pratham-cloud-ctrl/Project-SCCI-RH/docs/stage6/README.md

# Stage 6: integrated manuscript, verification and release

This dossier completes the specified digital research and engineering package.
The proposed consumer capabilities remain conditional; no original human/animal
experiment, physical execution or implanted qualification is reported.

The [whole-project engineering review](../review-v2.0.1/README.md) records the current
corrections and their tests. Historical Stage 1-5 source paths remain unchanged;
the corrected UART application is an explicitly named additive revision.

| Entry | Purpose |
|---|---|
| [Integrated manuscript](../../output/pdf/Project_SCCI_RH_Integrated_Manuscript.pdf) | 28 illustrated pages, both mechanisms, math, model results, native engineering and 18 references |
| [Manuscript source](../../manuscript/stage6/manuscript.md) | Editable text; figure and PDF builders in the same directory |
| [Original hypothesis paper](original-hypothesis/README.md) | Unchanged 28-page research input, preserved with its source digest |
| [Evidence review](evidence-review.md) / [reference register](references.json) | Primary populations, access, supported claims and inference boundaries |
| [Evidence claim register](evidence-claims.csv) | 30 classified scientific/design claims |
| [Integration verification](integration-verification.md) | Actual production C core plus explicit companion/response adapters |
| [Requirements trace](requirements-claims-trace.csv) | All 36 original requirements and scoped dispositions |
| [Integration summary](../../results/stage6/integration-summary.json) | Finite software results and explicit false physical/biological claims |
| [Contributions](contributions.md) / [defence guide](defence-guide.md) | Attribution, learning and explanation |
| [Release contract](release-contract.json) / [plan](release-plan.md) | Version, scope, artifact list and reproduction policy |
| [Release notes](release-notes.md) / [exit review](exit-review.md) | Current release and finite closure |

The integration passes **114,426 repeated software assertions across 28 scenario
groups**. It includes 5,184 modeled motor events and 1,200 pressure events, 13
compiled-core boundary/fault cases, four separate ideal-supervisor cases and six
companion feature-validity cases. Model/current/recruitment mappings remain
declared premises. Current target neural acquisition is restricted to OBSERVE.

The manuscript and release retain the earlier all-withheld conservative result,
conditional learning alternatives, pressure overshoot, analog uncertainty,
unmeasured execution timing and unresolved implanted thermal/miniaturization work.
These are explicit boundaries of a completed digital concept, rather than hidden
conditions presented as successful experiments.

See [START_HERE](../../START_HERE.md) for the full native-file reading order.
