pratham-cloud-ctrl/Project-SCCI-RH/electronics/stage4/integrated-pcb/exports/controller-carrier/fabrication-reference/drill-report.txt

Drill report for controller_carrier.kicad_pcb
Created on 2026-10-28T20:25:21

Copper Layer Stackup:
    =============================================================
    L1 :  F.Cu                      front
    L2 :  In1.Cu                    in1
    L3 :  In2.Cu                    in2
    L4 :  B.Cu                      back

Drill file 'controller_carrier-PTH.drl' contains
    plated through holes:
    =============================================================
    T1  0.200mm  0.0079"  (9 holes))
    T2  0.300mm  0.0118"  (215 holes))
    T3  1.000mm  0.0394"  (100 holes))

    Total plated holes count 324

Drill file 'controller_carrier-NPTH.drl' contains
    unplated through holes:
    =============================================================
    T1  3.200mm  0.1260"  (4 holes))

    Total unplated holes count 4
