pratham-cloud-ctrl/Project-SCCI-RH/electronics/stage4/integrated-pcb/exports/supervision/fabrication-reference/drill-report.txt

Drill report for supervision.kicad_pcb
Created on 2026-10-28T20:28:59

Copper Layer Stackup:
    =============================================================
    L1 :  F.Cu                      front
    L2 :  In1.Cu                    in1
    L3 :  In2.Cu                    in2
    L4 :  B.Cu                      back

Drill file 'supervision-PTH.drl' contains
    plated through holes:
    =============================================================
    T1  0.300mm  0.0118"  (898 holes))
    T2  1.000mm  0.0394"  (126 holes))

    Total plated holes count 1024

Drill file 'supervision-NPTH.drl' contains
    unplated through holes:
    =============================================================
    T1  3.200mm  0.1260"  (4 holes))

    Total unplated holes count 4
