pratham-cloud-ctrl/Project-SCCI-RH/CURRENT_STATUS.md

# Project SCCI RH: integrated digital completion status

Updated: **28 October 2026**. Current engineering release: **v2.1.1**.

**Reader navigation refreshed: 20 October 2026.** The new
[Explore hub](docs/explore/README.md) provides visual guides to theory, CAD,
KiCad electronics and current firmware. This is a documentation/navigation
update on the default branch; the paper, native designs, firmware and published
v2.1.1 engineering artifacts are retained in immutable Git history; the current files carry the new project name.

**Browser inspection added: 21 October 2026.** The
[public build inspector](https://pratham-cloud-ctrl.github.io/Project-SCCI-RH/)
adds selectable source-derived 3D assemblies/boards, interactive PCB component
lookup, all four copper layers, 80 searchable current schematic sheets and
complete native/STEP downloads. This is an inspection layer; the original
engineering sources and integrated paper now carry the new name, with original identities retained by the migration record.

The [whole-project review](docs/review-v2.0.1/README.md) preserves the original
goals and fixes a confirmed UART frame-interleaving defect, one bibliography
duplication and current handoff/documentation issues. Use the
[corrected carrier image](firmware/nrf5340/uart-revision/README.md) and
[portable CAD entry](cad/CURRENT_CAD.md). The old v2.0.0 source and native evidence
remain available at their immutable tag; source-preservation checks remain in force.

The specified six-stage digital research and engineering project is complete
within its stated scope. The authoritative entry is [START_HERE](START_HERE.md)
and the [integrated manuscript](output/pdf/Project_SCCI_RH_Integrated_Manuscript.pdf).
This completion concerns the delivered research/design/software artifacts and
finite verification, with no physical device or biological efficacy claim.

## Main idea retained

SCCI_RH proposes implanted spinal recording, computational interpretation,
learner-specific or function-specific stimulation, independently observed
delivery and response, and feedback. Expert-informed **retained motor learning**
and **selected physiological automation** remain central. Expert information is
aligned to the learner rather than replayed as voltage; OFF retention is distinct
from assisted performance. The pressure reference uses external pressure feedback
and positive pressor authority. AstroSam's Mind-Link inspires the progression
from future vision to inspectable engineering, with explicit credit.

## Completed work

| Stage | Achieved digital scope |
|---|---|
| 1: mechanism/specification | Both causal mechanisms, requirements/assumptions, source audit and architecture/verification responsibilities |
| 2: quantitative architecture | 16-stream/two-source design, 36 ports, resource/timing/noise/delivery budgets and explicit rejected cases |
| 3: computational mechanisms | Conservative qualification investigation closed with interventions withheld; separate conditional concept, 128 scenarios and favorable/neutral/adverse OFF learning |
| 4: electronics/firmware | Eight routed native boards; 80-sheet master; 1,298 positions / 1,296 fitted; 4,781 pin identities; 21,039 segments / 2,335 vias; source-bound zero native ERC/DRC/unconnected/parity/ignored findings; actual carrier-specific linked image |
| 5: mechanical assembly | 260-part combined native reference; actual board scale and 32 mounting axes; 83 mating housings; separate 230-part future interface with 36 ports; independent native/STEP/interference/clearance evidence |
| 6: integrated manuscript/release | 29-page illustrated paper, 18 references, 30 scientific/design claims, all 36 requirement dispositions, production-core digital replay, defence/contribution material and reproducible versioned release |

## Final integration results

[Methods and source boundaries](docs/stage6/integration-verification.md) accompany
[the machine summary](results/stage6/integration-summary.json).

- 114,426 repeated software assertions across 28 finite scenario groups.
- 5,184 modeled motor events and 1,200 pressure events.
- 13 compiled-core boundary/fault cases, four separate ideal-supervisor cases and six companion feature-validity cases.
- Motor first ON error: 31.414 mm unassisted versus 16.668 mm assisted.
- Final OFF: 5.605 mm baseline/neutral, 2.897 mm favorable and 34.845 mm adverse under the selected learning laws.
- Pressure disturbed RMSE: 11.871 versus 20 mmHg unassisted; recovery peak 129.999 mmHg against a 120 mmHg model target, approximately 10 mmHg overshoot.

These are conditional host/model results. Motor features are causal Python
arrays; encoded pressure packets exercise the production C parser. The unchanged
production core executes admission and phase-state behavior. Peripheral timing,
current delivery, neural quality and biological efficacy remain unmeasured.

## Actual target and physical-identity boundaries

The preserved v2.0.0 BT40F/nRF5340 image has a 53,648-byte flash LOAD extent and 98,000-byte
RAM extent, with the manufacturer's 11 pF HFXO setting. It is compiled and linked,
not flashed or executed. Neural acquisition occurs in OBSERVE and is inhibited
while stimulation is armed. No radio image or simultaneous live spinal decoding
during target MOTOR is implemented.

The current additive UART correction has a 53,776-byte flash LOAD extent and the
same 98,000-byte RAM extent. Its 70 independent image/source checks and 1,172
host framing scenarios pass. It is compiled and linked, unflashed; the framing
fix does not establish target timing or physical peripheral performance.

The reference keeps its eight boards at 1:1 scale in a 600 x 310 x 240 mm chassis.
The separate future can/header is 60 x 58 x 14 mm before leads and depends on
miniaturized electronics and qualified implanted interfaces. The latest power
allocation remains conditional 3.154150 W / 4.879920 h. Earlier compact thermal,
monitoring-precision and timing failures remain preserved.

The final Stage 5 native evidence includes 14 reference clearance gates,
14,365 reference material pairs / 248 exact candidates with no unexplained
intersection, all future interfaces and a 260-object source-preservation check.
Its portable checkpoint has 12,996 checks. Native evidence is distinguished from
portable verification of exact saved sources and receipts.

## Release integrity and next work

The frozen engineering baseline is `736015848cf581df66488bf53aa6360152eb767b`.
The final release protects 2,733 baseline tracked files, with seven approved
current entry/attributes/citation/manifest exceptions. New Stage 6 artifacts add
the integrated account without changing old studies, circuits, firmware or CAD.
[The release contract](docs/stage6/release-contract.json) and
[exit review](docs/stage6/exit-review.md) define the finite checks; Git blob hashes,
clean-checkout verification, CI and external release checksums provide identity
and reproducibility evidence.

New biological datasets, physical target execution, measured analog delivery,
chronic thermal/interface qualification, compact hardware redesign and empirical
retention studies are subsequent work packages. The available digital evidence
does not establish a unique spinal-information advantage, healthy expert-skill
transfer, a human learning multiplier or universal physiological control.

[Contributions](docs/stage6/contributions.md) and
[the defence guide](docs/stage6/defence-guide.md) support attribution and student
understanding. Video and website revision remain parked. The historical
[v1.0.0 release](https://github.com/pratham-cloud-ctrl/Project-SCCI-RH/releases/tag/v1.0.0)
remains a separate subsystem reference.
