pratham-cloud-ctrl/Project-SCCI-RH/docs/engineering-roadmap.md

# Project SCCI RH: engineering roadmap and digital completion

16 October 2026. Stages 1-6 are complete within their stated digital scopes:
mechanisms, quantitative architecture, preserved computational investigations,
native electronics, bounded actual firmware, mechanical CAD and the integrated
manuscript/release. The [current entry](../START_HERE.md) and
[Stage 6 exit review](stage6/exit-review.md) organize the completed package.
Biological efficacy, target physical execution, compact implant electronics and
chronic thermal/interface qualification remain subsequent work. The roadmap
below preserves the scientific questions and explicit negative findings.

## Intended result

Project SCCI RH develops a proposed invasive spinal cord–computer interface through
supported theory, mathematical mechanisms, editable electronics, target software,
populated parametric CAD and an illustrated research paper in a private GitHub
repository. AstroSam's Mind-Link is credited as the inspiration for translating a
future interface into an inspectable engineering project.

The causal chain remains **implanted spinal contacts → acquisition →
interpretation → learner-specific stimulation → observed response → feedback**.
The two applications are expert-informed practice with assistance-OFF retention
assessment, and feedback for a selected physiological function. The current
physiological model concerns pressure support. Neither a general body-control
capability nor transfer of an expert's memories or voltages is assumed.

The complete deliverable is digital. Biological observability, selective
recruitment, plasticity, chronic packaging and healthy-consumer usefulness remain
explicit future evidence requirements. Those questions cannot be completed by
adding more software tests. Video and website work remain parked.

## What Stage 3 has delivered

| Package | Completed digital work | Boundary that remains |
|---|---|---|
| Foundation mechanisms | Motor/pressure models, measured-command separation, causal observations, learning families and OFF assessment | Chosen biological equations are assumptions, not human experiments |
| Numerical checks | Motor/pressure refinements and independent electrical equation checks | Selected grids and finite scenarios do not qualify every possible trajectory |
| Contact acquisition | Moving sources at actual contact apertures, recovery masks, lost-block and clock cases | Real spinal information and analog front-end recovery remain unestablished |
| Information controls | Capacity-matched external/neural comparisons, absent/redundant sources and ambiguity witnesses | A useful neural increment is not established by the connected pilot |
| Teacher references | Independent competence/decoder checks and a nominal aperture-resolved reference library | Legacy and faster references that fail remain unavailable |
| Response and prediction | Finite observed response domains, intervention-aware forecasts and past-response removal | Changed learner response and unsupported histories still reject |
| Connected pilots | Historical 128-practice/64-OFF pilot plus new 32-practice/64-OFF frozen-observer replay; exact causal guards and scoped software probes | Both withhold all interventions; no retained advantage or new active-path qualification |
| Reproducibility | 224 local tests, saved receipts and independent Linux reproduction on GitHub | Passing tests verify implementations and reported results, not efficacy |

The [current status](../CURRENT_STATUS.md), [Stage 3 dossier](stage3/README.md)
and [verification map](stage3/verification-progress.csv) remain the detailed
record. These packages have different scopes; counting files or tests would not
give a defensible percentage of the remaining engineering effort.

## Why the stage remained open

Connecting the complete loop exposed dependencies that isolated demonstrations
did not resolve. The earlier expert generator failed a task check, baseline
delivery uncertainty was too large, and independent changing-learner recordings
exceeded the forecast allocation. New monitors and revised references address
specific causes; they do not silently rescue earlier failed experiments.

The diagnostic found severe noise amplification in unconstrained local harmonic
inversion; it did not prove that every 75 ms predictor must fail. A structured
observer with a measured calibration prior has now completed a
[standalone confirmation](../experiments/stage3/observed-state-observer/README.md):
all 16 fresh sensor-noise pairs on both body grids remain within 15 mm, with a
maximum allocation of 11.354 mm. Persistent memory, a known synthetic movement
prior and calibration are additional resources. This verifies a finite no-dose
desktop domain only; the original negative pilot remains unchanged.

Verification also exposed a platform-dependent near-zero argmax witness. Its
reproduction fix independently binds both witnesses to physical apertures while
preserving the numerical tolerances, all outcomes and all admission decisions.

## Finite Stage 3 closeout

Complete one bounded predictor revision and its connected interpretation:

**Closeout, 12 October:** all four finite steps are complete, as reviewed in the
[exit ledger](stage3/exit-review.md) and [integrated verdict](stage3/stage3-verdict.md).
The new actual-only replay retains 32 practice and 64 OFF sessions, 32 sealed
vectors, 32 pre-launch diagnostics and 1,600 passing guard comparisons. Every
tested nonzero candidate rejects; this is a negative active-assistance verdict.
Fifteen contract probes, independent raw interval/data recomputation and full
same-cohort reproduction pass. No active delivery path or post-dose monitoring
was newly validated by the zero-launch replay. The list below records the
completed closeout contract rather than assigning more Stage 3 work.

1. **Freeze one observed-state method.** Use measured calibration only, known
   instructions and an explicit structural movement prior. Declare state,
   covariance, coefficients, calibration exposure, history, initialization,
   reset and missing-data rules. Private learner parameters and future achieved
   motion cannot select or update the runtime predictor.
2. **Separate development from confirmation.** Existing inspected recordings
   remain development data. Freeze the procedure and settings before generating
   an independent confirmation cohort. Retain fixed comparators, all eligible
   physical supports, cue reversals, all 26 execution horizons and rejection
   cases. Keep the 15 mm forecast, 3 mm label and 25 mm complete-correction
   allocations unchanged. Typical covariance is not an empirical maximum bound.
3. **Resolve the connected pilot.** Consume the observer in the
   [reviewed bounded reset-trial integration](stage3/observer-integration-plan.md), with matched resources,
   live delivery uncertainty, timed cancellation and OFF assessment. Compare
   actual characterized delivery separately from prospective monitor precision.
   Preserve unavailable references and zero/harmful/dependent plasticity cases.
   The first replay has one practice trial; repeated intervention-modified
   sessions need further state-domain evidence. Learning-enabled response
   interaction is not supplied by the inherited learning-OFF calibration.
   Retain any forecast, delivery, interaction or correction failure and withdraw
   unsupported active-demonstration claims; do not tune thresholds to force pulses.
4. **Issue the Stage 3 verdict and report.** Consolidate both application
   mechanisms, the verified operating domain, negative controls, numerical
   sensitivity and the electronics handoff. State which digital claims are
   supported, which conditional capabilities remain hypotheses and what future
   evidence could overturn the conclusions.

Completion means this selected digital investigation has an audited conclusion
and a concrete hardware/software contract. It does not require a favorable
learning result or resolution of every biological uncertainty. A failed
confirmation remains a valid engineering result, while the proposed consumer
application stays explicitly conditional. Further model revisions become
separately justified extensions rather than an unbounded Stage 3 checklist.

## Stages 4 and 5

The [conditional concept revision](stage3/conditional-concept.md) reconnects this
handoff to the user's intended future-interface approach. Fourteen primary
research anchors support a fifteen-entry premise ledger. A separate 128-scenario
illustrative model demonstrates causal assistance and positive/equal/adverse
assumed learning, with no unique neural-information advantage. Its finite scope
does not require qualification of the earlier actual-delivery branch. Further
general observer/audit families are not prerequisites to native circuit/CAD work.

Stage 4 has already begun with the [native dual-source monitor](../electronics/stage4/monitoring-cell/README.md)
and [33-run behavioral circuit study](../electronics/stage4/monitoring-study/README.md).
Their 4% phase-charge target remains unearned. A
[reviewed first driver boundary](stage4/current-driver-design.md) now has a
[156-component native implementation](../electronics/stage4/current-driver/README.md)
with five reviewed sheets and a [bounded circuit/permission study](../electronics/stage4/driver-study/README.md).
This is a restricted 24 V/3 mA/200 µs slice, with external supervision, actual
delivery-path limits and two retained out-of-compliance partial traces. Now
the [native recording slice](../electronics/stage4/recording-front-end/README.md)
adds sixteen shared-reference differential streams and isolated input switching
across seven sheets. Its [finite input/protocol studies](../electronics/stage4/recording-study/README.md)
retain weak-signal/fault failures and revise SPI timing/power explicitly.
The [native contact router](../electronics/stage4/contact-router/README.md) now
adds six sheets with held addresses, two sixteen-way selectors, fixed returns,
collision inhibit and a fresh acknowledgement/rearm path. The
[native shutdown/supervision package](../electronics/stage4/supervision/README.md)
adds 18 terminal guards, separate phase timers/watchdog, measured windows and
explicit rearm across 22 sheets. Its finite fault/analog audits and checked
inter-package wiring close that bounded digital slice. The
[native power package](../electronics/stage4/power/README.md) now generates all
nine rails and supplies startup/reference-qualified shutdown across 15 sheets.
Its [budget](stage4/power-budget.md) retains conditional 2.615 W/5.886 h, failed
compact thermal closure and inherited ADC/link limitations. The
[monitoring/companion package](stage4/monitoring-transport-design.md) now resolves
the 450k aggregate conversion mismatch with a dedicated raw ADC, adds shared
charge endpoints and an isolated UART, and binds freshness/queues/resources to
actual native connectivity. Its additive budget is conditional 2.800 W/5.497 h;
precision, continuous raw export and compact thermal limits remain explicit.
The [actual nRF5340 firmware](stage4/nrf5340-firmware-design.md) now links the
production core and peripheral backend, with compiled fault tests, active-route
readback, timestamped observations and allocated timer/DPPI cutoff. Its nominal
lower-rate polling opportunities and known gaps do not implement the earlier
450k/4k proposal. The [integrated populated PCB package](stage4/exit-review.md)
now completes Stage 4 within its bounded digital reference scope: eight native
routed boards, 1,298 positions / 1,296 fitted, an actual controller and four-chip
sideband carrier, zero ERC/DRC/unconnected/parity/ignored findings, populated
STEP and fabrication references. The revised conditional allocation is
3.154 W / 4.880 h. Carrier-specific firmware uses the manufacturer's 11 pF
oscillator setting. Historical source circuits, studies and firmware remain
preserved. The [board index](../electronics/stage4/integrated-pcb/BOARD_INDEX.md)
is the native-file entry point.

Stage 5 now packages those board and component identities in the native
mechanical assembly: full-scale populated boards, nominal mating interfaces,
ports/feedthroughs, conditional future leads, clearances, drawings and STEP
exports. The [mechanical exit review](stage5/exit-review.md) records completed
source-bound native checks. Its compact future package explicitly requires
redesigned miniaturized electronics; the eight reference boards retain 1:1 scale.

Stage 6 now joins the mechanisms, circuit/firmware evidence and CAD in the
[integrated illustrated manuscript](../output/pdf/Project_SCCI_RH_Integrated_Manuscript.pdf)
and reproducible private v2.0.0 release. Each digital result retains its limits
and contribution record.

## Proposed additional tools

These are recommendations checked against primary product documentation on
12 October 2026, not installation or compatibility claims.

| Tool | Recommendation and intended purpose |
|---|---|
| Ansys Student | Useful optional thermal/structural corroboration for a defined package/lead problem. Existing installation is partly verified; solver/license checks and the two missing original-media archives must be resolved before reliance. Keep exportable CAD in FreeCAD/build123d or Fusion. [Official capabilities and limits](https://ansys.synopsys.com/academic/students/ansys-student) |
| Ansys Electronics Desktop Student | Useful selected low-frequency field, parasitic, thermal or telemetry studies using Maxwell/Q3D/Icepak/HFSS as appropriate. Student restrictions include mesh caps, no geometry export, Circuit's 50-component limit and restricted netlist/command-line workflows. It does not replace KiCad or the ngspice current-loop study. [Official limits](https://ansys.synopsys.com/academic/students/ansys-electronics-desktop-student) |
| Autodesk Fusion Education | A reasonable optional native CAD authoring/review interface if preferred. Eligible students have renewable educational access. Existing FreeCAD/build123d can already produce editable engineering geometry; changing CAD tools is not a prerequisite. [Education access](https://www.autodesk.com/education/edu-software/fusion) |
| MecAgent | Postpone a Fusion-dependent decision. The current official page identifies SolidWorks as available and shows Fusion among forthcoming integrations; the education page offers a limited Free plan, not an established unlimited Fusion workflow. [Current integrations](https://mecagent.com/), [education](https://mecagent.com/education) |
| Installed KiCad/FreeCAD MCP bridges | Verified on 13 October: Konnect 0.13.0 with KiCad 10.0.6 saved-schematic component/pin/ERC checks; FreeCAD 1.1.4 live bridge inspected the unchanged 80-solid allocation. Use these for native inspection and upcoming PCB/CAD work. Live PCB operations require the intended board open and source-evidence checks. The [verification record](../provenance/stage4-mcp-readiness.json) records the local skill and tested access. |

An additional interface is useful when it demonstrably improves a concrete
design or review operation. It does not establish the biological assumptions or
remove the need to check the generated electronics and geometry.
