pratham-cloud-ctrl/Project-SCCI-RH/provenance/CONTRIBUTIONS.md

# Contributions and provenance

## Native current-driver checkpoint, 13 October 2026

AI-assisted detailed design added a separate 156-component, 572-pin, five-sheet
KiCad driver package, local libraries, BOM/netlists/exports and connectivity/gate
verification. A separate AI manufacturer review corrected DAC reference/gain
headroom, exact DRX and BSP89 package contracts, logic defaults and timer-health
limits. A separate control review specified sticky BLOCK/TIMEOUT state and
direction capture at safe rearm. All five schematic pages were visually reviewed.

The root AI agent implemented a separate closed-servo ngspice surrogate, retained
18 complete and two partial out-of-compliance transients, and independently
checked charge conservation, a settled DC equation and selected-grid agreement.
An additional ideal-event model retains 15 scenario groups, including unprotected
timer failure without external supervision. These studies use declared component
surrogates and artificial loads, not vendor macro models or physical measurements.
The scientific figures and raw evidence preserve adverse outcomes. Pratham owns
the project direction and clarified the conditional concept scope. Historical
Stage 2/3 and monitoring packages were preserved. Full electronics/firmware,
populated CAD and the final integrated manuscript remain unfinished.

## Stage 3 mechanism revision, 9 October 2026

AI-assisted work added competence-gated teacher libraries, fresh actual-aperture
teacher recordings, a 75-capture moving-source/ambiguity study, intervention-aware
causal forecasts and observed-map precision requirements. Independent code review
identified and corrected a live dose-uncertainty gate and unfair coupling of the
external teacher comparator to neural availability. The source paper and selected
primary experiments were reread to connect their evidence to specific tests.
New scientific figures derive from the saved results. A delayed-residual latch
is a tested software component; dynamic feedback and revised retained-learning
benefit are not thereby established. Older result identities remain preserved.

The measured transient-response experiment and zero-future-command baseline add
separate two-grid records with actual electrical pulses, complete heldout
trajectories and explicit unsupported-tail rejection. Review also corrected
partial observation-noise reuse and a total-sensor-loss expiry gap. Root authored
an eight-page illustrated revision report and inspected every rendered page.
The bounded body-coupled pilot completed on 12 October in separate files. Review
replaced a training-fit teacher error with independent complete-recording
allocations and restricted runtime baseline permission to tested support/past
action domains. Sixteen independent learner-drift checks reject every aggregate
horizon. The saved 128 practice trials launch no stimulation, and 64 OFF
assessments show no assisted advantage. The full local suite passed 224 tests,
including seven checks of the cross-platform reference-witness comparison and
its binding to recomputed physical sampling apertures.
Sources, negative results and independent reproduction receipts are retained.

A separate AI-assisted Stage 4 investigation starts an editable two-source
phase-charge monitoring circuit, component comparison and requirements trace.
Independent review corrected a preview-package choice to the production DCK
pinout and a missing buffer-loading term in the separate mathematical oracle.
Thirty-three ngspice runs retain both source traces and 462 interval results;
portable verification recomputes the numerical checks and binds the artifacts.
Its power/bias/precision limitations remain explicit. Full native implant
electronics, embedded integration and populated engineering CAD remain later work.

Project owner and research direction: **Pratham Varma**.

Pratham defined the SCCI focus, the motor-learning and sustained physiological
control questions, the AstroSam-inspired engineering format, the entirely digital
scope and private-repository destination. The supplied hypothesis paper is a
starting research map; it is not new experimental evidence.

This release was developed with extensive AI assistance. Codex agents performed
targeted literature review, mathematical modelling, implementation, CAD/circuit
generation, automated checks, documentation and presentation rendering. Execution
logs and machine-readable results support the stated checks. Pratham has not been
represented as having personally fabricated hardware, performed experiments on
people or animals, or independently authored every code/design element.

The appropriate portfolio claim is an **AI-assisted digital engineering project**
that Pratham directs, studies, critiques and improves. Understanding and defence
of the work must be developed through the learning guide and rerunning the
experiments; a generated document does not establish that understanding.

## What is original to this release

- The explicit separation of a future spinal interface from a desktop reference.
- Paired synthetic studies, their controls, parameter sweeps and failure cases.
- Application-to-pulse digital integration and portable timing/fault reference.
- A one-channel artificial-signal/test-load circuit and matching PCB.
- Parametric enclosure geometry, assembly checks, presentation assets and the
  combined reproducible engineering argument.

These are original project artifacts, not a claim to have invented spinal
interfaces or discovered a clinically effective intervention. Model laws and
synthetic plasticity parameters are choices to investigate, not measured biology.

## Inspiration and third-party materials

[AstroSam's video](https://www.youtube.com/watch?v=5YxrpcqkTYA) and
[Mind-Link](https://github.com/sam-astro/Mind-link) inspired the progression from
future concept to inspectable engineering. Reference review pinned commit
`a391eb851ee624be675057380f4e3b701ebf6ee8`. No Mind-Link source or geometry is
incorporated into SCCI_RH. The reference's root MIT license and its LUFA notices would
need preservation if that changed.

Primary literature is cited by DOI and checked against source scope; its full
texts are not included in the release. KiCad library symbols, footprints and
component models retain their applicable licenses in the electronics attribution
file. Software used to generate assets retains its own license and is not
redistributed with this project.

## Data integrity

All new study/electrical data are generated by code. Each dataset records the
chosen seeds, equations, units and assumptions. Confidence intervals quantify
Monte Carlo variability under those assumptions; they do not quantify uncertainty
about the biological mechanism. No participant IDs, clinical recordings or
privileged personal data are present. No GitHub credentials are stored here.

See `environment.json`, `verification.json`, `manifest.sha256` and
`docs/claim-register.csv` for the execution environment, verification receipts,
artifact hashes and claim boundaries.

The SHA256 manifest hashes staged Git blob bytes (including Git's LF text
normalization), so it represents the committed release rather than a particular
Windows working copy's line endings. It excludes itself to avoid a self-hash.

## Full-system overhaul: Stage 1, 8 October 2026

The project owner authorized a staged overhaul preserving the complete proposed
SCCI platform and both application ambitions. AI-assisted work produced the
mechanism specification, selected primary-source audit, architecture/interface
trade study, model/verification plan, requirement/assumption/capability registers,
vector diagrams and illustrated design brief. Parallel AI workstreams covered
research, electronics responsibilities and model verification; a separate bounded
cross-document review led to tighter future configuration-security, versioning
and independent-supervision checks. The owner has not yet selected the detailed
reference motor task or endorsed a final access arrangement.

Stage 1 reports specification consistency and document visual review only. No
new circuit, firmware implementation, CAD package, biological dataset or efficacy
experiment was produced in this stage. The source hypothesis remains read-only;
the historical release and its receipts remain distinct. See the Stage 1 dossier,
`stage1-verification.json` and `stage1-review.json` for this revision's scope.

## Full-system overhaul: Stage 2, 8 October 2026

The owner requested continuation. AI research, electronics and control workstreams
audited primary/manufacturer sources and specified numerical inputs; root
integration aligned rates, memory, cycle reservations and timing, reproduced
budgets, authored figures/brief and generated the preliminary build123d/FreeCAD
allocation models. These calculations and solids are newly generated Project SCCI RH
work. Manufacturer geometry/capacity examples and published electrical settings
remain attributed; no proprietary CAD or biological recording is redistributed.

Root integration review found and documented shared-reference noise failure,
free-running-frame latency failure, dense-stimulation recording loss, archive
mask propagation, maximum-knob/monitor-uncertainty rejection, thermal/cell limits
and target-specific anatomical inventory requirements. Catalog devices are
feasibility witnesses with unqualified implant suitability. No human has yet
endorsed the final components, anatomy or operating profiles. Review receipts
describe AI-assisted technical/visual checks, not an independent licensed design
audit or biological trial. Native electronics implementation and populated
engineering CAD remain later stages. See `stage2-verification.json`,
`stage2-review.json` and the Stage 2 progress table for the exact scope.

The owner requested a Stage 2 alignment/completion audit before Stage 3.
The audit corrected the 32-stream RAM prose, made cyclic physical-source
scheduling distinct from per-profile rates, and added finite flash/network
memory, output-configuration SPI and a complete functional port allocation.
Six focused failure tests and a read-only full nominal CAD inspection extend
the verification. A further portability regression covers Windows/Linux JSON
receipt identity while detecting changed values and array order. The illustrated
brief was updated and visually reviewed.
These additions remain AI-assisted digital engineering; they do not establish
biological efficacy, exact circuit implementation or populated implant readiness.

## Full-system overhaul: Stage 3 foundation and continuation, 8–9 October 2026

The owner requested the computational stage and sustained continuation after a
usage-limit interruption. AI workstreams implemented reduced contact acquisition,
causal decoding, observed response calibration, independent electrical delivery
and external-pressure feedback, with separate practice and output-OFF assessment.
Subsequent work added numerical refinements, digital filter-residual qualification,
a capacity-matched external-history comparator, independently recorded response
domains, observed teacher competence and a cancellable known-cue component.

Parallel read-only reviews found source timing/leakage, qualification, numerical
integration, missing uncertainty cross terms and teacher-competence defects.
Corrections preserve historical outputs and disclose changes through separate
datasets, source hashes and limitations. These are multiple AI-assisted reviews,
not independent clinical evidence or a licensed hardware audit. No human/animal
data or original experiments on participants were produced.

Root integration generated scientific figures, inspected the rendered images,
ran model/test/receipt checks and documented the next electronics requirements.
Unfavorable results remain visible: actual motor authority rejects intervention,
assisted cue forecasts fail and original synthetic teacher timing is unqualified.
The new competent synthetic benchmark is an explicitly privileged generator,
not evidence of real expert spinal skill transfer. Detailed electronics,
populated CAD and the final full-system paper remain later work.

## Continued mechanism/electronics investigation, 12 October 2026

AI workstreams corrected the monitoring schematic's production amplifier
package/pin mapping and generated the 33-run, three-grid behavioral monitoring
study. Separate equation/KCL and source-portability reviews preserve negative
precision, power, clipping and bias-bypass results. The original paper and all
synced reference files remain read-only. No hardware was fabricated or measured.

One persistent observed-state observer was frozen using measured synthetic
calibration and an explicit movement prior. Root reviewed its equations, timing,
causal inputs and resources before target scoring, then independently reviewed
the fresh sensor-noise confirmation protocol before generation. The confirmation
retains all 32 paired-grid captures. Separate AI saved-data audits recomputed
915,200 residuals; root reproduced every frozen pair in a disposable portable
workspace. Scientific plots use the saved summaries. These are AI-assisted
computational checks, not human/animal measurements or an independent licensed
review. The result supplies no neural increment or retained-learning evidence.

Root installed the official Nordic SDK, diagnosed its Windows physical-path
restriction, preserved the asset installation and compiled/linked an unmodified
processor example from a separate short physical copy. This verifies the tools,
not SCCI_RH target firmware. A reviewed driver design note defines a restricted next
native circuit boundary. The connected learning-enabled response interaction,
complete electronics, populated CAD and final manuscript remain unfinished.

## Finite Stage 3 closeout, 12 October 2026

A separate AI implementation workstream froze the actual-only pre-dose observer
replay before generation. Root and a read-only AI reviewer inspected its protocol,
causal clocks, candidate gates and evidence preservation; root saved hash-bound
approval before the cohort ran. It retains 32 one-practice trials and 64 hard-OFF
assessments with zero launches. Fifteen software contract probes, measured-input
controller replay and full deterministic same-cohort reproduction passed.

A separately written and published raw auditor recomputed all recorded intervals,
noise injection, forecast/guard residuals and matched-arm outcomes without
executing the producer or controller. The integrated verdict and eight-page
report distinguish no-dose component success from unavailable actual assistance,
unqualified learning interaction and unexercised active delivery/monitoring.
Root closes only the selected digital Stage 3 investigation. Complete native
electronics, SCCI_RH target firmware, populated CAD and the final project manuscript
remain later stages. No human reviewer, physical experiment or biological result
is implied by these AI-assisted checks.
# Conditional future-concept revision - 13 October 2026

Pratham clarified that plausible undemonstrated assumptions are permitted and
that experimental proof of the complete biological conjunction must not prevent
completion of the digital concept. The root AI agent traced the completion-scope
drift, preserved the original frozen studies, specified a separate 128-scenario
illustrative model, implemented it, reproduced its saved outputs and inspected
the figures. Separate AI research passes supplied the motor and physiological
primary-source reviews, 15-entry premise ledger and engineering handoff. A separate
AI read-only implementation review checked causal inputs, calibration/true-state
separation, learning identity, washout and resource accounting. It found a metric
label ambiguity; the protocol now explicitly says pooled two-coordinate RMS,
preserving the original numerical criterion and outcomes.

Favorable, equal and adverse learning outcomes remain consequences of declared
equations, not fitted human results. All papers receive source credit, no new
participant/animal/hardware experiment occurred, and the expert reference and
live phase features remain assumed representations. Native electronics/firmware,
populated CAD and final integrated publication are unfinished. Contributions are
AI-assisted rather than independent institutional or clinical review.

## Native recording-front-end checkpoint - 13 October 2026

AI implementation work produced a seven-sheet native RHD2216 recording slice,
production fault-switch land patterns, seventeen protected paths, shared reference,
separate bias, digital isolation, mode defaults, local footprints/BOM, exported
connectivity and unexcluded ERC. A separate AI primary-source review corrected the
preview TSSOP selection, pin maps, supply conditions and the difference between
large fault thresholds and the RHD's small input envelope. The native author
inspected all rendered sheets; root also inspected selected pages.

Root implemented a finite passive network and a separate scalar/DC/KCL auditor.
Another AI reviewer identified coherent common-mode terms that invalidated a
barely passing RSS interpretation. Saved results preserve that failed weak-signal
gate and two transient fault failures. A separate AI workstream derived isolated
SPI timing, next-CS timestamps, commissioning and external sequencing, retaining
undetectable untagged-data replay. These are computational, AI-assisted checks;
no human/institutional, hardware, animal or participant validation is implied.
Historical packages and synced sources remain unchanged. Integrated circuits/
firmware, populated PCB/CAD and final publication remain unfinished.

## Contact routing and native MCP continuation - 13 October 2026

The user supplied KiCad and FreeCAD MCP bridges. Root applied the local
cad-electronics-mcp skill, verified serving versions, rechecked saved KiCad state
and ERC, and opened the unchanged Stage 2 allocation in live FreeCAD. Eighty
solids remained valid; this did not create populated CAD. No unsaved user design
was overwritten or saved. The prior checkpoint's full GitHub CI was confirmed green.

AI native implementation produced the restricted 24 V contact router with two
sixteen-way selectors, distinct monitored returns, candidate/active address
separation, raw commit clocks, collision inhibit and a fresh acknowledgement
latch. A separate primary-source review selected the production TMUX6208PWR,
verified pin/timing/power conditions and kept heartbeat supervision distinct
from microsecond pulse limiting. A separate control workstream implemented
finite ownership, hold, admission and fault histories with independent exported
gate/pin checks. Root added passive off-contact coupling, an independent scalar/
charge/RC auditor and scientific figures; the reviewer independently checked
all saved trajectory points. That superposition check is included in the public
auditor. Digital contact ownership is not reported as zero unselected current.

All checks are AI-assisted computational work, not physical, participant, animal
or institutional validation. False fresh acknowledgement, hardware-switch faults,
power-off isolation and independent supervision remain explicit. Historical
packages and synced sources are preserved. The five remaining Stage 4 packages
fix the next engineering scope; biological efficacy is not an extra exit gate
for the digital concept.

## Independent shutdown and supervision - 14 October 2026

AI native implementation produced 478 components across 22 editable sheets,
18 body-facing guarded terminals, independent source timers, watchdog/first-edge
interlock, rail/current/differential-voltage windows and 17 RHD-side pin observers.
Primary-source review corrected the TPS3431 exposed-pad geometry, ISO6742 pin
map, full-temperature offsets and threshold-buffer supply/common-mode condition.
The native author inspected every final sheet and checked saved state through
KiCad MCP/ERC; root inspected selected pages and all scientific figures.

A separate AI control workstream caught and corrected a circular monitor/ARM
startup dependency, independently checked actual exported gate/pin connections
and retained plausible reference, welded-switch, timing-coincidence and power
fault witnesses. Root implemented finite threshold/loading/RC/interruption
models, separate KCL/energy/trajectory audits and a checked 102-wire integration
plan. The old 100 microsecond phase gap is unearned; the provisional 200 microsecond
allocation still requires actual quiet qualification. Artificial-load residual
energy and the energized welded-guard observation are preserved.

These are AI-assisted computational and native-file checks, without physical,
human/animal, institutional or clinical validation. Historical circuit/study
packages and synced project sources remain unchanged. This completes the bounded
independent shutdown/supervision package; power/budgets, transport, target
firmware, consolidated PCB, populated CAD and final publication remain.

## Power and quantitative budget - 14 October 2026

AI native implementation produced a 156-component, 449-pin, 15-sheet power
reference: selected protected pack/input protection, nine generated rails,
floating AFE converter/regulators, measured battery/supervisor/reference windows
and open-drain fault integration. A separate AI manufacturer review checked
actual pins, feedback networks, diode packages, module isolation/remote behavior,
LDO tolerances and boost diode feedthrough. All final pages were visually
reviewed; saved native revision, pins, overlaps and ERC were checked through MCP.

A separate AI budget workstream audited actual IC supply pins and 423 populated
capacitors, implemented rail/loss/energy/peak/source/thermal/resource calculations
and an independent 3,300-assertion auditor. Root supplied the sequencing model,
native gate and threshold KCL audits, explicit 32-wire power integration, two
scientific figures and repository/checkpoint review. The conditional 2.615 W /
5.886 h allocation retains assumptions and failed compact thermal closure,
untrimmed startup, ADC-rate and raw-link constraints. The old one-cell/100 mA
contract is explicitly superseded; no lower-power miniature ASIC was invented.

All work remains digital and AI-assisted, without physical, human/animal,
institutional or clinical validation. Original sources and prior circuit/study
artifacts are preserved. Power is complete within the finite reference scope;
transport/companion interfaces, target firmware, consolidated PCB, populated CAD
and final paper/release remain subsequent work.

## Monitoring and companion interfaces - 14 October 2026

AI native implementation produced 60 components, 217 pins and eight editable
sheets: dedicated ADS8688 raw ADC, reference/input networks, shared endpoint
MISO through two series resistors, passive health/control handoffs and ISO6721
isolated UART. The native author inspected all final pages and actual saved
design pins, geometry and ERC through KiCad MCP. A separate primary-source
review checked channel/reference/pin behavior, internal filtering, input loading,
isolation direction/idle leakage and shared ADS8866 DOUT timing.

A separate AI control workstream produced 1,552 independent checks of real
apertures, endpoints, configuration identity, packet histories, leases, buffering
and queues. It also checked 34 new wires against native manifests/XML, retaining
the previous 134 connections and separate recording/companion domains. Root
implemented 192 divider corners, 16 nominal-series direct corners, six
illustrative filter/quantization traces, an independent analytic/KCL auditor,
three scientific figures and an additive power overlay. Independent review found
no material equation correction. Root reviewed selected native pages and all
figures, and integrated status, CI, provenance and private repository evidence.

The added ADC resolves the raw-conversion rate mismatch. Nonuniform apertures,
filtered short spikes, plausible undetected channel commands, unearned 4% dose
precision and continuous UART raw-export limits remain explicit. Conditional
2.800 W/5.497 h depends on the existing loss/battery assumptions and enlarged
host rail caps; it does not close compact implant thermal design. Security
envelope space is reserved without claiming implemented authentication.

All results are digital and AI-assisted; no physical, human/animal,
institutional or clinical validation occurred. Synced sources and six previous
native/study packages remain unchanged. This completes the bounded monitoring/
companion package. Target firmware, consolidated PCB, populated CAD and final
paper/release remain.

## Actual nRF5340 firmware - 14 October 2026

An AI runtime workstream implemented the production C policy core and compiled
host fault tests: 75 finite scenarios, 713 assertions and 432 bytes of bounded
state. The same source is linked into the ARM application. Explicit pre-monitor
recovery, subsequent supervisor rearm, route readback/action ordering, leases,
SBP support-time validation, OFF trials, phase interruption, sample identity,
queues and fault records are exercised without inventing biological success.

An AI target workstream implemented the C/Zephyr/nrfx backend and performed the
actual pristine nRF5340 application-core build: 53,616 bytes flash and 98,000
bytes RAM in the selected 448 KiB linker RAM region. Retained sample archives,
SPI/UART drivers, readback, feature telemetry and hardware timer/DPPI cutoff are
present in the image. The build exports ELF/HEX/BIN/MAP, configuration, device
tree, selected real compiler commands and source-bound receipts. Nothing was
flashed or executed on physical hardware.

A separate primary review checked SDK APIs, chip pin/protocol details, 46 GPIO
allocations and 50 native connector endpoints. It identified ADC sampling delay,
DAC edge mode and actual NFC pin ownership. Cross-workstream review resolved
startup ordering, idle guard semantics, UART sequence wrap, archive retention
and shared DPPI allocation with the Zephyr UART driver. These were concrete
implementation corrections; the earlier native circuits and studies remain
preserved. Root independently parsed the ARM ELF, checked source/export hashes,
actual memory region/headroom, linked production functions, compiler/UICR policy,
native pin bindings and peripheral ownership, then integrated documentation,
licenses, CI, repository and checkpoint evidence.

The implemented acquisition opportunities are a narrower profile than the old
450k raw/4k neural proposal. Blocking bursts can create known gaps; no missed
measurement is synthesized. Transport-valid features and endpoints do not earn
analog recovery, phase-charge accuracy, a learned decoder or retained benefit.
The trusted companion supplies prequalified plans; the wired target builds no
network-core radio image. Four explicit SN74LVC165A sideband devices are a next-PCB
dependency, not an undocumented modification of the seven native packages.

This completes the bounded actual target-firmware package. Consolidated PCB,
populated CAD and final integrated paper/release remain. All work is digital
and AI-assisted, without physical, human/animal or institutional validation.

## Integrated populated PCB package — 16 October 2026

The user authorized completion of the digital board package, preserving both
the expert-informed retained-learning and function-specific physiological
concepts. AI workstreams authored the BT40F carrier, consolidated native
hierarchy and harness, actual board placement/routing, package solids and
independent audits. The final package has 1,298 component positions, 1,296 fitted
parts and 32 board-only mounting holes across eight genuine KiCad layouts.

Independent integration reconstructed every source pin group and explicit
harness join. Native board checks and a separate saved-file parser compare
actual pads, values, DNP flags, hierarchy paths and current DRC hashes. Review
caught two conflicting old rearm wires, an incorrect ground/shift-tail alias,
and a TPS3431 land-row dimension error. New integrated artifacts resolve these
without overwriting their historical source records. Component-pad routing
repairs supply real copper; route-journal incompleteness after an interruption
is disclosed rather than claimed to reproduce every authoring operation.

Root integrated the manufacturer-specific firmware build, additive power
allocation, nominal package geometry, populated exports, native/independent
verification, documentation and repository evidence. Review strengthened
export/DRC hash binding and separated post-export geometry receipts. Exact
earlier exporter source bytes remain archived with their generated artifacts;
new verification checks their current sources and every output independently.

All results are digital and AI-assisted. No student mastery, physical device
execution, fabricated hardware, human/animal experiment, university involvement,
biological efficacy or implant qualification is implied. Mechanical packaging
and the integrated research/engineering paper remain subsequent work.
