pratham-cloud-ctrl/Project-SCCI-RH/manuscript/stage6/manuscript.md

# Project SCCI RH: a conditional spinal cord-computer interface for expert-informed practice and physiological feedback

## Abstract

Project SCCI RH investigates an invasive spinal cord-computer interface (SCCI) that combines recording, computational interpretation, selective stimulation and independently observed feedback. Its two application families are expert-informed motor practice with retained stimulation-OFF learning, and sustained regulation of a selected physiological function. The central research question is conditional: if useful spinal information and selective learner-specific or function-specific recruitment are available, what architecture could use them, and which parts can a digital engineering project substantiate?

This work integrates a focused primary-source review, explicit biological premises, computational studies, native electronics, compiled firmware, mechanical CAD and reproducible verification. Published animal and human studies support individual links, while the proposed healthy-consumer combination remains unestablished. A preserved conservative investigation withholds every intervention. A separate 128-scenario model demonstrates how the assumed learning mechanism determines retained outcomes. The final integration replay executes the unchanged production C admission and phase-state code through declared companion and body adapters: 114,426 repeated assertions cover 28 finite scenario groups. These assertions measure software behavior, rather than biological certainty.

The engineered reference comprises eight routed KiCad boards with 1,296 fitted component positions, an application-core ARM image, independent supervision and a full-scale FreeCAD assembly. A separate 36-port future implanted-interface concept expresses the proposed contact and lead architecture. Native geometry, electrical connectivity, artifact identity and finite software behavior have source-bound evidence. Analog performance, physical timing, chronic implanted heat, miniaturization, useful human decoding and accelerated healthy learning remain explicit assumptions or qualification tasks. The contribution is an inspectable, integrated digital design and a precise account of what would have to be true for its future applications to work.

## 1. Purpose, scope and contribution

### 1.1 Research question and project identity

The spinal cord participates in movement, sensation, reflexes and selected autonomic pathways. It therefore offers several possible interfaces between computation and bodily function. The useful question is more specific than whether a computer could control the body: which state is observable at a particular access site, which intervention is reachable through a particular pathway, and whether closing that loop serves a defined functional outcome.

SCCI_RH asks two linked questions. First, could an expert's task-related spinal observations inform a learner-specific practice policy that improves later unassisted performance? Second, could a measured physiological state drive repeated, bounded spinal interventions that maintain a selected response? A shared electronic architecture can support both investigations, while recording sites, stimulation placements, calibration and outcome measures remain application-specific. Exclusive software modes do not by themselves make one anatomical lead arrangement suitable for both tasks.

The project is entirely digital. It contains original engineering artifacts and computational experiments, with no original human or animal experiment. A useful digital result may be positive, negative or conditional. An abstaining controller can reveal a missing permission; a favorable simulation can reveal an assumption on which benefit depends. Neither outcome alone settles future biological feasibility.
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
