pratham-cloud-ctrl/Project-SCCI-RH/docs/explore/cad.md

# Explore the mechanical design

[Explore](README.md) · [Theory](theory.md) · **CAD** · [Electronics](electronics.md) · [Firmware](firmware.md)

SCCI_RH has two connected physical identities: a full-size electronics reference and a separate proposed implanted interface. The images below come from the saved CAD solids. You can inspect the design here before installing any software.

**View now:** [future interface in interactive 3D](https://pratham-cloud-ctrl.github.io/Project-SCCI-RH/?design=future&view=model) · [complete reference in interactive 3D](https://pratham-cloud-ctrl.github.io/Project-SCCI-RH/?design=reference&view=model).
Rotate, select/isolate named parts, hide covers and use the explode slider. Six
nonphysical allocation volumes in the future package default off. Browser
meshes are source-derived display copies; use STEP for solid CAD interchange.

**Open in your CAD software:** [complete native FreeCAD ZIP](https://pratham-cloud-ctrl.github.io/Project-SCCI-RH/downloads/SCCI_RH_CAD_Native.zip) · [complete 260-object reference STEP ZIP](https://pratham-cloud-ctrl.github.io/Project-SCCI-RH/downloads/SCCI_RH_Reference_Complete_STEP.zip) · [future fitted STEP](https://pratham-cloud-ctrl.github.io/Project-SCCI-RH/downloads/SCCI_RH_Future_Interface.step).
The native ZIP includes the feature module and opening launchers. STEP is the
standard interchange route for compatible CAD applications; editable feature
history remains in FreeCAD.
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
