pratham-cloud-ctrl/Project-SCCI-RH/cad/stage5/future-interface/future-exploded-native.png

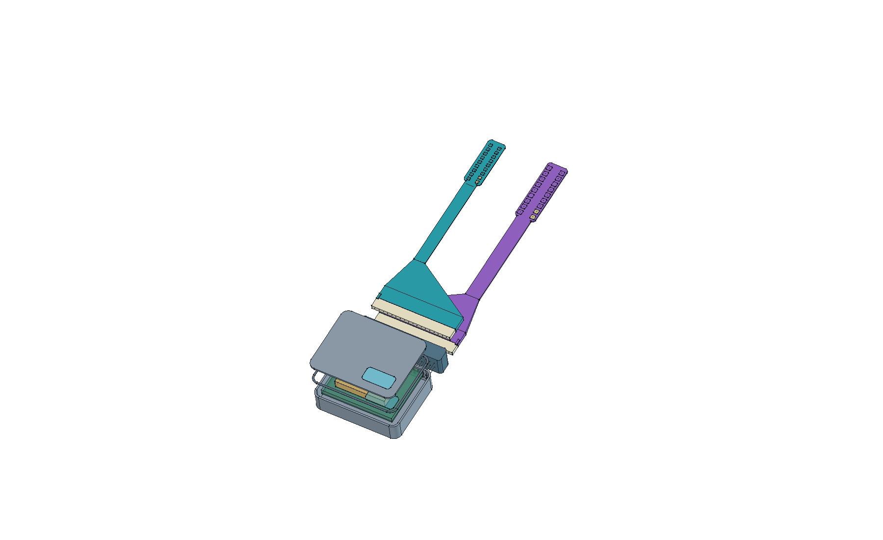
cad/stage5/future-interface/future-exploded-native.png
