pratham-cloud-ctrl/Project-SCCI-RH/cad/stage5/reference-full-native.png

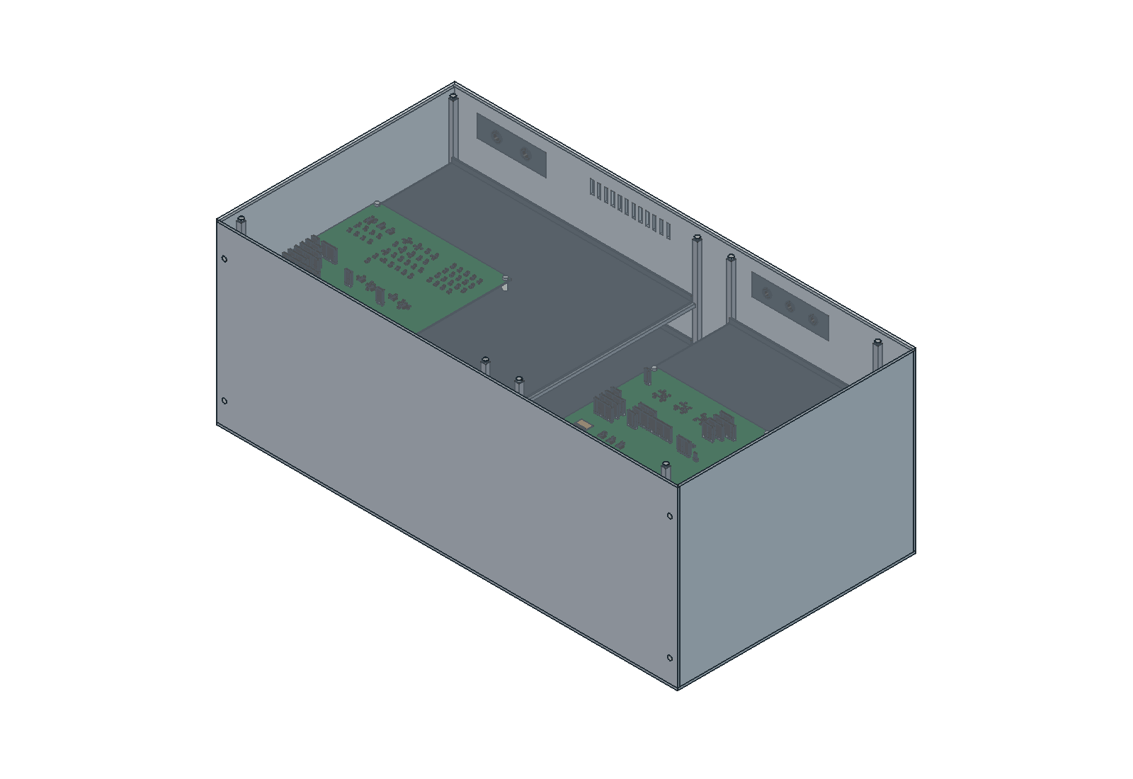
cad/stage5/reference-full-native.png
