pratham-cloud-ctrl/Project-SCCI-RH/cad/stage5/reference/drawings/contact-router-tray.png

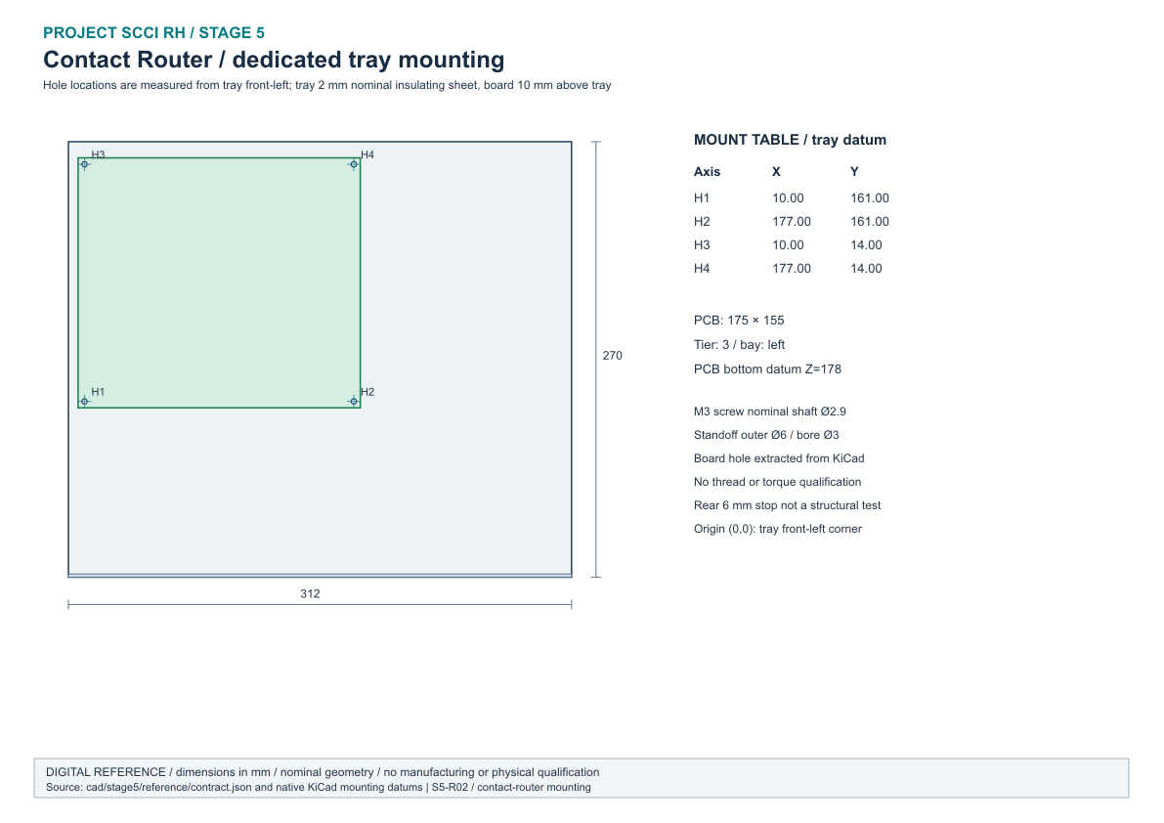
cad/stage5/reference/drawings/contact-router-tray.png
