pratham-cloud-ctrl/Project-SCCI-RH/cad/stage5/reference/drawings/controller-carrier-tray.png

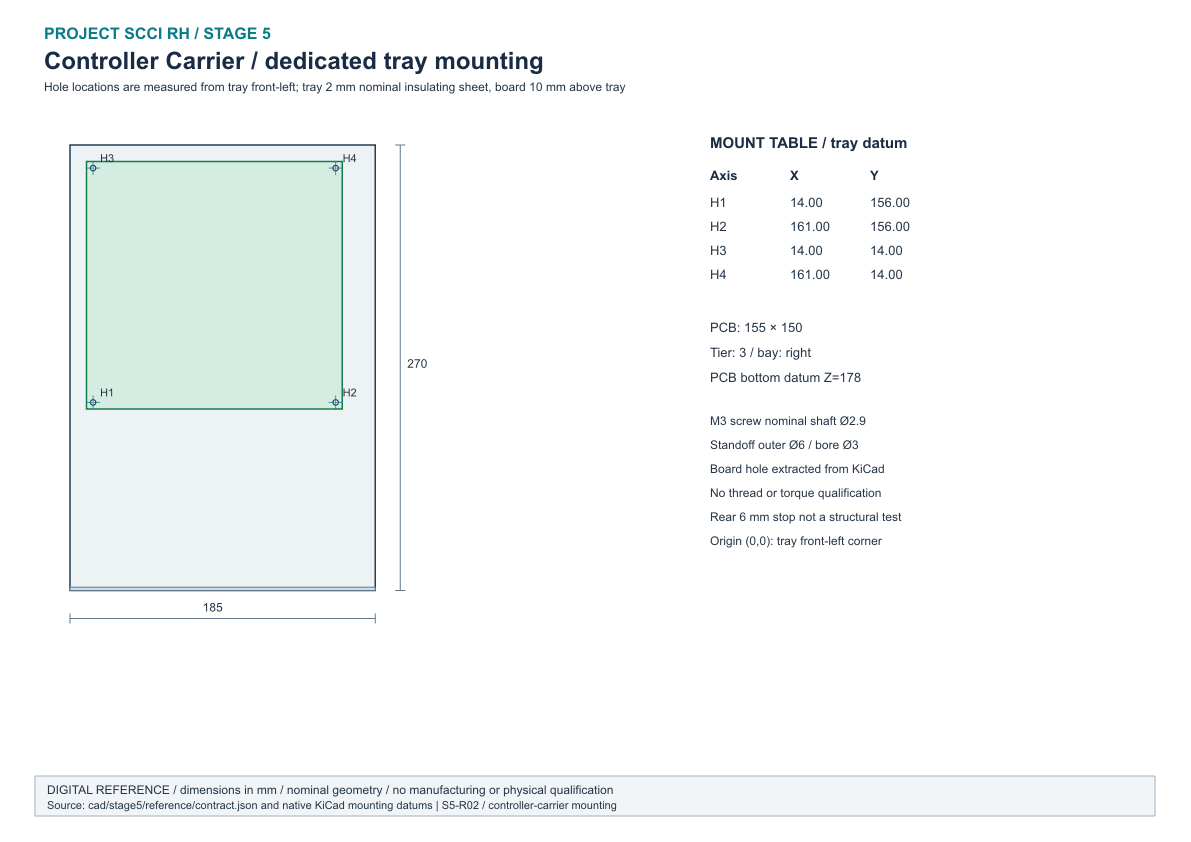
cad/stage5/reference/drawings/controller-carrier-tray.png
