pratham-cloud-ctrl/Project-SCCI-RH/cad/stage5/reference/drawings/reference-layout.png

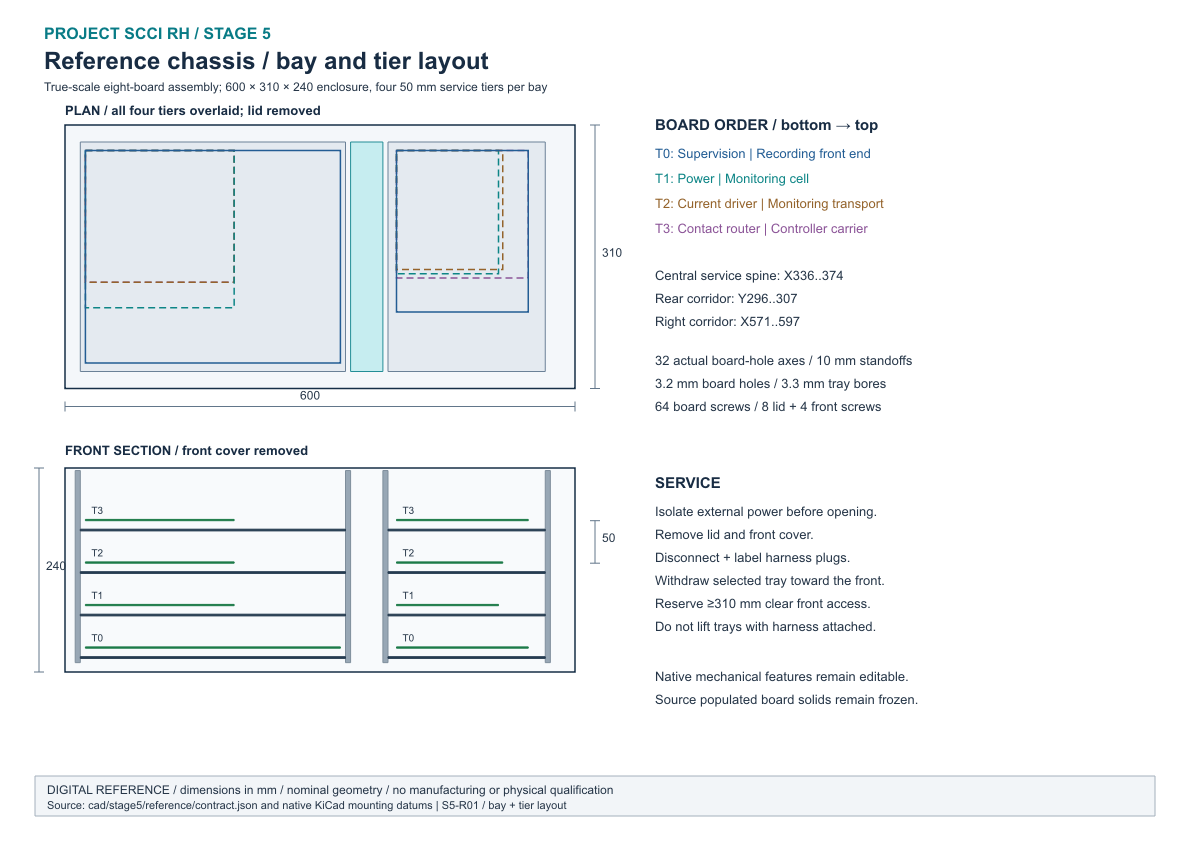
cad/stage5/reference/drawings/reference-layout.png
