pratham-cloud-ctrl/Project-SCCI-RH/cad/stage5/reference/drawings/supervision-tray.png

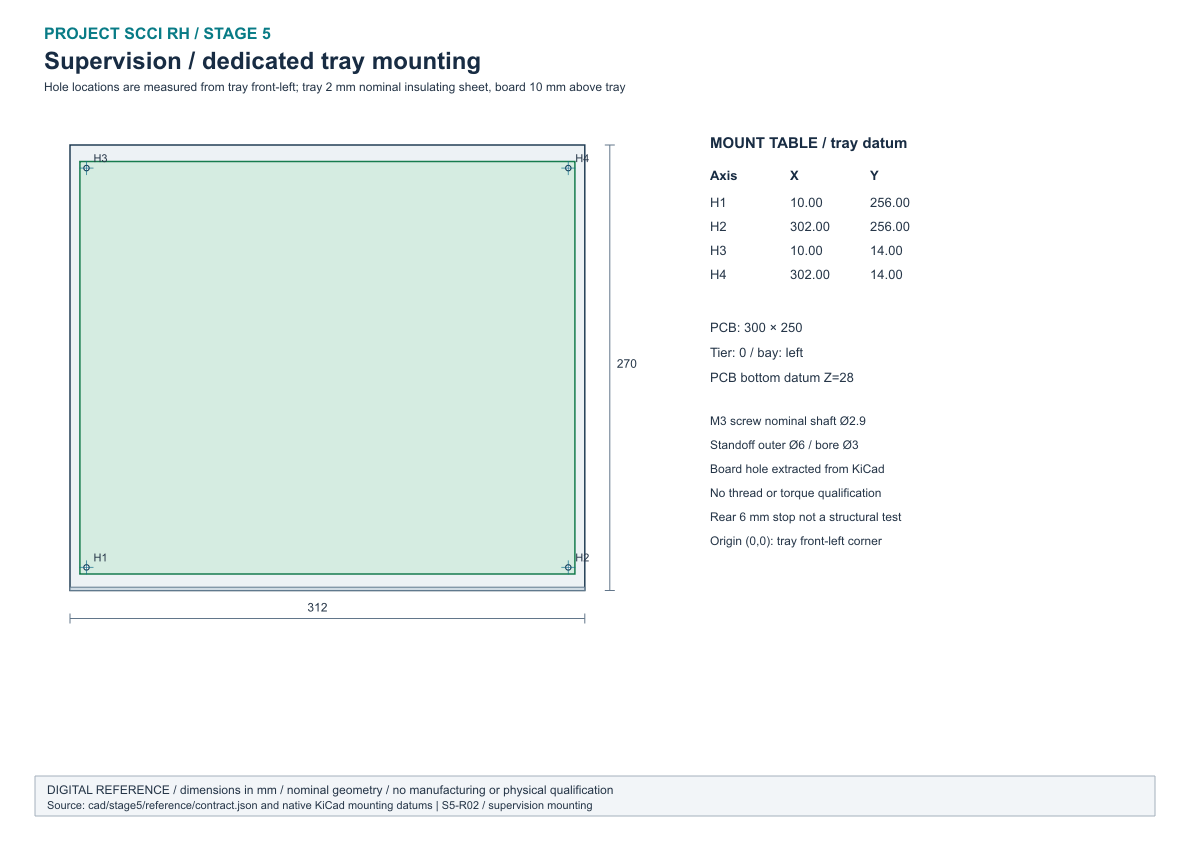
cad/stage5/reference/drawings/supervision-tray.png
