pratham-cloud-ctrl/Project-SCCI-RH/cad/stage5/renders/future_exploded.png

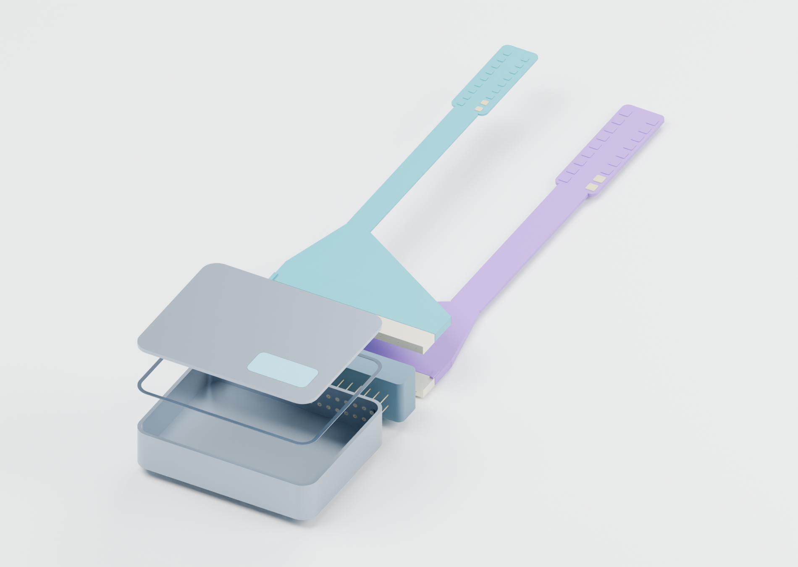
cad/stage5/renders/future_exploded.png
