pratham-cloud-ctrl/Project-SCCI-RH/cad/stage5/renders/reference_exploded.png

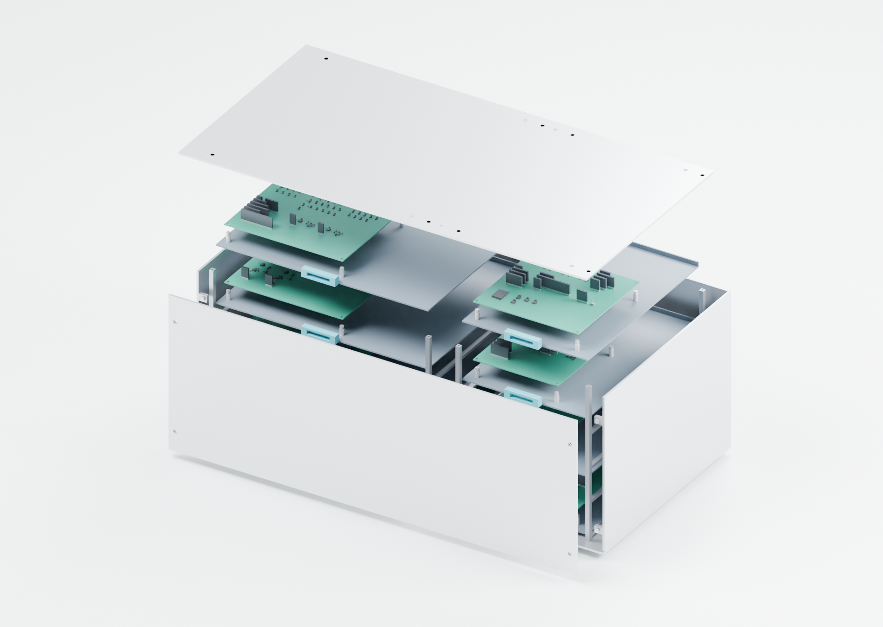
cad/stage5/renders/reference_exploded.png
