pratham-cloud-ctrl/Project-SCCI-RH/docs/stage1/figures/full-system.png

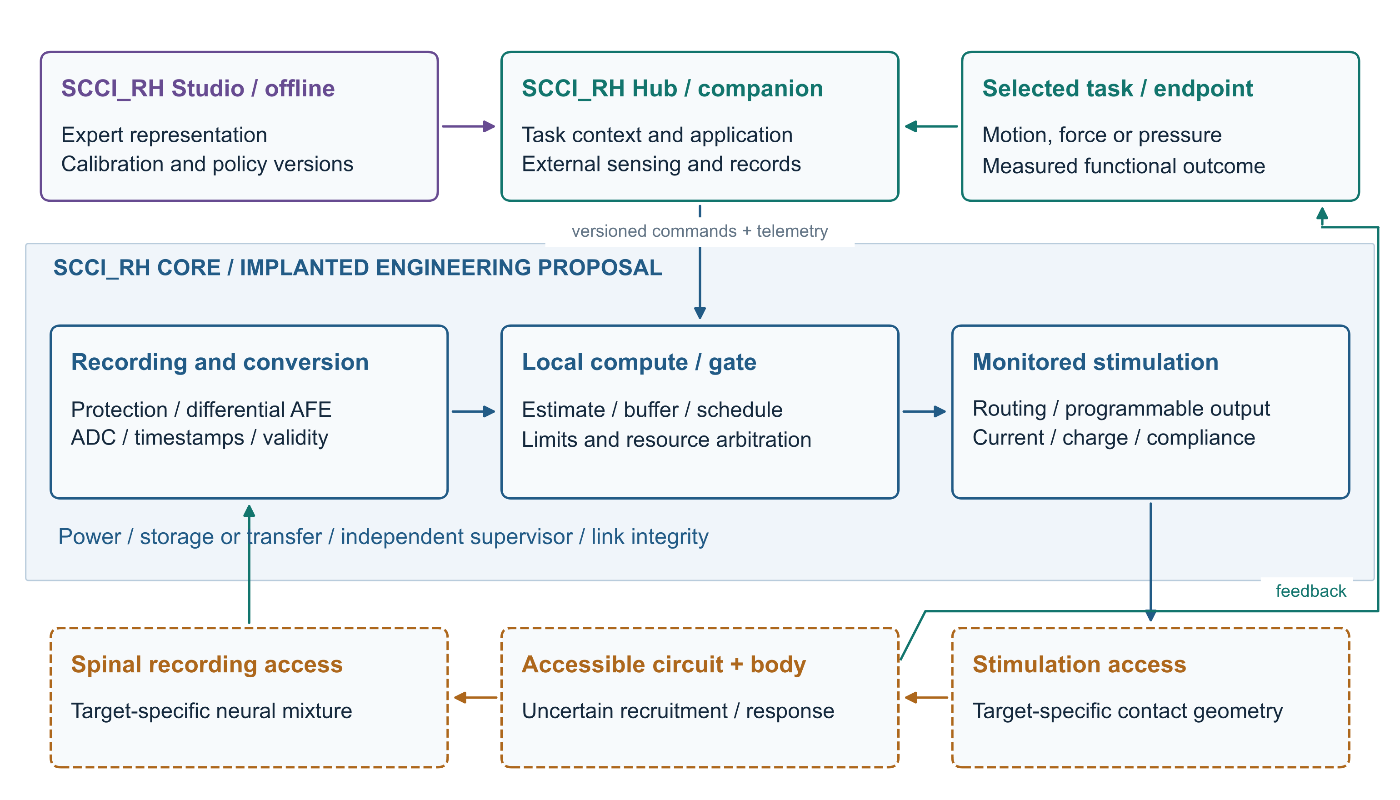
docs/stage1/figures/full-system.png
