pratham-cloud-ctrl/Project-SCCI-RH/docs/stage3/figures/mechanism-revision.png

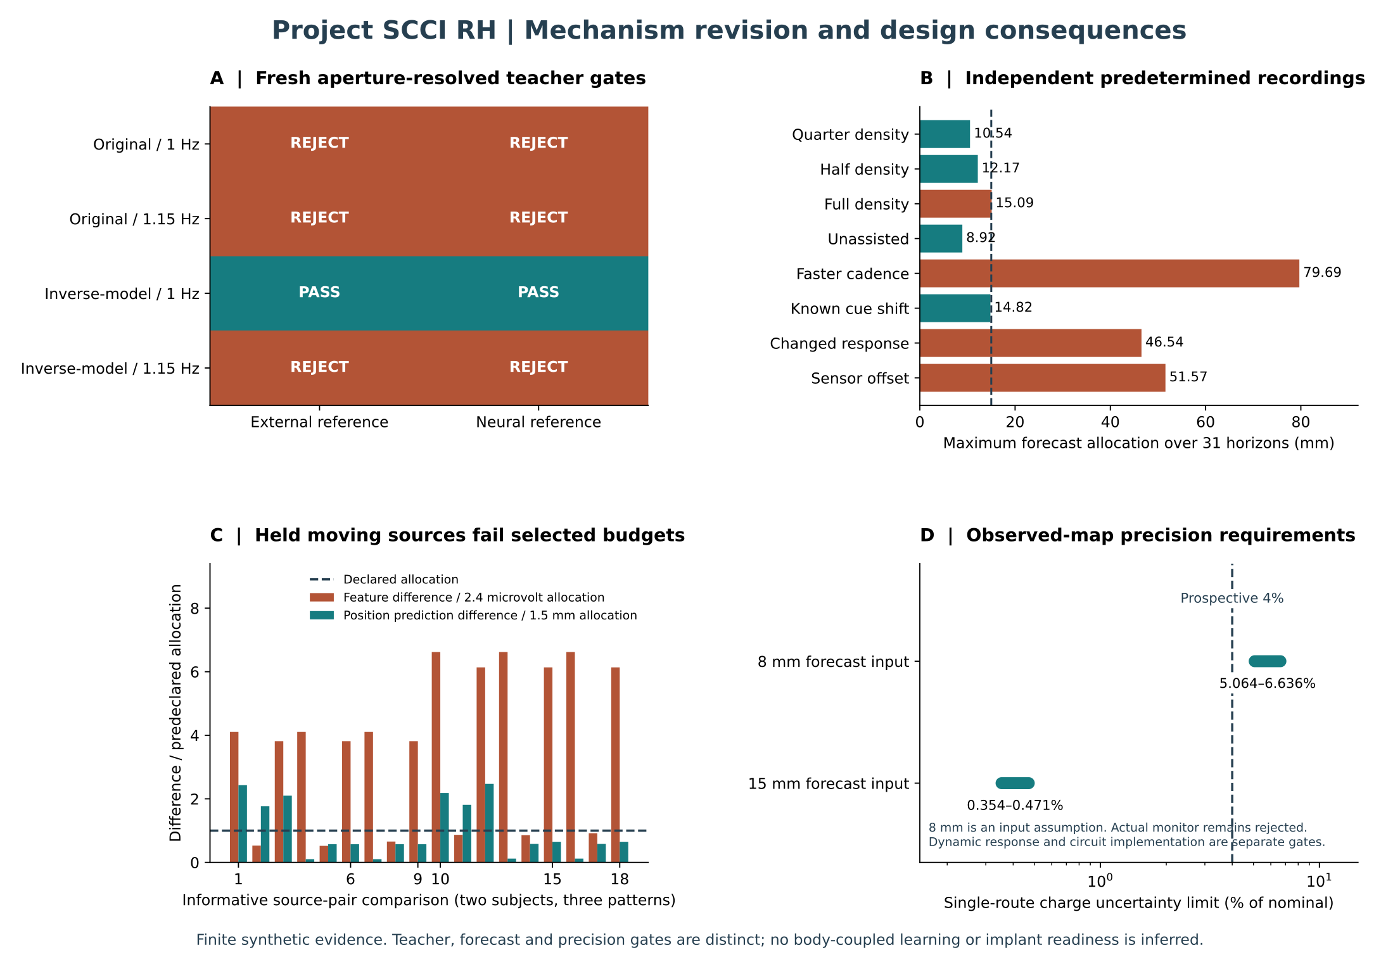
docs/stage3/figures/mechanism-revision.png
