pratham-cloud-ctrl/Project-SCCI-RH/electronics/reports/schematic_preview.png

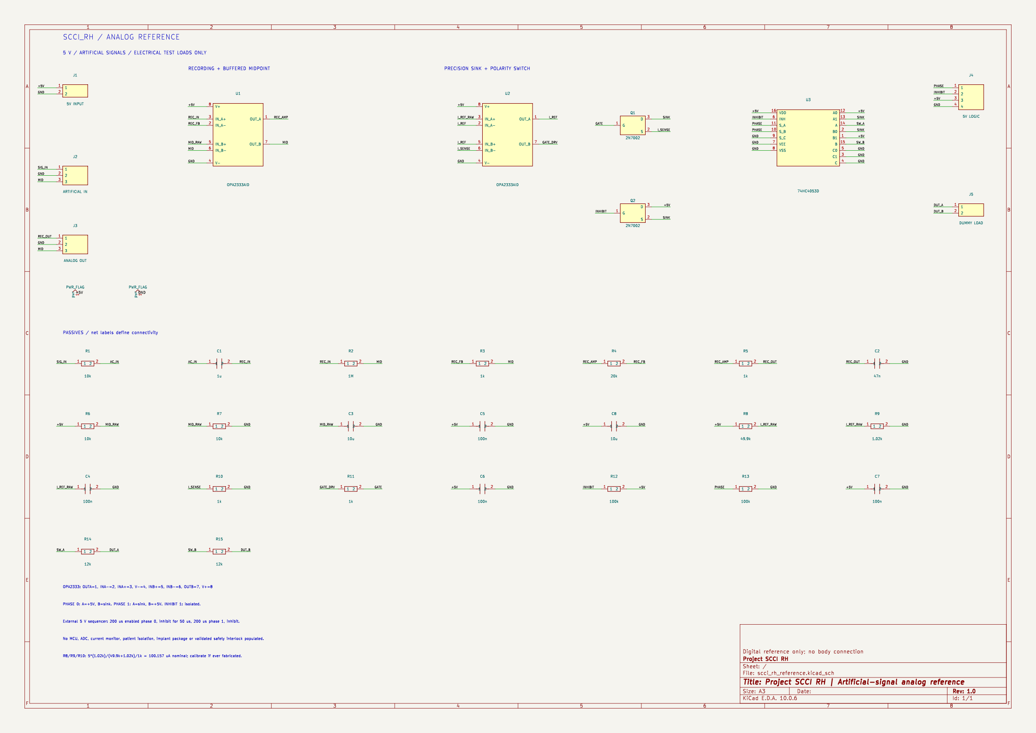
electronics/reports/schematic_preview.png
