pratham-cloud-ctrl/Project-SCCI-RH/electronics/stage4/contact-router/review/page-4.png

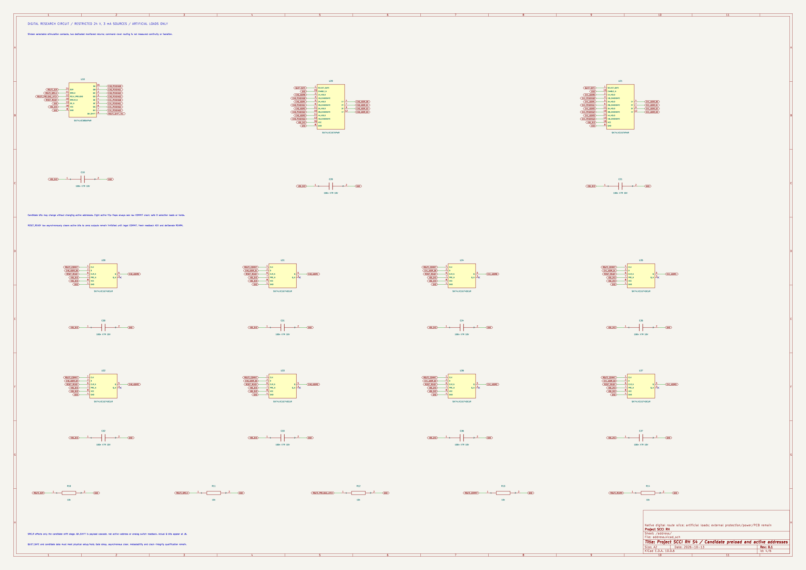
electronics/stage4/contact-router/review/page-4.png
