pratham-cloud-ctrl/Project-SCCI-RH/electronics/stage4/contact-router/review/page-5.png

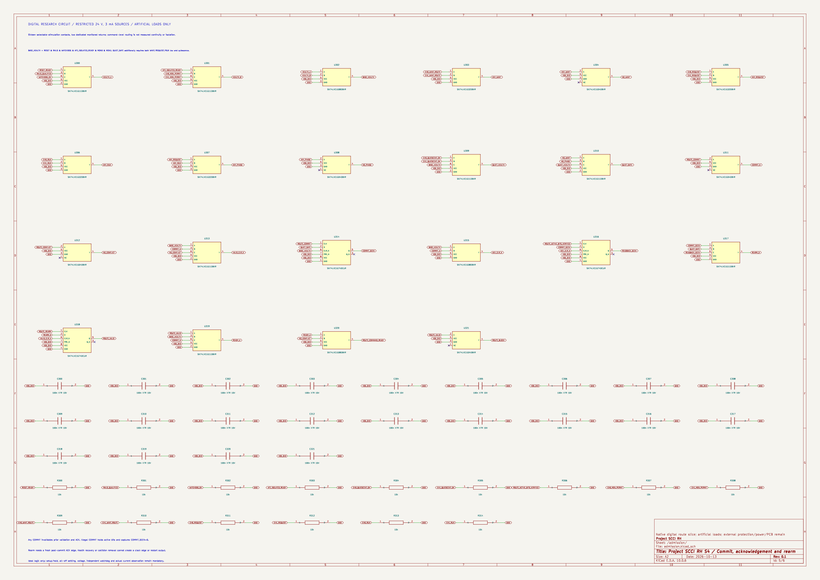
electronics/stage4/contact-router/review/page-5.png
