pratham-cloud-ctrl/Project-SCCI-RH/electronics/stage4/controller-carrier/review/page-5.png

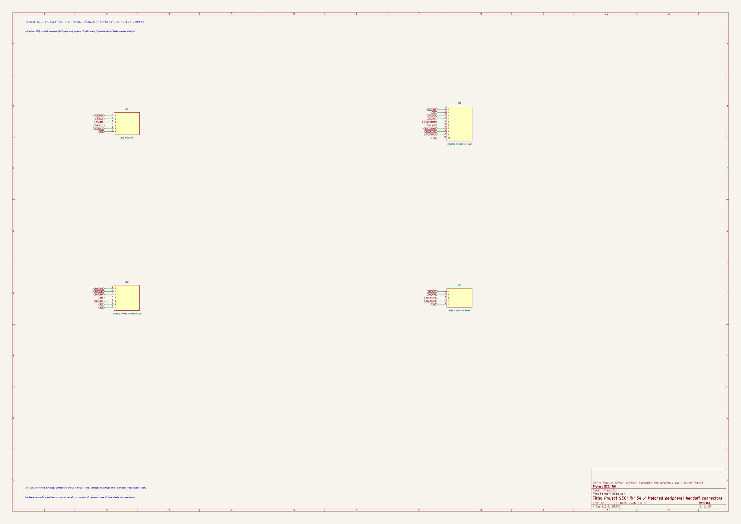
electronics/stage4/controller-carrier/review/page-5.png
