pratham-cloud-ctrl/Project-SCCI-RH/electronics/stage4/current-driver/review/page-2.png

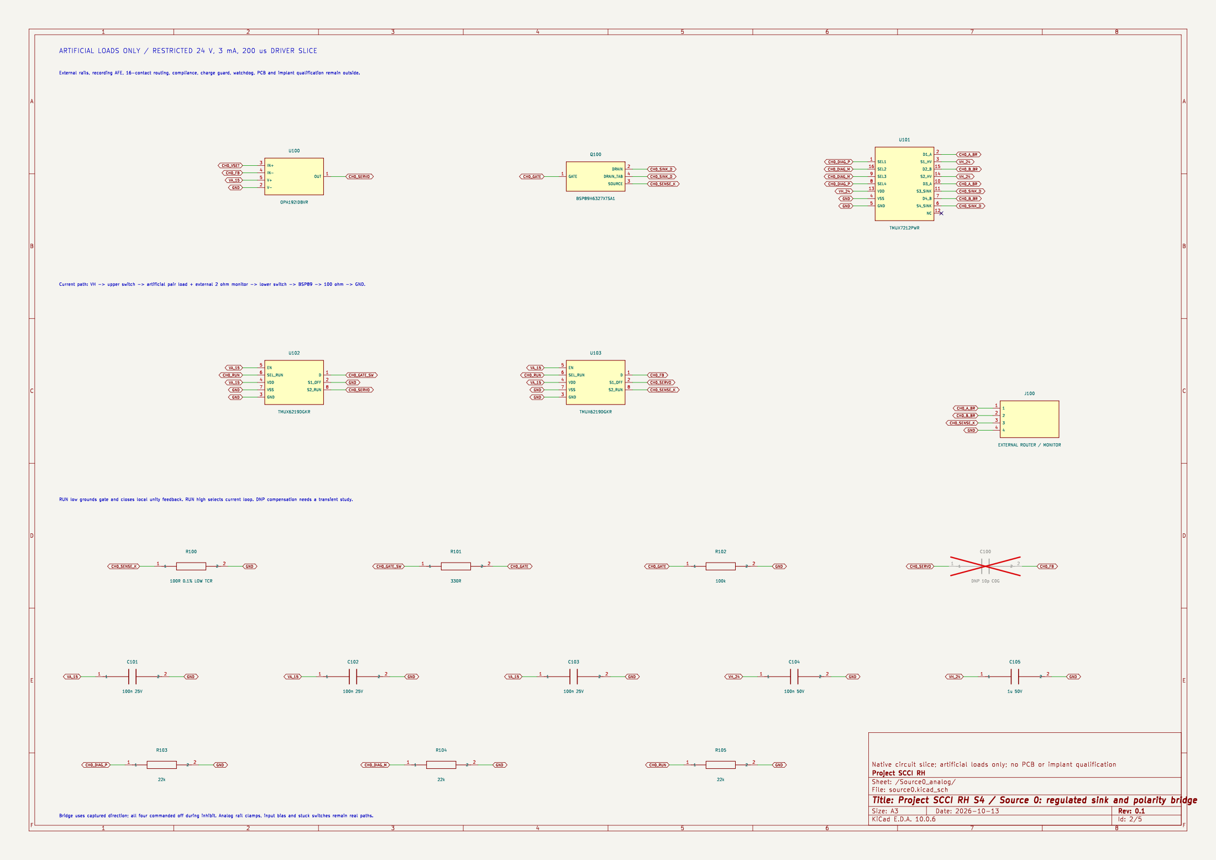
electronics/stage4/current-driver/review/page-2.png
