pratham-cloud-ctrl/Project-SCCI-RH/electronics/stage4/driver-study/driver-waveforms.png

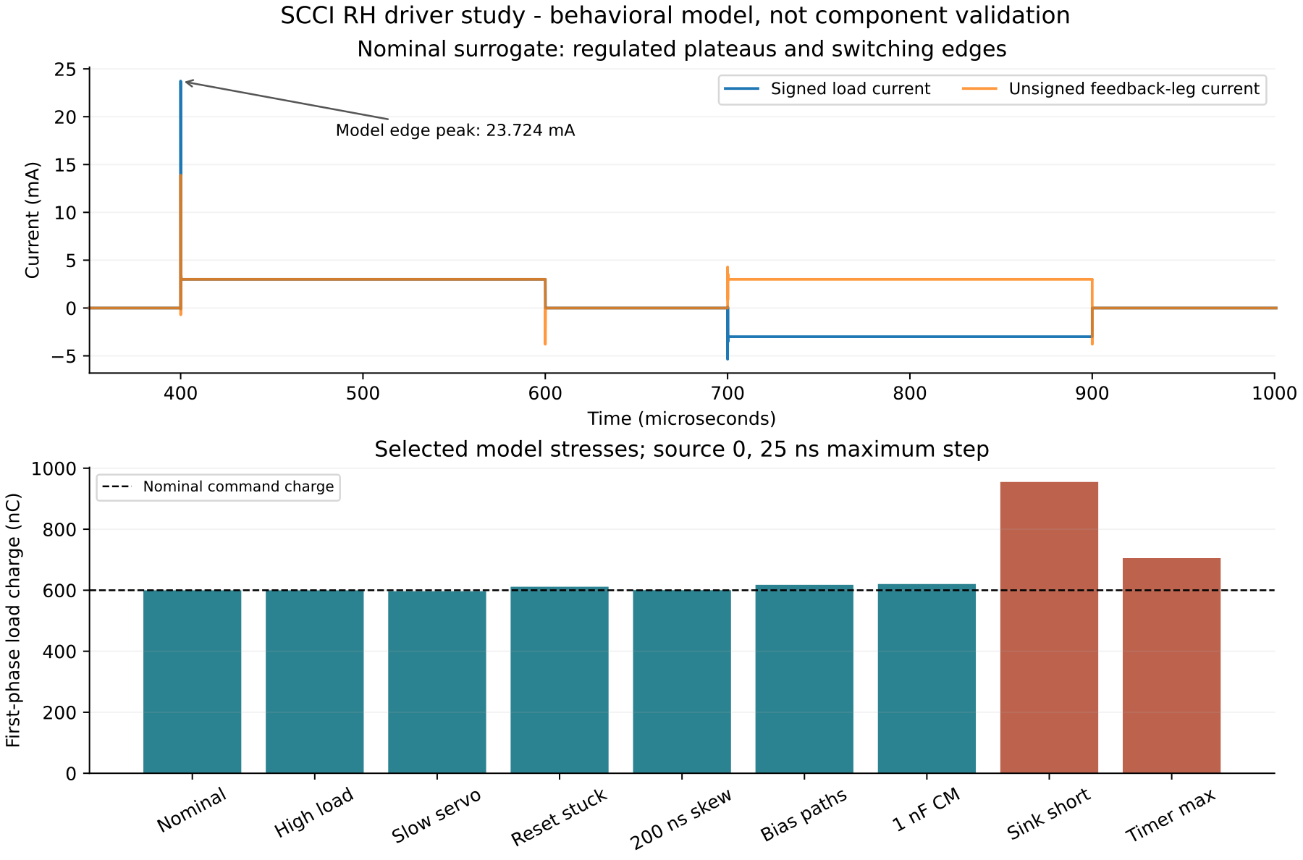
electronics/stage4/driver-study/driver-waveforms.png
