pratham-cloud-ctrl/Project-SCCI-RH/electronics/stage4/integrated-pcb/exports/contact-router/bottom.png

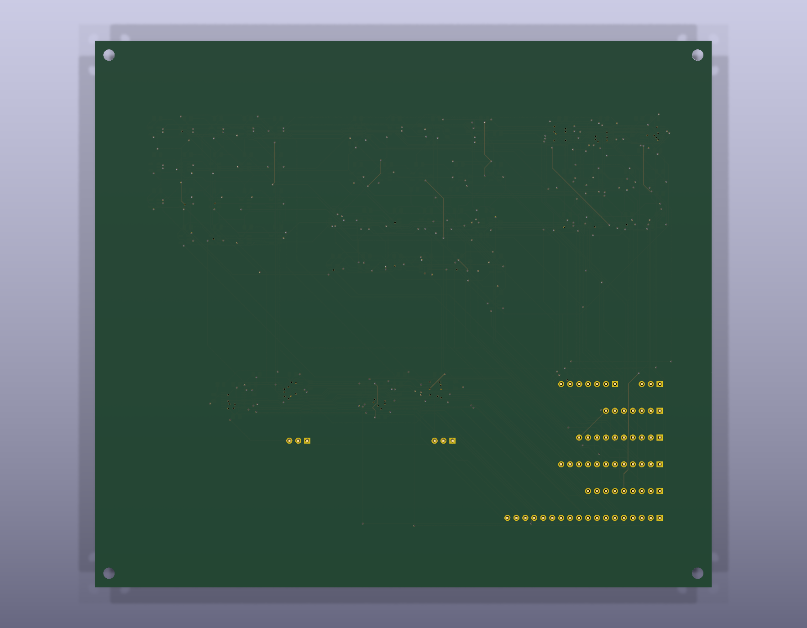
electronics/stage4/integrated-pcb/exports/contact-router/bottom.png
