pratham-cloud-ctrl/Project-SCCI-RH/electronics/stage4/integrated-pcb/exports/contact-router/top.png

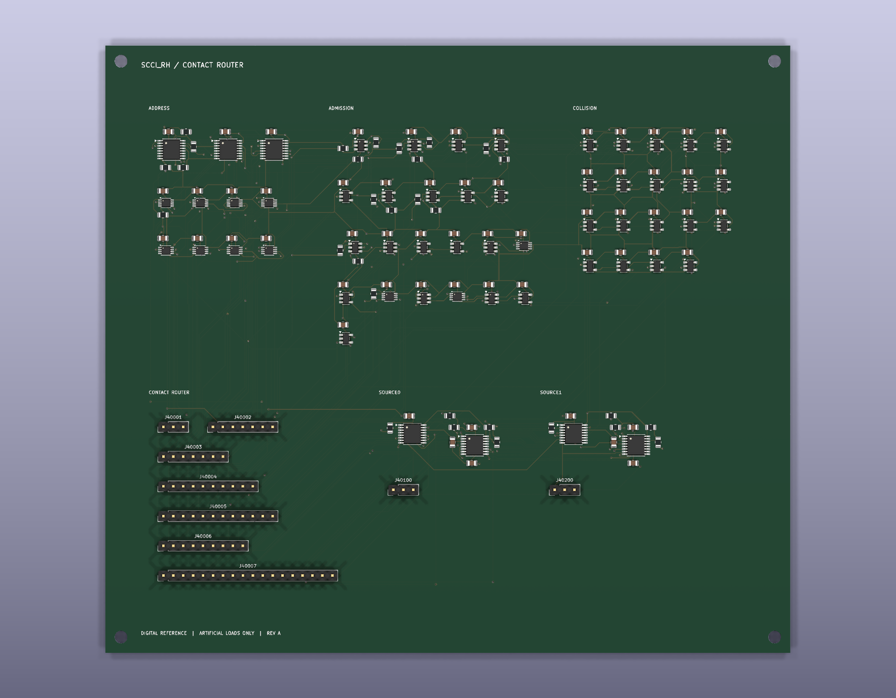
electronics/stage4/integrated-pcb/exports/contact-router/top.png
