pratham-cloud-ctrl/Project-SCCI-RH/electronics/stage4/integrated-pcb/exports/controller-carrier/top.png

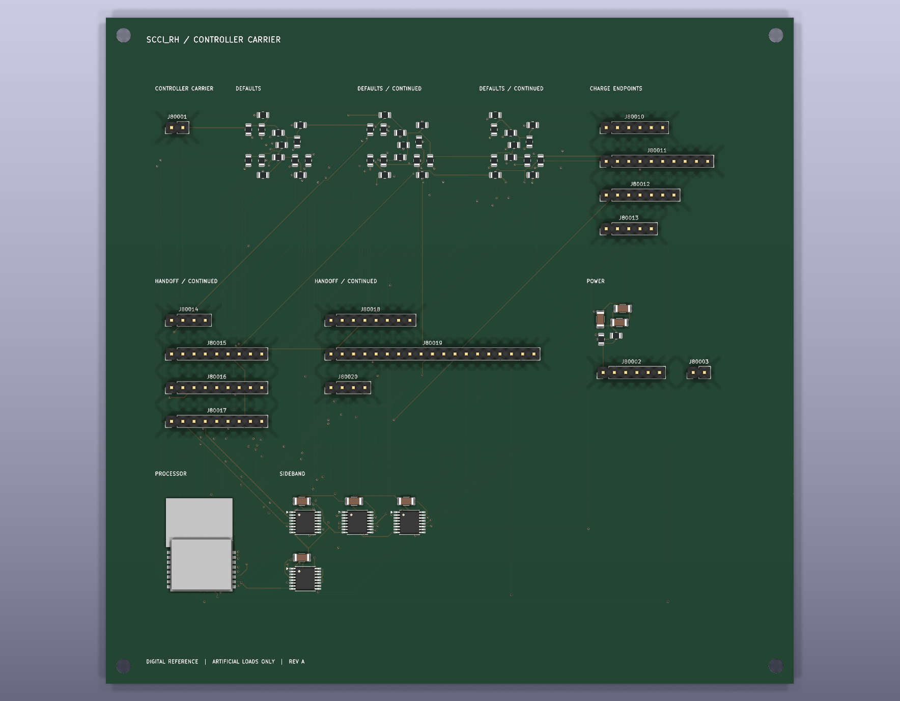
electronics/stage4/integrated-pcb/exports/controller-carrier/top.png
