pratham-cloud-ctrl/Project-SCCI-RH/electronics/stage4/integrated-pcb/exports/current-driver/bottom.png

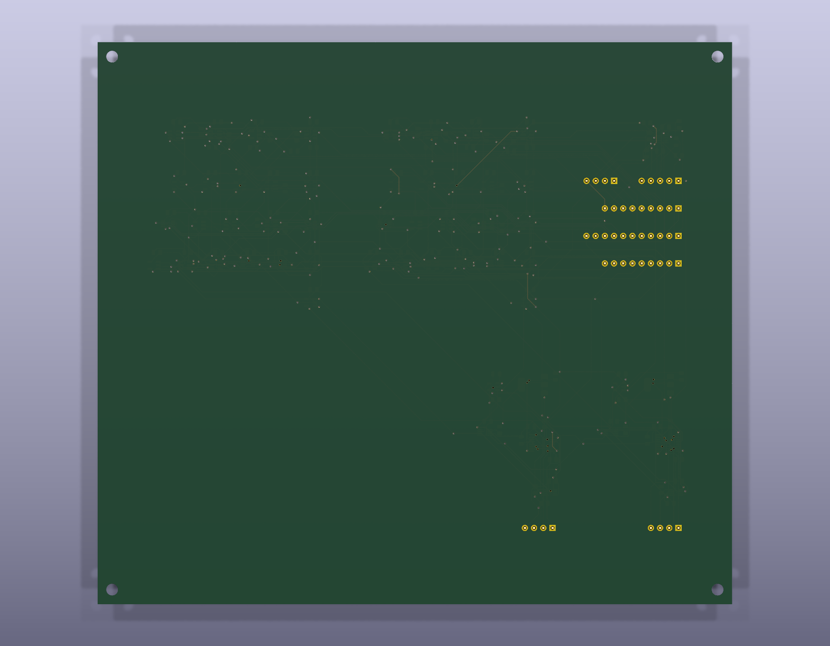
electronics/stage4/integrated-pcb/exports/current-driver/bottom.png
