pratham-cloud-ctrl/Project-SCCI-RH/electronics/stage4/integrated-pcb/exports/current-driver/top.png

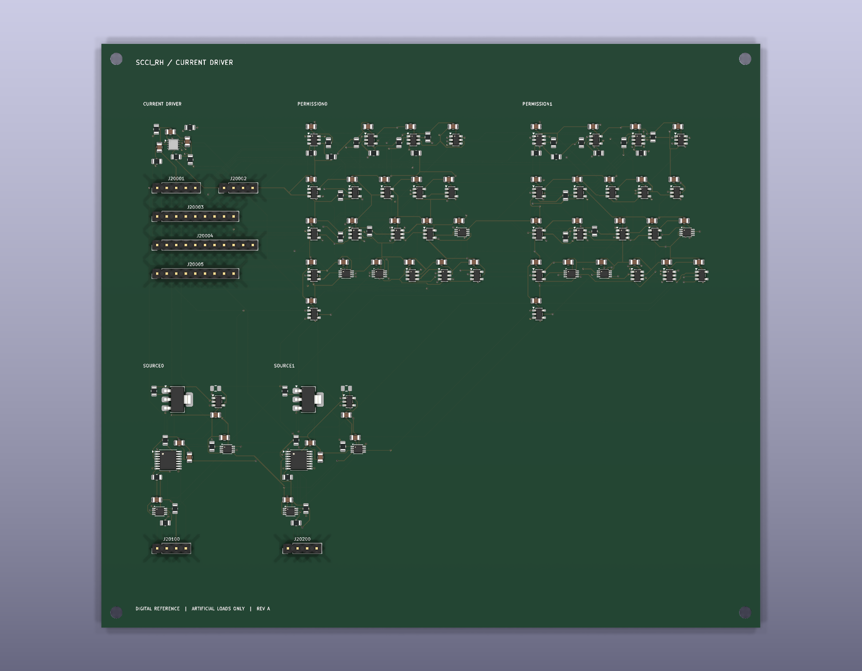
electronics/stage4/integrated-pcb/exports/current-driver/top.png
