pratham-cloud-ctrl/Project-SCCI-RH/electronics/stage4/integrated-pcb/exports/monitoring-cell/bottom.png

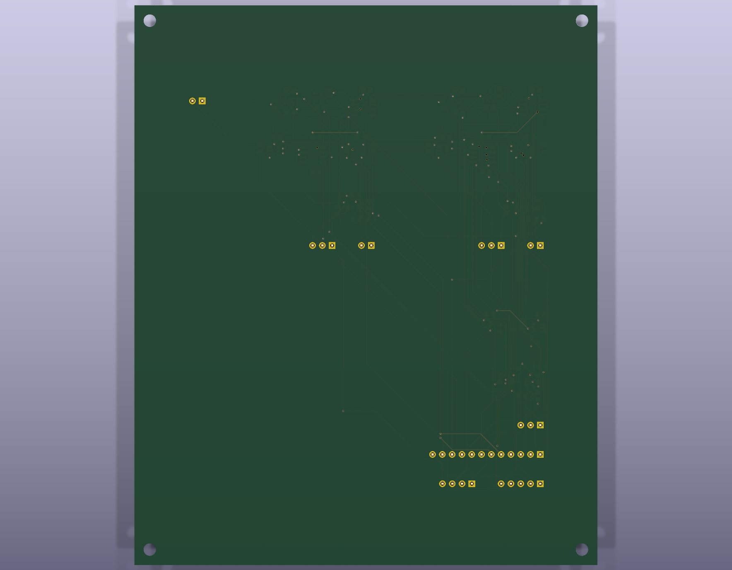
electronics/stage4/integrated-pcb/exports/monitoring-cell/bottom.png
