pratham-cloud-ctrl/Project-SCCI-RH/electronics/stage4/integrated-pcb/exports/monitoring-transport/bottom.png

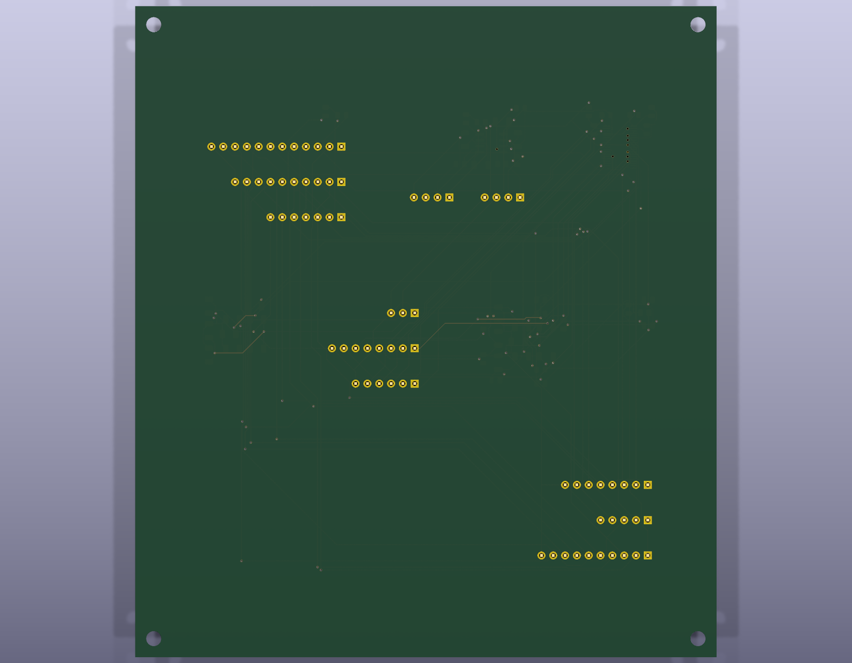
electronics/stage4/integrated-pcb/exports/monitoring-transport/bottom.png
