pratham-cloud-ctrl/Project-SCCI-RH/electronics/stage4/integrated-pcb/exports/power/bottom.png

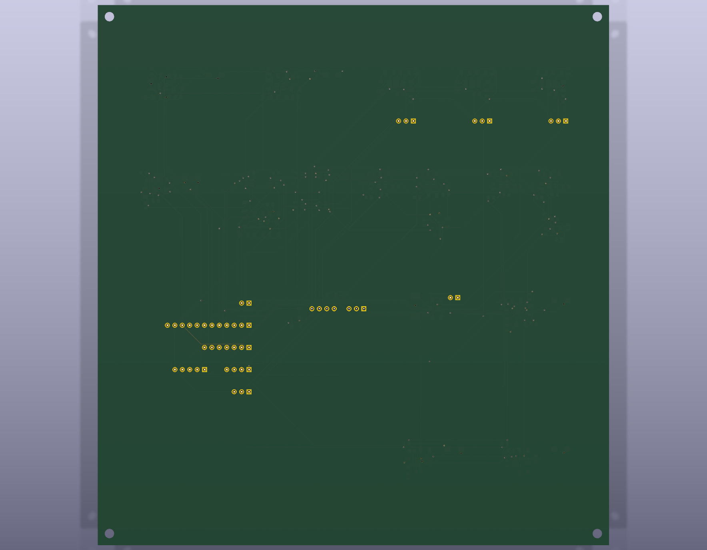
electronics/stage4/integrated-pcb/exports/power/bottom.png
