pratham-cloud-ctrl/Project-SCCI-RH/electronics/stage4/integrated-pcb/exports/power/top.png

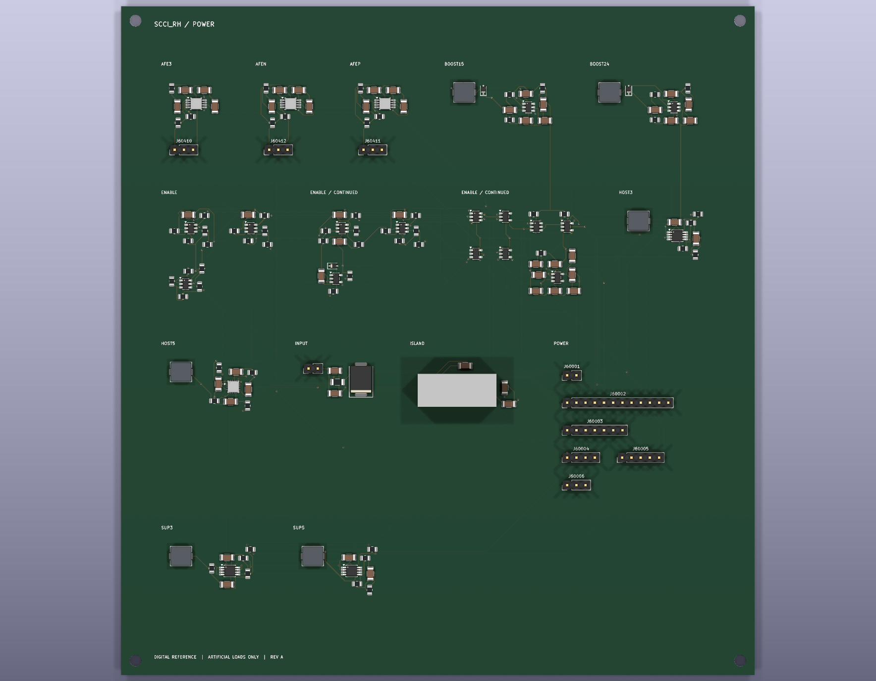
electronics/stage4/integrated-pcb/exports/power/top.png
