pratham-cloud-ctrl/Project-SCCI-RH/electronics/stage4/integrated-pcb/exports/recording-front-end/bottom.png

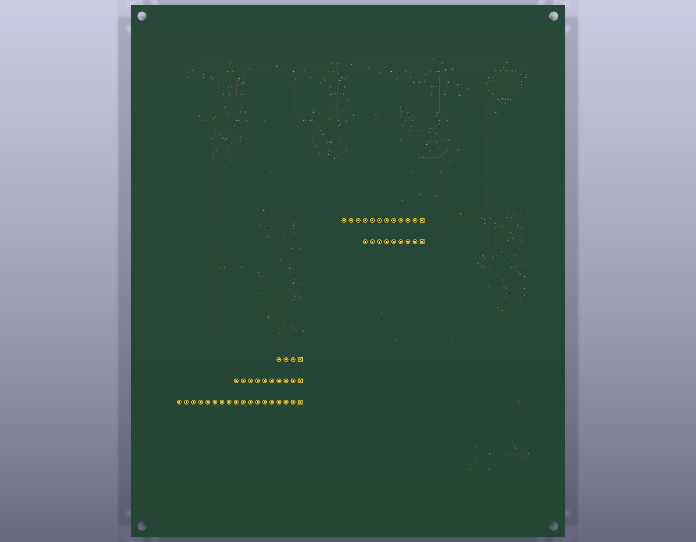
electronics/stage4/integrated-pcb/exports/recording-front-end/bottom.png
