pratham-cloud-ctrl/Project-SCCI-RH/electronics/stage4/integrated-pcb/exports/supervision/top.png

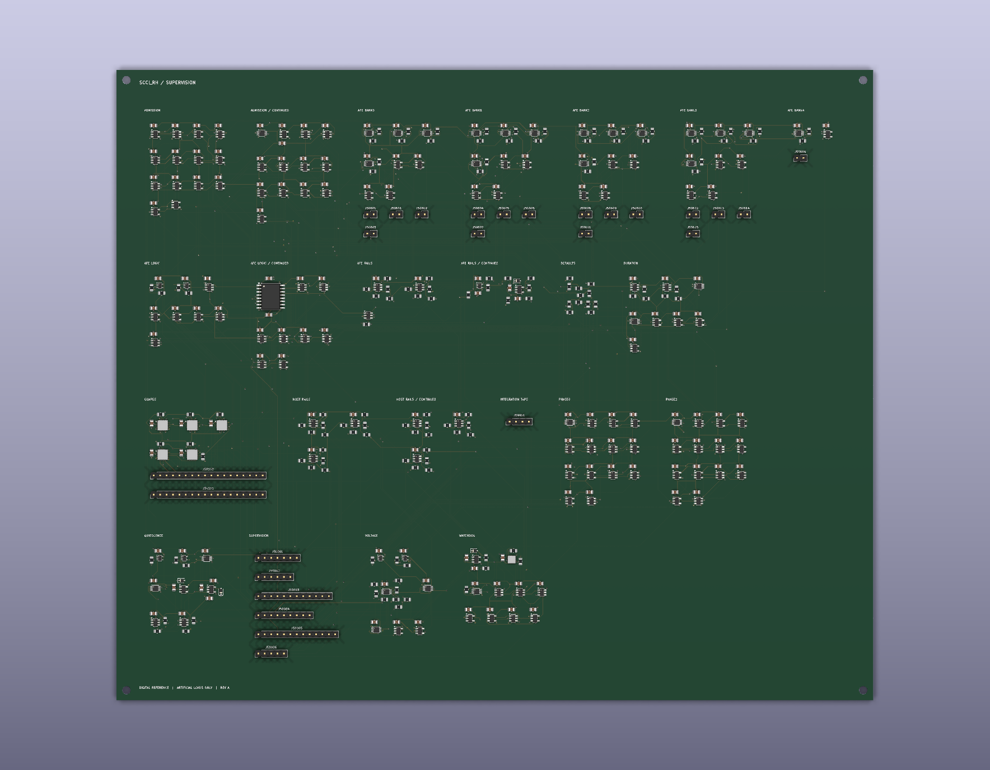
electronics/stage4/integrated-pcb/exports/supervision/top.png
