pratham-cloud-ctrl/Project-SCCI-RH/electronics/stage4/monitoring-cell/review/page-1.png

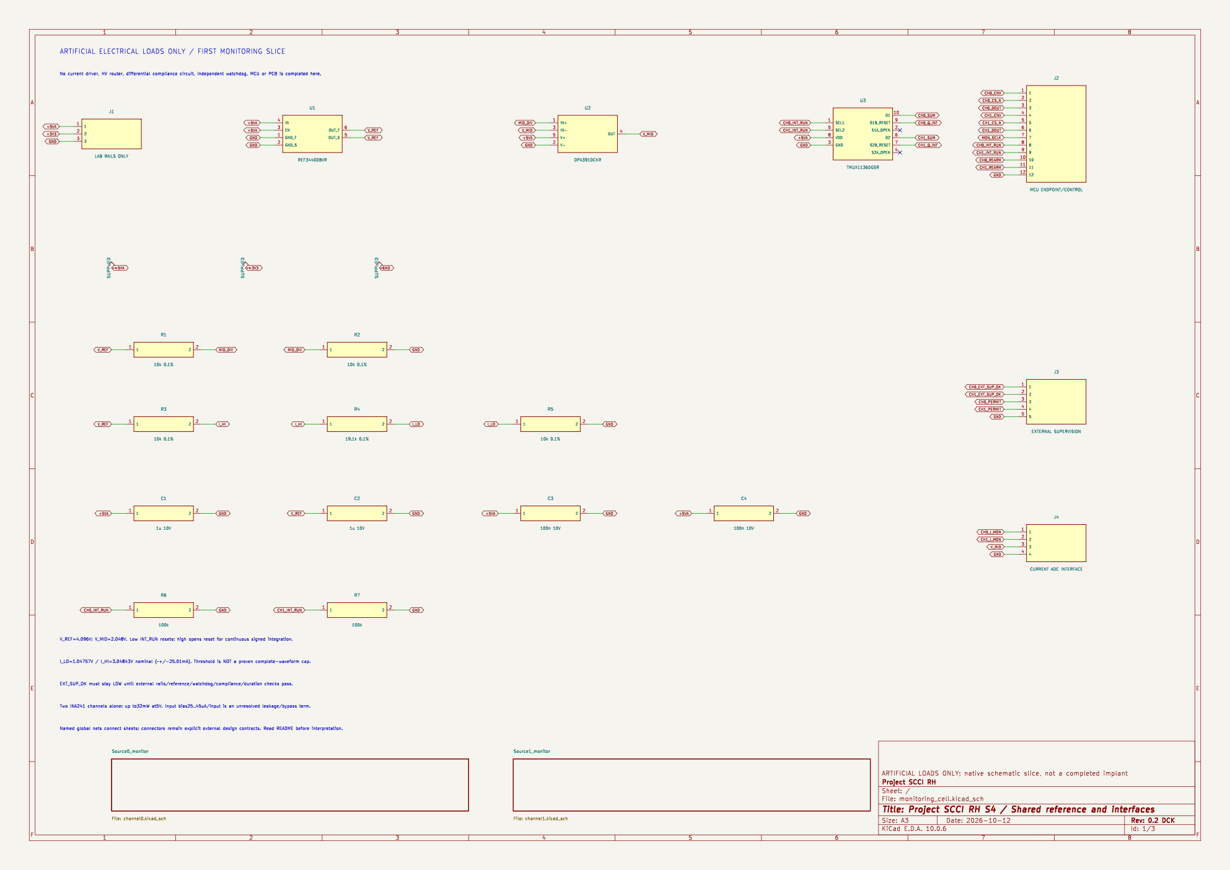
electronics/stage4/monitoring-cell/review/page-1.png
