pratham-cloud-ctrl/Project-SCCI-RH/electronics/stage4/monitoring-study/charge-witnesses.png

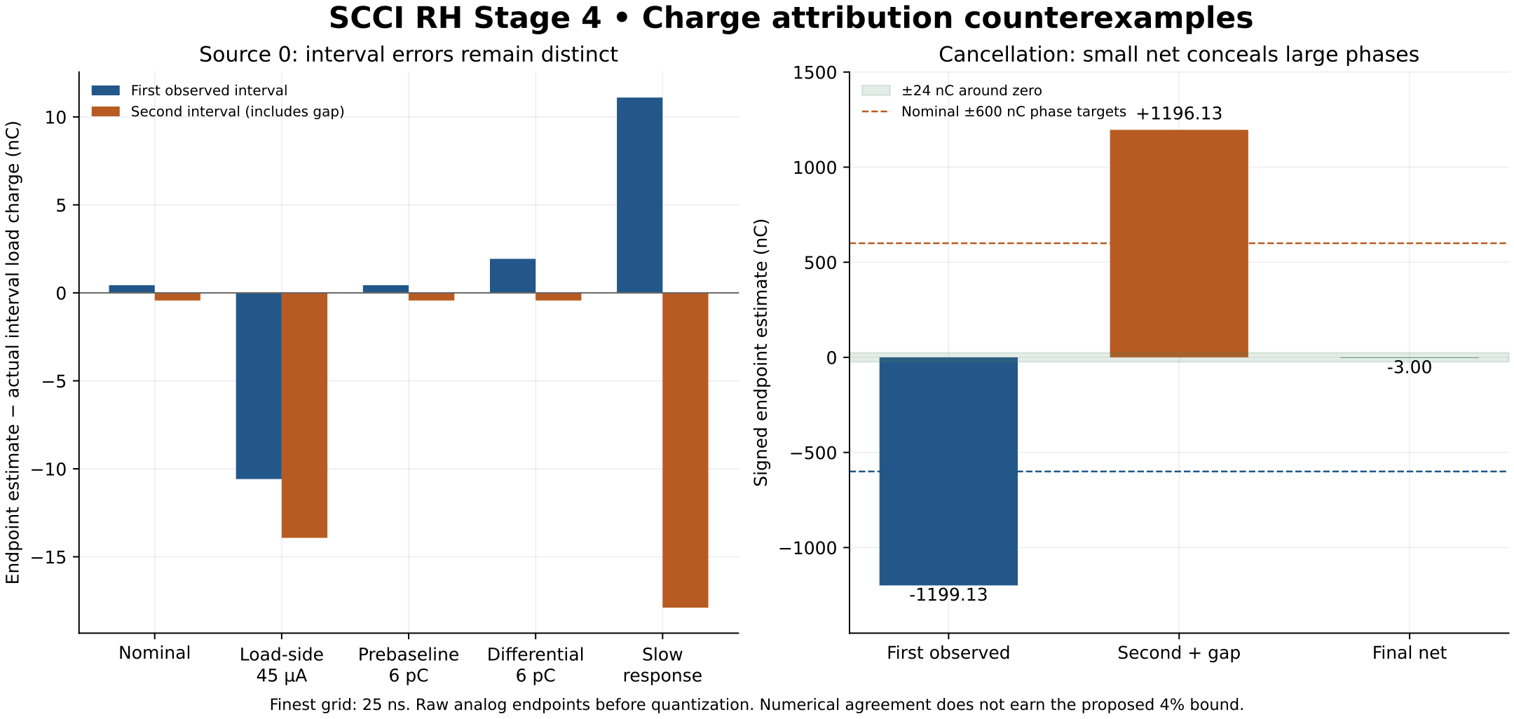
electronics/stage4/monitoring-study/charge-witnesses.png
