pratham-cloud-ctrl/Project-SCCI-RH/electronics/stage4/monitoring-study/waveforms.png

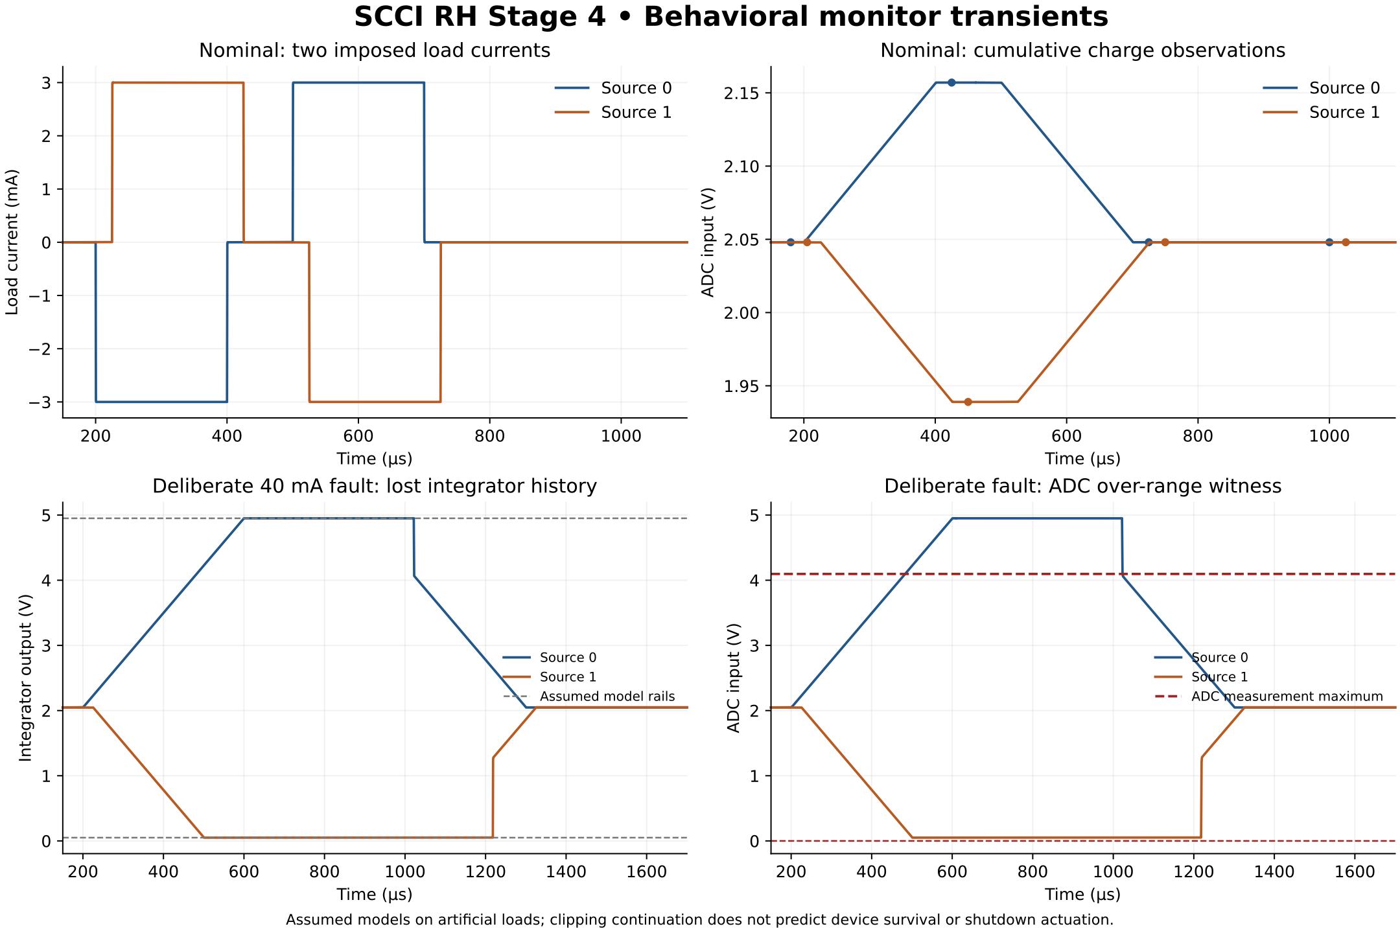
electronics/stage4/monitoring-study/waveforms.png
