pratham-cloud-ctrl/Project-SCCI-RH/electronics/stage4/monitoring-transport/review/final-review-contact.png

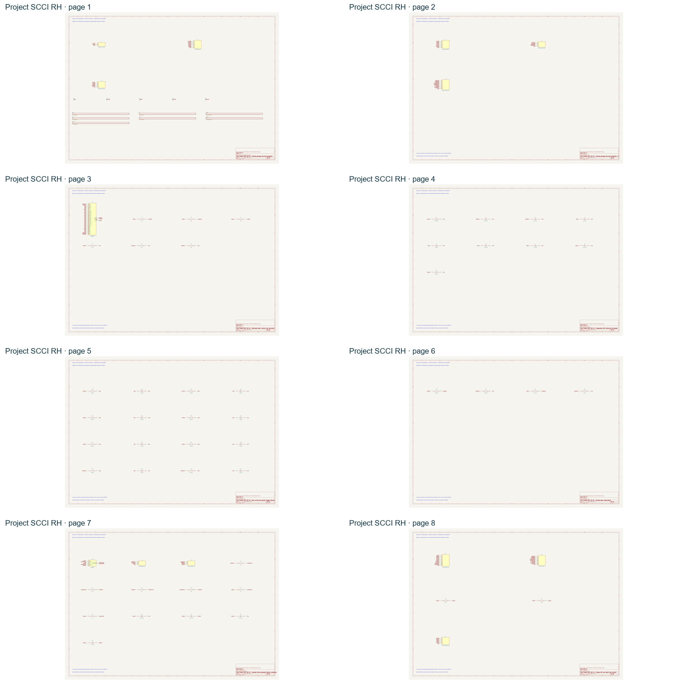
electronics/stage4/monitoring-transport/review/final-review-contact.png
