pratham-cloud-ctrl/Project-SCCI-RH/electronics/stage4/monitoring-transport/review/page-2.png

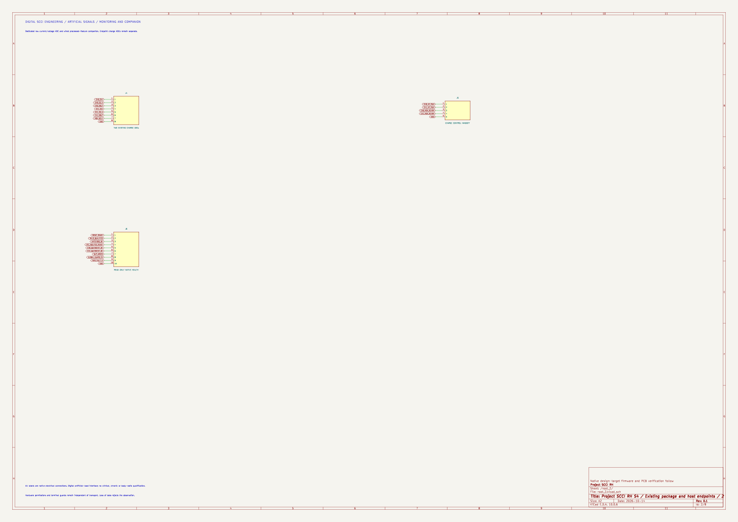
electronics/stage4/monitoring-transport/review/page-2.png
