pratham-cloud-ctrl/Project-SCCI-RH/electronics/stage4/monitoring-transport/review/page-7.png

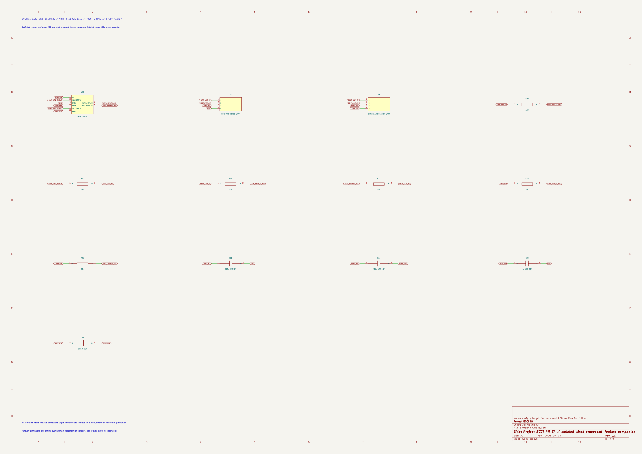
electronics/stage4/monitoring-transport/review/page-7.png
