pratham-cloud-ctrl/Project-SCCI-RH/electronics/stage4/power/review/page-01.png

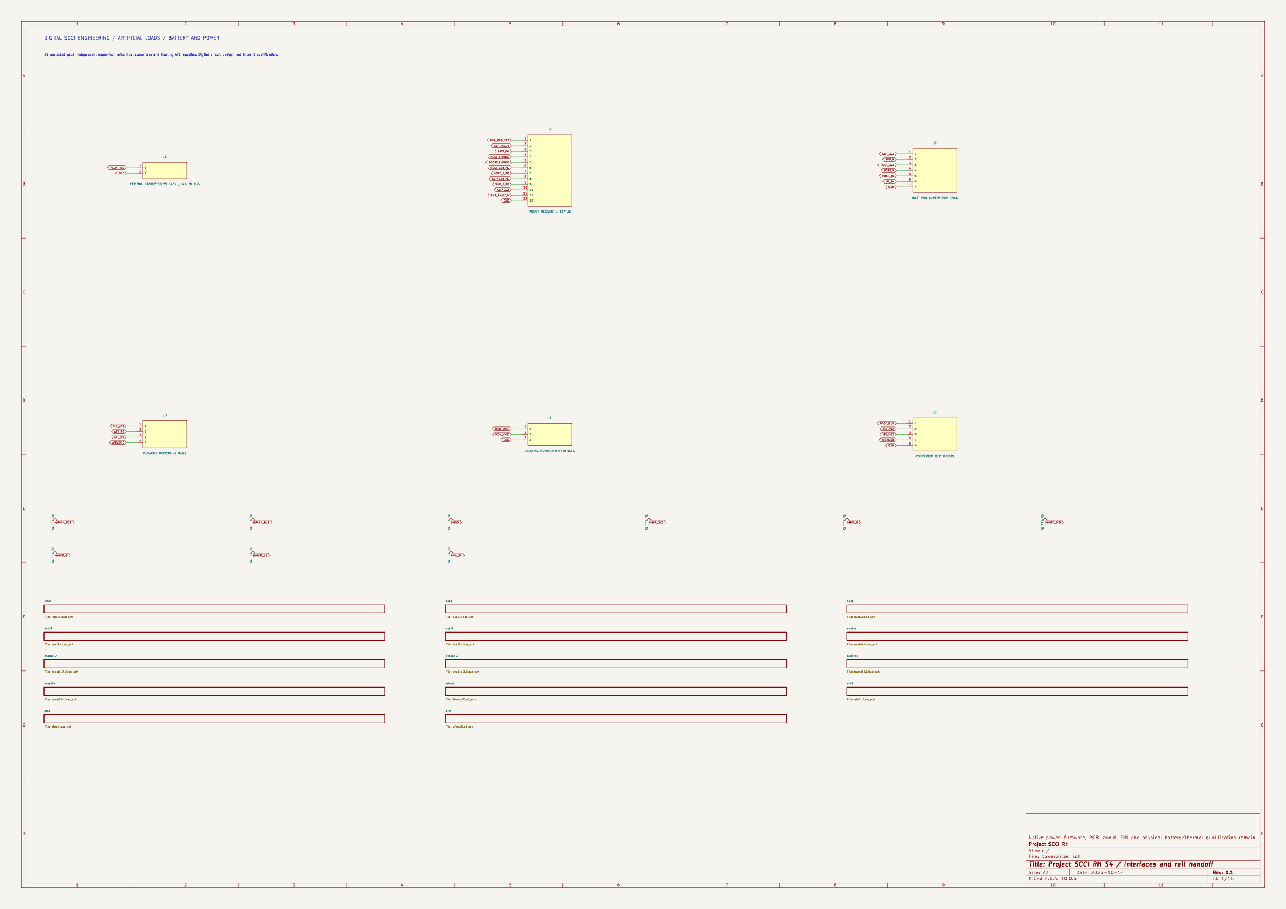
electronics/stage4/power/review/page-01.png
