pratham-cloud-ctrl/Project-SCCI-RH/electronics/stage4/power/review/page-06.png

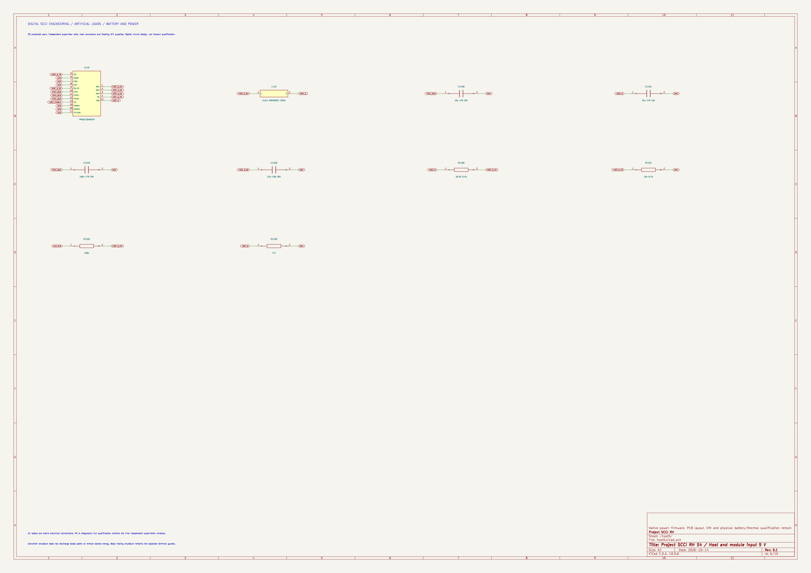
electronics/stage4/power/review/page-06.png
