pratham-cloud-ctrl/Project-SCCI-RH/electronics/stage4/power/review/page-07.png

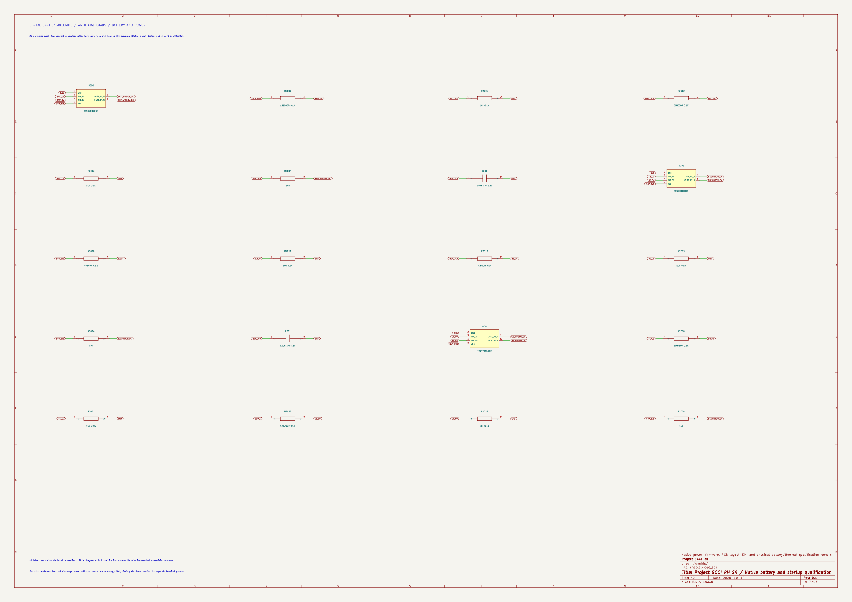
electronics/stage4/power/review/page-07.png
