pratham-cloud-ctrl/Project-SCCI-RH/electronics/stage4/power/review/page-09.png

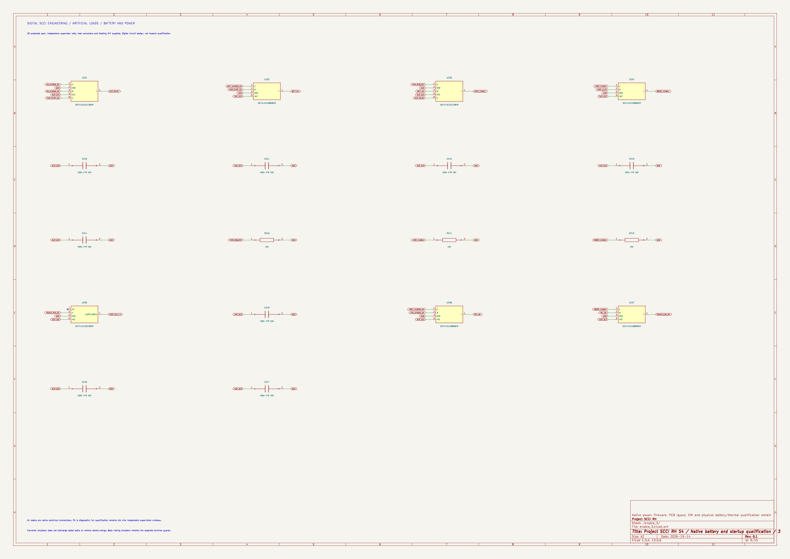
electronics/stage4/power/review/page-09.png
