pratham-cloud-ctrl/Project-SCCI-RH/electronics/stage4/recording-front-end/review/page-1.png

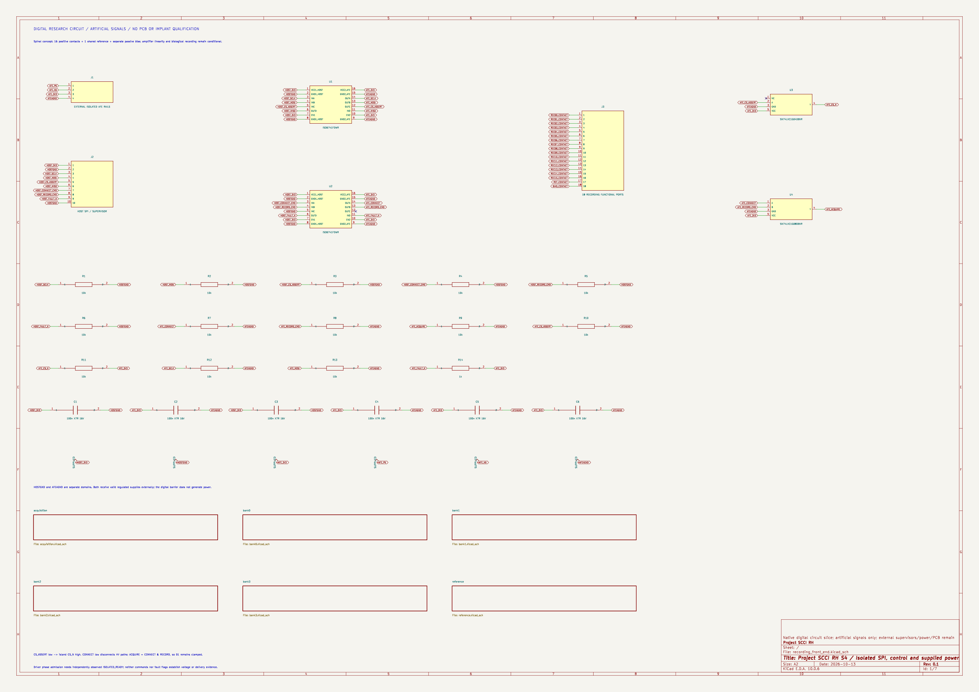
electronics/stage4/recording-front-end/review/page-1.png
