pratham-cloud-ctrl/Project-SCCI-RH/electronics/stage4/recording-front-end/review/page-3.png

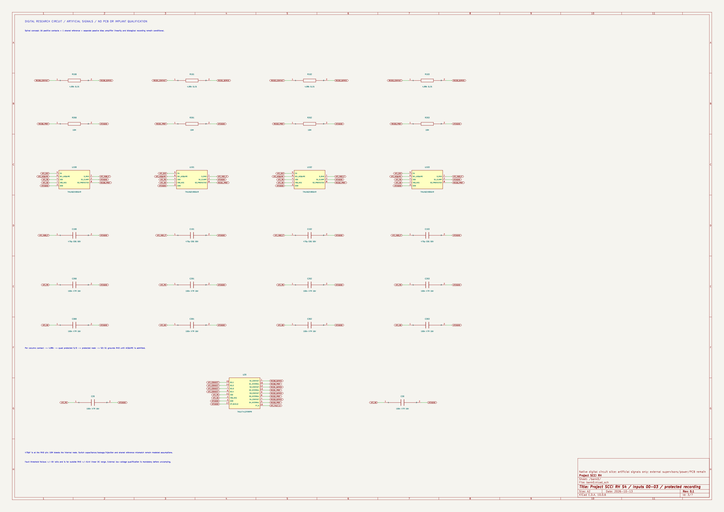
electronics/stage4/recording-front-end/review/page-3.png
