pratham-cloud-ctrl/Project-SCCI-RH/electronics/stage4/recording-study/input-network.png

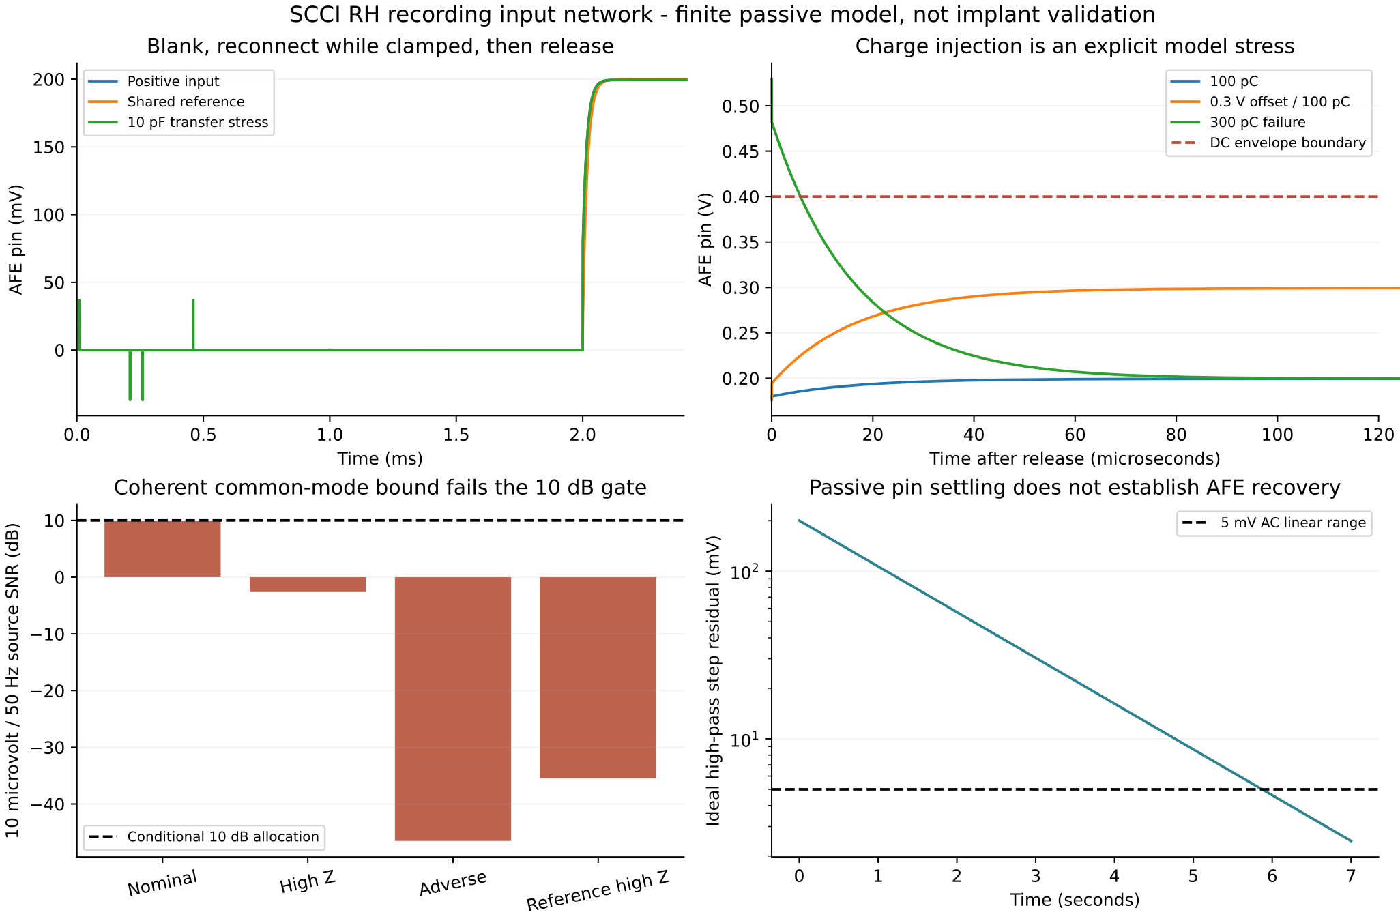
electronics/stage4/recording-study/input-network.png
