pratham-cloud-ctrl/Project-SCCI-RH/electronics/stage4/routing-study/router-parasitics.png

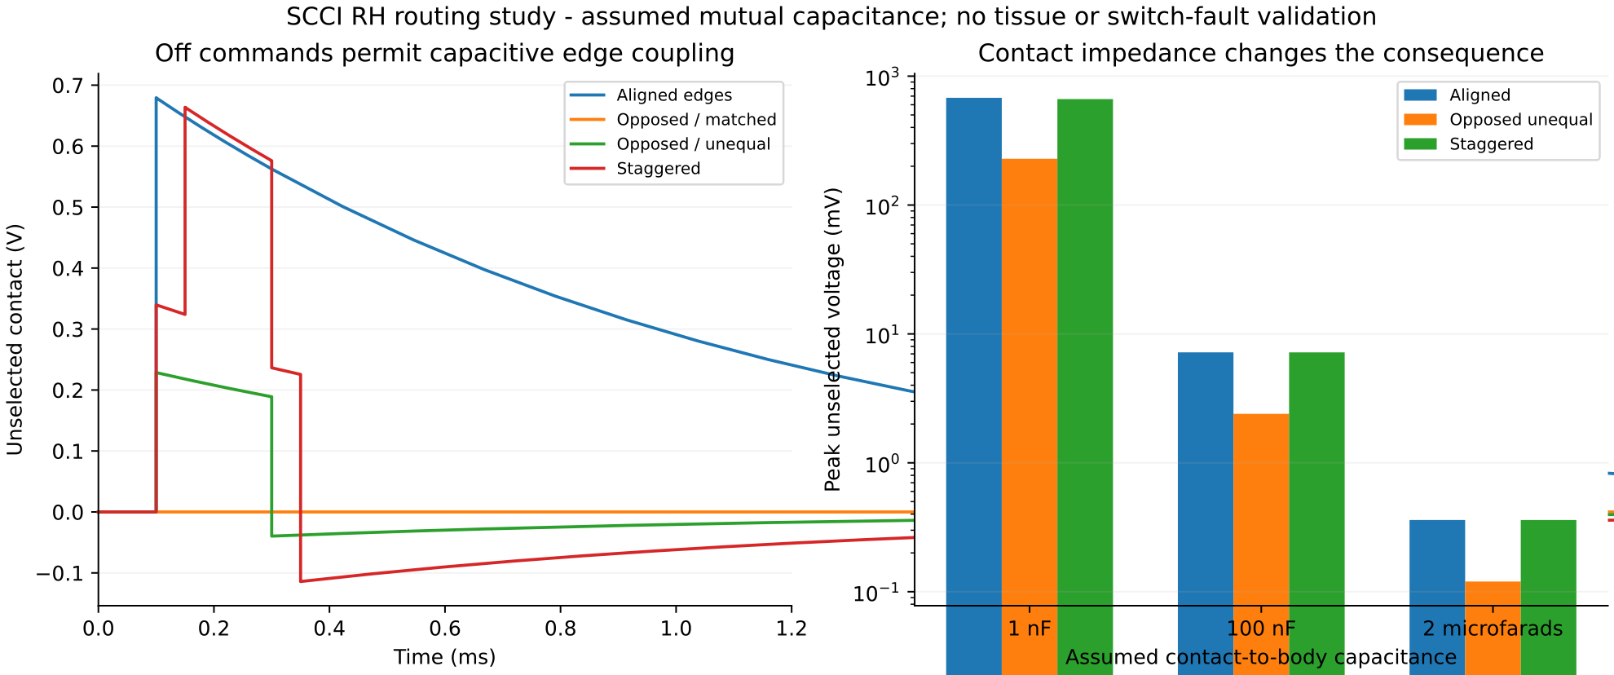
electronics/stage4/routing-study/router-parasitics.png
