pratham-cloud-ctrl/Project-SCCI-RH/electronics/stage4/supervision/review/page-1.png

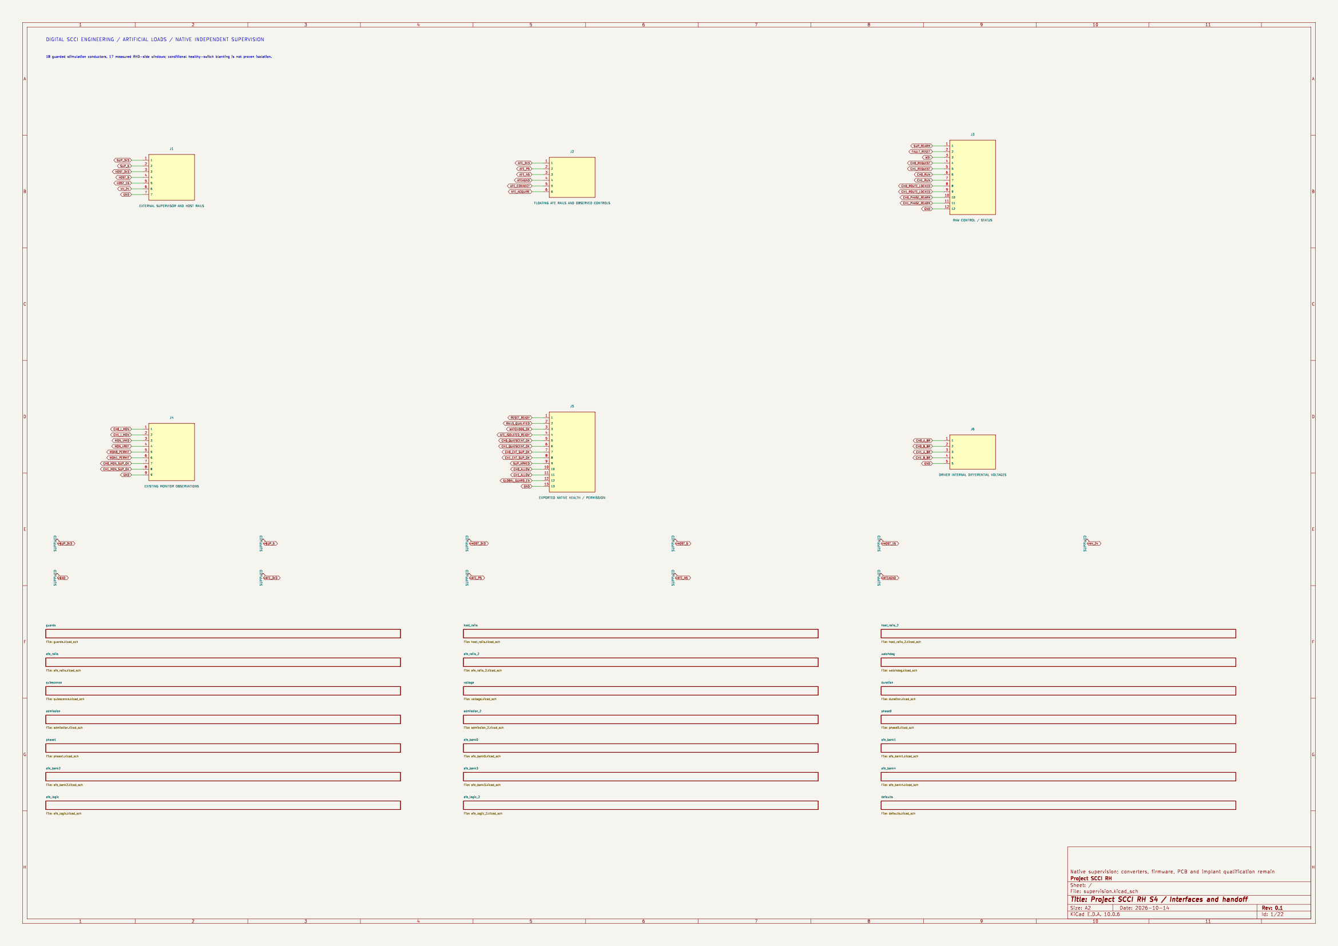
electronics/stage4/supervision/review/page-1.png
