pratham-cloud-ctrl/Project-SCCI-RH/electronics/stage4/supervision/review/page-19.png

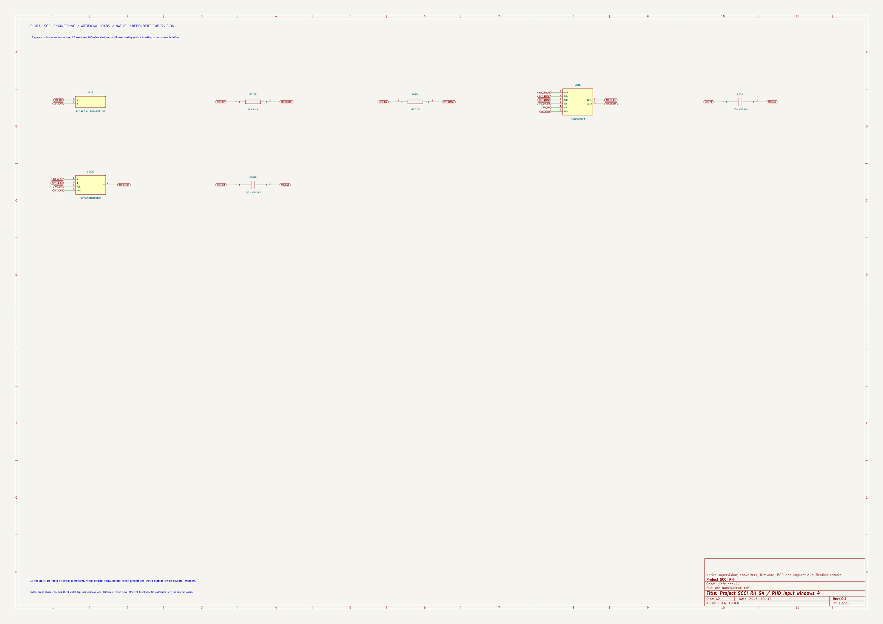
electronics/stage4/supervision/review/page-19.png
