pratham-cloud-ctrl/Project-SCCI-RH/figures/architecture.png

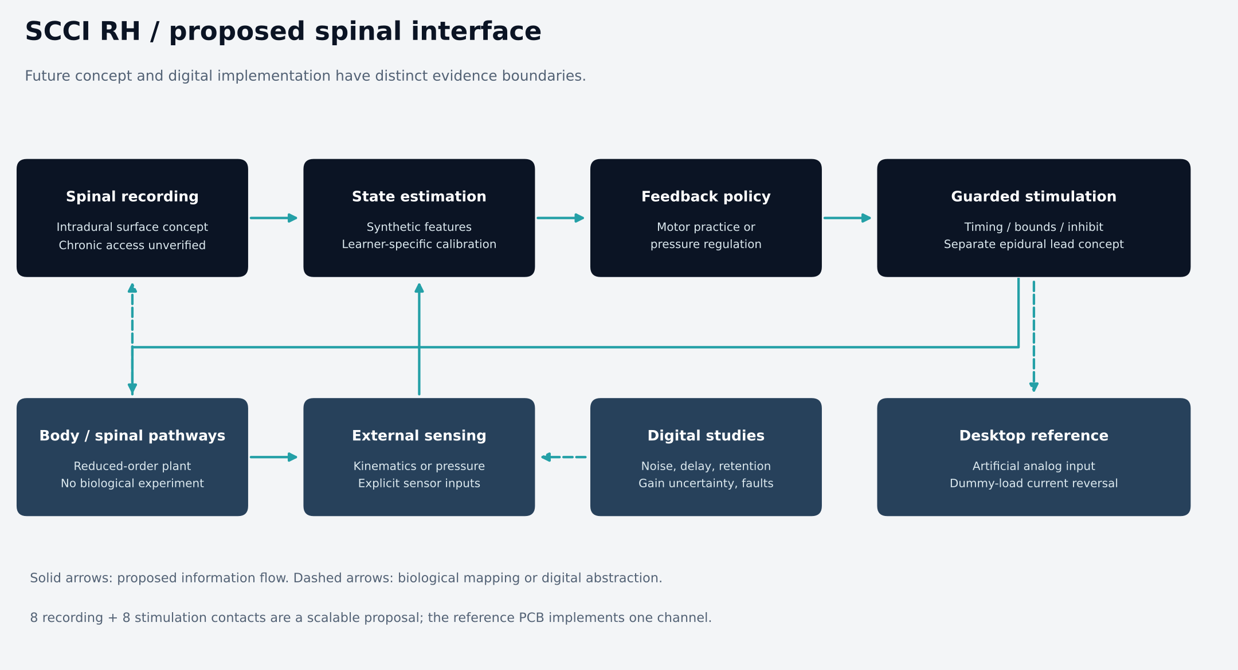
figures/architecture.png
