pratham-cloud-ctrl/Project-SCCI-RH/figures/pulse_protocol.png

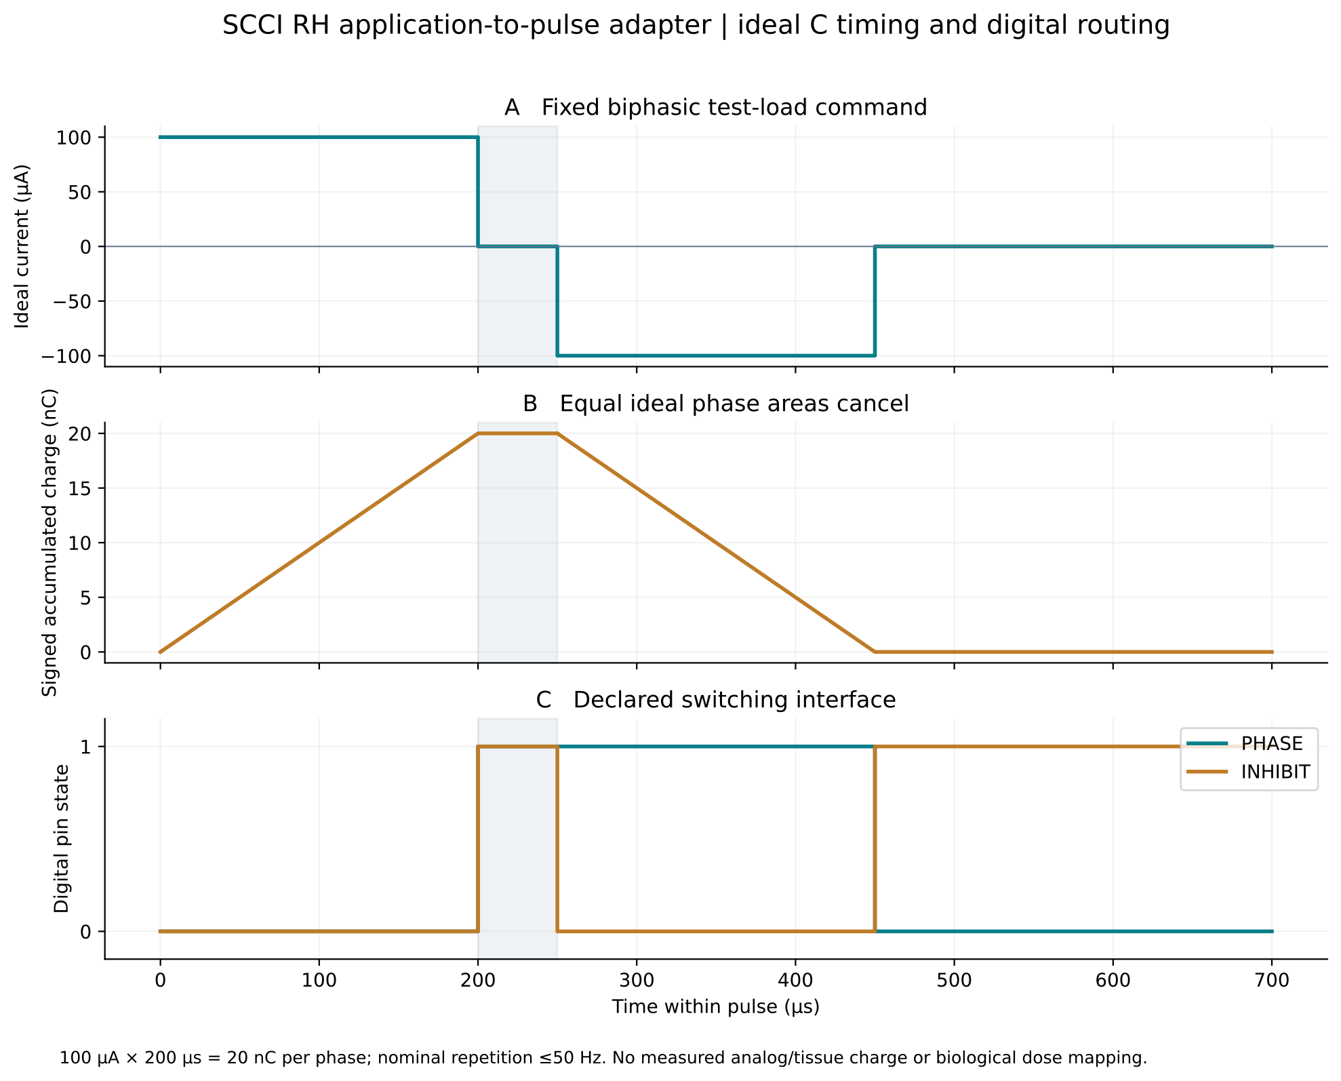
figures/pulse_protocol.png
