pratham-cloud-ctrl/Project-SCCI-RH/manuscript/stage6/figures/08_evidence.png

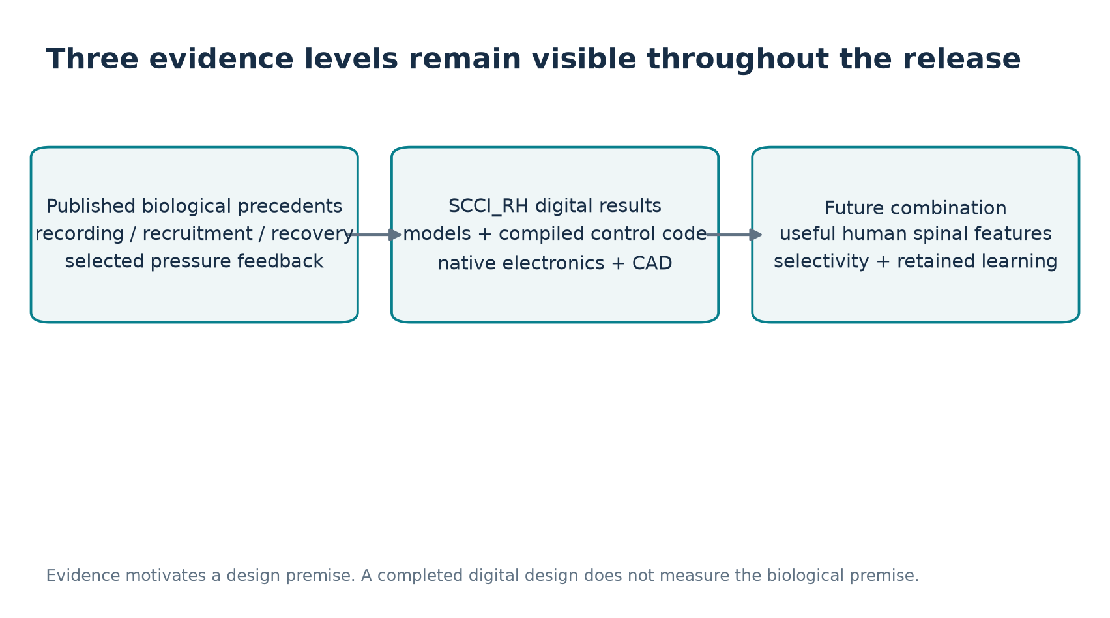
manuscript/stage6/figures/08_evidence.png
