pratham-cloud-ctrl/Project-SCCI-RH/media/scci_rh-exploded.png

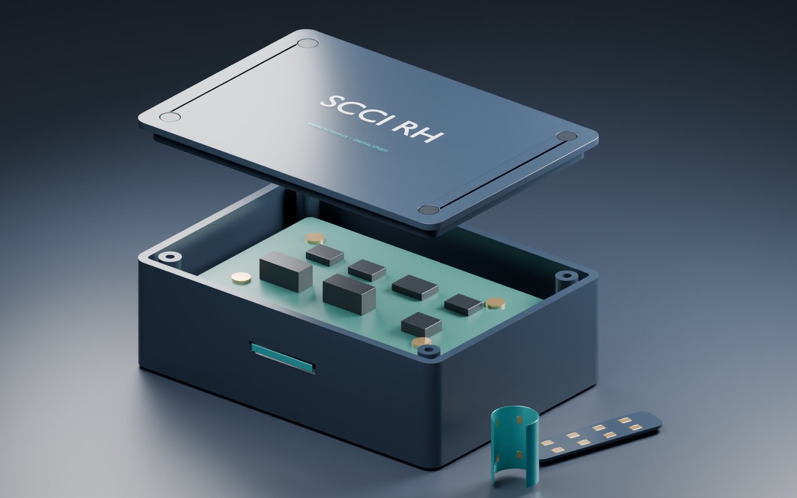
media/scci_rh-exploded.png
