pratham-cloud-ctrl/Project-SCCI-RH/media/scci_rh-hero.png

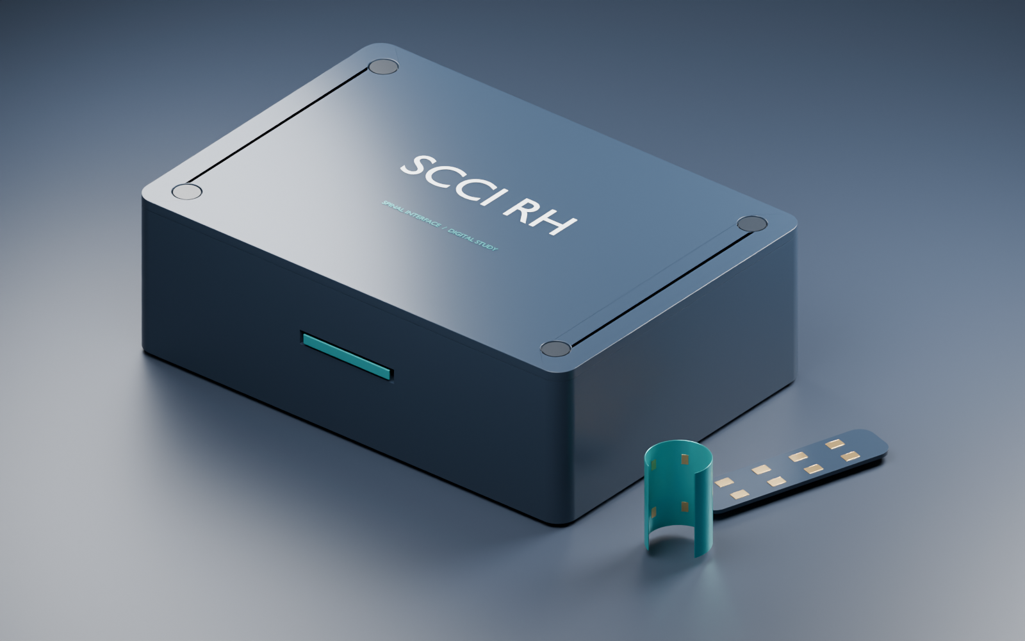
media/scci_rh-hero.png
