pratham-cloud-ctrl/Project-SCCI-RH/cad/stage5/MECHANICAL_BOM.csv

label | category | quantity | material_or_family | source_document | electrical_reference | qualification
Base | enclosure_panel | 1 | Nominal aluminium3mm | cad/stage5/reference/SCCI_RH_reference_assembly.FCStd |  | Nominal digital geometry; no physical qualification
SideLeft | enclosure_panel | 1 | Nominal aluminium3mm | cad/stage5/reference/SCCI_RH_reference_assembly.FCStd |  | Nominal digital geometry; no physical qualification
SideRight | enclosure_panel | 1 | Nominal aluminium3mm | cad/stage5/reference/SCCI_RH_reference_assembly.FCStd |  | Nominal digital geometry; no physical qualification
FrontBracket_0_0 | panel_bracket | 1 | Nominal aluminium bracket; threads omitted | cad/stage5/reference/SCCI_RH_reference_assembly.FCStd |  | Nominal digital geometry; no physical qualification
FrontScrew_0_0 | panel_screw | 1 | Nominal M3; threads omitted | cad/stage5/reference/SCCI_RH_reference_assembly.FCStd |  | Nominal digital geometry; no physical qualification
FrontBracket_0_1 | panel_bracket | 1 | Nominal aluminium bracket; threads omitted | cad/stage5/reference/SCCI_RH_reference_assembly.FCStd |  | Nominal digital geometry; no physical qualification
FrontScrew_0_1 | panel_screw | 1 | Nominal M3; threads omitted | cad/stage5/reference/SCCI_RH_reference_assembly.FCStd |  | Nominal digital geometry; no physical qualification
FrontBracket_1_0 | panel_bracket | 1 | Nominal aluminium bracket; threads omitted | cad/stage5/reference/SCCI_RH_reference_assembly.FCStd |  | Nominal digital geometry; no physical qualification
FrontScrew_1_0 | panel_screw | 1 | Nominal M3; threads omitted | cad/stage5/reference/SCCI_RH_reference_assembly.FCStd |  | Nominal digital geometry; no physical qualification
FrontBracket_1_1 | panel_bracket | 1 | Nominal aluminium bracket; threads omitted | cad/stage5/reference/SCCI_RH_reference_assembly.FCStd |  | Nominal digital geometry; no physical qualification
FrontScrew_1_1 | panel_screw | 1 | Nominal M3; threads omitted | cad/stage5/reference/SCCI_RH_reference_assembly.FCStd |  | Nominal digital geometry; no physical qualification
FrontPanel | enclosure_panel | 1 | Nominal removable aluminium3mm | cad/stage5/reference/SCCI_RH_reference_assembly.FCStd |  | Nominal digital geometry; no physical qualification
RearPanel | enclosure_panel | 1 | Nominal aluminium3mm; ventilation allocation | cad/stage5/reference/SCCI_RH_reference_assembly.FCStd |  | Nominal digital geometry; no physical qualification
Post_0_0 | frame_post | 1 | Nominal aluminium6mm square bar; threads omitted | cad/stage5/reference/SCCI_RH_reference_assembly.FCStd |  | Nominal digital geometry; no physical qualification
LidScrew_0_0 | lid_screw | 1 | Nominal M3; threads omitted | cad/stage5/reference/SCCI_RH_reference_assembly.FCStd |  | Nominal digital geometry; no physical qualification
Post_0_1 | frame_post | 1 | Nominal aluminium6mm square bar; threads omitted | cad/stage5/reference/SCCI_RH_reference_assembly.FCStd |  | Nominal digital geometry; no physical qualification
LidScrew_0_1 | lid_screw | 1 | Nominal M3; threads omitted | cad/stage5/reference/SCCI_RH_reference_assembly.FCStd |  | Nominal digital geometry; no physical qualification
Post_1_0 | frame_post | 1 | Nominal aluminium6mm square bar; threads omitted | cad/stage5/reference/SCCI_RH_reference_assembly.FCStd |  | Nominal digital geometry; no physical qualification
LidScrew_1_0 | lid_screw | 1 | Nominal M3; threads omitted | cad/stage5/reference/SCCI_RH_reference_assembly.FCStd |  | Nominal digital geometry; no physical qualification
Post_1_1 | frame_post | 1 | Nominal aluminium6mm square bar; threads omitted | cad/stage5/reference/SCCI_RH_reference_assembly.FCStd |  | Nominal digital geometry; no physical qualification
LidScrew_1_1 | lid_screw | 1 | Nominal M3; threads omitted | cad/stage5/reference/SCCI_RH_reference_assembly.FCStd |  | Nominal digital geometry; no physical qualification
Post_2_0 | frame_post | 1 | Nominal aluminium6mm square bar; threads omitted | cad/stage5/reference/SCCI_RH_reference_assembly.FCStd |  | Nominal digital geometry; no physical qualification
LidScrew_2_0 | lid_screw | 1 | Nominal M3; threads omitted | cad/stage5/reference/SCCI_RH_reference_assembly.FCStd |  | Nominal digital geometry; no physical qualification
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
LowerScrew_controller_carrier_H4 | board_screw | 1 | Nominal M3×6; thread detail omitted | cad/stage5/reference/SCCI_RH_reference_assembly.FCStd |  | Nominal digital geometry; no physical qualification
Tray_controller_carrier | tray | 1 | Nominal insulating sheet2mm with6mm rear stop | cad/stage5/reference/SCCI_RH_reference_assembly.FCStd |  | Nominal digital geometry; no physical qualification
Pull_controller_carrier | tray_pull | 1 | Nominal polymer grip | cad/stage5/reference/SCCI_RH_reference_assembly.FCStd |  | Nominal digital geometry; no physical qualification
Standoff_current_driver_H1 | board_standoff | 1 | Nominal insulating M3 female/female10mm; thread detail omitted | cad/stage5/reference/SCCI_RH_reference_assembly.FCStd |  | Nominal digital geometry; no physical qualification
UpperScrew_current_driver_H1 | board_screw | 1 | Nominal M3×6; thread detail omitted | cad/stage5/reference/SCCI_RH_reference_assembly.FCStd |  | Nominal digital geometry; no physical qualification
LowerScrew_current_driver_H1 | board_screw | 1 | Nominal M3×6; thread detail omitted | cad/stage5/reference/SCCI_RH_reference_assembly.FCStd |  | Nominal digital geometry; no physical qualification
Standoff_current_driver_H2 | board_standoff | 1 | Nominal insulating M3 female/female10mm; thread detail omitted | cad/stage5/reference/SCCI_RH_reference_assembly.FCStd |  | Nominal digital geometry; no physical qualification
UpperScrew_current_driver_H2 | board_screw | 1 | Nominal M3×6; thread detail omitted | cad/stage5/reference/SCCI_RH_reference_assembly.FCStd |  | Nominal digital geometry; no physical qualification
LowerScrew_current_driver_H2 | board_screw | 1 | Nominal M3×6; thread detail omitted | cad/stage5/reference/SCCI_RH_reference_assembly.FCStd |  | Nominal digital geometry; no physical qualification
Standoff_current_driver_H3 | board_standoff | 1 | Nominal insulating M3 female/female10mm; thread detail omitted | cad/stage5/reference/SCCI_RH_reference_assembly.FCStd |  | Nominal digital geometry; no physical qualification
UpperScrew_current_driver_H3 | board_screw | 1 | Nominal M3×6; thread detail omitted | cad/stage5/reference/SCCI_RH_reference_assembly.FCStd |  | Nominal digital geometry; no physical qualification
LowerScrew_current_driver_H3 | board_screw | 1 | Nominal M3×6; thread detail omitted | cad/stage5/reference/SCCI_RH_reference_assembly.FCStd |  | Nominal digital geometry; no physical qualification
Standoff_current_driver_H4 | board_standoff | 1 | Nominal insulating M3 female/female10mm; thread detail omitted | cad/stage5/reference/SCCI_RH_reference_assembly.FCStd |  | Nominal digital geometry; no physical qualification
UpperScrew_current_driver_H4 | board_screw | 1 | Nominal M3×6; thread detail omitted | cad/stage5/reference/SCCI_RH_reference_assembly.FCStd |  | Nominal digital geometry; no physical qualification
LowerScrew_current_driver_H4 | board_screw | 1 | Nominal M3×6; thread detail omitted | cad/stage5/reference/SCCI_RH_reference_assembly.FCStd |  | Nominal digital geometry; no physical qualification
Tray_current_driver | tray | 1 | Nominal insulating sheet2mm with6mm rear stop | cad/stage5/reference/SCCI_RH_reference_assembly.FCStd |  | Nominal digital geometry; no physical qualification
Pull_current_driver | tray_pull | 1 | Nominal polymer grip | cad/stage5/reference/SCCI_RH_reference_assembly.FCStd |  | Nominal digital geometry; no physical qualification
Standoff_monitoring_cell_H1 | board_standoff | 1 | Nominal insulating M3 female/female10mm; thread detail omitted | cad/stage5/reference/SCCI_RH_reference_assembly.FCStd |  | Nominal digital geometry; no physical qualification
UpperScrew_monitoring_cell_H1 | board_screw | 1 | Nominal M3×6; thread detail omitted | cad/stage5/reference/SCCI_RH_reference_assembly.FCStd |  | Nominal digital geometry; no physical qualification
LowerScrew_monitoring_cell_H1 | board_screw | 1 | Nominal M3×6; thread detail omitted | cad/stage5/reference/SCCI_RH_reference_assembly.FCStd |  | Nominal digital geometry; no physical qualification
Standoff_monitoring_cell_H2 | board_standoff | 1 | Nominal insulating M3 female/female10mm; thread detail omitted | cad/stage5/reference/SCCI_RH_reference_assembly.FCStd |  | Nominal digital geometry; no physical qualification
UpperScrew_monitoring_cell_H2 | board_screw | 1 | Nominal M3×6; thread detail omitted | cad/stage5/reference/SCCI_RH_reference_assembly.FCStd |  | Nominal digital geometry; no physical qualification
LowerScrew_monitoring_cell_H2 | board_screw | 1 | Nominal M3×6; thread detail omitted | cad/stage5/reference/SCCI_RH_reference_assembly.FCStd |  | Nominal digital geometry; no physical qualification
Standoff_monitoring_cell_H3 | board_standoff | 1 | Nominal insulating M3 female/female10mm; thread detail omitted | cad/stage5/reference/SCCI_RH_reference_assembly.FCStd |  | Nominal digital geometry; no physical qualification
UpperScrew_monitoring_cell_H3 | board_screw | 1 | Nominal M3×6; thread detail omitted | cad/stage5/reference/SCCI_RH_reference_assembly.FCStd |  | Nominal digital geometry; no physical qualification
LowerScrew_monitoring_cell_H3 | board_screw | 1 | Nominal M3×6; thread detail omitted | cad/stage5/reference/SCCI_RH_reference_assembly.FCStd |  | Nominal digital geometry; no physical qualification
Standoff_monitoring_cell_H4 | board_standoff | 1 | Nominal insulating M3 female/female10mm; thread detail omitted | cad/stage5/reference/SCCI_RH_reference_assembly.FCStd |  | Nominal digital geometry; no physical qualification
UpperScrew_monitoring_cell_H4 | board_screw | 1 | Nominal M3×6; thread detail omitted | cad/stage5/reference/SCCI_RH_reference_assembly.FCStd |  | Nominal digital geometry; no physical qualification
LowerScrew_monitoring_cell_H4 | board_screw | 1 | Nominal M3×6; thread detail omitted | cad/stage5/reference/SCCI_RH_reference_assembly.FCStd |  | Nominal digital geometry; no physical qualification
Tray_monitoring_cell | tray | 1 | Nominal insulating sheet2mm with6mm rear stop | cad/stage5/reference/SCCI_RH_reference_assembly.FCStd |  | Nominal digital geometry; no physical qualification
Pull_monitoring_cell | tray_pull | 1 | Nominal polymer grip | cad/stage5/reference/SCCI_RH_reference_assembly.FCStd |  | Nominal digital geometry; no physical qualification
Standoff_monitoring_transport_H1 | board_standoff | 1 | Nominal insulating M3 female/female10mm; thread detail omitted | cad/stage5/reference/SCCI_RH_reference_assembly.FCStd |  | Nominal digital geometry; no physical qualification
UpperScrew_monitoring_transport_H1 | board_screw | 1 | Nominal M3×6; thread detail omitted | cad/stage5/reference/SCCI_RH_reference_assembly.FCStd |  | Nominal digital geometry; no physical qualification
LowerScrew_monitoring_transport_H1 | board_screw | 1 | Nominal M3×6; thread detail omitted | cad/stage5/reference/SCCI_RH_reference_assembly.FCStd |  | Nominal digital geometry; no physical qualification
Standoff_monitoring_transport_H2 | board_standoff | 1 | Nominal insulating M3 female/female10mm; thread detail omitted | cad/stage5/reference/SCCI_RH_reference_assembly.FCStd |  | Nominal digital geometry; no physical qualification
UpperScrew_monitoring_transport_H2 | board_screw | 1 | Nominal M3×6; thread detail omitted | cad/stage5/reference/SCCI_RH_reference_assembly.FCStd |  | Nominal digital geometry; no physical qualification
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
Tray_recording_front_end | tray | 1 | Nominal insulating sheet2mm with6mm rear stop | cad/stage5/reference/SCCI_RH_reference_assembly.FCStd |  | Nominal digital geometry; no physical qualification
Pull_recording_front_end | tray_pull | 1 | Nominal polymer grip | cad/stage5/reference/SCCI_RH_reference_assembly.FCStd |  | Nominal digital geometry; no physical qualification
Standoff_supervision_H1 | board_standoff | 1 | Nominal insulating M3 female/female10mm; thread detail omitted | cad/stage5/reference/SCCI_RH_reference_assembly.FCStd |  | Nominal digital geometry; no physical qualification
UpperScrew_supervision_H1 | board_screw | 1 | Nominal M3×6; thread detail omitted | cad/stage5/reference/SCCI_RH_reference_assembly.FCStd |  | Nominal digital geometry; no physical qualification
LowerScrew_supervision_H1 | board_screw | 1 | Nominal M3×6; thread detail omitted | cad/stage5/reference/SCCI_RH_reference_assembly.FCStd |  | Nominal digital geometry; no physical qualification
Standoff_supervision_H2 | board_standoff | 1 | Nominal insulating M3 female/female10mm; thread detail omitted | cad/stage5/reference/SCCI_RH_reference_assembly.FCStd |  | Nominal digital geometry; no physical qualification
UpperScrew_supervision_H2 | board_screw | 1 | Nominal M3×6; thread detail omitted | cad/stage5/reference/SCCI_RH_reference_assembly.FCStd |  | Nominal digital geometry; no physical qualification
LowerScrew_supervision_H2 | board_screw | 1 | Nominal M3×6; thread detail omitted | cad/stage5/reference/SCCI_RH_reference_assembly.FCStd |  | Nominal digital geometry; no physical qualification
Standoff_supervision_H3 | board_standoff | 1 | Nominal insulating M3 female/female10mm; thread detail omitted | cad/stage5/reference/SCCI_RH_reference_assembly.FCStd |  | Nominal digital geometry; no physical qualification
UpperScrew_supervision_H3 | board_screw | 1 | Nominal M3×6; thread detail omitted | cad/stage5/reference/SCCI_RH_reference_assembly.FCStd |  | Nominal digital geometry; no physical qualification
LowerScrew_supervision_H3 | board_screw | 1 | Nominal M3×6; thread detail omitted | cad/stage5/reference/SCCI_RH_reference_assembly.FCStd |  | Nominal digital geometry; no physical qualification
Standoff_supervision_H4 | board_standoff | 1 | Nominal insulating M3 female/female10mm; thread detail omitted | cad/stage5/reference/SCCI_RH_reference_assembly.FCStd |  | Nominal digital geometry; no physical qualification
UpperScrew_supervision_H4 | board_screw | 1 | Nominal M3×6; thread detail omitted | cad/stage5/reference/SCCI_RH_reference_assembly.FCStd |  | Nominal digital geometry; no physical qualification
LowerScrew_supervision_H4 | board_screw | 1 | Nominal M3×6; thread detail omitted | cad/stage5/reference/SCCI_RH_reference_assembly.FCStd |  | Nominal digital geometry; no physical qualification
Tray_supervision | tray | 1 | Nominal insulating sheet2mm with6mm rear stop | cad/stage5/reference/SCCI_RH_reference_assembly.FCStd |  | Nominal digital geometry; no physical qualification
Pull_supervision | tray_pull | 1 | Nominal polymer grip | cad/stage5/reference/SCCI_RH_reference_assembly.FCStd |  | Nominal digital geometry; no physical qualification
PCB_contact_router | populated_board | 1 | Source board compound with actual fitted packages | cad/stage5/reference/SCCI_RH_reference_assembly.FCStd |  | Nominal digital geometry; no physical qualification
PCB_controller_carrier | populated_board | 1 | Source board compound with actual fitted packages | cad/stage5/reference/SCCI_RH_reference_assembly.FCStd |  | Nominal digital geometry; no physical qualification
PCB_current_driver | populated_board | 1 | Source board compound with actual fitted packages | cad/stage5/reference/SCCI_RH_reference_assembly.FCStd |  | Nominal digital geometry; no physical qualification
PCB_monitoring_cell | populated_board | 1 | Source board compound with actual fitted packages | cad/stage5/reference/SCCI_RH_reference_assembly.FCStd |  | Nominal digital geometry; no physical qualification
PCB_monitoring_transport | populated_board | 1 | Source board compound with actual fitted packages | cad/stage5/reference/SCCI_RH_reference_assembly.FCStd |  | Nominal digital geometry; no physical qualification
PCB_power | populated_board | 1 | Source board compound with actual fitted packages | cad/stage5/reference/SCCI_RH_reference_assembly.FCStd |  | Nominal digital geometry; no physical qualification
PCB_recording_front_end | populated_board | 1 | Source board compound with actual fitted packages | cad/stage5/reference/SCCI_RH_reference_assembly.FCStd |  | Nominal digital geometry; no physical qualification
PCB_supervision | populated_board | 1 | Source board compound with actual fitted packages | cad/stage5/reference/SCCI_RH_reference_assembly.FCStd |  | Nominal digital geometry; no physical qualification
Mate_contact_router_J40001 | internal_mate | 1 | Harwin M20-106; final plating/contact/gauge and retention unqualified | cad/stage5/harness/SCCI_RH_mating_interfaces.FCStd | contact-router:J40001 | Nominal envelope; material, ratings, retention and process unqualified
Mate_contact_router_J40002 | internal_mate | 1 | Harwin M20-106; final plating/contact/gauge and retention unqualified | cad/stage5/harness/SCCI_RH_mating_interfaces.FCStd | contact-router:J40002 | Nominal envelope; material, ratings, retention and process unqualified
Mate_contact_router_J40003 | internal_mate | 1 | Harwin M20-106; final plating/contact/gauge and retention unqualified | cad/stage5/harness/SCCI_RH_mating_interfaces.FCStd | contact-router:J40003 | Nominal envelope; material, ratings, retention and process unqualified
Mate_contact_router_J40004 | internal_mate | 1 | Harwin M20-106; final plating/contact/gauge and retention unqualified | cad/stage5/harness/SCCI_RH_mating_interfaces.FCStd | contact-router:J40004 | Nominal envelope; material, ratings, retention and process unqualified
Mate_contact_router_J40005 | internal_mate | 1 | Harwin M20-106; final plating/contact/gauge and retention unqualified | cad/stage5/harness/SCCI_RH_mating_interfaces.FCStd | contact-router:J40005 | Nominal envelope; material, ratings, retention and process unqualified
Mate_contact_router_J40006 | internal_mate | 1 | Harwin M20-106; final plating/contact/gauge and retention unqualified | cad/stage5/harness/SCCI_RH_mating_interfaces.FCStd | contact-router:J40006 | Nominal envelope; material, ratings, retention and process unqualified
Mate_contact_router_J40007 | internal_mate | 1 | Harwin M20-106; final plating/contact/gauge and retention unqualified | cad/stage5/harness/SCCI_RH_mating_interfaces.FCStd | contact-router:J40007 | Nominal envelope; material, ratings, retention and process unqualified
Mate_contact_router_J40100 | internal_mate | 1 | Harwin M20-106; final plating/contact/gauge and retention unqualified | cad/stage5/harness/SCCI_RH_mating_interfaces.FCStd | contact-router:J40100 | Nominal envelope; material, ratings, retention and process unqualified
Mate_contact_router_J40200 | internal_mate | 1 | Harwin M20-106; final plating/contact/gauge and retention unqualified | cad/stage5/harness/SCCI_RH_mating_interfaces.FCStd | contact-router:J40200 | Nominal envelope; material, ratings, retention and process unqualified
Mate_controller_carrier_J80001 | internal_mate | 1 | Harwin M20-106; final plating/contact/gauge and retention unqualified | cad/stage5/harness/SCCI_RH_mating_interfaces.FCStd | controller-carrier:J80001 | Nominal envelope; material, ratings, retention and process unqualified
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
Mate_supervision_J50613 | internal_mate | 1 | Harwin M20-106; final plating/contact/gauge and retention unqualified | cad/stage5/harness/SCCI_RH_mating_interfaces.FCStd | supervision:J50613 | Nominal envelope; material, ratings, retention and process unqualified
Mate_supervision_J50614 | internal_mate | 1 | Harwin M20-106; final plating/contact/gauge and retention unqualified | cad/stage5/harness/SCCI_RH_mating_interfaces.FCStd | supervision:J50614 | Nominal envelope; material, ratings, retention and process unqualified
Mate_supervision_J50615 | internal_mate | 1 | Harwin M20-106; final plating/contact/gauge and retention unqualified | cad/stage5/harness/SCCI_RH_mating_interfaces.FCStd | supervision:J50615 | Nominal envelope; material, ratings, retention and process unqualified
Mate_supervision_J50616 | internal_mate | 1 | Harwin M20-106; final plating/contact/gauge and retention unqualified | cad/stage5/harness/SCCI_RH_mating_interfaces.FCStd | supervision:J50616 | Nominal envelope; material, ratings, retention and process unqualified
Mate_supervision_J59901 | internal_mate | 1 | Harwin M20-106; final plating/contact/gauge and retention unqualified | cad/stage5/harness/SCCI_RH_mating_interfaces.FCStd | supervision:J59901 | Nominal envelope; material, ratings, retention and process unqualified
Grommet_ArtificialLoad_58 | passive_cable_interface | 1 | Nominal elastomer grommet allocation | cad/stage5/harness/SCCI_RH_mating_interfaces.FCStd |  | Nominal envelope; material, ratings, retention and process unqualified
Grommet_ArtificialLoad_96 | passive_cable_interface | 1 | Nominal elastomer grommet allocation | cad/stage5/harness/SCCI_RH_mating_interfaces.FCStd |  | Nominal envelope; material, ratings, retention and process unqualified
RearInsert_ArtificialLoad | passive_cable_interface | 1 | Nominal insulating rear insert allocation | cad/stage5/harness/SCCI_RH_mating_interfaces.FCStd |  | Nominal envelope; material, ratings, retention and process unqualified
Grommet_CompanionPowerDebug_410 | passive_cable_interface | 1 | Nominal elastomer grommet allocation | cad/stage5/harness/SCCI_RH_mating_interfaces.FCStd |  | Nominal envelope; material, ratings, retention and process unqualified
Grommet_CompanionPowerDebug_440 | passive_cable_interface | 1 | Nominal elastomer grommet allocation | cad/stage5/harness/SCCI_RH_mating_interfaces.FCStd |  | Nominal envelope; material, ratings, retention and process unqualified
Grommet_CompanionPowerDebug_470 | passive_cable_interface | 1 | Nominal elastomer grommet allocation | cad/stage5/harness/SCCI_RH_mating_interfaces.FCStd |  | Nominal envelope; material, ratings, retention and process unqualified
RearInsert_CompanionPowerDebug | passive_cable_interface | 1 | Nominal insulating rear insert allocation | cad/stage5/harness/SCCI_RH_mating_interfaces.FCStd |  | Nominal envelope; material, ratings, retention and process unqualified
