pratham-cloud-ctrl/Project-SCCI-RH/electronics/stage4/monitoring-transport/bom.csv

reference | value | footprint | sheet | description | primary_source
J1 | HOST RAILS / RAW ADC | scci_rh_transport:PinHeader_1x03_P2.54mm_Vertical | root | GeneratedpowerpackageHOST5/HOST3V3andhostreturn; noneconnectAFEAGND
J2 | EXISTING ANALOG TAPS | scci_rh_transport:PinHeader_1x08_P2.54mm_Vertical | root | Currentfrommonitor,scaledpairfromsupervision,4.096/2.048Vreferenceandpackbus; nomodificationofsourcecircuits
J3 | DEDICATED RAW ADC BUS | scci_rh_transport:PinHeader_1x06_P2.54mm_Vertical | root | DedicatedhostSPIbusallocation,independentfromRHDandADS8866endpointbuses; SoCpinmap/firmwareisnextpackage
J4 | TWO EXISTING CHARGE ADCs | scci_rh_transport:PinHeader_1x08_P2.54mm_Vertical | root_2 | PassivehandofftoexistingADS8866monitorJ2; nocopies/newchargeADC; eachCNVaperture/resultidentityretained
J5 | CHARGE CONTROL HANDOFF | scci_rh_transport:PinHeader_1x05_P2.54mm_Vertical | root_2 | Separateintegrator/resetandmonitorrearmhandoff,neverderivedfromtransportvalidity
J6 | READ-ONLY NATIVE HEALTH | scci_rh_transport:PinHeader_1x10_P2.54mm_Vertical | root_2 | HostGPIOobservationofexistingnativehealth; ADCandcompaniondonotgrantstimulationauthority
U1 | ADS8688IDBTR | scci_rh_transport:TSSOP-38_4.4x9.7mm_P0.5mm | adc | 8channel16bit500kspsaggregateADC,internal4.096reference,programmableunipolar0..5.12V; internalPGA/filterisnotantialiasedproof | https://www.ti.com/lit/ds/symlink/ads8688.pdf
R1 | 33R | scci_rh_transport:R_0805_2012Metric | adc | SeriesdampingatMCUout; finalplacementinPCB
R2 | 33R | scci_rh_transport:R_0805_2012Metric | adc | Clockseriesdamping; physicalsignalqualityrequiresPCB
R3 | 100k | scci_rh_transport:R_0805_2012Metric | adc | InactiveCSdefault; logicvaliditystilldependsrails
R4 | 100k | scci_rh_transport:R_0805_2012Metric | adc | Reset/powerdowndefaultLOWuntilhostexplicitconfiguration
R5 | 100k | scci_rh_transport:R_0805_2012Metric | adc | Definedidleclockwhilehostunpowered
R6 | 100k | scci_rh_transport:R_0805_2012Metric | adc | Definedserialinputwhilehostunpowered
C1 | 22u X7R 10V | scci_rh_transport:C_1206_3216Metric | reference | Manufacturerreferenceandlocalrailbypass; placement/effectivecapacitancequalificationremainsPCB
C2 | 22u X7R 10V | scci_rh_transport:C_1206_3216Metric | reference | Manufacturerreferenceandlocalrailbypass; placement/effectivecapacitancequalificationremainsPCB
C3 | 1u X7R 10V | scci_rh_transport:C_1206_3216Metric | reference | Manufacturerreferenceandlocalrailbypass; placement/effectivecapacitancequalificationremainsPCB
C4 | 10u X7R 10V | scci_rh_transport:C_1206_3216Metric | reference | Manufacturerreferenceandlocalrailbypass; placement/effectivecapacitancequalificationremainsPCB
C5 | 1u X7R 10V | scci_rh_transport:C_1206_3216Metric | reference | Manufacturerreferenceandlocalrailbypass; placement/effectivecapacitancequalificationremainsPCB
C6 | 10u X7R 10V | scci_rh_transport:C_1206_3216Metric | reference | Manufacturerreferenceandlocalrailbypass; placement/effectivecapacitancequalificationremainsPCB
C7 | 1u X7R 10V | scci_rh_transport:C_1206_3216Metric | reference | Manufacturerreferenceandlocalrailbypass; placement/effectivecapacitancequalificationremainsPCB
C8 | 10u X7R 10V | scci_rh_transport:C_1206_3216Metric | reference | Manufacturerreferenceandlocalrailbypass; placement/effectivecapacitancequalificationremainsPCB
C9 | 100n X7R 10V | scci_rh_transport:C_1206_3216Metric | reference | Manufacturerreferenceandlocalrailbypass; placement/effectivecapacitancequalificationremainsPCB
R100 | 100R 0.1% | scci_rh_transport:R_0805_2012Metric | inputs | raw current 0; finite1MohmADCinputtointernal2.5Vbiasloads100ohmsourcefilter
C100 | 1n C0G 5% | scci_rh_transport:C_1206_3216Metric | inputs | 100ohm/1nFexternalpole1.59MHz; notNyquistantialiasfilterorfullmeasurementsettlingproof
R101 | 100R 0.1% | scci_rh_transport:R_0805_2012Metric | inputs | raw current 1; finite1MohmADCinputtointernal2.5Vbiasloads100ohmsourcefilter
C101 | 1n C0G 5% | scci_rh_transport:C_1206_3216Metric | inputs | 100ohm/1nFexternalpole1.59MHz; notNyquistantialiasfilterorfullmeasurementsettlingproof
R102 | 100R 0.1% | scci_rh_transport:R_0805_2012Metric | inputs | existing scaled differential voltage 0; finite1MohmADCinputtointernal2.5Vbiasloads100ohmsourcefilter
C102 | 1n C0G 5% | scci_rh_transport:C_1206_3216Metric | inputs | 100ohm/1nFexternalpole1.59MHz; notNyquistantialiasfilterorfullmeasurementsettlingproof
R103 | 100R 0.1% | scci_rh_transport:R_0805_2012Metric | inputs | existing scaled differential voltage 1; finite1MohmADCinputtointernal2.5Vbiasloads100ohmsourcefilter
C103 | 1n C0G 5% | scci_rh_transport:C_1206_3216Metric | inputs | 100ohm/1nFexternalpole1.59MHz; notNyquistantialiasfilterorfullmeasurementsettlingproof
R104 | 100R 0.1% | scci_rh_transport:R_0805_2012Metric | inputs | monitor reference health; finite1MohmADCinputtointernal2.5Vbiasloads100ohmsourcefilter
C104 | 1n C0G 5% | scci_rh_transport:C_1206_3216Metric | inputs | 100ohm/1nFexternalpole1.59MHz; notNyquistantialiasfilterorfullmeasurementsettlingproof
R105 | 100R 0.1% | scci_rh_transport:R_0805_2012Metric | inputs | monitor midpoint health; finite1MohmADCinputtointernal2.5Vbiasloads100ohmsourcefilter
C105 | 1n C0G 5% | scci_rh_transport:C_1206_3216Metric | inputs | 100ohm/1nFexternalpole1.59MHz; notNyquistantialiasfilterorfullmeasurementsettlingproof
R106 | 100R 0.1% | scci_rh_transport:R_0805_2012Metric | inputs | divided pack-bus voltage; finite1MohmADCinputtointernal2.5Vbiasloads100ohmsourcefilter
C106 | 1n C0G 5% | scci_rh_transport:C_1206_3216Metric | inputs | 100ohm/1nFexternalpole1.59MHz; notNyquistantialiasfilterorfullmeasurementsettlingproof
R107 | 100R 0.1% | scci_rh_transport:R_0805_2012Metric | inputs | divided host5 voltage; finite1MohmADCinputtointernal2.5Vbiasloads100ohmsourcefilter
C107 | 1n C0G 5% | scci_rh_transport:C_1206_3216Metric | inputs | 100ohm/1nFexternalpole1.59MHz; notNyquistantialiasfilterorfullmeasurementsettlingproof
R120 | 4.99k 0.1% | scci_rh_transport:R_0805_2012Metric | health | Nominalpackdivideby3; ADC1Mohmtointernal2.5Vbiasandfilterareincludedinfinitegaincalculation
R121 | 2.49k 0.1% | scci_rh_transport:R_0805_2012Metric | health | Packdividertoreturn; noextrapolatedbatterySOCclaim
R122 | 2.4k 0.1% | scci_rh_transport:R_0805_2012Metric | health | Nominalhost5divideby2.2; ADC1Mohmtointernal2.5Vbiasandfilterareincluded
R123 | 2k 0.1% | scci_rh_transport:R_0805_2012Metric | health | Host5dividertoreturn; independenthardwarewindowsremainseparate
U20 | ISO6721BDR | scci_rh_transport:SOIC-8_3.9x4.9mm_P1.27mm | companion | 50Mbpsstandardmappingbidirectionisolator; nonFdefaultHIGHmatchesUARTidle. Functionalgalvanicisolationisnotbody/RF/medicalqualification | https://www.ti.com/lit/ds/symlink/iso6721.pdf
J7 | HOST PROCESSED UART | scci_rh_transport:PinHeader_1x04_P2.54mm_Vertical | companion | 1Mbaud8N1hostcompanionbus; packetage/CRC/identityvalidityhandledbyseparatestudy,targetfirmwarenext
J8 | EXTERNAL COMPANION UART | scci_rh_transport:PinHeader_1x04_P2.54mm_Vertical | companion | Externallypowered3.3VUARThost/companionfixture; pressureestimator/featureprocessoroutsidepackage,notspinalorbodyradiosignal
R20 | 33R | scci_rh_transport:R_0805_2012Metric | companion | FiniteUARTlinedamping; specifiedshortdigitalfixture,novalidatedcableEMI/ESDtest
R21 | 33R | scci_rh_transport:R_0805_2012Metric | companion | FiniteUARTlinedamping; specifiedshortdigitalfixture,novalidatedcableEMI/ESDtest
R22 | 33R | scci_rh_transport:R_0805_2012Metric | companion | FiniteUARTlinedamping; specifiedshortdigitalfixture,novalidatedcableEMI/ESDtest
R23 | 33R | scci_rh_transport:R_0805_2012Metric | companion | FiniteUARTlinedamping; specifiedshortdigitalfixture,novalidatedcableEMI/ESDtest
R24 | 10k | scci_rh_transport:R_0805_2012Metric | companion | UARTidleHIGHinputdefaultinhostdomain
R25 | 10k | scci_rh_transport:R_0805_2012Metric | companion | UARTidleHIGHinputdefaultincompaniondomain
C20 | 100n X7R 10V | scci_rh_transport:C_1206_3216Metric | companion | Isolatorhostlocalbypass
C21 | 100n X7R 10V | scci_rh_transport:C_1206_3216Metric | companion | Isolatorcompanionlocalbypass; neverbridgesgrounddomains
C22 | 1u X7R 10V | scci_rh_transport:C_1206_3216Metric | companion | HostUARTrailbulk
C23 | 1u X7R 10V | scci_rh_transport:C_1206_3216Metric | companion | CompanionUARTrailbulk
J20 | HOST CHARGE ADC BUS | scci_rh_transport:PinHeader_1x12_P2.54mm_Vertical | handoff | ActualpassivehandofftoJ4/J5; SoCportpinallocationwillbeimplementednext
J21 | HOST HEALTH INPUTS | scci_rh_transport:PinHeader_1x10_P2.54mm_Vertical | handoff | SamehealthobservationsasJ6, passivewiresonly; noADC/firmwareauthoritybypass
R30 | 330R | scci_rh_transport:R_0805_2012Metric | handoff | Source0tri-stateDOUTjoin; selectonlyoneADC; 8MHzsharedbusloadingrequiresPCBqualification
R31 | 330R | scci_rh_transport:R_0805_2012Metric | handoff | Source1tri-stateDOUTjoin; resistorsdonotmakeconcurrentCSorunpoweredADCvalid
J22 | HOST SHARED ENDPOINT SPI | scci_rh_transport:PinHeader_1x07_P2.54mm_Vertical | handoff | Explicitshared8MHzendpointMISO; J20retainsseparateDOUTdiagnostictaps; chipselectsneveroverlapinhealthycontract
