pratham-cloud-ctrl/Project-SCCI-RH/electronics/stage4/power/bom.csv

reference | value | footprint | sheet | description | primary_source
J1 | AT31004 PROTECTED 2S PACK / 6.4 TO 8.4V | scci_rh_power:PinHeader_1x02_P2.54mm_Vertical | root | External Tenergy protected7.4V2.6Ahpack; offboardTLP2000charger; use keyed power wiring in finalPCB
F1 | 2A FUSE 1206 | scci_rh_power:Fuse_1206_3216Metric | input | 2A seriesinputfuse; exactfuseI2t/inrushcoordination remainsPCB/fixturequalification
D1 | SS34-E3/57T | scci_rh_power:D_SMC | input | Series reverse polarity diode; forwarddropandheatinbudget, notidealreverseprotection | https://www.vishay.com/docs/88751/ss32.pdf
SW1 | MASTER SPST / OFFBOARD | scci_rh_power:PinHeader_1x02_P2.54mm_Vertical | input | External master switch at2pinheader disconnects input; residualrailcapacitors remainenergized
C1 | 100u 16V LOW ESR | scci_rh_power:C_1206_3216Metric | input | Inputbulk capacitor; effective80uFandESR0.1ohm are modelingassumptions, inrushnotunconditional
C2 | 100n X7R 25V | scci_rh_power:C_1206_3216Metric | input | Localhighfrequencyinputbypass
J2 | POWER REQUEST / STATUS | scci_rh_power:PinHeader_1x12_P2.54mm_Vertical | root | PWR_REQUESTbenchjumpertoSUP3.3; activeenablehasnoARMfeedbackloop. PGdiagnosticsarenotninerailextsupervision
J3 | HOST AND SUPERVISOR RAILS | scci_rh_power:PinHeader_1x07_P2.54mm_Vertical | root | SameorderedrailinterfaceassupervisionJ1; noinputpinpretendsgeneratedpower
J4 | FLOATING RECORDING RAILS | scci_rh_power:PinHeader_1x04_P2.54mm_Vertical | root | Separatefloatingdomain; noDCgroundtie, noUSBchargingconnectionorhumanconnection
J6 | EXISTING MONITOR REFERENCES | scci_rh_power:PinHeader_1x03_P2.54mm_Vertical | root | ActualexistingREF3440/OPA391voltagetaps; windowsaffectinterlock,neverconverterenable
J5 | CONVERTER TEST POINTS | scci_rh_power:PinHeader_1x05_P2.54mm_Vertical | root | Testportsdonotbridgegrounds; useappropriateisolatedtestequipmentinanyfuturebenchwork
U100 | TPS62160DGKR | scci_rh_power:VSSOP-8_3x3mm_P0.65mm | sup3 | 1A DCS-Control buck; PG is diagnostic and hi-Z while off, not independent rail qualification | https://www.ti.com/lit/ds/symlink/tps62160.pdf
L100 | 2.2uH SRP5030T-2R2M | scci_rh_power:L_Bourns_SRP5030T | sup3 | Buck energy-storage inductor; current and effective capacitance bounds require PCB characterization
C1000 | 10u X7R 25V | scci_rh_power:C_1206_3216Metric | sup3 | Input ceramic; effective >=2.2uF under bias assumption
C1001 | 22u X7R 16V | scci_rh_power:C_1206_3216Metric | sup3 | Output ceramic; effective >=10uF under bias assumption
R1000 | 31250R 0.1% | scci_rh_power:R_0805_2012Metric | sup3 | 0.8V feedback upper; assembly tolerance included in study
R1001 | 10000R 0.1% | scci_rh_power:R_0805_2012Metric | sup3 | Feedback bottom resistor
R1002 | 100k | scci_rh_power:R_0805_2012Metric | sup3 | PG output pullup to independent supervisor rail
R1003 | 47k | scci_rh_power:R_0805_2012Metric | sup3 | Finite discharge bleed; not a guaranteed shutdown time
U101 | TPS62160DGKR | scci_rh_power:VSSOP-8_3x3mm_P0.65mm | sup5 | 1A DCS-Control buck; PG is diagnostic and hi-Z while off, not independent rail qualification | https://www.ti.com/lit/ds/symlink/tps62160.pdf
L101 | 2.2uH SRP5030T-2R2M | scci_rh_power:L_Bourns_SRP5030T | sup5 | Buck energy-storage inductor; current and effective capacitance bounds require PCB characterization
C1010 | 10u X7R 25V | scci_rh_power:C_1206_3216Metric | sup5 | Input ceramic; effective >=2.2uF under bias assumption
C1011 | 22u X7R 16V | scci_rh_power:C_1206_3216Metric | sup5 | Output ceramic; effective >=10uF under bias assumption
R1010 | 52500R 0.1% | scci_rh_power:R_0805_2012Metric | sup5 | 0.8V feedback upper; assembly tolerance included in study
R1011 | 10000R 0.1% | scci_rh_power:R_0805_2012Metric | sup5 | Feedback bottom resistor
R1012 | 100k | scci_rh_power:R_0805_2012Metric | sup5 | PG output pullup to independent supervisor rail
R1013 | 47k | scci_rh_power:R_0805_2012Metric | sup5 | Finite discharge bleed; not a guaranteed shutdown time
U102 | TPS62160DGKR | scci_rh_power:VSSOP-8_3x3mm_P0.65mm | host3 | 1A DCS-Control buck; PG is diagnostic and hi-Z while off, not independent rail qualification | https://www.ti.com/lit/ds/symlink/tps62160.pdf
L102 | 2.2uH SRP5030T-2R2M | scci_rh_power:L_Bourns_SRP5030T | host3 | Buck energy-storage inductor; current and effective capacitance bounds require PCB characterization
C1020 | 10u X7R 25V | scci_rh_power:C_1206_3216Metric | host3 | Input ceramic; effective >=2.2uF under bias assumption
C1021 | 22u X7R 16V | scci_rh_power:C_1206_3216Metric | host3 | Output ceramic; effective >=10uF under bias assumption
R1020 | 31250R 0.1% | scci_rh_power:R_0805_2012Metric | host3 | 0.8V feedback upper; assembly tolerance included in study
R1021 | 10000R 0.1% | scci_rh_power:R_0805_2012Metric | host3 | Feedback bottom resistor
R1022 | 100k | scci_rh_power:R_0805_2012Metric | host3 | PG output pullup to independent supervisor rail
R1023 | 47k | scci_rh_power:R_0805_2012Metric | host3 | Finite discharge bleed; not a guaranteed shutdown time
U110 | TPS62130ARGTR | scci_rh_power:VQFN-16-1EP_3x3mm_P0.5mm_EP1.68x1.68mm | host5 | 3A DCS-Controlbuck; SS3.3nFnominal; physicalphase/enablesauditedagainstTI | https://www.ti.com/lit/ds/symlink/tps62130a.pdf
L110 | 2.2uH SRP5030T-2R2M | scci_rh_power:L_Bourns_SRP5030T | host5 | Buckinductor saturation/DCRandtransientlimitsinprimaryreview
C1100 | 10u X7R 25V | scci_rh_power:C_1206_3216Metric | host5 | HOST5input/outputorsoftstartcapacitor
C1101 | 22u X7R 16V | scci_rh_power:C_1206_3216Metric | host5 | HOST5input/outputorsoftstartcapacitor
C1102 | 100n X7R 25V | scci_rh_power:C_1206_3216Metric | host5 | HOST5input/outputorsoftstartcapacitor
C1103 | 3.3n C0G 50V | scci_rh_power:C_1206_3216Metric | host5 | HOST5input/outputorsoftstartcapacitor
R1100 | 52.5k 0.1% | scci_rh_power:R_0805_2012Metric | host5 | 0.8Vupperfeedbackresistor
R1101 | 10k 0.1% | scci_rh_power:R_0805_2012Metric | host5 | Feedbackbottom
R1102 | 100k | scci_rh_power:R_0805_2012Metric | host5 | PGpullup; mustANDwithHOST_ENABLEbecauseoff-statePGishiZ
R1103 | 47k | scci_rh_power:R_0805_2012Metric | host5 | Finiteoutputbleed, moduleinputloadchangesactualdecay
U200 | TPS3700DDCR | scci_rh_power:SOT-23-6 | enable | Native400mVUV/OVwindow; startuphysteresis/bias/referencecornersarefinite | https://www.ti.com/lit/ds/symlink/tps3700.pdf
R2000 | 155000R 0.1% | scci_rh_power:R_0805_2012Metric | enable | Windowupperdivider
R2001 | 10k 0.1% | scci_rh_power:R_0805_2012Metric | enable | Windowbottomdivider
R2002 | 205000R 0.1% | scci_rh_power:R_0805_2012Metric | enable | Windowupperdivider
R2003 | 10k 0.1% | scci_rh_power:R_0805_2012Metric | enable | Windowbottomdivider
R2004 | 10k | scci_rh_power:R_0805_2012Metric | enable | Wired-ANDUV/OVoutputpullup
C200 | 100n X7R 16V | scci_rh_power:C_1206_3216Metric | enable | Railmonitorbypass
U201 | TPS3700DDCR | scci_rh_power:SOT-23-6 | enable | Native400mVUV/OVwindow; startuphysteresis/bias/referencecornersarefinite | https://www.ti.com/lit/ds/symlink/tps3700.pdf
R2010 | 67500R 0.1% | scci_rh_power:R_0805_2012Metric | enable | Windowupperdivider
R2011 | 10k 0.1% | scci_rh_power:R_0805_2012Metric | enable | Windowbottomdivider
R2012 | 77500R 0.1% | scci_rh_power:R_0805_2012Metric | enable | Windowupperdivider
R2013 | 10k 0.1% | scci_rh_power:R_0805_2012Metric | enable | Windowbottomdivider
R2014 | 10k | scci_rh_power:R_0805_2012Metric | enable | Wired-ANDUV/OVoutputpullup
C201 | 100n X7R 16V | scci_rh_power:C_1206_3216Metric | enable | Railmonitorbypass
U202 | TPS3700DDCR | scci_rh_power:SOT-23-6 | enable | Native400mVUV/OVwindow; startuphysteresis/bias/referencecornersarefinite | https://www.ti.com/lit/ds/symlink/tps3700.pdf
R2020 | 108750R 0.1% | scci_rh_power:R_0805_2012Metric | enable | Windowupperdivider
R2021 | 10k 0.1% | scci_rh_power:R_0805_2012Metric | enable | Windowbottomdivider
R2022 | 121250R 0.1% | scci_rh_power:R_0805_2012Metric | enable | Windowupperdivider
R2023 | 10k 0.1% | scci_rh_power:R_0805_2012Metric | enable | Windowbottomdivider
R2024 | 10k | scci_rh_power:R_0805_2012Metric | enable | Wired-ANDUV/OVoutputpullup
C202 | 100n X7R 16V | scci_rh_power:C_1206_3216Metric | enable_2 | Railmonitorbypass
U203 | TPS3700DDCR | scci_rh_power:SOT-23-6 | enable_2 | Native400mVUV/OVwindow; startuphysteresis/bias/referencecornersarefinite | https://www.ti.com/lit/ds/symlink/tps3700.pdf
R2030 | 89500R 0.1% | scci_rh_power:R_0805_2012Metric | enable_2 | Windowupperdivider
R2031 | 10k 0.1% | scci_rh_power:R_0805_2012Metric | enable_2 | Windowbottomdivider
R2032 | 95500R 0.1% | scci_rh_power:R_0805_2012Metric | enable_2 | Windowupperdivider
R2033 | 10k 0.1% | scci_rh_power:R_0805_2012Metric | enable_2 | Windowbottomdivider
R2034 | 10k | scci_rh_power:R_0805_2012Metric | enable_2 | Wired-ANDUV/OVoutputpullup
C203 | 100n X7R 16V | scci_rh_power:C_1206_3216Metric | enable_2 | Railmonitorbypass
U204 | TPS3700DDCR | scci_rh_power:SOT-23-6 | enable_2 | Native400mVUV/OVwindow; startuphysteresis/bias/referencecornersarefinite | https://www.ti.com/lit/ds/symlink/tps3700.pdf
R2040 | 39500R 0.1% | scci_rh_power:R_0805_2012Metric | enable_2 | Windowupperdivider
R2041 | 10k 0.1% | scci_rh_power:R_0805_2012Metric | enable_2 | Windowbottomdivider
R2042 | 43000R 0.1% | scci_rh_power:R_0805_2012Metric | enable_2 | Windowupperdivider
R2043 | 10k 0.1% | scci_rh_power:R_0805_2012Metric | enable_2 | Windowbottomdivider
R2044 | 10k | scci_rh_power:R_0805_2012Metric | enable_2 | Wired-ANDUV/OVoutputpullup
C204 | 100n X7R 16V | scci_rh_power:C_1206_3216Metric | enable_2 | Railmonitorbypass
R230 | 100k 1% | scci_rh_power:R_0805_2012Metric | enable_2 | Hardwarestartuphold
C230 | 47n X7R 10% | scci_rh_power:C_1206_3216Metric | enable_2 | Startupqualificationcapacitor
D230 | BAT54WS-7-F | scci_rh_power:D_SOD-323 | enable_2 | Faststartupnode discharge afterrailfall; diodeleakageretainedaslimitation | https://www.diodes.com/assets/Datasheets/BAT54WS.pdf
R231 | 100R | scci_rh_power:R_0805_2012Metric | enable_2 | Dischargecurrentlimit
U230 | SN74LVC1G17DBVR | scci_rh_power:SOT-23-5 | enable_2 | Hardwarepoweronhold; noMCUcreditedforqualification | https://www.ti.com/lit/ds/symlink/sn74lvc1g17.pdf
U231 | SN74LVC1G11DBVR | scci_rh_power:SOT-23-6 | enable_3 | NativeSUPrailwindowsANDstartuphold | https://www.ti.com/lit/ds/symlink/sn74lvc1g11.pdf
U232 | SN74LVC1G08DBVR | scci_rh_power:SOT-23-5 | enable_3 | Batteryhealthgatedbyhardwarestartup | https://www.ti.com/lit/ds/symlink/sn74lvc1g08.pdf
U233 | SN74LVC1G11DBVR | scci_rh_power:SOT-23-6 | enable_3 | ExplicitrequestANDbatteryANDsupervisorreadiness; nocircularsystemARMcondition | https://www.ti.com/lit/ds/symlink/sn74lvc1g11.pdf
U234 | SN74LVC1G08DBVR | scci_rh_power:SOT-23-5 | enable_3 | BothHOST_ENABLEandactualHOST5PGrequired; PGhi-Zoffcannotenableboost | https://www.ti.com/lit/ds/symlink/sn74lvc1g08.pdf
C240 | 100n X7R 16V | scci_rh_power:C_1206_3216Metric | enable_3 | Logiclocalbypass
C241 | 100n X7R 16V | scci_rh_power:C_1206_3216Metric | enable_3 | Logiclocalbypass
C242 | 100n X7R 16V | scci_rh_power:C_1206_3216Metric | enable_3 | Logiclocalbypass
C243 | 100n X7R 16V | scci_rh_power:C_1206_3216Metric | enable_3 | Logiclocalbypass
C244 | 100n X7R 16V | scci_rh_power:C_1206_3216Metric | enable_3 | Logiclocalbypass
R240 | 10k | scci_rh_power:R_0805_2012Metric | enable_3 | Passiveabsent-controldefaultlow; power-offbackfeedstillrequiresPCBtest
R241 | 10k | scci_rh_power:R_0805_2012Metric | enable_3 | Passiveabsent-controldefaultlow; power-offbackfeedstillrequiresPCBtest
R242 | 10k | scci_rh_power:R_0805_2012Metric | enable_3 | Passiveabsent-controldefaultlow; power-offbackfeedstillrequiresPCBtest
U235 | SN74LVC1G07DBVR | scci_rh_power:SOT-23-5 | enable_3 | Open-drain LOW on power-request/qualificationloss immediatelyconsumesexistingglobalARM; releaseisnotrearm | https://www.ti.com/lit/ds/symlink/sn74lvc1g07.pdf
C245 | 100n X7R 16V | scci_rh_power:C_1206_3216Metric | enable_3 | Powerinterlocklocalbypass
U236 | SN74LVC1G08DBVR | scci_rh_power:SOT-23-5 | enable_3 | Existing4.096Vreferenceand2.048Vmidpointbothqualified; noweakindependentaccuracyclaim | https://www.ti.com/lit/ds/symlink/sn74lvc1g08.pdf
U237 | SN74LVC1G08DBVR | scci_rh_power:SOT-23-5 | enable_3 | Referencequalificationonlyinhibitsguardinterlock; neverblocksconverterstartup | https://www.ti.com/lit/ds/symlink/sn74lvc1g08.pdf
C246 | 100n X7R 16V | scci_rh_power:C_1206_3216Metric | enable_3 | Referencestatuslogicbypass
C247 | 100n X7R 16V | scci_rh_power:C_1206_3216Metric | enable_3 | Power-runlogicbypass
U300 | LT8330ES6#TRPBF | scci_rh_power:TSOT-23-6 | boost15 | 40Vinternal switch2MHzboost. ENlowstopsconversionbutdoesnotdisconnectdiodepathorresidualcharge | https://www.analog.com/media/en/technical-documentation/data-sheets/8330f.pdf
L300 | 4.7uH SRP5030T-4R7M | scci_rh_power:L_Bourns_SRP5030T | boost15 | Boostinductortopology; finiteCCM/DCMcurrentbudgetdoesnotreplacephysicalloopstability
D300 | PMEG6010CEJ | scci_rh_power:D_SOD-323F | boost15 | 60V1ArectifyingSchottky; surgeandlayoutqualificationremain | https://assets.nexperia.com/documents/data-sheet/PMEG6010CEJ.pdf
C3000 | 10u X7R 25V | scci_rh_power:C_1206_3216Metric | boost15 | Boostinputceramic
C3001 | 22u X7R 50V | scci_rh_power:C_1206_3216Metric | boost15 | Reservoir1; combinedeffective30uFminimumassumed
C3002 | 22u X7R 50V | scci_rh_power:C_1206_3216Metric | boost15 | Reservoir2; combinedESR0.1ohmassumed
C3003 | 1u X7R 10V | scci_rh_power:C_1206_3216Metric | boost15 | Internal5Vregulatorbypassperdatasheet
R3000 | 418750R 0.1% | scci_rh_power:R_0805_2012Metric | boost15 | 1.6Vboostreferenceupperdivider; provisionalexactresistance
C3004 | 4.7p C0G 50V | scci_rh_power:C_1206_3216Metric | boost15 | FeedforwardupperresistorcapperLT8330boostexample; layoutdependent
R3001 | 50k 0.1% | scci_rh_power:R_0805_2012Metric | boost15 | Lowerfeedback; 25k..1Mohmdatasheetrange
R3002 | 100k | scci_rh_power:R_0805_2012Metric | boost15 | Outputbleeddoesnotguaranteezerooutputwithbatteryconnected
U301 | LT8330ES6#TRPBF | scci_rh_power:TSOT-23-6 | boost24 | 40Vinternal switch2MHzboost. ENlowstopsconversionbutdoesnotdisconnectdiodepathorresidualcharge | https://www.analog.com/media/en/technical-documentation/data-sheets/8330f.pdf
L301 | 4.7uH SRP5030T-4R7M | scci_rh_power:L_Bourns_SRP5030T | boost24 | Boostinductortopology; finiteCCM/DCMcurrentbudgetdoesnotreplacephysicalloopstability
D301 | PMEG6010CEJ | scci_rh_power:D_SOD-323F | boost24 | 60V1ArectifyingSchottky; surgeandlayoutqualificationremain | https://assets.nexperia.com/documents/data-sheet/PMEG6010CEJ.pdf
C3010 | 10u X7R 25V | scci_rh_power:C_1206_3216Metric | boost24 | Boostinputceramic
C3011 | 22u X7R 50V | scci_rh_power:C_1206_3216Metric | boost24 | Reservoir1; combinedeffective30uFminimumassumed
C3012 | 22u X7R 50V | scci_rh_power:C_1206_3216Metric | boost24 | Reservoir2; combinedESR0.1ohmassumed
C3013 | 1u X7R 10V | scci_rh_power:C_1206_3216Metric | boost24 | Internal5Vregulatorbypassperdatasheet
R3010 | 700000R 0.1% | scci_rh_power:R_0805_2012Metric | boost24 | 1.6Vboostreferenceupperdivider; provisionalexactresistance
C3014 | 4.7p C0G 50V | scci_rh_power:C_1206_3216Metric | boost24 | FeedforwardupperresistorcapperLT8330boostexample; layoutdependent
R3011 | 50k 0.1% | scci_rh_power:R_0805_2012Metric | boost24 | Lowerfeedback; 25k..1Mohmdatasheetrange
R3012 | 100k | scci_rh_power:R_0805_2012Metric | boost24 | Outputbleeddoesnotguaranteezerooutputwithbatteryconnected
U400 | TMR3-0522 | scci_rh_power:TRACO_TMR3_SIP8_21.8x9.1_P2.54 | island | Regulated5Vto+/-12V125mAeachfunctional-isolationmodule. RemoteNCmeansON; removeHOST5toendinputpower | https://www.tracopower.com/products/tmr3.pdf
C400 | 22u X7R 16V | scci_rh_power:C_1206_3216Metric | island | Moduleinputbypassandlocalenergy
C401 | 10u X7R 50V | scci_rh_power:C_1206_3216Metric | island | Positiveisolatedoutputceramic
C402 | 10u X7R 50V | scci_rh_power:C_1206_3216Metric | island | Negativeisolatedoutputceramic; noelectrolyticpolarityerror
U410 | TPS7A4901DGNR | scci_rh_power:Texas_DGN0008D_VSSOP-8-1EP_3x3mm_P0.65mm_EP2x2.94mm_Mask1.57x1.89mm | afe3 | AdjustablelownoiseLDO; ENtiedowninput(negativepolarityforTPS7A30); full+/-2.5%cornercansafelyinhibituntilquiescenttrim | https://www.ti.com/lit/ds/symlink/tps7a49.pdf
C4100 | 10u X7R 50V | scci_rh_power:C_1206_3216Metric | afe3 | LDOlocalinputcap
C4101 | 10u X7R 16V | scci_rh_power:C_1206_3216Metric | afe3 | LDOpulseloadoutputcap; effective>=2.2uFminimumassumed
C4102 | 10n C0G 50V | scci_rh_power:C_1206_3216Metric | afe3 | Noise-reduction/softstart
C4103 | 10n C0G 50V | scci_rh_power:C_1206_3216Metric | afe3 | Feedforwardcapperlow-noiseapplication
R4100 | 19113.924R 0.1% | scci_rh_power:R_0805_2012Metric | afe3 | Replaceabletrimselectionupperresistor; nominalisnotfull-toleranceguarantee
R4101 | 10k 0.1% | scci_rh_power:R_0805_2012Metric | afe3 | Feedbackbottom>5uAminimumfornegativeLDO
R4102 | 47k | scci_rh_power:R_0805_2012Metric | afe3 | Finiteislandrailbleed
J410 | QUIESCENT TRIM / TEST ONLY | scci_rh_power:PinHeader_1x03_P2.54mm_Vertical | afe3 | MeasureandselectRtopwithbodydisconnectedtoachievetarget+/-0.5%qualificationcondition; nocalibrationwhilearmed
U411 | TPS7A4901DGNR | scci_rh_power:Texas_DGN0008D_VSSOP-8-1EP_3x3mm_P0.65mm_EP2x2.94mm_Mask1.57x1.89mm | afep | AdjustablelownoiseLDO; ENtiedowninput(negativepolarityforTPS7A30); full+/-2.5%cornercansafelyinhibituntilquiescenttrim | https://www.ti.com/lit/ds/symlink/tps7a49.pdf
C4110 | 10u X7R 50V | scci_rh_power:C_1206_3216Metric | afep | LDOlocalinputcap
C4111 | 10u X7R 16V | scci_rh_power:C_1206_3216Metric | afep | LDOpulseloadoutputcap; effective>=2.2uFminimumassumed
C4112 | 10n C0G 50V | scci_rh_power:C_1206_3216Metric | afep | Noise-reduction/softstart
C4113 | 10n C0G 50V | scci_rh_power:C_1206_3216Metric | afep | Feedforwardcapperlow-noiseapplication
R4110 | 34725.738R 0.1% | scci_rh_power:R_0805_2012Metric | afep | Replaceabletrimselectionupperresistor; nominalisnotfull-toleranceguarantee
R4111 | 10k 0.1% | scci_rh_power:R_0805_2012Metric | afep | Feedbackbottom>5uAminimumfornegativeLDO
R4112 | 47k | scci_rh_power:R_0805_2012Metric | afep | Finiteislandrailbleed
J411 | QUIESCENT TRIM / TEST ONLY | scci_rh_power:PinHeader_1x03_P2.54mm_Vertical | afep | MeasureandselectRtopwithbodydisconnectedtoachievetarget+/-0.5%qualificationcondition; nocalibrationwhilearmed
U412 | TPS7A3001DGNR | scci_rh_power:Texas_DGN0008D_VSSOP-8-1EP_3x3mm_P0.65mm_EP2x2.94mm_Mask1.57x1.89mm | afen | AdjustablelownoiseLDO; ENtiedowninput(negativepolarityforTPS7A30); full+/-2.5%cornercansafelyinhibituntilquiescenttrim | https://www.ti.com/lit/ds/symlink/tps7a30.pdf
C4120 | 10u X7R 50V | scci_rh_power:C_1206_3216Metric | afen | LDOlocalinputcap
C4121 | 10u X7R 16V | scci_rh_power:C_1206_3216Metric | afen | LDOpulseloadoutputcap; effective>=2.2uFminimumassumed
C4122 | 10n C0G 50V | scci_rh_power:C_1206_3216Metric | afen | Noise-reduction/softstart
C4123 | 10n C0G 50V | scci_rh_power:C_1206_3216Metric | afen | Feedforwardcapperlow-noiseapplication
R4120 | 33367.347R 0.1% | scci_rh_power:R_0805_2012Metric | afen | Replaceabletrimselectionupperresistor; nominalisnotfull-toleranceguarantee
R4121 | 10k 0.1% | scci_rh_power:R_0805_2012Metric | afen | Feedbackbottom>5uAminimumfornegativeLDO
R4122 | 47k | scci_rh_power:R_0805_2012Metric | afen | Finiteislandrailbleed
J412 | QUIESCENT TRIM / TEST ONLY | scci_rh_power:PinHeader_1x03_P2.54mm_Vertical | afen | MeasureandselectRtopwithbodydisconnectedtoachievetarget+/-0.5%qualificationcondition; nocalibrationwhilearmed
