pratham-cloud-ctrl/Project-SCCI-RH/electronics/stage4/integrated-pcb/exports/monitoring-transport/fabrication-reference/bom.csv

Reference | Value | Footprint | Quantity | DNP
C70001 | 22u X7R 10V | scci_rh_transport:C_1206_3216Metric | 1 | 0
C70002 | 22u X7R 10V | scci_rh_transport:C_1206_3216Metric | 1 | 0
C70003 | 1u X7R 10V | scci_rh_transport:C_1206_3216Metric | 1 | 0
C70004 | 10u X7R 10V | scci_rh_transport:C_1206_3216Metric | 1 | 0
C70005 | 1u X7R 10V | scci_rh_transport:C_1206_3216Metric | 1 | 0
C70006 | 10u X7R 10V | scci_rh_transport:C_1206_3216Metric | 1 | 0
C70007 | 1u X7R 10V | scci_rh_transport:C_1206_3216Metric | 1 | 0
C70008 | 10u X7R 10V | scci_rh_transport:C_1206_3216Metric | 1 | 0
C70009 | 100n X7R 10V | scci_rh_transport:C_1206_3216Metric | 1 | 0
C70020 | 100n X7R 10V | scci_rh_transport:C_1206_3216Metric | 1 | 0
C70021 | 100n X7R 10V | scci_rh_transport:C_1206_3216Metric | 1 | 0
C70022 | 1u X7R 10V | scci_rh_transport:C_1206_3216Metric | 1 | 0
C70023 | 1u X7R 10V | scci_rh_transport:C_1206_3216Metric | 1 | 0
C70100 | 1n C0G 5% | scci_rh_transport:C_1206_3216Metric | 1 | 0
C70101 | 1n C0G 5% | scci_rh_transport:C_1206_3216Metric | 1 | 0
C70102 | 1n C0G 5% | scci_rh_transport:C_1206_3216Metric | 1 | 0
C70103 | 1n C0G 5% | scci_rh_transport:C_1206_3216Metric | 1 | 0
C70104 | 1n C0G 5% | scci_rh_transport:C_1206_3216Metric | 1 | 0
C70105 | 1n C0G 5% | scci_rh_transport:C_1206_3216Metric | 1 | 0
C70106 | 1n C0G 5% | scci_rh_transport:C_1206_3216Metric | 1 | 0
C70107 | 1n C0G 5% | scci_rh_transport:C_1206_3216Metric | 1 | 0
J70001 | HOST RAILS / RAW ADC | scci_rh_transport:PinHeader_1x03_P2.54mm_Vertical | 1 | 0
J70002 | EXISTING ANALOG TAPS | scci_rh_transport:PinHeader_1x08_P2.54mm_Vertical | 1 | 0
J70003 | DEDICATED RAW ADC BUS | scci_rh_transport:PinHeader_1x06_P2.54mm_Vertical | 1 | 0
J70004 | TWO EXISTING CHARGE ADCs | scci_rh_transport:PinHeader_1x08_P2.54mm_Vertical | 1 | 0
J70005 | CHARGE CONTROL HANDOFF | scci_rh_transport:PinHeader_1x05_P2.54mm_Vertical | 1 | 0
J70006 | READ-ONLY NATIVE HEALTH | scci_rh_transport:PinHeader_1x10_P2.54mm_Vertical | 1 | 0
J70007 | HOST PROCESSED UART | scci_rh_transport:PinHeader_1x04_P2.54mm_Vertical | 1 | 0
J70008 | EXTERNAL COMPANION UART | scci_rh_transport:PinHeader_1x04_P2.54mm_Vertical | 1 | 0
J70020 | HOST CHARGE ADC BUS | scci_rh_transport:PinHeader_1x12_P2.54mm_Vertical | 1 | 0
J70021 | HOST HEALTH INPUTS | scci_rh_transport:PinHeader_1x10_P2.54mm_Vertical | 1 | 0
J70022 | HOST SHARED ENDPOINT SPI | scci_rh_transport:PinHeader_1x07_P2.54mm_Vertical | 1 | 0
R70001 | 33R | scci_rh_transport:R_0805_2012Metric | 1 | 0
R70002 | 33R | scci_rh_transport:R_0805_2012Metric | 1 | 0
R70003 | 100k | scci_rh_transport:R_0805_2012Metric | 1 | 0
R70004 | 100k | scci_rh_transport:R_0805_2012Metric | 1 | 0
R70005 | 100k | scci_rh_transport:R_0805_2012Metric | 1 | 0
R70006 | 100k | scci_rh_transport:R_0805_2012Metric | 1 | 0
R70020 | 33R | scci_rh_transport:R_0805_2012Metric | 1 | 0
R70021 | 33R | scci_rh_transport:R_0805_2012Metric | 1 | 0
R70022 | 33R | scci_rh_transport:R_0805_2012Metric | 1 | 0
R70023 | 33R | scci_rh_transport:R_0805_2012Metric | 1 | 0
R70024 | 10k | scci_rh_transport:R_0805_2012Metric | 1 | 0
R70025 | 10k | scci_rh_transport:R_0805_2012Metric | 1 | 0
R70030 | 330R | scci_rh_transport:R_0805_2012Metric | 1 | 0
R70031 | 330R | scci_rh_transport:R_0805_2012Metric | 1 | 0
R70100 | 100R 0.1% | scci_rh_transport:R_0805_2012Metric | 1 | 0
R70101 | 100R 0.1% | scci_rh_transport:R_0805_2012Metric | 1 | 0
R70102 | 100R 0.1% | scci_rh_transport:R_0805_2012Metric | 1 | 0
R70103 | 100R 0.1% | scci_rh_transport:R_0805_2012Metric | 1 | 0
R70104 | 100R 0.1% | scci_rh_transport:R_0805_2012Metric | 1 | 0
R70105 | 100R 0.1% | scci_rh_transport:R_0805_2012Metric | 1 | 0
R70106 | 100R 0.1% | scci_rh_transport:R_0805_2012Metric | 1 | 0
R70107 | 100R 0.1% | scci_rh_transport:R_0805_2012Metric | 1 | 0
R70120 | 4.99k 0.1% | scci_rh_transport:R_0805_2012Metric | 1 | 0
R70121 | 2.49k 0.1% | scci_rh_transport:R_0805_2012Metric | 1 | 0
R70122 | 2.4k 0.1% | scci_rh_transport:R_0805_2012Metric | 1 | 0
R70123 | 2k 0.1% | scci_rh_transport:R_0805_2012Metric | 1 | 0
U70001 | ADS8688IDBTR | scci_rh_transport:TSSOP-38_4.4x9.7mm_P0.5mm | 1 | 0
U70020 | ISO6721BDR | scci_rh_transport:SOIC-8_3.9x4.9mm_P1.27mm | 1 | 0
