pratham-cloud-ctrl/Project-SCCI-RH/docs/stage4/requirements-trace.csv

requirement_id | subsystem | parent_input | requirement_or_target | verification_artifact_or_test | acceptance | status | limitation
S4-REC-001 | acquisition | S2-C-001;system-design.recording | 16 differential streams at 4000Hz; reference and bias distinct | recording-front-end native package151components594pins; recording-study timing17groups56assertions | All16 sample identities and two-command pipeline mapped; no interpolated measurement | native_and_finite_protocol_checked | FourMHz isolated bus revision; actual pin timing and useful spinal information unqualified
S4-REC-002 | acquisition | S2-C-009;source-sensitivity.md | Physical apertures and artifact/recovery masks | recording-study finite passive and protocol results; preserved Stage3 invalid masks | Invalid or missing observations retain invalid masks until measured recovery | partial_finite_models | Pin DC containment and amplifier/filter recovery remain separate; no generic20ms neural recovery earned
S4-REC-003 | acquisition | electrical-source-audit.csv | Input common mode; reference fanout; protection; body bias | recording-front-end17protectedpaths;8quietrows9transients and175independentchecks | Specified pin operating envelope and declared leakage/noise bounds | native_and_partial_model | Coherent nominal10uV noise allocation fails; voltage/leakage/recovery and biological information unqualified
S4-OUT-001 | output | S2-C-007;system-design.stimulation | Two independent sources maximum2 concurrent;16 selectable contacts and2 dedicated returns | contact-router native155components650pins6sheets; independent exported ownership and address checks | Separate ownership and measured dose for each source; reject shared contacts | native_fixed_return_slice_checked | Restricted24V3mA source-to-contact selection plus2fixedreturns; arbitrary bipolar contact-pair and48V20mA matrix remain pending
S4-OUT-002 | output | S2-C-006;stimulation-and-access.md | 0.1..20mA and50..500us within jointly admitted charge/compliance/thermal domain | Driver current-loop stability and load sweeps | No admitted command above9uC or delivered interval above10uC; keep impossible combinations rejected | planned | No tissue-safe dose or biological effect established
S4-OUT-003 | routing | S2-C-007;output_configuration_bus | Zero-current preload;250us rearm; no live switching | contact-router D-input hold and fresh ACK latches; routing-study15groups36histories86assertions | Pair locked through both phases/recovery; observed-zero/discharge gates before change | native_and_finite_protocol_checked | 25us off/on and250us controller budgets provisional; true quiescence/switch position/setuphold remain unqualified
S4-MON-001 | current | motor-precision-requirements.md | Separate2ohm Kelvin shunt and INA241A2 per source | monitoring-cell native exports; independent245pin comparison | Pin-level wiring checked against A2 manufacturer table | native_verified | Shared sense failure and input bias remain unresolved
S4-MON-002 | charge | S2-C-008;delivery-requirements.md | Continuous analog integral with separate baseline/cathodic/anodic/net/tail endpoints | monitoring-study33runs;462intervals; independentKCL and linear oracle | Both phase charges bounded independently; cancellation cannot certify either phase | partial_behavioral | Selected fixture only; complete phase/tail error bounds and actual driver remain unqualified
S4-MON-003 | charge | delivery-requirements.md | Proposed24nC uncertainty at600nC phase charge in selected motor domain | Full deterministic charge allowance and independent load-current integral comparison | Uq<=24nC only when all stated allocations earned | unqualified_target | 4percent with8mm forecast is scalar conditional requirement;15mm requires below0.5percent
S4-MON-004 | charge | motor-precision-requirements.md | Bound window/tail/interior-waveform error instead of nominal command edge | monitoring-study gap/tail/timing and cancellation witnesses | Unknown area or phase separation invalidates delivery; no hidden5us edge deletion | partial_behavioral | Independent endpoint strips and wider spike/reversal/load coverage remain pending
S4-MON-005 | charge | S2-C-008 | Gain/offset/reference/reset/capacitor/ADC/bypass errors retain correlation | monitoring-study reset/injection/leakage/scale/ADC witnesses | No square-root averaging of systematic errors; signed net uncertainty sums phase allowances | partial_behavioral | First-order illustrative corner; full temperature correlated error budget remains pending
S4-MON-006 | charge | INA241A2 primary datasheet | 25..45uA input bias per input included in actual load path | monitoring-study explicit load-side/driver-side bias KCL | Bound current bypass and body-reference leakage or reject domain | open_blocker | One45uA load-side bias gives9nC per200us;3nC target remains unearned
S4-MON-007 | endpoint_adc | ADS8866 primary datasheet | 3.3V AVDD/DVDD;4.096V reference;>=10uF local reference capacitance | Native pin audit and behavioral endpoint/filter model | No5V AVDD; phase endpoint identities and conversion timing retained | design_entry | Two-endpoint INL plus rounding1.71875nC already exceeds1.5nC allocation; SAR settling not qualified
S4-MON-008 | monitor_transport | system-design.monitoring;S2-C-008 | Retain200kHz current per source plus20kHz voltage per source and10kHz health | Power resource audit; next shared ADC/bus and endpoint arbitration design | 450ksample/s baseline and additional endpoint bursts fit16Mbit/s with margin | rejected_with_current_ADC_inventory | Two ADS8866 provide200kaggregate not450k; next transport mustadd/revise acquisition hardware orrates; average duty not simultaneouscapture
S4-MON-009 | monitor_transport | system-design.compute.monitor_dma_bytes | Proposed2x2.5ms raw sub-buffers plus metadata | Target linker map and DMA overrun tests | Total buffers including headers/endpoints/alignment fit8192bytes | proposed_revision | 2x5ms baseline raw blocks require9000bytes and do not fit
S4-SUP-001 | current_guard | S2-C-007;motor-precision-requirements.md | Independent-from-command analog window and sticky permission latch | Monitor and supervision native circuits; finite control/analog studies | Fault removes permit; explicit rearm cannot override active fault | native_and_finite_checked | Shared INA/reference faults and assembled propagation/leakage remain;25mA maximum not proved
S4-SUP-002 | supervision | S2-C-008;control-contracts.json | Separate compliance/duration/watchdog/rail supervision | Supervision478components1699pins22sheets; control18histories; analog7interruptioncases;102wireplan | Independent phase cap and heartbeat; inhibited phases do not resume on health recovery | native_and_finite_checked | Valid-supply ideal logic plus declared analog envelopes; shared-reference and common-power faults retained; no biological qualification
S4-SUP-003 | compliance | system-design.stimulation | 40V usable differential terminal authority after headroom | Restricted24V OPA2192 internal A-B monitor; fullresistor/commonmode corners | Voltage clipping reduces authority and inhibits unsupported delivery | restricted_native_slice_checked | 40V broader target unearned; nominal22V internal window excludes later router/shunt/guard drops; load leakage remains
S4-SUP-004 | supervision | residual_guard.py;dynamic-coupling-specification.md | Check policy clock before every continuation even with no new packet | Target state-machine timeout/replay/no-arrival tests | Total sensor loss expires pending prediction; no automatic restart | planned | Delayed residual cancellation cannot undo an earlier pulse
S4-SUP-005 | terminal_shutdown | S2-C-007;contact-router.J7 | Guard all16stimcontacts plus2dedicatedreturns after existing router/monitor | Five TMUX7412FRRPR native paths; independent S-D-SEL audit; interrupted RparallelC load | Any source/global fault consumes arm and closes all18healthyguardpaths | native_and_finite_checked | Guard5us/detector20us assumed; welded/openleakage/storedenergy and arbitraryfault timing unqualified
S4-SUP-006 | duration_watchdog | current-driver primarytimer;hostcontrol | Separate raw-request secondary one-shot and heartbeat watchdog | LTC6993-1 RSET195.4k;TPS3431 plus heartbeatseen latch; native andeventaudits | Primarytimerstuck limited by healthysecondary; freshheartbeat required before arm | native_and_finite_checked | Secondary250.112usnominal and261.378us arithmeticmax;264usmodel;watchdog230ms cannot replace phasecap; dualfaults retained
S4-SUP-007 | recording_observation | recording-front-end RHD2216pins | Observe17actual RHD-side pin windows and local blank controls across isolated status | TLV3202 windows;ISO6742F;102wireplan;1024AFEcorners andloading | Qualified observed DCband plusCONNECT/ACQUIRElow under healthy-switch premise | native_and_finite_checked | Acceptedunion about264mV not AClinearity or welded-switch isolation proof;probeadds313nA/pin andnominal7.8mVpositiveDCshift
S4-SUP-008 | quiescence_rearm | monitoring-cell actualINA241A2 transfer | Measured nominal250uAquietwindow with actualRCdwell and explicit rearm | Native203.8k/2k/203.8k ladder;RC and6mV/600uVcorners;controlhistories | WaitactualquietandtimerLOW;nohealth-restorationclock;norequest-gatedtimer | native_and_finite_checked | Union494uA notzero;16.3to87.7usdwellassumedthresholds;old100usgapunearned;200usprovisionalallocation
S4-FW-001 | timing | system-design.output_configuration_bus | Three reserved serial services and local timer/DPPI pulse edges | Target peripheral/pin assignment and schedule trace | Output preload fits250us; neural and monitor services preserve deadline/identity | planned | Desktop C state machine is not nRF5340 backend
S4-FW-002 | resources | system-design.compute | Application/network RAM and flash kept separate | Linked target maps and bounded fault-journal test | Each domain fits its own reservation with20percent headroom | planned | Carrier now implemented in S4-PCB-003;serialized snapshots not continuous fault coverage
S4-APP-001 | motor | delivery-requirements.md;dynamic-response.md | Actual-negative and future-assumed monitor domains remain distinct | Versioned profile/calibration IDs and authority regression | No circuit target inserted as measured past calibration; no candidate effect counted twice | planned | Stage3 conservative investigation closed and conditional concept complete; electronics cannot establish biological efficacy
S4-APP-002 | motor | sparse-baseline.md | Fresh unassisted baseline pass does not authorize repeated assisted forecast | Admission/release/context tests | Unqualified assisted/past-tail intervals inhibit; OFF learning remains separate | planned | No universal skill transfer or acquisition multiplier
S4-APP-003 | physiology | S2-C-004;S2-C-010;pressure-model.md | External measured SBP with pressor-only authority and exclusive mode | Sensor transport/freshness/stop-hold-ramp firmware tests | Unreachable pressure direction reported; lost support follows finite tested fallback | planned | No invented neural pressure information or universal body control
S4-PWR-001 | power | system-design.power.monitor_reference_gate_allocation_W | Revise20mW monitor budget for selected sense candidate | ActualICsupplypinand9railinventory; independent3300assertion power audit | Actualmonitor/reference/supervision load andloss allocations recorded | native_and_finite_budget_checked | Declaredloadceilings/efficiencies are conditions; measuredmaximum and4percentdose unearned
S4-PWR-002 | power | system-design.power.driver_quiescent_allocation_W | Compare HV router andallnativecircuitpower | FullsixpackagebudgetincludingactualHVrouteranddriver supplypins | Old8mW unchangednotinherited; power andheat revised | native_and_finite_budget_checked | Restricted24Vslice;full48V20mAdomainandphysicalripple/thermalunqualified
S4-PWR-003 | power | system-design.power;system-source-audit.csv | Revised protected2S6.4to8.4V reference; nine rails; actual converter/reservoir topology | Native156components449pins15sheets; peak/reservoir/source/startupenergy sweeps | Conditionalelectricalmargins explicit; rejectedcorners preserved | native_and_finite_reference_checked | Historical1S100mAcontract superseded;2.615W/5.886hconditional;compactthermalfails;boostdisabledoesnotdisconnect
S4-PWR-004 | reference_supervision | monitoring-cell REF3440 andV_MID;supervision GUARD_FAULT_N | Observe actual4.096Vreference and2.048Vmidpoint beforepowerpermission | TwoTPS3700nativewindows;POWER_RUN_OKopen-drainwiredfault;320KCLcorners;32newwires | GrossreferencefaultconsumesARMwithoutHOSTstartupfeedbackloop | native_and_finite_checked | Windowsdo notearnnarrowgain/offsetcalibration orsensorcommoncausecoverage
S4-PWR-005 | startup_shutdown | supervision-control-contract;actualpowerENpins | ExternalPWR_REQUESTqualifiesHOSTrails independently; powerfaultassertsdespitechargedrails | 12histories182assertions1536nativegateoutputs;134combinedwires | Restoredrailsdo notgenerate monitor/global/phase rearm | native_and_finite_checked | Valid-supplyideallogic;physicalfaultlatency/inrush/brownoutandAFEfullcornerstartupunearned
S4-PWR-006 | heat_runtime | system-design.power;system-design.mechanical | Explicitbattery/efficiency/heat/runtimeandpackage revision | AT31004protected2S19.24Wh99g; lossKCL;efficiency/thermal/sourceRmodels | Admitonlydeclaredreferenceconditions;retain2Kcompactfailure | finite_budget_complete_target_unearned | Futurecompactconsumerimplantrequireslowerpowerimplementation andactualCADrevision; no inventedminiaturizedASIC
S4-TEL-001 | telemetry | system-design.telemetry | 160kbit/s normal payload and separate1Mbit/s raw service | transport-results.json;verify_transport.py;monitoring-transport native and input/integration studies | 114355.2bit/s reserved normal below160k; 100ms diagnostic burst; 21 packet histories and leases | native_and_finite_contract_checked | 1Mbaud8N1 gives800kbit/s beforeoverhead; continuous4k and2k framedexport do notfit; targetUART unimplemented
S4-CAD-001 | mechanical | system-design.mechanical;functional-port-map.csv | 36port functional map and current60x48x14mm package are provisional | PopulatedPCB STEP/nativeCAD and tolerance/interference review | All components/returns/header/battery isolation fit or allocations revised | planned | Envelope solids are not populated engineering CAD or hermetic qualification
S4-EDA-001 | eda | SCCI_RH-S4-ENTRY-01 | Native editable monitoring-cell KiCad source with local library | monitoring-cell verification.json plus readonly verify_monitoring_cell.py | 70components and245pins audited;3PDFpages;zeroERCviolations/noignoredchecks;externalfunctions documented | native_connectivity_checked | NoPCB fabrication or analog-function certification fromERC
S4-MON-011 | monitor | SCCI_RH-S4-MON-01;ADS8866 primary datasheet | Endpoint sampling aperture differs from result/readout availability;four-wireCS mode | transport-results.json endpoint captures;1552 independent transport assertions | DINhigh atCNV edge;CNVhigh through read;gap/recoverycharge explicitly attributed or bounded | finite_aperture_read_contract_checked | Native sharedMISO join and14usCNV spacing; targetexecution/skew and4percentchargeprecisionunearned
S4-MON-012 | monitor | SCCI_RH-S4-MON-01;INA241A2 primary datasheet | Load-side sensor bias must fit charge allocation | Topology and temperature/commonmode/powerstate leakage sweep | One45uA input over200us equals9nC;cannot claim proposed3nC allocation without evidence | open_blocker | Two-input18nC is stress scenario;actual paths need model
S4-MON-013 | monitor | SCCI_RH-S4-MON-01;TMUX1136 primary datasheet | Differential reset injection amplified in electrode-equivalent charge | Worstcase switch injection/settling and reset-history fault sweep | Rint/(gain*Rshunt)=250;unobserved6pC betweenendpoints becomes1.5nC;typical notbound | open_blocker | Settled post-openbaseline can cancel fixed initial jump;never erase unknowncharge
S4-MON-014 | monitor | SCCI_RH-S4-MON-01;ADS8866 primary datasheet | 5V buffer fault can exceed4.096V measurement range | Input protection and clipping/recovery fault model | Unknown integrator history or clipping rejects certification;input absolute limits respected | planned | Native slice does not yet populate qualified ADC protection
S4-TOOLS-001 | toolchain | tool-inventory.json;tool readiness/READINESS.md | ExistingfreeKiCad/FreeCADstack andinstalledNordicSDK3.4.1 ARMtoolchain | stage4-nrf5340-build.json;verify_nrf5340.py;compiledproductioncoretests | ActualATOARMimage sourcebound; no paidtool or physicalboardneededforbuild | actual_target_build_available | Builddoesnotmeasurehardwareexecution orWCET; preserveoldertoolreadinessreceipts
S4-EDA-REC-001 | eda | SCCI_RH-S4-REC-01 | Native16stream recording/protection and isolated control | recording-front-end verification.json plus native MCP checks | 151components594pins7sheets zeroERC/noignored; explicit external qualification interfaces | native_connectivity_checked | No noise/recovery/implant certification fromERC
S4-EDA-RTR-001 | eda | SCCI_RH-S4-RTR-01 | Native2source16contact router and fixed monitored returns | contact-router verification.json; MCP component/pin/bounds/ERC evidence | 155components650pins6sheets zeroERC/noignored; canonical18stimports | native_connectivity_checked | No terminal guard or actual mux-position/analogue isolation evidence from digital ownership
S4-EDA-TPT-001 | eda | SCCI_RH-S4-TRANSPORT-01 | RawADC endpoint and isolatedcompanion nativecircuit | monitoring-transport verification.json;MCPpin/bounds/ERC | 60components217pins8sheets zeroERC noignored | native_connectivity_checked | No targetMCU PCB radio or sensorimplementation fromERC
S4-MON-TPT-001 | monitor | S2monitor450k;ADS8688primary | Resolve rawconvertercapacity withactualaddedhardware | transport_contract.py;verify_transport.py;nativeU1map | 450kaggregate;I0I1each200kaverage;actual4.25to6.375usgaps retained | native_and_finite_protocol_checked | Typical15kHzbandwidth;undetectedplausiblechannelcommandpossible;targetDMA/CSunimplemented
S4-MON-TPT-002 | monitor | ADCinputnetwork;4percentprecisiontarget | Observe loading and filteredwaveforms at actualapertures | input-results.json;input-traces.npz;verify_input.py | 192divider16directcorners6illustrativefiltercases independentlyaudited | finite_input_model_complete_precision_unearned | ExactDCcal andillustrativepoles;noactualpeak/doseaccuracyorbufferstabilityclaim
S4-COMP-001 | companion | targetspecificphysiology;motorpolicy | Supporttime quality calibration identity and explicitrearm | transport-results.json21packet24lease15fallbackpoints | Age2s;clockuncertainty500us;stale/replay/CRC casesreject | finite_protocol_checked | Trustedpeer sensoraccuracy clocktruth and fallback clinicalbehaviorremainpremises;CRCnotauth
S4-PWR-TPT-001 | power | frozenpowerreference;newtransportcomponents | Updatehostcaps andincrementalloss/runtime | input-results.json power_overlay;verify_input.py | HOST3.3cap80mA HOST5direct40mA;conditional2.800W5.497h | finite_incremental_budget_checked | Unmeasured converterefficiency;compactthermalfailurepreserved;peerexternallypowered
S4-FW-001 | firmware | nRF5340;Stage4remainingpackage4 | ActualATOapplicationcorebuild andsharedproductionC | stage4-nrf5340-build.json;ARMELFHEXBINMAP;verify_nrf5340.py | PristineSDK3.4.1buildlinksactualCcore+backend withsourcehashes | target_compiled_linked_checked | Unflashed; radio/networkimage notbuilt; fullStage3modelsnotported
S4-FW-002 | firmware | nativeGPIO;activerouteQ;health | ExplicitperipheralGPIOownership andserializedrealactiveQ | nrf5340-pin-map.csv;componentreview;128independentimageinterfacechecks | 46GPIO;50actualnativeendpoints;SN74LVC165Acarrierexplicit | target_and_native_interface_checked | Carrier now implemented in S4-PCB-003;serialized snapshots not continuous fault coverage
S4-FW-003 | firmware | supervision;currentdriver;transportcontracts | Bootinhibited explicitmonitorfirstrecovery routephaseleasefaultlogic | runtime-tests.json;compiledsamescci_rh_runtime.c;targetbackend | 75scenarios713assertions;noautorestartorautomaticcompensation | compiled_core_and_target_link_checked | Hosttestsdo notexecutetargetperipherals; hardtimerterminalcutoffunmeasured
S4-FW-004 | acquisition | ADS8688;RHD2216;old450k4kproposal | Actualtaggedraw andRHDtransportfeatureprofile withretainedgaps | backendsource;40clockADC;RHD19wordrecords;epochaperturemaskcounters | 100usrawand1msRHDopportunities;EMAADCcounts+supporthistory+analogqualifiedfalse | bounded_lower_rate_target_implemented | 152usRHDburst>100usrawslot; knownpollinggaps; continuous450k4knotimplemented;10msdiscardnotqualification
S4-FW-005 | resources | actualARMlinkerregion;priorRAMproposal | Auditrealretainedbuffers andfirmwareimageheadroom | independentELFparser;GNUmap;symbols;selectedcompile-records | 53616Bflash98000BRAM;actual448KiBregion;20percentheadroompasses | linked_resource_audit_checked | Actualnarrowerprofileallocation; prior404992Bfullestimatewouldnotmeet20percentof448KiB; physicaltimingpowerunmeasured
S4-PCB-001 | integration | seven native circuit packages;target GPIO map | Actual native master and physical harness | integration verification.json;verify_integration.py | 1298 positions1296 fitted4781 pins80 sheets258 rows9540 checks | native_graph_integrated | Biological observations and useful recruitment remain assumptions
S4-PCB-002 | pcb | actual component lands and source net graph | Eight genuinely populated routed boards | integration/populated-verification.json;native drc-binding.json | 14273 assertions;21039 segments2335 vias;zero DRC unconnected parity ignored | native_populated_layout_checked | Large modular reference; fabrication and signal integrity unmeasured
S4-PCB-003 | controller | 46 GPIO and26 observations | Physical BT40F and four165 carrier; actual11pF firmware | controller-carrier/verification.json;firmware-profile/verification.json | 68 parts328 pins66 module pads;83 image checks;53648 flash98000 RAM | carrier_and_target_build_checked | No target execution; five LGA lands require filled/capped vias
S4-PCB-004 | power | prior power/transport budget;actual added controller | Preserve prior reserves and add declared controller load | integrated-pcb/power-overlay.json;verify_power.py | 160mA host3.3 cap;conditional3.154W4.880h;23 independent checks | additive_budget_checked | Declared allocations and efficiency; compact implanted thermal failure retained
S4-PCB-005 | geometry | all fitted PCB references and nominal package models | Actual populated STEP and traceable native exports | verify_exports.py;geometry-verification.json;verify_integrated_pcb.py | Eight valid populated STEP assemblies;DNP bodies excluded;current source/DRC hashes | populated_geometry_checked | Nominal geometry only; no mechanical tolerance or implantation qualification
