pratham-cloud-ctrl/Project-SCCI-RH/docs/claim-register.csv

id | claim | status | evidence | qualification | falsification_or_next_test
C01 | This release is entirely digital | implemented | Repository sources and validation artifacts | No physical fabrication or human/animal testing | Any physical result must be added as a separately dated measured artifact
C02 | Future SCCI_RH proposes spinal recording plus spinal stimulation | concept | docs/architecture.md | Distinct intradural recording and epidural stimulation; chronic human feasibility unknown | Anatomical access; recording stability; recruitment selectivity
C03 | Spinal signals can contain information correlated with movement | literature-supported | E01 | Animal evidence; predictive correlation is not a causal motor command | Independent causal and cross-session recordings
C04 | Expert voltage replay is not assumed to reproduce skill | design-constraint | E02; D06; docs/scci_rh-paper.md | A calibrated learner response and task template are used | Compare policy learning with replay and unmatched controls
C05 | Assistance can improve surrogate online performance | digital-conditional | results/summary.json; scripts/run_studies.py | Artificial task; performance while assisted differs from retained learning | Repeat with delayed and noisy state estimates
C06 | Assisted practice may improve retained learning only under assumed beneficial coupling | hypothesis-and-digital-conditional | Learning beta sweep in generated results | Plasticity parameter is prescribed rather than inferred from tissue | Set beta to zero or negative; assess stimulation-off retention experimentally
C07 | SCCI_RH establishes a 1.5x or 2x human learning speedup | not-established | No human or animal SCCI_RH data | Do not advertise this as a measured or predicted effect | Matched biological trial with retention; transfer; confidence intervals
C08 | Pressure feedback rejects a synthetic postural disturbance | digital-conditional | results/summary.json; pressure trajectories | Reduced-order external-pressure plant; MAE scored after initial transient | Plant mismatch; saturation; delay; sensor dropout
C09 | SCCI_RH controls every involuntary function | not-established | No relevant evidence or model | Only mean arterial pressure is modelled | Each new function requires accessible pathways; sensing; authority
C10 | Brain-spine literature validates spinal-only neural intent decoding | not-established | E11 | Hybrid systems use cortical inputs | Spinal-only ablation and independent task data
C11 | Nominal biphasic pulses have auditable test-load charge and compliance | digital-electrical | electronics/simulation/metrics.json; circuit verification reports | Low-voltage artificial load; idealized and generic-device models; not medical safety | Component tolerances; electrode dynamics; missed phases; compliance faults
C12 | CAD gives the concept an editable physical identity | implemented-digital | cad source and exports; renders | Desktop enclosure; illustrative lead; no anatomical fit or hermetic implant claim | Geometry checks; prototype tolerances if fabricated in future
C13 | Published evidence supports interest in lower thoracic pressure stimulation | literature-supported | E09; E10 | SCI-specific evidence; separate clinical cohorts and endpoints | Independent trials and identified patient dynamics
C14 | The project was independently completed and understood by the student | not-established | User motivation and AI provenance | AI supplied research; code; design and writing assistance; comprehension requires demonstration | Student explains; reruns; changes and defends each major mechanism
C15 | This project demonstrates a clinically effective implant | not-established | No SCCI_RH clinical evidence | Digital engineering proof of concept only | Clinical development outside this release's scope
C16 | Application examples exercise the compiled pulse state machine | implemented-digital | results/adapter_validation.json; scripts/run_adapter.py | Declared frequency/phase mapping; no fitted biological command-to-dose relationship | Host validation; analog output measurement if fabricated in a future project
C17 | Output-leg resistors provide a universal analog current cap | not-established | electronics/simulation/metrics.json | Stored polarization changes the passive bound; 2 V fault estimate 305.13 microamperes | Polarization and supply conditions; vendor models; current monitoring
C18 | A switching-transient model finding prompted an inspectable circuit revision | implemented-digital | electronics/revisions/revA/; final circuit and simulation records | Generic-model peak reduced from 1361.36 to 102.58 microamperes in nominal case | Reproduce archived and revised models; investigate omitted parasitics
