pratham-cloud-ctrl/Project-SCCI-RH/docs/evidence-matrix.csv

id | year | authors | title | doi | url | study_type | population_or_scope | supported_claim | not_established | scci_rh_implication | checked_date | access_basis
E01 | 2026 | El Hadwe et al. | Surface circumferential spinal cord recording in freely moving rodents | 10.1038/s41467-026-75128-z | https://doi.org/10.1038/s41467-026-75128-z | Primary experimental | 15 rats total; motor decoder 5; sensory subset 4; 3 pigs; rodent implantation up to 3 days | Surface spinal signals predict selected kinematics and discriminate evoked inputs | Chronic human decoding; causally identified motor command; expert skill transfer | Separate intradural read concept from stimulation placement | 2026-10-07 | Publisher full article and methods
E02 | 2013 | Capogrosso et al. | A computational model for epidural electrical stimulation of spinal sensorimotor circuits | 10.1523/JNEUROSCI.1688-13.2013 | https://doi.org/10.1523/JNEUROSCI.1688-13.2013 | Primary computational and experimental | Model and experimental analysis of spinal recruitment | Epidural stimulation engages spinal circuits through recruited afferents | Arbitrary reproduction of recorded neural activity | Use a response model instead of expert voltage replay | 2026-10-07 | PubMed primary article record
E03 | 2018 | Wagner et al. | Targeted neurotechnology restores walking in humans with spinal cord injury | 10.1038/s41586-018-0649-2 | https://doi.org/10.1038/s41586-018-0649-2 | Primary clinical feasibility | Three participants with chronic SCI | Timed targeted stimulation with rehabilitation can support movement and recovery | Healthy novice learning acceleration or general expert transfer | Separate assistance from stimulation-off outcomes | 2026-10-07 | Publisher abstract and study figure descriptions; PubMed
E04 | 2018 | Formento et al. | Electrical spinal cord stimulation must preserve proprioception to enable locomotion in humans with spinal cord injury | 10.1038/s41593-018-0262-6 | https://doi.org/10.1038/s41593-018-0262-6 | Primary computational preclinical and clinical | Cross-species mechanisms and human proprioceptive disruption | Stimulation can interfere with sensory information; patterned protocols can mitigate interference | All stimulation improves sensory feedback or learning | Include feedback preservation and timing constraints in future design | 2026-10-07 | Publisher abstract
E05 | 2022 | Rowald et al. | Activity-dependent spinal cord neuromodulation rapidly restores trunk and leg motor functions after complete paralysis | 10.1038/s41591-021-01663-5 | https://doi.org/10.1038/s41591-021-01663-5 | Primary clinical feasibility | Three participants; task-specific stimulation | Spatial and temporal targeting supports multiple movement tasks | Universal movement control; transfer of an expert skill | Represent target-specific policies and anatomy | 2026-10-07 | Primary accepted-manuscript repository metadata and abstract
E06 | 2013 | Thompson; Pomerantz; Wolpaw | Operant conditioning of a spinal reflex can improve locomotion after spinal cord injury in humans | 10.1523/JNEUROSCI.3968-12.2013 | https://doi.org/10.1523/JNEUROSCI.3968-12.2013 | Primary human experiment | Chronic incomplete SCI; 30 conditioning or measurement sessions | Reflex modification can persist and accompany functional gains in responders | Implanted expert-informed training; universal response; fixed acquisition multiplier | Learning benefit must be independently measured | 2026-10-07 | PubMed abstract and figure details
E07 | 2013 | Nishimura; Perlmutter; Eaton; Fetz | Spike-timing-dependent plasticity in primate corticospinal connections induced during free behavior | 10.1016/j.neuron.2013.08.028 | https://doi.org/10.1016/j.neuron.2013.08.028 | Primary primate experiment | Cortical spike-triggered spinal stimulation | Connection strength can depend on conditioning timing | Spinal-only skill-copying or human expert transfer | Supports a timing hypothesis; hybrid input cannot be silently imported | 2026-10-07 | Author-hosted full manuscript
E08 | 1994 | Shadmehr; Mussa-Ivaldi | Adaptive representation of dynamics during learning of a motor task | 10.1523/JNEUROSCI.14-05-03208.1994 | https://doi.org/10.1523/JNEUROSCI.14-05-03208.1994 | Primary human motor adaptation | Robot-induced force field during reaching | Practice changes movement under novel dynamics | An implanted spinal mechanism or permanent general skill transfer | Distinguish acquisition; aftereffects; retention; transfer | 2026-10-07 | PubMed primary abstract
E09 | 2021 | Squair et al. | Neuroprosthetic baroreflex controls haemodynamics after spinal cord injury | 10.1038/s41586-020-03180-w | https://doi.org/10.1038/s41586-020-03180-w | Primary preclinical and clinical translation | Animal models and preliminary human translation | Feedback-guided spinal stimulation can regulate pressure after SCI | Universal autonomic regulation; SCCI_RH patient model validity | A bounded pressure-feedback application is biologically motivated | 2026-10-07 | PubMed primary article record and abstract
E10 | 2025 | Phillips et al. | An implantable system to restore hemodynamic stability after spinal cord injury | 10.1038/s41591-025-03614-w | https://doi.org/10.1038/s41591-025-03614-w | Primary clinical feasibility | 14 participants across four trials; survey cohorts are separate | Lower thoracic targeting and an implantable system address hypotensive complications | A validated SCCI_RH device; equivalent success for every participant or endpoint | Separate spinal segment targeting from vertebral geometry; external pressure feedback explicit | 2026-10-07 | Publisher abstract and primary Europe PMC fullTextXML
E11 | 2023 | Lorach et al. | Walking naturally after spinal cord injury using a brain-spine interface | 10.1038/s41586-023-06094-5 | https://doi.org/10.1038/s41586-023-06094-5 | Primary clinical proof of concept | One participant; implanted cortical recording and spinal stimulation | Brain-derived intent can drive spinal stimulation in a hybrid interface | Spinal-only intent decoding or a purely spinal system | Label hybrid comparisons and preserve SCCI_RH spinal identity | 2026-10-07 | Publisher article
E12 | 2025 | sam-astro | Mind-Link repository |  | https://github.com/sam-astro/Mind-link | Engineering inspiration | Commit a391eb851ee624be675057380f4e3b701ebf6ee8 | Inspectable boards; firmware; display; printable geometry | Functioning implanted human BCI or biological neural decoder | Credit design progression; develop original SCCI_RH engineering | 2026-10-07 | Direct repository source inspection
