pratham-cloud-ctrl/Project-SCCI-RH/docs/stage2/biological-envelope-audit.csv

audit_id | source_id | primary_url | title | publication_year | access_date | evidence_grade | parameter | reported_or_chosen_value | units | support_scope | not_established | access_status | coordinate_system
S2-ENV-001 | S2-BIO-001 | https://doi.org/10.1038/s41591-025-03614-w | An implantable system to restore hemodynamic stability after spinal cord injury | 2025 | 2026-10-08 | H | cohort | 14 across four trials | participants | SCI; cohort-specific outcomes | healthy consumer performance | publisher and primary full-text XML verified | not applicable
S2-ENV-002 | S2-BIO-001 | https://doi.org/10.1038/s41591-025-03614-w |  | 2025 | 2026-10-08 | H | pressor programming | 120;300;up to20 | Hz;us;mA | purpose-built programs | SCCI_RH recovery waveform; universal dose | primary full-text XML verified | not applicable
S2-ENV-003 | S2-BIO-001 | https://doi.org/10.1038/s41591-025-03614-w |  | 2025 | 2026-10-08 | H | traveling configurations | 3; successive2 | profiles;ms | delayed electrode configurations | three simultaneous drivers required | primary full-text XML verified | not applicable
S2-ENV-004 | S2-BIO-001 | https://doi.org/10.1038/s41591-025-03614-w |  | 2025 | 2026-10-08 | H | earlier width mapping | 100-500;5/6=300;1/6=500 | us | earlier trials | new system always500us | primary full-text XML verified | not applicable
S2-ENV-005 | S2-BIO-001 | https://doi.org/10.1038/s41591-025-03614-w |  | 2025 | 2026-10-08 | H | anatomical region | last three thoracic | spinal segments | pressor hotspot target | identically numbered vertebrae | primary full-text XML verified | spinal segment; subject-specific vertebral mapping
S2-ENV-006 | S2-BIO-001 | https://doi.org/10.1038/s41591-025-03614-w |  | 2025 | 2026-10-08 | H | pressure measurement | 200 raw;1 extracted | Hz | Finometer calibrated pressure/SBP extraction | 250ms link latency; biological response timing | primary full-text XML verified | not applicable
S2-ENV-007 | S2-BIO-001 | https://doi.org/10.1038/s41591-025-03614-w |  | 2025 | 2026-10-08 | H | command link | as low as25 | ms | IPG command execution | complete feedback-loop delay | primary full-text XML verified | not applicable
S2-ENV-008 | S2-BIO-001 | https://doi.org/10.1038/s41591-025-03614-w |  | 2025 | 2026-10-08 | H | load impedance | not numerically established in this audit |  | logs noted | 0.5/1/2kohm sweep as measured cohort load | no transferable numerical chronic-load range verified | not applicable
S2-ENV-009 | S2-BIO-002 | https://doi.org/10.1038/s41591-021-01663-5 | Activity-dependent spinal cord neuromodulation rapidly restores trunk and leg motor functions after complete paralysis | 2022 | 2026-10-08 | H | illustrated burst frequencies | 20 extensor;100 flexor | Hz | three SCI participants; example program | healthy retained skill acceleration | publisher figure7 and author supplement verified | lumbosacral spinal segments/root targets; distinct vertebrae
S2-ENV-010 | S2-BIO-002 | https://doi.org/10.1038/s41591-021-01663-5 |  | 2022 | 2026-10-08 | H | command waveform capacity | up to4;approximately120 | waveforms;ms | supplementary figure1 control chain | four independent biological directions | 15-page primary supplement verified | not applicable
S2-ENV-011 | S2-BIO-002 | https://doi.org/10.1038/s41591-021-01663-5 |  | 2022 | 2026-10-08 | H | current width and load | not verified |  | not inferred from frequency figures | invented numerical motor prescription | publisher figures/supplement accessed; author-hosted full-paper PDF DNS failure | not applicable
S2-ENV-012 | S2-BIO-003 | https://doi.org/10.1038/s41467-026-75128-z | Surface circumferential spinal cord recording in freely moving rodents | 2026 | 2026-10-08 | A | recording cohort | 15 overall;5 motor;3 acute pigs;up to3days | animals;days | short-term intradural surface recordings | human chronic or causal decode | primary full-text XML PMC13487197 verified | thoracolumbar target; no cross-species vertebral conversion
S2-ENV-013 | S2-BIO-003 | https://doi.org/10.1038/s41467-026-75128-z |  | 2026 | 2026-10-08 | A | acquisition | 32;30000 | channels;sample/s | Intan RHS2000 | ATO16stream acquisition equivalence | primary methods verified | not applicable
S2-ENV-014 | S2-BIO-003 | https://doi.org/10.1038/s41467-026-75128-z |  | 2026 | 2026-10-08 | A | motor analysis bands/window | 1-4|4-8|8-12|12-30|30-90|90-200|200-3000;500 | Hz;ms | bidirectional filtered overlapping features | causal1-300Hz pathway sufficiency | primary methods verified | not applicable
S2-ENV-015 | S2-BIO-003 | https://doi.org/10.1038/s41467-026-75128-z |  | 2026 | 2026-10-08 | A | representative RMS | rest20.9-22.1;walking44.2-52.1 | uV RMS | 300-2000Hz single-channel example | human low-band amplitude guarantee | primary figure2f verified | not applicable
S2-ENV-016 | S2-BIO-004 | https://www.bostonscientific.com/content/dam/elabeling/nm/92469342-02_WaveWriter_Alpha_and_WaveWriter_Alpha_Prime_Implantable_Pulse_Generator_multi-OUS_s.pdf | WaveWriter Alpha and WaveWriter Alpha Prime Implantable Pulse Generators Directions for Use | not stated | 2026-10-08 | M | programmable specifications | 0-25.5;20-1000;2-1200;4 | mA;us;Hz;areas | manual92469342-02 printedp4 | all extrema simultaneously;SCCI_RH clinical approval | official PDF read directly | not applicable
S2-ENV-017 | S2-BIO-005 | https://www.bostonscientific.com/content/dam/elabeling/nm/92395591-04_Rev_A_BionicNav_Program_Manual_multi-OUS_s.pdf | Bionic Navigator 3D 4.0 Programming Manual | not stated | 2026-10-08 | M | amplitude times width limits | 12.7 most leads;9.1 4x8 | uC | printedp25 footnoteb | SCCI_RH tissue-safety threshold | official PDF text verified | not applicable
S2-ENV-018 | S2-BIO-005 | https://www.bostonscientific.com/content/dam/elabeling/nm/92395591-04_Rev_A_BionicNav_Program_Manual_multi-OUS_s.pdf |  | not stated | 2026-10-08 | M | area scheduling and recharge | shared-area rate may decrease;symmetric active/asymmetric passive |  | printedpp25-29 | Cartesian max range or guaranteed original study waveform | official PDF text verified | not applicable
S2-ENV-019 | S2-BIO-006 | https://www.medtronic.com/content/dam/medtronic-wide/public/united-states/products/neurological/2023-product-performance-report-neuromodulation.pdf | 2023 Product Performance Report Neuromodulation | 2023 report year | 2026-10-08 | M | contact geometry | 16;1.5x4.0;6.0 | contacts;mm;mm2 | Specify SureScan2x8/5-6-5 tables printedpp161/164 | SCCI_RH anatomical fit;chemical capacity | official manufacturer PDF verified | hardware dimensions only
S2-ENV-020 | S2-BIO-007 | https://doi.org/10.1109/TBME.2014.2366514 | In vivo and in vitro comparison of the charge injection capacity of platinum macroelectrodes | 2015 | 2026-10-08 | A/B | injection capacity transfer | lower in vivo than PBS;site/pulse-width dependent |  | cat macroelectrodes;100-3200us source range | universal safe density for epidural PtIr | primary abstract PubMed25376031 verified; author manuscript link available | not applicable
S2-ENV-021 | S2-BIO-008 | https://doi.org/10.1371/journal.pone.0315779 | Quantification of safe operation conditions for large-area platinum-iridium electrodes in neurostimulation application | 2024 | 2026-10-08 | B | residual and material response | imbalance/residual correlated with dissolution |  | PBS;large Laplace electrodes;20/100ms asymmetry | ATO500us waveform qualification | primary full-text XML PMC11658615 verified | not applicable
S2-ENV-022 | SCCI_RH-DESIGN | SCCI_RH design assumption; see stimulation-budget-inputs.json | Selected numerical SCCI_RH reference | 2026 | 2026-10-08 | D | driver/contact topology | 2 sources;max2 concurrent;16+2 contacts |  | architecture choice | full-rank motor control | declared choice | not applicable
S2-ENV-023 | SCCI_RH-DESIGN | SCCI_RH design assumption; see stimulation-budget-inputs.json |  | 2026 | 2026-10-08 | D | actuator range | 0.1-20;50-500;1-150;10 | mA;us;Hz;uC/phase | joint admission required | independent simultaneous maxima | declared envelope | not applicable
S2-ENV-024 | SCCI_RH-DESIGN | SCCI_RH design assumption; see stimulation-budget-inputs.json |  | 2026 | 2026-10-08 | D | supply/compliance | 48 rail;40 usable terminal;4 combined polarization | V | 8V driver/routing allocation;unfitted reserve | chemical window;real circuit performance | declared budget | not applicable
S2-ENV-025 | SCCI_RH-DESIGN | SCCI_RH design assumption; see stimulation-budget-inputs.json |  | 2026 | 2026-10-08 | D | bulk/interface sweep | 0.5/1/2;1/5/10/50;10/100/1000 | kohm bulk;uF/contact;kohm Rct/contact | unfitted sensitivity model | measured chronic study impedance | declared stress range | not applicable
S2-ENV-026 | SCCI_RH-DESIGN | SCCI_RH design assumption; see stimulation-budget-inputs.json |  | 2026 | 2026-10-08 | D | electrode examples | 6/12 active;24 return | mm2 | geometry-sized hypothesis | anatomical/chemical fit | declared geometry alternative | not applicable
S2-ENV-027 | SCCI_RH-DESIGN | SCCI_RH design assumption; see stimulation-budget-inputs.json |  | 2026 | 2026-10-08 | D | pressure waveform interpretation | 300+100+300;1000 recovery | us | SCCI_RH symmetric interpretation;1msAFEallocation | published recharge equivalence;electrode reset guarantee | declared waveform | not applicable
S2-ENV-028 | SCCI_RH-DESIGN | SCCI_RH design assumption; see stimulation-budget-inputs.json |  | 2026 | 2026-10-08 | D | converter efficiency | 0.8 | fraction | unvalidated no-regeneration allocation | constant physical efficiency | declared power model | not applicable
S2-ENV-029 | SCCI_RH-CALCULATION | SCCI_RH design assumption; see stimulation-budget-inputs.json | Joint envelope calculations | 2026 | 2026-10-08 | D | nominal pressure rail/battery stimulation | 207.36;259.2 | mW | 3 profiles20mA300us120Hz48Vrail80percent | whole-device thermal closure | calculated in JSON | not applicable
S2-ENV-030 | SCCI_RH-CALCULATION | SCCI_RH design assumption; see stimulation-budget-inputs.json |  | 2026 | 2026-10-08 | D | 2kohm current ceiling | 18 without extra blocking drop;17 with2V blocking | mA | 40Vusable minus4Vpolarization assumption | guaranteed safe current | calculated inequality | not applicable
S2-ENV-031 | SCCI_RH-CALCULATION | SCCI_RH design assumption; see stimulation-budget-inputs.json |  | 2026 | 2026-10-08 | D | recovery failure | 13.2458 | ms | two5uFinterfaces series;1kohm;4Vto20mV | 1ms reset;chemical safety | calculated ideal exponential | not applicable
S2-ENV-032 | SCCI_RH-DESIGN | SCCI_RH design assumption; see stimulation-budget-inputs.json |  | 2026 | 2026-10-08 | D | material and signed template | candidatePtIr90/10;negative first/positive second equal active phases |  | SCCI_RH material/waveform hypothesis | chronic chemistry;published pressure waveform equivalence | declared choice | not applicable
