pratham-cloud-ctrl/Project-SCCI-RH/cad/exports/scci_rh-desktop-assembly.step

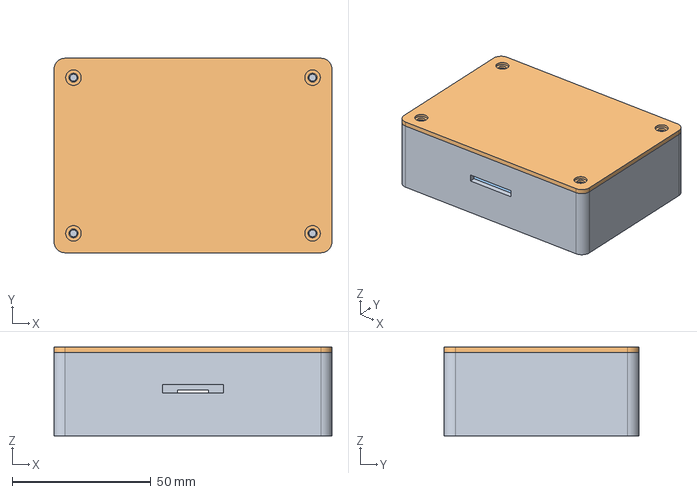
[picture p96: CAD file, 2026-10-29]
cad/exports/scci_rh-desktop-assembly.step
100.0 x 70.0 x 32.0 mm
