pratham-cloud-ctrl/Project-SCCI-RH/cad/stage5/SCCI_RH_stage5_reference_full.FCStd

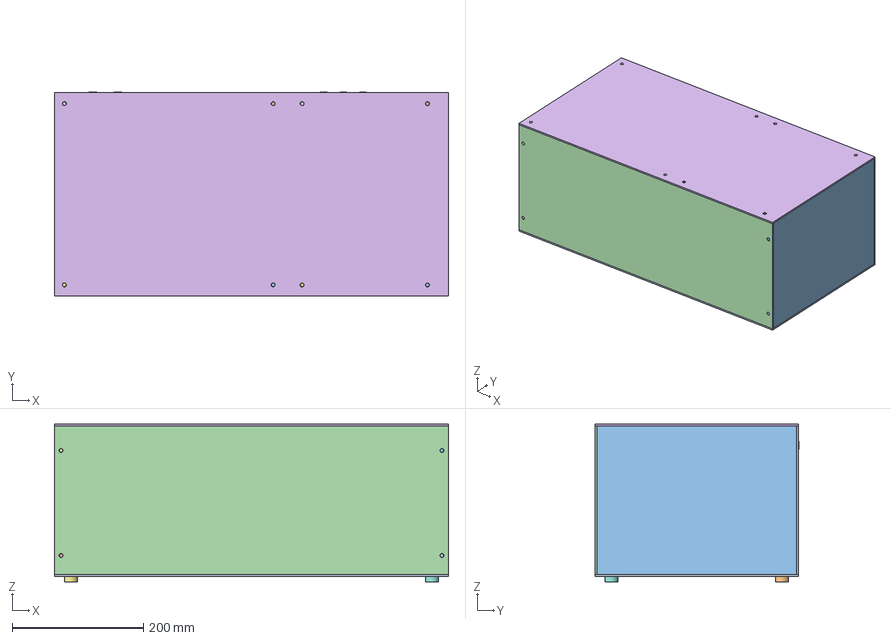
[picture p97: CAD file, 2026-10-29]
cad/stage5/SCCI_RH_stage5_reference_full.FCStd
600.0 x 311.0 x 240.0 mm
Base
SideLeft
SideRight
FrontBracket_0_0
FrontScrew_0_0
FrontBracket_0_1
FrontScrew_0_1
FrontBracket_1_0
FrontScrew_1_0
FrontBracket_1_1
FrontScrew_1_1
FrontPanel
RearPanel
Post_0_0
LidScrew_0_0
Post_0_1
LidScrew_0_1
Post_1_0
LidScrew_1_0
Post_1_1
LidScrew_1_1
Post_2_0
LidScrew_2_0
Post_2_1
LidScrew_2_1
Post_3_0
LidScrew_3_0
Post_3_1
LidScrew_3_1
Lid
Foot_0
Foot_1
Foot_2
Foot_3
Rail_left_0_left
Rail_left_0_right
Rail_left_1_left
Rail_left_1_right
Rail_left_2_left
Rail_left_2_right
Rail_left_3_left
Rail_left_3_right
Rail_right_0_left
Rail_right_0_right
Rail_right_1_left
Rail_right_1_right
Rail_right_2_left
Rail_right_2_right
Rail_right_3_left
Rail_right_3_right
Standoff_contact_router_H1
UpperScrew_contact_router_H1
LowerScrew_contact_router_H1
Standoff_contact_router_H2
UpperScrew_contact_router_H2
LowerScrew_contact_router_H2
Standoff_contact_router_H3
UpperScrew_contact_router_H3
LowerScrew_contact_router_H3
Standoff_contact_router_H4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
