pratham-cloud-ctrl/Project-SCCI-RH/cad/stage5/reference/SCCI_RH_reference_assembly.FCStd

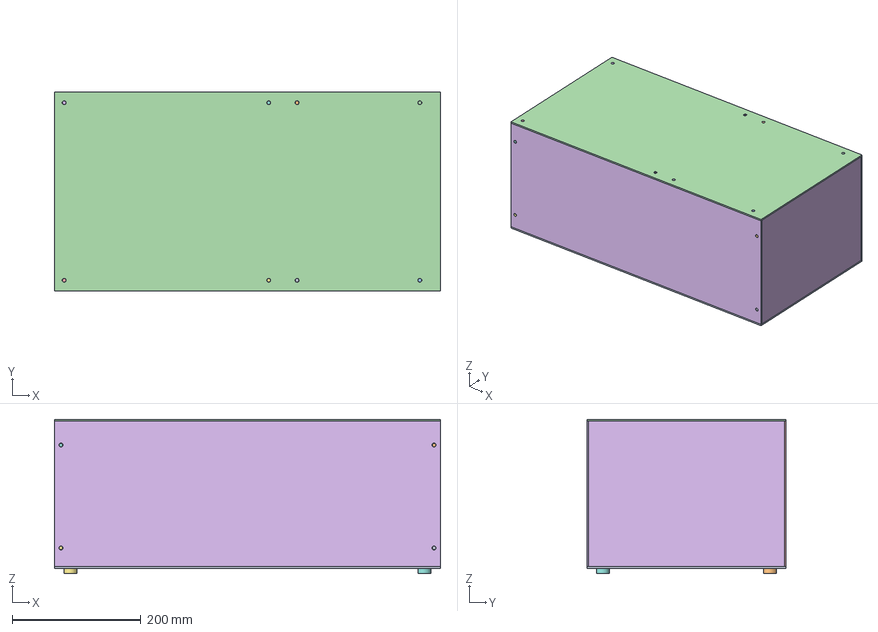
[picture p99: CAD file, 2026-10-29]
cad/stage5/reference/SCCI_RH_reference_assembly.FCStd
600.0 x 310.0 x 240.0 mm
Base
Post_0_0
Post_0_1
Post_1_0
Post_1_1
Post_2_0
Post_2_1
Post_3_0
Post_3_1
FrontBracket_0_0
FrontBracket_0_1
FrontBracket_1_0
FrontBracket_1_1
FrontPanel
FrontScrew_0_0
FrontScrew_0_1
FrontScrew_1_0
FrontScrew_1_1
SideLeft
Lid
LidScrew_0_0
LidScrew_0_1
LidScrew_1_0
LidScrew_1_1
LidScrew_2_0
LidScrew_2_1
LidScrew_3_0
LidScrew_3_1
LowerScrew_contact_router_H1
LowerScrew_contact_router_H2
LowerScrew_contact_router_H3
LowerScrew_contact_router_H4
LowerScrew_controller_carrier_H1
LowerScrew_controller_carrier_H2
LowerScrew_controller_carrier_H3
LowerScrew_controller_carrier_H4
LowerScrew_current_driver_H1
LowerScrew_current_driver_H2
LowerScrew_current_driver_H3
LowerScrew_current_driver_H4
LowerScrew_monitoring_cell_H1
LowerScrew_monitoring_cell_H2
LowerScrew_monitoring_cell_H3
LowerScrew_monitoring_cell_H4
LowerScrew_monitoring_transport_H1
LowerScrew_monitoring_transport_H2
LowerScrew_monitoring_transport_H3
LowerScrew_monitoring_transport_H4
LowerScrew_power_H1
LowerScrew_power_H2
LowerScrew_power_H3
LowerScrew_power_H4
LowerScrew_recording_front_end_H1
LowerScrew_recording_front_end_H2
LowerScrew_recording_front_end_H3
LowerScrew_recording_front_end_H4
LowerScrew_supervision_H1
LowerScrew_supervision_H2
LowerScrew_supervision_H3
LowerScrew_supervision_H4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
