pratham-cloud-ctrl/Project-SCCI-RH/cad/stage5/future-interface/SCCI_RH_future_interface_exploded.step

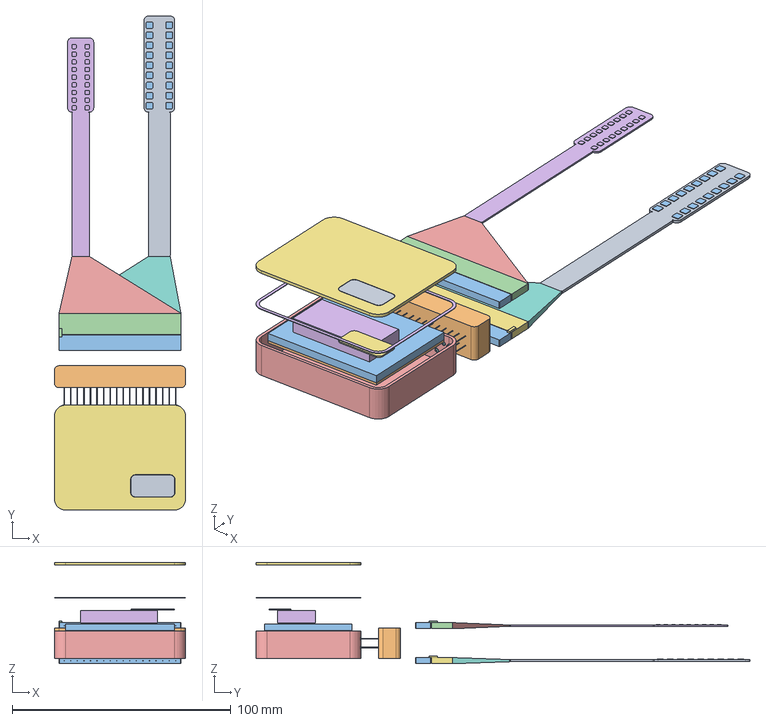
[picture p101: CAD file, 2026-10-29]
cad/stage5/future-interface/SCCI_RH_future_interface_exploded.step
60.0 x 226.0 x 46.4 mm
