pratham-cloud-ctrl/Project-SCCI-RH/cad/stage5/reference/SCCI_RH_reference_mechanical.step

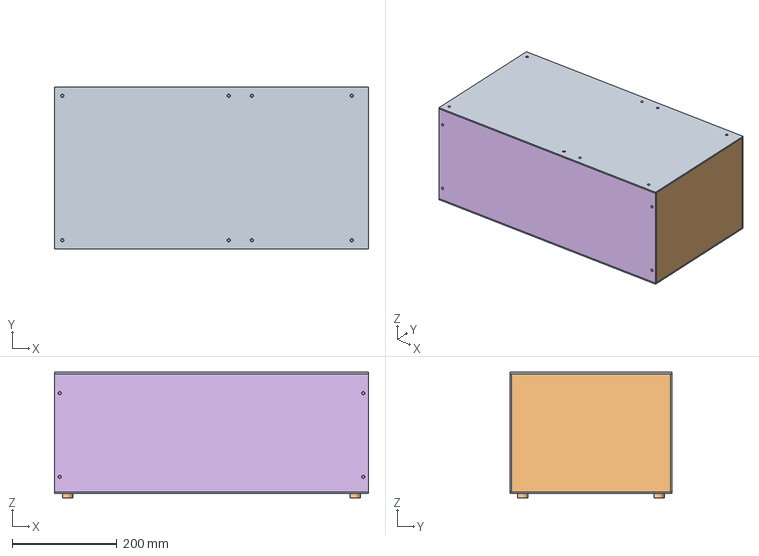
[picture p102: CAD file, 2026-10-29]
cad/stage5/reference/SCCI_RH_reference_mechanical.step
600.0 x 310.0 x 240.0 mm
