pratham-cloud-ctrl/Project-SCCI-RH/electronics/exports/scci_rh_reference.step

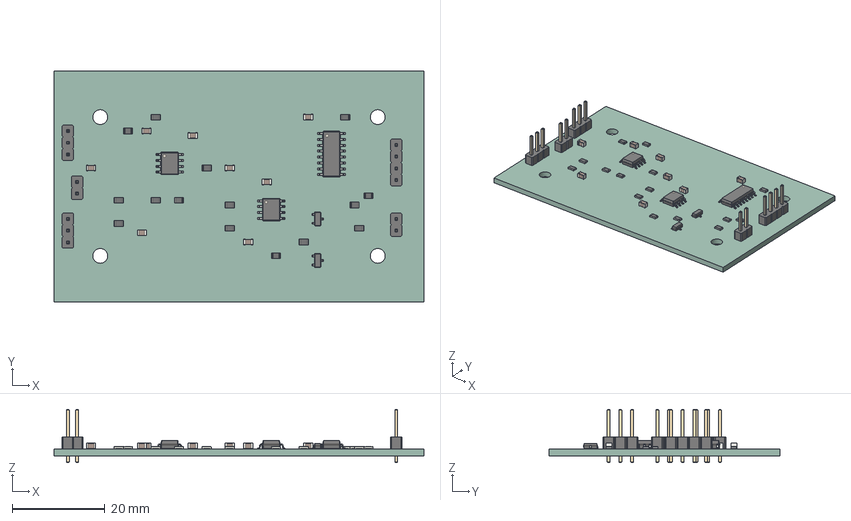
[picture p103: CAD file, 2026-10-29]
electronics/exports/scci_rh_reference.step
80.0 x 50.0 x 11.5 mm
R_0805_2012Metric x 15
C_0805_2012Metric x 8
SOIC-8_3.9x4.9mm_P1.27mm x 2
SOT-23 x 2
PinHeader_1x02_P254mm_Vertical x 2
PinHeader_1x03_P254mm_Vertical x 2
PinHeader_1x04_P254mm_Vertical
SOIC-16_3.9x9.9mm_P1.27mm
scci_rh_reference_PCB
