pratham-cloud-ctrl/Project-SCCI-RH/inspector/downloads/SCCI_RH_Future_Interface.step

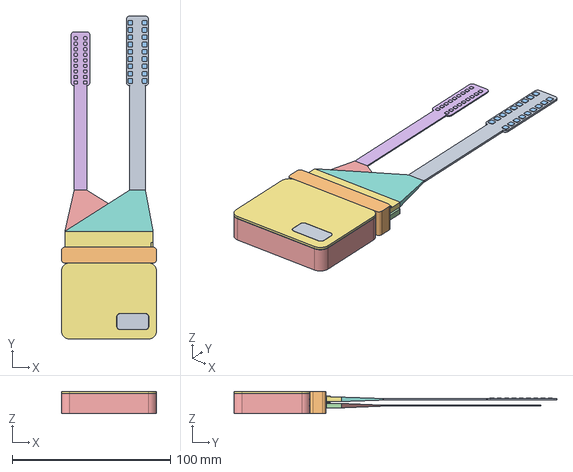
[picture p104: CAD file, 2026-10-29]
inspector/downloads/SCCI_RH_Future_Interface.step
60.0 x 204.0 x 14.0 mm
