pratham-cloud-ctrl/Project-SCCI-RH/cad/stage5/harness/SCCI_RH_mating_interfaces.step

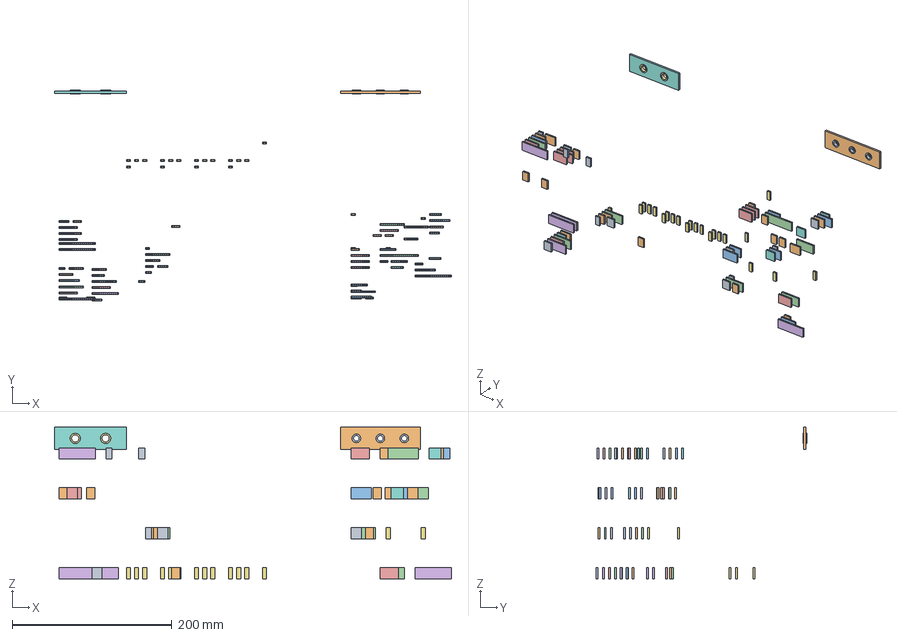
[picture p105: CAD file, 2026-10-29]
cad/stage5/harness/SCCI_RH_mating_interfaces.step
497.1 x 263.7 x 189.8 mm
Mate_contact_router_J40001
Mate_contact_router_J40002
Mate_contact_router_J40003
Mate_contact_router_J40004
Mate_contact_router_J40005
Mate_contact_router_J40006
Mate_contact_router_J40007
Mate_contact_router_J40100
Mate_contact_router_J40200
Mate_controller_carrier_J80001
Mate_controller_carrier_J80002
Mate_controller_carrier_J80010
Mate_controller_carrier_J80011
Mate_controller_carrier_J80012
Mate_controller_carrier_J80013
Mate_controller_carrier_J80014
Mate_controller_carrier_J80015
Mate_controller_carrier_J80016
Mate_controller_carrier_J80017
Mate_controller_carrier_J80018
Mate_controller_carrier_J80019
Mate_controller_carrier_J80020
Mate_current_driver_J20001
Mate_current_driver_J20002
Mate_current_driver_J20003
Mate_current_driver_J20004
Mate_current_driver_J20005
Mate_current_driver_J20100
Mate_current_driver_J20200
Mate_monitoring_cell_J10001
Mate_monitoring_cell_J10002
Mate_monitoring_cell_J10003
Mate_monitoring_cell_J10004
Mate_monitoring_cell_J10100
Mate_monitoring_cell_J10200
Mate_monitoring_cell_J19901
Mate_monitoring_transport_J70001
Mate_monitoring_transport_J70002
Mate_monitoring_transport_J70003
Mate_monitoring_transport_J70004
Mate_monitoring_transport_J70005
Mate_monitoring_transport_J70006
Mate_monitoring_transport_J70007
Mate_monitoring_transport_J70008
Mate_monitoring_transport_J70020
Mate_monitoring_transport_J70022
Mate_power_J60001
Mate_power_J60002
Mate_power_J60003
Mate_power_J60004
Mate_power_J60005
Mate_power_J60006
Mate_recording_front_end_J30001
Mate_recording_front_end_J30002
Mate_recording_front_end_J30003
Mate_recording_front_end_J39901
Mate_recording_front_end_J39902
Mate_supervision_J50001
Mate_supervision_J50002
Mate_supervision_J50003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
