pratham-cloud-ctrl/Project-SCCI-RH/inspector/downloads/SCCI_RH_controller-carrier.step

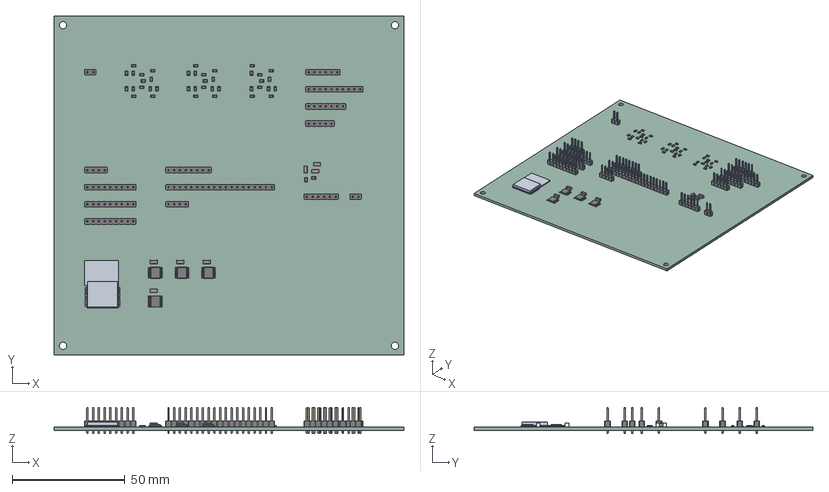
[picture p109: CAD file, 2026-10-29]
inspector/downloads/SCCI_RH_controller-carrier.step
155.0 x 150.0 x 11.5 mm
C_1206_3216Metric x 7
PinHeader_1x09_P254mm_Vertical x 3
PinHeader_1x07_P254mm_Vertical
R_0805_2012Metric x 42
TSSOP-16_4.4x5mm_P0.65mm x 4
PinHeader_1x08_P254mm_Vertical
PinHeader_1x04_P254mm_Vertical x 2
PinHeader_1x06_P254mm_Vertical x 2
PinHeader_1x02_P254mm_Vertical x 2
PinHeader_1x05_P254mm_Vertical
PinHeader_1x19_P254mm_Vertical
PinHeader_1x10_P254mm_Vertical
controller_carrier_PCB
