pratham-cloud-ctrl/Project-SCCI-RH/inspector/downloads/SCCI_RH_supervision.step

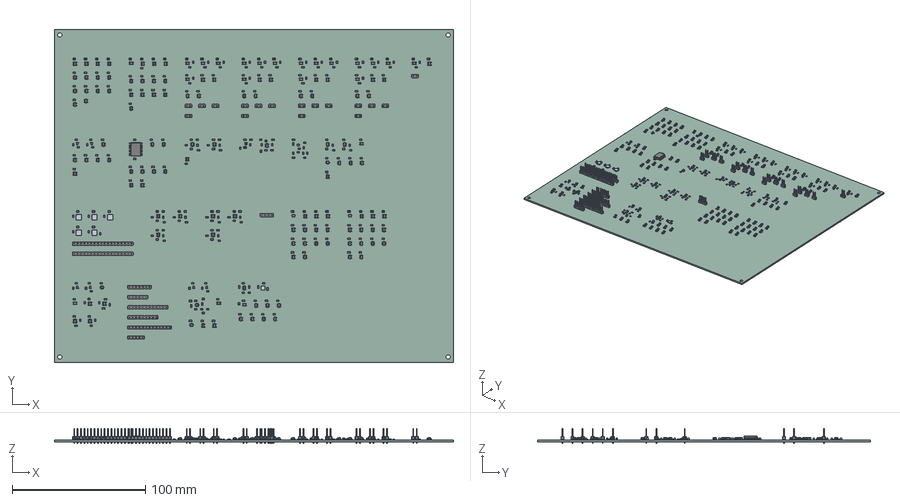
[picture p112: CAD file, 2026-10-29]
inspector/downloads/SCCI_RH_supervision.step
300.0 x 250.0 x 11.5 mm
VSSOP-8_2.3x2mm_P0.5mm x 28
R_0805_2012Metric x 134
C_0805_2012Metric x 160
PinHeader_1x02_P254mm_Vertical x 17
SOT-23-5 x 66
PinHeader_1x07_P254mm_Vertical
SOT-23-6 x 45
PinHeader_1x13_P254mm_Vertical
SOT-353_SC-70-5 x 7
PinHeader_1x12_P254mm_Vertical
PinHeader_1x06_P254mm_Vertical
PinHeader_1x04_P254mm_Vertical
D_SOD-323 x 4
TSOT-23-6 x 2
PinHeader_1x18_P254mm_Vertical x 2
SOIC-16W_7.5x10.3mm_P1.27mm
PinHeader_1x09_P254mm_Vertical
PinHeader_1x05_P254mm_Vertical
supervision_PCB
