pratham-cloud-ctrl/Project-SCCI-RH/(list of files, cad)

Other CAD files:
cad/scci_rh-reference.FCStd
cad/stage5/harness/SCCI_RH_harness_routes.FCStd
cad/stage5/SCCI_RH_reference_inspection.stl
cad/exports/scci_rh-desktop-assembly.stl
cad/scci_rh-exploded.blend
cad/scci_rh-presentation.blend
cad/stage2/SCCI_RH_stage2_allocation.FCStd
cad/stage5/future-interface/SCCI_RH_future_interface.FCStd
cad/stage5/future-interface/SCCI_RH_future_interface.stl
cad/stage5/future-interface/SCCI_RH_future_interface_exploded.FCStd
cad/stage5/harness/SCCI_RH_mating_interfaces.FCStd
cad/stage5/renders/SCCI_RH_engineering_assemblies.blend
