pratham-cloud-ctrl/Project-SCCI-RH/cad/stage5/renders/future_assembled.png

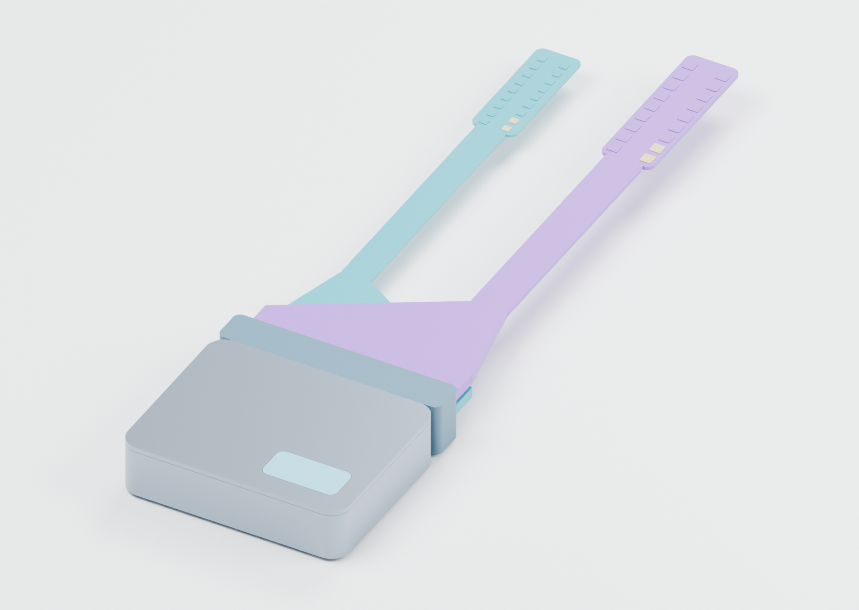
cad/stage5/renders/future_assembled.png
