pratham-cloud-ctrl/Project-SCCI-RH/experiments/stage3/observed-state-observer/frozen/observer-confirmation-handoff-12oct.md

# Frozen observer confirmation handoff

12 October 2026. This standalone TMP-ONLY study is complete. No authoritative
predictor, qualification context, isolated pilot, stimulation, paper claim or
runtime was changed. The earlier pilot's zero-launch outcome remains intact.

## Result and limits

The one pre-reviewed ten-state observed-data observer passed the finite
confirmation arithmetic on all 16 predeclared fresh sensor-noise pairs, both
2.5 ms and 1.25 ms body grids: 32 captures, 17,600 current supports, all 26
horizons and 915,200 coordinate residuals. There were no unavailable declared
supports, excluded cases, failed captures or changed paired-grid budget
decisions. The conservative maximum across every condition and both grids was
8.353736 mm observed component residual + the unchanged 3 mm label allocation
= 11.353736 mm, within the unchanged 15 mm forecast budget.

The peak was at support 0.105 s, target 0.240 s, 135 ms horizon, left coordinate,
noise pair09 on the 2.5 ms grid. Pair09's private producer condition was the
harmful family / scale1; this provenance was never an observer input or selector.
The corresponding fine-grid allocation was 11.351123 mm.

| Paired grid diagnostic | Largest difference |
| --- | ---: |
| Observed position | 3.231031 micrometers |
| Observer forecast | 3.941148 micrometers |
| Observed residual | 5.284652 micrometers |
| Changed horizon budget decisions | 0 |

These are two grids of the same synthetic model, not continuum or biological
truth. Independence is sensor noise only: subject seed2, finite scales, known
cue and underlying learning-law alternatives were the same declared domain
inspected in development. Four named families reduce to two distinct no-dose
learning equations. No human, new-subject, neural-information, assistance,
expert-transfer, physiology-automation or retained-learning result is implied.
The conditional exact60 ms structural prior remains explicit. The 25 mm
combined correction gate was not evaluated, altered or removed.

The development result remains separately labeled: 16/16 already inspected
drift records, largest allocation12.418841 mm; 8/8 temporal calibration
holdouts, largest9.409502 mm. Those data motivated the model and are not fresh
confirmation. Only the frozen fresh-noise cohort above is confirmation here.

## Review and verification chain

The root agent independently reviewed the method before development scoring,
then separately reviewed the complete confirmation protocol/producer, immutable
preflight receipt, full source manifest and seed/cohort plan before the first
fresh sensor-noise draw. `observer-confirmation-root-review-12oct.md` was saved
before the single generation command. There was one confirmation run, no refit,
no additional variant and no post-outcome source/settings/gate revision.

The independent saved-data auditor regenerated no body or noise. It verified all
21 `src/scci_rh/**/*.py` source byte hashes, original observer/method/calibration
bindings, all raw segment hashes, exact future measured labels, all915,200
residuals, maxima/allocations/witnesses, complete coverage and the conservative
cohort aggregate. It checked the saved shared noise's float64 hash and its
actual injection into both private positions; maximum addition/subtraction
roundoff was6.939e-18 m. Sixteen IDs and actual noise-array hashes are distinct
across pairs and excluded from all25 prior recorded calibration/development
IDs. Reuse within each grid pair is intentional and explicit.

Earlier independent dynamics/causality/noise checks remain in
`observer-independent-check-12oct.json`: differential-equation F/Q, quadrature,
semigroup, zero-noise, reversal continuity, causal derivative/noise propagation,
future poisoning, identifier invariance, clock/gap/startup and invalid-state
rejection. Conditional covariance never replaced the empirical maximum-error
arithmetic. This handoff does not claim a fresh deterministic full-study rerun;
the optional producer `--check-after-root-review` exists but was not run here.

## Exact dependencies and portable layout

All paths below are relative to `E:/Project SCCI RH/`; files actually remain in tmp.
The frozen observer expects its original filenames under study-root/tmp. The
producer expects the full verified `src/scci_rh` tree under study-root/src. A later
portable driver can construct this scratch layout without changing the frozen
algorithm. Since its full source manifest is immutable, a later changed source
tree must not silently be used; preserve/recover the pinned source bytes.

Required input observations:

- `tmp/phase_balanced_longcal_observations_12oct.json.gz` (498,723 bytes): eight
  measured12 s calibration records;64 s fit and32 s temporal holdout,96 s total.
- `tmp/drift_forecast_exploratory_observations_12oct.json.gz` (313,984 bytes): the
  already inspected16 drift records plus the unused nominal record. It binds
  development targets/provenance and all prior noise exclusions, not fresh
  confirmation fitting.

Frozen method and checks:

- `tmp/observer-protocol-12oct.md`
- `tmp/observed_state_observer_12oct.py`
- `tmp/observer-method-freeze-12oct.json`
- `tmp/observer-review-approval-12oct.md`
- `tmp/observer-independent-check-12oct.py` and `.json`
- `tmp/observer-development-summary-12oct.json`
- `tmp/observer-development-raw-12oct.json.gz` (29,340,888 bytes)
- `tmp/observer-saved-data-audit-12oct.py` and `.json`
- `tmp/observer-findings-next-integration-12oct.md`

Confirmation inputs/source/review and outputs:

- `tmp/observer-confirmation-protocol-12oct.md`
- `tmp/observer-confirmation-12oct.py`
- `tmp/observer-confirmation-freeze-12oct.json`
- `tmp/observer-confirmation-root-review-12oct.md`
- `tmp/observer-confirmation-pair-00-12oct.json.gz` through
  `tmp/observer-confirmation-pair-15-12oct.json.gz` (36,040,020 bytes total;
  largest segment2,255,198 bytes, each below50 MB)
- `tmp/observer-confirmation-summary-12oct.json`
- `tmp/observer-confirmation-saved-audit-12oct.py` and `.json`
- `tmp/observer-confirmation-handoff-12oct.md`

Exclude `observer-confirmation-unapproved-freeze-initial-12oct.json` from the
published package; it is a preserved pre-review draft with only two direct
source hashes, superseded before any fresh capture was generated.

Runtime: Python3.12.14, NumPy2.3.5 and SciPy1.18.1, one BLAS thread. Observer math
uses only NumPy/stdlib; producer imports SciPy.signal transitively from the
existing motor module. The independent propagation oracle uses SciPy.integrate.
Confirmation computation/segment-writing took184.901 s; saved-data audit5.841 s.
The desktop cache's maximum1,638,400-byte float64 payload exceeds the proposed
512 KB target RAM before Python overhead. No MCU timing/memory claim is earned.

## Frozen identities

| Artifact | SHA256 |
| --- | --- |
| Observer source | `203a5bdd90ae20a67f1b6475b47c31a73880d96a5c4434957b51f28a2f767c44` |
| Method receipt | `1157a4490d4455faba6773fe447560b22c218db852efe65fc95c180f373dce7f` |
| Confirmation producer/evaluator | `7c7729caa49cac204c2edc8be81bc9ba11e3ae6b4ec2bd26ac129c18b087978d` |
| Confirmation protocol | `32cbc703e850983dc0032a1b1000fac6d68e323b503917f03c2bddd6cac3f608` |
| Immutable confirmation preflight | `6e4725e801f3e7e9eb88d0c9e40520c6ea0b462f9776cf4adb5831d6d6dcbac0` |
| Confirmation summary | `89d79c3d3eb3dafb62964ed4d15ae922c4a1b7e775ea612d8b9d7d1c0cb65a59` |
| Saved-data auditor source | `6653be722ec0a68f6abd9336f55eee3e02bb449c7f1961cc466e320f6310fb10` |
| Saved-data audit result | `476a36b3e2731f30ac6269ffc5cccdf1e852a7fb98bd2c8a5f0a3e4af566d378` |

Per-pair raw hashes are in the confirmation summary and saved-data audit.

## Next integration decision

The bounded no-dose observer study can be packaged now as a separate research
contribution. It does not by itself close Stage3's integrated active intervention
questions. To use this observer in the existing single-admission pilot, the
smallest defensible next contract is a genuine pre-dose forecast freeze, followed
by independently observed pending-response monitoring, full uncertainty/dose
arithmetic and residual cancellation. Continuous active use instead requires
causal whole-prefix response correction/uncertainty or an augmented state model.
Do not feed stimulation-contaminated positions into an unassisted observer.
Any integration must be separately reviewed and preserve conservative finite
support/empty-action scope and identical model/history/prior access across arms.
