pratham-cloud-ctrl/Project-SCCI-RH/experiments/stage3/observed-state-observer/frozen/observer-confirmation-root-review-12oct.md

# Independent root review before fresh capture generation

12 October 2026. This record was saved before the producer was run or any
confirmation sensor-noise draw was generated.

Root review message:

> ROOT PRE-GENERATION REVIEW APPROVED. Independently read complete protocol/
> producer, checked finite cohort/order, exact shared paired noise, sanitized
> runtime observations, fixed coverage/horizons, fullsrc byte manifest, immutable
> preflight, original observer/method bindings, unchanged gates and no-dose-only
> interpretation. Approved producer
> 7c7729caa49cac204c2edc8be81bc9ba11e3ae6b4ec2bd26ac129c18b087978d;
> protocol32cbc703e850983dc0032a1b1000fac6d68e323b503917f03c2bddd6cac3f608;
> receipt6e4725e801f3e7e9eb88d0c9e40520c6ea0b462f9776cf4adb5831d6d6dcbac0.
> Save exact review record in tmp/observer-confirmation-root-review-12oct.md
> BEFORE running, then execute one --run-after-root-review referencing that file.
> No refit or revisions after outcomes. Report full coverage/failures and preserve
> original results. After run, independently audit saved raw targets/residuals/
> aggregates/sharednoise/hash bindings without regenerating/tuning.

This approves the bounded digital calculation. It is not approval for physical
stimulation, clinical/biological claims, an authoritative predictor replacement,
or any pilot/runtime change.
