pratham-cloud-ctrl/Project-SCCI-RH/experiments/stage3/observed-state-observer/frozen/observer-review-approval-12oct.md

# Pre-score independent review

The root agent independently reviewed the protocol, implementation, calibration
receipt and independent propagation/causality/noise check outputs before this
agent loaded or scored the sixteen development drift targets.

Frozen implementation SHA256:
`203a5bdd90ae20a67f1b6475b47c31a73880d96a5c4434957b51f28a2f767c44`

Frozen method receipt SHA256:
`1157a4490d4455faba6773fe447560b22c218db852efe65fc95c180f373dce7f`

Root review message, 12 October 2026:

> Root independently reviewed revised protocol/source/receipt and check outputs;
> the timing issues are addressed and no remaining blocking issue found for this
> bounded development exercise. Approved to score the existing 16 development
> recordings and 8 temporal holdouts with EXACT frozen source and receipt,
> unchanged settings/gates. Record this review message/reference and both hashes
> in score outputs. No additional tuning after seeing outcomes. Full integration/
> fresh confirmation remains separate; desktop cache is not MCU evidence.

This is engineering review of a bounded development calculation. It is not
independent scientific confirmation or authorization to stimulate.
