pratham-cloud-ctrl/Project-SCCI-RH/electronics/exports/scci_rh_reference_schematic.pdf

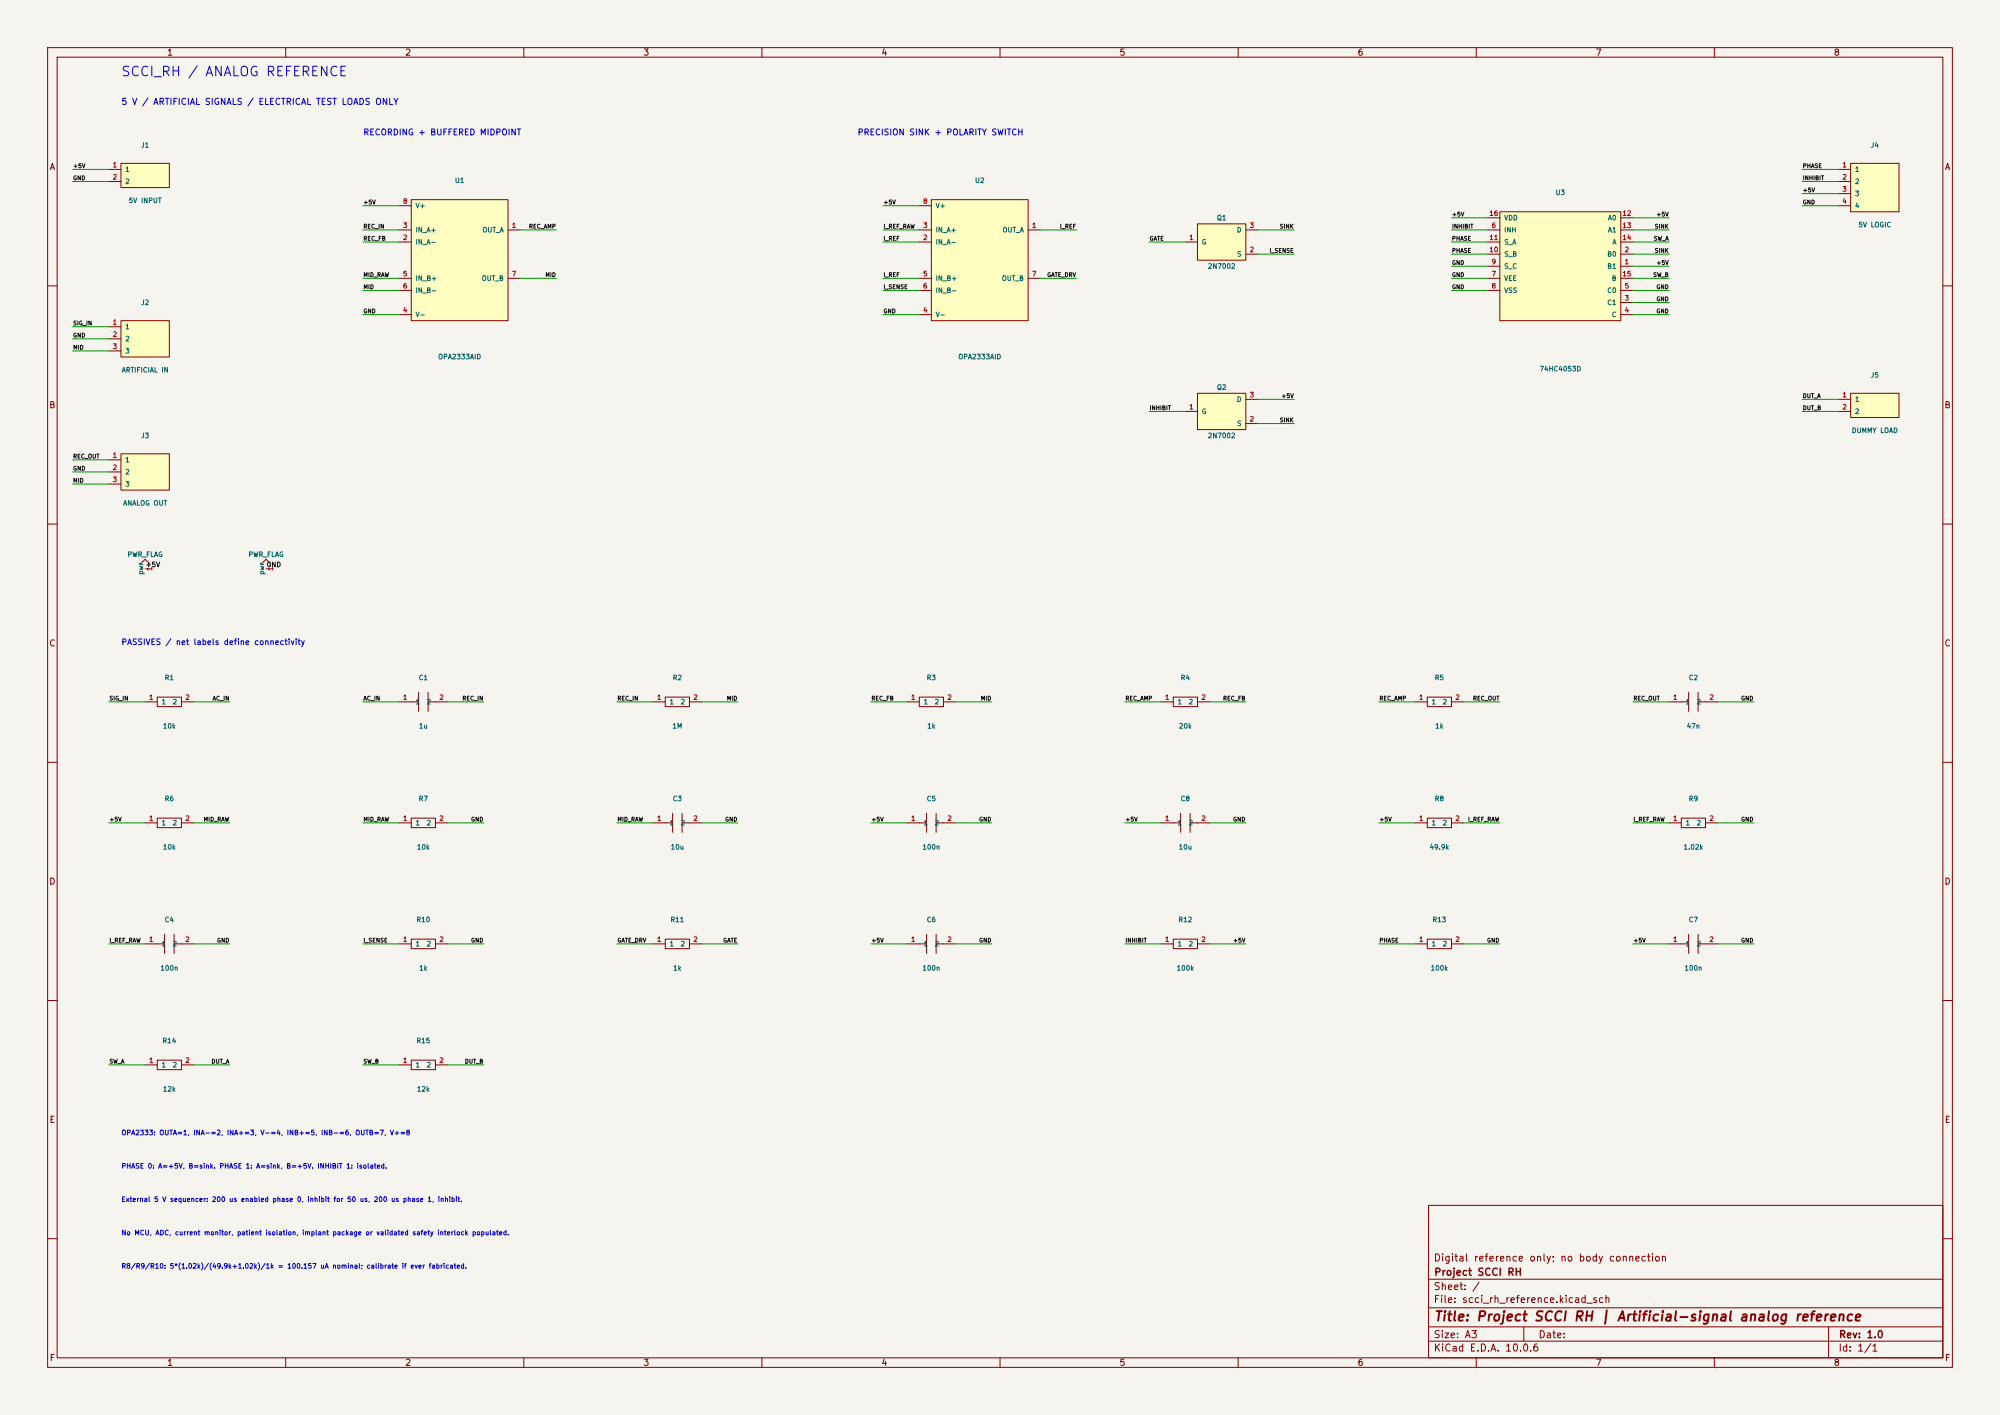
[picture p116: page 1]

5 V / ARTIFICIAL SIGNALS / ELECTRICAL TEST LOADS ONLY SCCI_RH / ANALOG REFERENCE

+5V PASSIVES / net labels define connectivity

OPA2333: OUTA=1, INA-=2, INA+=3, V-=4, INB+=5, INB-=6, OUTB=7, V+=8 PHASE 0: A=+5V, B=sink. PHASE 1: A=sink, B=+5V. INHIBIT 1: isolated. External 5 V sequencer: 200 us enabled phase 0, inhibit for 50 us, 200 us phase 1, inhibit. No MCU, ADC, current monitor, patient isolation, implant package or validated safety interlock populated. R8/R9/R10: 5*(1.02k)/(49.9k+1.02k)/1k = 100.157 uA nominal; calibrate if ever fabricated.

Digital reference only; no body connection
Project SCCI RH
Sheet: /
File: scci_rh_reference.kicad_sch
Title: Project SCCI RH | Artificial-signal analog reference

Size: A3 | Rev: 1.0 | F Date:
KiCad E.D.A. 10.0.6 | Id: 1/1
