pratham-cloud-ctrl/Project-SCCI-RH/electronics/stage4/controller-carrier/controller_carrier.pdf

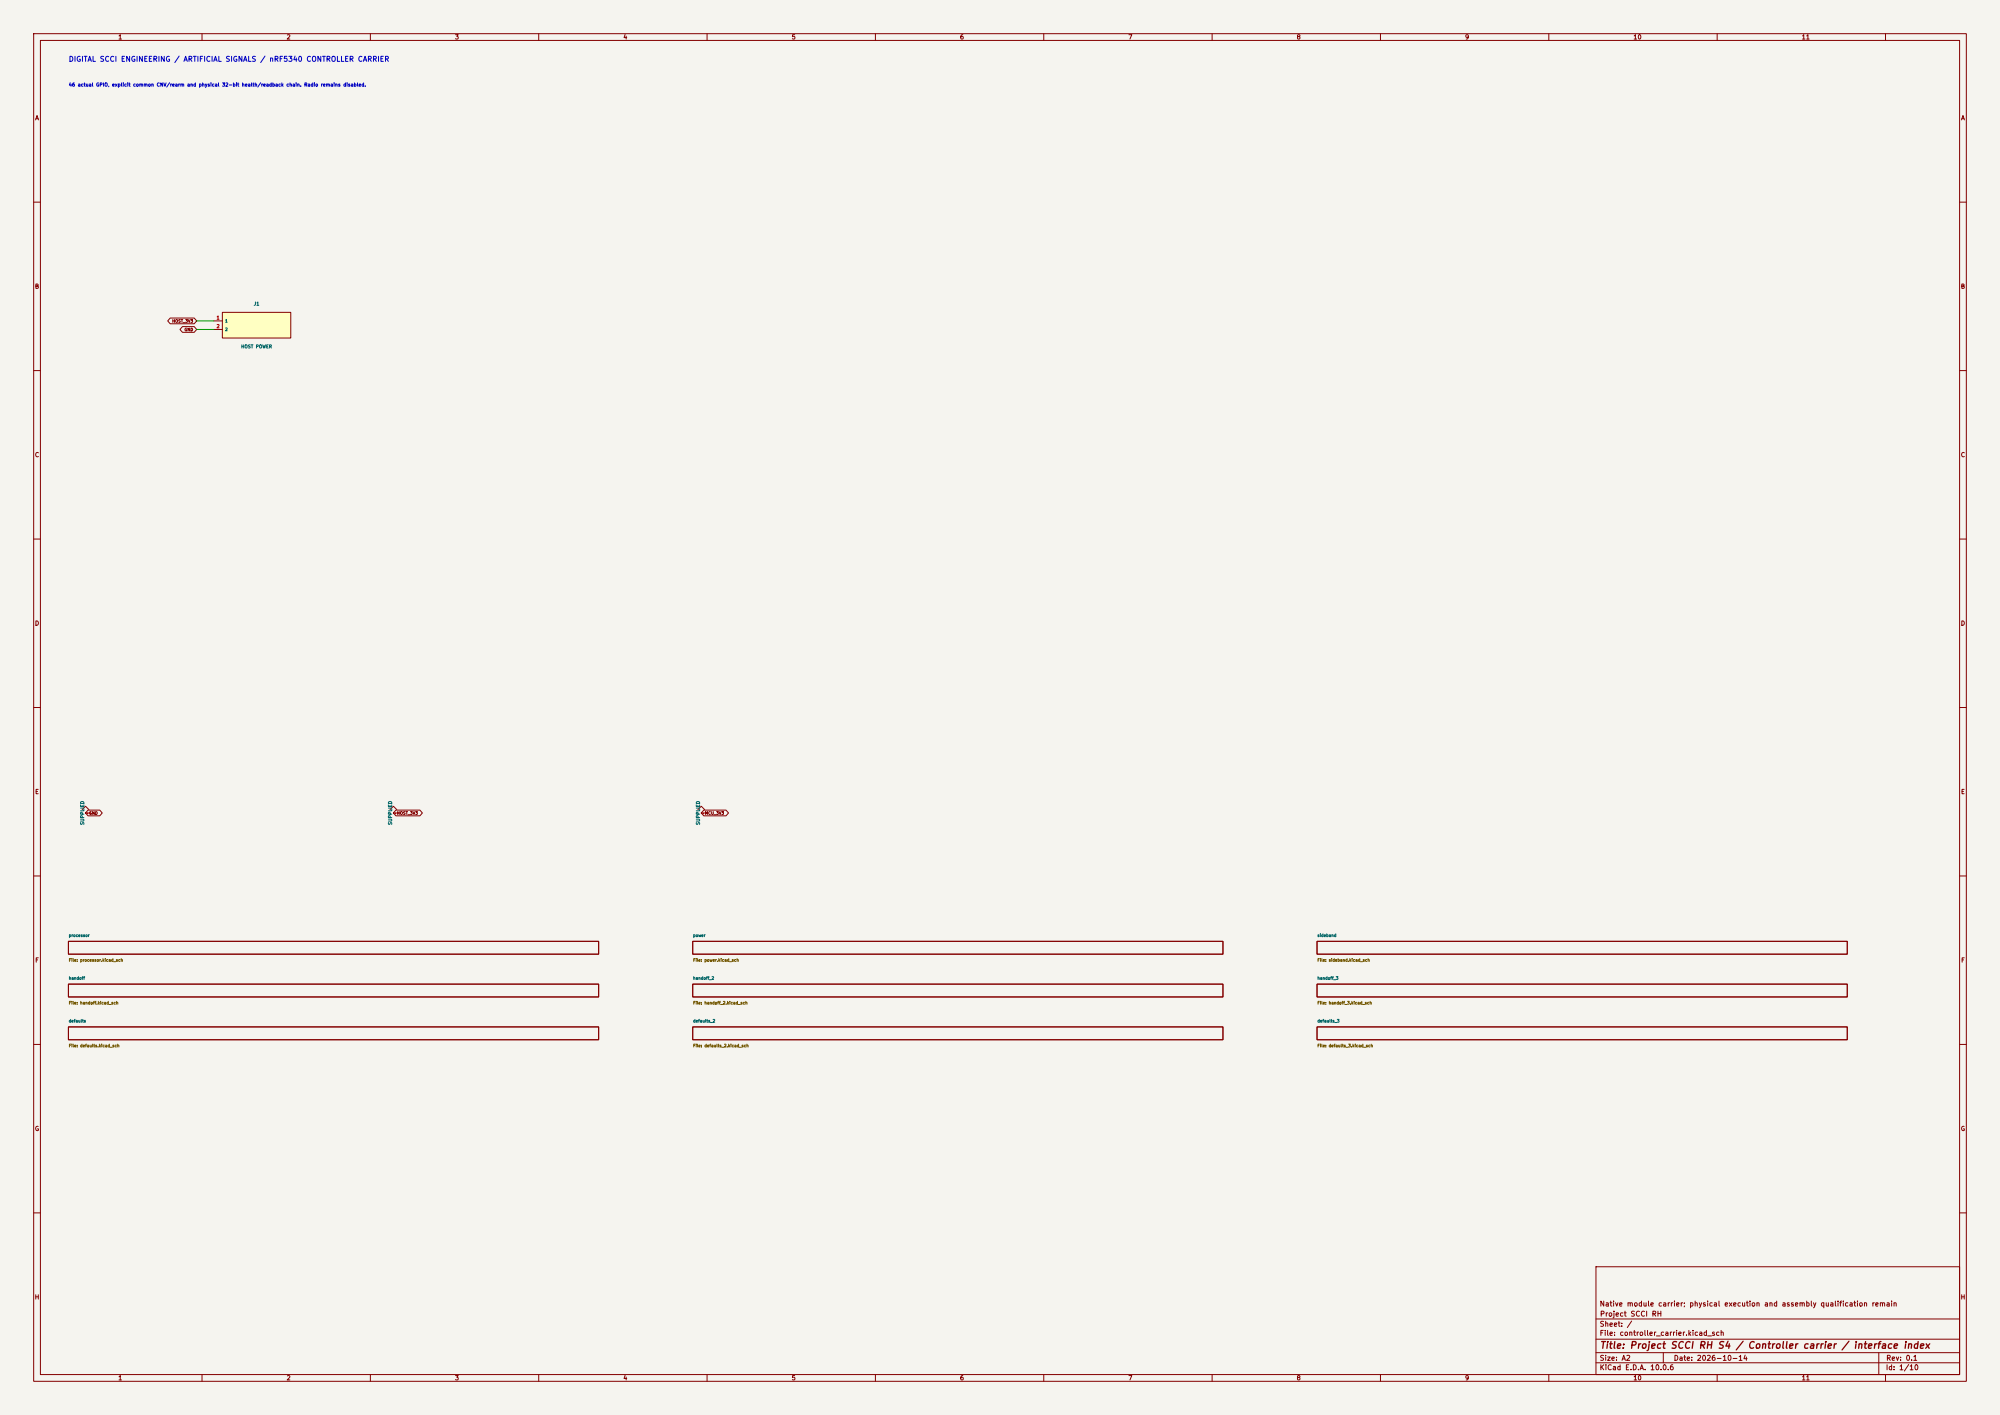
[picture p159: page 1]

46 actual GPIO, explicit common CNV/rearm and physical 32-bit health/readback chain. Radio remains disabled. DIGITAL SCCI ENGINEERING / ARTIFICIAL SIGNALS / nRF5340 CONTROLLER CARRIER

Native module carrier; physical execution and assembly qualification remain
Project SCCI RH
Sheet: /
File: controller_carrier.kicad_sch
Title: Project SCCI RH S4 / Controller carrier / interface index

Size: A2 | Rev: 0.1
KiCad E.D.A. 10.0.6 | Id: 1/10

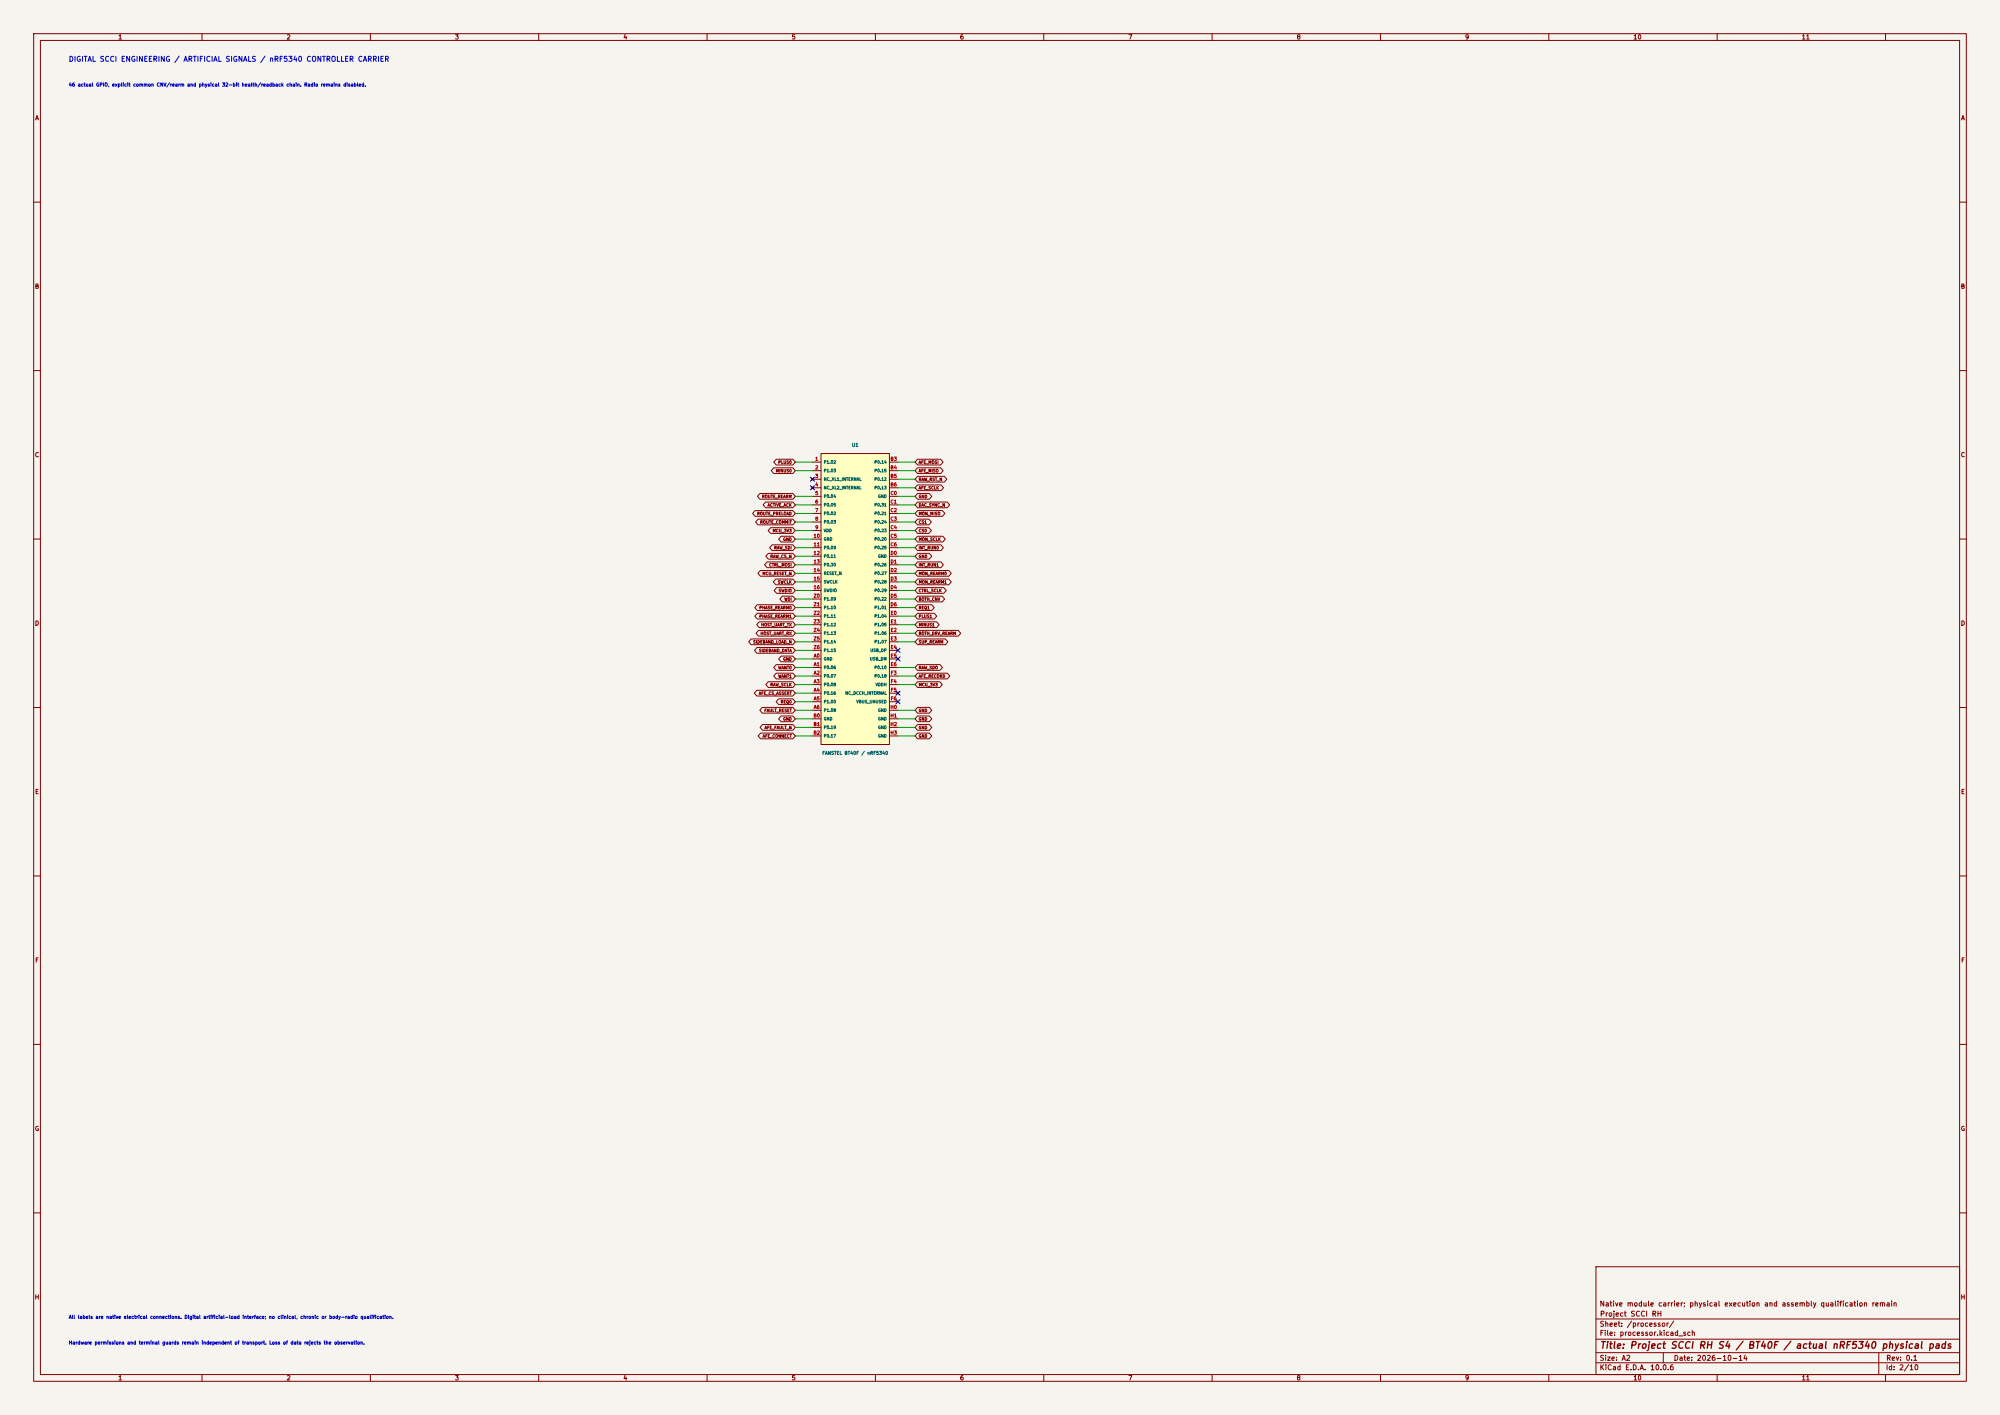
[picture p160: page 2]

All labels are native electrical connections. Digital artificial-load interface; no clinical, chronic or body-radio qualification. Hardware permissions and terminal guards remain independent of transport. Loss of data rejects the observation.

Sheet: /processor/
File: processor.kicad_sch
Title: Project SCCI RH S4 / BT40F / actual nRF5340 physical pads

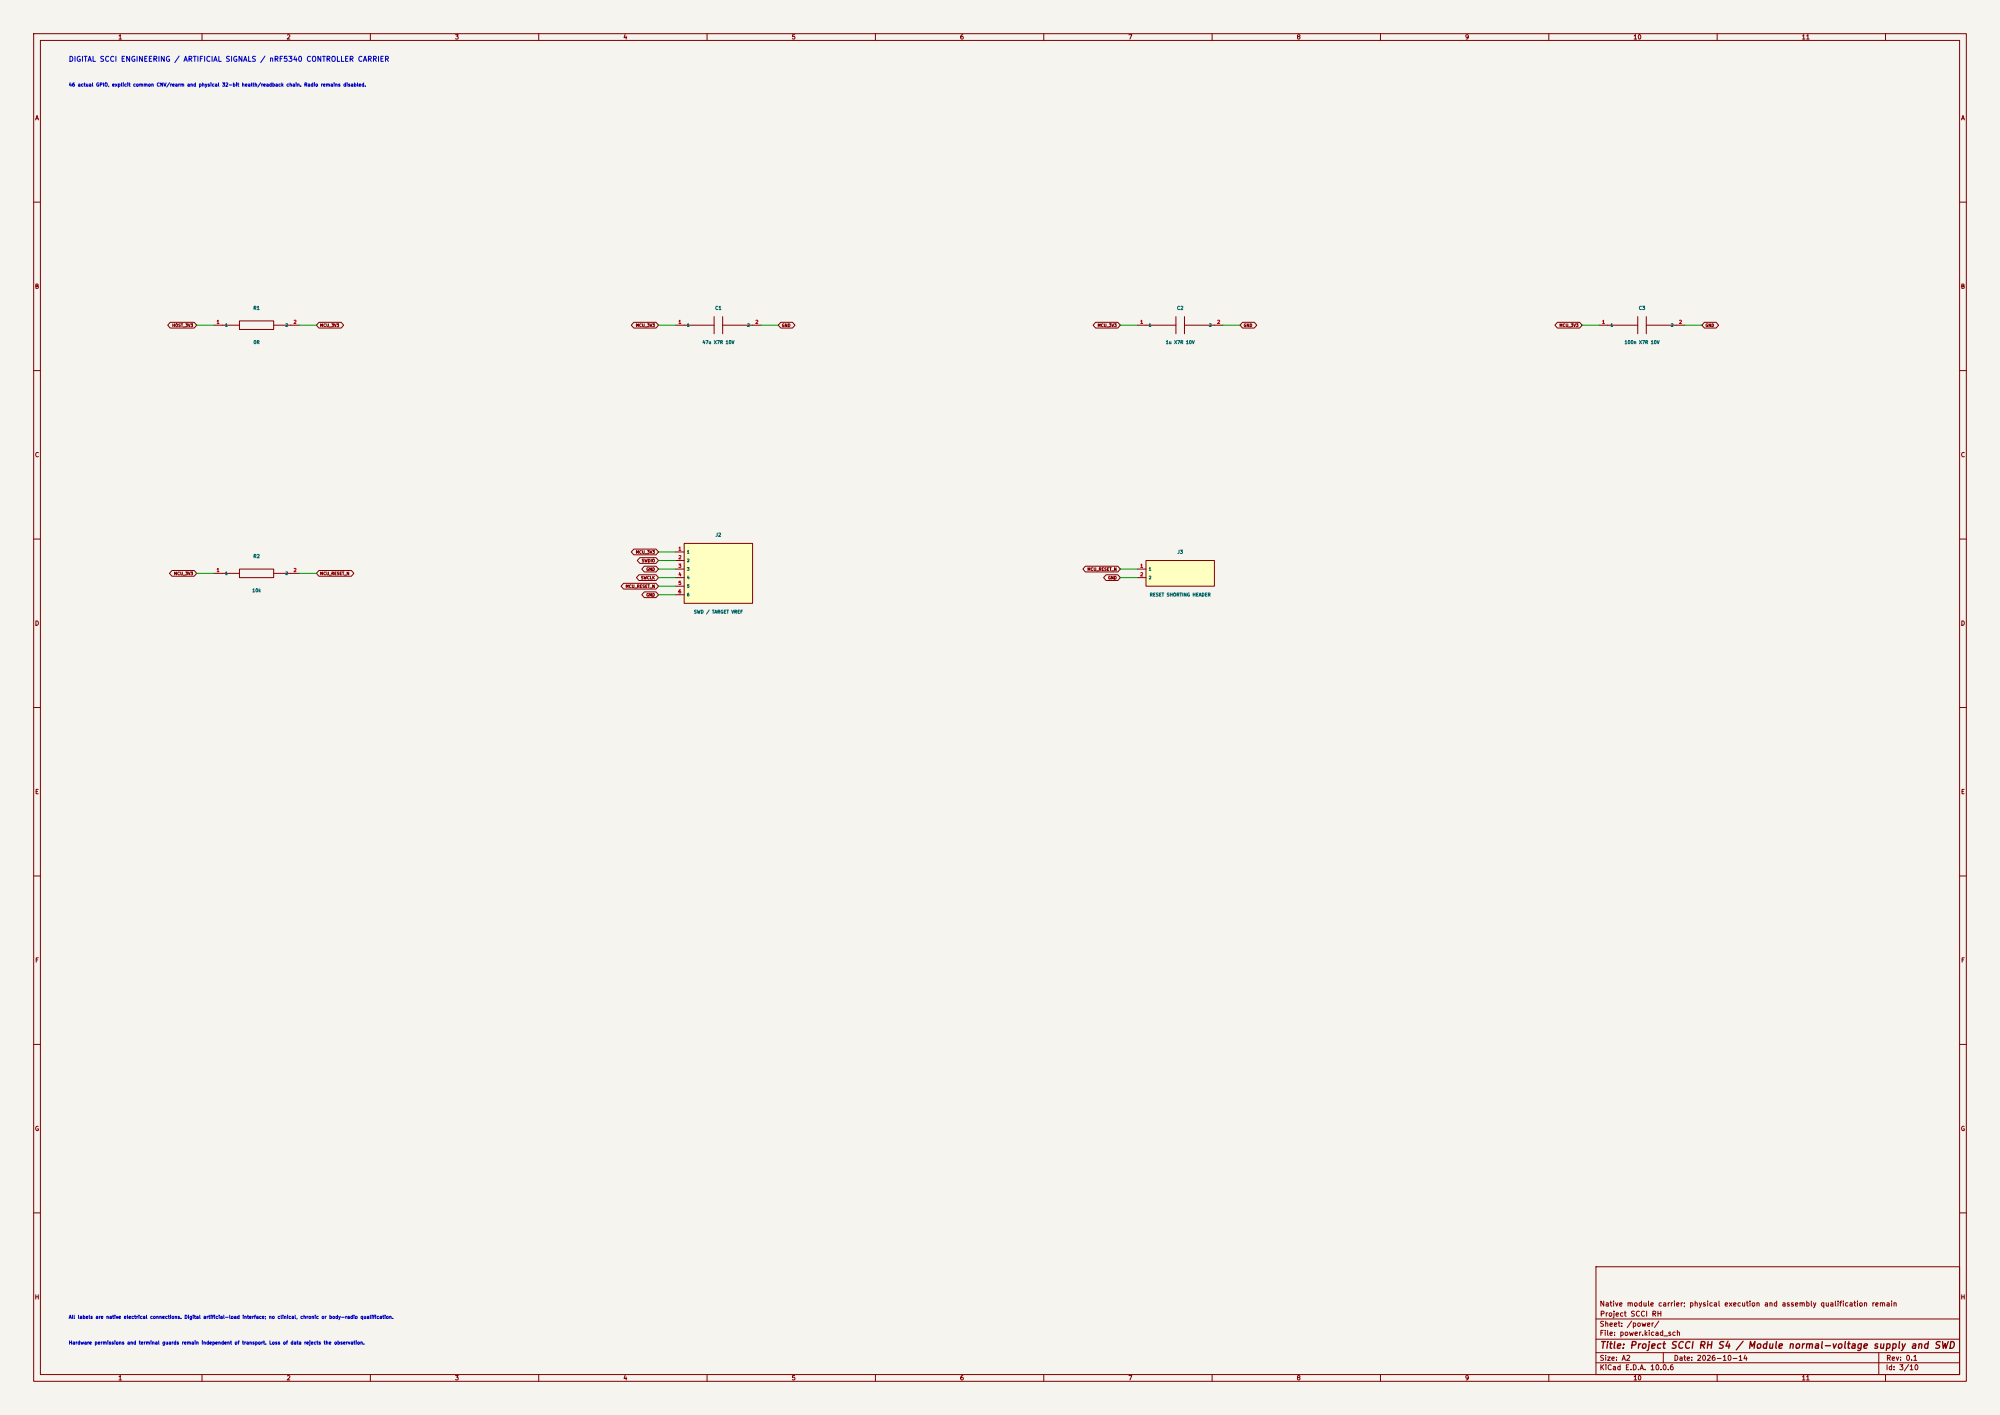
[picture p161: page 3]

Hardware permissions and terminal guards remain independent of transport. Loss of data rejects the observation. All labels are native electrical connections. Digital artificial-load interface; no clinical, chronic or body-radio qualification.

Sheet: /power/
File: power.kicad_sch
Title: Project SCCI RH S4 / Module normal-voltage supply and SWD

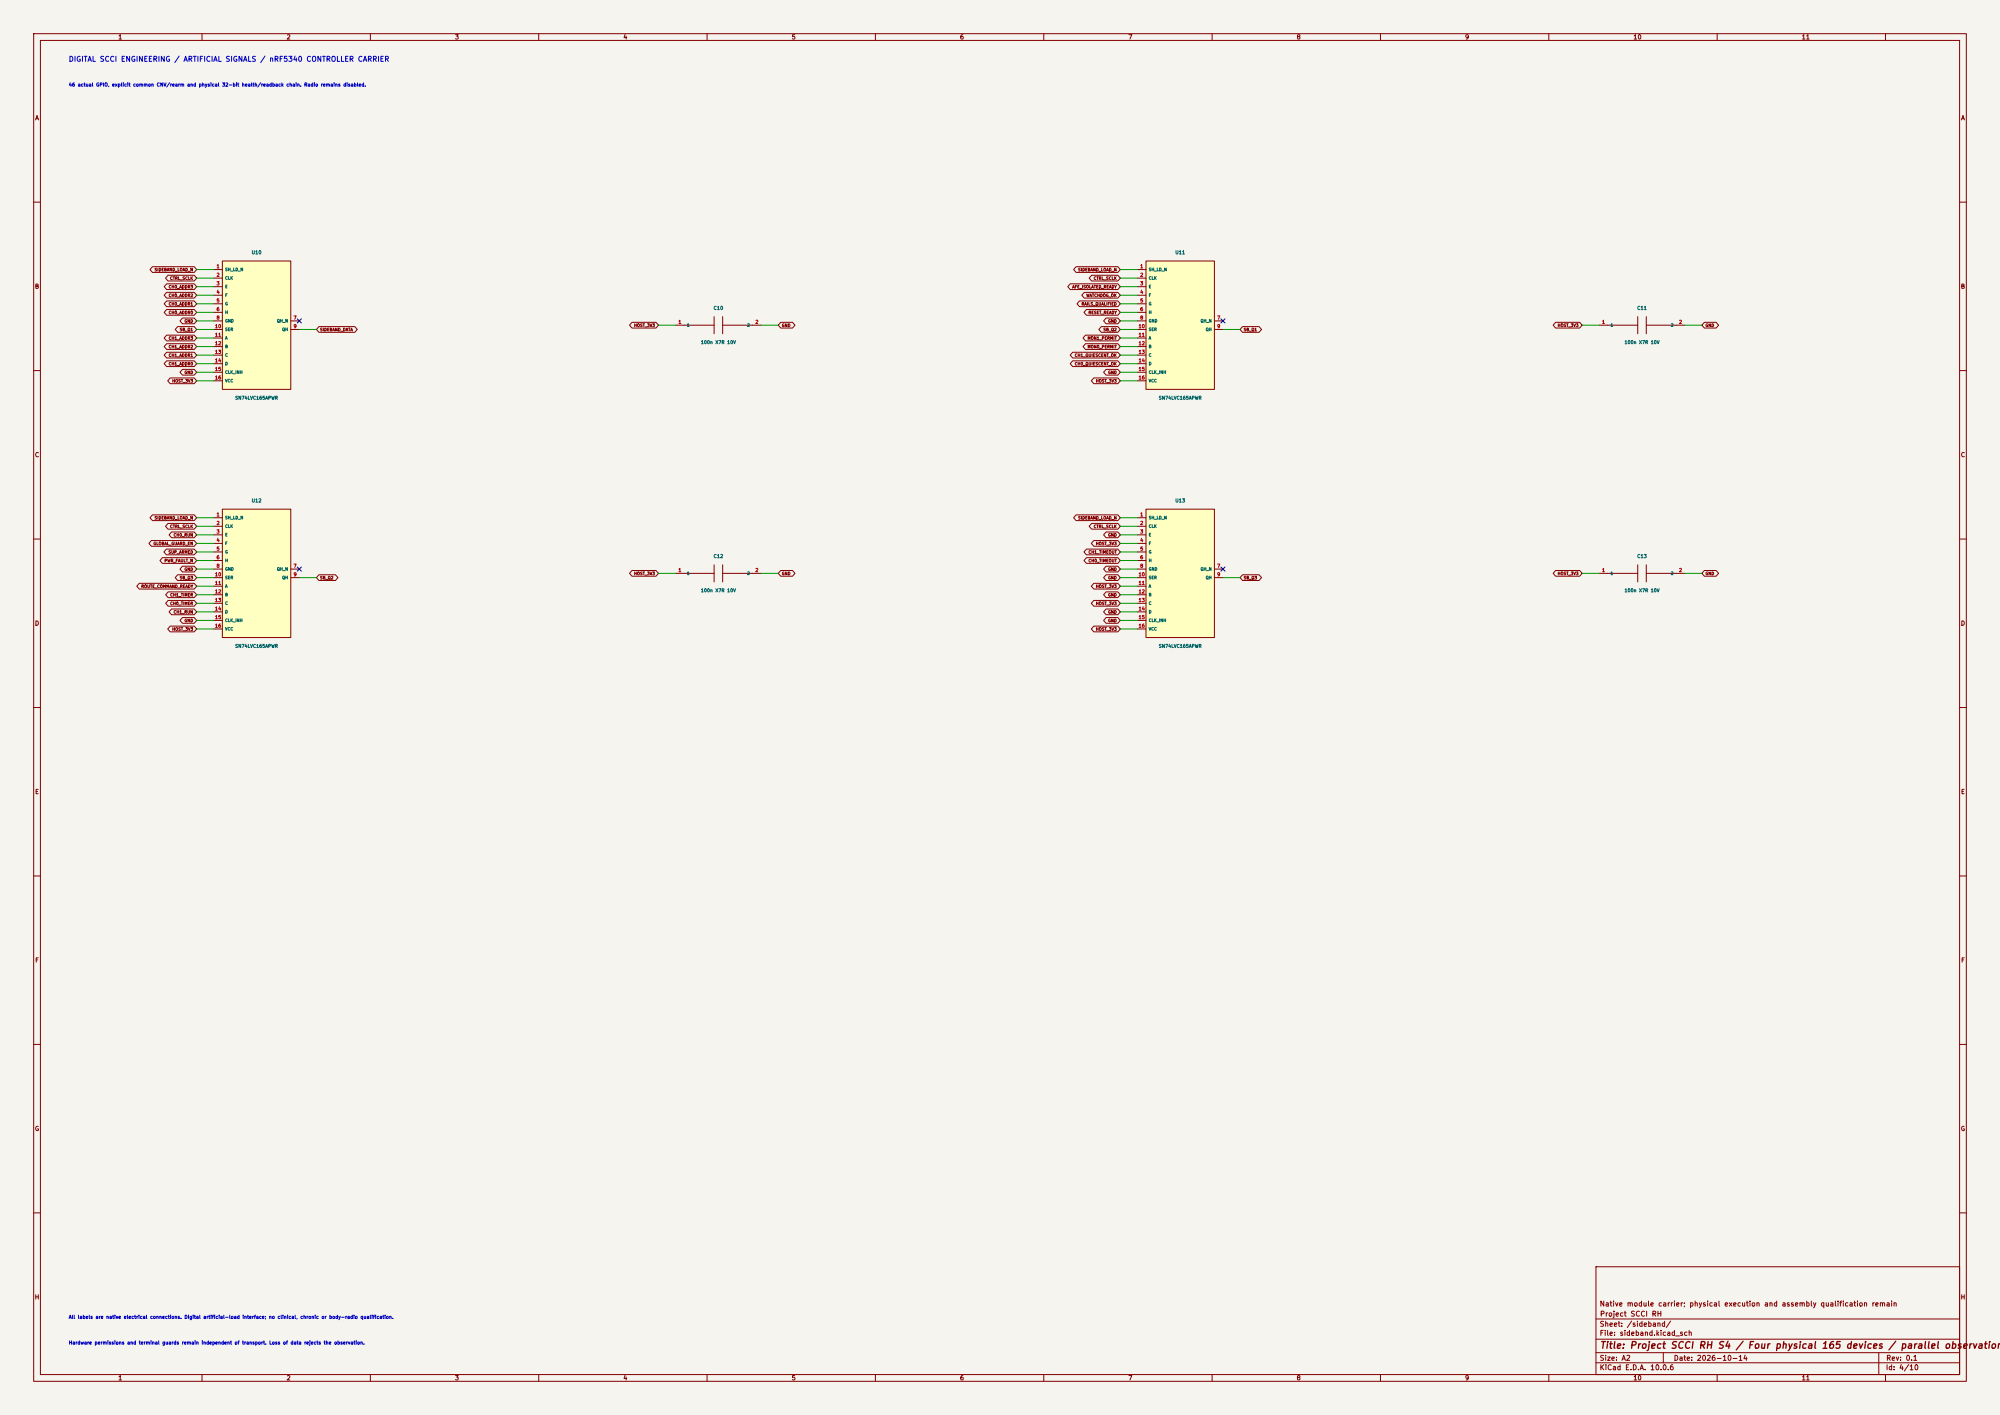
[picture p162: page 4]
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

Sheet: /sideband/
File: sideband.kicad_sch
Title: Project SCCI RH S4 / Four physical 165 devices / parallel observations

Hardware permissions and terminal guards remain independent of transport. Loss of data rejects the observation.

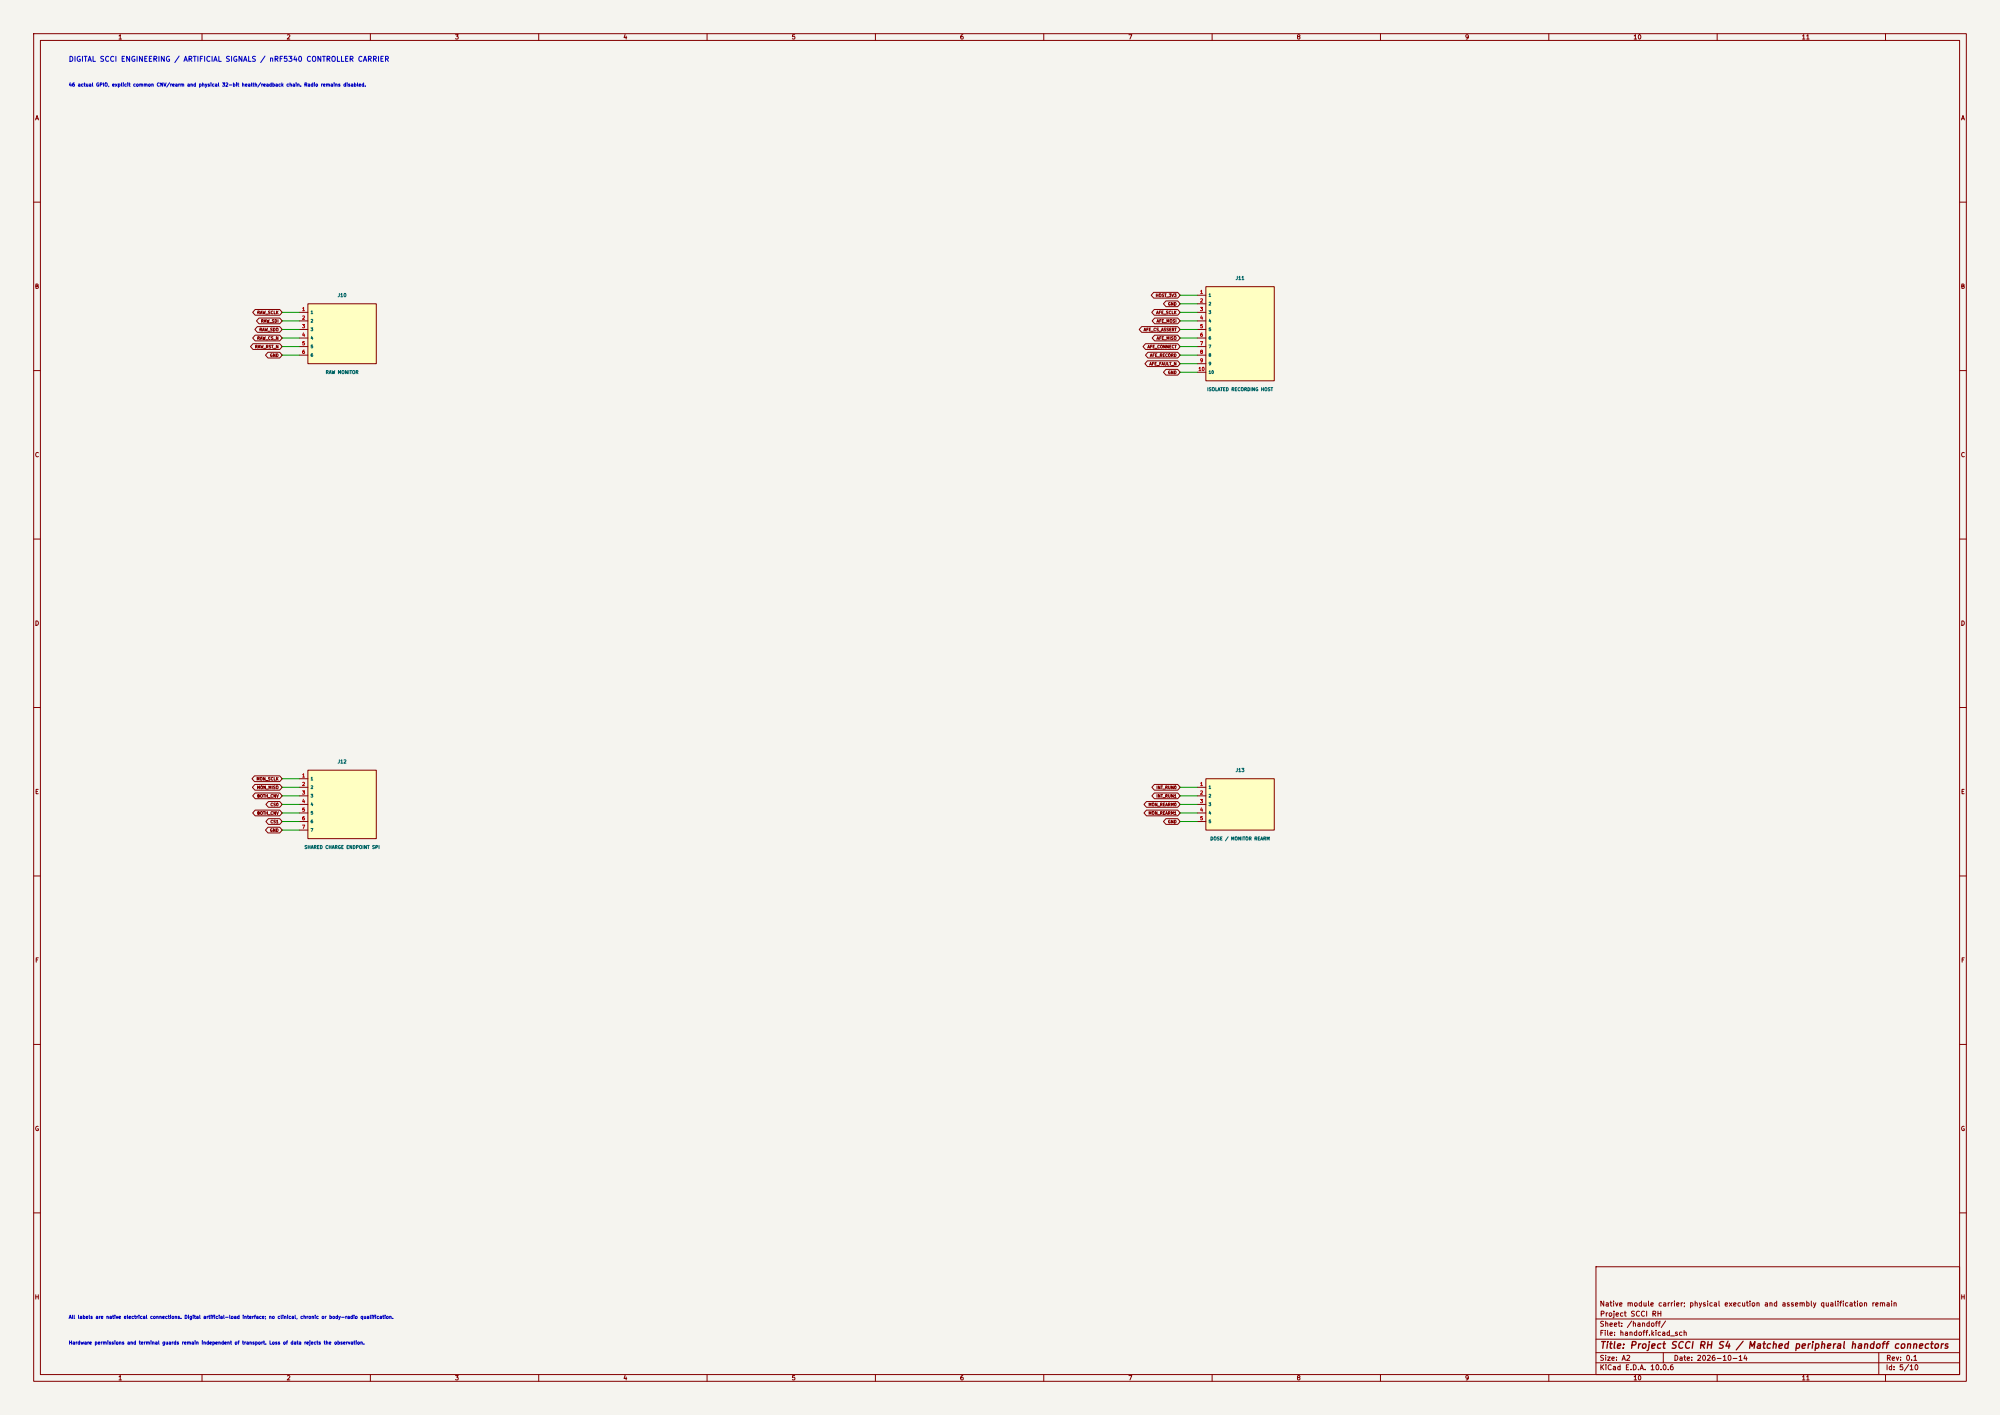
[picture p163: page 5]

SHARED CHARGE ENDPOINT SPI

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

Sheet: /handoff/
File: handoff.kicad_sch
Title: Project SCCI RH S4 / Matched peripheral handoff connectors

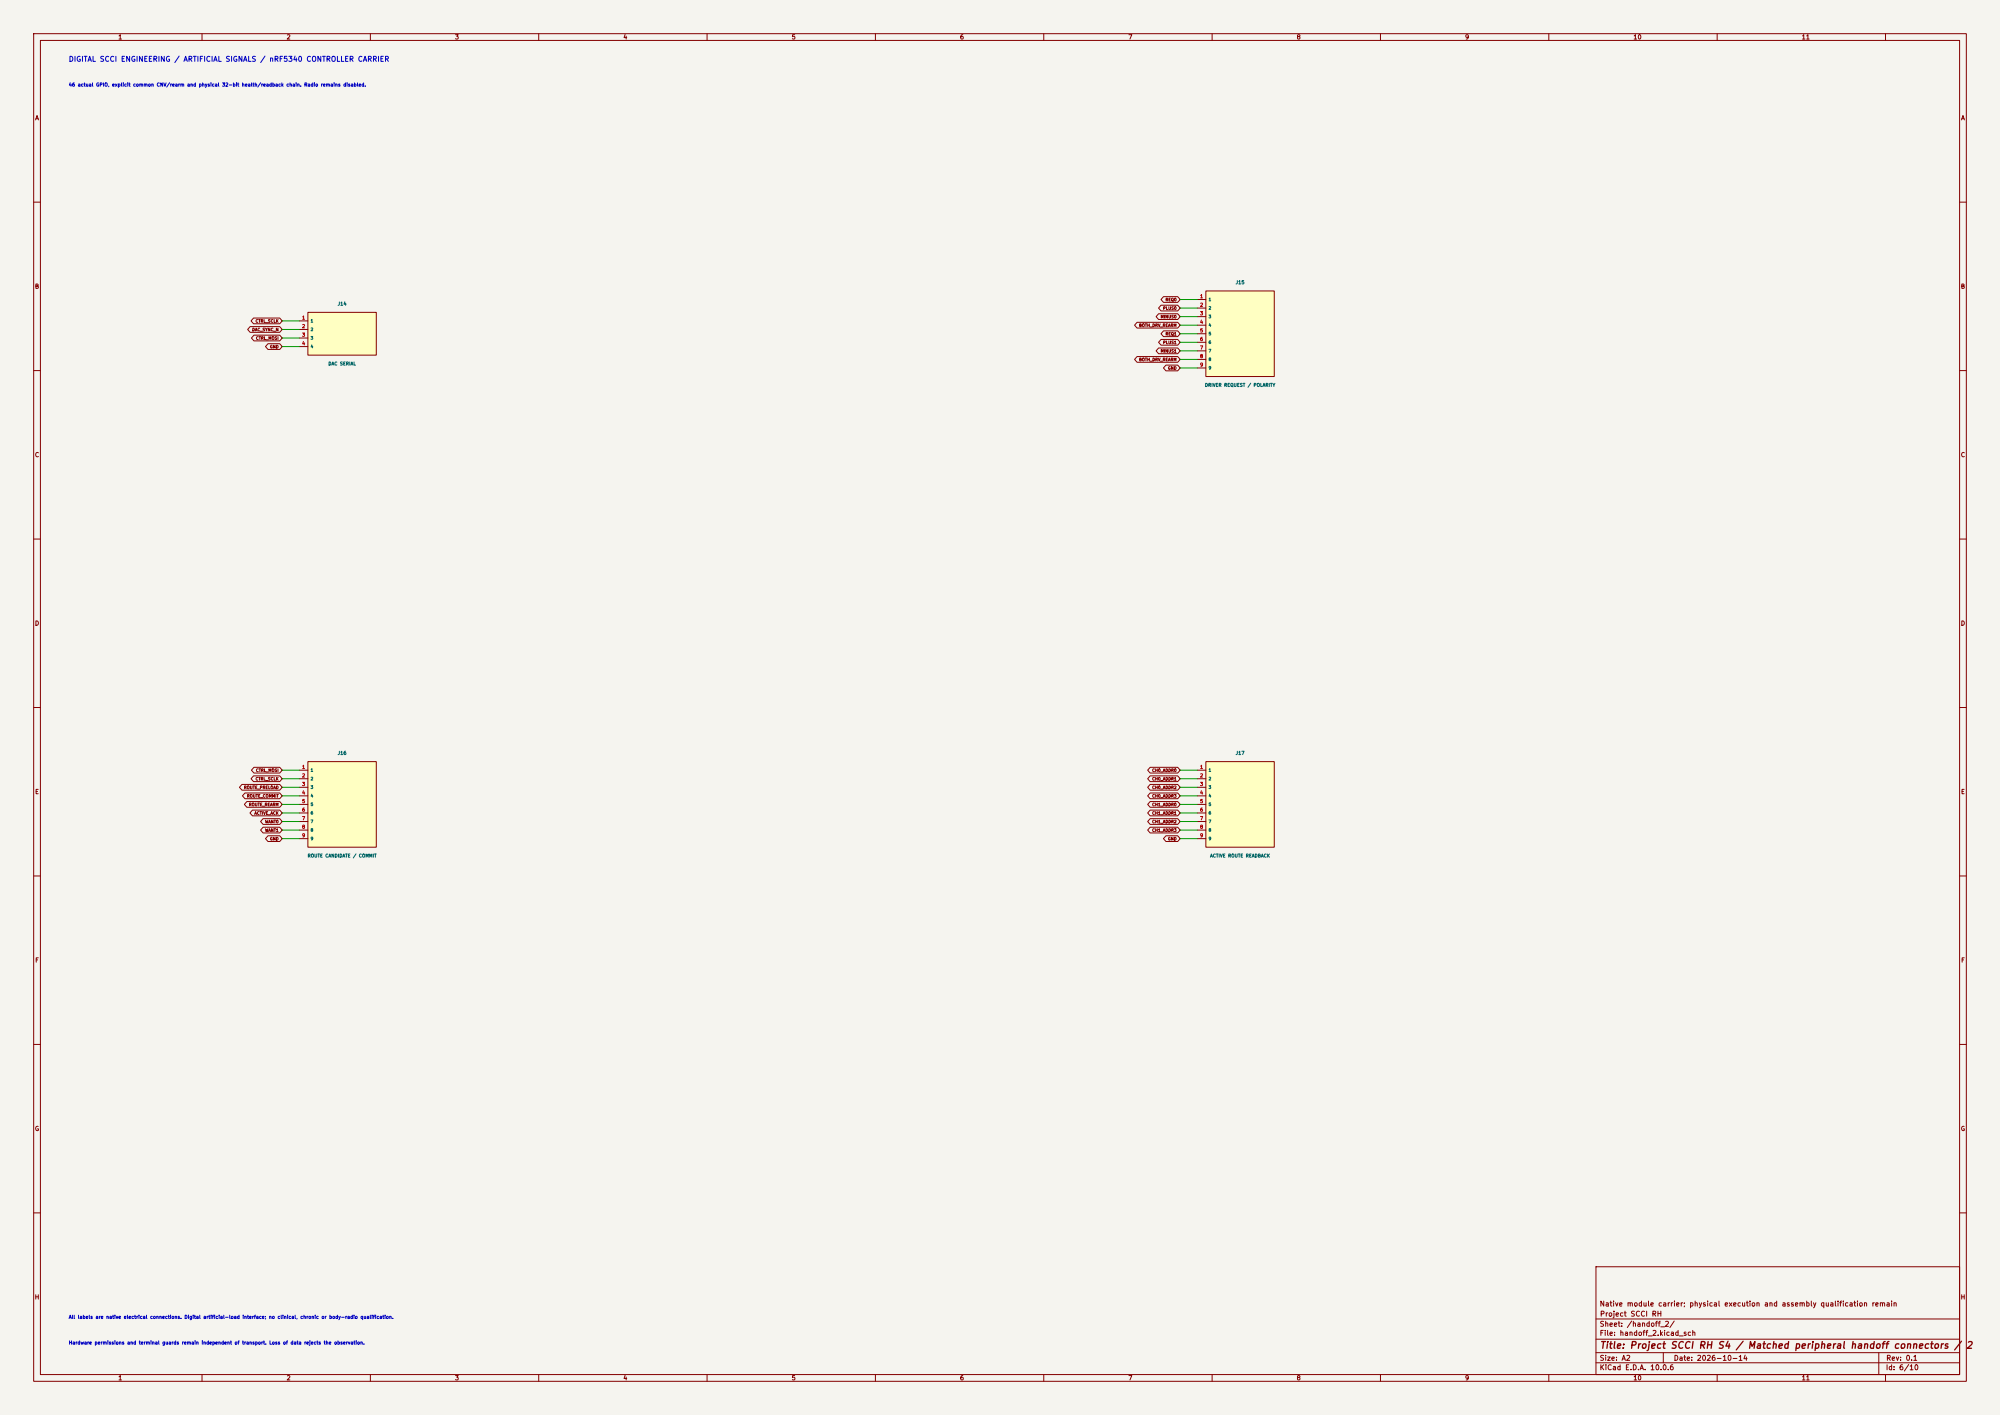
[picture p164: page 6]

DIGITAL SCCI ENGINEERING / ARTIFICIAL SIGNALS / nRF5340 CONTROLLER CARRIER

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

Sheet: /handoff_2/
File: handoff_2.kicad_sch
Title: Project SCCI RH S4 / Matched peripheral handoff connectors / 2

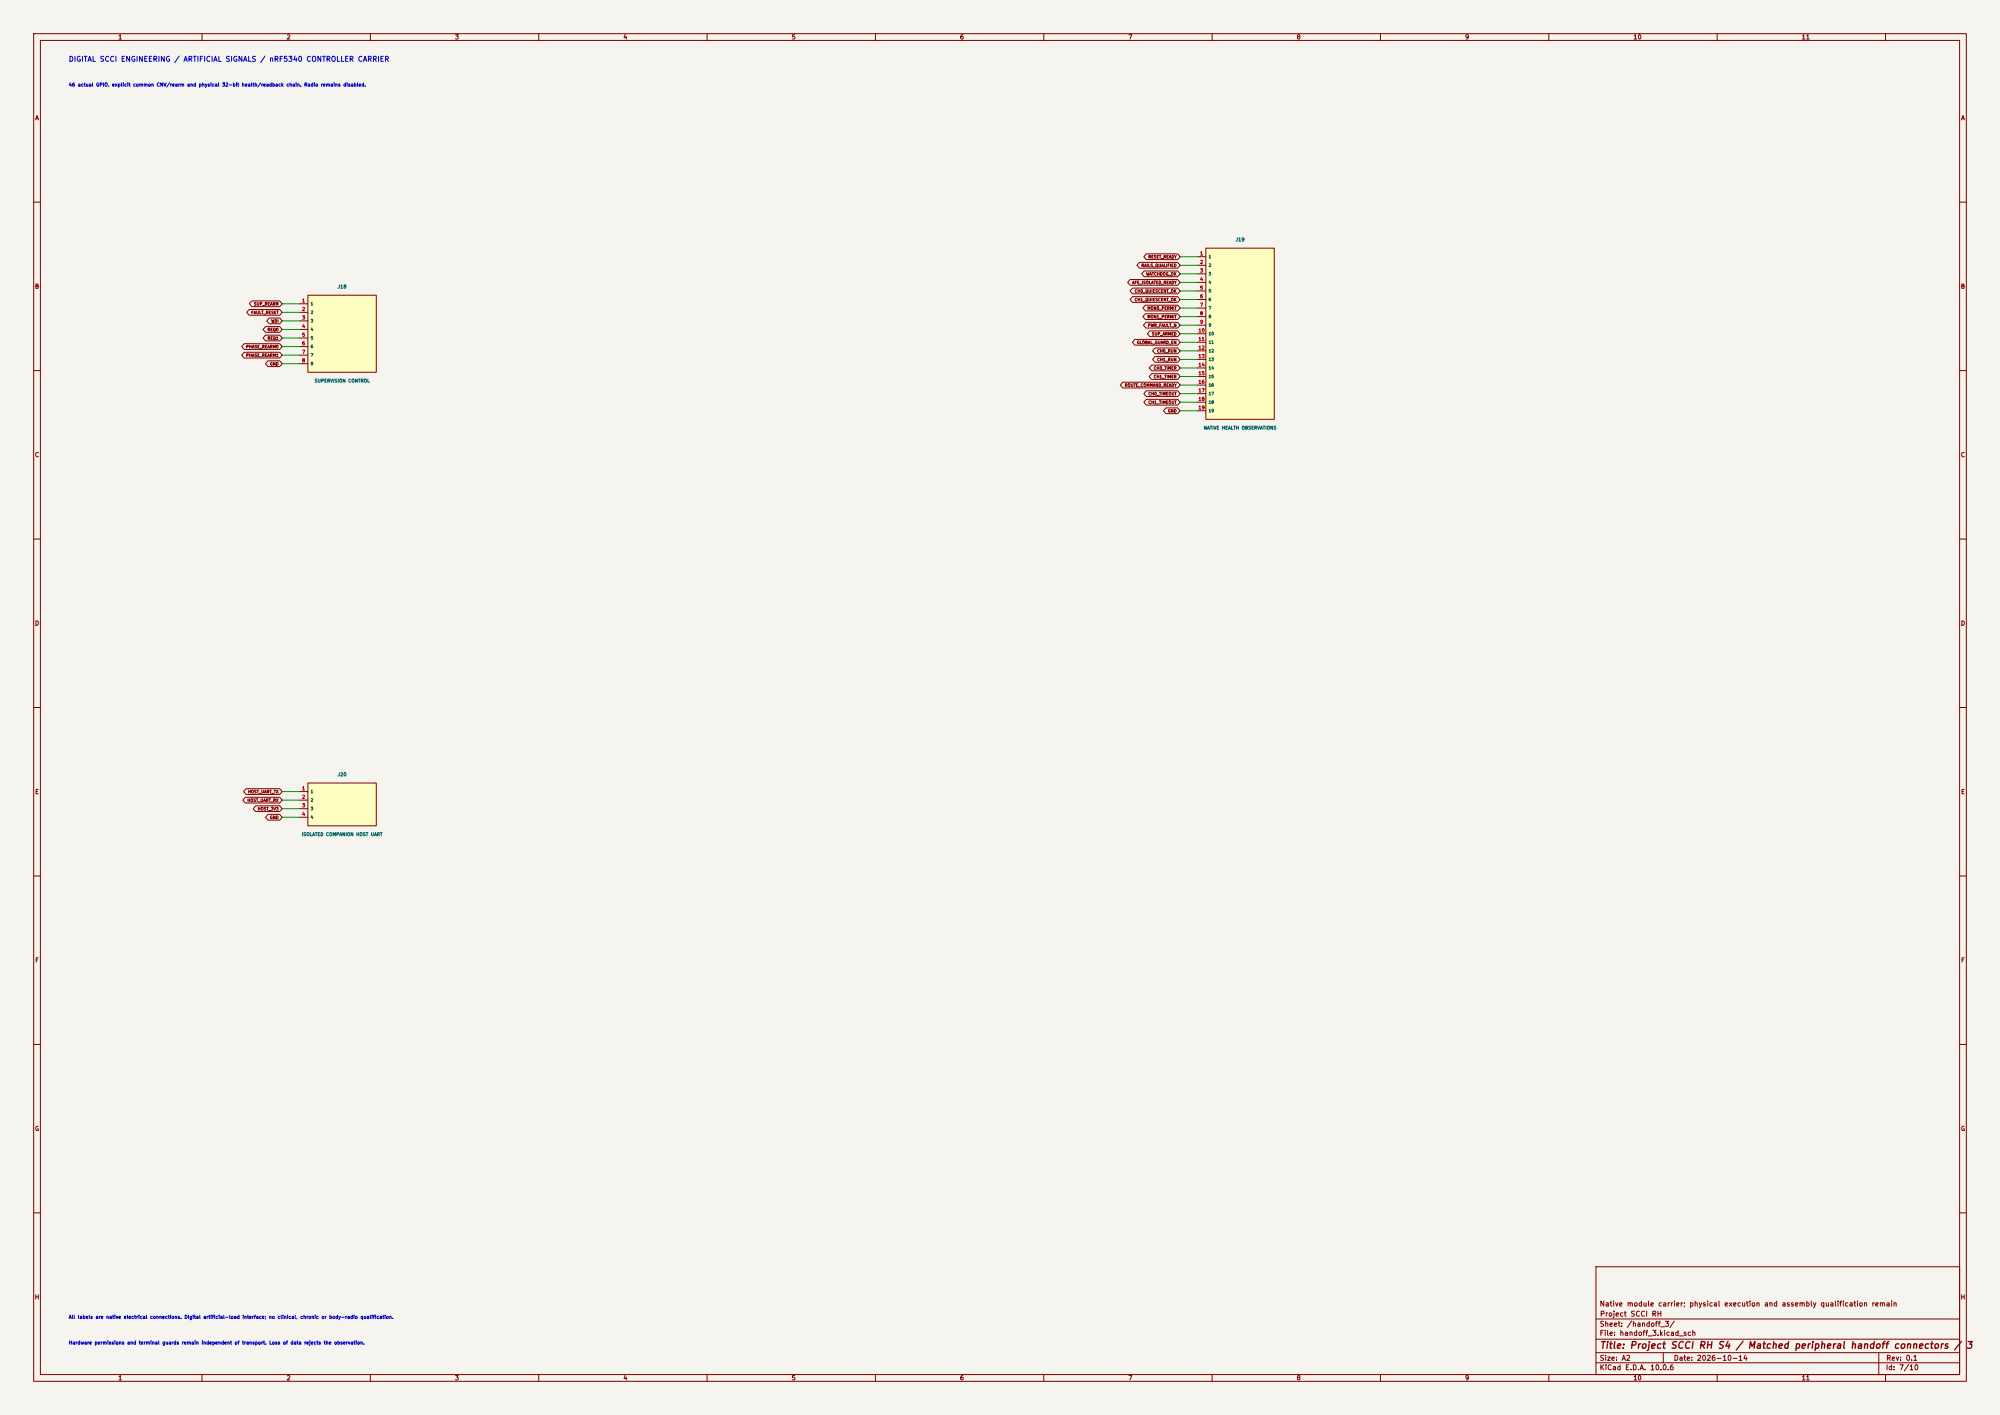
[picture p165: page 7]

ISOLATED COMPANION HOST UART

Sheet: /handoff_3/
File: handoff_3.kicad_sch
Title: Project SCCI RH S4 / Matched peripheral handoff connectors / 3

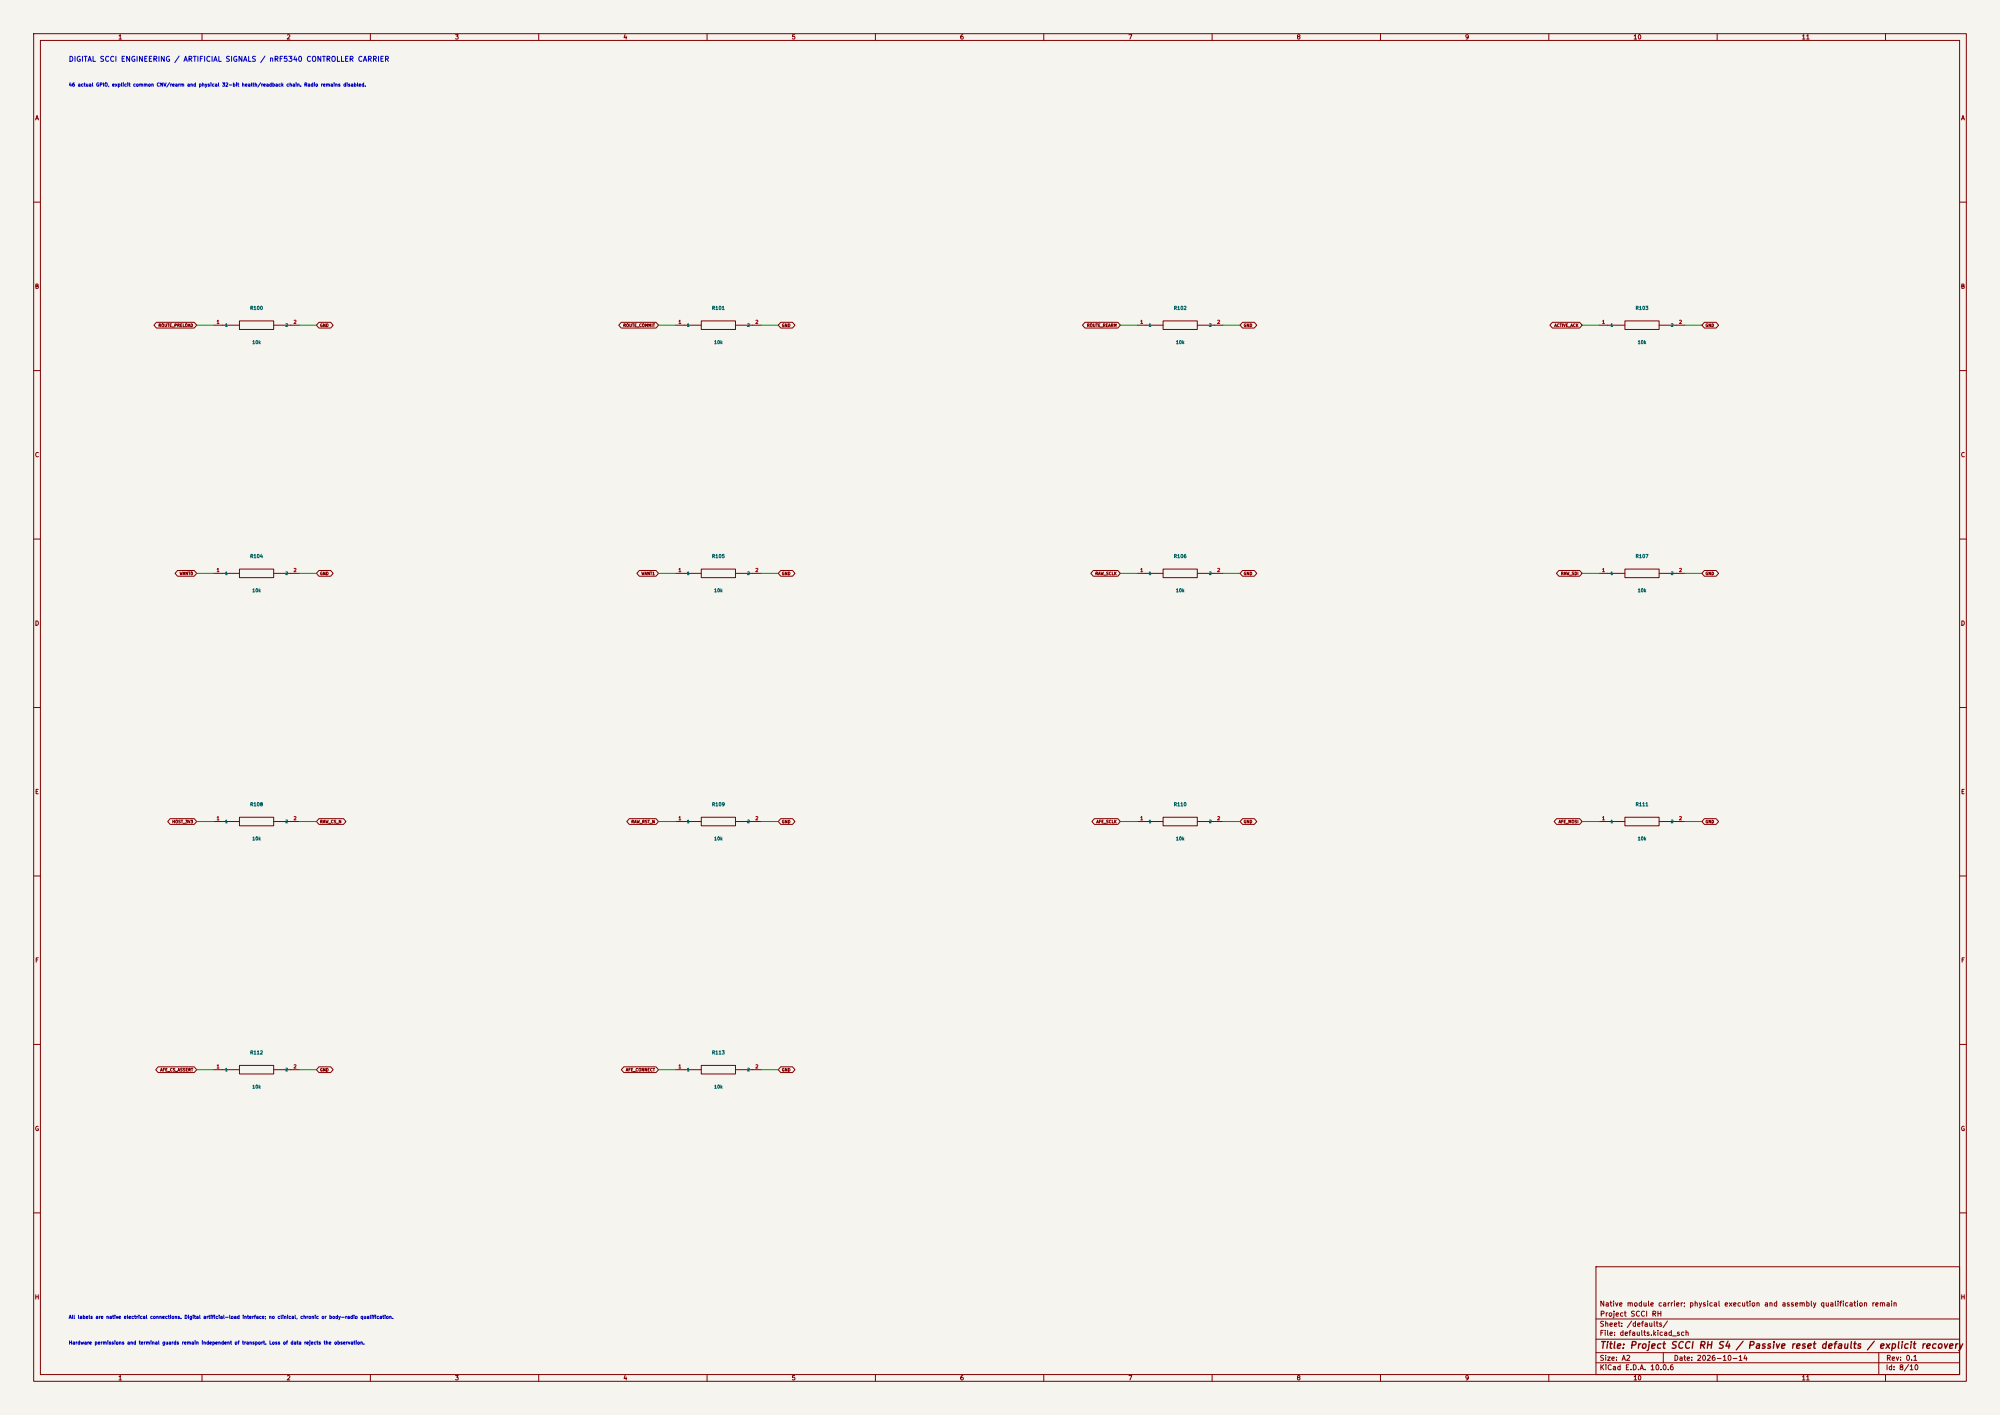
[picture p166: page 8]

Sheet: /defaults/
File: defaults.kicad_sch
Title: Project SCCI RH S4 / Passive reset defaults / explicit recovery

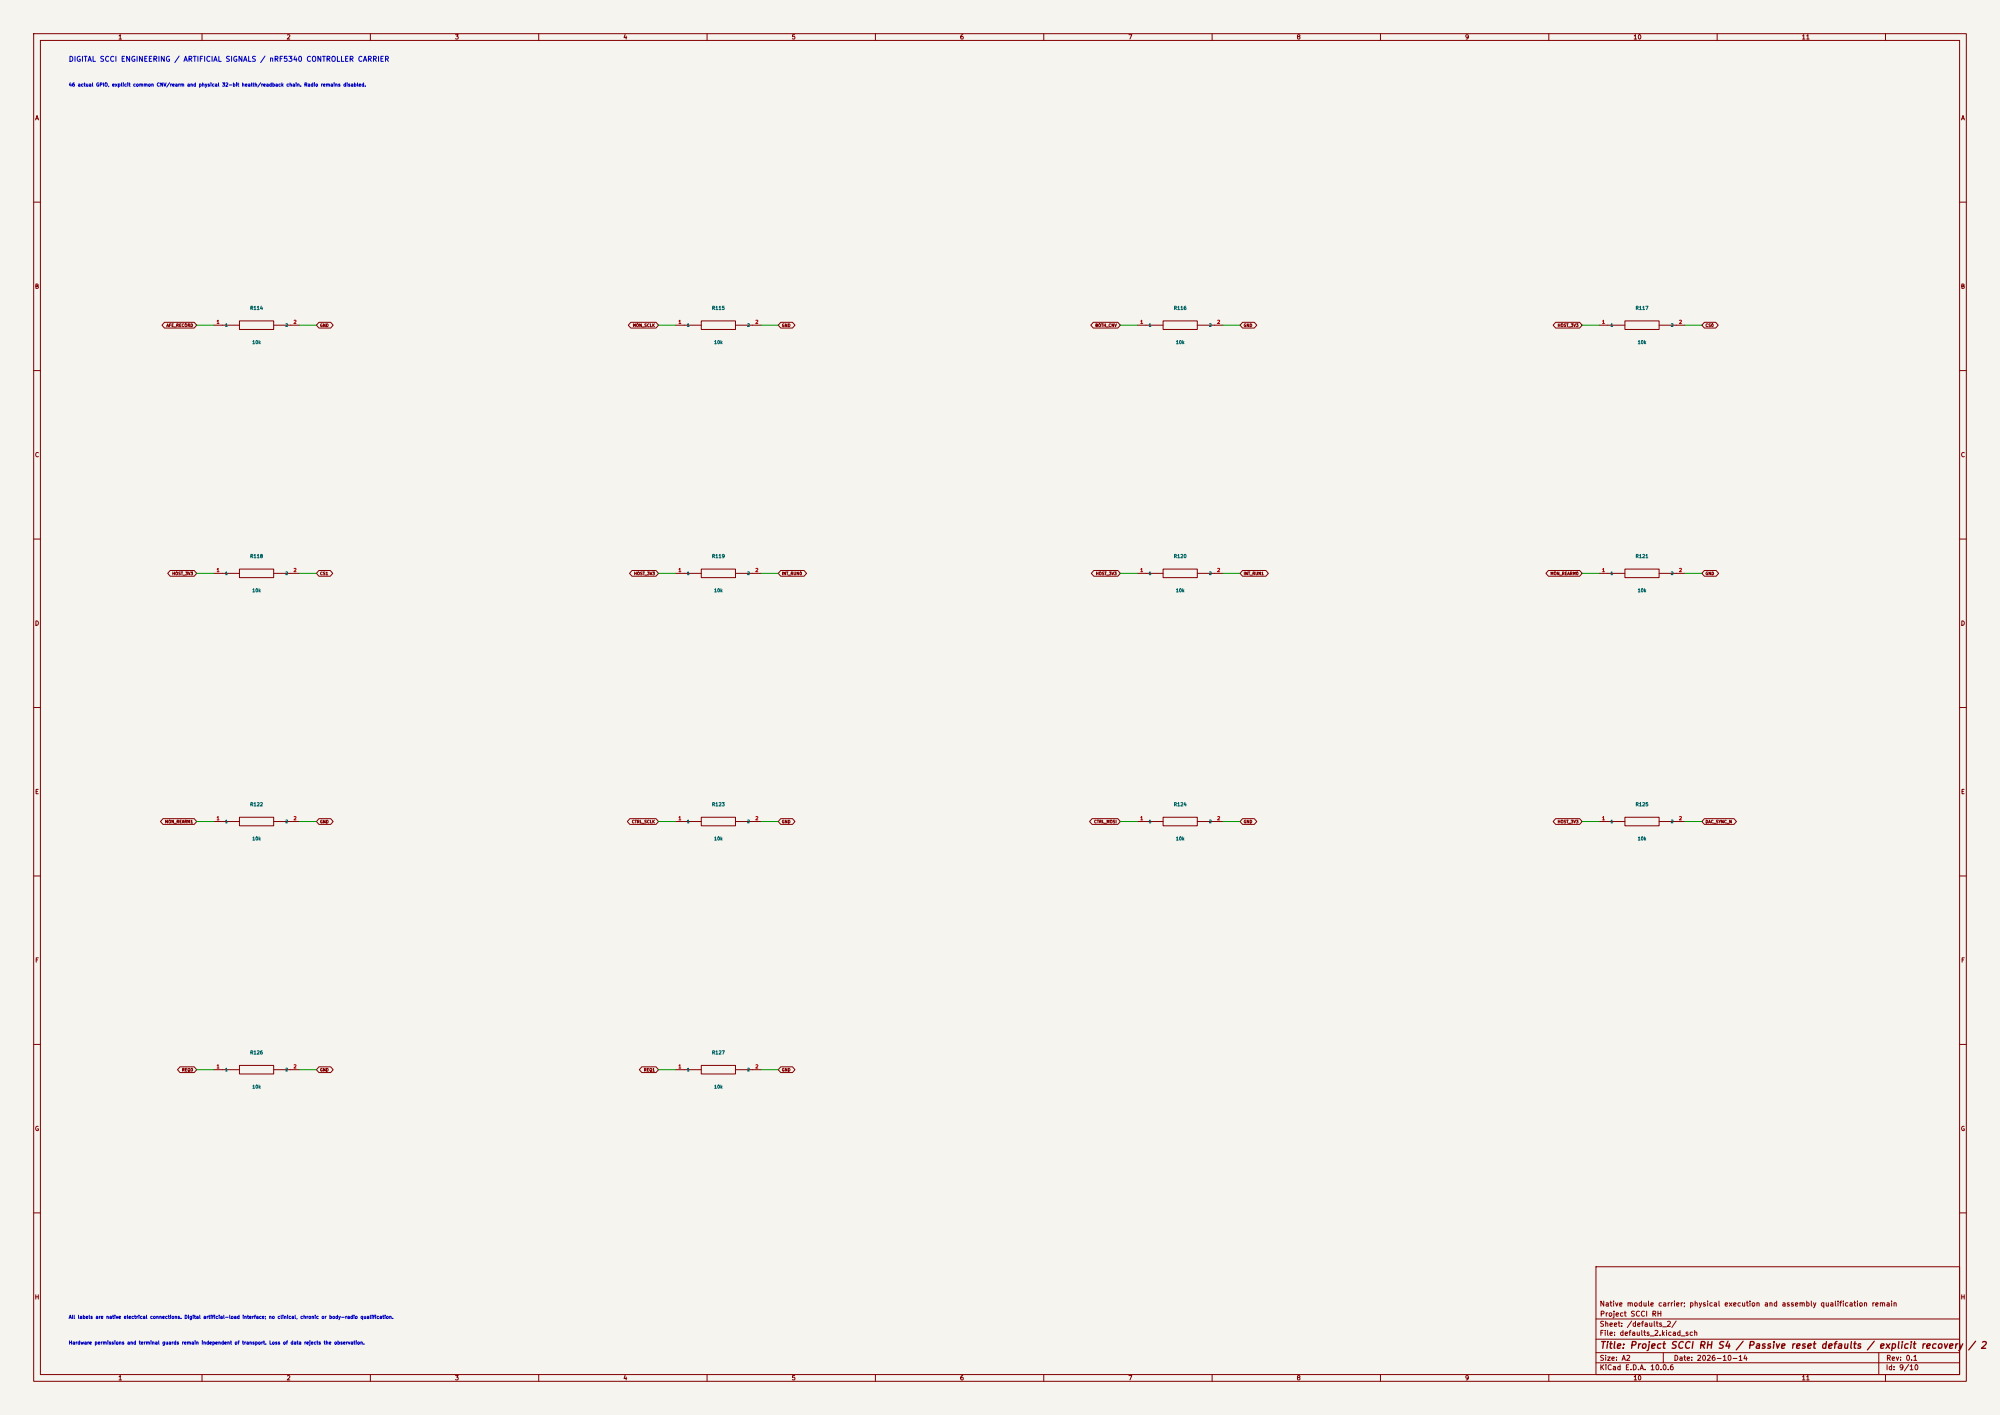
[picture p167: page 9]

Sheet: /defaults_2/
File: defaults_2.kicad_sch
Title: Project SCCI RH S4 / Passive reset defaults / explicit recovery / 2

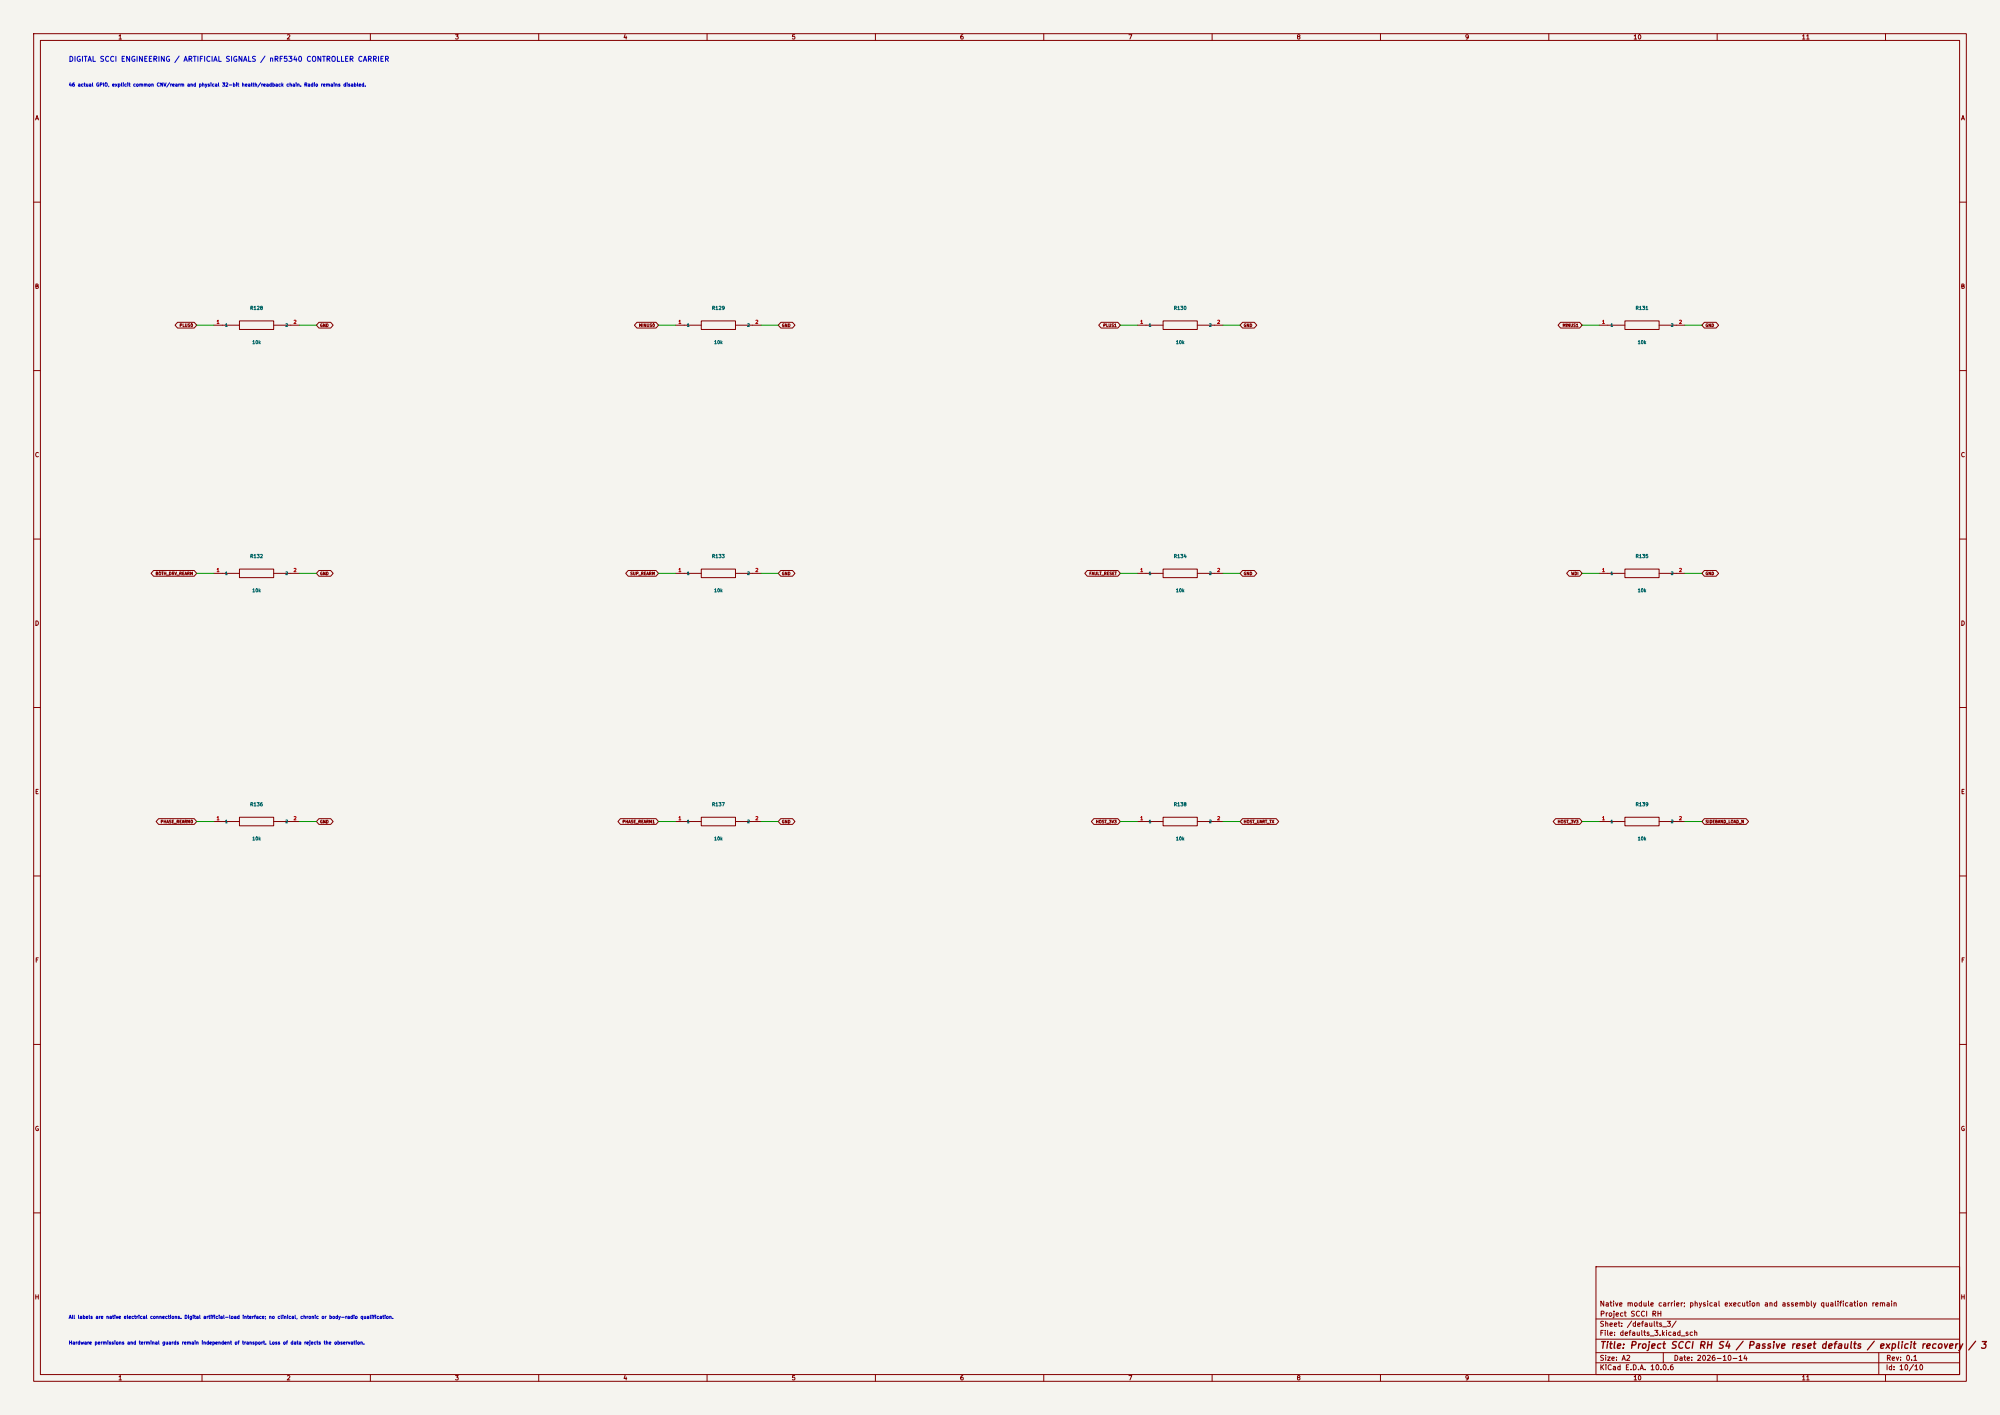
[picture p168: page 10]

Sheet: /defaults_3/
File: defaults_3.kicad_sch
Title: Project SCCI RH S4 / Passive reset defaults / explicit recovery / 3
