pratham-cloud-ctrl/Project-SCCI-RH/electronics/stage4/current-driver/current_driver.pdf

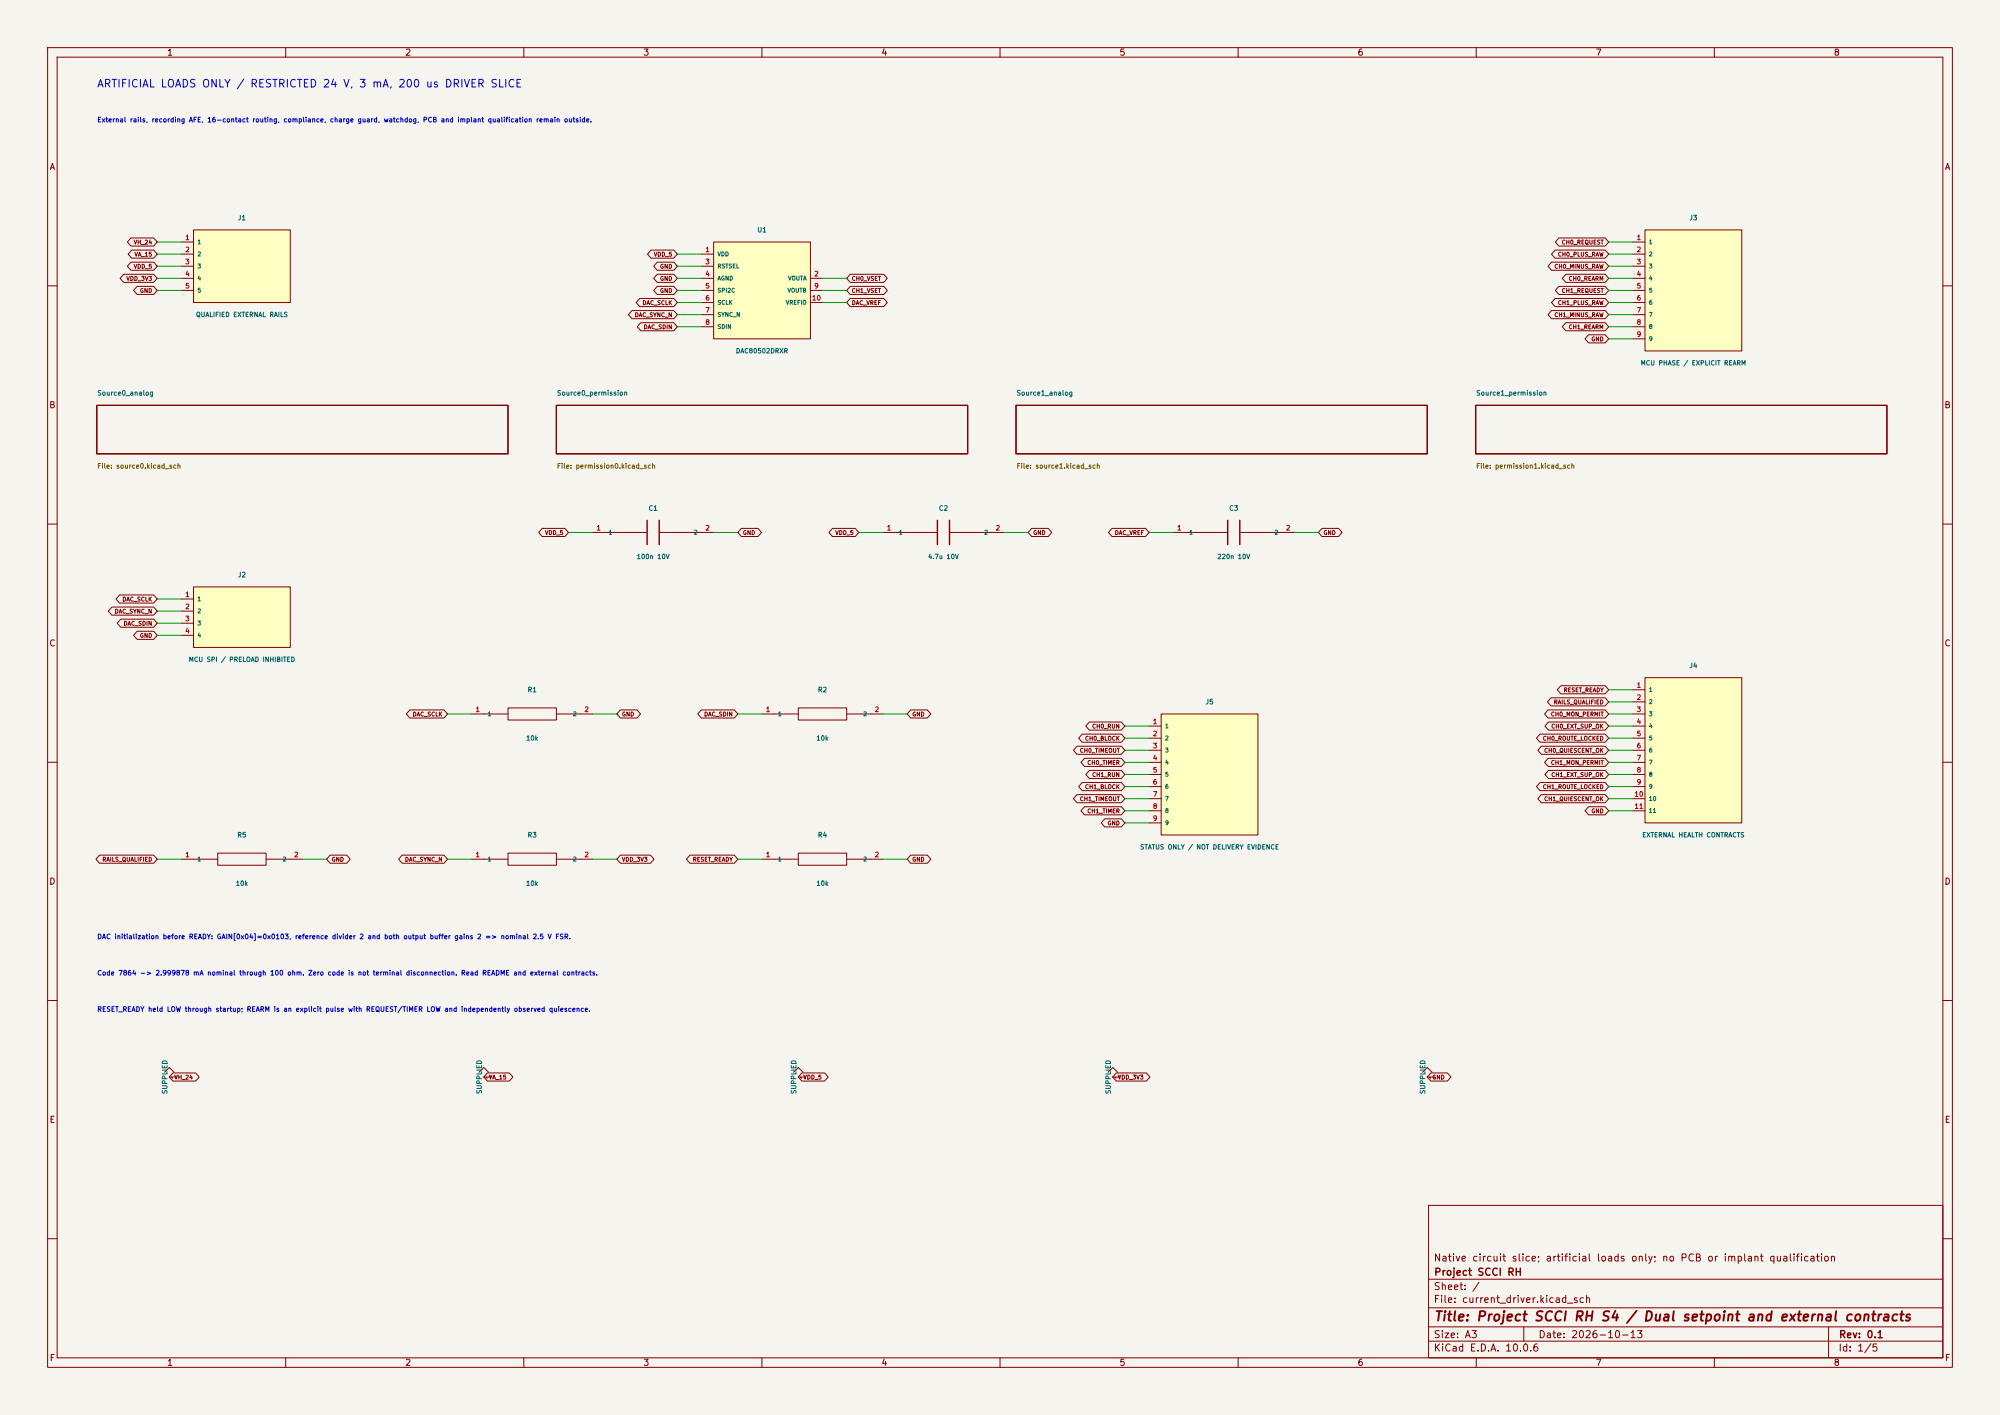
[picture p169: page 1]

VDD_5 ARTIFICIAL LOADS ONLY / RESTRICTED 24 V, 3 mA, 200 us DRIVER SLICE

External rails, recording AFE, 16-contact routing, compliance, charge guard, watchdog, PCB and implant qualification remain outside.

J3 MCU PHASE / EXPLICIT REARM

J2 MCU SPI / PRELOAD INHIBITED

STATUS ONLY / NOT DELIVERY EVIDENCE

DAC initialization before READY: GAIN[0x04]=0x0103, reference divider 2 and both output buffer gains 2 => nominal 2.5 V FSR. Code 7864 -> 2.999878 mA nominal through 100 ohm. Zero code is not terminal disconnection. Read README and external contracts. RESET_READY held LOW through startup; REARM is an explicit pulse with REQUEST/TIMER LOW and independently observed quiescence.

Native circuit slice; artificial loads only; no PCB or implant qualification
Project SCCI RH
Sheet: /
File: current_driver.kicad_sch
Title: Project SCCI RH S4 / Dual setpoint and external contracts

Size: A3 | Rev: 0.1 | F Date: 2026-10-13
KiCad E.D.A. 10.0.6 | Id: 1/5

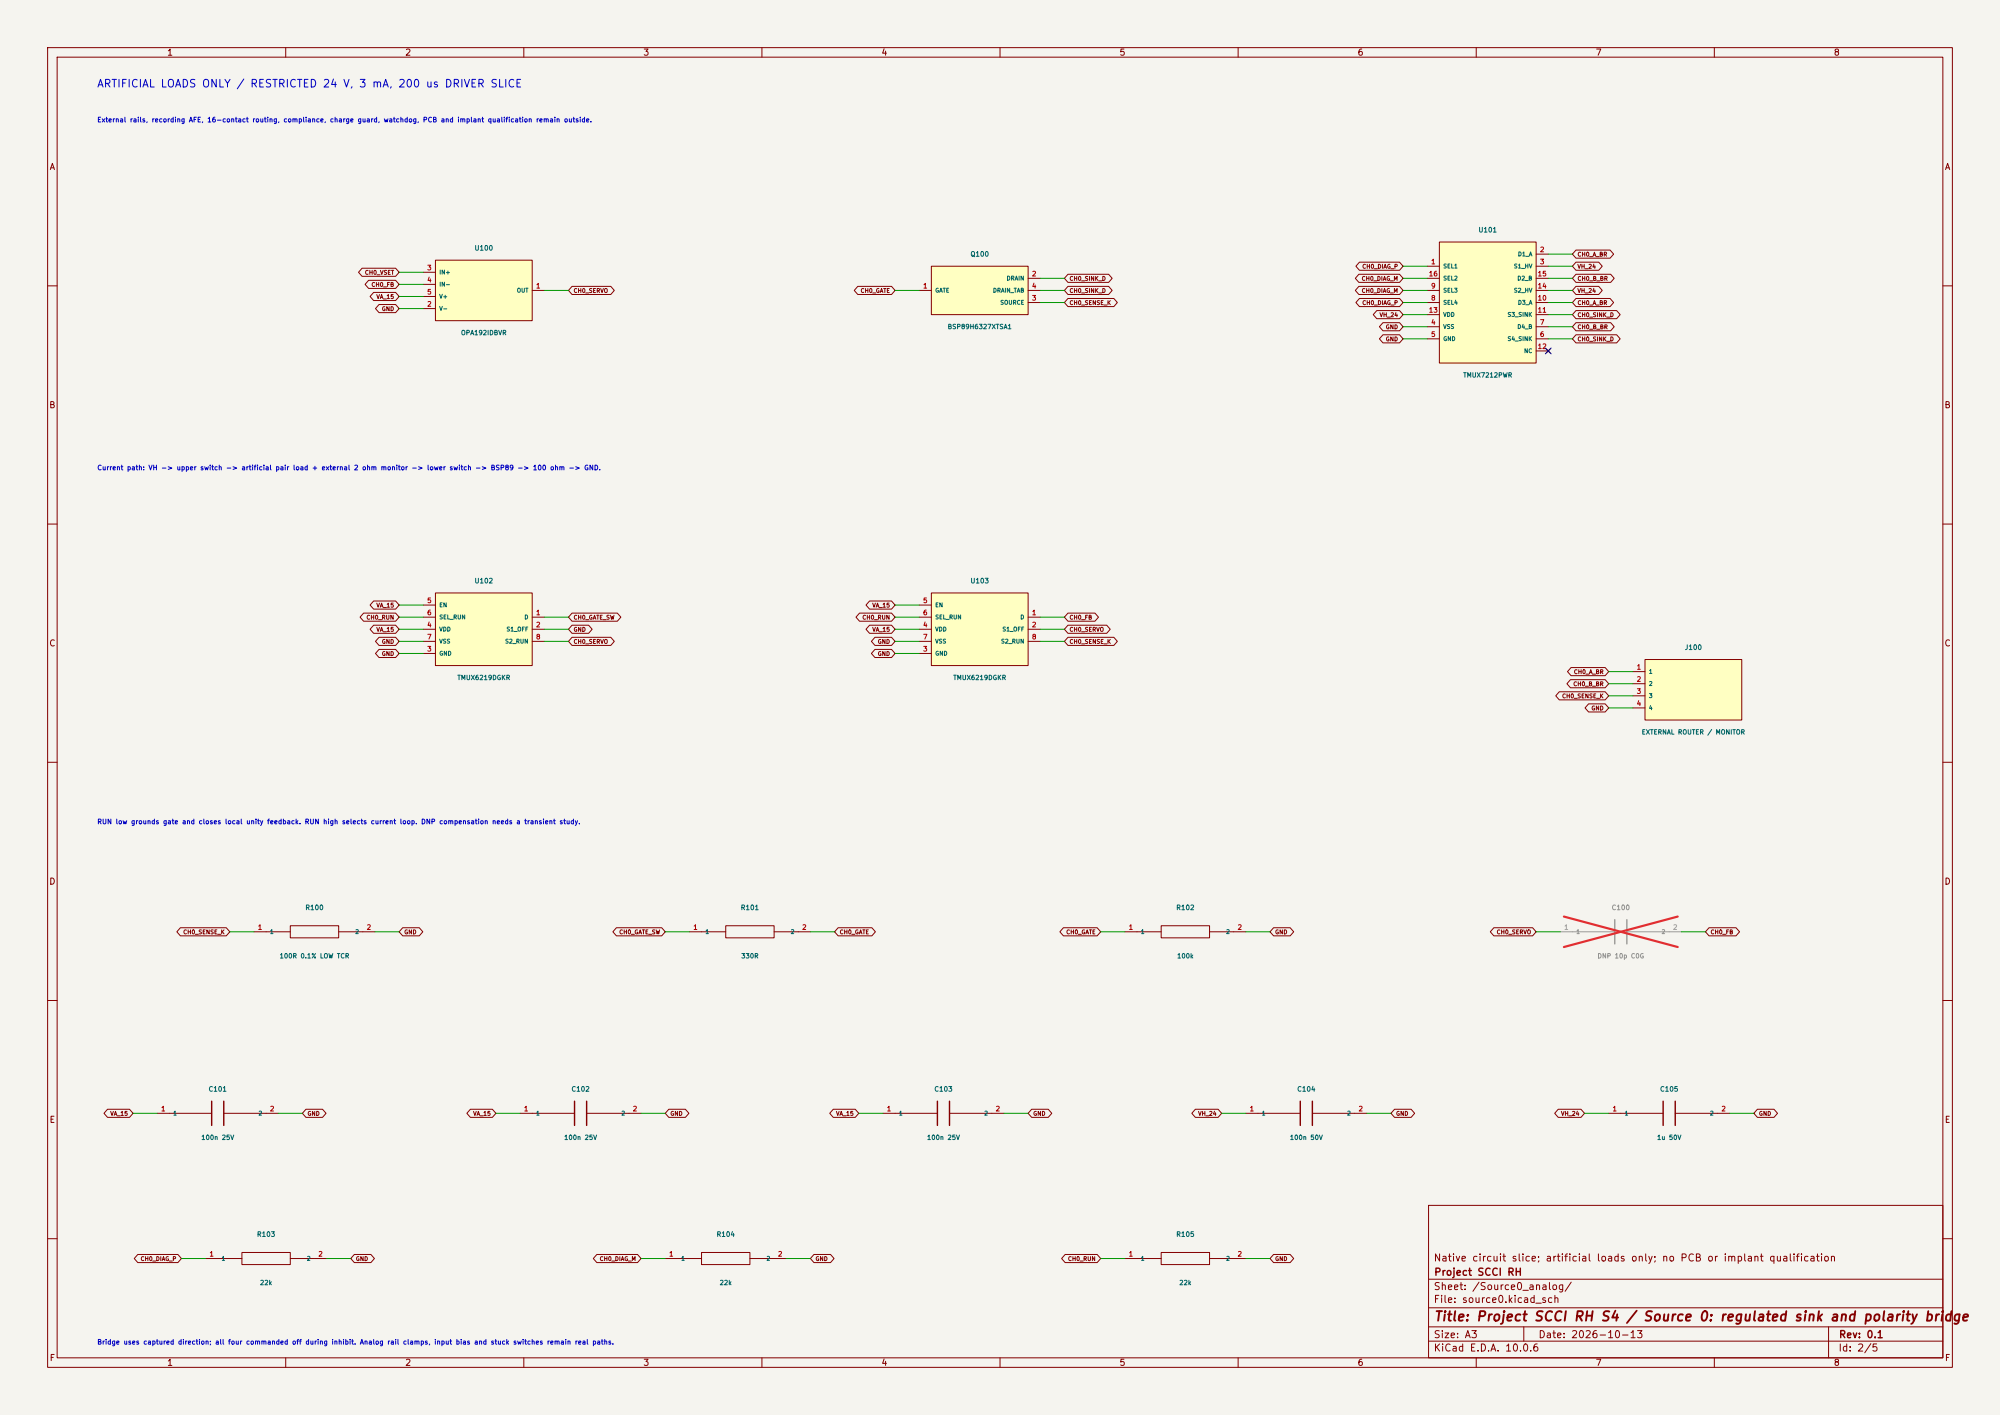
[picture p170: page 2]

External rails, recording AFE, 16-contact routing, compliance, charge guard, watchdog, PCB and implant qualification remain outside. ARTIFICIAL LOADS ONLY / RESTRICTED 24 V, 3 mA, 200 us DRIVER SLICE

CH0_SERVO Current path: VH -> upper switch -> artificial pair load + external 2 ohm monitor -> lower switch -> BSP89 -> 100 ohm -> GND.

RUN low grounds gate and closes local unity feedback. RUN high selects current loop. DNP compensation needs a transient study.

Native circuit slice; artificial loads only; no PCB or implant qualification
Project SCCI RH
Sheet: /Source0_analog/
File: source0.kicad_sch
Title: Project SCCI RH S4 / Source 0: regulated sink and polarity bridge

Bridge uses captured direction; all four commanded off during inhibit. Analog rail clamps, input bias and stuck switches remain real paths.

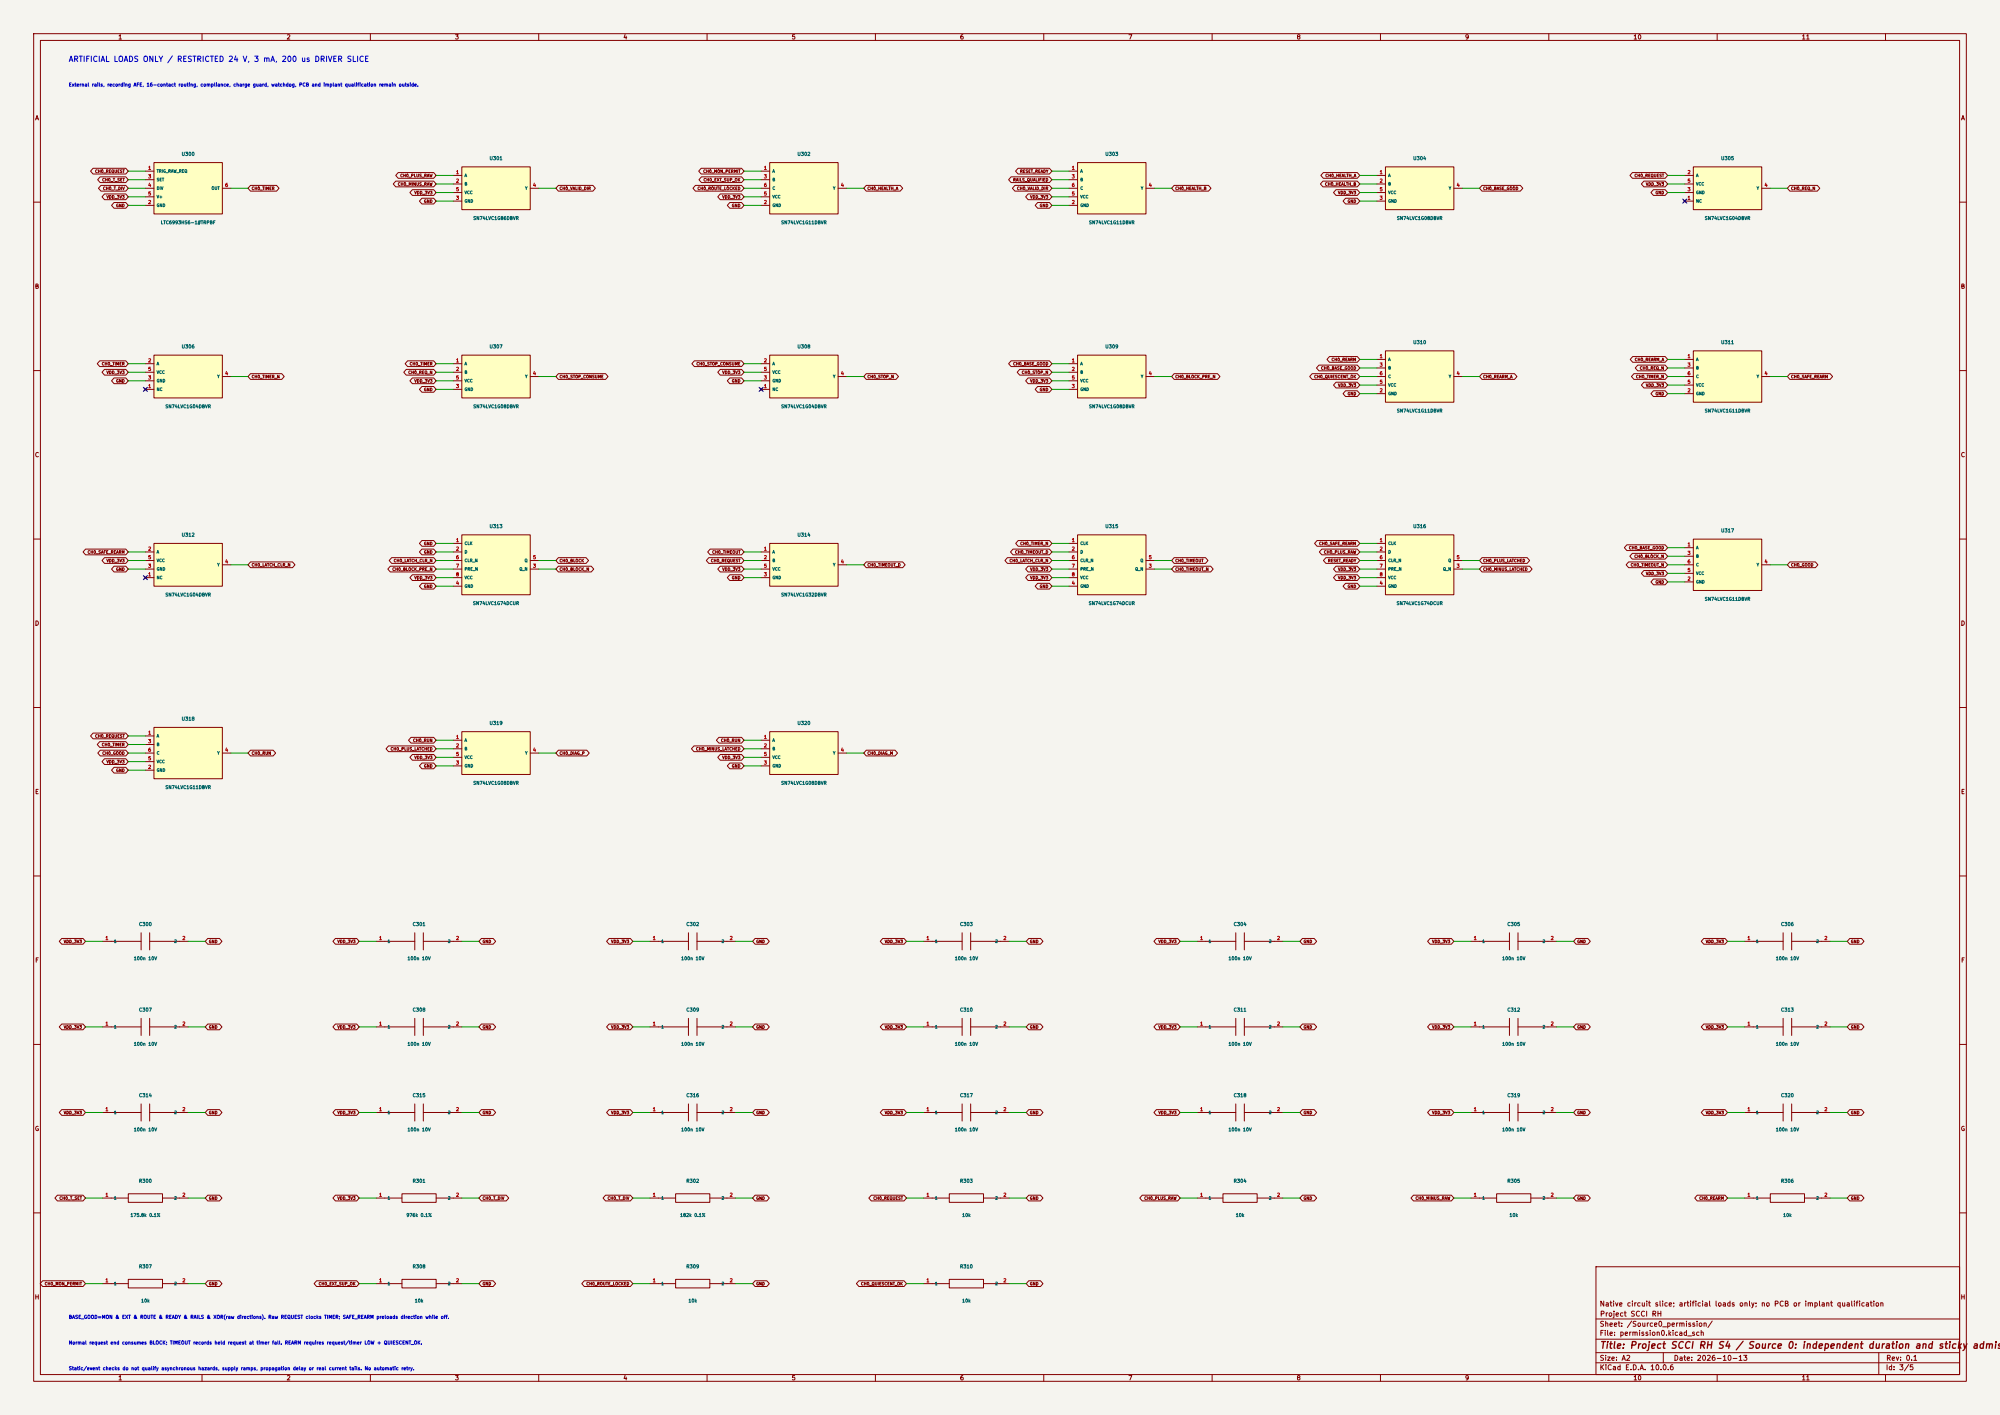
[picture p171: page 3]

VDD_3V3 ARTIFICIAL LOADS ONLY / RESTRICTED 24 V, 3 mA, 200 us DRIVER SLICE

Native circuit slice; artificial loads only; no PCB or implant qualification
Project SCCI RH
Sheet: /Source0_permission/
File: permission0.kicad_sch
Title: Project SCCI RH S4 / Source 0: independent duration and sticky admission

BASE_GOOD=MON & EXT & ROUTE & READY & RAILS & XOR(raw directions). Raw REQUEST clocks TIMER; SAFE_REARM preloads direction while off. Static/event checks do not qualify asynchronous hazards, supply ramps, propagation delay or real current tails. No automatic retry. Normal request end consumes BLOCK; TIMEOUT records held request at timer fall. REARM requires request/timer LOW + QUIESCENT_OK.

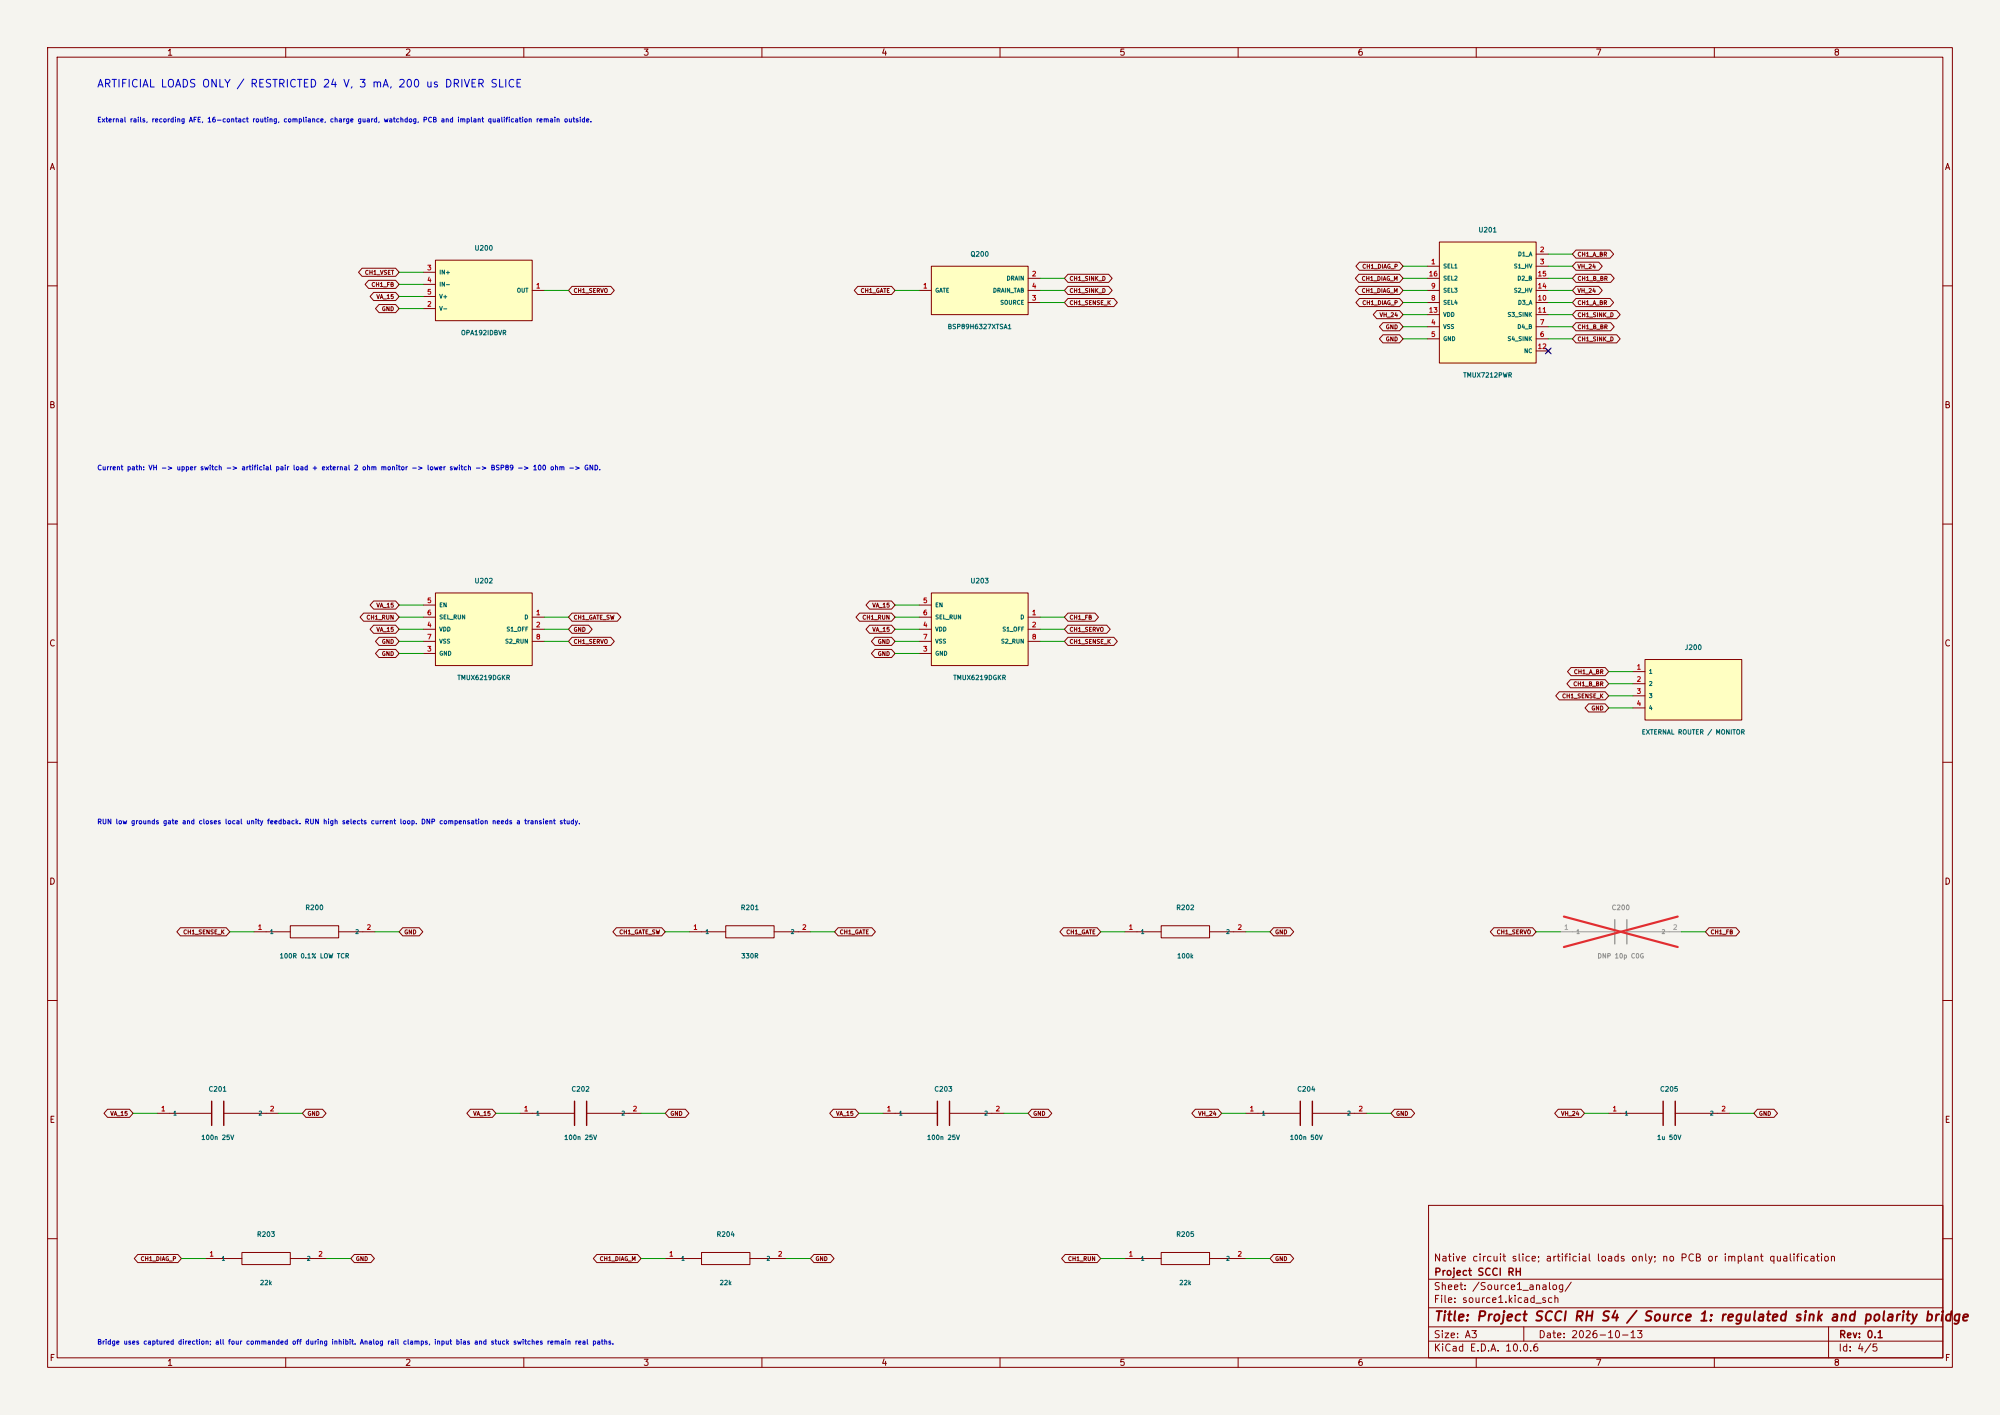
[picture p172: page 4]
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

CH1_SERVO Current path: VH -> upper switch -> artificial pair load + external 2 ohm monitor -> lower switch -> BSP89 -> 100 ohm -> GND.

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

Native circuit slice; artificial loads only; no PCB or implant qualification
Project SCCI RH
Sheet: /Source1_analog/
File: source1.kicad_sch
Title: Project SCCI RH S4 / Source 1: regulated sink and polarity bridge

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

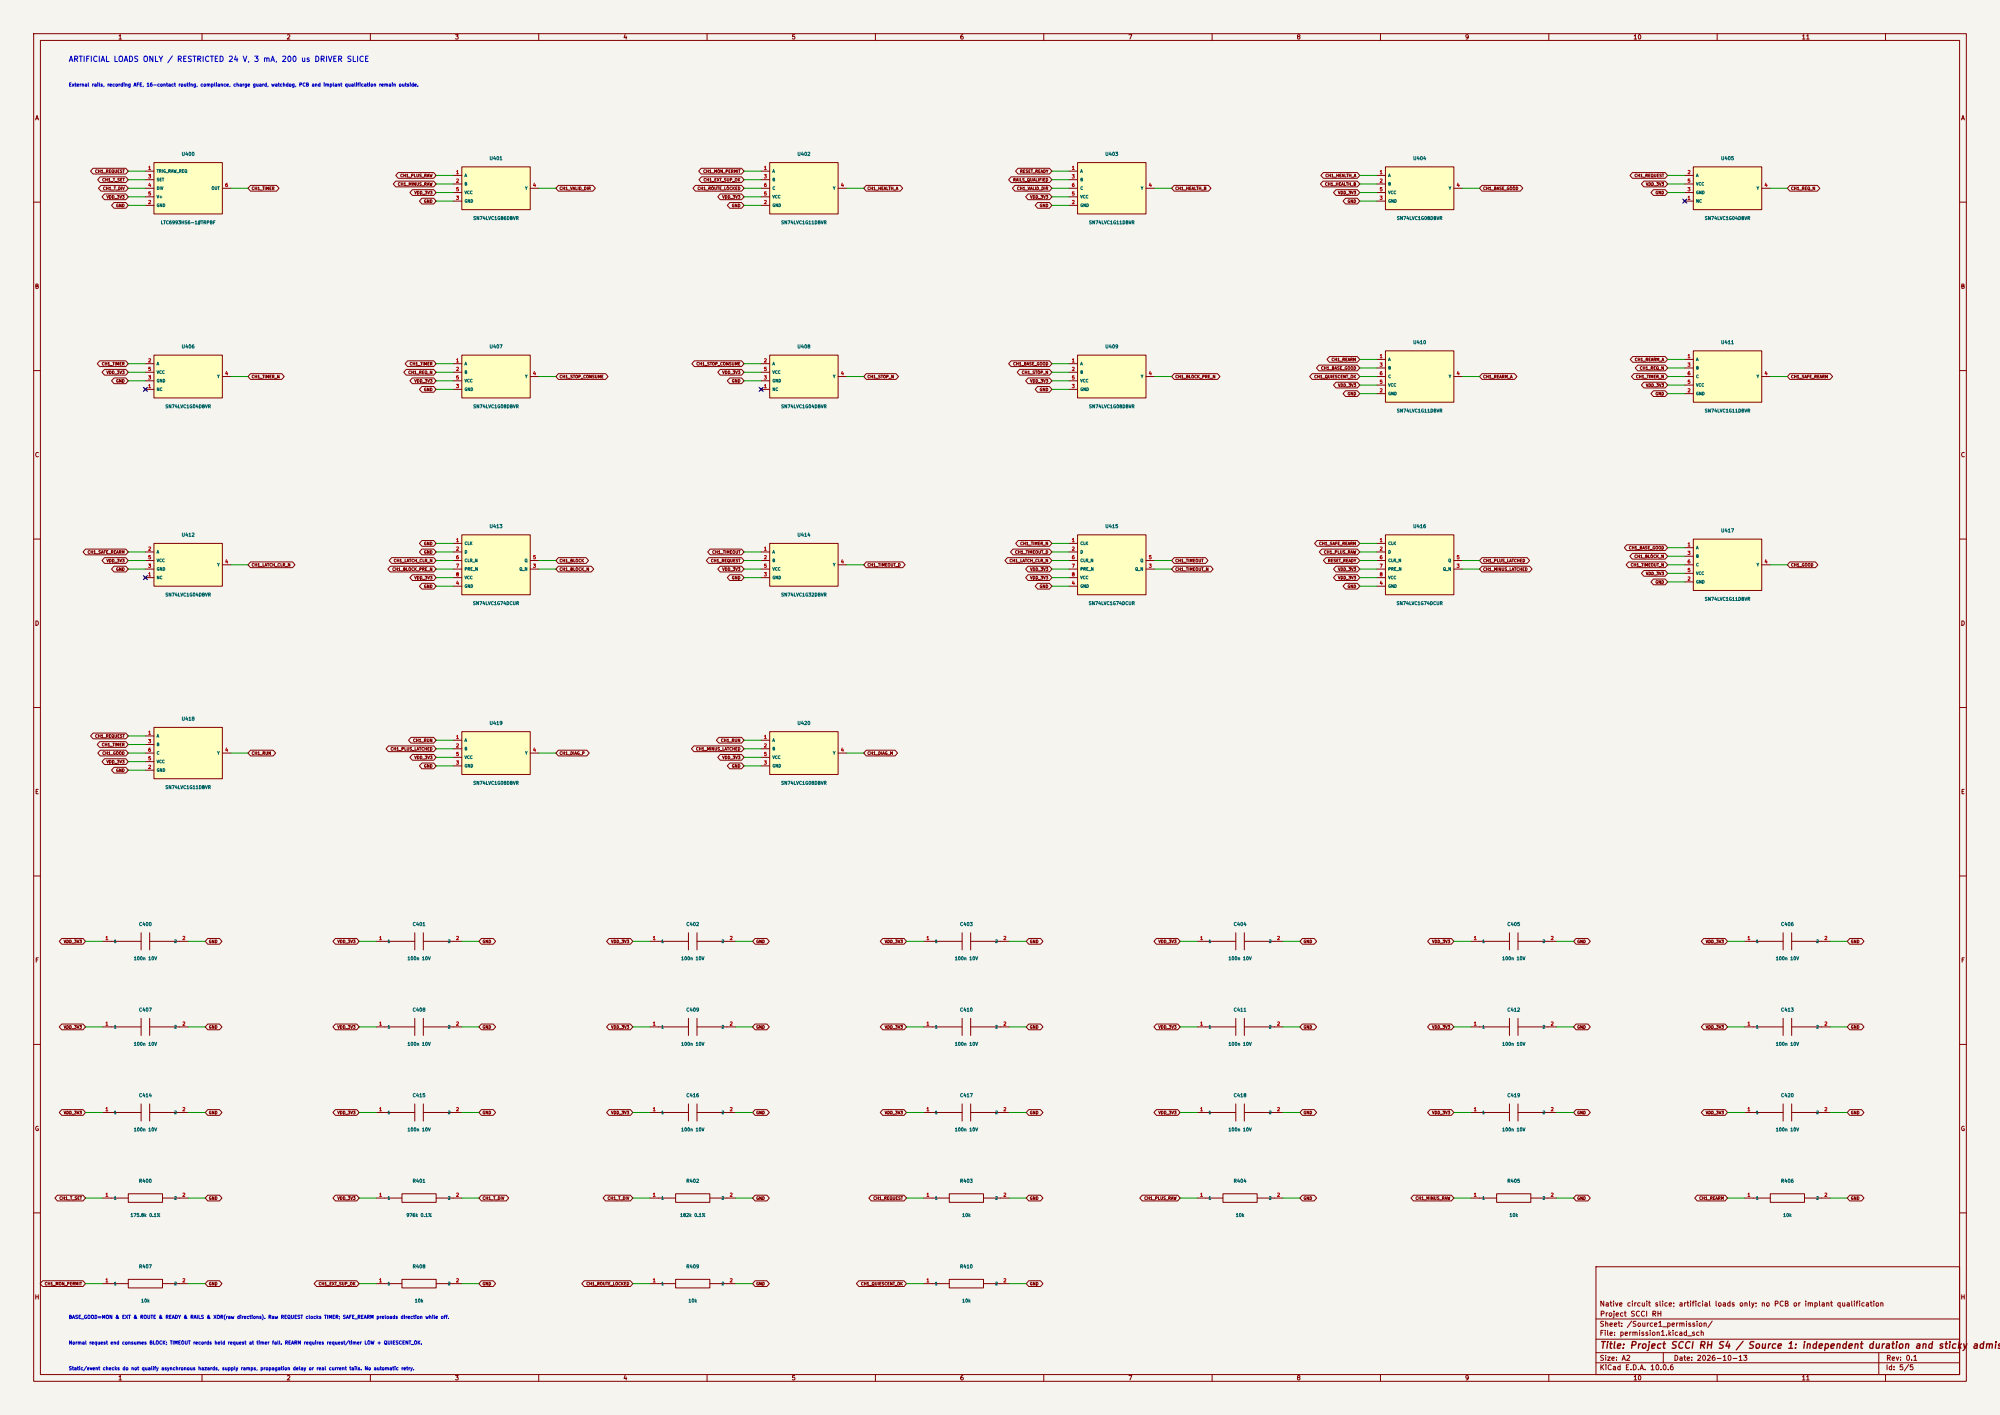
[picture p173: page 5]

VDD_3V3 ARTIFICIAL LOADS ONLY / RESTRICTED 24 V, 3 mA, 200 us DRIVER SLICE

Native circuit slice; artificial loads only; no PCB or implant qualification
Project SCCI RH
Sheet: /Source1_permission/
File: permission1.kicad_sch
Title: Project SCCI RH S4 / Source 1: independent duration and sticky admission

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
