pratham-cloud-ctrl/Project-SCCI-RH/electronics/stage4/monitoring-transport/monitoring_transport.pdf

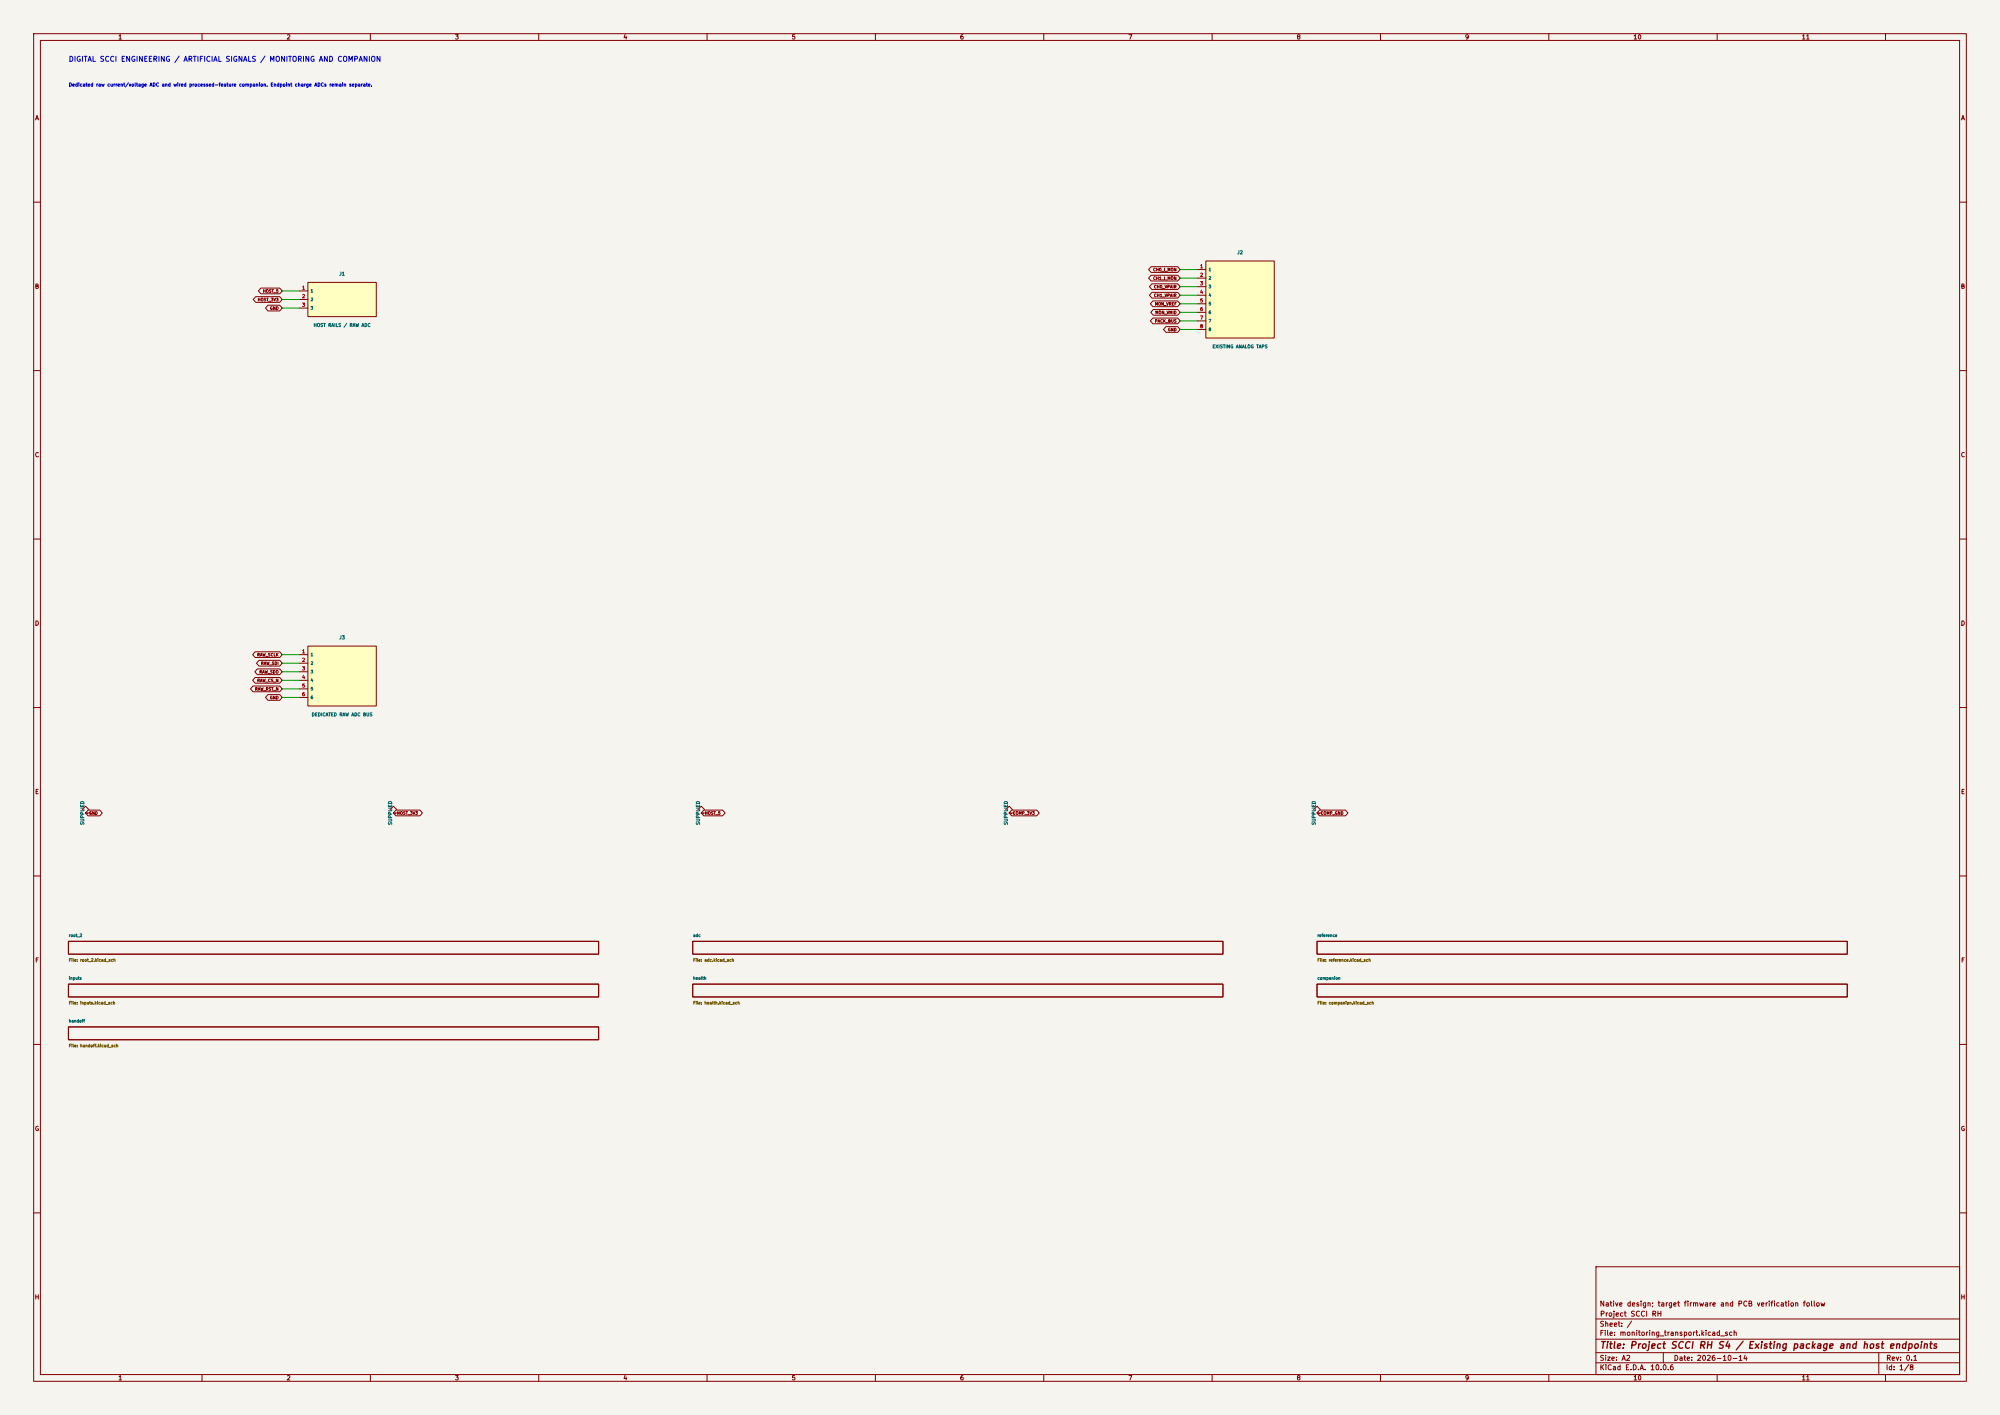
[picture p177: page 1]

DIGITAL SCCI ENGINEERING / ARTIFICIAL SIGNALS / MONITORING AND COMPANION

Dedicated raw current/voltage ADC and wired processed-feature companion. Endpoint charge ADCs remain separate.

J1 HOST RAILS / RAW ADC

Native design; target firmware and PCB verification follow
Project SCCI RH
Sheet: /
File: monitoring_transport.kicad_sch
Title: Project SCCI RH S4 / Existing package and host endpoints

Size: A2 | Rev: 0.1
KiCad E.D.A. 10.0.6 | Id: 1/8

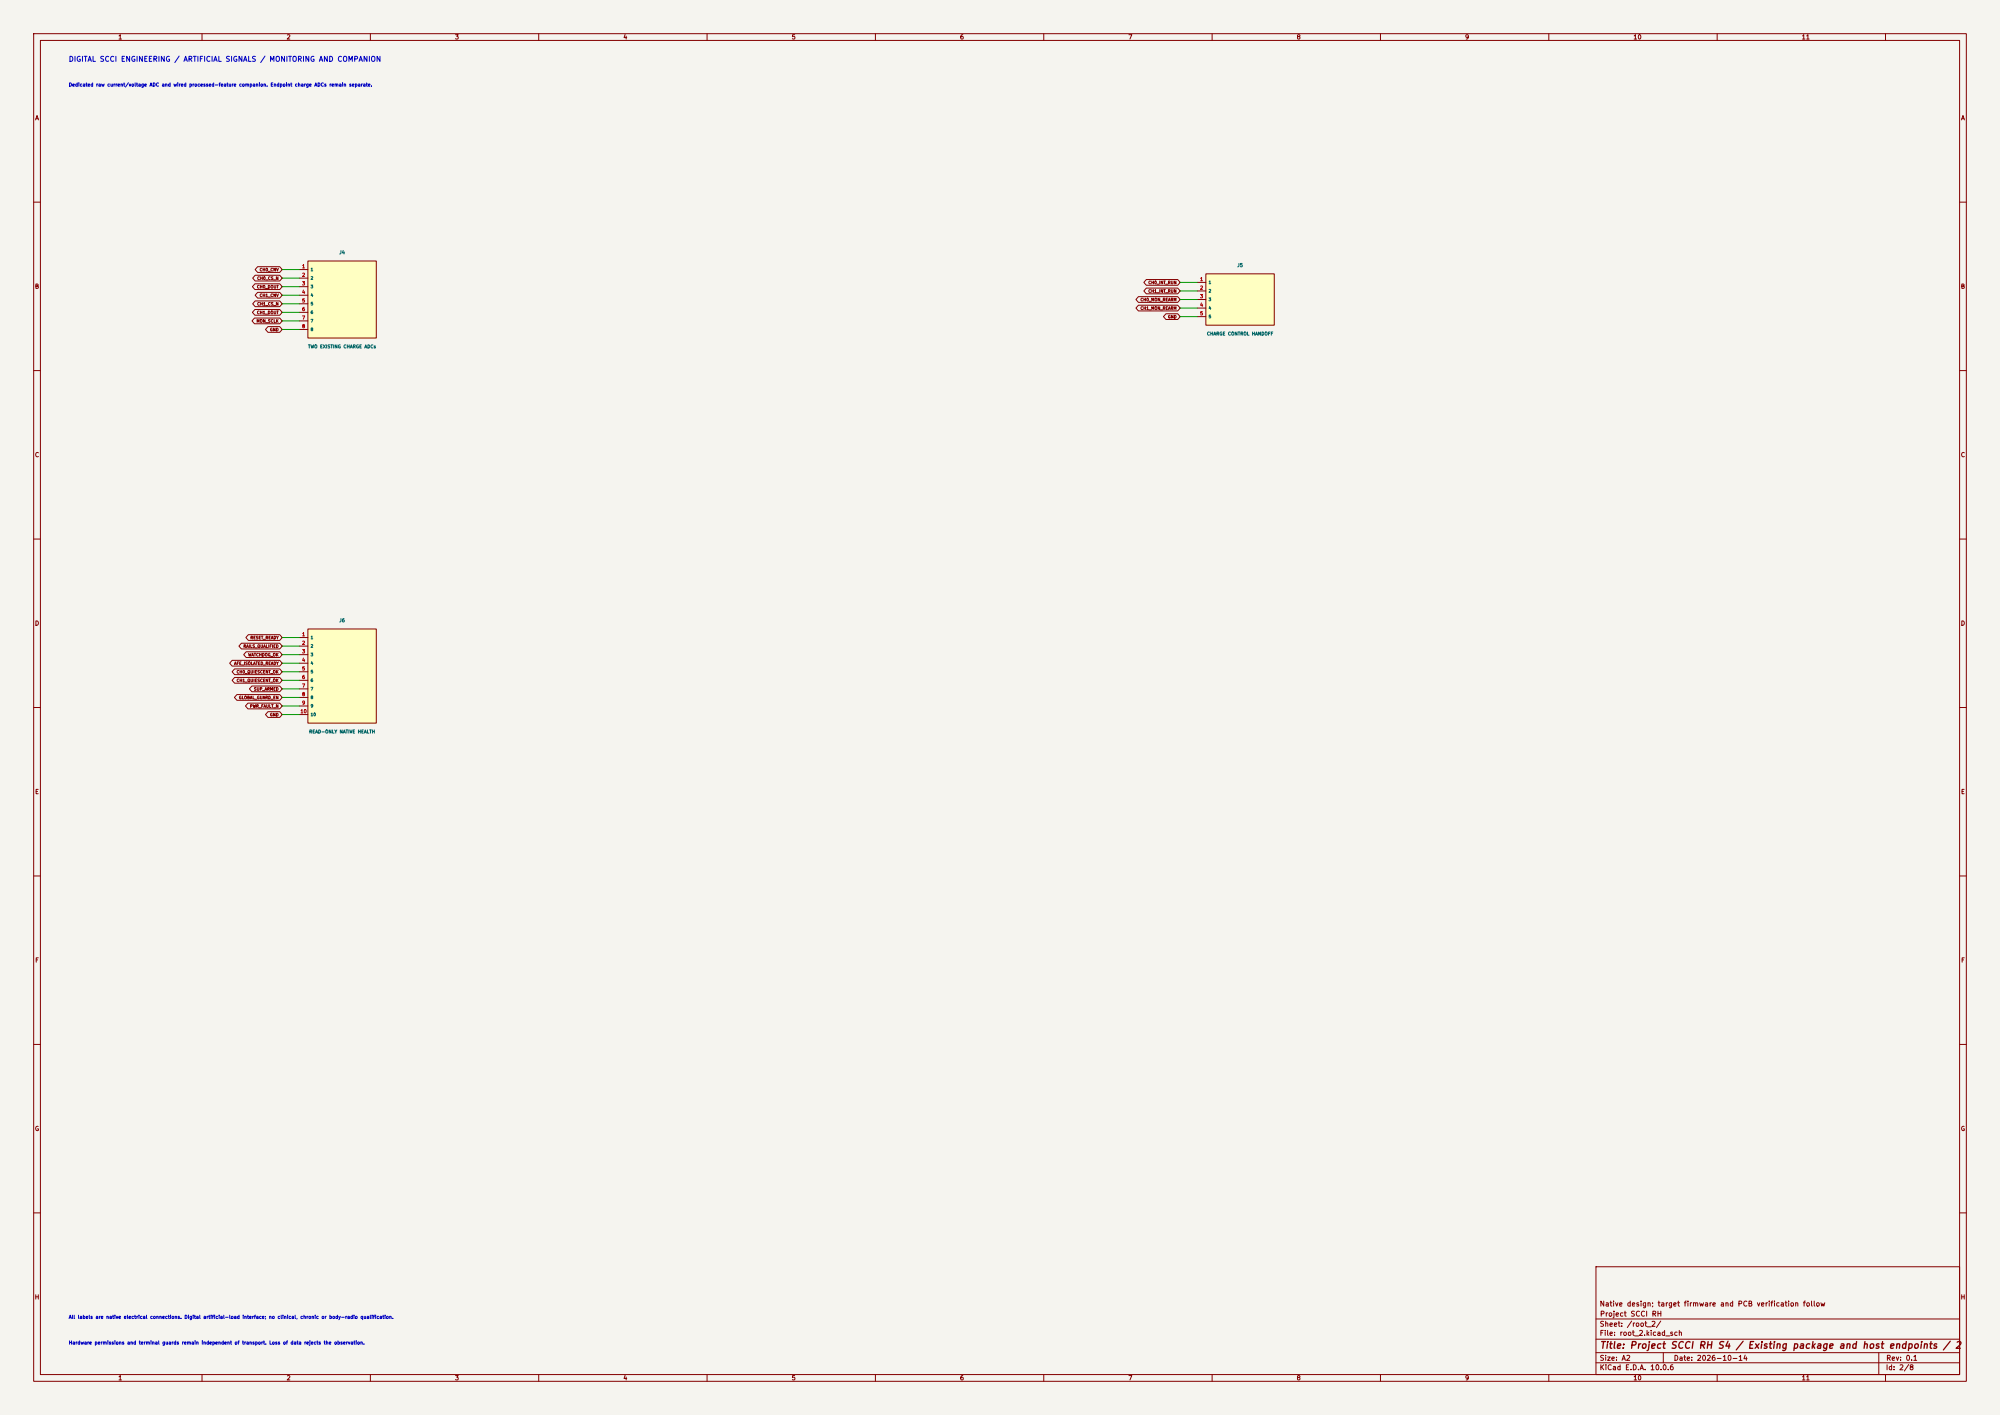
[picture p178: page 2]

TWO EXISTING CHARGE ADCs

READ-ONLY NATIVE HEALTH

Hardware permissions and terminal guards remain independent of transport. Loss of data rejects the observation. All labels are native electrical connections. Digital artificial-load interface; no clinical, chronic or body-radio qualification.

Sheet: /root_2/
File: root_2.kicad_sch
Title: Project SCCI RH S4 / Existing package and host endpoints / 2

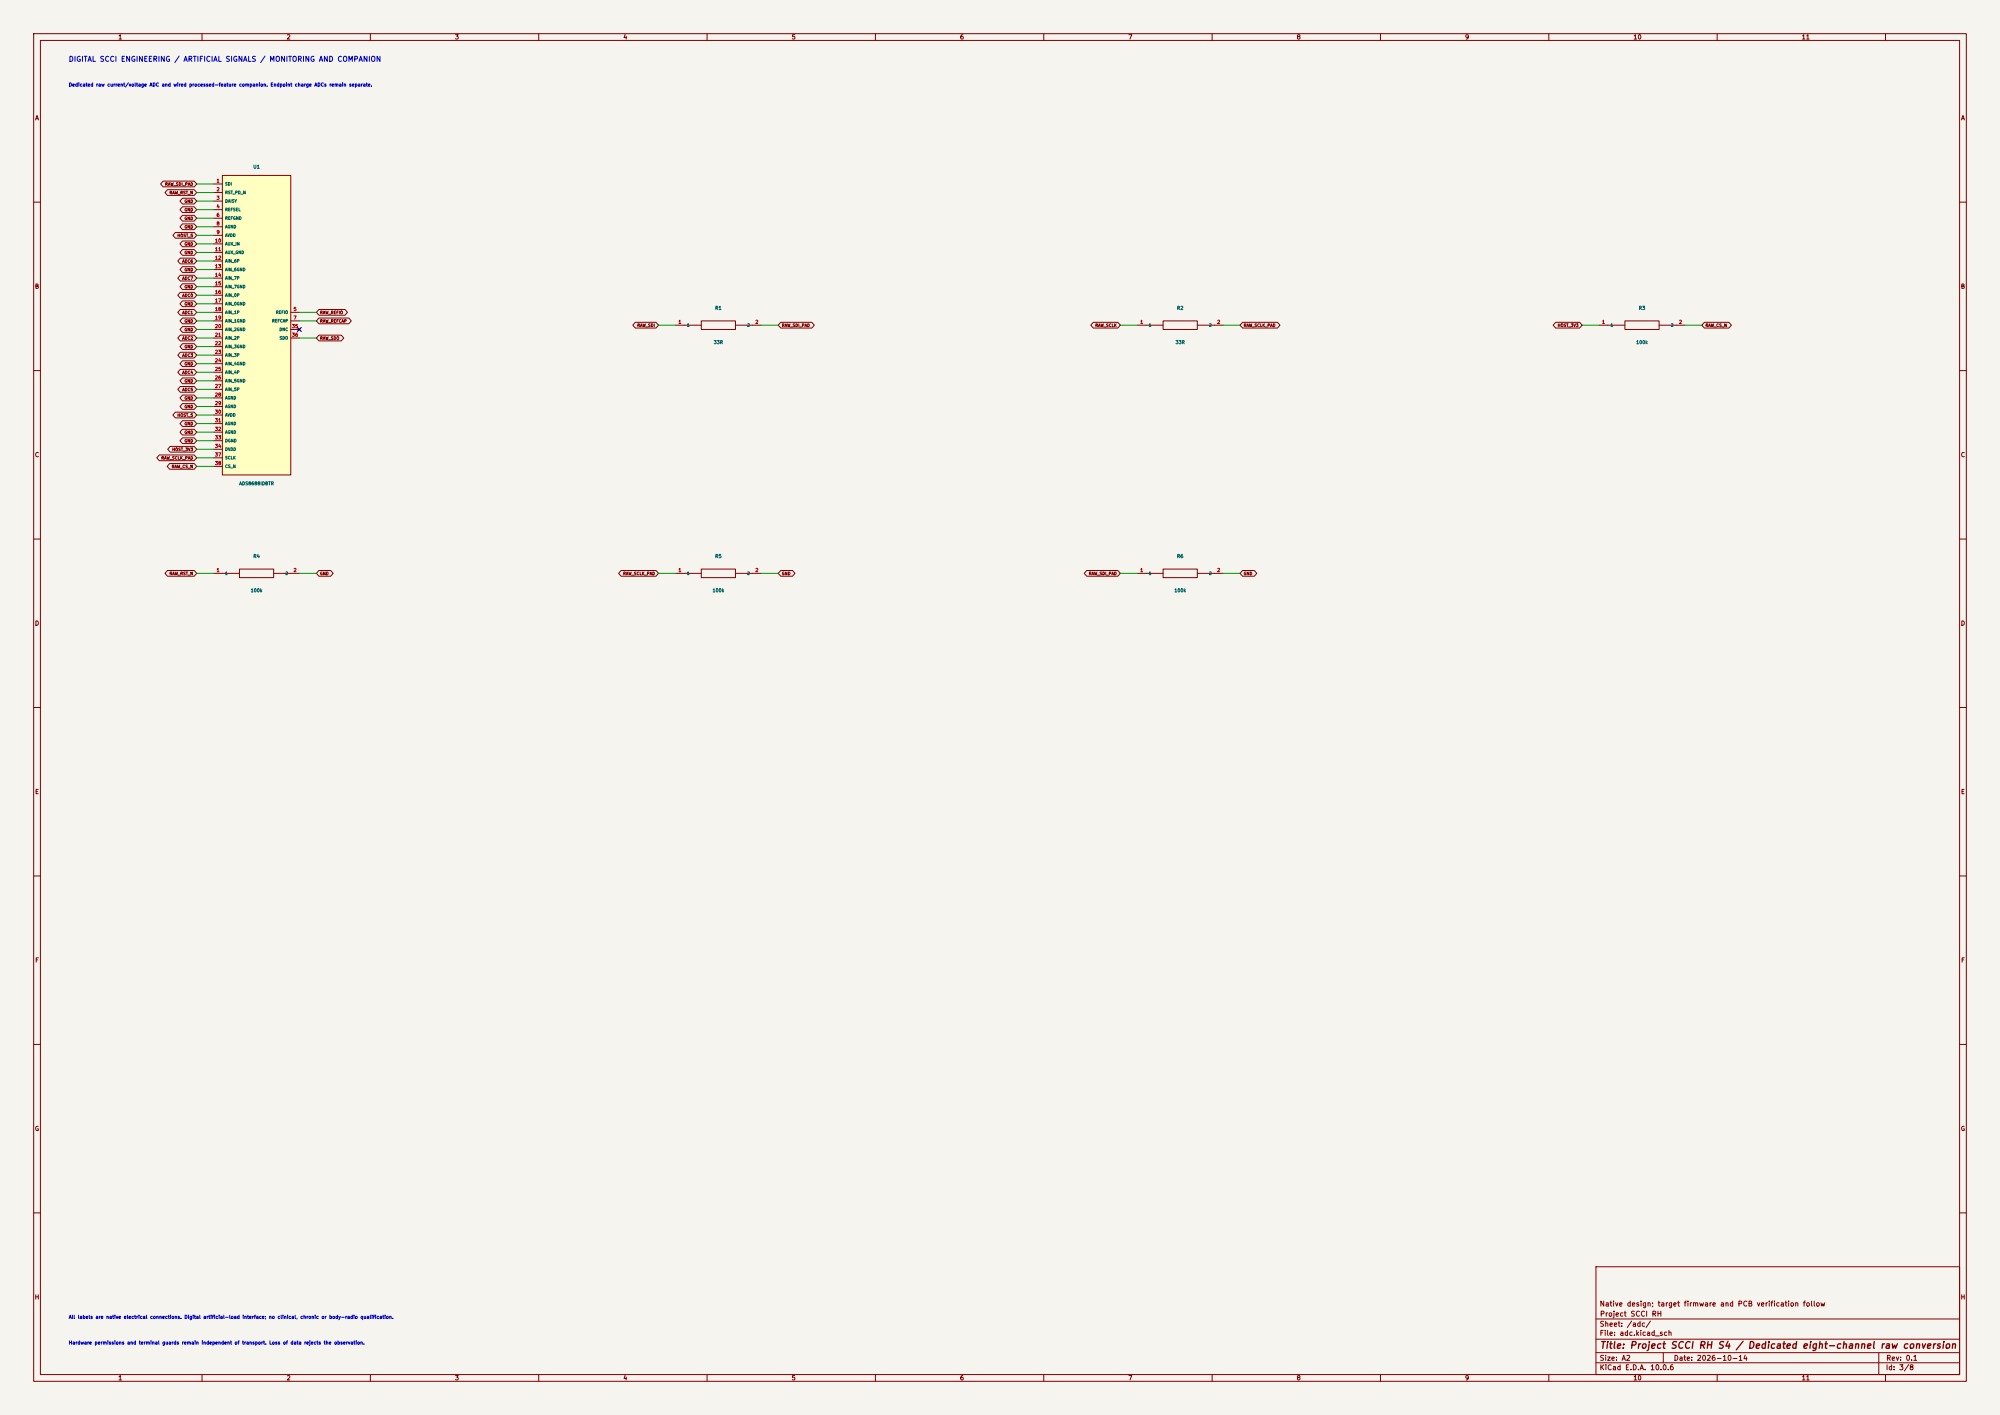
[picture p179: page 3]

Sheet: /adc/
File: adc.kicad_sch
Title: Project SCCI RH S4 / Dedicated eight-channel raw conversion

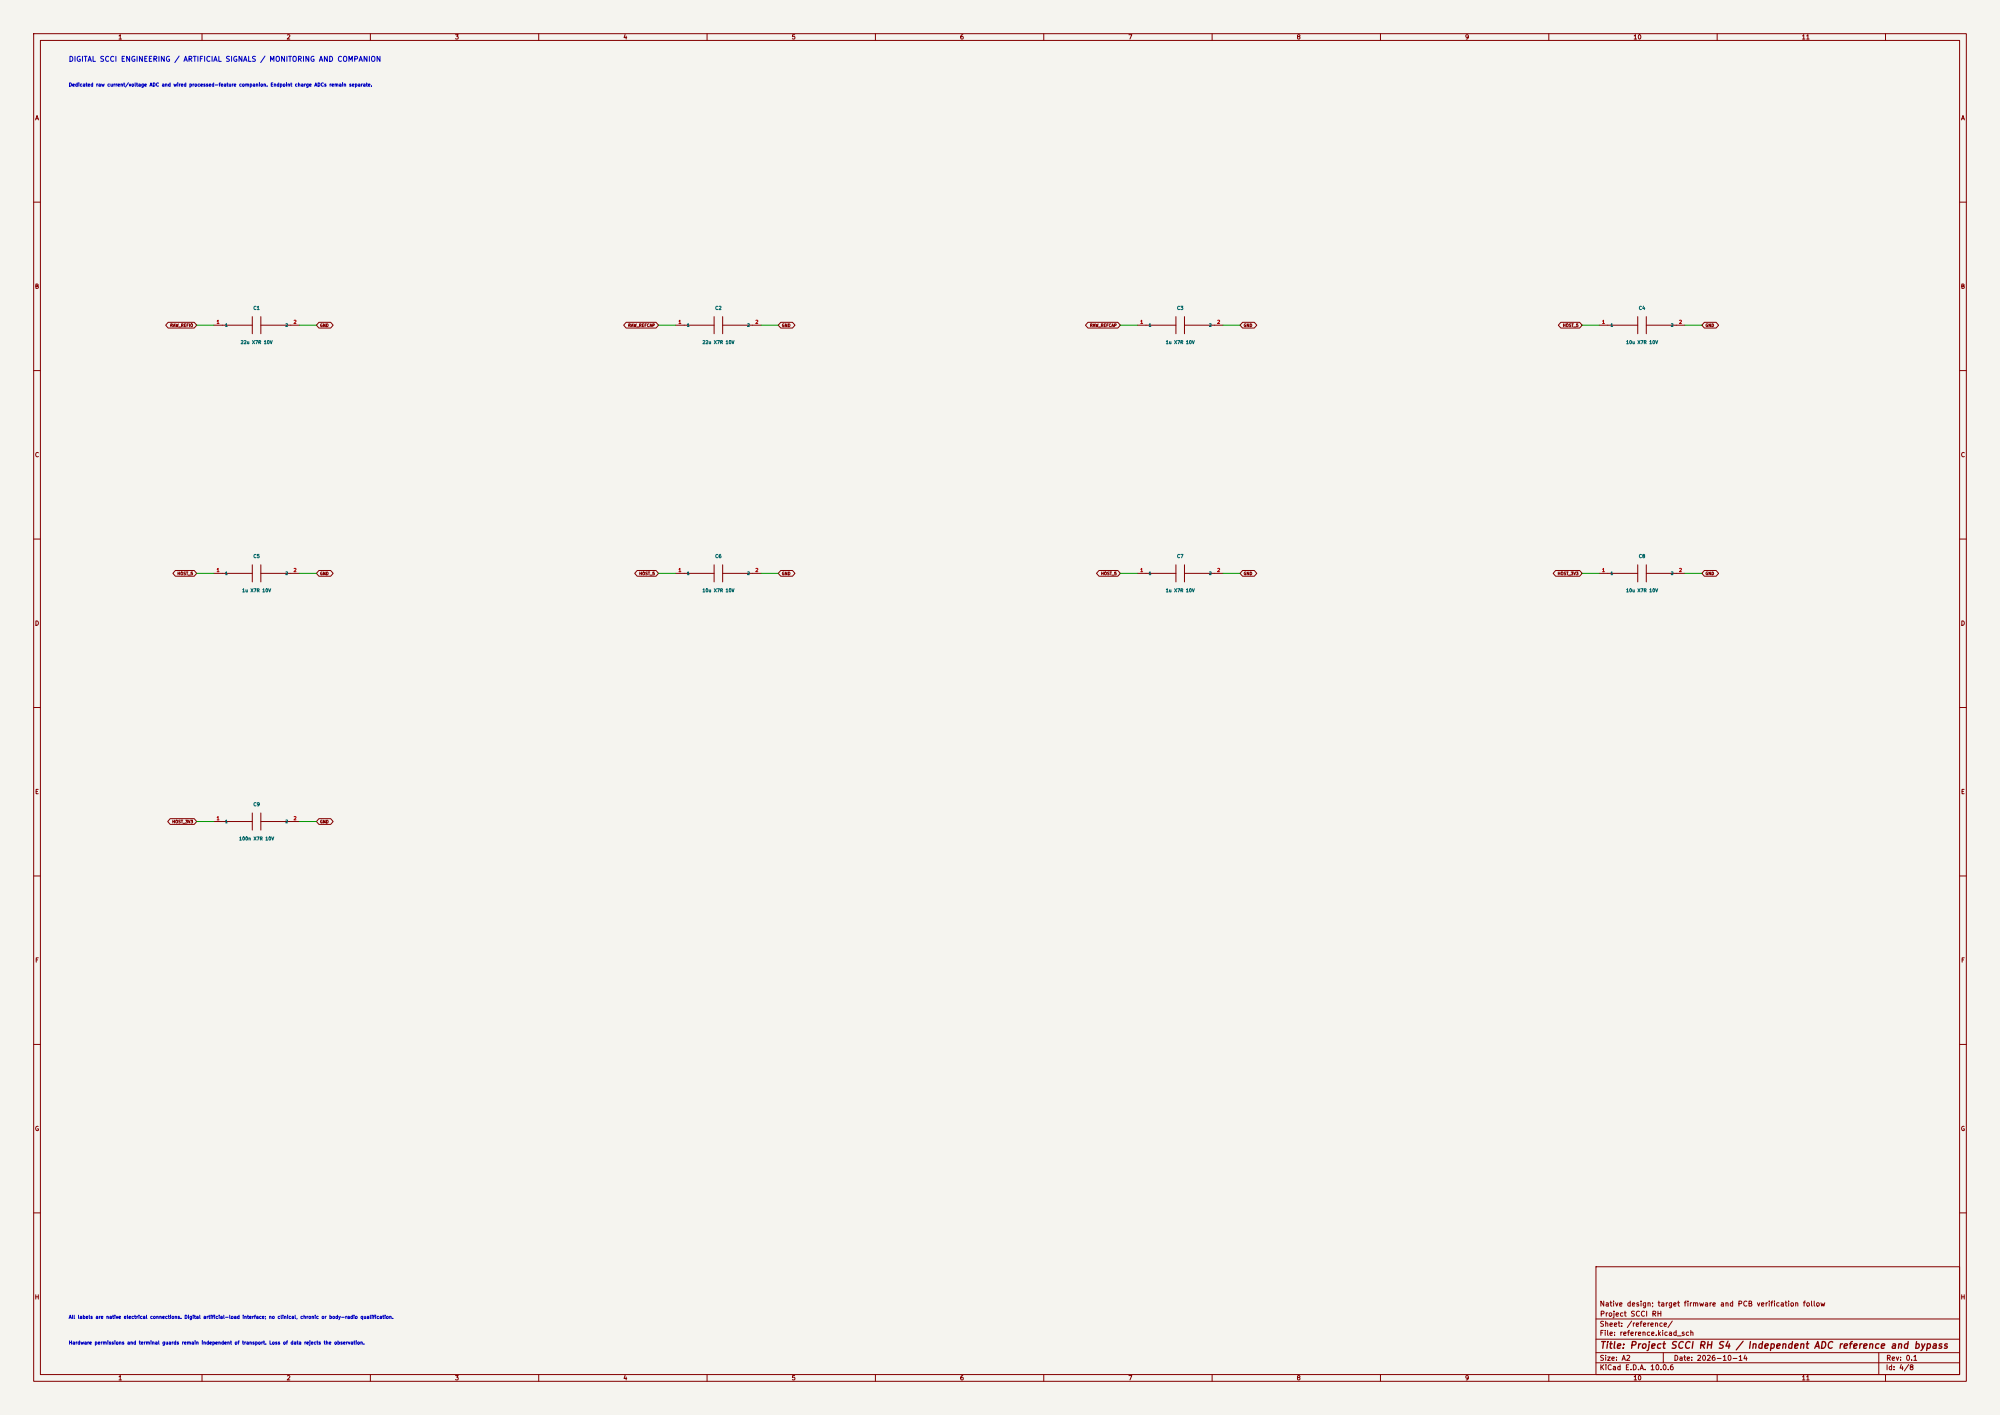
[picture p180: page 4]

Sheet: /reference/
File: reference.kicad_sch
Title: Project SCCI RH S4 / Independent ADC reference and bypass

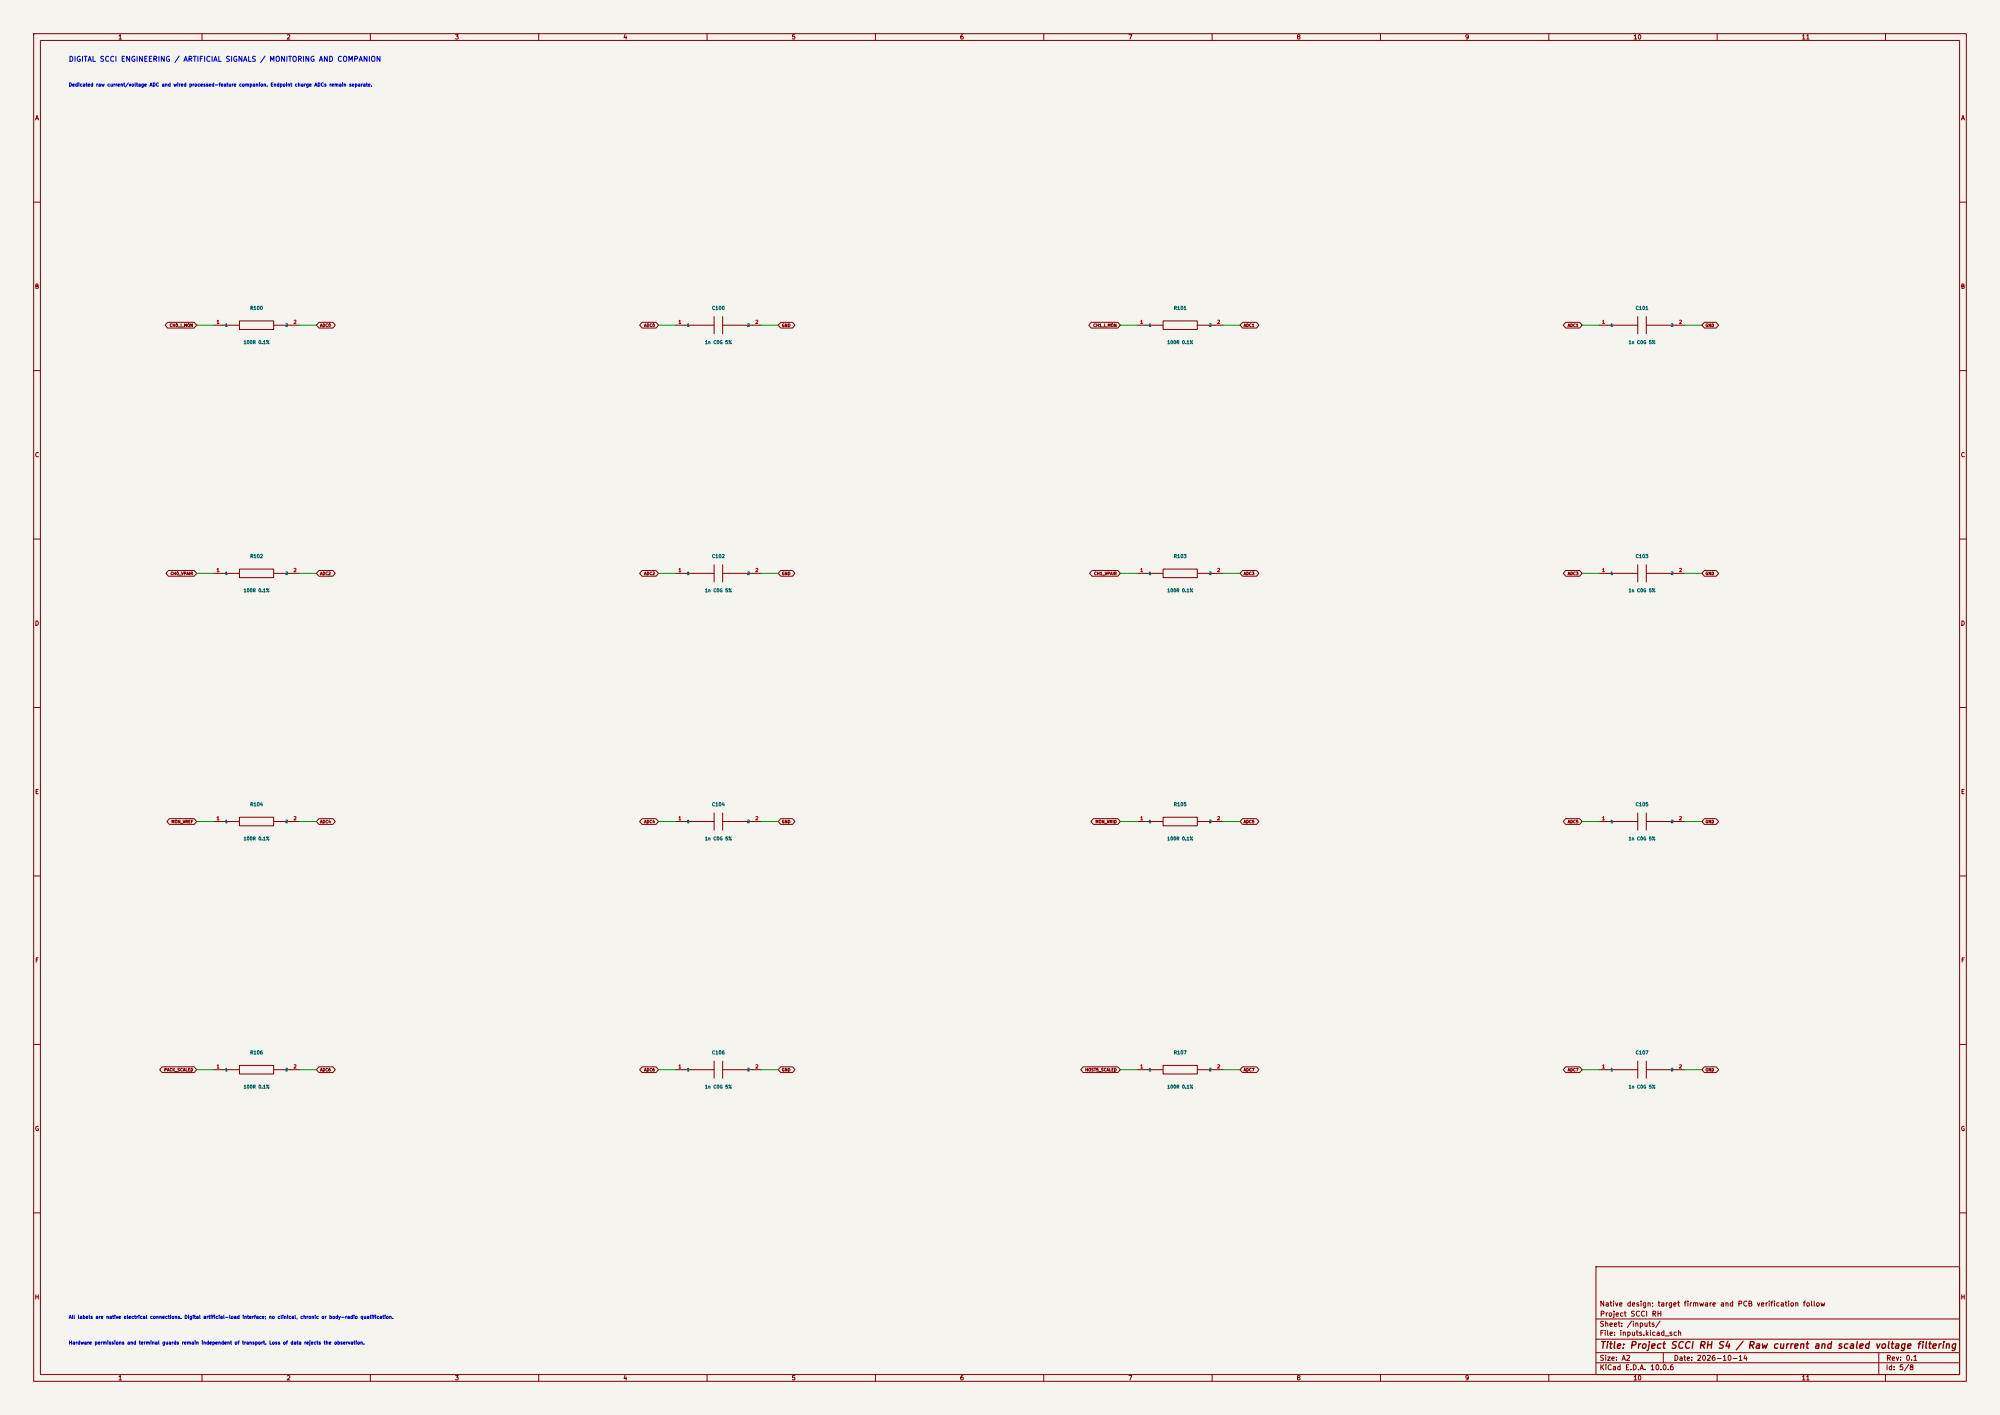
[picture p181: page 5]

Dedicated raw current/voltage ADC and wired processed-feature companion. Endpoint charge ADCs remain separate. DIGITAL SCCI ENGINEERING / ARTIFICIAL SIGNALS / MONITORING AND COMPANION

Sheet: /inputs/
File: inputs.kicad_sch
Title: Project SCCI RH S4 / Raw current and scaled voltage filtering

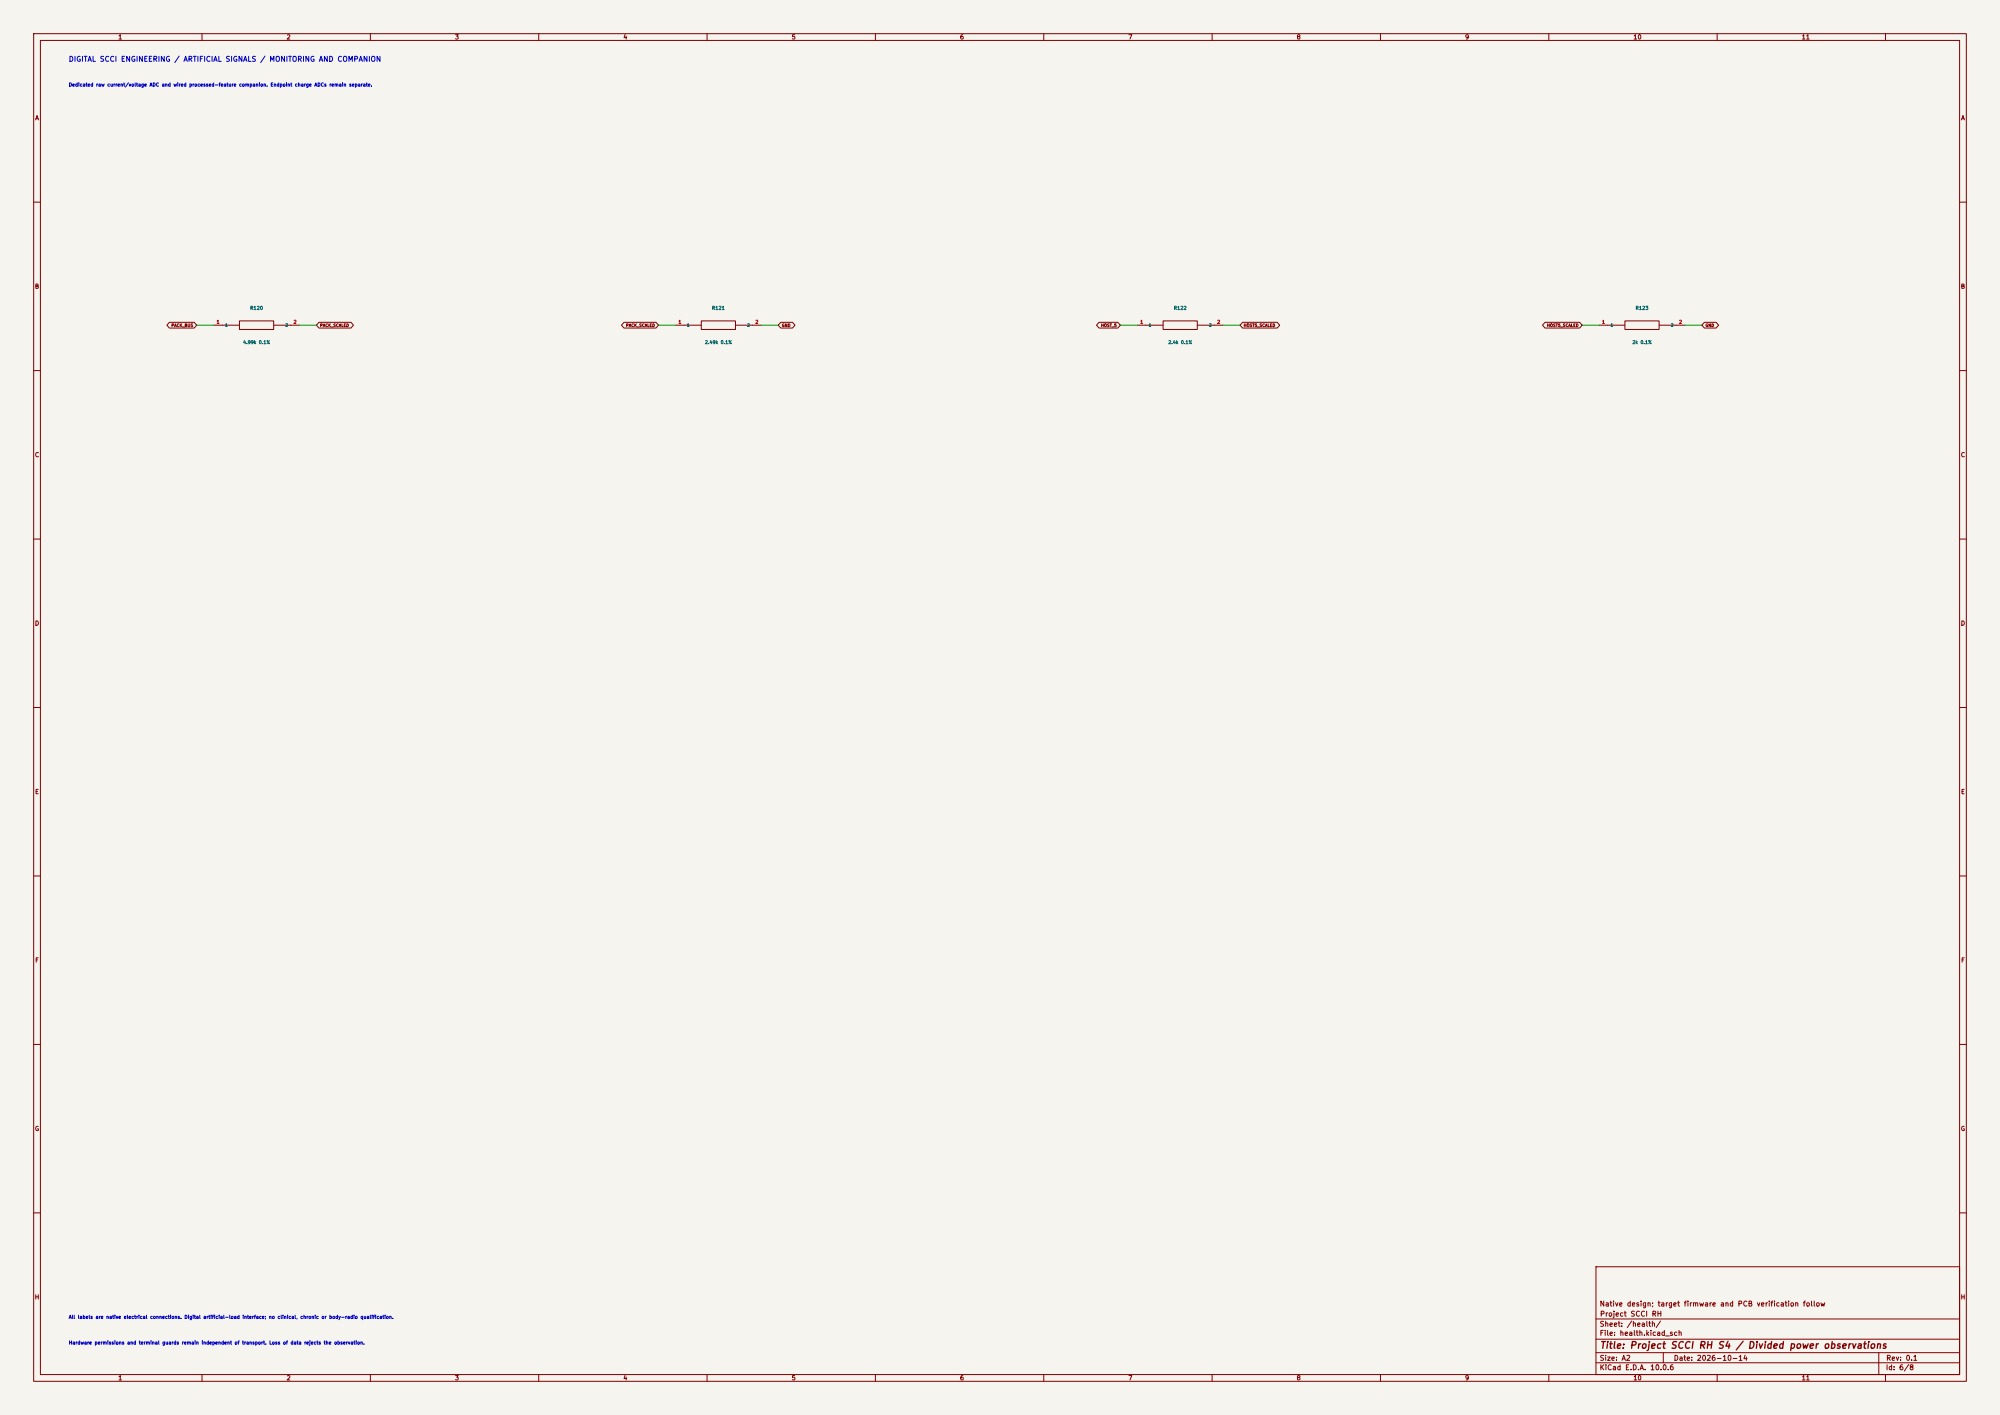
[picture p182: page 6]
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

All labels are native electrical connections. Digital artificial-load interface; no clinical, chronic or body-radio qualification. Hardware permissions and terminal guards remain independent of transport. Loss of data rejects the observation.

Sheet: /health/
File: health.kicad_sch
Title: Project SCCI RH S4 / Divided power observations

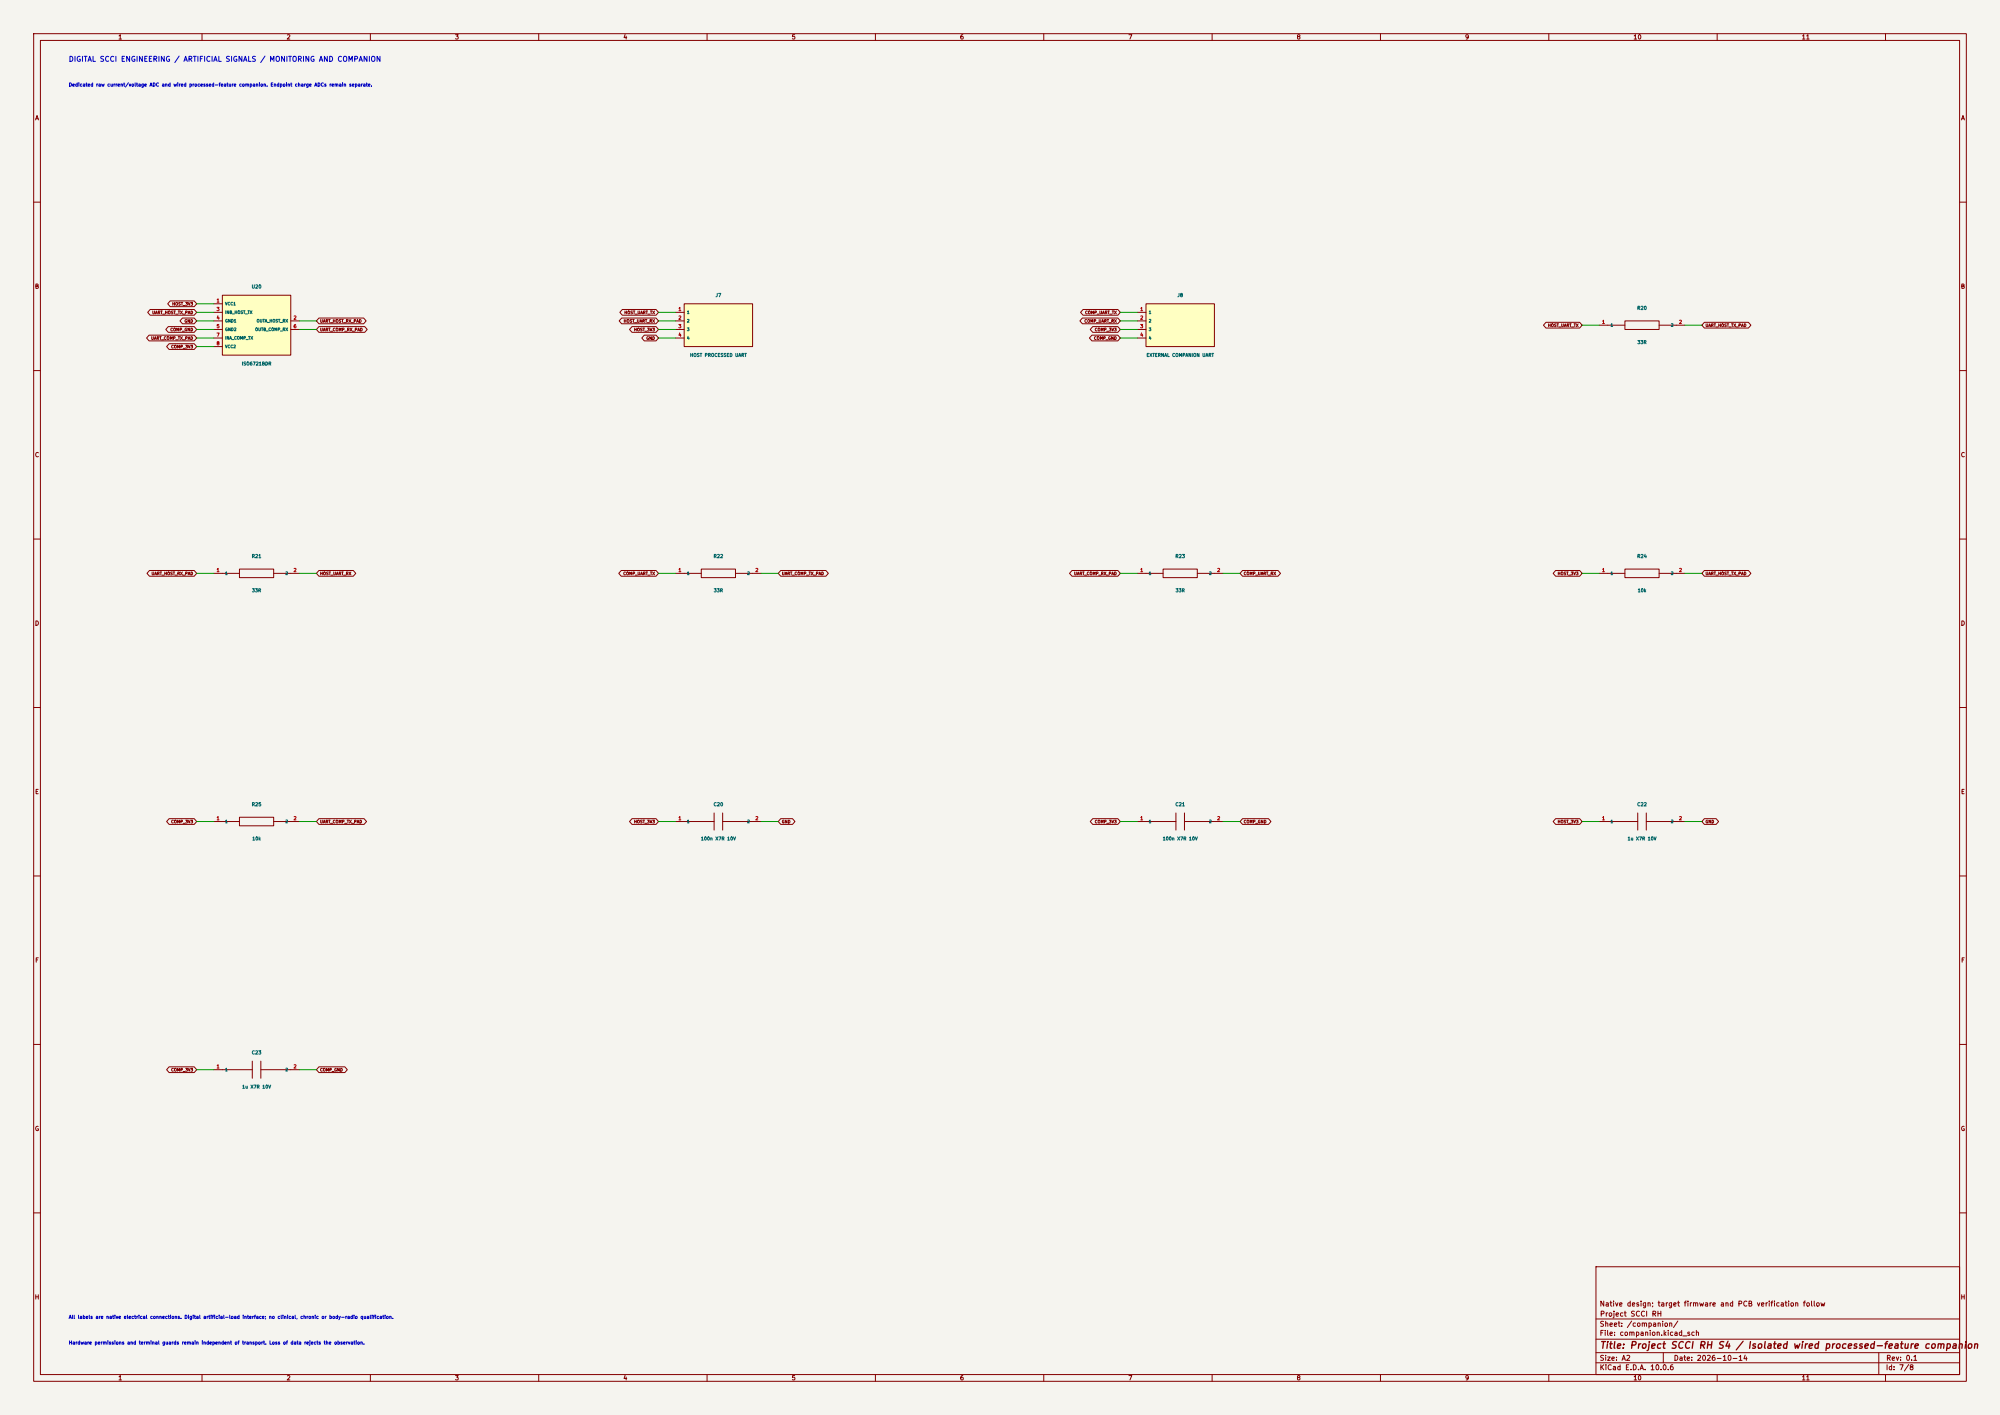
[picture p183: page 7]

Sheet: /companion/
File: companion.kicad_sch
Title: Project SCCI RH S4 / Isolated wired processed-feature companion

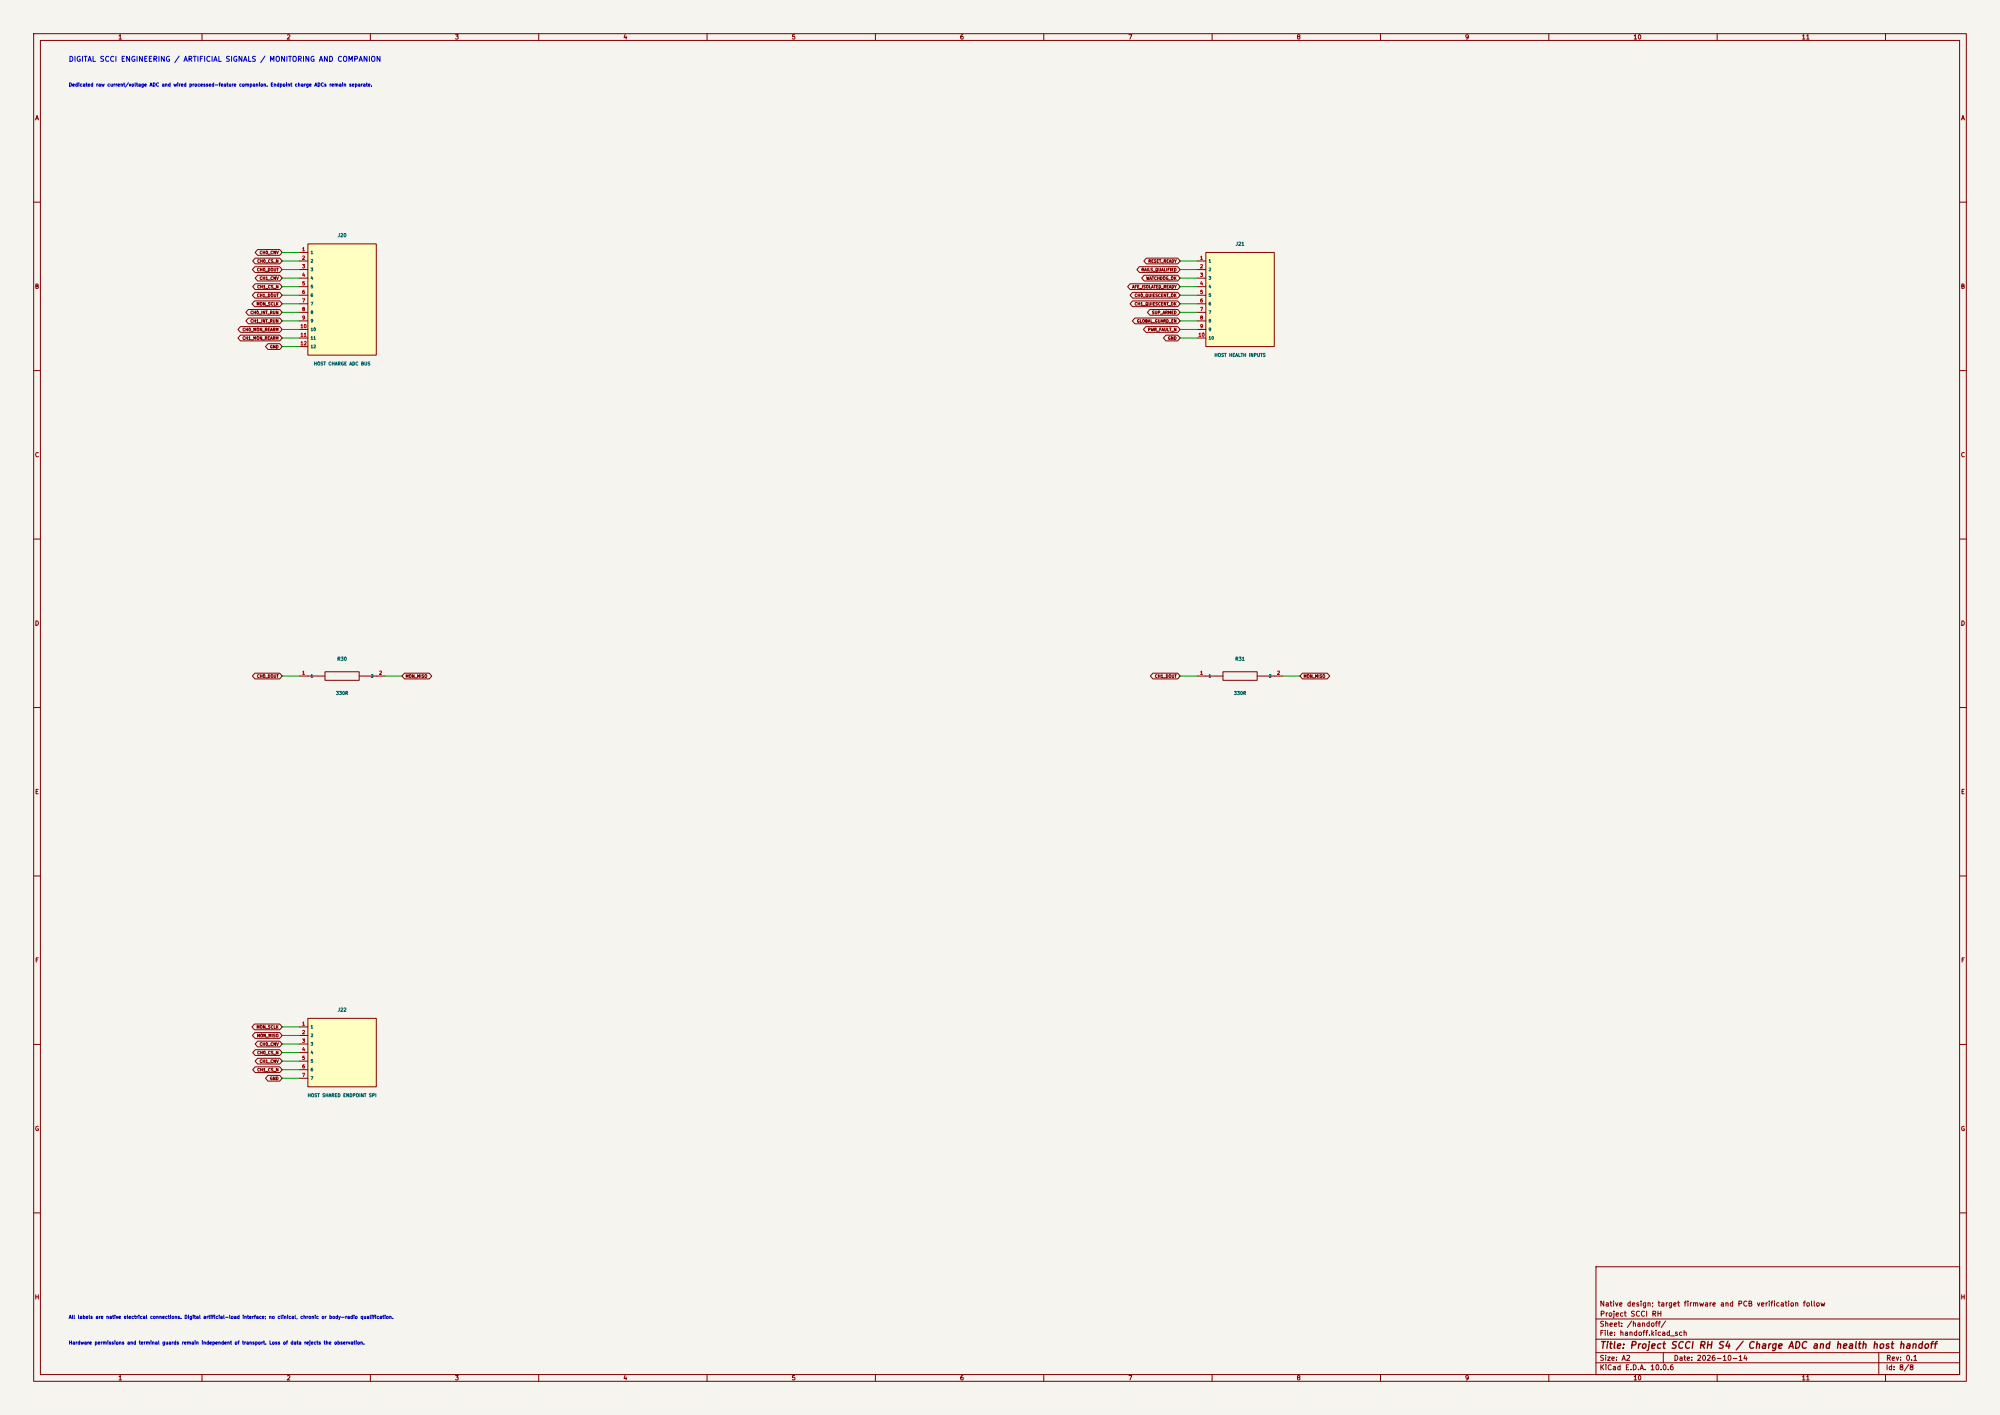
[picture p184: page 8]

CH1_DOUT DIGITAL SCCI ENGINEERING / ARTIFICIAL SIGNALS / MONITORING AND COMPANION

J20 HOST CHARGE ADC BUS

J22 HOST SHARED ENDPOINT SPI

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

Sheet: /handoff/
File: handoff.kicad_sch
Title: Project SCCI RH S4 / Charge ADC and health host handoff
