pratham-cloud-ctrl/Project-SCCI-RH/electronics/stage4/supervision/supervision.pdf

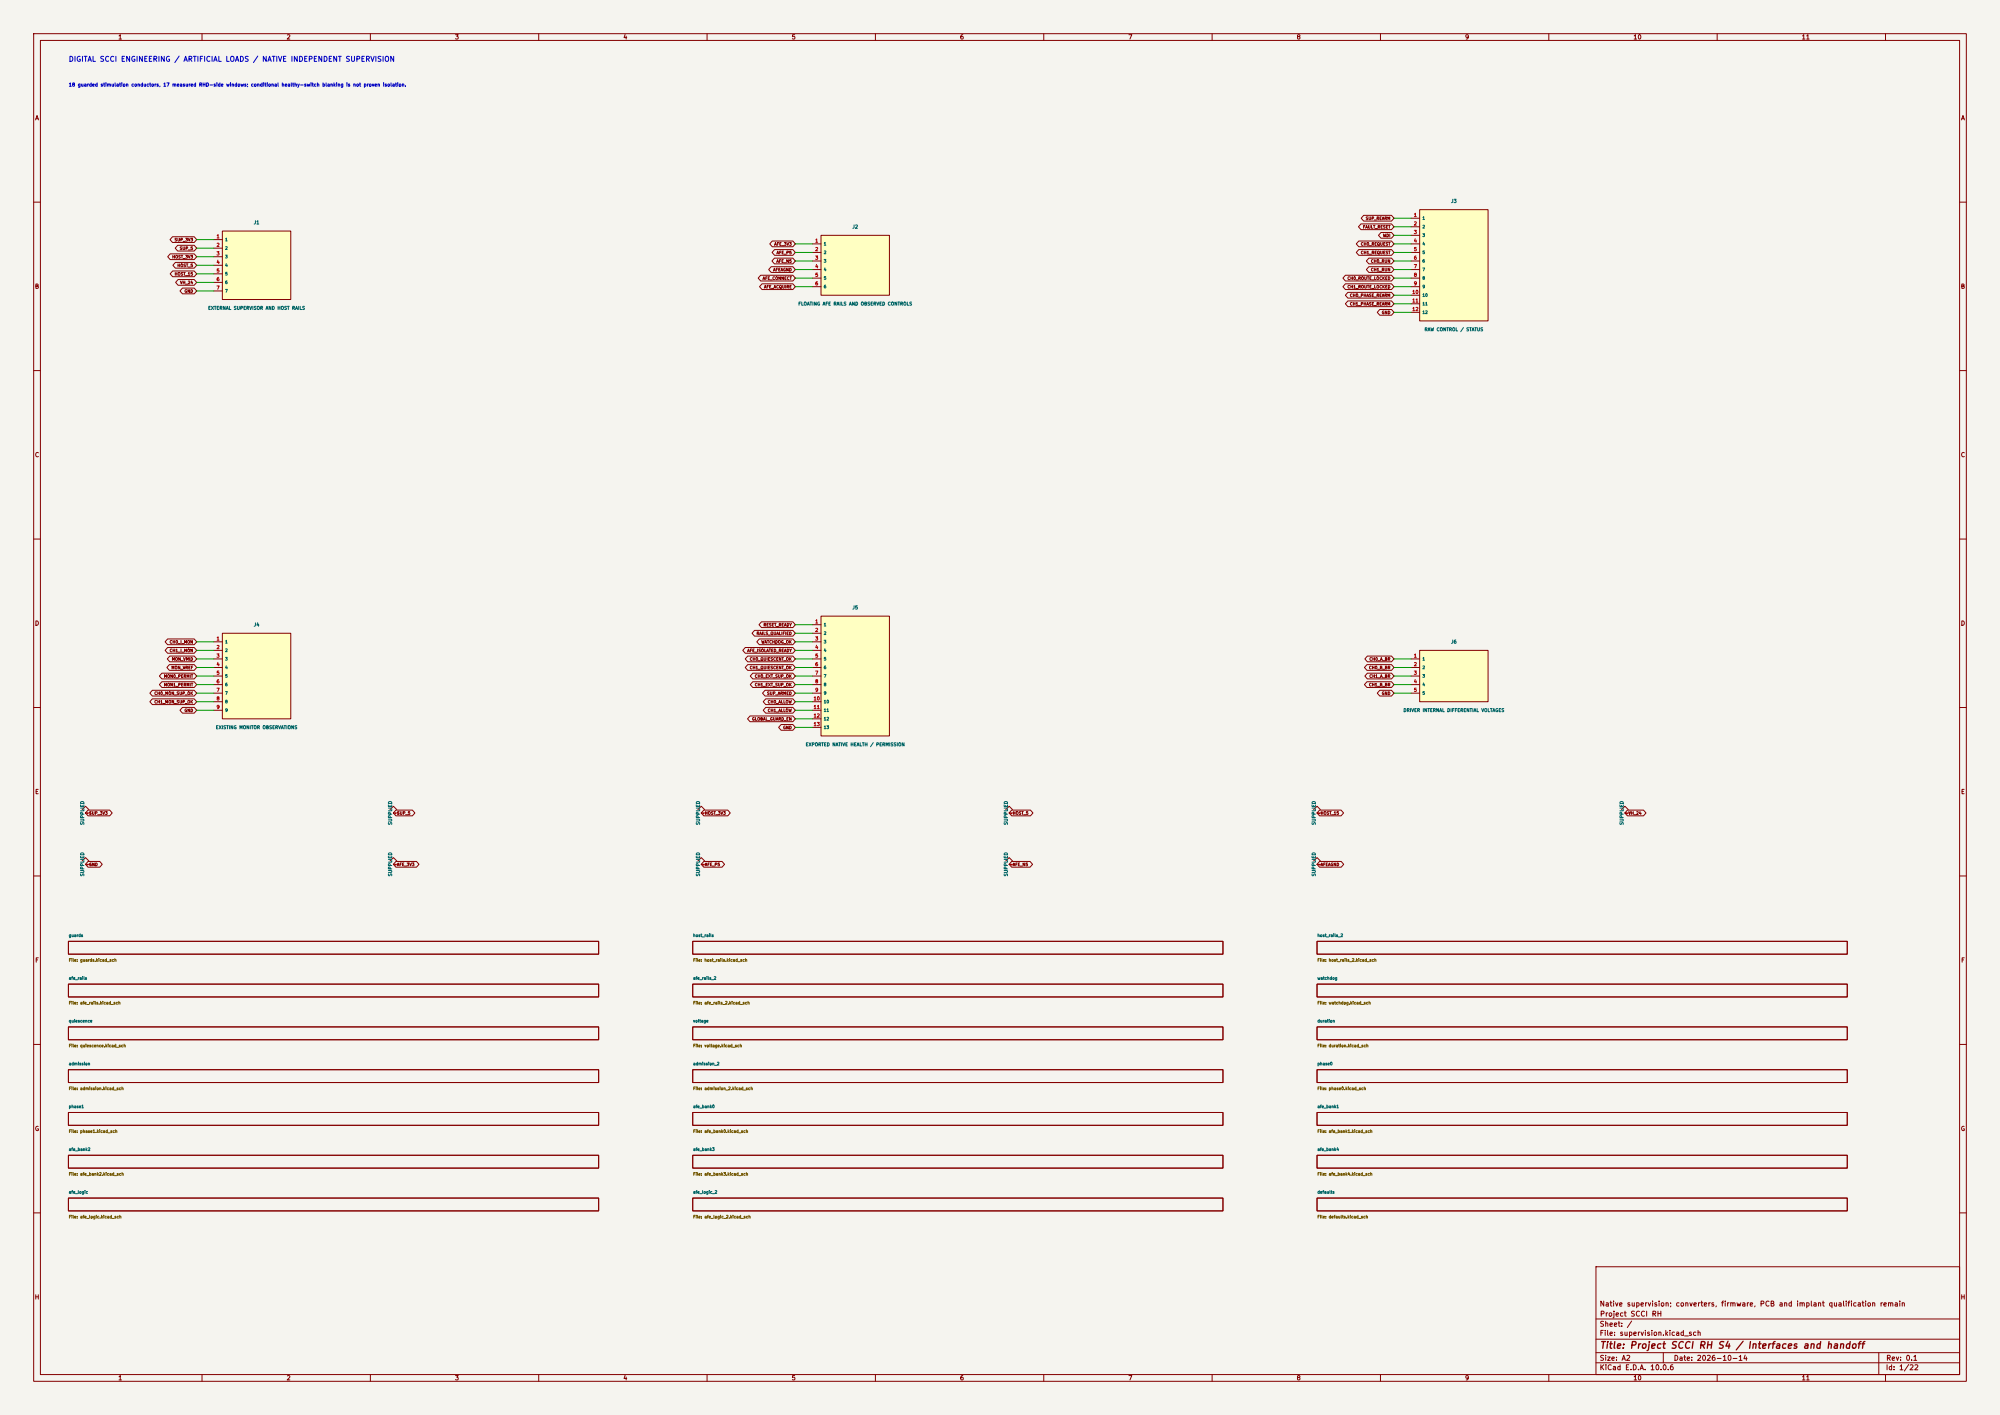
[picture p207: page 1]

18 guarded stimulation conductors, 17 measured RHD-side windows; conditional healthy-switch blanking is not proven isolation. DIGITAL SCCI ENGINEERING / ARTIFICIAL LOADS / NATIVE INDEPENDENT SUPERVISION

EXTERNAL SUPERVISOR AND HOST RAILS

DRIVER INTERNAL DIFFERENTIAL VOLTAGES SUPPLIED

EXPORTED NATIVE HEALTH / PERMISSION

Native supervision; converters, firmware, PCB and implant qualification remain
Project SCCI RH
Sheet: /
File: supervision.kicad_sch
Title: Project SCCI RH S4 / Interfaces and handoff

Size: A2 | Rev: 0.1
KiCad E.D.A. 10.0.6 | Id: 1/22

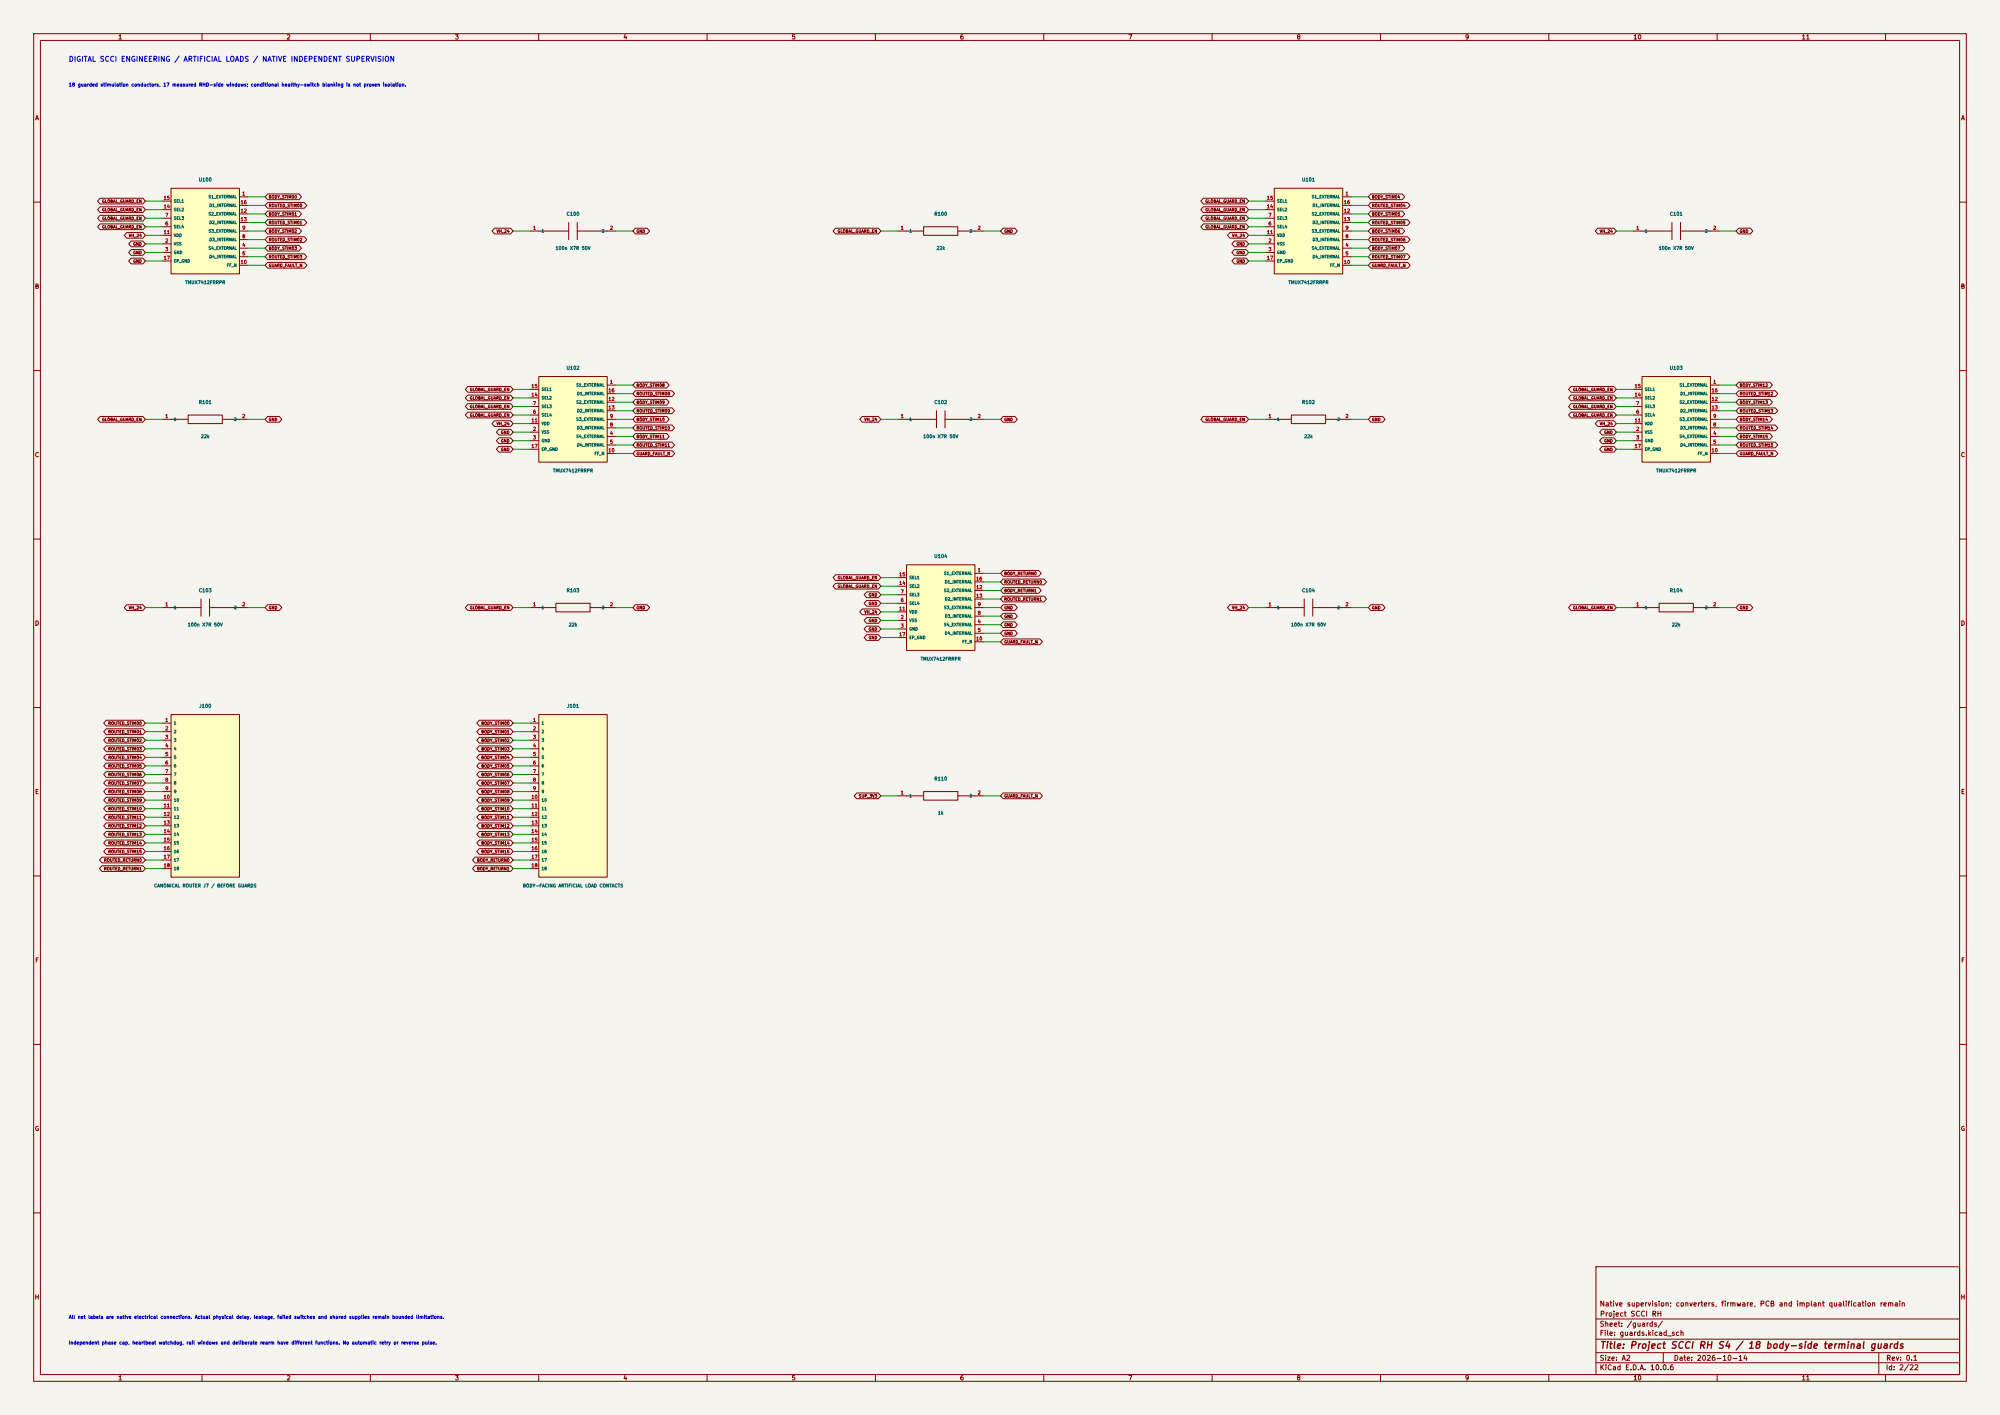
[picture p208: page 2]

DIGITAL SCCI ENGINEERING / ARTIFICIAL LOADS / NATIVE INDEPENDENT SUPERVISION

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

CANONICAL ROUTER J7 / BEFORE GUARDS

BODY-FACING ARTIFICIAL LOAD CONTACTS

All net labels are native electrical connections. Actual physical delay, leakage, failed switches and shared supplies remain bounded limitations.

Sheet: /guards/
File: guards.kicad_sch
Title: Project SCCI RH S4 / 18 body-side terminal guards

Independent phase cap, heartbeat watchdog, rail windows and deliberate rearm have different functions. No automatic retry or reverse pulse.

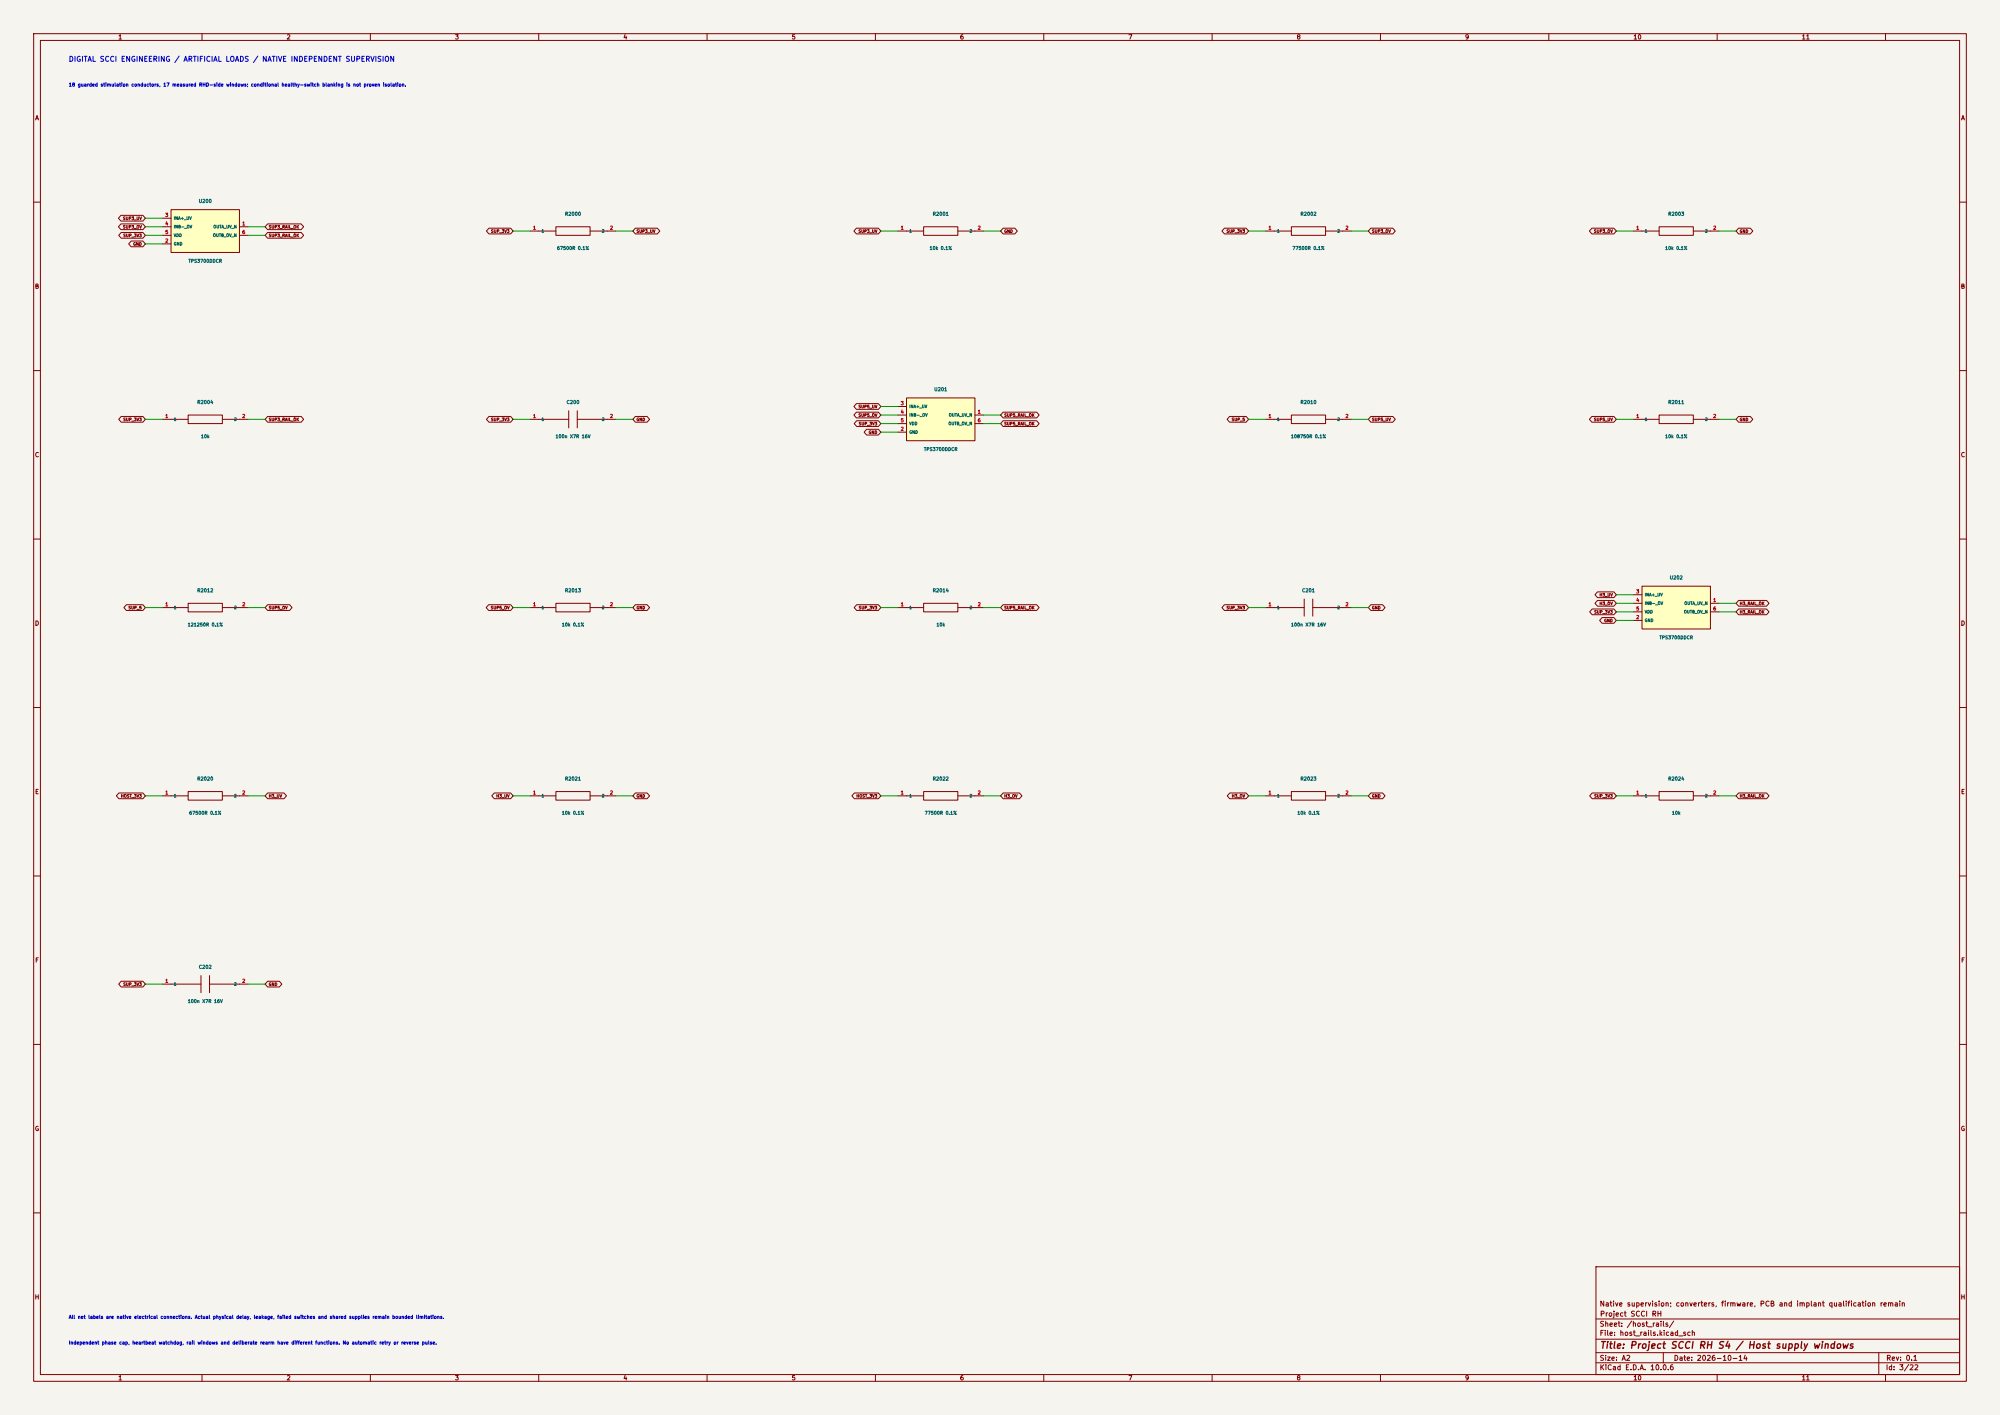
[picture p209: page 3]

Independent phase cap, heartbeat watchdog, rail windows and deliberate rearm have different functions. No automatic retry or reverse pulse. All net labels are native electrical connections. Actual physical delay, leakage, failed switches and shared supplies remain bounded limitations.

Sheet: /host_rails/
File: host_rails.kicad_sch
Title: Project SCCI RH S4 / Host supply windows

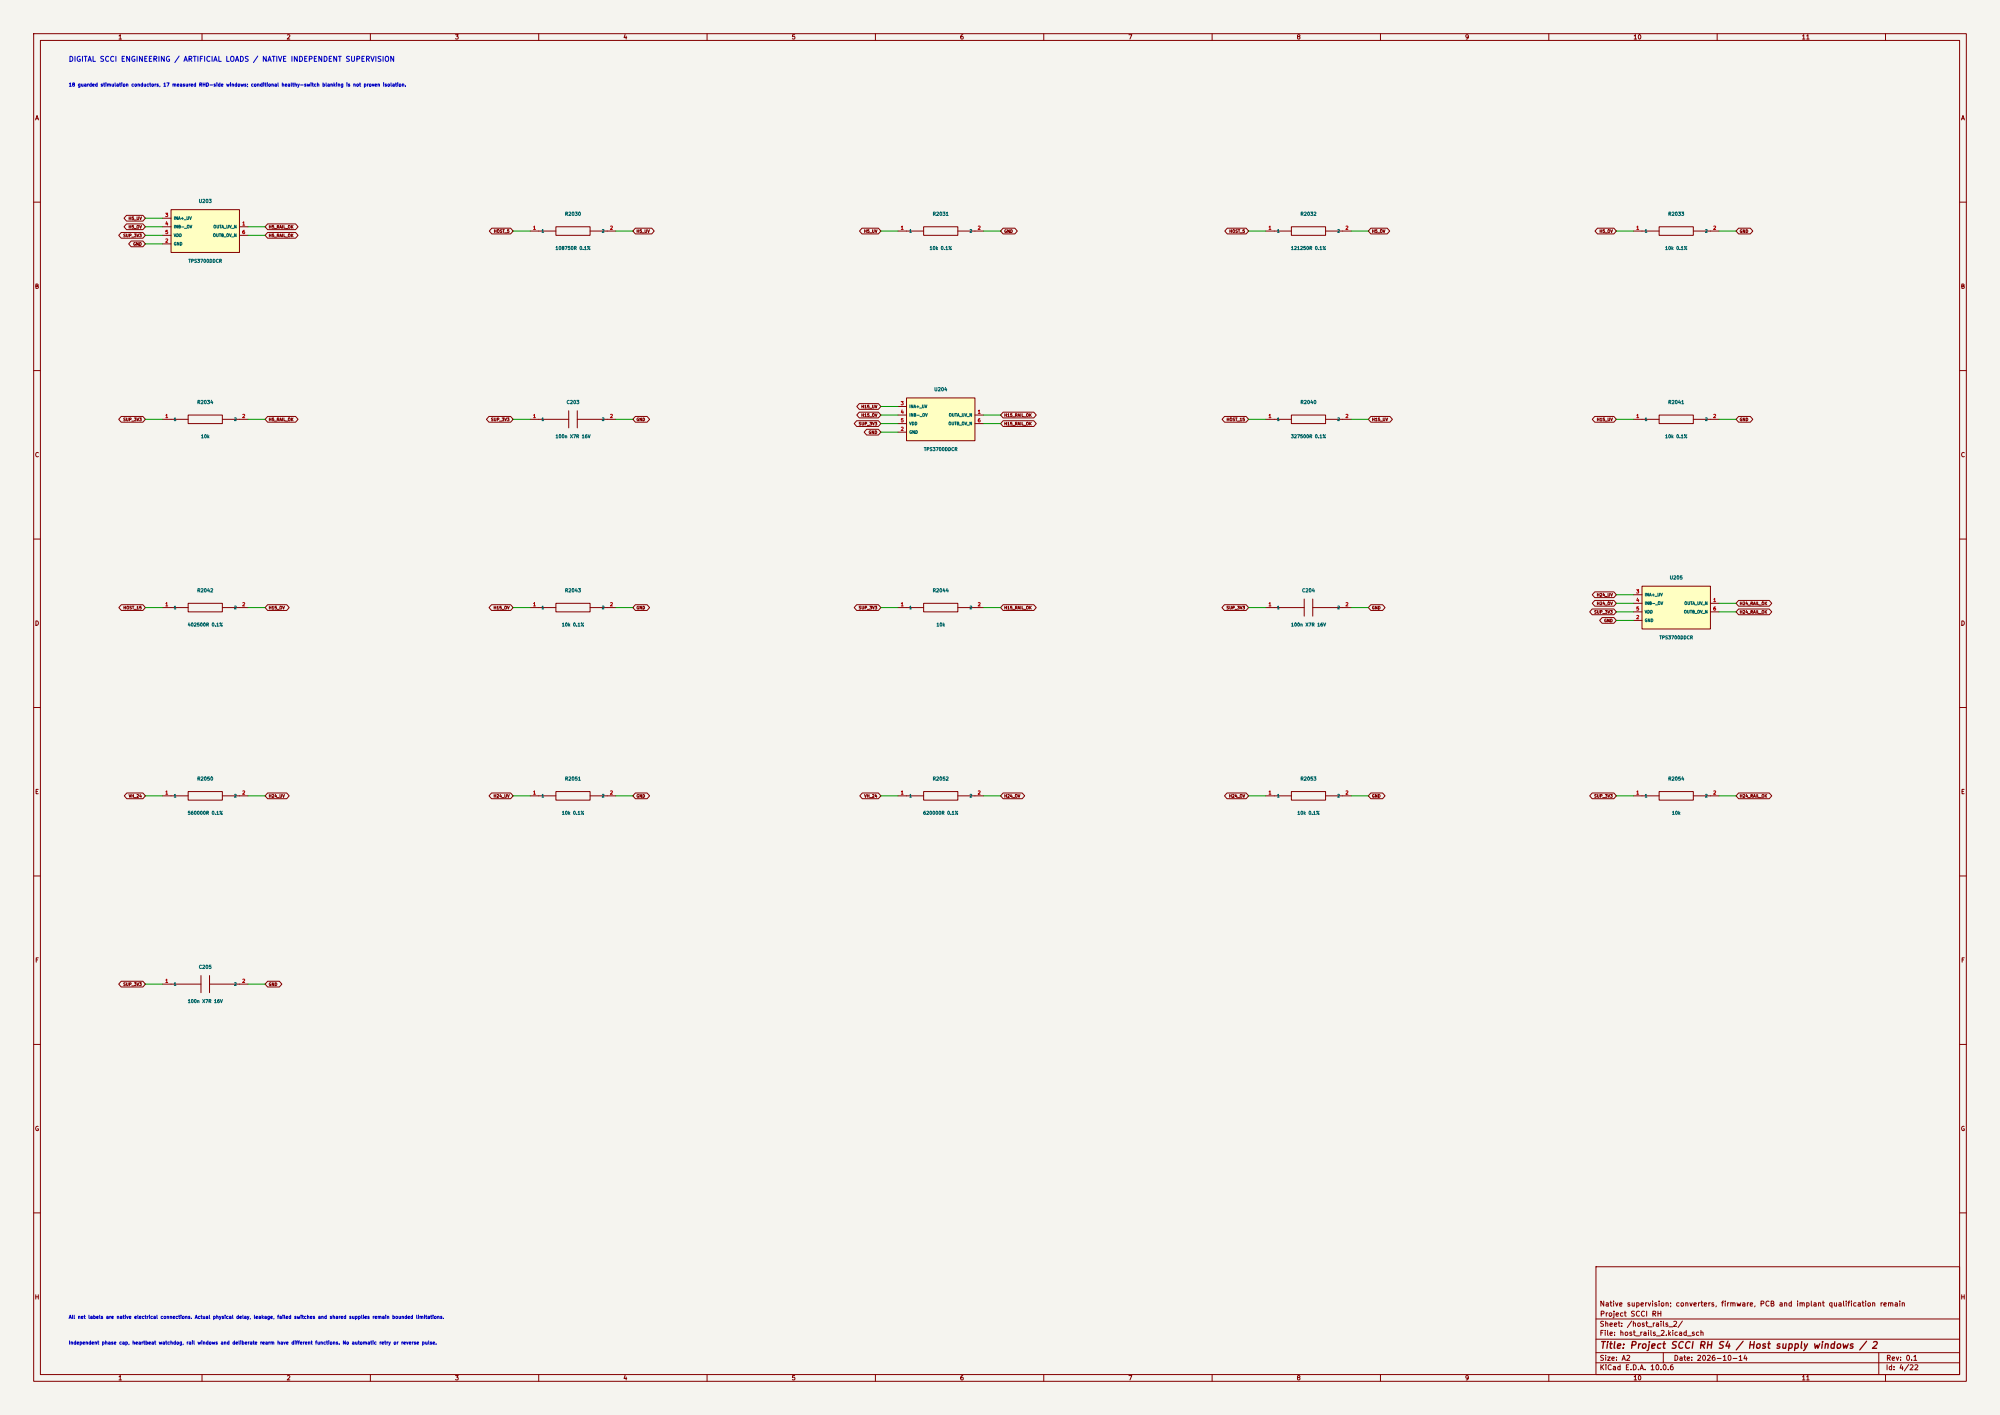
[picture p210: page 4]

H5_OV 18 guarded stimulation conductors, 17 measured RHD-side windows; conditional healthy-switch blanking is not proven isolation.

Sheet: /host_rails_2/
File: host_rails_2.kicad_sch
Title: Project SCCI RH S4 / Host supply windows / 2

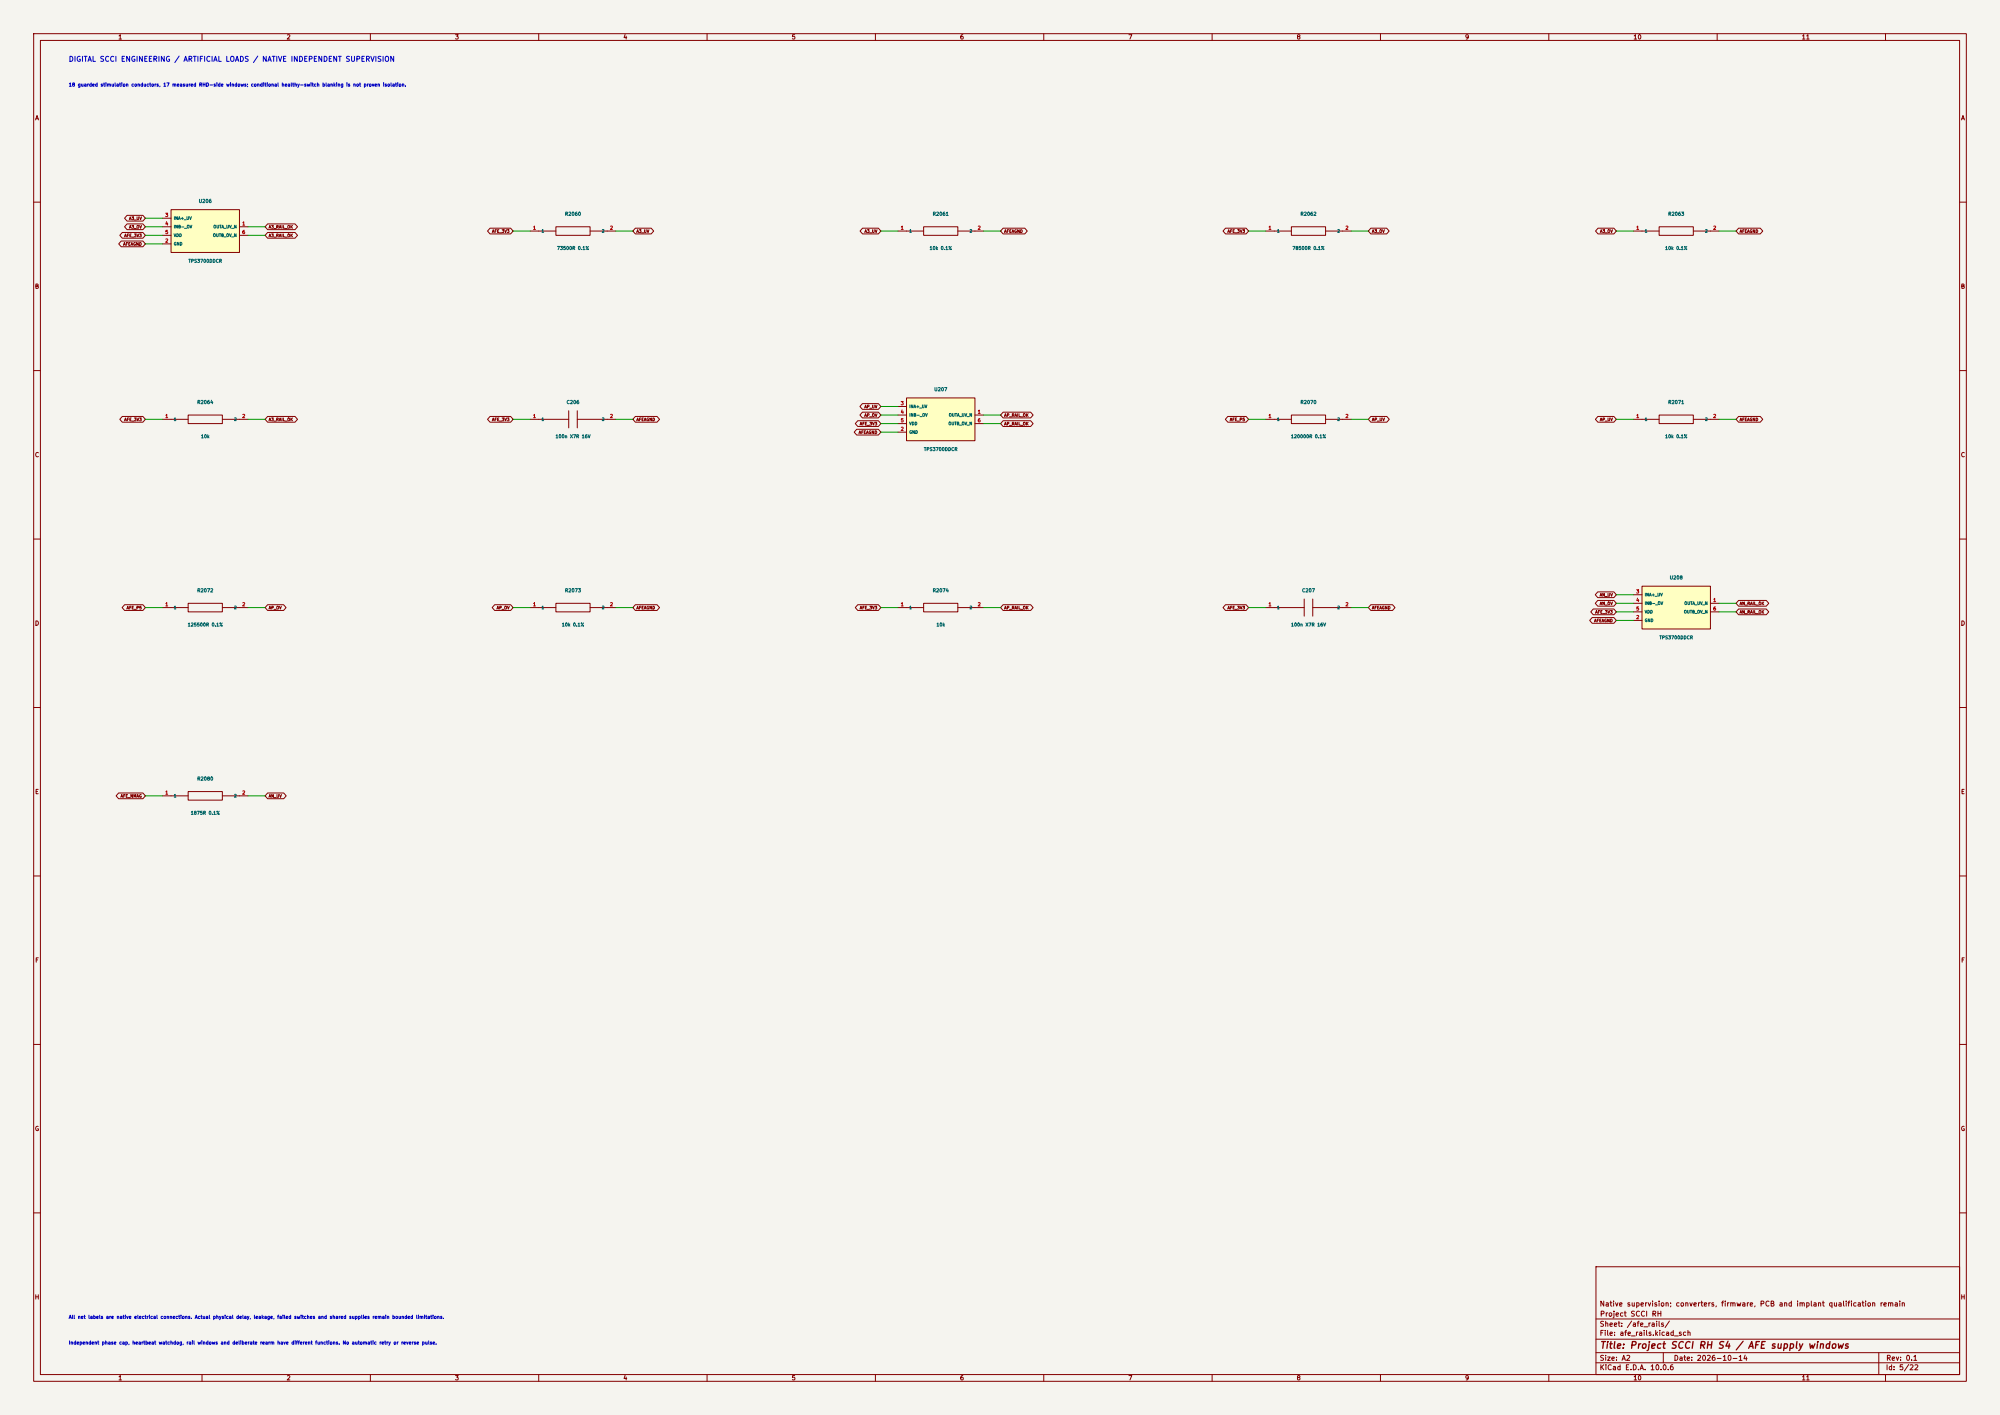
[picture p211: page 5]

Sheet: /afe_rails/
File: afe_rails.kicad_sch
Title: Project SCCI RH S4 / AFE supply windows

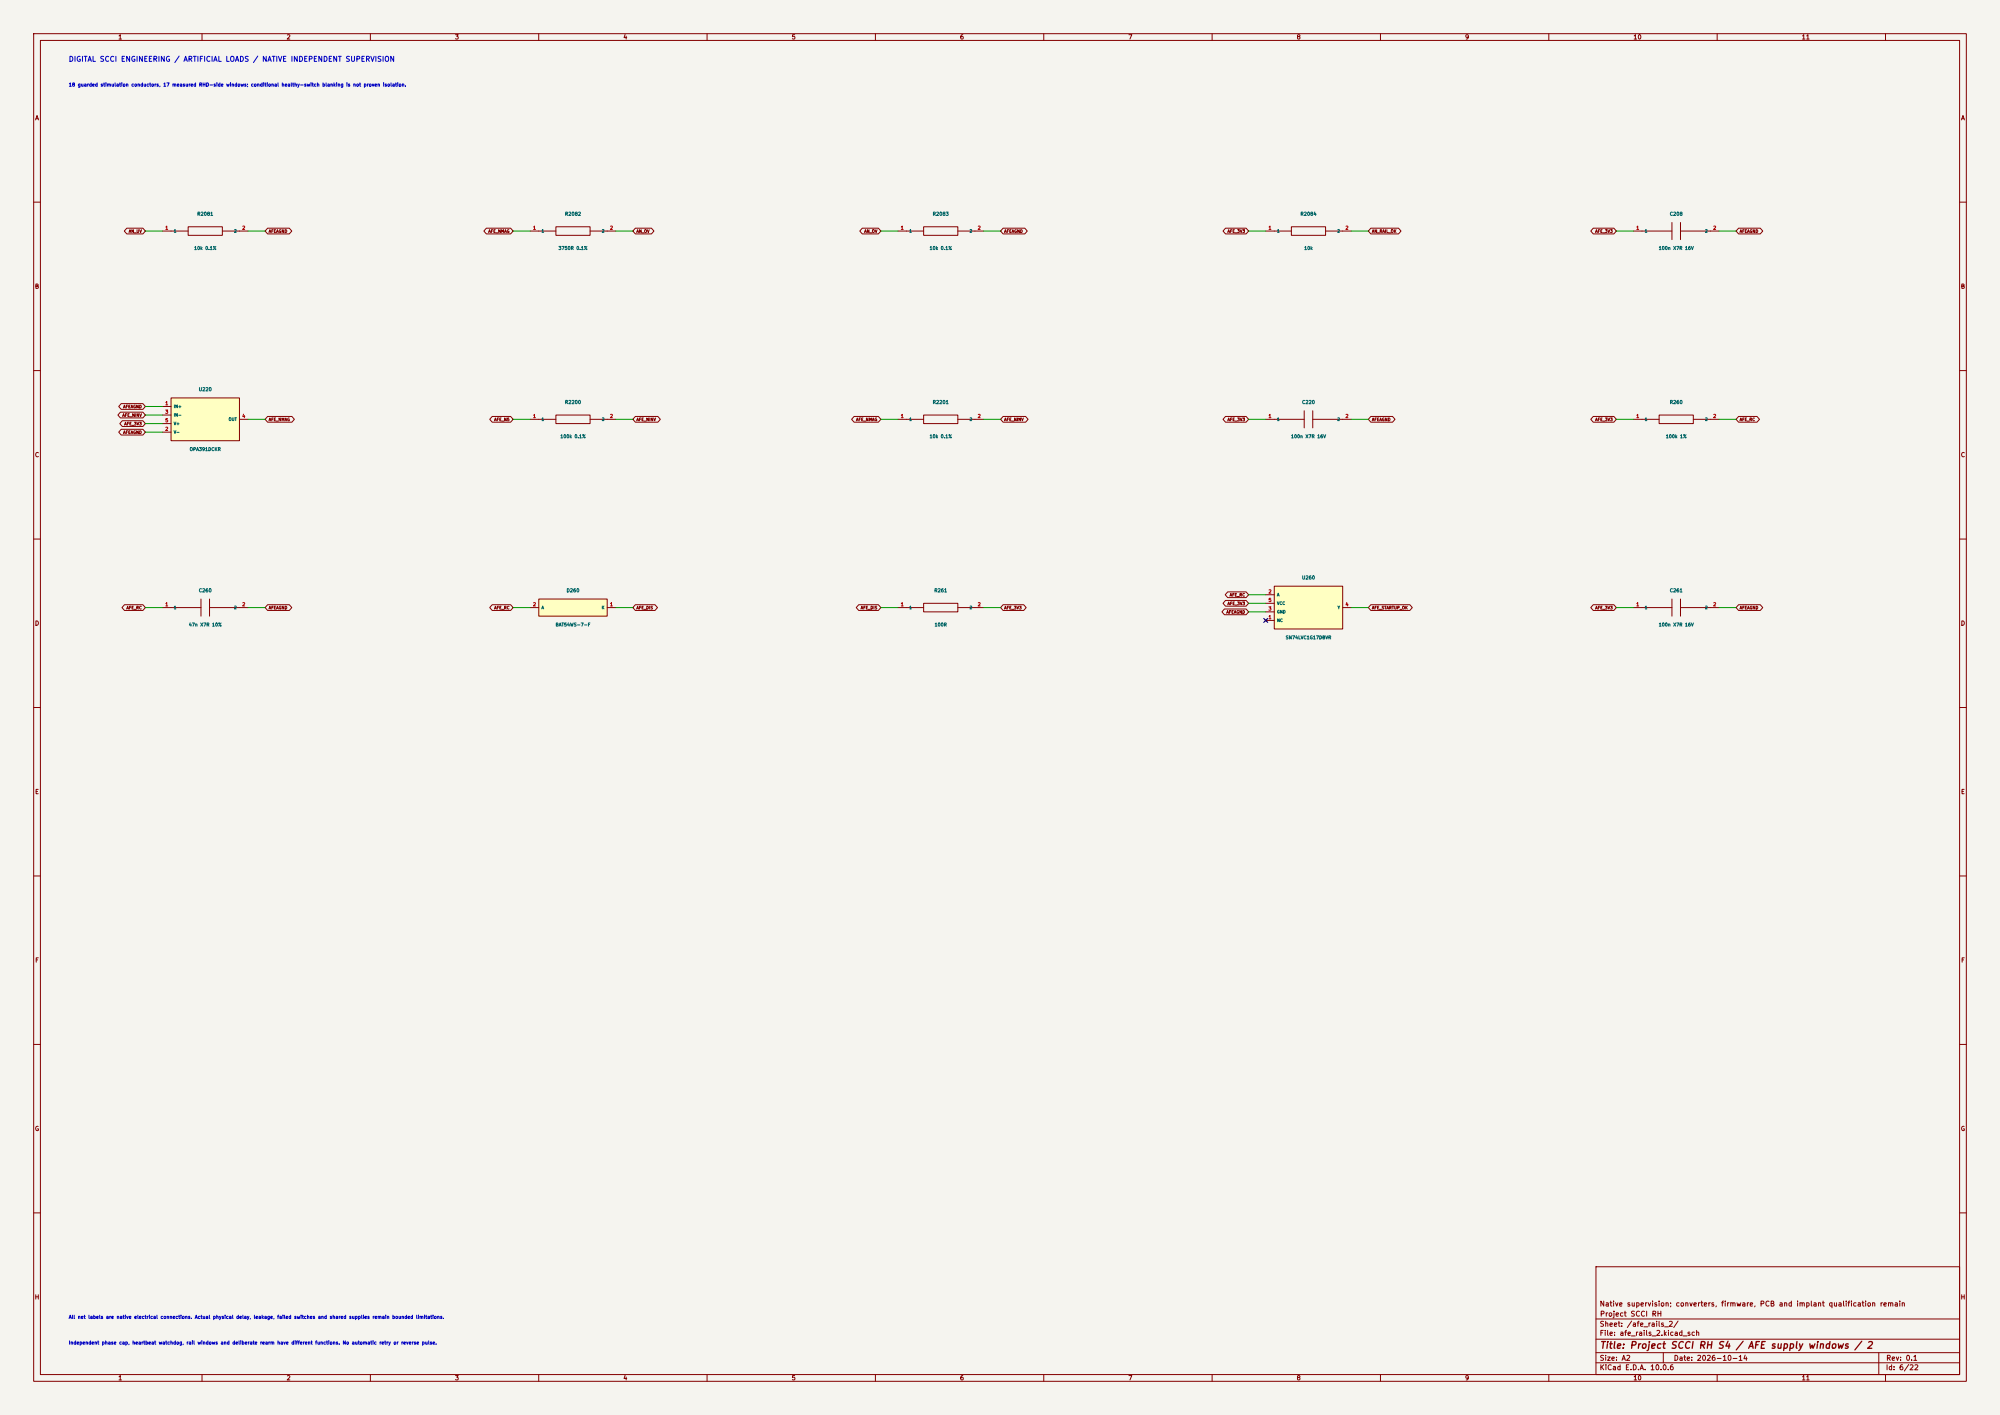
[picture p212: page 6]

Sheet: /afe_rails_2/
File: afe_rails_2.kicad_sch
Title: Project SCCI RH S4 / AFE supply windows / 2

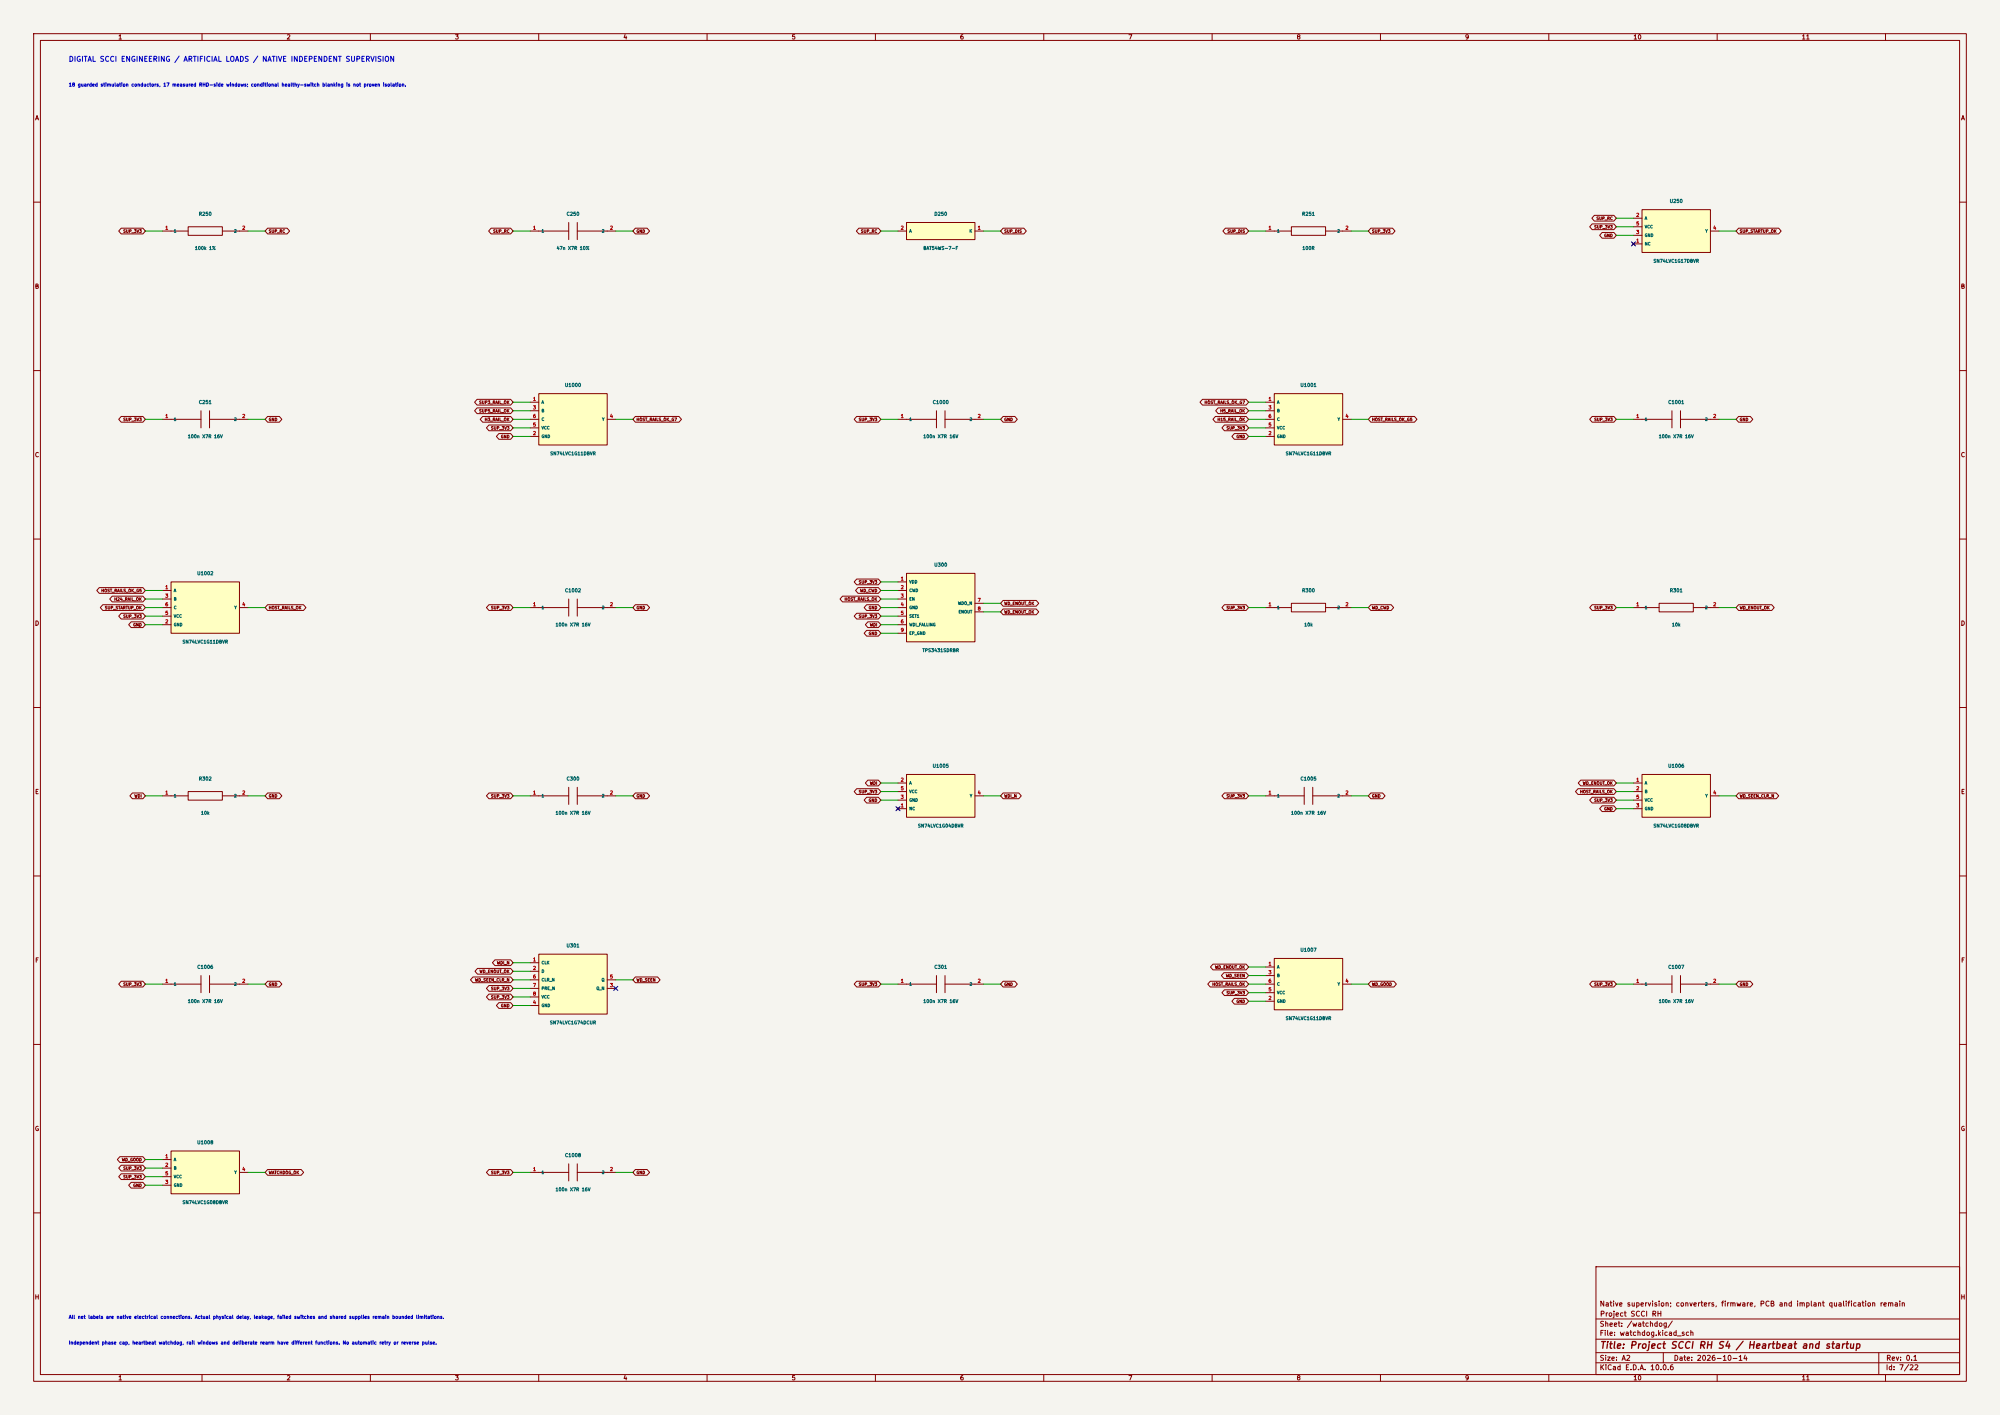
[picture p213: page 7]

Sheet: /watchdog/
File: watchdog.kicad_sch
Title: Project SCCI RH S4 / Heartbeat and startup

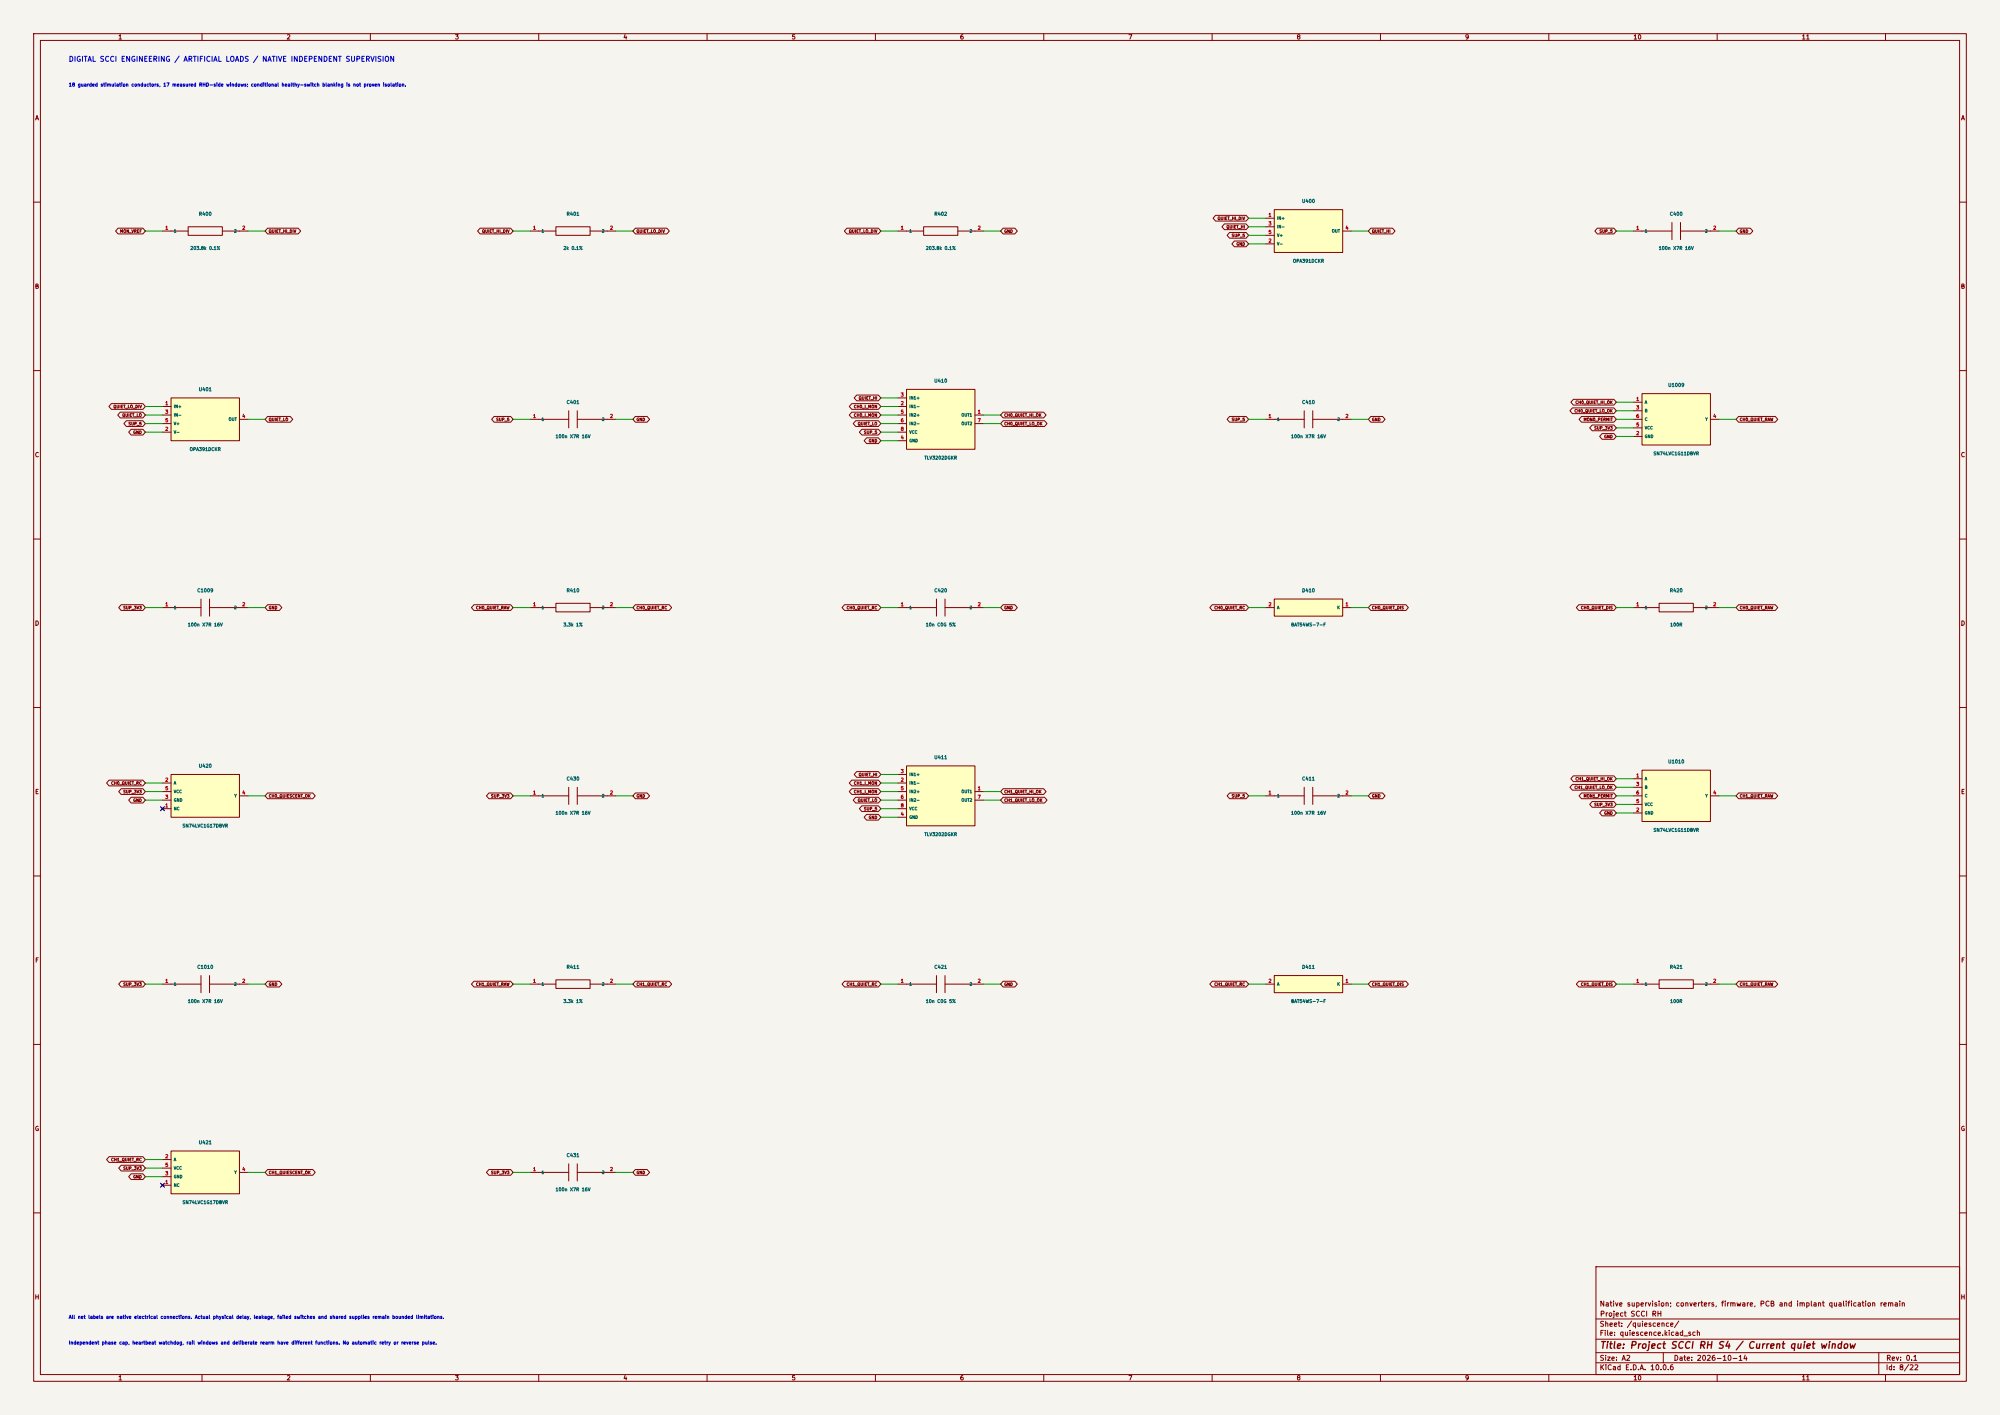
[picture p214: page 8]
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

Sheet: /quiescence/
File: quiescence.kicad_sch
Title: Project SCCI RH S4 / Current quiet window

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

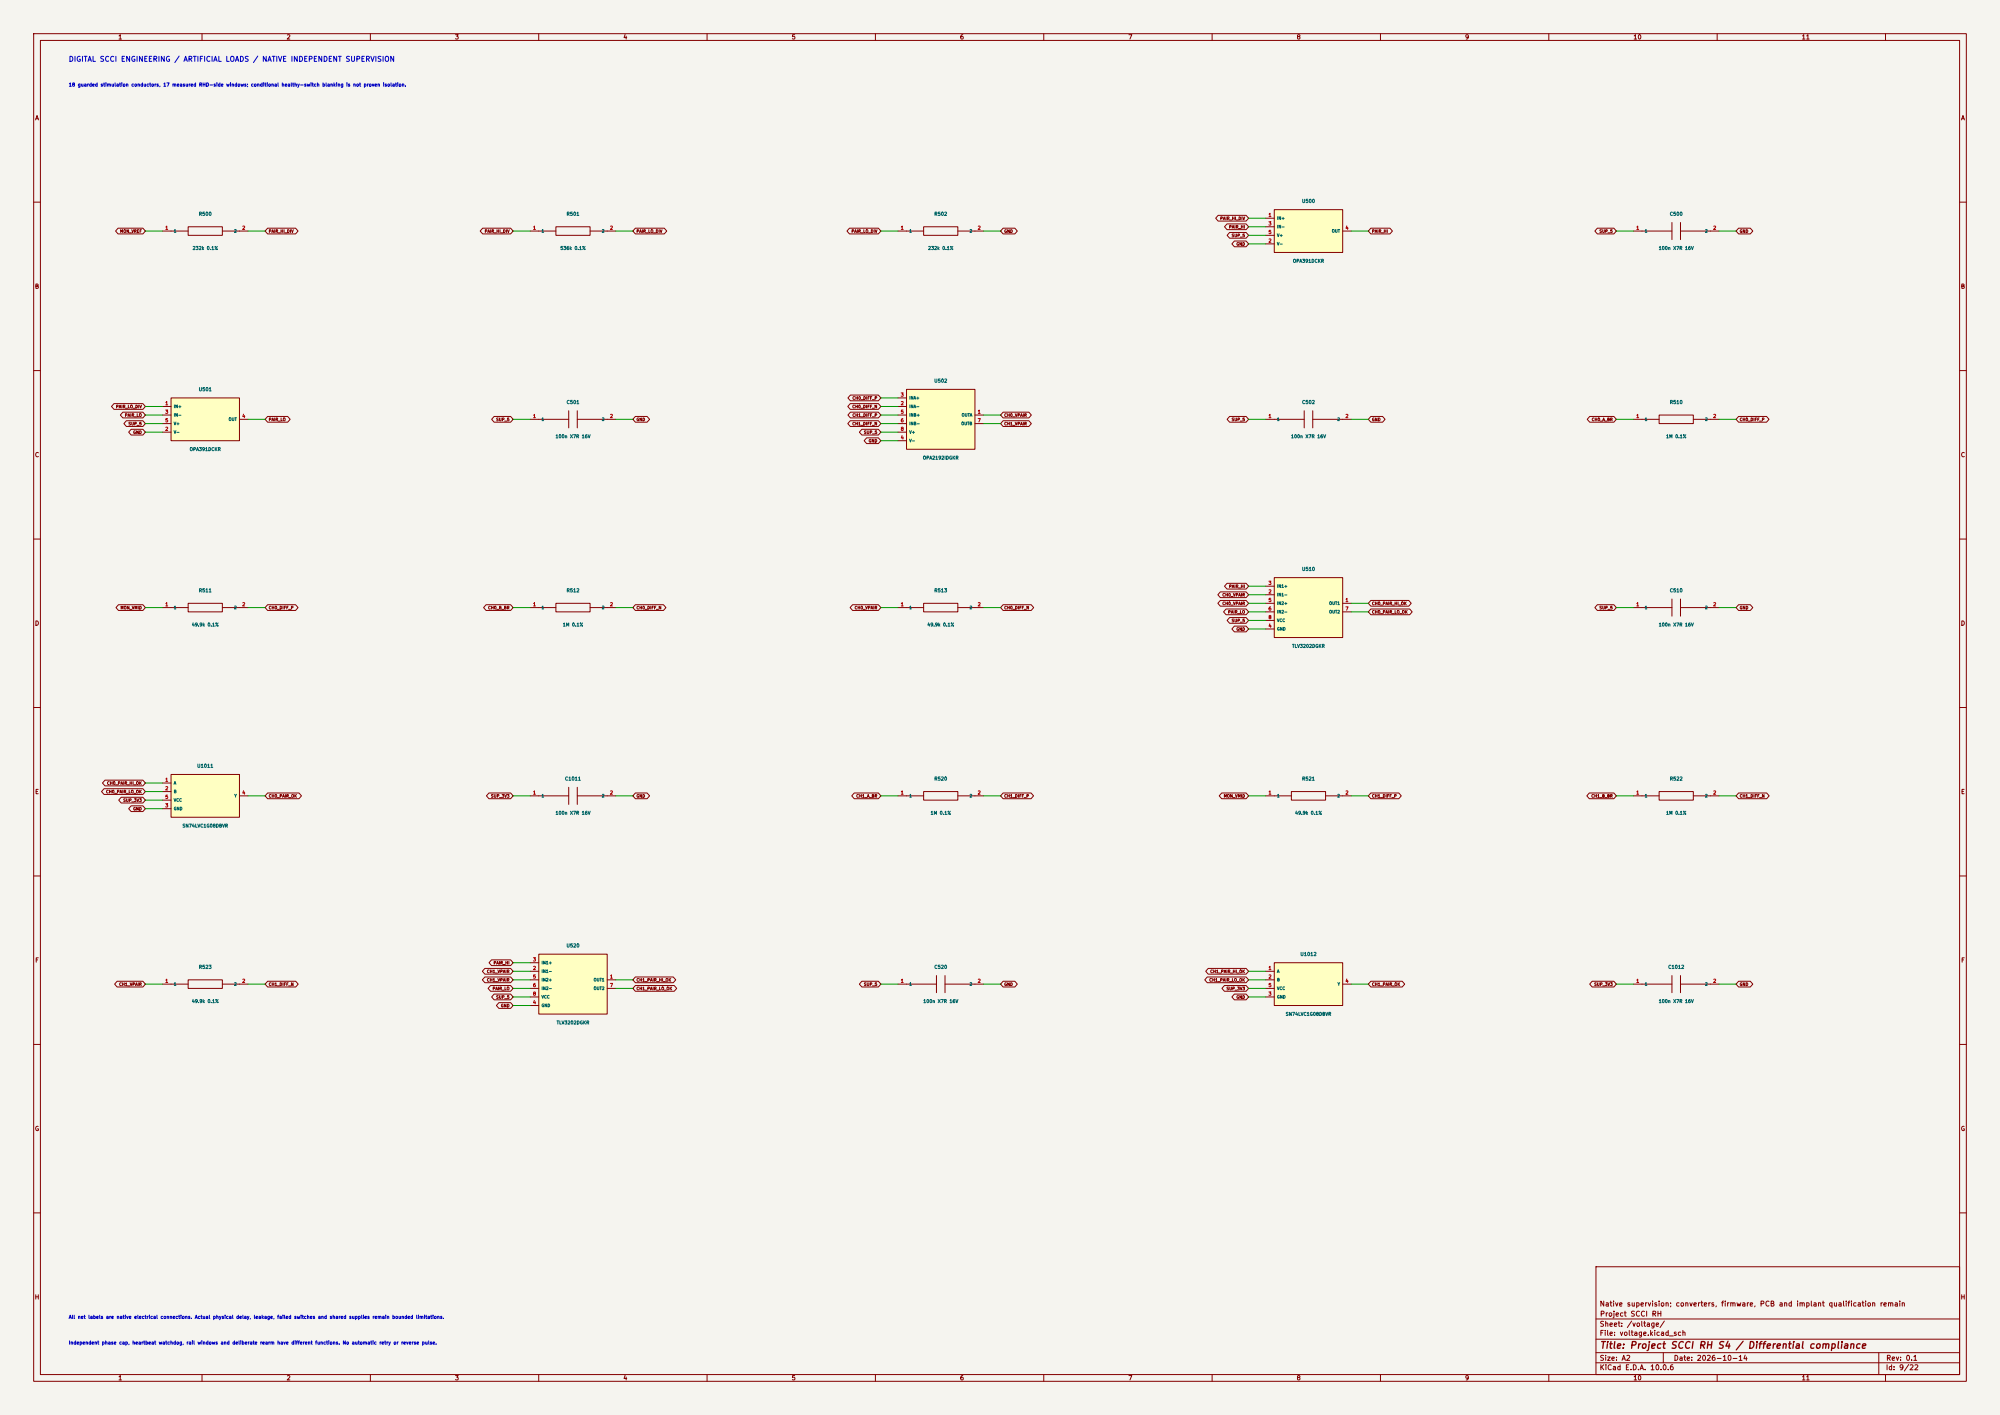
[picture p215: page 9]
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

Sheet: /voltage/
File: voltage.kicad_sch
Title: Project SCCI RH S4 / Differential compliance

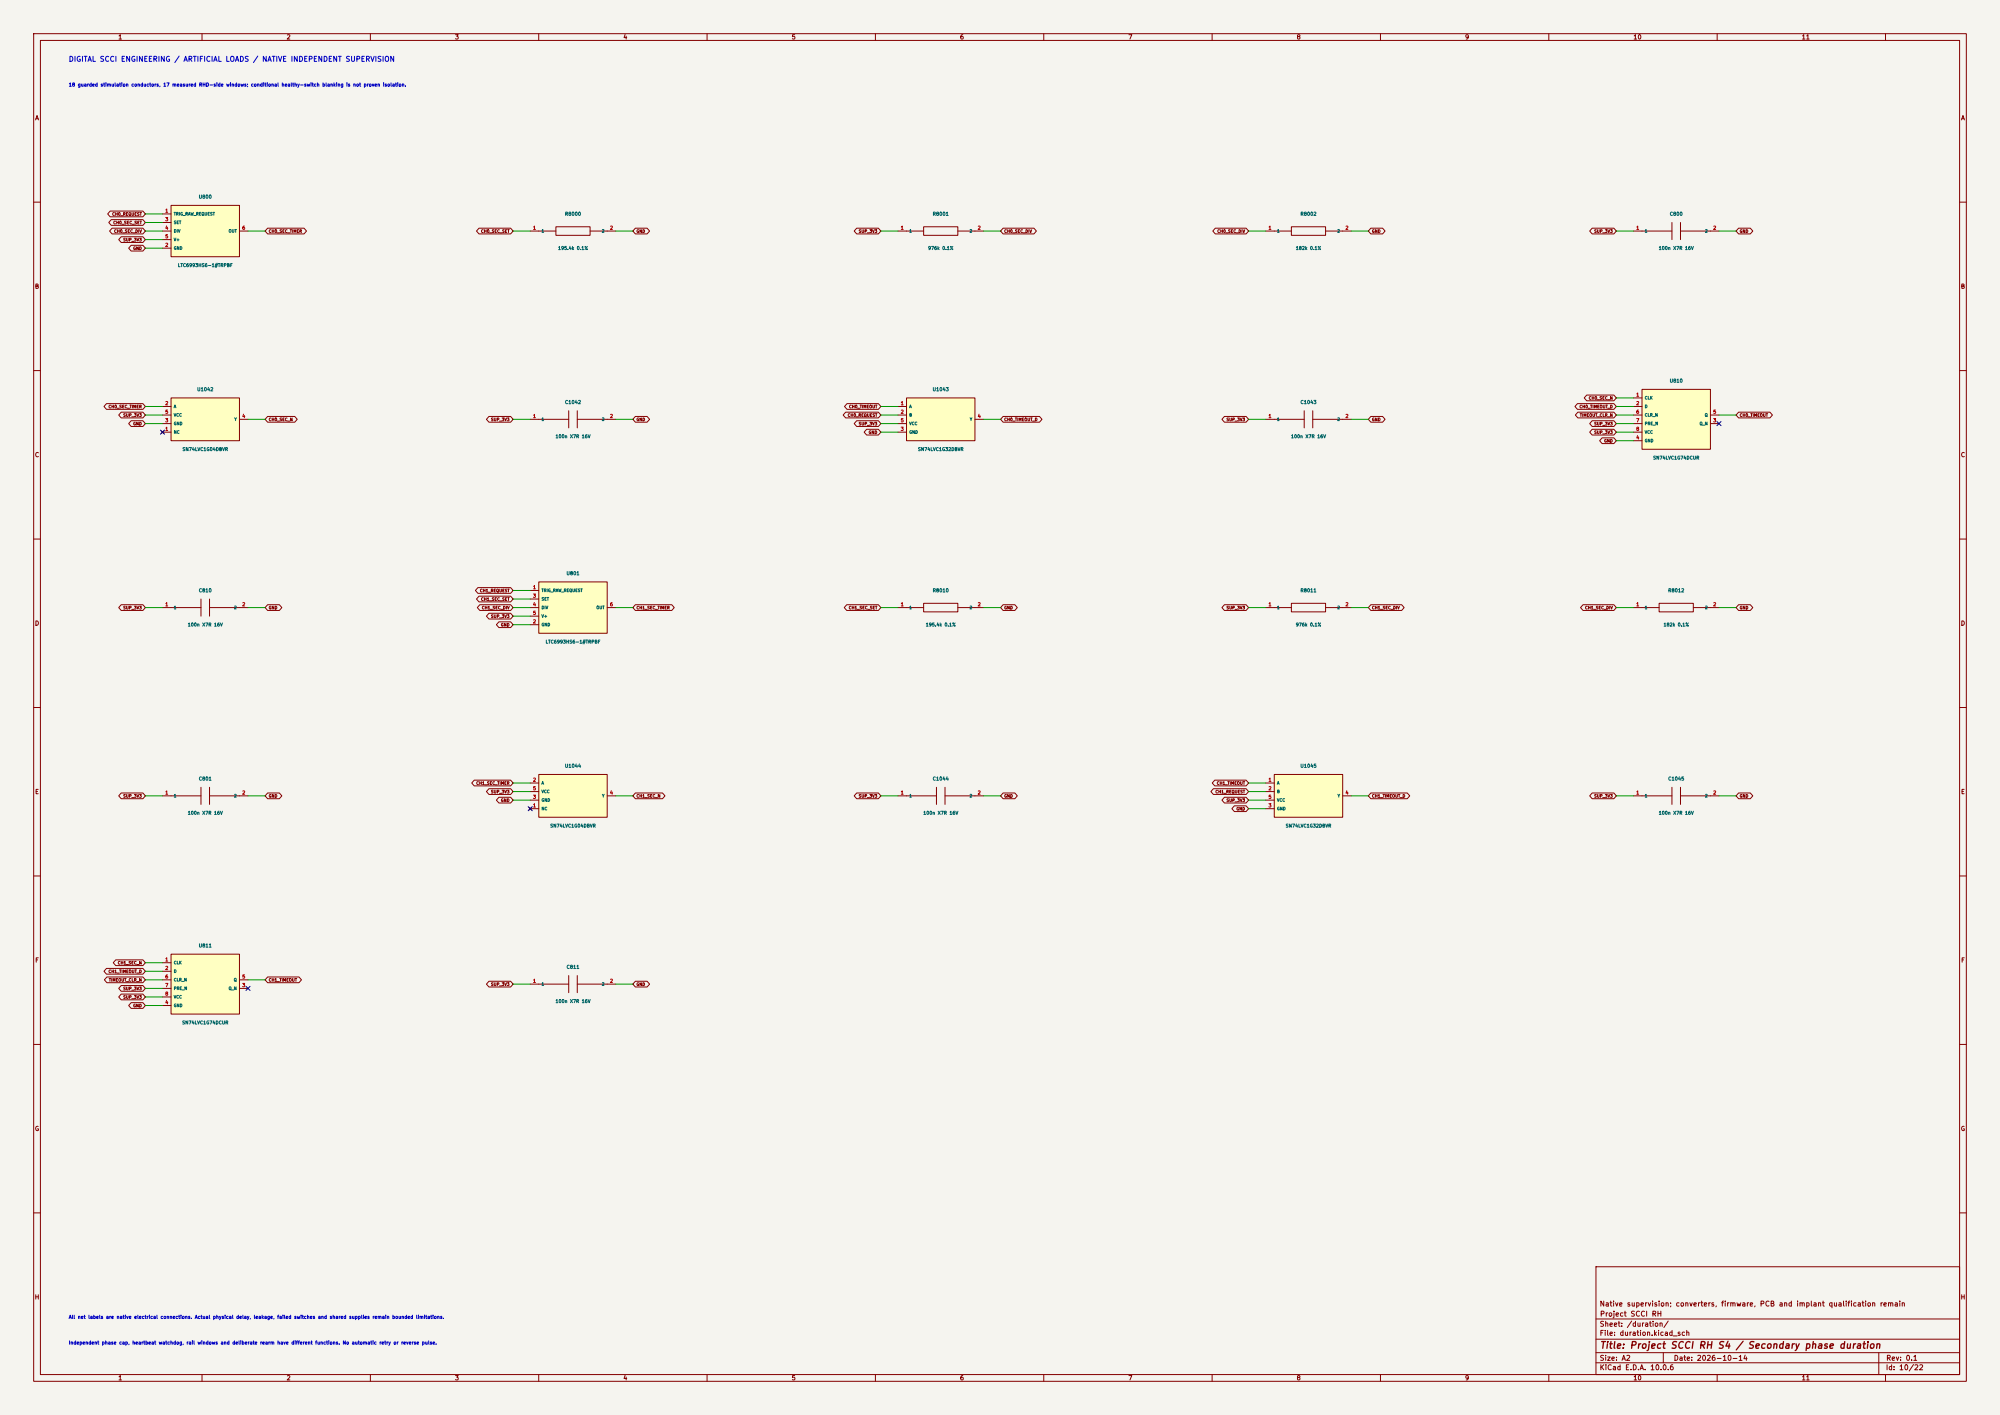
[picture p216: page 10]
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

Sheet: /duration/
File: duration.kicad_sch
Title: Project SCCI RH S4 / Secondary phase duration

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

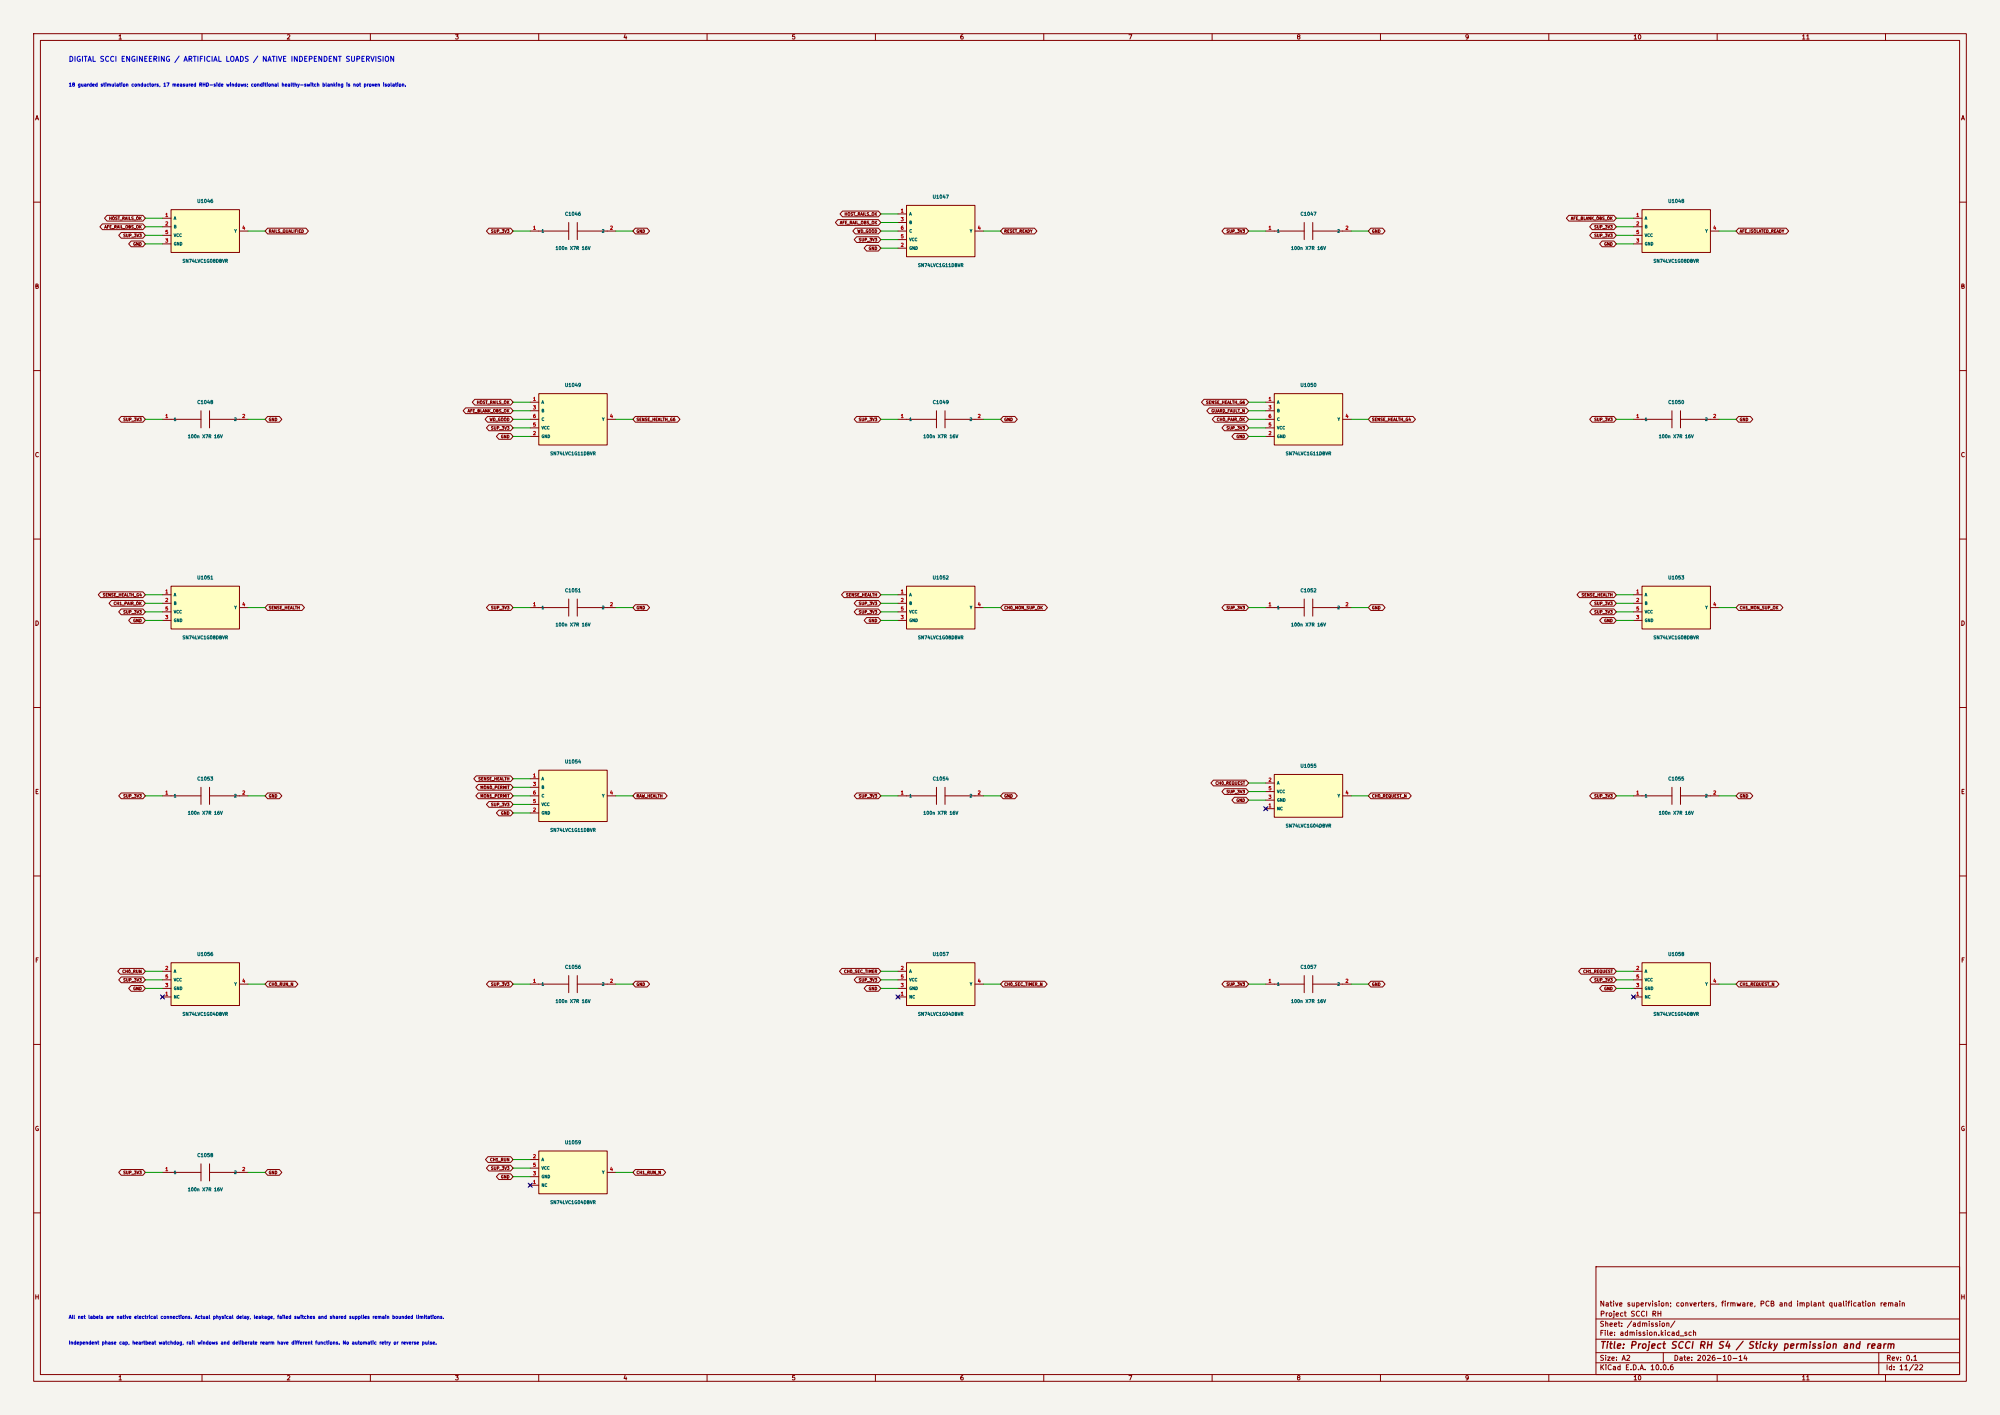
[picture p217: page 11]

Sheet: /admission/
File: admission.kicad_sch
Title: Project SCCI RH S4 / Sticky permission and rearm

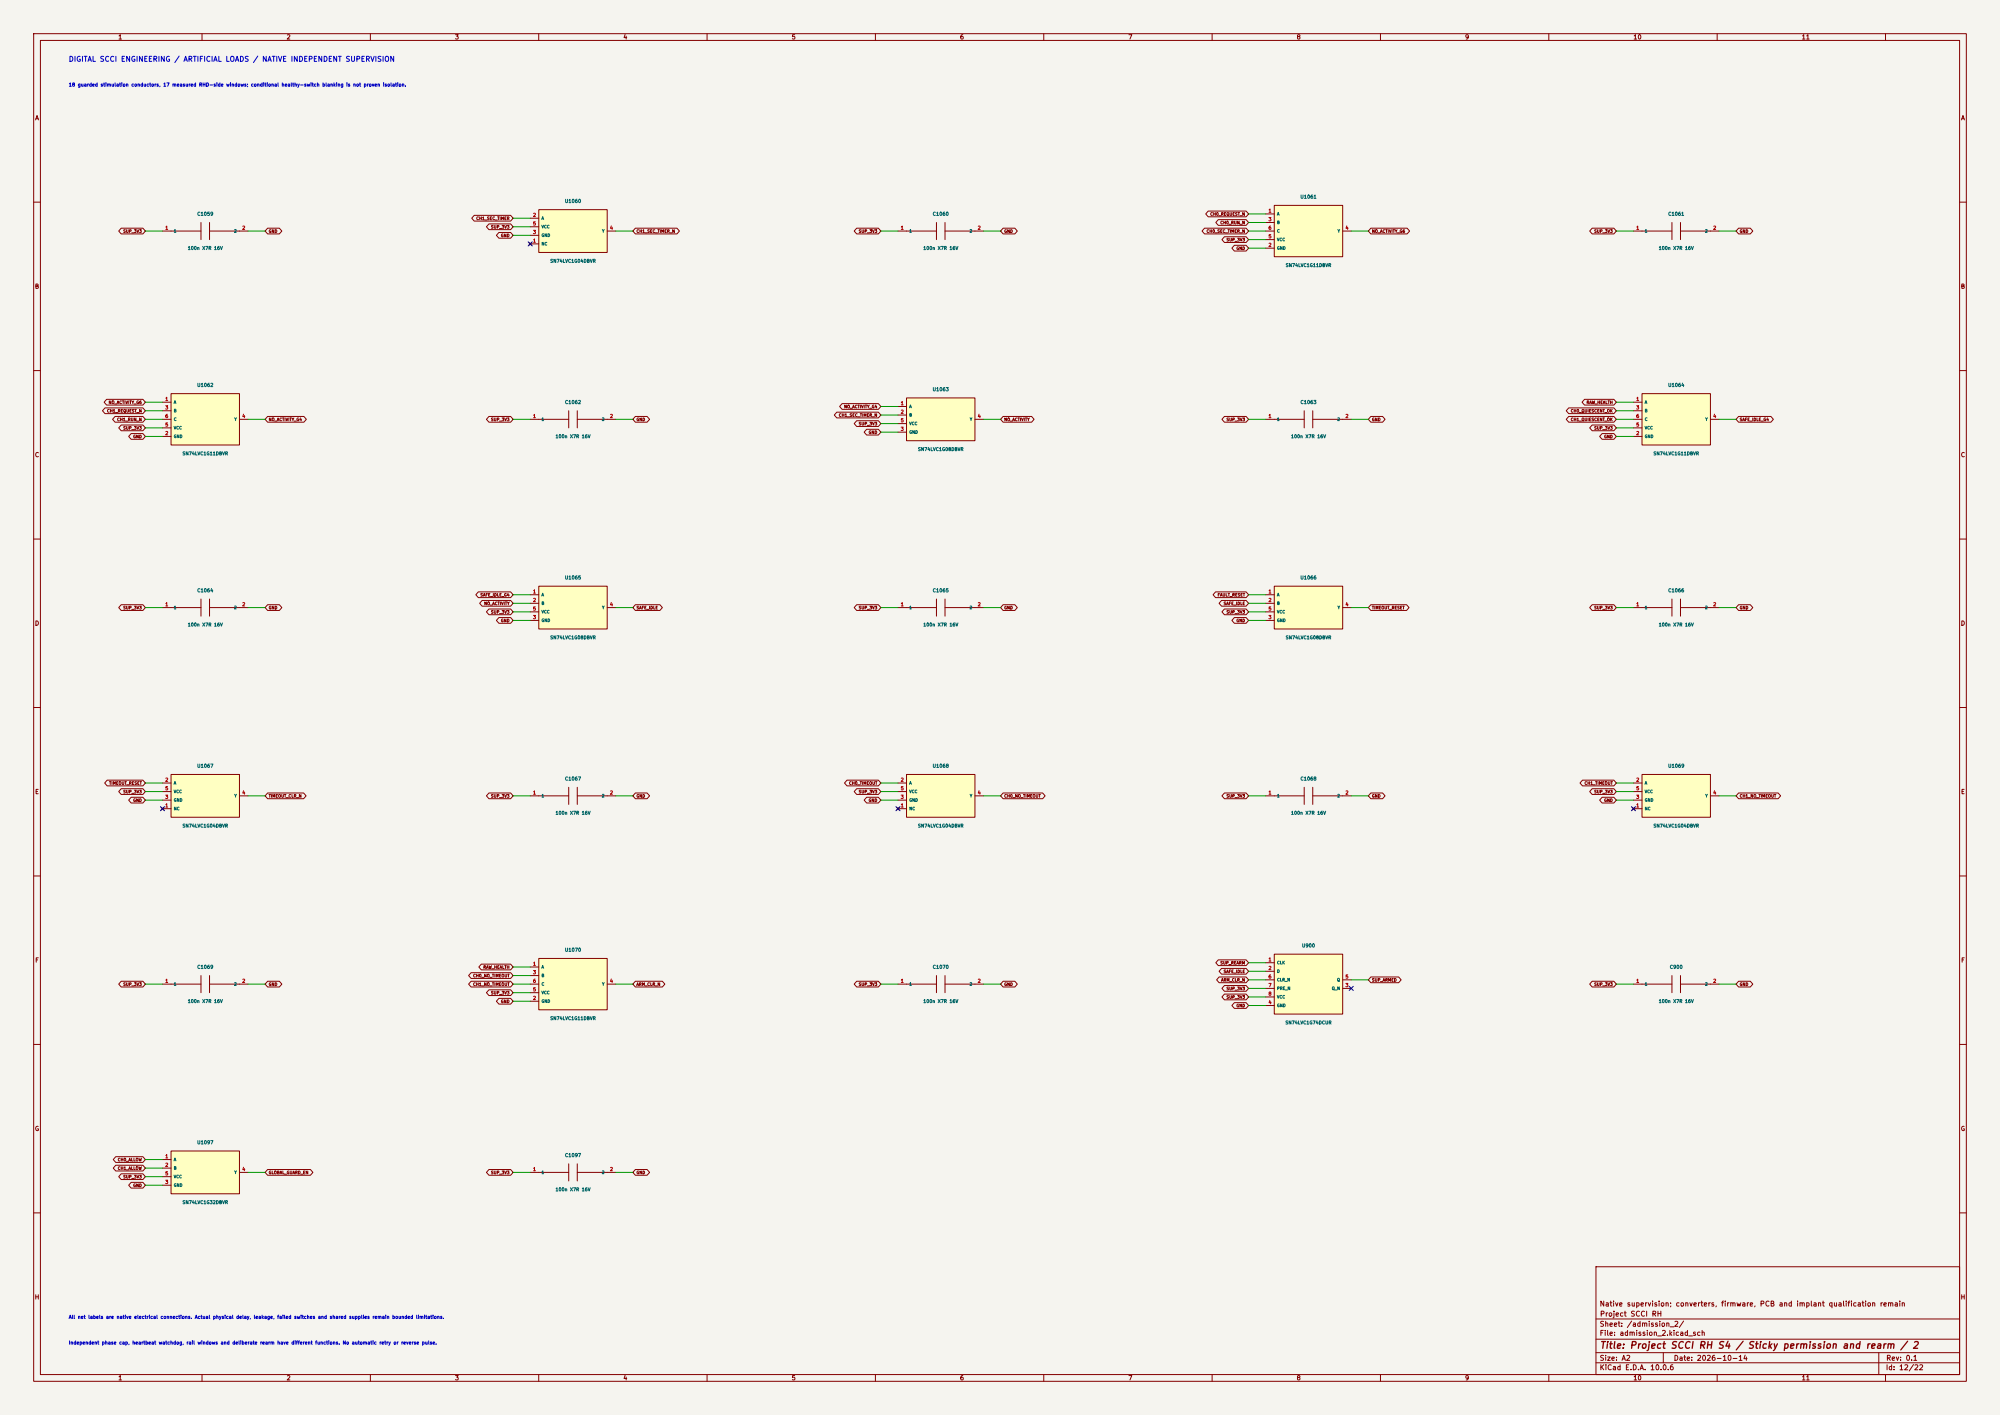
[picture p218: page 12]
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

Sheet: /admission_2/
File: admission_2.kicad_sch
Title: Project SCCI RH S4 / Sticky permission and rearm / 2

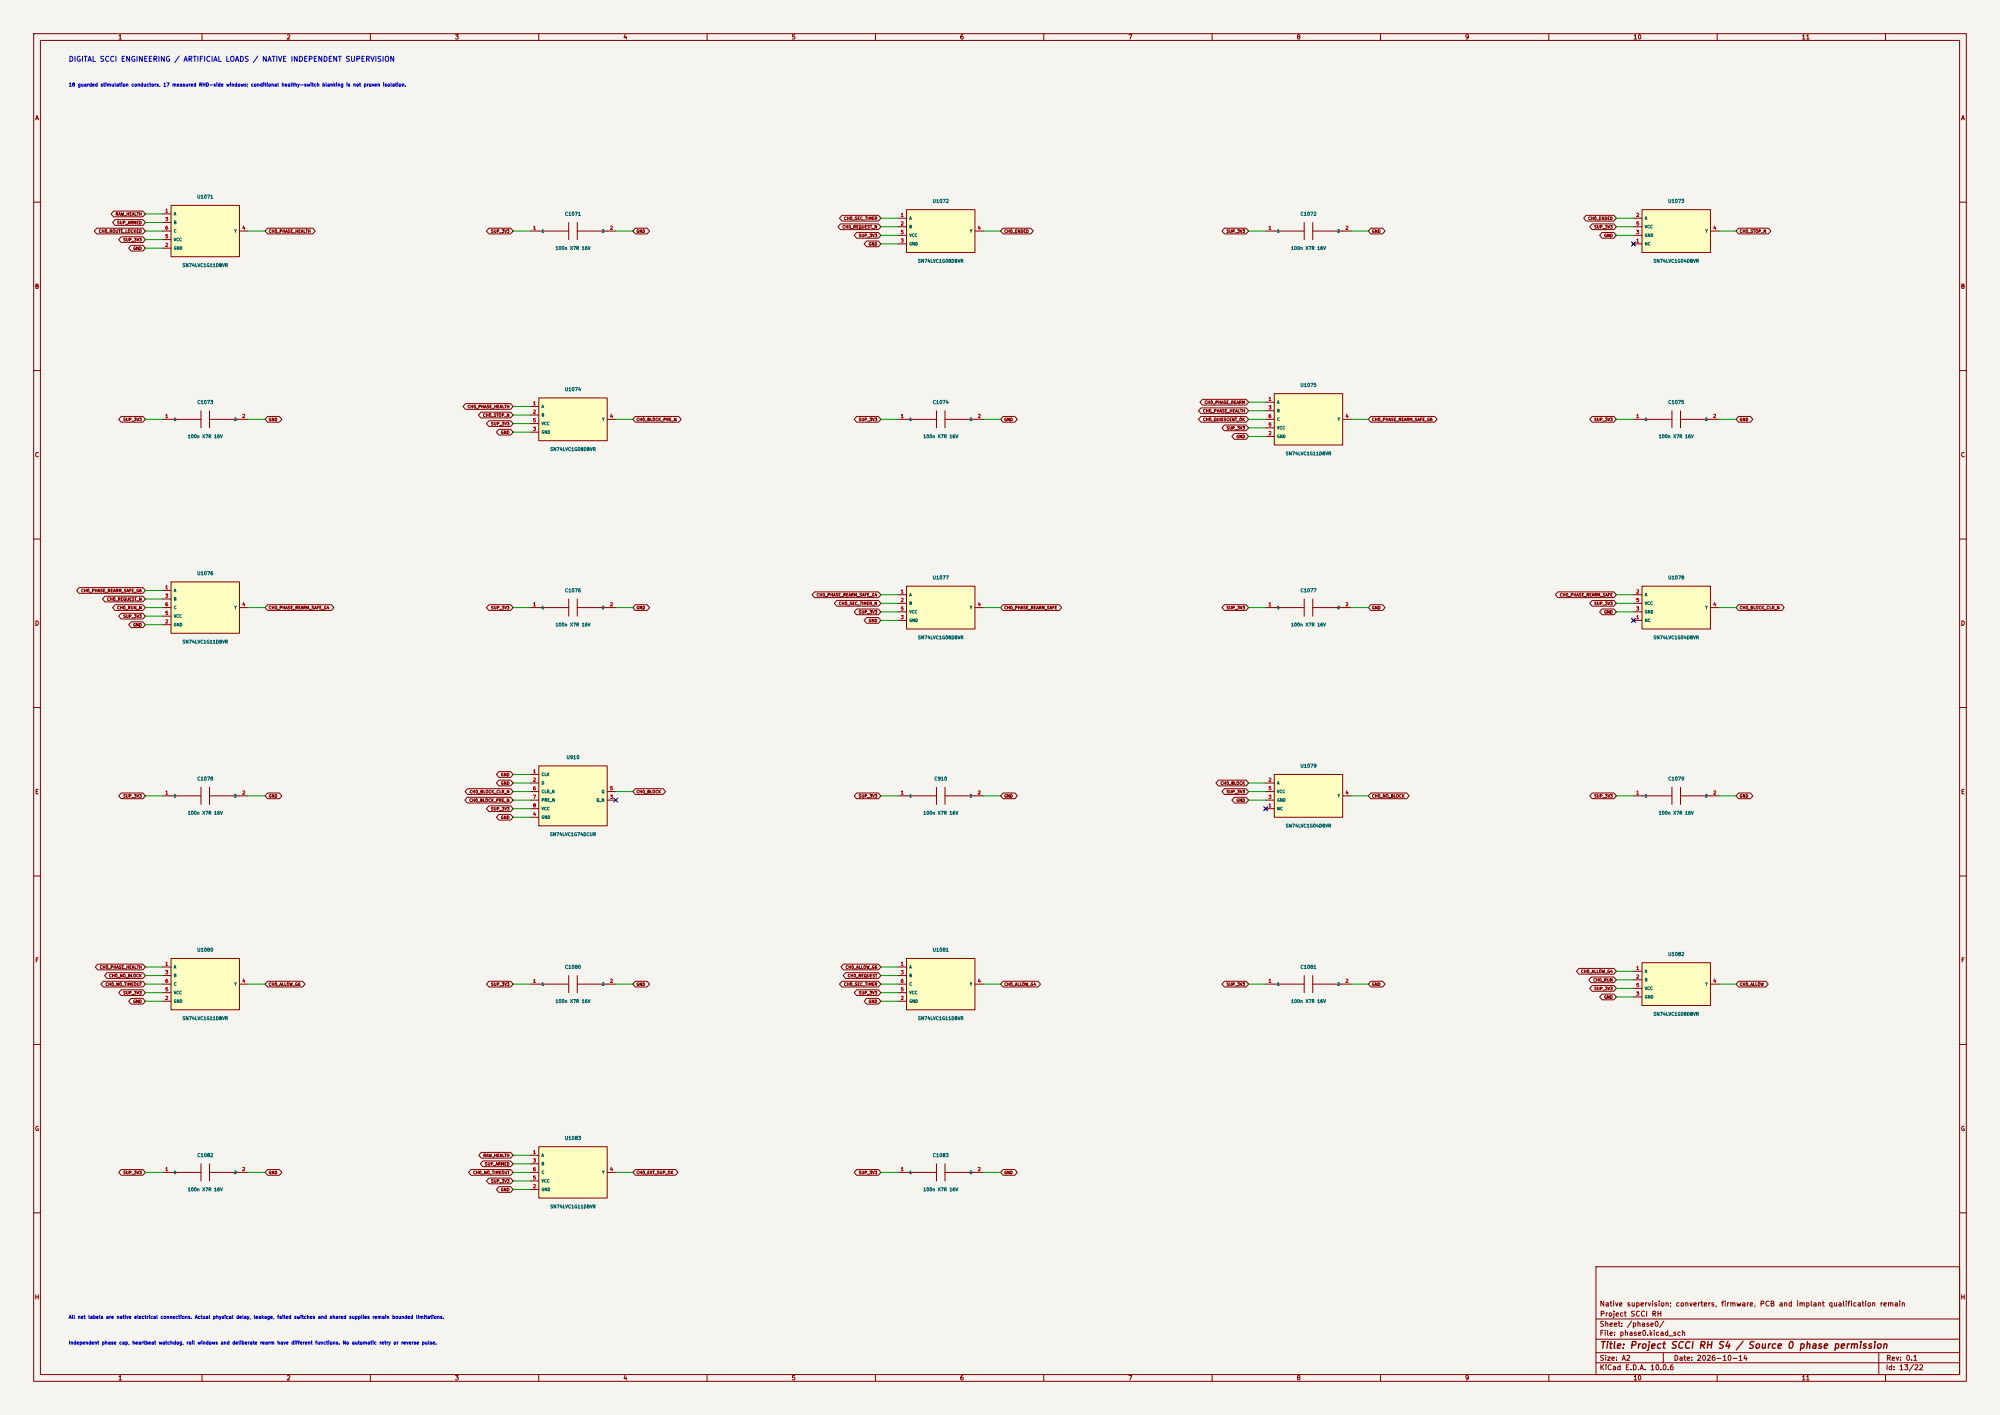
[picture p219: page 13]

Sheet: /phase0/
File: phase0.kicad_sch
Title: Project SCCI RH S4 / Source 0 phase permission

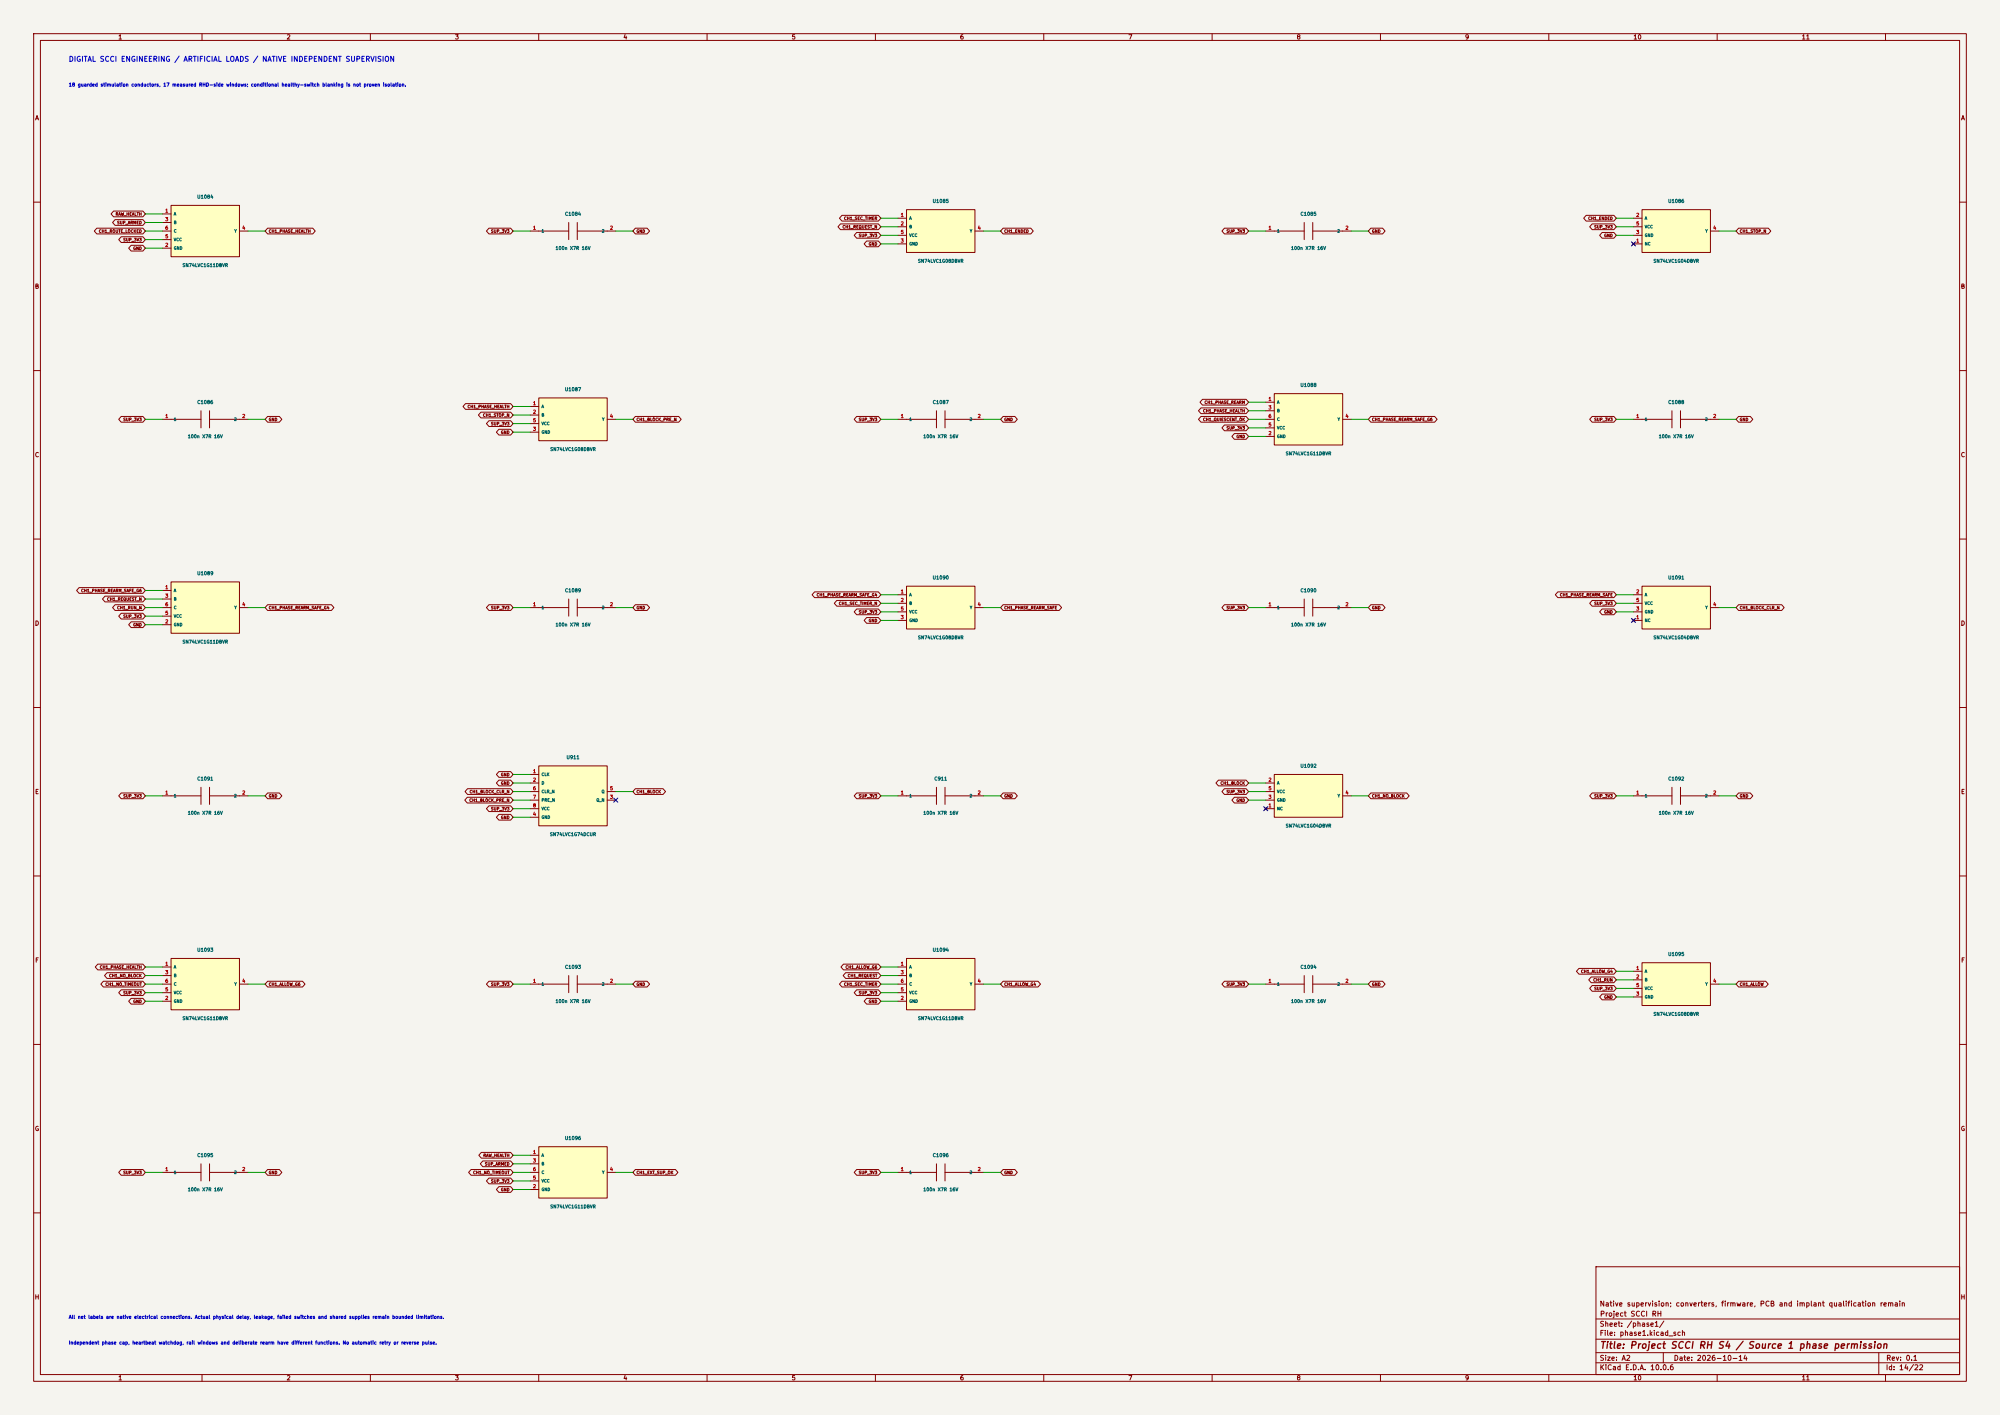
[picture p220: page 14]

Sheet: /phase1/
File: phase1.kicad_sch
Title: Project SCCI RH S4 / Source 1 phase permission

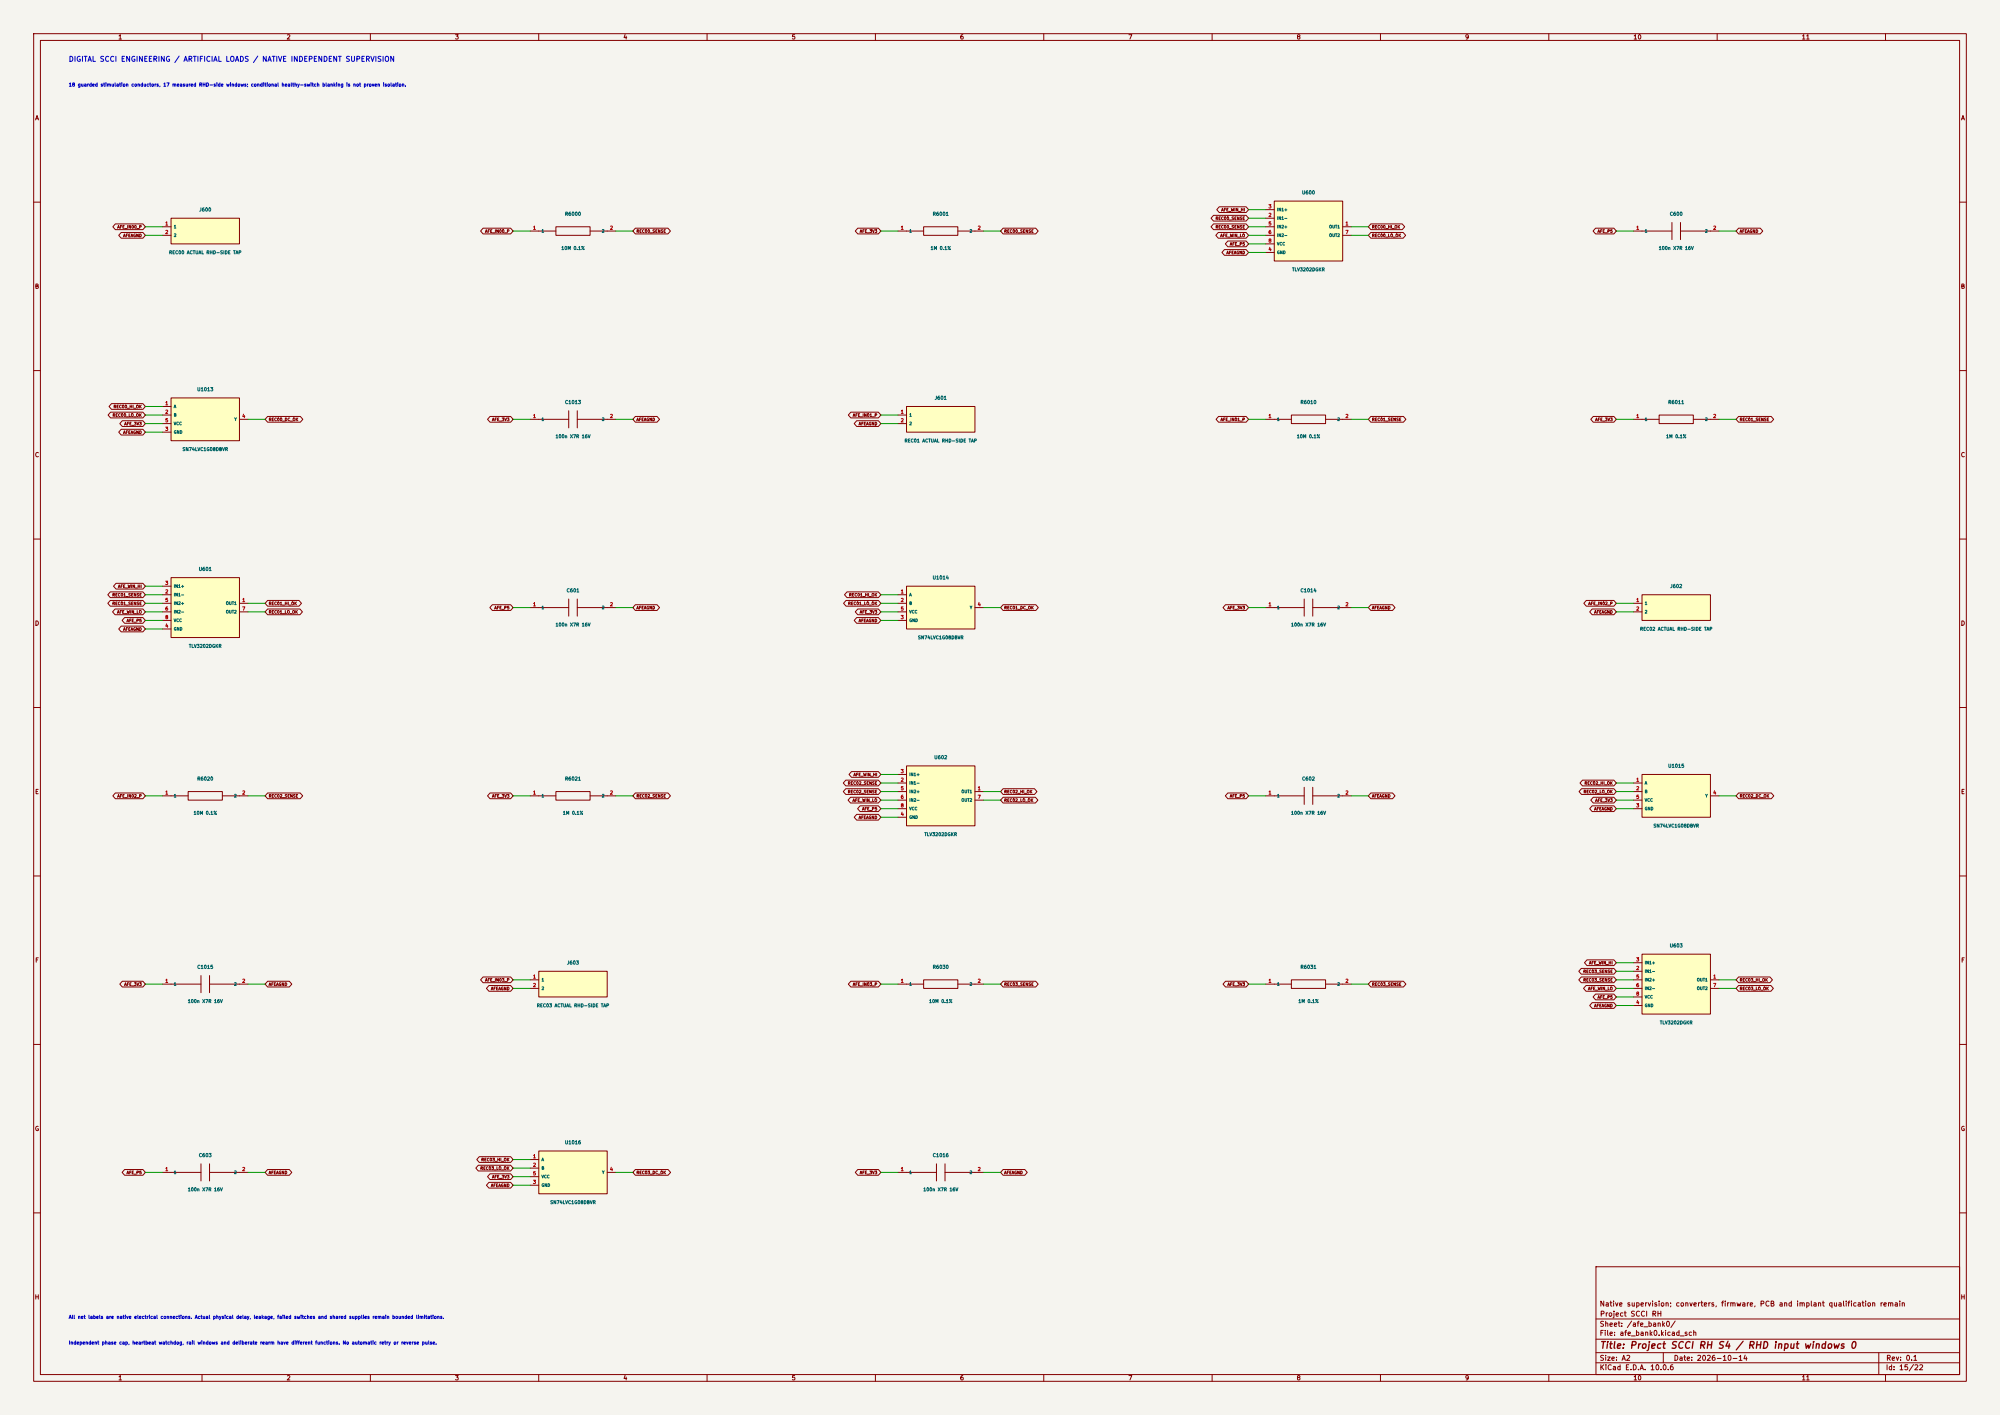
[picture p221: page 15]

REC00 ACTUAL RHD-SIDE TAP

REC01 ACTUAL RHD-SIDE TAP

REC02 ACTUAL RHD-SIDE TAP

REC03 ACTUAL RHD-SIDE TAP

Sheet: /afe_bank0/
File: afe_bank0.kicad_sch
Title: Project SCCI RH S4 / RHD input windows 0

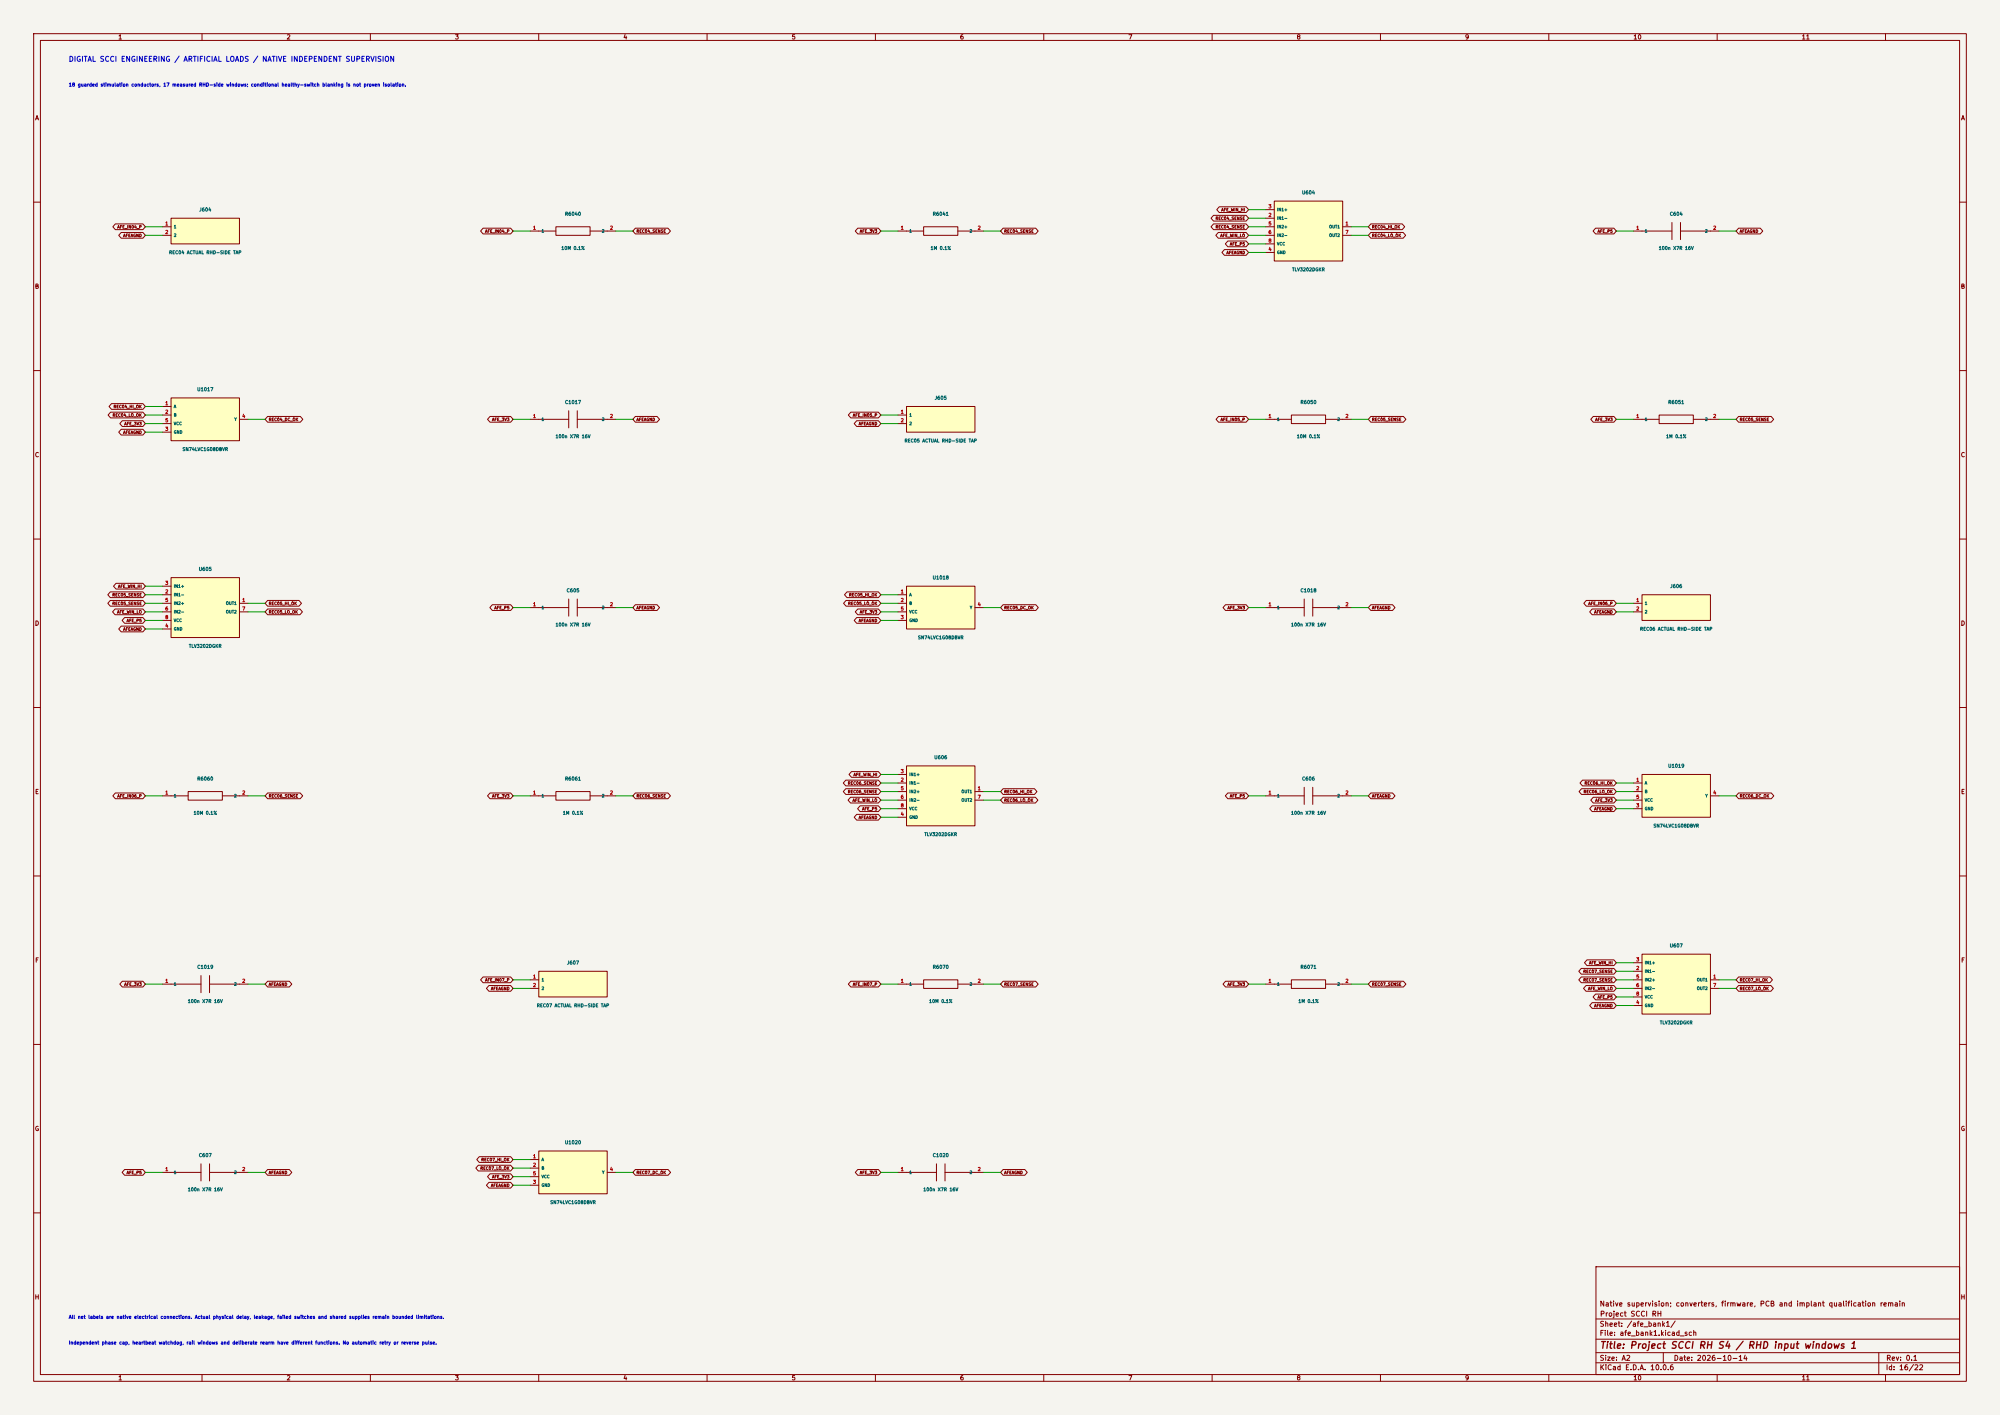
[picture p222: page 16]

REC04 ACTUAL RHD-SIDE TAP

REC05 ACTUAL RHD-SIDE TAP

REC06 ACTUAL RHD-SIDE TAP

REC07 ACTUAL RHD-SIDE TAP

Sheet: /afe_bank1/
File: afe_bank1.kicad_sch
Title: Project SCCI RH S4 / RHD input windows 1

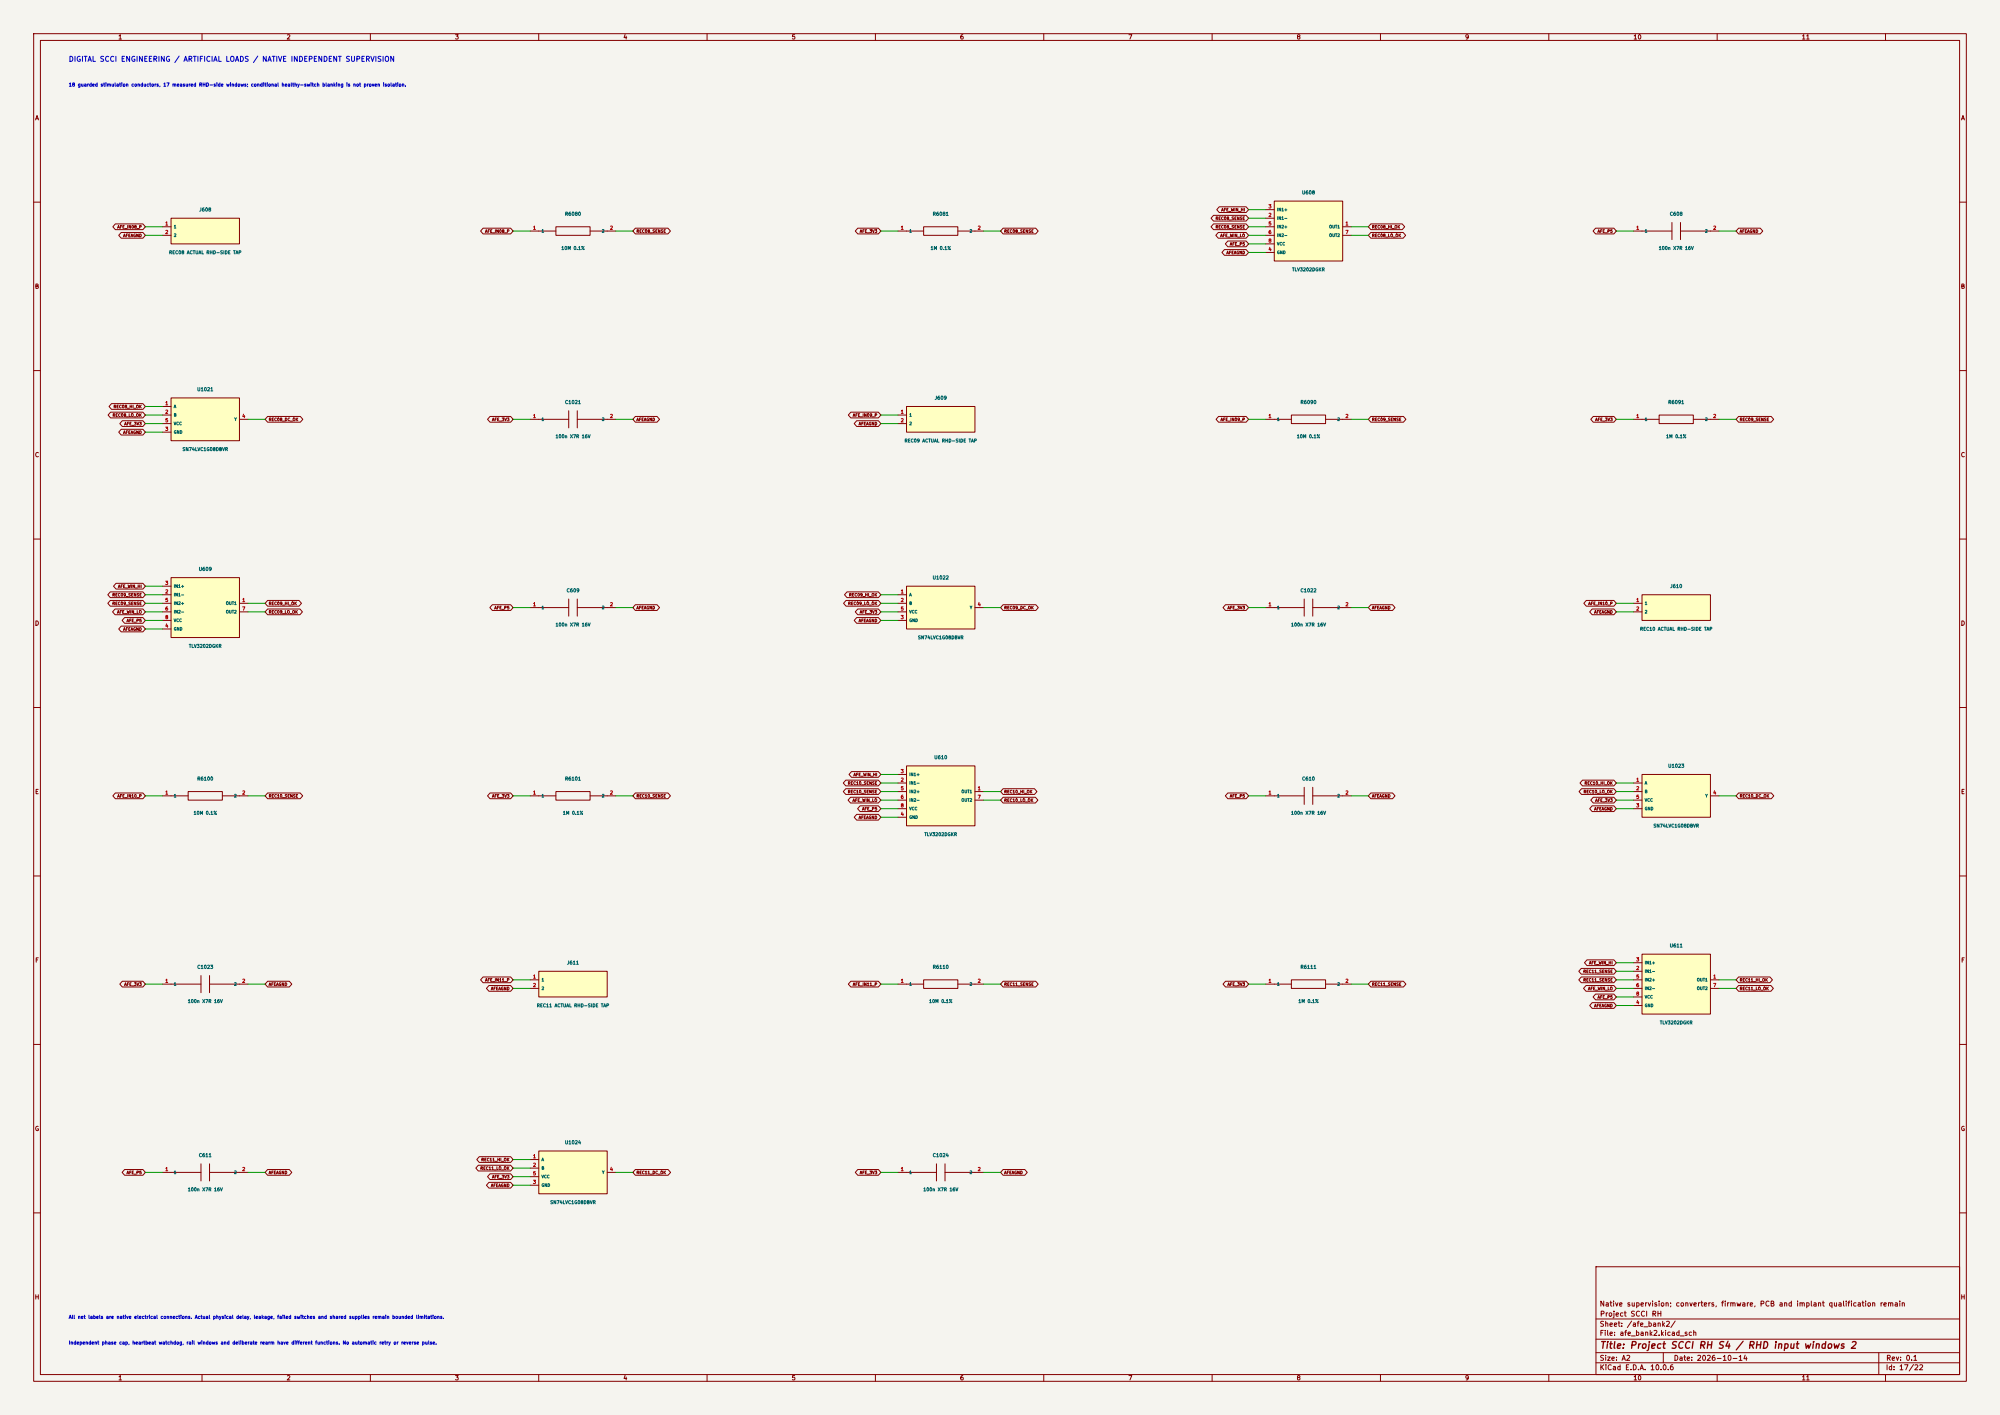
[picture p223: page 17]

REC08 ACTUAL RHD-SIDE TAP

REC09 ACTUAL RHD-SIDE TAP

REC10 ACTUAL RHD-SIDE TAP

REC11 ACTUAL RHD-SIDE TAP

Sheet: /afe_bank2/
File: afe_bank2.kicad_sch
Title: Project SCCI RH S4 / RHD input windows 2

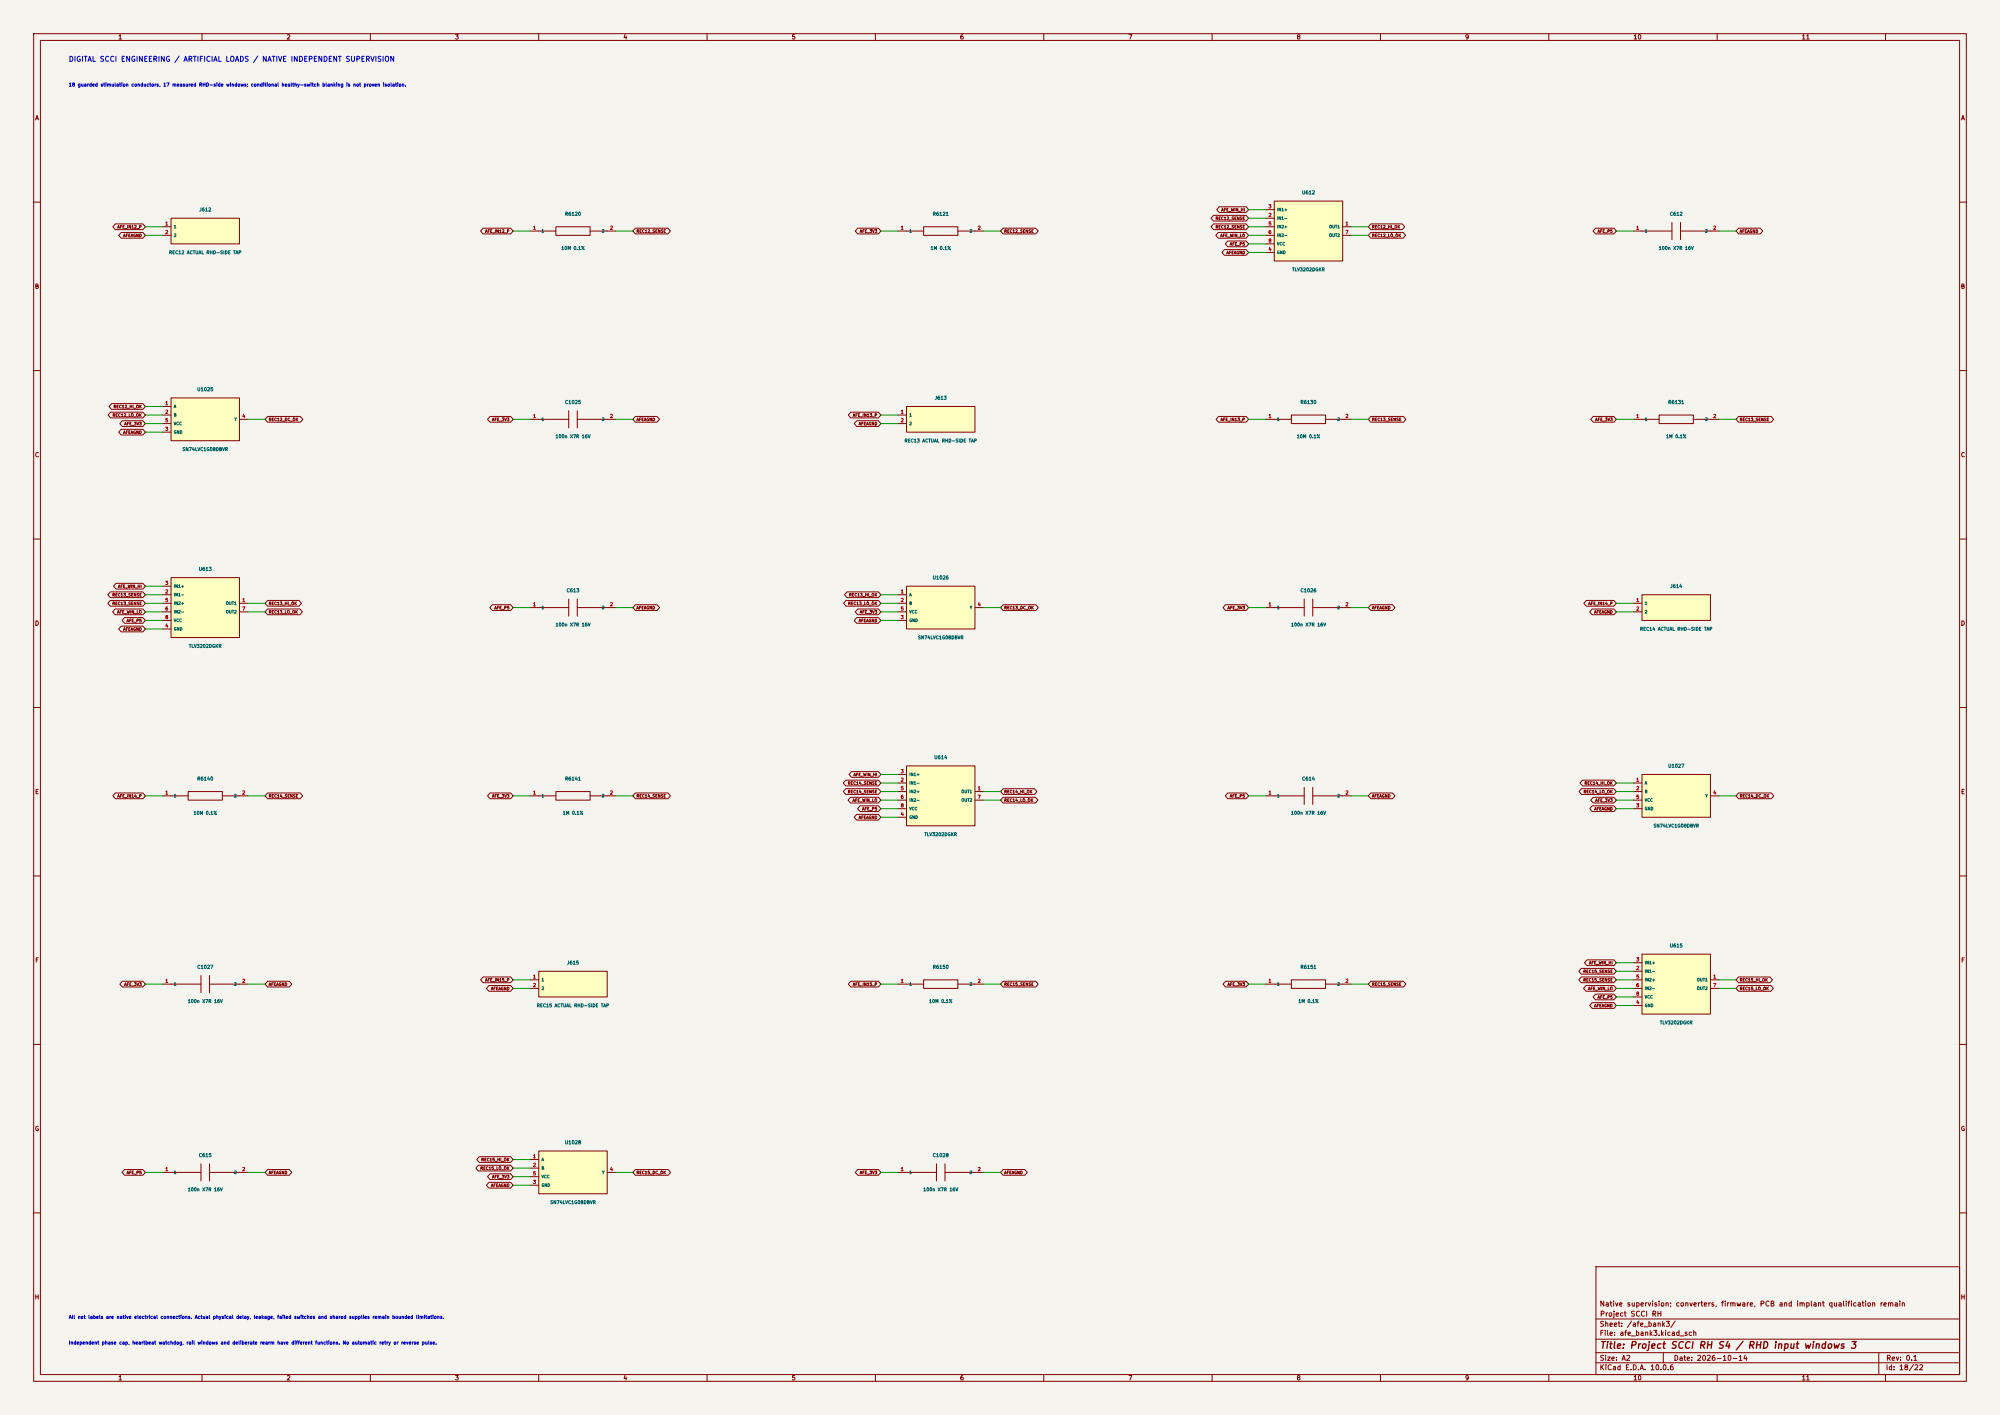
[picture p224: page 18]

REC12 ACTUAL RHD-SIDE TAP

REC13 ACTUAL RHD-SIDE TAP

REC14 ACTUAL RHD-SIDE TAP

REC15 ACTUAL RHD-SIDE TAP

Sheet: /afe_bank3/
File: afe_bank3.kicad_sch
Title: Project SCCI RH S4 / RHD input windows 3

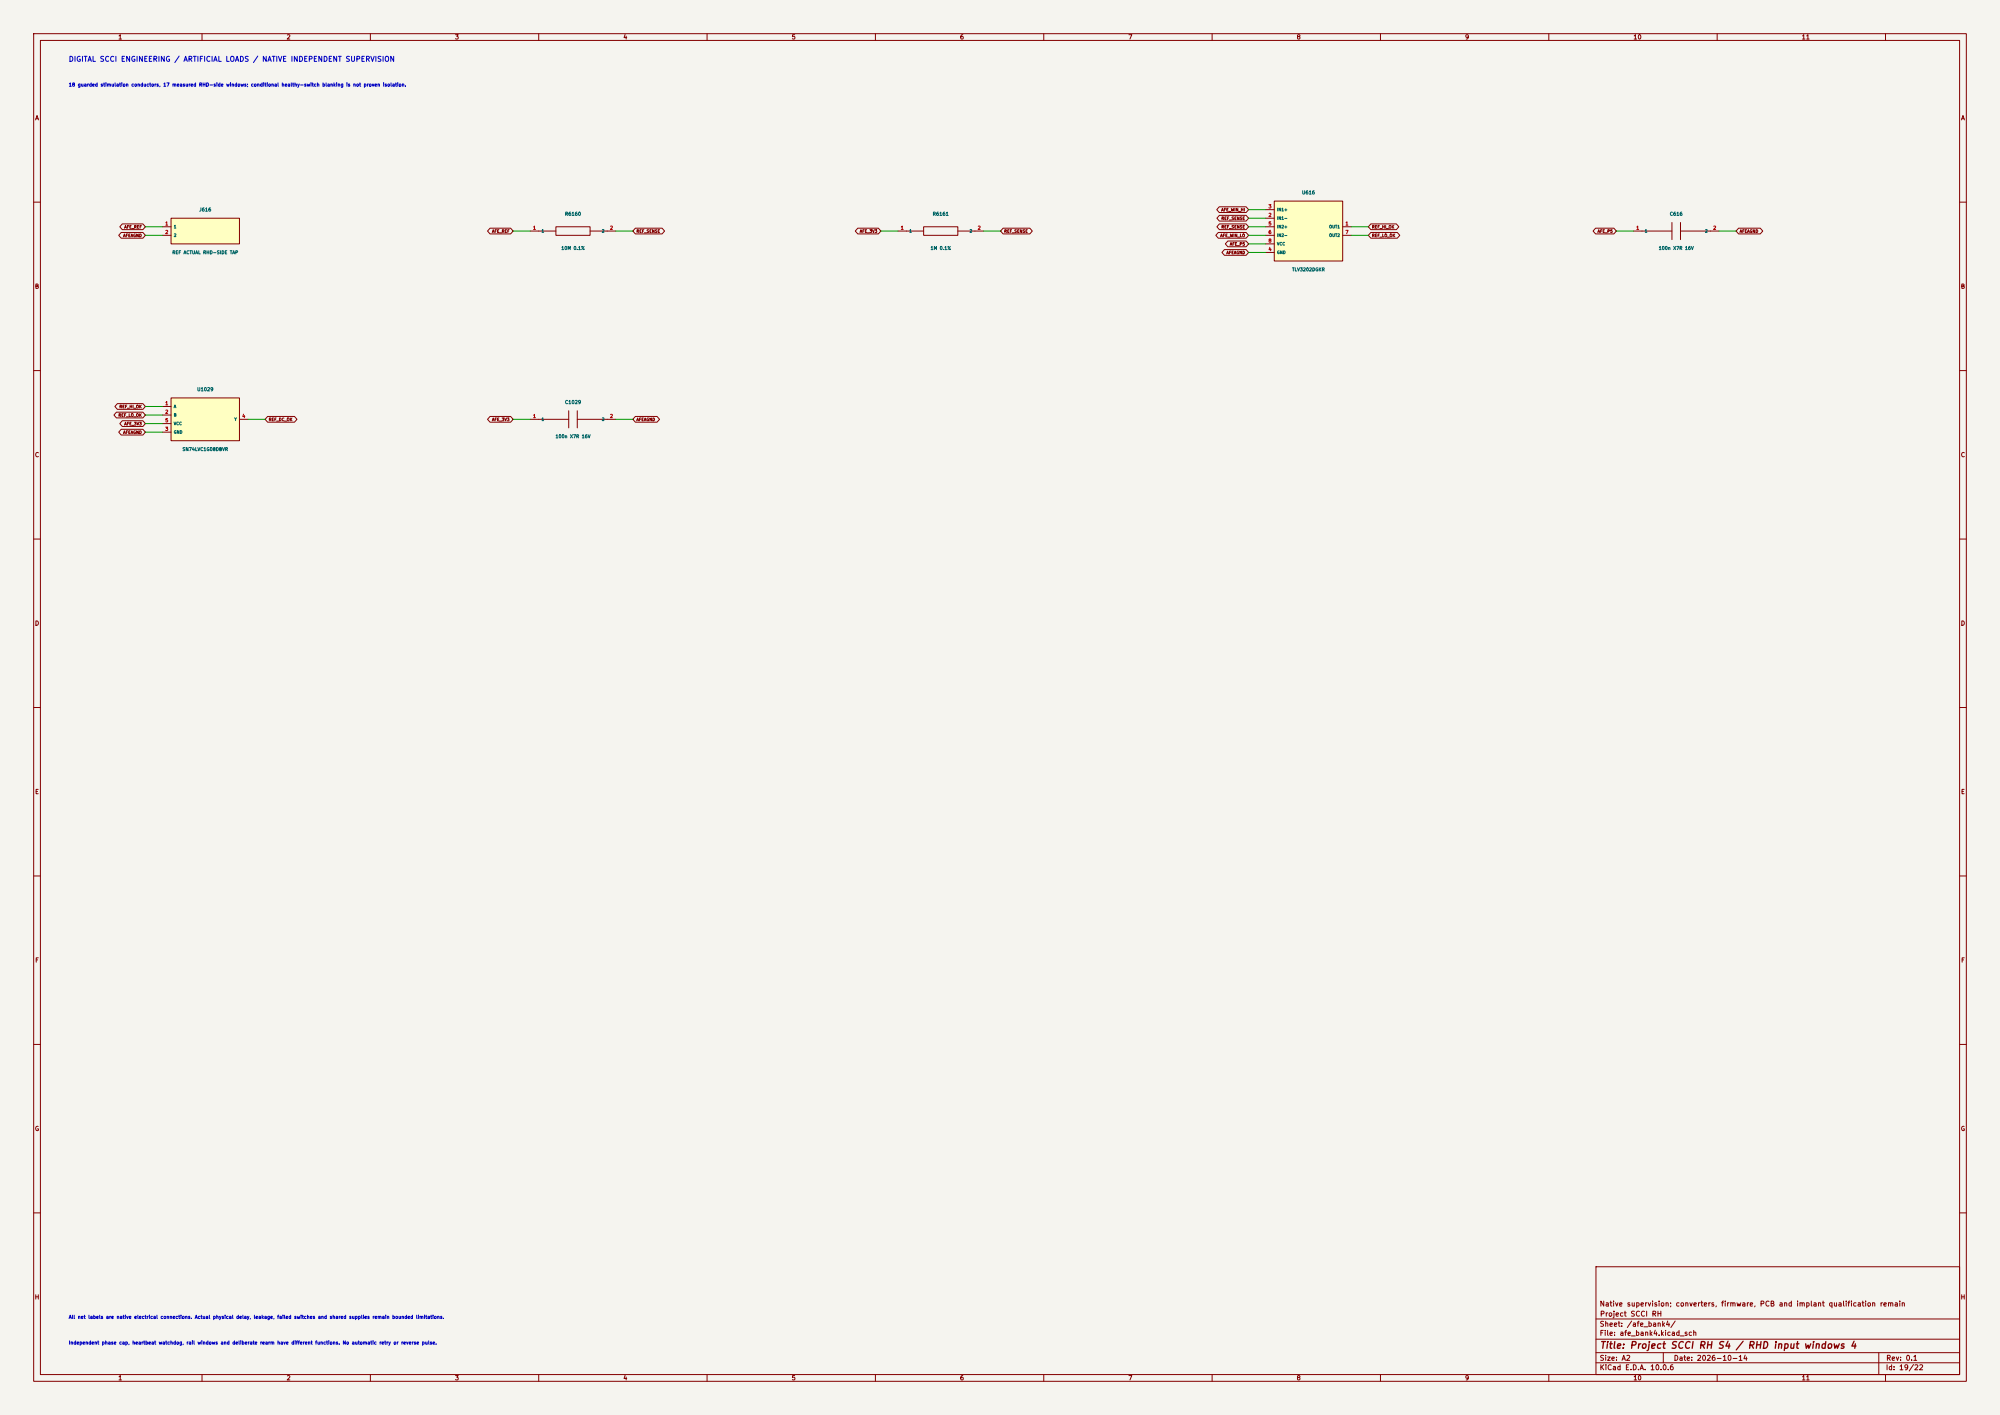
[picture p225: page 19]

AFEAGND DIGITAL SCCI ENGINEERING / ARTIFICIAL LOADS / NATIVE INDEPENDENT SUPERVISION

REF ACTUAL RHD-SIDE TAP

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

Sheet: /afe_bank4/
File: afe_bank4.kicad_sch
Title: Project SCCI RH S4 / RHD input windows 4

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

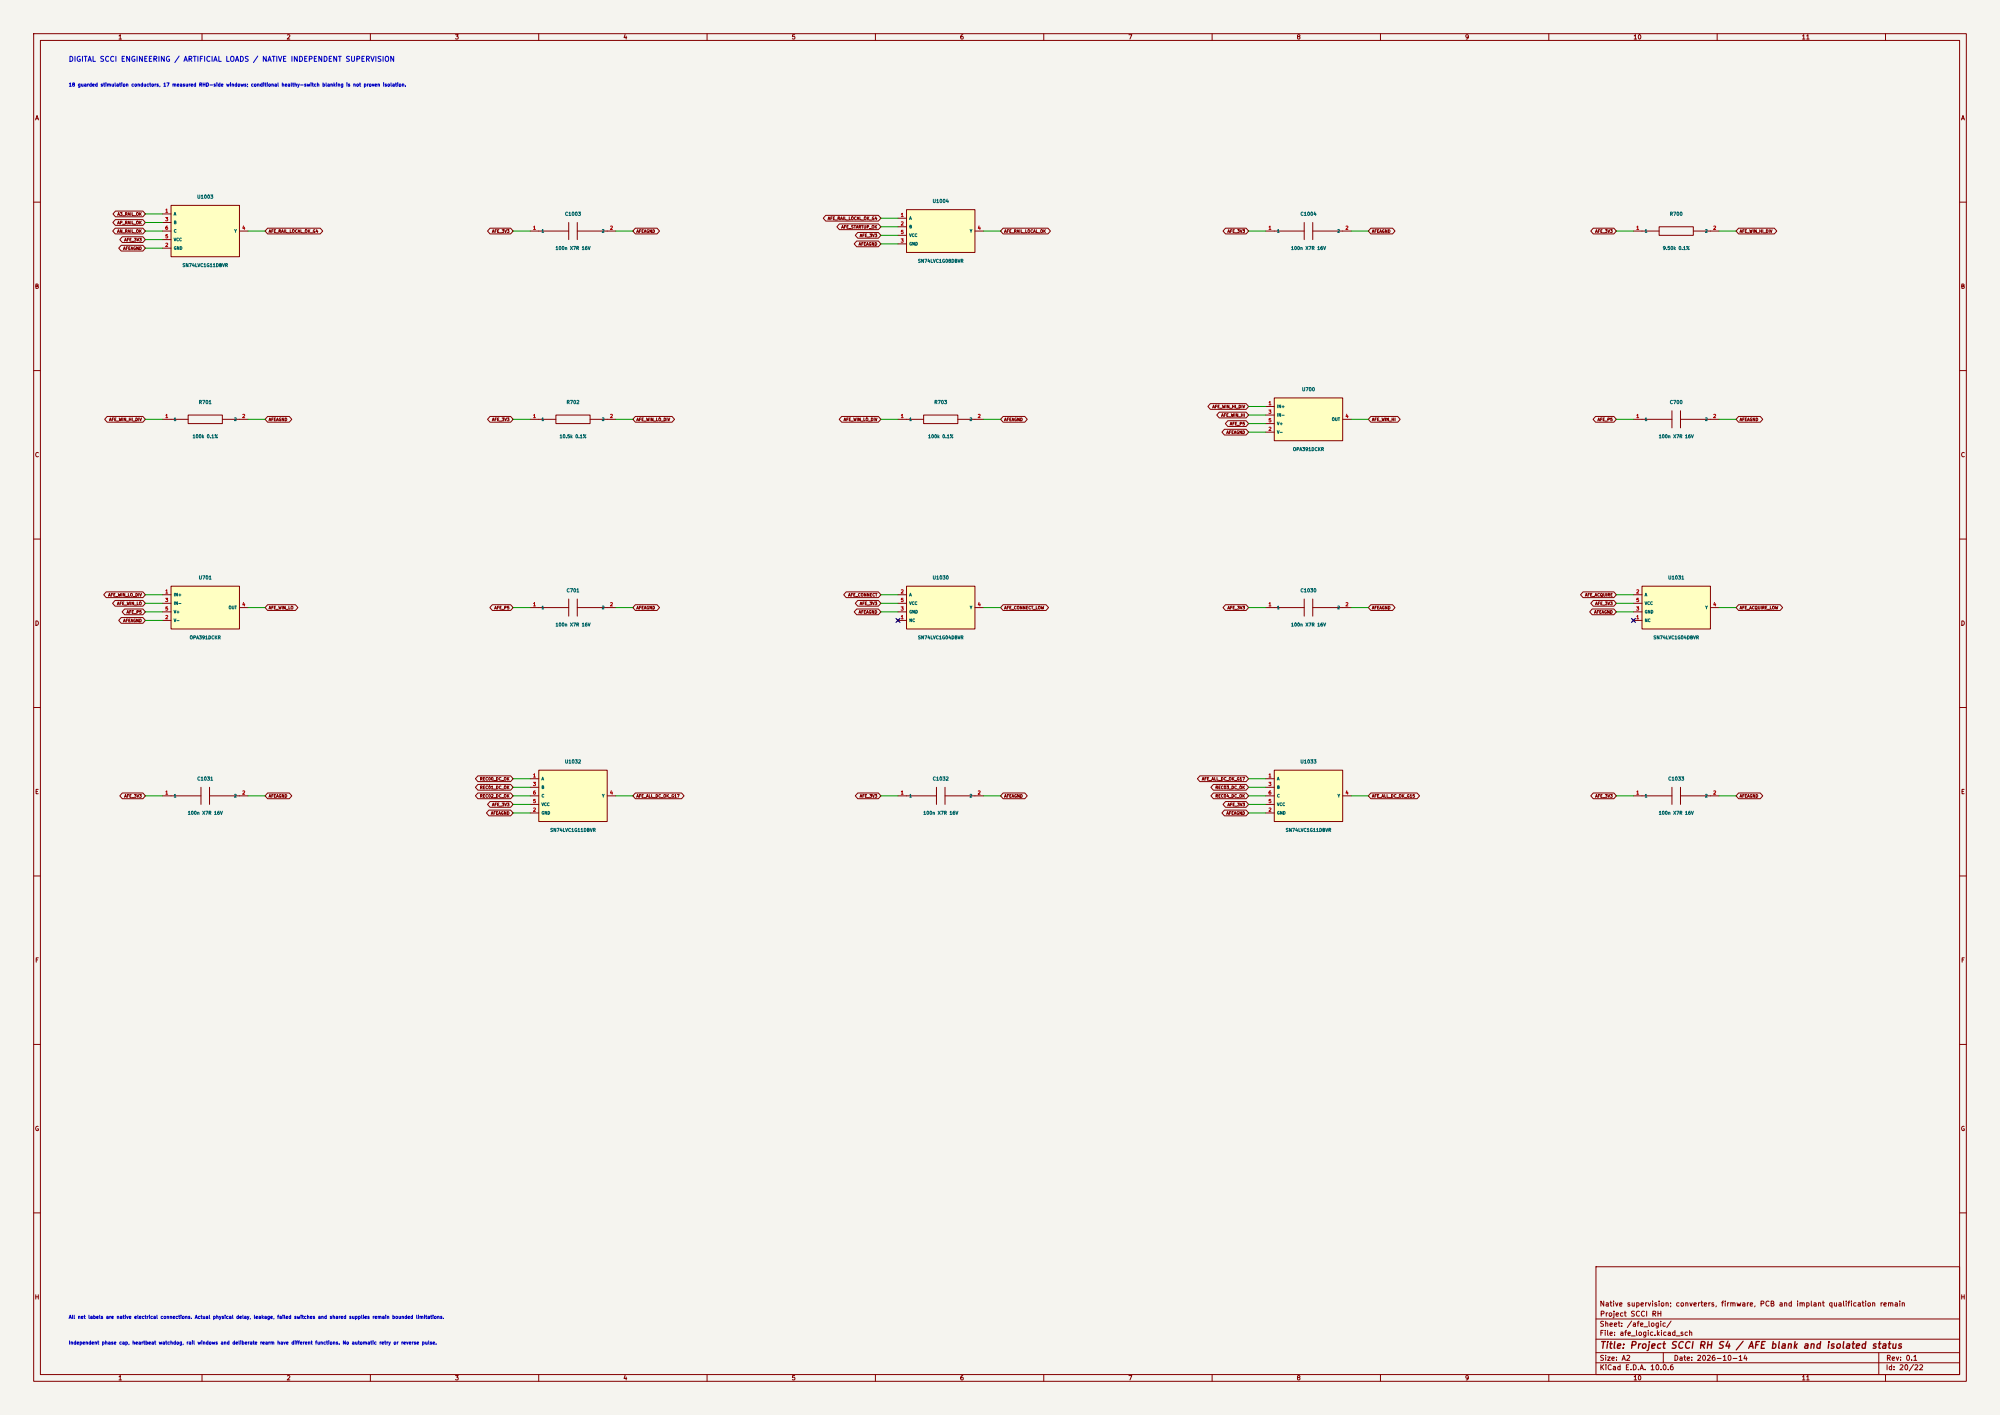
[picture p226: page 20]
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

Sheet: /afe_logic/
File: afe_logic.kicad_sch
Title: Project SCCI RH S4 / AFE blank and isolated status

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

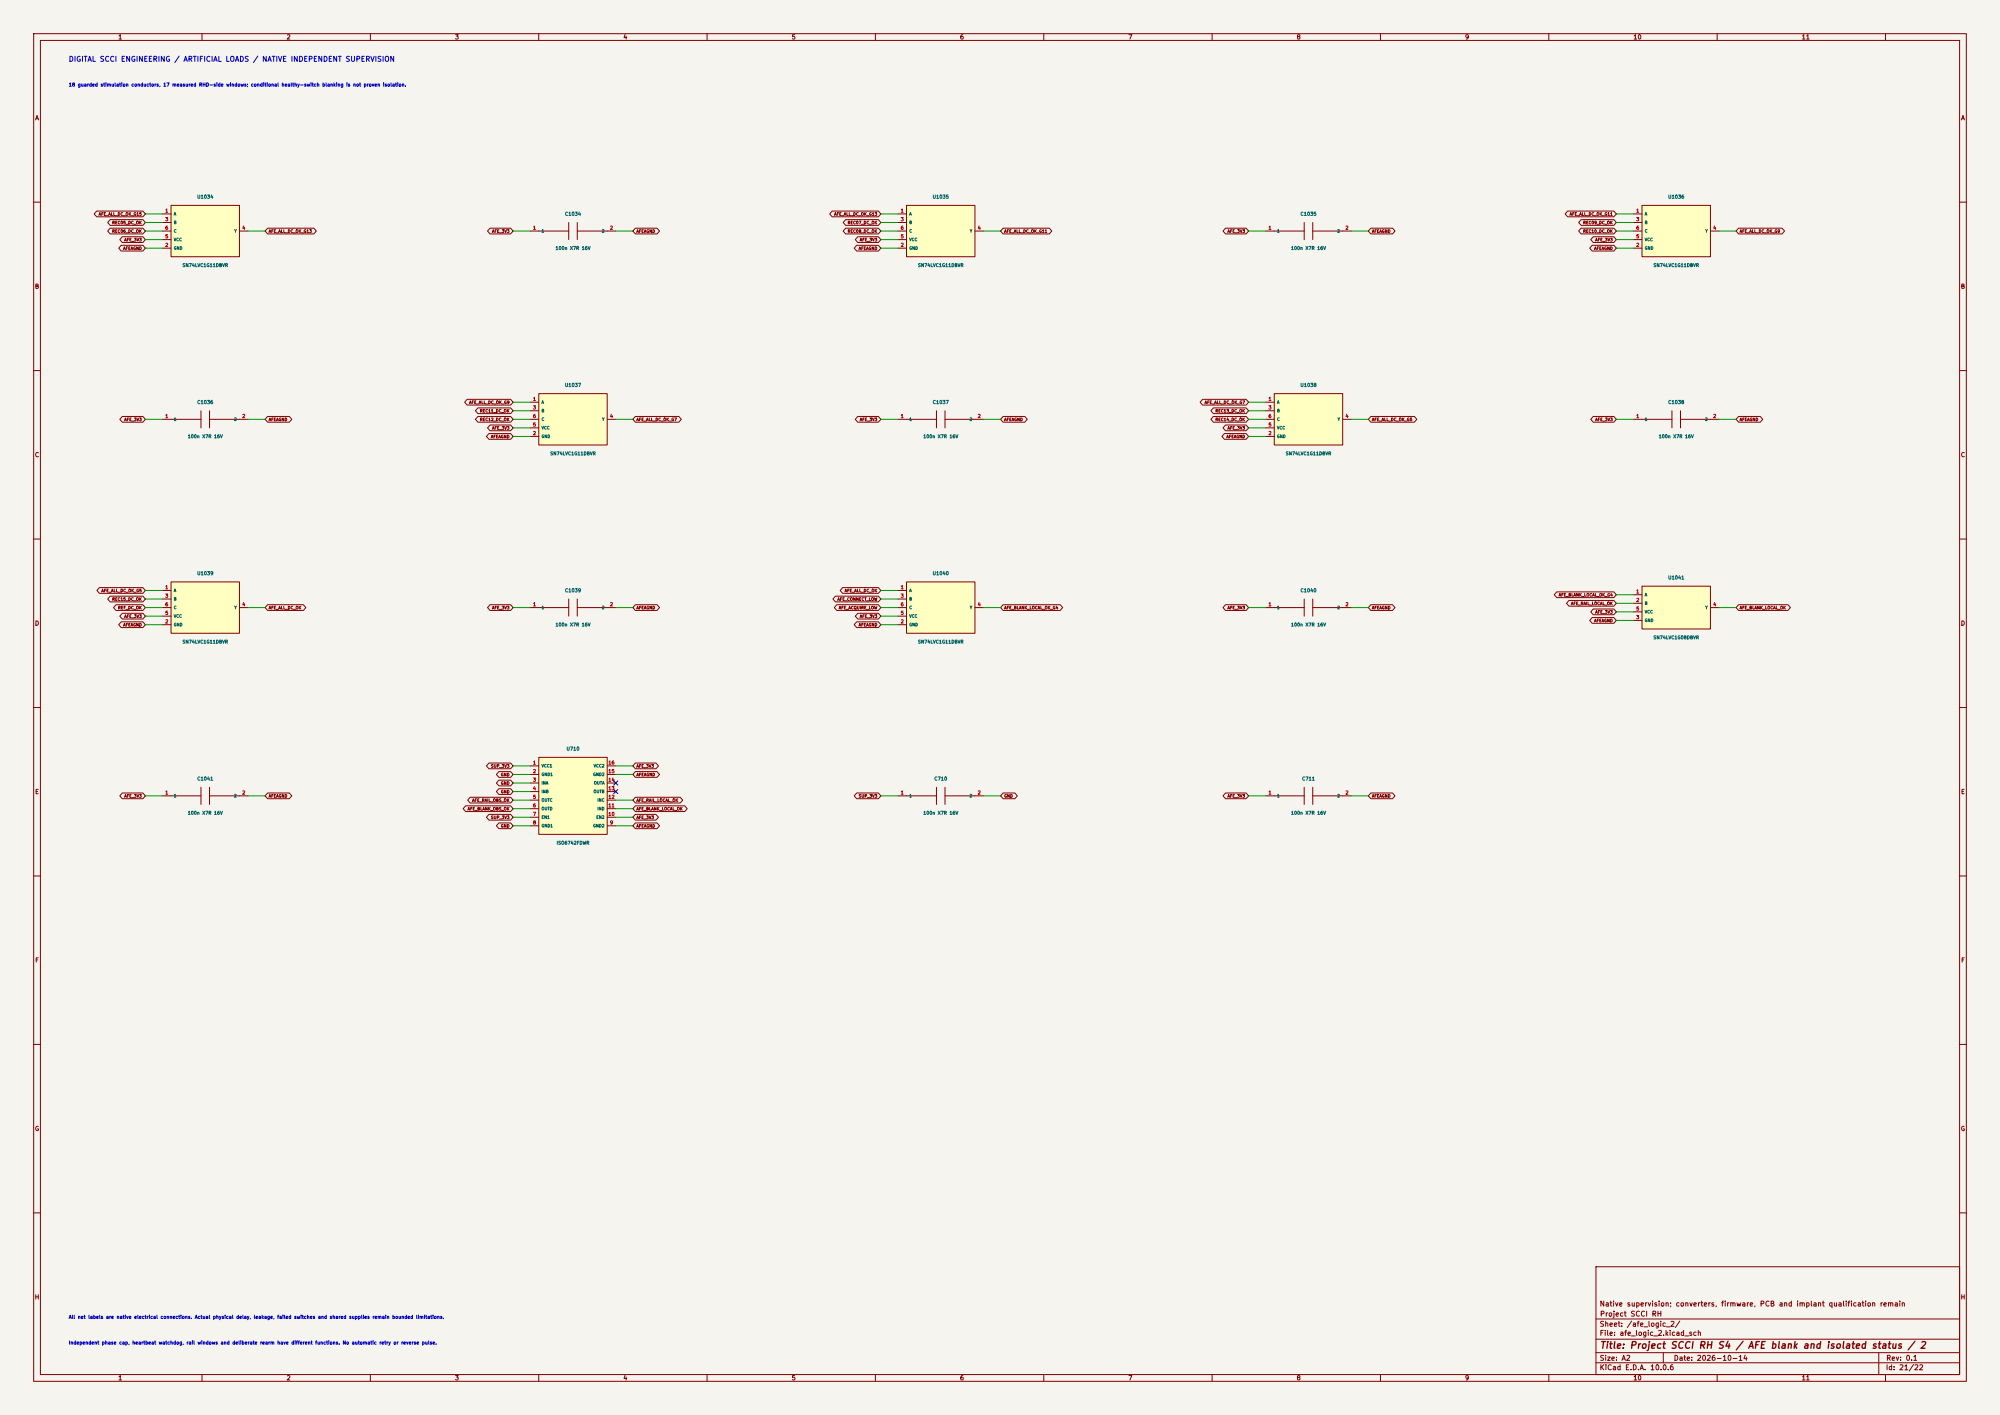
[picture p227: page 21]

AFEAGND DIGITAL SCCI ENGINEERING / ARTIFICIAL LOADS / NATIVE INDEPENDENT SUPERVISION

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

Sheet: /afe_logic_2/
File: afe_logic_2.kicad_sch
Title: Project SCCI RH S4 / AFE blank and isolated status / 2

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

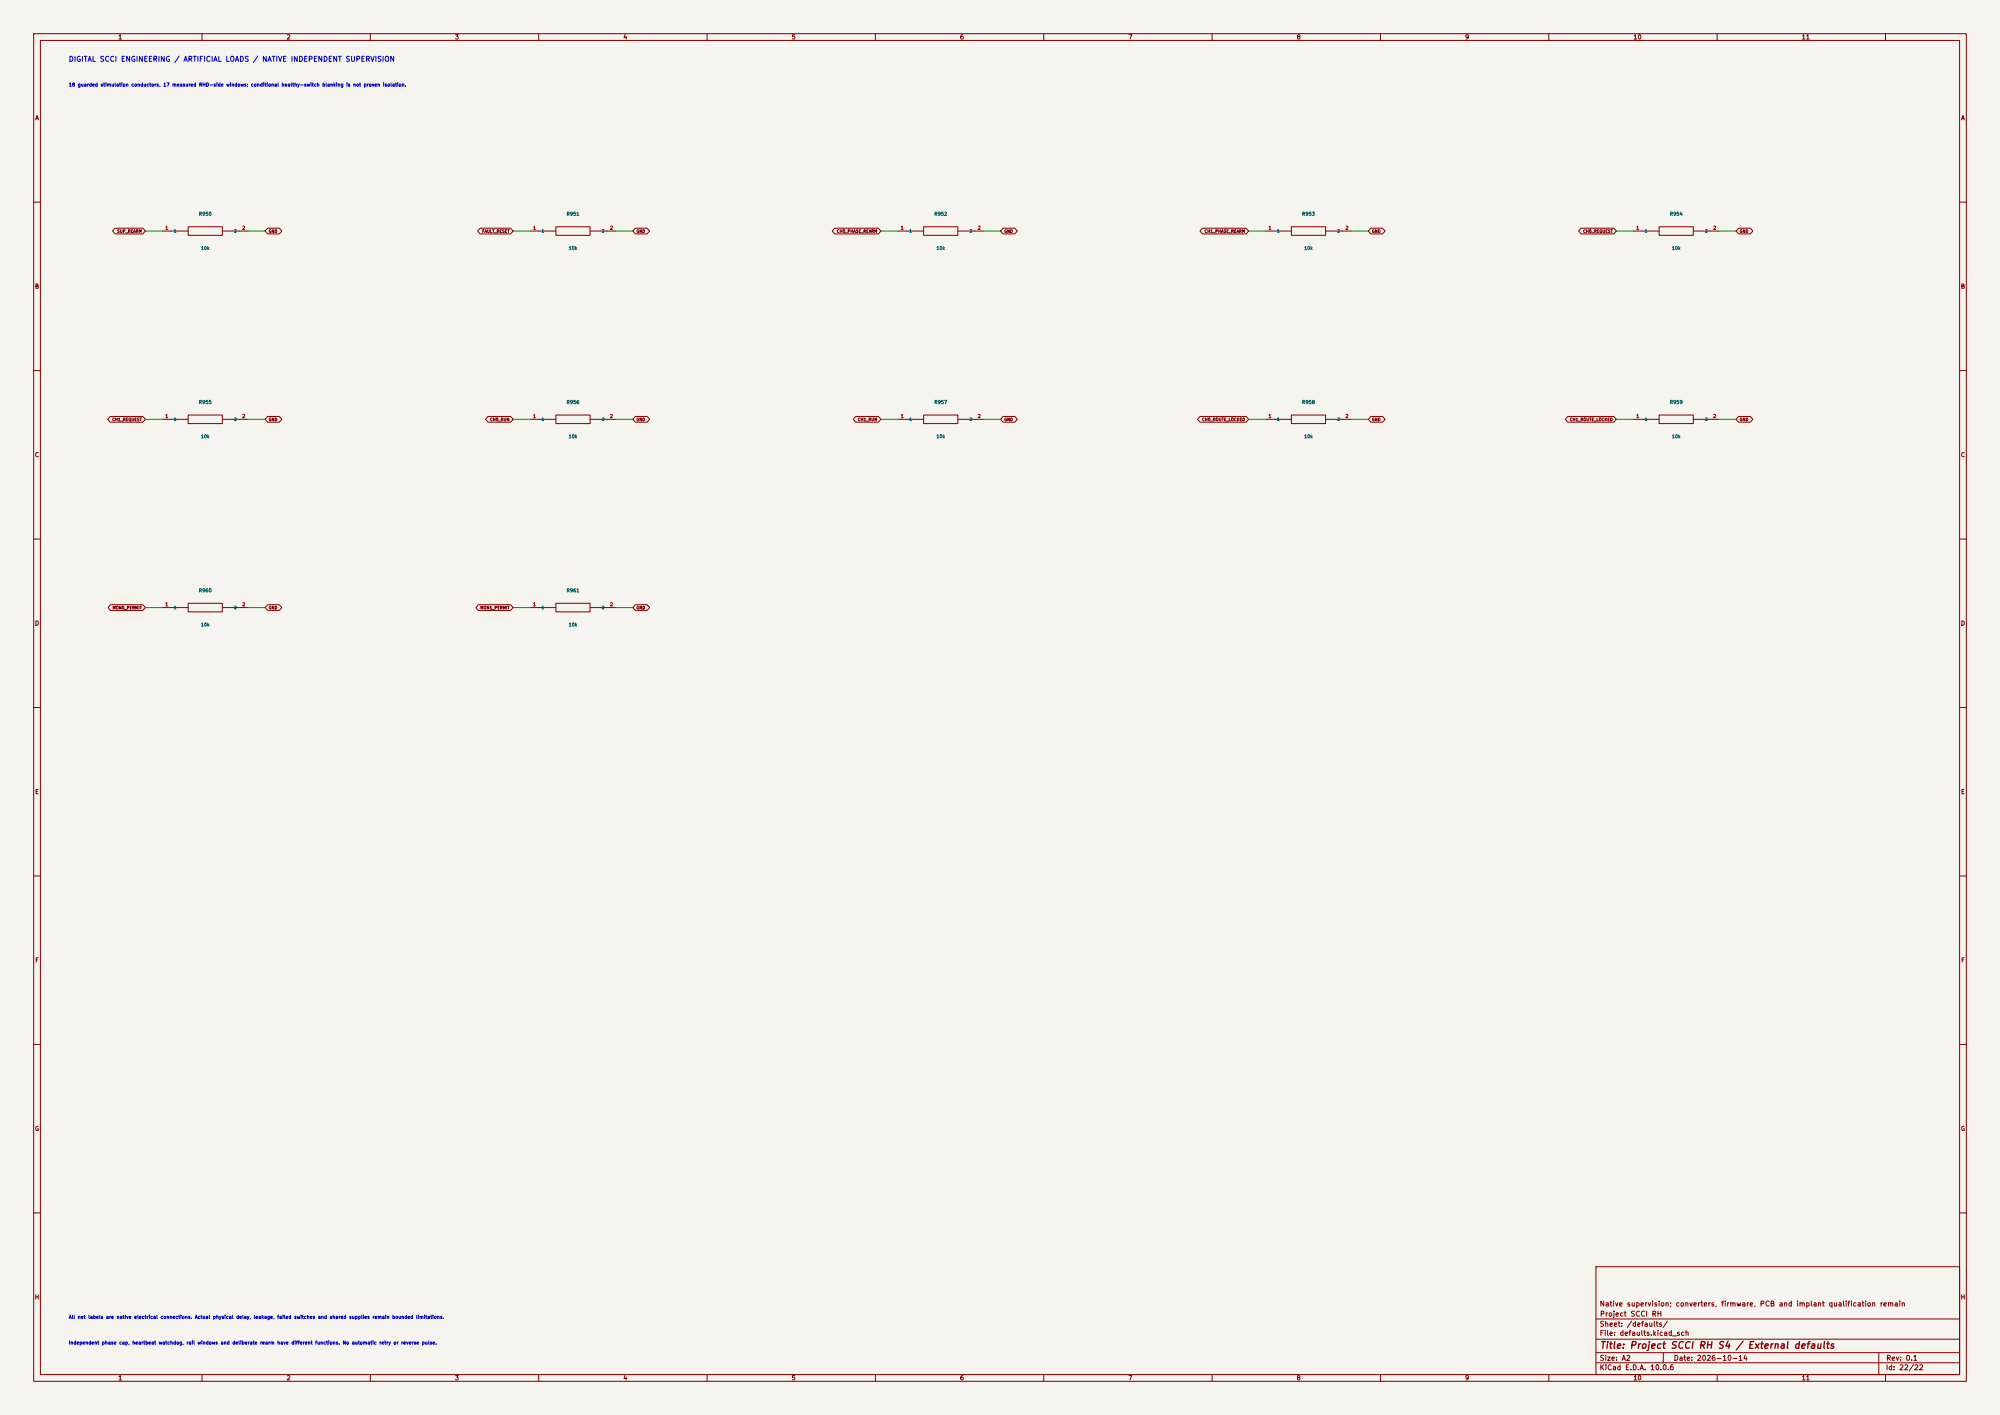
[picture p228: page 22]

Sheet: /defaults/
File: defaults.kicad_sch
Title: Project SCCI RH S4 / External defaults
