pratham-cloud-ctrl/Project-SCCI-RH/electronics/stage4/integrated-pcb/boards/supervision/supervision.kicad_pcb

## KiCad design electronics/stage4/integrated-pcb/boards/supervision/supervision.kicad_pcb (2026-10-29)

Schematic: supervision.kicad_sch, Project SCCI RH S4 / Interfaces and handoff

Parts:
J50001: EXTERNAL SUPERVISOR AND HOST RAILS; PinHeader_1x07_P2.54mm_Vertical
J50002: FLOATING AFE RAILS AND OBSERVED CONTROLS; PinHeader_1x06_P2.54mm_Vertical
J50003: RAW CONTROL / STATUS; PinHeader_1x12_P2.54mm_Vertical
J50004: EXISTING MONITOR OBSERVATIONS; PinHeader_1x09_P2.54mm_Vertical
J50005: EXPORTED NATIVE HEALTH / PERMISSION; PinHeader_1x13_P2.54mm_Vertical
J50006: DRIVER INTERNAL DIFFERENTIAL VOLTAGES; PinHeader_1x05_P2.54mm_Vertical

Connections:
SYS_0bc4e447__AFE_CONNECT: J50002.5; also elsewhere on the board
SYS_2d0e5b2e__CH0_QUIESCENT_OK: J50005.5; also elsewhere on the board
SYS_3fdd5066__AFE_P5: J50002.2; also elsewhere on the board
SYS_4eb6b999__AFE_ACQUIRE: J50002.6; also elsewhere on the board
SYS_4f66f129__MON_VREF: J50004.4; also elsewhere on the board
SYS_6a132103__CH1_RUN: J50003.7; also elsewhere on the board
SYS_7db86ec0__PHASE_REARM0: J50003.10; also elsewhere on the board
SYS_20eba8c2__CH1_QUIESCENT_OK: J50005.6; also elsewhere on the board
SYS_37cfe02a__MON_VMID: J50004.3; also elsewhere on the board
SYS_46e29157__PHASE_REARM1: J50003.11; also elsewhere on the board
SYS_46ea5f03__CH0_REQUEST: J50003.4; also elsewhere on the board
SYS_56ebc071__CH0_MON_PERMIT: J50004.5; also elsewhere on the board
SYS_65aafbb6__AFE_3V3: J50002.1; also elsewhere on the board
SYS_66aba95b__SUP_5: J50001.2; also elsewhere on the board
SYS_77c24b0d__GLOBAL_GUARD_EN: J50005.12; also elsewhere on the board
SYS_84f28705__CH1_ROUTE_LOCKED: J50003.9; also elsewhere on the board
SYS_88c50083__SUP_ARMED: J50005.9; also elsewhere on the board
SYS_401be33b__CH1_A_ROUTER: J50006.3; also elsewhere on the board
SYS_502efdd4__CH1_I_MON: J50004.2; also elsewhere on the board
SYS_695f3a7c__CH0_RUN: J50003.6; also elsewhere on the board
SYS_917b1360__CH0_A_ROUTER: J50006.1; also elsewhere on the board
SYS_8359fceb__CH1_EXT_SUP_OK: J50005.8; also elsewhere on the board
SYS_15689dc4__VH_24: J50001.6; also elsewhere on the board
SYS_56562df4__GND: J50001.7, J50003.12, J50004.9, J50005.13, J50006.5; also elsewhere on the board
SYS_98321c7b__AFE_ISOLATED_READY: J50005.4; also elsewhere on the board
SYS_1954027d__CH0_ROUTE_LOCKED: J50003.8; also elsewhere on the board
SYS_08572049__HOST_3V3: J50001.3; also elsewhere on the board
SYS_82531809__FAULT_RESET: J50003.2; also elsewhere on the board
SYS_93547907__RAILS_QUALIFIED: J50005.2; also elsewhere on the board
SYS_a83d484c__WATCHDOG_OK: J50005.3; also elsewhere on the board
SYS_aa321af6__CH1_MON_PERMIT: J50004.6; also elsewhere on the board
SYS_ab932142__SUP_3V3: J50001.1; also elsewhere on the board
SYS_bb444a6e__SUP_REARM: J50003.1; also elsewhere on the board
SYS_c73180be__CH1_B_BR: J50006.4; also elsewhere on the board
SYS_ce166826__HOST_5: J50001.4; also elsewhere on the board
SYS_d3eac10b__CH0_EXT_SUP_OK: J50004.7; also elsewhere on the board
SYS_d73cd2ee__AFE_N5: J50002.3; also elsewhere on the board
SYS_dd388269__CH1_REQUEST: J50003.5; also elsewhere on the board
SYS_de0a854a__CH1_EXT_SUP_OK: J50004.8; also elsewhere on the board
SYS_e3faaec0__WDI: J50003.3; also elsewhere on the board
SYS_e26747fb__CH0_EXT_SUP_OK: J50005.7; also elsewhere on the board
SYS_ee476f53__CH0_B_BR: J50006.2; also elsewhere on the board
SYS_f8e43b73__CH0_I_MON: J50004.1; also elsewhere on the board
SYS_fb2237f8__VA_15: J50001.5; also elsewhere on the board
SYS_fca1c340__AFEAGND: J50002.4; also elsewhere on the board
SYS_ff7fdc58__RESET_READY: J50005.1; also elsewhere on the board
supervision__CH0_ALLOW: J50005.10; also elsewhere on the board
supervision__CH1_ALLOW: J50005.11; also elsewhere on the board

Notes on the sheet:
DIGITAL SCCI ENGINEERING / ARTIFICIAL LOADS / NATIVE INDEPENDENT SUPERVISION
18 guarded stimulation conductors, 17 measured RHD-side windows; conditional healthy-switch blanking is not proven isolation.

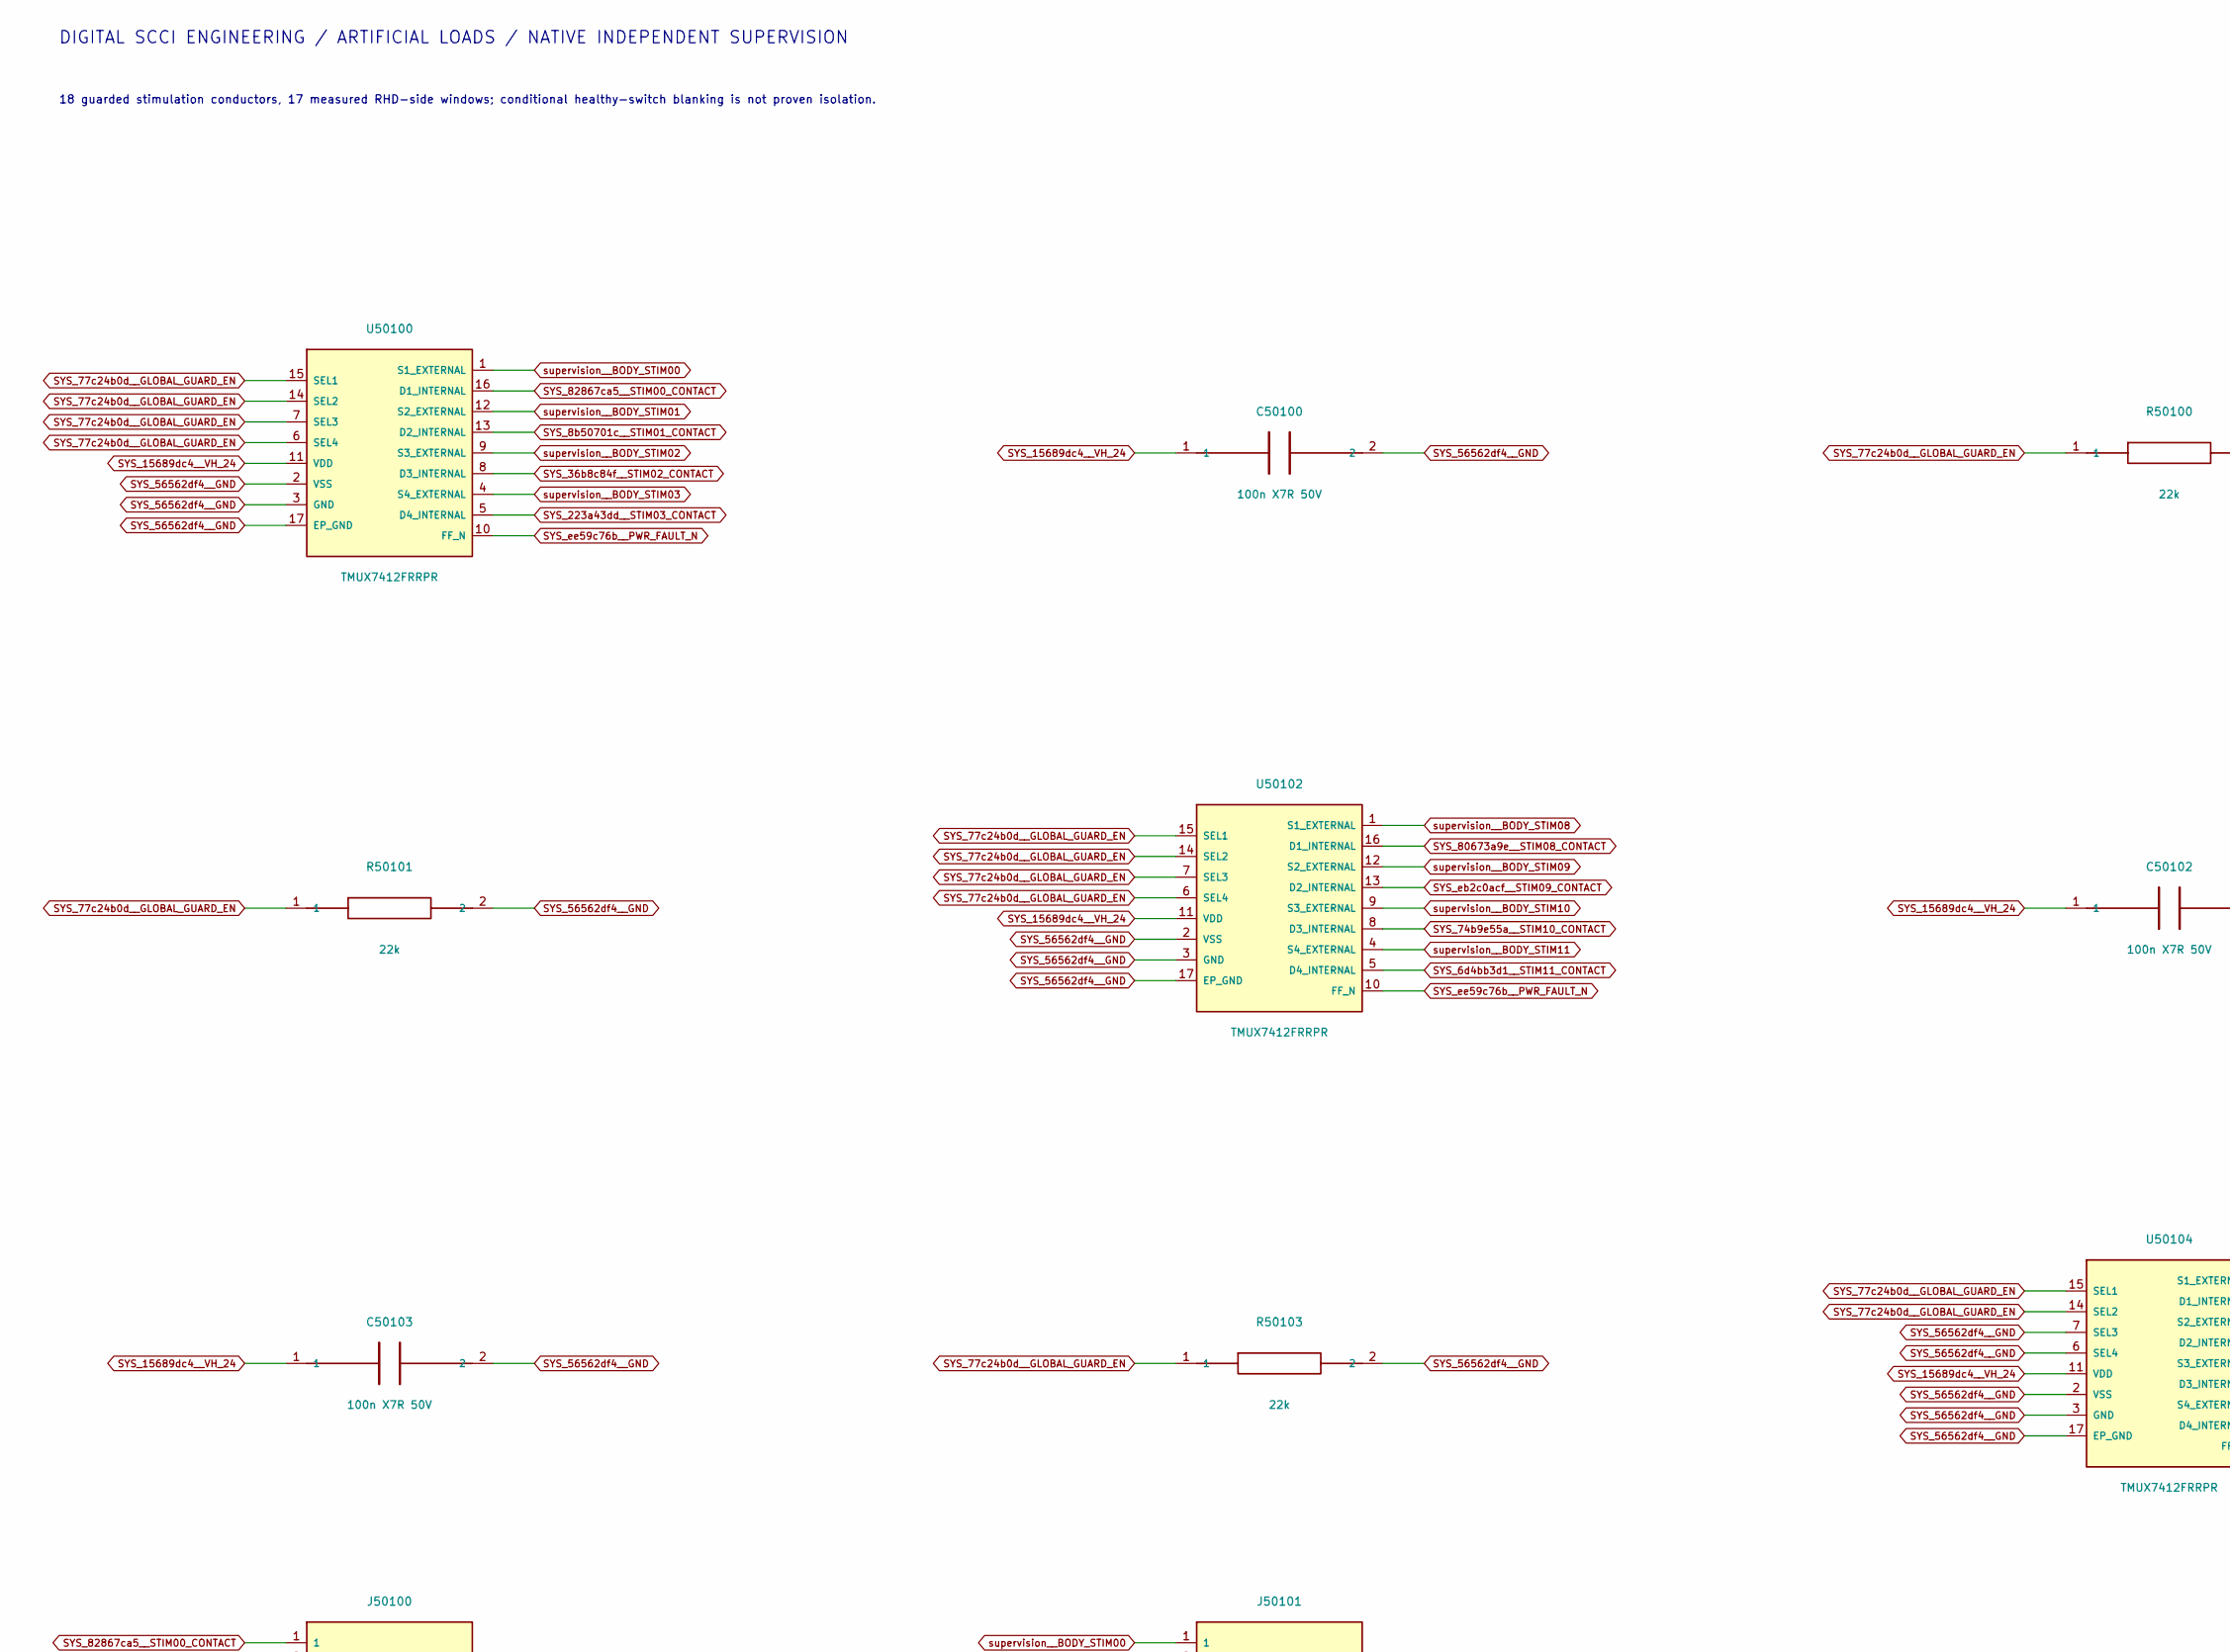
[picture p229: schematic guards.kicad_sch, Project SCCI RH S4 / 18 body-side terminal guards, part in row 1, column 1]

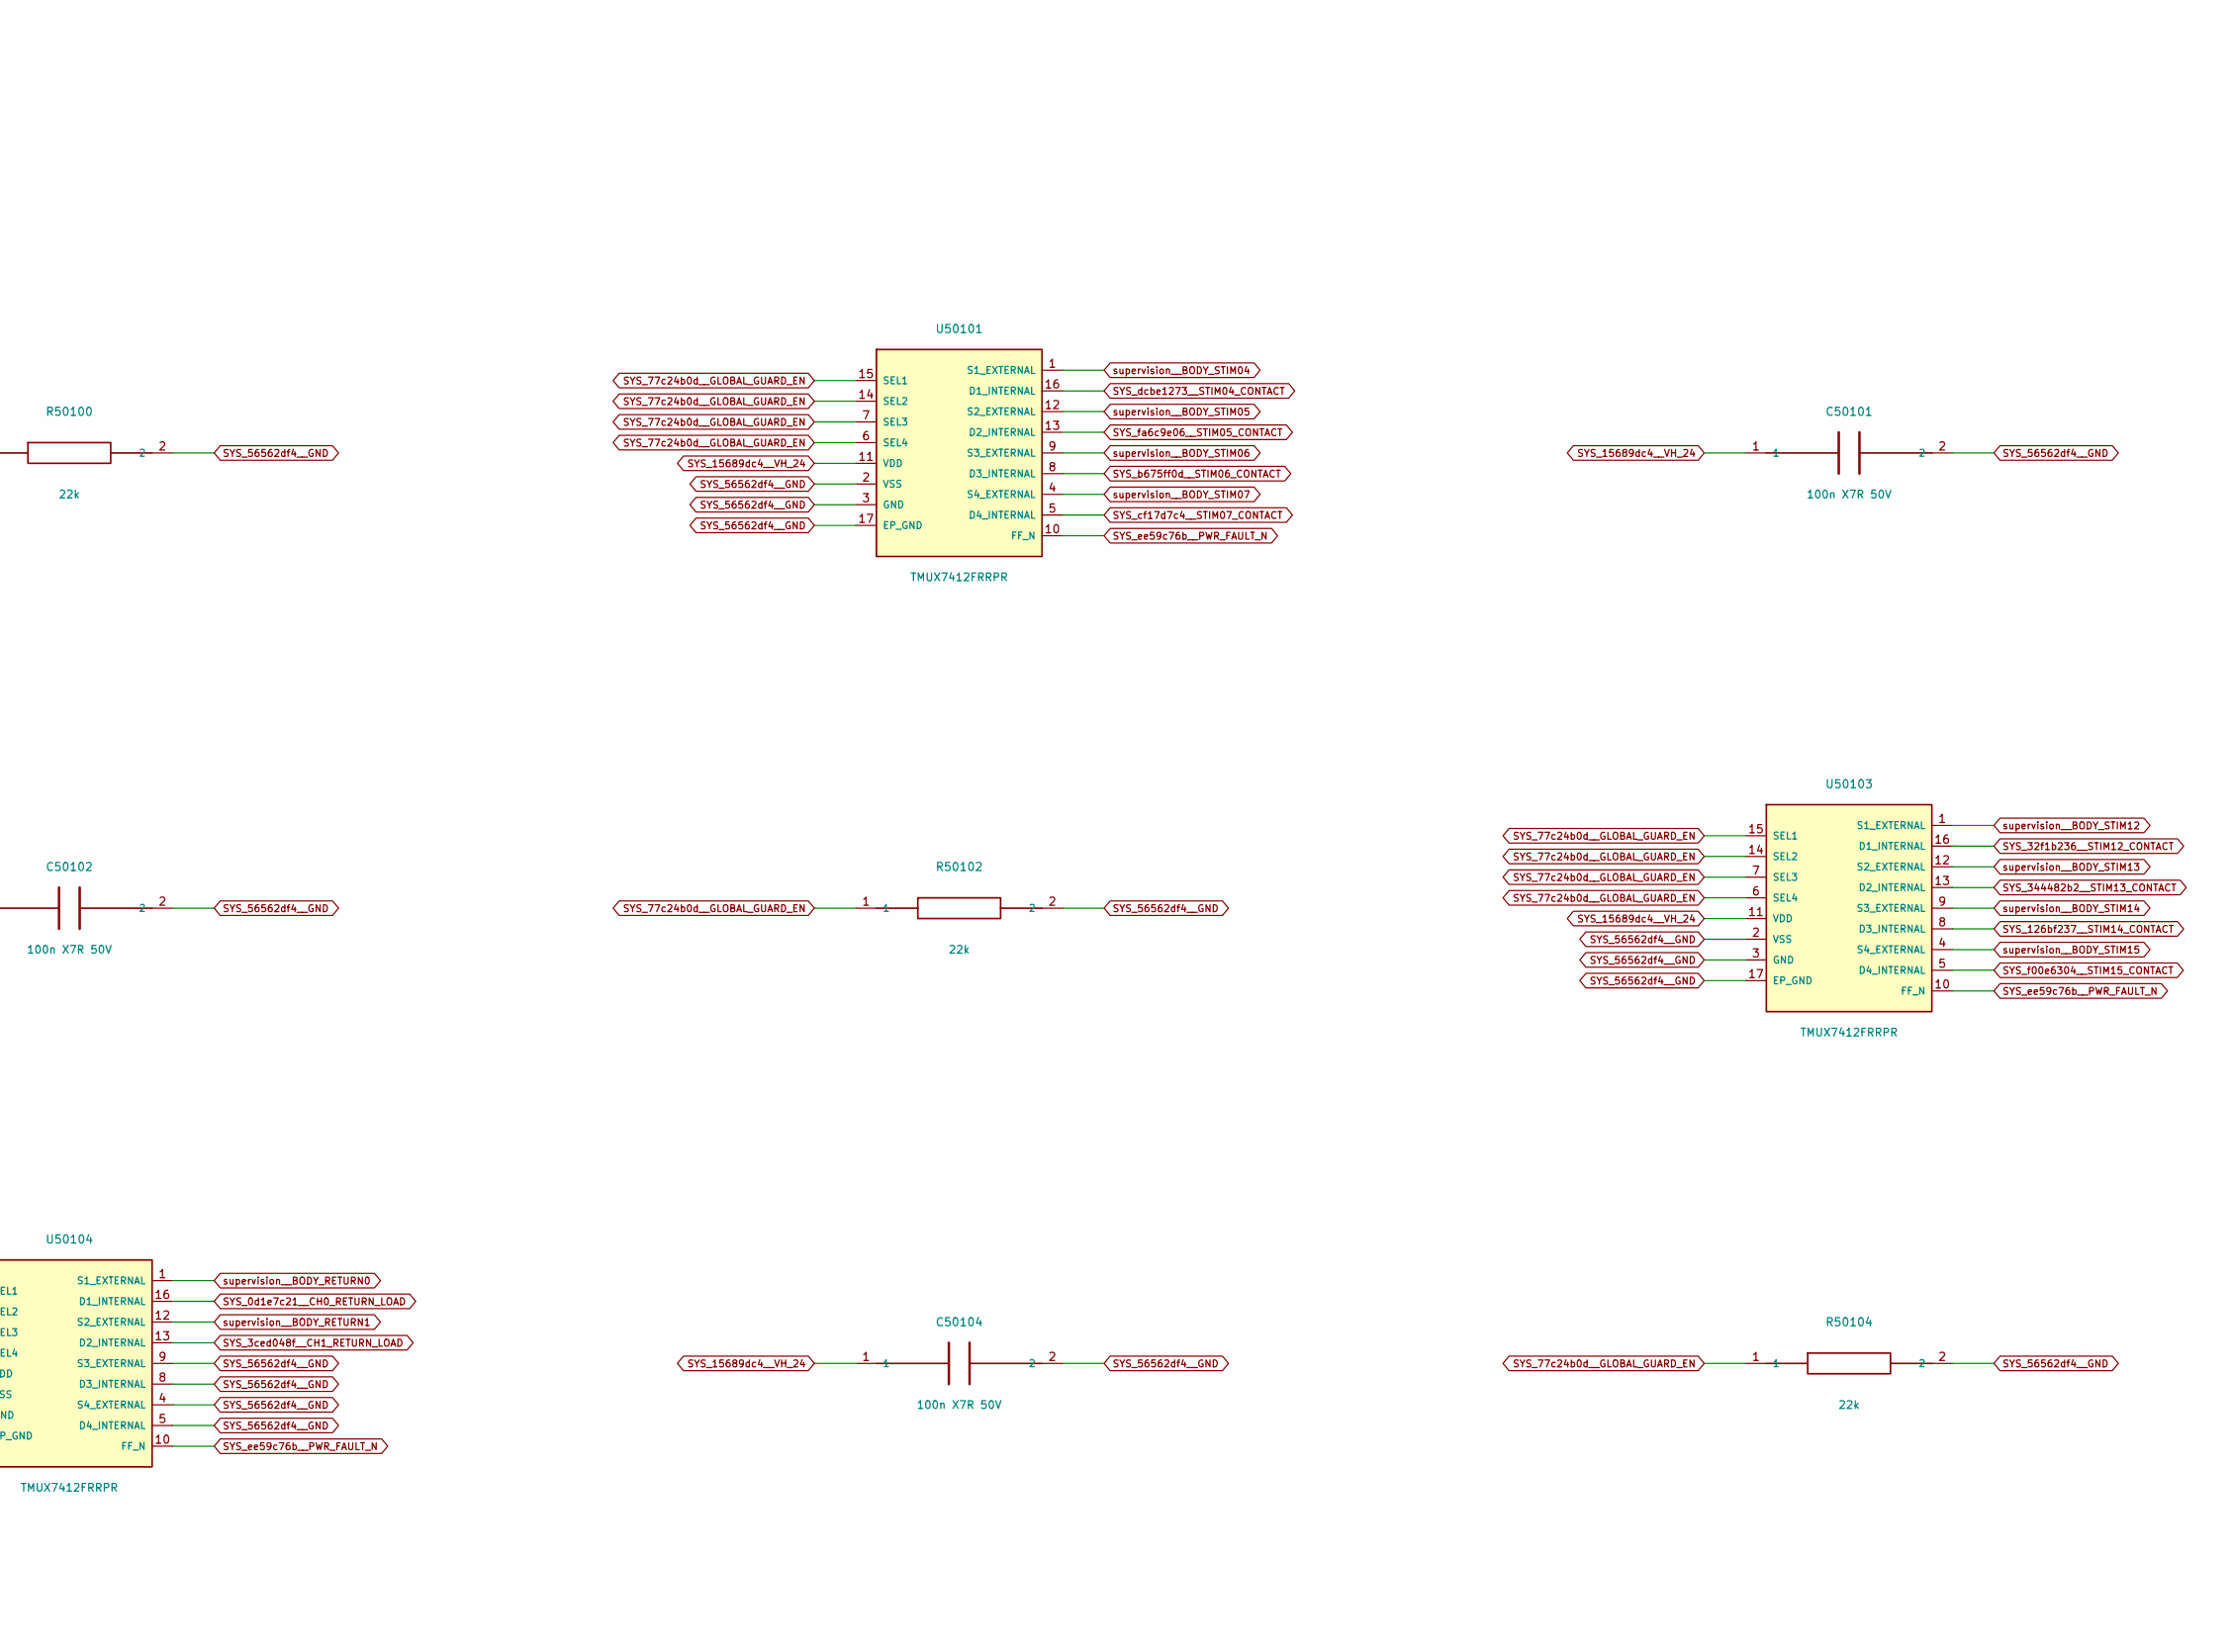
[picture p230: schematic guards.kicad_sch, Project SCCI RH S4 / 18 body-side terminal guards, part in row 1, column 2]

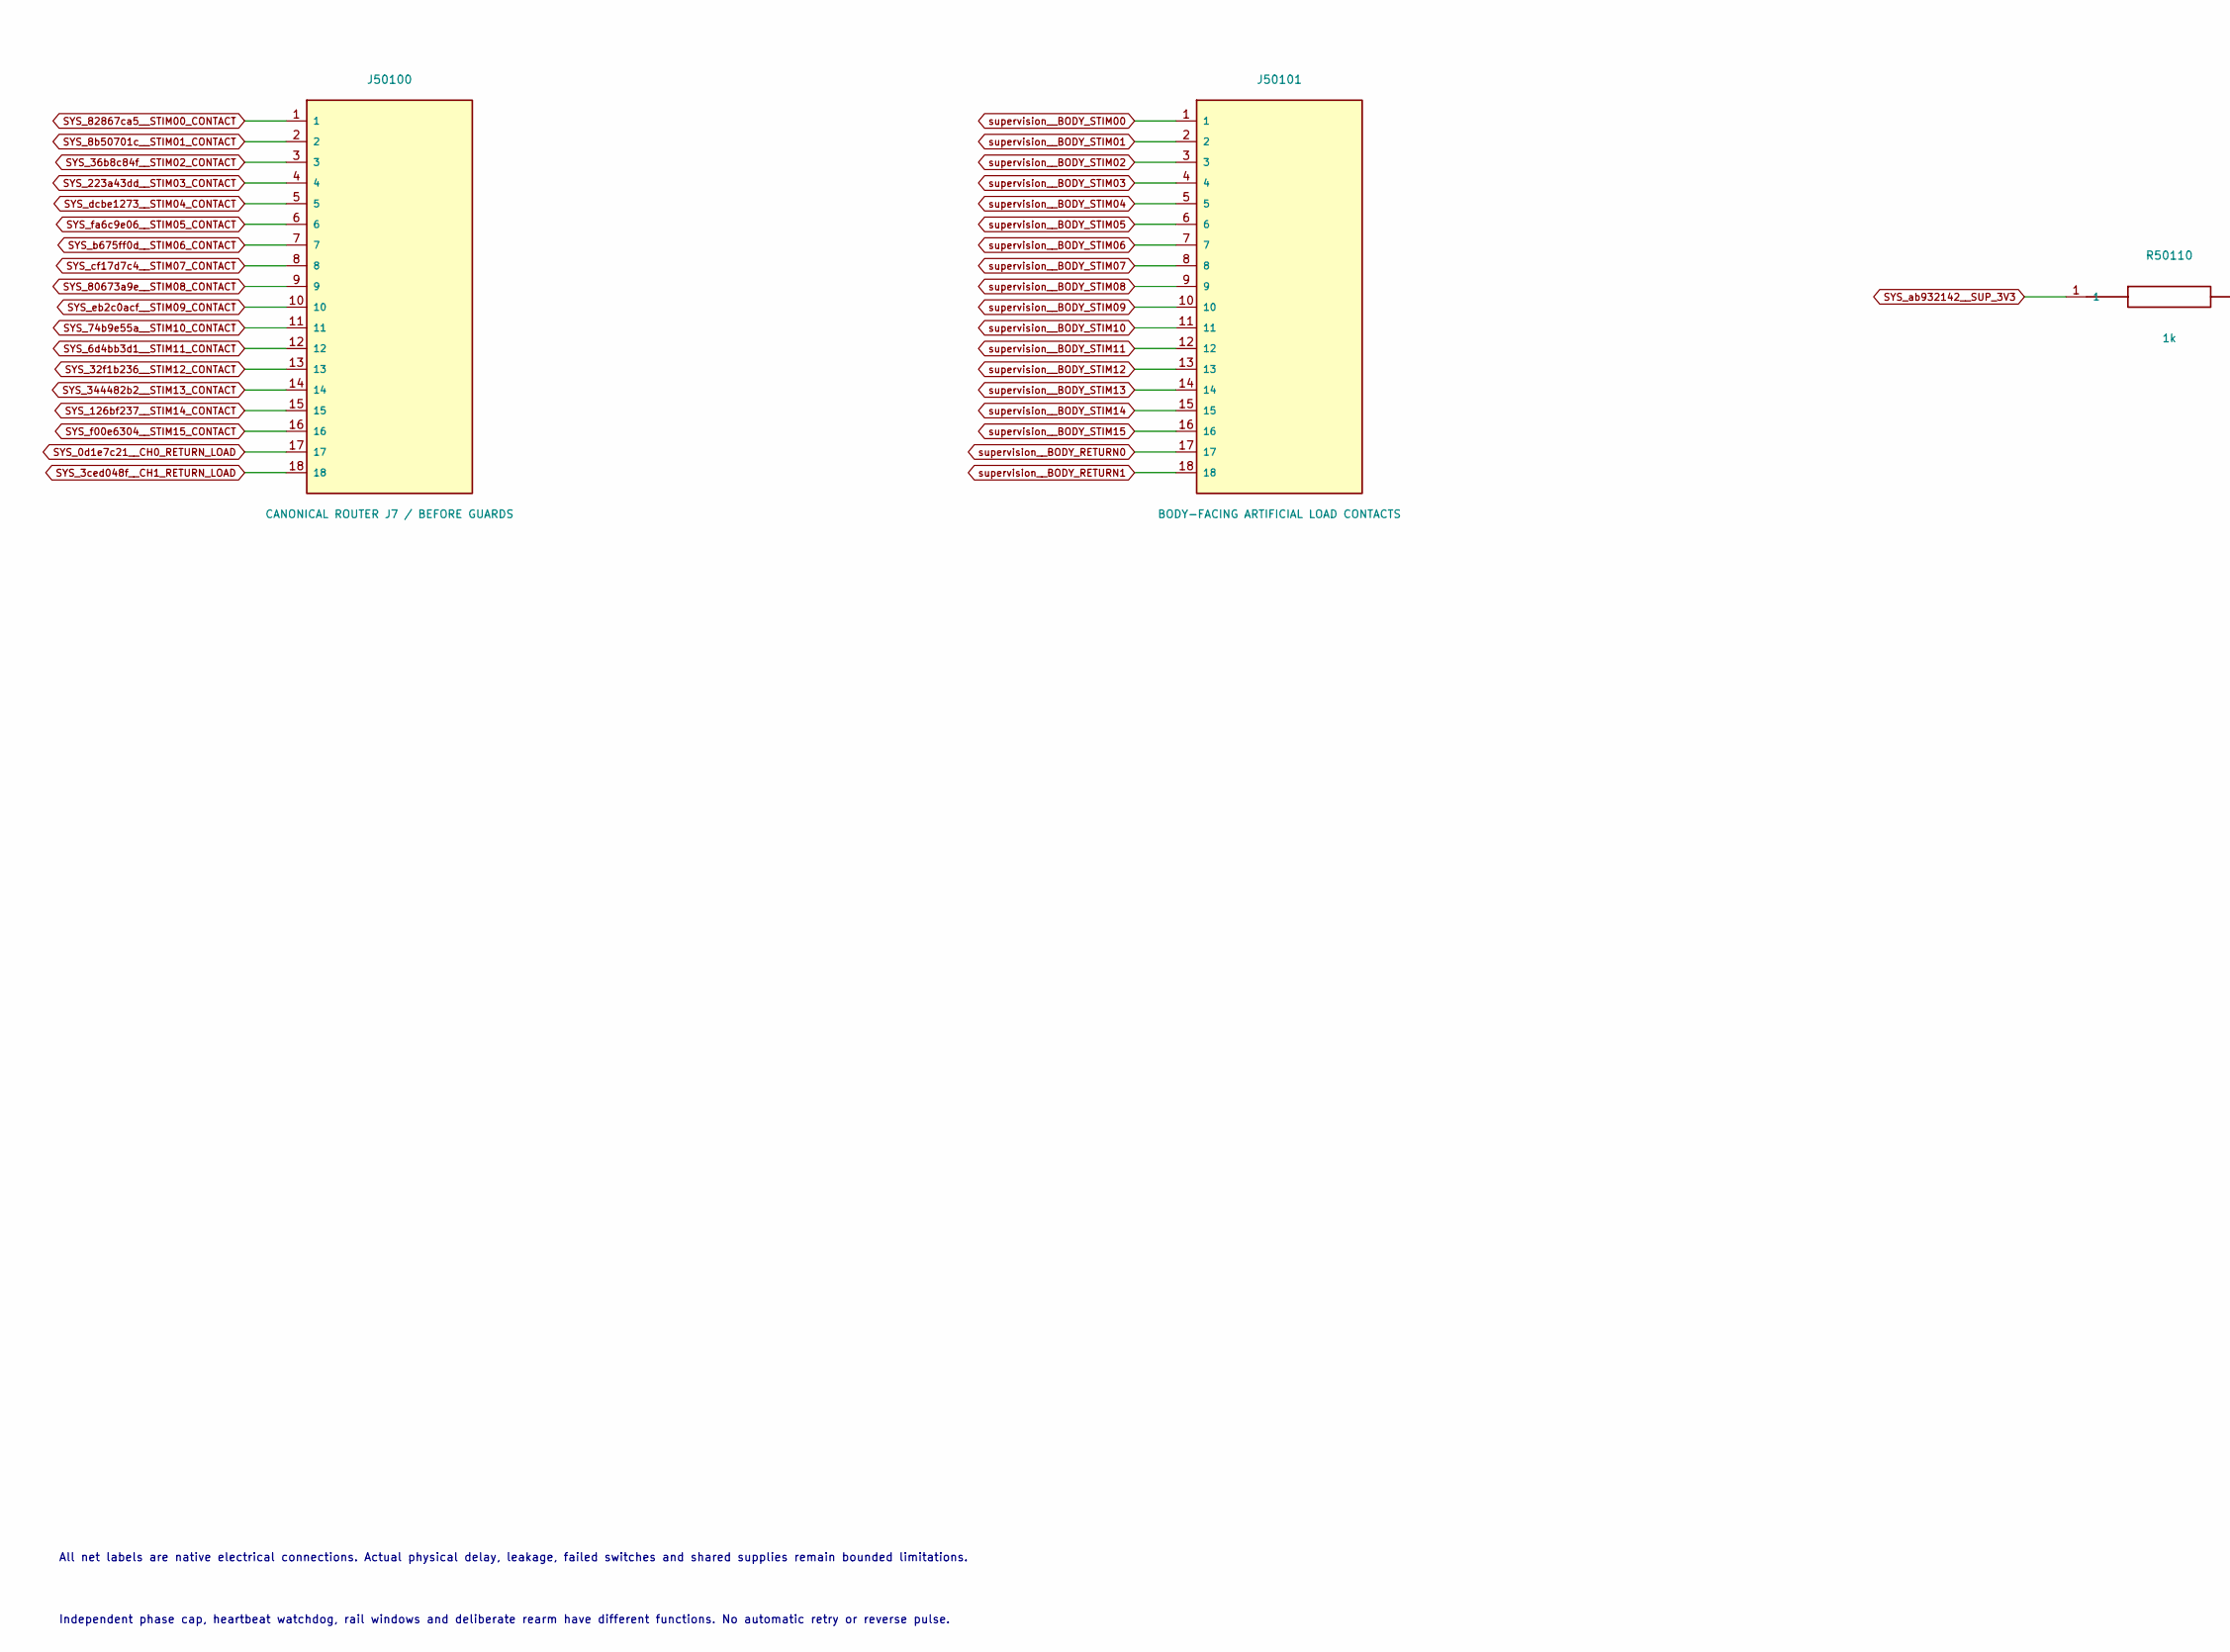
[picture p231: schematic guards.kicad_sch, Project SCCI RH S4 / 18 body-side terminal guards, part in row 2, column 1]

Parts:
C50100, C50101, C50102, C50103, C50104: 100n X7R 50V; C_0805_2012Metric
J50100: CANONICAL ROUTER J7 / BEFORE GUARDS; PinHeader_1x18_P2.54mm_Vertical
J50101: BODY-FACING ARTIFICIAL LOAD CONTACTS; PinHeader_1x18_P2.54mm_Vertical
R50100, R50101, R50102, R50103, R50104: 22k; R_0805_2012Metric
R50110: 1k; R_0805_2012Metric
U50100, U50101, U50102, U50103, U50104: TMUX7412FRRPR; Texas_RRP0016A_WQFN16_4x4_P0.65_EP2.6

Connections:
SYS_0d1e7c21__CH0_RETURN_LOAD: J50100.17, U50104.16 (D1_INTERNAL)
SYS_3ced048f__CH1_RETURN_LOAD: J50100.18, U50104.13 (D2_INTERNAL)
SYS_6d4bb3d1__STIM11_CONTACT: J50100.12, U50102.5 (D4_INTERNAL)
SYS_8b50701c__STIM01_CONTACT: J50100.2, U50100.13 (D2_INTERNAL)
SYS_32f1b236__STIM12_CONTACT: J50100.13, U50103.16 (D1_INTERNAL)
SYS_36b8c84f__STIM02_CONTACT: J50100.3, U50100.8 (D3_INTERNAL)
SYS_74b9e55a__STIM10_CONTACT: J50100.11, U50102.8 (D3_INTERNAL)
SYS_77c24b0d__GLOBAL_GUARD_EN: R50100.1, R50101.1, R50102.1, R50103.1, R50104.1, U50100.6 (SEL4), U50100.7 (SEL3), U50100.14 (SEL2), U50100.15 (SEL1), U50101.6 (SEL4), U50101.7 (SEL3), U50101.14 (SEL2), U50101.15 (SEL1), U50102.6 (SEL4), U50102.7 (SEL3), U50102.14 (SEL2), U50102.15 (SEL1), U50103.6 (SEL4), U50103.7 (SEL3), U50103.14 (SEL2), U50103.15 (SEL1), U50104.14 (SEL2), U50104.15 (SEL1); also elsewhere on the board
SYS_126bf237__STIM14_CONTACT: J50100.15, U50103.8 (D3_INTERNAL)
SYS_223a43dd__STIM03_CONTACT: J50100.4, U50100.5 (D4_INTERNAL)
SYS_15689dc4__VH_24: C50100.1, C50101.1, C50102.1, C50103.1, C50104.1, U50100.11 (VDD), U50101.11 (VDD), U50102.11 (VDD), U50103.11 (VDD), U50104.11 (VDD); also elsewhere on the board
SYS_56562df4__GND: C50100.2, C50101.2, C50102.2, C50103.2, C50104.2, R50100.2, R50101.2, R50102.2, R50103.2, R50104.2, U50100.2 (VSS), U50100.3 (GND), U50100.17 (EP_GND), U50101.2 (VSS), U50101.3 (GND), U50101.17 (EP_GND), U50102.2 (VSS), U50102.3 (GND), U50102.17 (EP_GND), U50103.2 (VSS), U50103.3 (GND), U50103.17 (EP_GND), U50104.2 (VSS), U50104.3 (GND), U50104.4 (S4_EXTERNAL), U50104.5 (D4_INTERNAL), U50104.6 (SEL4), U50104.7 (SEL3), U50104.8 (D3_INTERNAL), U50104.9 (S3_EXTERNAL), U50104.17 (EP_GND); also elsewhere on the board
SYS_80673a9e__STIM08_CONTACT: J50100.9, U50102.16 (D1_INTERNAL)
SYS_82867ca5__STIM00_CONTACT: J50100.1, U50100.16 (D1_INTERNAL)
SYS_344482b2__STIM13_CONTACT: J50100.14, U50103.13 (D2_INTERNAL)
SYS_ab932142__SUP_3V3: R50110.1; also elsewhere on the board
SYS_b675ff0d__STIM06_CONTACT: J50100.7, U50101.8 (D3_INTERNAL)
SYS_cf17d7c4__STIM07_CONTACT: J50100.8, U50101.5 (D4_INTERNAL)
SYS_dcbe1273__STIM04_CONTACT: J50100.5, U50101.16 (D1_INTERNAL)
SYS_eb2c0acf__STIM09_CONTACT: J50100.10, U50102.13 (D2_INTERNAL)
SYS_ee59c76b__PWR_FAULT_N: R50110.2, U50100.10 (FF_N), U50101.10 (FF_N), U50102.10 (FF_N), U50103.10 (FF_N), U50104.10 (FF_N); also elsewhere on the board
SYS_f00e6304__STIM15_CONTACT: J50100.16, U50103.5 (D4_INTERNAL)
SYS_fa6c9e06__STIM05_CONTACT: J50100.6, U50101.13 (D2_INTERNAL)
supervision__BODY_RETURN0: J50101.17, U50104.1 (S1_EXTERNAL)
supervision__BODY_RETURN1: J50101.18, U50104.12 (S2_EXTERNAL)
supervision__BODY_STIM00: J50101.1, U50100.1 (S1_EXTERNAL)
supervision__BODY_STIM01: J50101.2, U50100.12 (S2_EXTERNAL)
supervision__BODY_STIM02: J50101.3, U50100.9 (S3_EXTERNAL)
supervision__BODY_STIM03: J50101.4, U50100.4 (S4_EXTERNAL)
supervision__BODY_STIM04: J50101.5, U50101.1 (S1_EXTERNAL)
supervision__BODY_STIM05: J50101.6, U50101.12 (S2_EXTERNAL)
supervision__BODY_STIM06: J50101.7, U50101.9 (S3_EXTERNAL)
supervision__BODY_STIM07: J50101.8, U50101.4 (S4_EXTERNAL)
supervision__BODY_STIM08: J50101.9, U50102.1 (S1_EXTERNAL)
supervision__BODY_STIM09: J50101.10, U50102.12 (S2_EXTERNAL)
supervision__BODY_STIM10: J50101.11, U50102.9 (S3_EXTERNAL)
supervision__BODY_STIM11: J50101.12, U50102.4 (S4_EXTERNAL)
supervision__BODY_STIM12: J50101.13, U50103.1 (S1_EXTERNAL)
supervision__BODY_STIM13: J50101.14, U50103.12 (S2_EXTERNAL)
supervision__BODY_STIM14: J50101.15, U50103.9 (S3_EXTERNAL)
supervision__BODY_STIM15: J50101.16, U50103.4 (S4_EXTERNAL)

Notes on the sheet:
DIGITAL SCCI ENGINEERING / ARTIFICIAL LOADS / NATIVE INDEPENDENT SUPERVISION
18 guarded stimulation conductors, 17 measured RHD-side windows; conditional healthy-switch blanking is not proven isolation.
All net labels are native electrical connections. Actual physical delay, leakage, failed switches and shared supplies remain bounded limitations.
Independent phase cap, heartbeat watchdog, rail windows and deliberate rearm have different functions. No automatic retry or reverse pulse.
