pratham-cloud-ctrl/Project-SCCI-RH/electronics/stage4/integrated-pcb/boards/supervision/supervision.kicad_pcb

## KiCad design electronics/stage4/integrated-pcb/boards/supervision/supervision.kicad_pcb (continued)

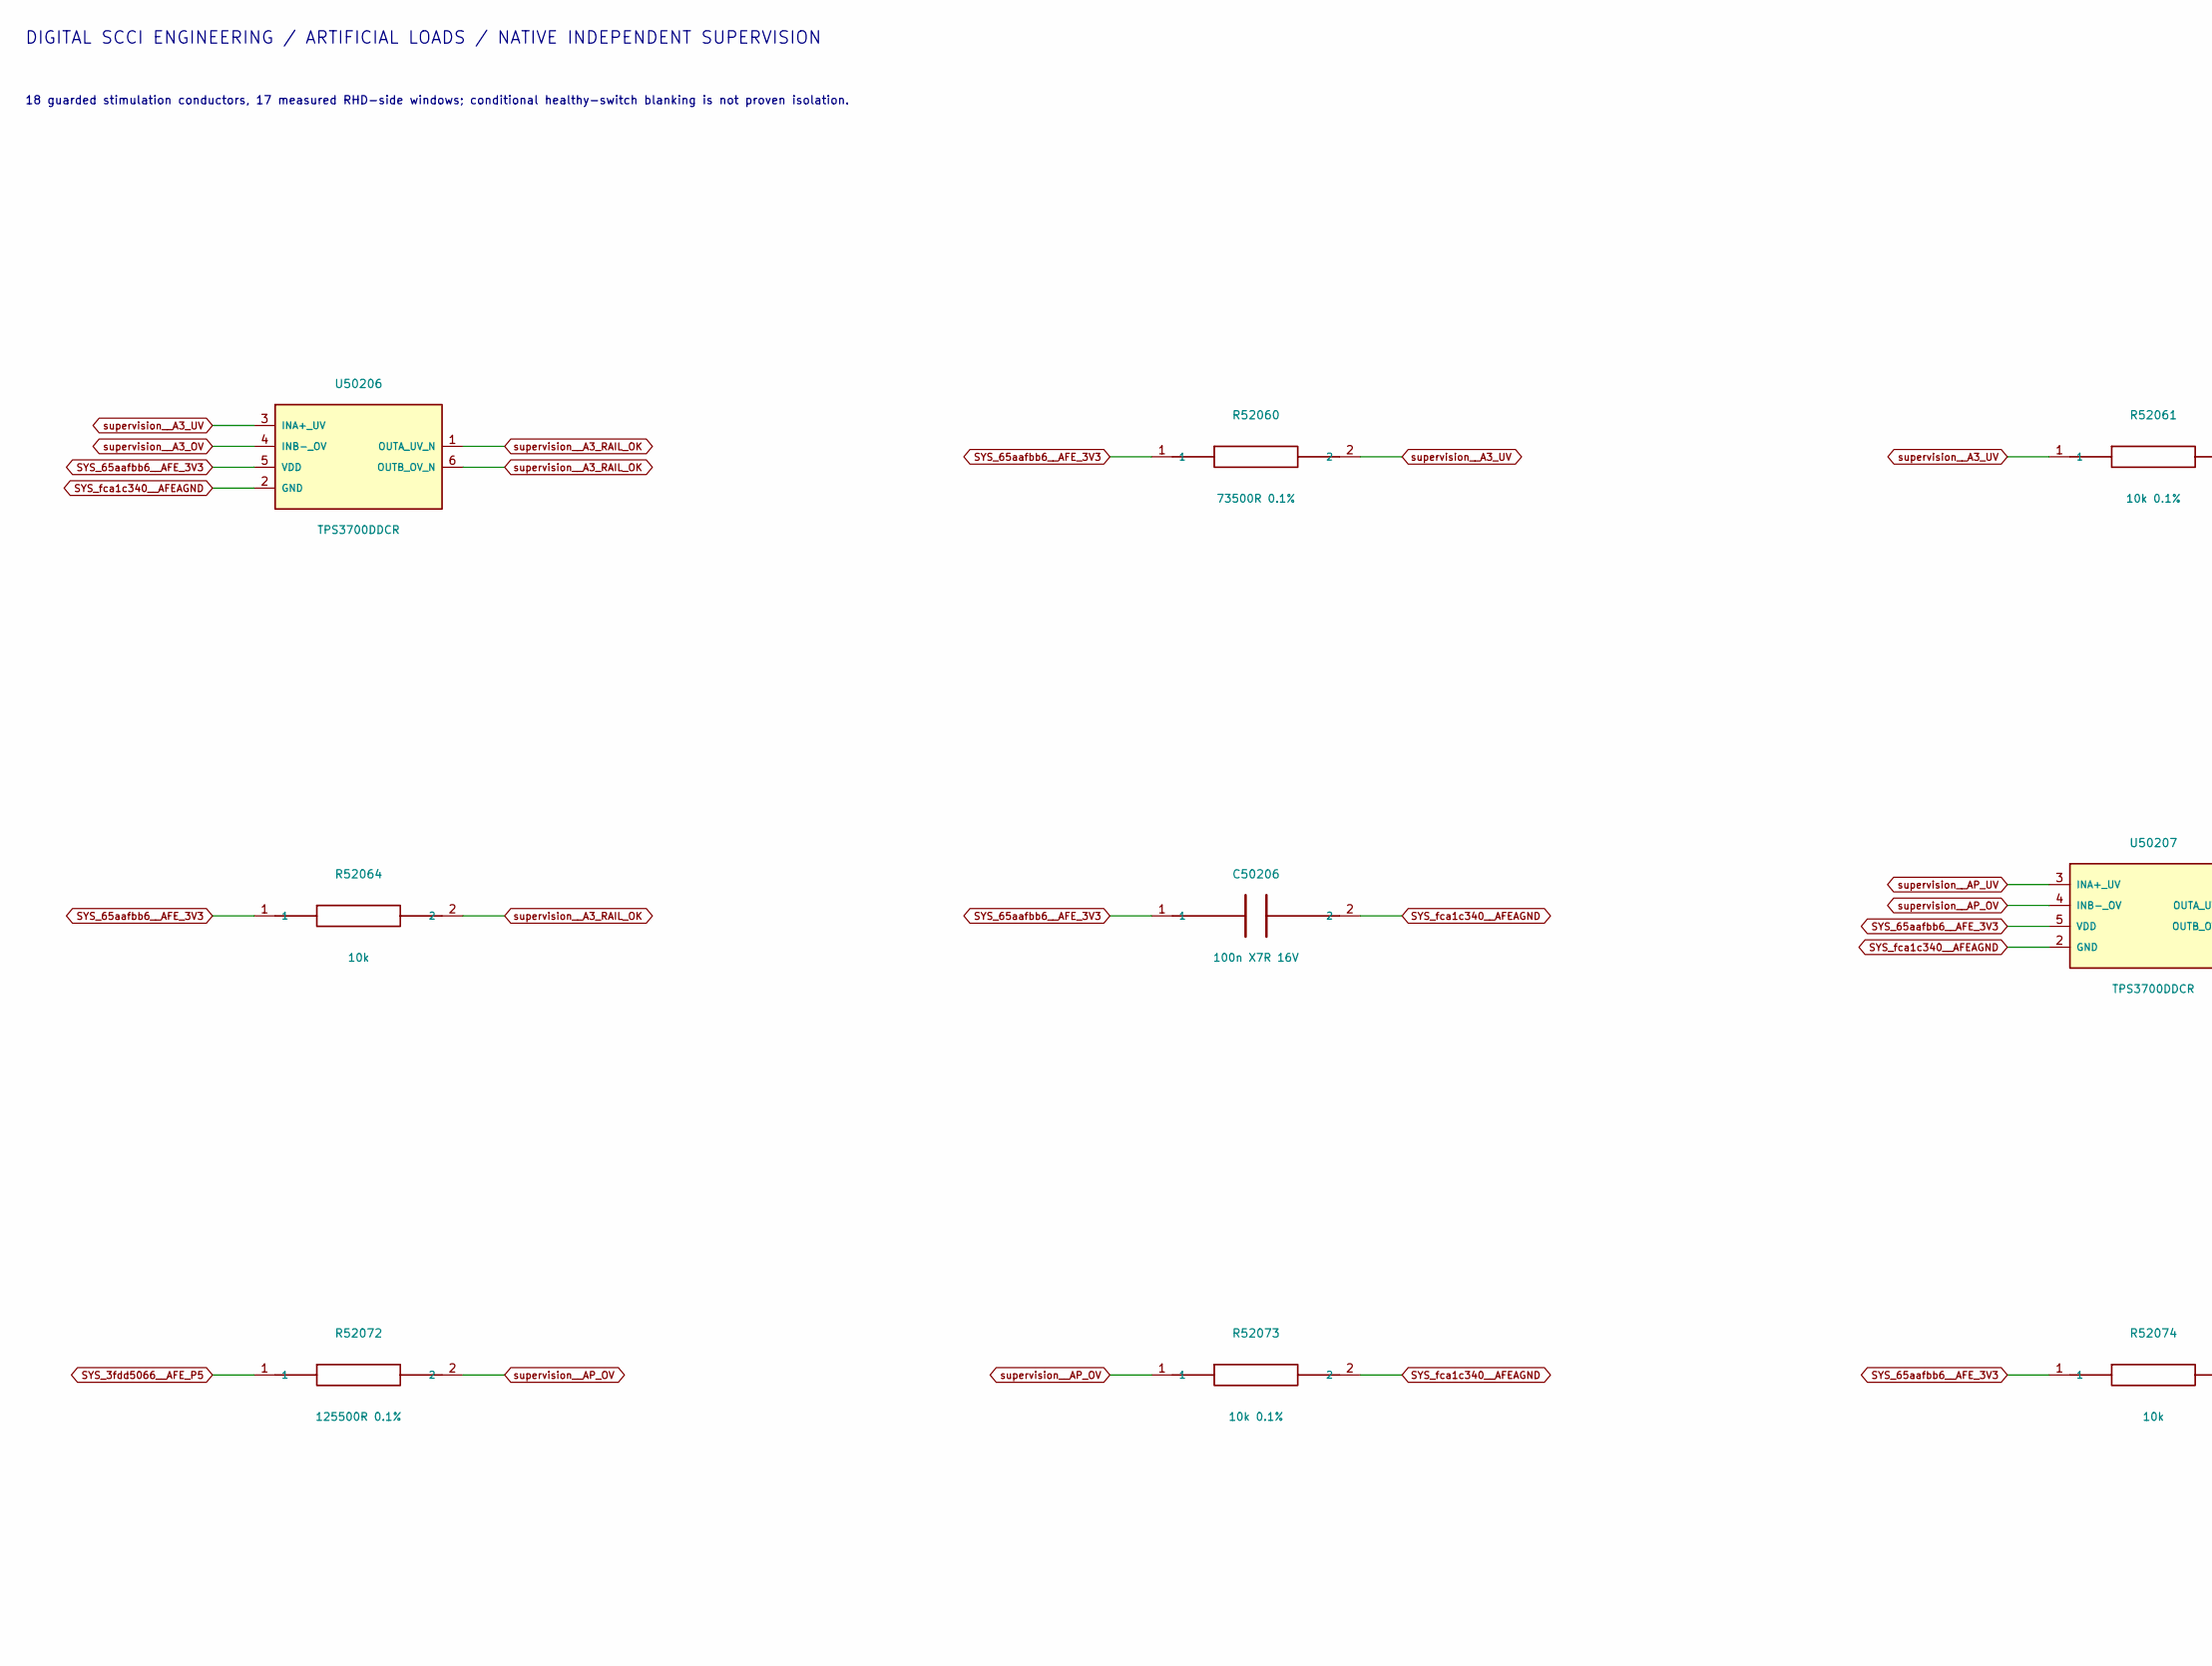
[picture p240: schematic afe_rails.kicad_sch, Project SCCI RH S4 / AFE supply windows, part in row 1, column 1]

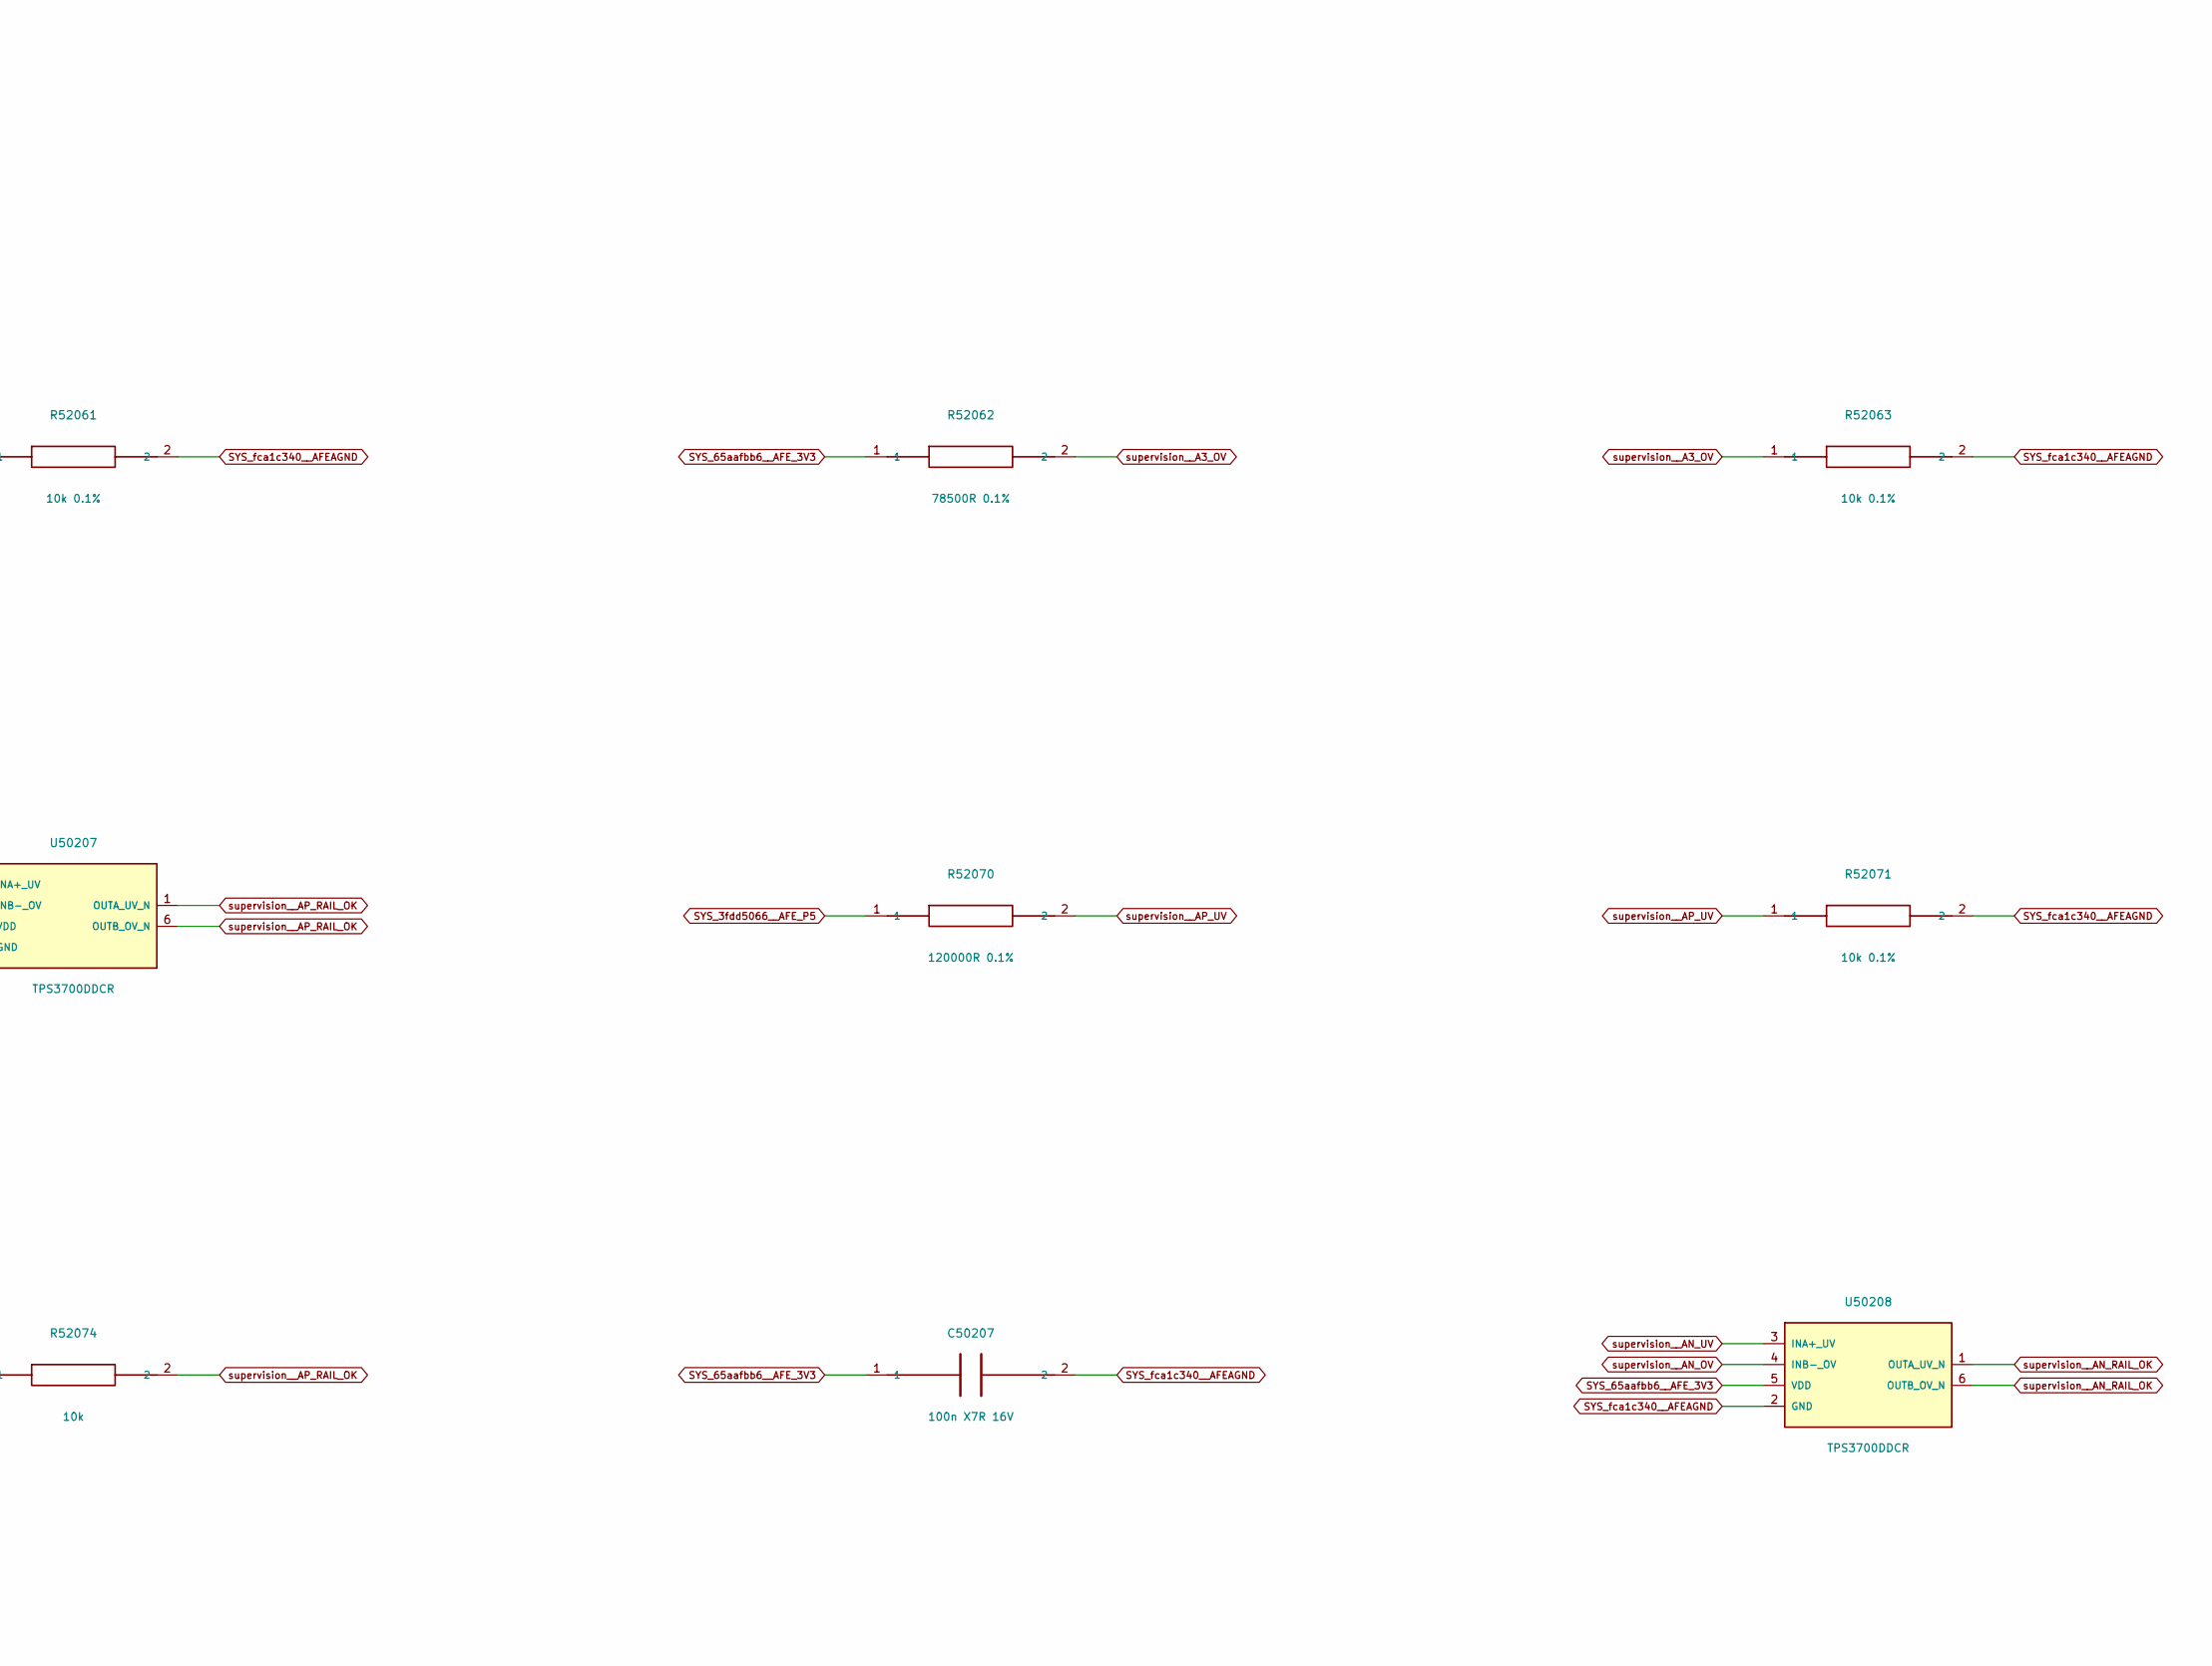
[picture p241: schematic afe_rails.kicad_sch, Project SCCI RH S4 / AFE supply windows, part in row 1, column 2]

Parts:
C50206, C50207: 100n X7R 16V; C_0805_2012Metric
R52060: 73500R 0.1%; R_0805_2012Metric
R52061, R52063, R52071, R52073: 10k 0.1%; R_0805_2012Metric
R52062: 78500R 0.1%; R_0805_2012Metric
R52064, R52074: 10k; R_0805_2012Metric
R52070: 120000R 0.1%; R_0805_2012Metric
R52072: 125500R 0.1%; R_0805_2012Metric
R52080: 1875R 0.1%; R_0805_2012Metric
U50206, U50207, U50208: TPS3700DDCR; SOT-23-6

Connections:
SYS_3fdd5066__AFE_P5: R52070.1, R52072.1; also elsewhere on the board
SYS_65aafbb6__AFE_3V3: C50206.1, C50207.1, R52060.1, R52062.1, R52064.1, R52074.1, U50206.5 (VDD), U50207.5 (VDD), U50208.5 (VDD); also elsewhere on the board
SYS_fca1c340__AFEAGND: C50206.2, C50207.2, R52061.2, R52063.2, R52071.2, R52073.2, U50206.2 (GND), U50207.2 (GND), U50208.2 (GND); also elsewhere on the board
supervision__A3_OV: R52062.2, R52063.1, U50206.4 (INB-_OV)
supervision__A3_RAIL_OK: R52064.2, U50206.1 (OUTA_UV_N), U50206.6 (OUTB_OV_N); also elsewhere on the board
supervision__A3_UV: R52060.2, R52061.1, U50206.3 (INA+_UV)
supervision__AFE_NMAG: R52080.1; also elsewhere on the board
supervision__AN_OV: U50208.4 (INB-_OV); also elsewhere on the board
supervision__AN_RAIL_OK: U50208.1 (OUTA_UV_N), U50208.6 (OUTB_OV_N); also elsewhere on the board
supervision__AN_UV: R52080.2, U50208.3 (INA+_UV); also elsewhere on the board
supervision__AP_OV: R52072.2, R52073.1, U50207.4 (INB-_OV)
supervision__AP_RAIL_OK: R52074.2, U50207.1 (OUTA_UV_N), U50207.6 (OUTB_OV_N); also elsewhere on the board
supervision__AP_UV: R52070.2, R52071.1, U50207.3 (INA+_UV)

Notes on the sheet:
DIGITAL SCCI ENGINEERING / ARTIFICIAL LOADS / NATIVE INDEPENDENT SUPERVISION
18 guarded stimulation conductors, 17 measured RHD-side windows; conditional healthy-switch blanking is not proven isolation.
All net labels are native electrical connections. Actual physical delay, leakage, failed switches and shared supplies remain bounded limitations.
Independent phase cap, heartbeat watchdog, rail windows and deliberate rearm have different functions. No automatic retry or reverse pulse.

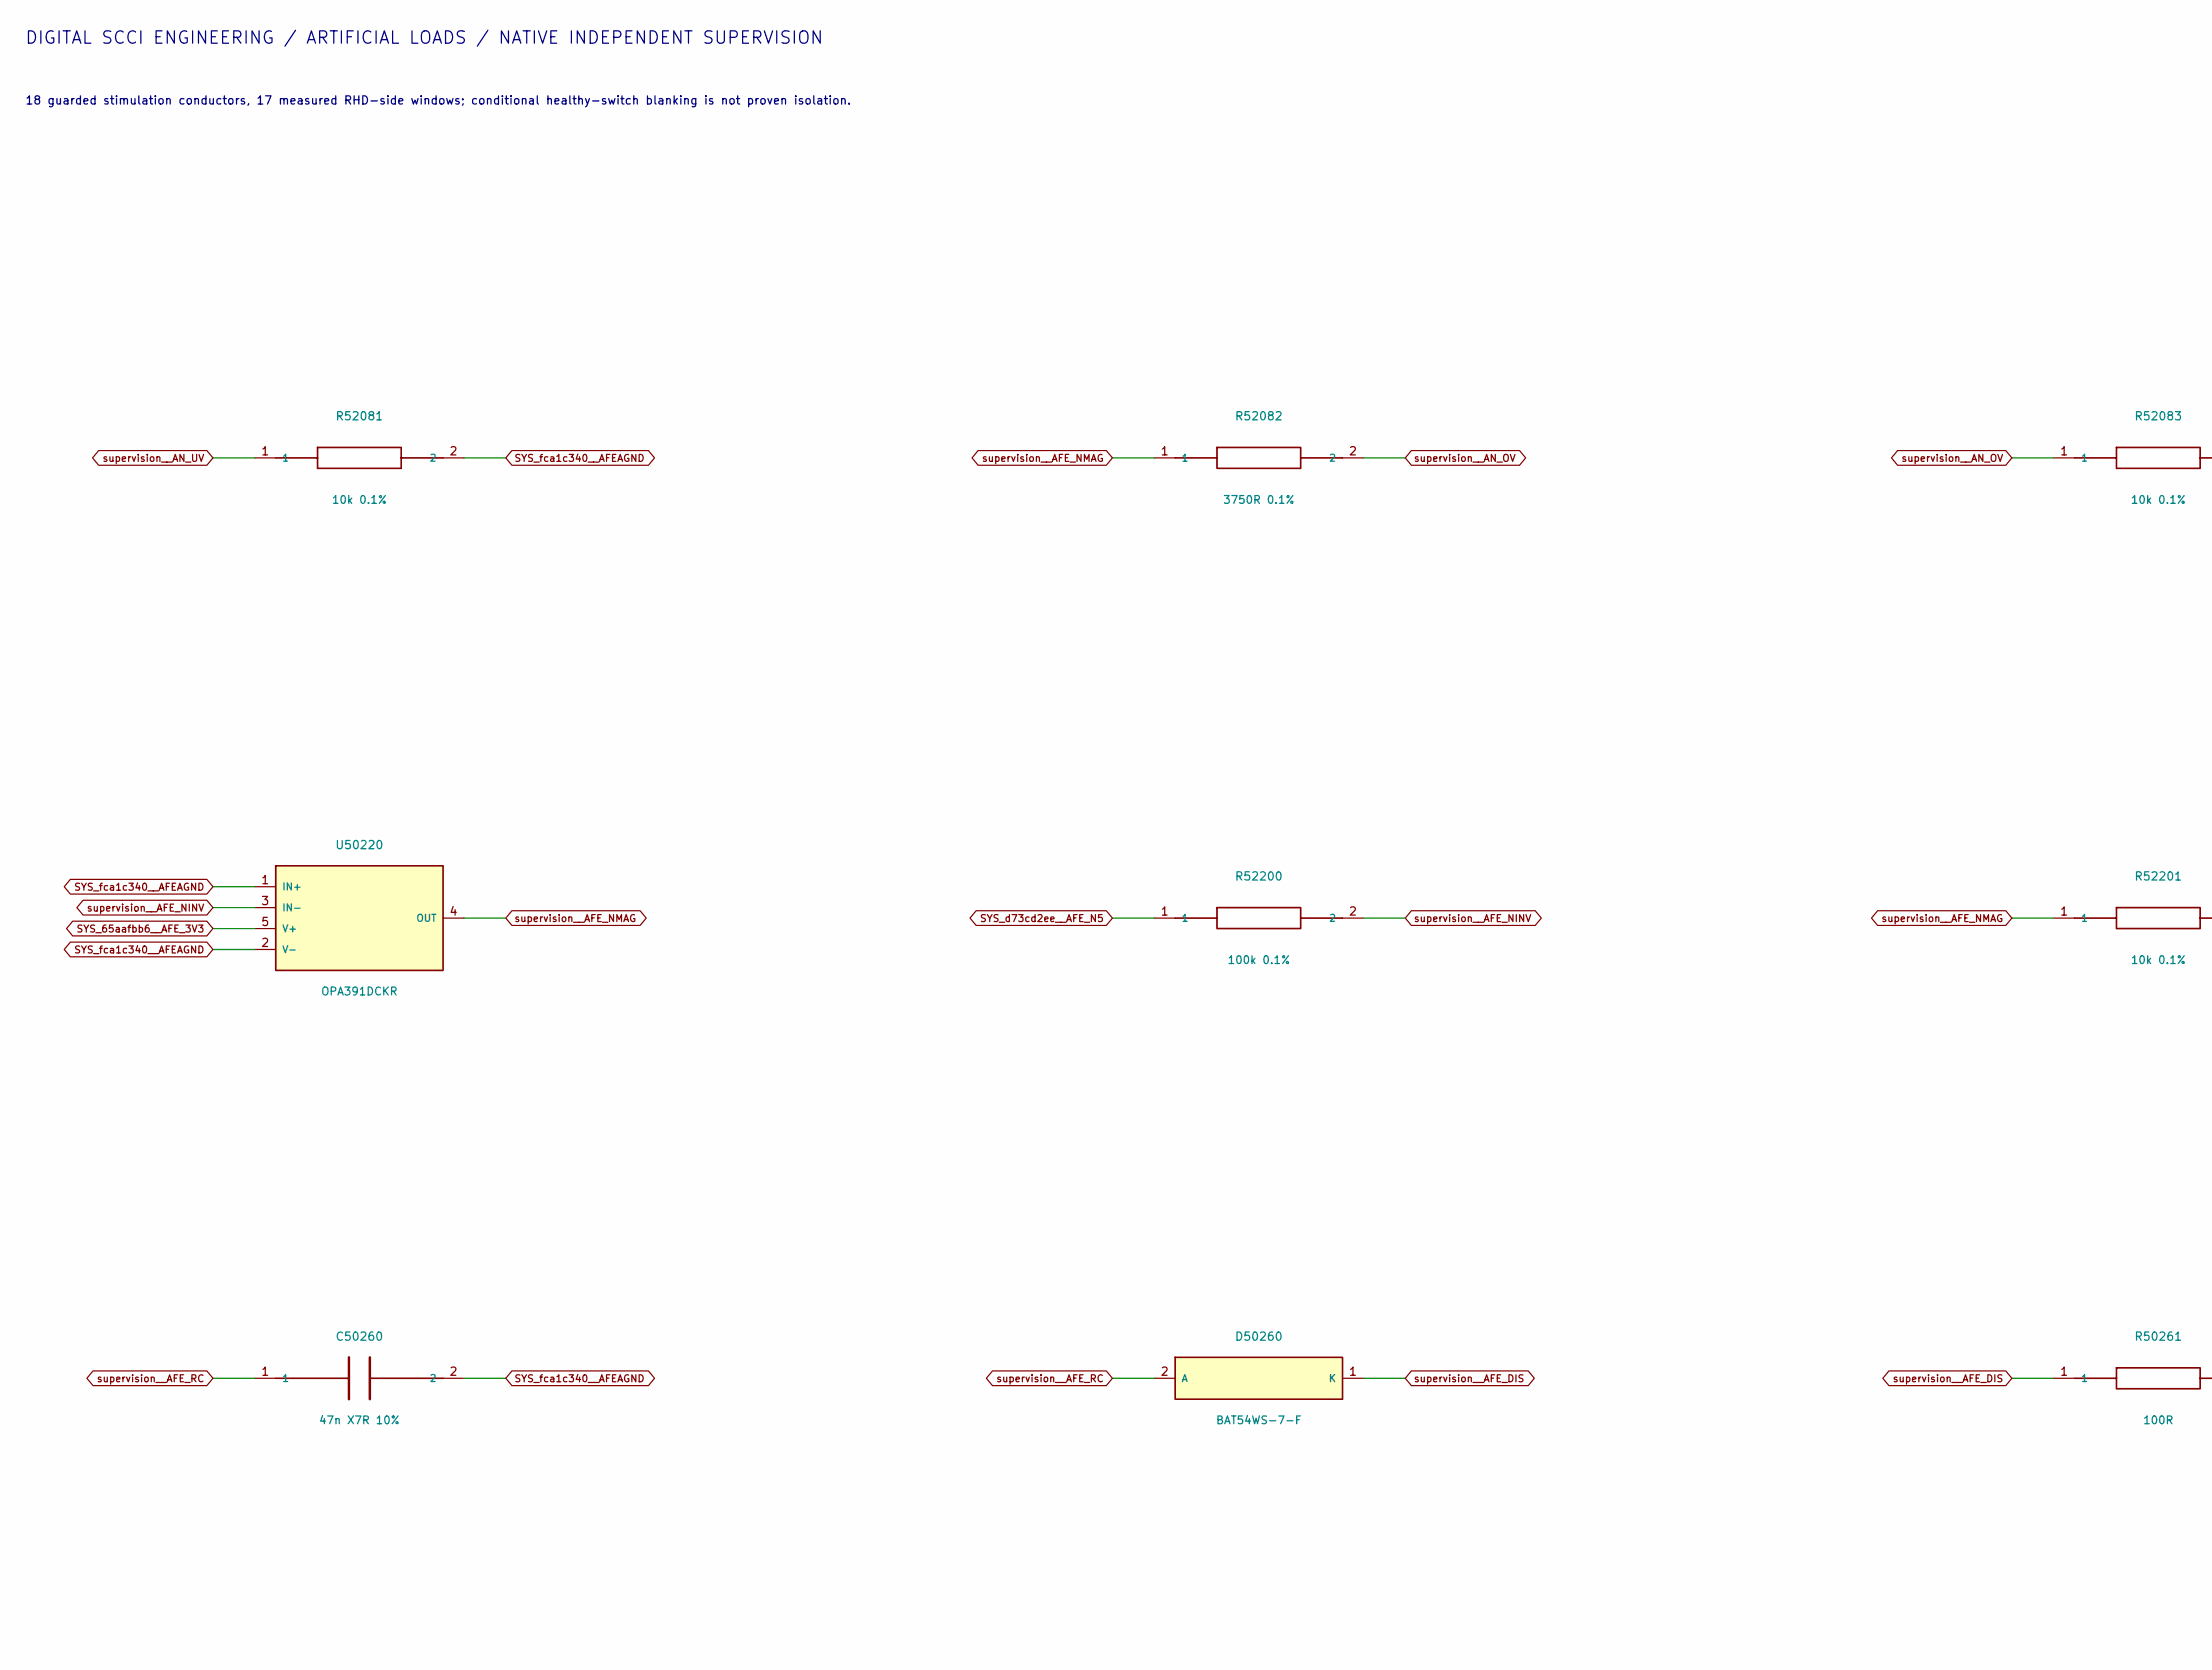
[picture p242: schematic afe_rails_2.kicad_sch, Project SCCI RH S4 / AFE supply windows / 2, part in row 1, column 1]

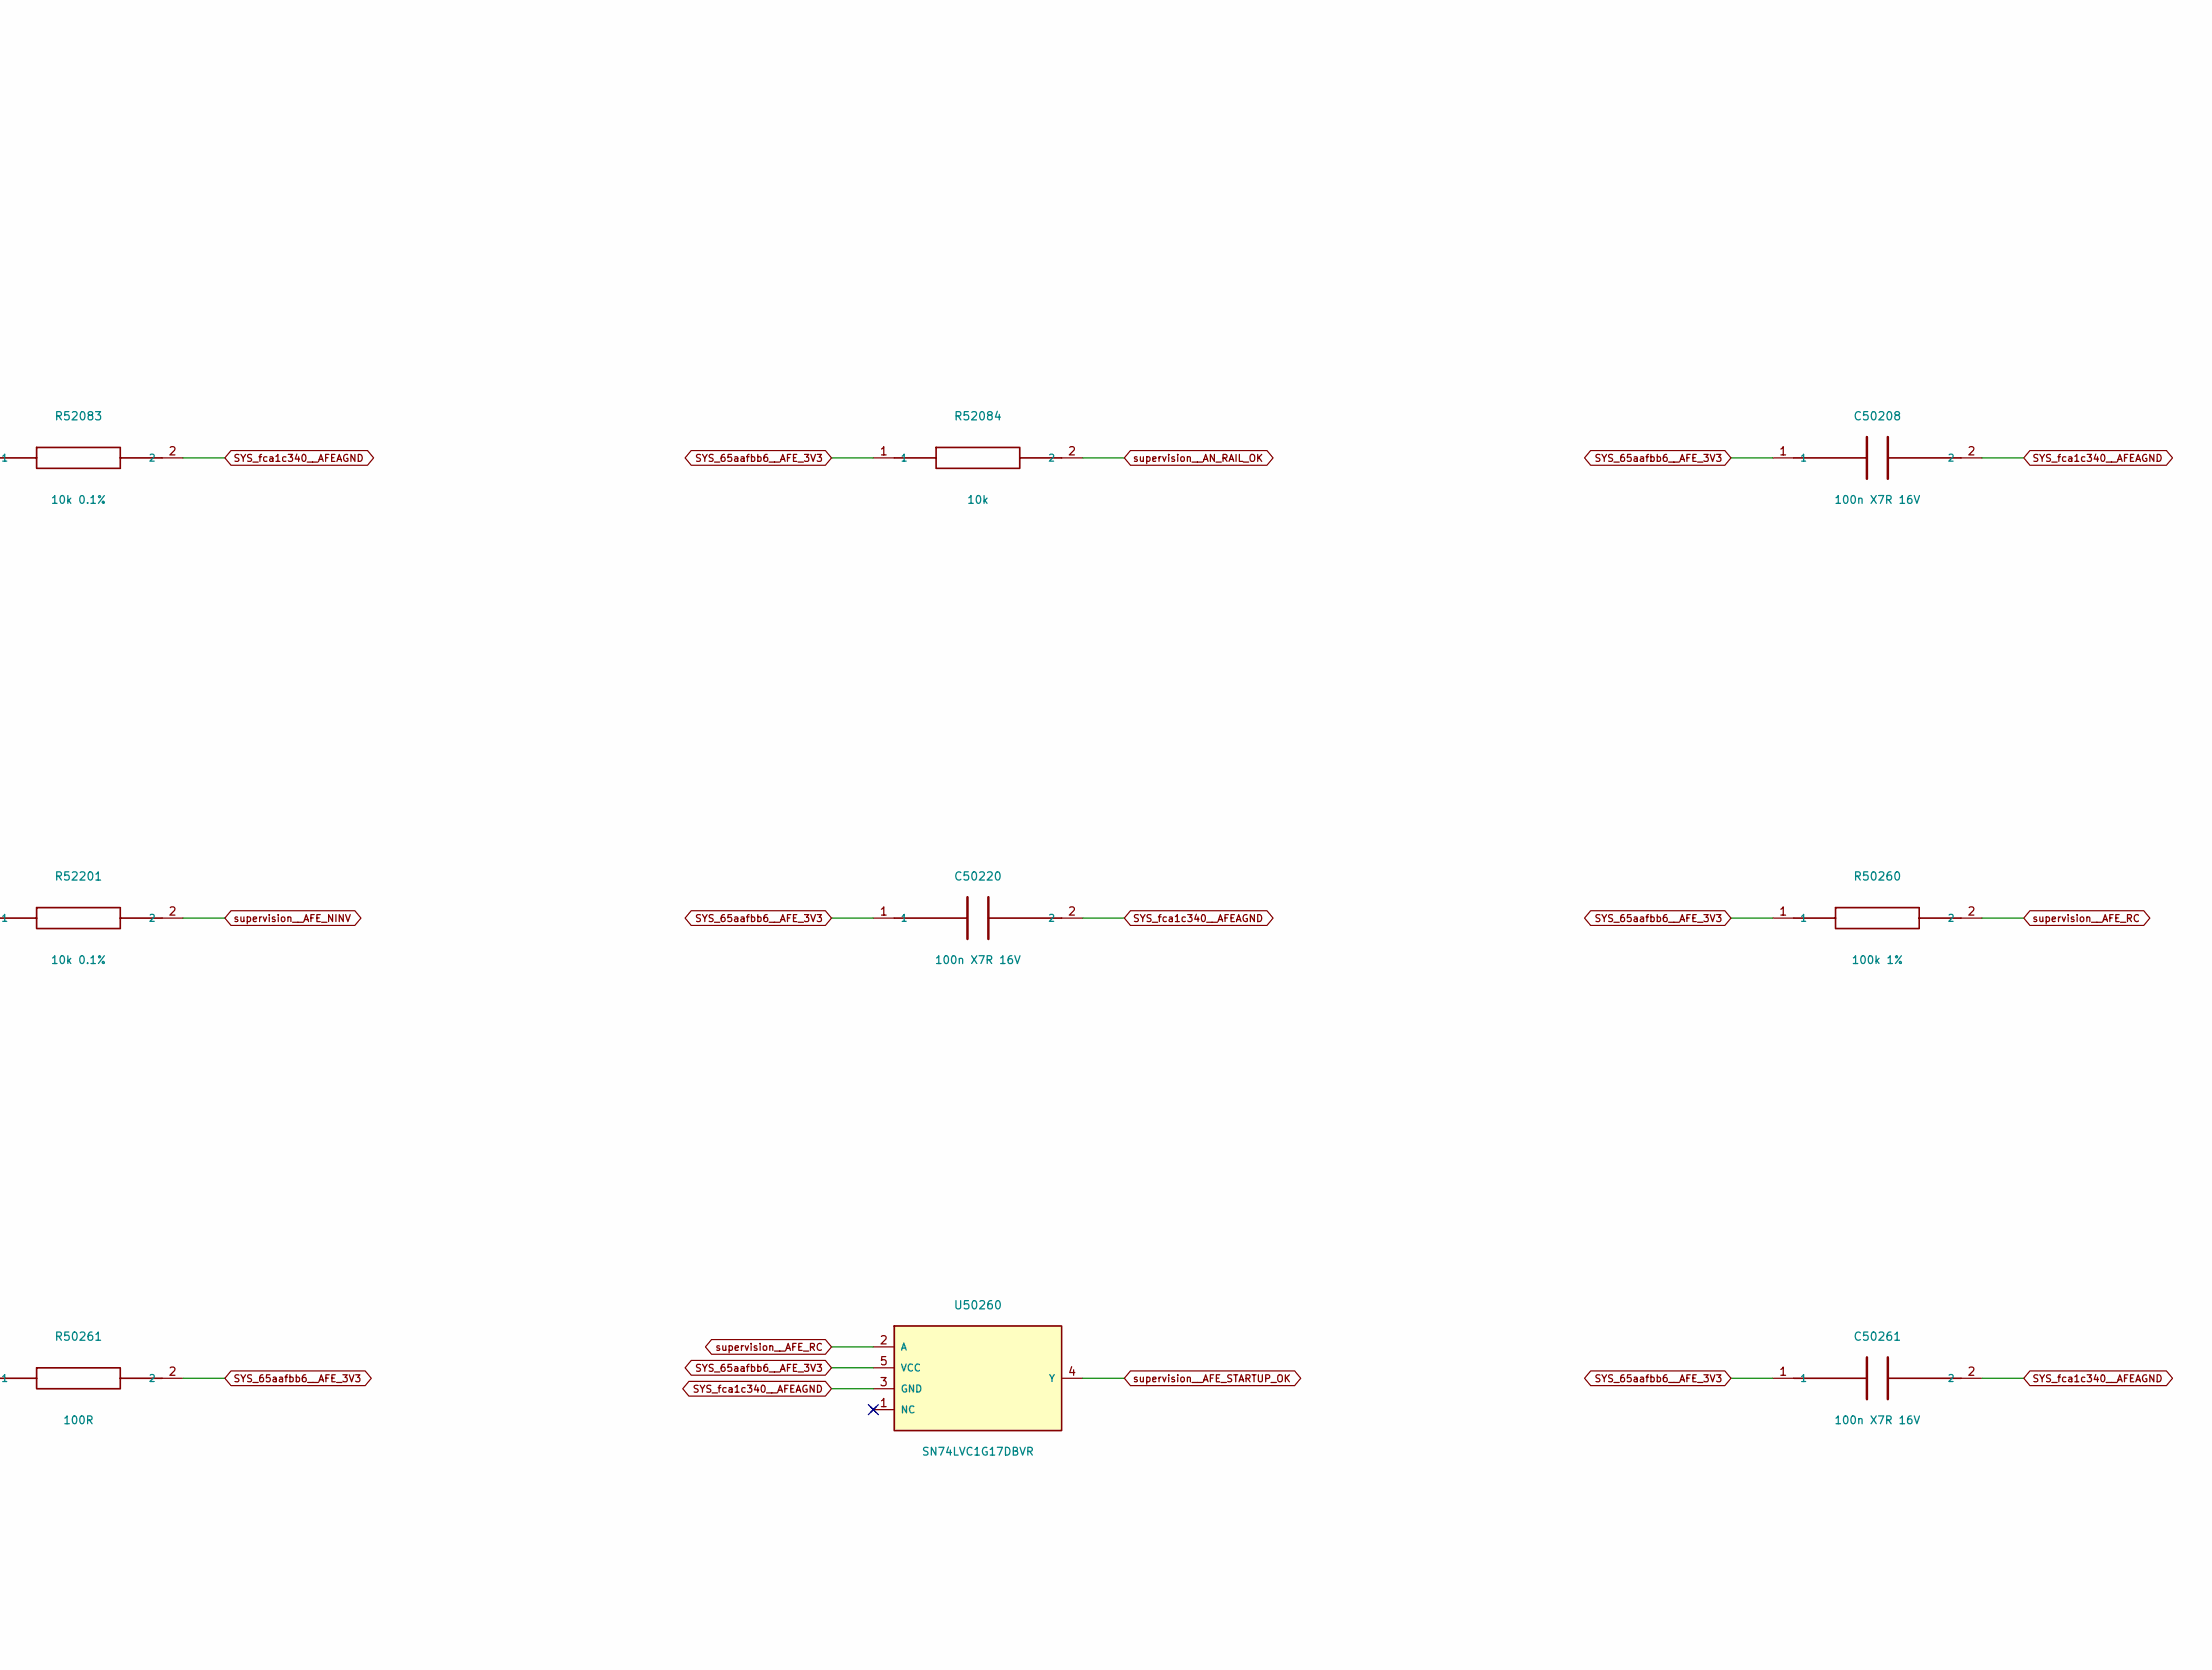
[picture p243: schematic afe_rails_2.kicad_sch, Project SCCI RH S4 / AFE supply windows / 2, part in row 1, column 2]

Parts:
C50208, C50220, C50261: 100n X7R 16V; C_0805_2012Metric
C50260: 47n X7R 10%; C_0805_2012Metric
D50260: BAT54WS-7-F; D_SOD-323
R50260: 100k 1%; R_0805_2012Metric
R50261: 100R; R_0805_2012Metric
R52081, R52083, R52201: 10k 0.1%; R_0805_2012Metric
R52082: 3750R 0.1%; R_0805_2012Metric
R52084: 10k; R_0805_2012Metric
R52200: 100k 0.1%; R_0805_2012Metric
U50220: OPA391DCKR; SOT-353_SC-70-5
U50260: SN74LVC1G17DBVR; SOT-23-5

Connections:
SYS_65aafbb6__AFE_3V3: C50208.1, C50220.1, C50261.1, R50260.1, R50261.2, R52084.1, U50220.5 (V+), U50260.5 (VCC); also elsewhere on the board
SYS_d73cd2ee__AFE_N5: R52200.1; also elsewhere on the board
SYS_fca1c340__AFEAGND: C50208.2, C50220.2, C50260.2, C50261.2, R52081.2, R52083.2, U50220.1 (IN+), U50220.2 (V-), U50260.3 (GND); also elsewhere on the board
supervision__AFE_DIS: D50260.1 (K), R50261.1
supervision__AFE_NINV: R52200.2, R52201.2, U50220.3 (IN-)
supervision__AFE_NMAG: R52082.1, R52201.1, U50220.4 (OUT); also elsewhere on the board
supervision__AFE_RC: C50260.1, D50260.2 (A), R50260.2, U50260.2 (A)
supervision__AFE_STARTUP_OK: U50260.4 (Y); also elsewhere on the board
supervision__AN_OV: R52082.2, R52083.1; also elsewhere on the board
supervision__AN_RAIL_OK: R52084.2; also elsewhere on the board
supervision__AN_UV: R52081.1; also elsewhere on the board

Notes on the sheet:
DIGITAL SCCI ENGINEERING / ARTIFICIAL LOADS / NATIVE INDEPENDENT SUPERVISION
18 guarded stimulation conductors, 17 measured RHD-side windows; conditional healthy-switch blanking is not proven isolation.
All net labels are native electrical connections. Actual physical delay, leakage, failed switches and shared supplies remain bounded limitations.
Independent phase cap, heartbeat watchdog, rail windows and deliberate rearm have different functions. No automatic retry or reverse pulse.
