pratham-cloud-ctrl/Project-SCCI-RH/electronics/stage4/integrated-pcb/boards/supervision/supervision.kicad_pcb

## KiCad design electronics/stage4/integrated-pcb/boards/supervision/supervision.kicad_pcb (continued)

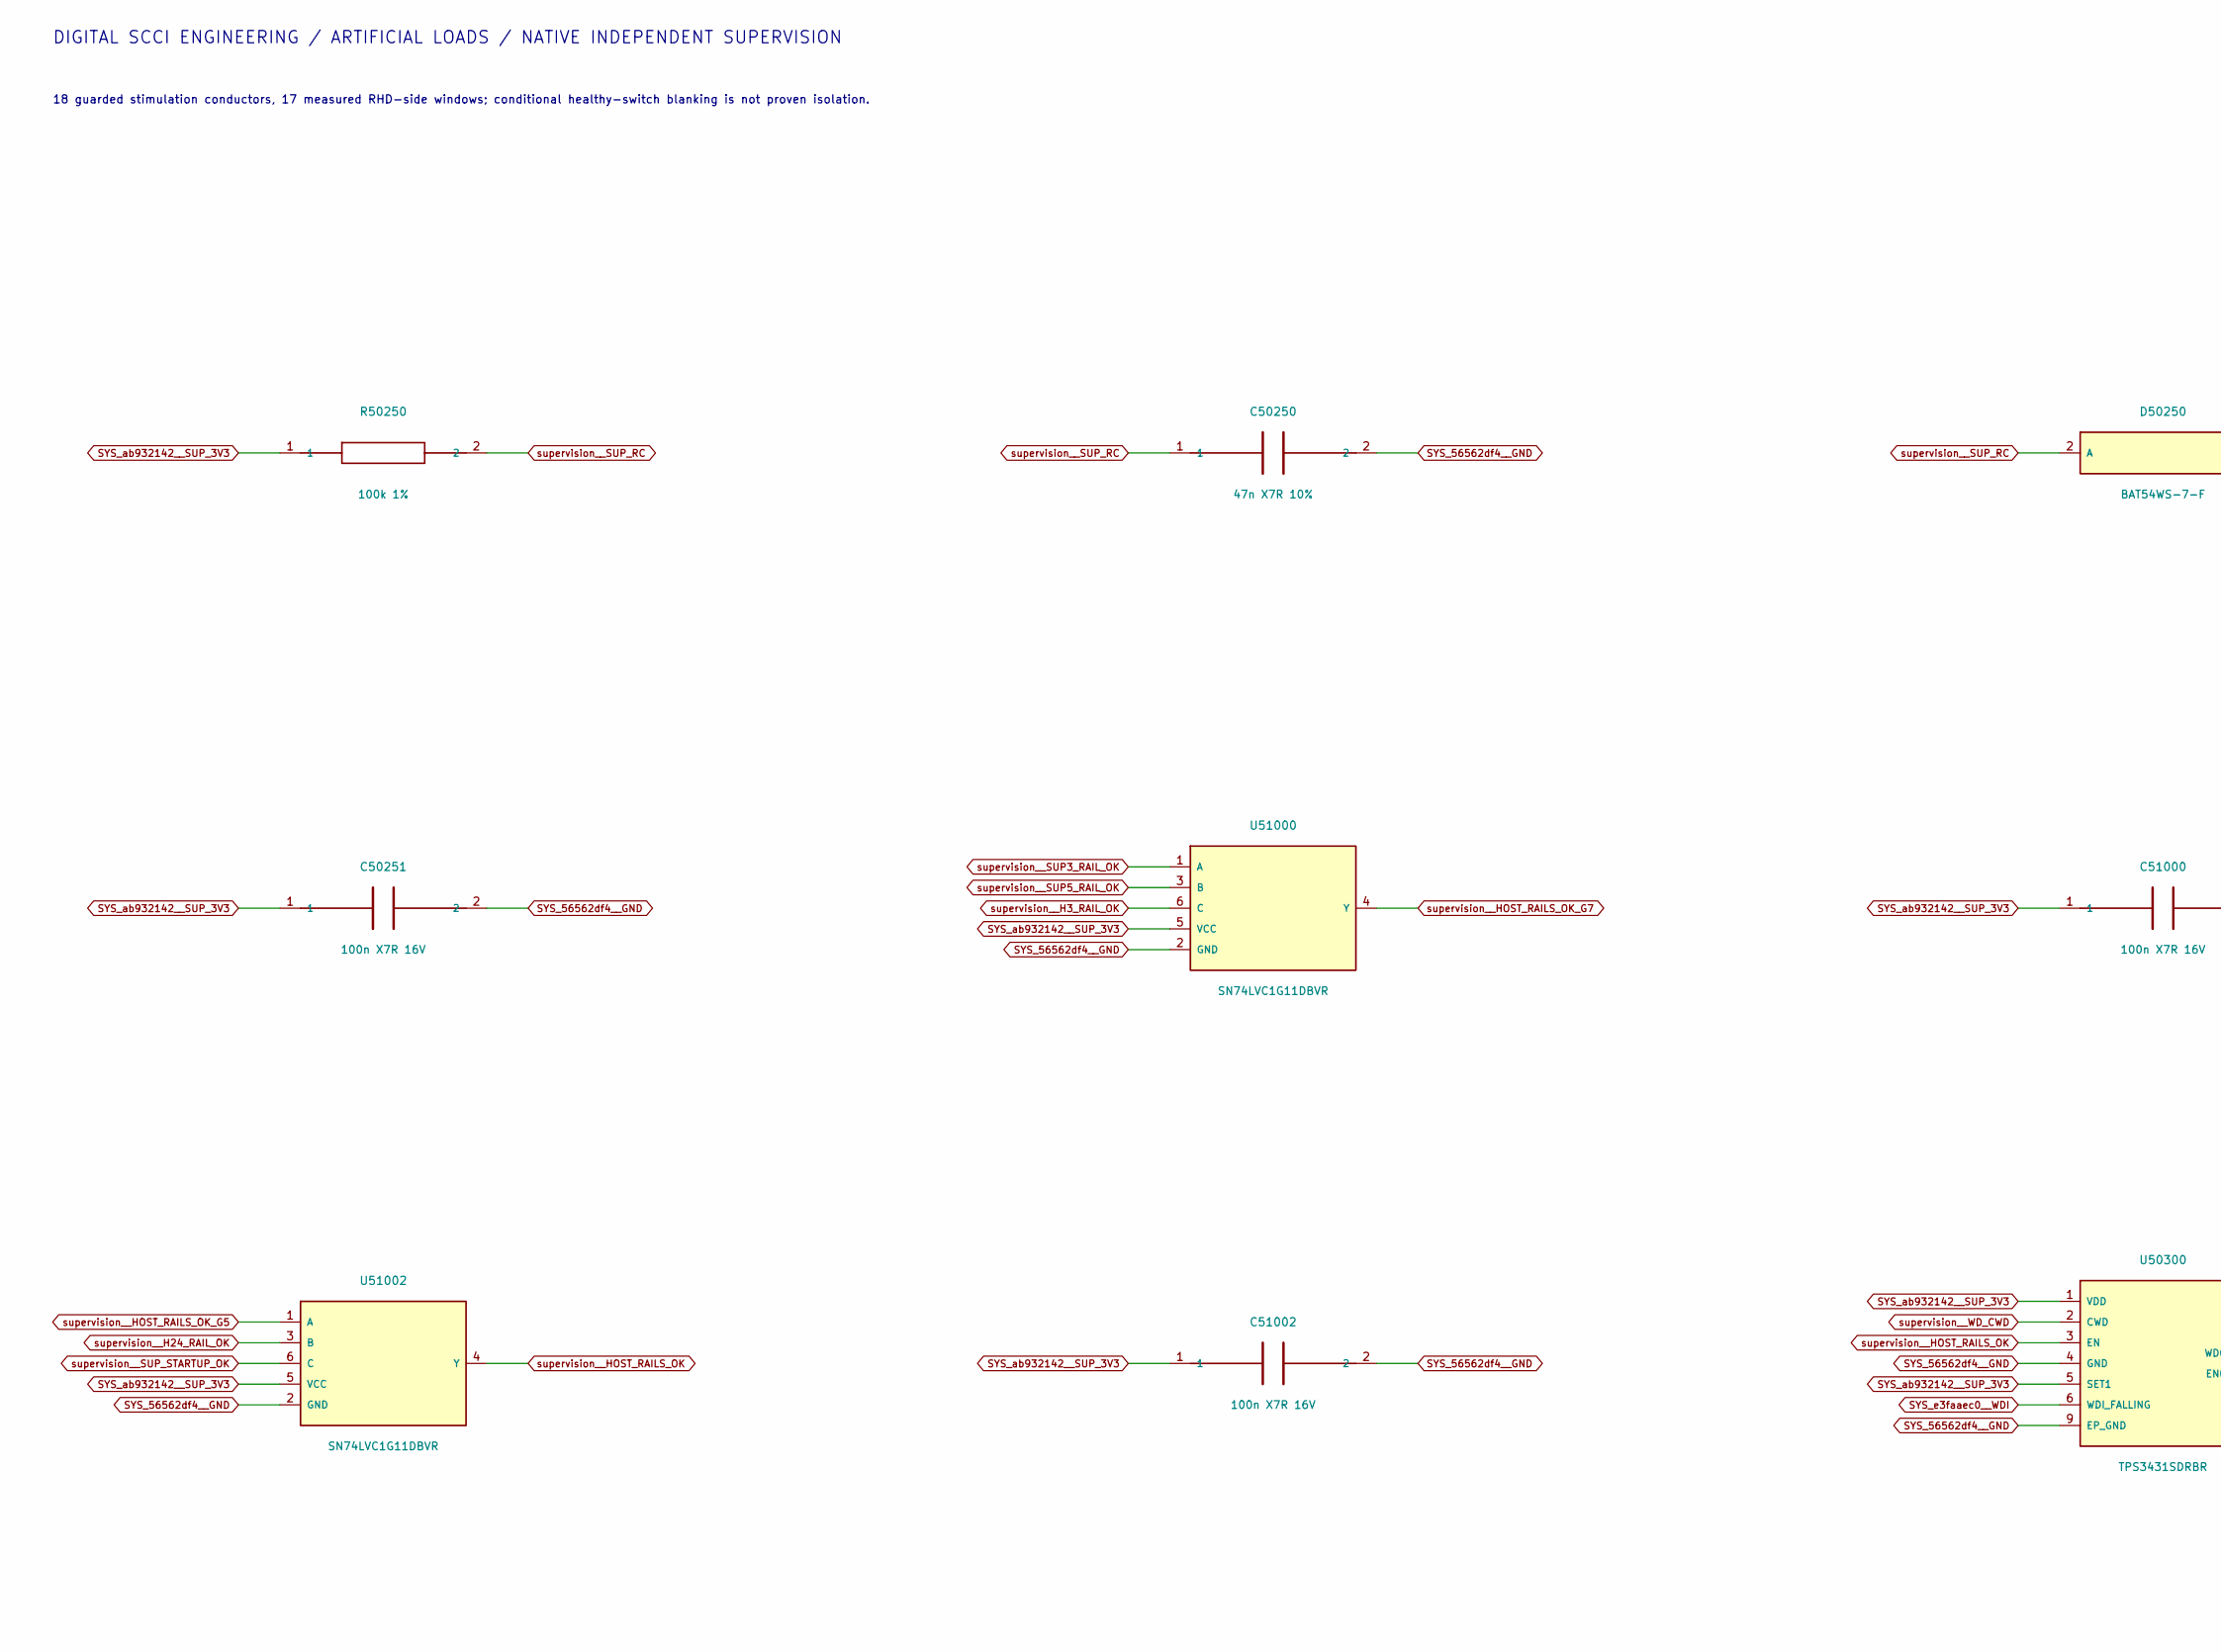
[picture p244: schematic watchdog.kicad_sch, Project SCCI RH S4 / Heartbeat and startup, part in row 1, column 1]

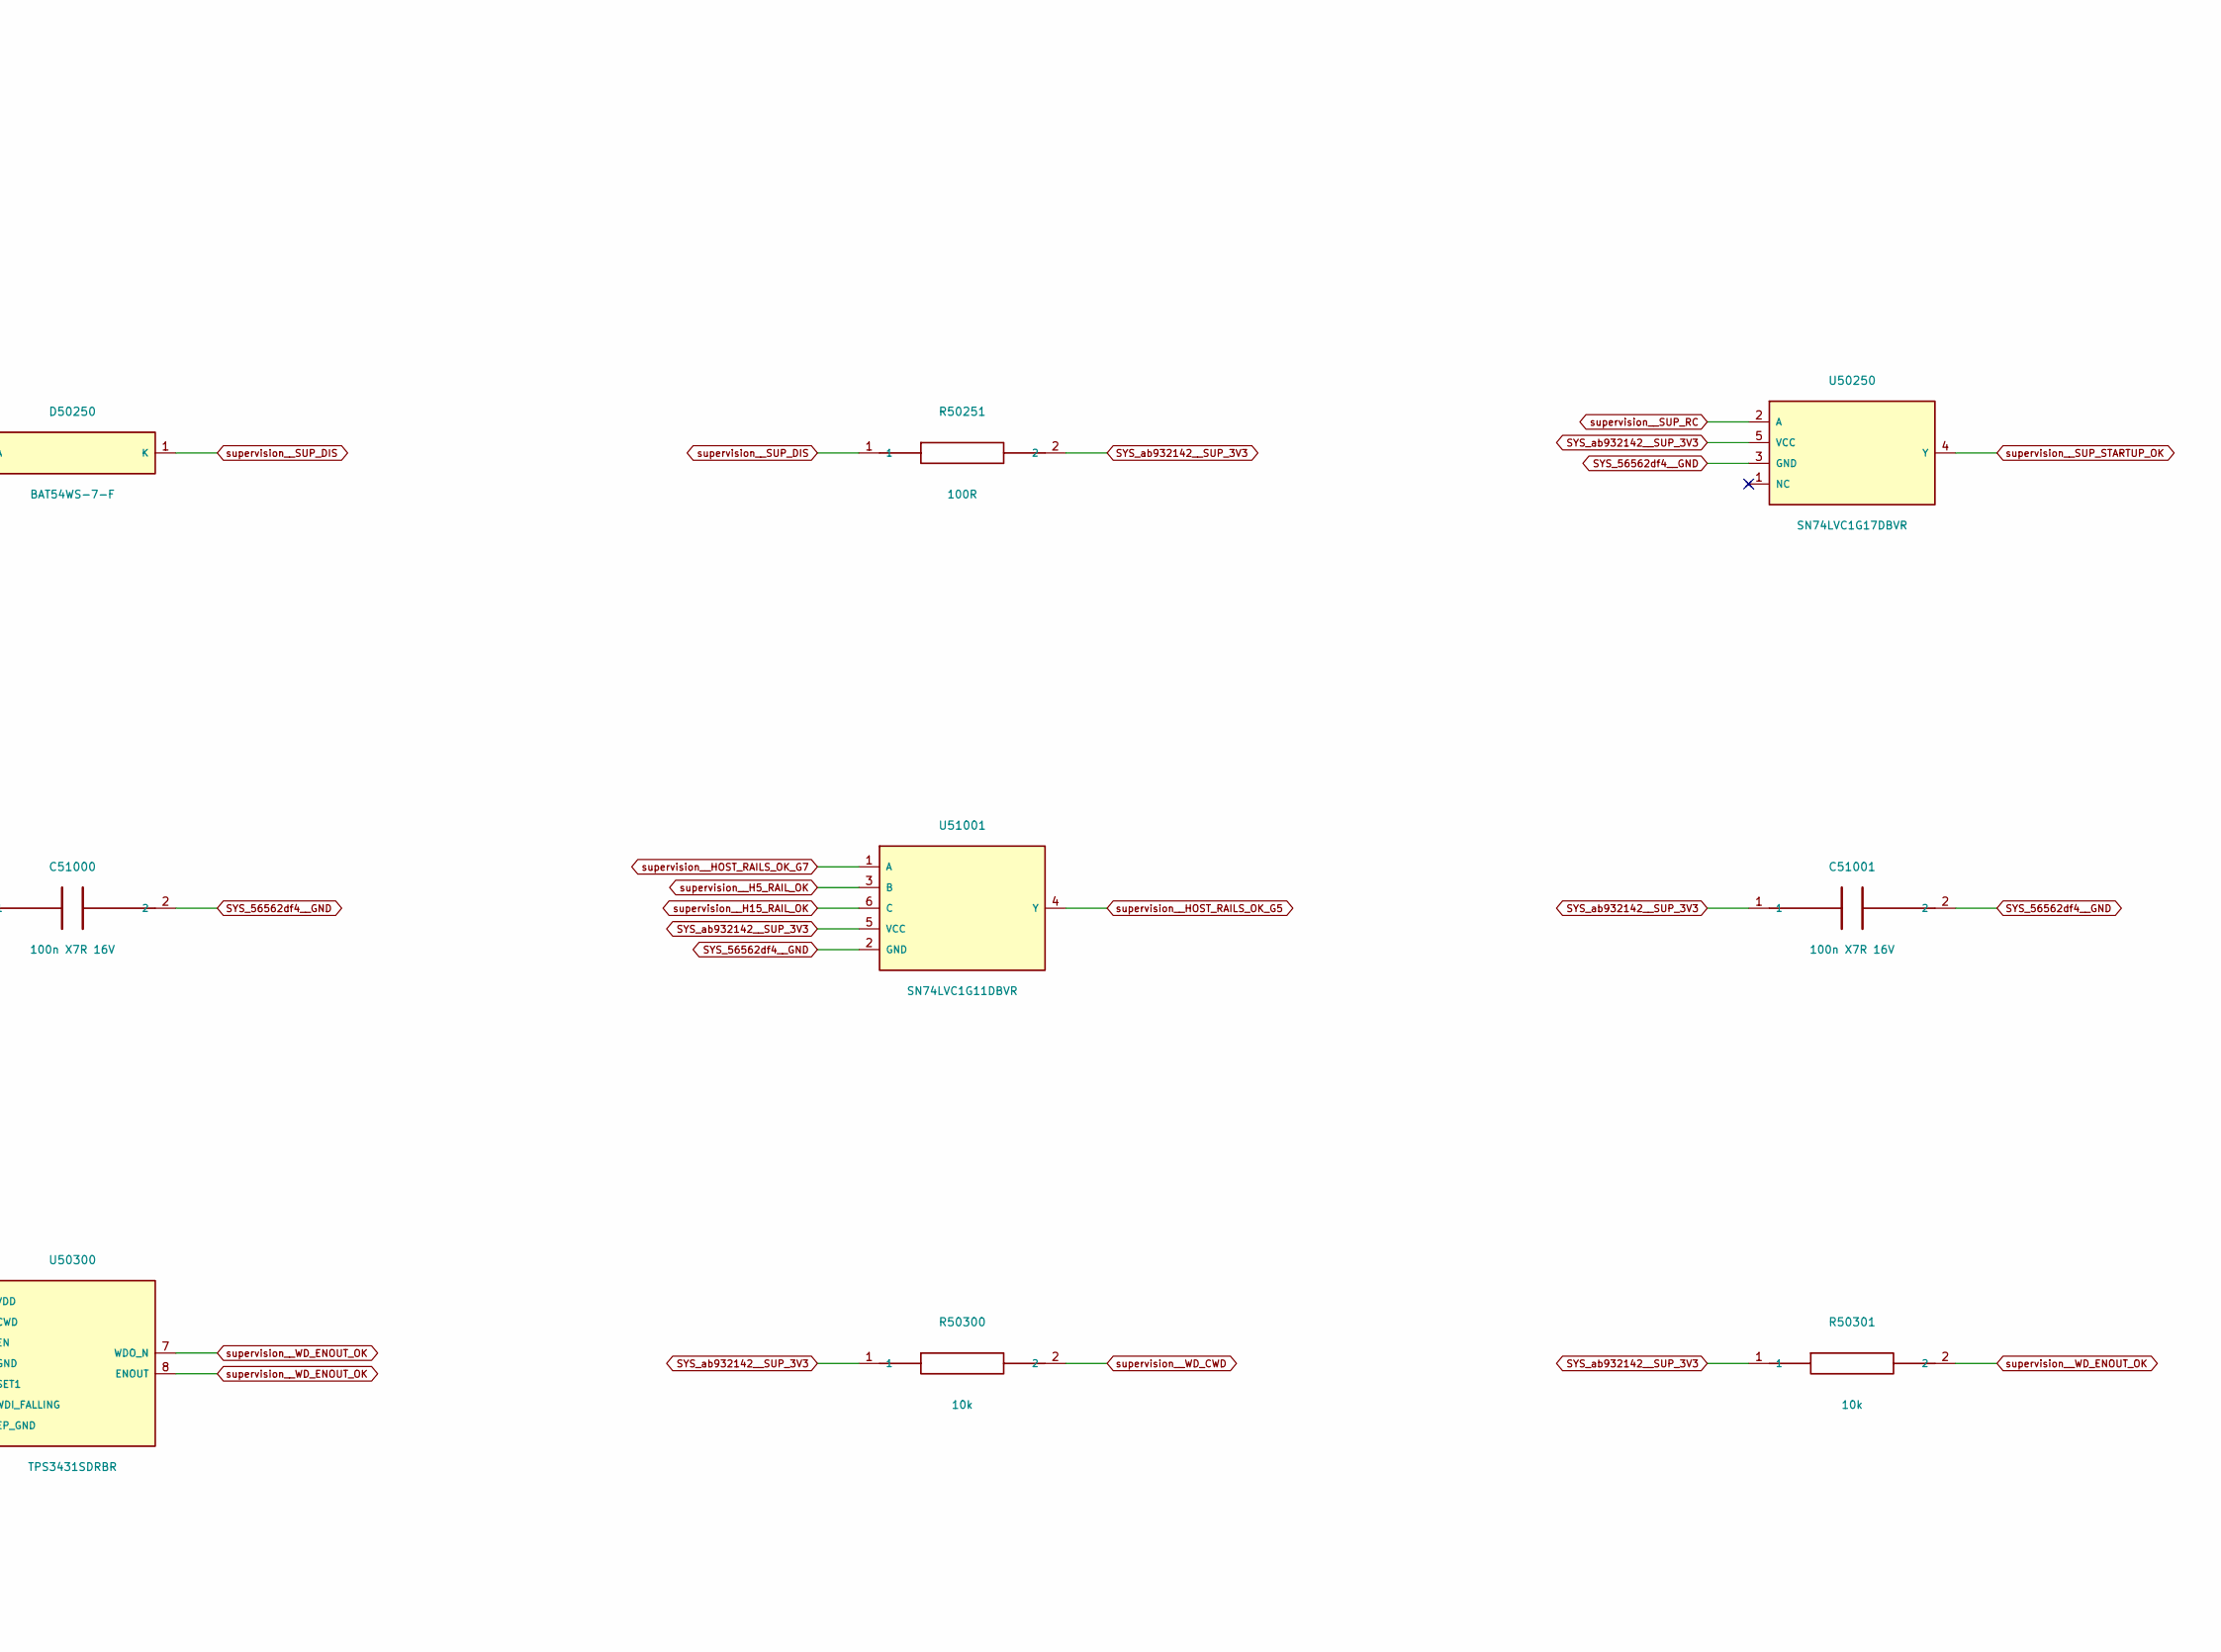
[picture p245: schematic watchdog.kicad_sch, Project SCCI RH S4 / Heartbeat and startup, part in row 1, column 2]

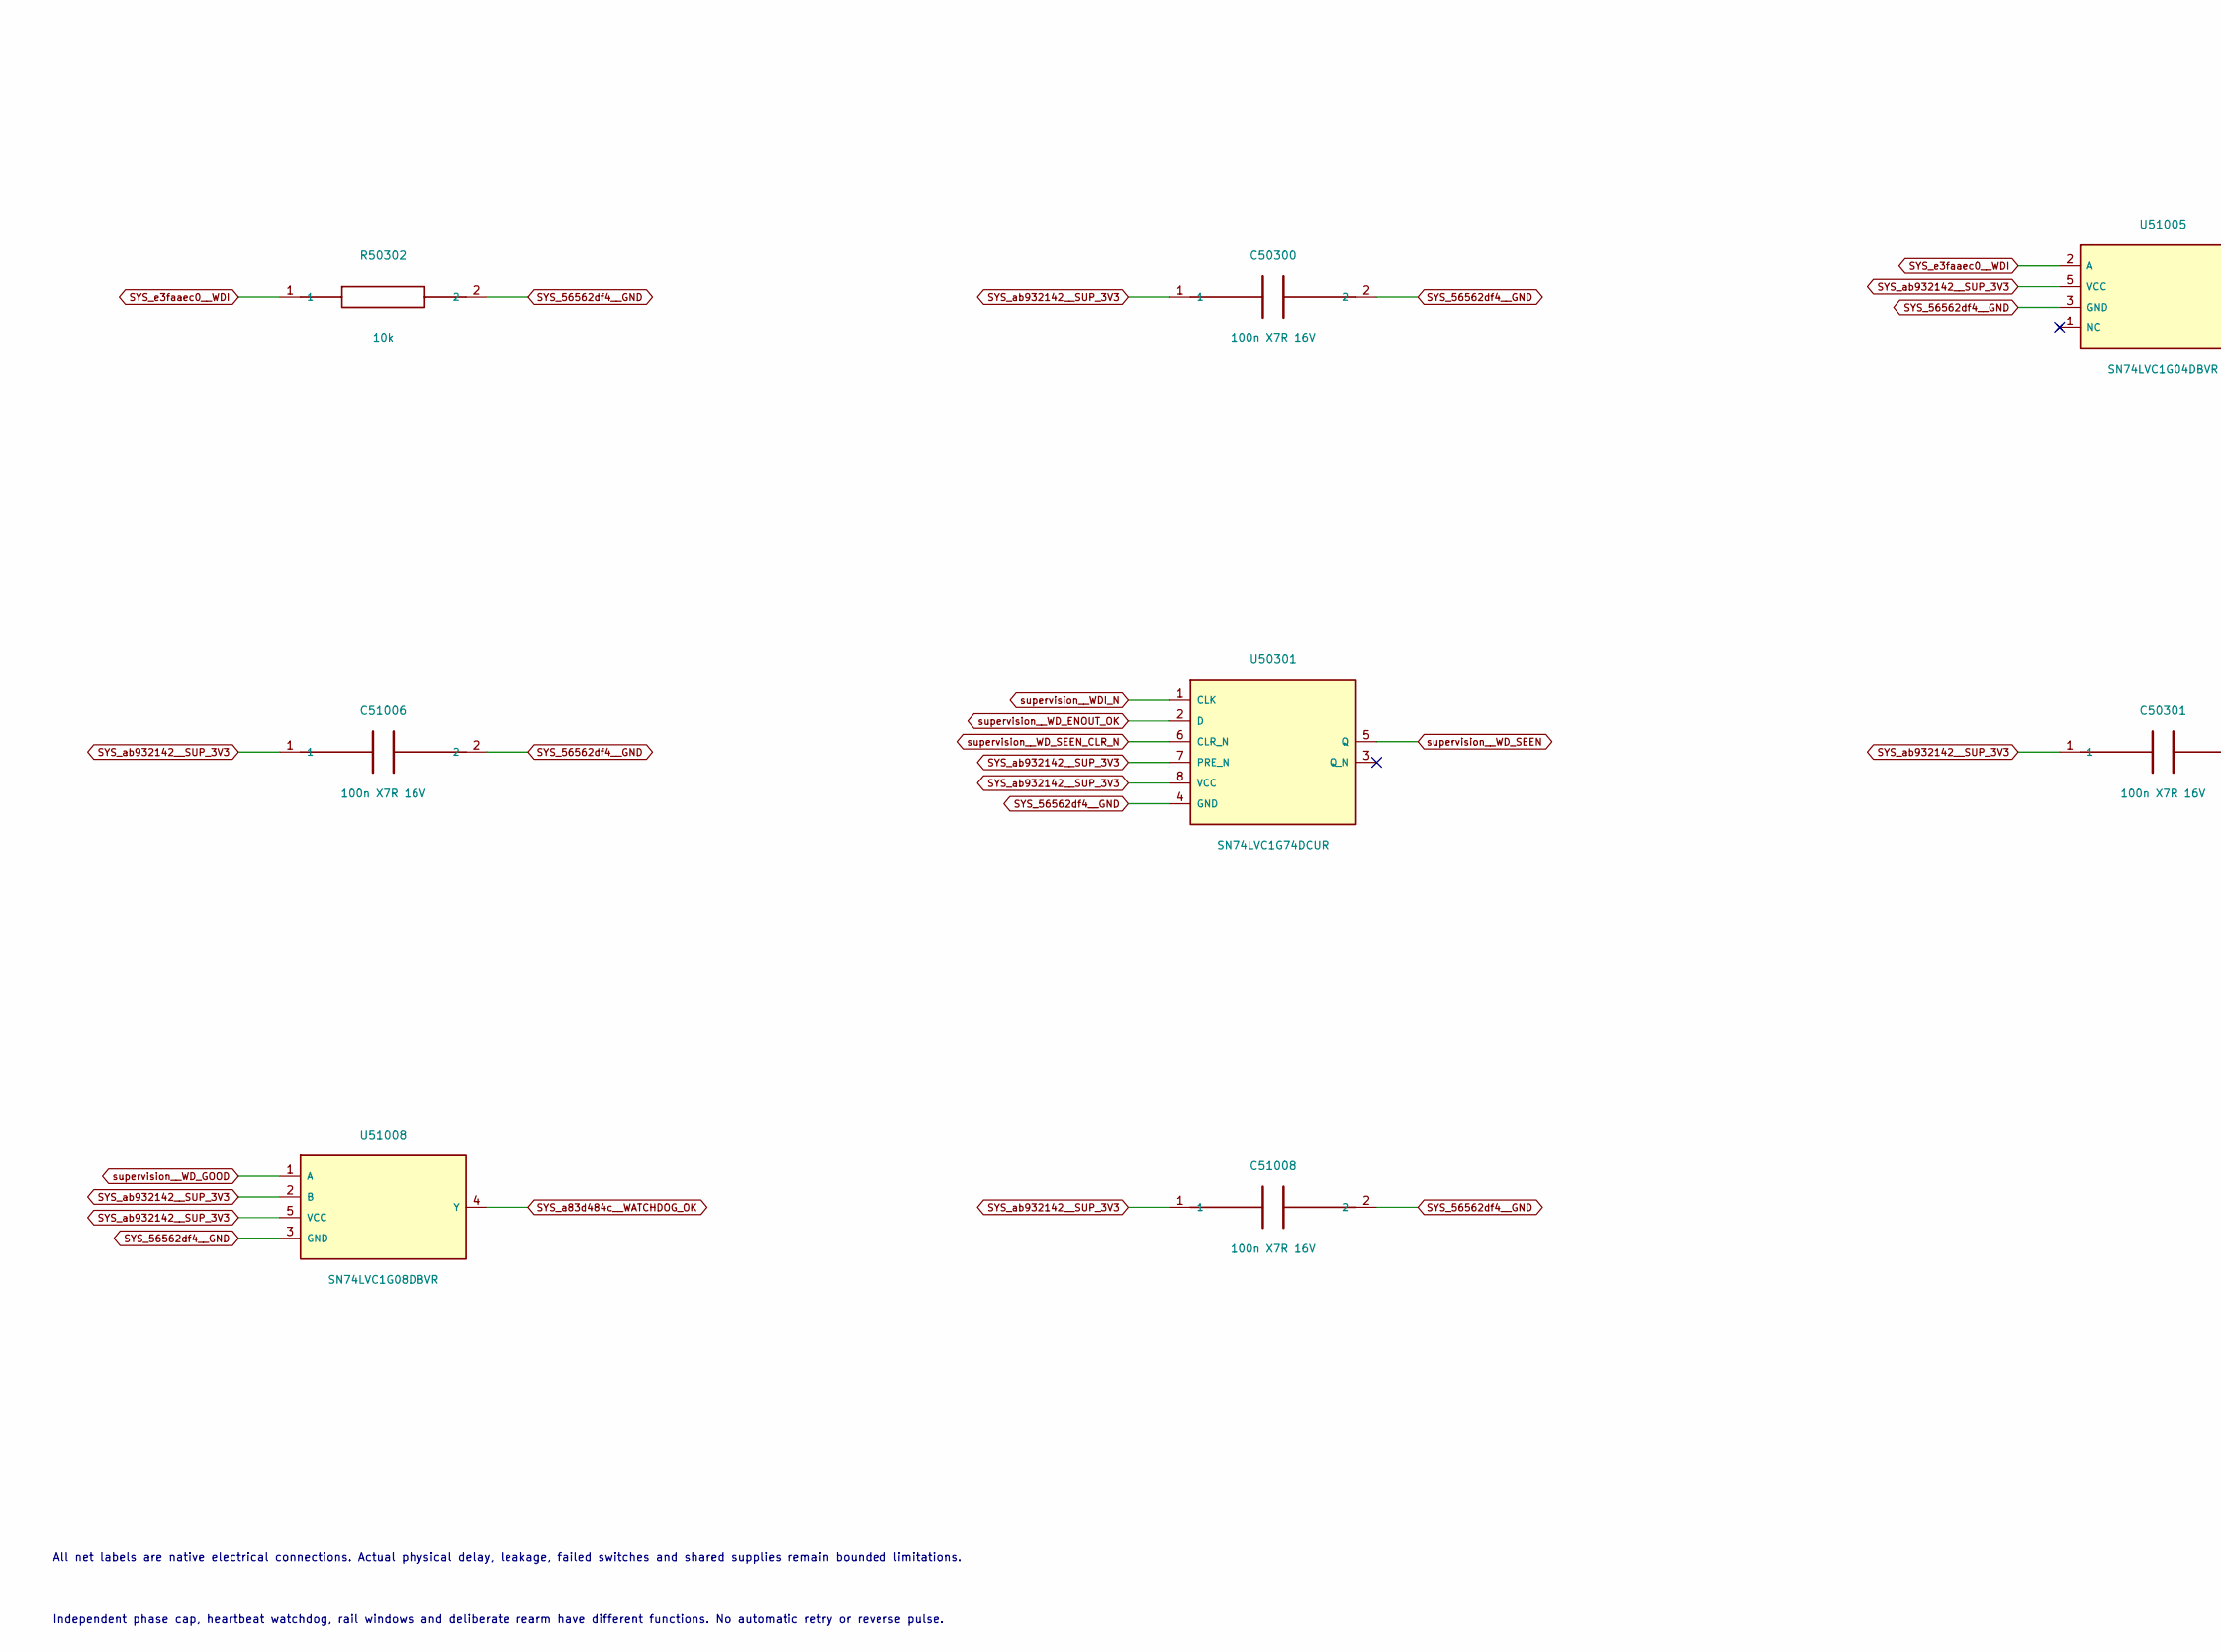
[picture p246: schematic watchdog.kicad_sch, Project SCCI RH S4 / Heartbeat and startup, part in row 2, column 1]

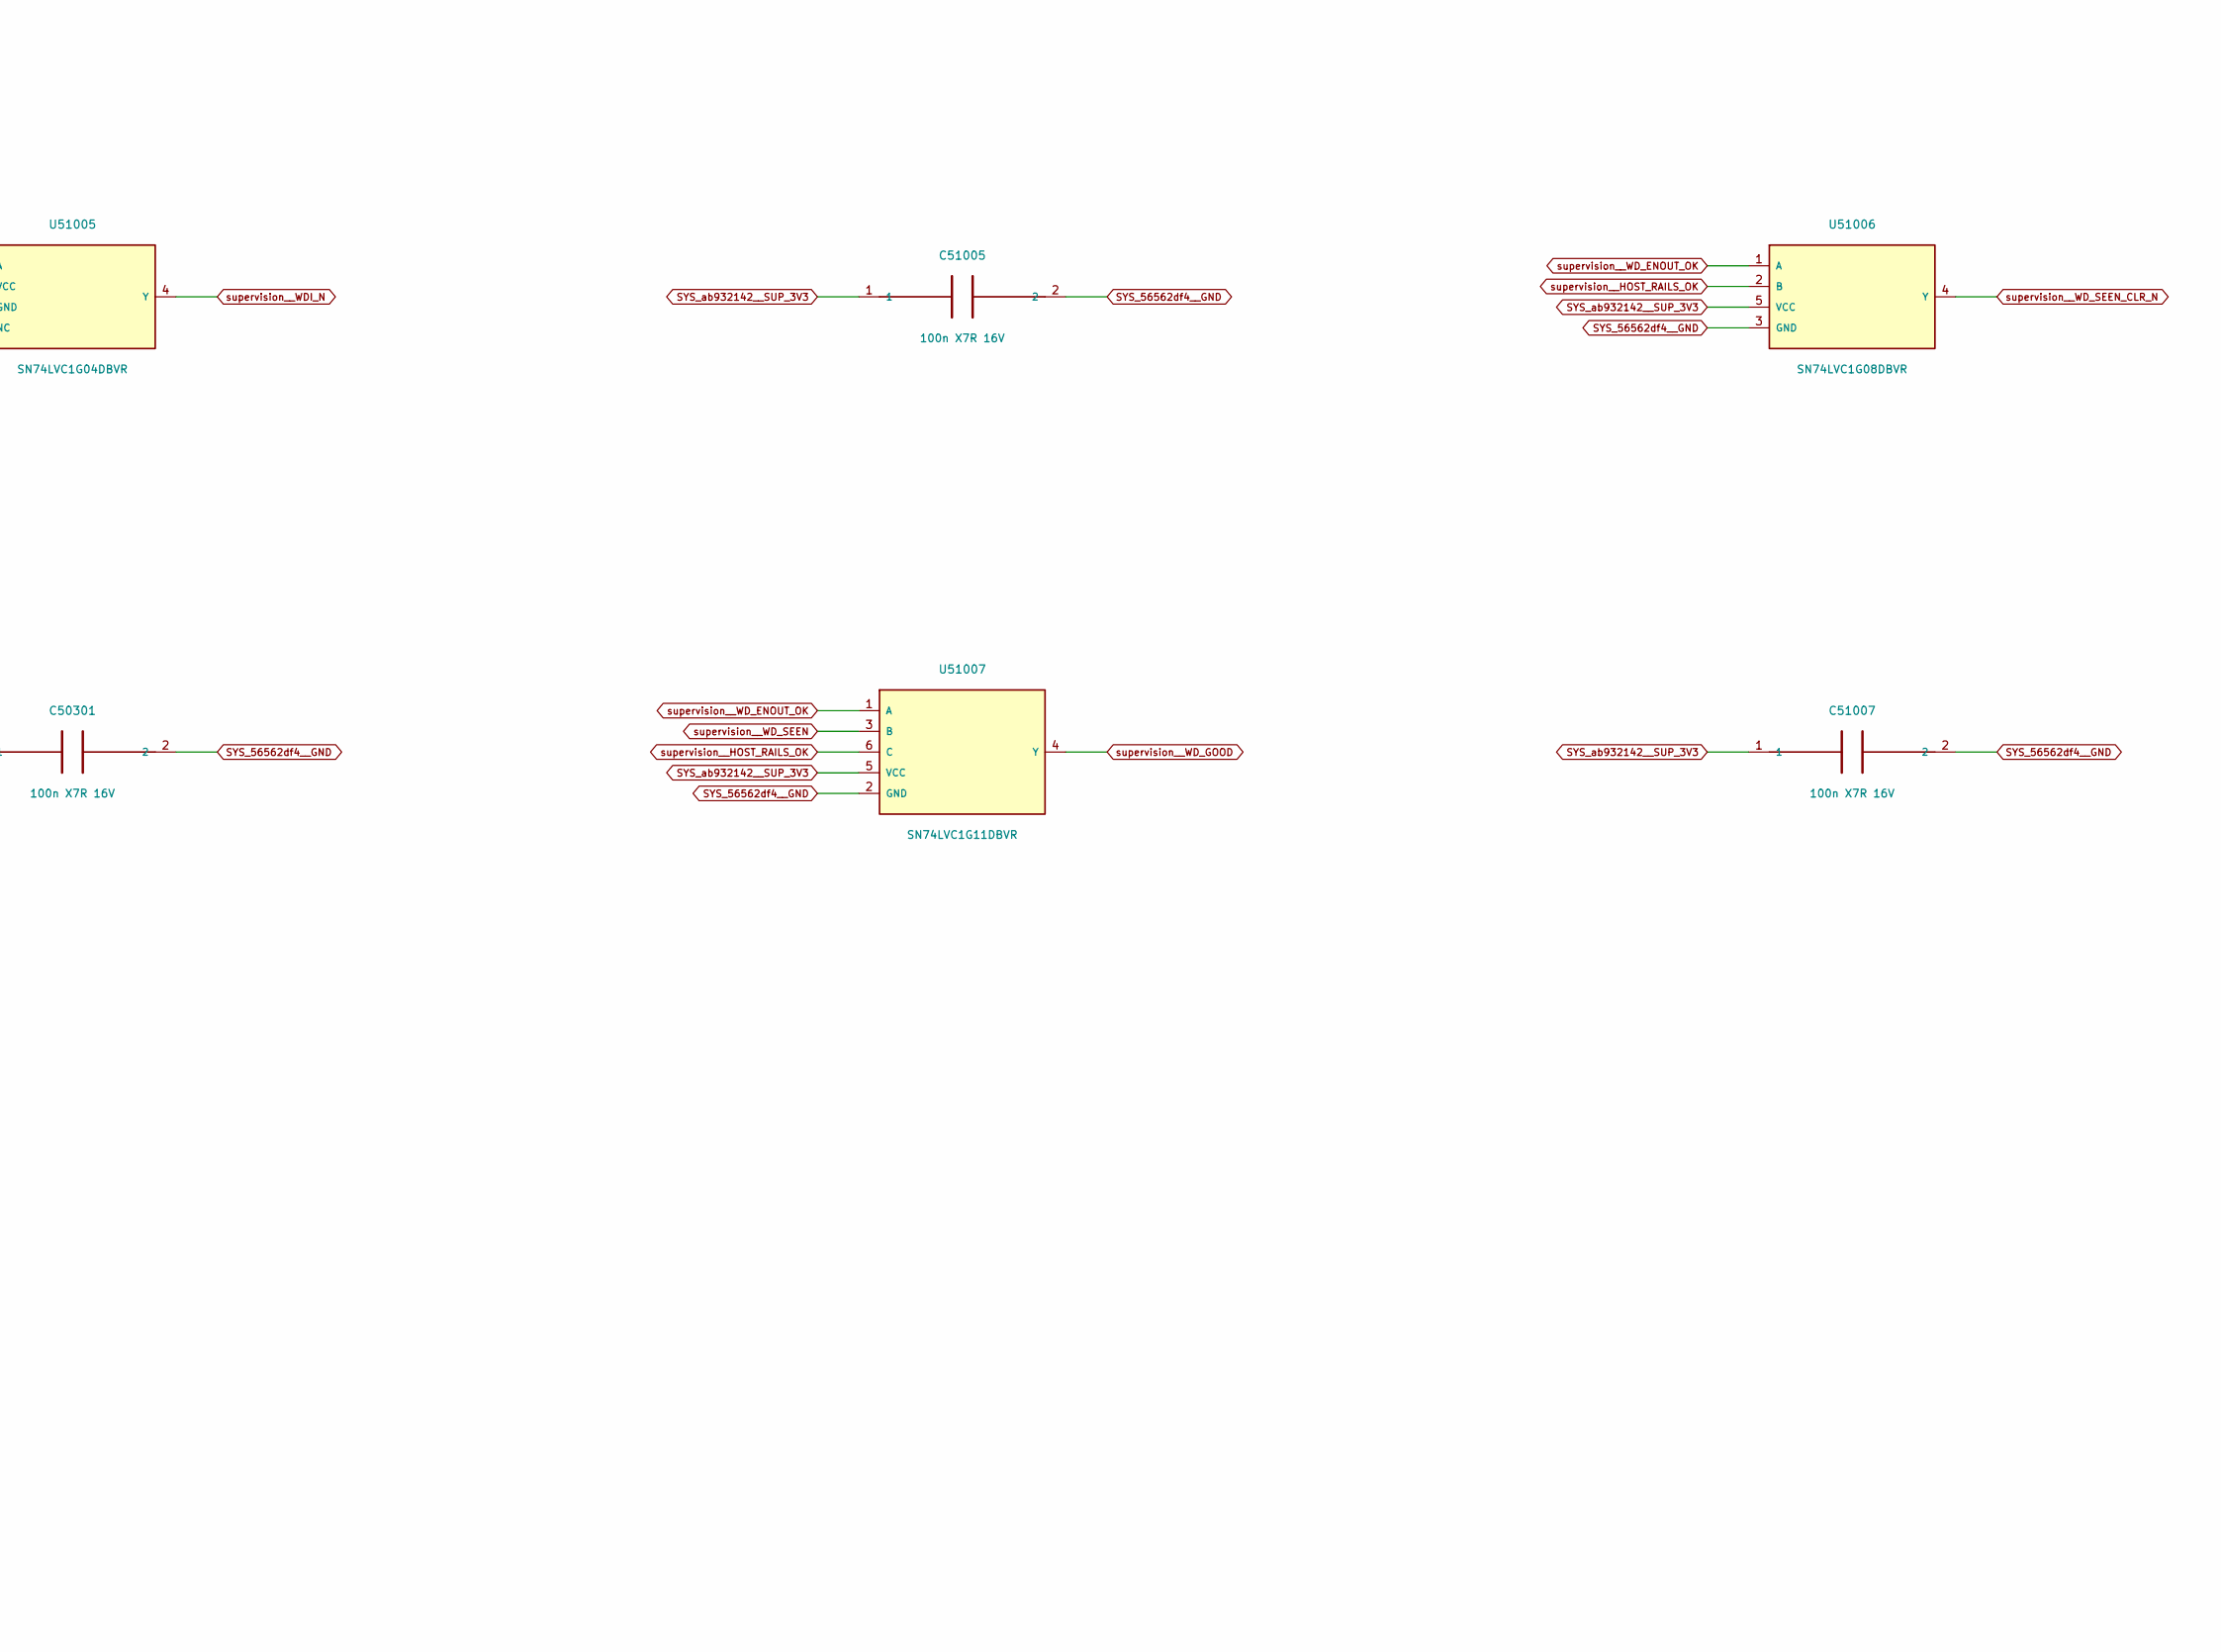
[picture p247: schematic watchdog.kicad_sch, Project SCCI RH S4 / Heartbeat and startup, part in row 2, column 2]

Parts:
C50250: 47n X7R 10%; C_0805_2012Metric
C50251, C50300, C50301, C51000, C51001, C51002, C51005, C51006, C51007, C51008: 100n X7R 16V; C_0805_2012Metric
D50250: BAT54WS-7-F; D_SOD-323
R50250: 100k 1%; R_0805_2012Metric
R50251: 100R; R_0805_2012Metric
R50300, R50301, R50302: 10k; R_0805_2012Metric
U50250: SN74LVC1G17DBVR; SOT-23-5
U50300: TPS3431SDRBR; Texas_DRB0008A_VSON8_3x3_P0.65_EP1.5x1.75
U50301: SN74LVC1G74DCUR; VSSOP-8_2.3x2mm_P0.5mm
U51000, U51001, U51002, U51007: SN74LVC1G11DBVR; SOT-23-6
U51005: SN74LVC1G04DBVR; SOT-23-5
U51006, U51008: SN74LVC1G08DBVR; SOT-23-5

Connections:
SYS_56562df4__GND: C50250.2, C50251.2, C50300.2, C50301.2, C51000.2, C51001.2, C51002.2, C51005.2, C51006.2, C51007.2, C51008.2, R50302.2, U50250.3 (GND), U50300.4 (GND), U50300.9 (EP_GND), U50301.4 (GND), U51000.2 (GND), U51001.2 (GND), U51002.2 (GND), U51005.3 (GND), U51006.3 (GND), U51007.2 (GND), U51008.3 (GND); also elsewhere on the board
SYS_a83d484c__WATCHDOG_OK: U51008.4 (Y); also elsewhere on the board
SYS_ab932142__SUP_3V3: C50251.1, C50300.1, C50301.1, C51000.1, C51001.1, C51002.1, C51005.1, C51006.1, C51007.1, C51008.1, R50250.1, R50251.2, R50300.1, R50301.1, U50250.5 (VCC), U50300.1 (VDD), U50300.5 (SET1), U50301.7 (PRE_N), U50301.8 (VCC), U51000.5 (VCC), U51001.5 (VCC), U51002.5 (VCC), U51005.5 (VCC), U51006.5 (VCC), U51007.5 (VCC), U51008.2 (B), U51008.5 (VCC); also elsewhere on the board
SYS_e3faaec0__WDI: R50302.1, U50300.6 (WDI_FALLING), U51005.2 (A); also elsewhere on the board
supervision__H3_RAIL_OK: U51000.6 (C); also elsewhere on the board
supervision__H5_RAIL_OK: U51001.3 (B); also elsewhere on the board
supervision__H15_RAIL_OK: U51001.6 (C); also elsewhere on the board
supervision__H24_RAIL_OK: U51002.3 (B); also elsewhere on the board
supervision__HOST_RAILS_OK: U50300.3 (EN), U51002.4 (Y), U51006.2 (B), U51007.6 (C); also elsewhere on the board
supervision__HOST_RAILS_OK_G5: U51001.4 (Y), U51002.1 (A)
supervision__HOST_RAILS_OK_G7: U51000.4 (Y), U51001.1 (A)
supervision__SUP3_RAIL_OK: U51000.1 (A); also elsewhere on the board
supervision__SUP5_RAIL_OK: U51000.3 (B); also elsewhere on the board
supervision__SUP_DIS: D50250.1 (K), R50251.1
supervision__SUP_RC: C50250.1, D50250.2 (A), R50250.2, U50250.2 (A)
supervision__SUP_STARTUP_OK: U50250.4 (Y), U51002.6 (C)
supervision__WDI_N: U50301.1 (CLK), U51005.4 (Y)
supervision__WD_CWD: R50300.2, U50300.2 (CWD)
supervision__WD_ENOUT_OK: R50301.2, U50300.7 (WDO_N), U50300.8 (ENOUT), U50301.2 (D), U51006.1 (A), U51007.1 (A)
supervision__WD_GOOD: U51007.4 (Y), U51008.1 (A); also elsewhere on the board
supervision__WD_SEEN: U50301.5 (Q), U51007.3 (B)
supervision__WD_SEEN_CLR_N: U50301.6 (CLR_N), U51006.4 (Y)

Notes on the sheet:
DIGITAL SCCI ENGINEERING / ARTIFICIAL LOADS / NATIVE INDEPENDENT SUPERVISION
18 guarded stimulation conductors, 17 measured RHD-side windows; conditional healthy-switch blanking is not proven isolation.
All net labels are native electrical connections. Actual physical delay, leakage, failed switches and shared supplies remain bounded limitations.
Independent phase cap, heartbeat watchdog, rail windows and deliberate rearm have different functions. No automatic retry or reverse pulse.
