pratham-cloud-ctrl/Project-SCCI-RH/electronics/stage4/integrated-pcb/boards/supervision/supervision.kicad_pcb

## KiCad design electronics/stage4/integrated-pcb/boards/supervision/supervision.kicad_pcb (continued)

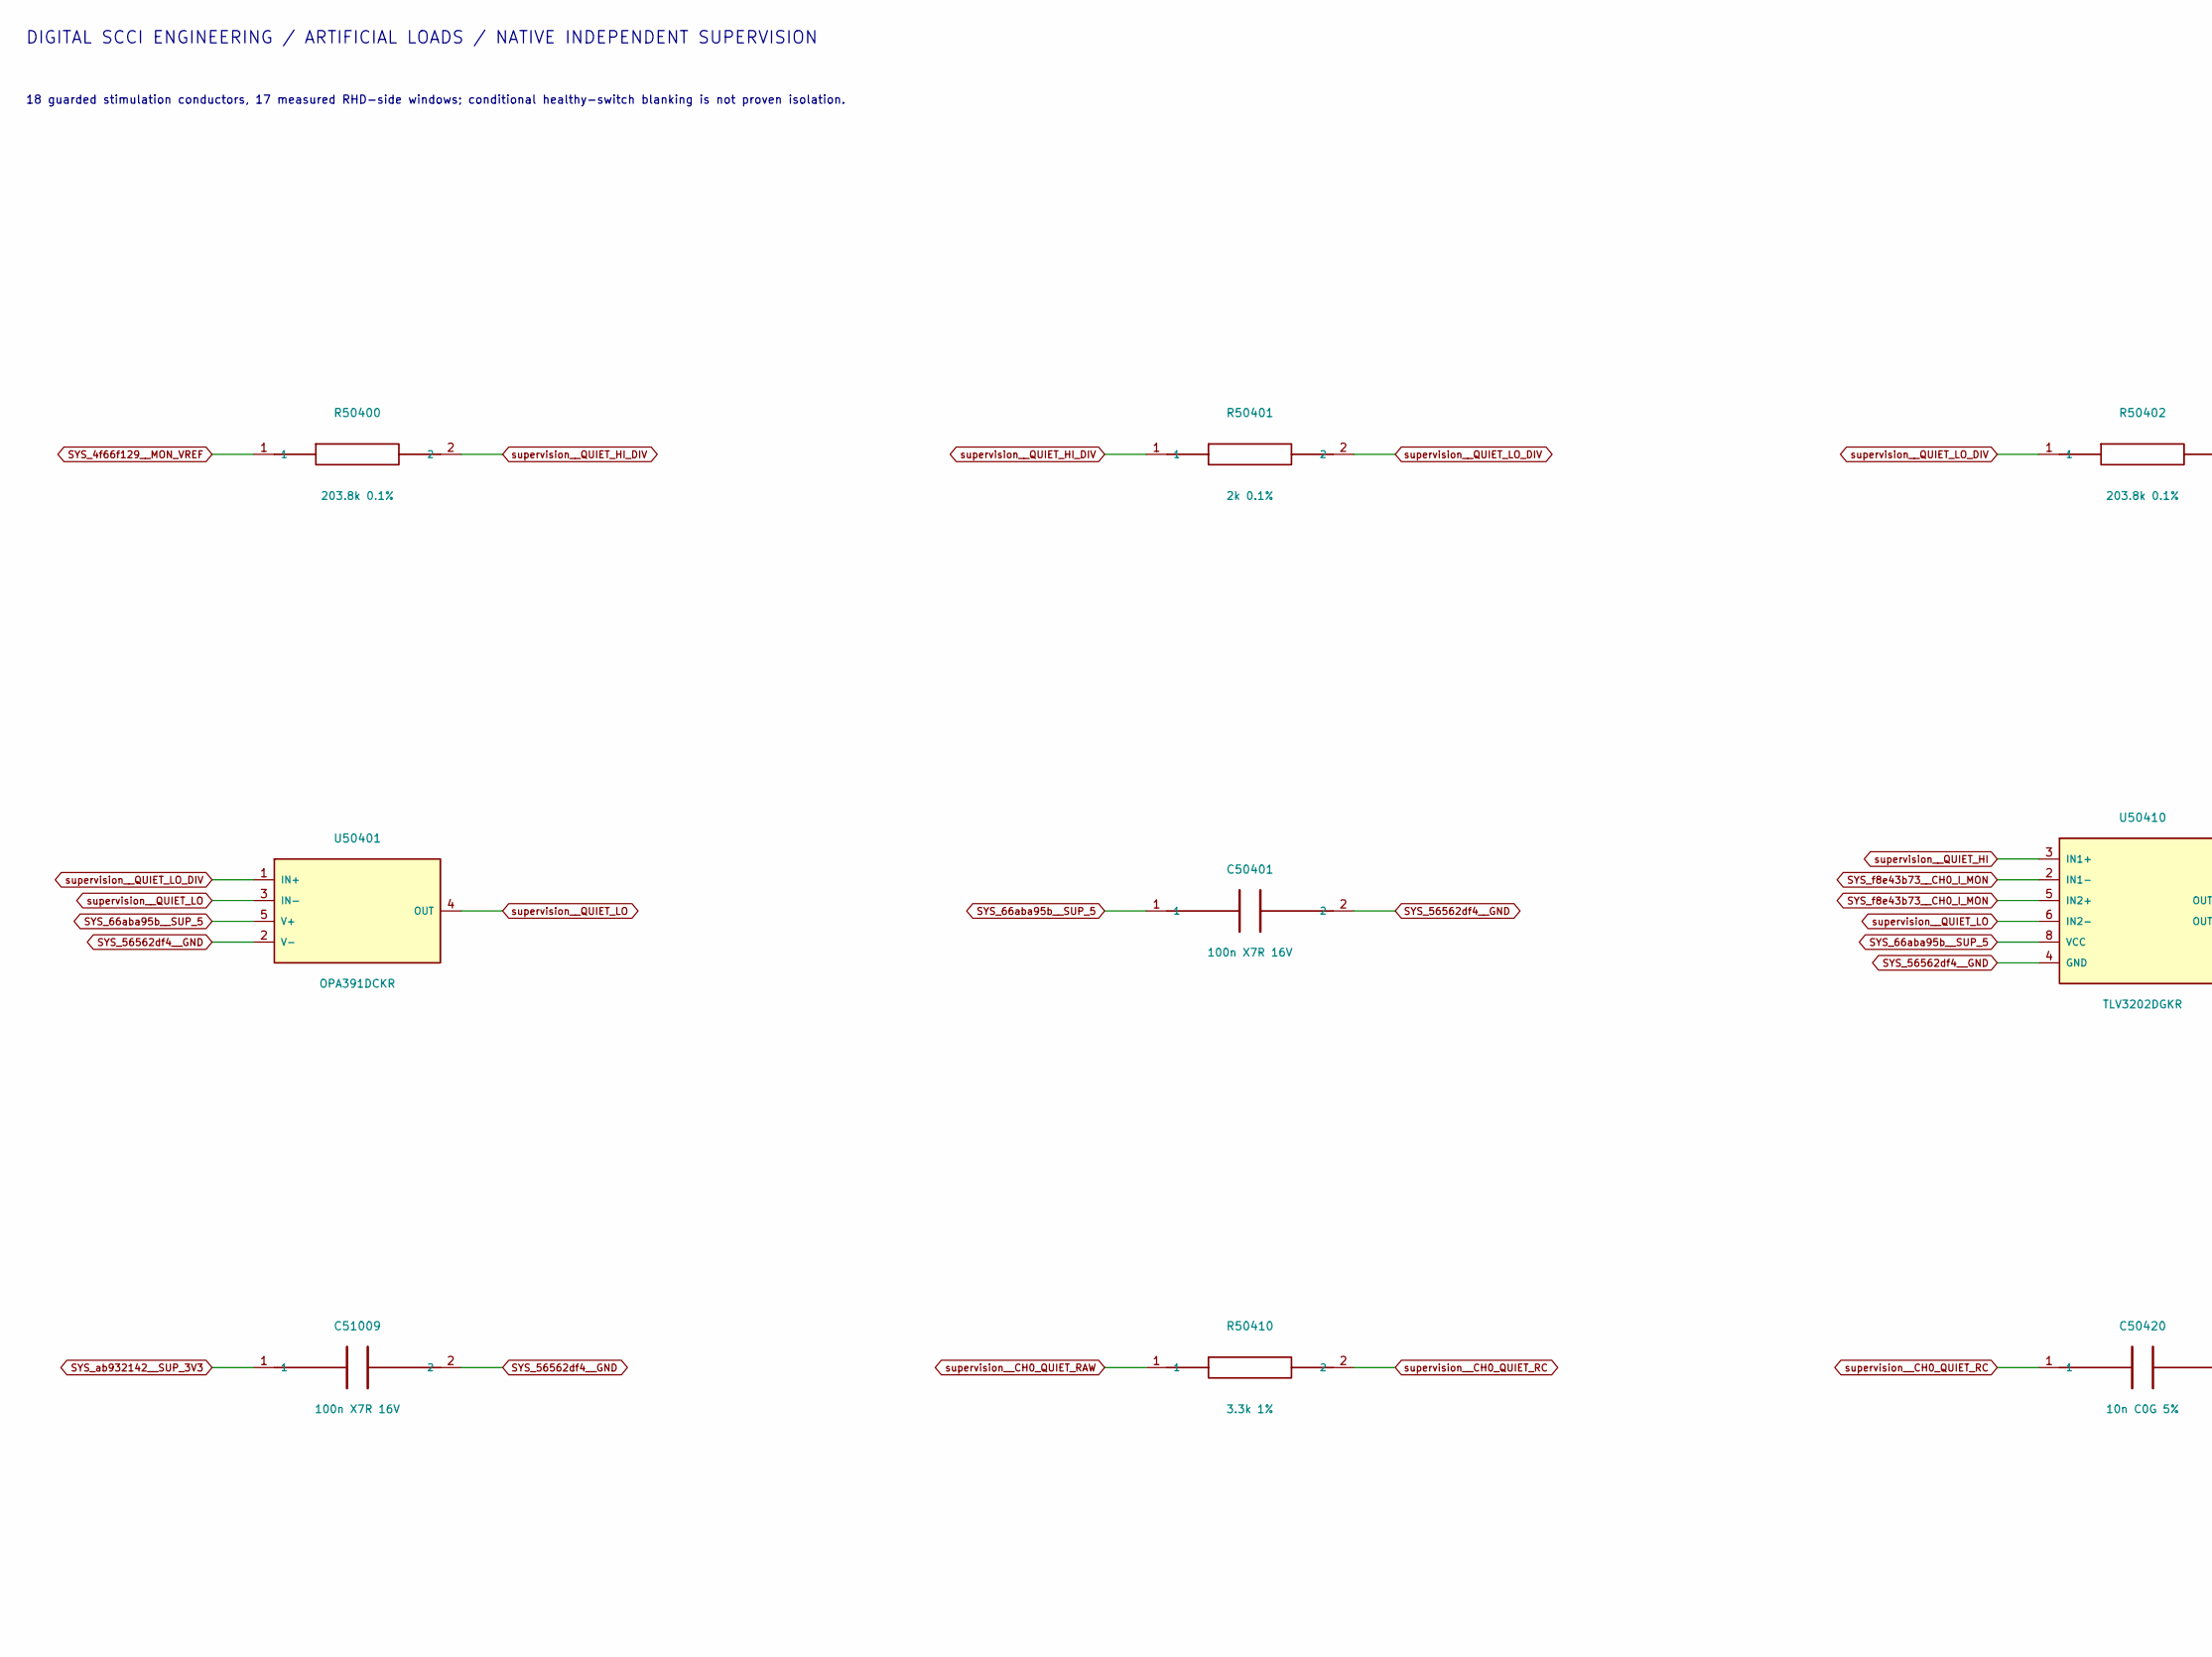
[picture p248: schematic quiescence.kicad_sch, Project SCCI RH S4 / Current quiet window, part in row 1, column 1]

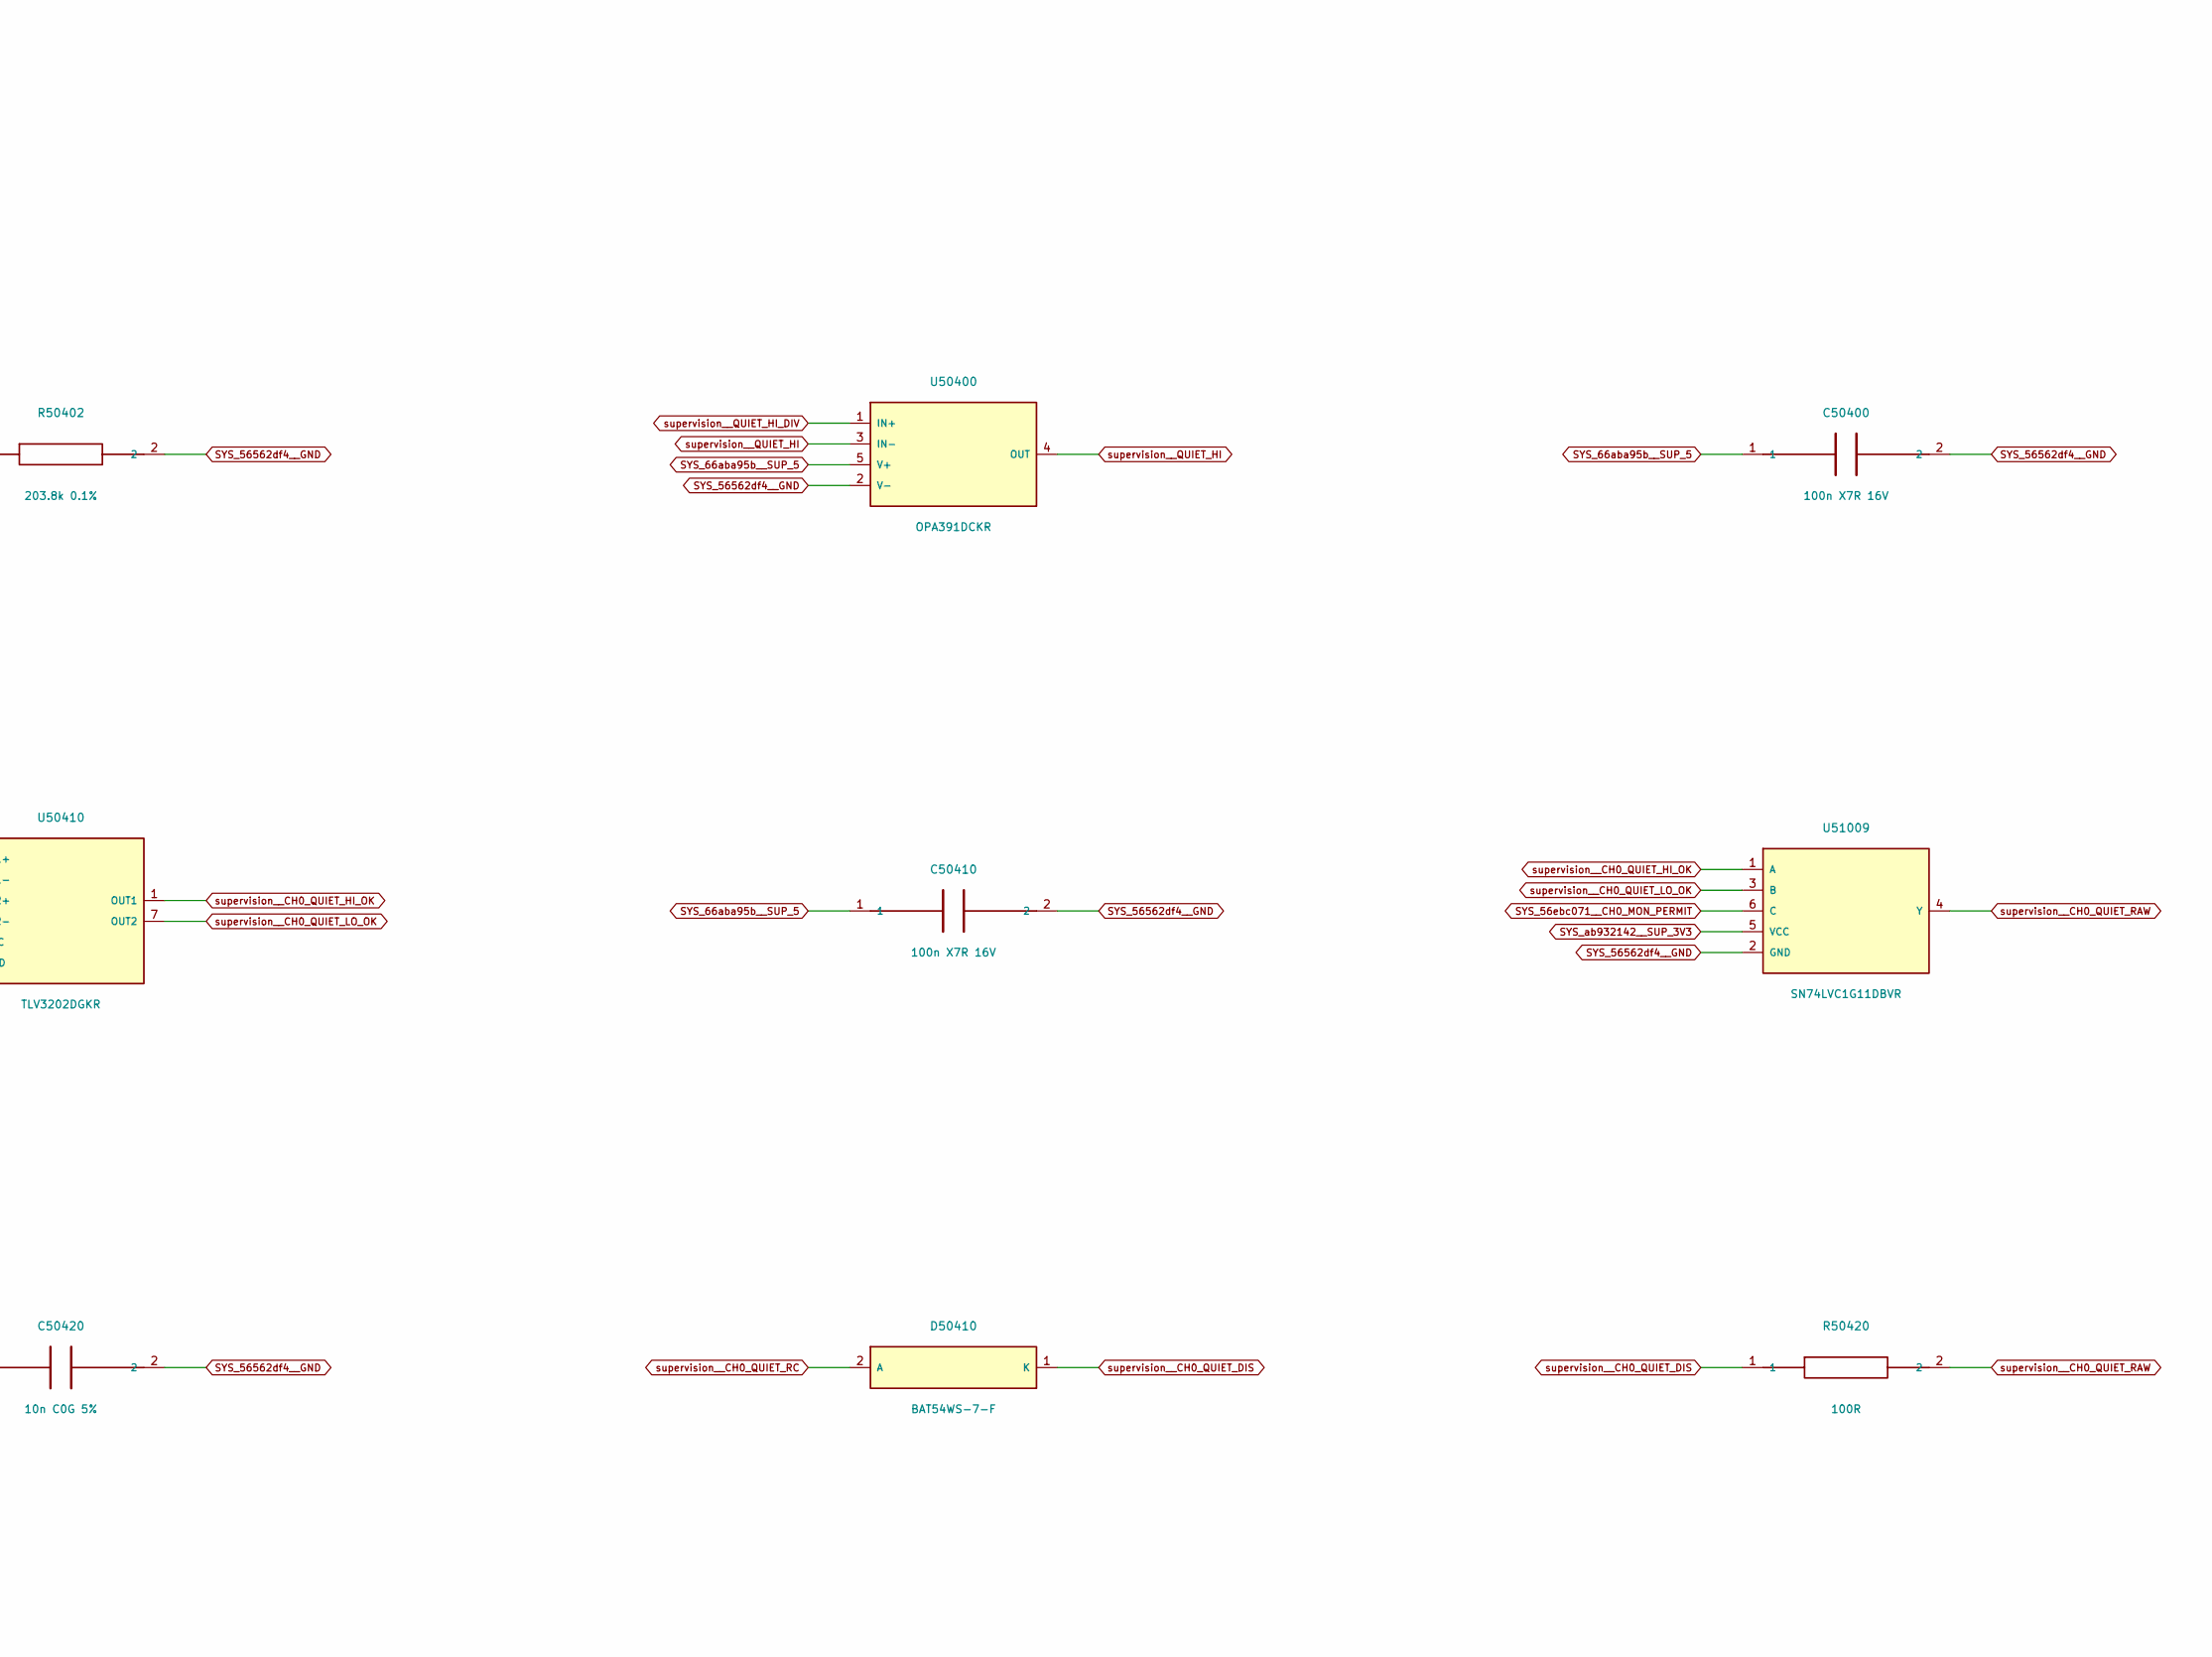
[picture p249: schematic quiescence.kicad_sch, Project SCCI RH S4 / Current quiet window, part in row 1, column 2]

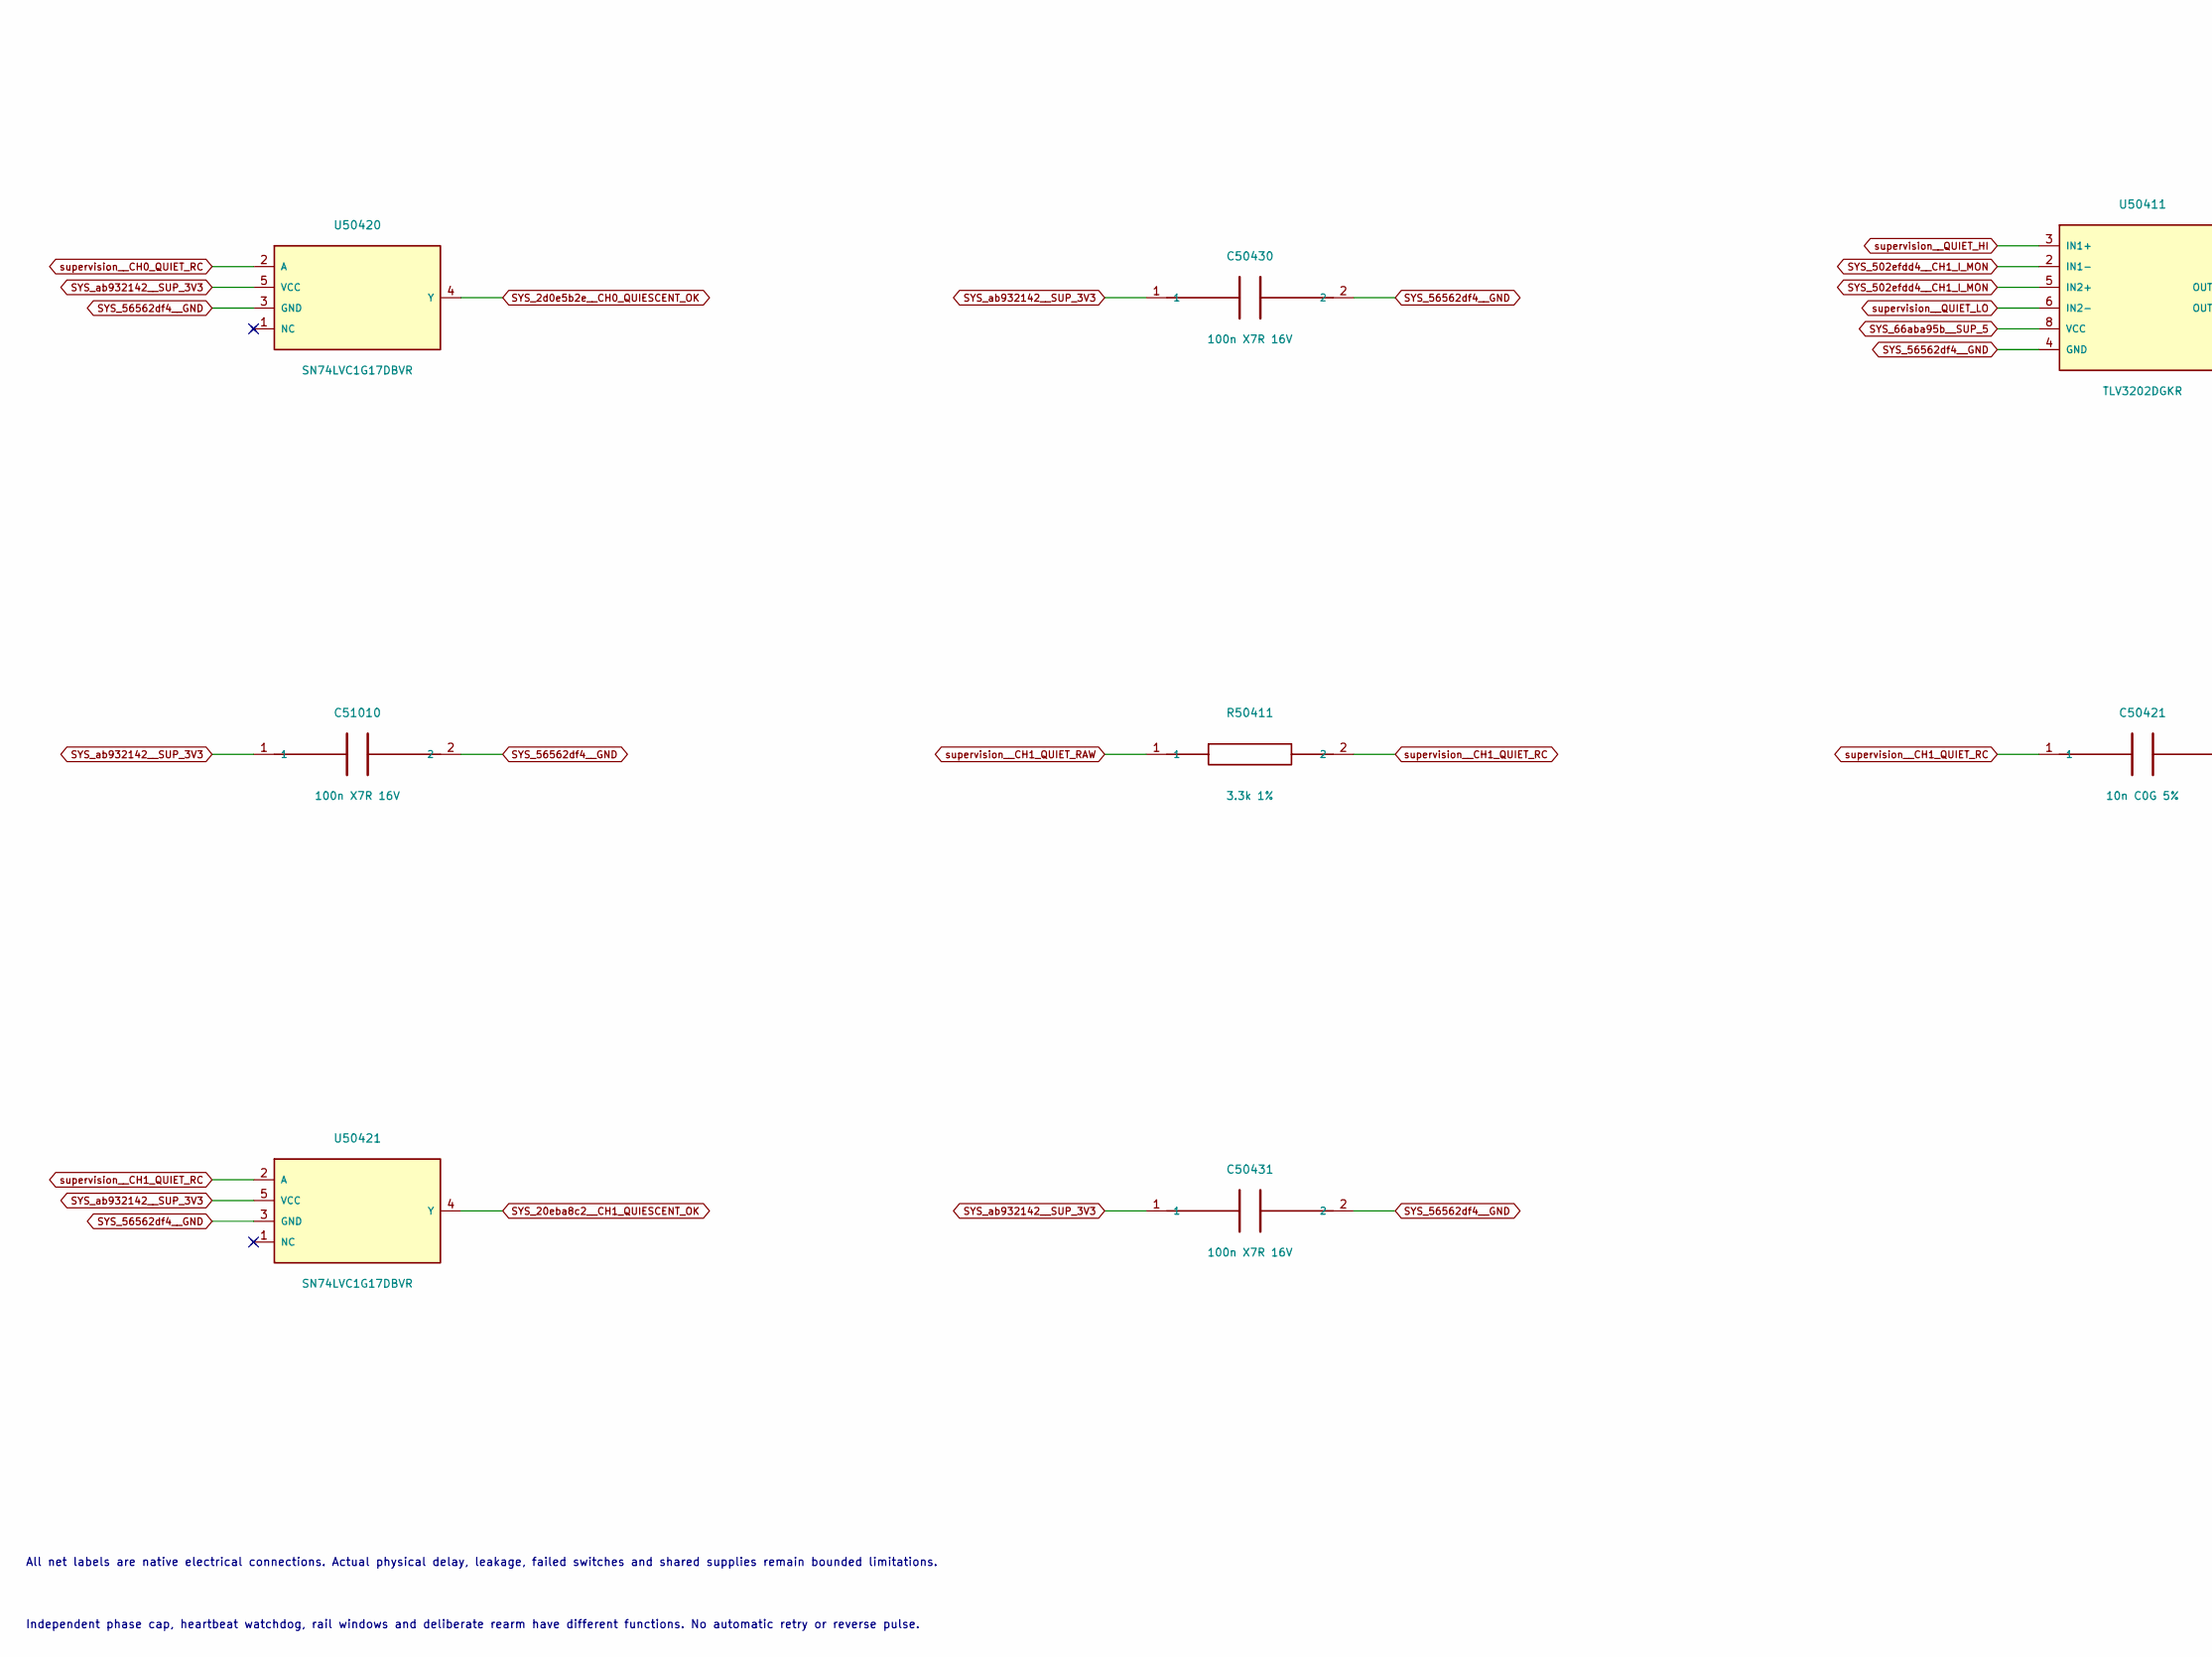
[picture p250: schematic quiescence.kicad_sch, Project SCCI RH S4 / Current quiet window, part in row 2, column 1]

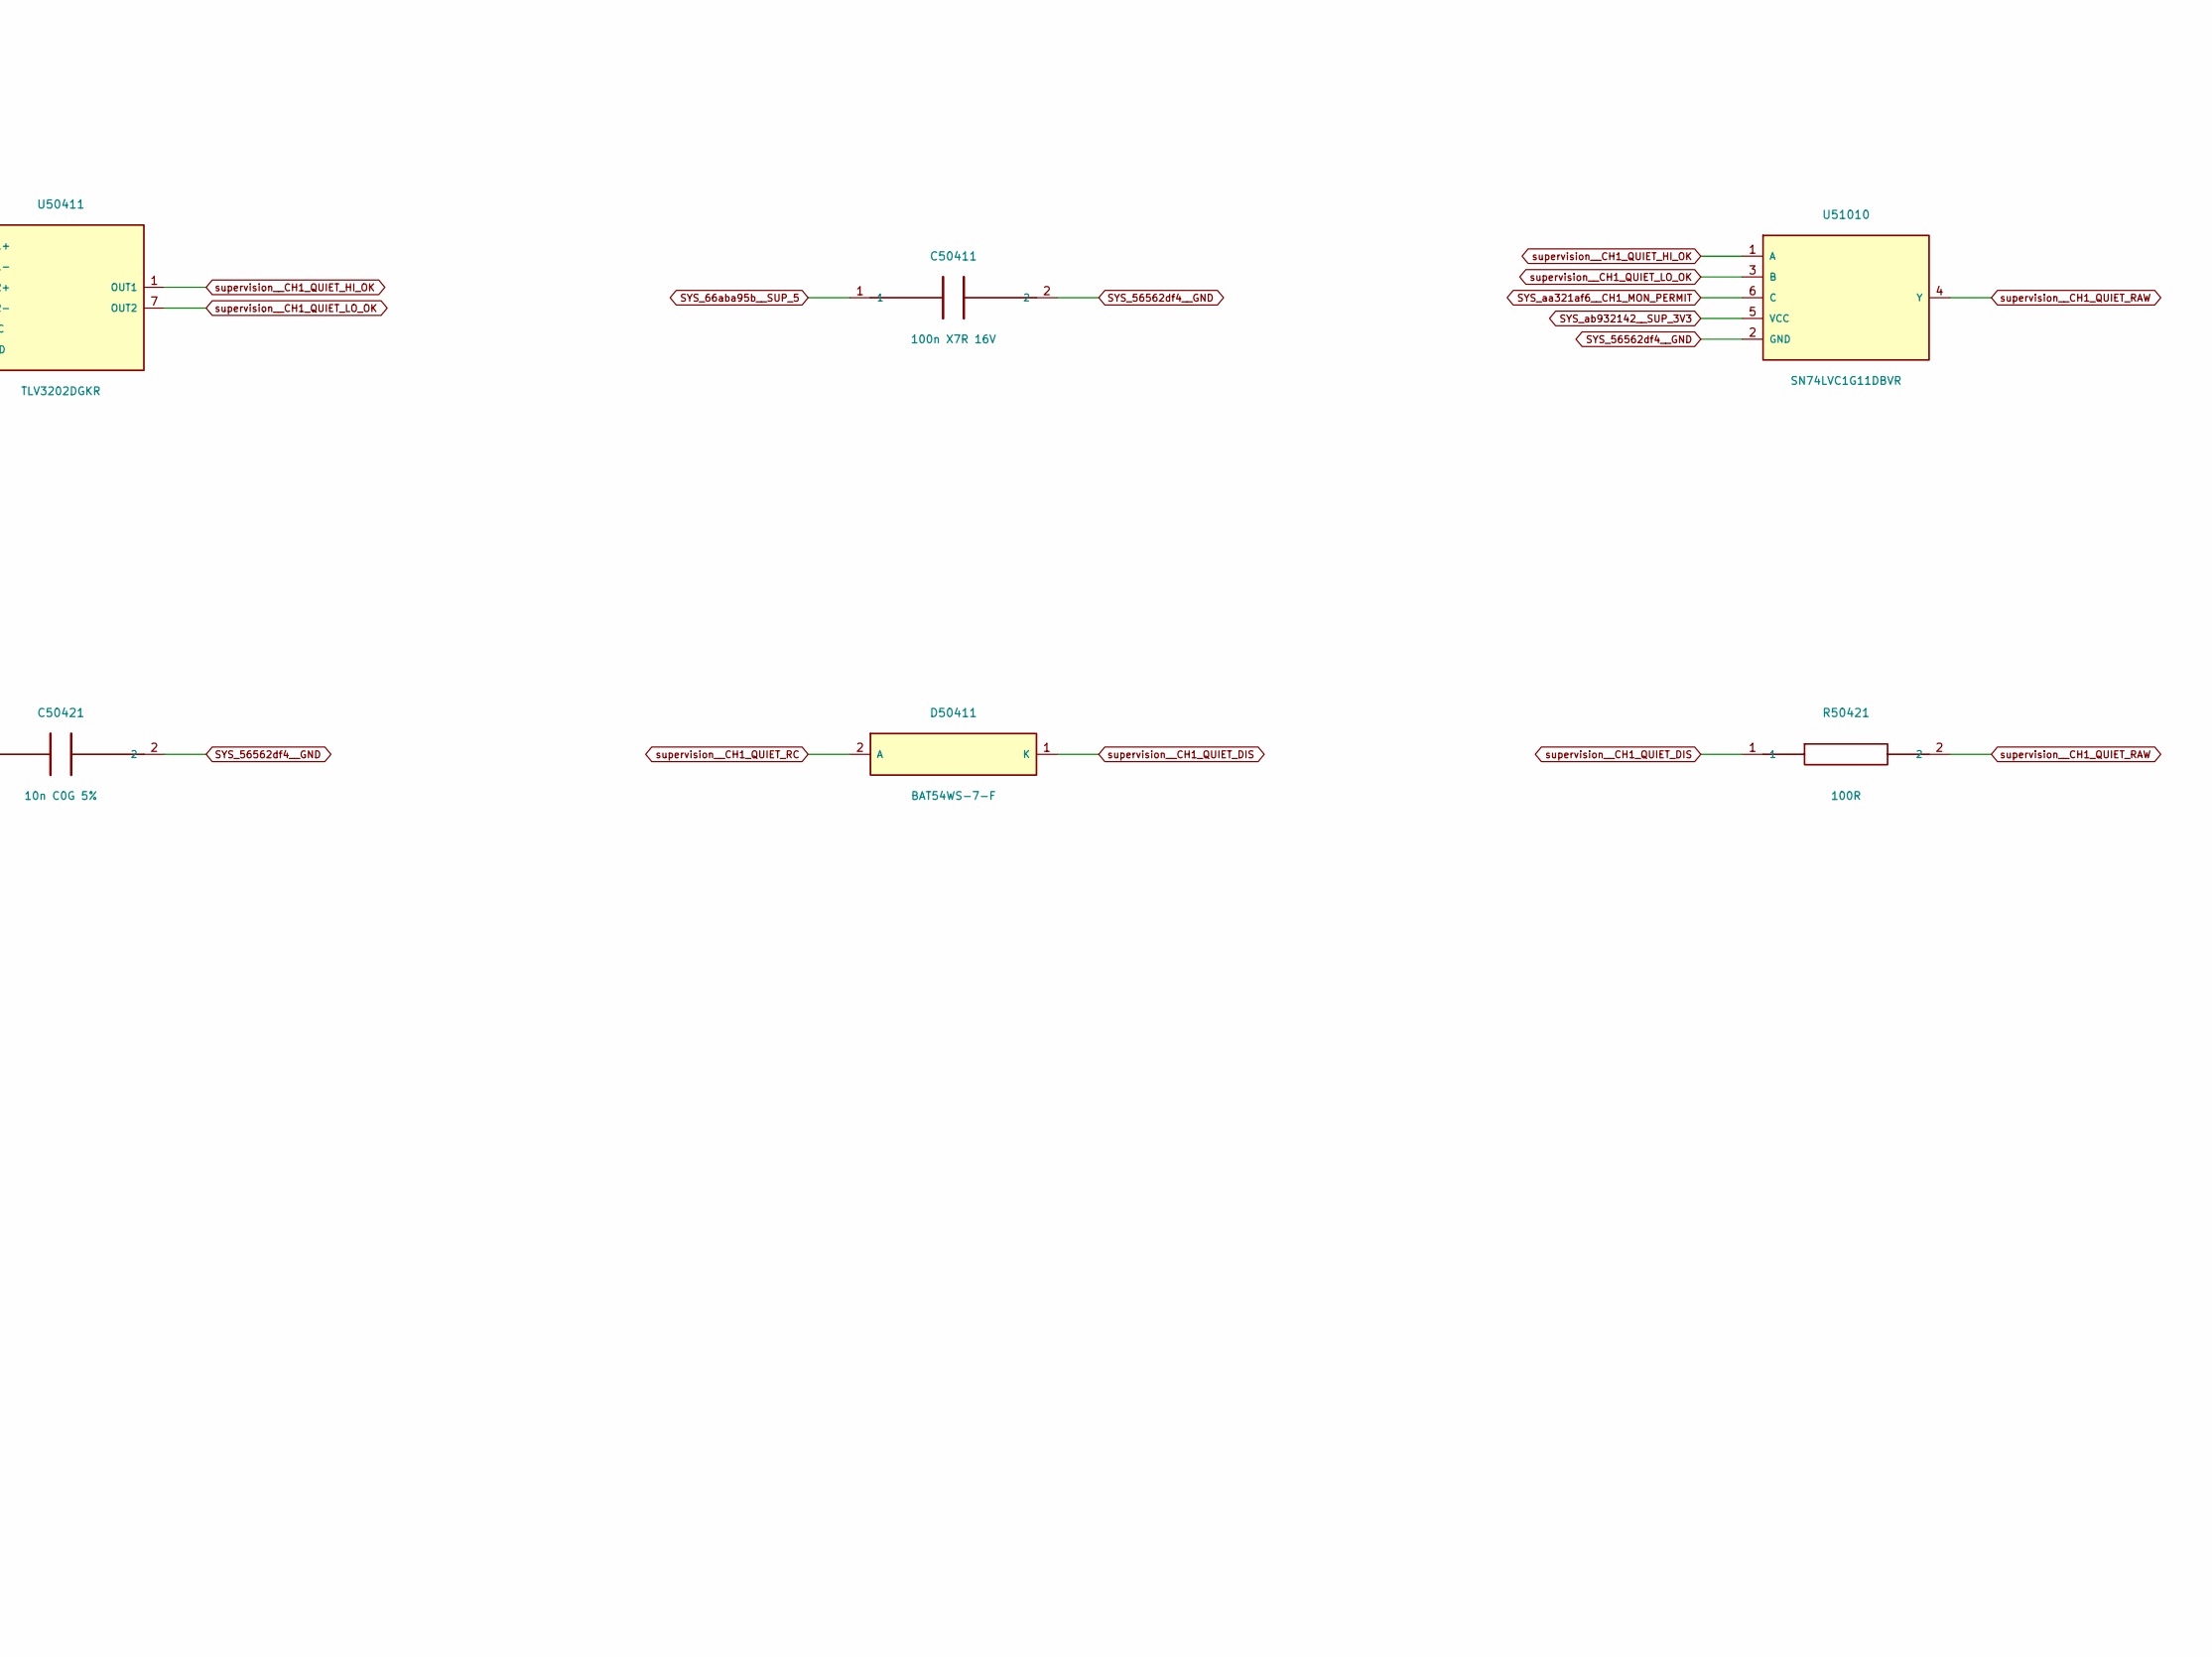
[picture p251: schematic quiescence.kicad_sch, Project SCCI RH S4 / Current quiet window, part in row 2, column 2]

Parts:
C50400, C50401, C50410, C50411, C50430, C50431, C51009, C51010: 100n X7R 16V; C_0805_2012Metric
C50420, C50421: 10n C0G 5%; C_0805_2012Metric
D50410, D50411: BAT54WS-7-F; D_SOD-323
R50400, R50402: 203.8k 0.1%; R_0805_2012Metric
R50401: 2k 0.1%; R_0805_2012Metric
R50410, R50411: 3.3k 1%; R_0805_2012Metric
R50420, R50421: 100R; R_0805_2012Metric
U50400, U50401: OPA391DCKR; SOT-353_SC-70-5
U50410, U50411: TLV3202DGKR; VSSOP-8_2.3x2mm_P0.5mm
U50420, U50421: SN74LVC1G17DBVR; SOT-23-5
U51009, U51010: SN74LVC1G11DBVR; SOT-23-6

Connections:
SYS_2d0e5b2e__CH0_QUIESCENT_OK: U50420.4 (Y); also elsewhere on the board
SYS_4f66f129__MON_VREF: R50400.1; also elsewhere on the board
SYS_20eba8c2__CH1_QUIESCENT_OK: U50421.4 (Y); also elsewhere on the board
SYS_56ebc071__CH0_MON_PERMIT: U51009.6 (C); also elsewhere on the board
SYS_66aba95b__SUP_5: C50400.1, C50401.1, C50410.1, C50411.1, U50400.5 (V+), U50401.5 (V+), U50410.8 (VCC), U50411.8 (VCC); also elsewhere on the board
SYS_502efdd4__CH1_I_MON: U50411.2 (IN1-), U50411.5 (IN2+); also elsewhere on the board
SYS_56562df4__GND: C50400.2, C50401.2, C50410.2, C50411.2, C50420.2, C50421.2, C50430.2, C50431.2, C51009.2, C51010.2, R50402.2, U50400.2 (V-), U50401.2 (V-), U50410.4 (GND), U50411.4 (GND), U50420.3 (GND), U50421.3 (GND), U51009.2 (GND), U51010.2 (GND); also elsewhere on the board
SYS_aa321af6__CH1_MON_PERMIT: U51010.6 (C); also elsewhere on the board
SYS_ab932142__SUP_3V3: C50430.1, C50431.1, C51009.1, C51010.1, U50420.5 (VCC), U50421.5 (VCC), U51009.5 (VCC), U51010.5 (VCC); also elsewhere on the board
SYS_f8e43b73__CH0_I_MON: U50410.2 (IN1-), U50410.5 (IN2+); also elsewhere on the board
supervision__CH0_QUIET_DIS: D50410.1 (K), R50420.1
supervision__CH0_QUIET_HI_OK: U50410.1 (OUT1), U51009.1 (A)
supervision__CH0_QUIET_LO_OK: U50410.7 (OUT2), U51009.3 (B)
supervision__CH0_QUIET_RAW: R50410.1, R50420.2, U51009.4 (Y)
supervision__CH0_QUIET_RC: C50420.1, D50410.2 (A), R50410.2, U50420.2 (A)
supervision__CH1_QUIET_DIS: D50411.1 (K), R50421.1
supervision__CH1_QUIET_HI_OK: U50411.1 (OUT1), U51010.1 (A)
supervision__CH1_QUIET_LO_OK: U50411.7 (OUT2), U51010.3 (B)
supervision__CH1_QUIET_RAW: R50411.1, R50421.2, U51010.4 (Y)
supervision__CH1_QUIET_RC: C50421.1, D50411.2 (A), R50411.2, U50421.2 (A)
supervision__QUIET_HI: U50400.3 (IN-), U50400.4 (OUT), U50410.3 (IN1+), U50411.3 (IN1+)
supervision__QUIET_HI_DIV: R50400.2, R50401.1, U50400.1 (IN+)
supervision__QUIET_LO: U50401.3 (IN-), U50401.4 (OUT), U50410.6 (IN2-), U50411.6 (IN2-)
supervision__QUIET_LO_DIV: R50401.2, R50402.1, U50401.1 (IN+)

Notes on the sheet:
DIGITAL SCCI ENGINEERING / ARTIFICIAL LOADS / NATIVE INDEPENDENT SUPERVISION
18 guarded stimulation conductors, 17 measured RHD-side windows; conditional healthy-switch blanking is not proven isolation.
All net labels are native electrical connections. Actual physical delay, leakage, failed switches and shared supplies remain bounded limitations.
Independent phase cap, heartbeat watchdog, rail windows and deliberate rearm have different functions. No automatic retry or reverse pulse.
