pratham-cloud-ctrl/Project-SCCI-RH/electronics/stage4/integrated-pcb/boards/supervision/supervision.kicad_pcb

## KiCad design electronics/stage4/integrated-pcb/boards/supervision/supervision.kicad_pcb (continued)

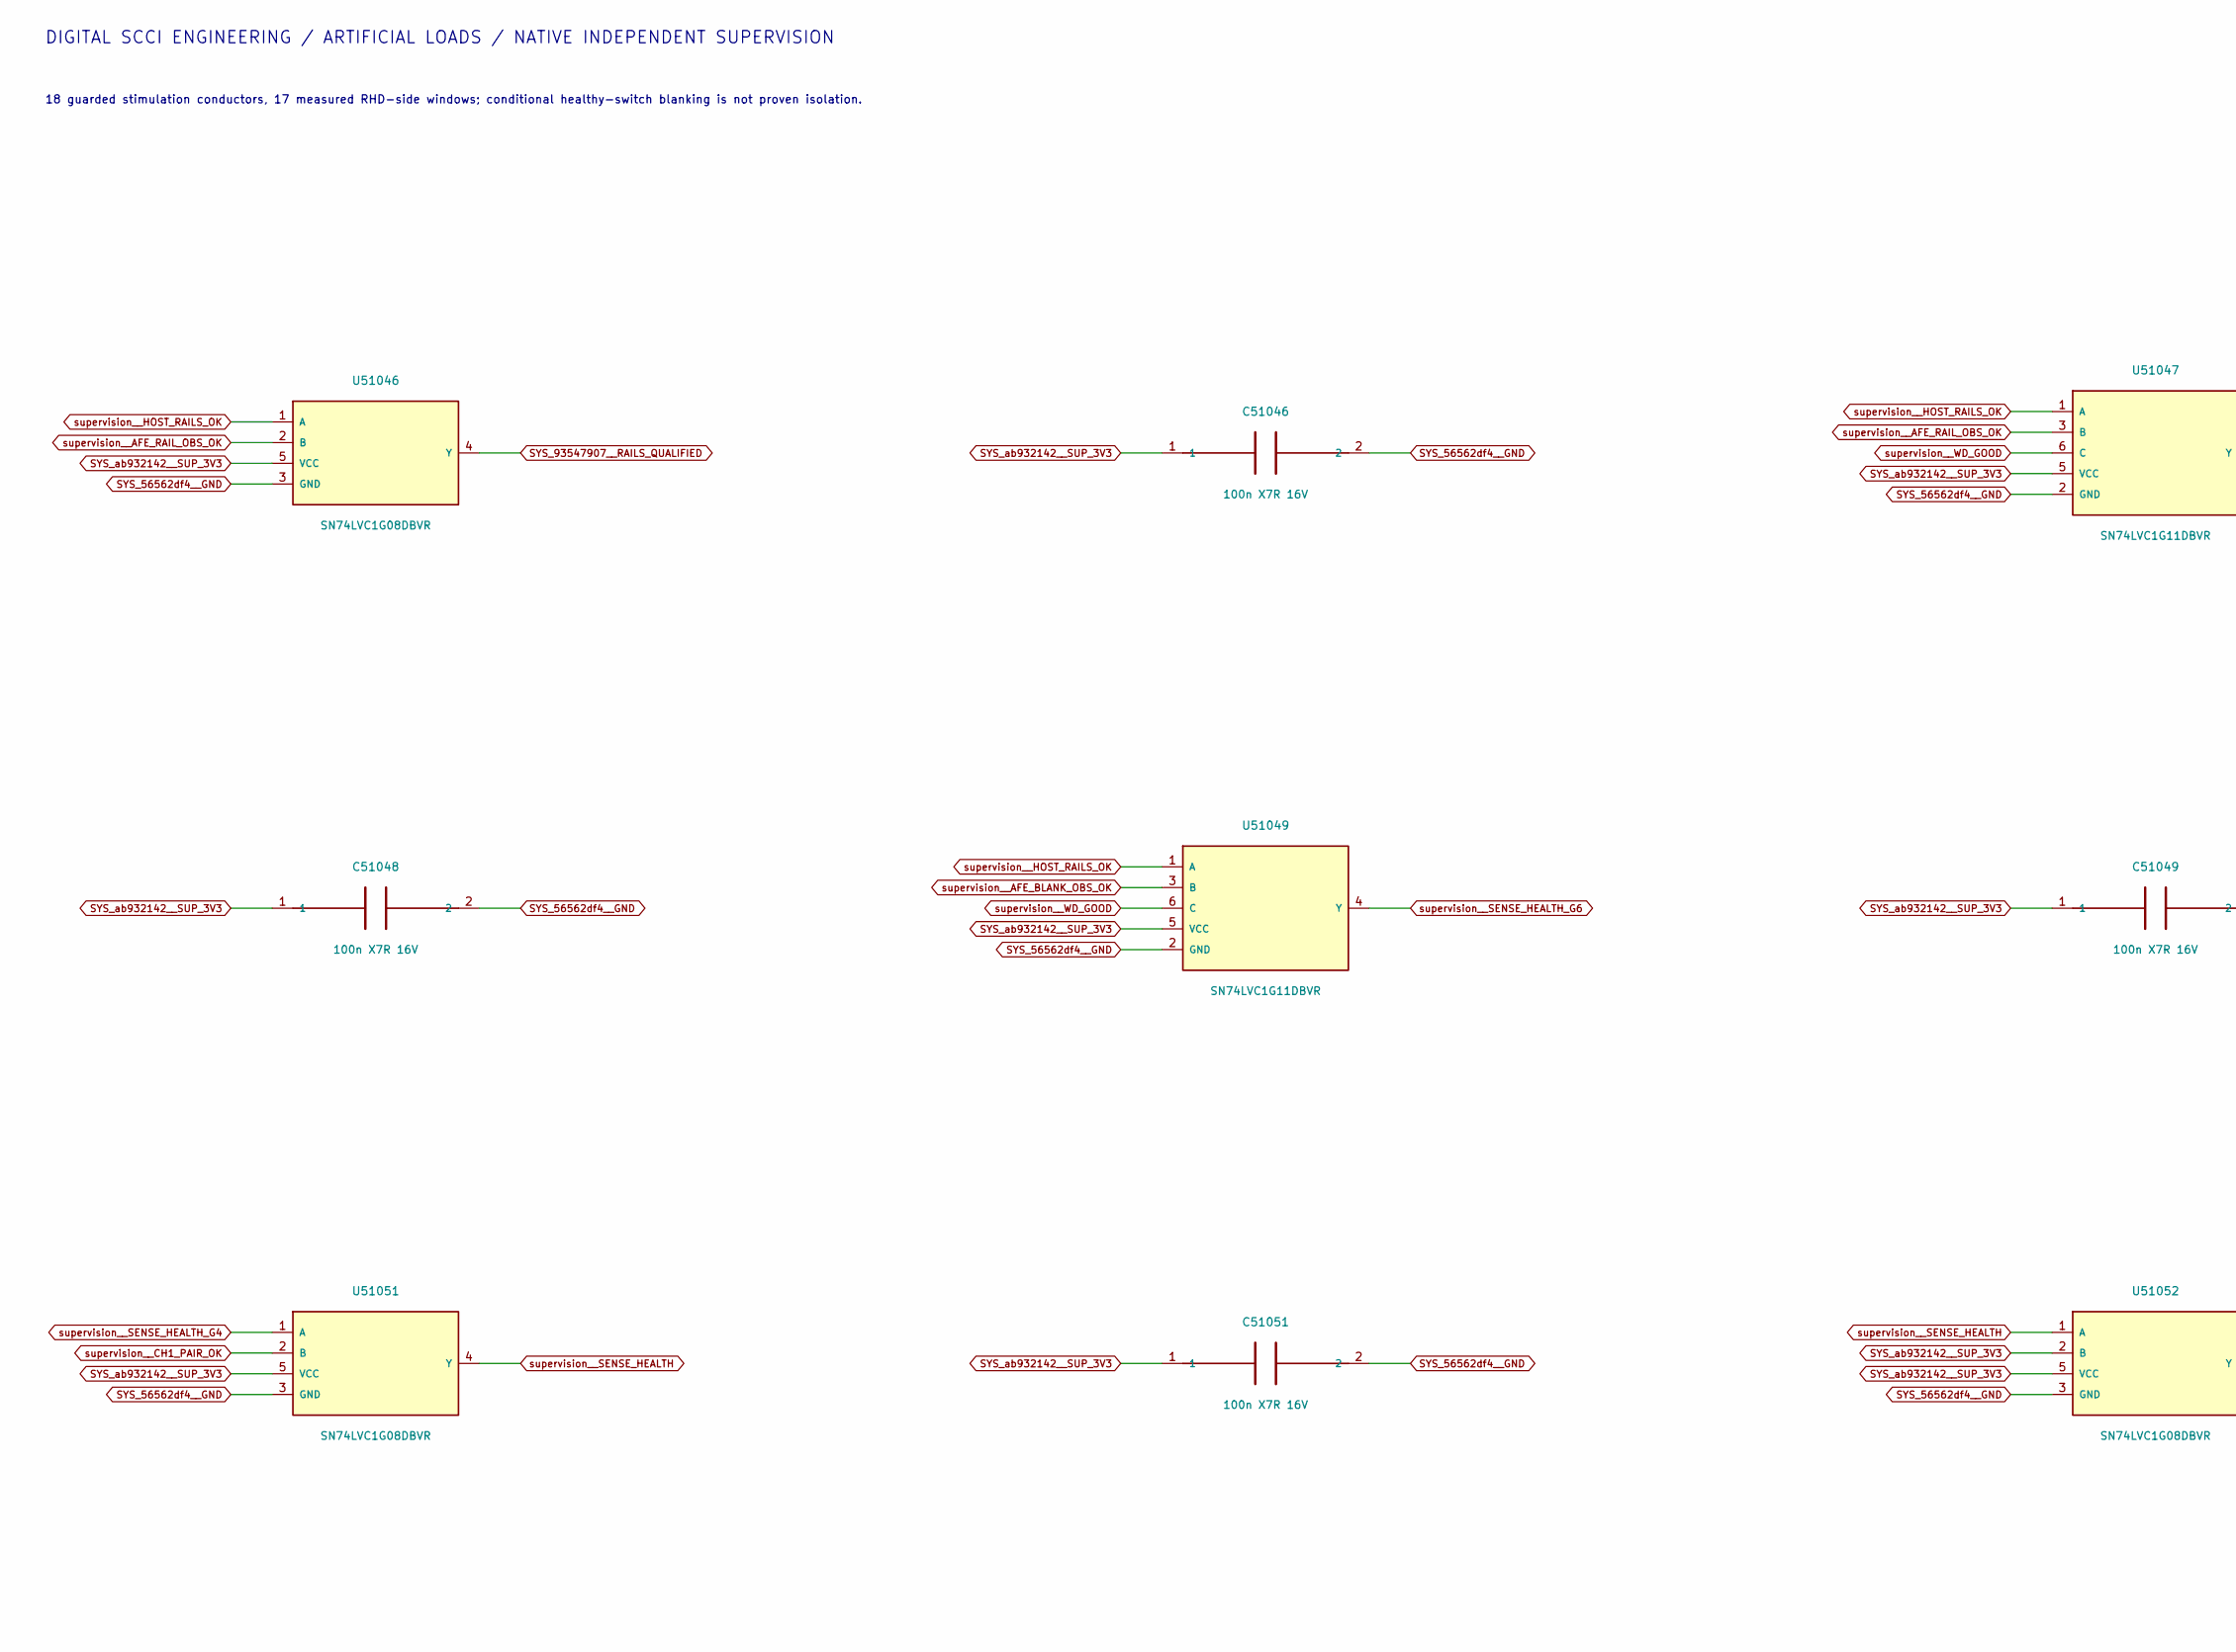
[picture p260: schematic admission.kicad_sch, Project SCCI RH S4 / Sticky permission and rearm, part in row 1, column 1]

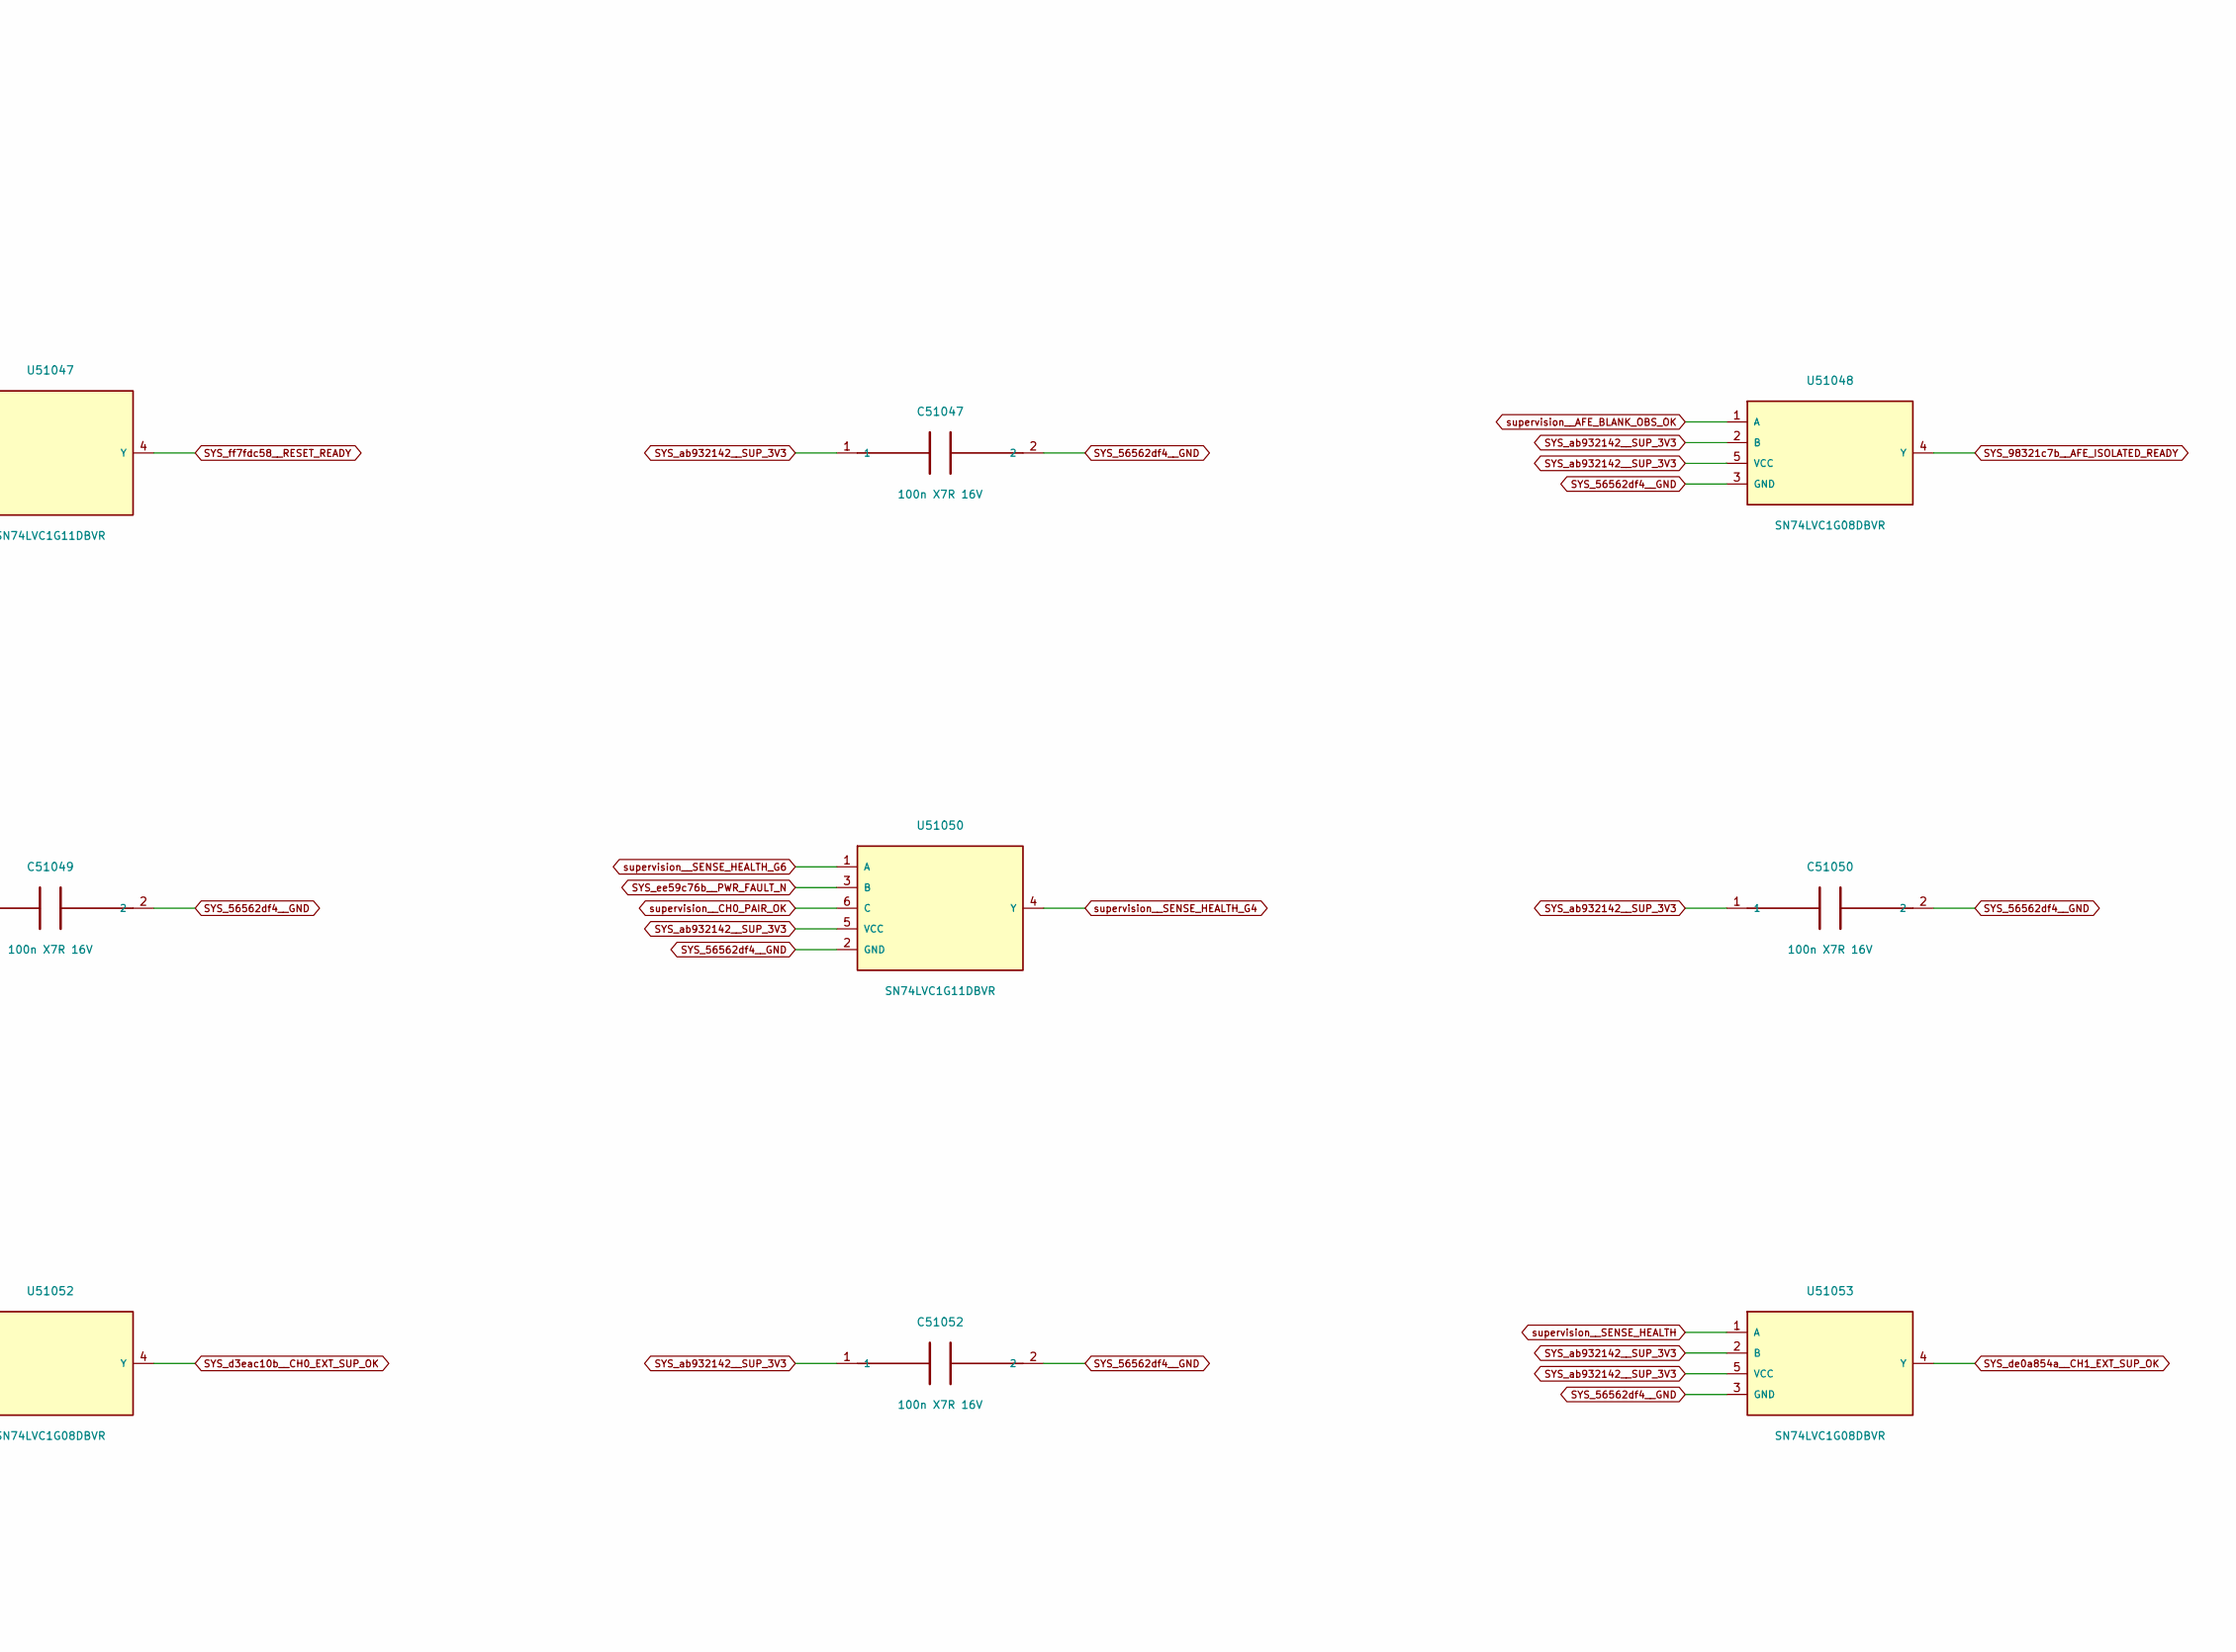
[picture p261: schematic admission.kicad_sch, Project SCCI RH S4 / Sticky permission and rearm, part in row 1, column 2]

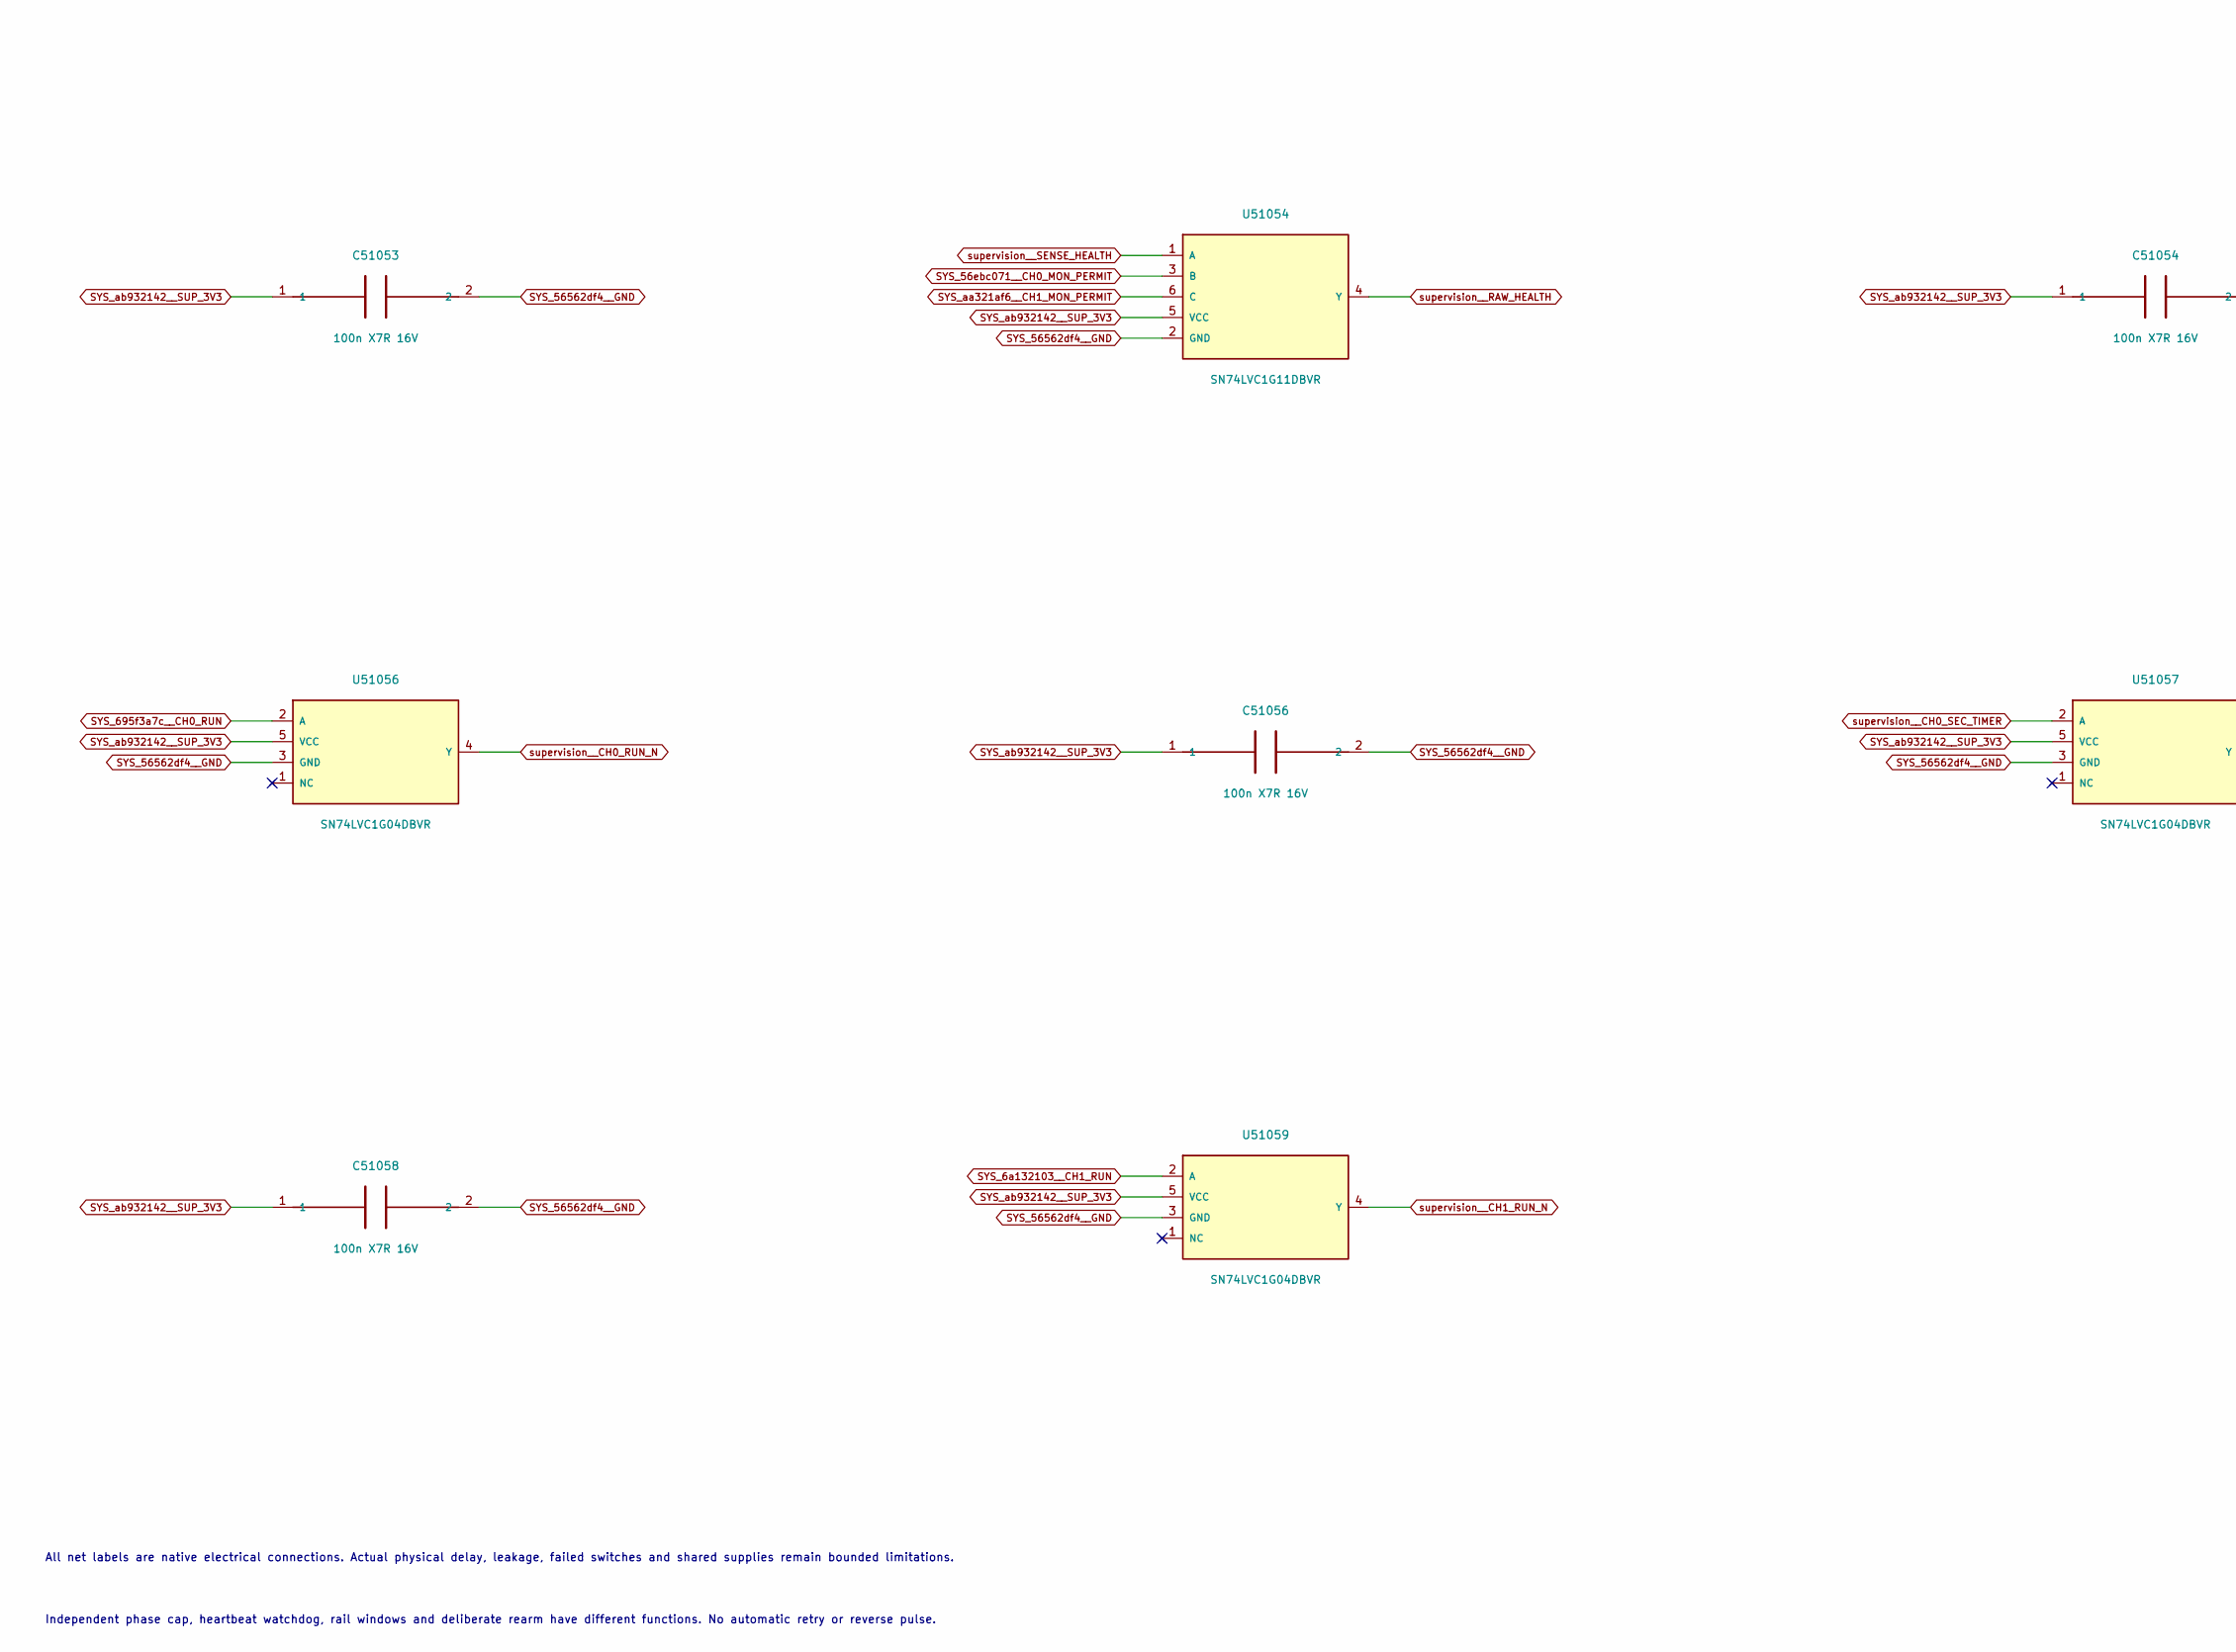
[picture p262: schematic admission.kicad_sch, Project SCCI RH S4 / Sticky permission and rearm, part in row 2, column 1]

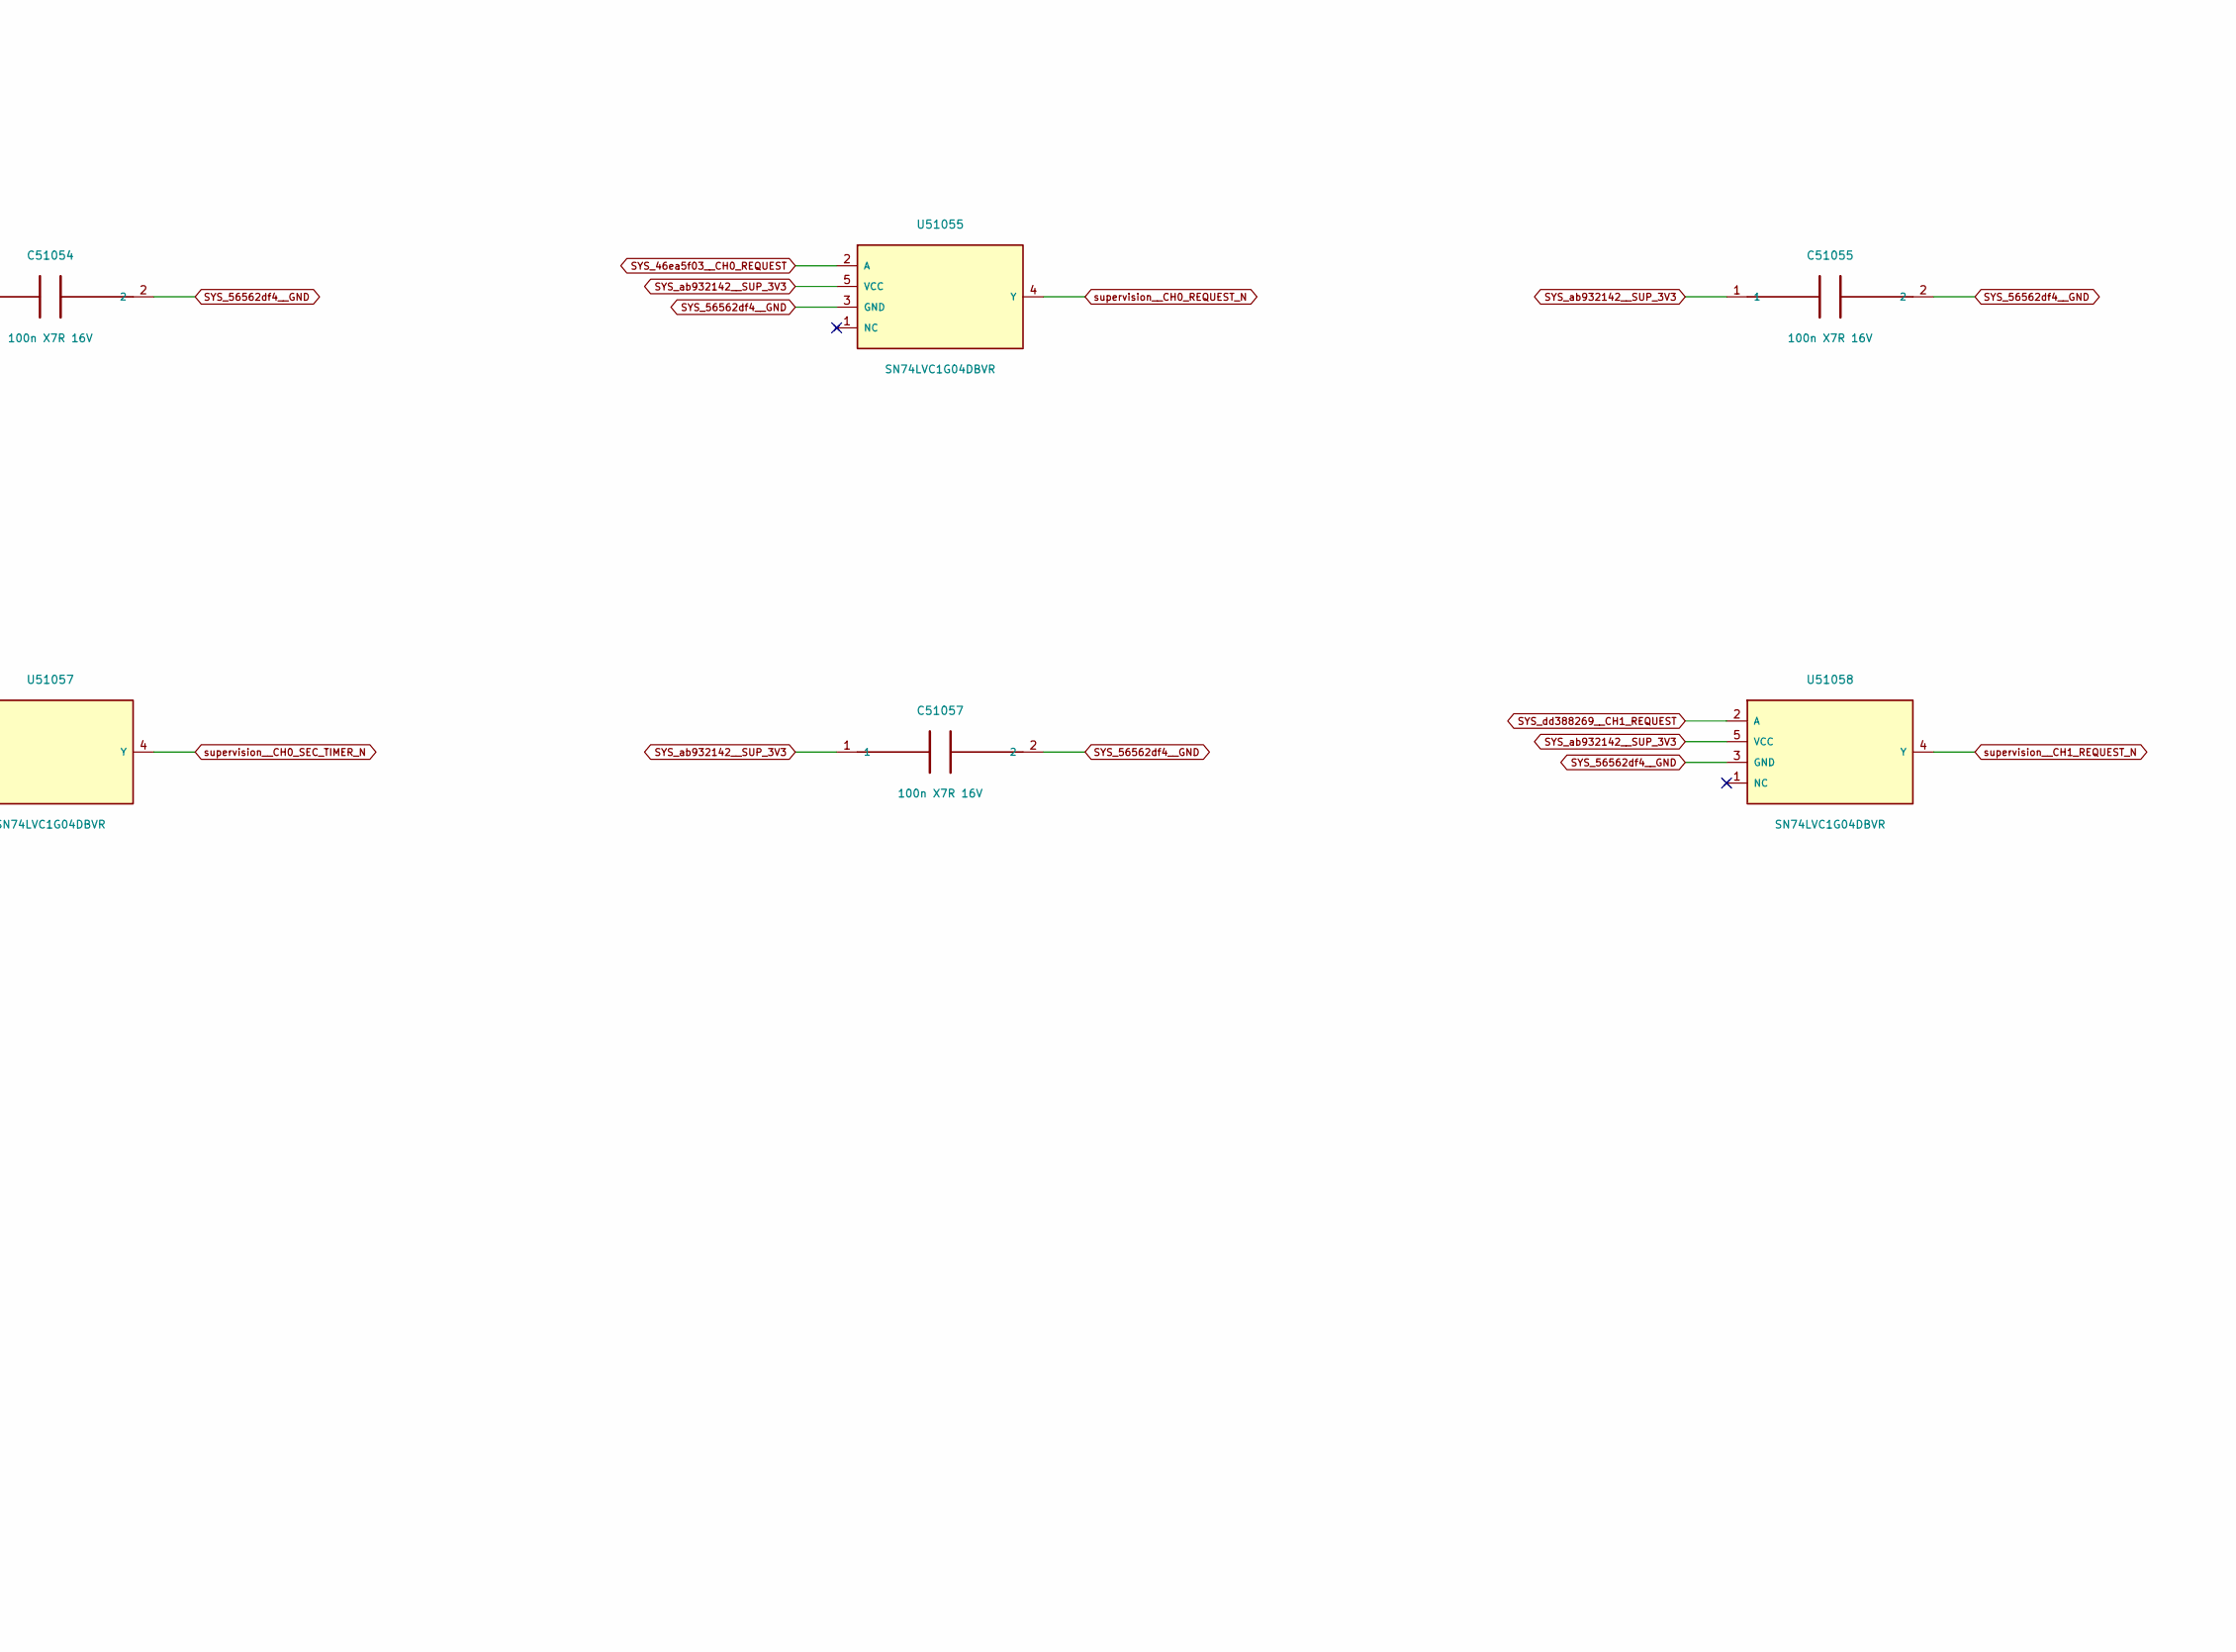
[picture p263: schematic admission.kicad_sch, Project SCCI RH S4 / Sticky permission and rearm, part in row 2, column 2]

Parts:
C51046, C51047, C51048, C51049, C51050, C51051, C51052, C51053, C51054, C51055, C51056, C51057, C51058: 100n X7R 16V; C_0805_2012Metric
U51046, U51048, U51051, U51052, U51053: SN74LVC1G08DBVR; SOT-23-5
U51047, U51049, U51050, U51054: SN74LVC1G11DBVR; SOT-23-6
U51055, U51056, U51057, U51058, U51059: SN74LVC1G04DBVR; SOT-23-5

Connections:
SYS_6a132103__CH1_RUN: U51059.2 (A); also elsewhere on the board
SYS_46ea5f03__CH0_REQUEST: U51055.2 (A); also elsewhere on the board
SYS_56ebc071__CH0_MON_PERMIT: U51054.3 (B); also elsewhere on the board
SYS_695f3a7c__CH0_RUN: U51056.2 (A); also elsewhere on the board
SYS_56562df4__GND: C51046.2, C51047.2, C51048.2, C51049.2, C51050.2, C51051.2, C51052.2, C51053.2, C51054.2, C51055.2, C51056.2, C51057.2, C51058.2, U51046.3 (GND), U51047.2 (GND), U51048.3 (GND), U51049.2 (GND), U51050.2 (GND), U51051.3 (GND), U51052.3 (GND), U51053.3 (GND), U51054.2 (GND), U51055.3 (GND), U51056.3 (GND), U51057.3 (GND), U51058.3 (GND), U51059.3 (GND); also elsewhere on the board
SYS_98321c7b__AFE_ISOLATED_READY: U51048.4 (Y); also elsewhere on the board
SYS_93547907__RAILS_QUALIFIED: U51046.4 (Y); also elsewhere on the board
SYS_aa321af6__CH1_MON_PERMIT: U51054.6 (C); also elsewhere on the board
SYS_ab932142__SUP_3V3: C51046.1, C51047.1, C51048.1, C51049.1, C51050.1, C51051.1, C51052.1, C51053.1, C51054.1, C51055.1, C51056.1, C51057.1, C51058.1, U51046.5 (VCC), U51047.5 (VCC), U51048.2 (B), U51048.5 (VCC), U51049.5 (VCC), U51050.5 (VCC), U51051.5 (VCC), U51052.2 (B), U51052.5 (VCC), U51053.2 (B), U51053.5 (VCC), U51054.5 (VCC), U51055.5 (VCC), U51056.5 (VCC), U51057.5 (VCC), U51058.5 (VCC), U51059.5 (VCC); also elsewhere on the board
SYS_d3eac10b__CH0_EXT_SUP_OK: U51052.4 (Y); also elsewhere on the board
SYS_dd388269__CH1_REQUEST: U51058.2 (A); also elsewhere on the board
SYS_de0a854a__CH1_EXT_SUP_OK: U51053.4 (Y); also elsewhere on the board
SYS_ee59c76b__PWR_FAULT_N: U51050.3 (B); also elsewhere on the board
SYS_ff7fdc58__RESET_READY: U51047.4 (Y); also elsewhere on the board
supervision__AFE_BLANK_OBS_OK: U51048.1 (A), U51049.3 (B); also elsewhere on the board
supervision__AFE_RAIL_OBS_OK: U51046.2 (B), U51047.3 (B); also elsewhere on the board
supervision__CH0_PAIR_OK: U51050.6 (C); also elsewhere on the board
supervision__CH0_REQUEST_N: U51055.4 (Y); also elsewhere on the board
supervision__CH0_RUN_N: U51056.4 (Y); also elsewhere on the board
supervision__CH0_SEC_TIMER: U51057.2 (A); also elsewhere on the board
supervision__CH0_SEC_TIMER_N: U51057.4 (Y); also elsewhere on the board
supervision__CH1_PAIR_OK: U51051.2 (B); also elsewhere on the board
supervision__CH1_REQUEST_N: U51058.4 (Y); also elsewhere on the board
supervision__CH1_RUN_N: U51059.4 (Y); also elsewhere on the board
supervision__HOST_RAILS_OK: U51046.1 (A), U51047.1 (A), U51049.1 (A); also elsewhere on the board
supervision__RAW_HEALTH: U51054.4 (Y); also elsewhere on the board
supervision__SENSE_HEALTH: U51051.4 (Y), U51052.1 (A), U51053.1 (A), U51054.1 (A)
supervision__SENSE_HEALTH_G4: U51050.4 (Y), U51051.1 (A)
supervision__SENSE_HEALTH_G6: U51049.4 (Y), U51050.1 (A)
supervision__WD_GOOD: U51047.6 (C), U51049.6 (C); also elsewhere on the board

Notes on the sheet:
DIGITAL SCCI ENGINEERING / ARTIFICIAL LOADS / NATIVE INDEPENDENT SUPERVISION
18 guarded stimulation conductors, 17 measured RHD-side windows; conditional healthy-switch blanking is not proven isolation.
All net labels are native electrical connections. Actual physical delay, leakage, failed switches and shared supplies remain bounded limitations.
Independent phase cap, heartbeat watchdog, rail windows and deliberate rearm have different functions. No automatic retry or reverse pulse.
