pratham-cloud-ctrl/Project-SCCI-RH/electronics/stage4/integrated-pcb/boards/supervision/supervision.kicad_pcb

## KiCad design electronics/stage4/integrated-pcb/boards/supervision/supervision.kicad_pcb (continued)

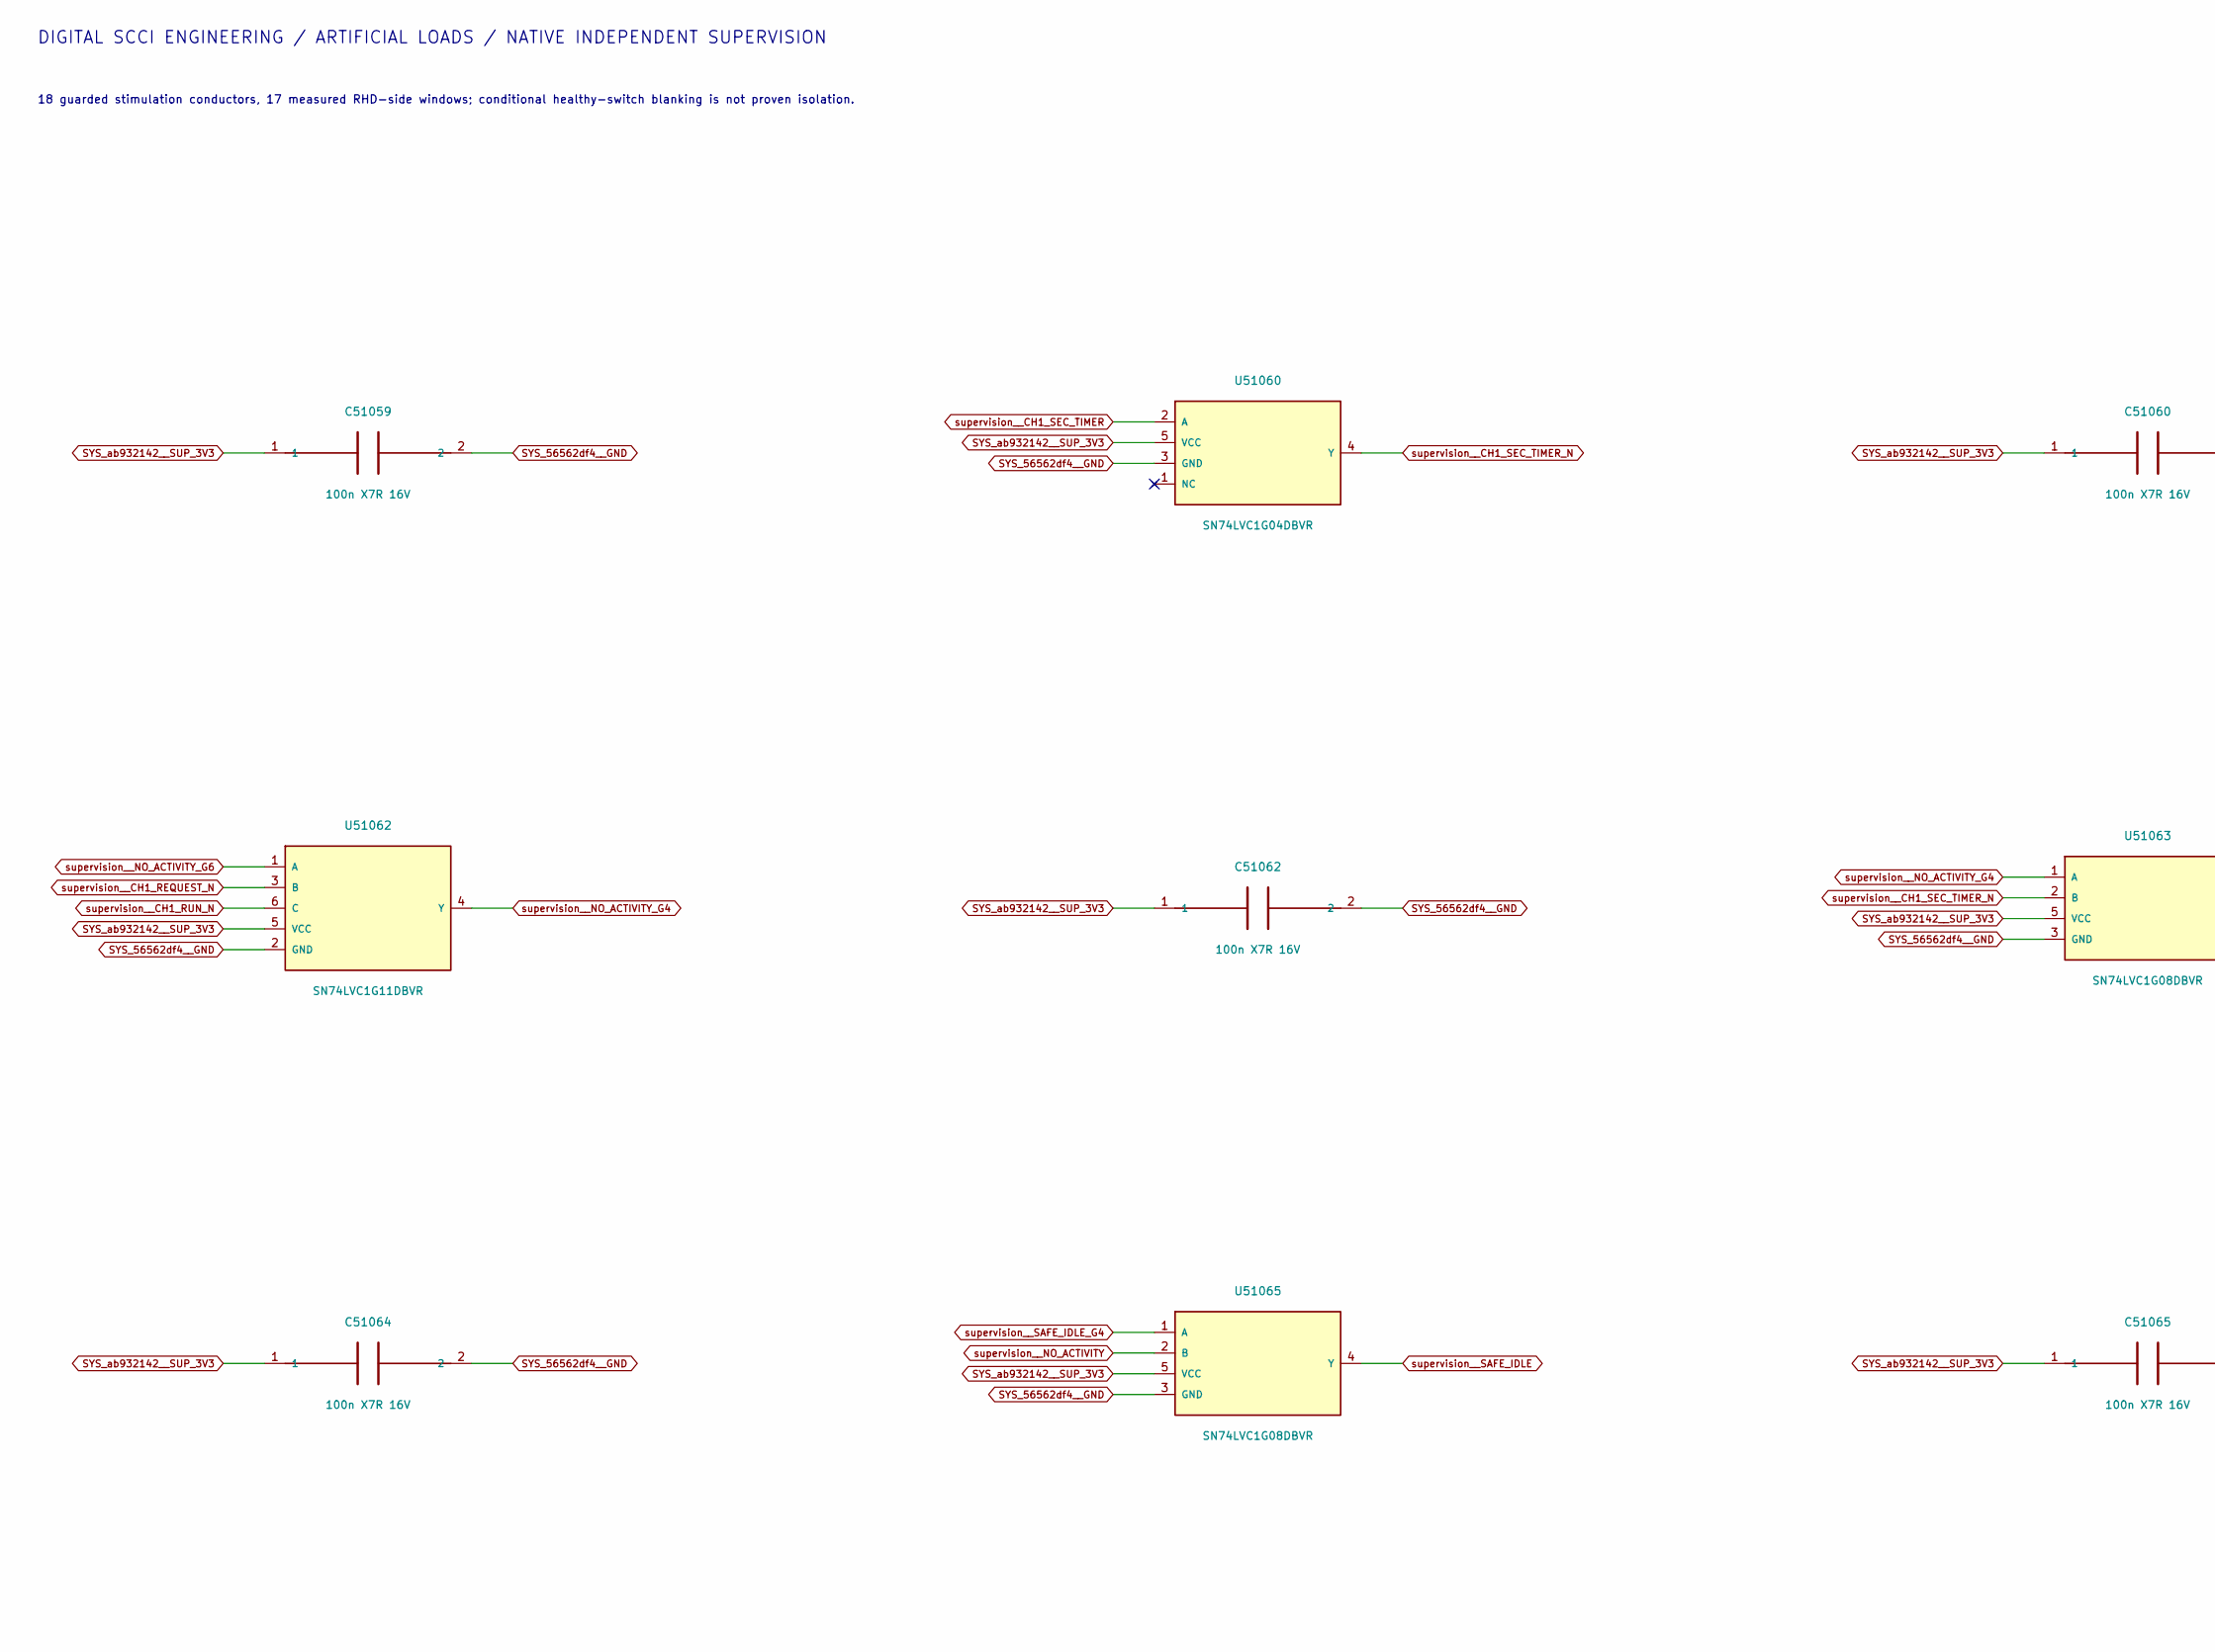
[picture p264: schematic admission_2.kicad_sch, Project SCCI RH S4 / Sticky permission and rearm / 2, part in row 1, column 1]

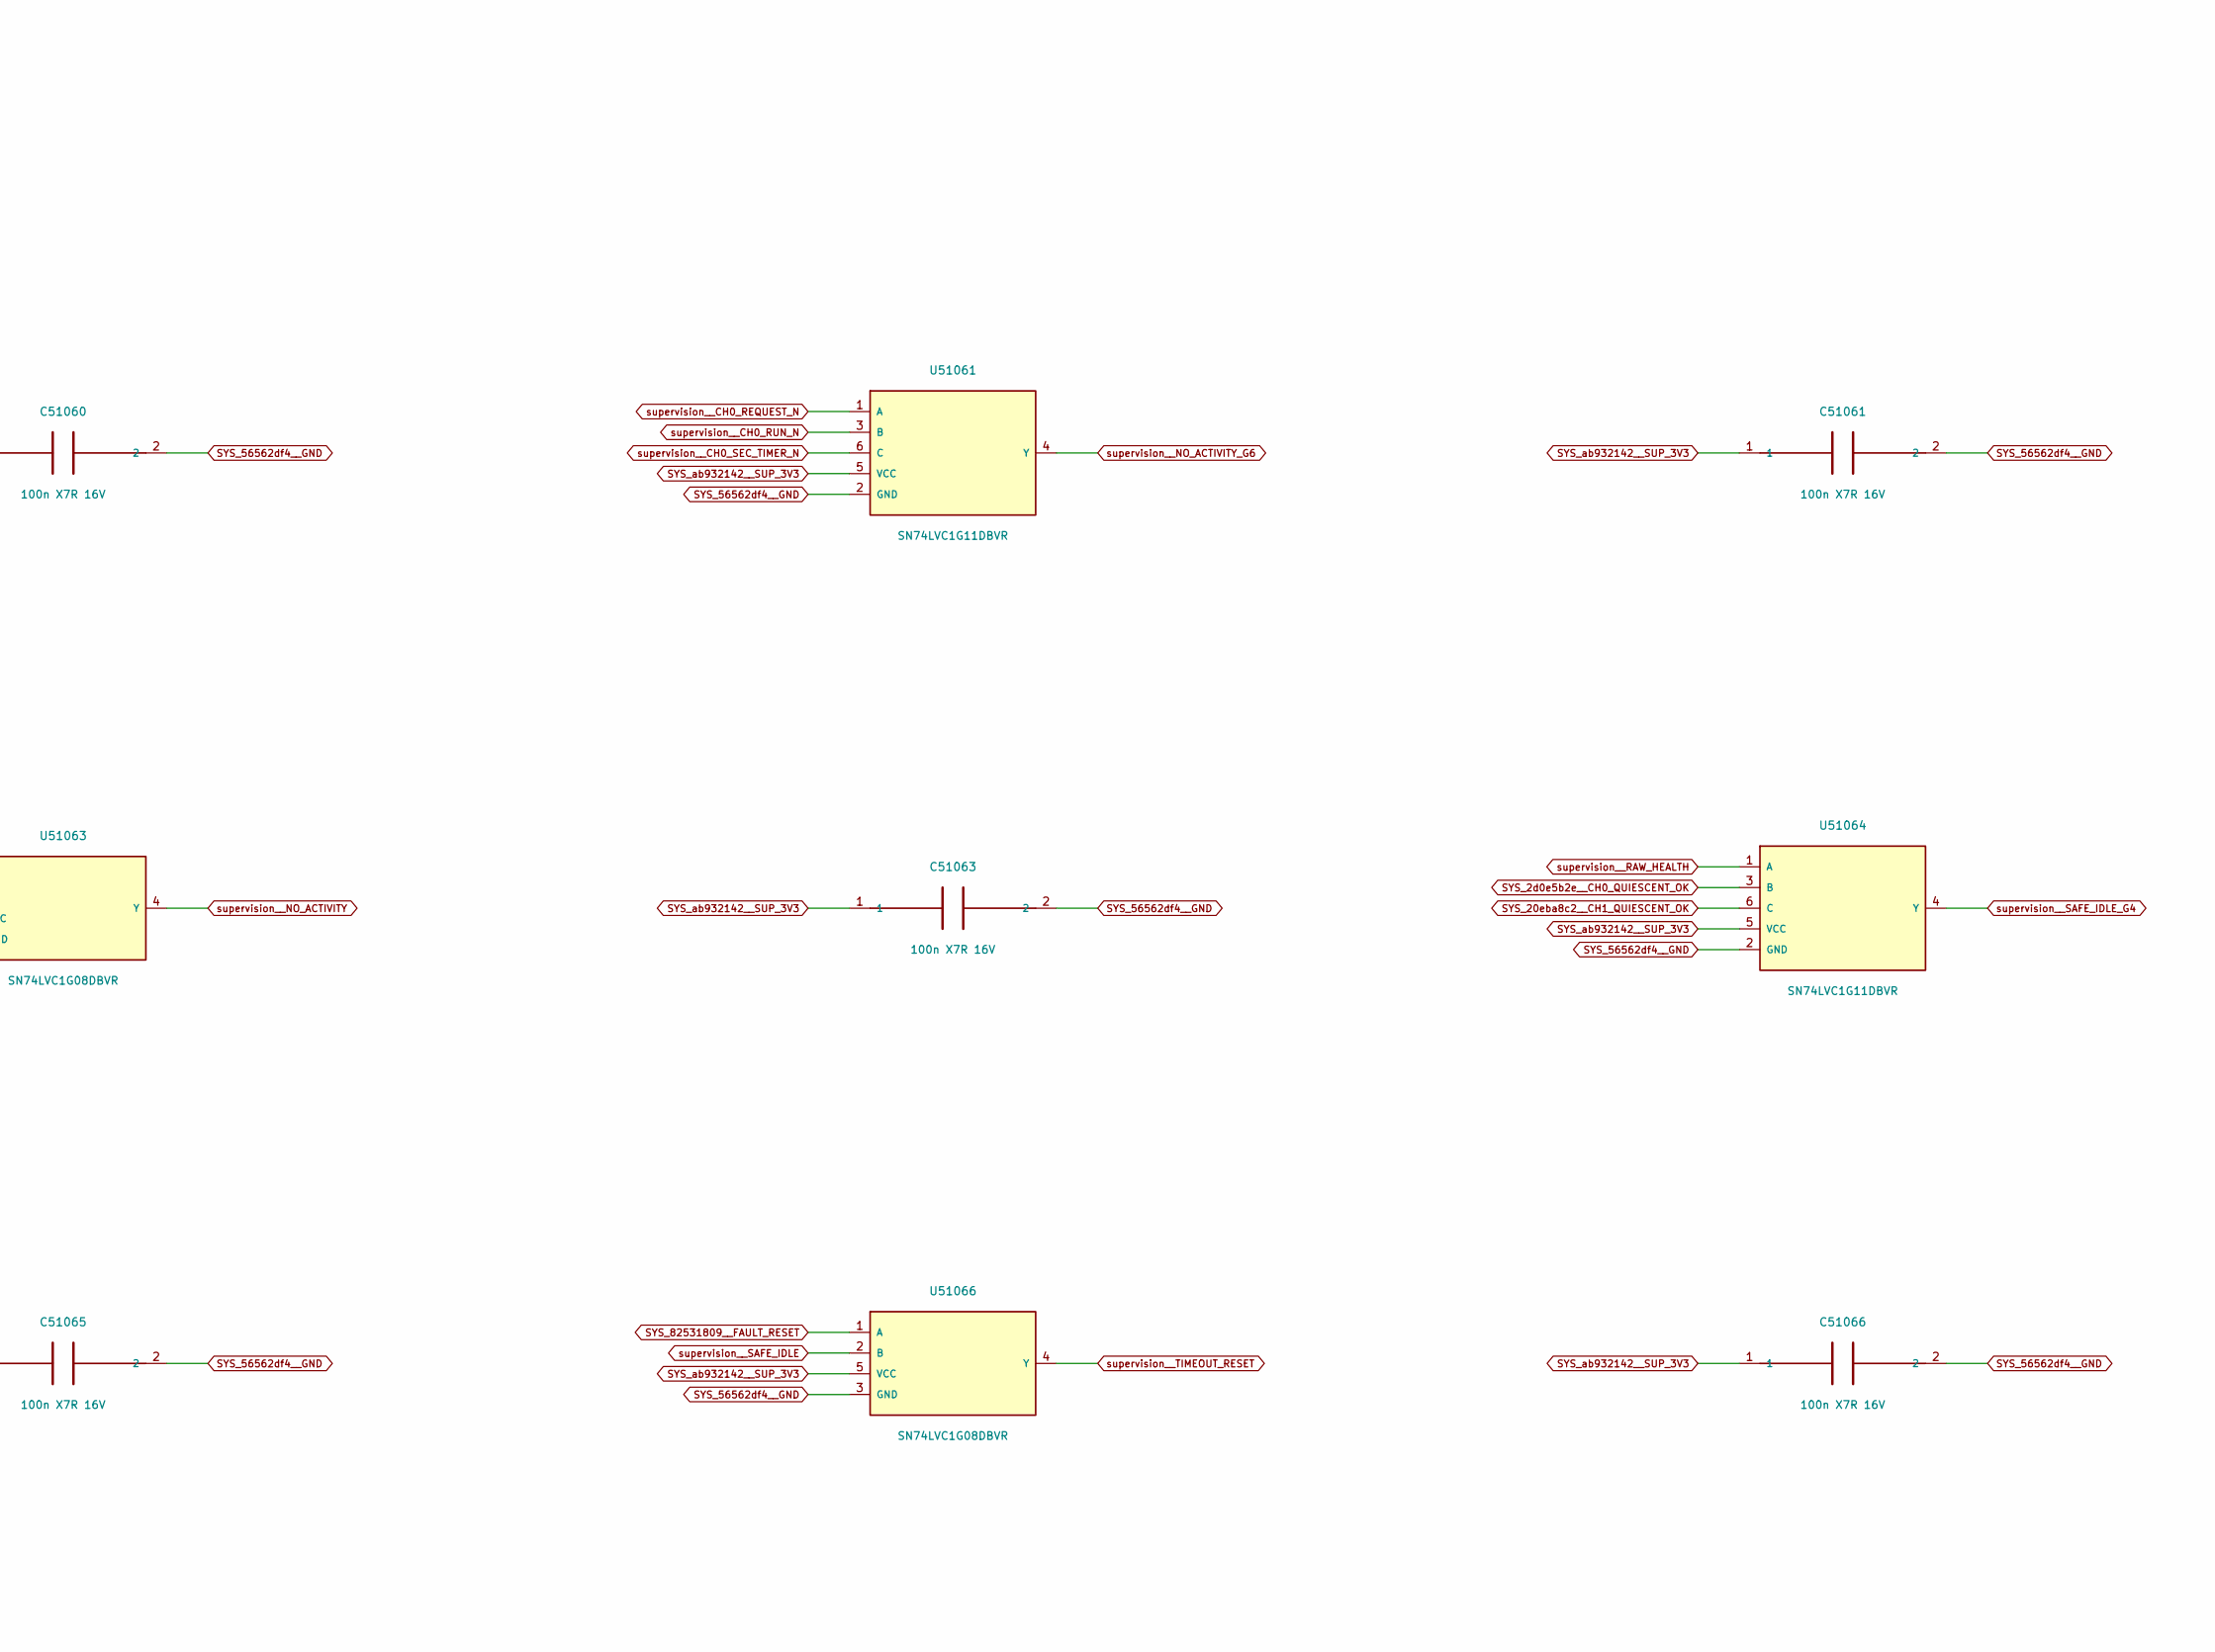
[picture p265: schematic admission_2.kicad_sch, Project SCCI RH S4 / Sticky permission and rearm / 2, part in row 1, column 2]

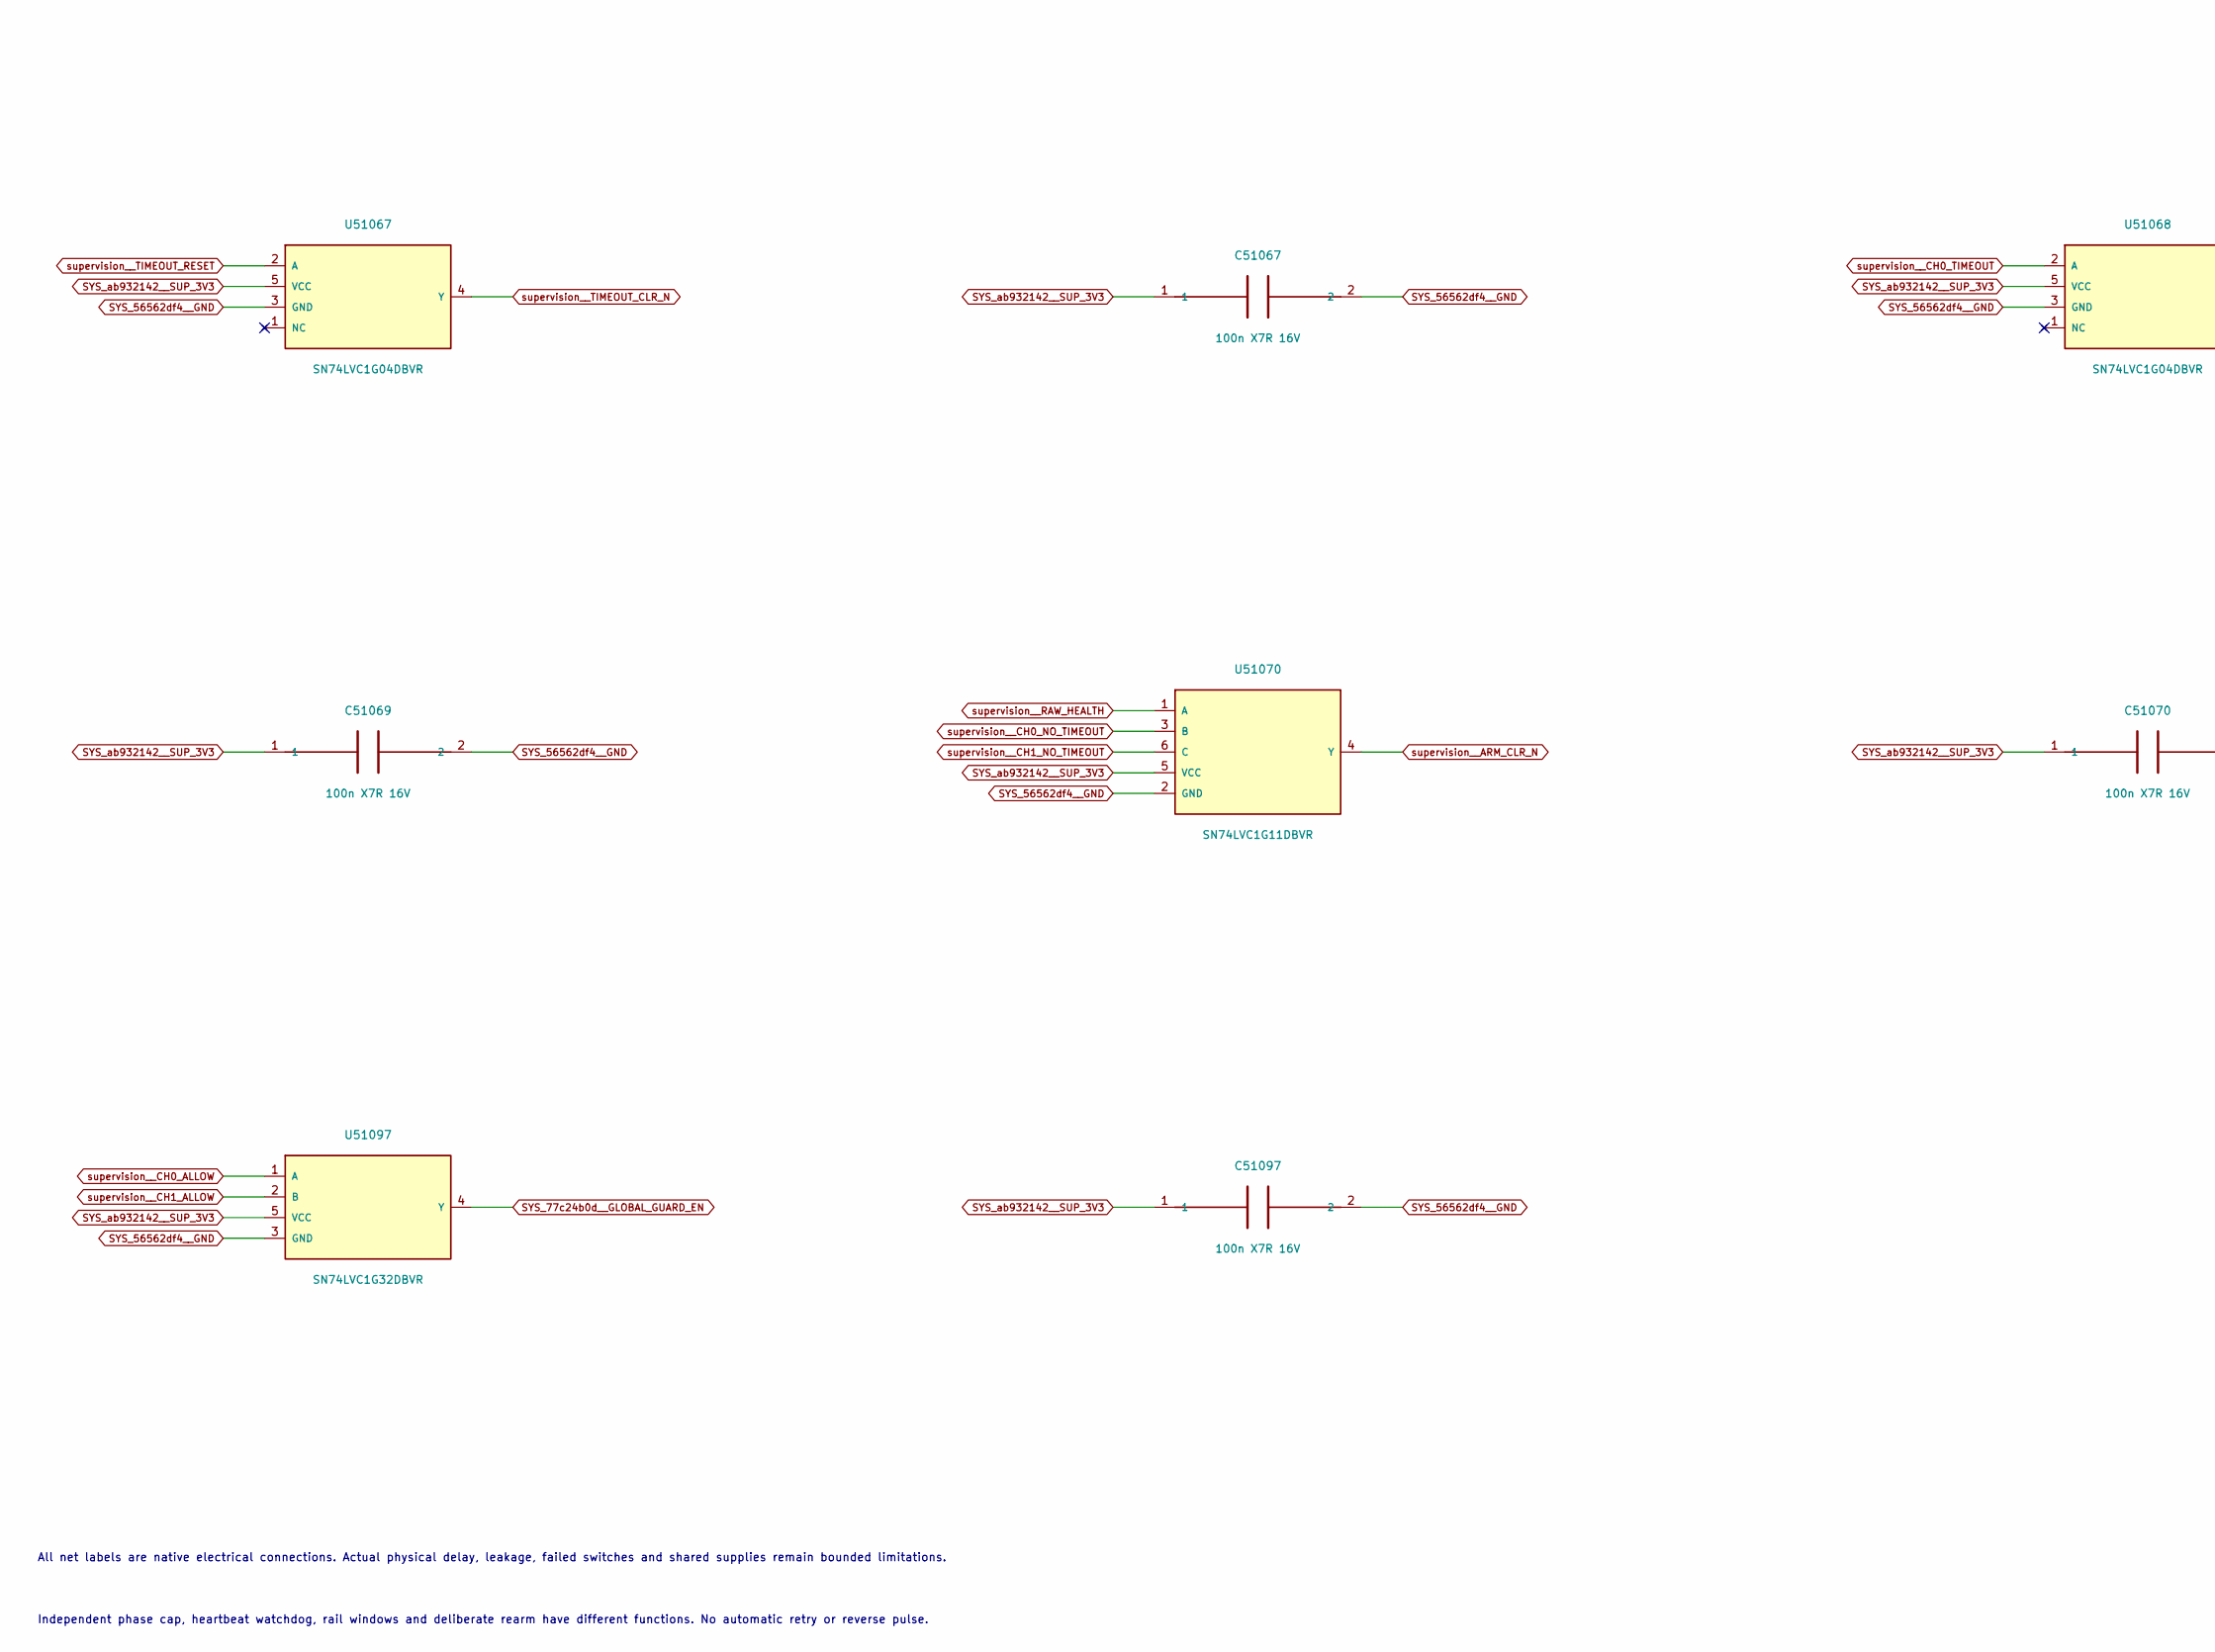
[picture p266: schematic admission_2.kicad_sch, Project SCCI RH S4 / Sticky permission and rearm / 2, part in row 2, column 1]

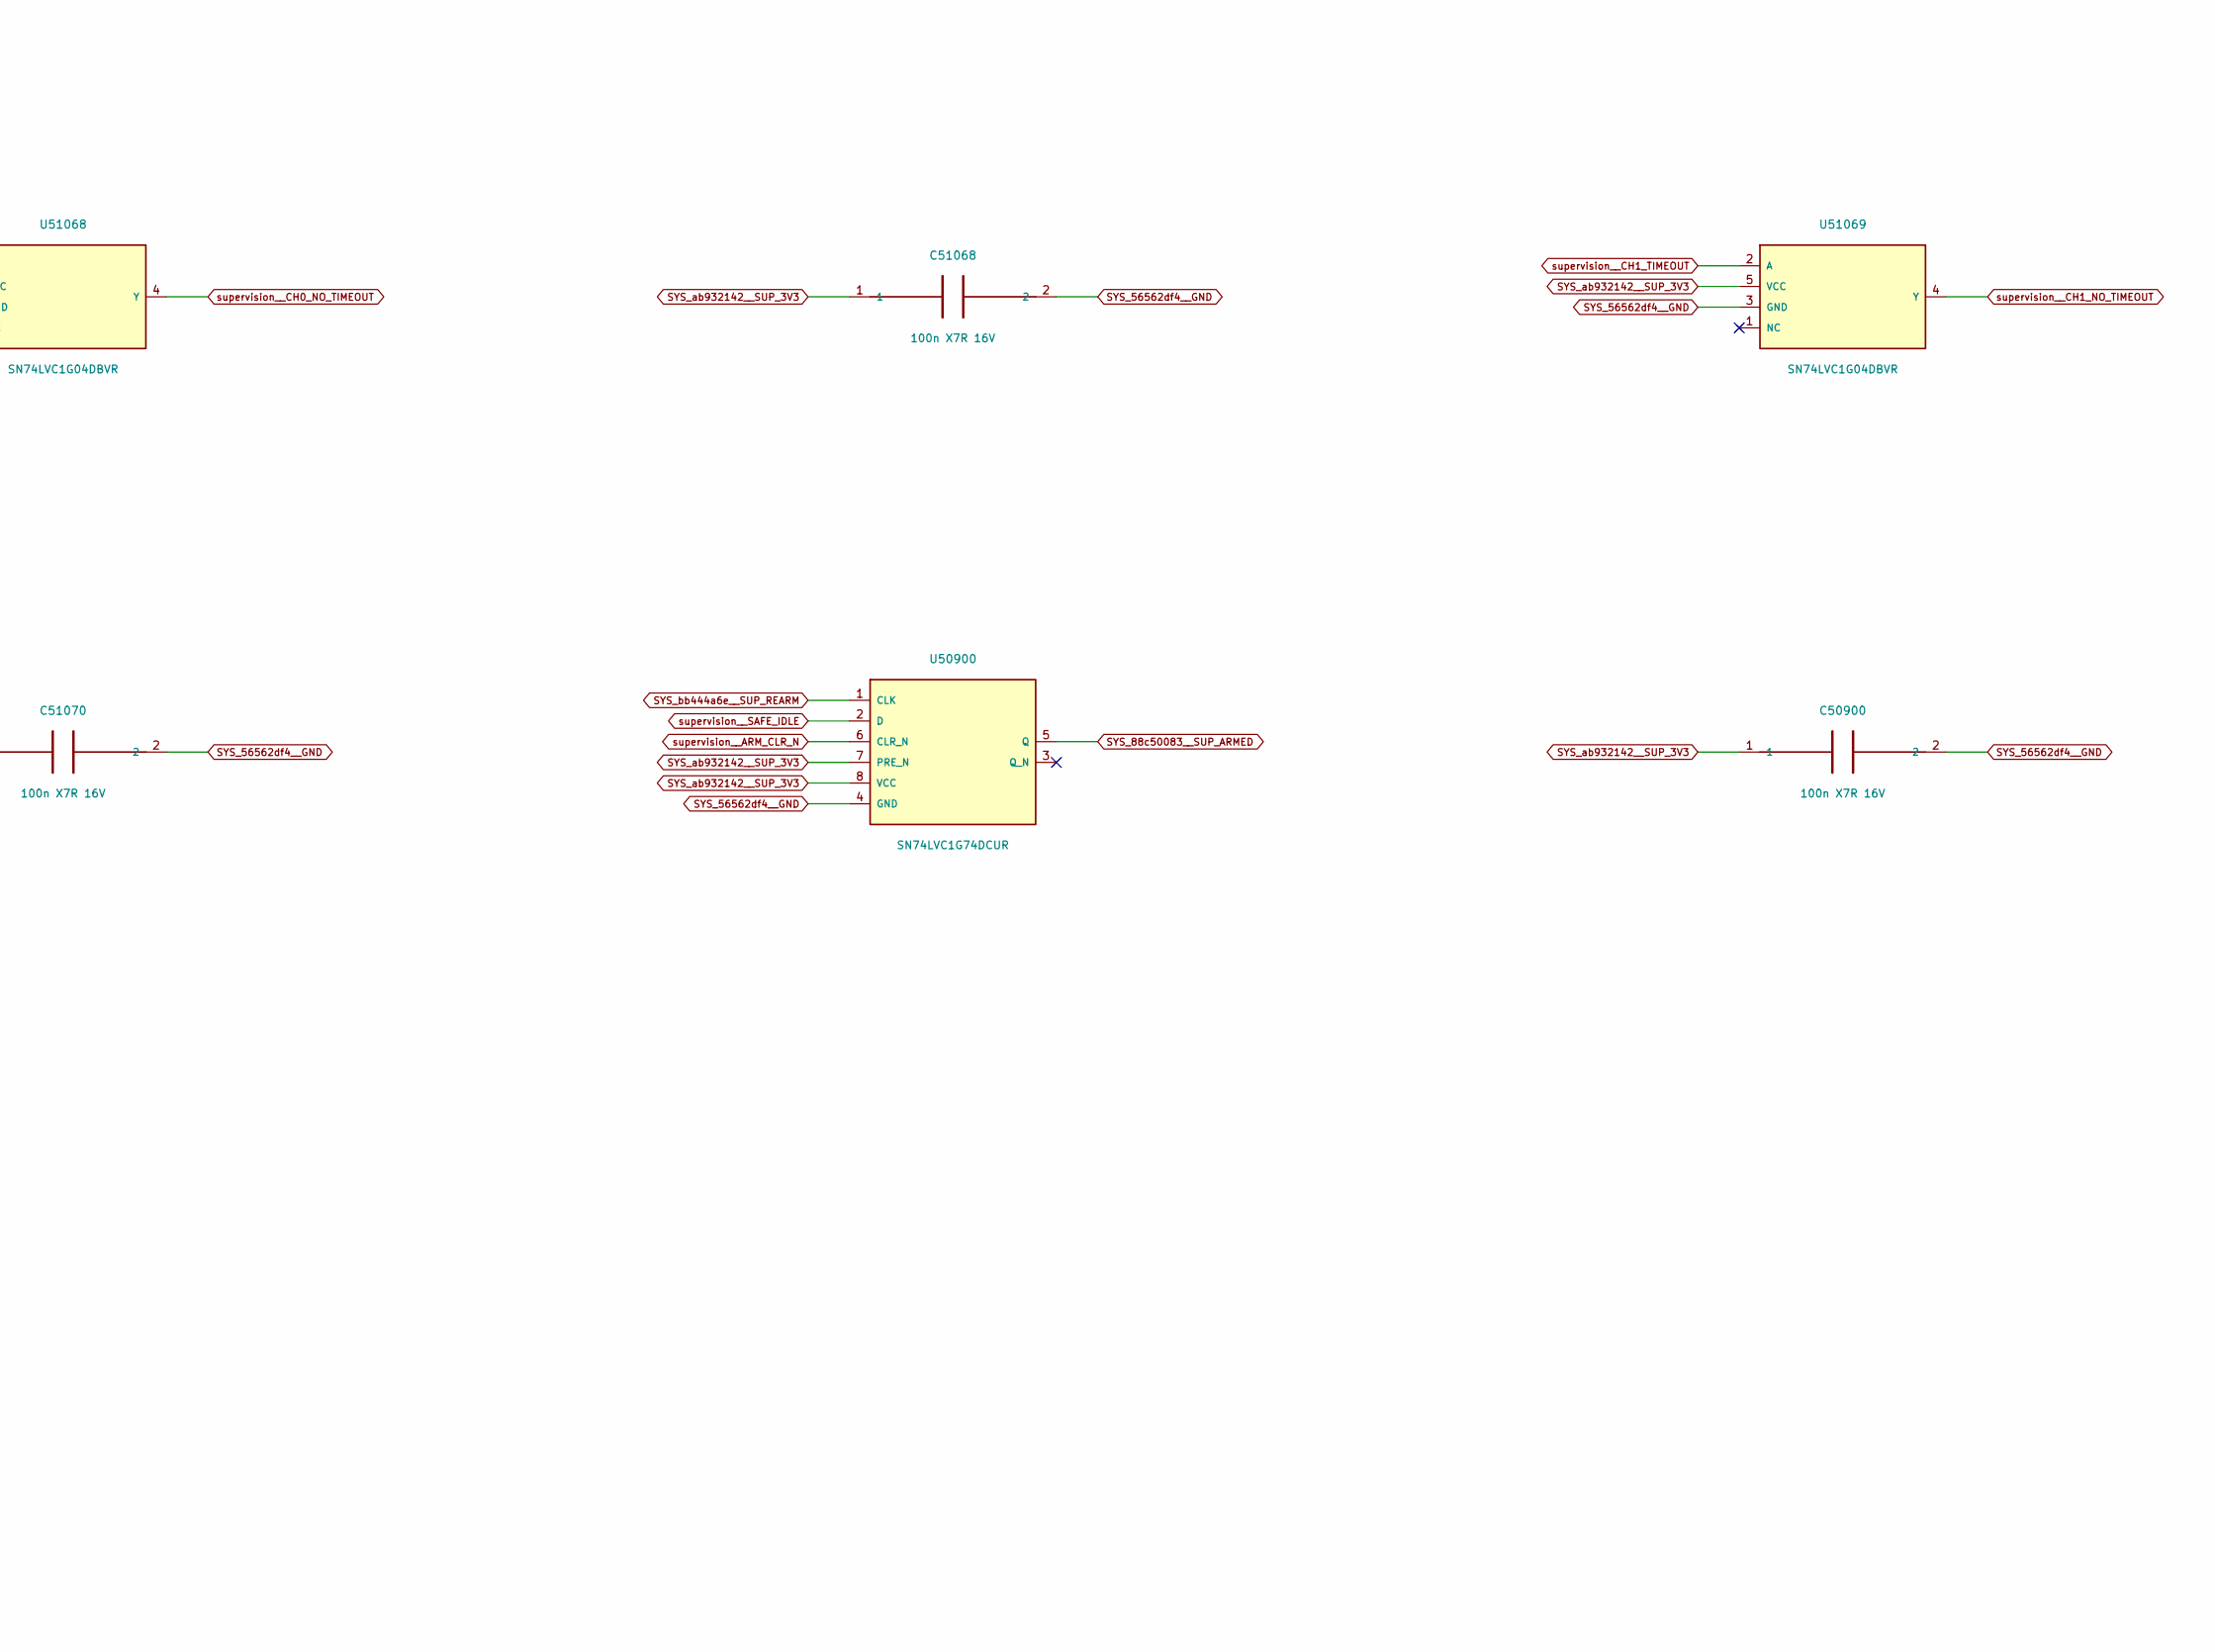
[picture p267: schematic admission_2.kicad_sch, Project SCCI RH S4 / Sticky permission and rearm / 2, part in row 2, column 2]

Parts:
C50900, C51059, C51060, C51061, C51062, C51063, C51064, C51065, C51066, C51067, C51068, C51069, C51070, C51097: 100n X7R 16V; C_0805_2012Metric
U50900: SN74LVC1G74DCUR; VSSOP-8_2.3x2mm_P0.5mm
U51060, U51067, U51068, U51069: SN74LVC1G04DBVR; SOT-23-5
U51061, U51062, U51064, U51070: SN74LVC1G11DBVR; SOT-23-6
U51063, U51065, U51066: SN74LVC1G08DBVR; SOT-23-5
U51097: SN74LVC1G32DBVR; SOT-23-5

Connections:
SYS_2d0e5b2e__CH0_QUIESCENT_OK: U51064.3 (B); also elsewhere on the board
SYS_20eba8c2__CH1_QUIESCENT_OK: U51064.6 (C); also elsewhere on the board
SYS_77c24b0d__GLOBAL_GUARD_EN: U51097.4 (Y); also elsewhere on the board
SYS_88c50083__SUP_ARMED: U50900.5 (Q); also elsewhere on the board
SYS_56562df4__GND: C50900.2, C51059.2, C51060.2, C51061.2, C51062.2, C51063.2, C51064.2, C51065.2, C51066.2, C51067.2, C51068.2, C51069.2, C51070.2, C51097.2, U50900.4 (GND), U51060.3 (GND), U51061.2 (GND), U51062.2 (GND), U51063.3 (GND), U51064.2 (GND), U51065.3 (GND), U51066.3 (GND), U51067.3 (GND), U51068.3 (GND), U51069.3 (GND), U51070.2 (GND), U51097.3 (GND); also elsewhere on the board
SYS_82531809__FAULT_RESET: U51066.1 (A); also elsewhere on the board
SYS_ab932142__SUP_3V3: C50900.1, C51059.1, C51060.1, C51061.1, C51062.1, C51063.1, C51064.1, C51065.1, C51066.1, C51067.1, C51068.1, C51069.1, C51070.1, C51097.1, U50900.7 (PRE_N), U50900.8 (VCC), U51060.5 (VCC), U51061.5 (VCC), U51062.5 (VCC), U51063.5 (VCC), U51064.5 (VCC), U51065.5 (VCC), U51066.5 (VCC), U51067.5 (VCC), U51068.5 (VCC), U51069.5 (VCC), U51070.5 (VCC), U51097.5 (VCC); also elsewhere on the board
SYS_bb444a6e__SUP_REARM: U50900.1 (CLK); also elsewhere on the board
supervision__ARM_CLR_N: U50900.6 (CLR_N), U51070.4 (Y)
supervision__CH0_ALLOW: U51097.1 (A); also elsewhere on the board
supervision__CH0_NO_TIMEOUT: U51068.4 (Y), U51070.3 (B); also elsewhere on the board
supervision__CH0_REQUEST_N: U51061.1 (A); also elsewhere on the board
supervision__CH0_RUN_N: U51061.3 (B); also elsewhere on the board
supervision__CH0_SEC_TIMER_N: U51061.6 (C); also elsewhere on the board
supervision__CH0_TIMEOUT: U51068.2 (A); also elsewhere on the board
supervision__CH1_ALLOW: U51097.2 (B); also elsewhere on the board
supervision__CH1_NO_TIMEOUT: U51069.4 (Y), U51070.6 (C); also elsewhere on the board
supervision__CH1_REQUEST_N: U51062.3 (B); also elsewhere on the board
supervision__CH1_RUN_N: U51062.6 (C); also elsewhere on the board
supervision__CH1_SEC_TIMER: U51060.2 (A); also elsewhere on the board
supervision__CH1_SEC_TIMER_N: U51060.4 (Y), U51063.2 (B); also elsewhere on the board
supervision__CH1_TIMEOUT: U51069.2 (A); also elsewhere on the board
supervision__NO_ACTIVITY: U51063.4 (Y), U51065.2 (B)
supervision__NO_ACTIVITY_G4: U51062.4 (Y), U51063.1 (A)
supervision__NO_ACTIVITY_G6: U51061.4 (Y), U51062.1 (A)
supervision__RAW_HEALTH: U51064.1 (A), U51070.1 (A); also elsewhere on the board
supervision__SAFE_IDLE: U50900.2 (D), U51065.4 (Y), U51066.2 (B)
supervision__SAFE_IDLE_G4: U51064.4 (Y), U51065.1 (A)
supervision__TIMEOUT_CLR_N: U51067.4 (Y); also elsewhere on the board
supervision__TIMEOUT_RESET: U51066.4 (Y), U51067.2 (A)

Notes on the sheet:
DIGITAL SCCI ENGINEERING / ARTIFICIAL LOADS / NATIVE INDEPENDENT SUPERVISION
18 guarded stimulation conductors, 17 measured RHD-side windows; conditional healthy-switch blanking is not proven isolation.
All net labels are native electrical connections. Actual physical delay, leakage, failed switches and shared supplies remain bounded limitations.
Independent phase cap, heartbeat watchdog, rail windows and deliberate rearm have different functions. No automatic retry or reverse pulse.
