pratham-cloud-ctrl/Project-SCCI-RH/electronics/stage4/integrated-pcb/boards/supervision/supervision.kicad_pcb

## KiCad design electronics/stage4/integrated-pcb/boards/supervision/supervision.kicad_pcb (continued)

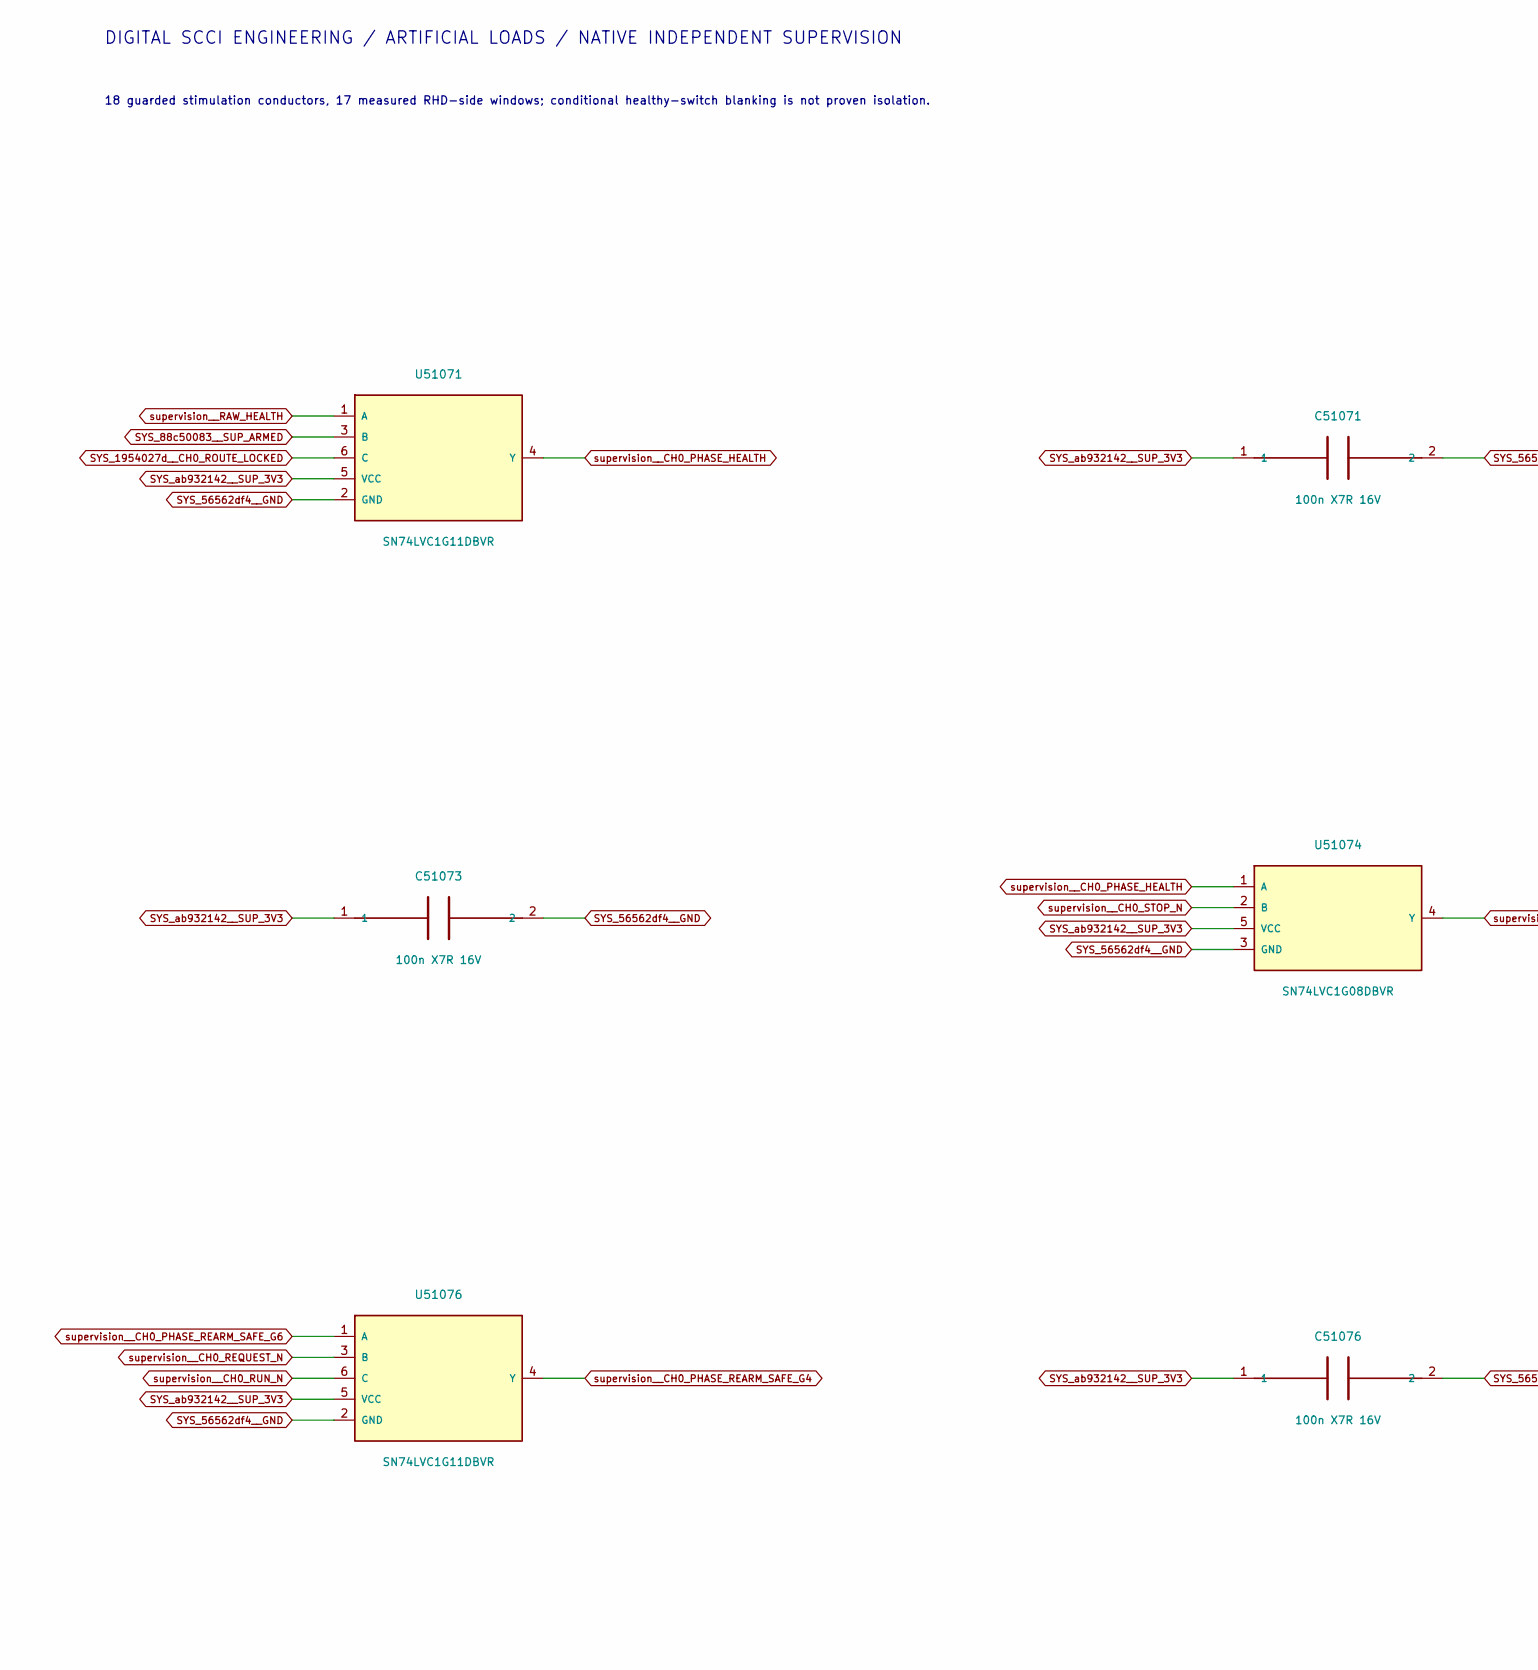
[picture p268: schematic phase0.kicad_sch, Project SCCI RH S4 / Source 0 phase permission, part in row 1, column 1]

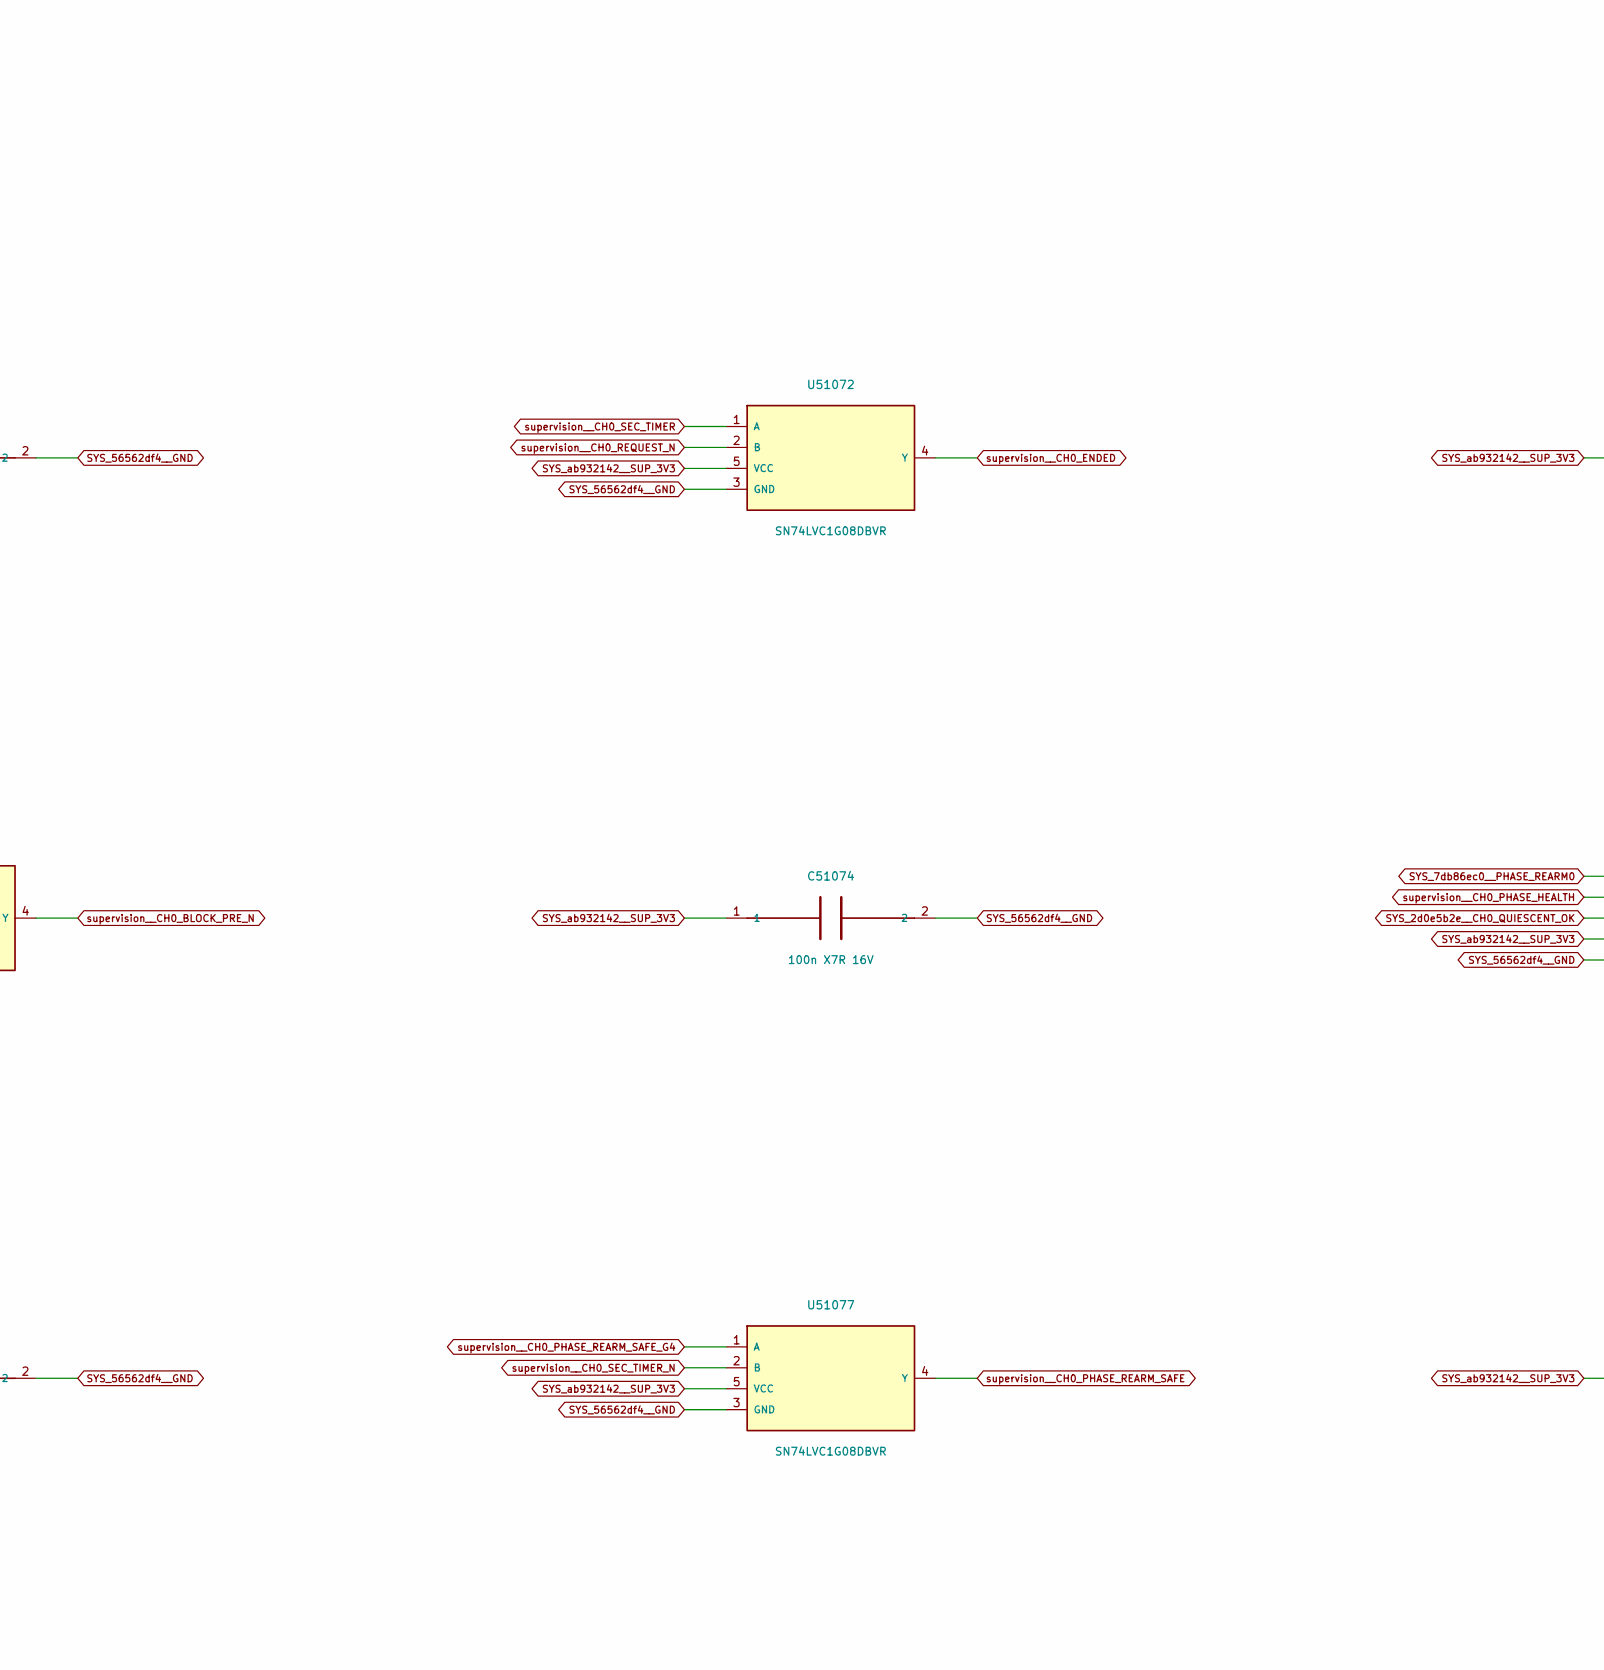
[picture p269: schematic phase0.kicad_sch, Project SCCI RH S4 / Source 0 phase permission, part in row 1, column 2]

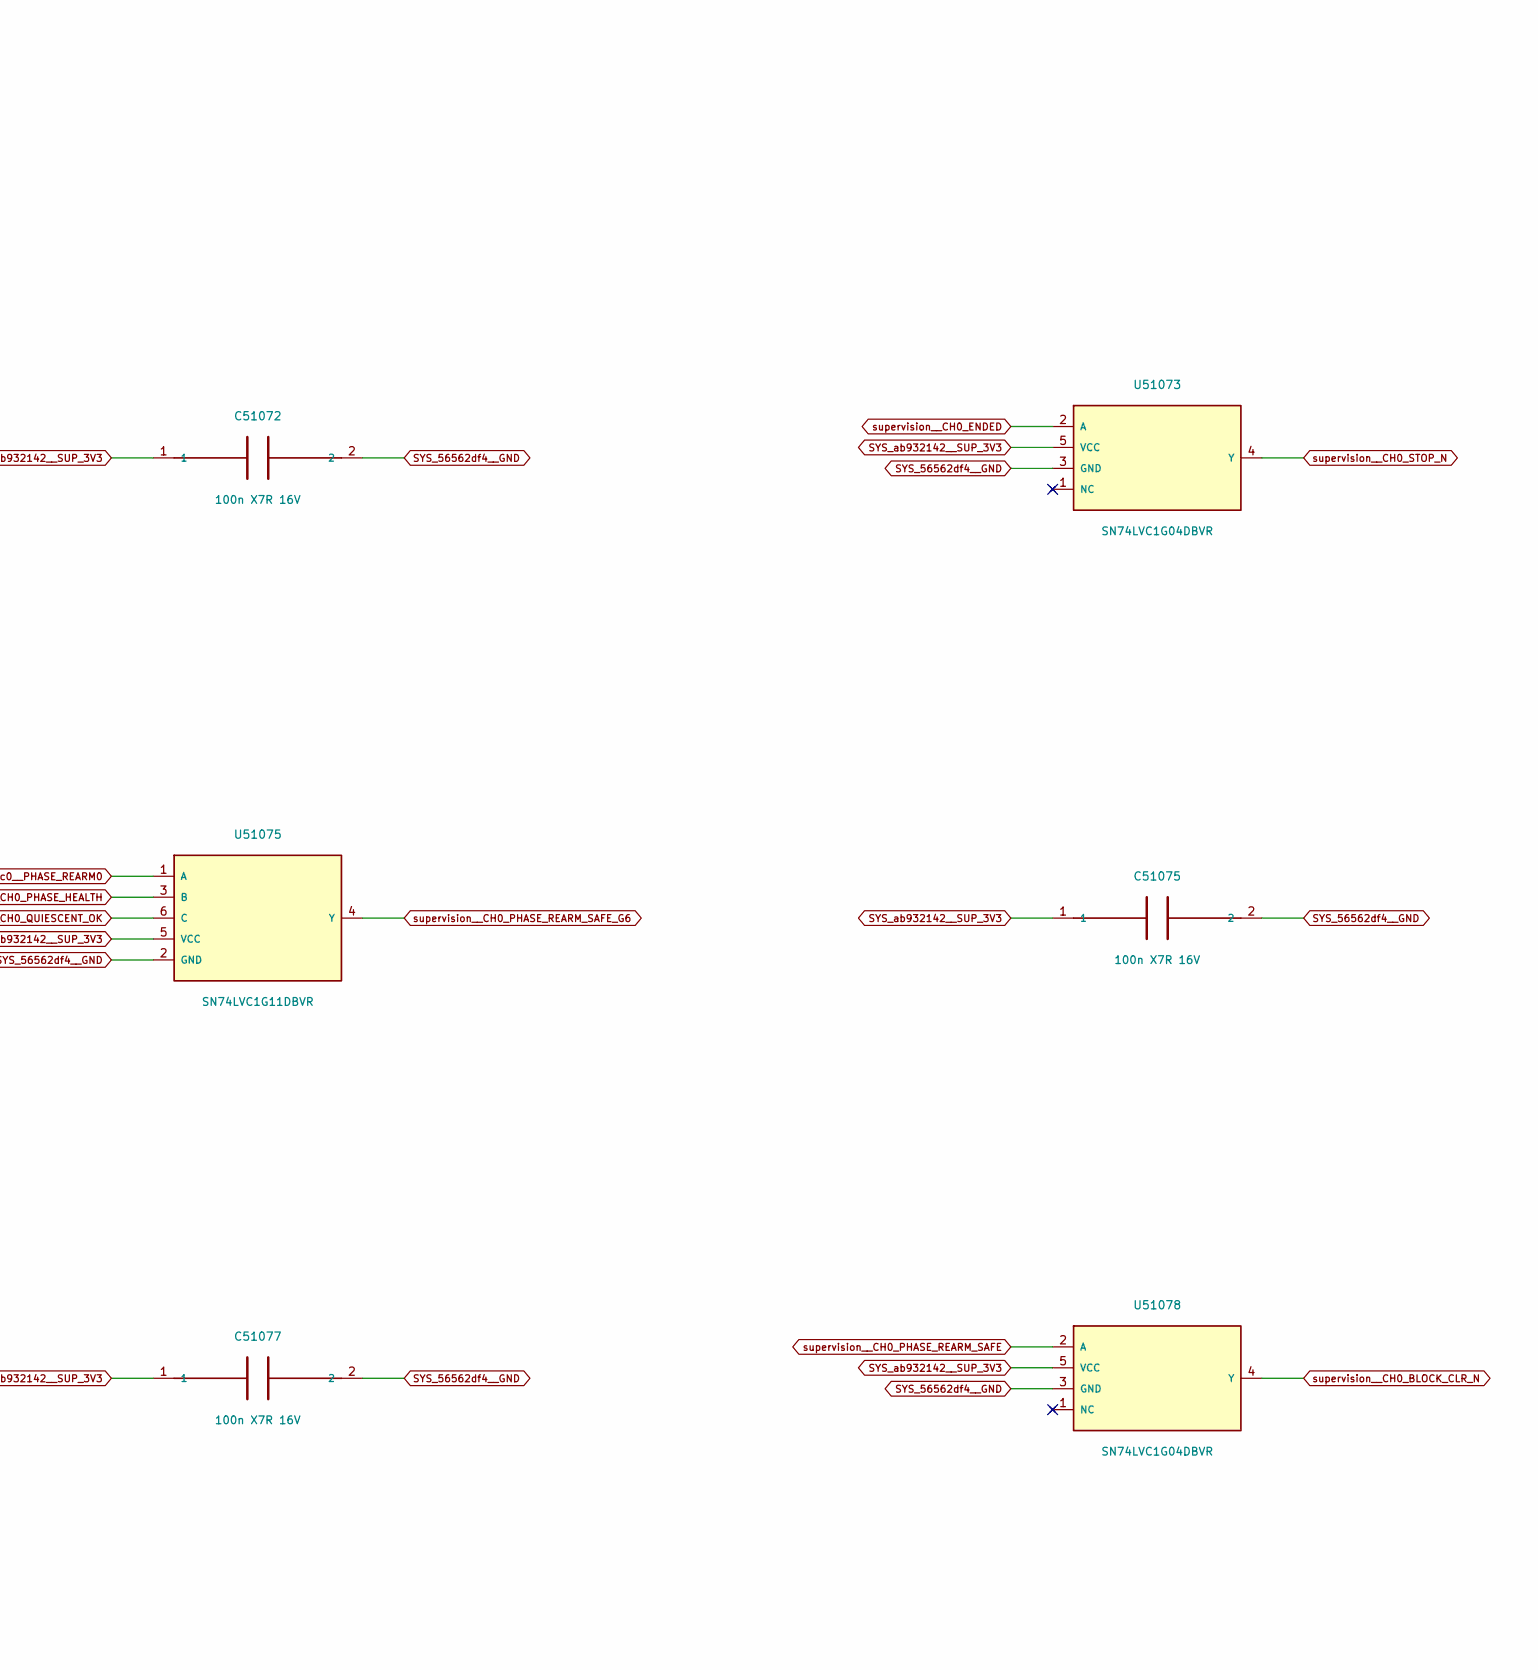
[picture p270: schematic phase0.kicad_sch, Project SCCI RH S4 / Source 0 phase permission, part in row 1, column 3]

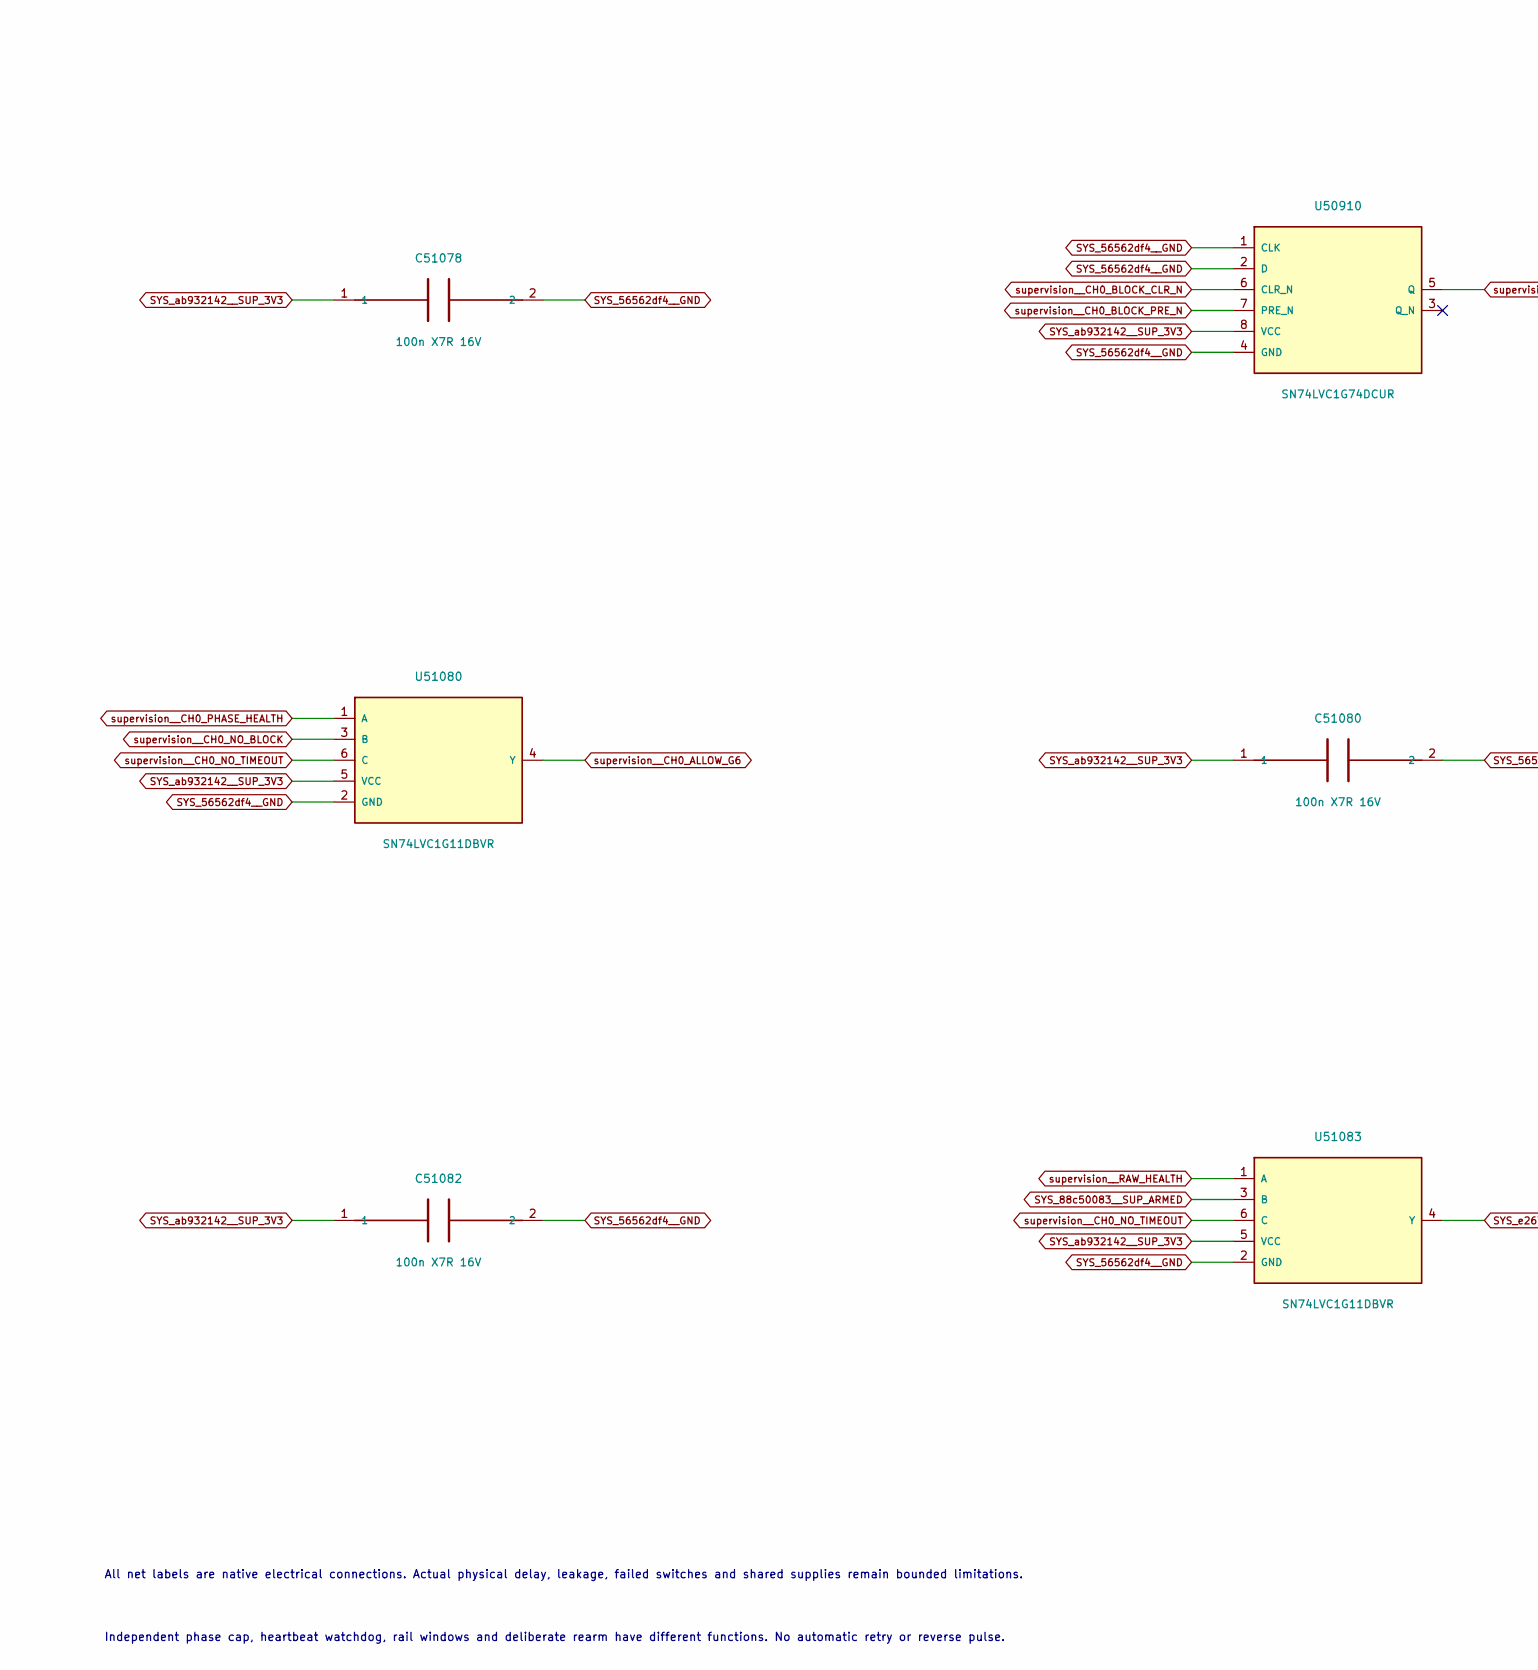
[picture p271: schematic phase0.kicad_sch, Project SCCI RH S4 / Source 0 phase permission, part in row 2, column 1]

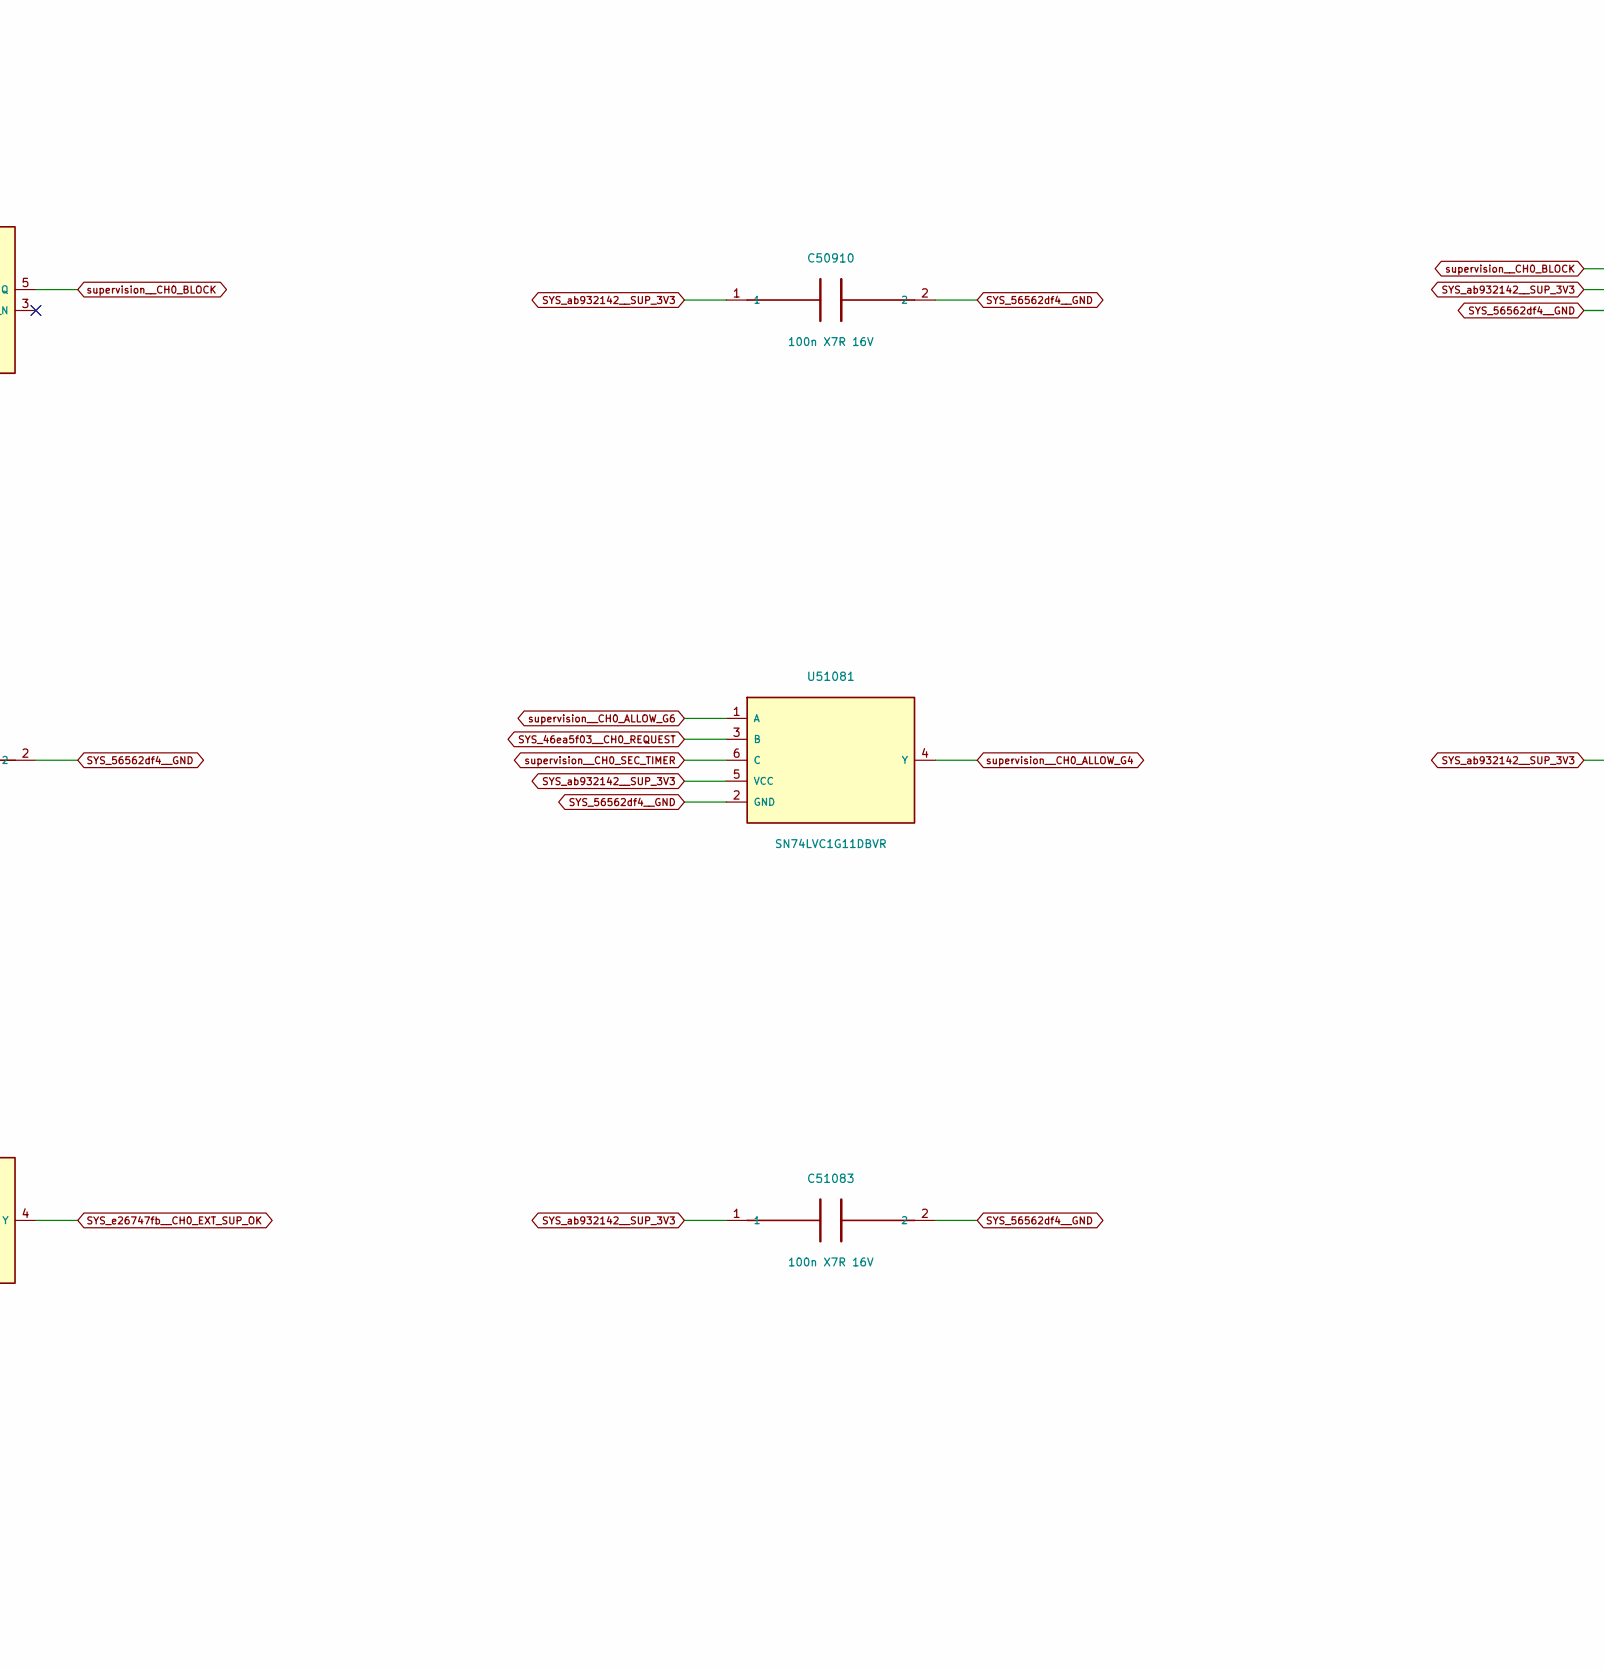
[picture p272: schematic phase0.kicad_sch, Project SCCI RH S4 / Source 0 phase permission, part in row 2, column 2]

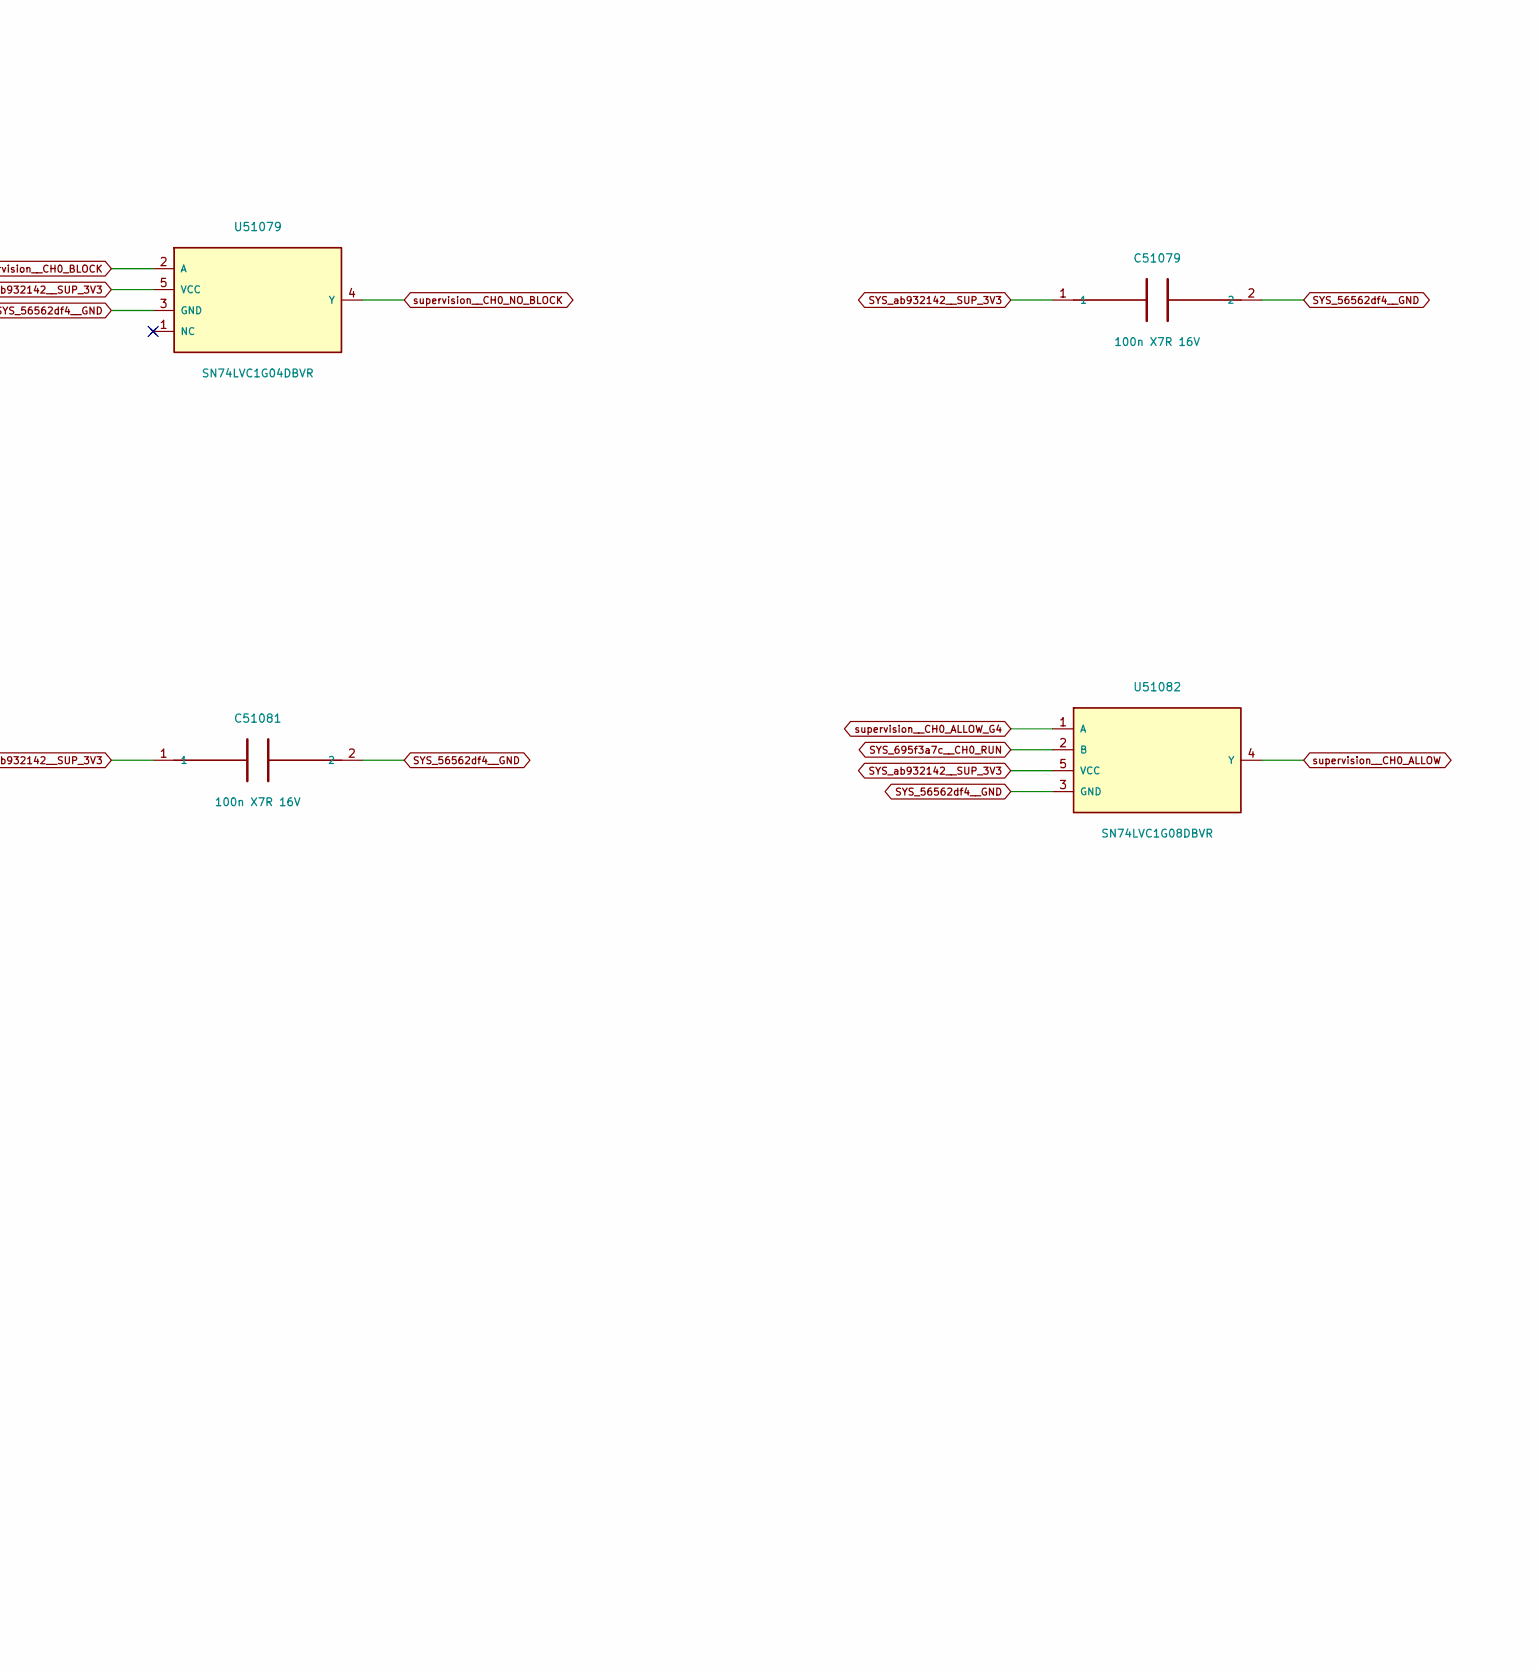
[picture p273: schematic phase0.kicad_sch, Project SCCI RH S4 / Source 0 phase permission, part in row 2, column 3]

Parts:
C50910, C51071, C51072, C51073, C51074, C51075, C51076, C51077, C51078, C51079, C51080, C51081, C51082, C51083: 100n X7R 16V; C_0805_2012Metric
U50910: SN74LVC1G74DCUR; VSSOP-8_2.3x2mm_P0.5mm
U51071, U51075, U51076, U51080, U51081, U51083: SN74LVC1G11DBVR; SOT-23-6
U51072, U51074, U51077, U51082: SN74LVC1G08DBVR; SOT-23-5
U51073, U51078, U51079: SN74LVC1G04DBVR; SOT-23-5

Connections:
SYS_2d0e5b2e__CH0_QUIESCENT_OK: U51075.6 (C); also elsewhere on the board
SYS_7db86ec0__PHASE_REARM0: U51075.1 (A); also elsewhere on the board
SYS_46ea5f03__CH0_REQUEST: U51081.3 (B); also elsewhere on the board
SYS_88c50083__SUP_ARMED: U51071.3 (B), U51083.3 (B); also elsewhere on the board
SYS_695f3a7c__CH0_RUN: U51082.2 (B); also elsewhere on the board
SYS_56562df4__GND: C50910.2, C51071.2, C51072.2, C51073.2, C51074.2, C51075.2, C51076.2, C51077.2, C51078.2, C51079.2, C51080.2, C51081.2, C51082.2, C51083.2, U50910.1 (CLK), U50910.2 (D), U50910.4 (GND), U51071.2 (GND), U51072.3 (GND), U51073.3 (GND), U51074.3 (GND), U51075.2 (GND), U51076.2 (GND), U51077.3 (GND), U51078.3 (GND), U51079.3 (GND), U51080.2 (GND), U51081.2 (GND), U51082.3 (GND), U51083.2 (GND); also elsewhere on the board
SYS_1954027d__CH0_ROUTE_LOCKED: U51071.6 (C); also elsewhere on the board
SYS_ab932142__SUP_3V3: C50910.1, C51071.1, C51072.1, C51073.1, C51074.1, C51075.1, C51076.1, C51077.1, C51078.1, C51079.1, C51080.1, C51081.1, C51082.1, C51083.1, U50910.8 (VCC), U51071.5 (VCC), U51072.5 (VCC), U51073.5 (VCC), U51074.5 (VCC), U51075.5 (VCC), U51076.5 (VCC), U51077.5 (VCC), U51078.5 (VCC), U51079.5 (VCC), U51080.5 (VCC), U51081.5 (VCC), U51082.5 (VCC), U51083.5 (VCC); also elsewhere on the board
SYS_e26747fb__CH0_EXT_SUP_OK: U51083.4 (Y); also elsewhere on the board
supervision__CH0_ALLOW: U51082.4 (Y); also elsewhere on the board
supervision__CH0_ALLOW_G4: U51081.4 (Y), U51082.1 (A)
supervision__CH0_ALLOW_G6: U51080.4 (Y), U51081.1 (A)
supervision__CH0_BLOCK: U50910.5 (Q), U51079.2 (A)
supervision__CH0_BLOCK_CLR_N: U50910.6 (CLR_N), U51078.4 (Y)
supervision__CH0_BLOCK_PRE_N: U50910.7 (PRE_N), U51074.4 (Y)
supervision__CH0_ENDED: U51072.4 (Y), U51073.2 (A)
supervision__CH0_NO_BLOCK: U51079.4 (Y), U51080.3 (B)
supervision__CH0_NO_TIMEOUT: U51080.6 (C), U51083.6 (C); also elsewhere on the board
supervision__CH0_PHASE_HEALTH: U51071.4 (Y), U51074.1 (A), U51075.3 (B), U51080.1 (A)
supervision__CH0_PHASE_REARM_SAFE: U51077.4 (Y), U51078.2 (A)
supervision__CH0_PHASE_REARM_SAFE_G4: U51076.4 (Y), U51077.1 (A)
supervision__CH0_PHASE_REARM_SAFE_G6: U51075.4 (Y), U51076.1 (A)
supervision__CH0_REQUEST_N: U51072.2 (B), U51076.3 (B); also elsewhere on the board
supervision__CH0_RUN_N: U51076.6 (C); also elsewhere on the board
supervision__CH0_SEC_TIMER: U51072.1 (A), U51081.6 (C); also elsewhere on the board
supervision__CH0_SEC_TIMER_N: U51077.2 (B); also elsewhere on the board
supervision__CH0_STOP_N: U51073.4 (Y), U51074.2 (B)
supervision__RAW_HEALTH: U51071.1 (A), U51083.1 (A); also elsewhere on the board

Notes on the sheet:
DIGITAL SCCI ENGINEERING / ARTIFICIAL LOADS / NATIVE INDEPENDENT SUPERVISION
18 guarded stimulation conductors, 17 measured RHD-side windows; conditional healthy-switch blanking is not proven isolation.
All net labels are native electrical connections. Actual physical delay, leakage, failed switches and shared supplies remain bounded limitations.
Independent phase cap, heartbeat watchdog, rail windows and deliberate rearm have different functions. No automatic retry or reverse pulse.
