pratham-cloud-ctrl/Project-SCCI-RH/electronics/stage4/integrated-pcb/boards/supervision/supervision.kicad_pcb

## KiCad design electronics/stage4/integrated-pcb/boards/supervision/supervision.kicad_pcb (continued)

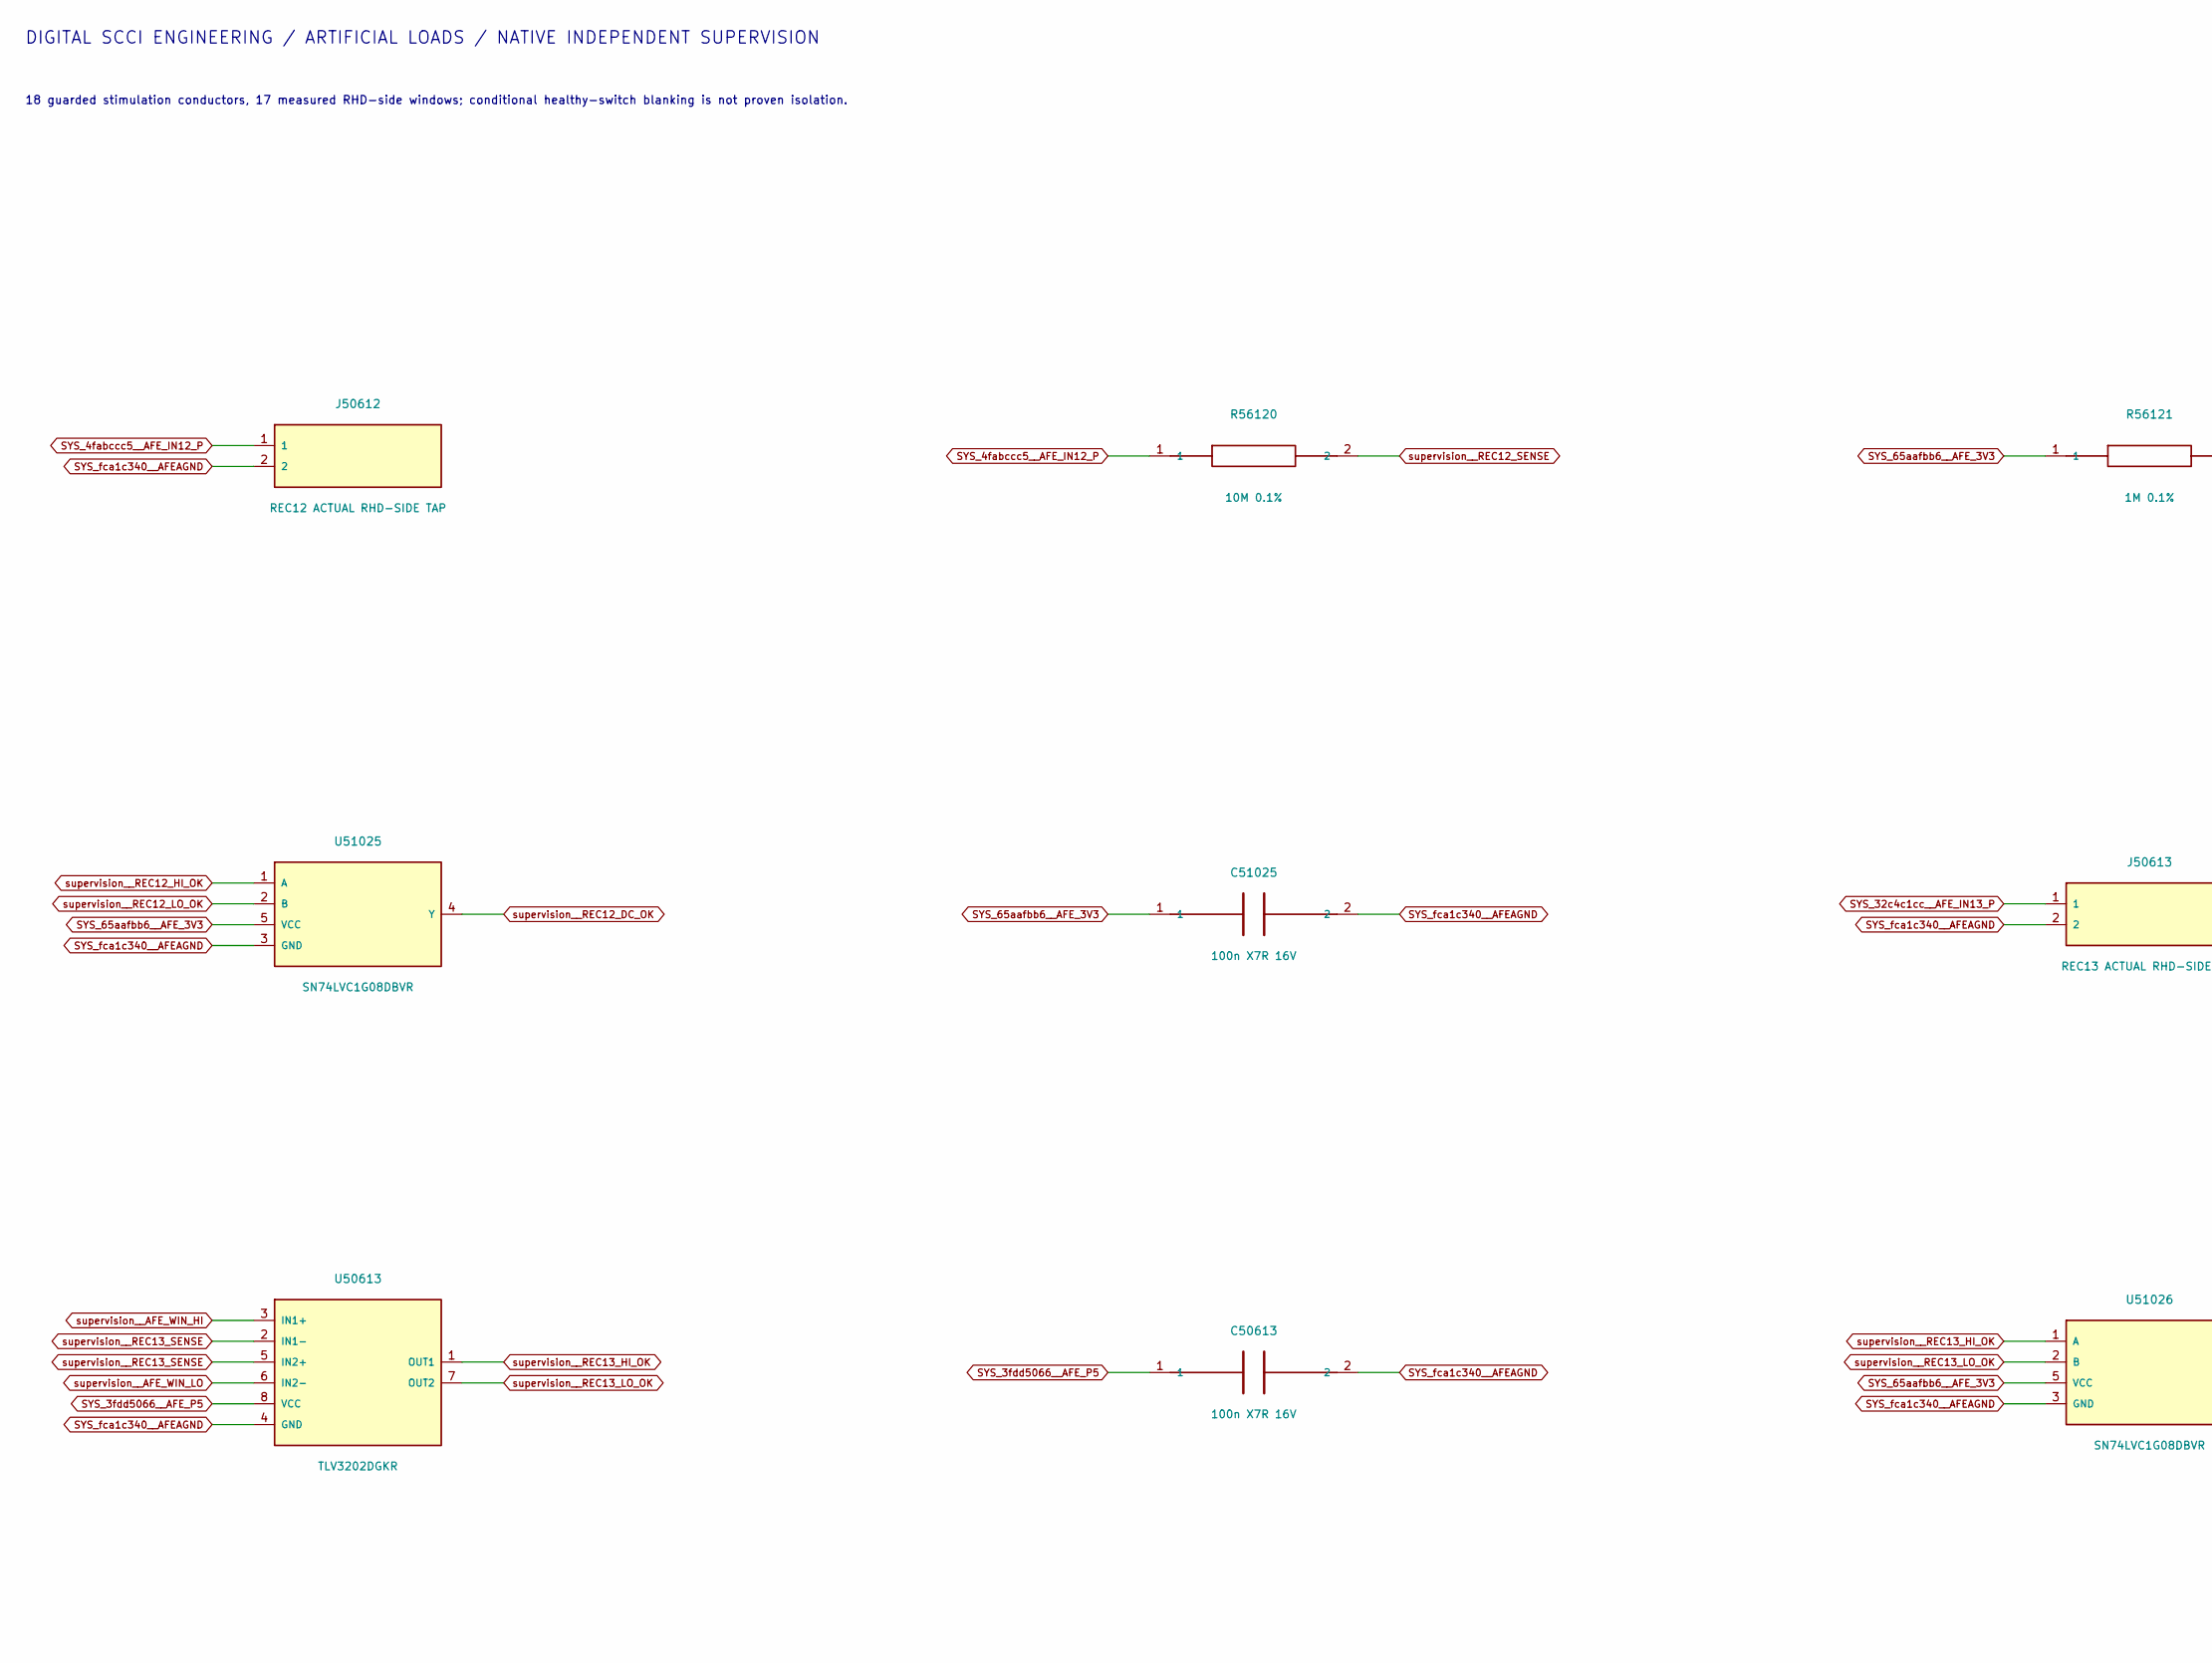
[picture p292: schematic afe_bank3.kicad_sch, Project SCCI RH S4 / RHD input windows 3, part in row 1, column 1]

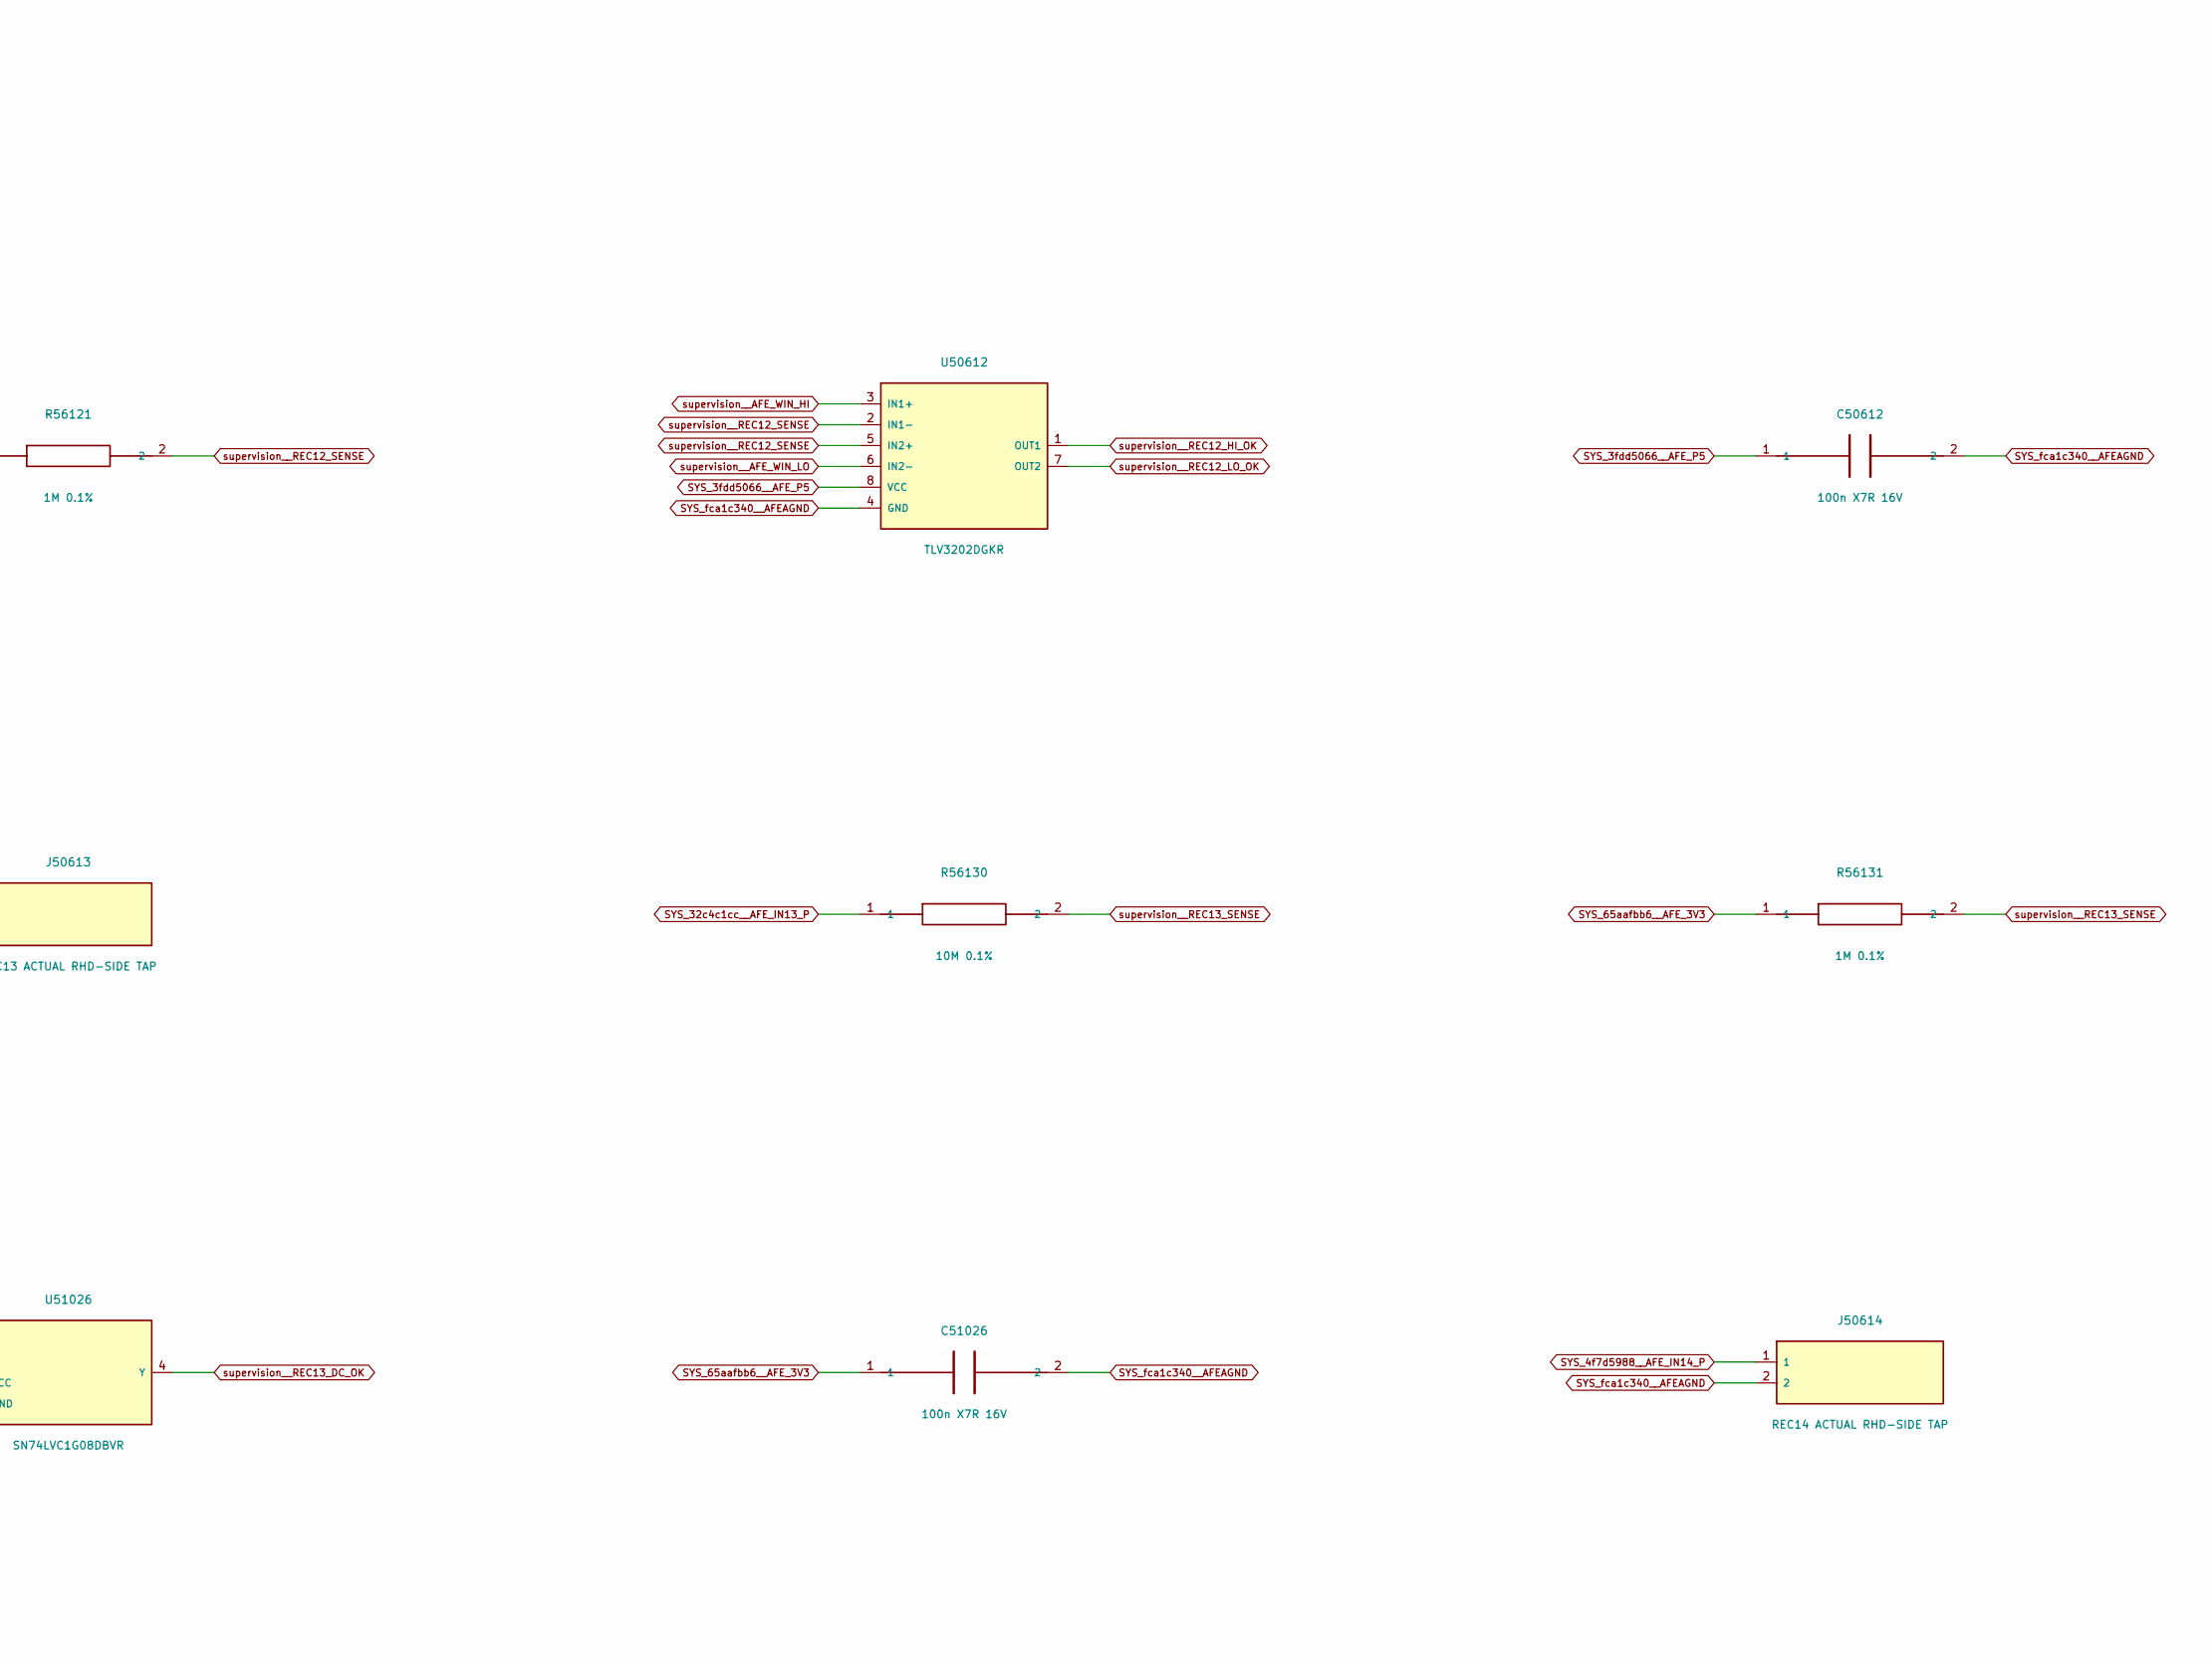
[picture p293: schematic afe_bank3.kicad_sch, Project SCCI RH S4 / RHD input windows 3, part in row 1, column 2]

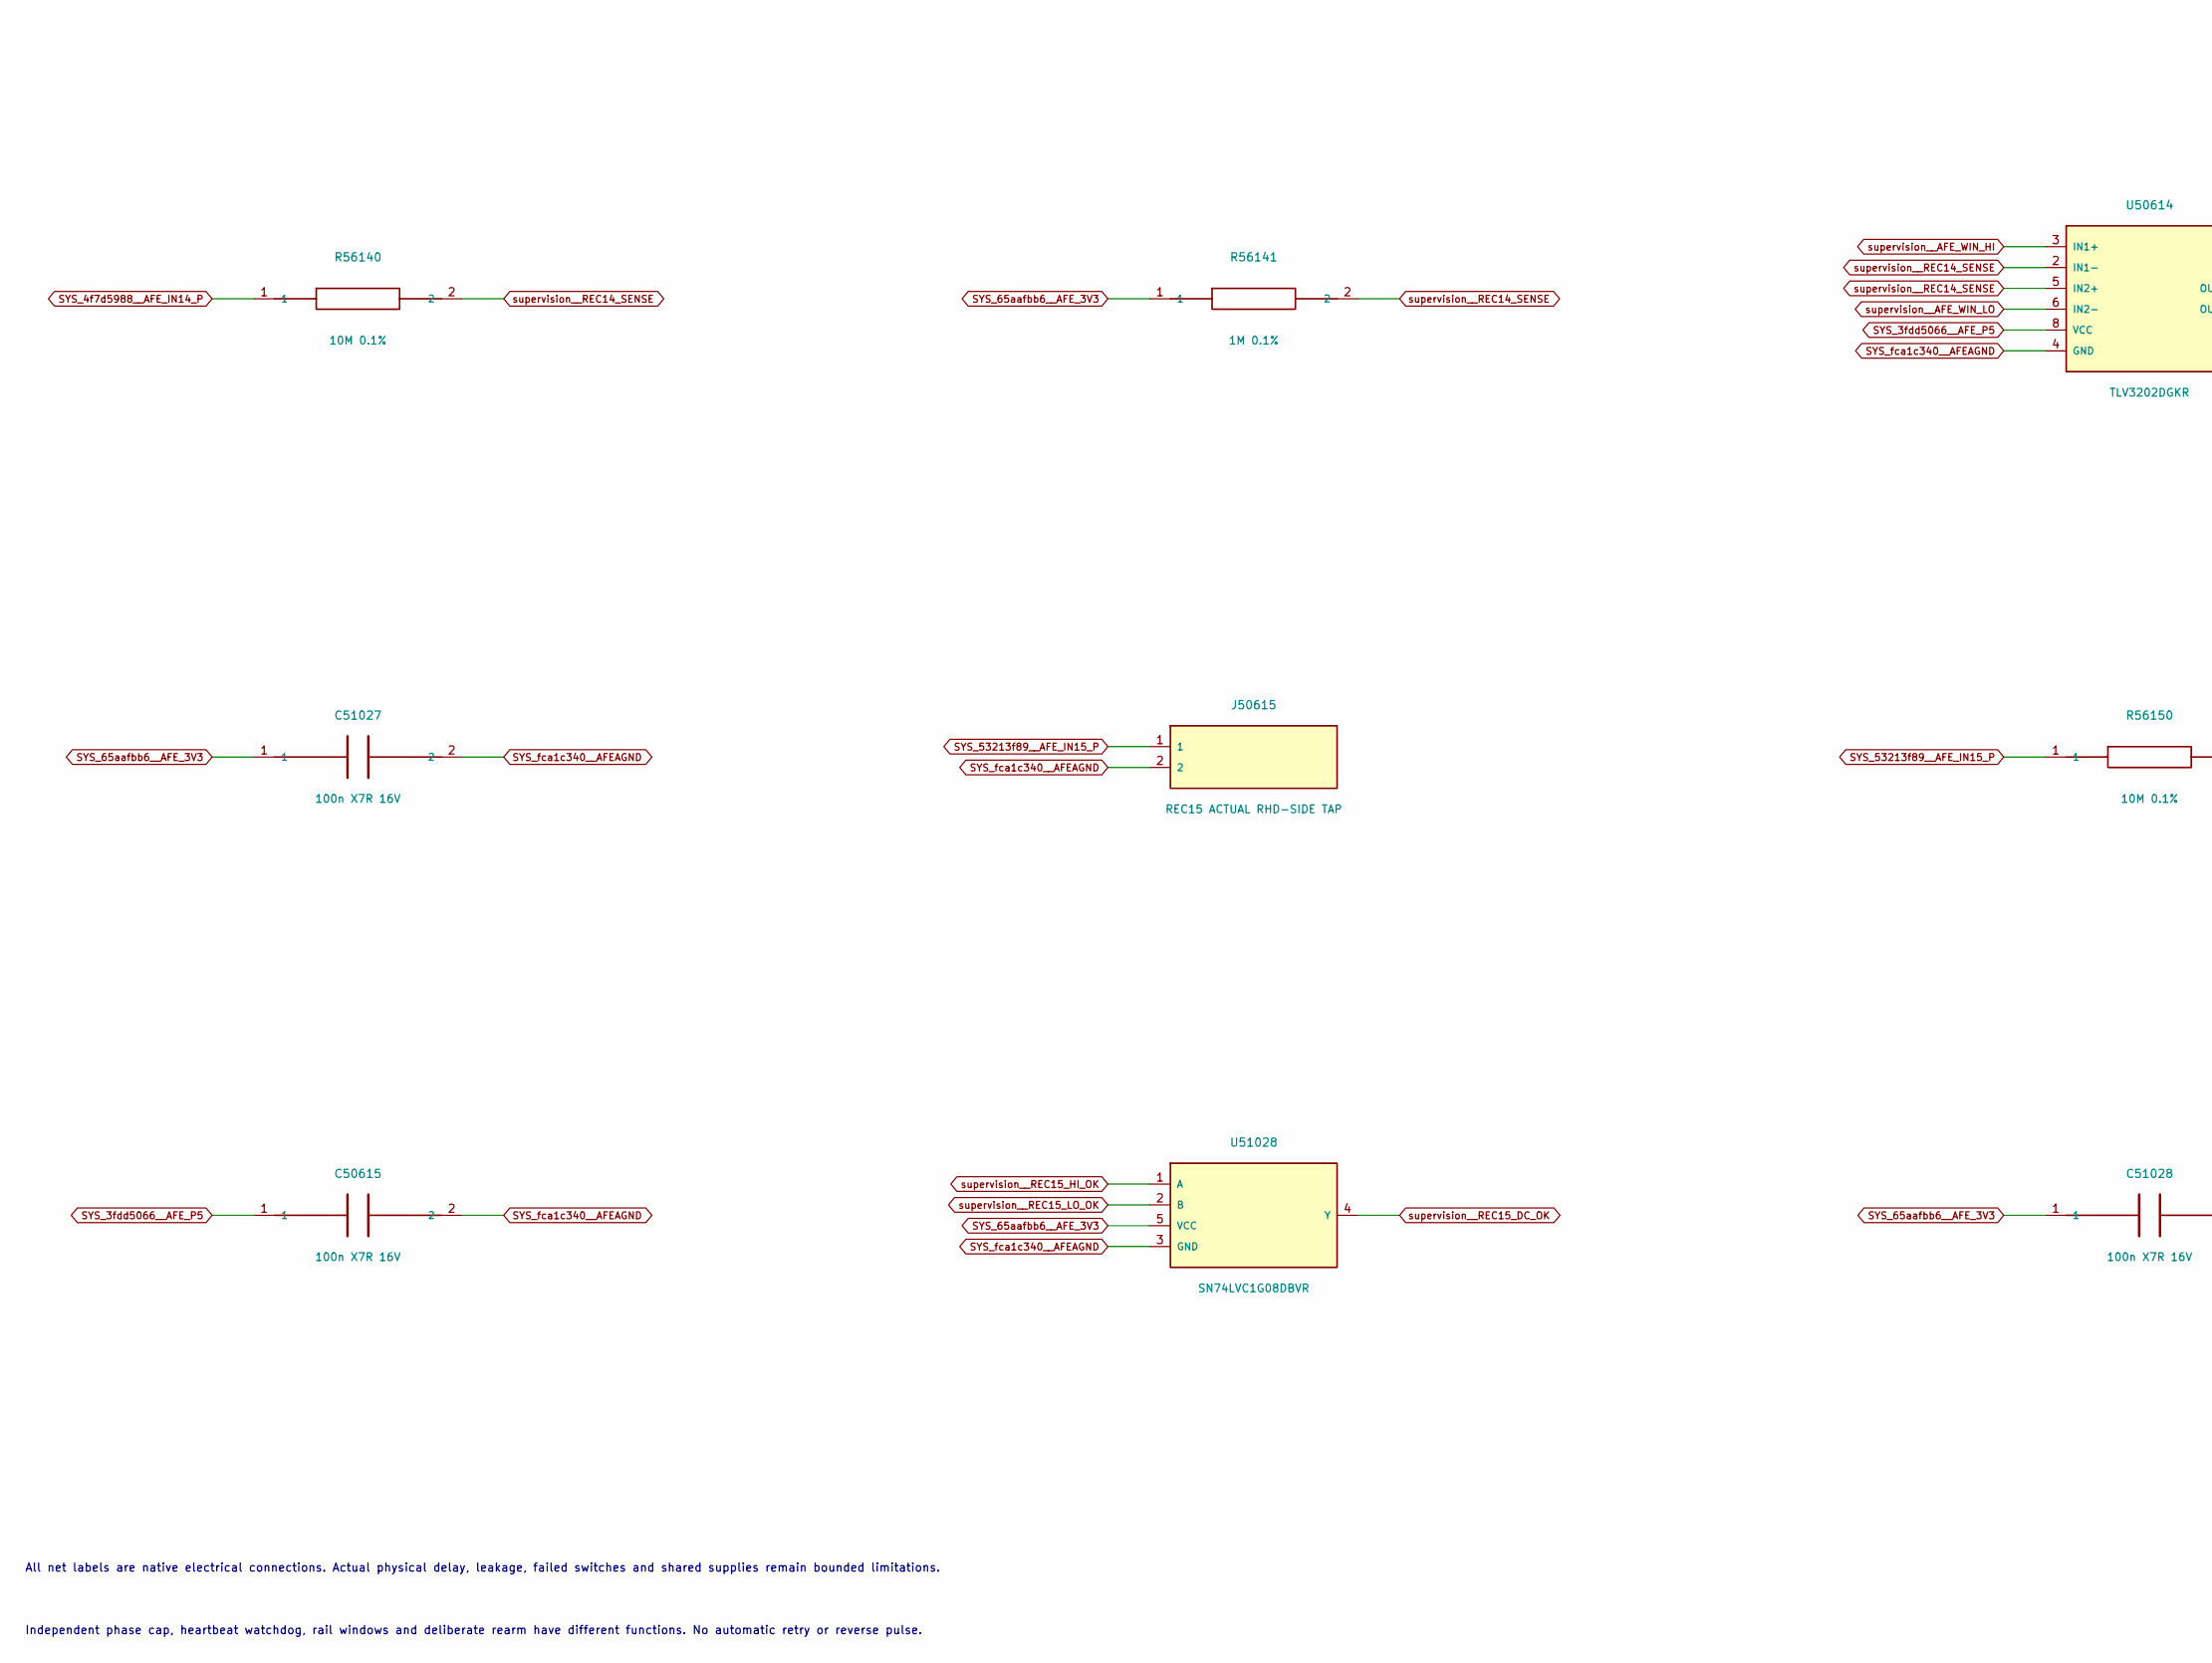
[picture p294: schematic afe_bank3.kicad_sch, Project SCCI RH S4 / RHD input windows 3, part in row 2, column 1]

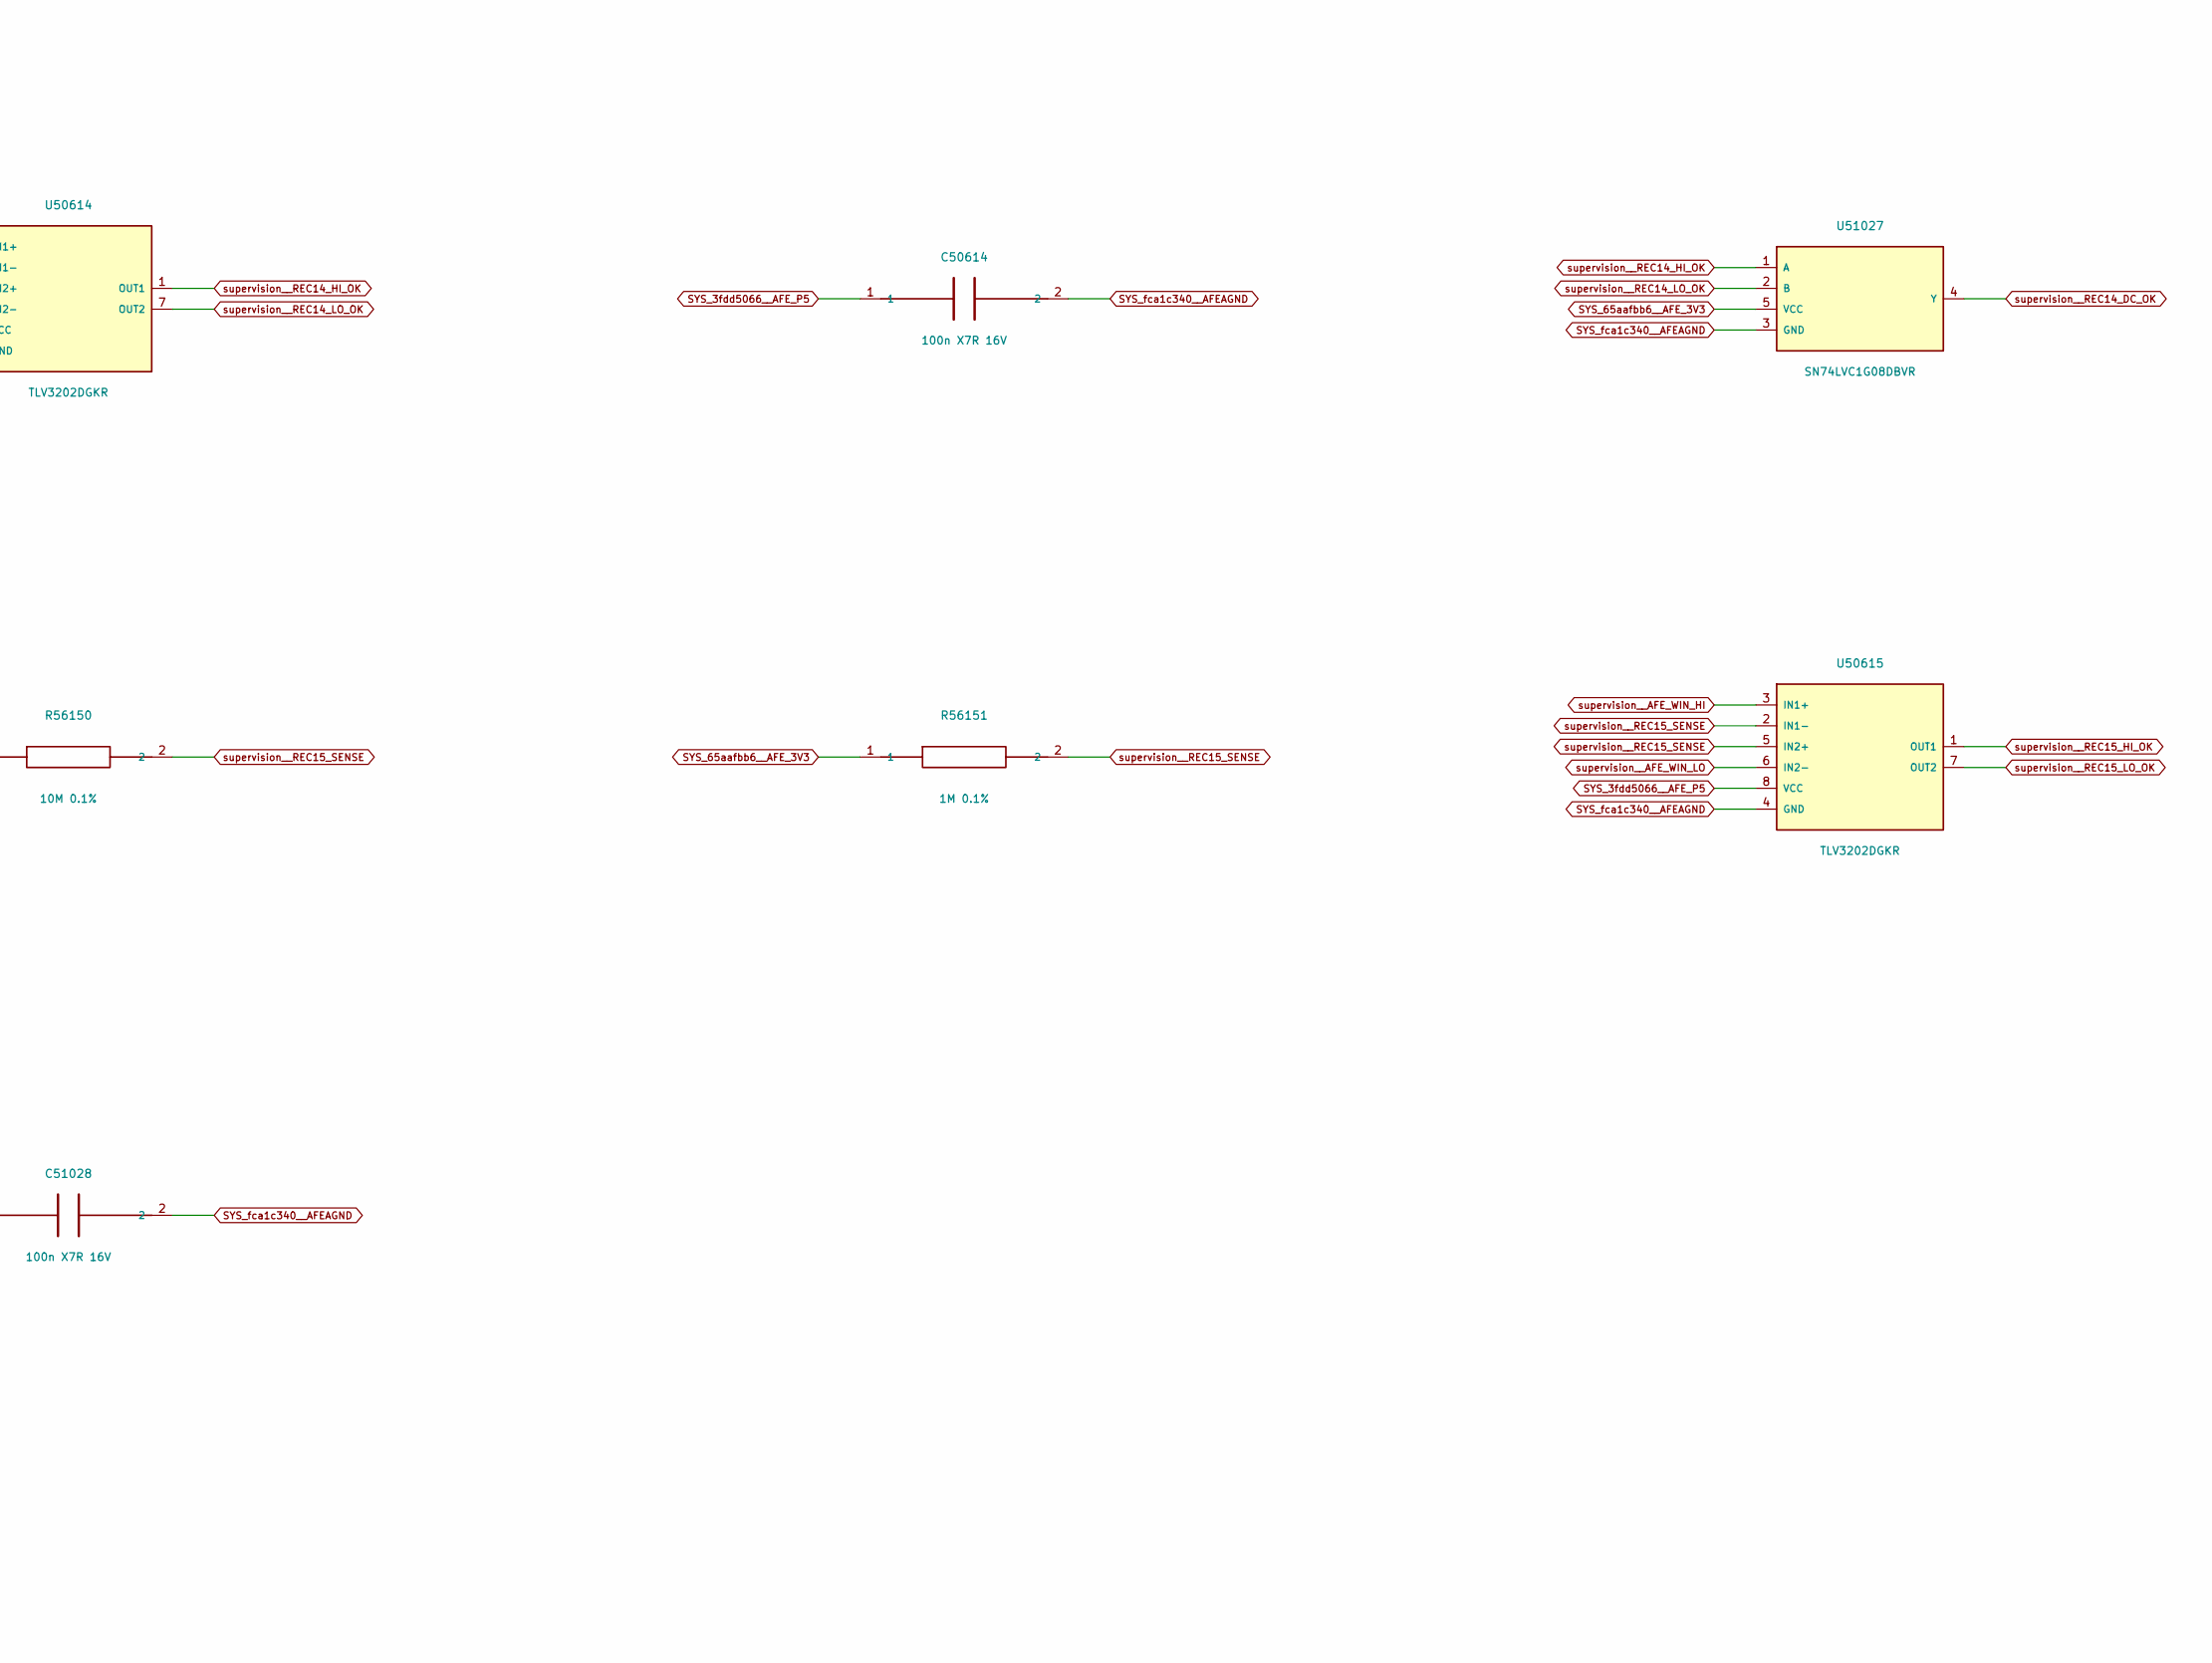
[picture p295: schematic afe_bank3.kicad_sch, Project SCCI RH S4 / RHD input windows 3, part in row 2, column 2]

Parts:
C50612, C50613, C50614, C50615, C51025, C51026, C51027, C51028: 100n X7R 16V; C_0805_2012Metric
J50612: REC12 ACTUAL RHD-SIDE TAP; PinHeader_1x02_P2.54mm_Vertical
J50613: REC13 ACTUAL RHD-SIDE TAP; PinHeader_1x02_P2.54mm_Vertical
J50614: REC14 ACTUAL RHD-SIDE TAP; PinHeader_1x02_P2.54mm_Vertical
J50615: REC15 ACTUAL RHD-SIDE TAP; PinHeader_1x02_P2.54mm_Vertical
R56120, R56130, R56140, R56150: 10M 0.1%; R_0805_2012Metric
R56121, R56131, R56141, R56151: 1M 0.1%; R_0805_2012Metric
U50612, U50613, U50614, U50615: TLV3202DGKR; VSSOP-8_2.3x2mm_P0.5mm
U51025, U51026, U51027, U51028: SN74LVC1G08DBVR; SOT-23-5

Connections:
SYS_3fdd5066__AFE_P5: C50612.1, C50613.1, C50614.1, C50615.1, U50612.8 (VCC), U50613.8 (VCC), U50614.8 (VCC), U50615.8 (VCC); also elsewhere on the board
SYS_4f7d5988__AFE_IN14_P: J50614.1, R56140.1
SYS_4fabccc5__AFE_IN12_P: J50612.1, R56120.1
SYS_32c4c1cc__AFE_IN13_P: J50613.1, R56130.1
SYS_65aafbb6__AFE_3V3: C51025.1, C51026.1, C51027.1, C51028.1, R56121.1, R56131.1, R56141.1, R56151.1, U51025.5 (VCC), U51026.5 (VCC), U51027.5 (VCC), U51028.5 (VCC); also elsewhere on the board
SYS_53213f89__AFE_IN15_P: J50615.1, R56150.1
SYS_fca1c340__AFEAGND: C50612.2, C50613.2, C50614.2, C50615.2, C51025.2, C51026.2, C51027.2, C51028.2, J50612.2, J50613.2, J50614.2, J50615.2, U50612.4 (GND), U50613.4 (GND), U50614.4 (GND), U50615.4 (GND), U51025.3 (GND), U51026.3 (GND), U51027.3 (GND), U51028.3 (GND); also elsewhere on the board
supervision__AFE_WIN_HI: U50612.3 (IN1+), U50613.3 (IN1+), U50614.3 (IN1+), U50615.3 (IN1+); also elsewhere on the board
supervision__AFE_WIN_LO: U50612.6 (IN2-), U50613.6 (IN2-), U50614.6 (IN2-), U50615.6 (IN2-); also elsewhere on the board
supervision__REC12_DC_OK: U51025.4 (Y); also elsewhere on the board
supervision__REC12_HI_OK: U50612.1 (OUT1), U51025.1 (A)
supervision__REC12_LO_OK: U50612.7 (OUT2), U51025.2 (B)
supervision__REC12_SENSE: R56120.2, R56121.2, U50612.2 (IN1-), U50612.5 (IN2+)
supervision__REC13_DC_OK: U51026.4 (Y); also elsewhere on the board
supervision__REC13_HI_OK: U50613.1 (OUT1), U51026.1 (A)
supervision__REC13_LO_OK: U50613.7 (OUT2), U51026.2 (B)
supervision__REC13_SENSE: R56130.2, R56131.2, U50613.2 (IN1-), U50613.5 (IN2+)
supervision__REC14_DC_OK: U51027.4 (Y); also elsewhere on the board
supervision__REC14_HI_OK: U50614.1 (OUT1), U51027.1 (A)
supervision__REC14_LO_OK: U50614.7 (OUT2), U51027.2 (B)
supervision__REC14_SENSE: R56140.2, R56141.2, U50614.2 (IN1-), U50614.5 (IN2+)
supervision__REC15_DC_OK: U51028.4 (Y); also elsewhere on the board
supervision__REC15_HI_OK: U50615.1 (OUT1), U51028.1 (A)
supervision__REC15_LO_OK: U50615.7 (OUT2), U51028.2 (B)
supervision__REC15_SENSE: R56150.2, R56151.2, U50615.2 (IN1-), U50615.5 (IN2+)

Notes on the sheet:
DIGITAL SCCI ENGINEERING / ARTIFICIAL LOADS / NATIVE INDEPENDENT SUPERVISION
18 guarded stimulation conductors, 17 measured RHD-side windows; conditional healthy-switch blanking is not proven isolation.
All net labels are native electrical connections. Actual physical delay, leakage, failed switches and shared supplies remain bounded limitations.
Independent phase cap, heartbeat watchdog, rail windows and deliberate rearm have different functions. No automatic retry or reverse pulse.
