pratham-cloud-ctrl/Project-SCCI-RH/electronics/stage4/integrated-pcb/boards/supervision/supervision.kicad_pcb

## KiCad design electronics/stage4/integrated-pcb/boards/supervision/supervision.kicad_pcb (continued)

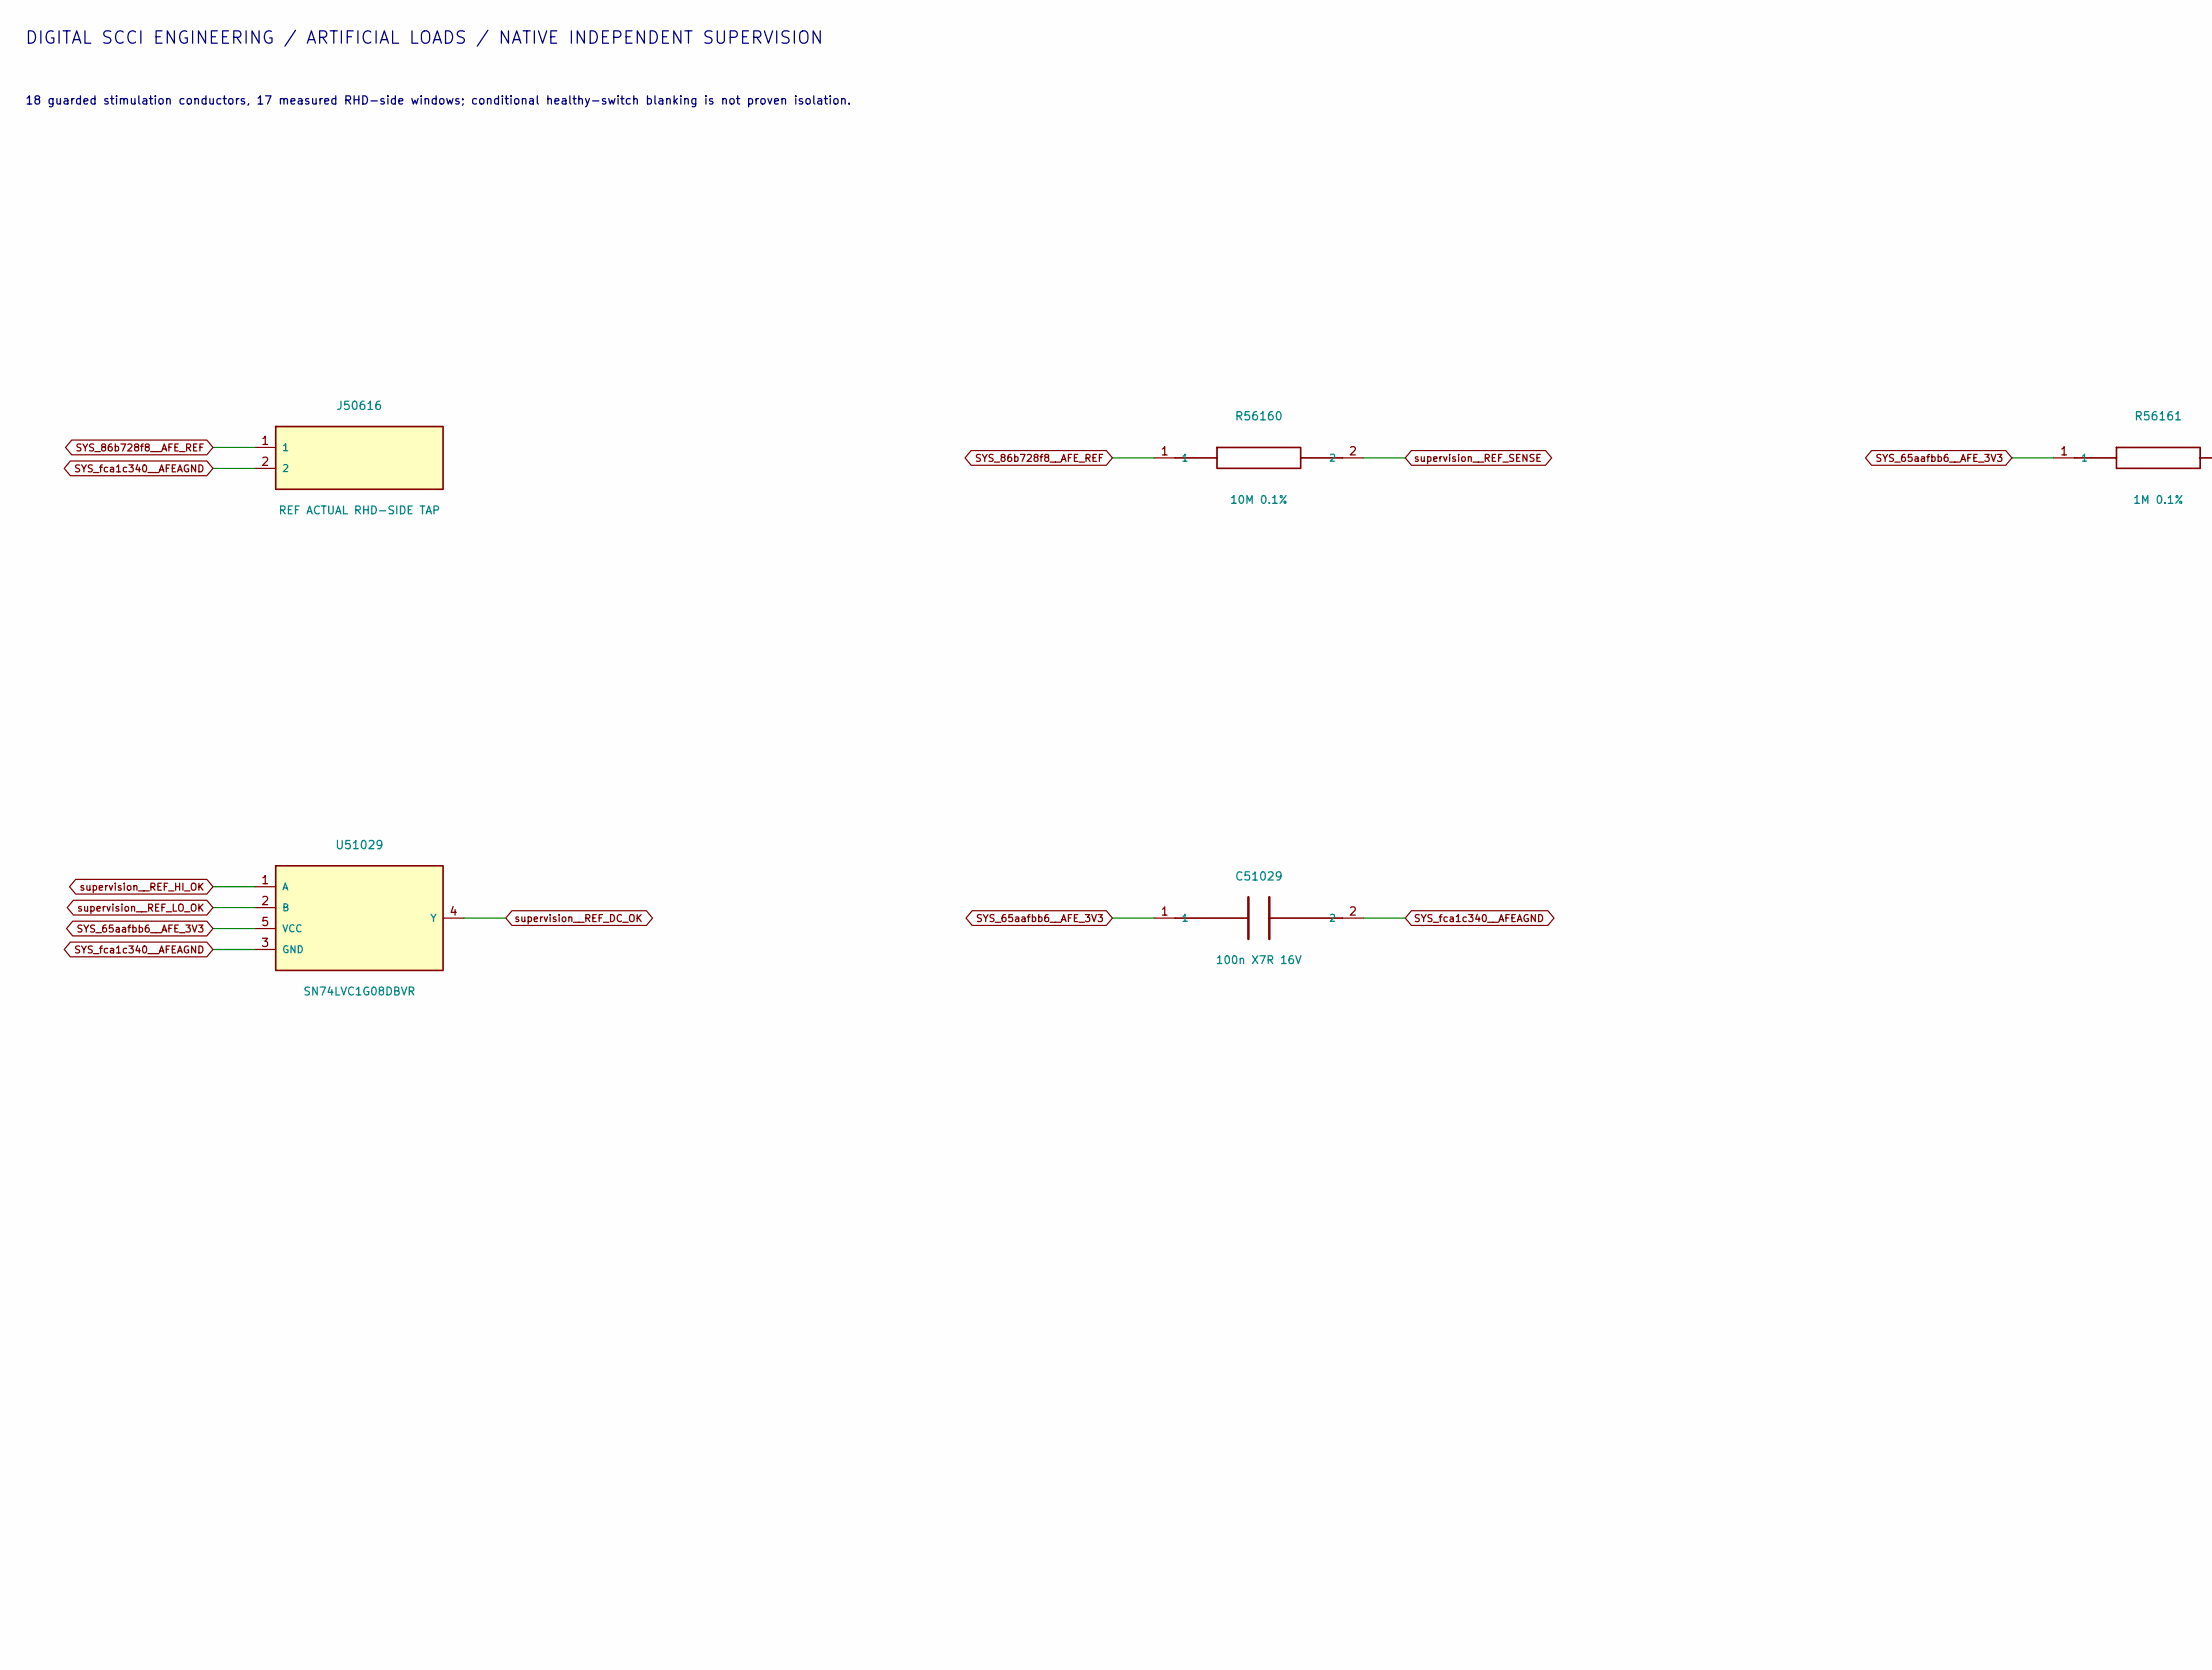
[picture p296: schematic afe_bank4.kicad_sch, Project SCCI RH S4 / RHD input windows 4, part in row 1, column 1]

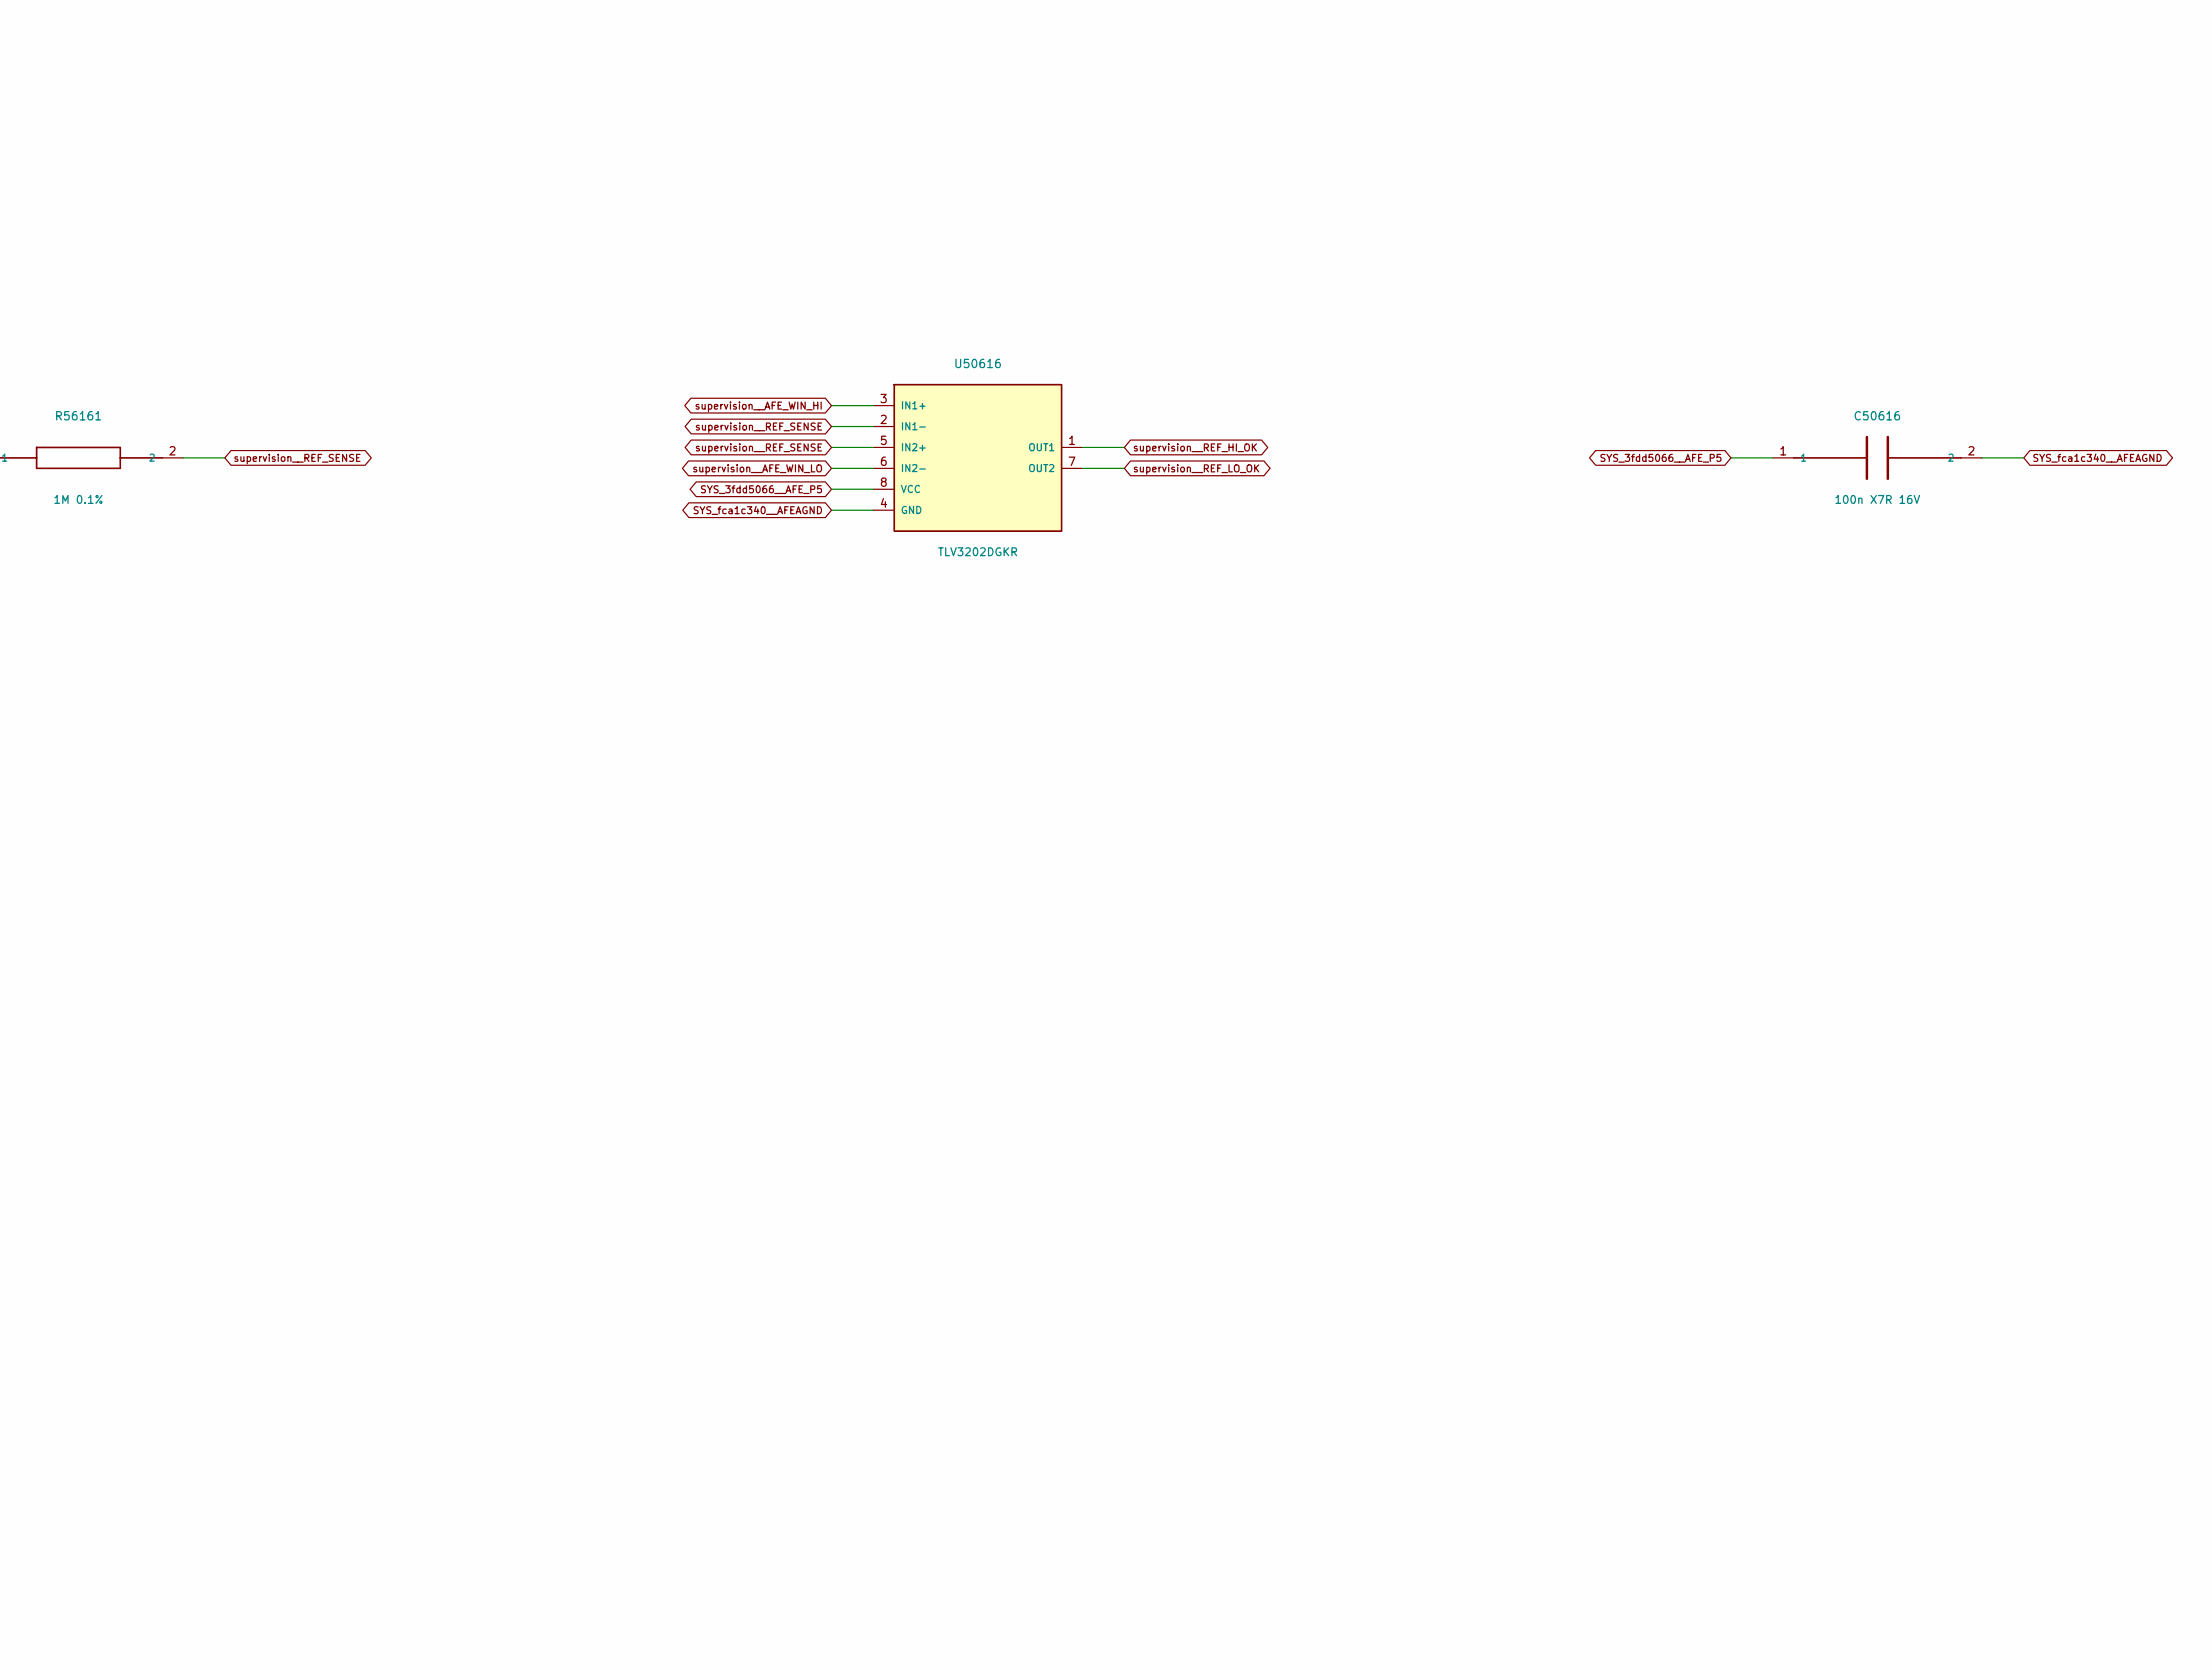
[picture p297: schematic afe_bank4.kicad_sch, Project SCCI RH S4 / RHD input windows 4, part in row 1, column 2]

Parts:
C50616, C51029: 100n X7R 16V; C_0805_2012Metric
J50616: REF ACTUAL RHD-SIDE TAP; PinHeader_1x02_P2.54mm_Vertical
R56160: 10M 0.1%; R_0805_2012Metric
R56161: 1M 0.1%; R_0805_2012Metric
U50616: TLV3202DGKR; VSSOP-8_2.3x2mm_P0.5mm
U51029: SN74LVC1G08DBVR; SOT-23-5

Connections:
SYS_3fdd5066__AFE_P5: C50616.1, U50616.8 (VCC); also elsewhere on the board
SYS_65aafbb6__AFE_3V3: C51029.1, R56161.1, U51029.5 (VCC); also elsewhere on the board
SYS_86b728f8__AFE_REF: J50616.1, R56160.1
SYS_fca1c340__AFEAGND: C50616.2, C51029.2, J50616.2, U50616.4 (GND), U51029.3 (GND); also elsewhere on the board
supervision__AFE_WIN_HI: U50616.3 (IN1+); also elsewhere on the board
supervision__AFE_WIN_LO: U50616.6 (IN2-); also elsewhere on the board
supervision__REF_DC_OK: U51029.4 (Y); also elsewhere on the board
supervision__REF_HI_OK: U50616.1 (OUT1), U51029.1 (A)
supervision__REF_LO_OK: U50616.7 (OUT2), U51029.2 (B)
supervision__REF_SENSE: R56160.2, R56161.2, U50616.2 (IN1-), U50616.5 (IN2+)

Notes on the sheet:
DIGITAL SCCI ENGINEERING / ARTIFICIAL LOADS / NATIVE INDEPENDENT SUPERVISION
18 guarded stimulation conductors, 17 measured RHD-side windows; conditional healthy-switch blanking is not proven isolation.
All net labels are native electrical connections. Actual physical delay, leakage, failed switches and shared supplies remain bounded limitations.
Independent phase cap, heartbeat watchdog, rail windows and deliberate rearm have different functions. No automatic retry or reverse pulse.
