pratham-cloud-ctrl/Project-SCCI-RH/electronics/stage4/integrated-pcb/boards/supervision/supervision.kicad_pcb

## KiCad design electronics/stage4/integrated-pcb/boards/supervision/supervision.kicad_pcb (continued)

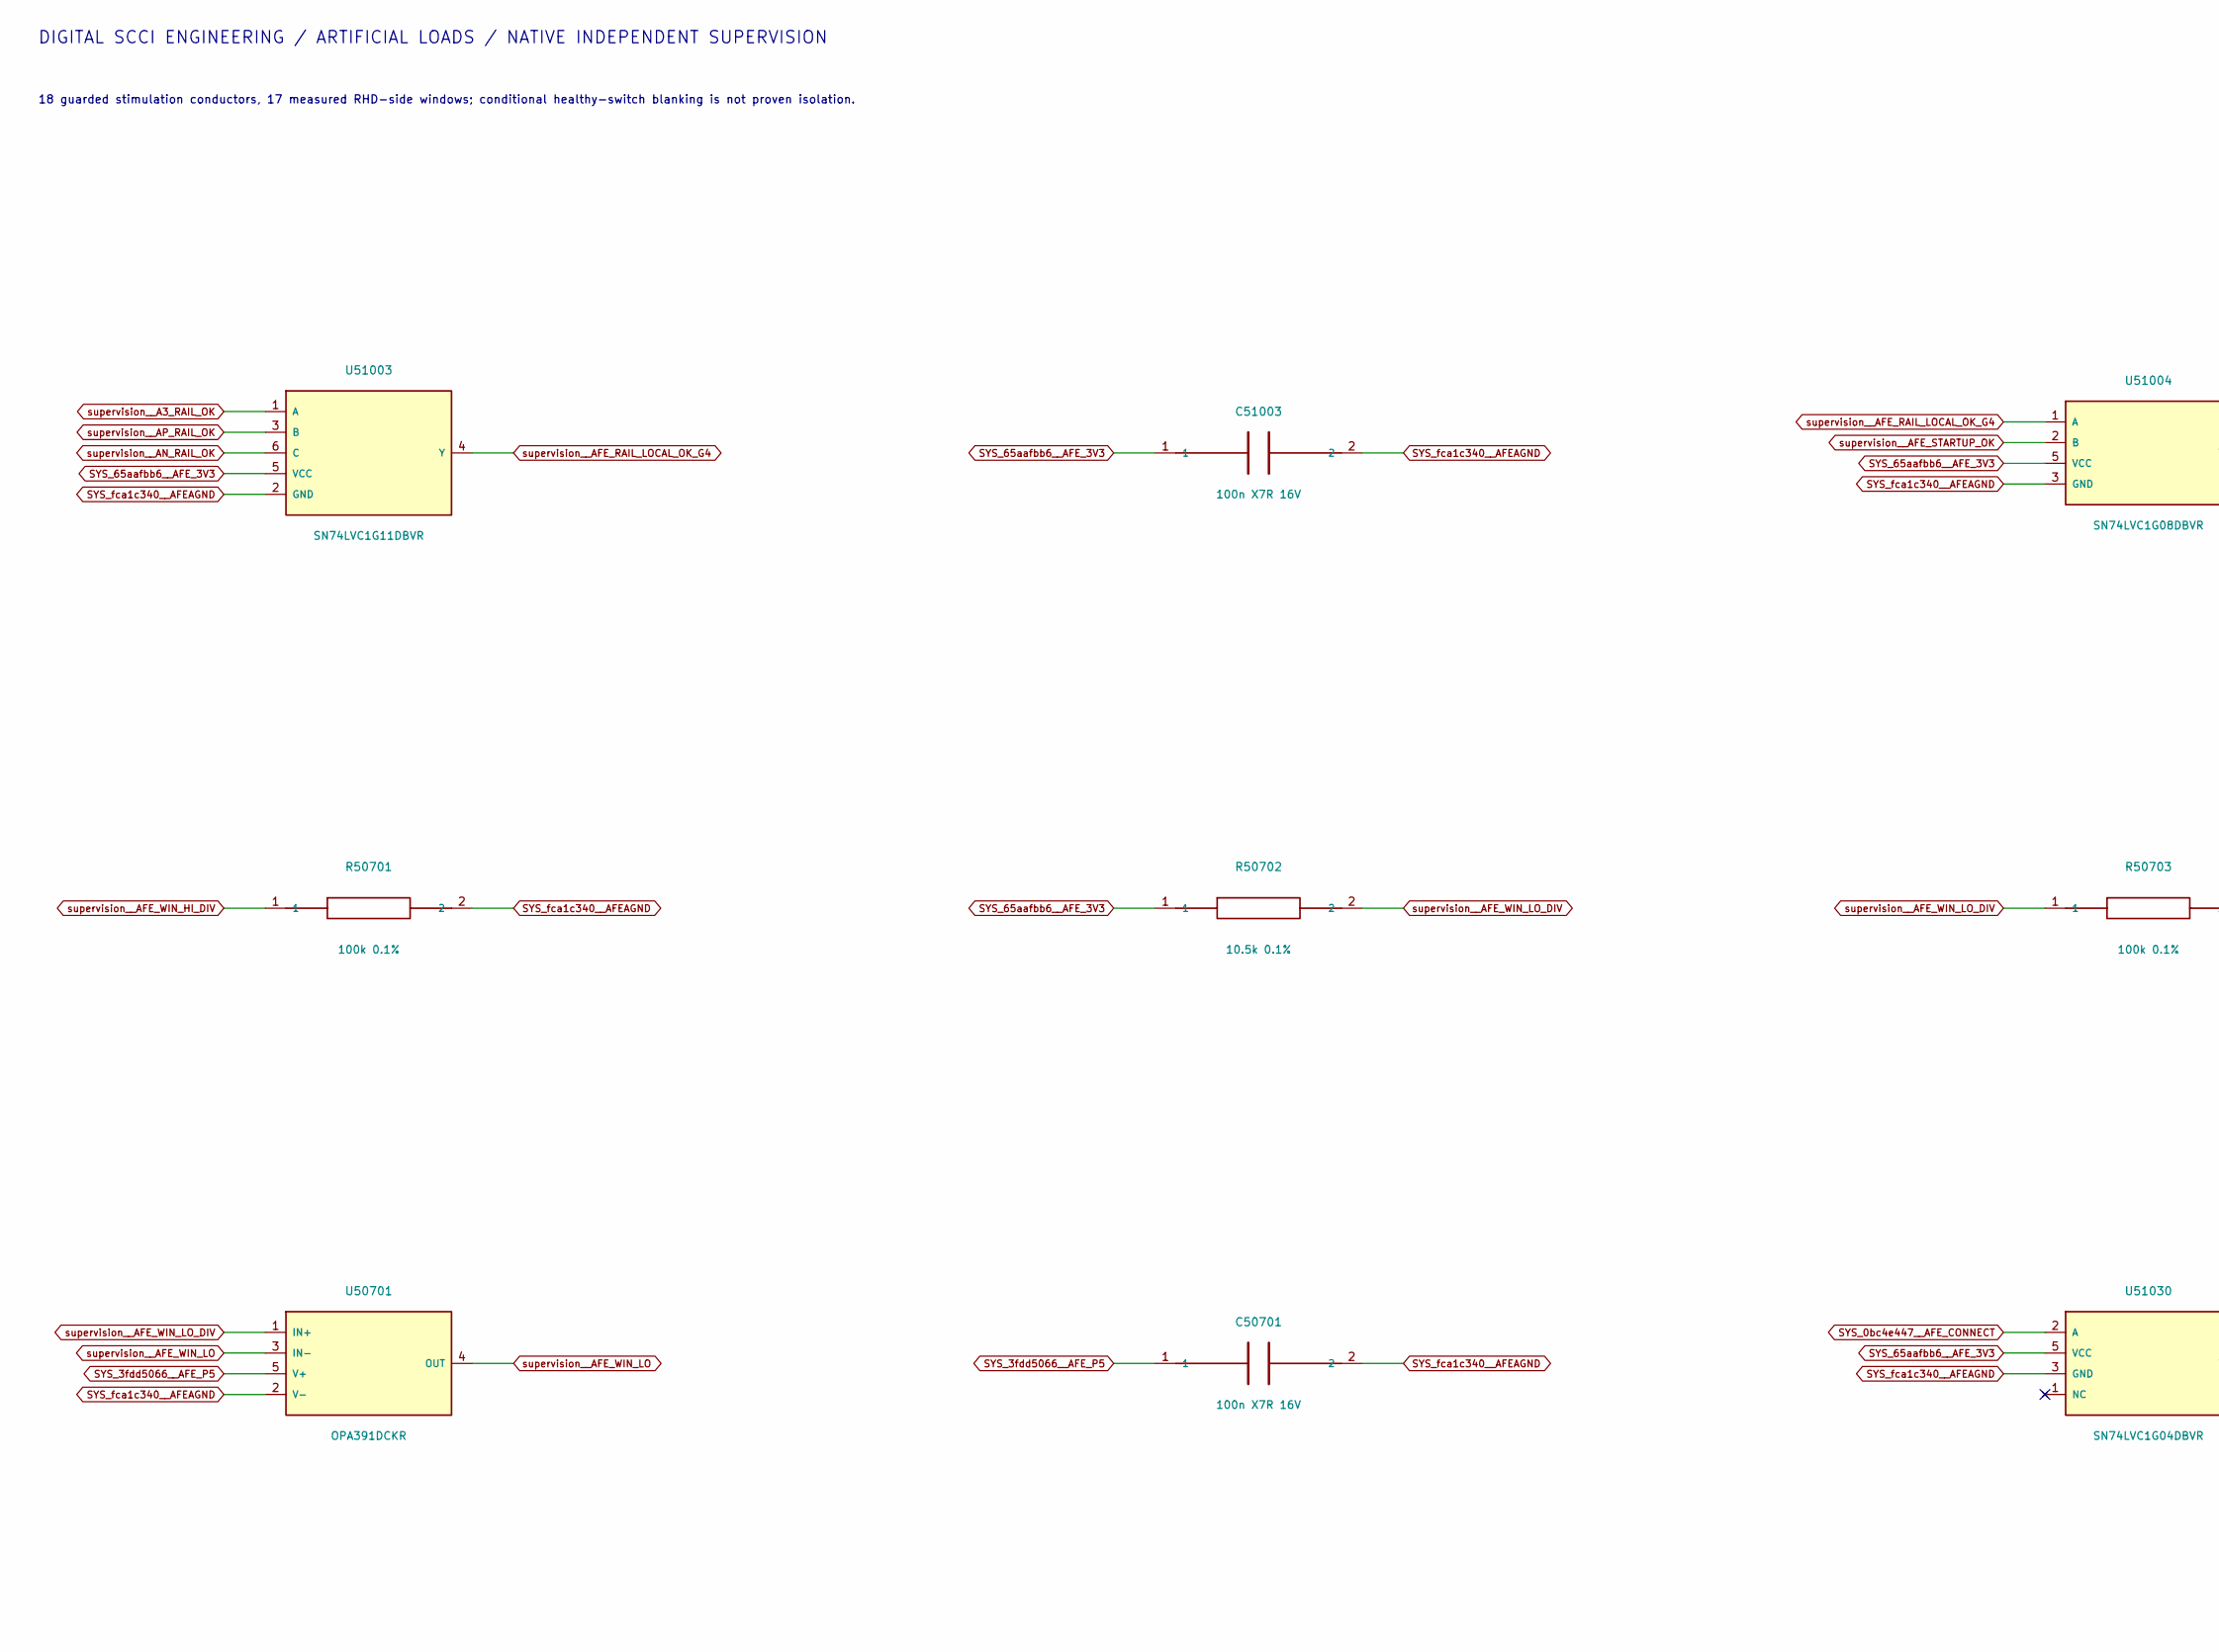
[picture p298: schematic afe_logic.kicad_sch, Project SCCI RH S4 / AFE blank and isolated status, part in row 1, column 1]

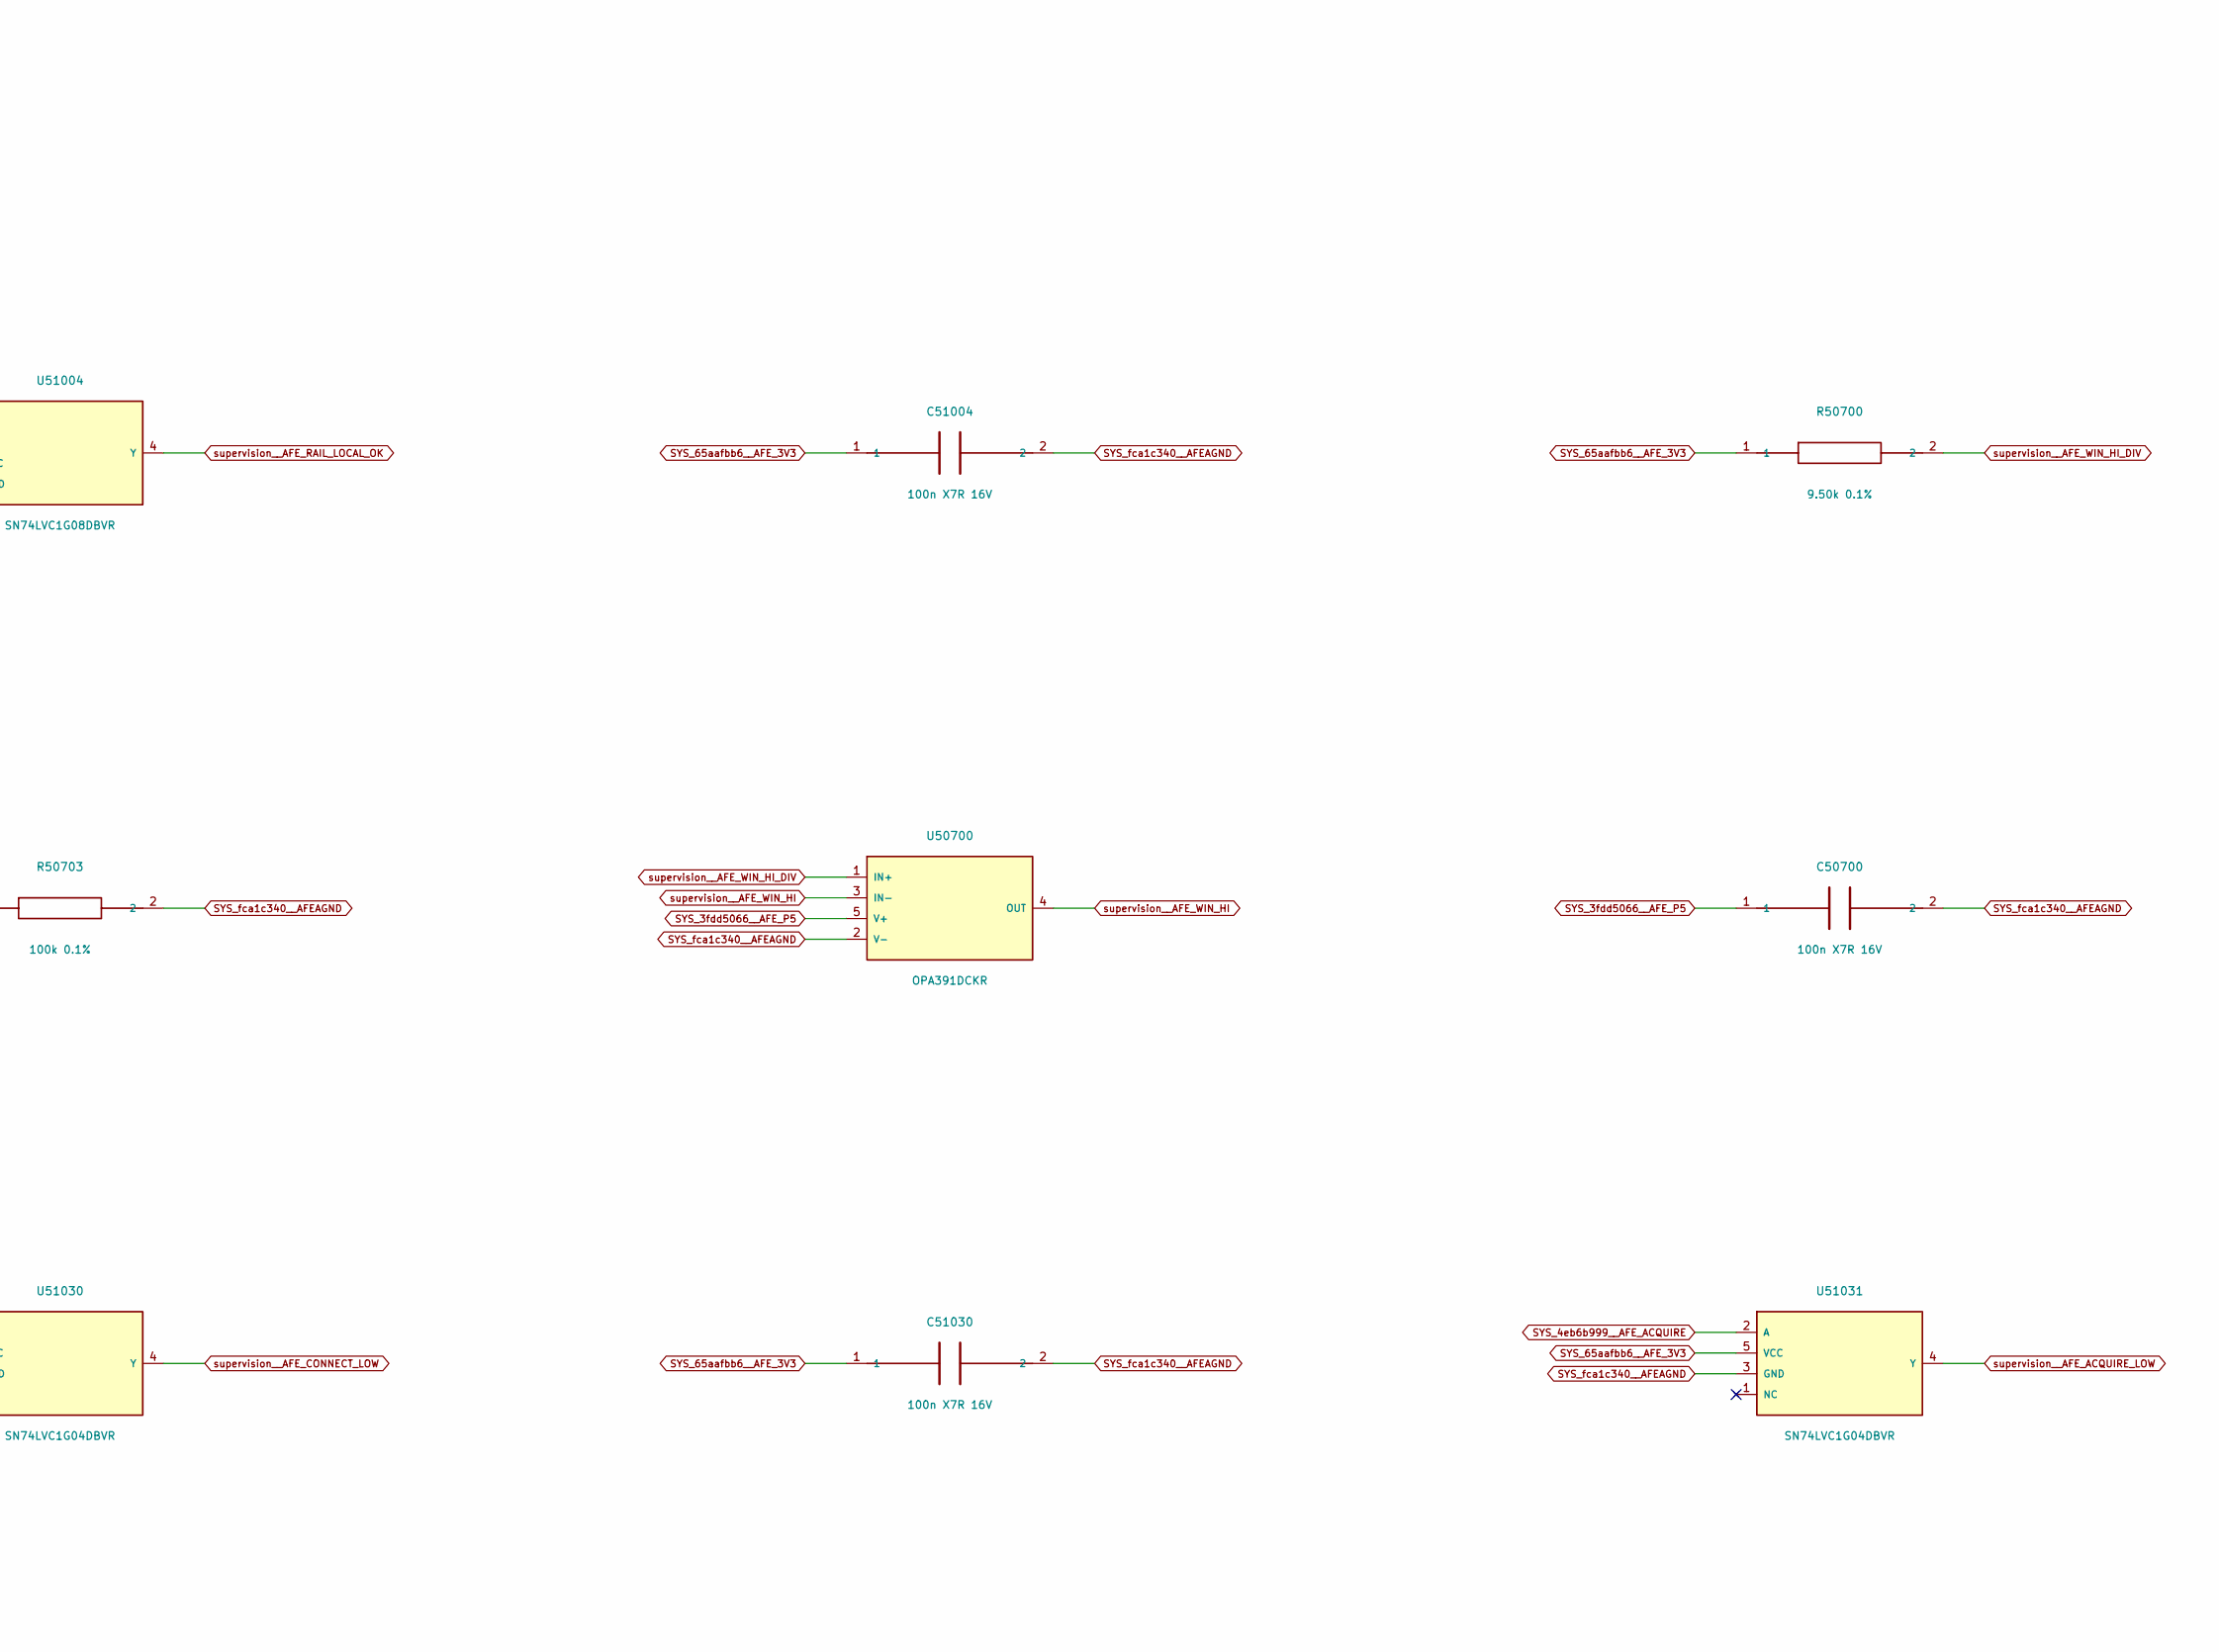
[picture p299: schematic afe_logic.kicad_sch, Project SCCI RH S4 / AFE blank and isolated status, part in row 1, column 2]

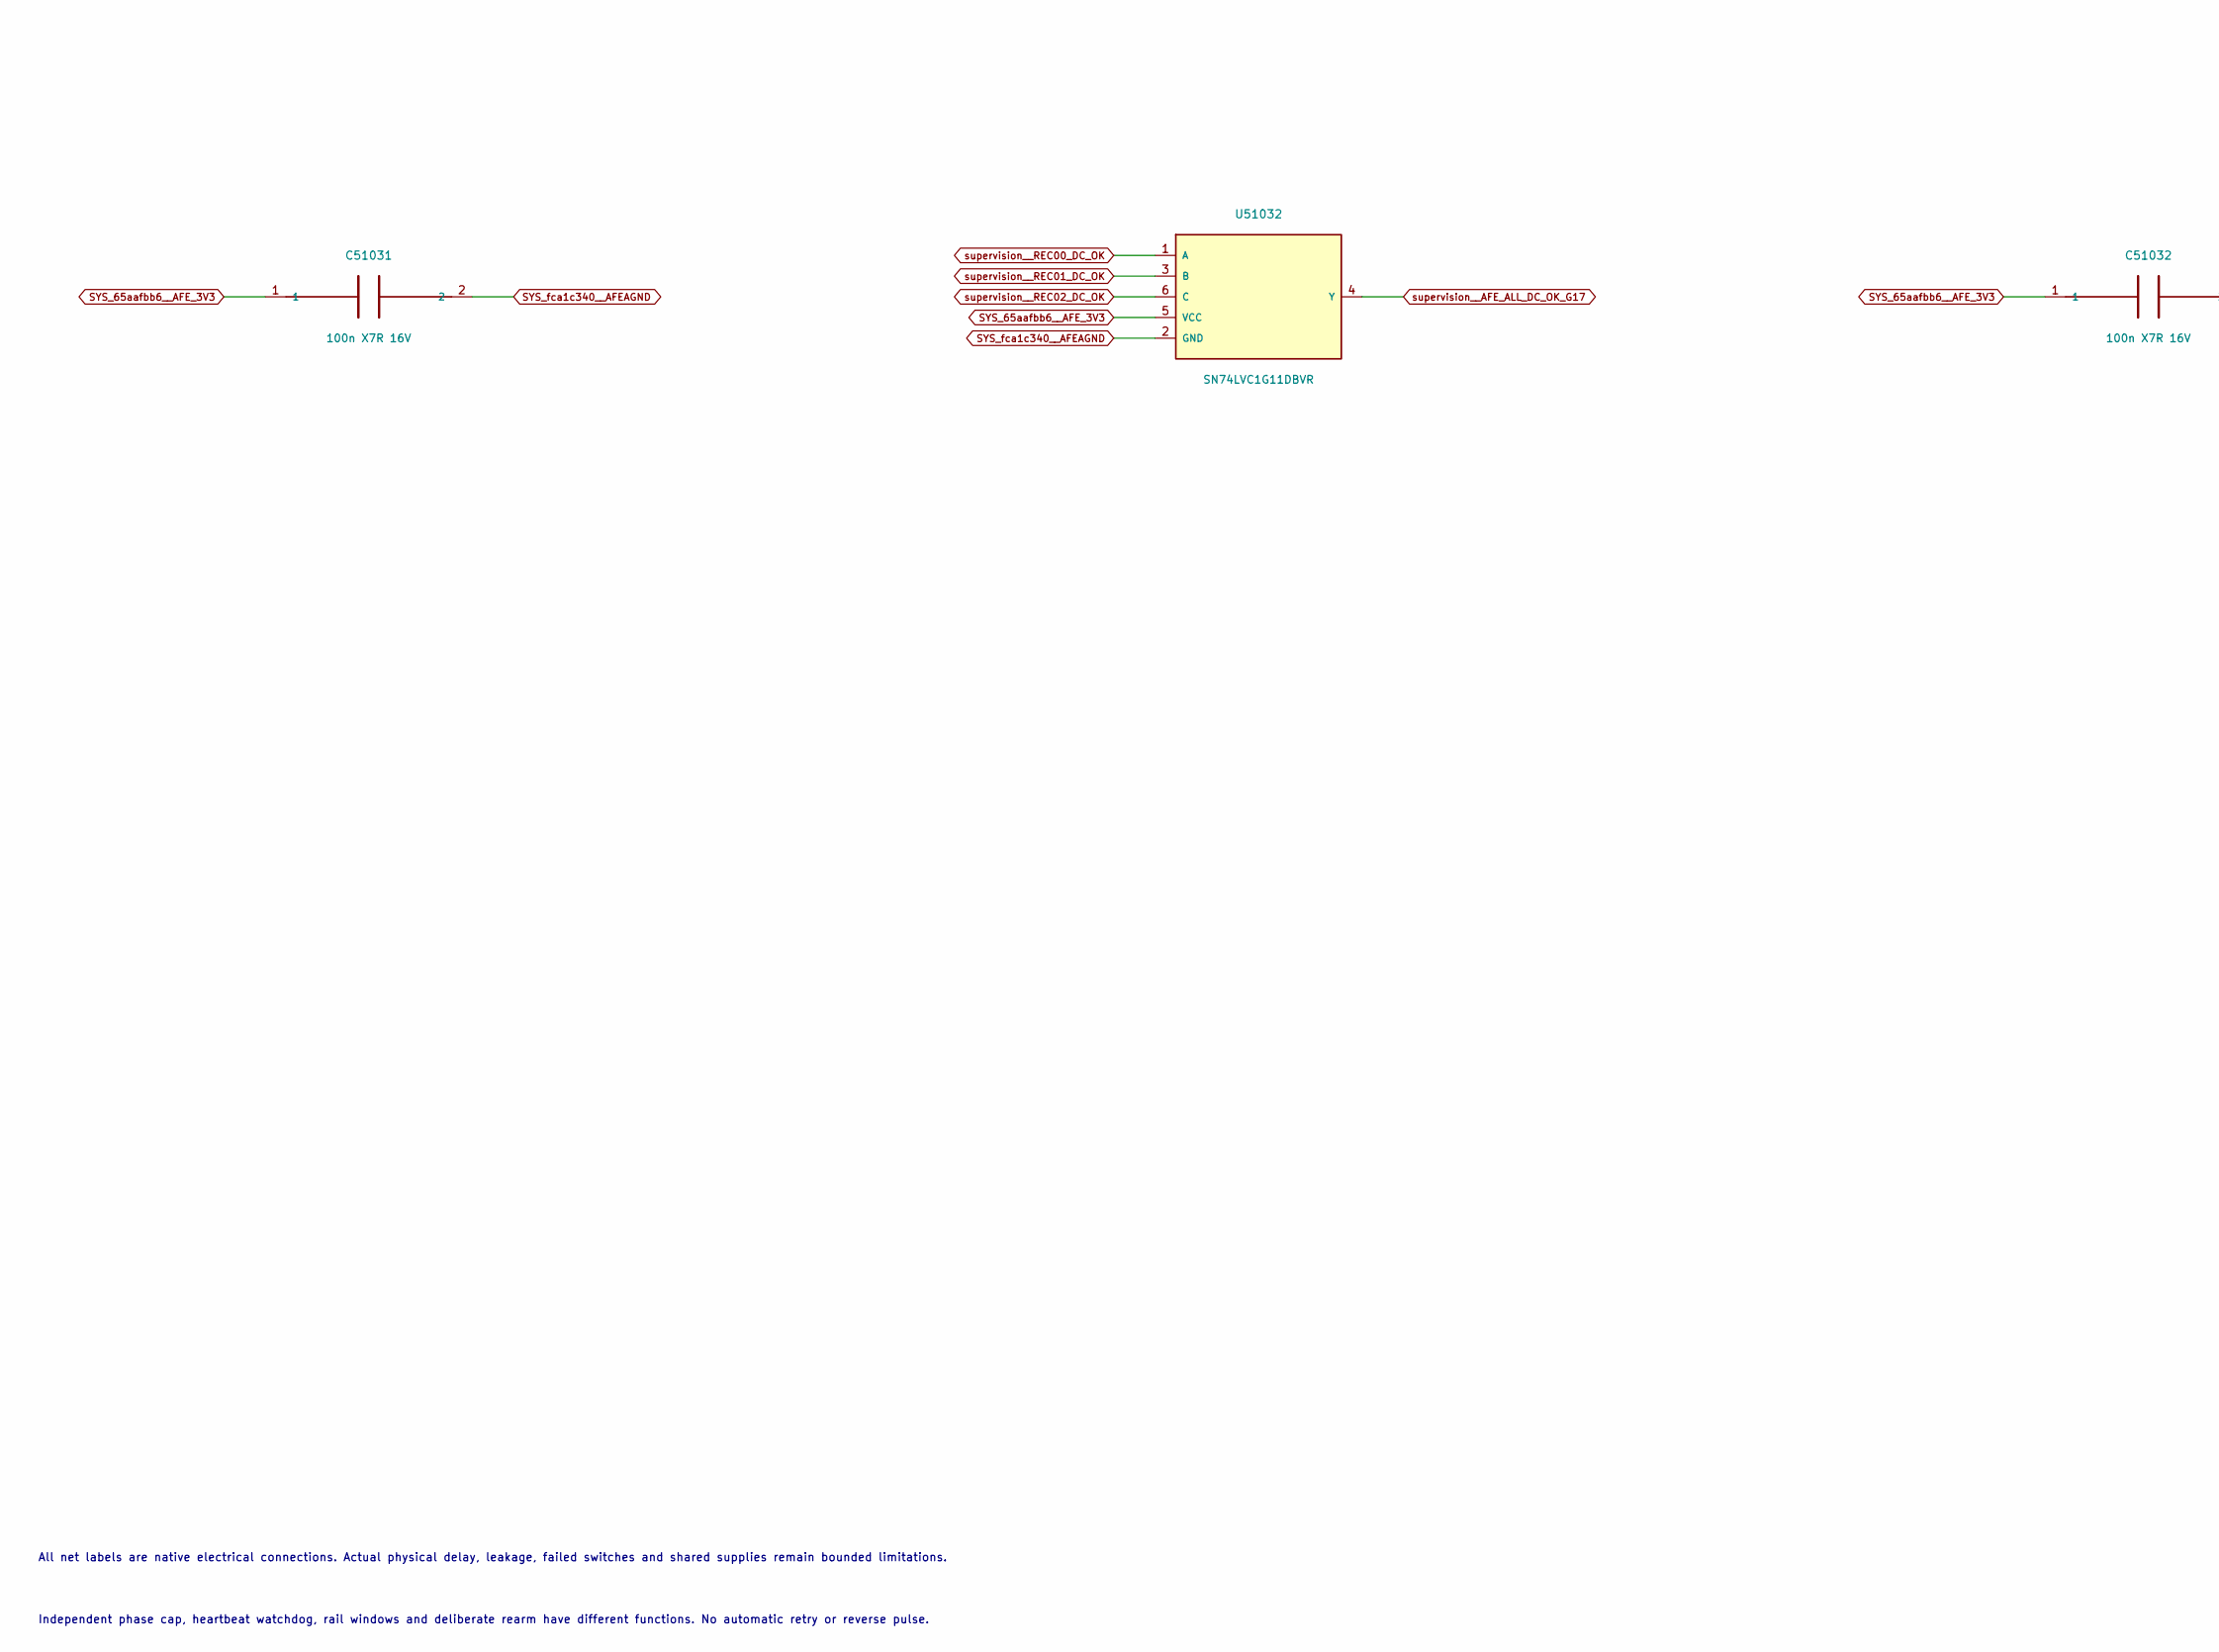
[picture p300: schematic afe_logic.kicad_sch, Project SCCI RH S4 / AFE blank and isolated status, part in row 2, column 1]

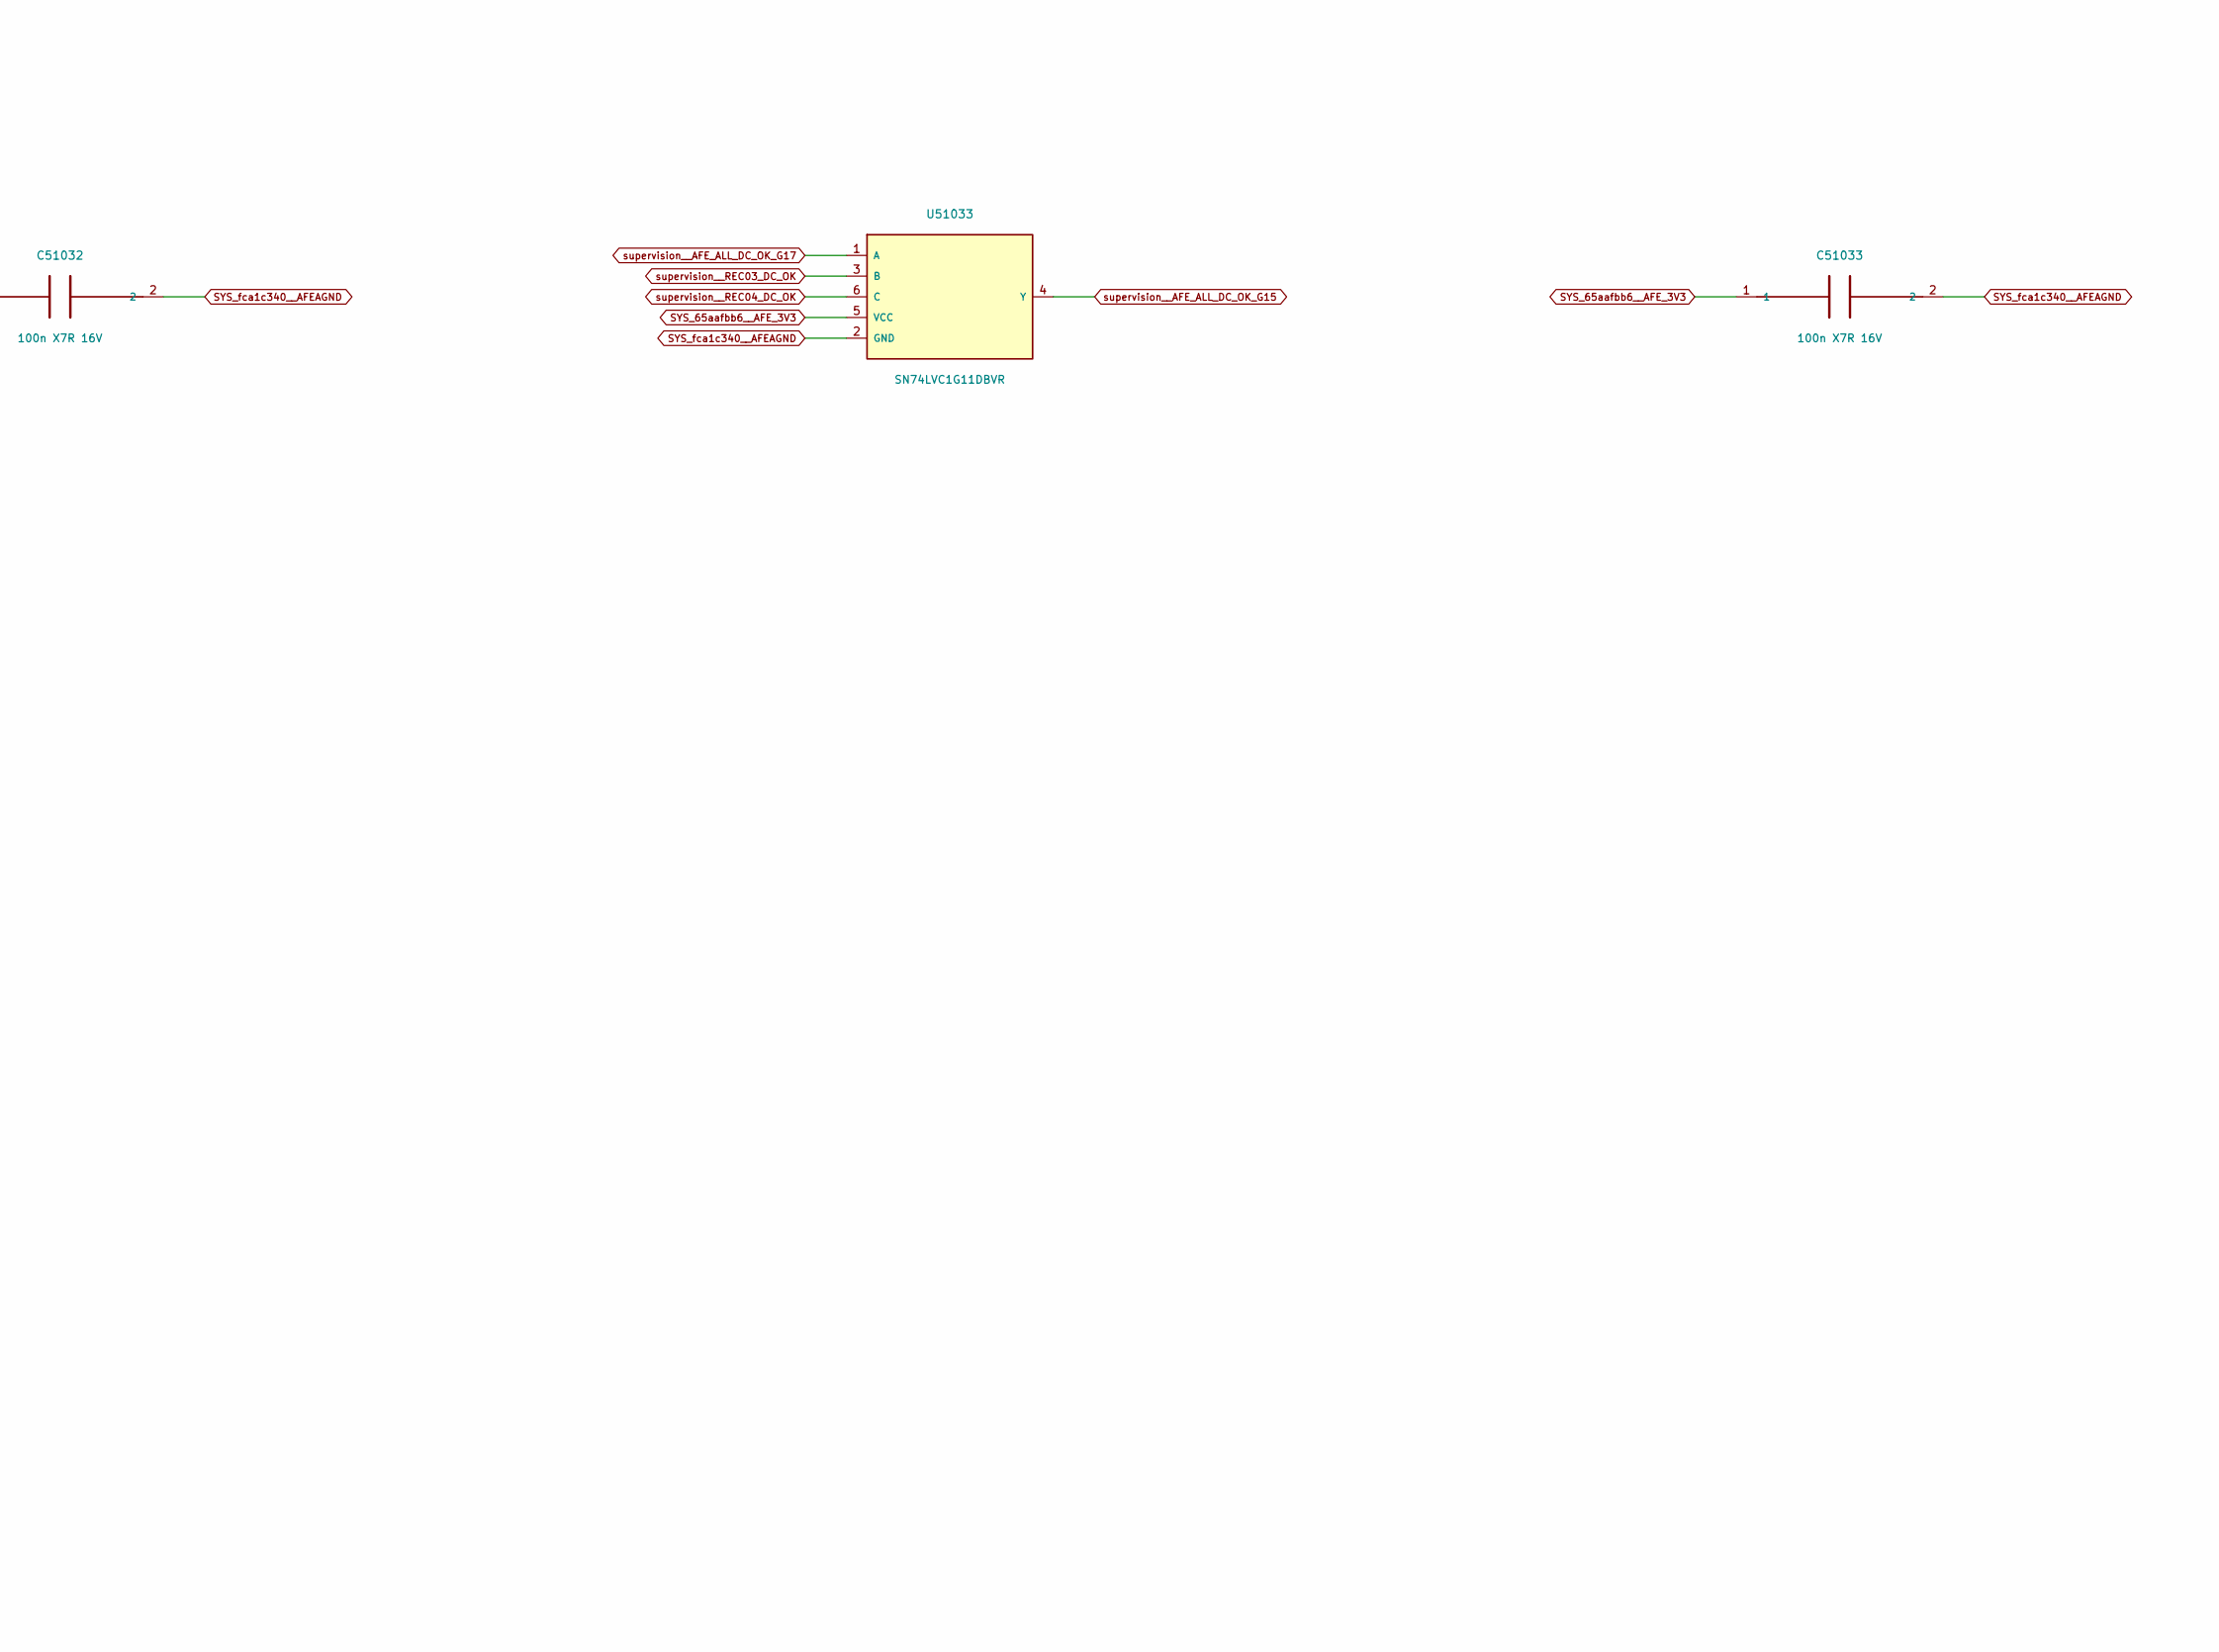
[picture p301: schematic afe_logic.kicad_sch, Project SCCI RH S4 / AFE blank and isolated status, part in row 2, column 2]

Parts:
C50700, C50701, C51003, C51004, C51030, C51031, C51032, C51033: 100n X7R 16V; C_0805_2012Metric
R50700: 9.50k 0.1%; R_0805_2012Metric
R50701, R50703: 100k 0.1%; R_0805_2012Metric
R50702: 10.5k 0.1%; R_0805_2012Metric
U50700, U50701: OPA391DCKR; SOT-353_SC-70-5
U51003, U51032, U51033: SN74LVC1G11DBVR; SOT-23-6
U51004: SN74LVC1G08DBVR; SOT-23-5
U51030, U51031: SN74LVC1G04DBVR; SOT-23-5

Connections:
SYS_0bc4e447__AFE_CONNECT: U51030.2 (A); also elsewhere on the board
SYS_3fdd5066__AFE_P5: C50700.1, C50701.1, U50700.5 (V+), U50701.5 (V+); also elsewhere on the board
SYS_4eb6b999__AFE_ACQUIRE: U51031.2 (A); also elsewhere on the board
SYS_65aafbb6__AFE_3V3: C51003.1, C51004.1, C51030.1, C51031.1, C51032.1, C51033.1, R50700.1, R50702.1, U51003.5 (VCC), U51004.5 (VCC), U51030.5 (VCC), U51031.5 (VCC), U51032.5 (VCC), U51033.5 (VCC); also elsewhere on the board
SYS_fca1c340__AFEAGND: C50700.2, C50701.2, C51003.2, C51004.2, C51030.2, C51031.2, C51032.2, C51033.2, R50701.2, R50703.2, U50700.2 (V-), U50701.2 (V-), U51003.2 (GND), U51004.3 (GND), U51030.3 (GND), U51031.3 (GND), U51032.2 (GND), U51033.2 (GND); also elsewhere on the board
supervision__A3_RAIL_OK: U51003.1 (A); also elsewhere on the board
supervision__AFE_ACQUIRE_LOW: U51031.4 (Y); also elsewhere on the board
supervision__AFE_ALL_DC_OK_G15: U51033.4 (Y); also elsewhere on the board
supervision__AFE_ALL_DC_OK_G17: U51032.4 (Y), U51033.1 (A)
supervision__AFE_CONNECT_LOW: U51030.4 (Y); also elsewhere on the board
supervision__AFE_RAIL_LOCAL_OK: U51004.4 (Y); also elsewhere on the board
supervision__AFE_RAIL_LOCAL_OK_G4: U51003.4 (Y), U51004.1 (A)
supervision__AFE_STARTUP_OK: U51004.2 (B); also elsewhere on the board
supervision__AFE_WIN_HI: U50700.3 (IN-), U50700.4 (OUT); also elsewhere on the board
supervision__AFE_WIN_HI_DIV: R50700.2, R50701.1, U50700.1 (IN+)
supervision__AFE_WIN_LO: U50701.3 (IN-), U50701.4 (OUT); also elsewhere on the board
supervision__AFE_WIN_LO_DIV: R50702.2, R50703.1, U50701.1 (IN+)
supervision__AN_RAIL_OK: U51003.6 (C); also elsewhere on the board
supervision__AP_RAIL_OK: U51003.3 (B); also elsewhere on the board
supervision__REC00_DC_OK: U51032.1 (A); also elsewhere on the board
supervision__REC01_DC_OK: U51032.3 (B); also elsewhere on the board
supervision__REC02_DC_OK: U51032.6 (C); also elsewhere on the board
supervision__REC03_DC_OK: U51033.3 (B); also elsewhere on the board
supervision__REC04_DC_OK: U51033.6 (C); also elsewhere on the board

Notes on the sheet:
DIGITAL SCCI ENGINEERING / ARTIFICIAL LOADS / NATIVE INDEPENDENT SUPERVISION
18 guarded stimulation conductors, 17 measured RHD-side windows; conditional healthy-switch blanking is not proven isolation.
All net labels are native electrical connections. Actual physical delay, leakage, failed switches and shared supplies remain bounded limitations.
Independent phase cap, heartbeat watchdog, rail windows and deliberate rearm have different functions. No automatic retry or reverse pulse.
