pratham-cloud-ctrl/Project-SCCI-RH/electronics/stage4/integrated-pcb/boards/supervision/supervision.kicad_pcb

## KiCad design electronics/stage4/integrated-pcb/boards/supervision/supervision.kicad_pcb (continued)

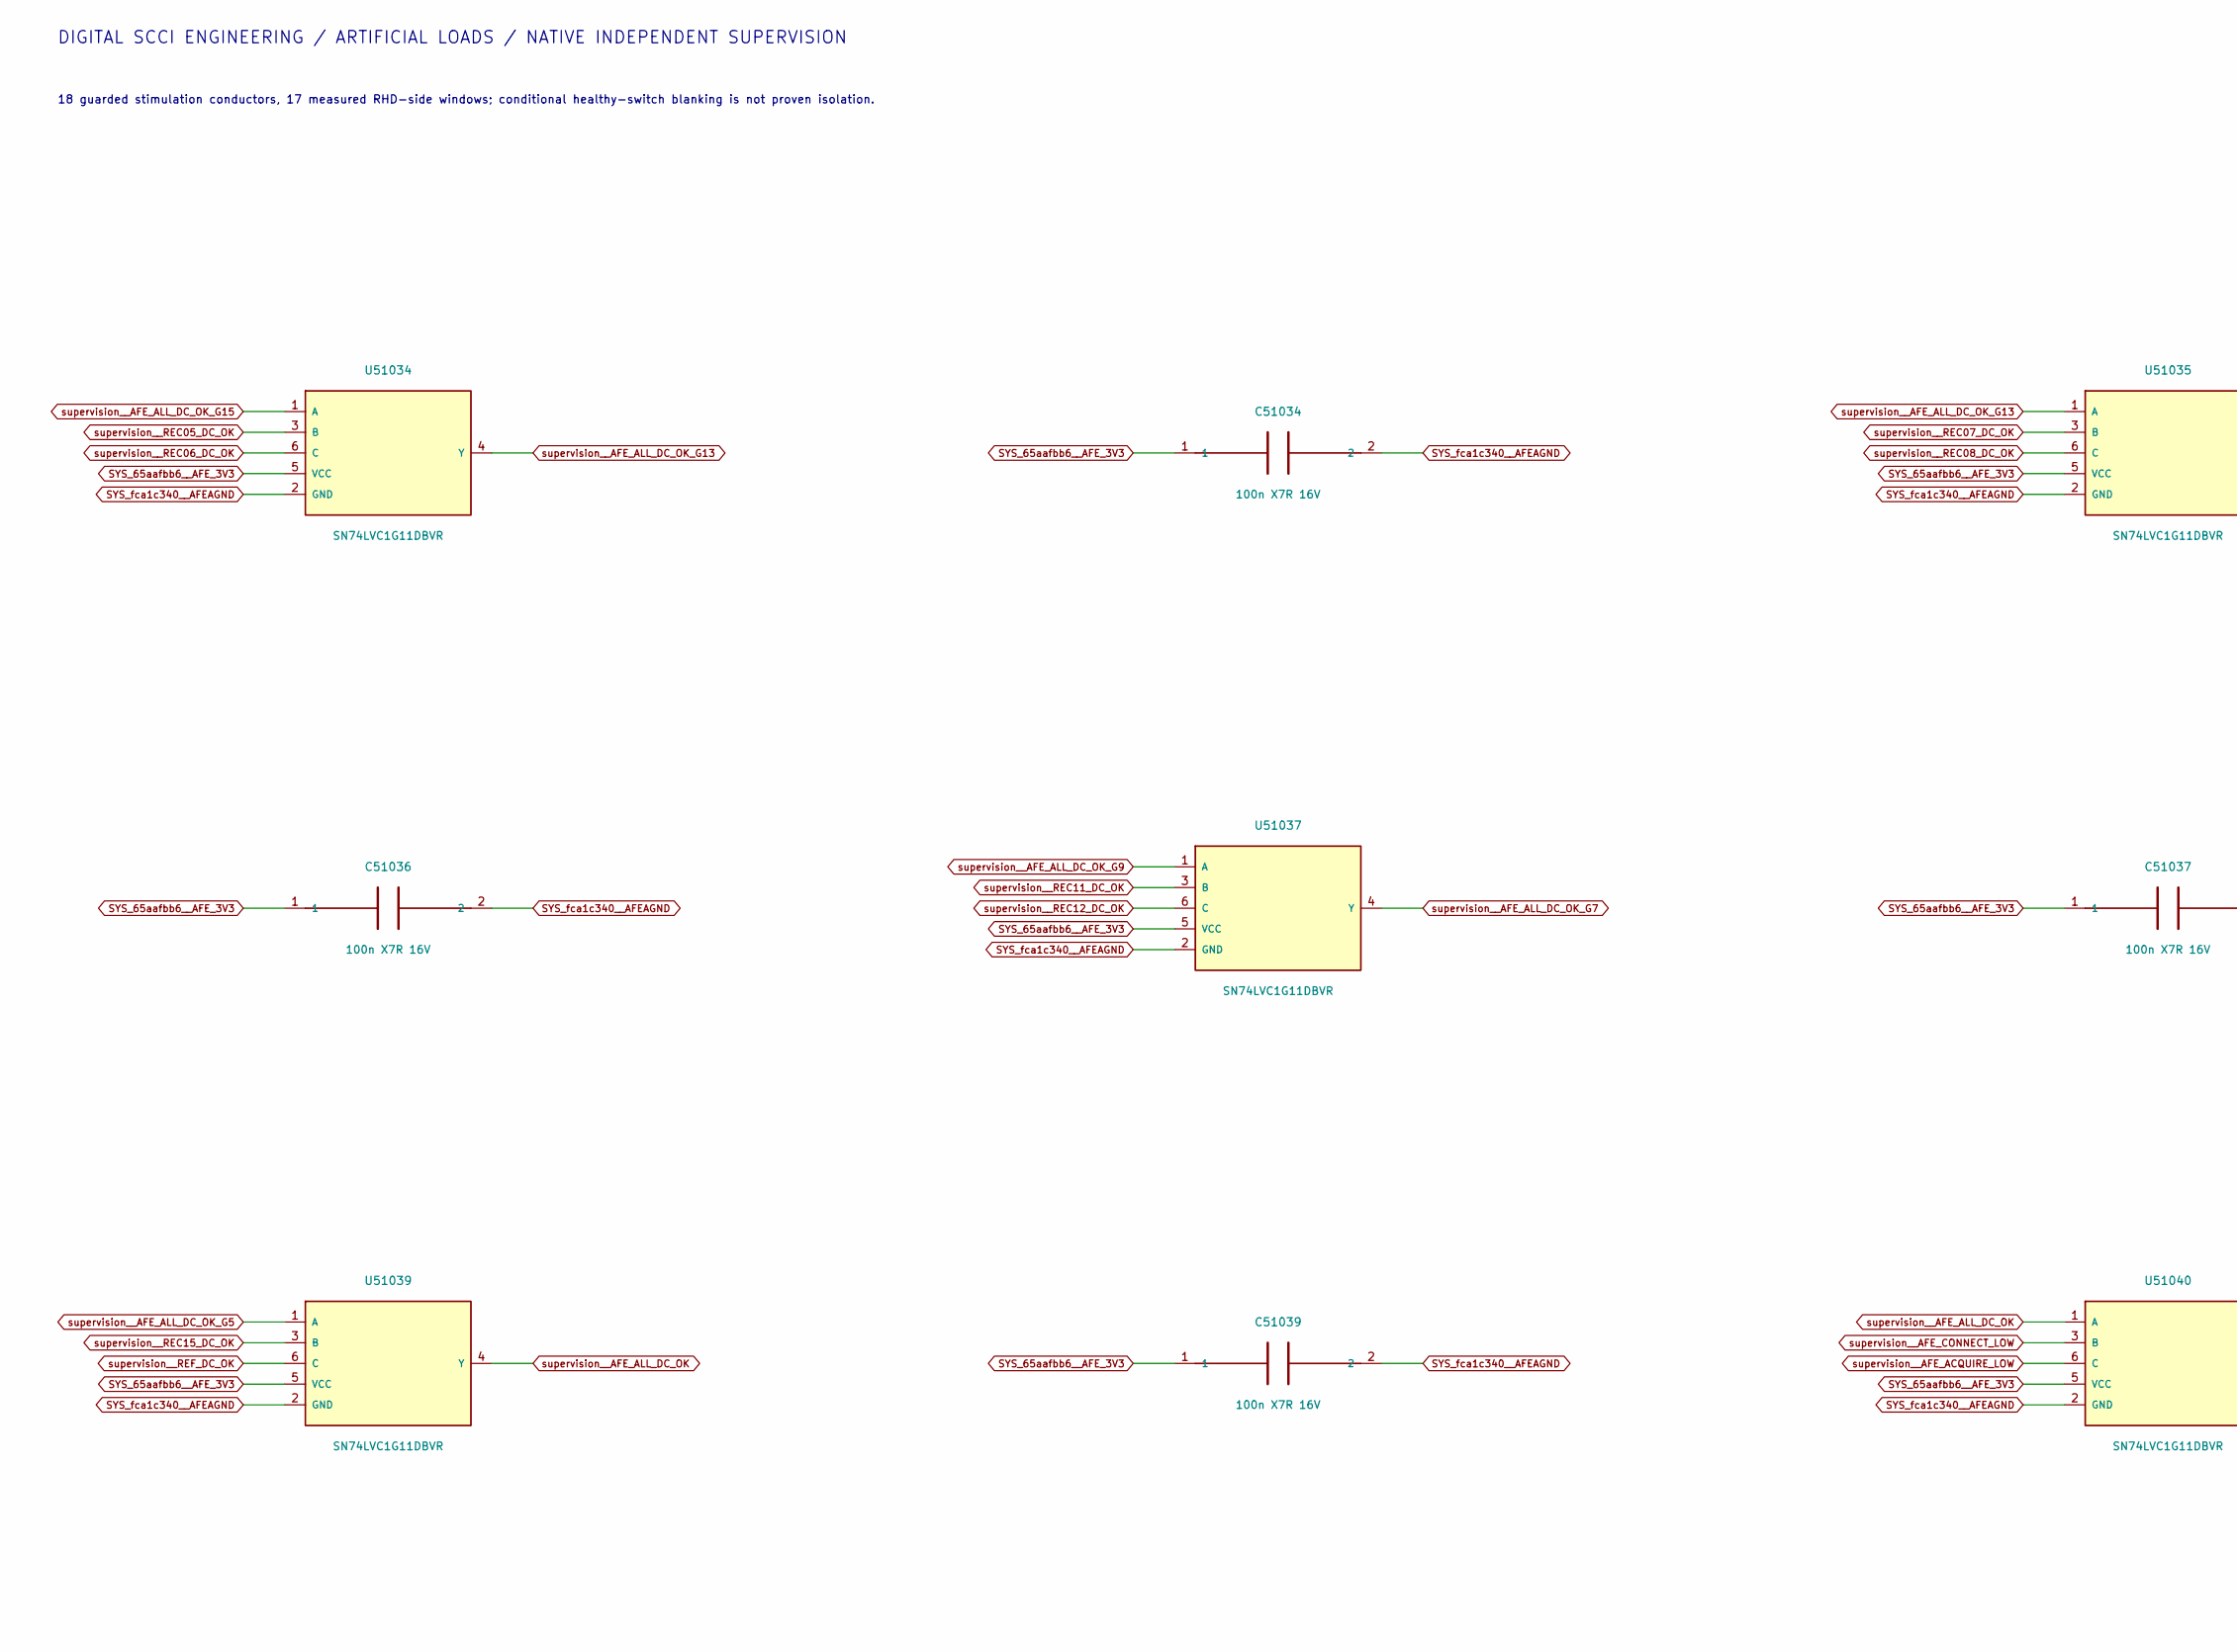
[picture p302: schematic afe_logic_2.kicad_sch, Project SCCI RH S4 / AFE blank and isolated status / 2, part in row 1, column 1]

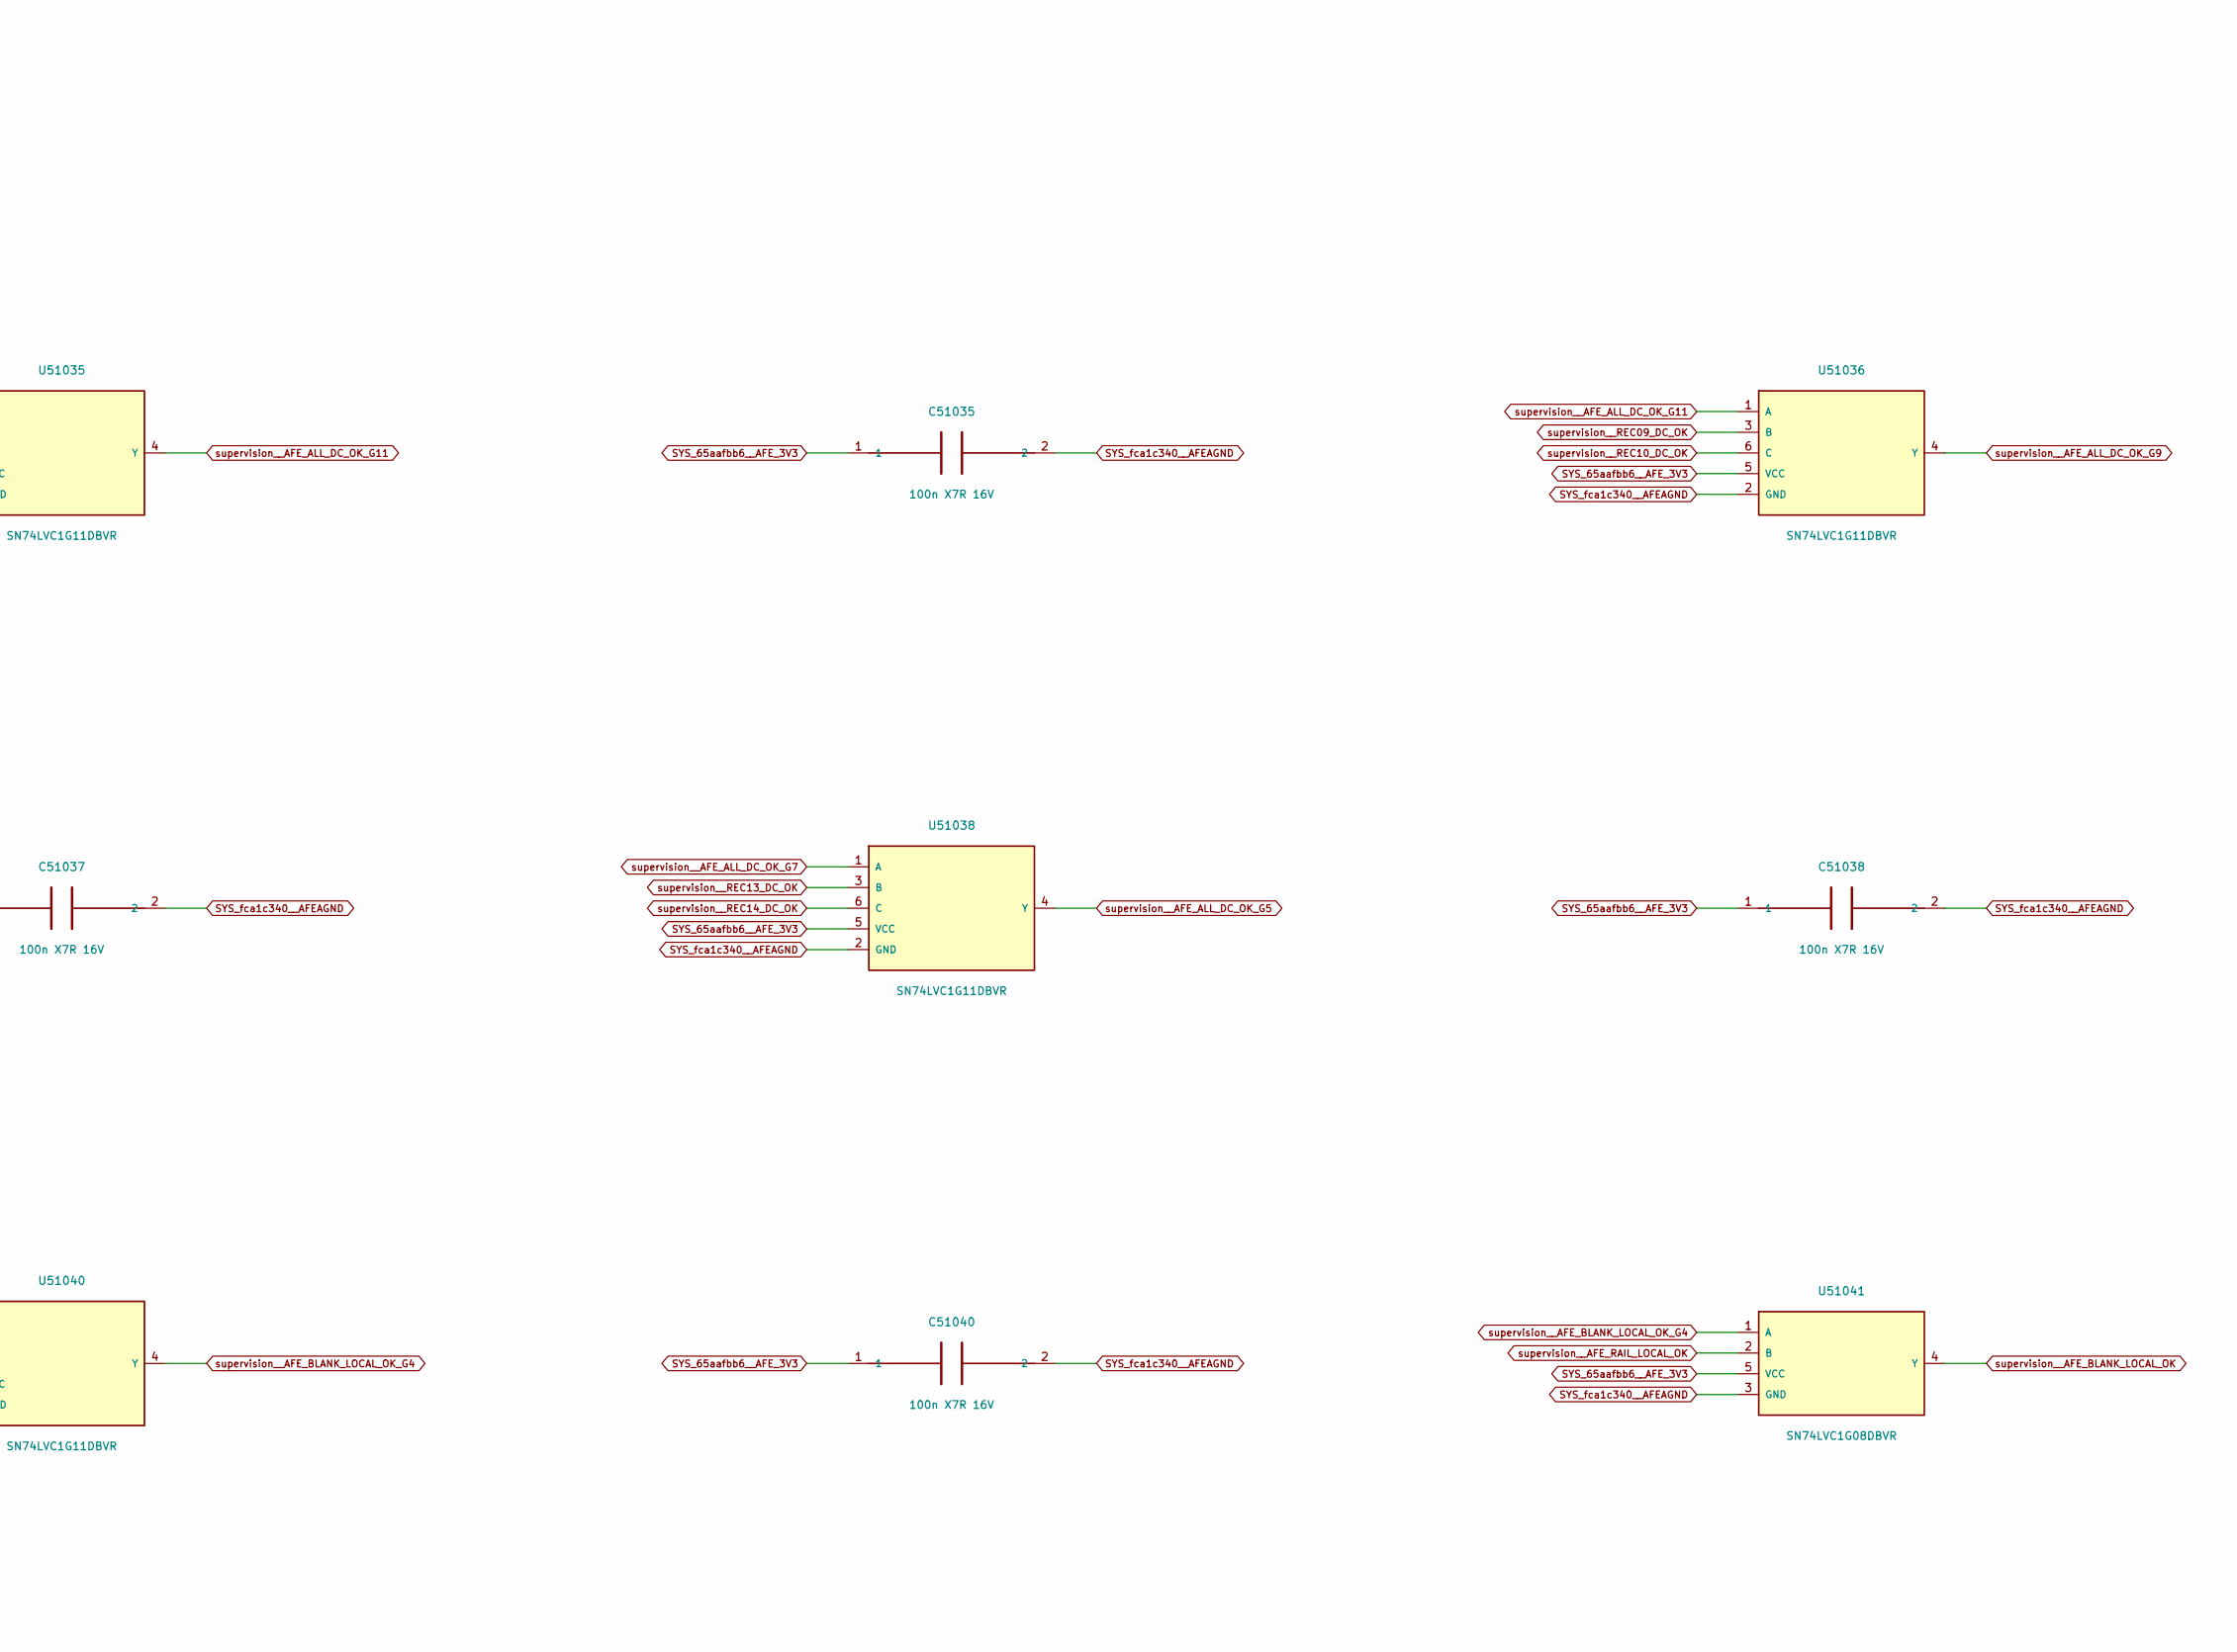
[picture p303: schematic afe_logic_2.kicad_sch, Project SCCI RH S4 / AFE blank and isolated status / 2, part in row 1, column 2]

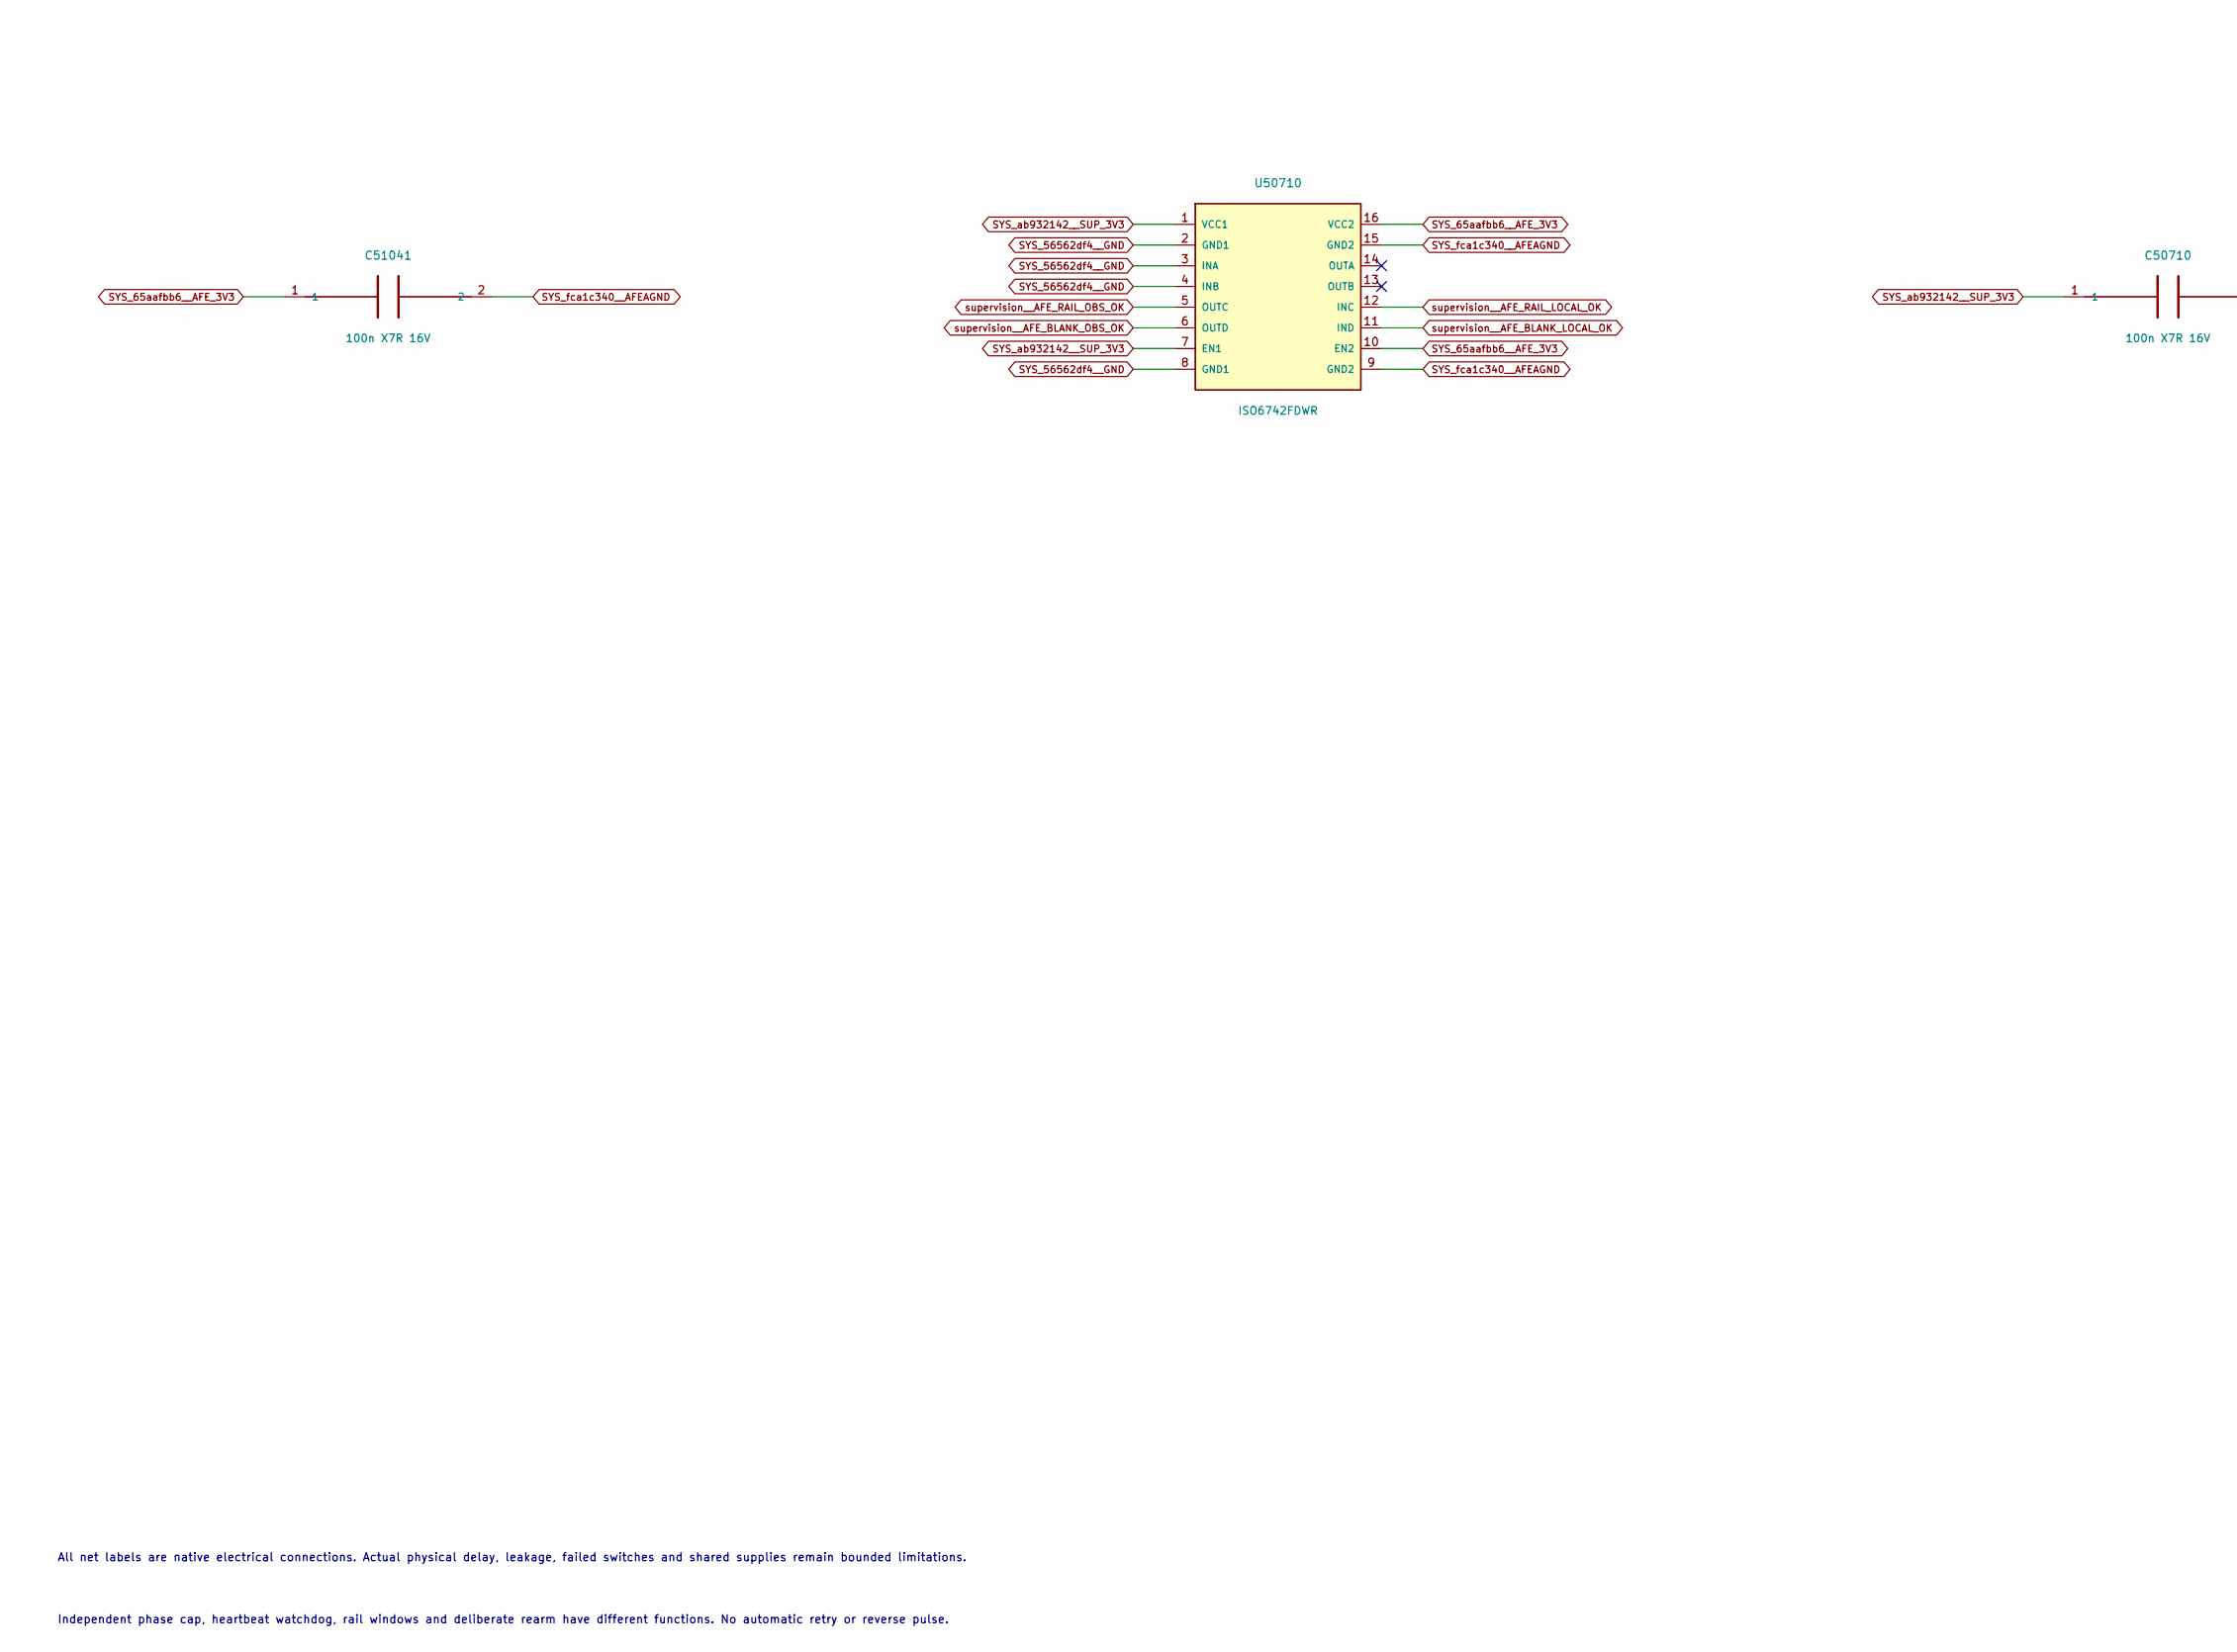
[picture p304: schematic afe_logic_2.kicad_sch, Project SCCI RH S4 / AFE blank and isolated status / 2, part in row 2, column 1]

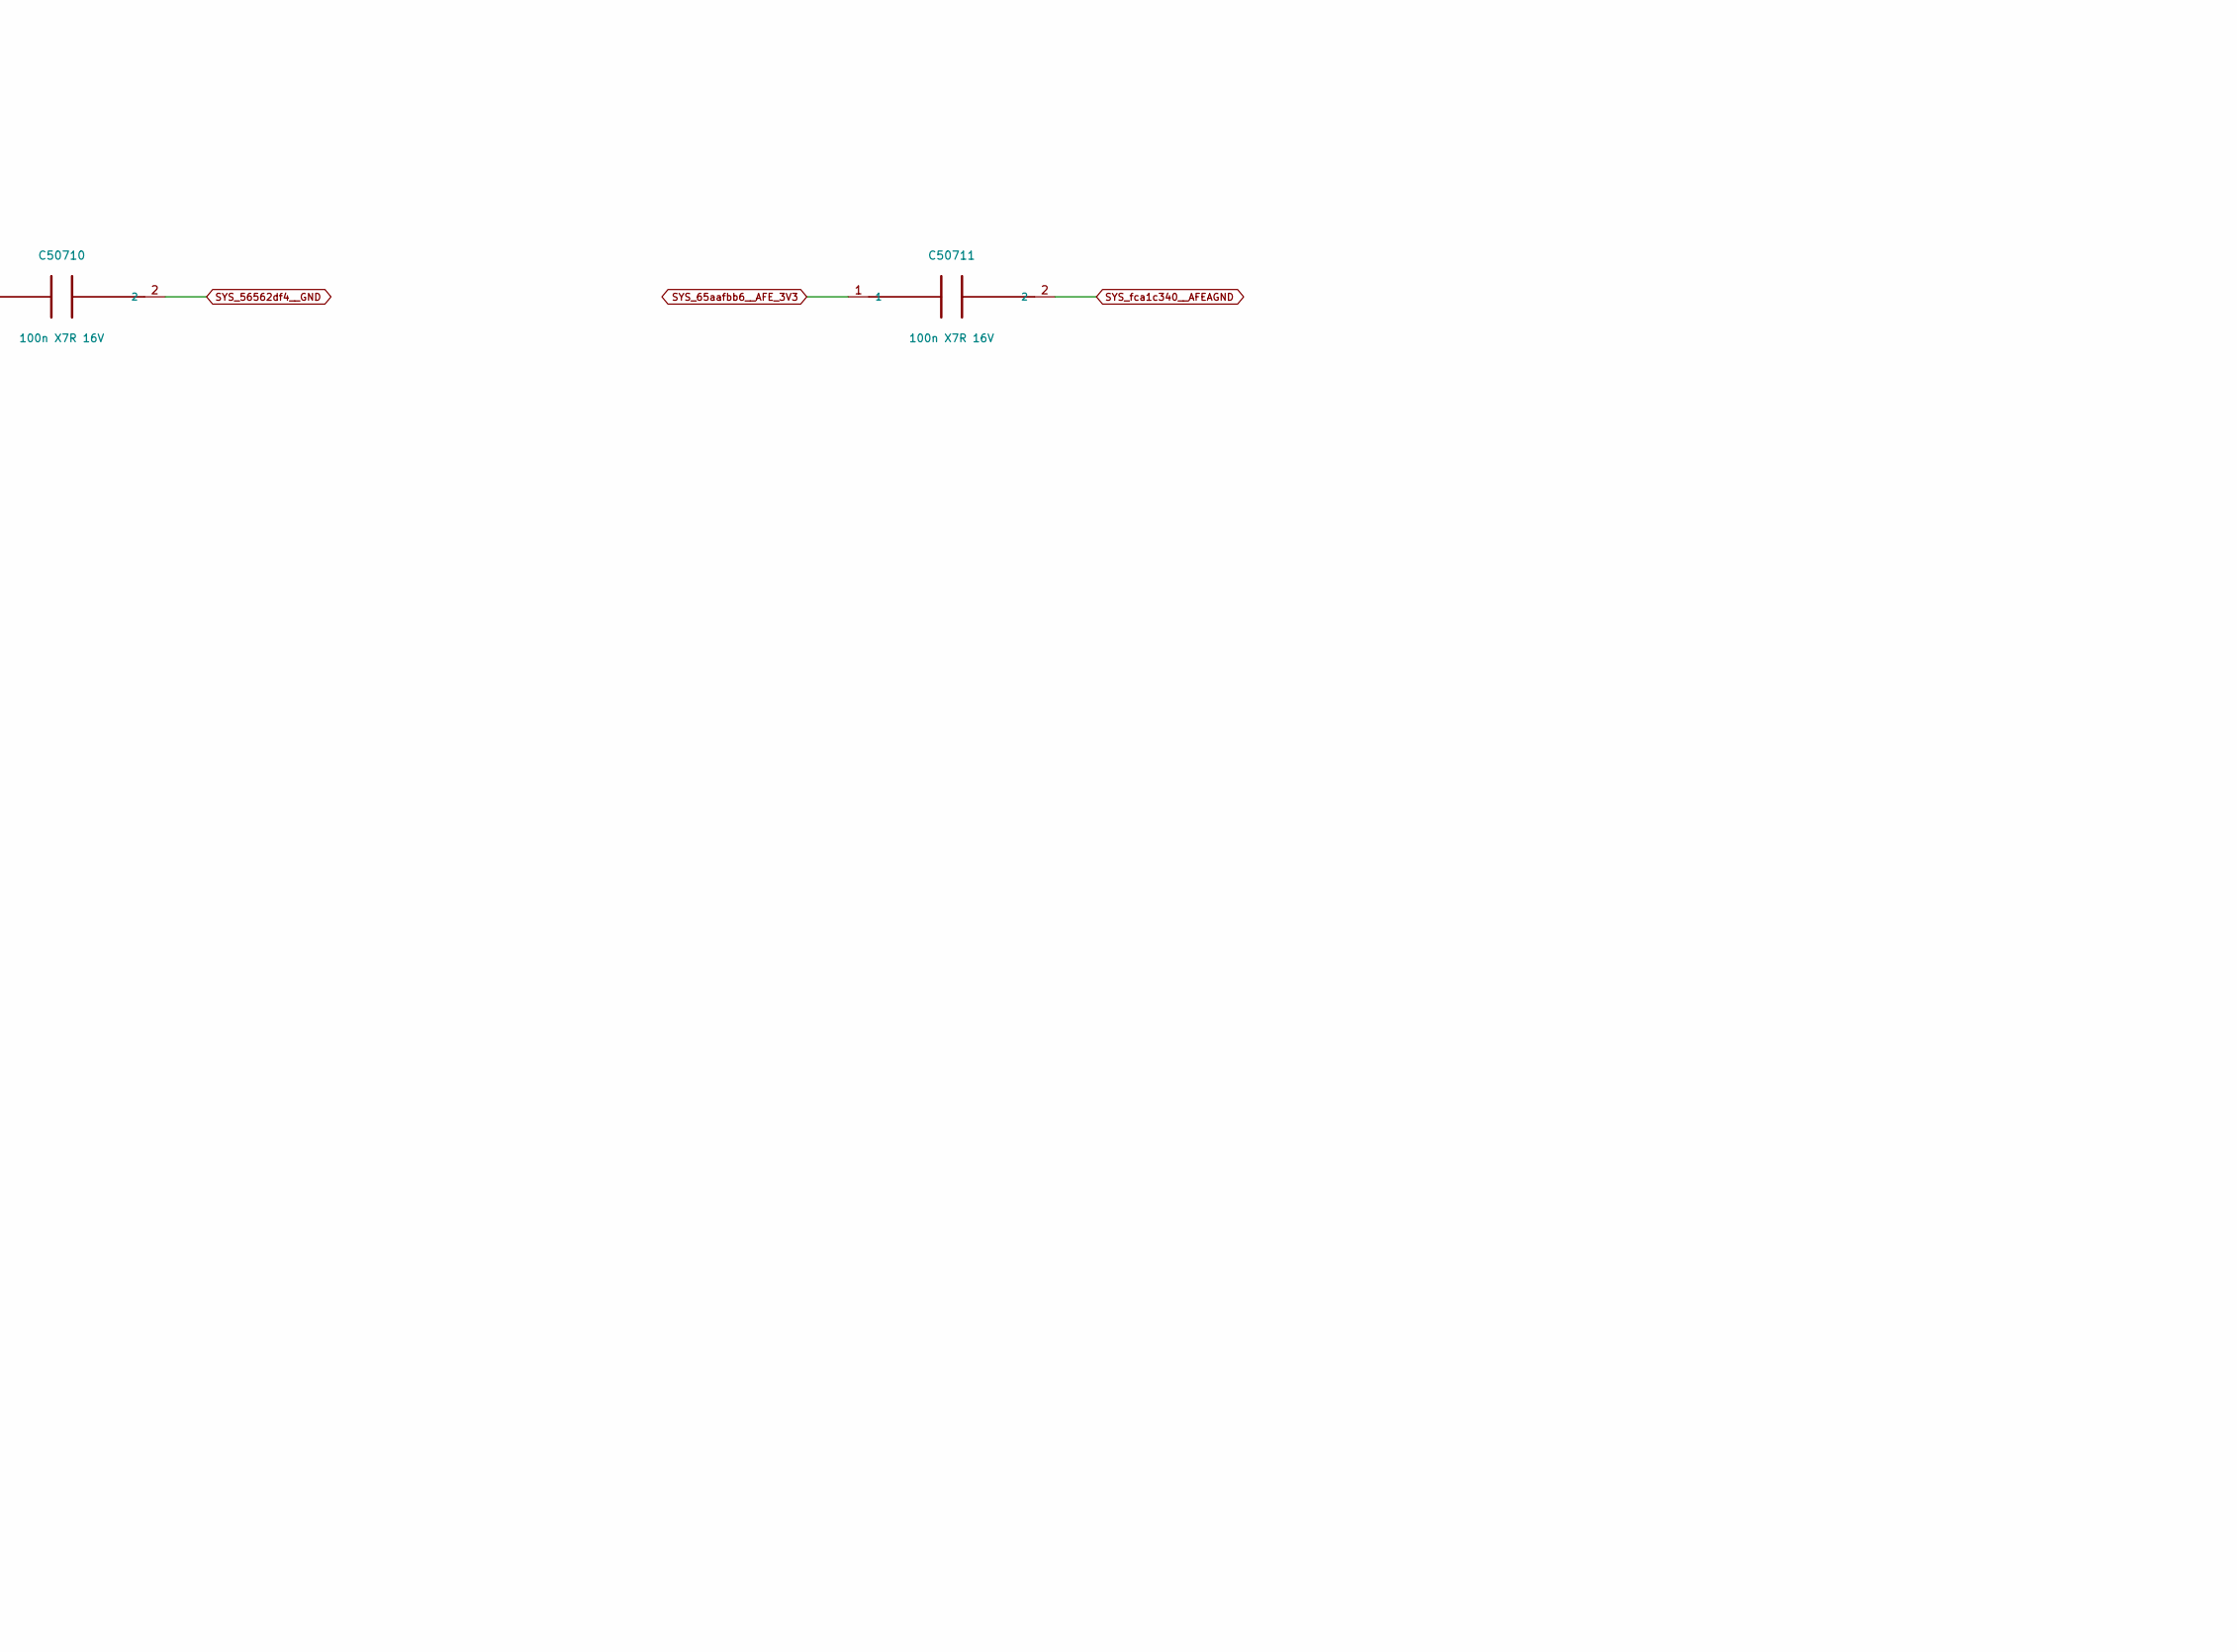
[picture p305: schematic afe_logic_2.kicad_sch, Project SCCI RH S4 / AFE blank and isolated status / 2, part in row 2, column 2]

Parts:
C50710, C50711, C51034, C51035, C51036, C51037, C51038, C51039, C51040, C51041: 100n X7R 16V; C_0805_2012Metric
U50710: ISO6742FDWR; SOIC-16W_7.5x10.3mm_P1.27mm
U51034, U51035, U51036, U51037, U51038, U51039, U51040: SN74LVC1G11DBVR; SOT-23-6
U51041: SN74LVC1G08DBVR; SOT-23-5

Connections:
SYS_65aafbb6__AFE_3V3: C50711.1, C51034.1, C51035.1, C51036.1, C51037.1, C51038.1, C51039.1, C51040.1, C51041.1, U50710.10 (EN2), U50710.16 (VCC2), U51034.5 (VCC), U51035.5 (VCC), U51036.5 (VCC), U51037.5 (VCC), U51038.5 (VCC), U51039.5 (VCC), U51040.5 (VCC), U51041.5 (VCC); also elsewhere on the board
SYS_56562df4__GND: C50710.2, U50710.2 (GND1), U50710.3 (INA), U50710.4 (INB), U50710.8 (GND1); also elsewhere on the board
SYS_ab932142__SUP_3V3: C50710.1, U50710.1 (VCC1), U50710.7 (EN1); also elsewhere on the board
SYS_fca1c340__AFEAGND: C50711.2, C51034.2, C51035.2, C51036.2, C51037.2, C51038.2, C51039.2, C51040.2, C51041.2, U50710.9 (GND2), U50710.15 (GND2), U51034.2 (GND), U51035.2 (GND), U51036.2 (GND), U51037.2 (GND), U51038.2 (GND), U51039.2 (GND), U51040.2 (GND), U51041.3 (GND); also elsewhere on the board
supervision__AFE_ACQUIRE_LOW: U51040.6 (C); also elsewhere on the board
supervision__AFE_ALL_DC_OK: U51039.4 (Y), U51040.1 (A)
supervision__AFE_ALL_DC_OK_G5: U51038.4 (Y), U51039.1 (A)
supervision__AFE_ALL_DC_OK_G7: U51037.4 (Y), U51038.1 (A)
supervision__AFE_ALL_DC_OK_G9: U51036.4 (Y), U51037.1 (A)
supervision__AFE_ALL_DC_OK_G11: U51035.4 (Y), U51036.1 (A)
supervision__AFE_ALL_DC_OK_G13: U51034.4 (Y), U51035.1 (A)
supervision__AFE_ALL_DC_OK_G15: U51034.1 (A); also elsewhere on the board
supervision__AFE_BLANK_LOCAL_OK: U50710.11 (IND), U51041.4 (Y)
supervision__AFE_BLANK_LOCAL_OK_G4: U51040.4 (Y), U51041.1 (A)
supervision__AFE_BLANK_OBS_OK: U50710.6 (OUTD); also elsewhere on the board
supervision__AFE_CONNECT_LOW: U51040.3 (B); also elsewhere on the board
supervision__AFE_RAIL_LOCAL_OK: U50710.12 (INC), U51041.2 (B); also elsewhere on the board
supervision__AFE_RAIL_OBS_OK: U50710.5 (OUTC); also elsewhere on the board
supervision__REC05_DC_OK: U51034.3 (B); also elsewhere on the board
supervision__REC06_DC_OK: U51034.6 (C); also elsewhere on the board
supervision__REC07_DC_OK: U51035.3 (B); also elsewhere on the board
supervision__REC08_DC_OK: U51035.6 (C); also elsewhere on the board
supervision__REC09_DC_OK: U51036.3 (B); also elsewhere on the board
supervision__REC10_DC_OK: U51036.6 (C); also elsewhere on the board
supervision__REC11_DC_OK: U51037.3 (B); also elsewhere on the board
supervision__REC12_DC_OK: U51037.6 (C); also elsewhere on the board
supervision__REC13_DC_OK: U51038.3 (B); also elsewhere on the board
supervision__REC14_DC_OK: U51038.6 (C); also elsewhere on the board
supervision__REC15_DC_OK: U51039.3 (B); also elsewhere on the board
supervision__REF_DC_OK: U51039.6 (C); also elsewhere on the board

Notes on the sheet:
DIGITAL SCCI ENGINEERING / ARTIFICIAL LOADS / NATIVE INDEPENDENT SUPERVISION
18 guarded stimulation conductors, 17 measured RHD-side windows; conditional healthy-switch blanking is not proven isolation.
All net labels are native electrical connections. Actual physical delay, leakage, failed switches and shared supplies remain bounded limitations.
Independent phase cap, heartbeat watchdog, rail windows and deliberate rearm have different functions. No automatic retry or reverse pulse.
