pratham-cloud-ctrl/Project-SCCI-RH/electronics/stage4/integrated-pcb/boards/supervision/supervision.kicad_pcb

## KiCad design electronics/stage4/integrated-pcb/boards/supervision/supervision.kicad_pcb (continued)

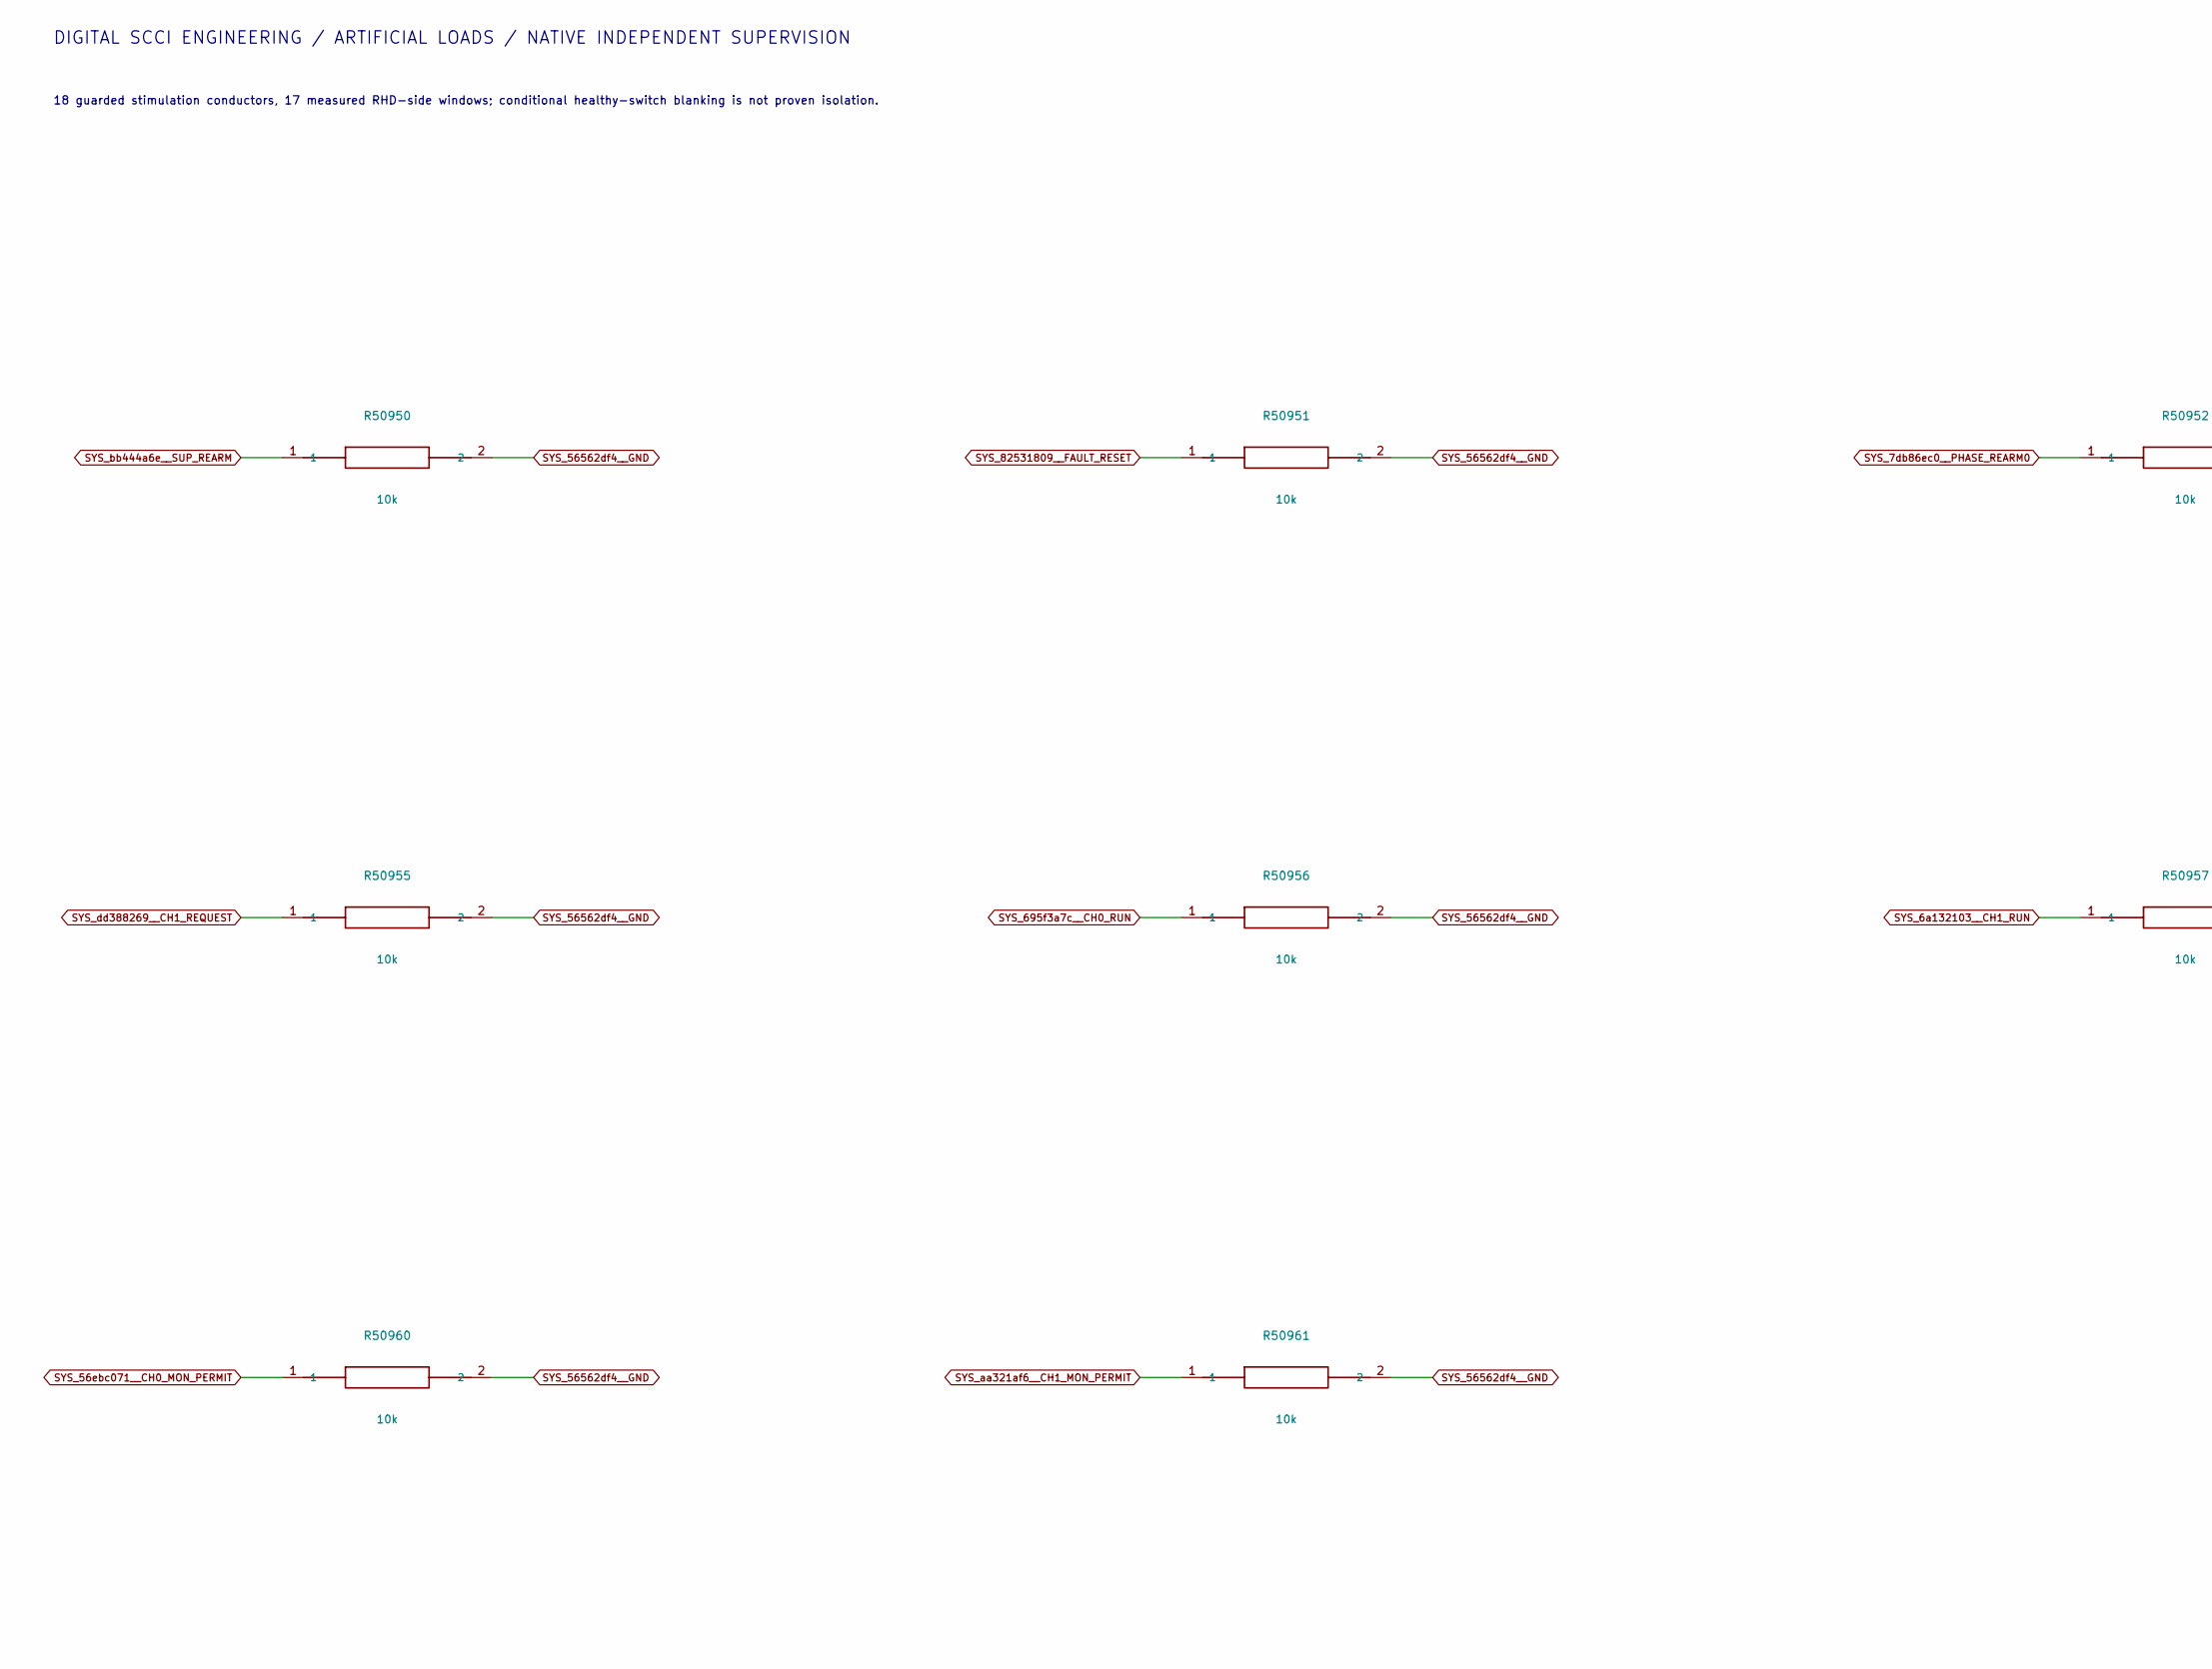
[picture p306: schematic defaults.kicad_sch, Project SCCI RH S4 / External defaults, part in row 1, column 1]

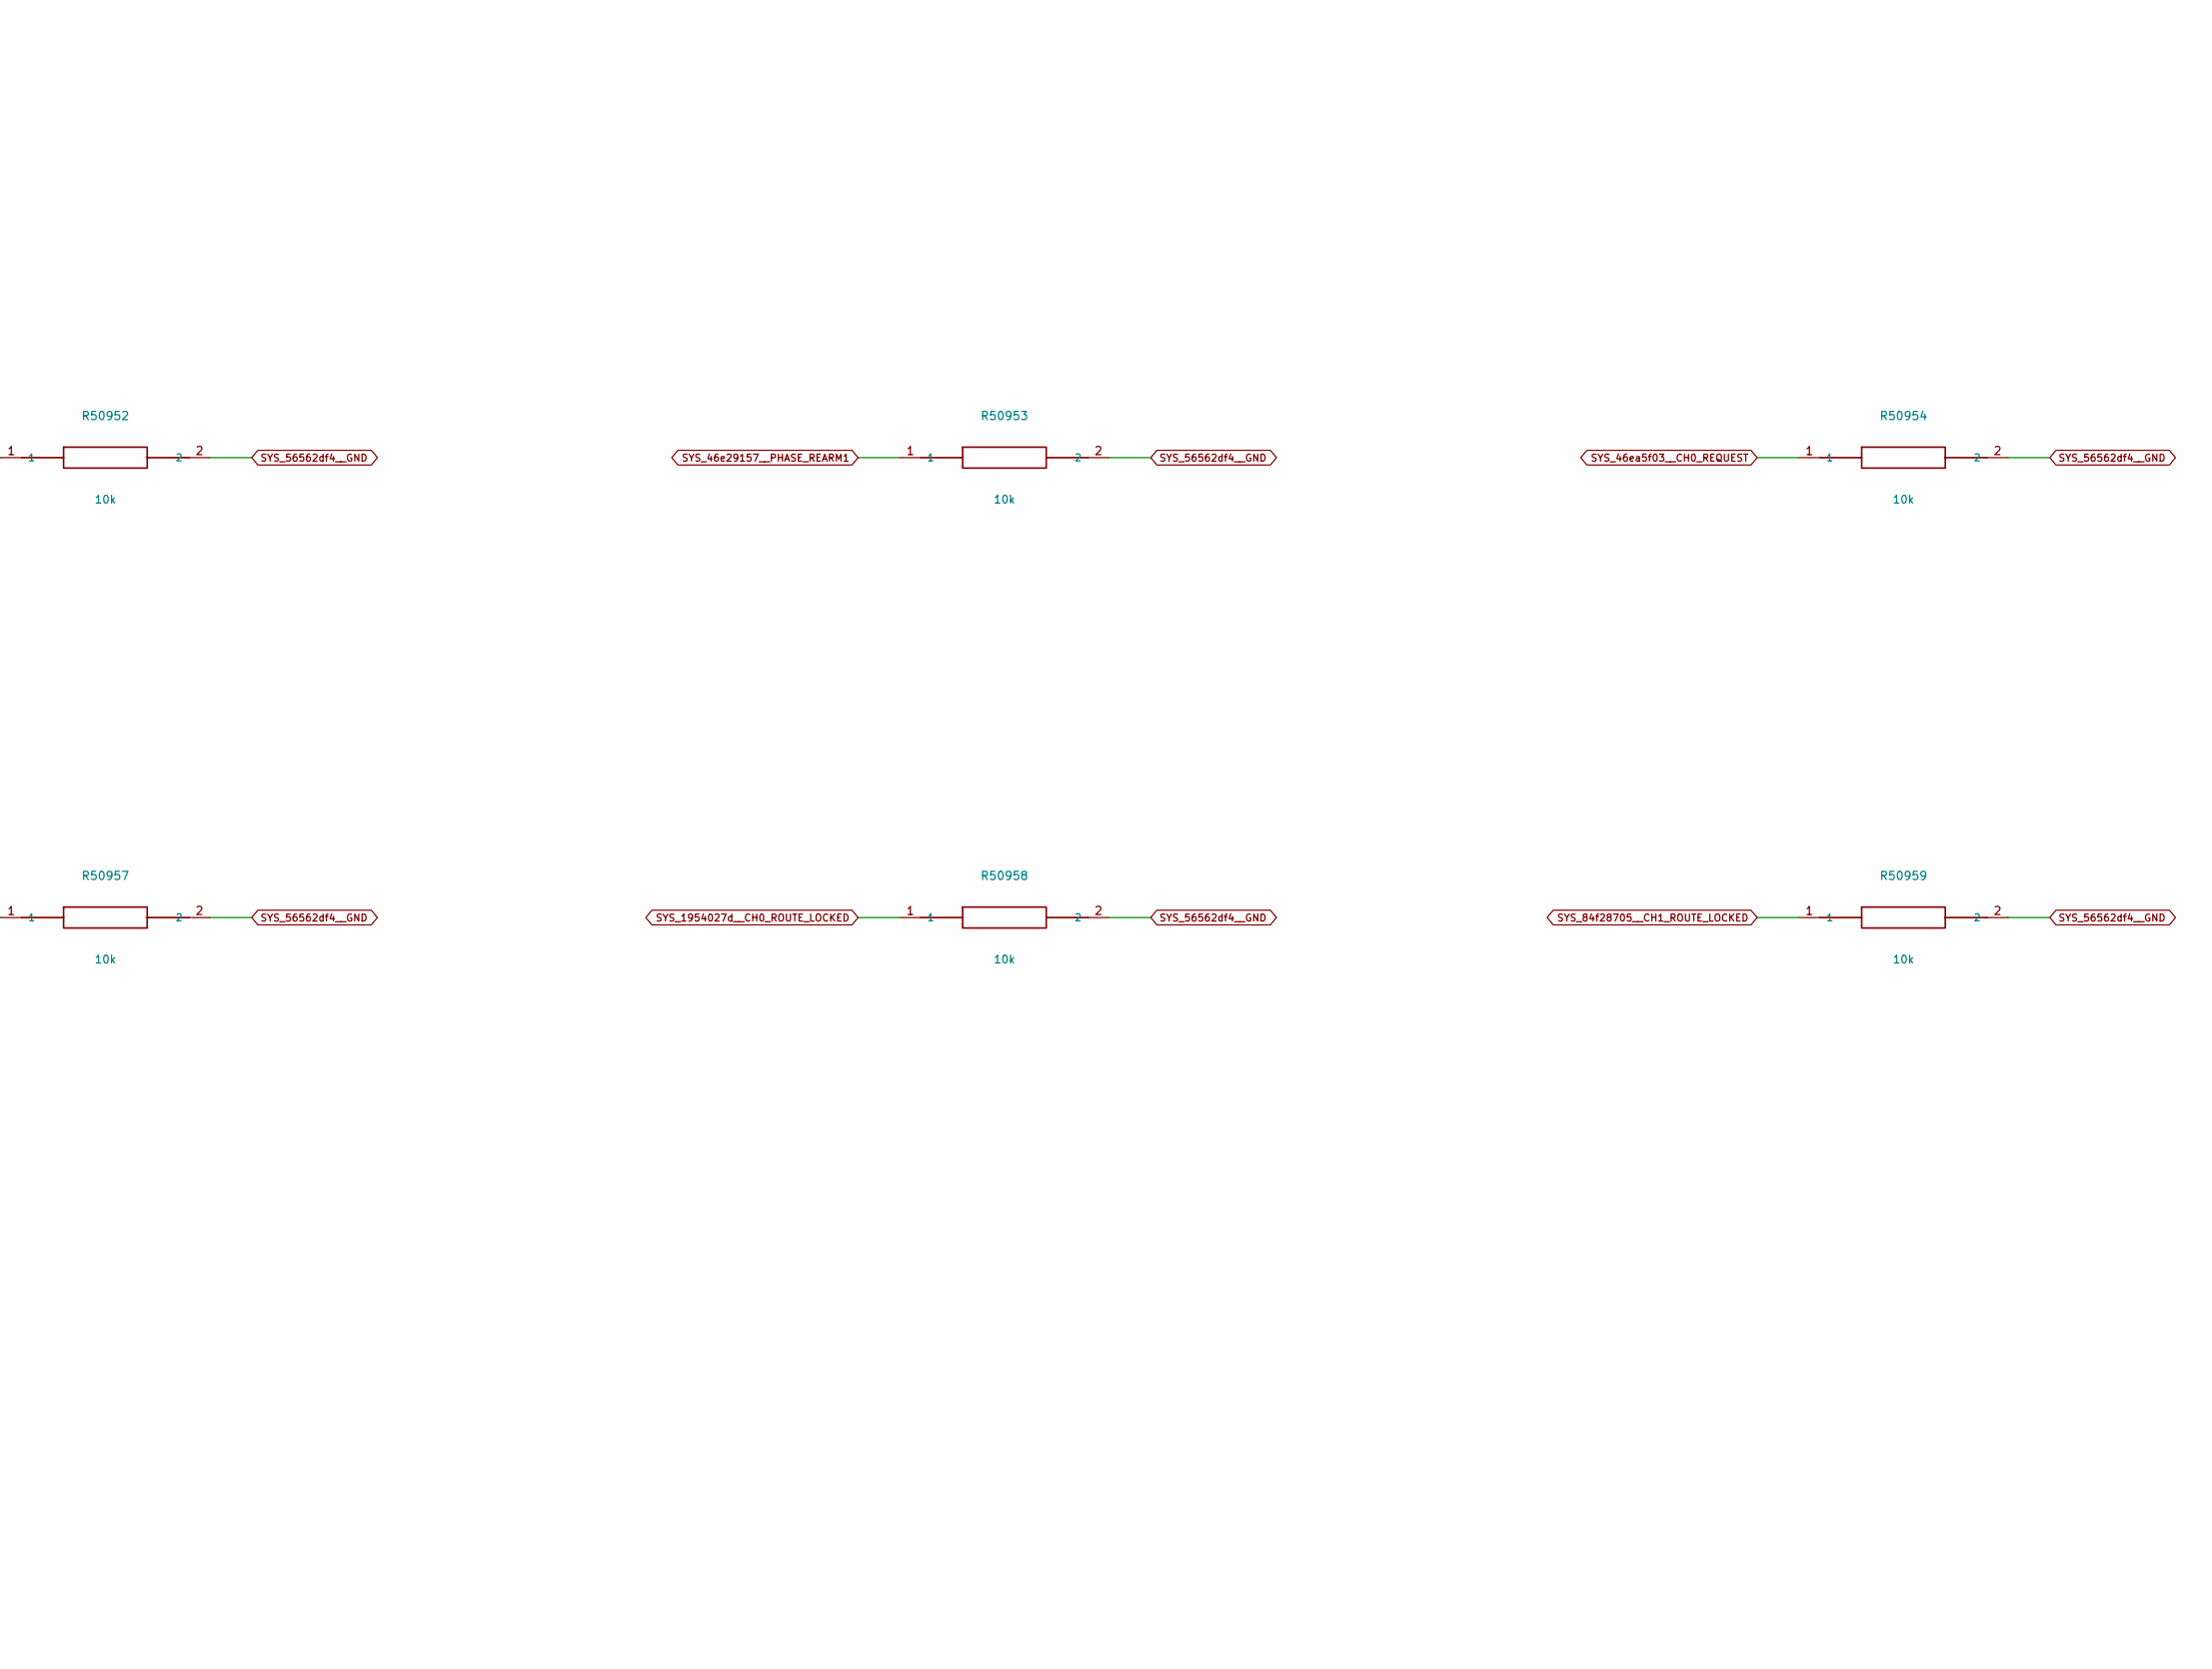
[picture p307: schematic defaults.kicad_sch, Project SCCI RH S4 / External defaults, part in row 1, column 2]

Parts:
R50950, R50951, R50952, R50953, R50954, R50955, R50956, R50957, R50958, R50959, R50960, R50961: 10k; R_0805_2012Metric

Connections:
SYS_6a132103__CH1_RUN: R50957.1; also elsewhere on the board
SYS_7db86ec0__PHASE_REARM0: R50952.1; also elsewhere on the board
SYS_46e29157__PHASE_REARM1: R50953.1; also elsewhere on the board
SYS_46ea5f03__CH0_REQUEST: R50954.1; also elsewhere on the board
SYS_56ebc071__CH0_MON_PERMIT: R50960.1; also elsewhere on the board
SYS_84f28705__CH1_ROUTE_LOCKED: R50959.1; also elsewhere on the board
SYS_695f3a7c__CH0_RUN: R50956.1; also elsewhere on the board
SYS_56562df4__GND: R50950.2, R50951.2, R50952.2, R50953.2, R50954.2, R50955.2, R50956.2, R50957.2, R50958.2, R50959.2, R50960.2, R50961.2; also elsewhere on the board
SYS_1954027d__CH0_ROUTE_LOCKED: R50958.1; also elsewhere on the board
SYS_82531809__FAULT_RESET: R50951.1; also elsewhere on the board
SYS_aa321af6__CH1_MON_PERMIT: R50961.1; also elsewhere on the board
SYS_bb444a6e__SUP_REARM: R50950.1; also elsewhere on the board
SYS_dd388269__CH1_REQUEST: R50955.1; also elsewhere on the board

Notes on the sheet:
DIGITAL SCCI ENGINEERING / ARTIFICIAL LOADS / NATIVE INDEPENDENT SUPERVISION
18 guarded stimulation conductors, 17 measured RHD-side windows; conditional healthy-switch blanking is not proven isolation.
All net labels are native electrical connections. Actual physical delay, leakage, failed switches and shared supplies remain bounded limitations.
Independent phase cap, heartbeat watchdog, rail windows and deliberate rearm have different functions. No automatic retry or reverse pulse.

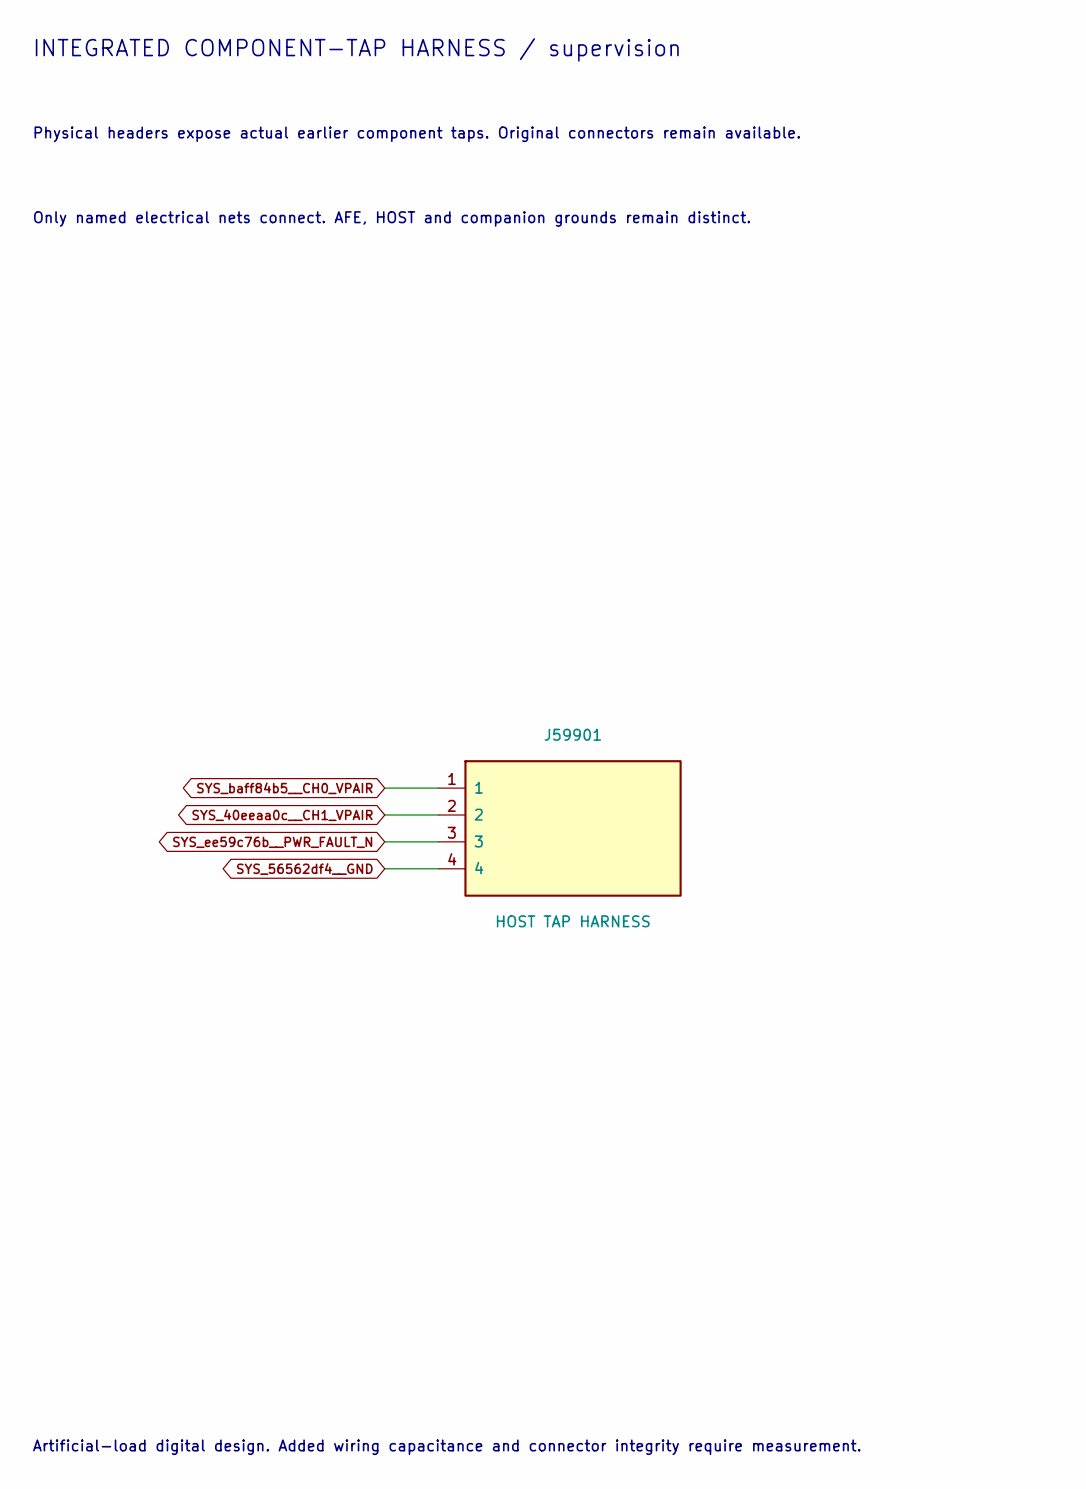
[picture p308: schematic integration_taps.kicad_sch, Project SCCI RH / supervision integration taps]

Parts:
J59901: HOST TAP HARNESS; PinHeader_1x04_P2.54mm_Vertical

Connections:
SYS_40eeaa0c__CH1_VPAIR: J59901.2; also elsewhere on the board
SYS_56562df4__GND: J59901.4; also elsewhere on the board
SYS_baff84b5__CH0_VPAIR: J59901.1; also elsewhere on the board
SYS_ee59c76b__PWR_FAULT_N: J59901.3; also elsewhere on the board

Notes on the sheet:
INTEGRATED COMPONENT-TAP HARNESS / supervision
Physical headers expose actual earlier component taps. Original connectors remain available.
Only named electrical nets connect. AFE, HOST and companion grounds remain distinct.
Artificial-load digital design. Added wiring capacitance and connector integrity require measurement.

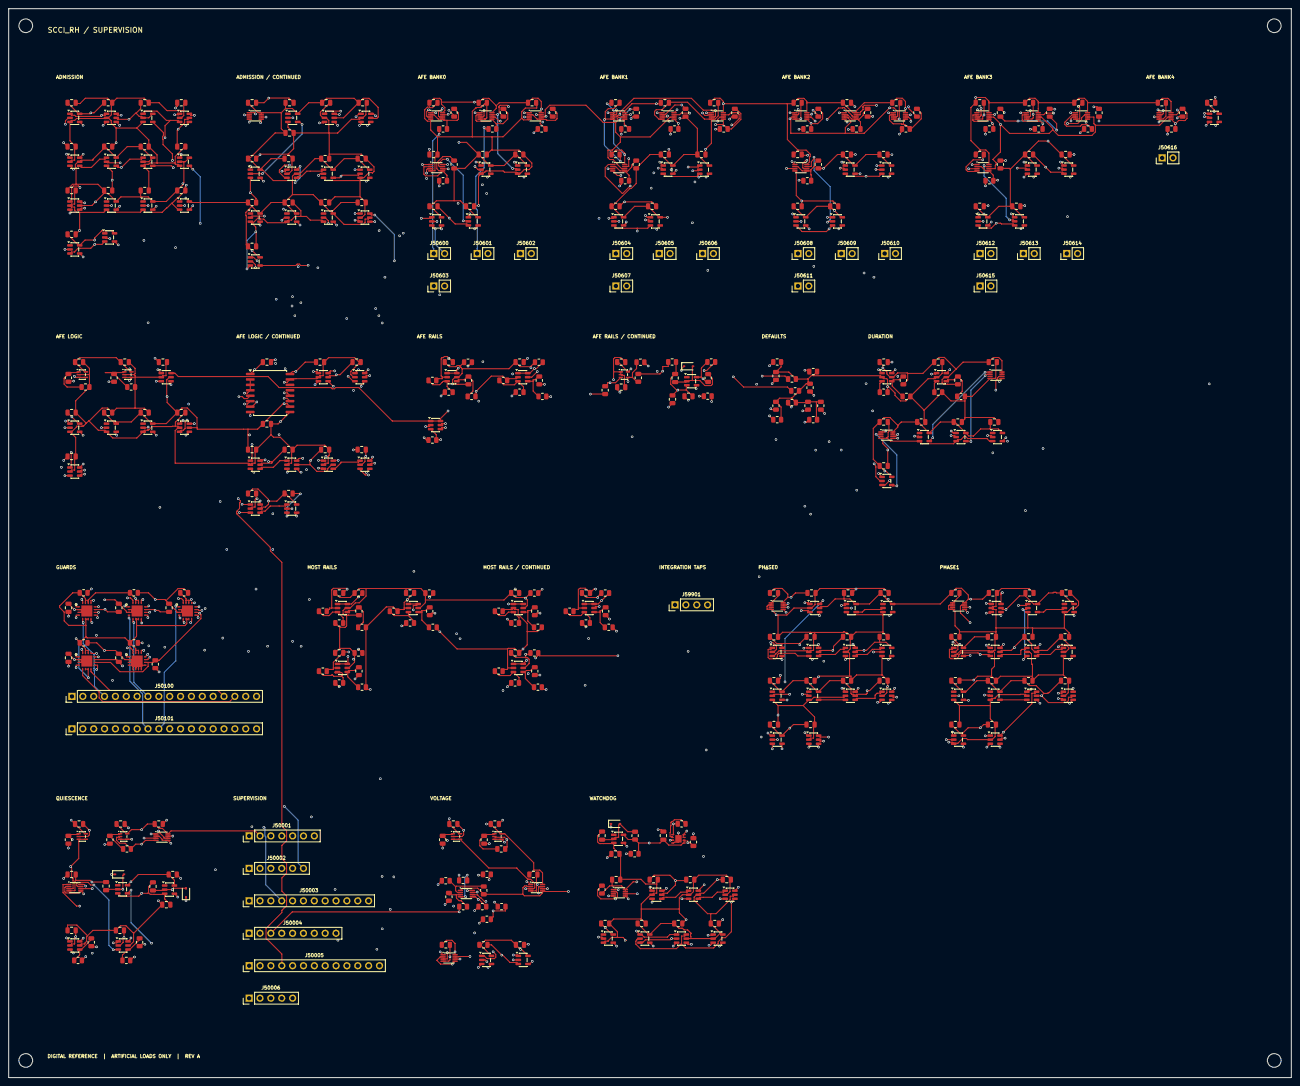
[picture p309: board supervision.kicad_pcb from above]

Board: 4 copper layers, 300.0 x 250.0 mm, 483 parts (0 on the bottom side), 320 nets.

Other parts of the board:
H1, H2, H3, H4: MountingHole_3.2mm_M3
