pratham-cloud-ctrl/Project-SCCI-RH/electronics/scci_rh_reference.kicad_pcb

## KiCad design electronics/scci_rh_reference.kicad_pcb (2026-10-29)

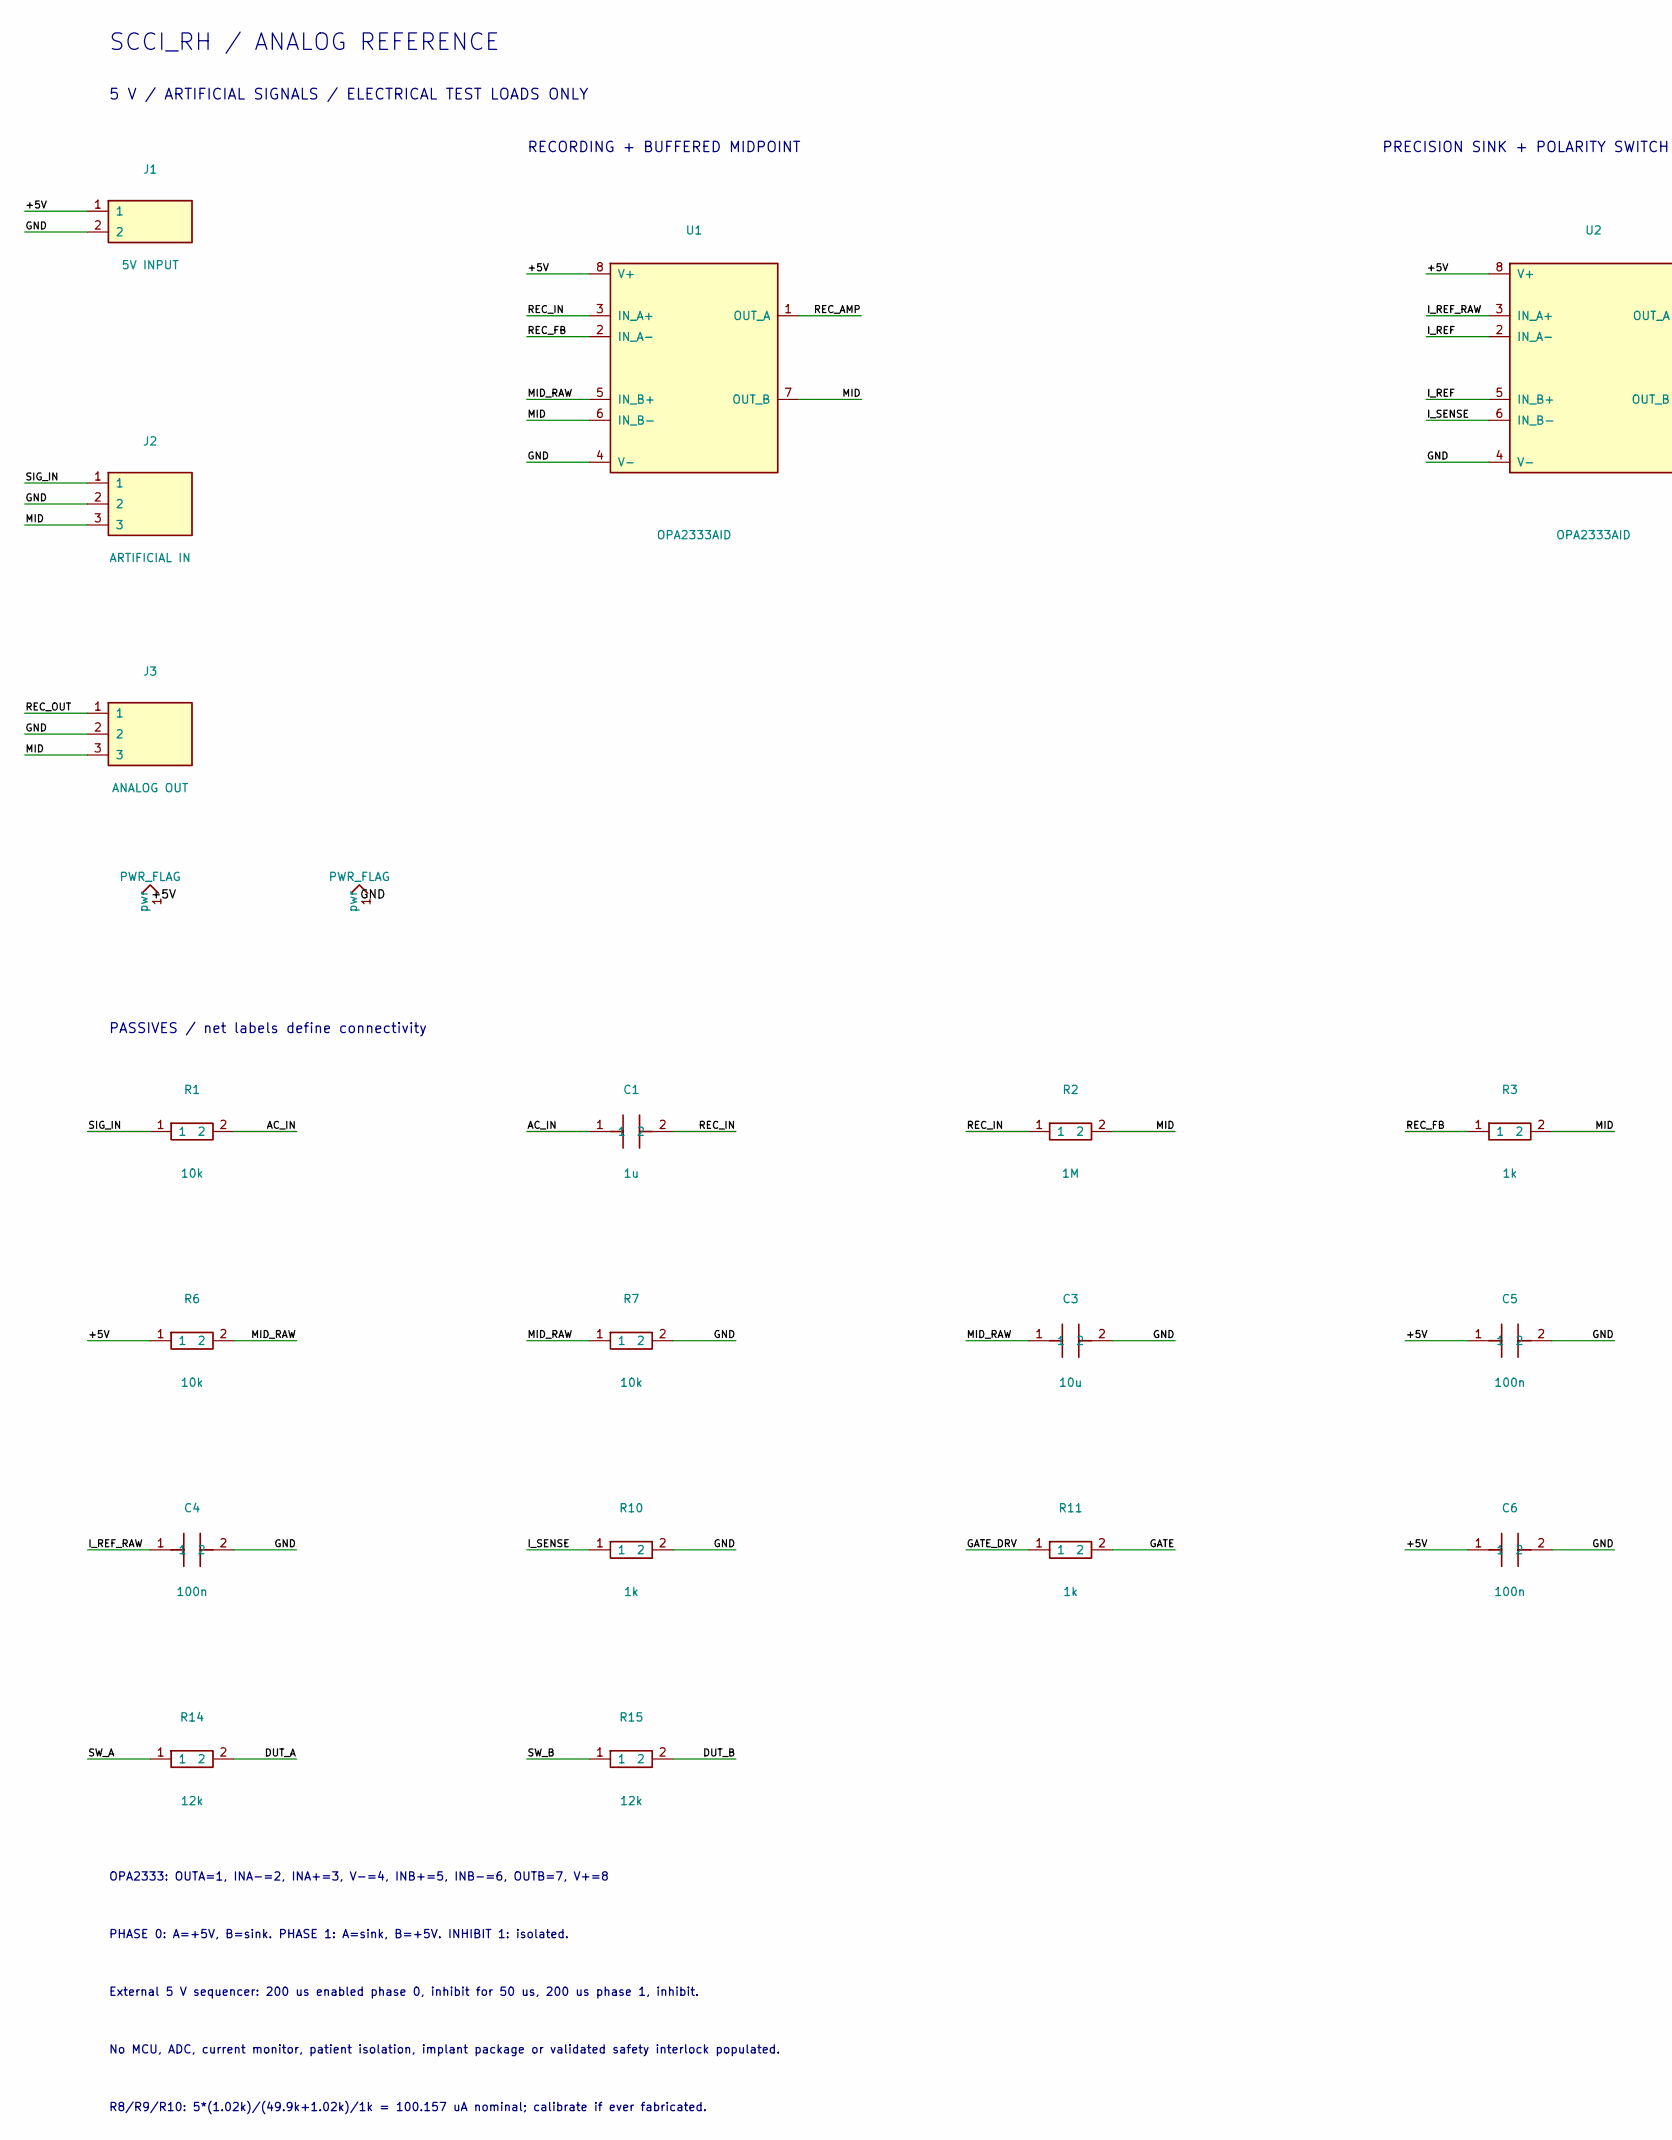
[picture p310: schematic scci_rh_reference.kicad_sch, Project SCCI RH | Artificial-signal analog reference, part in row 1, column 1]

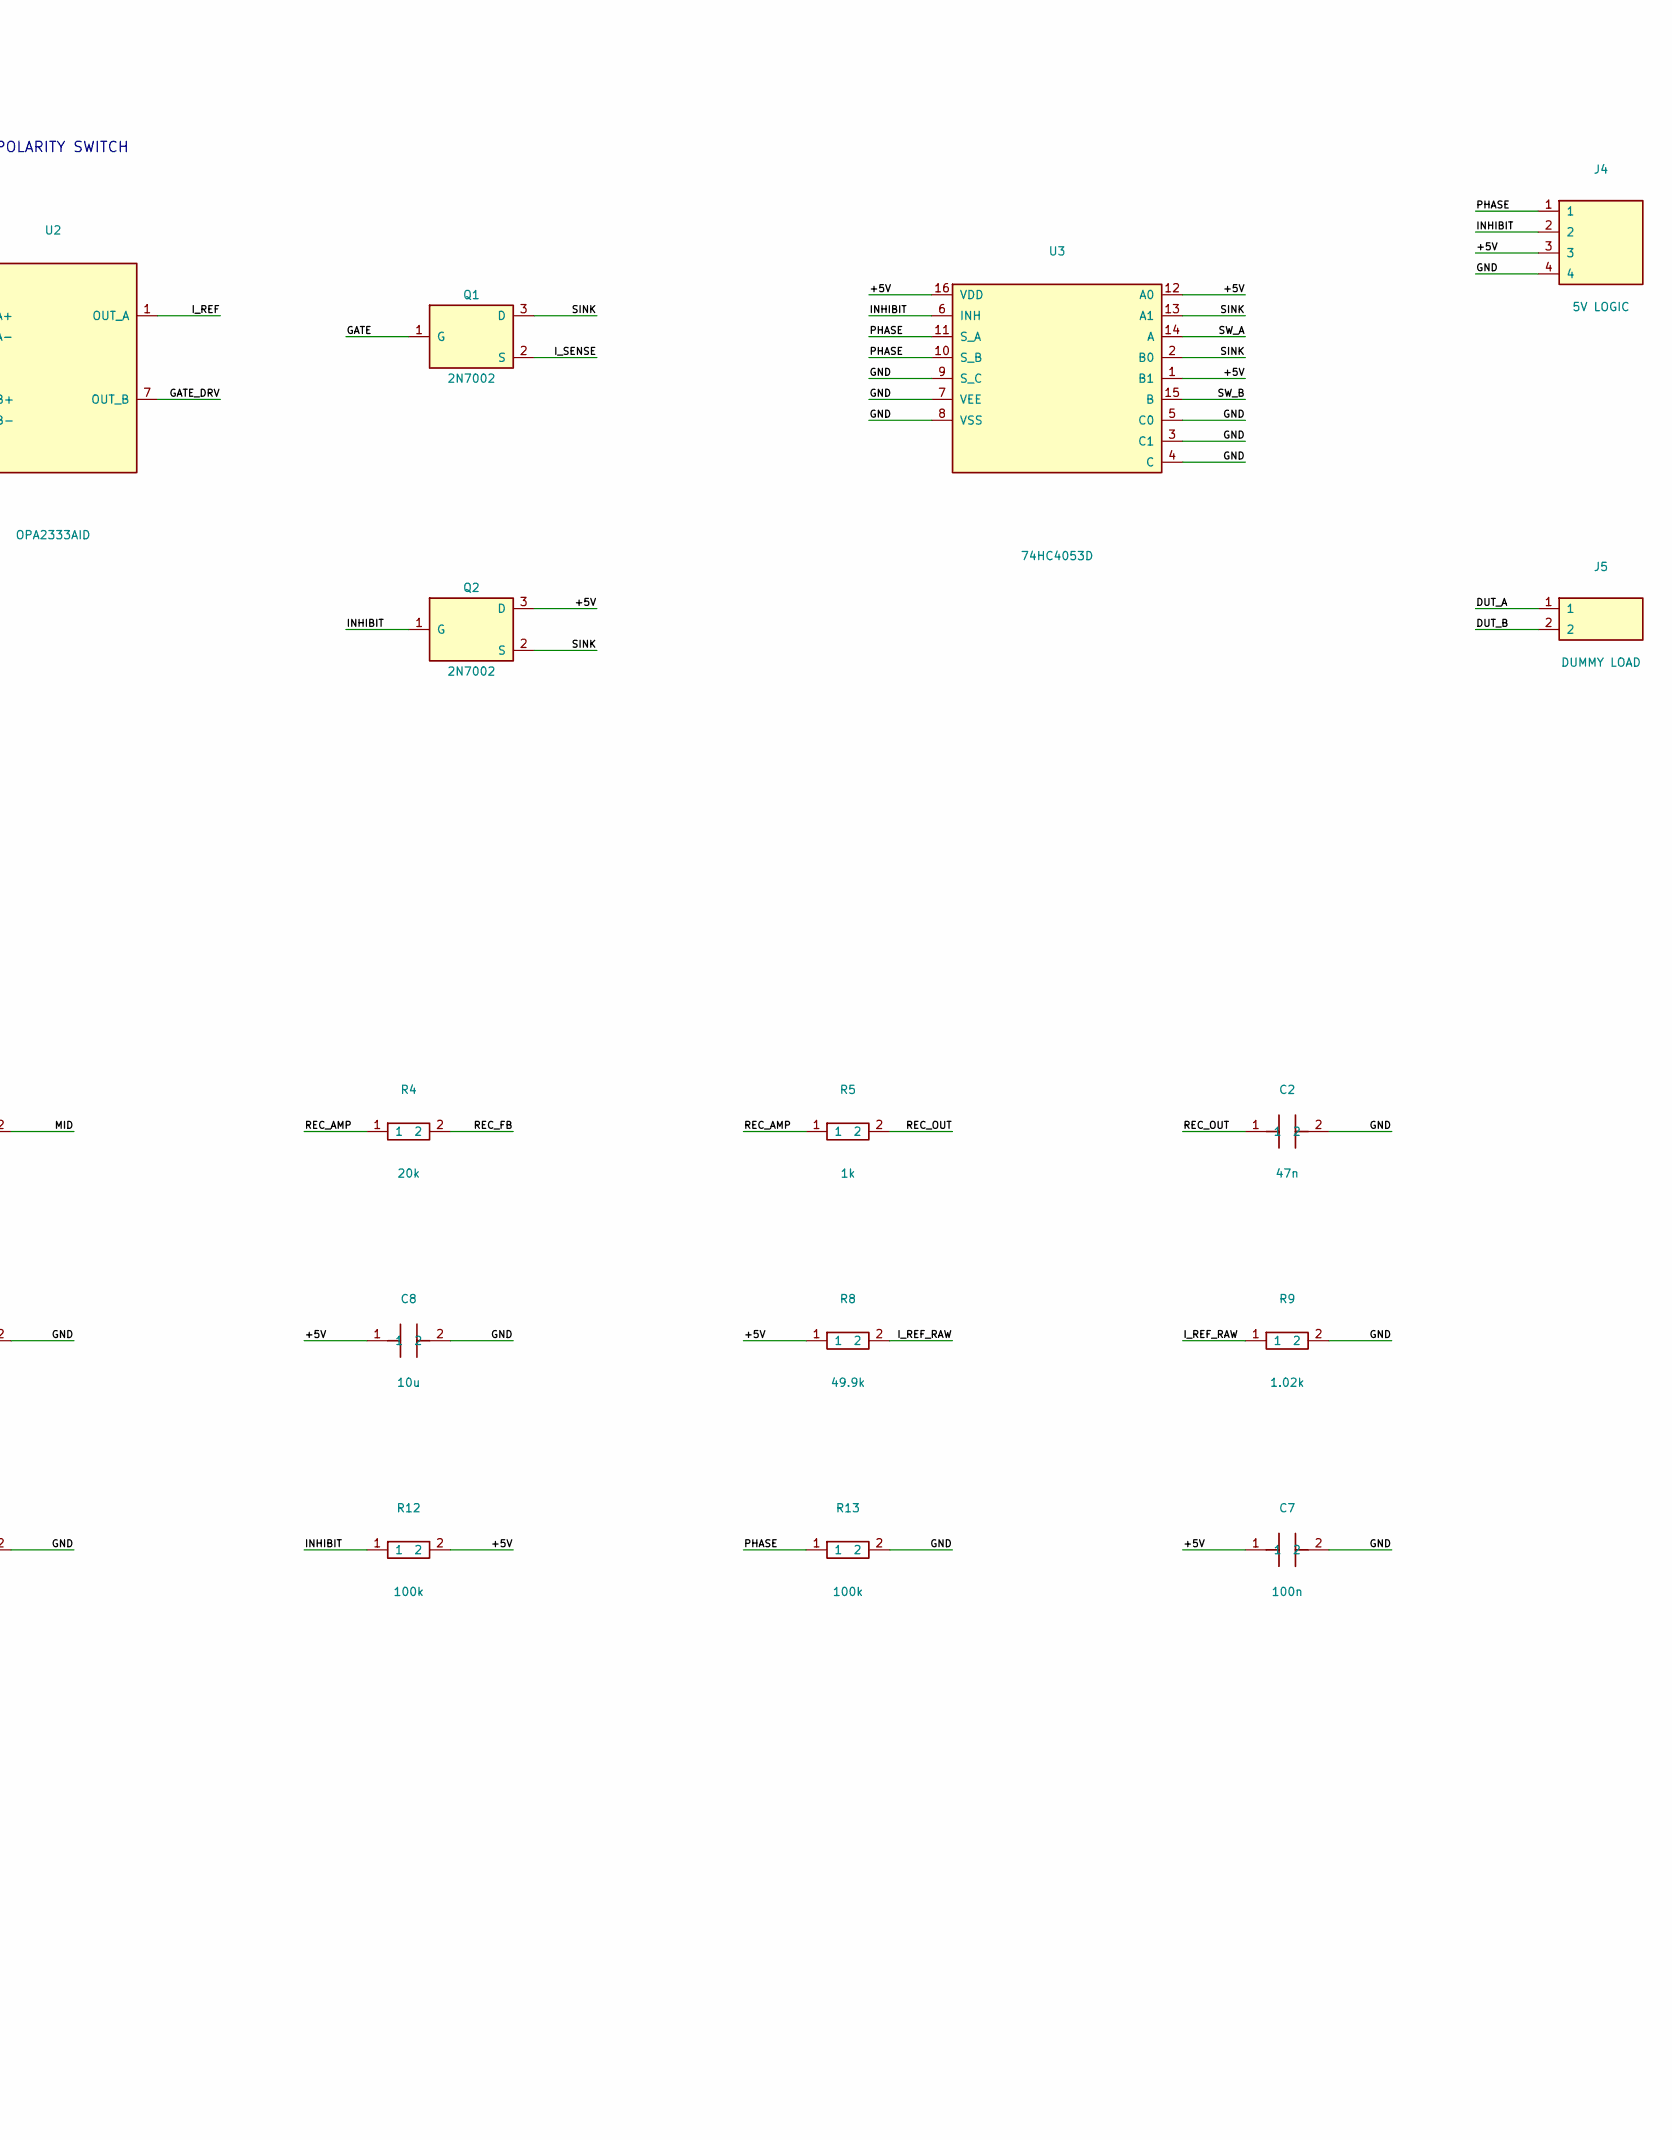
[picture p311: schematic scci_rh_reference.kicad_sch, Project SCCI RH | Artificial-signal analog reference, part in row 1, column 2]

Parts:
C1: 1u; C_0805_2012Metric
C2: 47n; C_0805_2012Metric
C3, C8: 10u; C_0805_2012Metric
C4, C5, C6, C7: 100n; C_0805_2012Metric
J1: 5V INPUT; PinHeader_1x02_P2.54mm_Vertical
J2: ARTIFICIAL IN; PinHeader_1x03_P2.54mm_Vertical
J3: ANALOG OUT; PinHeader_1x03_P2.54mm_Vertical
J4: 5V LOGIC; PinHeader_1x04_P2.54mm_Vertical
J5: DUMMY LOAD; PinHeader_1x02_P2.54mm_Vertical
Q1, Q2: 2N7002; SOT-23
R1, R6, R7: 10k; R_0805_2012Metric
R2: 1M; R_0805_2012Metric
R3, R5, R10, R11: 1k; R_0805_2012Metric
R4: 20k; R_0805_2012Metric
R8: 49.9k; R_0805_2012Metric
R9: 1.02k; R_0805_2012Metric
R12, R13: 100k; R_0805_2012Metric
R14, R15: 12k; R_0805_2012Metric
U1, U2: OPA2333AID; SOIC-8_3.9x4.9mm_P1.27mm
U3: 74HC4053D; SOIC-16_3.9x9.9mm_P1.27mm

Connections:
/+5V: C5.1, C6.1, C7.1, C8.1, J1.1, J4.3, Q2.3 (D), R6.1, R8.1, R12.2, U1.8 (V+), U2.8 (V+), U3.1 (B1), U3.12 (A0), U3.16 (VDD)
/AC_IN: C1.1, R1.2
/DUT_A: J5.1, R14.2
/DUT_B: J5.2, R15.2
/GATE: Q1.1 (G), R11.2
/GATE_DRV: R11.1, U2.7 (OUT_B)
/GND: C2.2, C3.2, C4.2, C5.2, C6.2, C7.2, C8.2, J1.2, J2.2, J3.2, J4.4, R7.2, R9.2, R10.2, R13.2, U1.4 (V-), U2.4 (V-), U3.3 (C1), U3.4 (C), U3.5 (C0), U3.7 (VEE), U3.8 (VSS), U3.9 (S_C)
/INHIBIT: J4.2, Q2.1 (G), R12.1, U3.6 (INH)
/I_REF: U2.1 (OUT_A), U2.2 (IN_A-), U2.5 (IN_B+)
/I_REF_RAW: C4.1, R8.2, R9.1, U2.3 (IN_A+)
/I_SENSE: Q1.2 (S), R10.1, U2.6 (IN_B-)
/MID: J2.3, J3.3, R2.2, R3.2, U1.6 (IN_B-), U1.7 (OUT_B)
/MID_RAW: C3.1, R6.2, R7.1, U1.5 (IN_B+)
/PHASE: J4.1, R13.1, U3.10 (S_B), U3.11 (S_A)
/REC_AMP: R4.1, R5.1, U1.1 (OUT_A)
/REC_FB: R3.1, R4.2, U1.2 (IN_A-)
/REC_IN: C1.2, R2.1, U1.3 (IN_A+)
/REC_OUT: C2.1, J3.1, R5.2
/SIG_IN: J2.1, R1.1
/SINK: Q1.3 (D), Q2.2 (S), U3.2 (B0), U3.13 (A1)
/SW_A: R14.1, U3.14 (A)
/SW_B: R15.1, U3.15 (B)

Notes on the sheet:
SCCI_RH / ANALOG REFERENCE
5 V / ARTIFICIAL SIGNALS / ELECTRICAL TEST LOADS ONLY
RECORDING + BUFFERED MIDPOINT
PRECISION SINK + POLARITY SWITCH
PASSIVES / net labels define connectivity
OPA2333: OUTA=1, INA-=2, INA+=3, V-=4, INB+=5, INB-=6, OUTB=7, V+=8
PHASE 0: A=+5V, B=sink. PHASE 1: A=sink, B=+5V. INHIBIT 1: isolated.
External 5 V sequencer: 200 us enabled phase 0, inhibit for 50 us, 200 us phase 1, inhibit.
No MCU, ADC, current monitor, patient isolation, implant package or validated safety interlock populated.
R8/R9/R10: 5*(1.02k)/(49.9k+1.02k)/1k = 100.157 uA nominal; calibrate if ever fabricated.

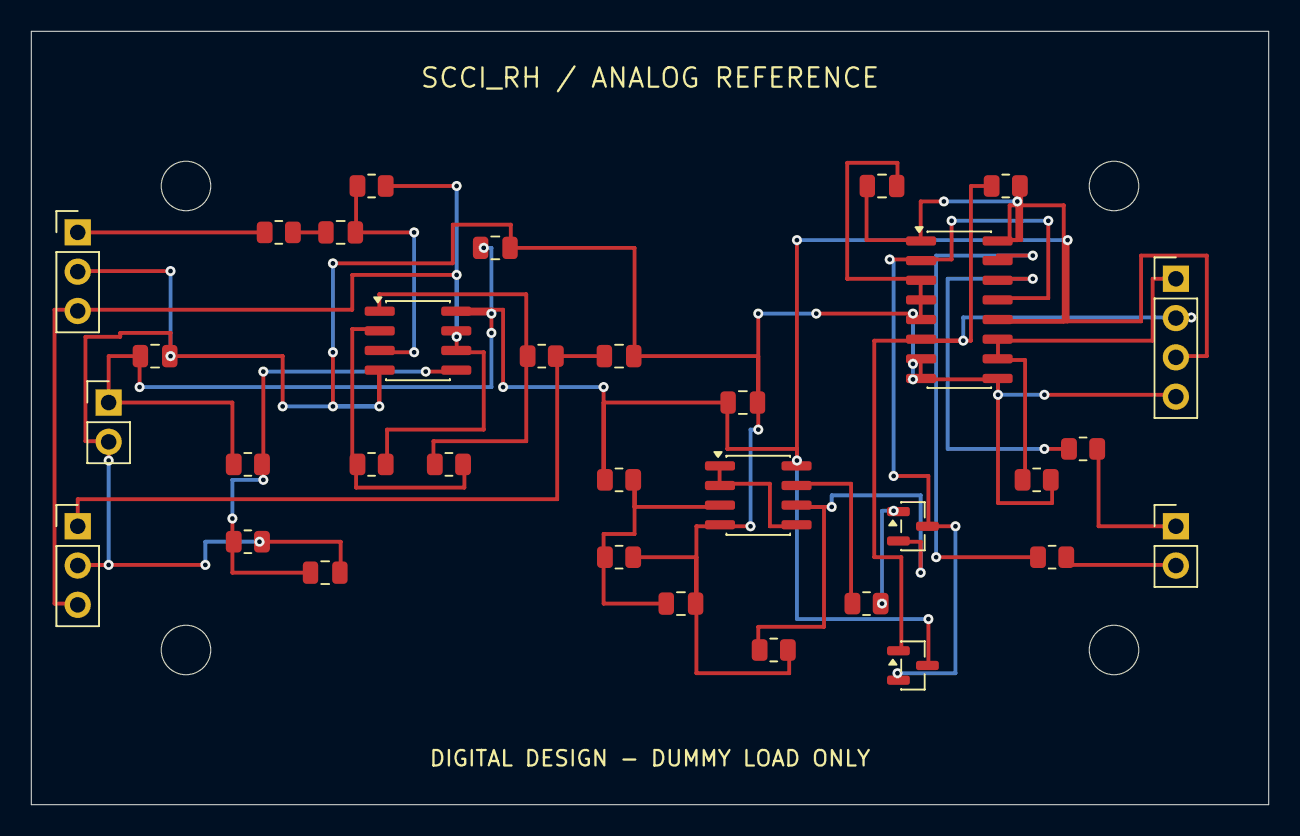
[picture p312: board scci_rh_reference.kicad_pcb from above]

Board: 2 copper layers, 80.0 x 50.0 mm, 37 parts (0 on the bottom side), 22 nets.

Other parts of the board:
H1, H2, H3, H4: MountingHole_3.2mm_M3
