pratham-cloud-ctrl/Project-SCCI-RH/electronics/stage4/integrated-pcb/boards/controller-carrier/controller_carrier.kicad_pcb

## KiCad design electronics/stage4/integrated-pcb/boards/controller-carrier/controller_carrier.kicad_pcb (2026-10-29)

Schematic: controller_carrier.kicad_sch, Project SCCI RH S4 / Controller carrier / interface index

Parts:
J80001: HOST POWER; PinHeader_1x02_P2.54mm_Vertical

Connections:
SYS_56562df4__GND: J80001.2; also elsewhere on the board
SYS_08572049__HOST_3V3: J80001.1; also elsewhere on the board

Notes on the sheet:
DIGITAL SCCI ENGINEERING / ARTIFICIAL SIGNALS / nRF5340 CONTROLLER CARRIER
46 actual GPIO, explicit common CNV/rearm and physical 32-bit health/readback chain. Radio remains disabled.
