pratham-cloud-ctrl/Project-SCCI-RH/electronics/stage4/integrated-pcb/boards/controller-carrier/controller_carrier.kicad_pcb

## KiCad design electronics/stage4/integrated-pcb/boards/controller-carrier/controller_carrier.kicad_pcb (continued)

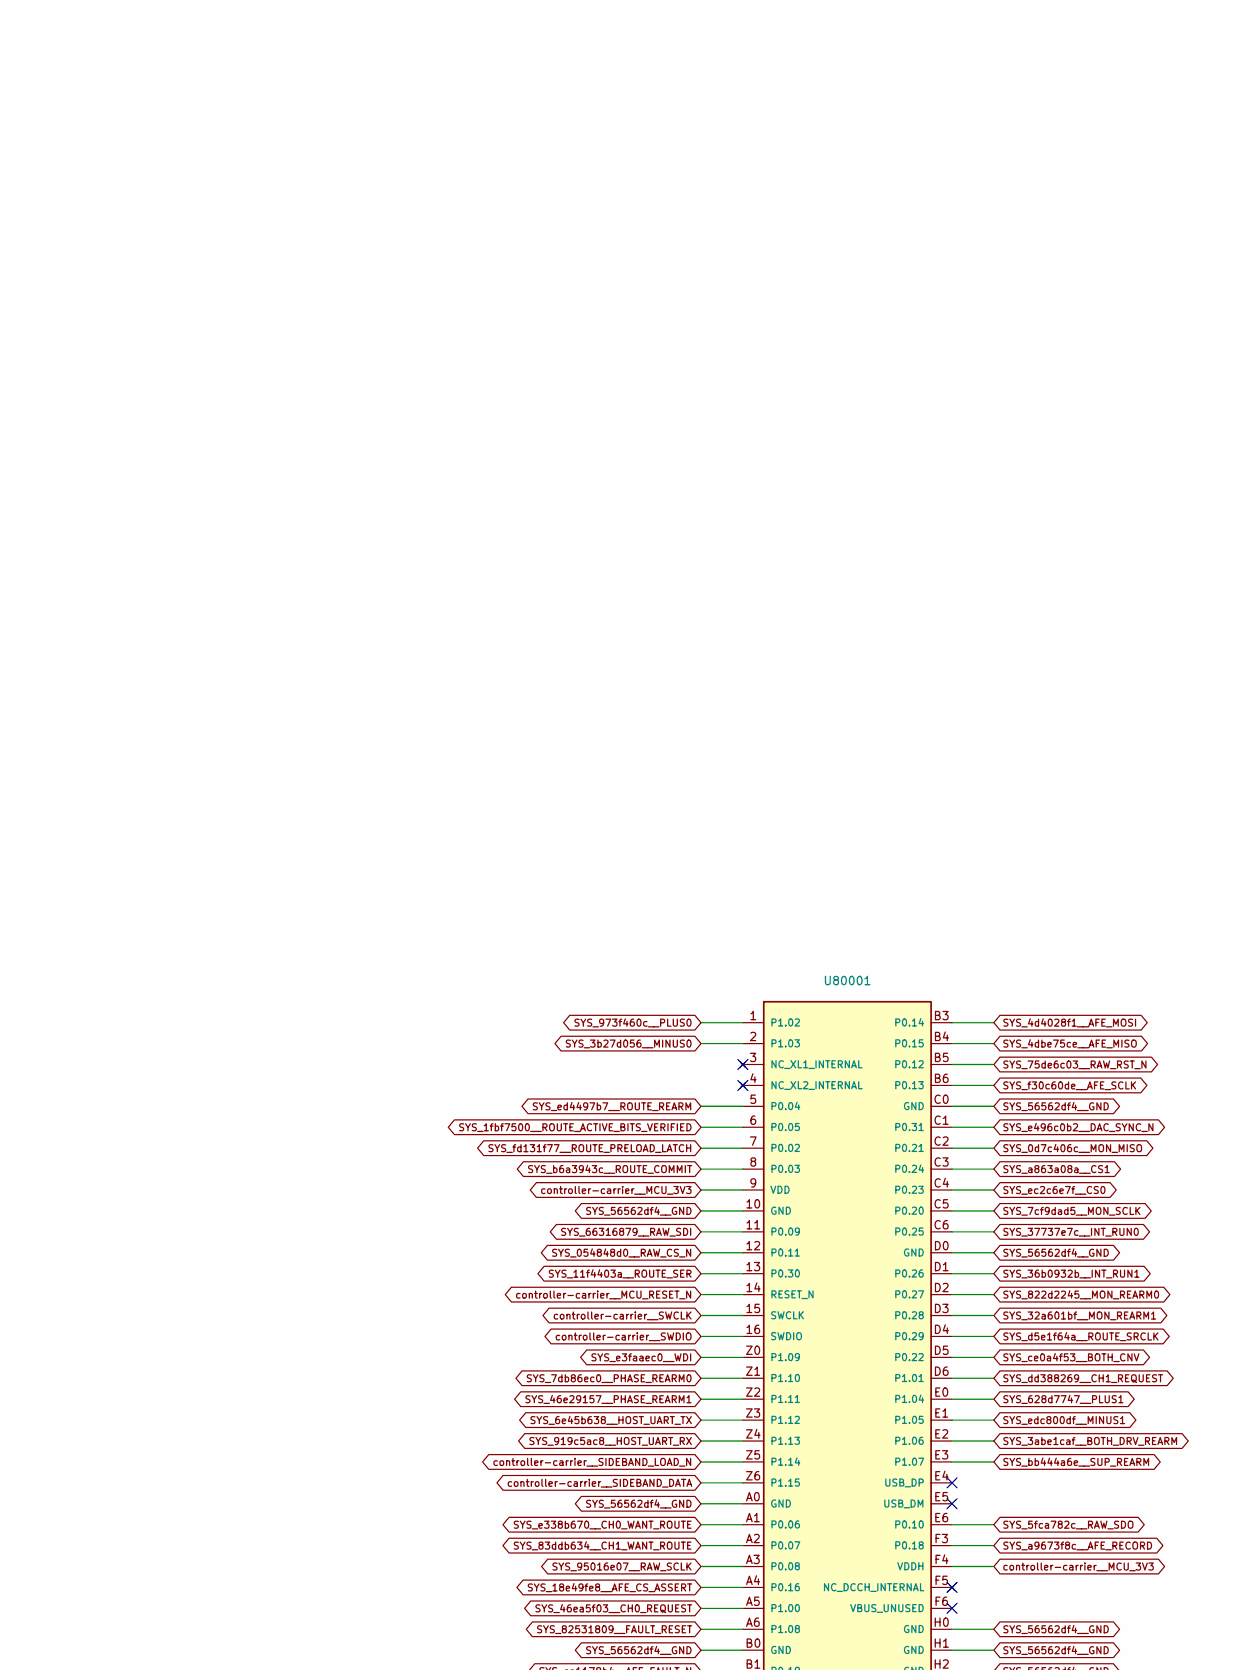
[picture p313: schematic processor.kicad_sch, Project SCCI RH S4 / BT40F / actual nRF5340 physical pads, part in row 1, column 2]

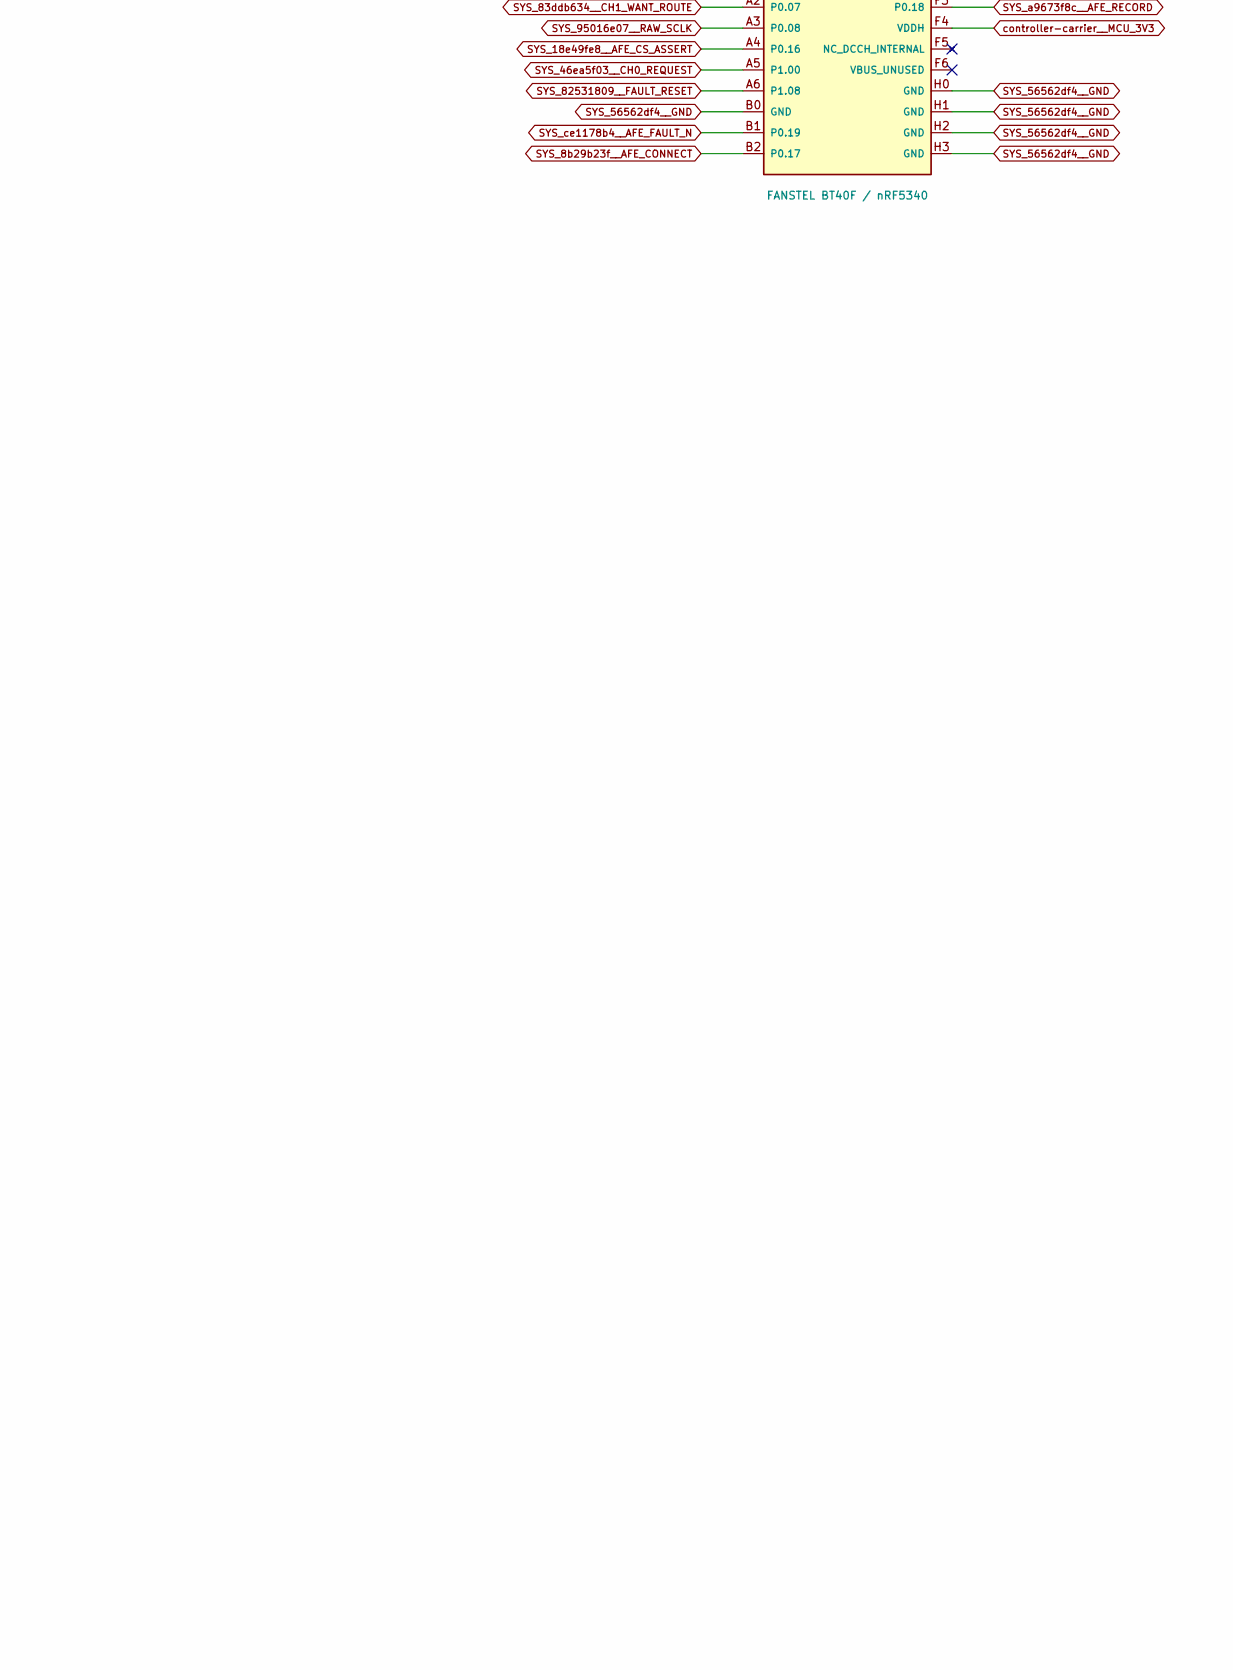
[picture p314: schematic processor.kicad_sch, Project SCCI RH S4 / BT40F / actual nRF5340 physical pads, part in row 2, column 2]

Parts:
U80001: FANSTEL BT40F / nRF5340; BT40F_Manufacturer_66Pad

Connections:
SYS_0d7c406c__MON_MISO: U80001.C2 (P0.21); also elsewhere on the board
SYS_1fbf7500__ROUTE_ACTIVE_BITS_VERIFIED: U80001.6 (P0.05); also elsewhere on the board
SYS_3abe1caf__BOTH_DRV_REARM: U80001.E2 (P1.06); also elsewhere on the board
SYS_3b27d056__MINUS0: U80001.2 (P1.03); also elsewhere on the board
SYS_4d4028f1__AFE_MOSI: U80001.B3 (P0.14); also elsewhere on the board
SYS_4dbe75ce__AFE_MISO: U80001.B4 (P0.15); also elsewhere on the board
SYS_5fca782c__RAW_SDO: U80001.E6 (P0.10); also elsewhere on the board
SYS_6e45b638__HOST_UART_TX: U80001.Z3 (P1.12); also elsewhere on the board
SYS_7cf9dad5__MON_SCLK: U80001.C5 (P0.20); also elsewhere on the board
SYS_7db86ec0__PHASE_REARM0: U80001.Z1 (P1.10); also elsewhere on the board
SYS_8b29b23f__AFE_CONNECT: U80001.B2 (P0.17); also elsewhere on the board
SYS_11f4403a__ROUTE_SER: U80001.13 (P0.30); also elsewhere on the board
SYS_18e49fe8__AFE_CS_ASSERT: U80001.A4 (P0.16); also elsewhere on the board
SYS_32a601bf__MON_REARM1: U80001.D3 (P0.28); also elsewhere on the board
SYS_36b0932b__INT_RUN1: U80001.D1 (P0.26); also elsewhere on the board
SYS_46e29157__PHASE_REARM1: U80001.Z2 (P1.11); also elsewhere on the board
SYS_46ea5f03__CH0_REQUEST: U80001.A5 (P1.00); also elsewhere on the board
SYS_75de6c03__RAW_RST_N: U80001.B5 (P0.12); also elsewhere on the board
SYS_83ddb634__CH1_WANT_ROUTE: U80001.A2 (P0.07); also elsewhere on the board
SYS_628d7747__PLUS1: U80001.E0 (P1.04); also elsewhere on the board
SYS_822d2245__MON_REARM0: U80001.D2 (P0.27); also elsewhere on the board
SYS_919c5ac8__HOST_UART_RX: U80001.Z4 (P1.13); also elsewhere on the board
SYS_973f460c__PLUS0: U80001.1 (P1.02); also elsewhere on the board
SYS_37737e7c__INT_RUN0: U80001.C6 (P0.25); also elsewhere on the board
SYS_054848d0__RAW_CS_N: U80001.12 (P0.11); also elsewhere on the board
SYS_56562df4__GND: U80001.10 (GND), U80001.A0 (GND), U80001.B0 (GND), U80001.C0 (GND), U80001.D0 (GND), U80001.H0 (GND), U80001.H1 (GND), U80001.H2 (GND), U80001.H3 (GND); also elsewhere on the board
SYS_95016e07__RAW_SCLK: U80001.A3 (P0.08); also elsewhere on the board
SYS_66316879__RAW_SDI: U80001.11 (P0.09); also elsewhere on the board
SYS_82531809__FAULT_RESET: U80001.A6 (P1.08); also elsewhere on the board
SYS_a863a08a__CS1: U80001.C3 (P0.24); also elsewhere on the board
SYS_a9673f8c__AFE_RECORD: U80001.F3 (P0.18); also elsewhere on the board
SYS_b6a3943c__ROUTE_COMMIT: U80001.8 (P0.03); also elsewhere on the board
SYS_bb444a6e__SUP_REARM: U80001.E3 (P1.07); also elsewhere on the board
SYS_ce0a4f53__BOTH_CNV: U80001.D5 (P0.22); also elsewhere on the board
SYS_ce1178b4__AFE_FAULT_N: U80001.B1 (P0.19); also elsewhere on the board
SYS_d5e1f64a__ROUTE_SRCLK: U80001.D4 (P0.29); also elsewhere on the board
SYS_dd388269__CH1_REQUEST: U80001.D6 (P1.01); also elsewhere on the board
SYS_e3faaec0__WDI: U80001.Z0 (P1.09); also elsewhere on the board
SYS_e338b670__CH0_WANT_ROUTE: U80001.A1 (P0.06); also elsewhere on the board
SYS_e496c0b2__DAC_SYNC_N: U80001.C1 (P0.31); also elsewhere on the board
SYS_ec2c6e7f__CS0: U80001.C4 (P0.23); also elsewhere on the board
SYS_ed4497b7__ROUTE_REARM: U80001.5 (P0.04); also elsewhere on the board
SYS_edc800df__MINUS1: U80001.E1 (P1.05); also elsewhere on the board
SYS_f30c60de__AFE_SCLK: U80001.B6 (P0.13); also elsewhere on the board
SYS_fd131f77__ROUTE_PRELOAD_LATCH: U80001.7 (P0.02); also elsewhere on the board
controller-carrier__MCU_3V3: U80001.9 (VDD), U80001.F4 (VDDH); also elsewhere on the board
controller-carrier__MCU_RESET_N: U80001.14 (RESET_N); also elsewhere on the board
controller-carrier__SIDEBAND_DATA: U80001.Z6 (P1.15); also elsewhere on the board
controller-carrier__SIDEBAND_LOAD_N: U80001.Z5 (P1.14); also elsewhere on the board
controller-carrier__SWCLK: U80001.15 (SWCLK); also elsewhere on the board
controller-carrier__SWDIO: U80001.16 (SWDIO); also elsewhere on the board

Notes on the sheet:
DIGITAL SCCI ENGINEERING / ARTIFICIAL SIGNALS / nRF5340 CONTROLLER CARRIER
46 actual GPIO, explicit common CNV/rearm and physical 32-bit health/readback chain. Radio remains disabled.
All labels are native electrical connections. Digital artificial-load interface; no clinical, chronic or body-radio qualification.
Hardware permissions and terminal guards remain independent of transport. Loss of data rejects the observation.

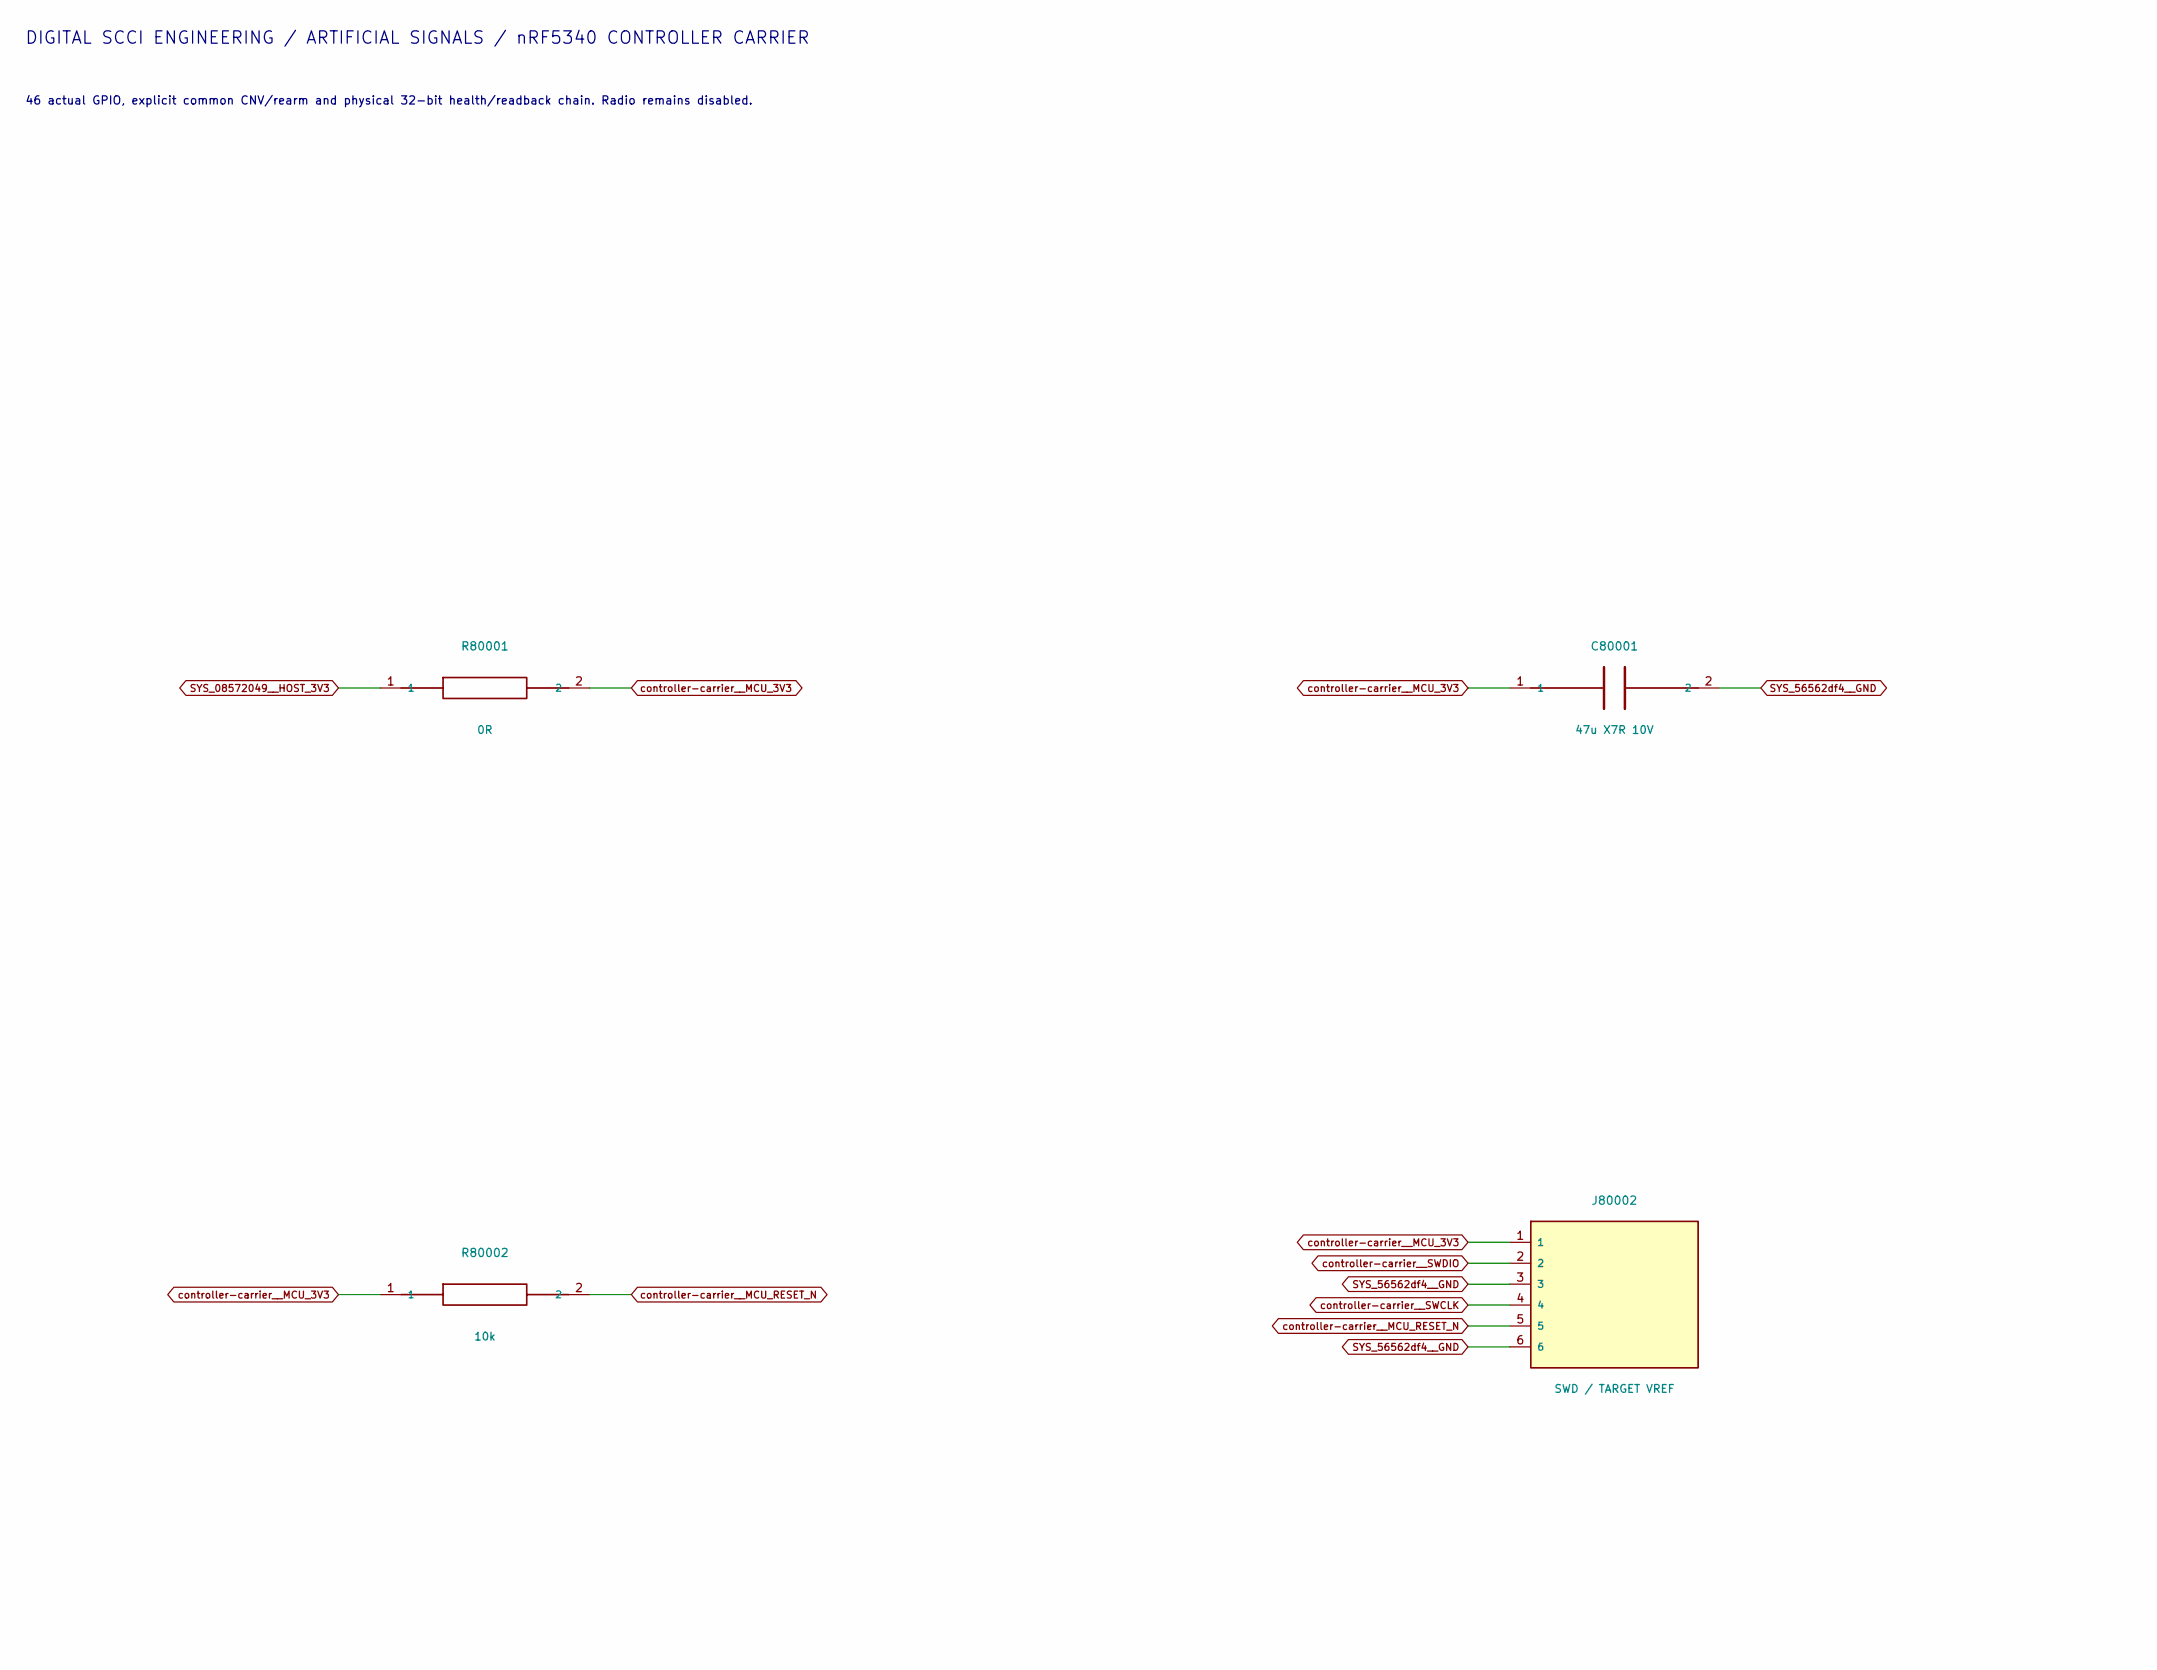
[picture p315: schematic power.kicad_sch, Project SCCI RH S4 / Module normal-voltage supply and SWD, part in row 1, column 1]

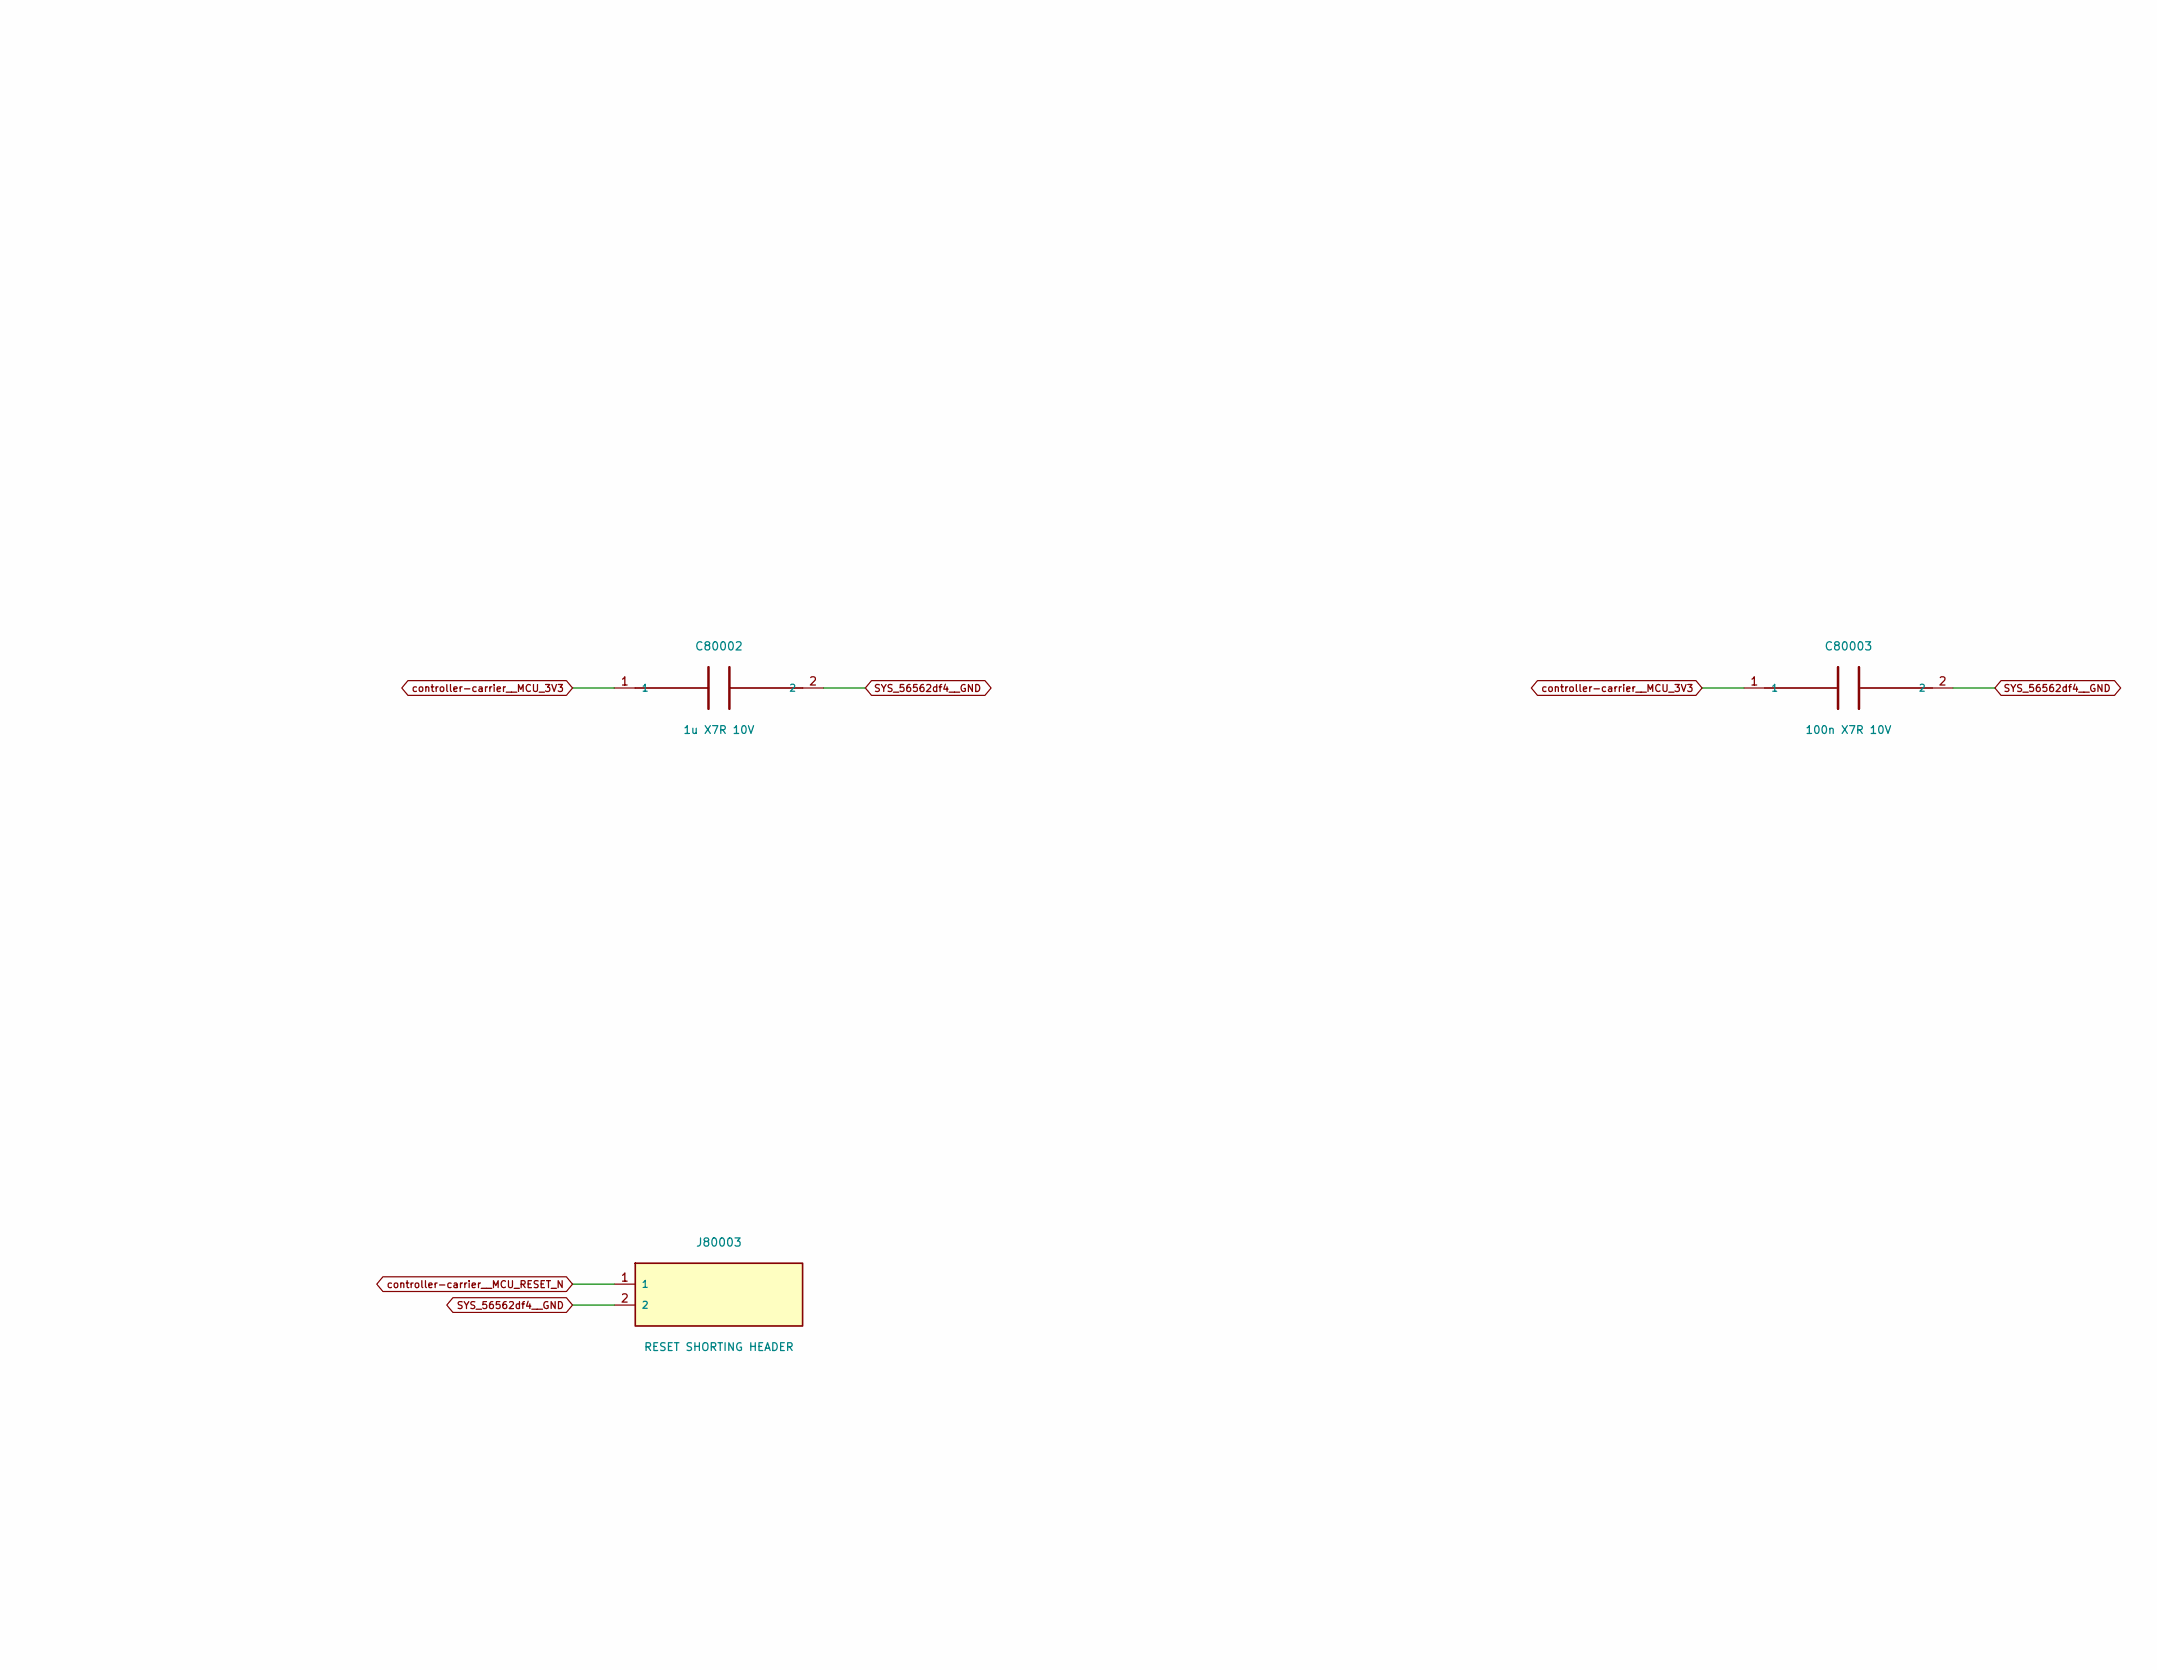
[picture p316: schematic power.kicad_sch, Project SCCI RH S4 / Module normal-voltage supply and SWD, part in row 1, column 2]

Parts:
C80001: 47u X7R 10V; C_1206_3216Metric
C80002: 1u X7R 10V; C_1206_3216Metric
C80003: 100n X7R 10V; C_1206_3216Metric
J80002: SWD / TARGET VREF; PinHeader_1x06_P2.54mm_Vertical
J80003: RESET SHORTING HEADER; PinHeader_1x02_P2.54mm_Vertical
R80001: 0R; R_0805_2012Metric
R80002: 10k; R_0805_2012Metric

Connections:
SYS_56562df4__GND: C80001.2, C80002.2, C80003.2, J80002.3, J80002.6, J80003.2; also elsewhere on the board
SYS_08572049__HOST_3V3: R80001.1; also elsewhere on the board
controller-carrier__MCU_3V3: C80001.1, C80002.1, C80003.1, J80002.1, R80001.2, R80002.1; also elsewhere on the board
controller-carrier__MCU_RESET_N: J80002.5, J80003.1, R80002.2; also elsewhere on the board
controller-carrier__SWCLK: J80002.4; also elsewhere on the board
controller-carrier__SWDIO: J80002.2; also elsewhere on the board

Notes on the sheet:
DIGITAL SCCI ENGINEERING / ARTIFICIAL SIGNALS / nRF5340 CONTROLLER CARRIER
46 actual GPIO, explicit common CNV/rearm and physical 32-bit health/readback chain. Radio remains disabled.
All labels are native electrical connections. Digital artificial-load interface; no clinical, chronic or body-radio qualification.
Hardware permissions and terminal guards remain independent of transport. Loss of data rejects the observation.
