pratham-cloud-ctrl/Project-SCCI-RH/electronics/stage4/integrated-pcb/boards/controller-carrier/controller_carrier.kicad_pcb

## KiCad design electronics/stage4/integrated-pcb/boards/controller-carrier/controller_carrier.kicad_pcb (continued)

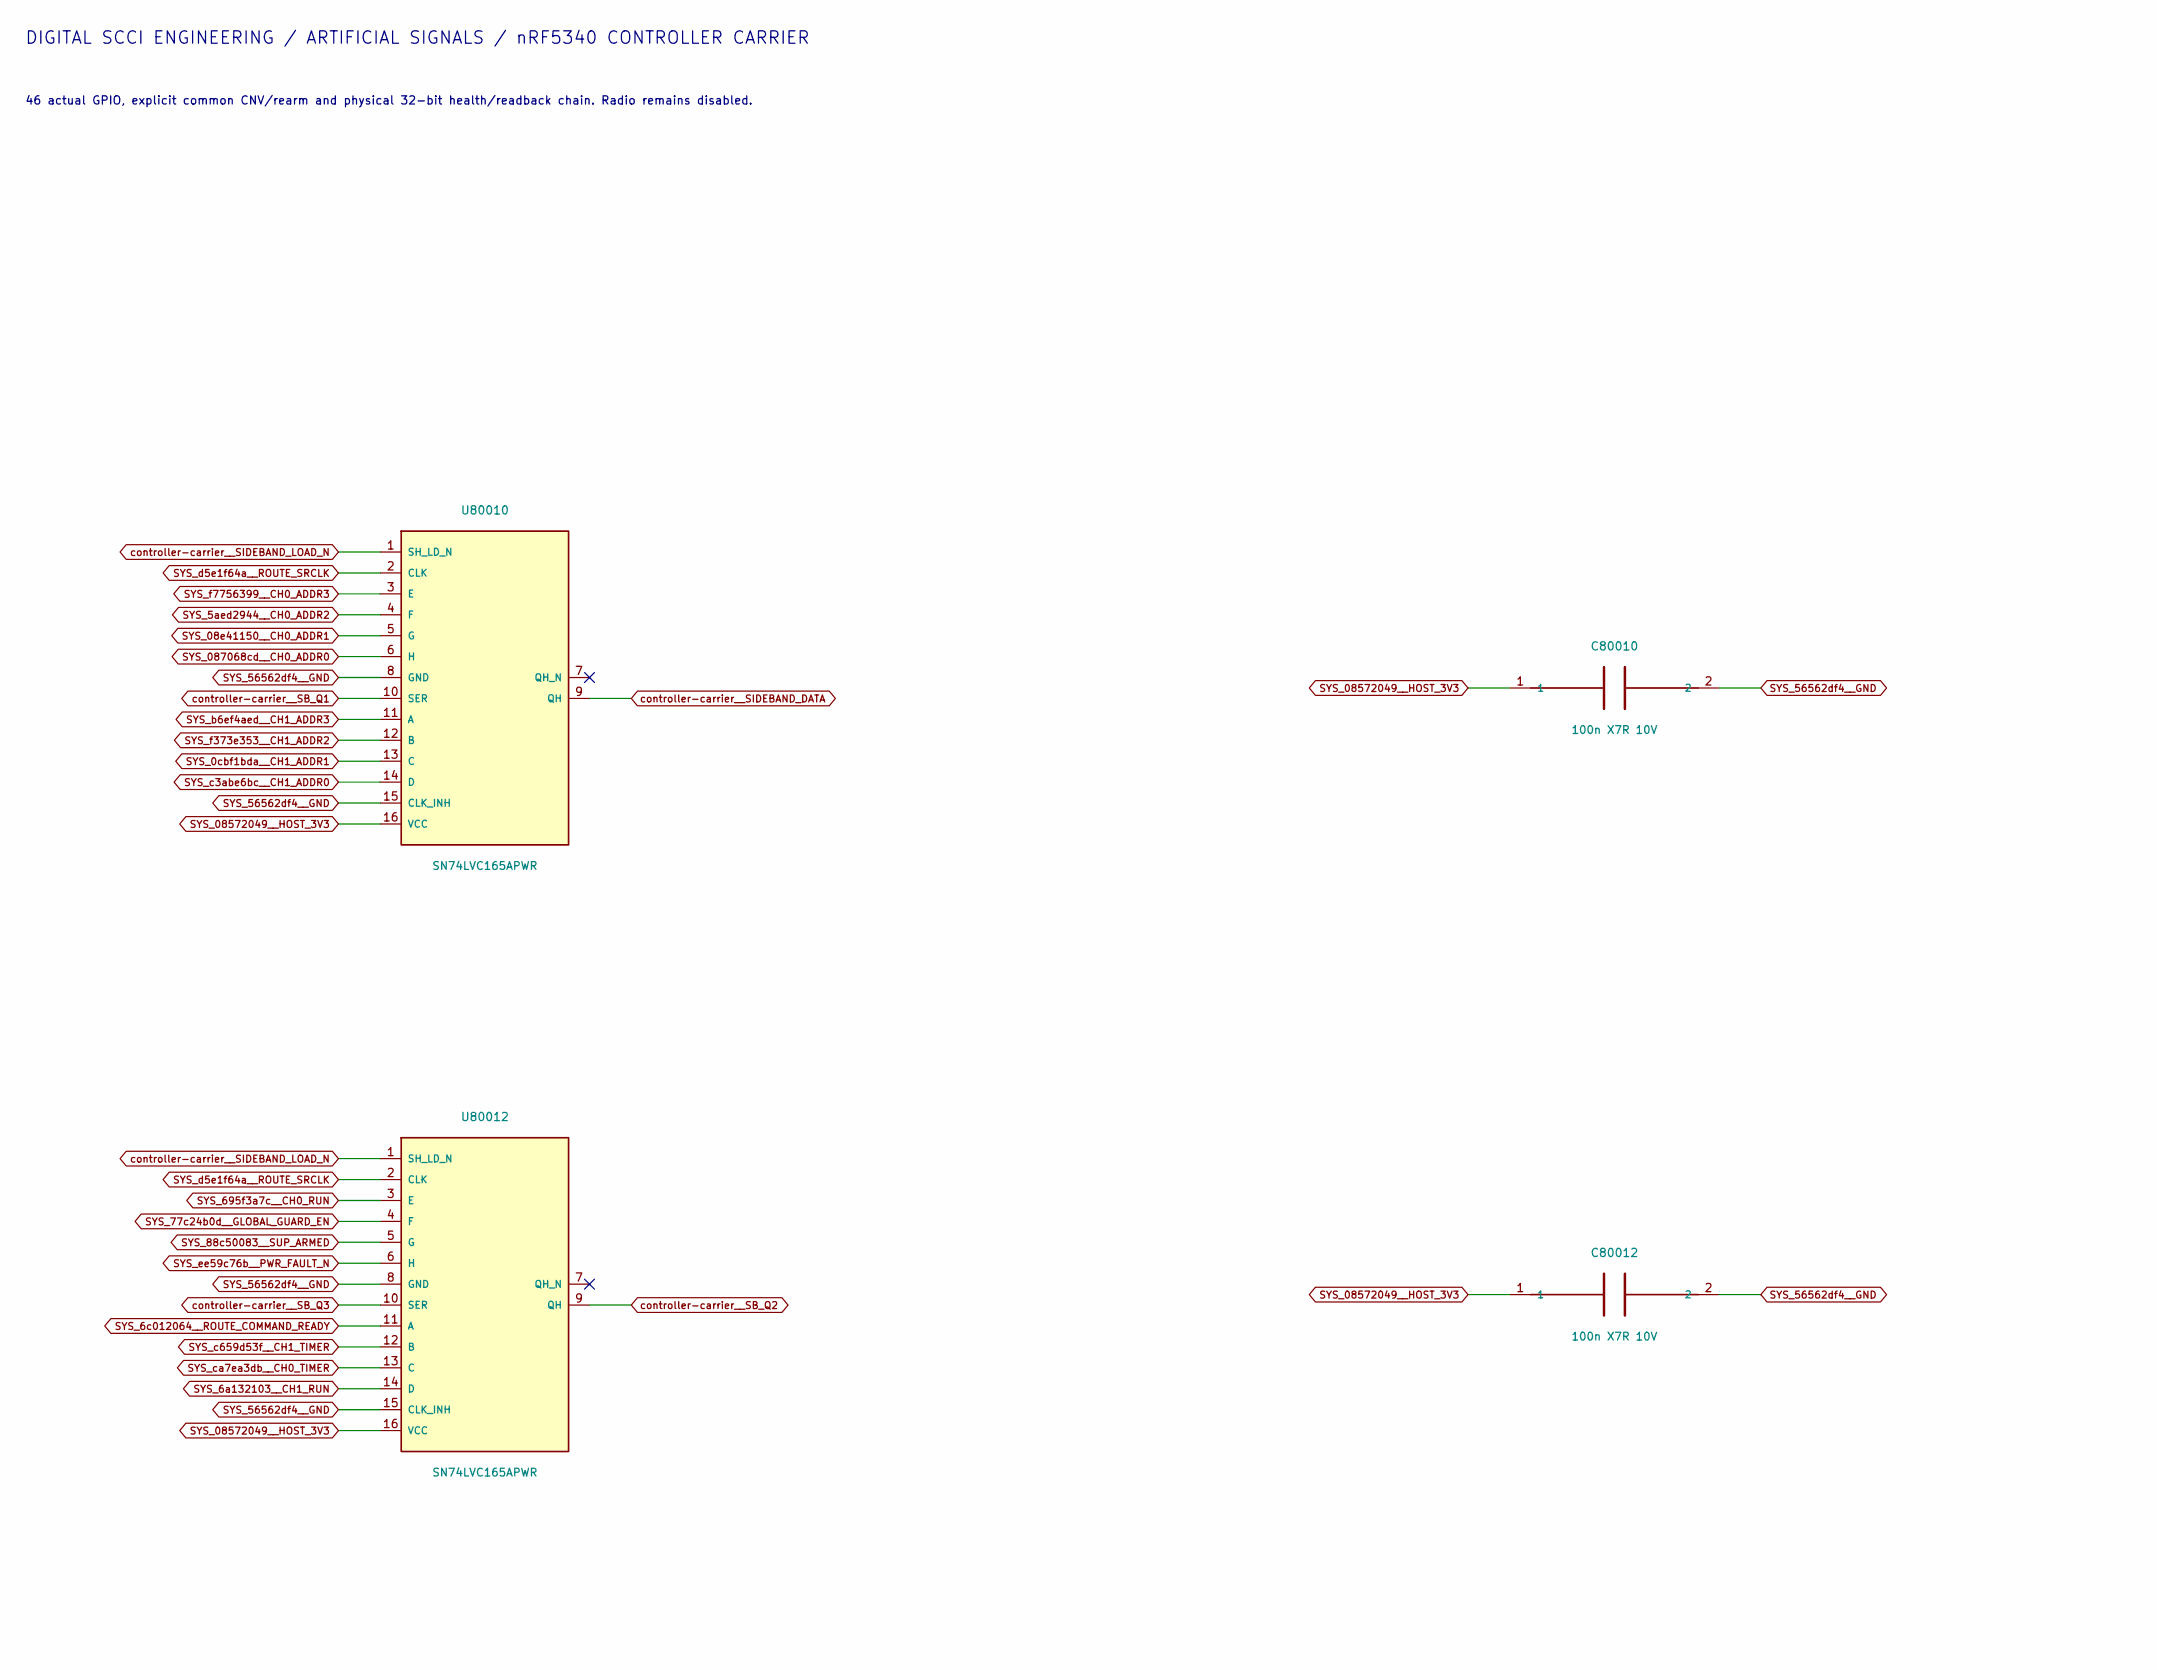
[picture p317: schematic sideband.kicad_sch, Project SCCI RH S4 / Four physical 165 devices / parallel o…, part in row 1, column 1]

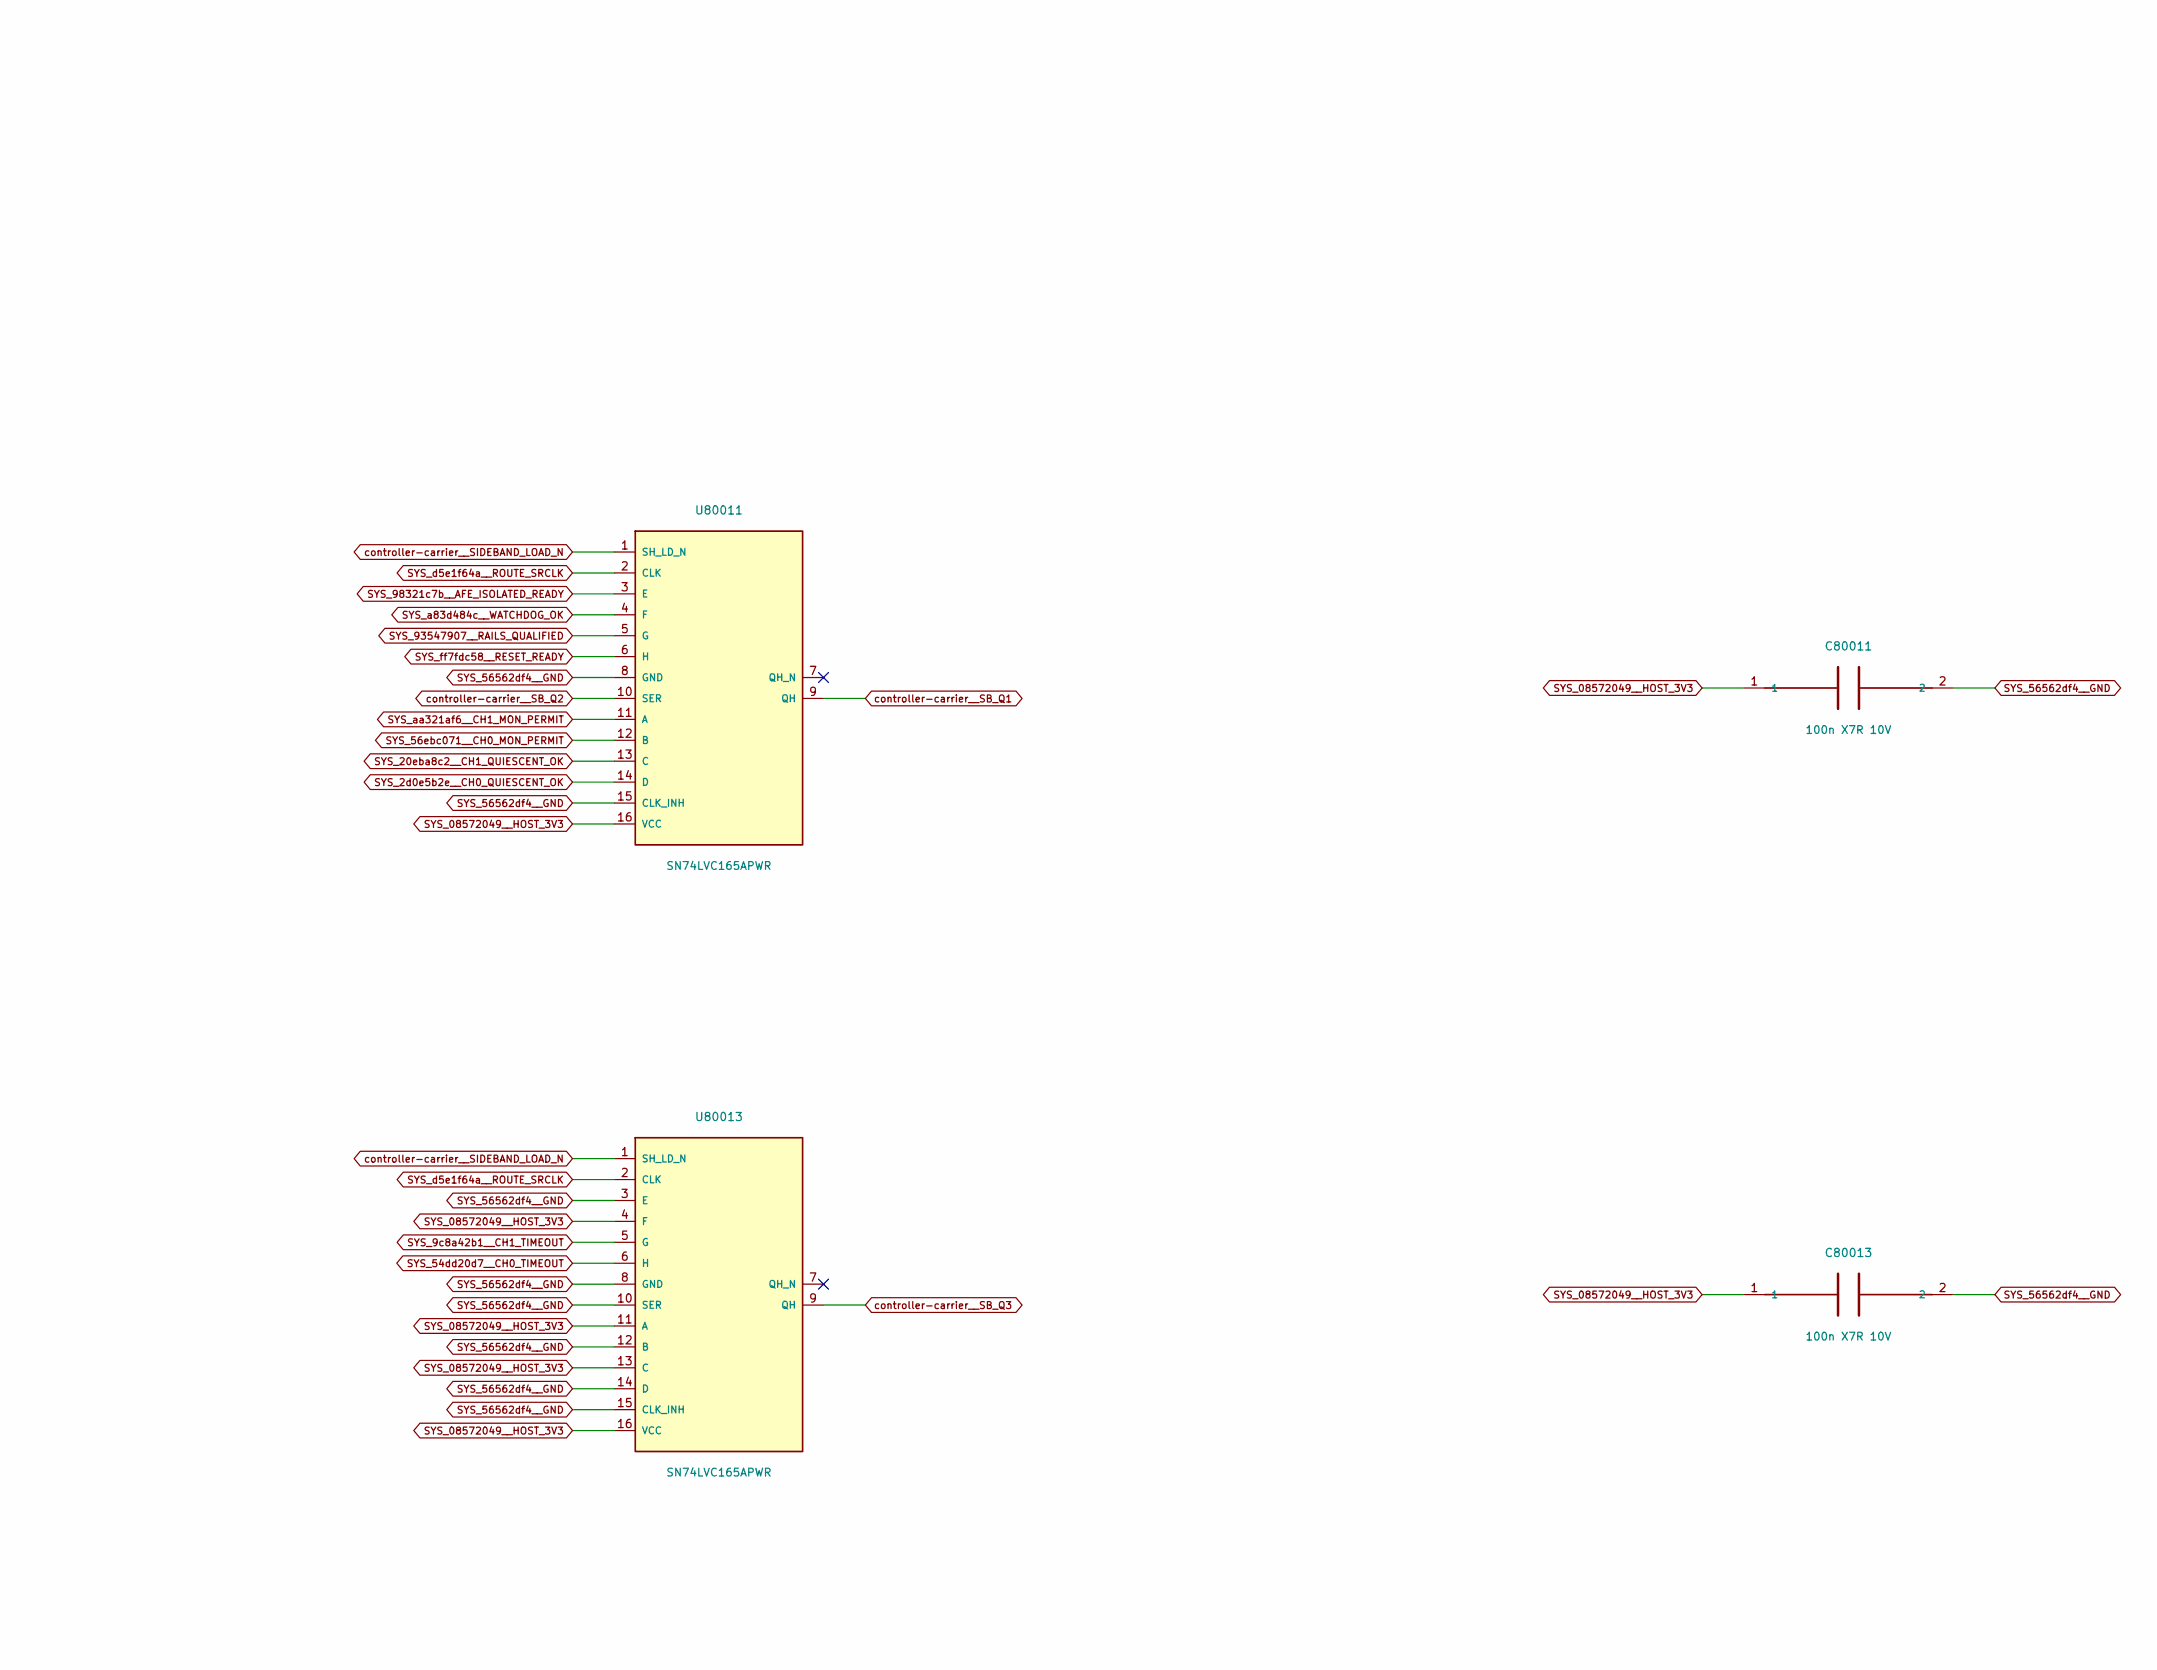
[picture p318: schematic sideband.kicad_sch, Project SCCI RH S4 / Four physical 165 devices / parallel o…, part in row 1, column 2]

Parts:
C80010, C80011, C80012, C80013: 100n X7R 10V; C_1206_3216Metric
U80010, U80011, U80012, U80013: SN74LVC165APWR; TSSOP-16_4.4x5mm_P0.65mm

Connections:
SYS_0cbf1bda__CH1_ADDR1: U80010.13 (C); also elsewhere on the board
SYS_2d0e5b2e__CH0_QUIESCENT_OK: U80011.14 (D); also elsewhere on the board
SYS_5aed2944__CH0_ADDR2: U80010.4 (F); also elsewhere on the board
SYS_6a132103__CH1_RUN: U80012.14 (D); also elsewhere on the board
SYS_6c012064__ROUTE_COMMAND_READY: U80012.11 (A); also elsewhere on the board
SYS_08e41150__CH0_ADDR1: U80010.5 (G); also elsewhere on the board
SYS_9c8a42b1__CH1_TIMEOUT: U80013.5 (G); also elsewhere on the board
SYS_20eba8c2__CH1_QUIESCENT_OK: U80011.13 (C); also elsewhere on the board
SYS_54dd20d7__CH0_TIMEOUT: U80013.6 (H); also elsewhere on the board
SYS_56ebc071__CH0_MON_PERMIT: U80011.12 (B); also elsewhere on the board
SYS_77c24b0d__GLOBAL_GUARD_EN: U80012.4 (F); also elsewhere on the board
SYS_88c50083__SUP_ARMED: U80012.5 (G); also elsewhere on the board
SYS_695f3a7c__CH0_RUN: U80012.3 (E); also elsewhere on the board
SYS_56562df4__GND: C80010.2, C80011.2, C80012.2, C80013.2, U80010.8 (GND), U80010.15 (CLK_INH), U80011.8 (GND), U80011.15 (CLK_INH), U80012.8 (GND), U80012.15 (CLK_INH), U80013.3 (E), U80013.8 (GND), U80013.10 (SER), U80013.12 (B), U80013.14 (D), U80013.15 (CLK_INH); also elsewhere on the board
SYS_087068cd__CH0_ADDR0: U80010.6 (H); also elsewhere on the board
SYS_98321c7b__AFE_ISOLATED_READY: U80011.3 (E); also elsewhere on the board
SYS_08572049__HOST_3V3: C80010.1, C80011.1, C80012.1, C80013.1, U80010.16 (VCC), U80011.16 (VCC), U80012.16 (VCC), U80013.4 (F), U80013.11 (A), U80013.13 (C), U80013.16 (VCC); also elsewhere on the board
SYS_93547907__RAILS_QUALIFIED: U80011.5 (G); also elsewhere on the board
SYS_a83d484c__WATCHDOG_OK: U80011.4 (F); also elsewhere on the board
SYS_aa321af6__CH1_MON_PERMIT: U80011.11 (A); also elsewhere on the board
SYS_b6ef4aed__CH1_ADDR3: U80010.11 (A); also elsewhere on the board
SYS_c3abe6bc__CH1_ADDR0: U80010.14 (D); also elsewhere on the board
SYS_c659d53f__CH1_TIMER: U80012.12 (B); also elsewhere on the board
SYS_ca7ea3db__CH0_TIMER: U80012.13 (C); also elsewhere on the board
SYS_d5e1f64a__ROUTE_SRCLK: U80010.2 (CLK), U80011.2 (CLK), U80012.2 (CLK), U80013.2 (CLK); also elsewhere on the board
SYS_ee59c76b__PWR_FAULT_N: U80012.6 (H); also elsewhere on the board
SYS_f373e353__CH1_ADDR2: U80010.12 (B); also elsewhere on the board
SYS_f7756399__CH0_ADDR3: U80010.3 (E); also elsewhere on the board
SYS_ff7fdc58__RESET_READY: U80011.6 (H); also elsewhere on the board
controller-carrier__SB_Q1: U80010.10 (SER), U80011.9 (QH)
controller-carrier__SB_Q2: U80011.10 (SER), U80012.9 (QH)
controller-carrier__SB_Q3: U80012.10 (SER), U80013.9 (QH)
controller-carrier__SIDEBAND_DATA: U80010.9 (QH); also elsewhere on the board
controller-carrier__SIDEBAND_LOAD_N: U80010.1 (SH_LD_N), U80011.1 (SH_LD_N), U80012.1 (SH_LD_N), U80013.1 (SH_LD_N); also elsewhere on the board

Notes on the sheet:
DIGITAL SCCI ENGINEERING / ARTIFICIAL SIGNALS / nRF5340 CONTROLLER CARRIER
46 actual GPIO, explicit common CNV/rearm and physical 32-bit health/readback chain. Radio remains disabled.
All labels are native electrical connections. Digital artificial-load interface; no clinical, chronic or body-radio qualification.
Hardware permissions and terminal guards remain independent of transport. Loss of data rejects the observation.

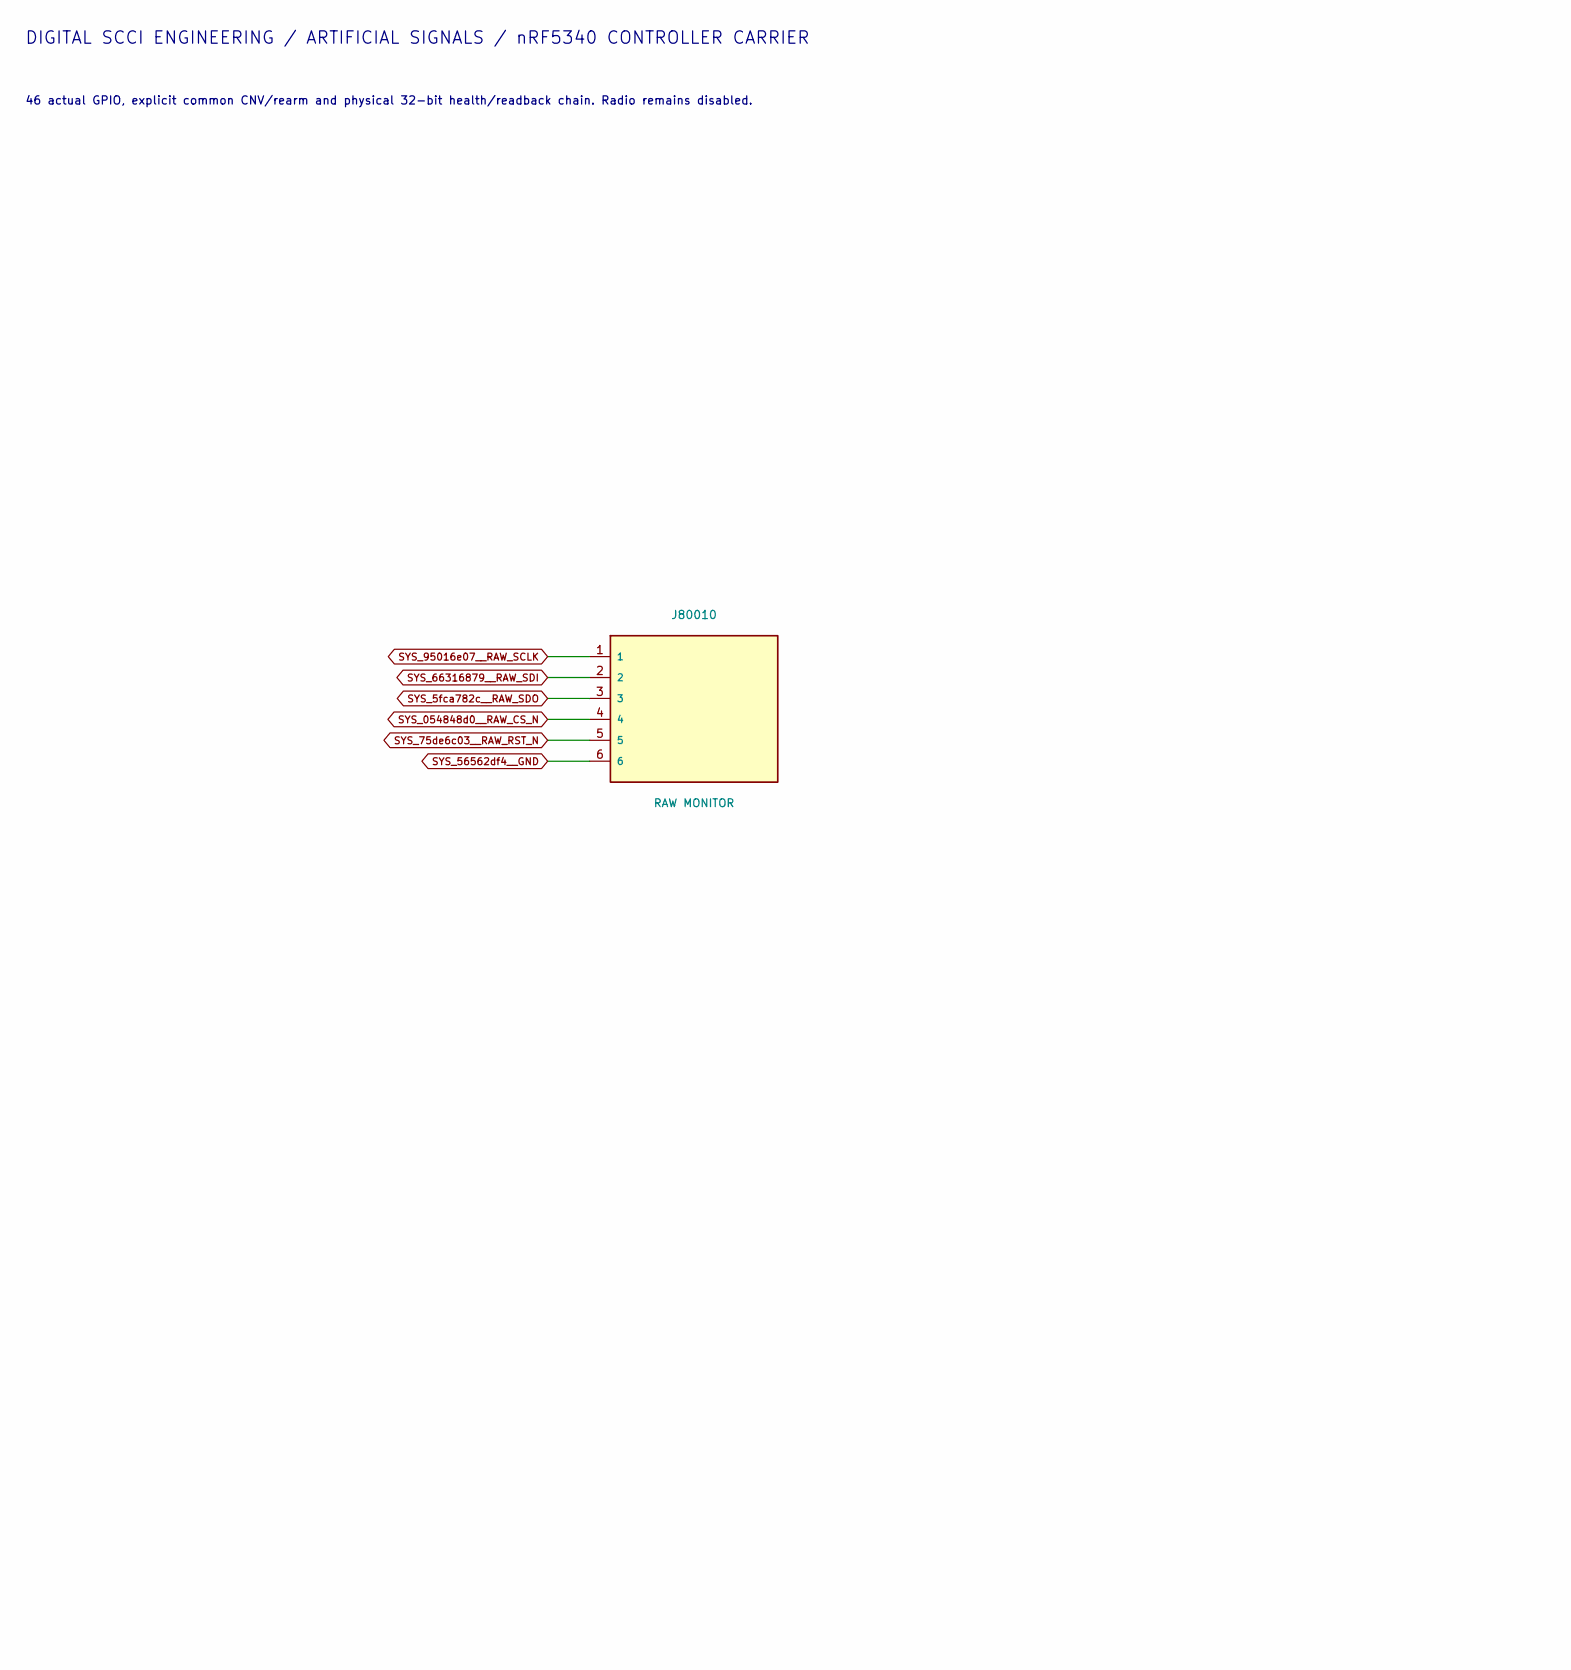
[picture p319: schematic handoff.kicad_sch, Project SCCI RH S4 / Matched peripheral handoff connectors, part in row 1, column 1]

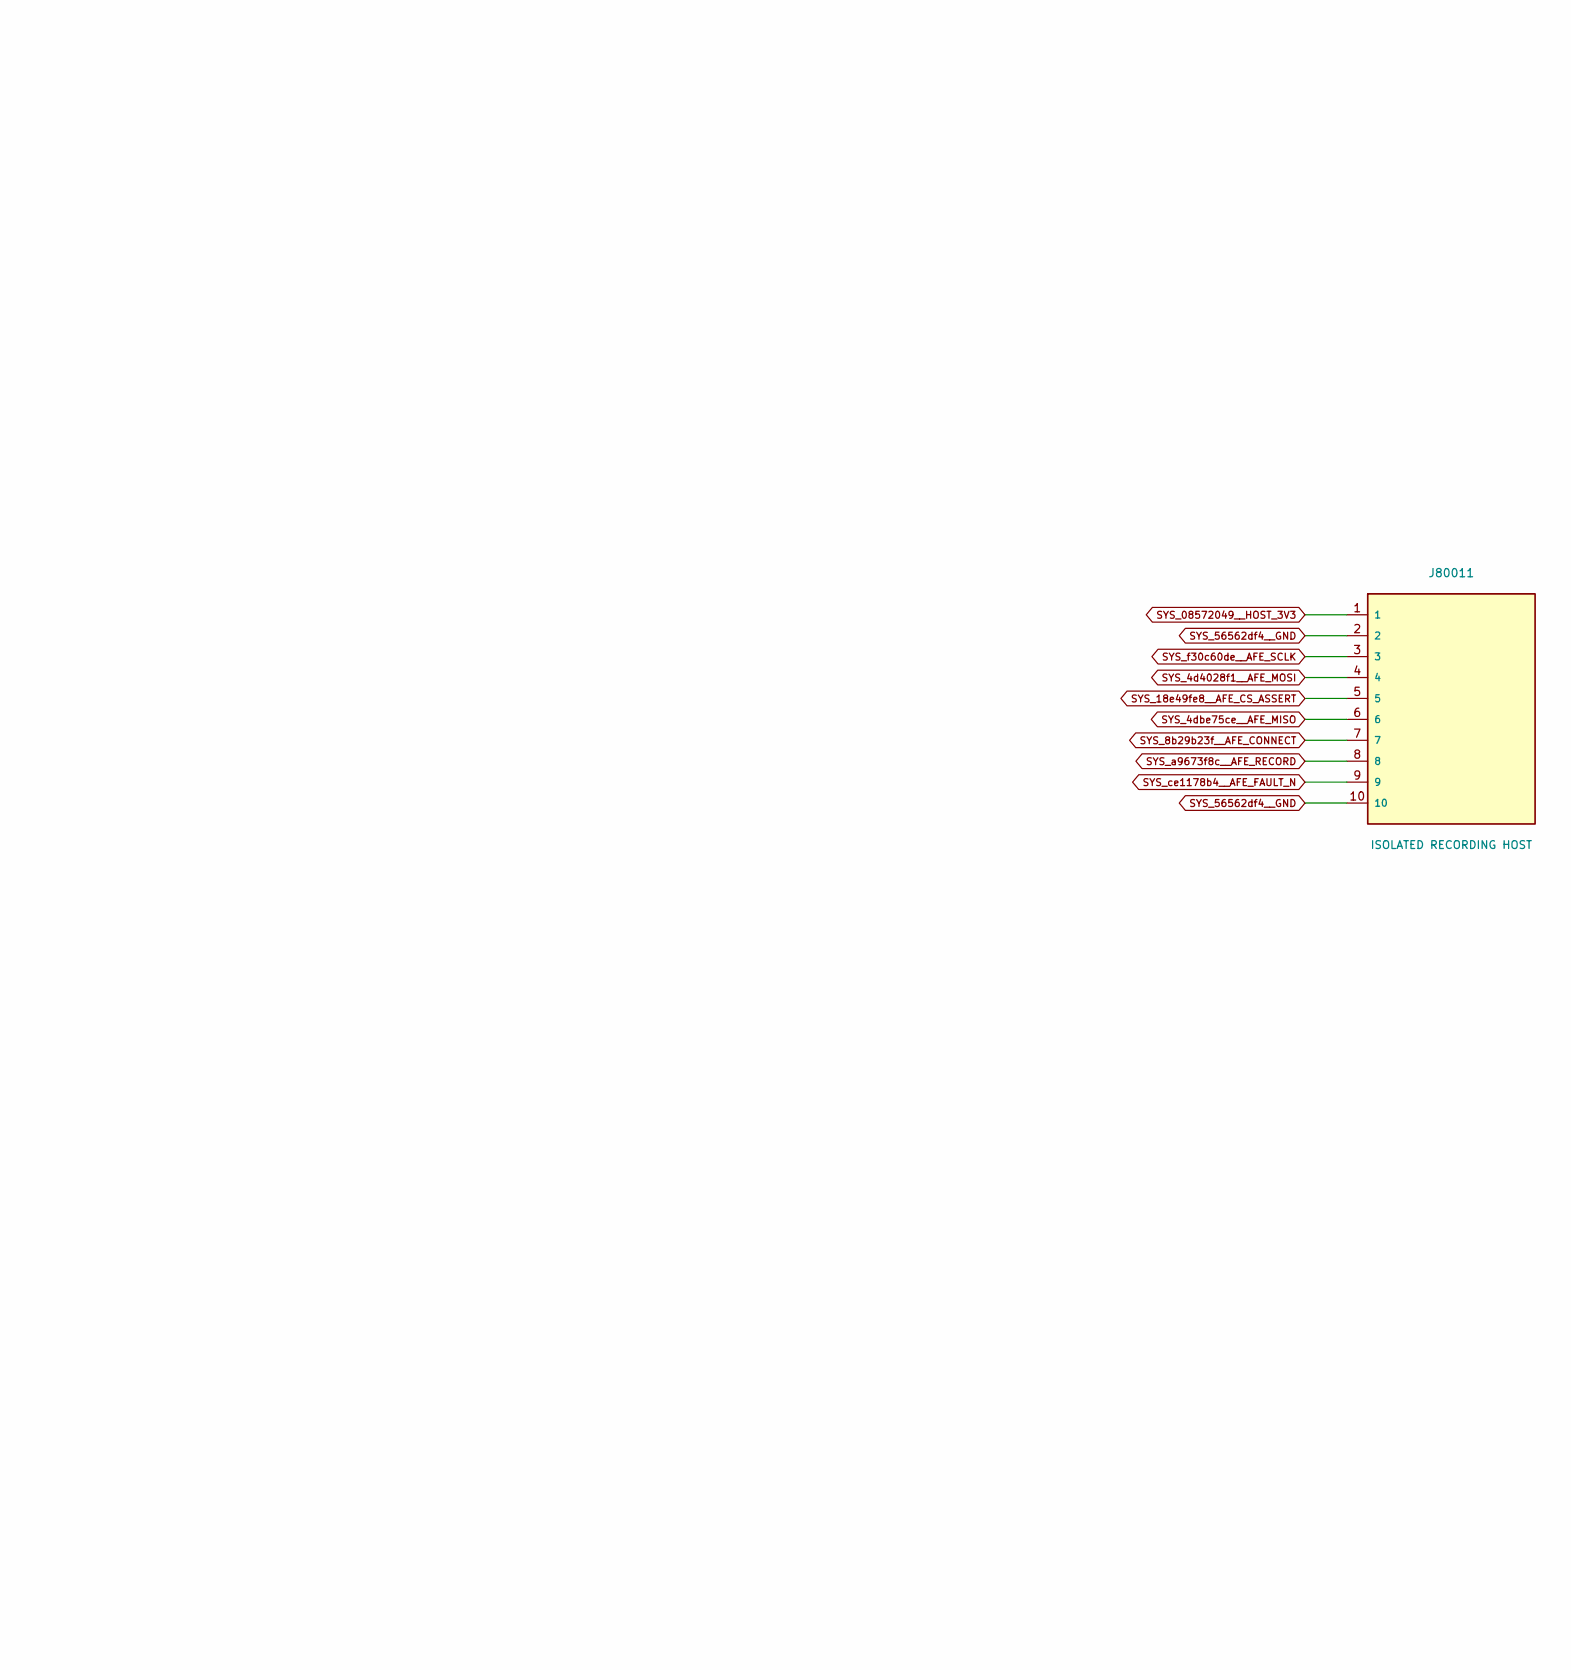
[picture p320: schematic handoff.kicad_sch, Project SCCI RH S4 / Matched peripheral handoff connectors, part in row 1, column 2]

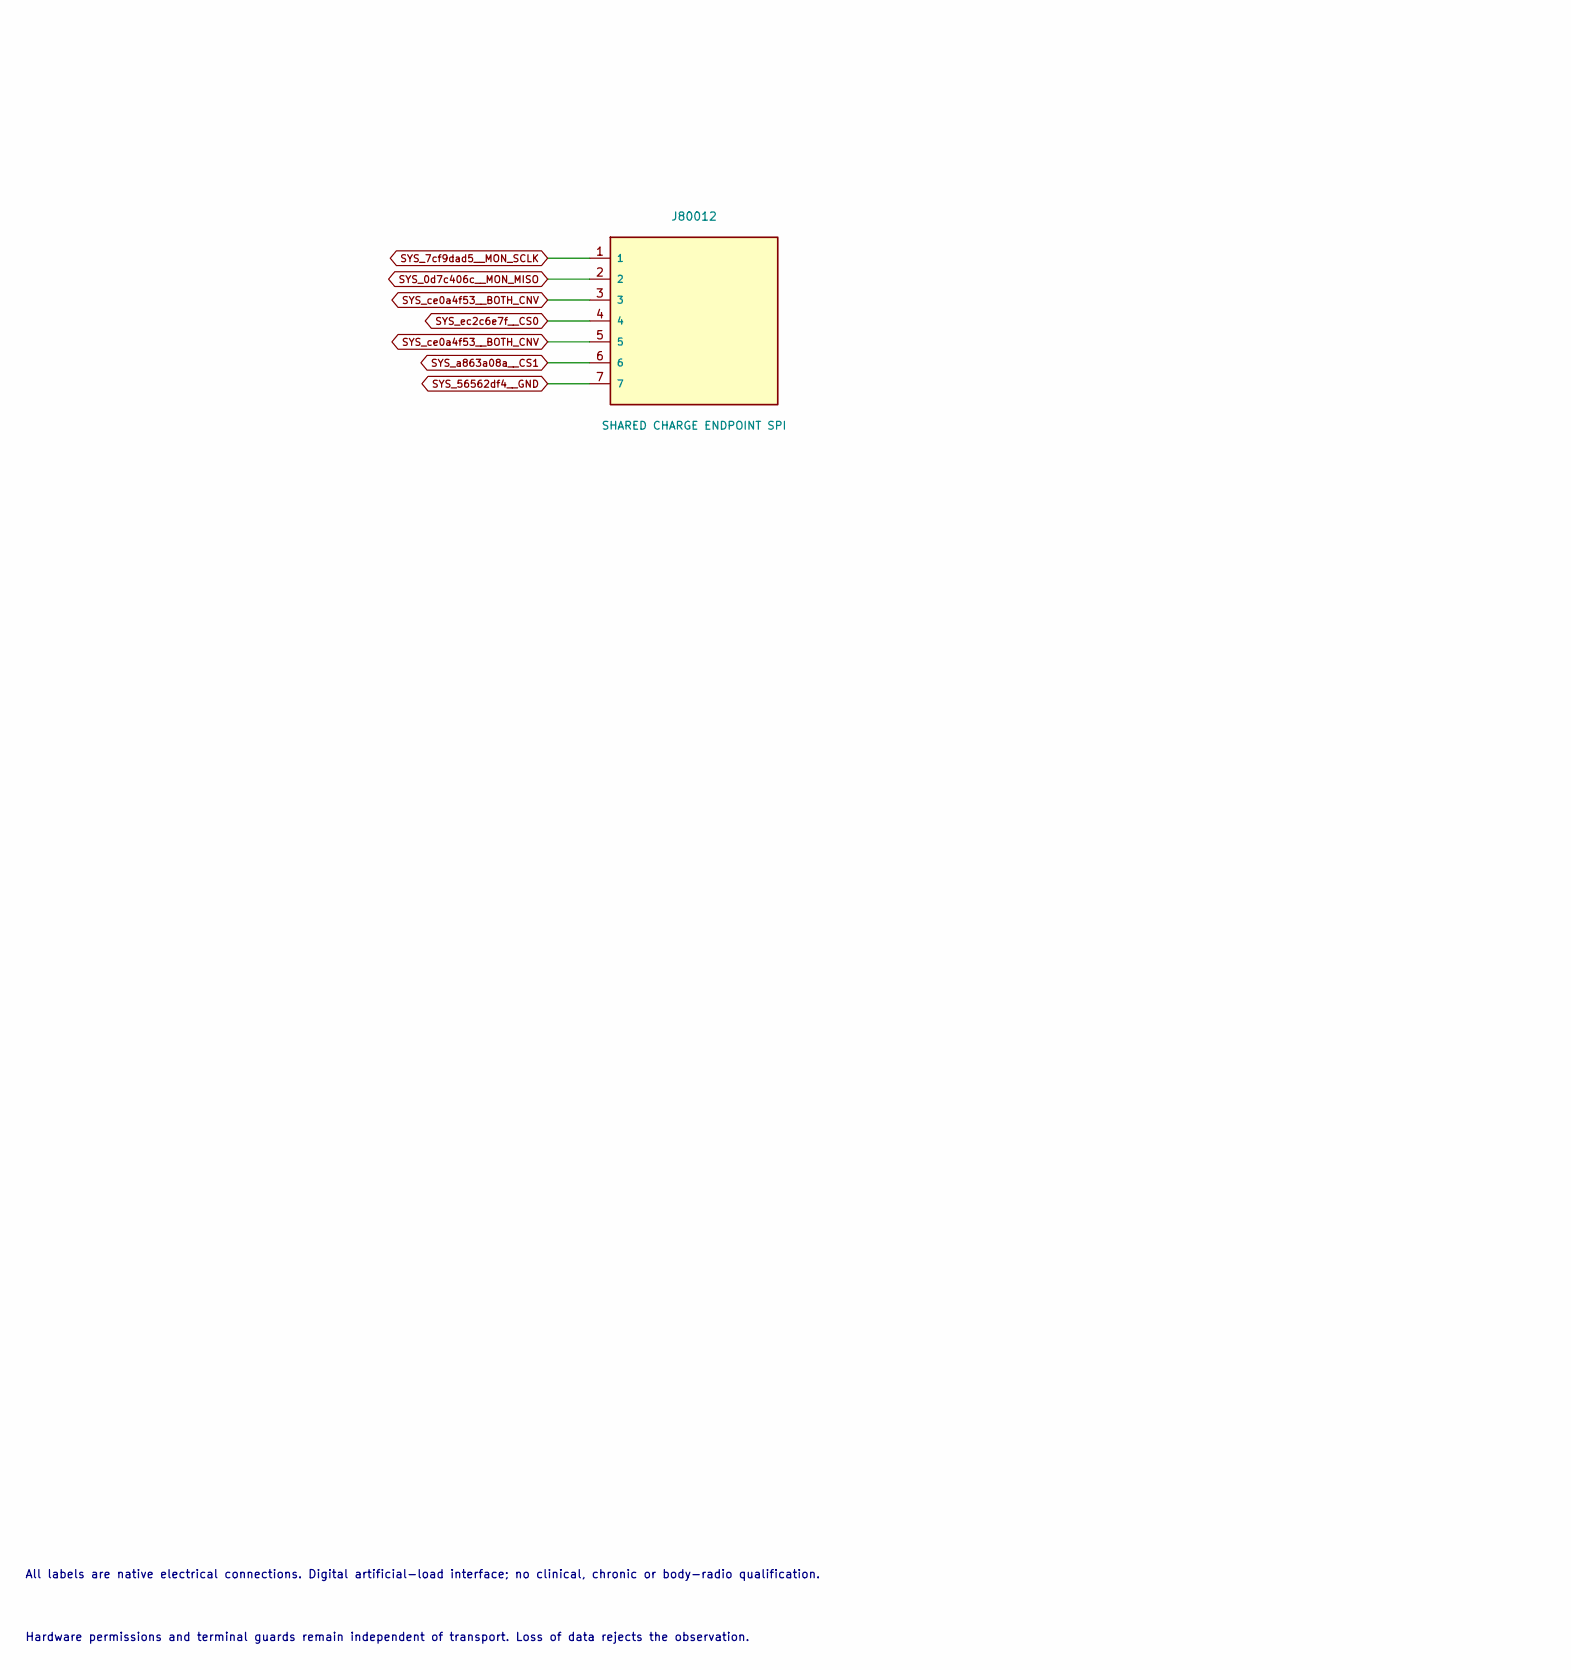
[picture p321: schematic handoff.kicad_sch, Project SCCI RH S4 / Matched peripheral handoff connectors, part in row 2, column 1]

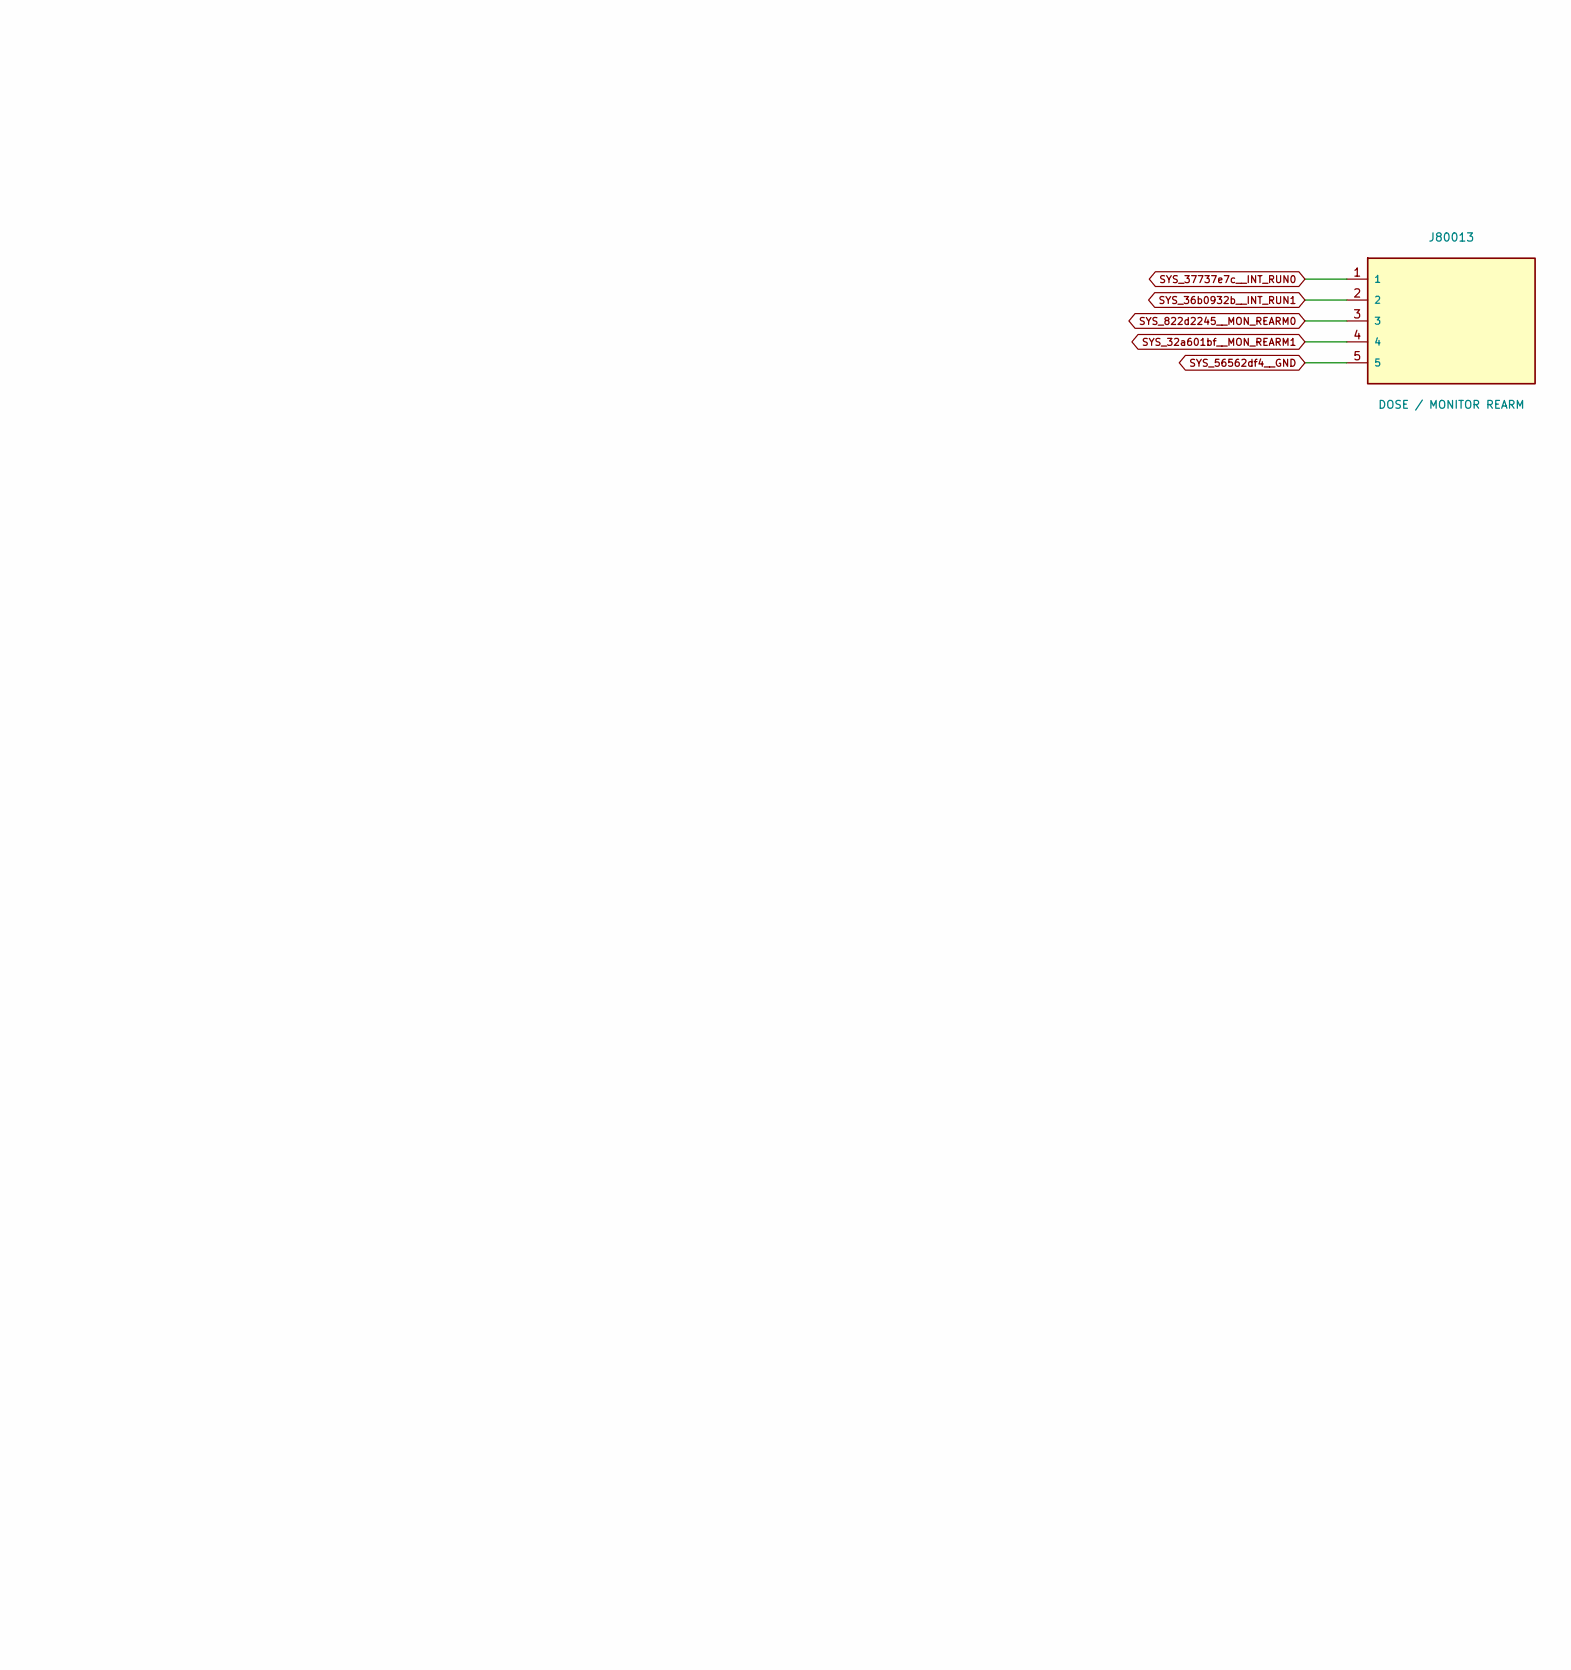
[picture p322: schematic handoff.kicad_sch, Project SCCI RH S4 / Matched peripheral handoff connectors, part in row 2, column 2]

Parts:
J80010: RAW MONITOR; PinHeader_1x06_P2.54mm_Vertical
J80011: ISOLATED RECORDING HOST; PinHeader_1x10_P2.54mm_Vertical
J80012: SHARED CHARGE ENDPOINT SPI; PinHeader_1x07_P2.54mm_Vertical
J80013: DOSE / MONITOR REARM; PinHeader_1x05_P2.54mm_Vertical

Connections:
SYS_0d7c406c__MON_MISO: J80012.2; also elsewhere on the board
SYS_4d4028f1__AFE_MOSI: J80011.4; also elsewhere on the board
SYS_4dbe75ce__AFE_MISO: J80011.6; also elsewhere on the board
SYS_5fca782c__RAW_SDO: J80010.3; also elsewhere on the board
SYS_7cf9dad5__MON_SCLK: J80012.1; also elsewhere on the board
SYS_8b29b23f__AFE_CONNECT: J80011.7; also elsewhere on the board
SYS_18e49fe8__AFE_CS_ASSERT: J80011.5; also elsewhere on the board
SYS_32a601bf__MON_REARM1: J80013.4; also elsewhere on the board
SYS_36b0932b__INT_RUN1: J80013.2; also elsewhere on the board
SYS_75de6c03__RAW_RST_N: J80010.5; also elsewhere on the board
SYS_822d2245__MON_REARM0: J80013.3; also elsewhere on the board
SYS_37737e7c__INT_RUN0: J80013.1; also elsewhere on the board
SYS_054848d0__RAW_CS_N: J80010.4; also elsewhere on the board
SYS_56562df4__GND: J80010.6, J80011.2, J80011.10, J80012.7, J80013.5; also elsewhere on the board
SYS_95016e07__RAW_SCLK: J80010.1; also elsewhere on the board
SYS_08572049__HOST_3V3: J80011.1; also elsewhere on the board
SYS_66316879__RAW_SDI: J80010.2; also elsewhere on the board
SYS_a863a08a__CS1: J80012.6; also elsewhere on the board
SYS_a9673f8c__AFE_RECORD: J80011.8; also elsewhere on the board
SYS_ce0a4f53__BOTH_CNV: J80012.3, J80012.5; also elsewhere on the board
SYS_ce1178b4__AFE_FAULT_N: J80011.9; also elsewhere on the board
SYS_ec2c6e7f__CS0: J80012.4; also elsewhere on the board
SYS_f30c60de__AFE_SCLK: J80011.3; also elsewhere on the board

Notes on the sheet:
DIGITAL SCCI ENGINEERING / ARTIFICIAL SIGNALS / nRF5340 CONTROLLER CARRIER
46 actual GPIO, explicit common CNV/rearm and physical 32-bit health/readback chain. Radio remains disabled.
All labels are native electrical connections. Digital artificial-load interface; no clinical, chronic or body-radio qualification.
Hardware permissions and terminal guards remain independent of transport. Loss of data rejects the observation.
