pratham-cloud-ctrl/Project-SCCI-RH/electronics/stage4/integrated-pcb/boards/controller-carrier/controller_carrier.kicad_pcb

## KiCad design electronics/stage4/integrated-pcb/boards/controller-carrier/controller_carrier.kicad_pcb (continued)

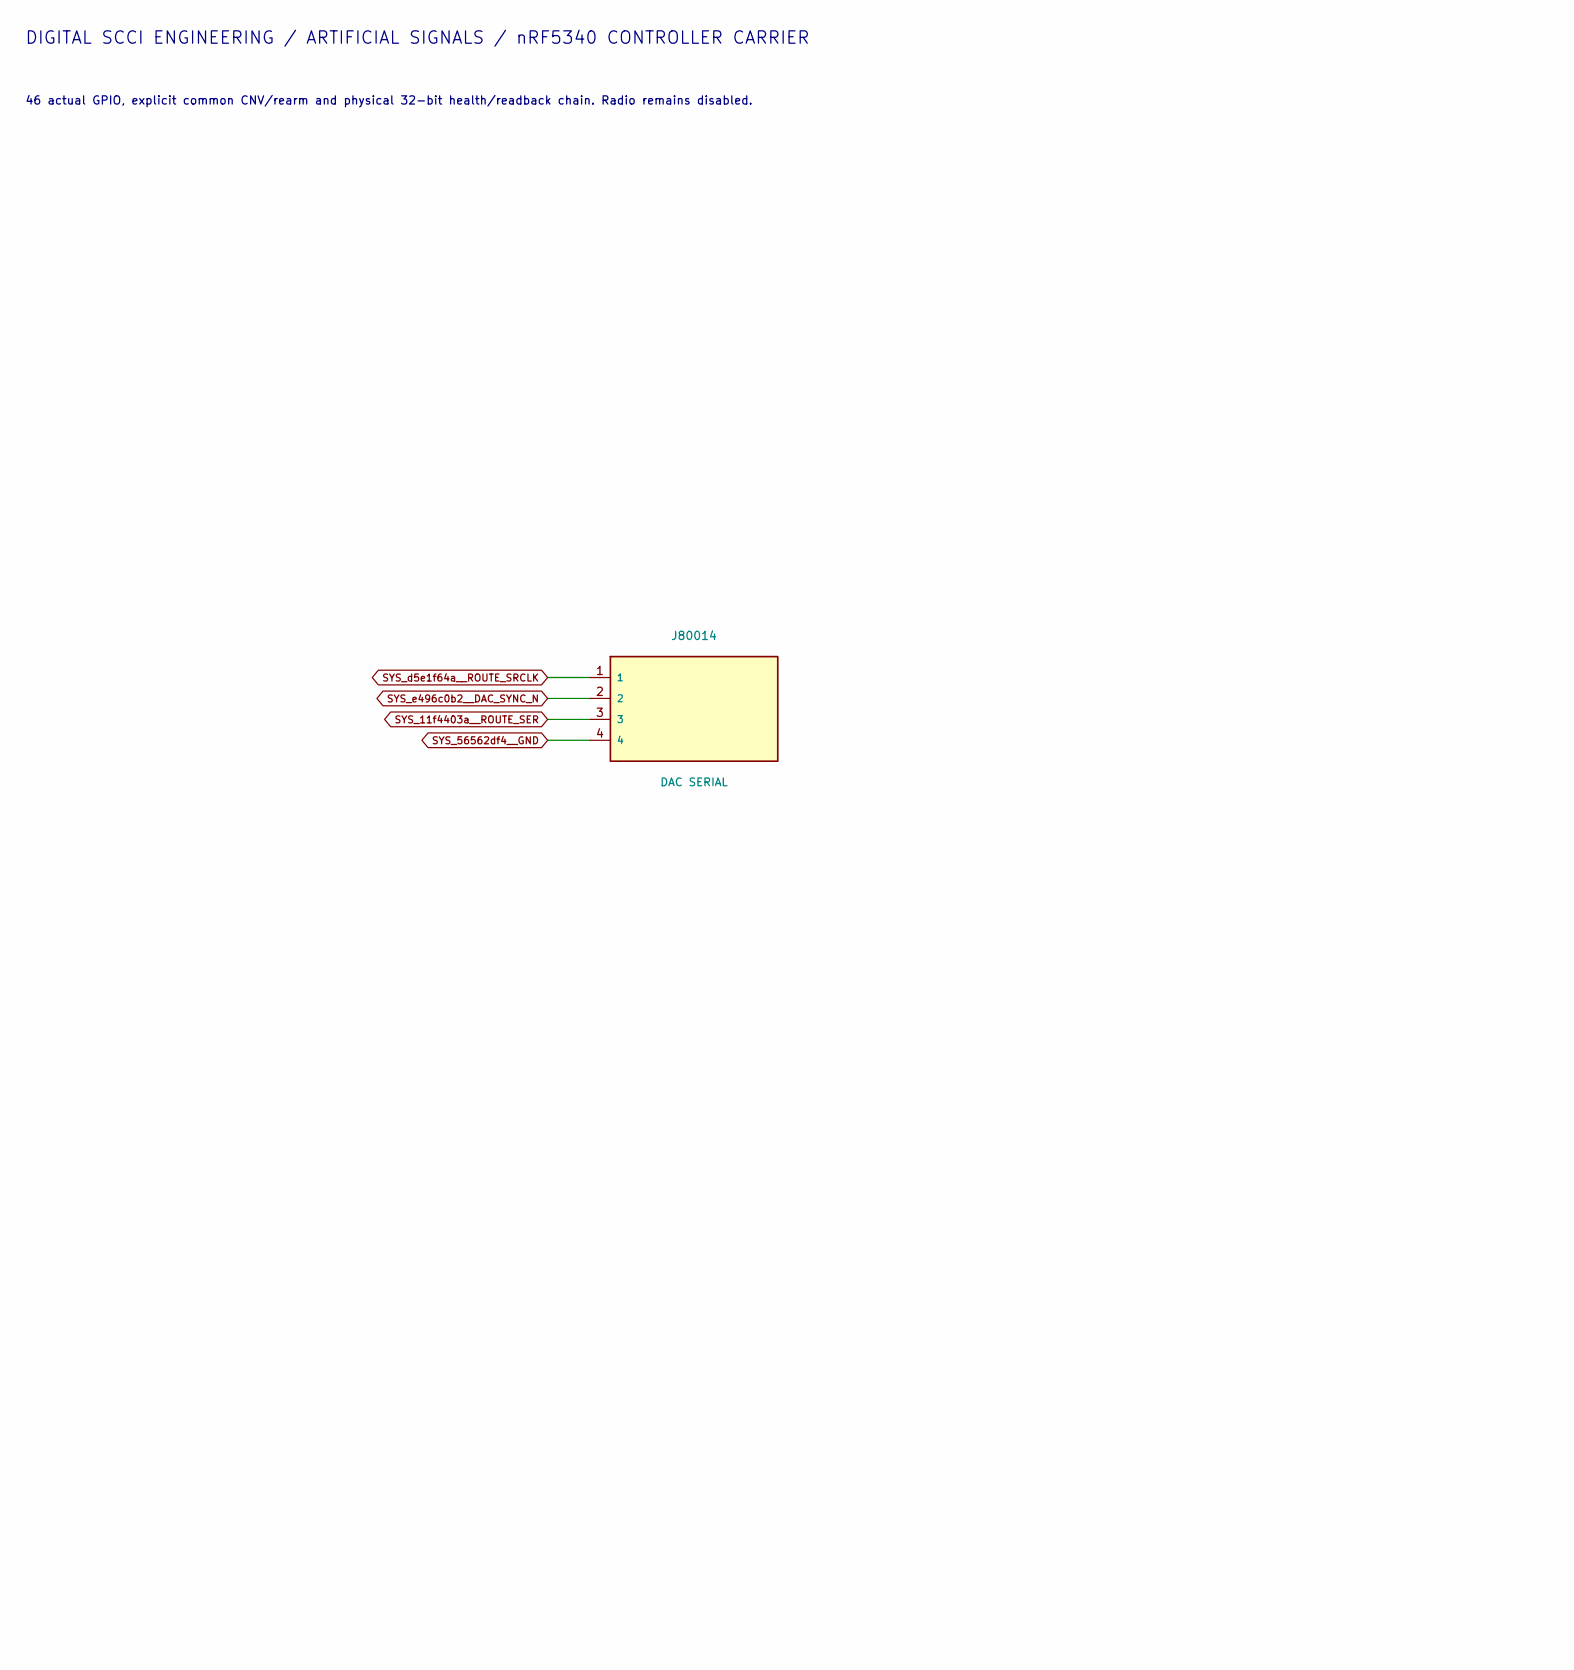
[picture p323: schematic handoff_2.kicad_sch, Project SCCI RH S4 / Matched peripheral handoff connectors …, part in row 1, column 1]

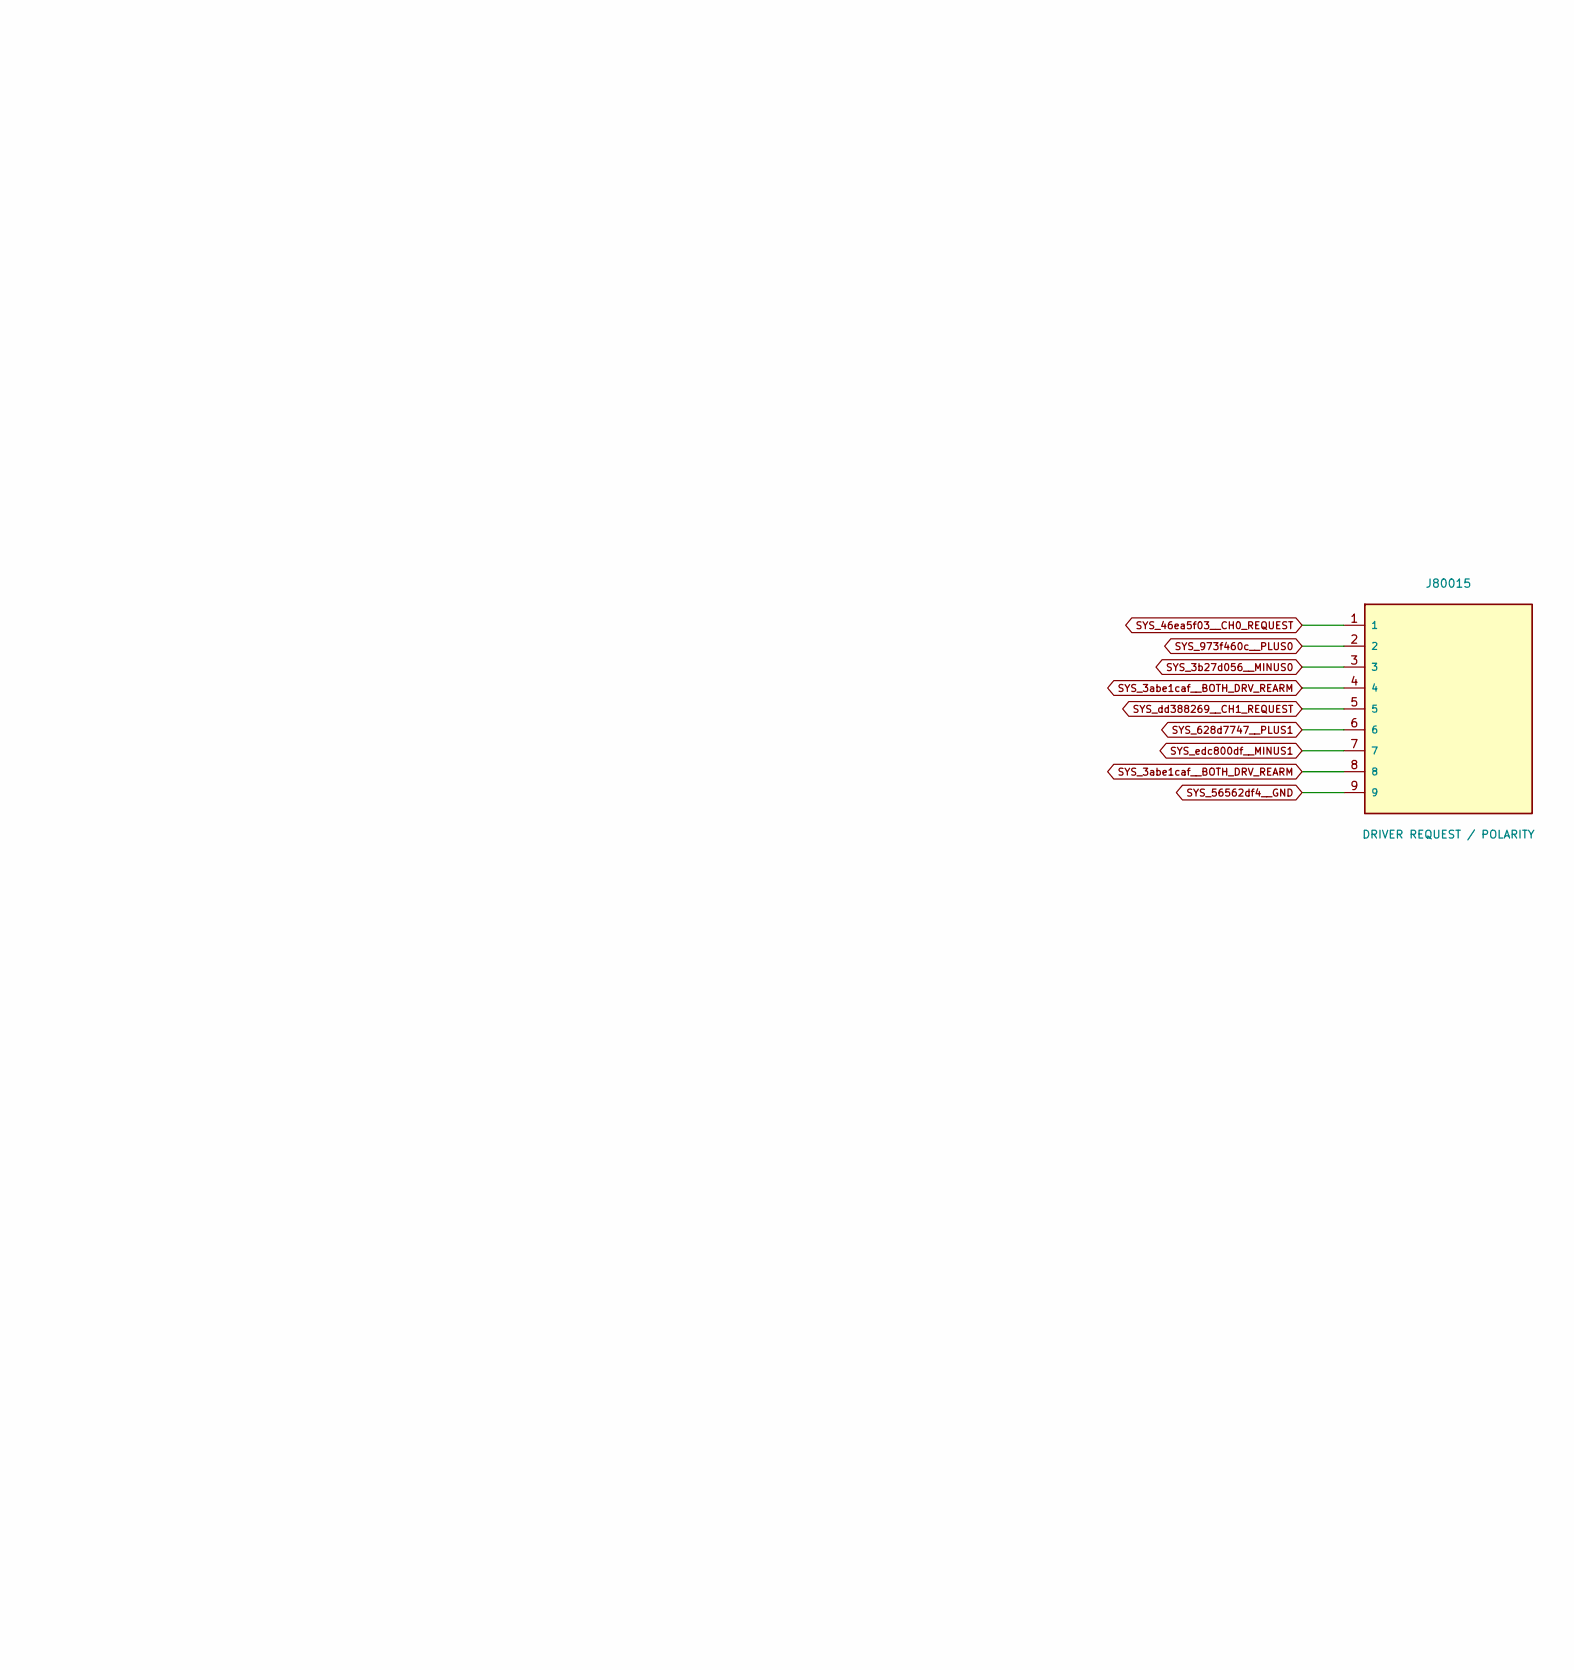
[picture p324: schematic handoff_2.kicad_sch, Project SCCI RH S4 / Matched peripheral handoff connectors …, part in row 1, column 2]

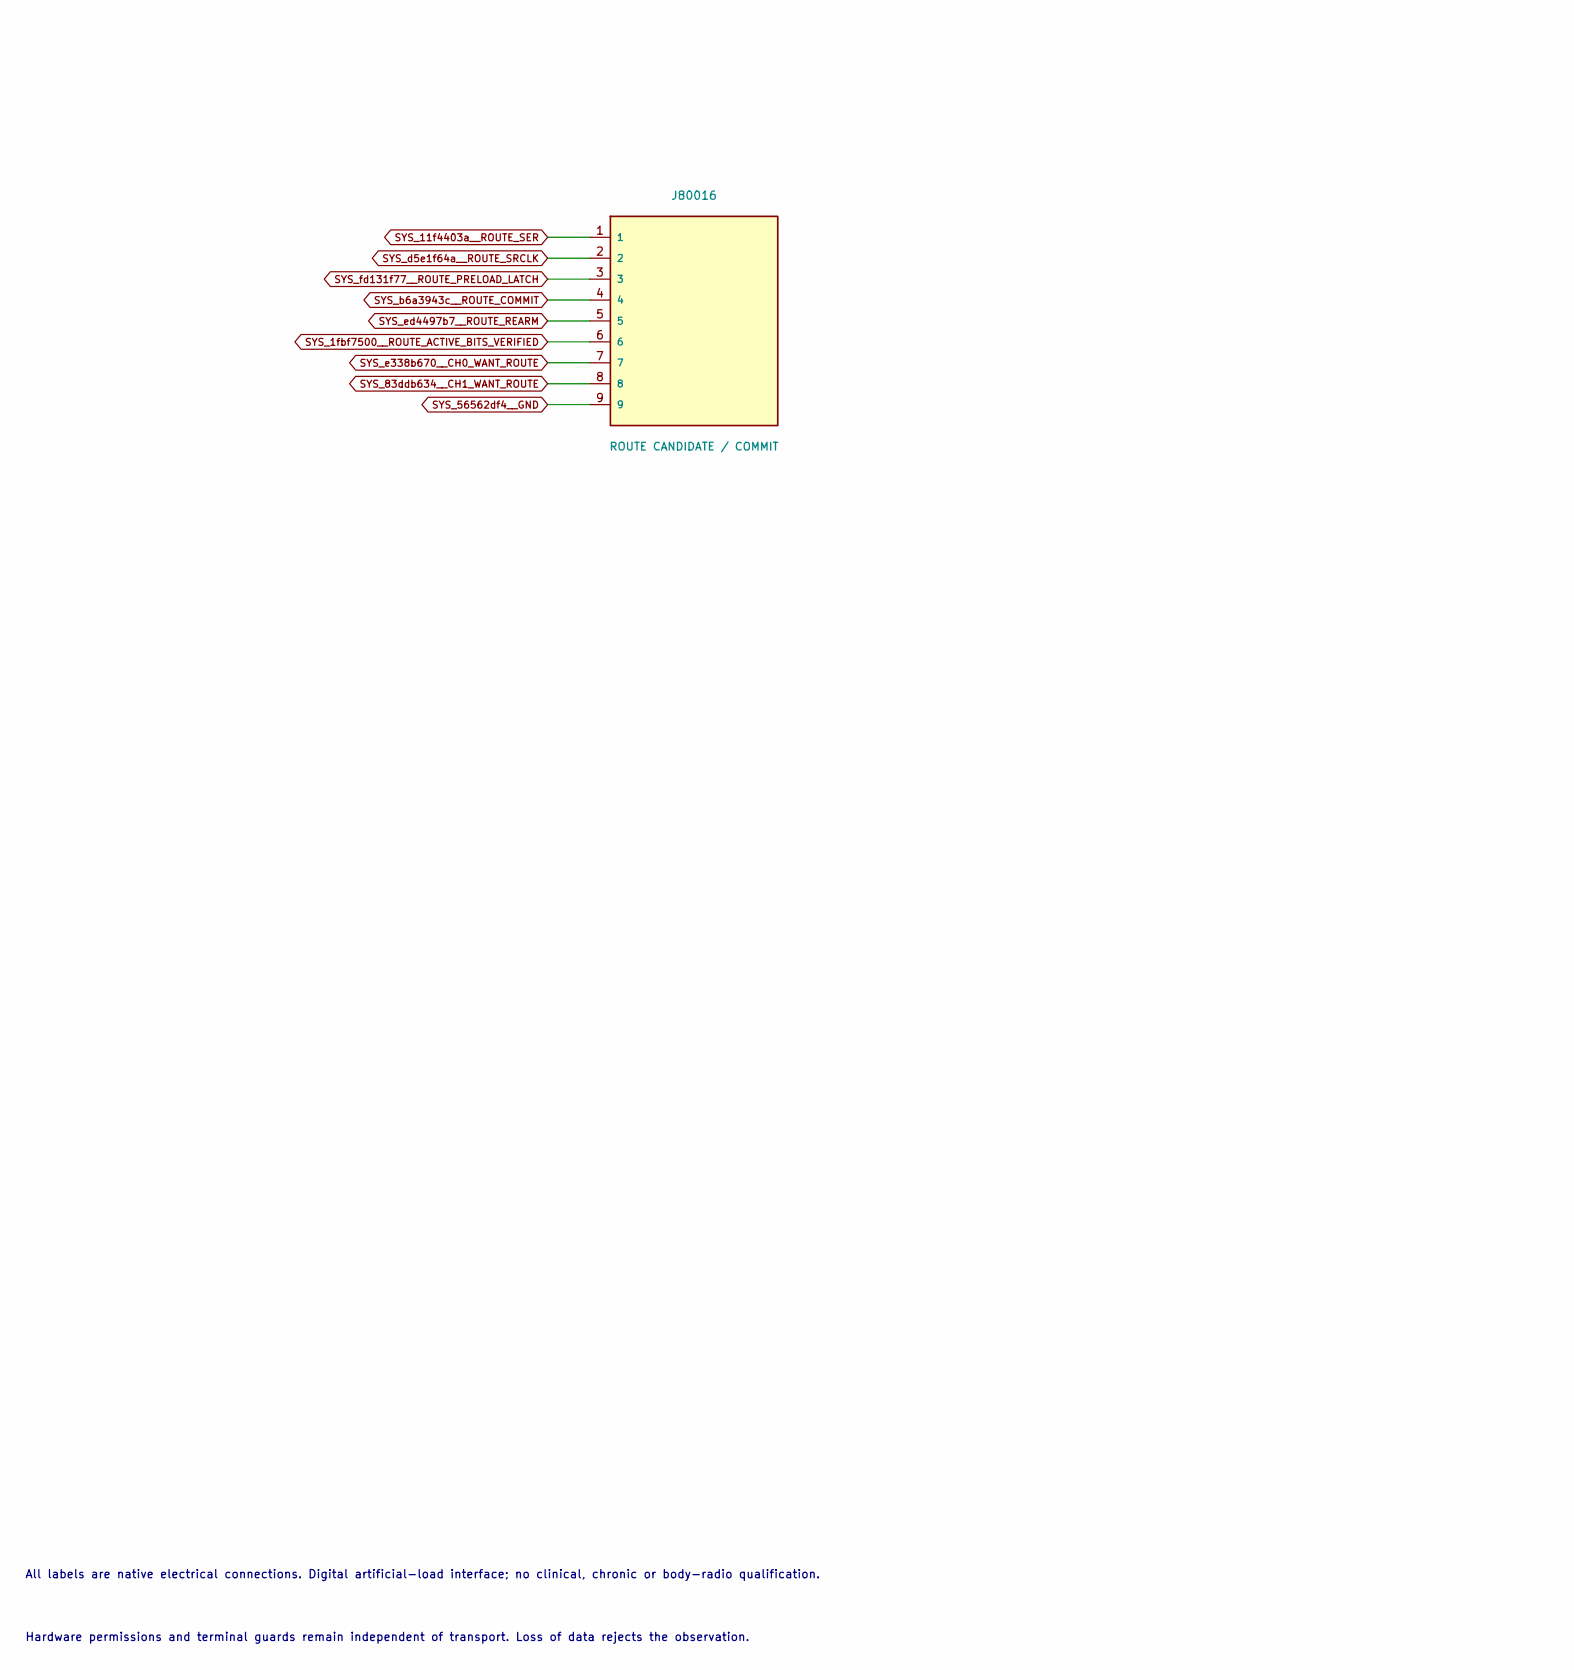
[picture p325: schematic handoff_2.kicad_sch, Project SCCI RH S4 / Matched peripheral handoff connectors …, part in row 2, column 1]

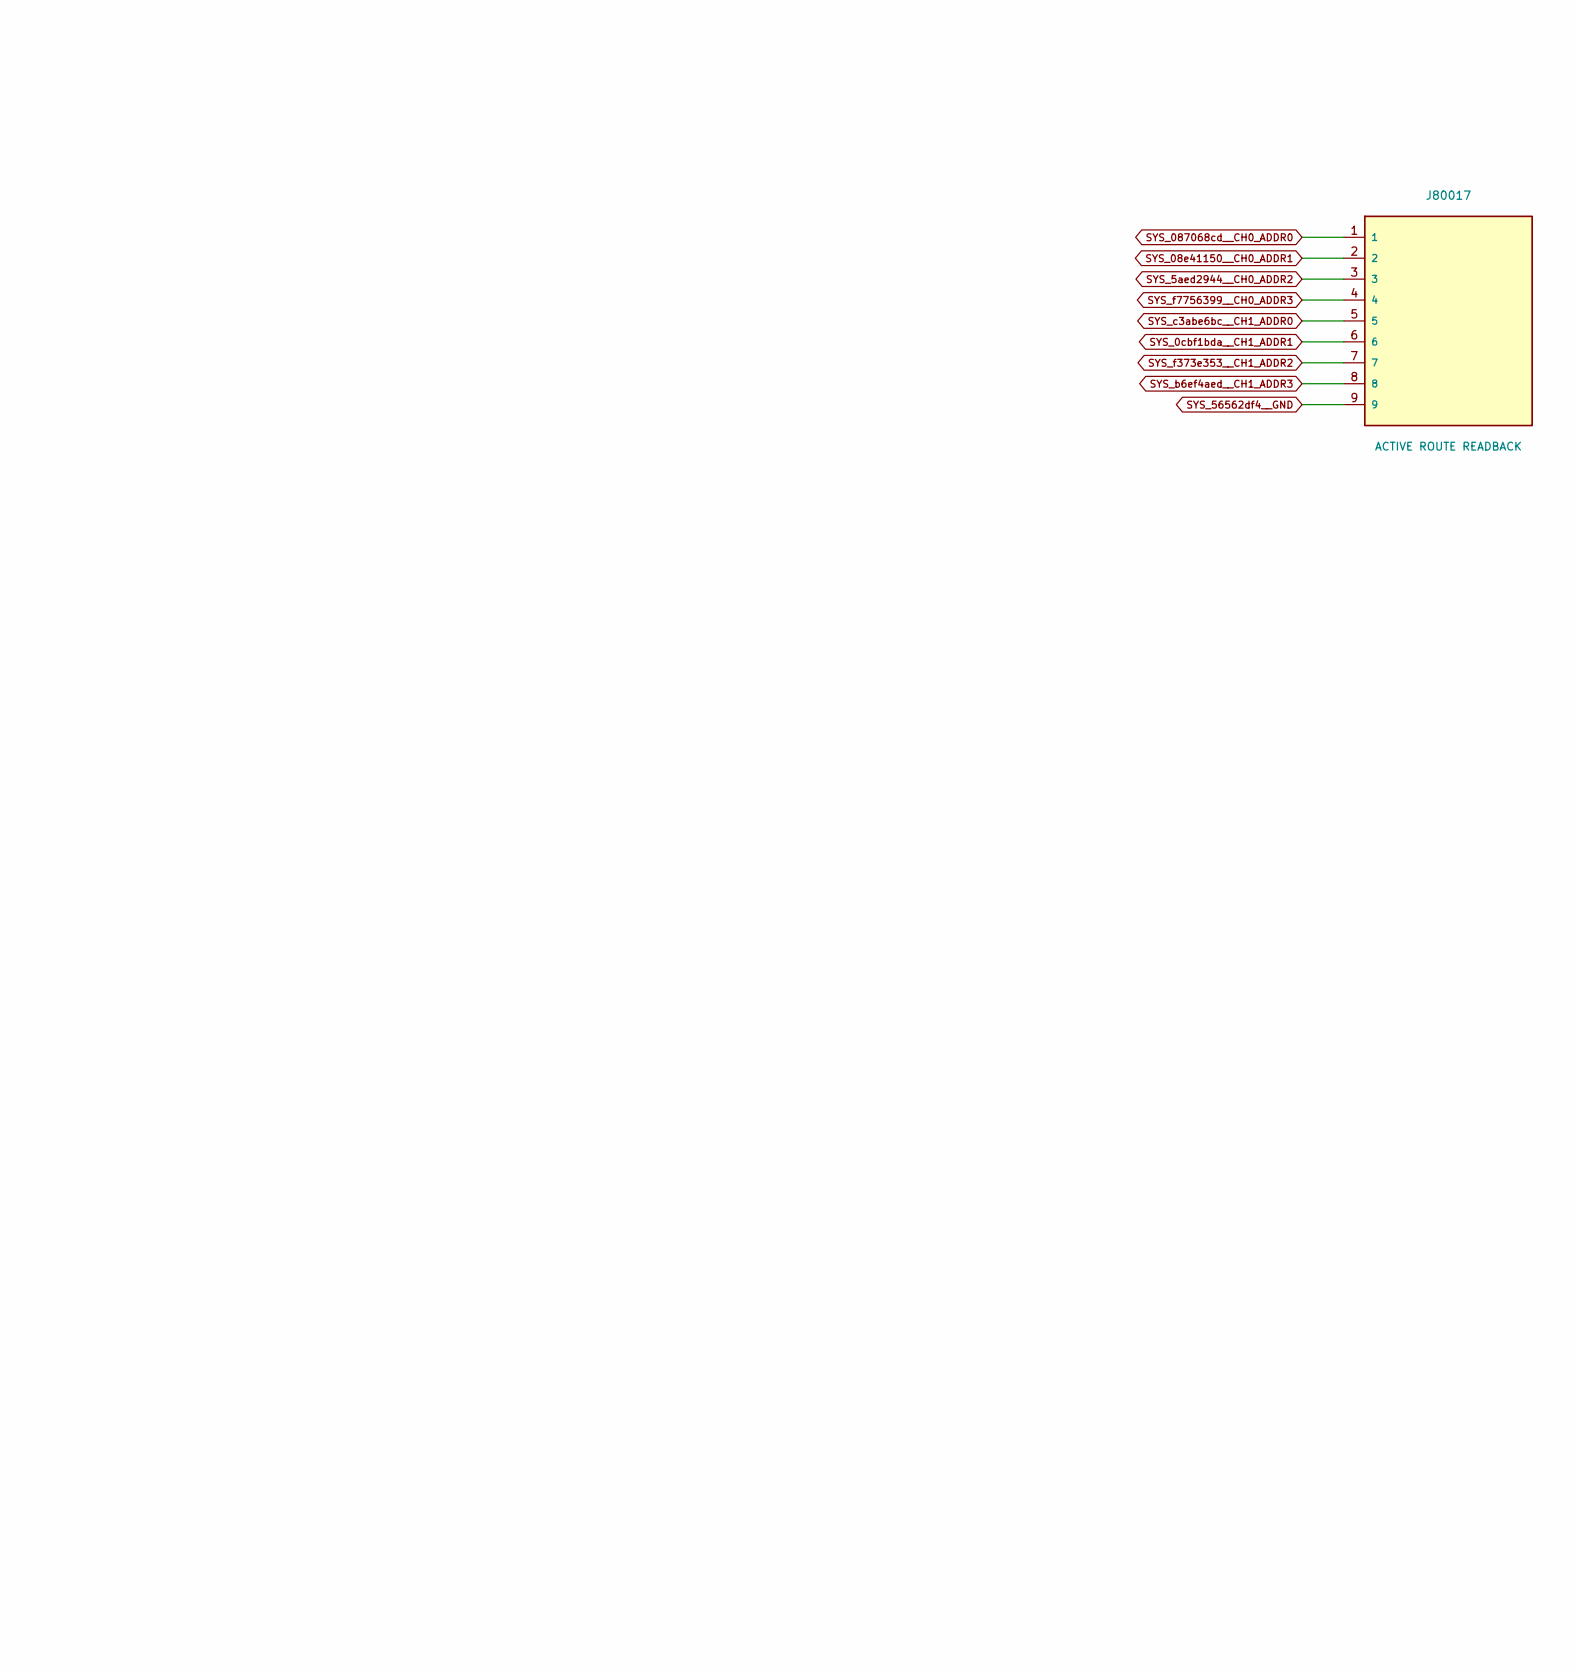
[picture p326: schematic handoff_2.kicad_sch, Project SCCI RH S4 / Matched peripheral handoff connectors …, part in row 2, column 2]

Parts:
J80014: DAC SERIAL; PinHeader_1x04_P2.54mm_Vertical
J80015: DRIVER REQUEST / POLARITY; PinHeader_1x09_P2.54mm_Vertical
J80016: ROUTE CANDIDATE / COMMIT; PinHeader_1x09_P2.54mm_Vertical
J80017: ACTIVE ROUTE READBACK; PinHeader_1x09_P2.54mm_Vertical

Connections:
SYS_0cbf1bda__CH1_ADDR1: J80017.6; also elsewhere on the board
SYS_1fbf7500__ROUTE_ACTIVE_BITS_VERIFIED: J80016.6; also elsewhere on the board
SYS_3abe1caf__BOTH_DRV_REARM: J80015.4, J80015.8; also elsewhere on the board
SYS_3b27d056__MINUS0: J80015.3; also elsewhere on the board
SYS_5aed2944__CH0_ADDR2: J80017.3; also elsewhere on the board
SYS_08e41150__CH0_ADDR1: J80017.2; also elsewhere on the board
SYS_11f4403a__ROUTE_SER: J80014.3, J80016.1; also elsewhere on the board
SYS_46ea5f03__CH0_REQUEST: J80015.1; also elsewhere on the board
SYS_83ddb634__CH1_WANT_ROUTE: J80016.8; also elsewhere on the board
SYS_628d7747__PLUS1: J80015.6; also elsewhere on the board
SYS_973f460c__PLUS0: J80015.2; also elsewhere on the board
SYS_56562df4__GND: J80014.4, J80015.9, J80016.9, J80017.9; also elsewhere on the board
SYS_087068cd__CH0_ADDR0: J80017.1; also elsewhere on the board
SYS_b6a3943c__ROUTE_COMMIT: J80016.4; also elsewhere on the board
SYS_b6ef4aed__CH1_ADDR3: J80017.8; also elsewhere on the board
SYS_c3abe6bc__CH1_ADDR0: J80017.5; also elsewhere on the board
SYS_d5e1f64a__ROUTE_SRCLK: J80014.1, J80016.2; also elsewhere on the board
SYS_dd388269__CH1_REQUEST: J80015.5; also elsewhere on the board
SYS_e338b670__CH0_WANT_ROUTE: J80016.7; also elsewhere on the board
SYS_e496c0b2__DAC_SYNC_N: J80014.2; also elsewhere on the board
SYS_ed4497b7__ROUTE_REARM: J80016.5; also elsewhere on the board
SYS_edc800df__MINUS1: J80015.7; also elsewhere on the board
SYS_f373e353__CH1_ADDR2: J80017.7; also elsewhere on the board
SYS_f7756399__CH0_ADDR3: J80017.4; also elsewhere on the board
SYS_fd131f77__ROUTE_PRELOAD_LATCH: J80016.3; also elsewhere on the board

Notes on the sheet:
DIGITAL SCCI ENGINEERING / ARTIFICIAL SIGNALS / nRF5340 CONTROLLER CARRIER
46 actual GPIO, explicit common CNV/rearm and physical 32-bit health/readback chain. Radio remains disabled.
All labels are native electrical connections. Digital artificial-load interface; no clinical, chronic or body-radio qualification.
Hardware permissions and terminal guards remain independent of transport. Loss of data rejects the observation.

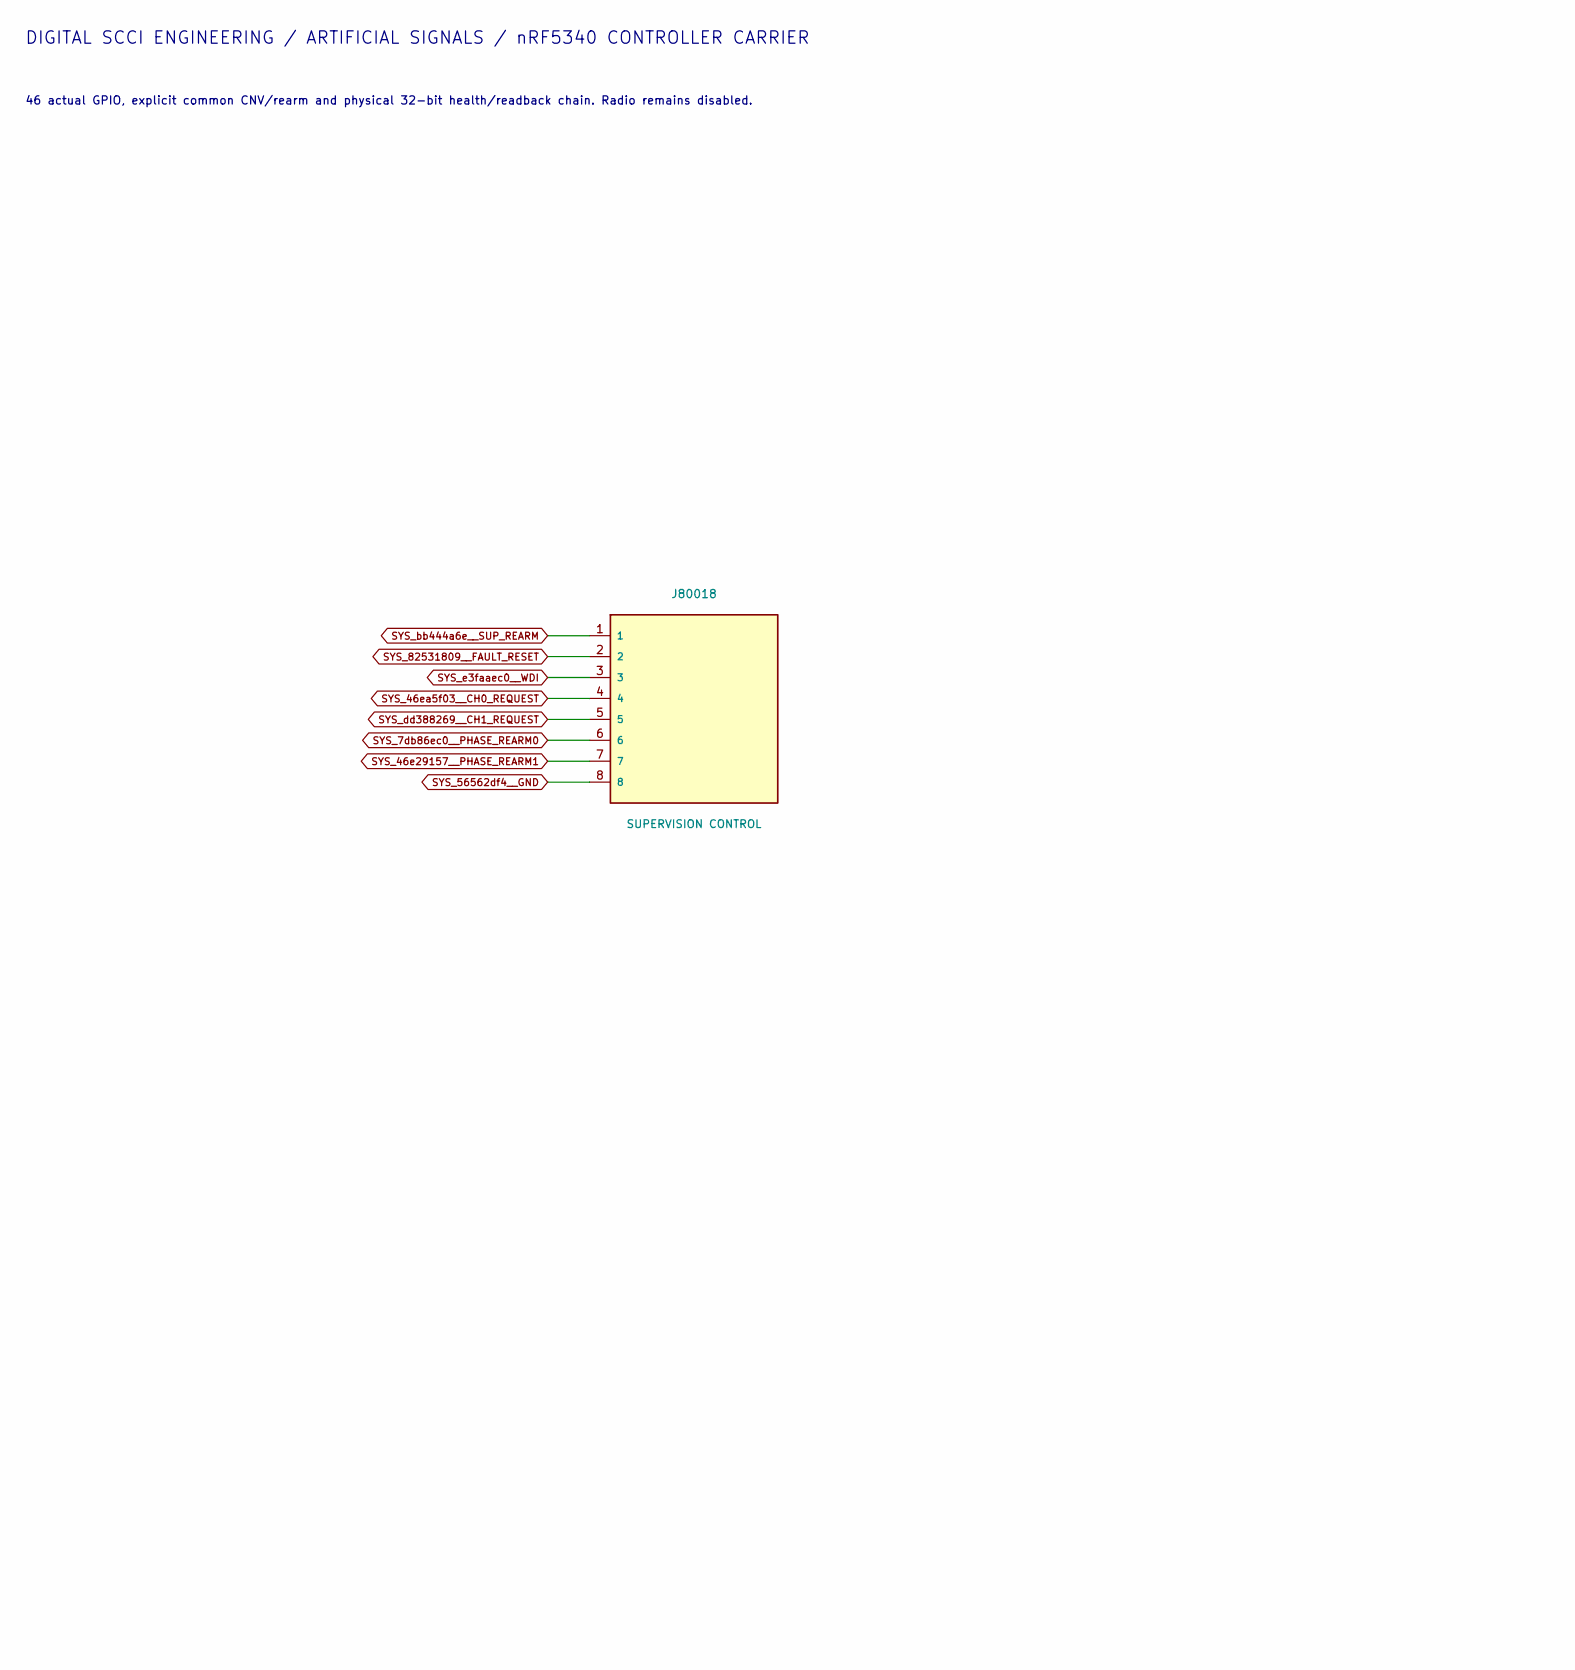
[picture p327: schematic handoff_3.kicad_sch, Project SCCI RH S4 / Matched peripheral handoff connectors …, part in row 1, column 1]

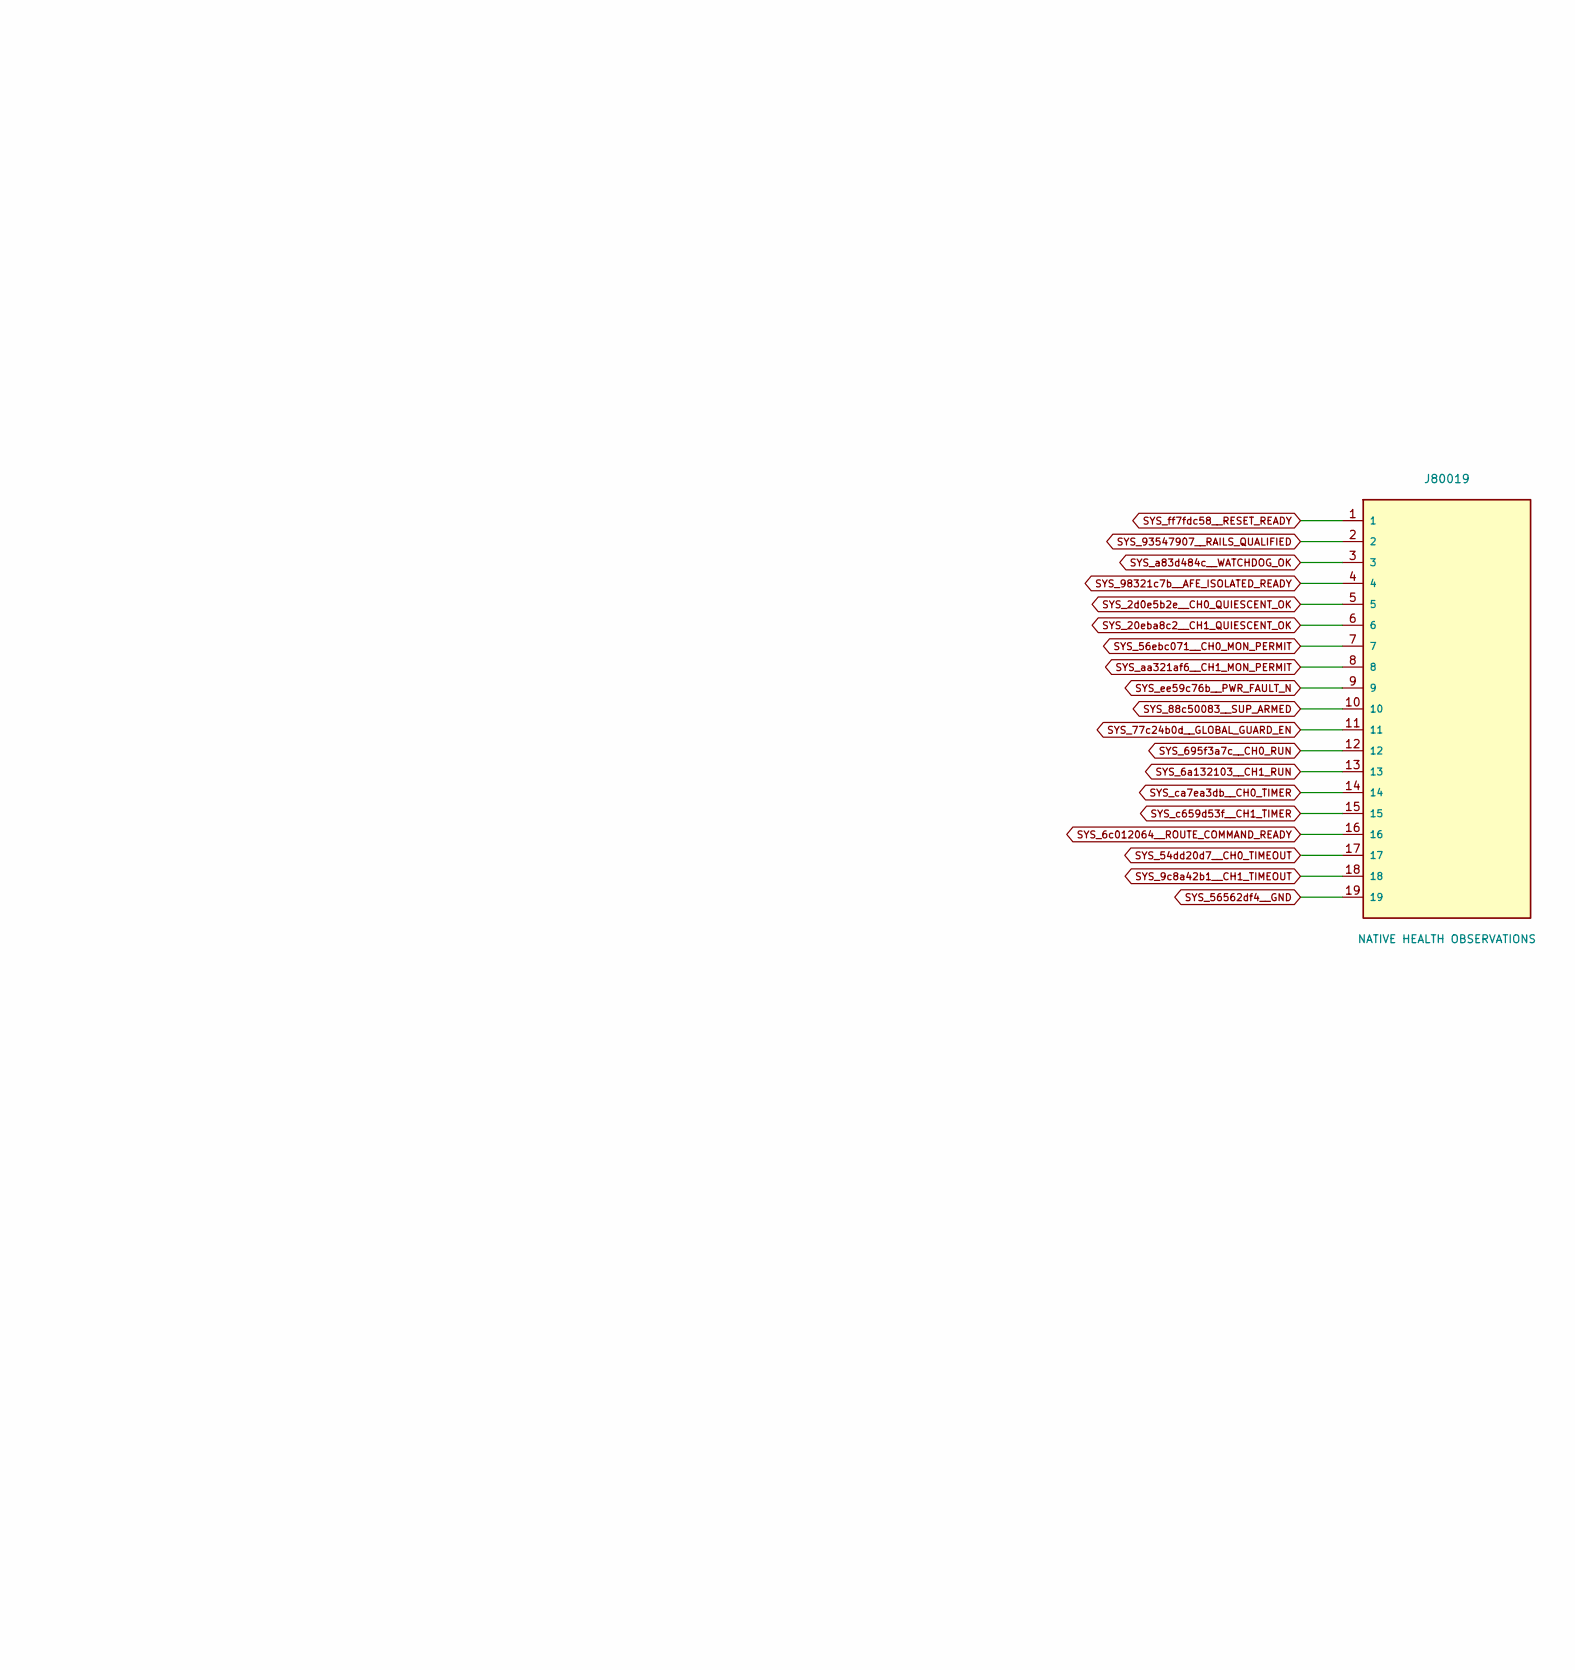
[picture p328: schematic handoff_3.kicad_sch, Project SCCI RH S4 / Matched peripheral handoff connectors …, part in row 1, column 2]

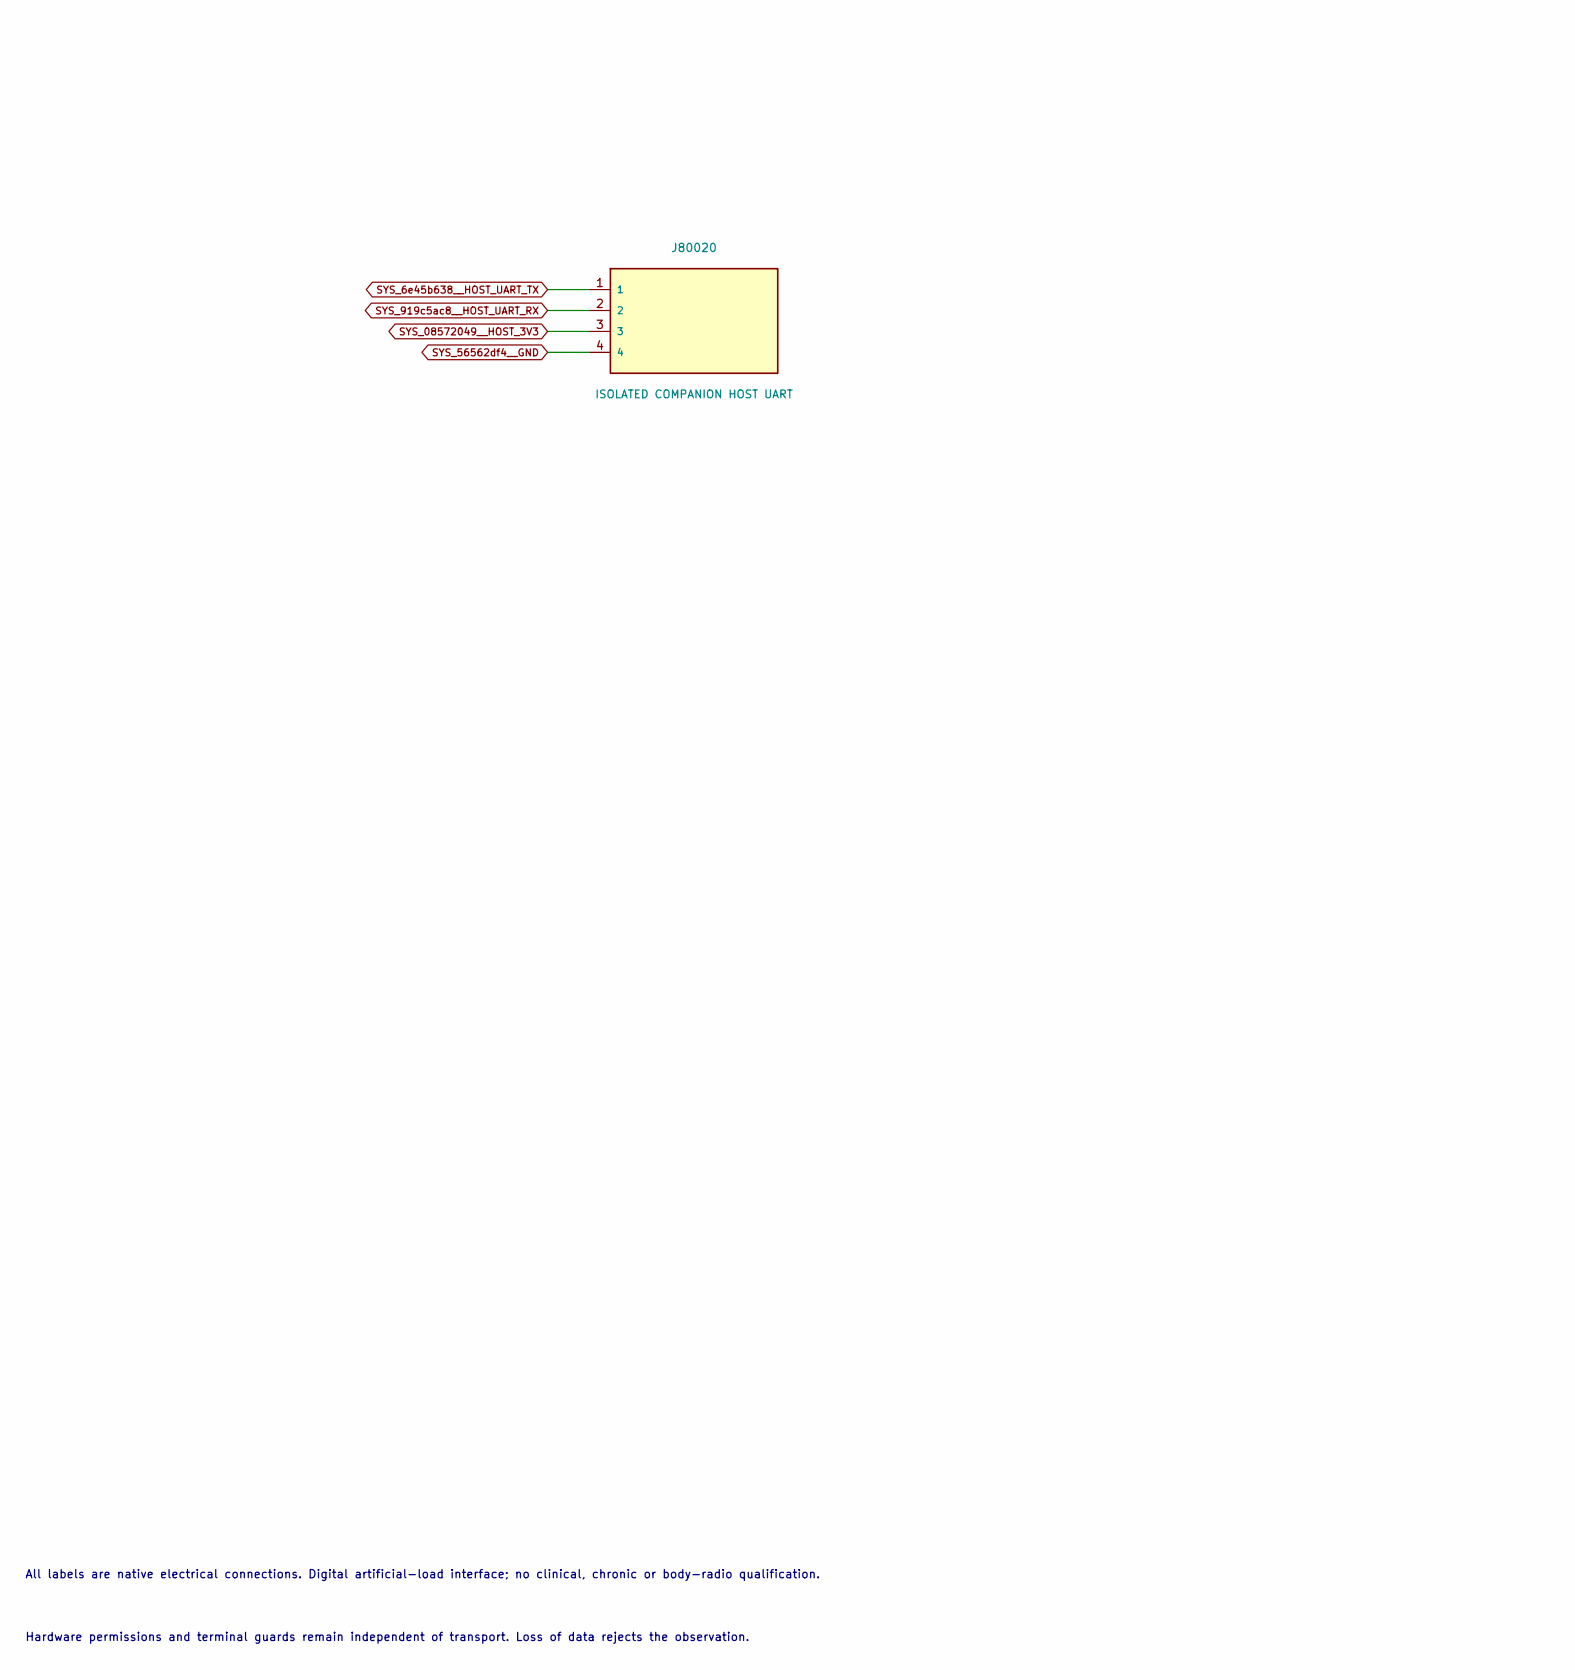
[picture p329: schematic handoff_3.kicad_sch, Project SCCI RH S4 / Matched peripheral handoff connectors …, part in row 2, column 1]

Parts:
J80018: SUPERVISION CONTROL; PinHeader_1x08_P2.54mm_Vertical
J80019: NATIVE HEALTH OBSERVATIONS; PinHeader_1x19_P2.54mm_Vertical
J80020: ISOLATED COMPANION HOST UART; PinHeader_1x04_P2.54mm_Vertical

Connections:
SYS_2d0e5b2e__CH0_QUIESCENT_OK: J80019.5; also elsewhere on the board
SYS_6a132103__CH1_RUN: J80019.13; also elsewhere on the board
SYS_6c012064__ROUTE_COMMAND_READY: J80019.16; also elsewhere on the board
SYS_6e45b638__HOST_UART_TX: J80020.1; also elsewhere on the board
SYS_7db86ec0__PHASE_REARM0: J80018.6; also elsewhere on the board
SYS_9c8a42b1__CH1_TIMEOUT: J80019.18; also elsewhere on the board
SYS_20eba8c2__CH1_QUIESCENT_OK: J80019.6; also elsewhere on the board
SYS_46e29157__PHASE_REARM1: J80018.7; also elsewhere on the board
SYS_46ea5f03__CH0_REQUEST: J80018.4; also elsewhere on the board
SYS_54dd20d7__CH0_TIMEOUT: J80019.17; also elsewhere on the board
SYS_56ebc071__CH0_MON_PERMIT: J80019.7; also elsewhere on the board
SYS_77c24b0d__GLOBAL_GUARD_EN: J80019.11; also elsewhere on the board
SYS_88c50083__SUP_ARMED: J80019.10; also elsewhere on the board
SYS_695f3a7c__CH0_RUN: J80019.12; also elsewhere on the board
SYS_919c5ac8__HOST_UART_RX: J80020.2; also elsewhere on the board
SYS_56562df4__GND: J80018.8, J80019.19, J80020.4; also elsewhere on the board
SYS_98321c7b__AFE_ISOLATED_READY: J80019.4; also elsewhere on the board
SYS_08572049__HOST_3V3: J80020.3; also elsewhere on the board
SYS_82531809__FAULT_RESET: J80018.2; also elsewhere on the board
SYS_93547907__RAILS_QUALIFIED: J80019.2; also elsewhere on the board
SYS_a83d484c__WATCHDOG_OK: J80019.3; also elsewhere on the board
SYS_aa321af6__CH1_MON_PERMIT: J80019.8; also elsewhere on the board
SYS_bb444a6e__SUP_REARM: J80018.1; also elsewhere on the board
SYS_c659d53f__CH1_TIMER: J80019.15; also elsewhere on the board
SYS_ca7ea3db__CH0_TIMER: J80019.14; also elsewhere on the board
SYS_dd388269__CH1_REQUEST: J80018.5; also elsewhere on the board
SYS_e3faaec0__WDI: J80018.3; also elsewhere on the board
SYS_ee59c76b__PWR_FAULT_N: J80019.9; also elsewhere on the board
SYS_ff7fdc58__RESET_READY: J80019.1; also elsewhere on the board

Notes on the sheet:
DIGITAL SCCI ENGINEERING / ARTIFICIAL SIGNALS / nRF5340 CONTROLLER CARRIER
46 actual GPIO, explicit common CNV/rearm and physical 32-bit health/readback chain. Radio remains disabled.
All labels are native electrical connections. Digital artificial-load interface; no clinical, chronic or body-radio qualification.
Hardware permissions and terminal guards remain independent of transport. Loss of data rejects the observation.
