pratham-cloud-ctrl/Project-SCCI-RH/electronics/stage4/integrated-pcb/boards/controller-carrier/controller_carrier.kicad_pcb

## KiCad design electronics/stage4/integrated-pcb/boards/controller-carrier/controller_carrier.kicad_pcb (continued)

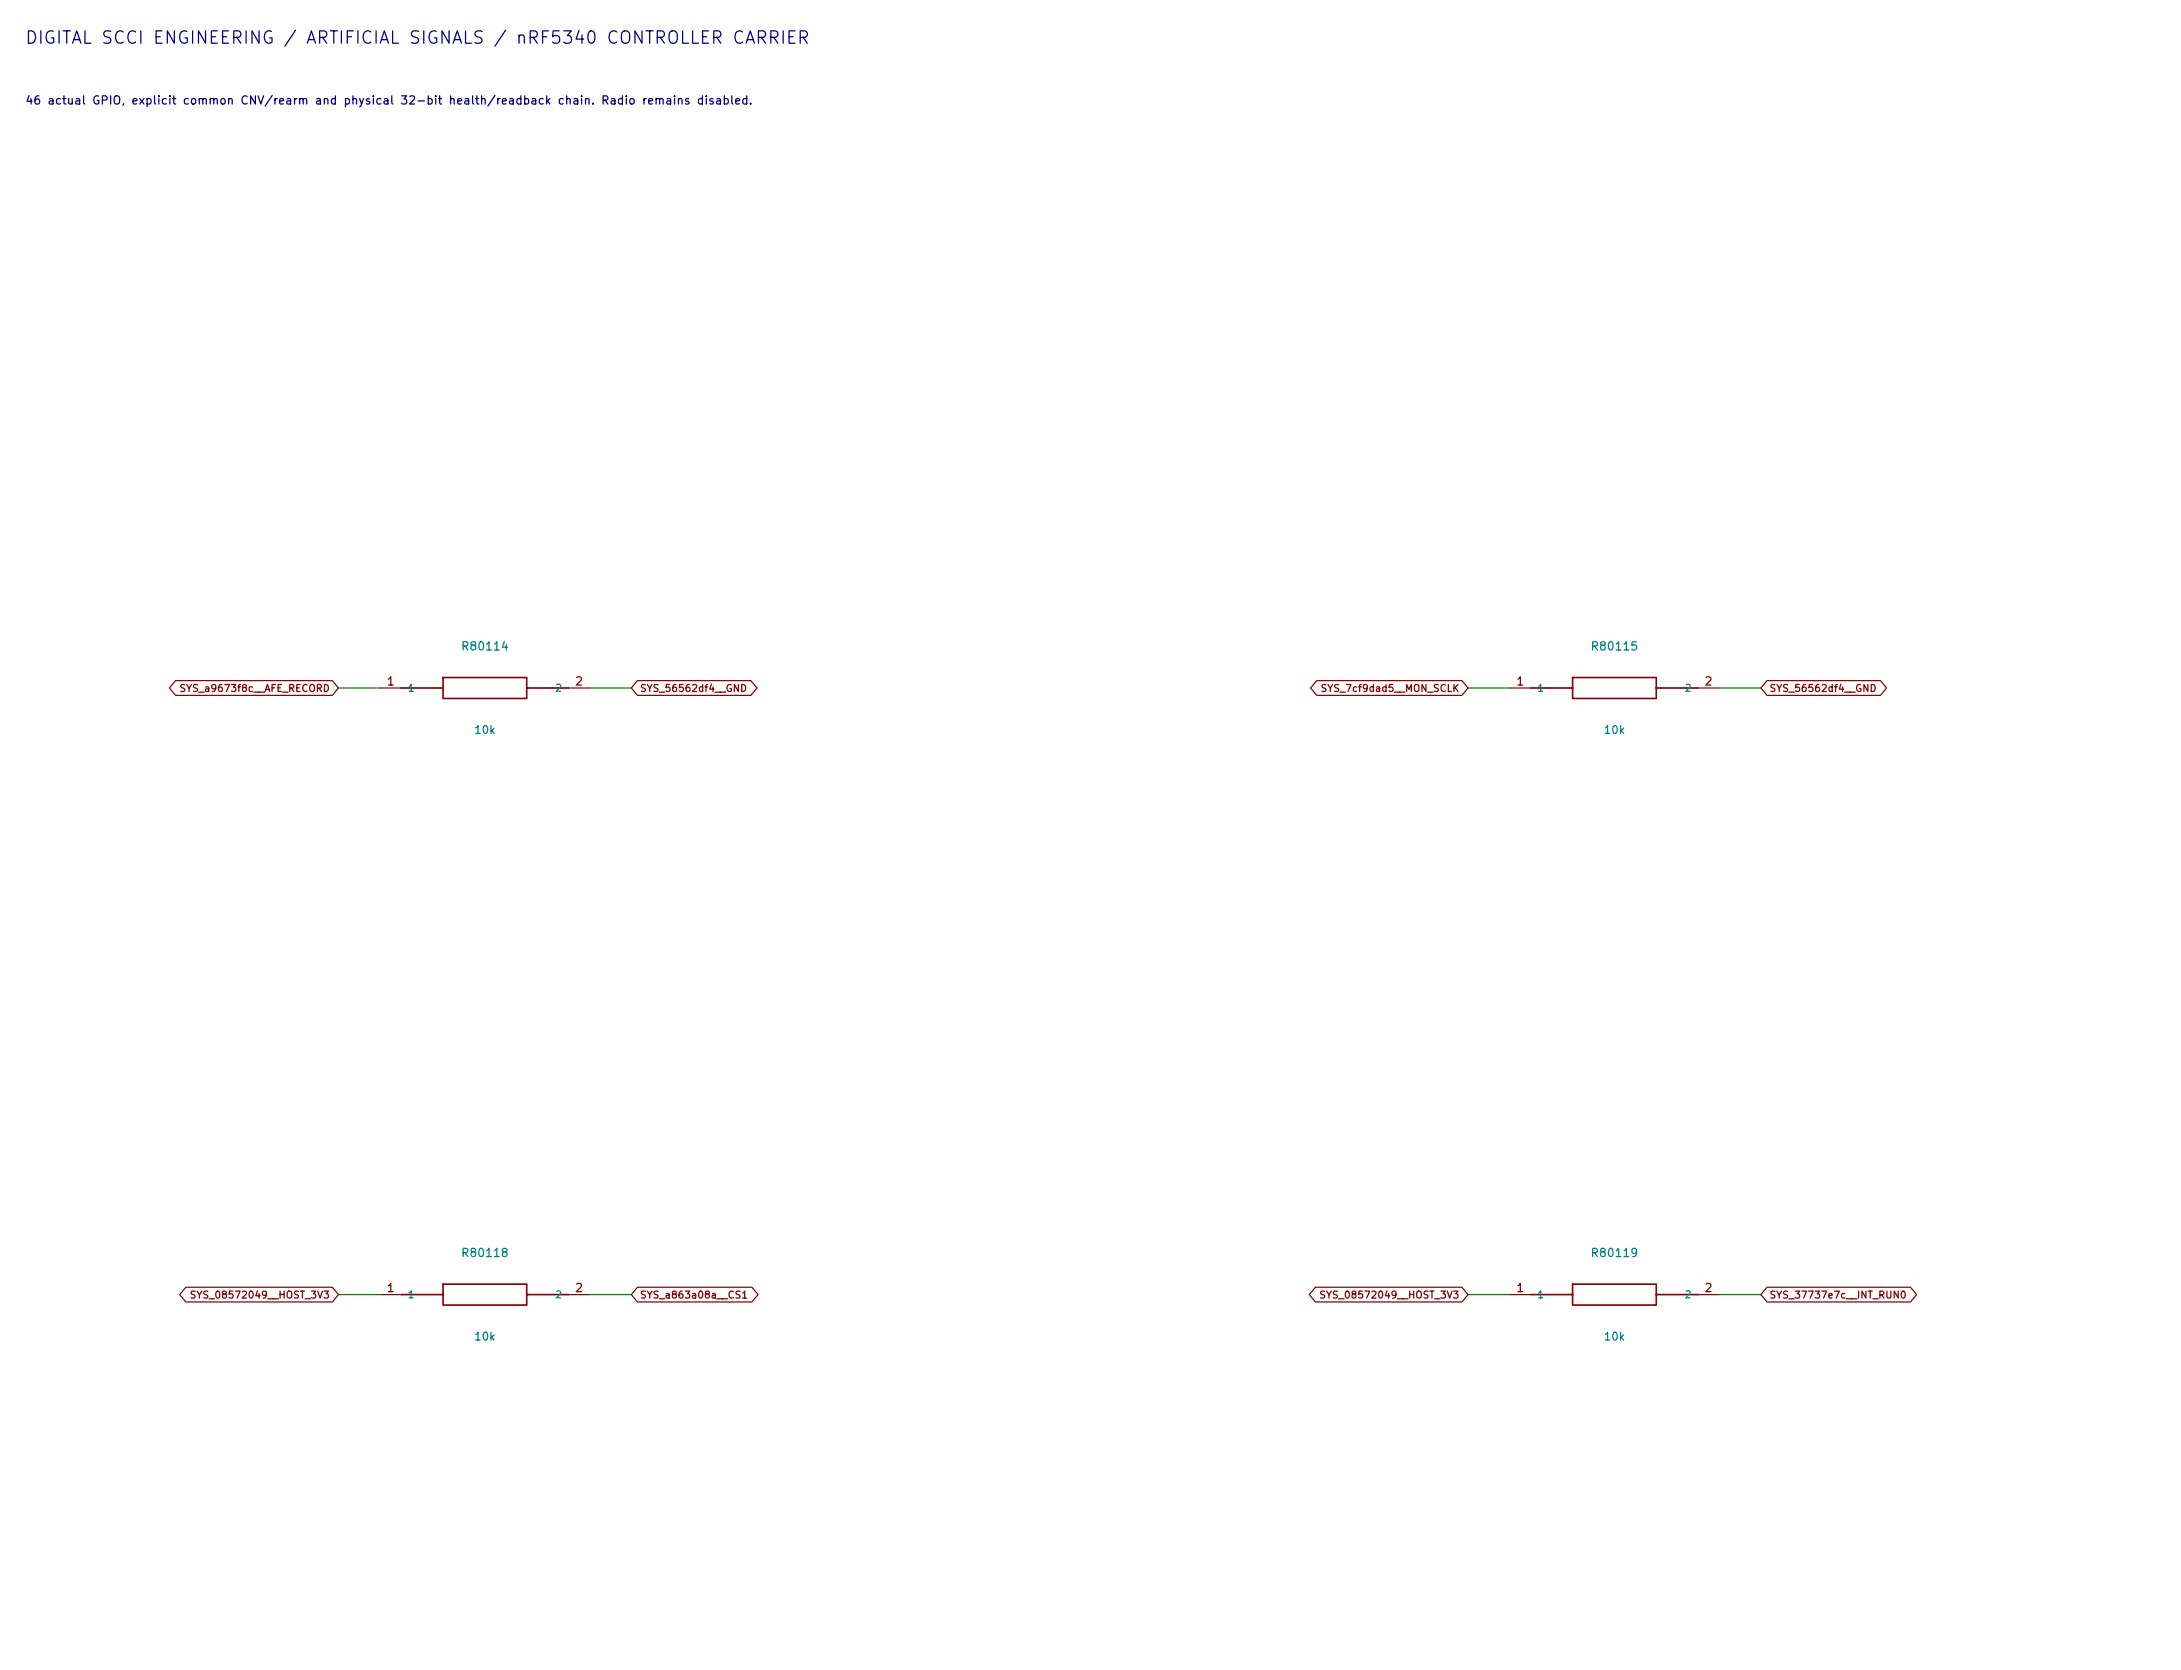
[picture p334: schematic defaults_2.kicad_sch, Project SCCI RH S4 / Passive reset defaults / explicit reco…, part in row 1, column 1]

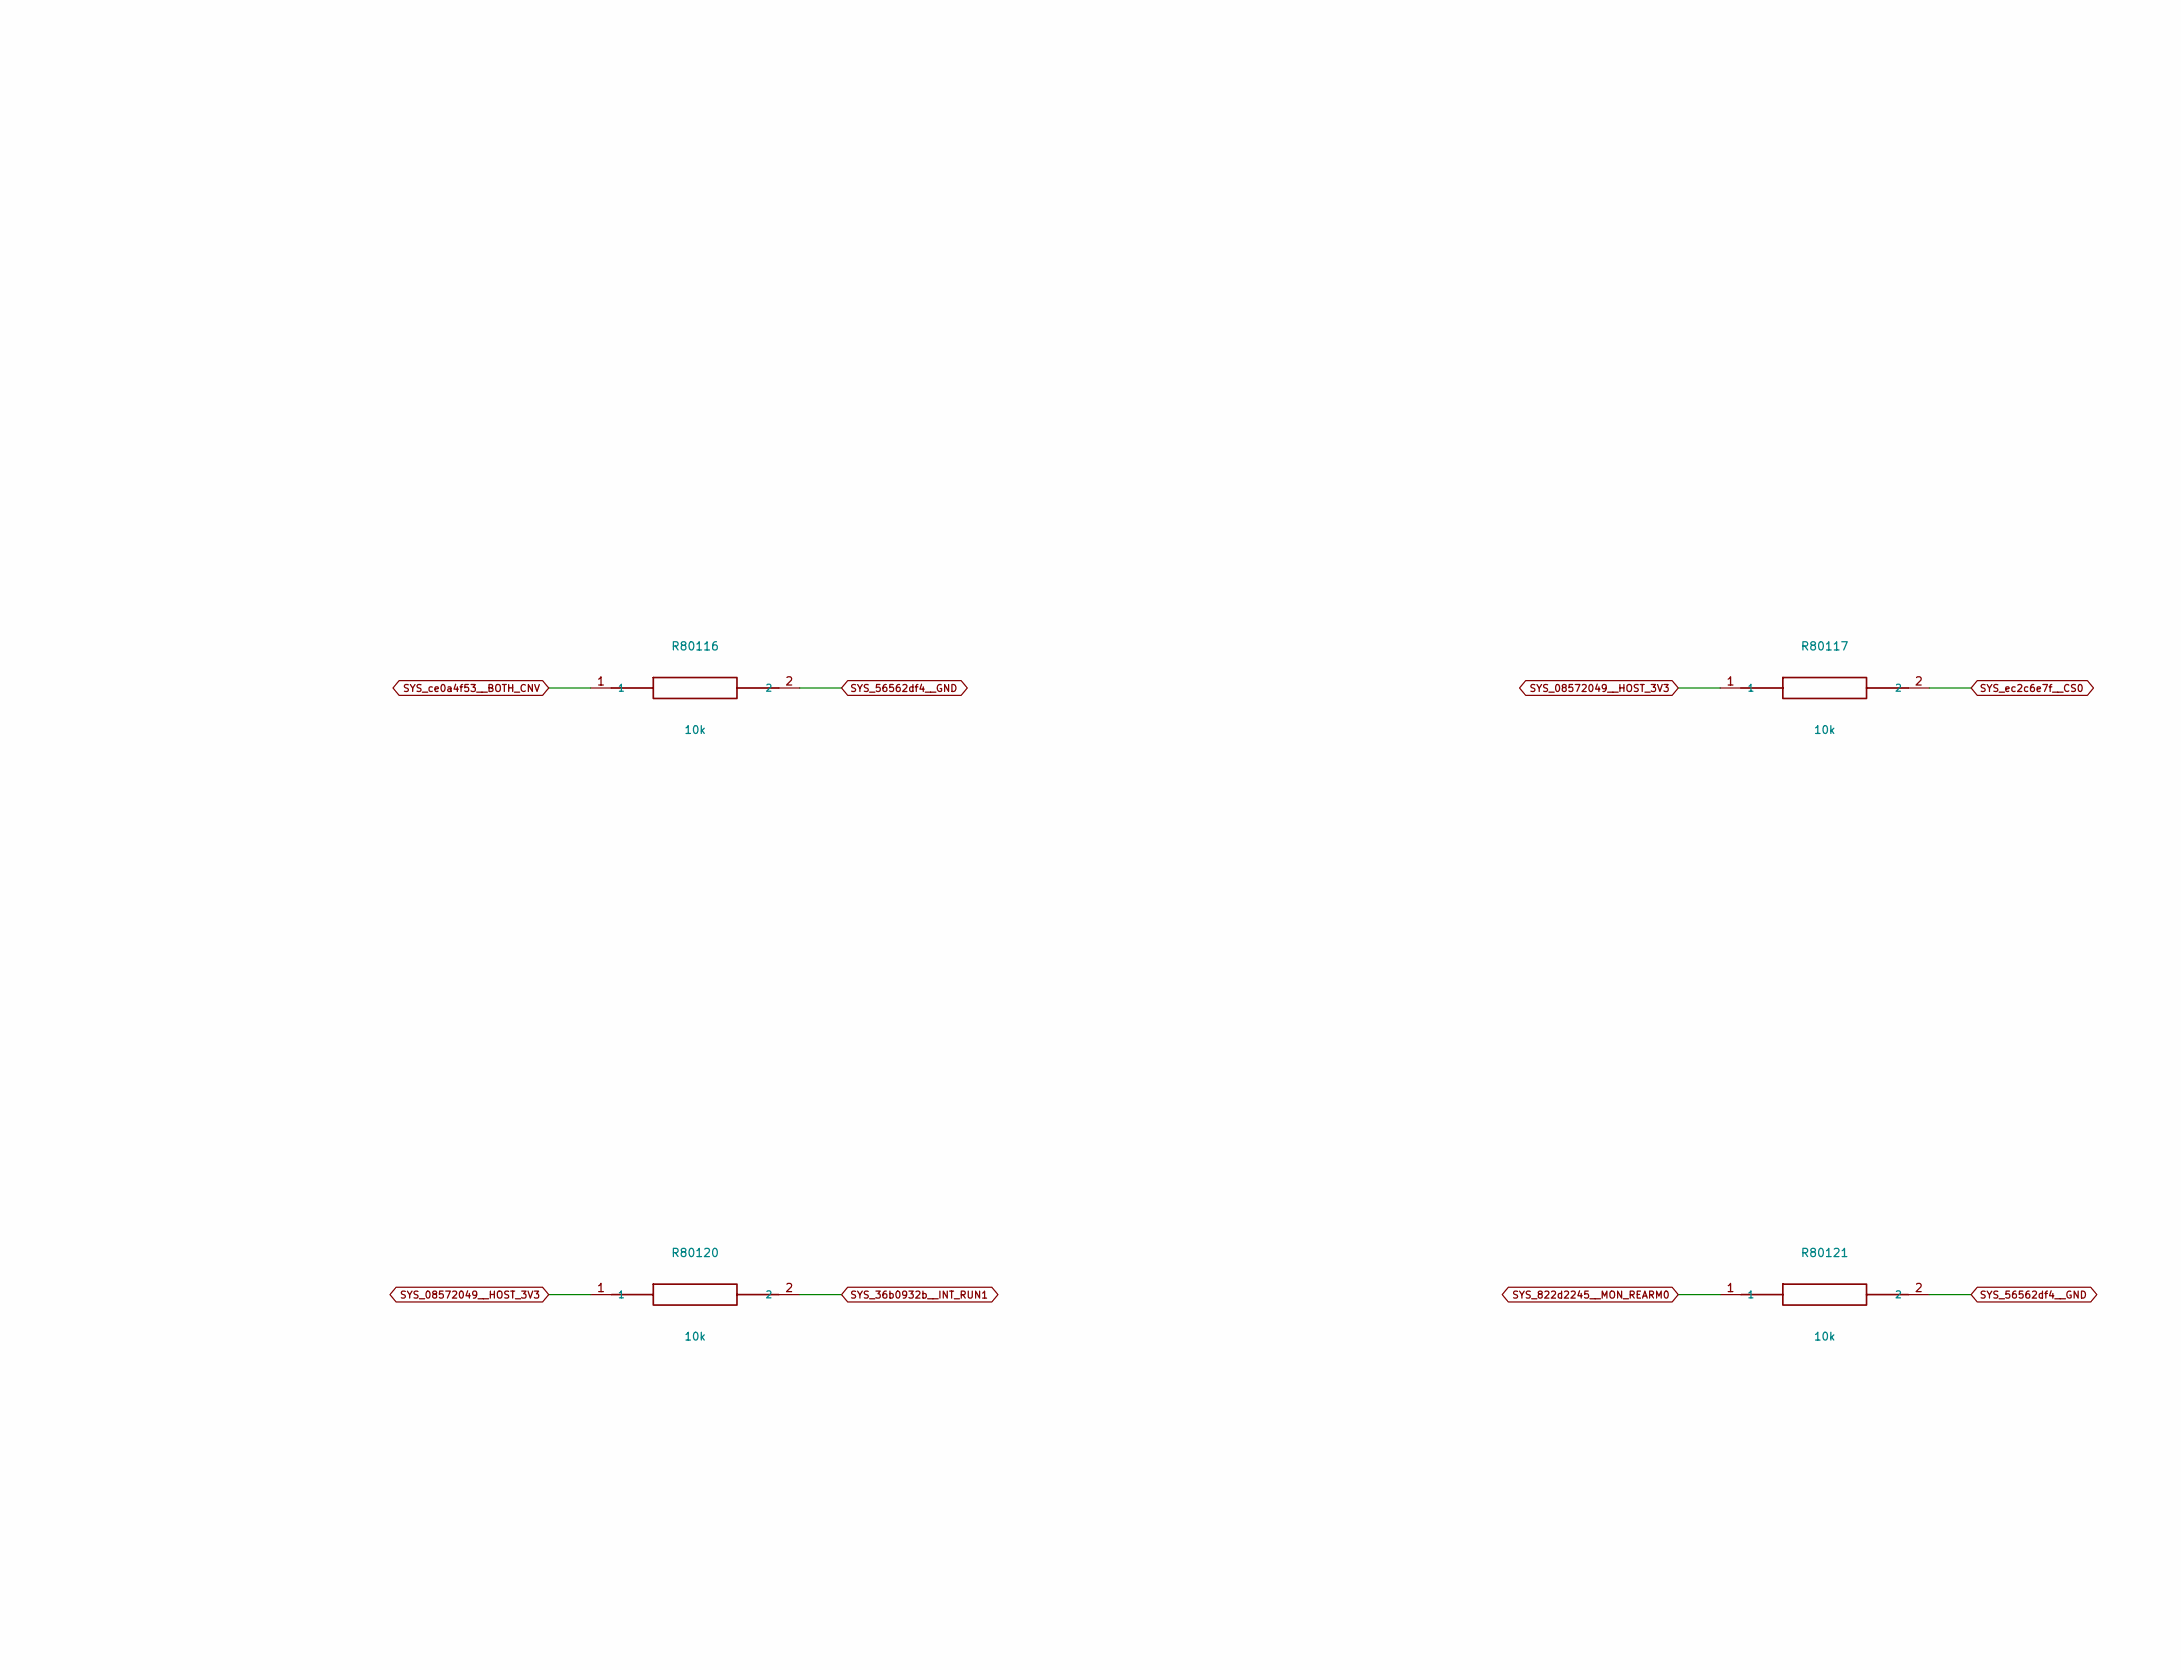
[picture p335: schematic defaults_2.kicad_sch, Project SCCI RH S4 / Passive reset defaults / explicit reco…, part in row 1, column 2]

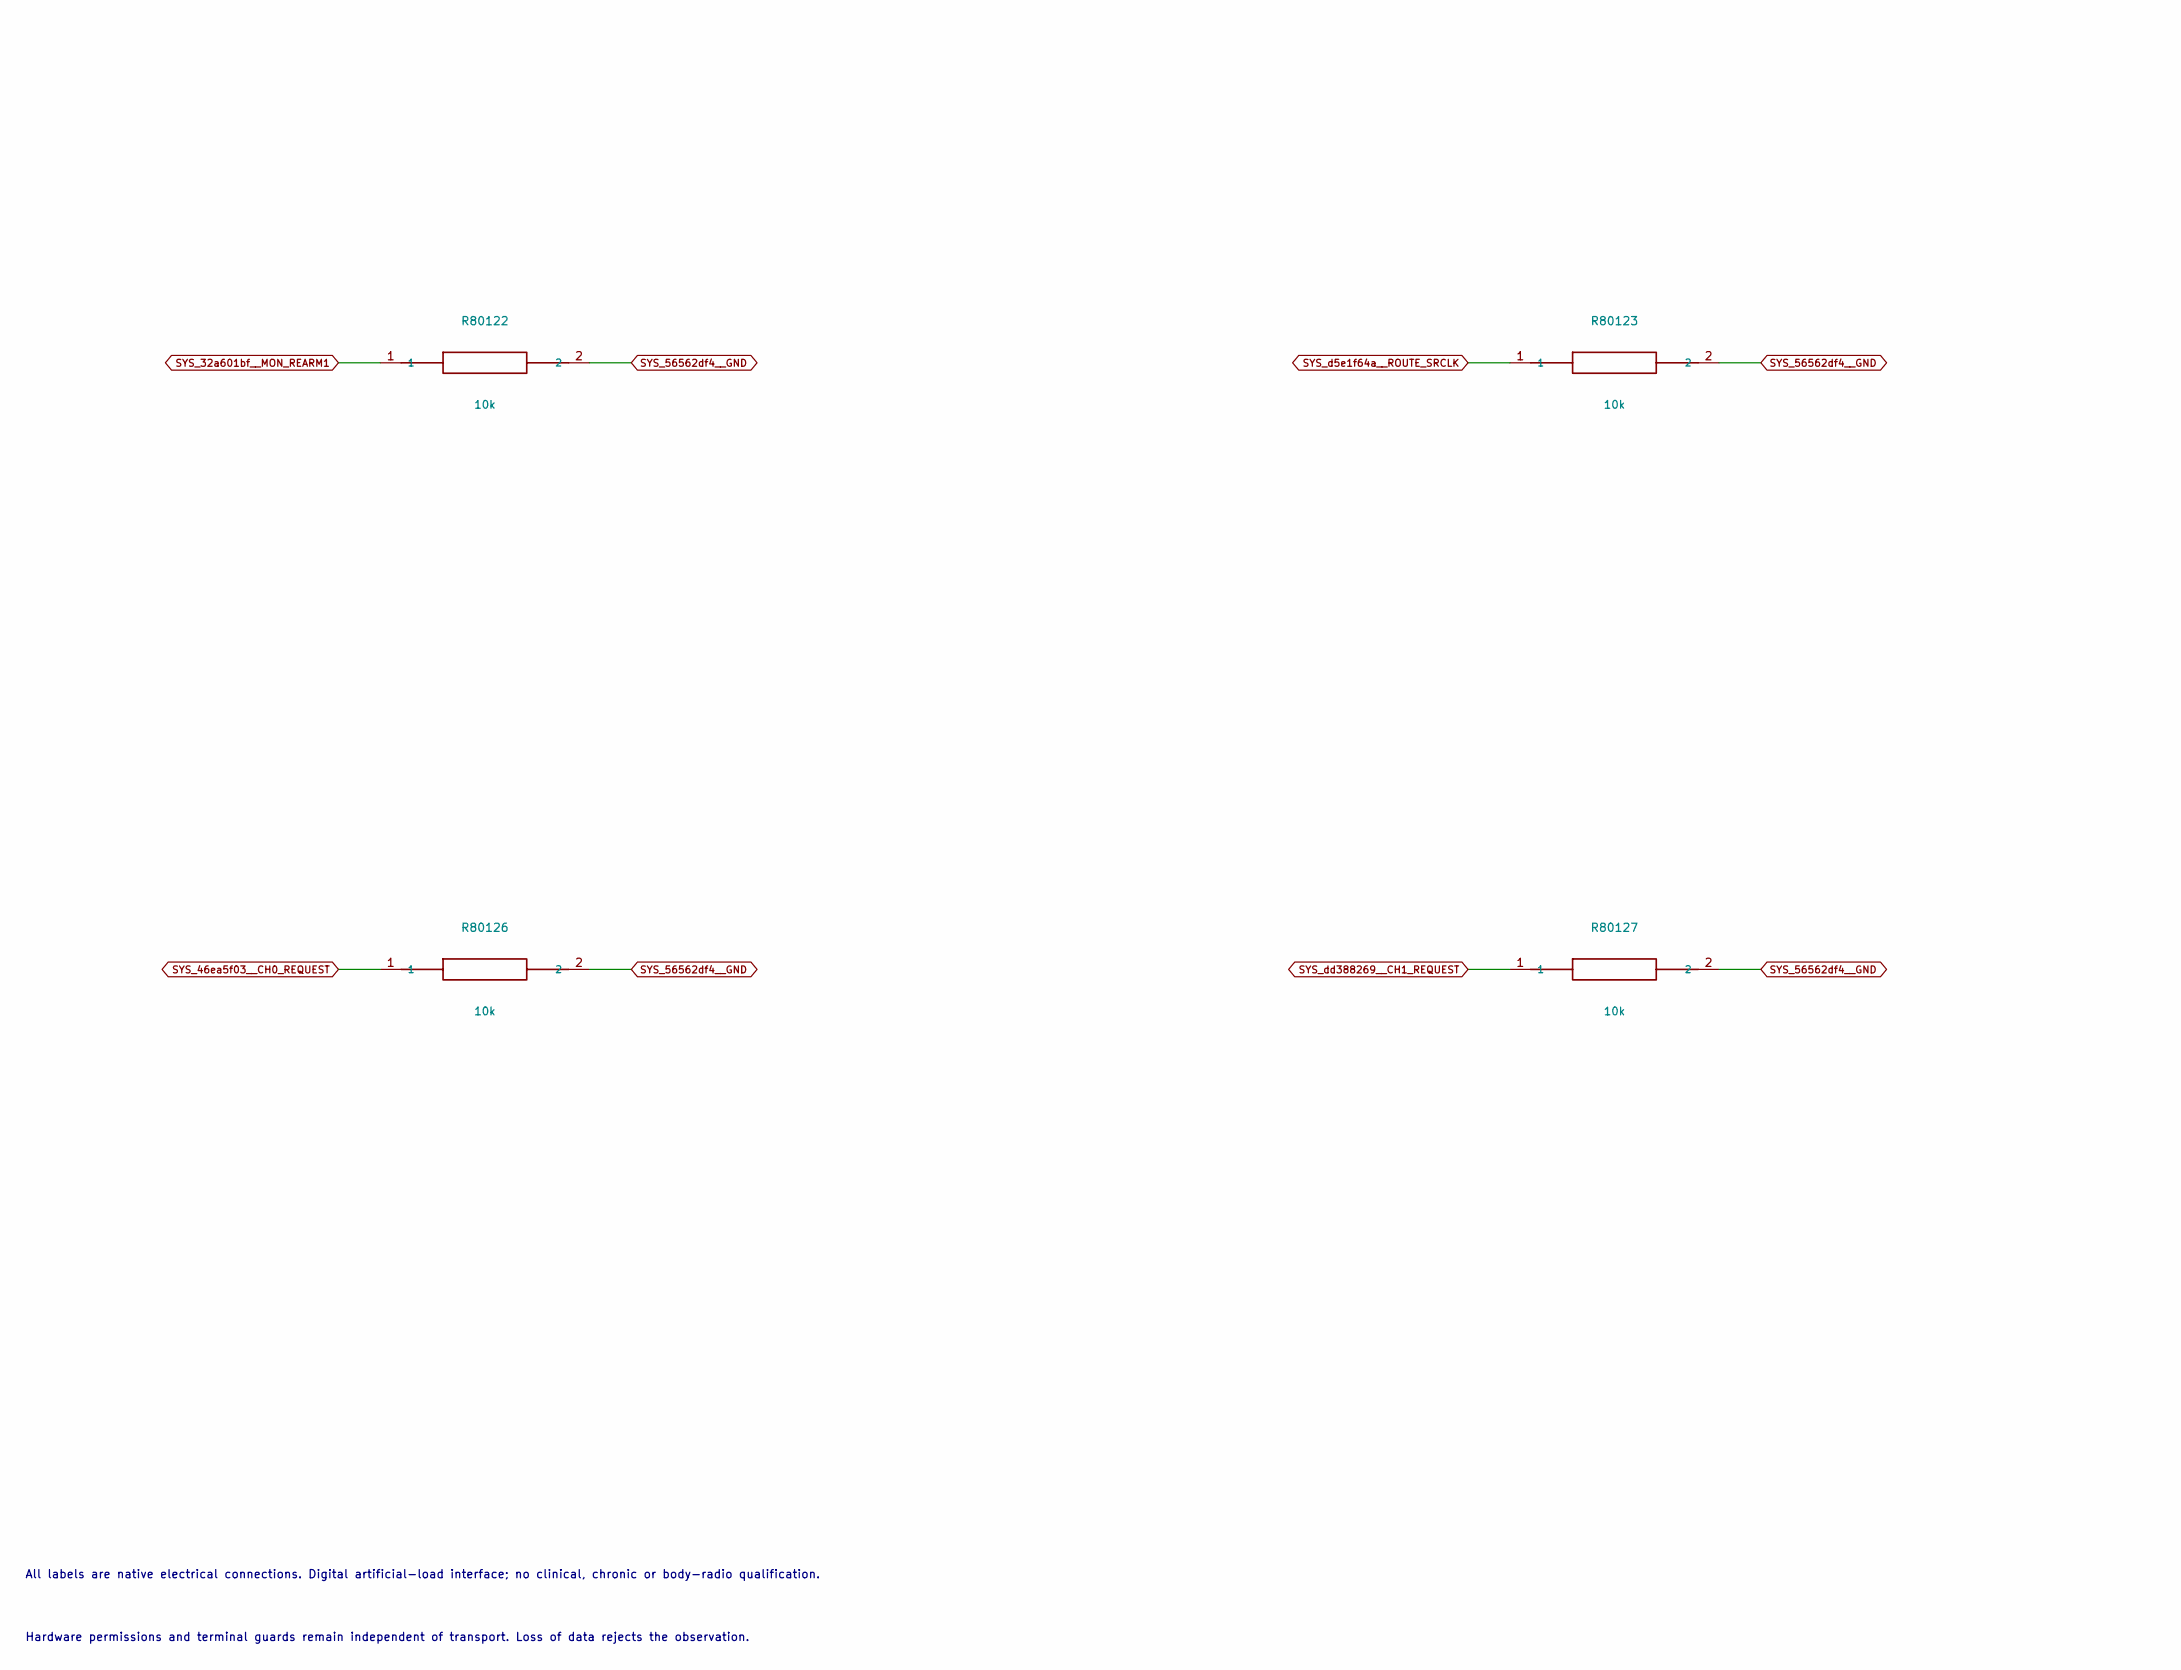
[picture p336: schematic defaults_2.kicad_sch, Project SCCI RH S4 / Passive reset defaults / explicit reco…, part in row 2, column 1]

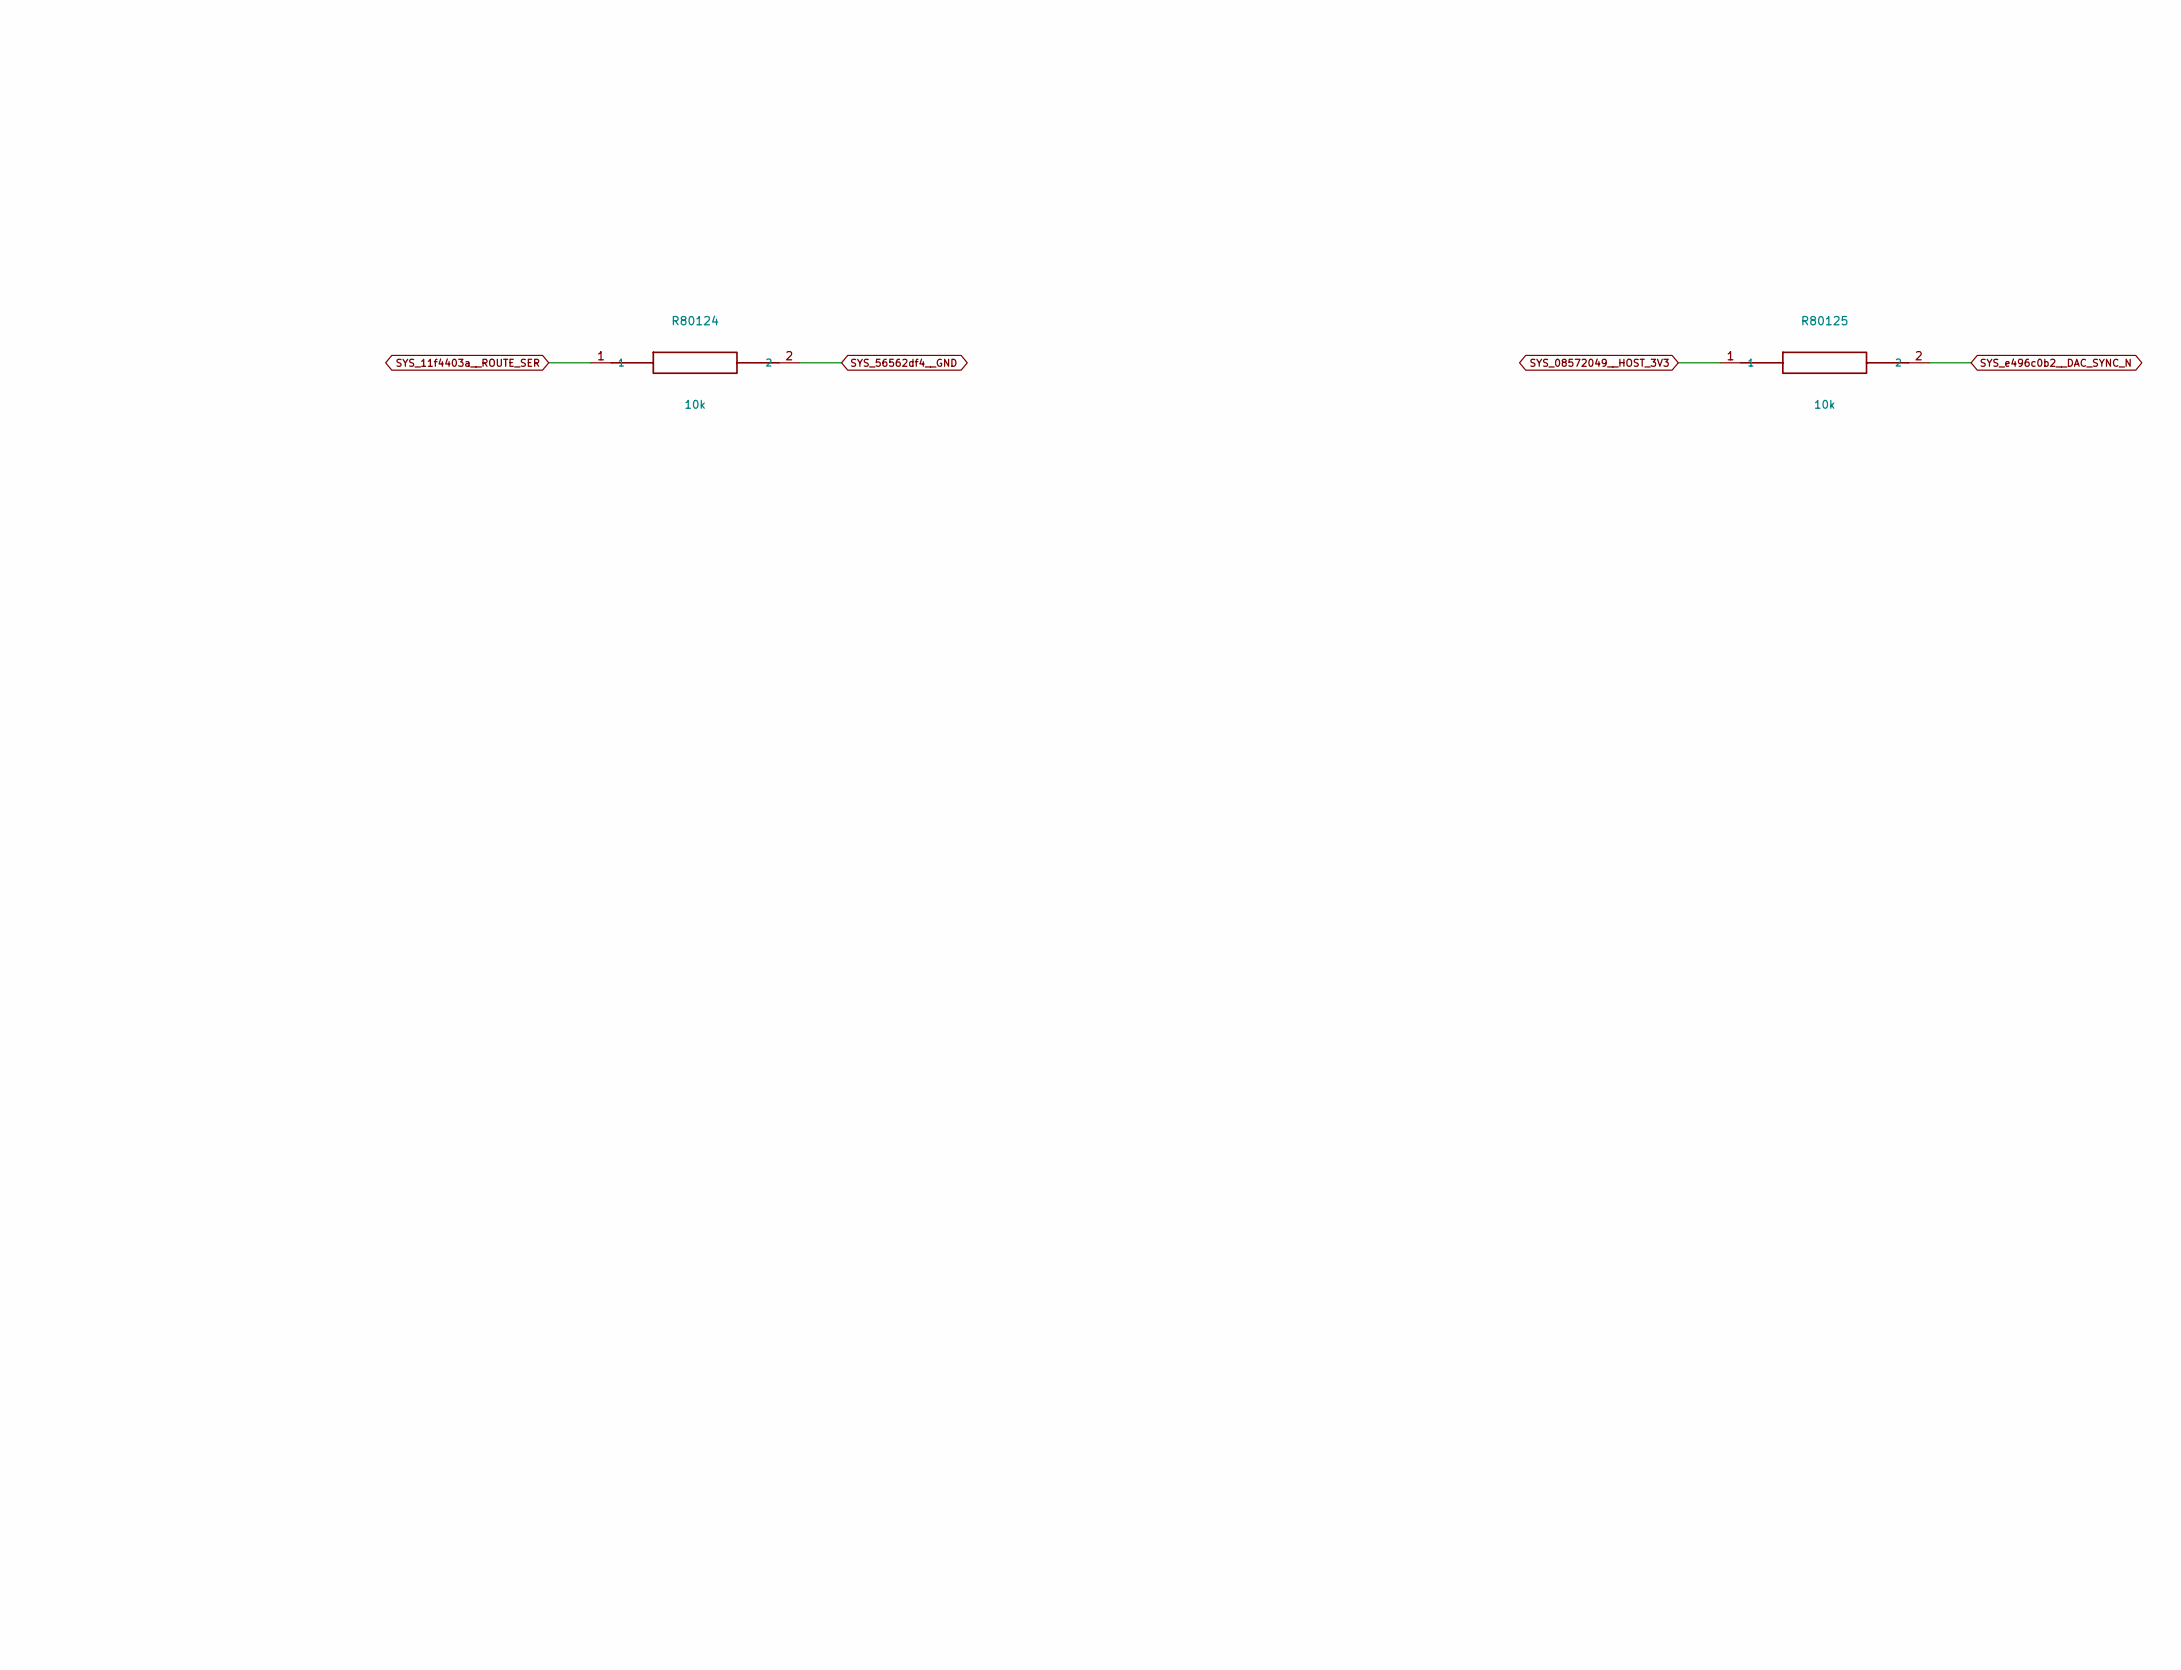
[picture p337: schematic defaults_2.kicad_sch, Project SCCI RH S4 / Passive reset defaults / explicit reco…, part in row 2, column 2]

Parts:
R80114, R80115, R80116, R80117, R80118, R80119, R80120, R80121, R80122, R80123, R80124, R80125, R80126, R80127: 10k; R_0805_2012Metric

Connections:
SYS_7cf9dad5__MON_SCLK: R80115.1; also elsewhere on the board
SYS_11f4403a__ROUTE_SER: R80124.1; also elsewhere on the board
SYS_32a601bf__MON_REARM1: R80122.1; also elsewhere on the board
SYS_36b0932b__INT_RUN1: R80120.2; also elsewhere on the board
SYS_46ea5f03__CH0_REQUEST: R80126.1; also elsewhere on the board
SYS_822d2245__MON_REARM0: R80121.1; also elsewhere on the board
SYS_37737e7c__INT_RUN0: R80119.2; also elsewhere on the board
SYS_56562df4__GND: R80114.2, R80115.2, R80116.2, R80121.2, R80122.2, R80123.2, R80124.2, R80126.2, R80127.2; also elsewhere on the board
SYS_08572049__HOST_3V3: R80117.1, R80118.1, R80119.1, R80120.1, R80125.1; also elsewhere on the board
SYS_a863a08a__CS1: R80118.2; also elsewhere on the board
SYS_a9673f8c__AFE_RECORD: R80114.1; also elsewhere on the board
SYS_ce0a4f53__BOTH_CNV: R80116.1; also elsewhere on the board
SYS_d5e1f64a__ROUTE_SRCLK: R80123.1; also elsewhere on the board
SYS_dd388269__CH1_REQUEST: R80127.1; also elsewhere on the board
SYS_e496c0b2__DAC_SYNC_N: R80125.2; also elsewhere on the board
SYS_ec2c6e7f__CS0: R80117.2; also elsewhere on the board

Notes on the sheet:
DIGITAL SCCI ENGINEERING / ARTIFICIAL SIGNALS / nRF5340 CONTROLLER CARRIER
46 actual GPIO, explicit common CNV/rearm and physical 32-bit health/readback chain. Radio remains disabled.
All labels are native electrical connections. Digital artificial-load interface; no clinical, chronic or body-radio qualification.
Hardware permissions and terminal guards remain independent of transport. Loss of data rejects the observation.
