pratham-cloud-ctrl/Project-SCCI-RH/electronics/stage4/integrated-pcb/boards/controller-carrier/controller_carrier.kicad_pcb

## KiCad design electronics/stage4/integrated-pcb/boards/controller-carrier/controller_carrier.kicad_pcb (continued)

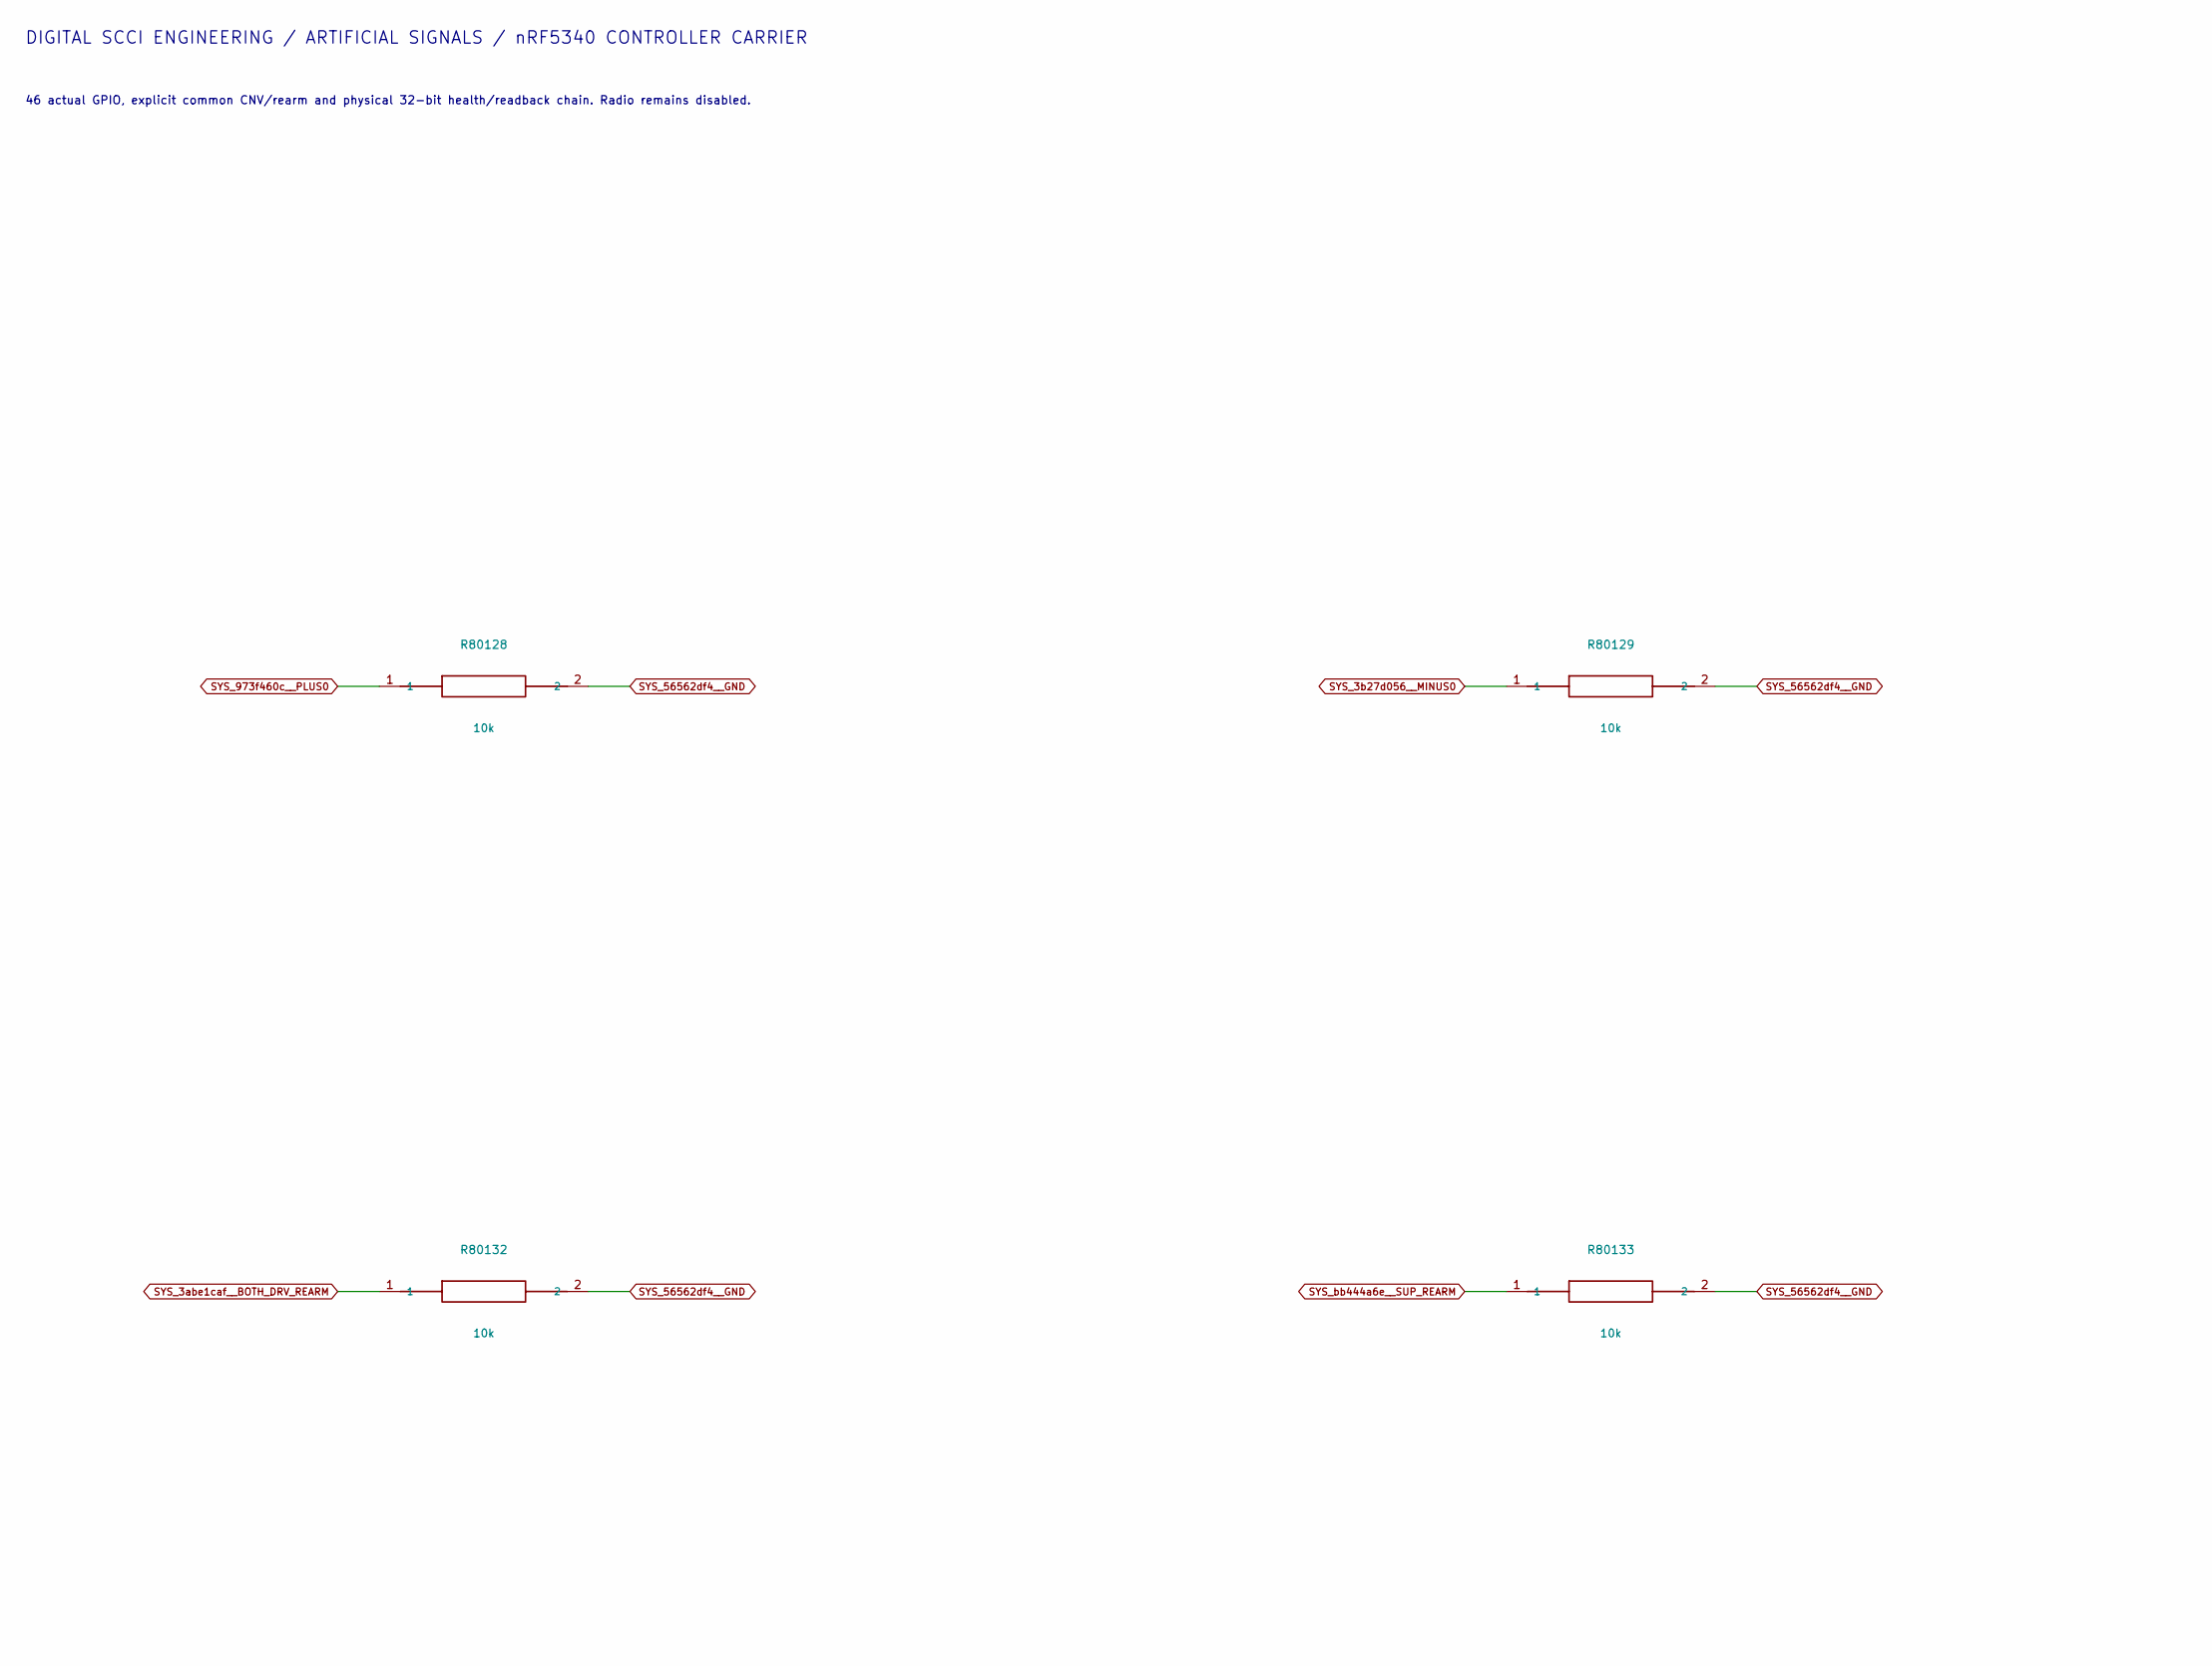
[picture p338: schematic defaults_3.kicad_sch, Project SCCI RH S4 / Passive reset defaults / explicit reco…, part in row 1, column 1]

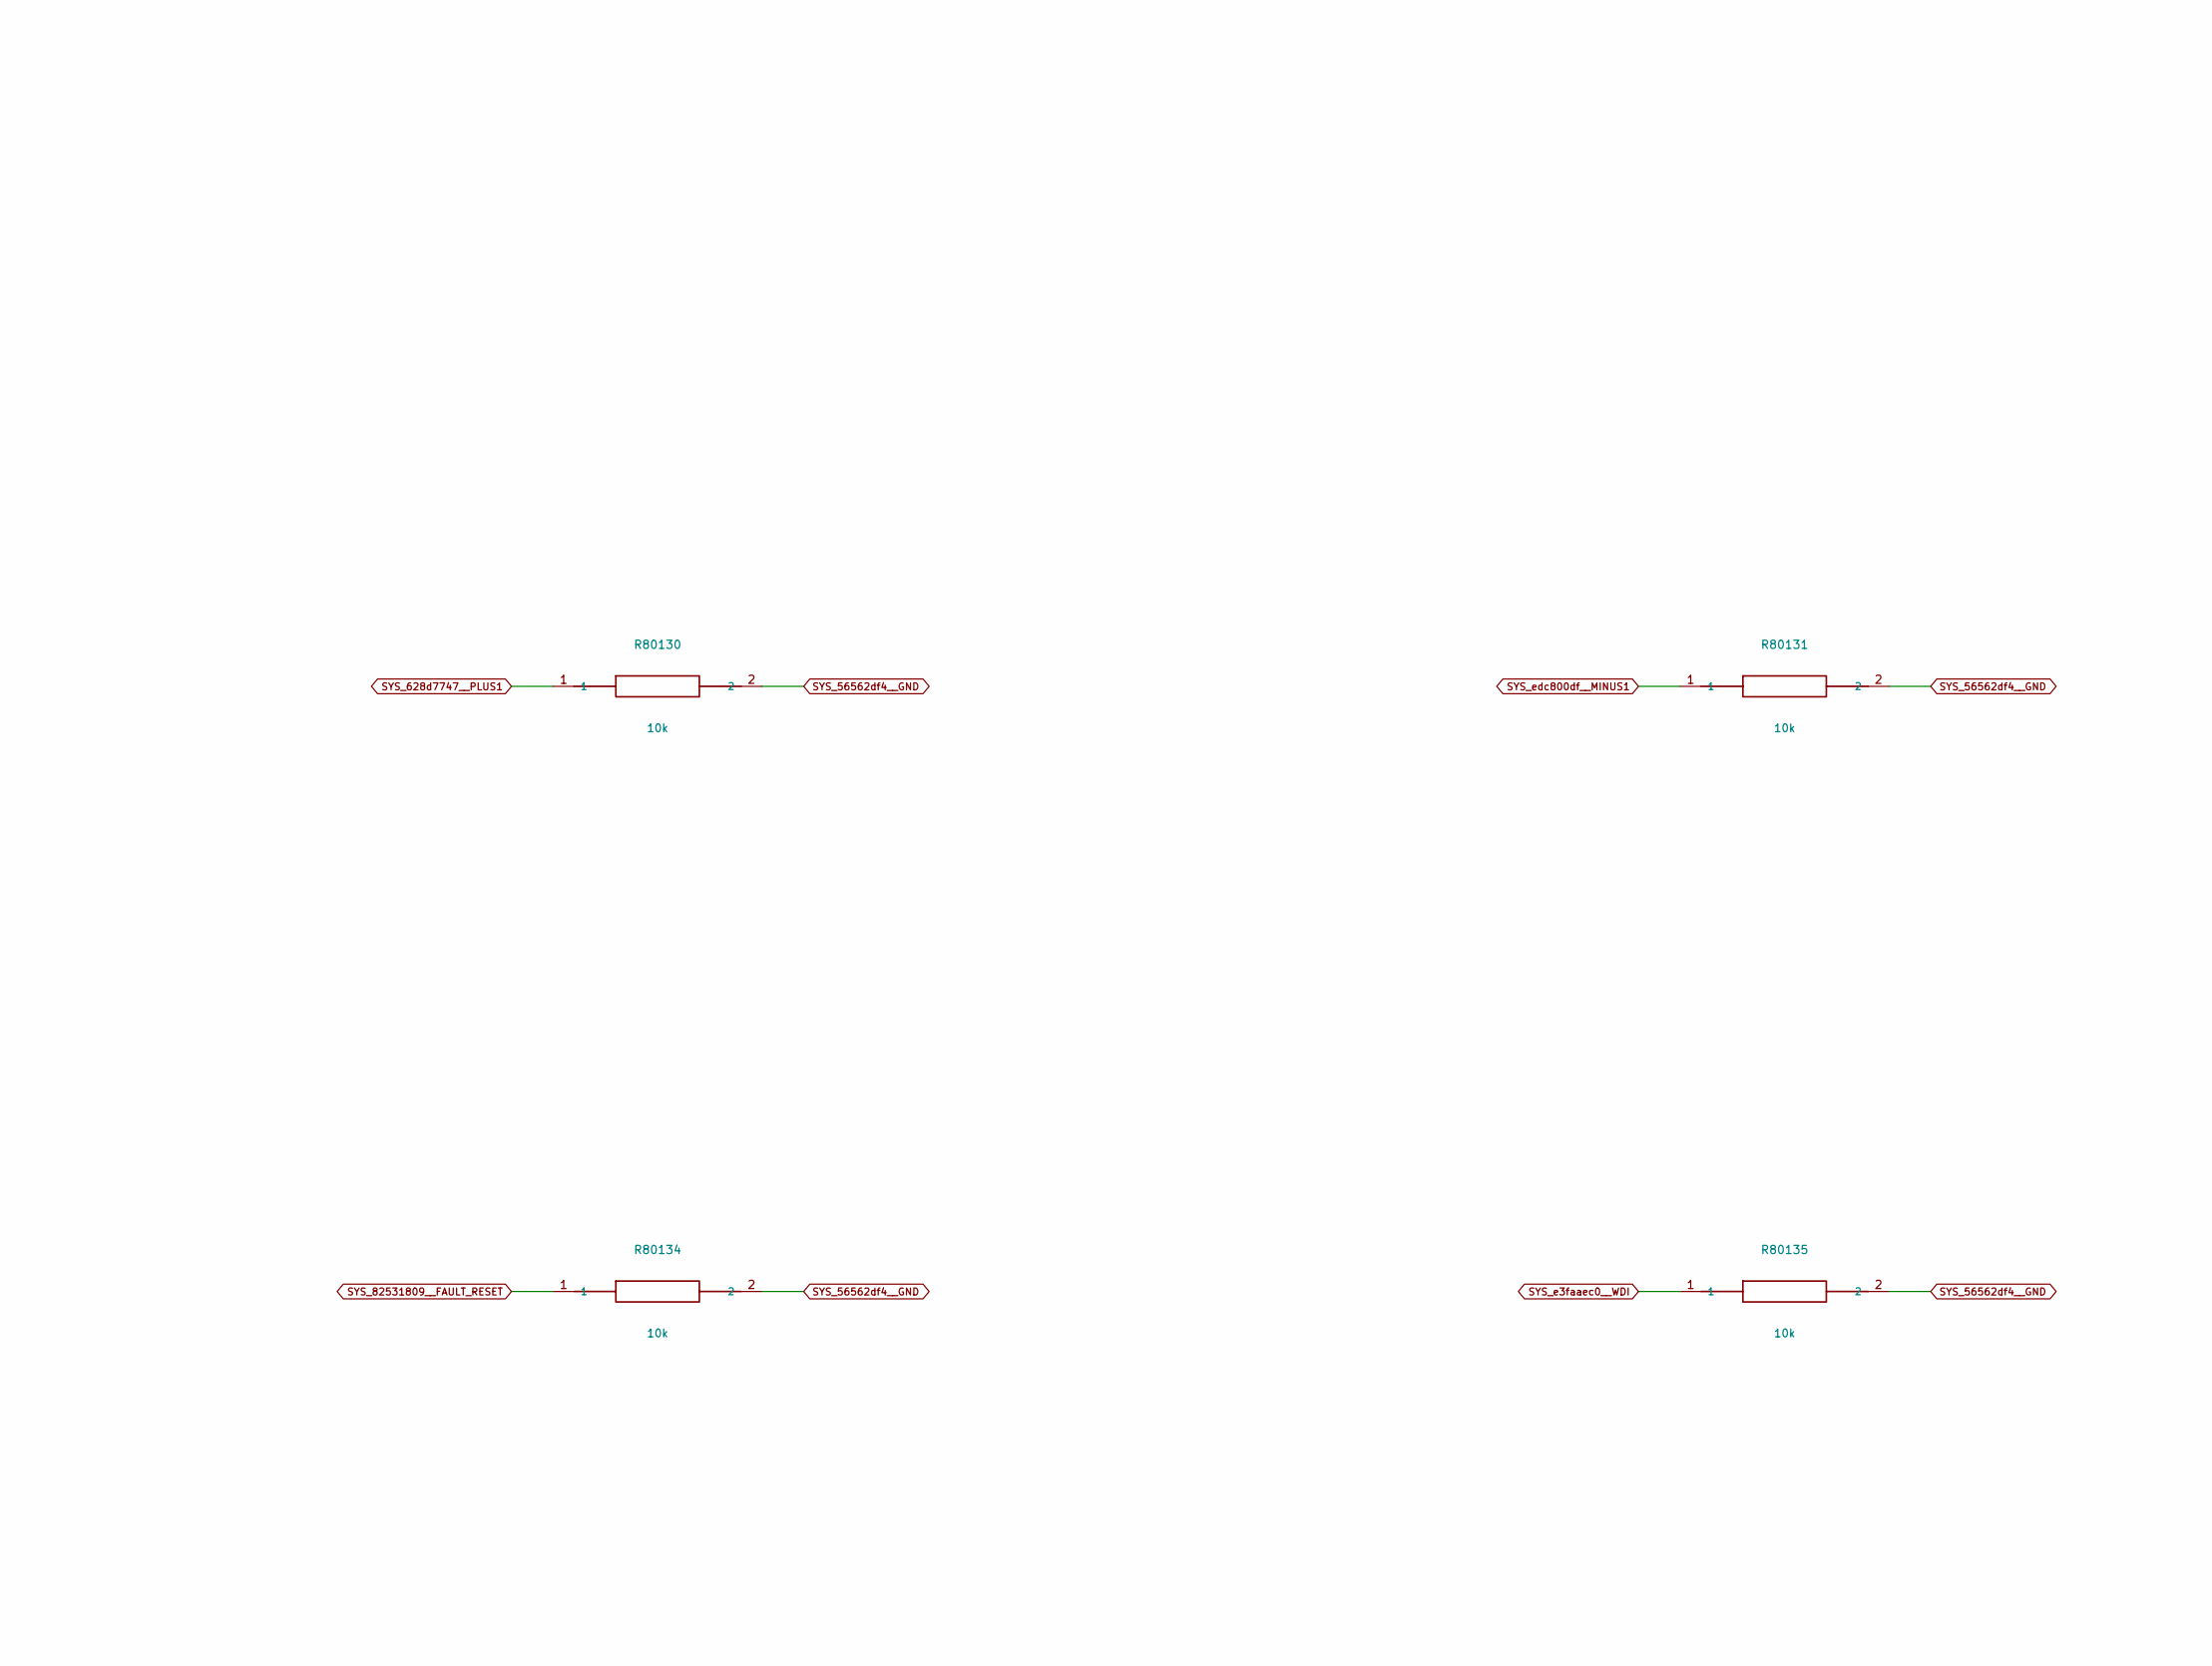
[picture p339: schematic defaults_3.kicad_sch, Project SCCI RH S4 / Passive reset defaults / explicit reco…, part in row 1, column 2]

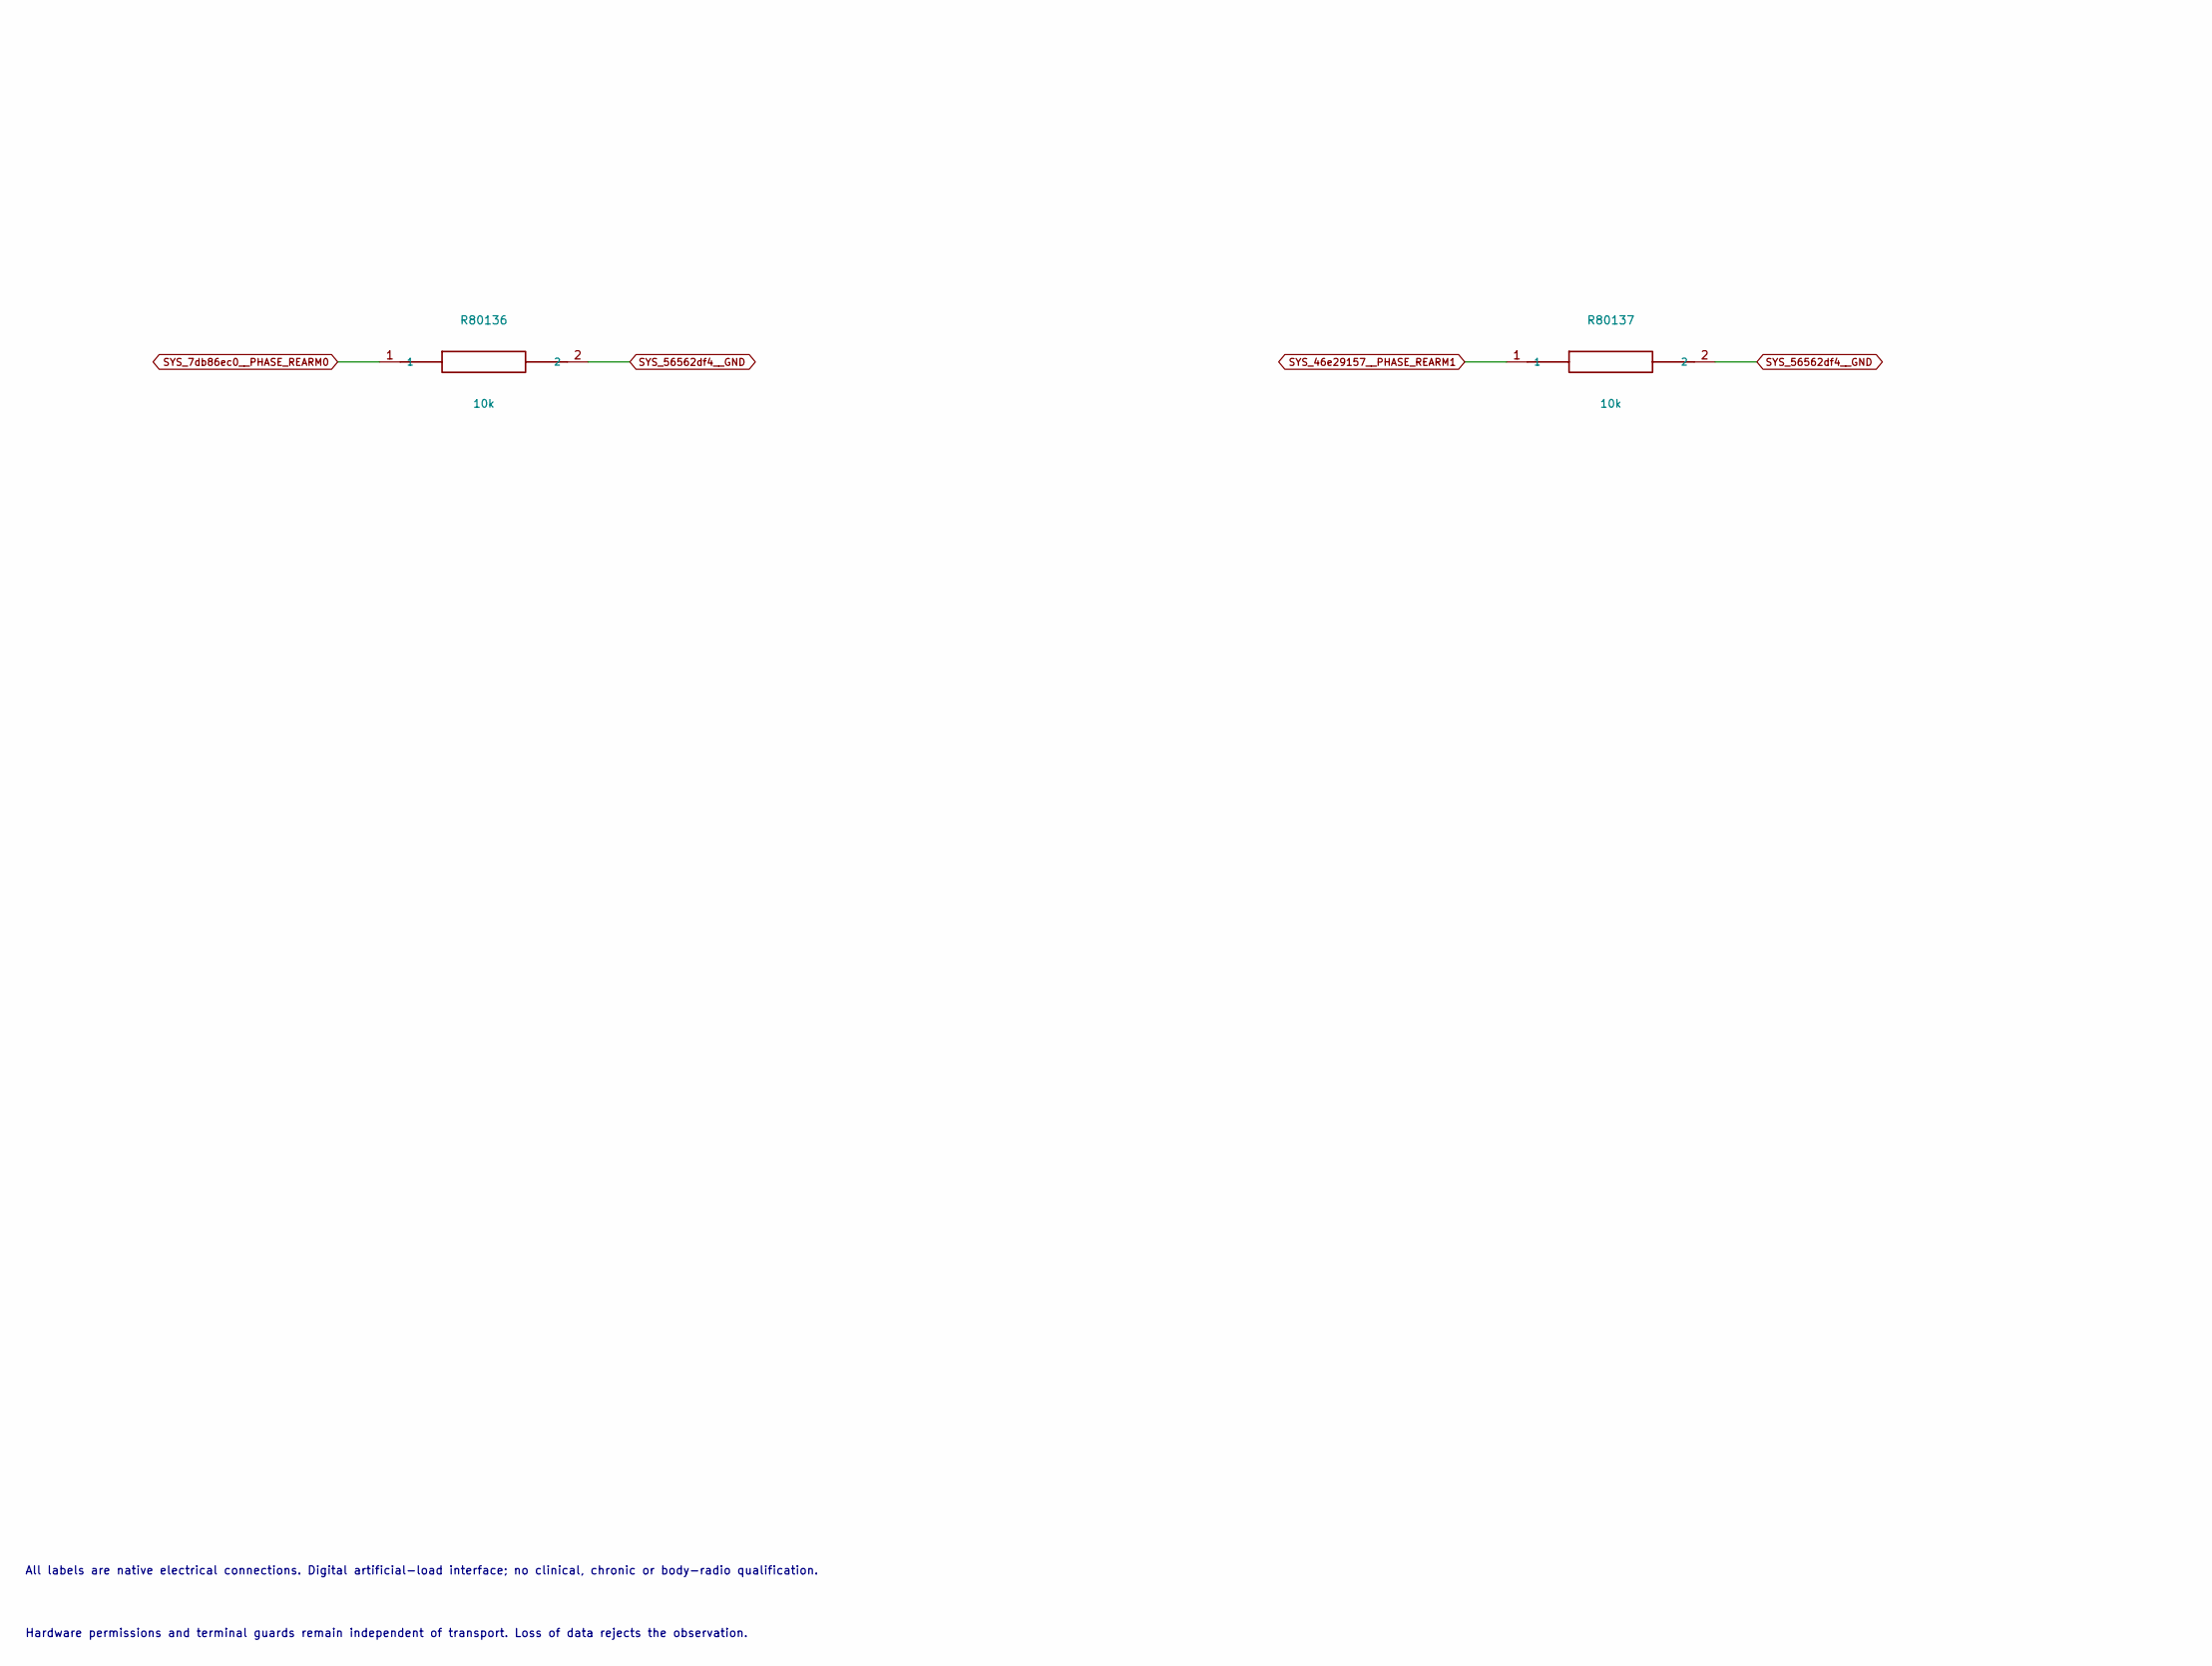
[picture p340: schematic defaults_3.kicad_sch, Project SCCI RH S4 / Passive reset defaults / explicit reco…, part in row 2, column 1]

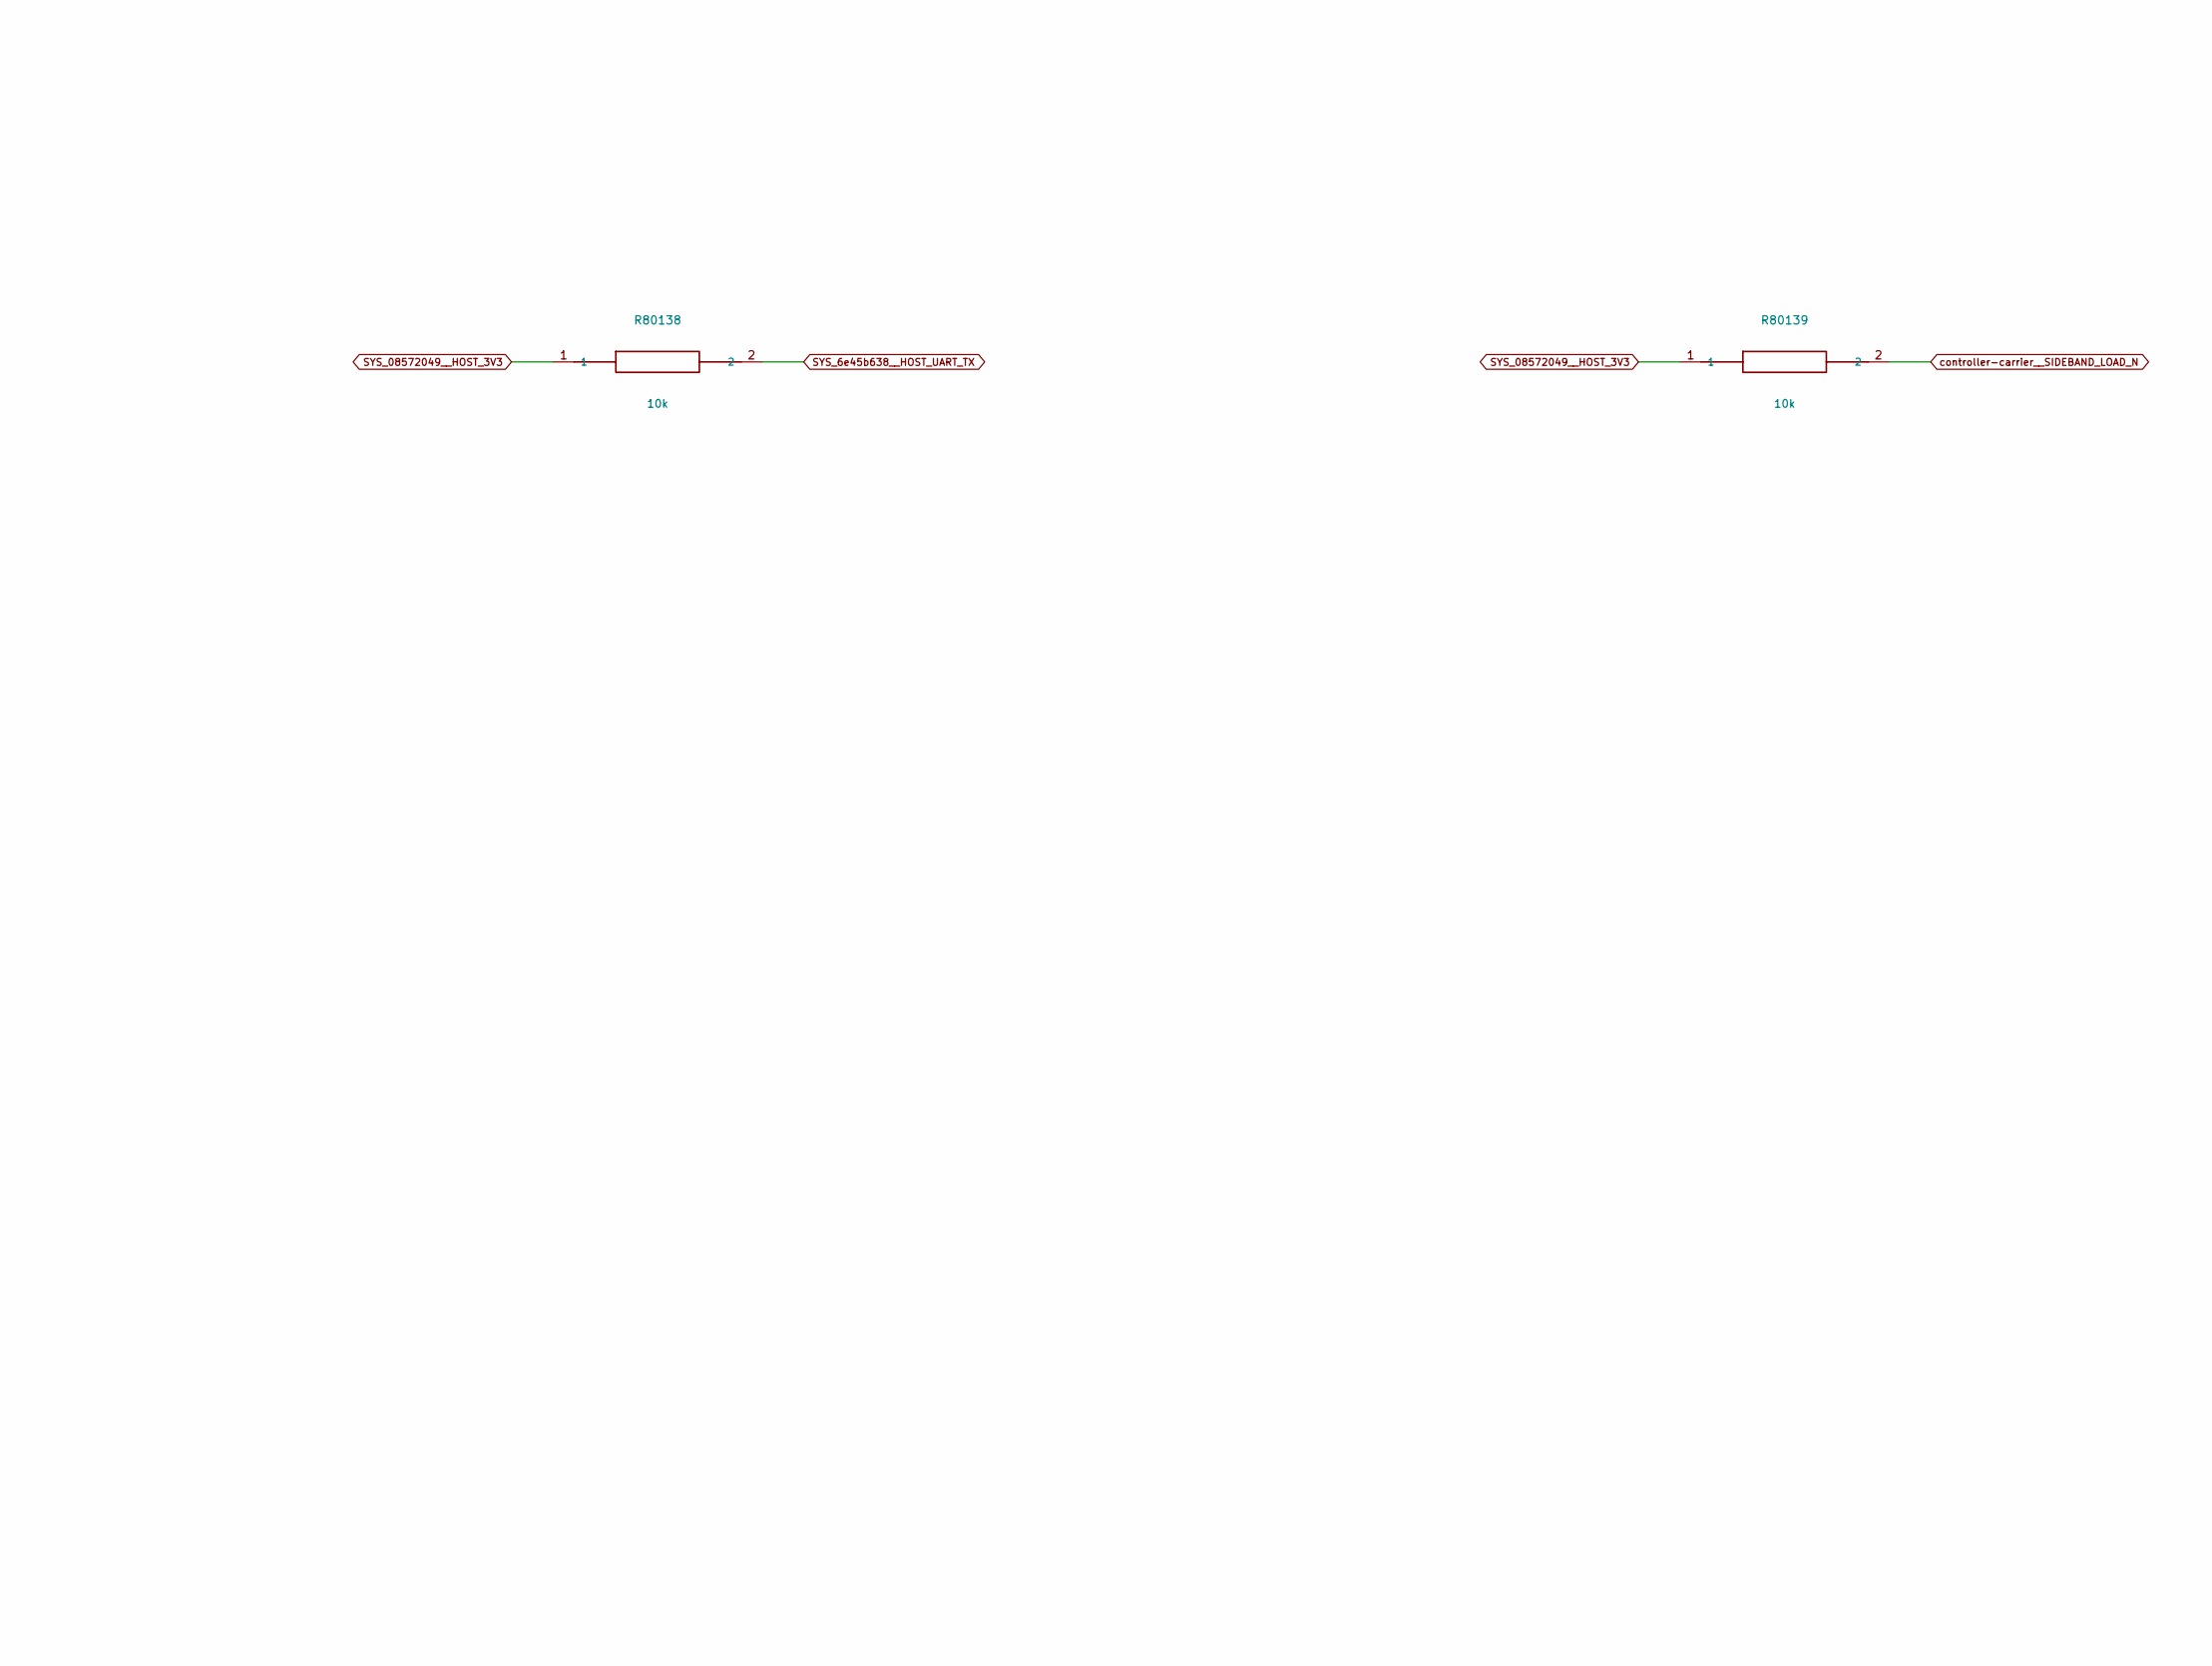
[picture p341: schematic defaults_3.kicad_sch, Project SCCI RH S4 / Passive reset defaults / explicit reco…, part in row 2, column 2]

Parts:
R80128, R80129, R80130, R80131, R80132, R80133, R80134, R80135, R80136, R80137, R80138, R80139: 10k; R_0805_2012Metric

Connections:
SYS_3abe1caf__BOTH_DRV_REARM: R80132.1; also elsewhere on the board
SYS_3b27d056__MINUS0: R80129.1; also elsewhere on the board
SYS_6e45b638__HOST_UART_TX: R80138.2; also elsewhere on the board
SYS_7db86ec0__PHASE_REARM0: R80136.1; also elsewhere on the board
SYS_46e29157__PHASE_REARM1: R80137.1; also elsewhere on the board
SYS_628d7747__PLUS1: R80130.1; also elsewhere on the board
SYS_973f460c__PLUS0: R80128.1; also elsewhere on the board
SYS_56562df4__GND: R80128.2, R80129.2, R80130.2, R80131.2, R80132.2, R80133.2, R80134.2, R80135.2, R80136.2, R80137.2; also elsewhere on the board
SYS_08572049__HOST_3V3: R80138.1, R80139.1; also elsewhere on the board
SYS_82531809__FAULT_RESET: R80134.1; also elsewhere on the board
SYS_bb444a6e__SUP_REARM: R80133.1; also elsewhere on the board
SYS_e3faaec0__WDI: R80135.1; also elsewhere on the board
SYS_edc800df__MINUS1: R80131.1; also elsewhere on the board
controller-carrier__SIDEBAND_LOAD_N: R80139.2; also elsewhere on the board

Notes on the sheet:
DIGITAL SCCI ENGINEERING / ARTIFICIAL SIGNALS / nRF5340 CONTROLLER CARRIER
46 actual GPIO, explicit common CNV/rearm and physical 32-bit health/readback chain. Radio remains disabled.
All labels are native electrical connections. Digital artificial-load interface; no clinical, chronic or body-radio qualification.
Hardware permissions and terminal guards remain independent of transport. Loss of data rejects the observation.

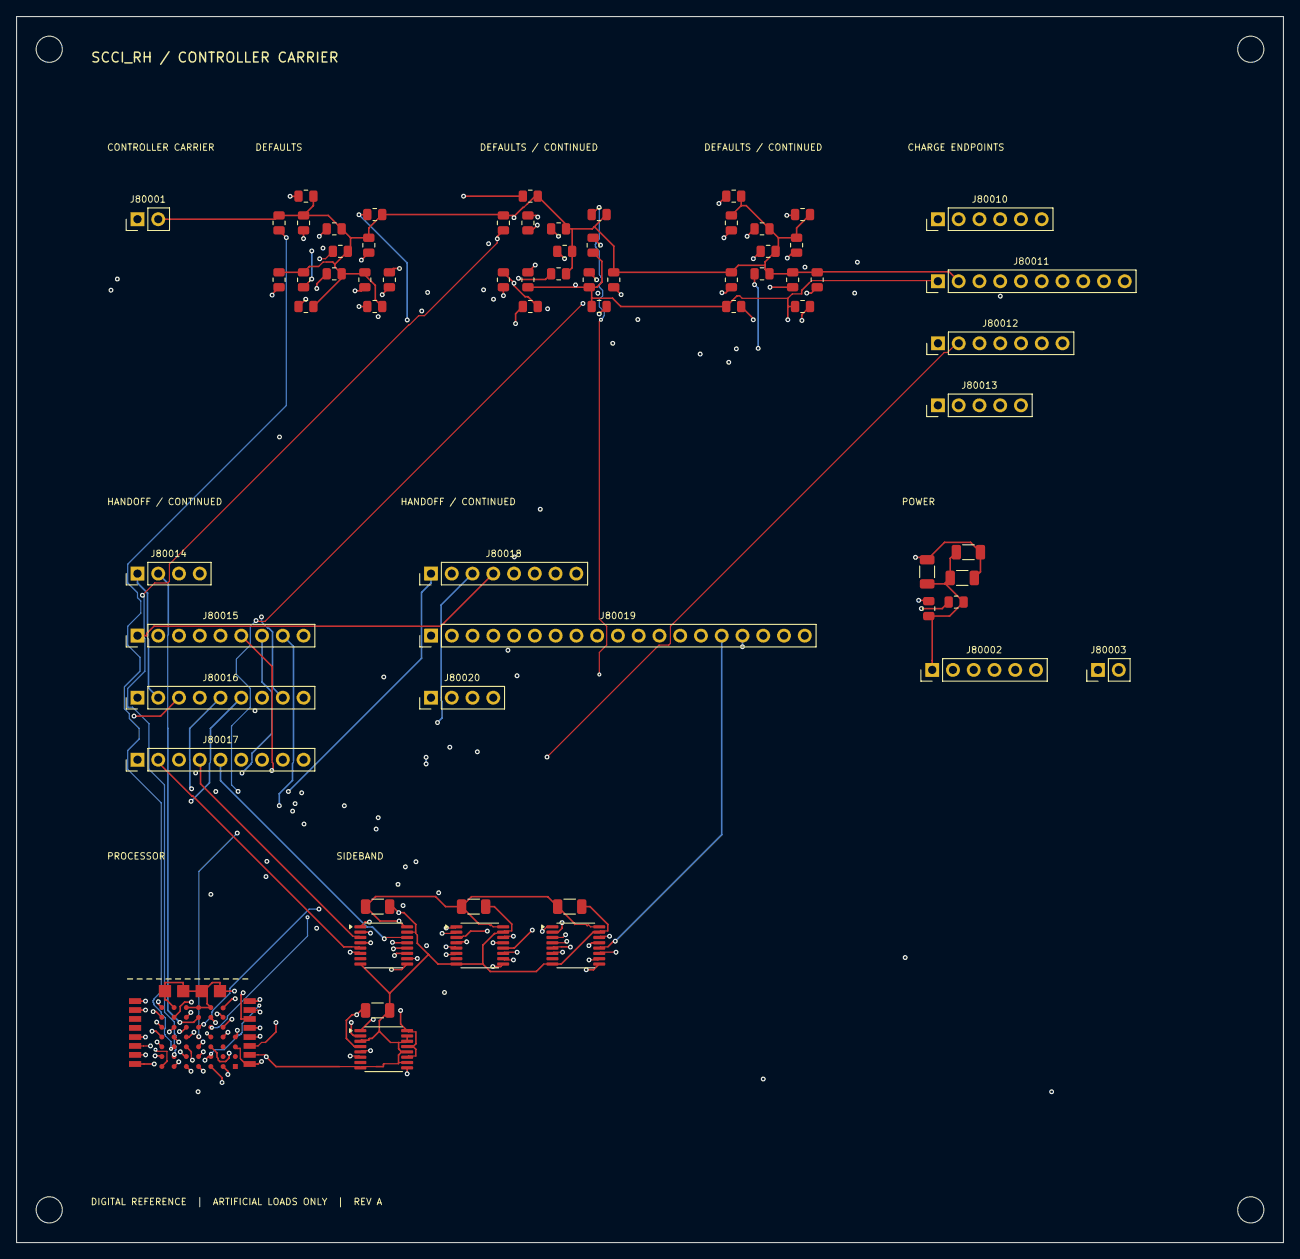
[picture p342: board controller_carrier.kicad_pcb from above]

Board: 4 copper layers, 155.0 x 150.0 mm, 72 parts (0 on the bottom side), 81 nets.

Other parts of the board:
H1, H2, H3, H4: MountingHole_3.2mm_M3
