pratham-cloud-ctrl/Project-SCCI-RH/electronics/stage4/integrated-pcb/boards/recording-front-end/recording_front_end.kicad_pcb

## KiCad design electronics/stage4/integrated-pcb/boards/recording-front-end/recording_front_end.kicad_pcb (2026-10-29)

Schematic: recording_front_end.kicad_sch, Project SCCI RH S4 / Isolated SPI, control and supplied pow…

Parts:
C30001, C30002, C30003, C30004, C30005, C30006: 100n X7R 16V; C_0805_2012Metric
J30001: EXTERNAL ISOLATED AFE RAILS; PinHeader_1x04_P2.54mm_Vertical
J30002: HOST SPI / SUPERVISOR; PinHeader_1x10_P2.54mm_Vertical
J30003: 18 RECORDING FUNCTIONAL PORTS; PinHeader_1x18_P2.54mm_Vertical
R30001, R30002, R30003, R30004, R30005, R30006, R30007, R30008, R30009, R30010, R30011, R30012, R30013: 10k; R_0805_2012Metric
R30014: 1k; R_0805_2012Metric
U30001, U30002: ISO6741FDWR; SOIC-16W_7.5x10.3mm_P1.27mm
U30003: SN74LVC1G04DBVR; SOT-23-5
U30004: SN74LVC1G08DBVR; SOT-23-5

Connections:
SYS_0bc4e447__AFE_CONNECT: R30007.1, U30002.14 (OUTA), U30004.1 (A); also elsewhere on the board
SYS_3fdd5066__AFE_P5: J30001.1; also elsewhere on the board
SYS_4d4028f1__AFE_MOSI: J30002.4, R30002.1, U30001.4 (INB)
SYS_4dbe75ce__AFE_MISO: J30002.6, U30001.6 (OUTD)
SYS_4eb6b999__AFE_ACQUIRE: R30009.1, U30004.4 (Y); also elsewhere on the board
SYS_8b29b23f__AFE_CONNECT: J30002.7, R30004.1, U30002.3 (INA)
SYS_18e49fe8__AFE_CS_ASSERT: J30002.5, R30003.1, U30001.5 (INC)
SYS_65aafbb6__AFE_3V3: C30002.1, C30004.1, C30005.1, C30006.1, J30001.3, R30011.2, R30014.2, U30001.10 (EN2), U30001.16 (VCC2_AFE), U30002.10 (EN2), U30002.16 (VCC2_AFE), U30003.5 (VCC), U30004.5 (VCC); also elsewhere on the board
SYS_56562df4__GND: C30001.2, C30003.2, J30002.2, J30002.10, R30001.2, R30002.2, R30003.2, R30004.2, R30005.2, R30006.2, U30001.2 (GND1_HOST), U30001.8 (GND1_HOST), U30002.2 (GND1_HOST), U30002.5 (INC), U30002.8 (GND1_HOST)
SYS_08572049__HOST_3V3: C30001.1, C30003.1, J30002.1, U30001.1 (VCC1_HOST), U30001.7 (EN1), U30002.1 (VCC1_HOST), U30002.7 (EN1)
SYS_a9673f8c__AFE_RECORD: J30002.8, R30005.1, U30002.4 (INB)
SYS_ce1178b4__AFE_FAULT_N: J30002.9, R30006.1, U30002.6 (OUTD)
SYS_d73cd2ee__AFE_N5: J30001.2; also elsewhere on the board
SYS_f30c60de__AFE_SCLK: J30002.3, R30001.1, U30001.3 (INA)
SYS_fca1c340__AFEAGND: C30002.2, C30004.2, C30005.2, C30006.2, J30001.4, R30007.2, R30008.2, R30009.2, R30010.2, R30012.2, R30013.2, U30001.9 (GND2_AFE), U30001.15 (GND2_AFE), U30002.9 (GND2_AFE), U30002.15 (GND2_AFE), U30003.3 (GND), U30004.3 (GND); also elsewhere on the board
recording-front-end__AFE_CS_ASSERT: R30010.1, U30001.12 (OUTC), U30003.2 (A)
recording-front-end__AFE_CS_N: R30011.1, U30003.4 (Y); also elsewhere on the board
recording-front-end__AFE_FAULT_N: R30014.1, U30002.11 (IND); also elsewhere on the board
recording-front-end__AFE_MISO: U30001.11 (IND); also elsewhere on the board
recording-front-end__AFE_MOSI: R30013.1, U30001.13 (OUTB); also elsewhere on the board
recording-front-end__AFE_RECORD_CMD: R30008.1, U30002.13 (OUTB), U30004.2 (B)
recording-front-end__AFE_SCLK: R30012.1, U30001.14 (OUTA); also elsewhere on the board
recording-front-end__BIAS_CONTACT: J30003.18; also elsewhere on the board
recording-front-end__REC00_CONTACT: J30003.1; also elsewhere on the board
recording-front-end__REC01_CONTACT: J30003.2; also elsewhere on the board
recording-front-end__REC02_CONTACT: J30003.3; also elsewhere on the board
recording-front-end__REC03_CONTACT: J30003.4; also elsewhere on the board
recording-front-end__REC04_CONTACT: J30003.5; also elsewhere on the board
recording-front-end__REC05_CONTACT: J30003.6; also elsewhere on the board
recording-front-end__REC06_CONTACT: J30003.7; also elsewhere on the board
recording-front-end__REC07_CONTACT: J30003.8; also elsewhere on the board
recording-front-end__REC08_CONTACT: J30003.9; also elsewhere on the board
recording-front-end__REC09_CONTACT: J30003.10; also elsewhere on the board
recording-front-end__REC10_CONTACT: J30003.11; also elsewhere on the board
recording-front-end__REC11_CONTACT: J30003.12; also elsewhere on the board
recording-front-end__REC12_CONTACT: J30003.13; also elsewhere on the board
recording-front-end__REC13_CONTACT: J30003.14; also elsewhere on the board
recording-front-end__REC14_CONTACT: J30003.15; also elsewhere on the board
recording-front-end__REC15_CONTACT: J30003.16; also elsewhere on the board
recording-front-end__REF_CONTACT: J30003.17; also elsewhere on the board

Notes on the sheet:
DIGITAL RESEARCH CIRCUIT / ARTIFICIAL SIGNALS / NO PCB OR IMPLANT QUALIFICATION
Spinal concept: 16 positive contacts + 1 shared reference + separate passive bias; amplifier linearity and biological recording remain conditional.
HOSTGND and AFEAGND are separate domains. Both receive valid regulated supplies externally; the digital barrier does not generate power.
CS_ASSERT low -> island CS_N high. CONNECT low disconnects HV paths; ACQUIRE = CONNECT & RECORD, so 01 remains clamped.
Driver phase admission needs independently observed ISOLATED_READY; neither commands nor fault flags establish voltage or delivery evidence.
