pratham-cloud-ctrl/Project-SCCI-RH/electronics/stage4/integrated-pcb/boards/recording-front-end/recording_front_end.kicad_pcb

## KiCad design electronics/stage4/integrated-pcb/boards/recording-front-end/recording_front_end.kicad_pcb (continued)

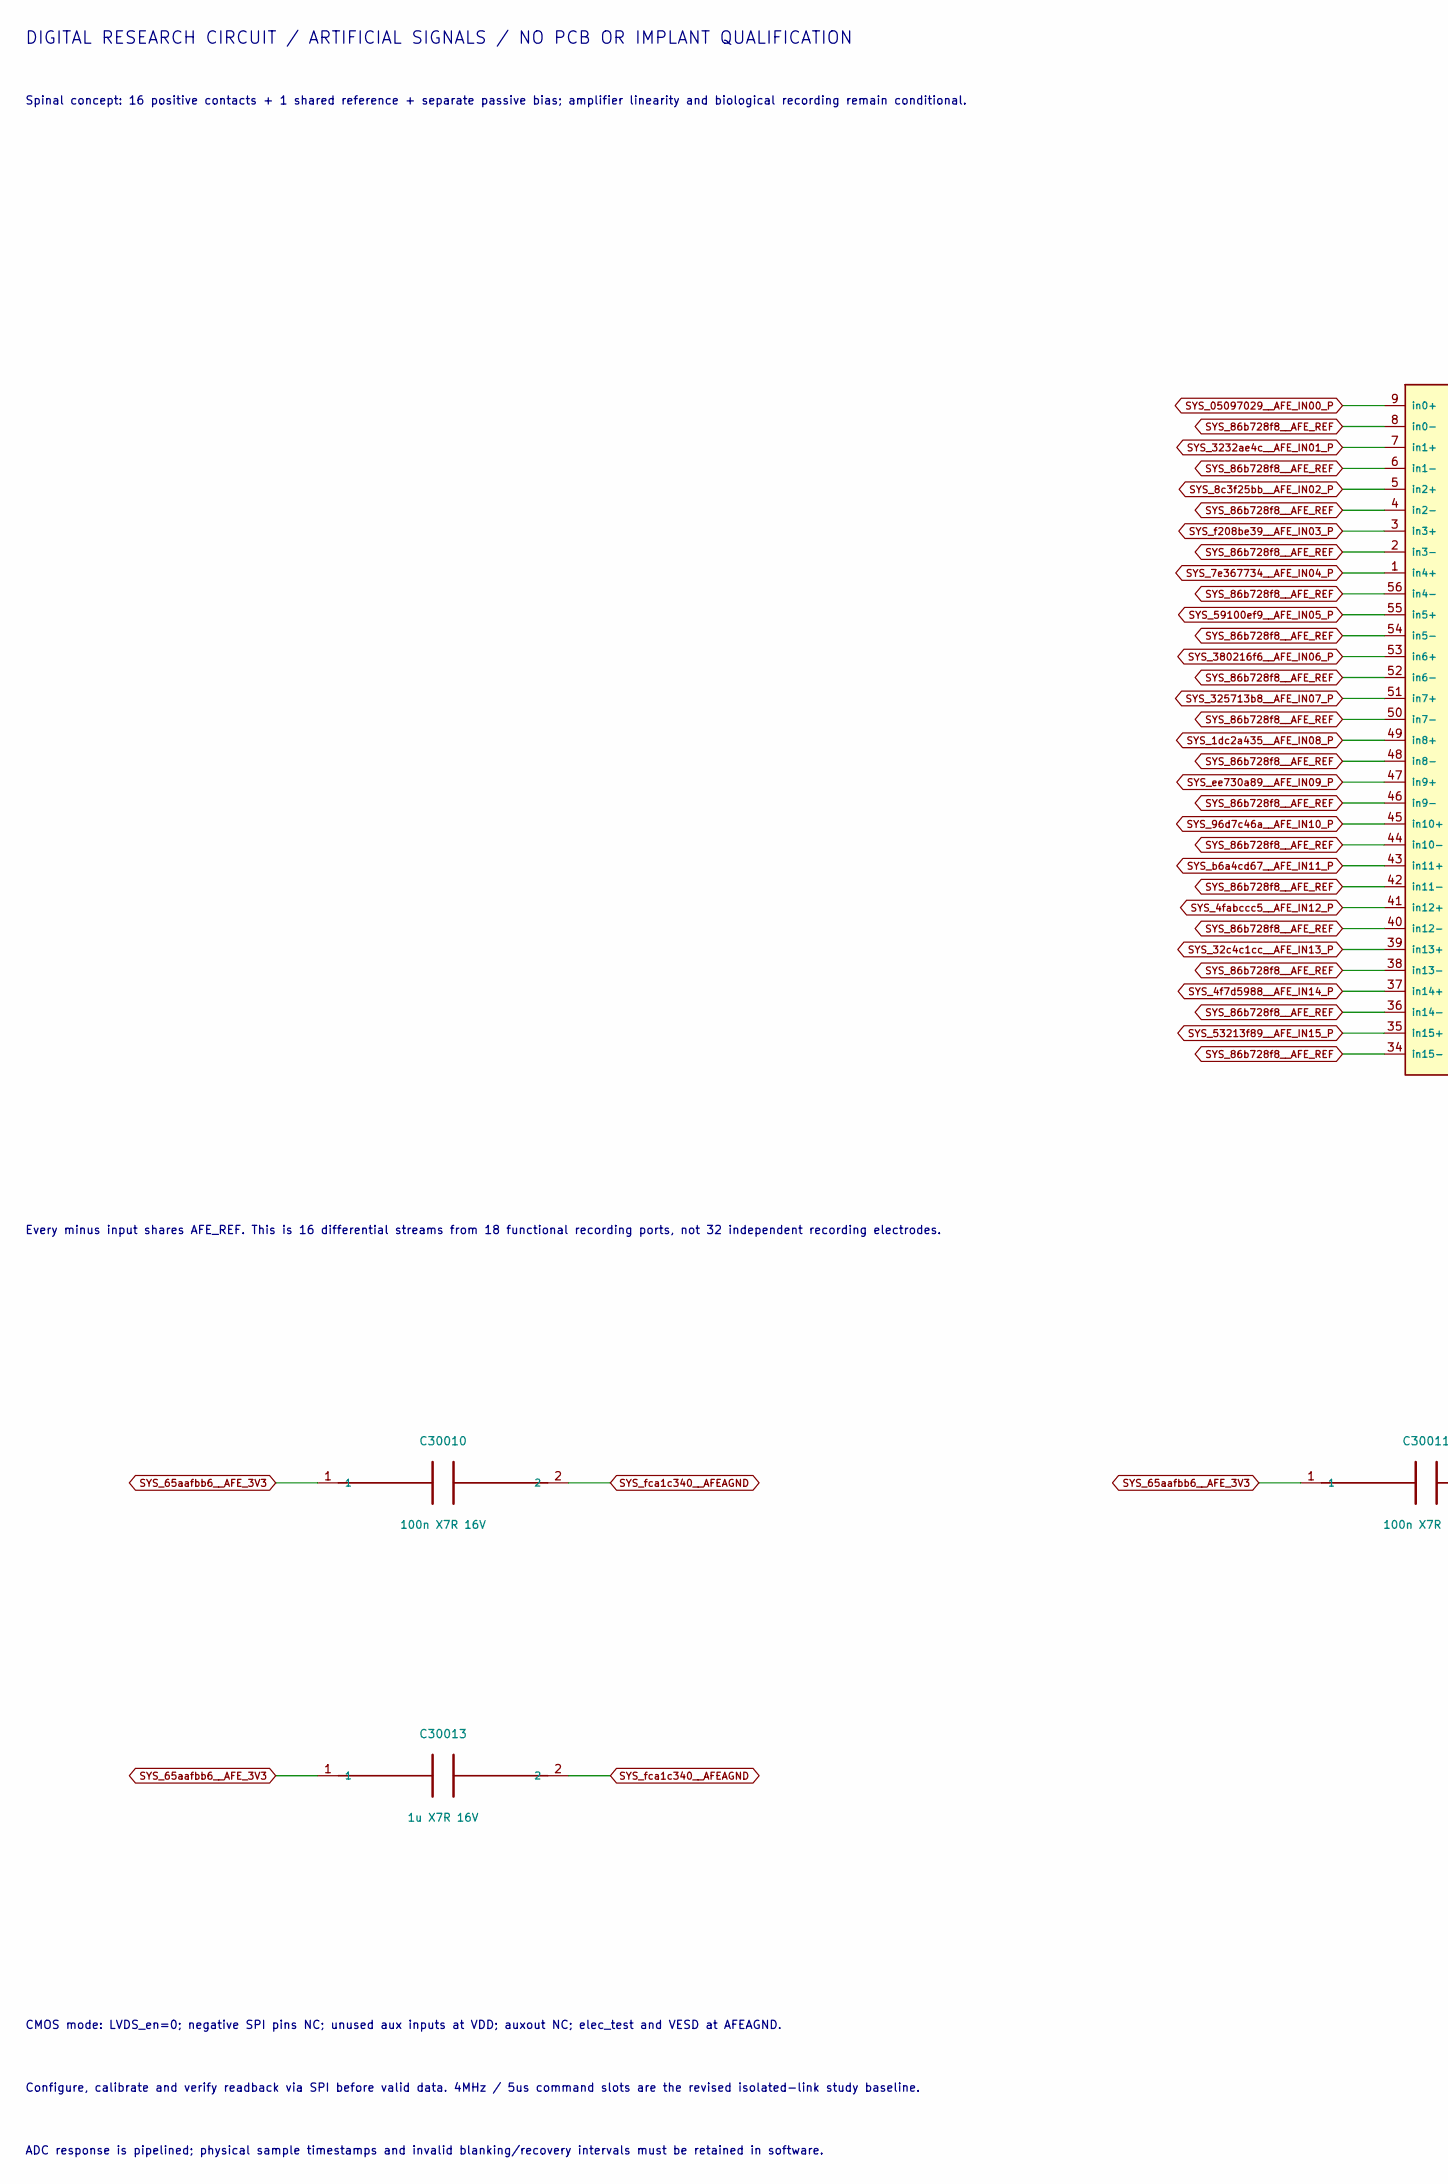
[picture p351: schematic acquisition.kicad_sch, Project SCCI RH S4 / RHD2216 / sixteen sampled differential…, part in row 1, column 1]

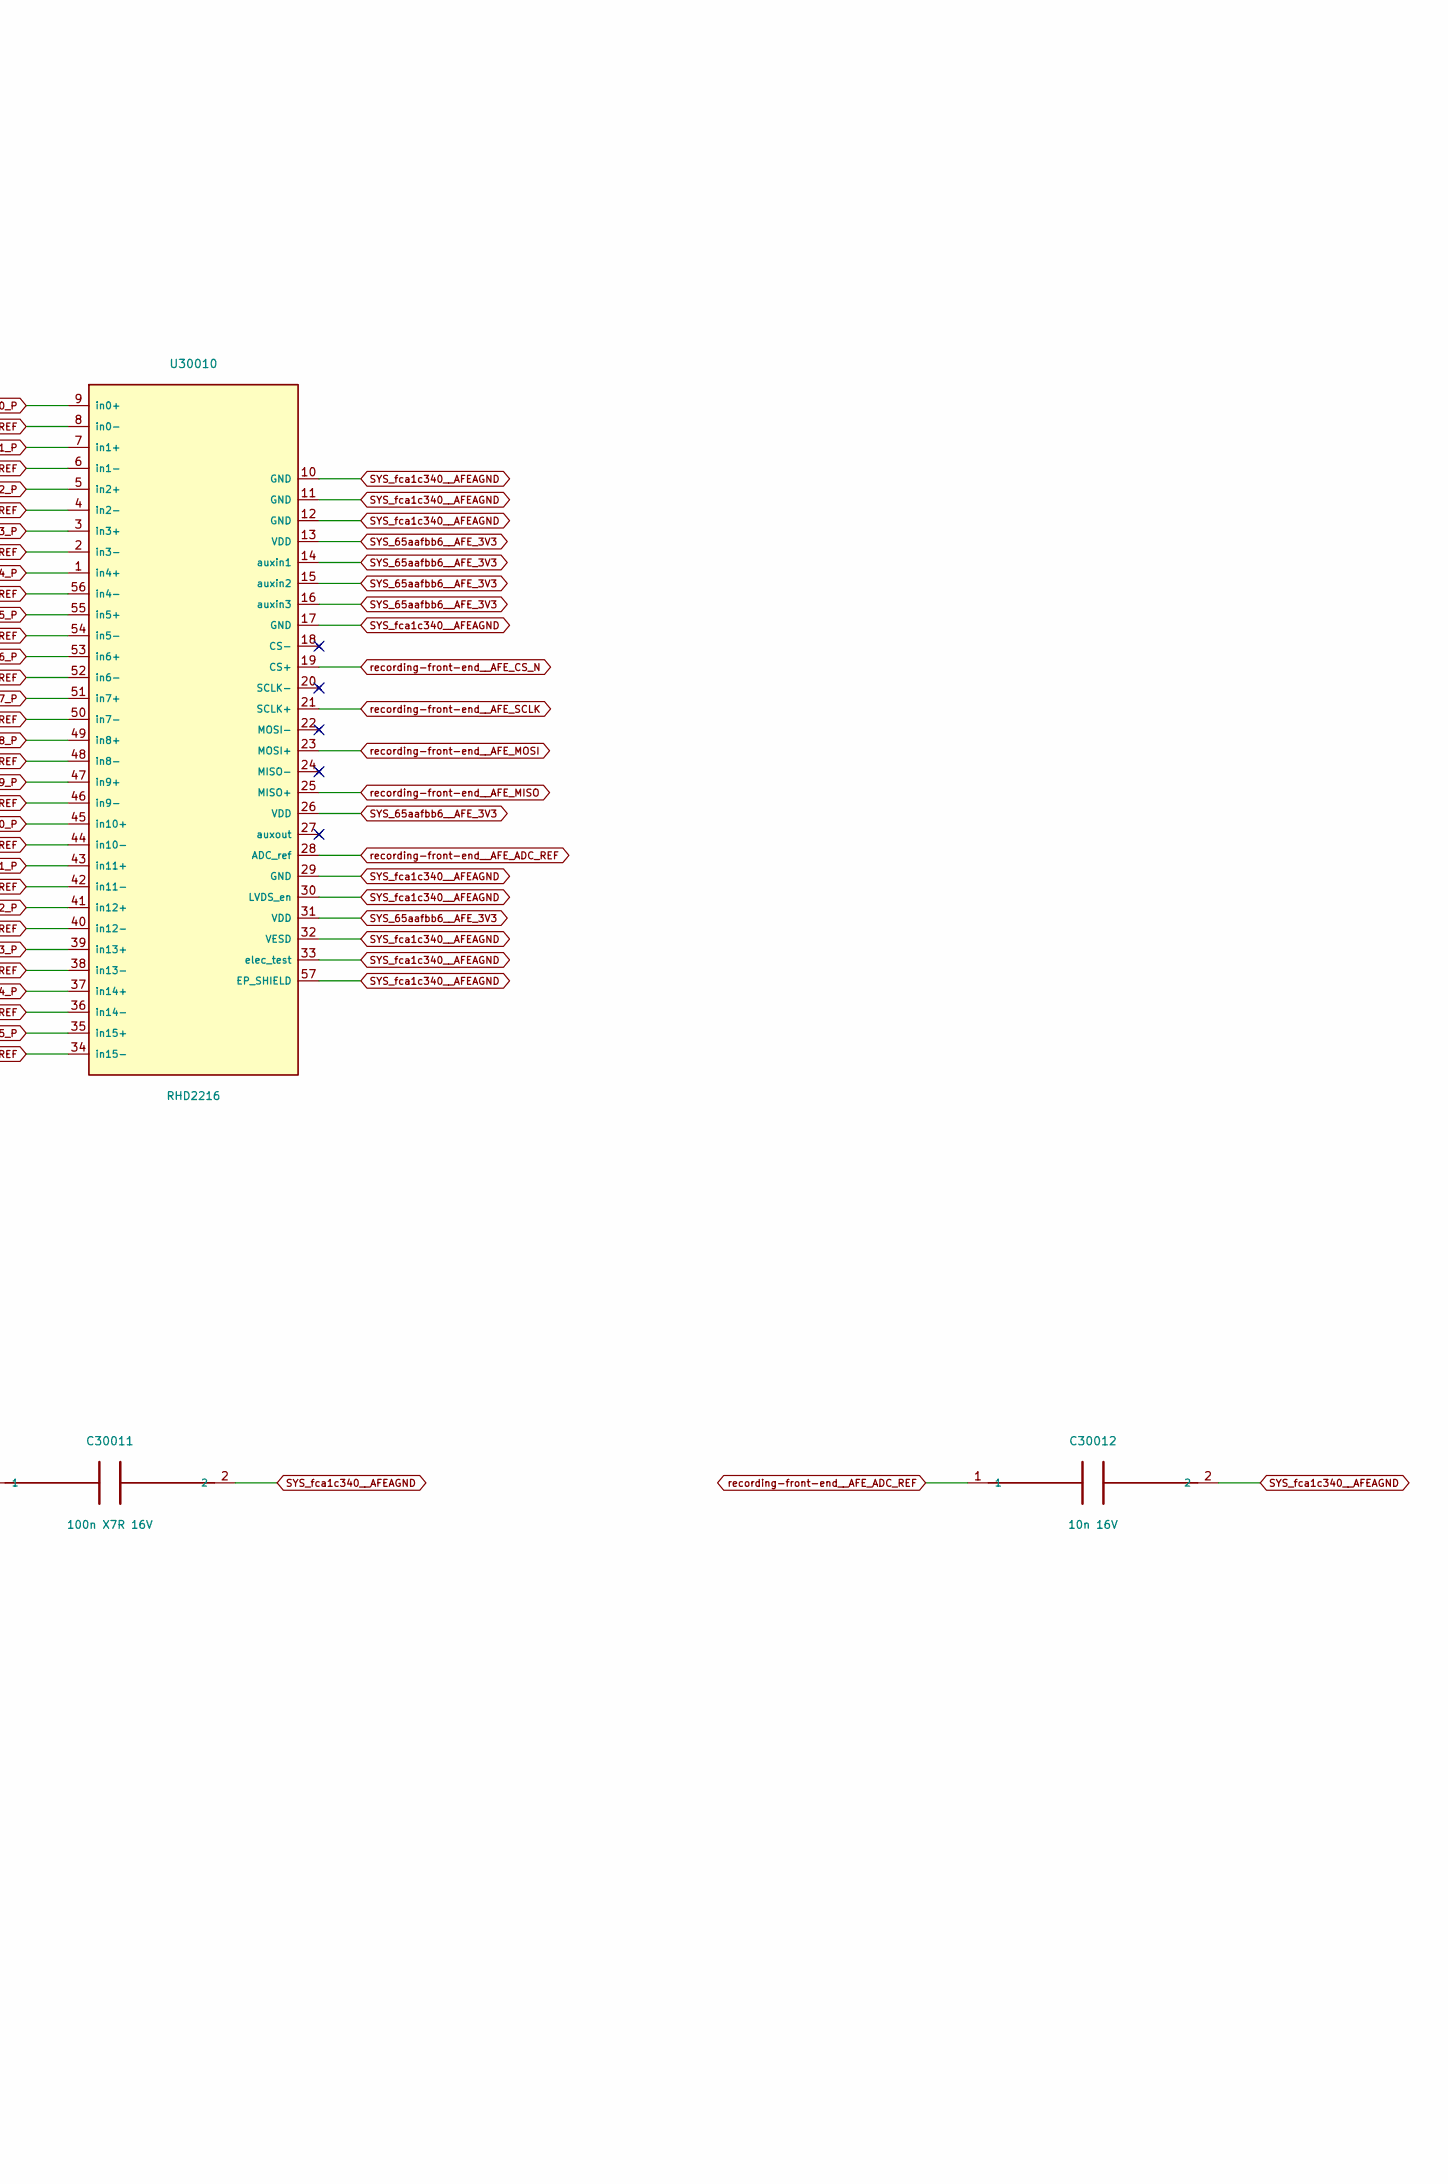
[picture p352: schematic acquisition.kicad_sch, Project SCCI RH S4 / RHD2216 / sixteen sampled differential…, part in row 1, column 2]

Parts:
C30010, C30011: 100n X7R 16V; C_0805_2012Metric
C30012: 10n 16V; C_0805_2012Metric
C30013: 1u X7R 16V; C_0805_2012Metric
U30010: RHD2216; RHD2216_QFN56_8x8_P0.5_EP6.1

Connections:
SYS_1dc2a435__AFE_IN08_P: U30010.49 (in8+); also elsewhere on the board
SYS_4f7d5988__AFE_IN14_P: U30010.37 (in14+); also elsewhere on the board
SYS_4fabccc5__AFE_IN12_P: U30010.41 (in12+); also elsewhere on the board
SYS_7e367734__AFE_IN04_P: U30010.1 (in4+); also elsewhere on the board
SYS_8c3f25bb__AFE_IN02_P: U30010.5 (in2+); also elsewhere on the board
SYS_32c4c1cc__AFE_IN13_P: U30010.39 (in13+); also elsewhere on the board
SYS_65aafbb6__AFE_3V3: C30010.1, C30011.1, C30013.1, U30010.13 (VDD), U30010.14 (auxin1), U30010.15 (auxin2), U30010.16 (auxin3), U30010.26 (VDD), U30010.31 (VDD); also elsewhere on the board
SYS_86b728f8__AFE_REF: U30010.2 (in3-), U30010.4 (in2-), U30010.6 (in1-), U30010.8 (in0-), U30010.34 (in15-), U30010.36 (in14-), U30010.38 (in13-), U30010.40 (in12-), U30010.42 (in11-), U30010.44 (in10-), U30010.46 (in9-), U30010.48 (in8-), U30010.50 (in7-), U30010.52 (in6-), U30010.54 (in5-), U30010.56 (in4-); also elsewhere on the board
SYS_96d7c46a__AFE_IN10_P: U30010.45 (in10+); also elsewhere on the board
SYS_3232ae4c__AFE_IN01_P: U30010.7 (in1+); also elsewhere on the board
SYS_53213f89__AFE_IN15_P: U30010.35 (in15+); also elsewhere on the board
SYS_59100ef9__AFE_IN05_P: U30010.55 (in5+); also elsewhere on the board
SYS_325713b8__AFE_IN07_P: U30010.51 (in7+); also elsewhere on the board
SYS_380216f6__AFE_IN06_P: U30010.53 (in6+); also elsewhere on the board
SYS_05097029__AFE_IN00_P: U30010.9 (in0+); also elsewhere on the board
SYS_b6a4cd67__AFE_IN11_P: U30010.43 (in11+); also elsewhere on the board
SYS_ee730a89__AFE_IN09_P: U30010.47 (in9+); also elsewhere on the board
SYS_f208be39__AFE_IN03_P: U30010.3 (in3+); also elsewhere on the board
SYS_fca1c340__AFEAGND: C30010.2, C30011.2, C30012.2, C30013.2, U30010.10 (GND), U30010.11 (GND), U30010.12 (GND), U30010.17 (GND), U30010.29 (GND), U30010.30 (LVDS_en), U30010.32 (VESD), U30010.33 (elec_test), U30010.57 (EP_SHIELD); also elsewhere on the board
recording-front-end__AFE_ADC_REF: C30012.1, U30010.28 (ADC_ref)
recording-front-end__AFE_CS_N: U30010.19 (CS+); also elsewhere on the board
recording-front-end__AFE_MISO: U30010.25 (MISO+); also elsewhere on the board
recording-front-end__AFE_MOSI: U30010.23 (MOSI+); also elsewhere on the board
recording-front-end__AFE_SCLK: U30010.21 (SCLK+); also elsewhere on the board

Notes on the sheet:
DIGITAL RESEARCH CIRCUIT / ARTIFICIAL SIGNALS / NO PCB OR IMPLANT QUALIFICATION
Spinal concept: 16 positive contacts + 1 shared reference + separate passive bias; amplifier linearity and biological recording remain conditional.
Every minus input shares AFE_REF. This is 16 differential streams from 18 functional recording ports, not 32 independent recording electrodes.
CMOS mode: LVDS_en=0; negative SPI pins NC; unused aux inputs at VDD; auxout NC; elec_test and VESD at AFEAGND.
Configure, calibrate and verify readback via SPI before valid data. 4MHz / 5us command slots are the revised isolated-link study baseline.
ADC response is pipelined; physical sample timestamps and invalid blanking/recovery intervals must be retained in software.

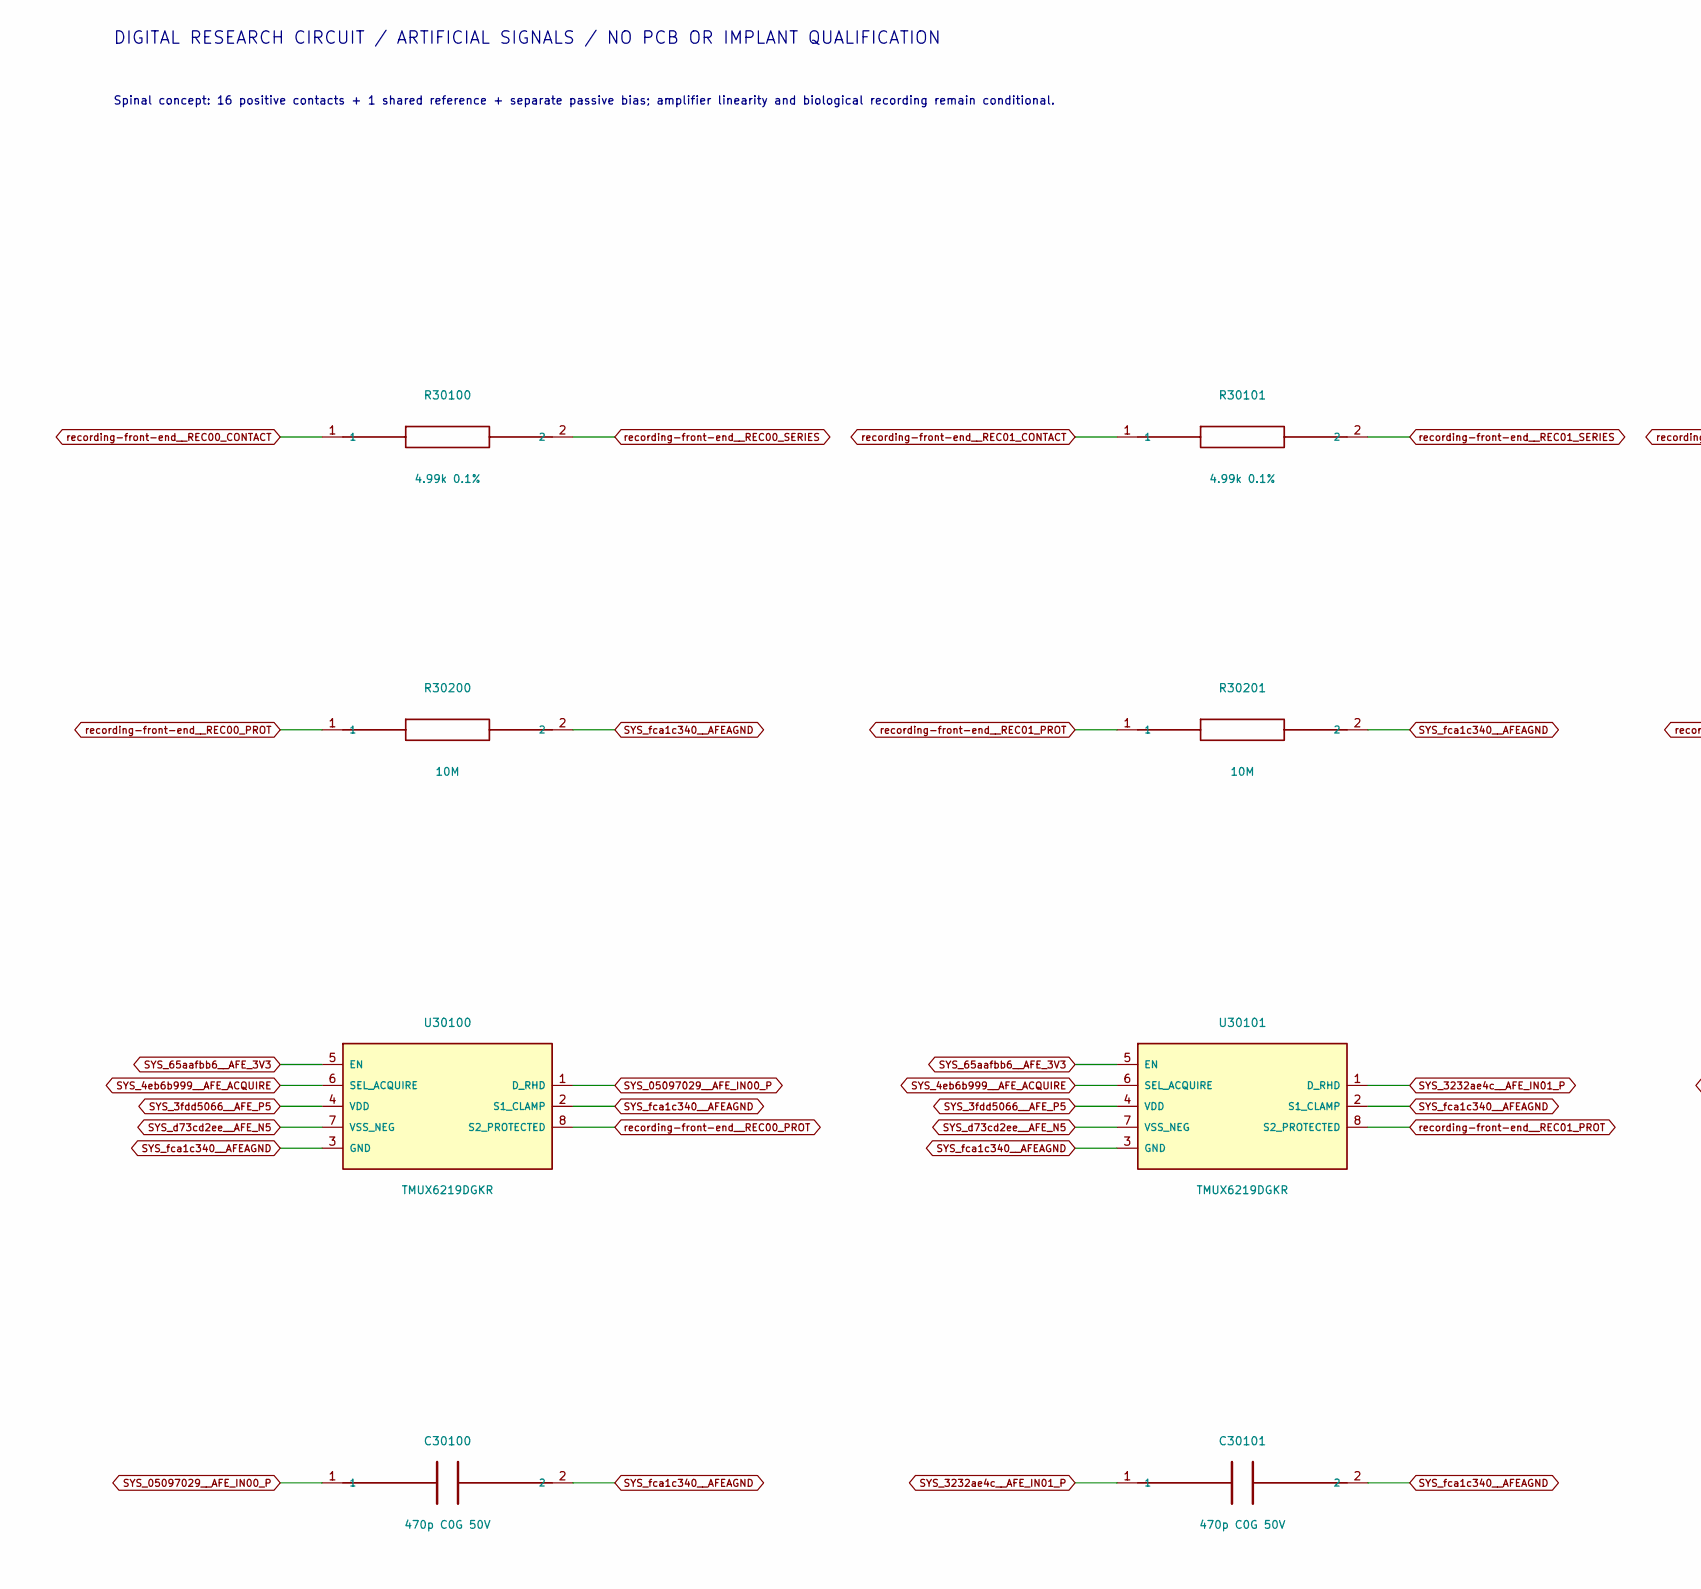
[picture p353: schematic bank0.kicad_sch, Project SCCI RH S4 / Inputs 00-03 / protected recording, part in row 1, column 1]

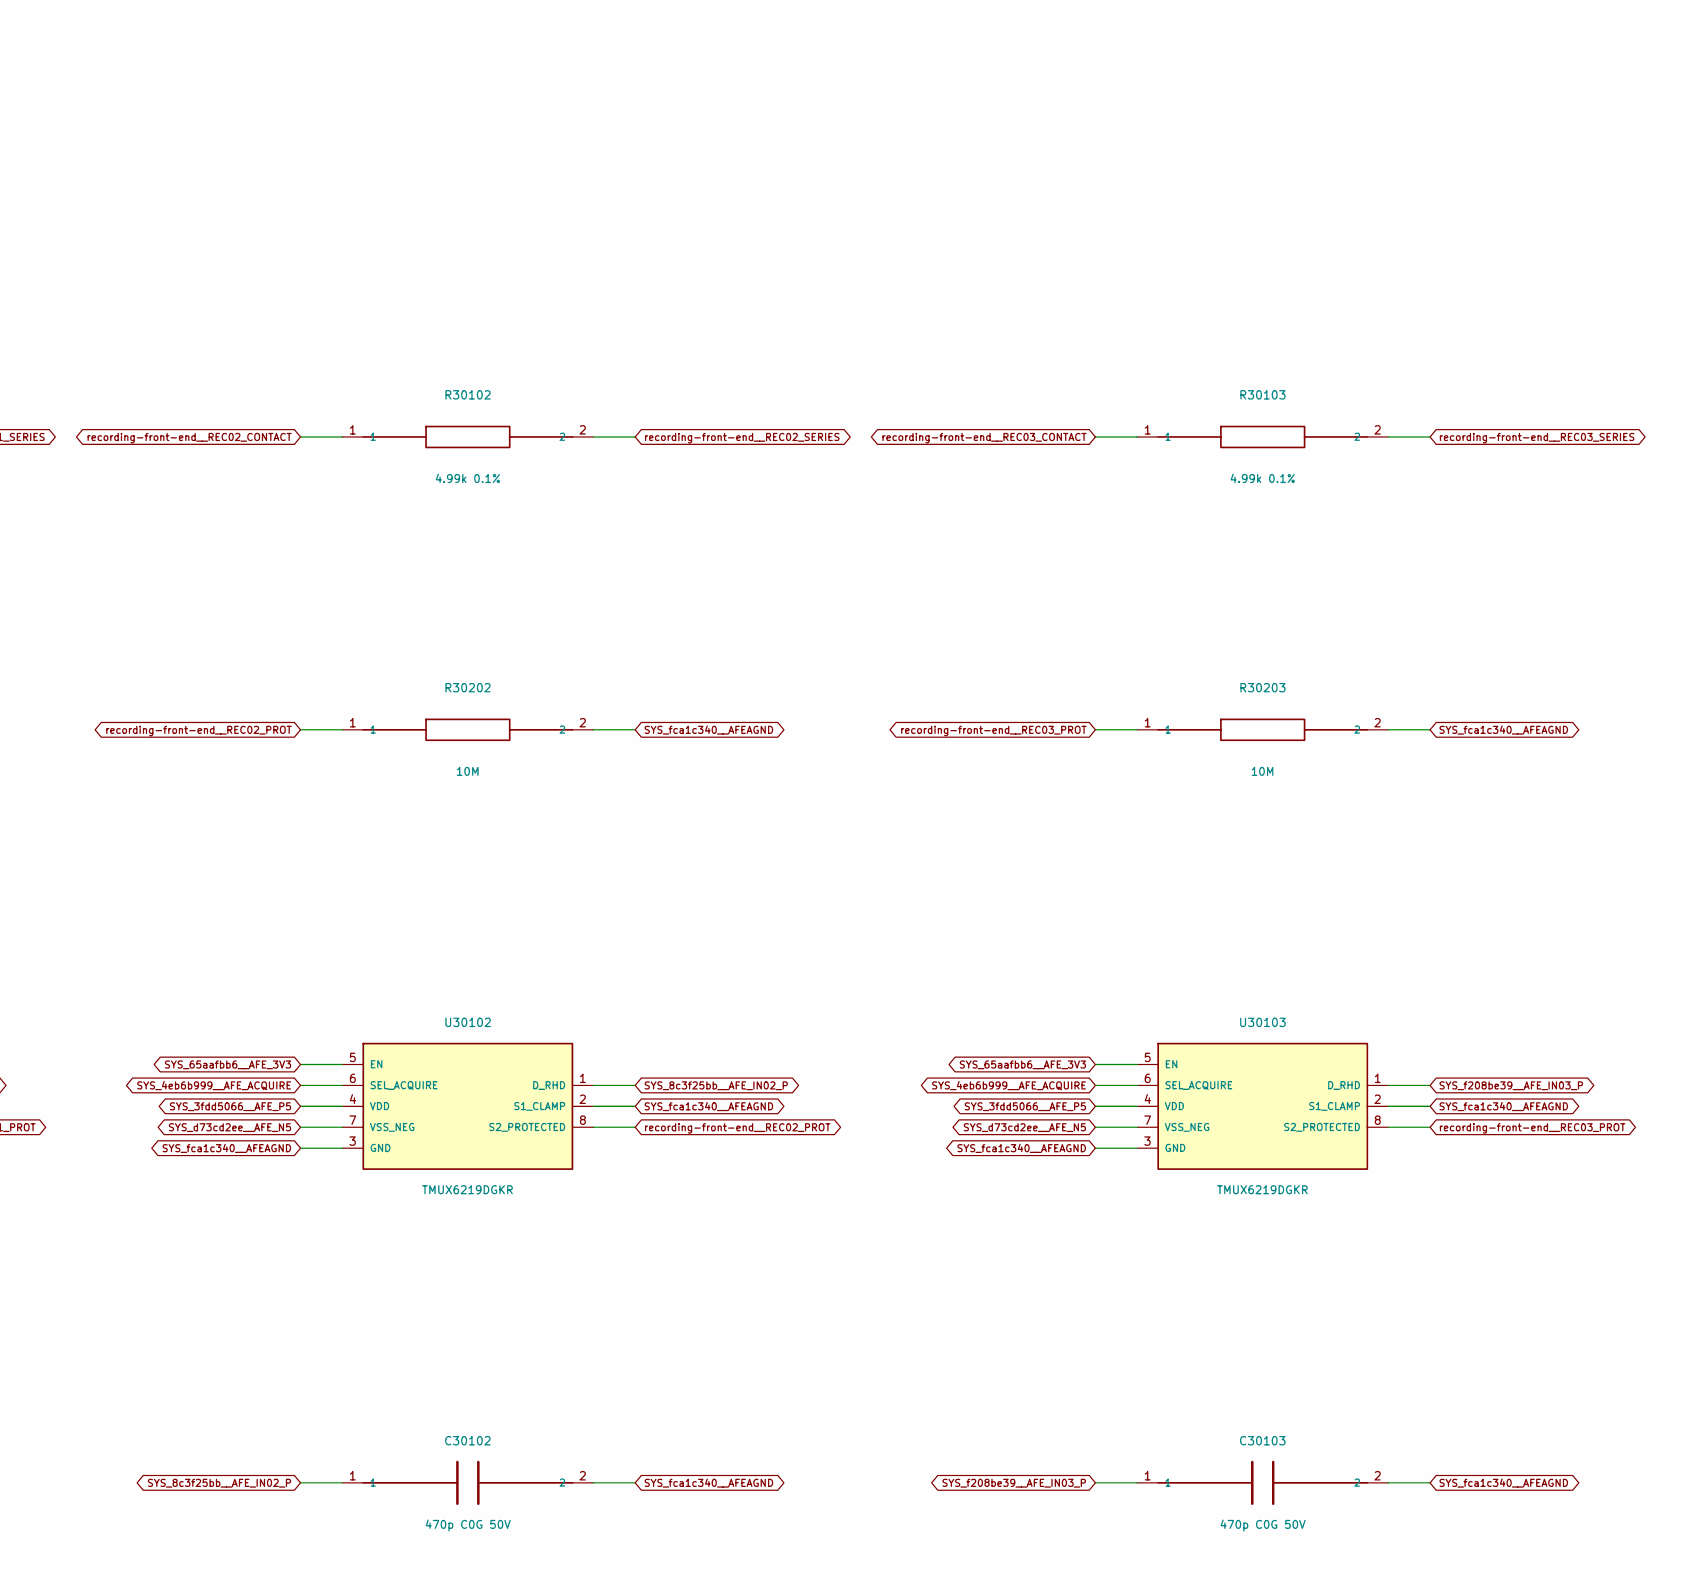
[picture p354: schematic bank0.kicad_sch, Project SCCI RH S4 / Inputs 00-03 / protected recording, part in row 1, column 2]

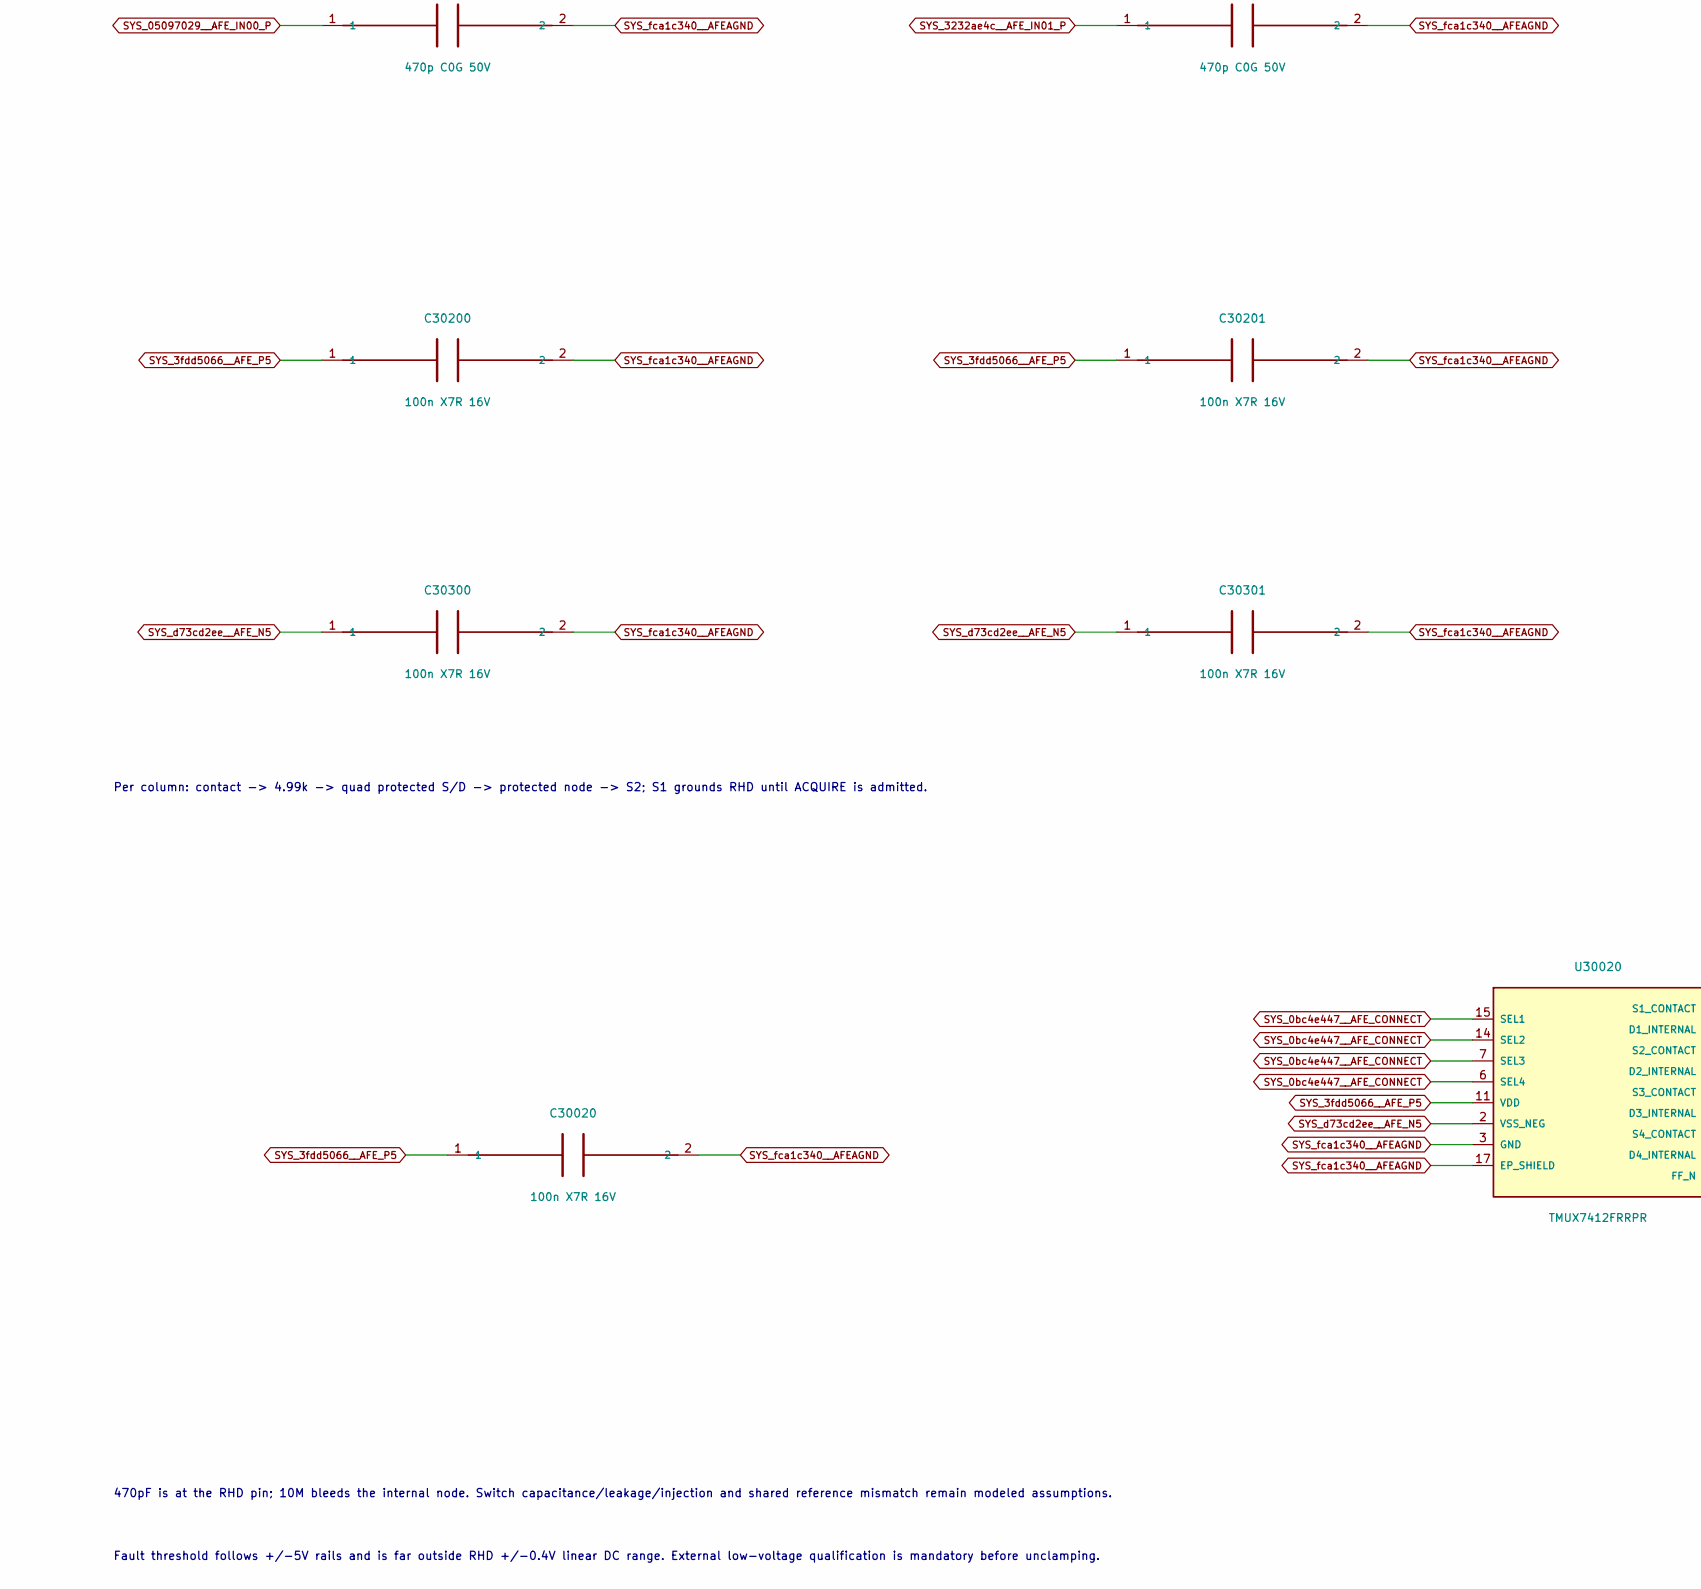
[picture p355: schematic bank0.kicad_sch, Project SCCI RH S4 / Inputs 00-03 / protected recording, part in row 2, column 1]

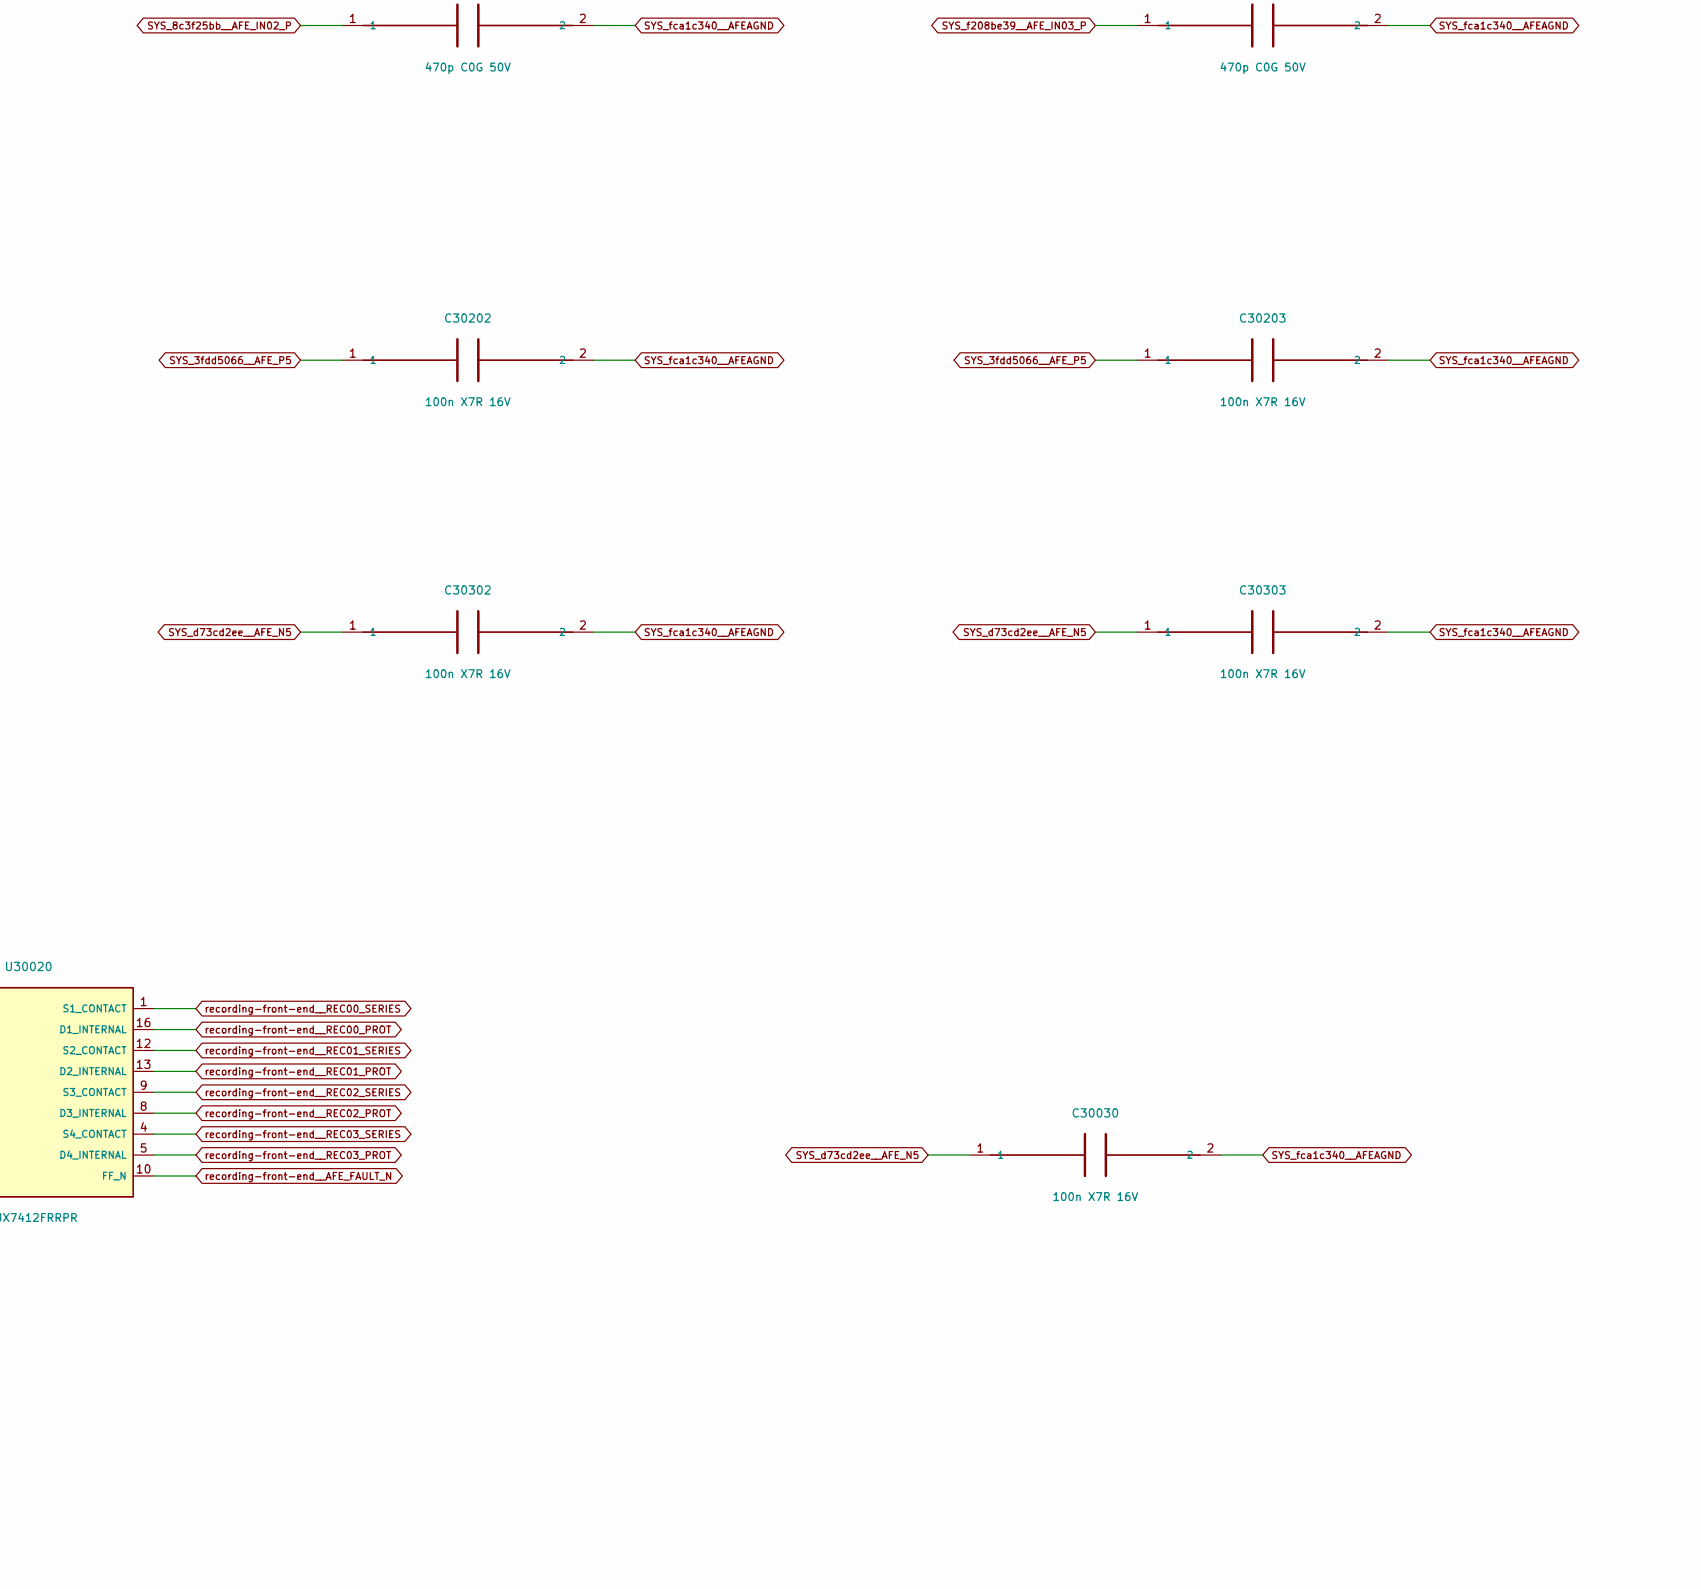
[picture p356: schematic bank0.kicad_sch, Project SCCI RH S4 / Inputs 00-03 / protected recording, part in row 2, column 2]

Parts:
C30020, C30030, C30200, C30201, C30202, C30203, C30300, C30301, C30302, C30303: 100n X7R 16V; C_0805_2012Metric
C30100, C30101, C30102, C30103: 470p C0G 50V; C_0805_2012Metric
R30100, R30101, R30102, R30103: 4.99k 0.1%; R_0805_2012Metric
R30200, R30201, R30202, R30203: 10M; R_0805_2012Metric
U30020: TMUX7412FRRPR; Texas_RRP0016A_WQFN16_4x4_P0.65_EP2.6
U30100, U30101, U30102, U30103: TMUX6219DGKR; VSSOP-8_2.3x2mm_P0.5mm

Connections:
SYS_0bc4e447__AFE_CONNECT: U30020.6 (SEL4), U30020.7 (SEL3), U30020.14 (SEL2), U30020.15 (SEL1); also elsewhere on the board
SYS_3fdd5066__AFE_P5: C30020.1, C30200.1, C30201.1, C30202.1, C30203.1, U30020.11 (VDD), U30100.4 (VDD), U30101.4 (VDD), U30102.4 (VDD), U30103.4 (VDD); also elsewhere on the board
SYS_4eb6b999__AFE_ACQUIRE: U30100.6 (SEL_ACQUIRE), U30101.6 (SEL_ACQUIRE), U30102.6 (SEL_ACQUIRE), U30103.6 (SEL_ACQUIRE); also elsewhere on the board
SYS_8c3f25bb__AFE_IN02_P: C30102.1, U30102.1 (D_RHD); also elsewhere on the board
SYS_65aafbb6__AFE_3V3: U30100.5 (EN), U30101.5 (EN), U30102.5 (EN), U30103.5 (EN); also elsewhere on the board
SYS_3232ae4c__AFE_IN01_P: C30101.1, U30101.1 (D_RHD); also elsewhere on the board
SYS_05097029__AFE_IN00_P: C30100.1, U30100.1 (D_RHD); also elsewhere on the board
SYS_d73cd2ee__AFE_N5: C30030.1, C30300.1, C30301.1, C30302.1, C30303.1, U30020.2 (VSS_NEG), U30100.7 (VSS_NEG), U30101.7 (VSS_NEG), U30102.7 (VSS_NEG), U30103.7 (VSS_NEG); also elsewhere on the board
SYS_f208be39__AFE_IN03_P: C30103.1, U30103.1 (D_RHD); also elsewhere on the board
SYS_fca1c340__AFEAGND: C30020.2, C30030.2, C30100.2, C30101.2, C30102.2, C30103.2, C30200.2, C30201.2, C30202.2, C30203.2, C30300.2, C30301.2, C30302.2, C30303.2, R30200.2, R30201.2, R30202.2, R30203.2, U30020.3 (GND), U30020.17 (EP_SHIELD), U30100.2 (S1_CLAMP), U30100.3 (GND), U30101.2 (S1_CLAMP), U30101.3 (GND), U30102.2 (S1_CLAMP), U30102.3 (GND), U30103.2 (S1_CLAMP), U30103.3 (GND); also elsewhere on the board
recording-front-end__AFE_FAULT_N: U30020.10 (FF_N); also elsewhere on the board
recording-front-end__REC00_CONTACT: R30100.1; also elsewhere on the board
recording-front-end__REC00_PROT: R30200.1, U30020.16 (D1_INTERNAL), U30100.8 (S2_PROTECTED)
recording-front-end__REC00_SERIES: R30100.2, U30020.1 (S1_CONTACT)
recording-front-end__REC01_CONTACT: R30101.1; also elsewhere on the board
recording-front-end__REC01_PROT: R30201.1, U30020.13 (D2_INTERNAL), U30101.8 (S2_PROTECTED)
recording-front-end__REC01_SERIES: R30101.2, U30020.12 (S2_CONTACT)
recording-front-end__REC02_CONTACT: R30102.1; also elsewhere on the board
recording-front-end__REC02_PROT: R30202.1, U30020.8 (D3_INTERNAL), U30102.8 (S2_PROTECTED)
recording-front-end__REC02_SERIES: R30102.2, U30020.9 (S3_CONTACT)
recording-front-end__REC03_CONTACT: R30103.1; also elsewhere on the board
recording-front-end__REC03_PROT: R30203.1, U30020.5 (D4_INTERNAL), U30103.8 (S2_PROTECTED)
recording-front-end__REC03_SERIES: R30103.2, U30020.4 (S4_CONTACT)

Notes on the sheet:
DIGITAL RESEARCH CIRCUIT / ARTIFICIAL SIGNALS / NO PCB OR IMPLANT QUALIFICATION
Spinal concept: 16 positive contacts + 1 shared reference + separate passive bias; amplifier linearity and biological recording remain conditional.
Per column: contact -> 4.99k -> quad protected S/D -> protected node -> S2; S1 grounds RHD until ACQUIRE is admitted.
470pF is at the RHD pin; 10M bleeds the internal node. Switch capacitance/leakage/injection and shared reference mismatch remain modeled assumptions.
Fault threshold follows +/-5V rails and is far outside RHD +/-0.4V linear DC range. External low-voltage qualification is mandatory before unclamping.
