pratham-cloud-ctrl/Project-SCCI-RH/electronics/stage4/integrated-pcb/boards/recording-front-end/recording_front_end.kicad_pcb

## KiCad design electronics/stage4/integrated-pcb/boards/recording-front-end/recording_front_end.kicad_pcb (continued)

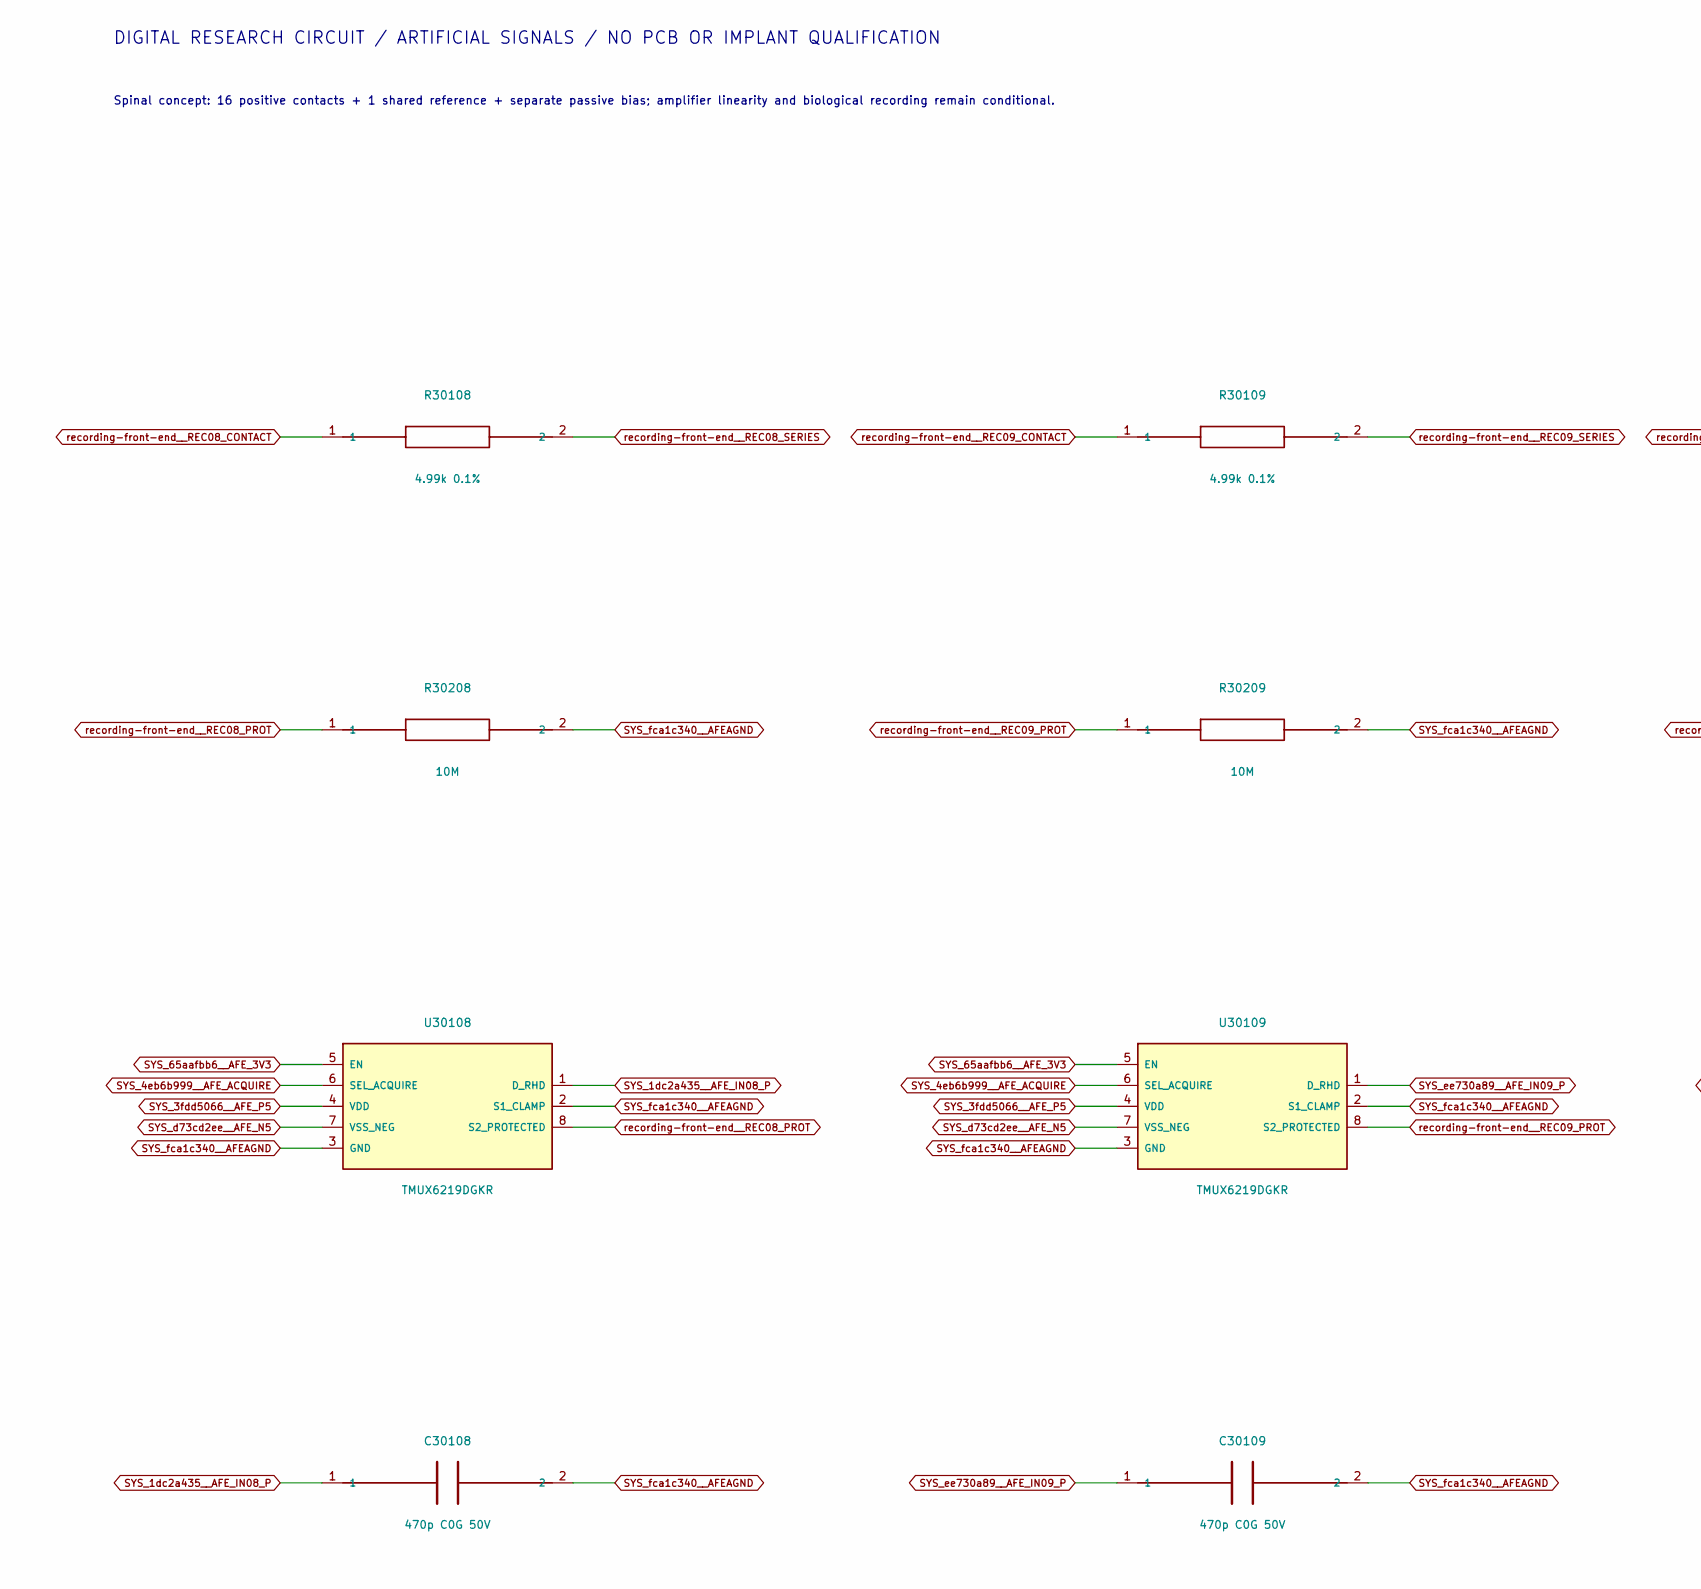
[picture p361: schematic bank2.kicad_sch, Project SCCI RH S4 / Inputs 08-11 / protected recording, part in row 1, column 1]

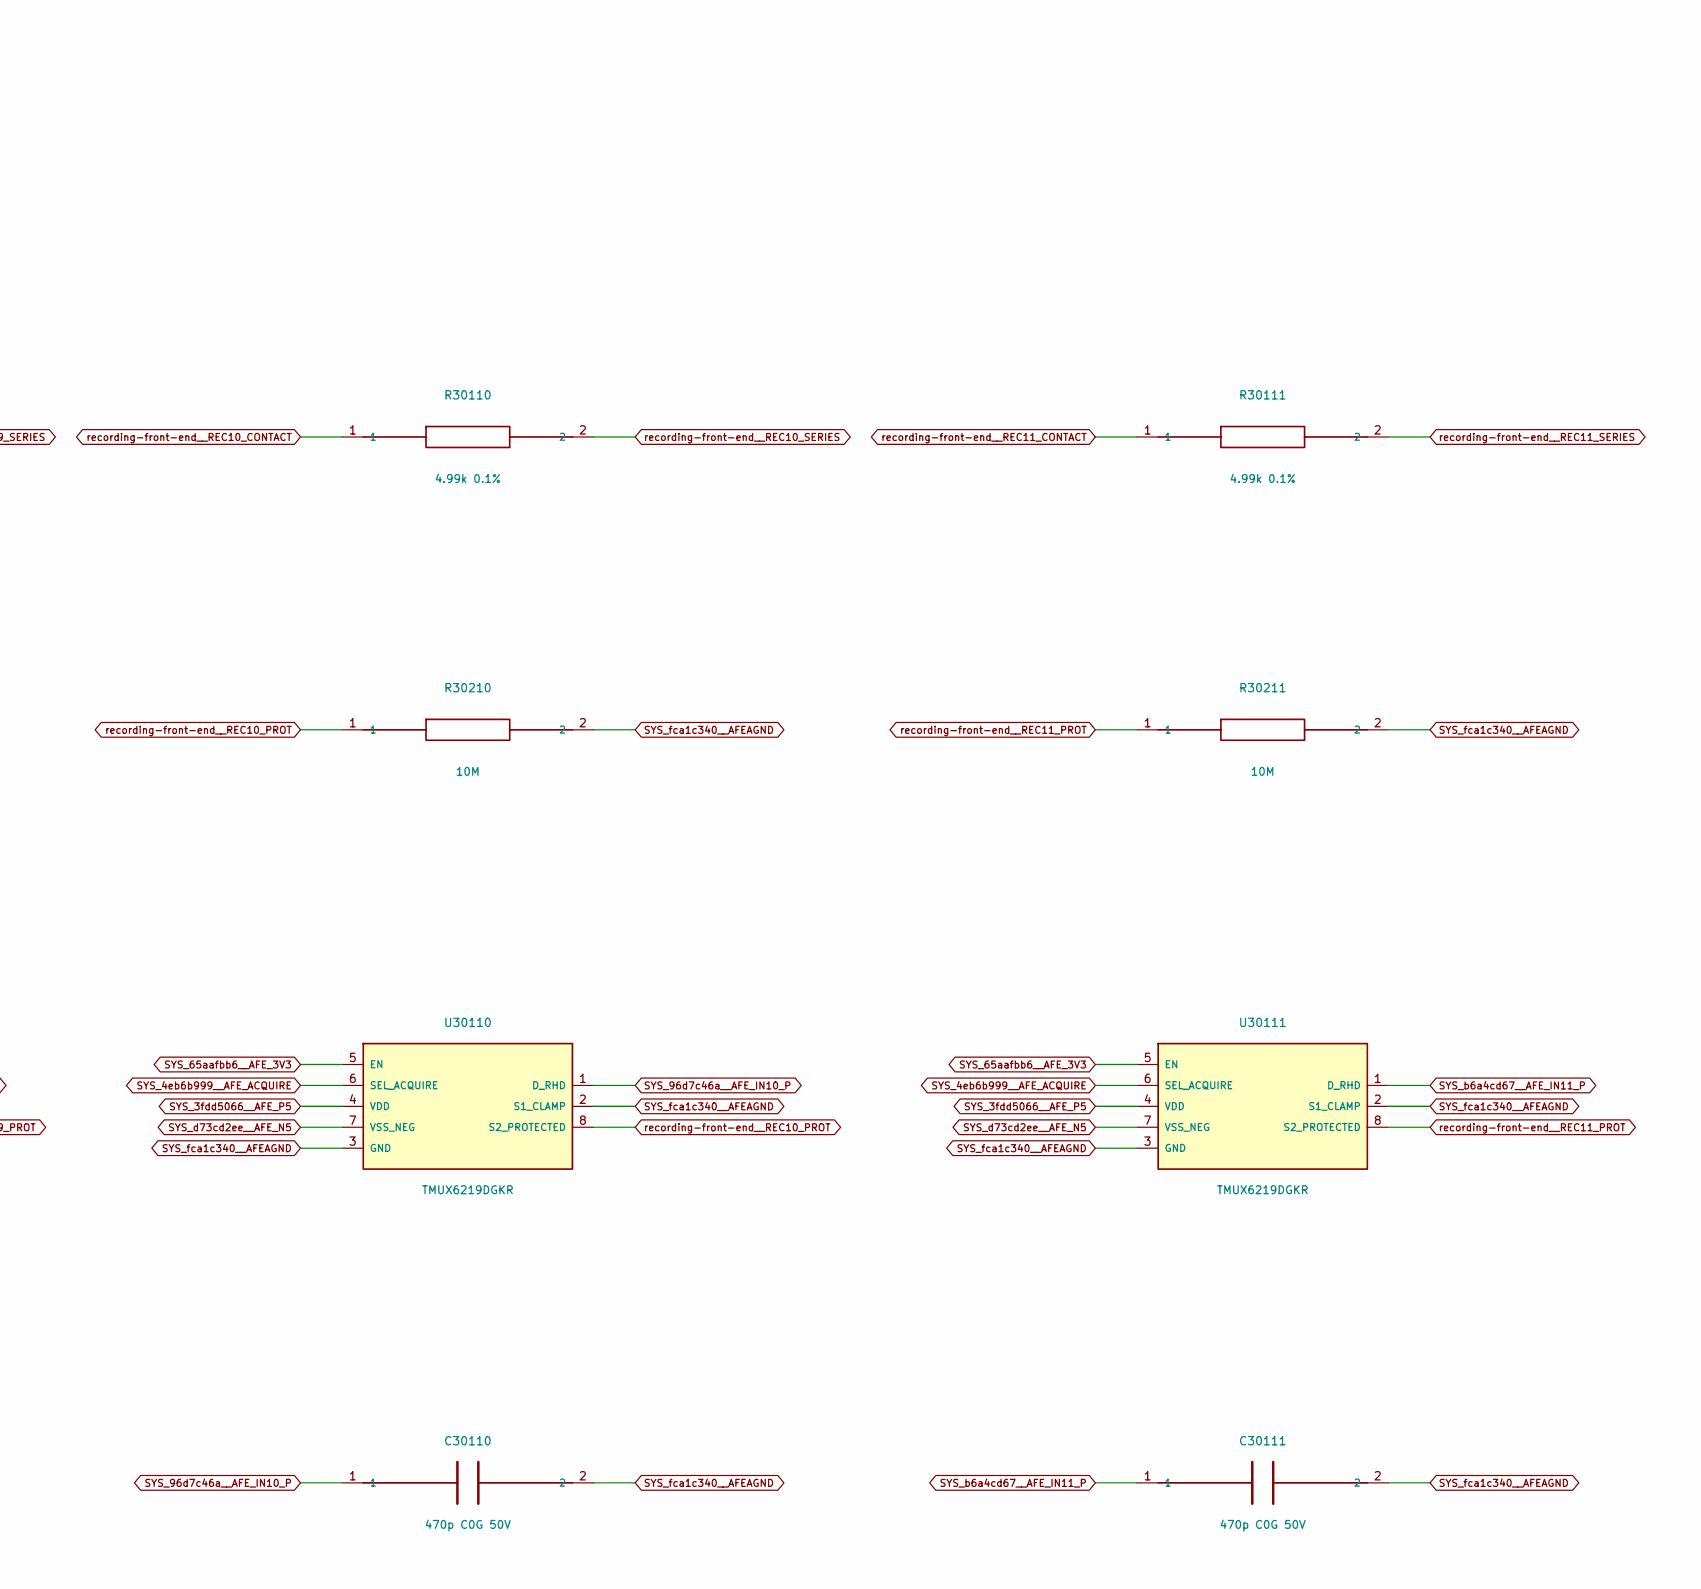
[picture p362: schematic bank2.kicad_sch, Project SCCI RH S4 / Inputs 08-11 / protected recording, part in row 1, column 2]

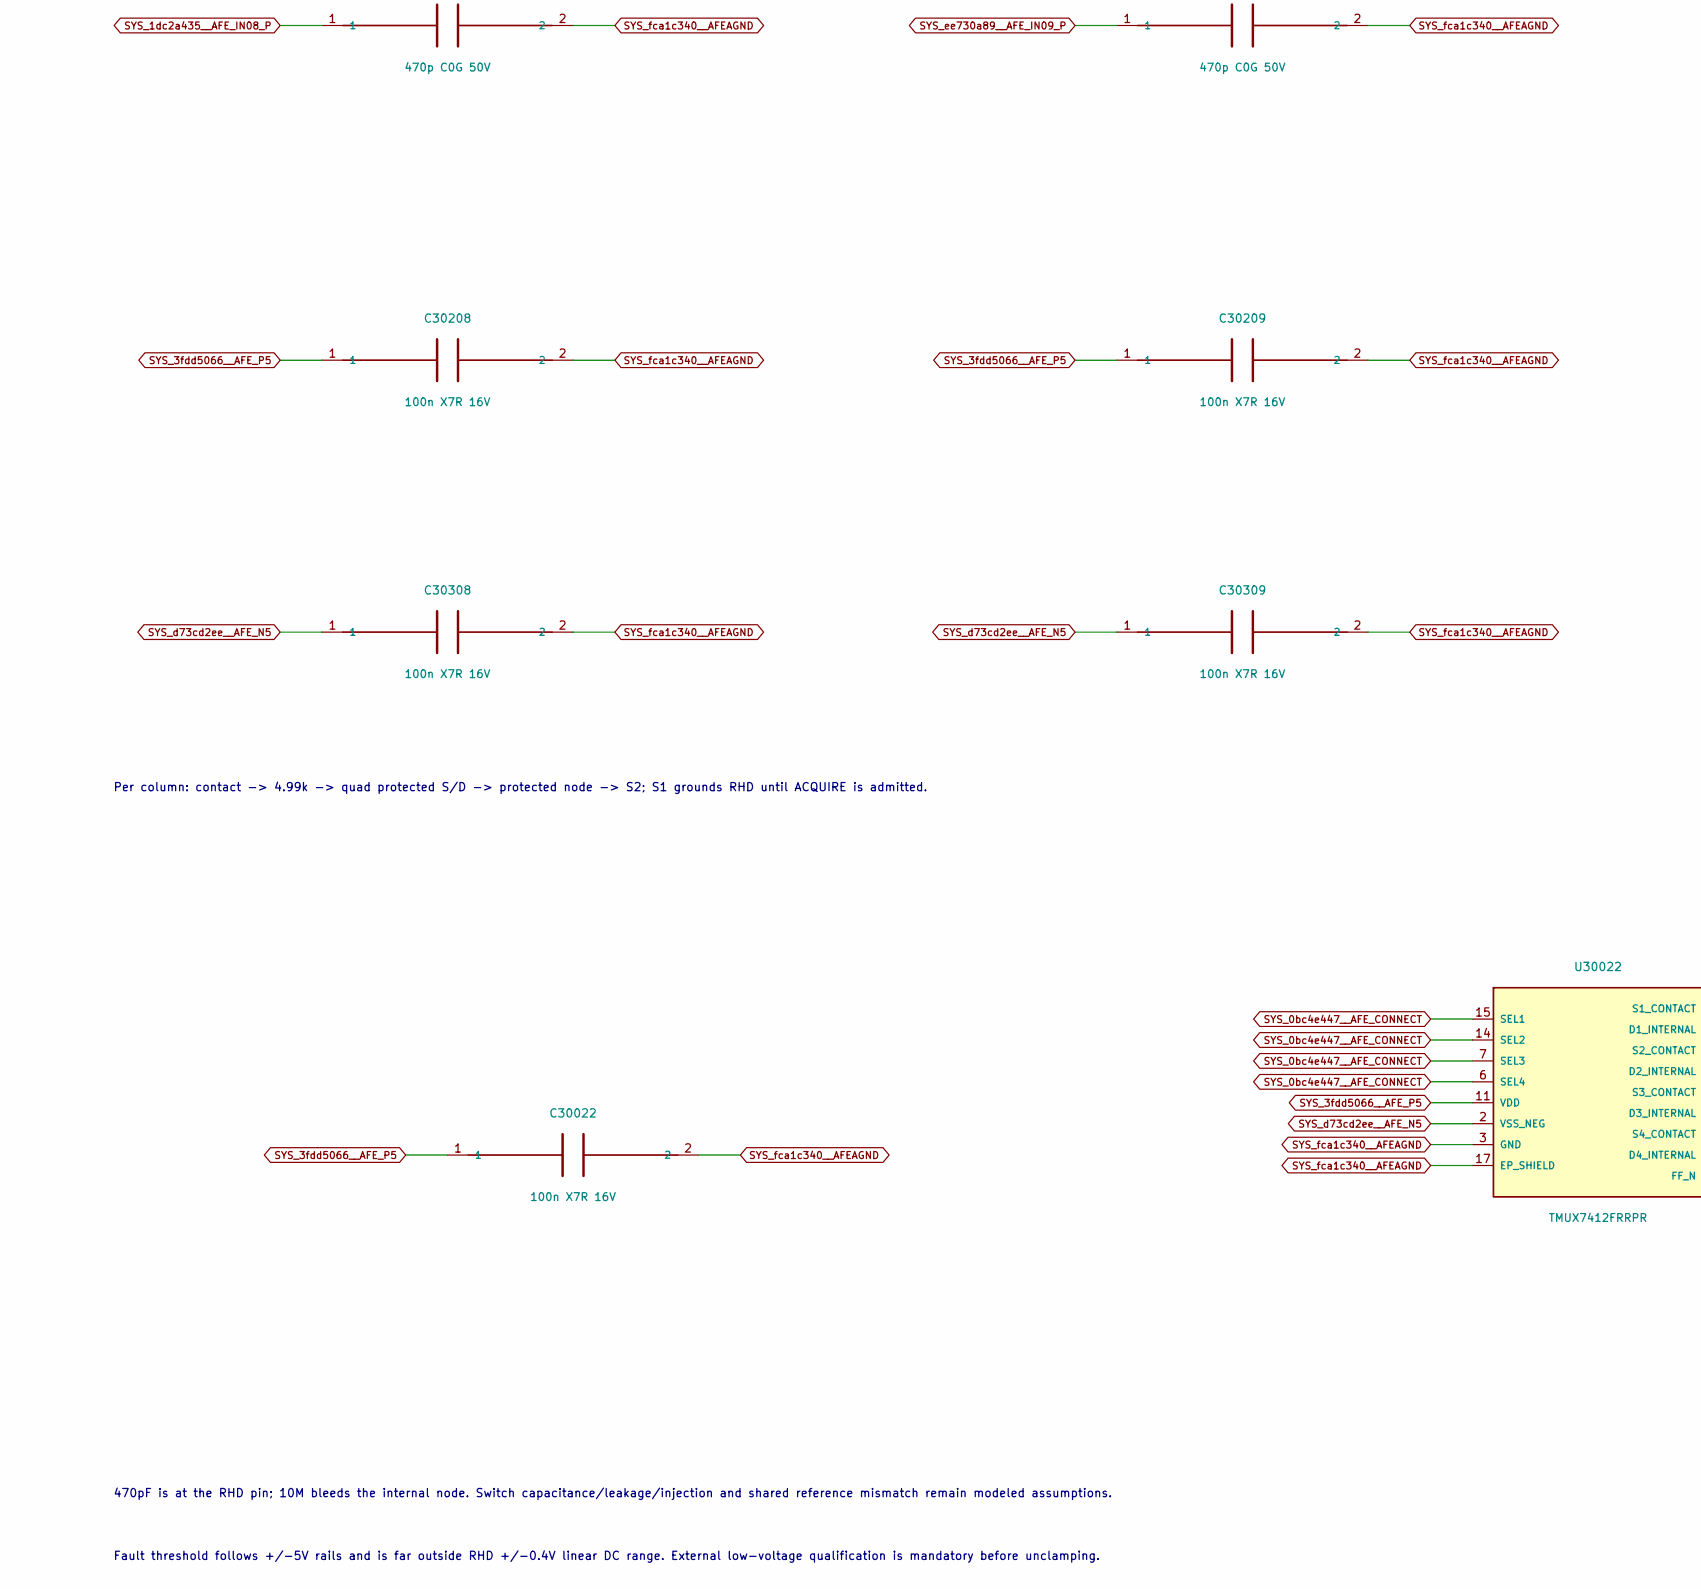
[picture p363: schematic bank2.kicad_sch, Project SCCI RH S4 / Inputs 08-11 / protected recording, part in row 2, column 1]

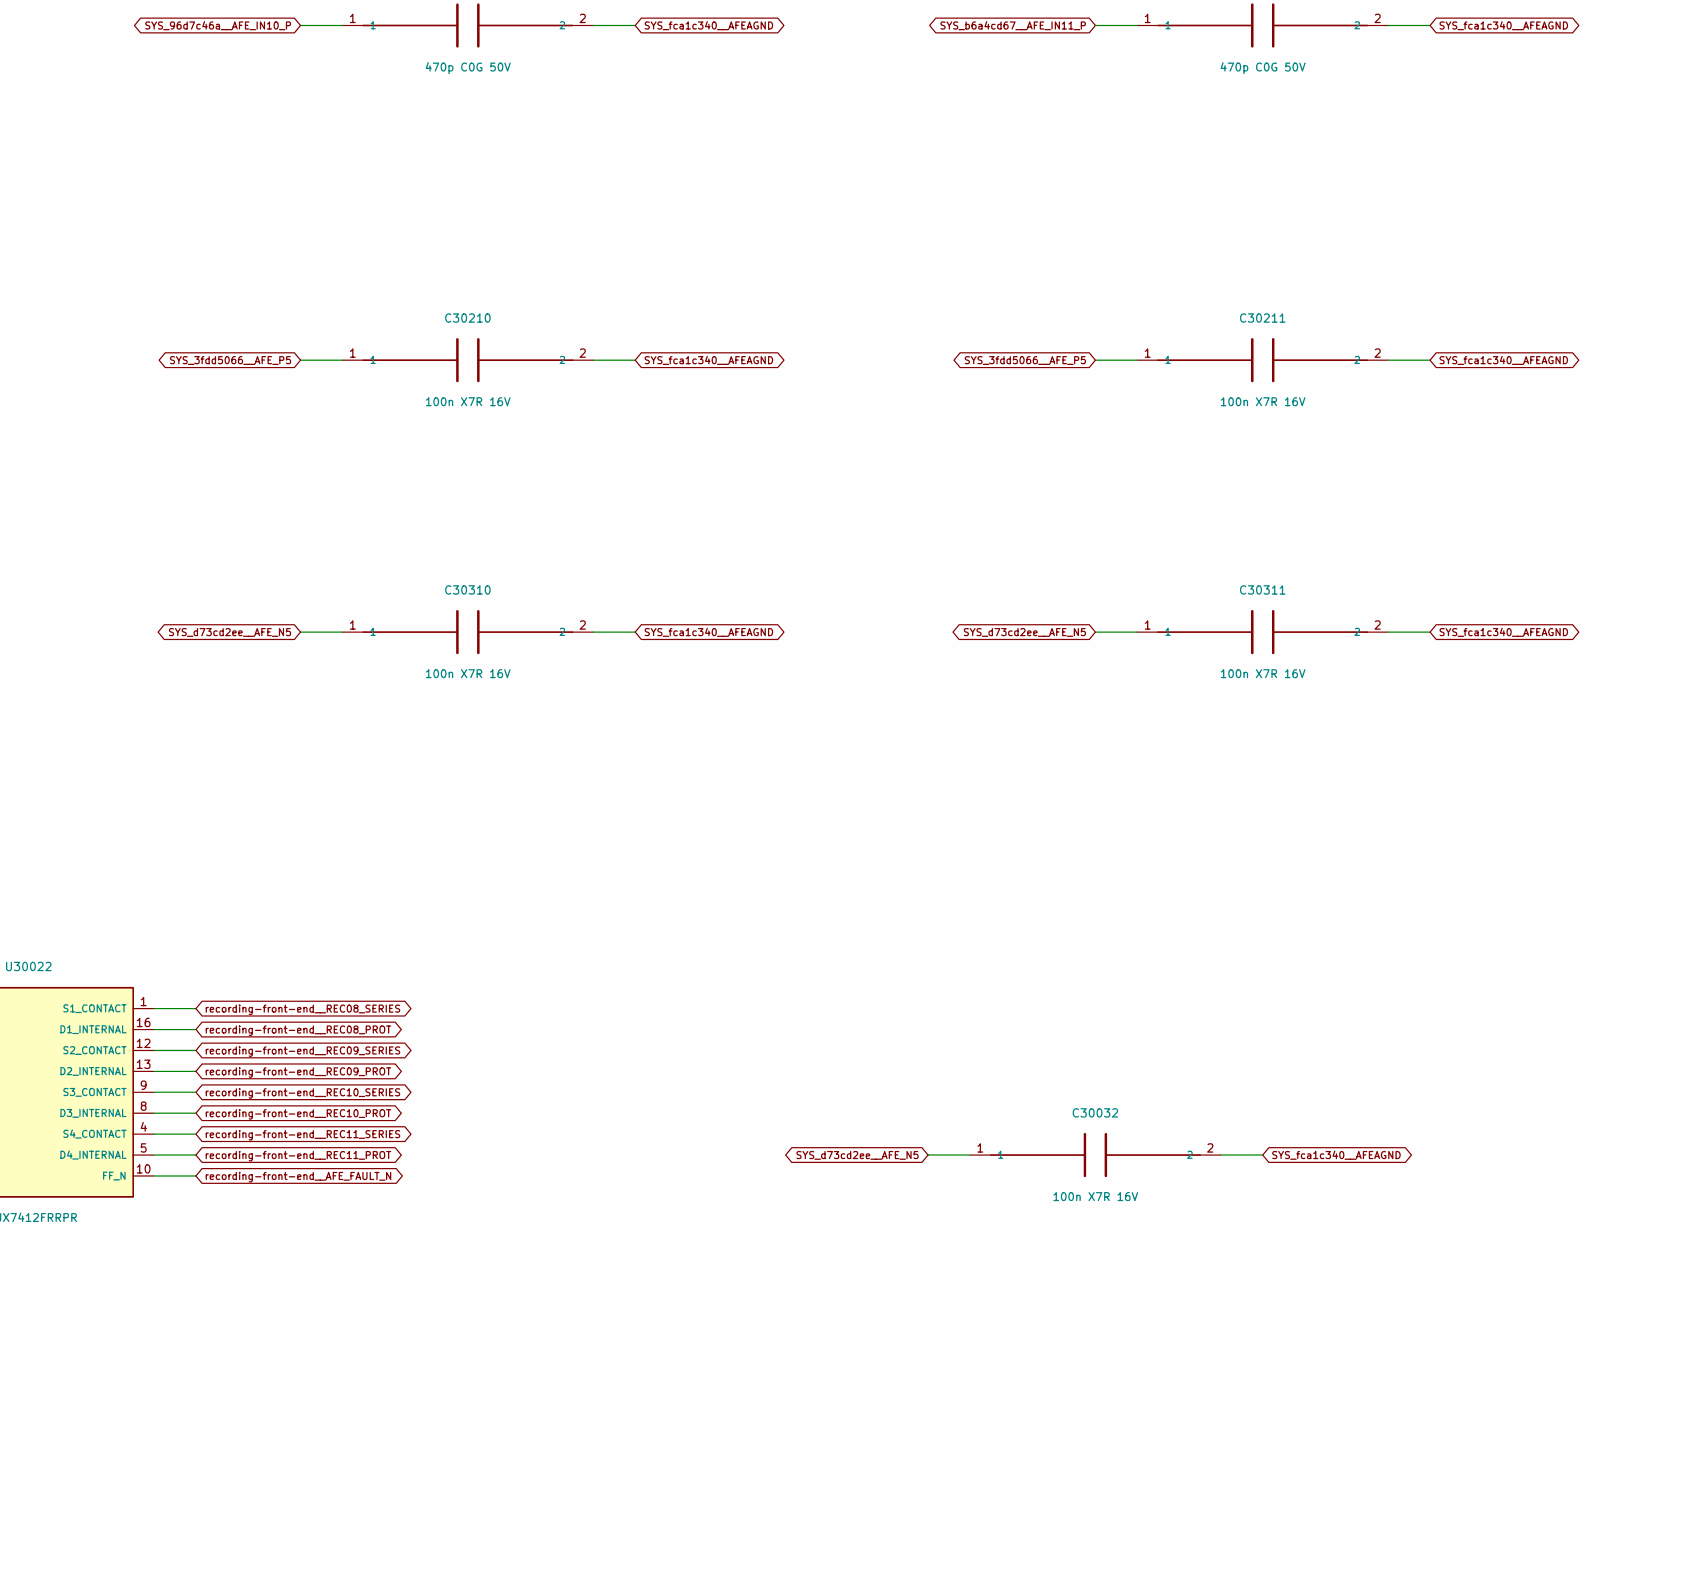
[picture p364: schematic bank2.kicad_sch, Project SCCI RH S4 / Inputs 08-11 / protected recording, part in row 2, column 2]

Parts:
C30022, C30032, C30208, C30209, C30210, C30211, C30308, C30309, C30310, C30311: 100n X7R 16V; C_0805_2012Metric
C30108, C30109, C30110, C30111: 470p C0G 50V; C_0805_2012Metric
R30108, R30109, R30110, R30111: 4.99k 0.1%; R_0805_2012Metric
R30208, R30209, R30210, R30211: 10M; R_0805_2012Metric
U30022: TMUX7412FRRPR; Texas_RRP0016A_WQFN16_4x4_P0.65_EP2.6
U30108, U30109, U30110, U30111: TMUX6219DGKR; VSSOP-8_2.3x2mm_P0.5mm

Connections:
SYS_0bc4e447__AFE_CONNECT: U30022.6 (SEL4), U30022.7 (SEL3), U30022.14 (SEL2), U30022.15 (SEL1); also elsewhere on the board
SYS_1dc2a435__AFE_IN08_P: C30108.1, U30108.1 (D_RHD); also elsewhere on the board
SYS_3fdd5066__AFE_P5: C30022.1, C30208.1, C30209.1, C30210.1, C30211.1, U30022.11 (VDD), U30108.4 (VDD), U30109.4 (VDD), U30110.4 (VDD), U30111.4 (VDD); also elsewhere on the board
SYS_4eb6b999__AFE_ACQUIRE: U30108.6 (SEL_ACQUIRE), U30109.6 (SEL_ACQUIRE), U30110.6 (SEL_ACQUIRE), U30111.6 (SEL_ACQUIRE); also elsewhere on the board
SYS_65aafbb6__AFE_3V3: U30108.5 (EN), U30109.5 (EN), U30110.5 (EN), U30111.5 (EN); also elsewhere on the board
SYS_96d7c46a__AFE_IN10_P: C30110.1, U30110.1 (D_RHD); also elsewhere on the board
SYS_b6a4cd67__AFE_IN11_P: C30111.1, U30111.1 (D_RHD); also elsewhere on the board
SYS_d73cd2ee__AFE_N5: C30032.1, C30308.1, C30309.1, C30310.1, C30311.1, U30022.2 (VSS_NEG), U30108.7 (VSS_NEG), U30109.7 (VSS_NEG), U30110.7 (VSS_NEG), U30111.7 (VSS_NEG); also elsewhere on the board
SYS_ee730a89__AFE_IN09_P: C30109.1, U30109.1 (D_RHD); also elsewhere on the board
SYS_fca1c340__AFEAGND: C30022.2, C30032.2, C30108.2, C30109.2, C30110.2, C30111.2, C30208.2, C30209.2, C30210.2, C30211.2, C30308.2, C30309.2, C30310.2, C30311.2, R30208.2, R30209.2, R30210.2, R30211.2, U30022.3 (GND), U30022.17 (EP_SHIELD), U30108.2 (S1_CLAMP), U30108.3 (GND), U30109.2 (S1_CLAMP), U30109.3 (GND), U30110.2 (S1_CLAMP), U30110.3 (GND), U30111.2 (S1_CLAMP), U30111.3 (GND); also elsewhere on the board
recording-front-end__AFE_FAULT_N: U30022.10 (FF_N); also elsewhere on the board
recording-front-end__REC08_CONTACT: R30108.1; also elsewhere on the board
recording-front-end__REC08_PROT: R30208.1, U30022.16 (D1_INTERNAL), U30108.8 (S2_PROTECTED)
recording-front-end__REC08_SERIES: R30108.2, U30022.1 (S1_CONTACT)
recording-front-end__REC09_CONTACT: R30109.1; also elsewhere on the board
recording-front-end__REC09_PROT: R30209.1, U30022.13 (D2_INTERNAL), U30109.8 (S2_PROTECTED)
recording-front-end__REC09_SERIES: R30109.2, U30022.12 (S2_CONTACT)
recording-front-end__REC10_CONTACT: R30110.1; also elsewhere on the board
recording-front-end__REC10_PROT: R30210.1, U30022.8 (D3_INTERNAL), U30110.8 (S2_PROTECTED)
recording-front-end__REC10_SERIES: R30110.2, U30022.9 (S3_CONTACT)
recording-front-end__REC11_CONTACT: R30111.1; also elsewhere on the board
recording-front-end__REC11_PROT: R30211.1, U30022.5 (D4_INTERNAL), U30111.8 (S2_PROTECTED)
recording-front-end__REC11_SERIES: R30111.2, U30022.4 (S4_CONTACT)

Notes on the sheet:
DIGITAL RESEARCH CIRCUIT / ARTIFICIAL SIGNALS / NO PCB OR IMPLANT QUALIFICATION
Spinal concept: 16 positive contacts + 1 shared reference + separate passive bias; amplifier linearity and biological recording remain conditional.
Per column: contact -> 4.99k -> quad protected S/D -> protected node -> S2; S1 grounds RHD until ACQUIRE is admitted.
470pF is at the RHD pin; 10M bleeds the internal node. Switch capacitance/leakage/injection and shared reference mismatch remain modeled assumptions.
Fault threshold follows +/-5V rails and is far outside RHD +/-0.4V linear DC range. External low-voltage qualification is mandatory before unclamping.
