pratham-cloud-ctrl/Project-SCCI-RH/electronics/stage4/integrated-pcb/boards/recording-front-end/recording_front_end.kicad_pcb

## KiCad design electronics/stage4/integrated-pcb/boards/recording-front-end/recording_front_end.kicad_pcb (continued)

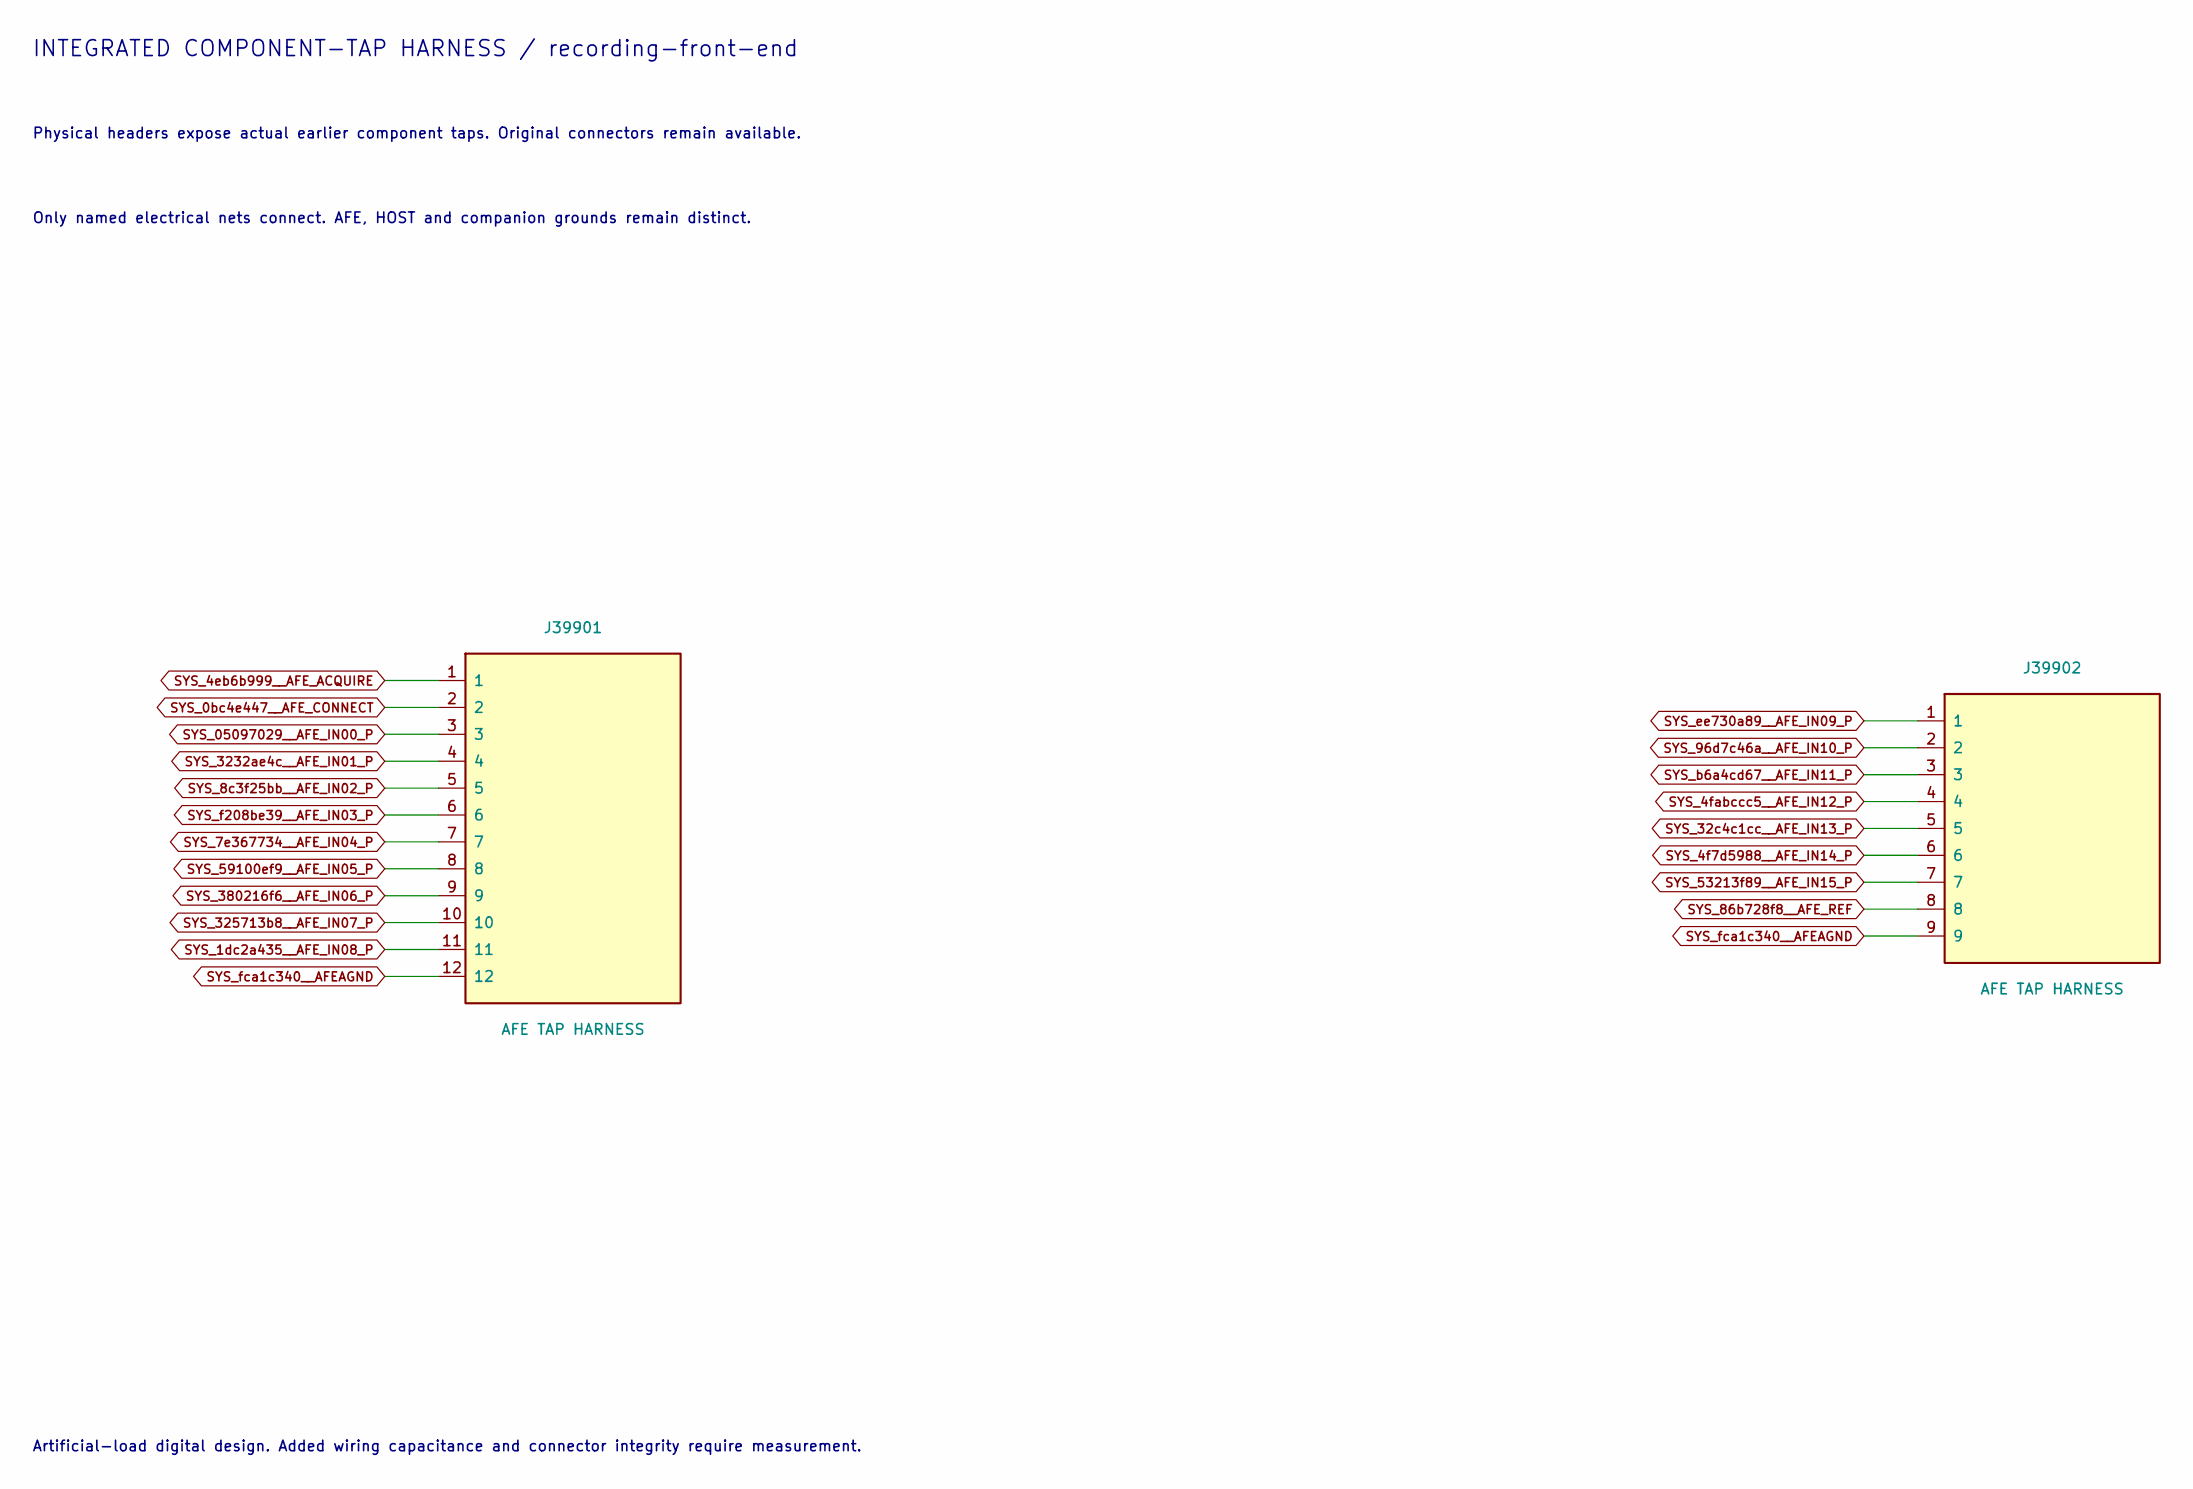
[picture p371: schematic integration_taps.kicad_sch, Project SCCI RH / recording-front-end integration taps]

Parts:
J39901: AFE TAP HARNESS; PinHeader_1x12_P2.54mm_Vertical
J39902: AFE TAP HARNESS; PinHeader_1x09_P2.54mm_Vertical

Connections:
SYS_0bc4e447__AFE_CONNECT: J39901.2; also elsewhere on the board
SYS_1dc2a435__AFE_IN08_P: J39901.11; also elsewhere on the board
SYS_4eb6b999__AFE_ACQUIRE: J39901.1; also elsewhere on the board
SYS_4f7d5988__AFE_IN14_P: J39902.6; also elsewhere on the board
SYS_4fabccc5__AFE_IN12_P: J39902.4; also elsewhere on the board
SYS_7e367734__AFE_IN04_P: J39901.7; also elsewhere on the board
SYS_8c3f25bb__AFE_IN02_P: J39901.5; also elsewhere on the board
SYS_32c4c1cc__AFE_IN13_P: J39902.5; also elsewhere on the board
SYS_86b728f8__AFE_REF: J39902.8; also elsewhere on the board
SYS_96d7c46a__AFE_IN10_P: J39902.2; also elsewhere on the board
SYS_3232ae4c__AFE_IN01_P: J39901.4; also elsewhere on the board
SYS_53213f89__AFE_IN15_P: J39902.7; also elsewhere on the board
SYS_59100ef9__AFE_IN05_P: J39901.8; also elsewhere on the board
SYS_325713b8__AFE_IN07_P: J39901.10; also elsewhere on the board
SYS_380216f6__AFE_IN06_P: J39901.9; also elsewhere on the board
SYS_05097029__AFE_IN00_P: J39901.3; also elsewhere on the board
SYS_b6a4cd67__AFE_IN11_P: J39902.3; also elsewhere on the board
SYS_ee730a89__AFE_IN09_P: J39902.1; also elsewhere on the board
SYS_f208be39__AFE_IN03_P: J39901.6; also elsewhere on the board
SYS_fca1c340__AFEAGND: J39901.12, J39902.9; also elsewhere on the board

Notes on the sheet:
INTEGRATED COMPONENT-TAP HARNESS / recording-front-end
Physical headers expose actual earlier component taps. Original connectors remain available.
Only named electrical nets connect. AFE, HOST and companion grounds remain distinct.
Artificial-load digital design. Added wiring capacitance and connector integrity require measurement.

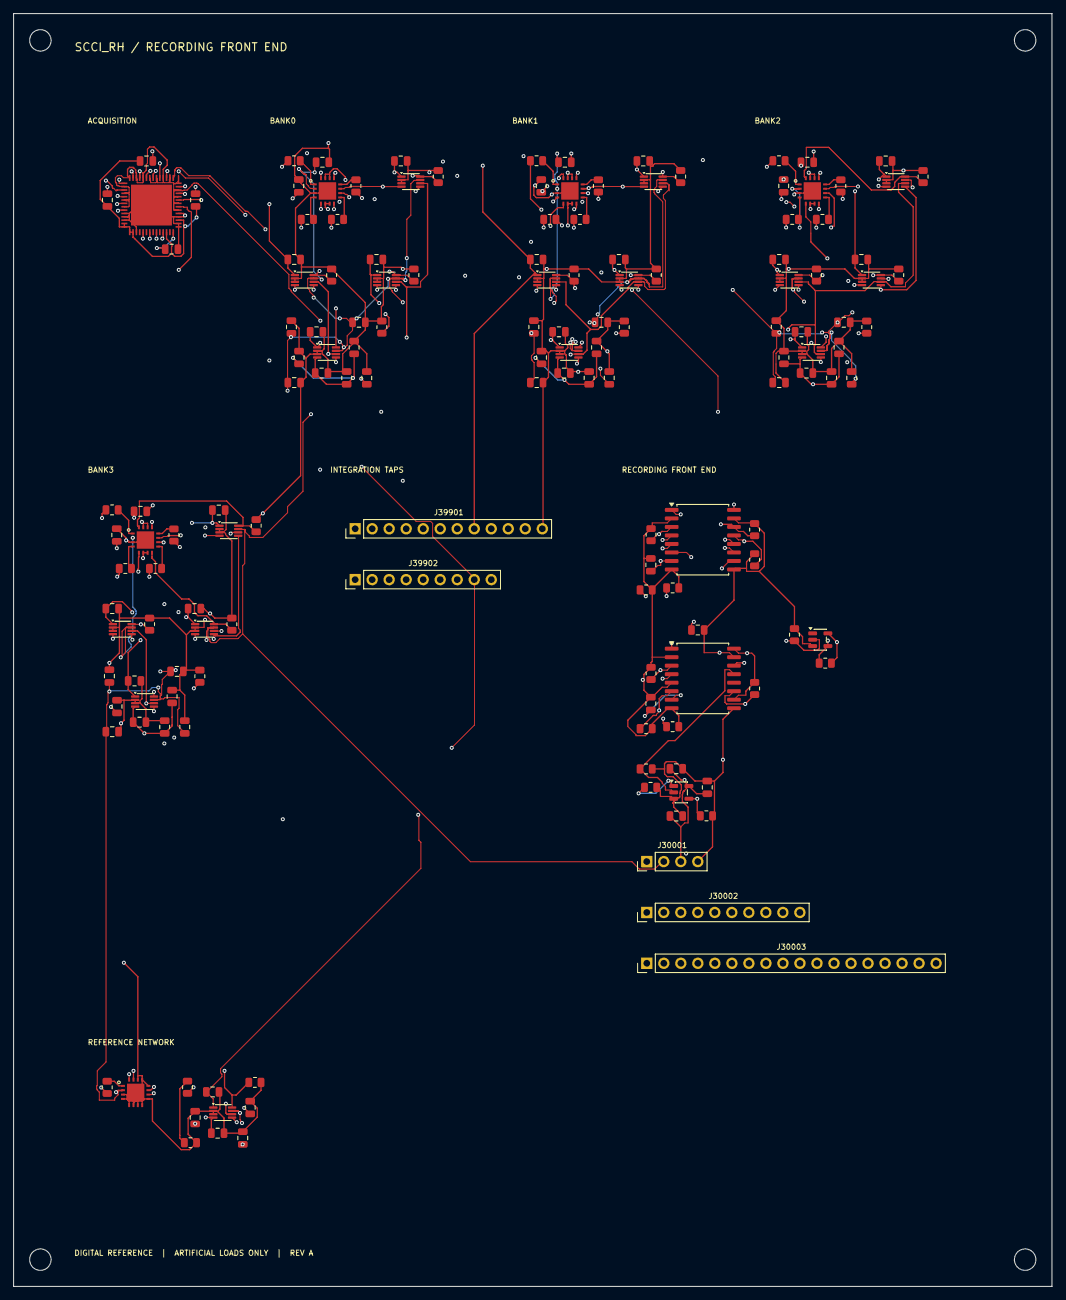
[picture p372: board recording_front_end.kicad_pcb from above]

Board: 4 copper layers, 155.0 x 190.0 mm, 157 parts (0 on the bottom side), 93 nets.

Other parts of the board:
H1, H2, H3, H4: MountingHole_3.2mm_M3
