pratham-cloud-ctrl/Project-SCCI-RH/electronics/stage4/integrated-pcb/boards/monitoring-transport/monitoring_transport.kicad_pcb

## KiCad design electronics/stage4/integrated-pcb/boards/monitoring-transport/monitoring_transport.kicad_pcb (2026-10-29)

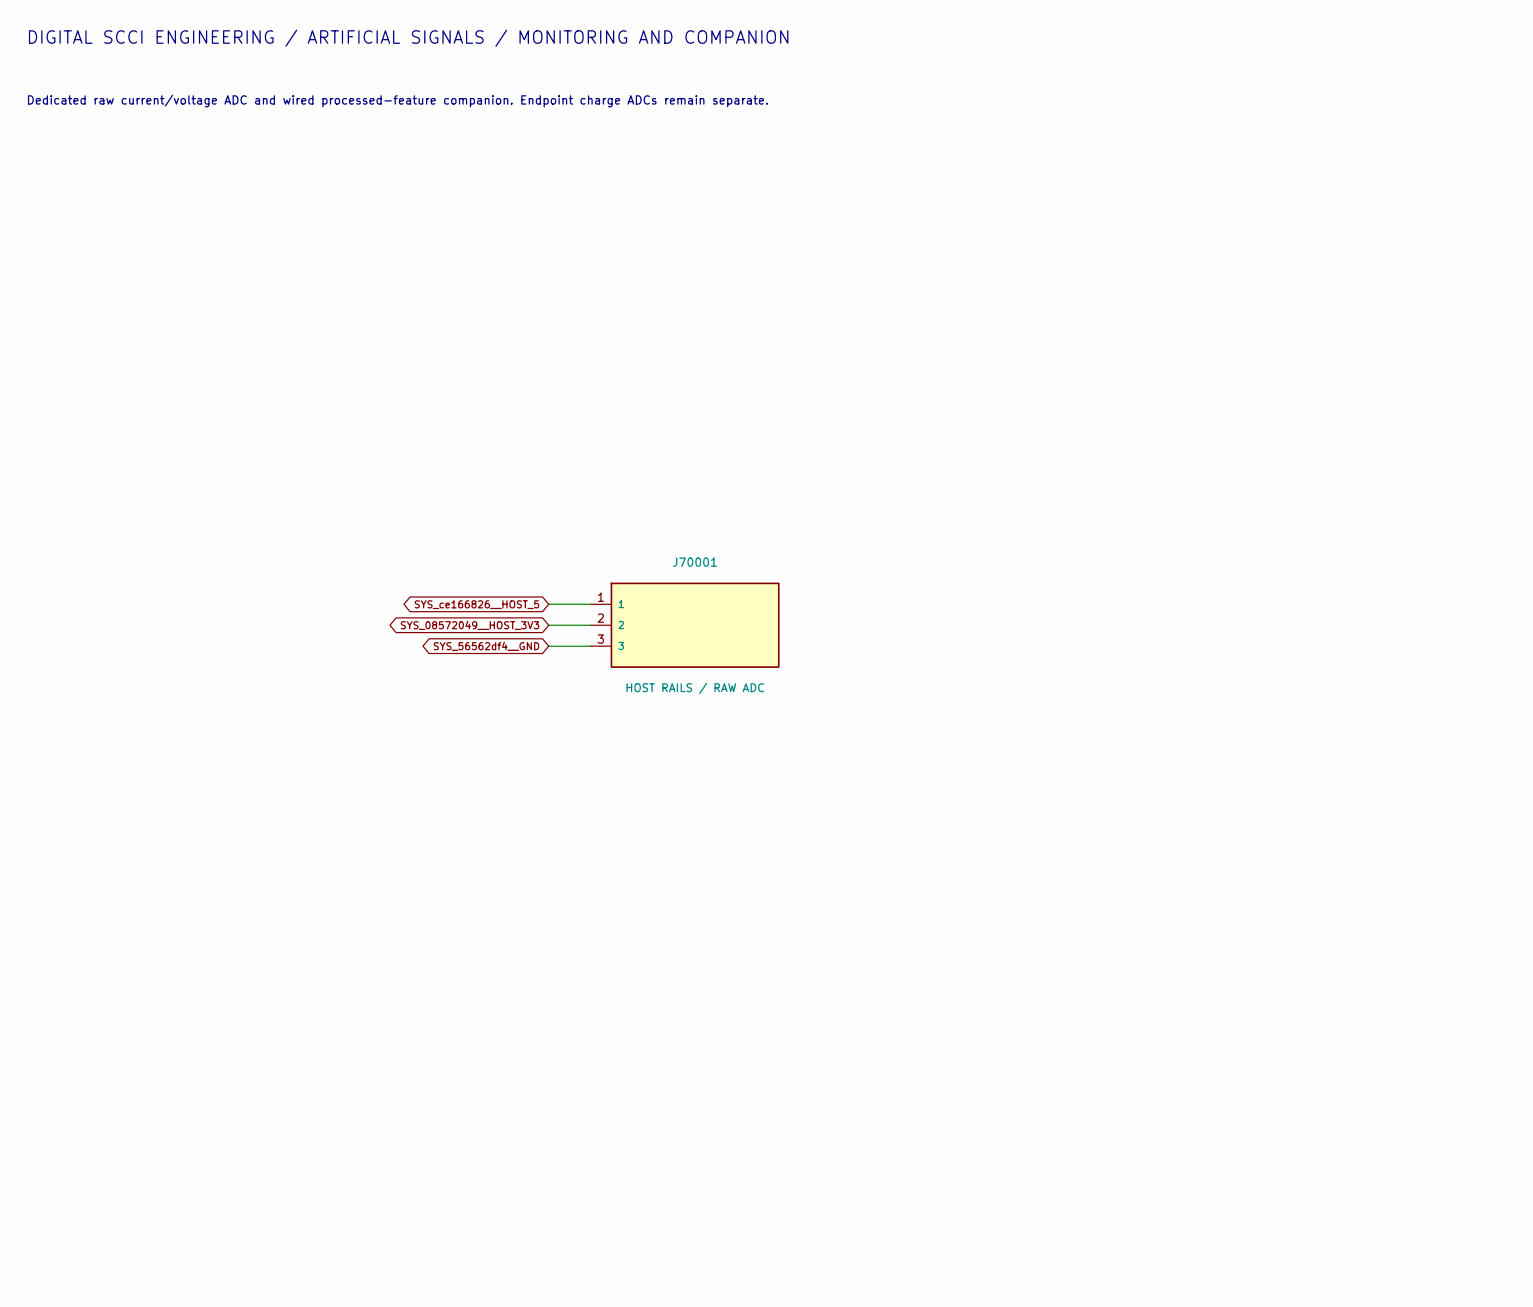
[picture p373: schematic monitoring_transport.kicad_sch, Project SCCI RH S4 / Existing package and host endpoints, part in row 1, column 1]

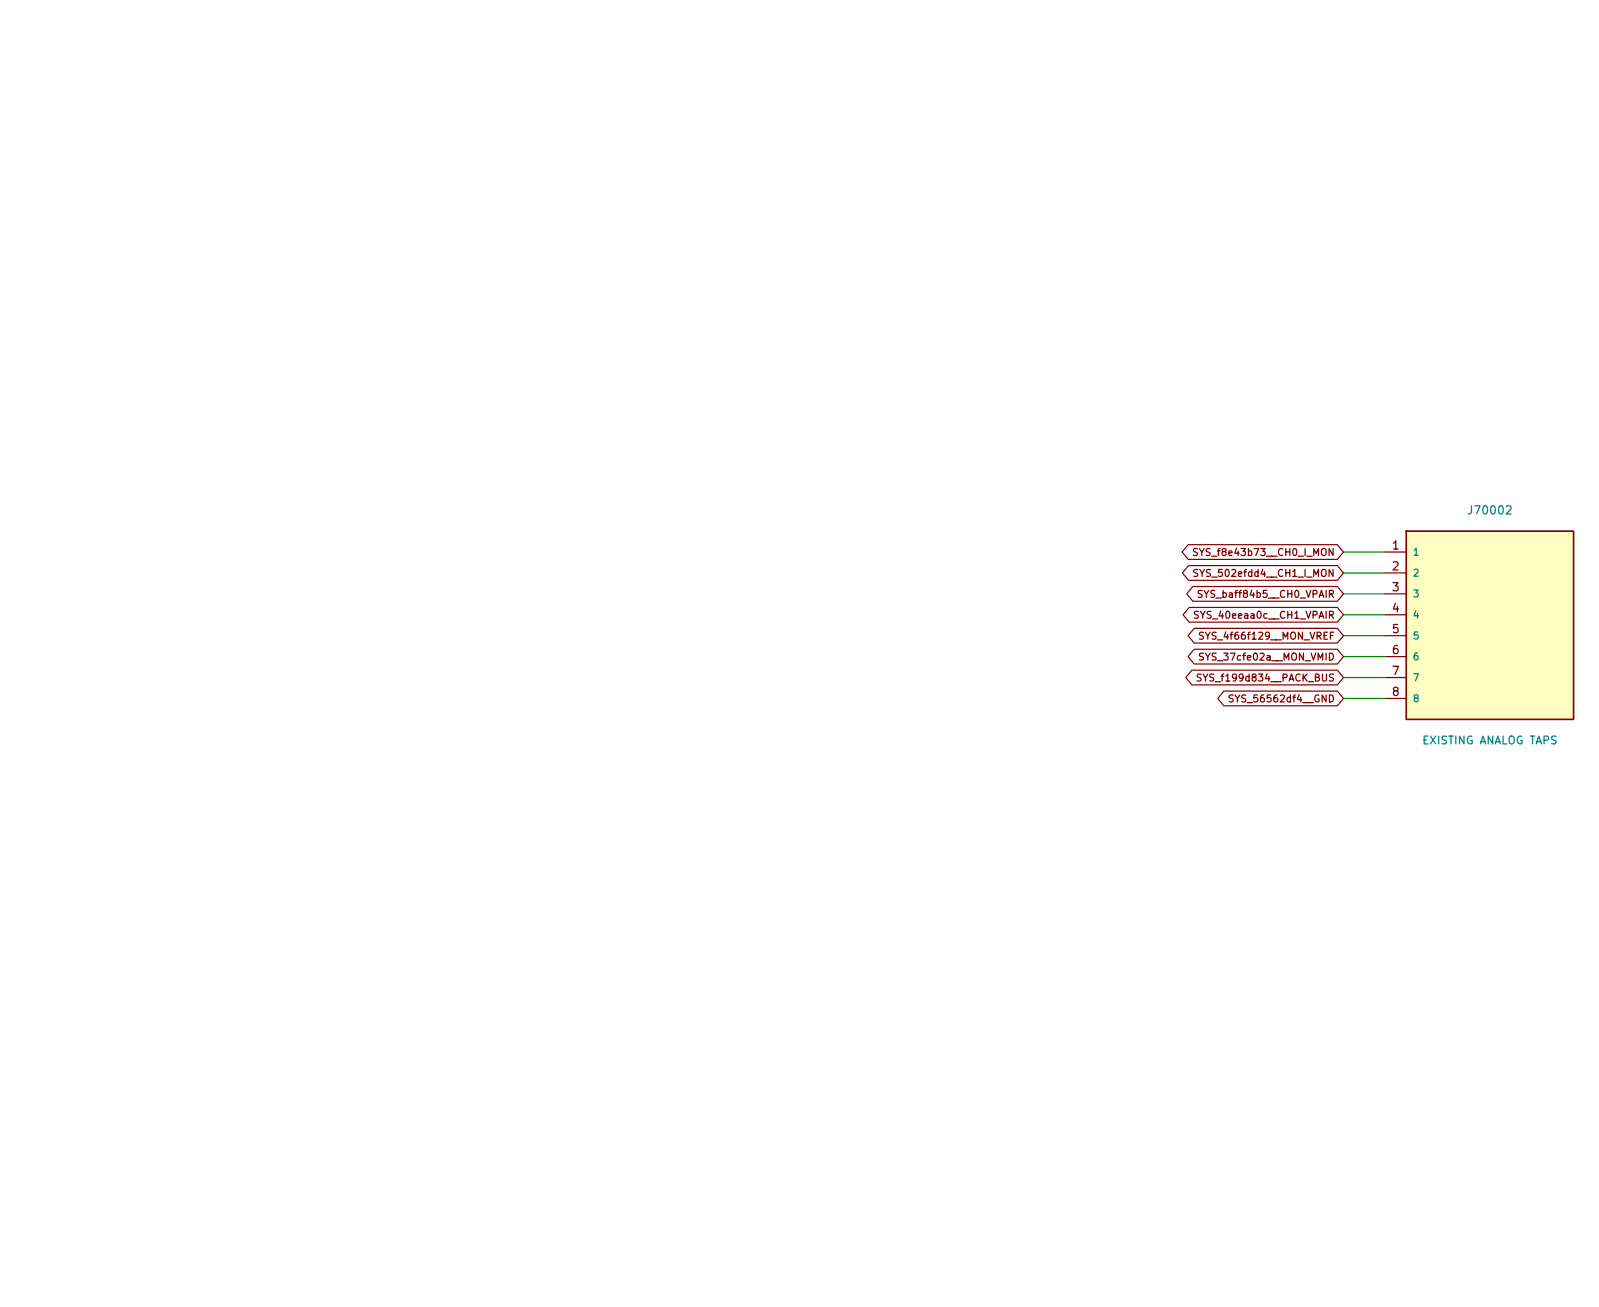
[picture p374: schematic monitoring_transport.kicad_sch, Project SCCI RH S4 / Existing package and host endpoints, part in row 1, column 2]

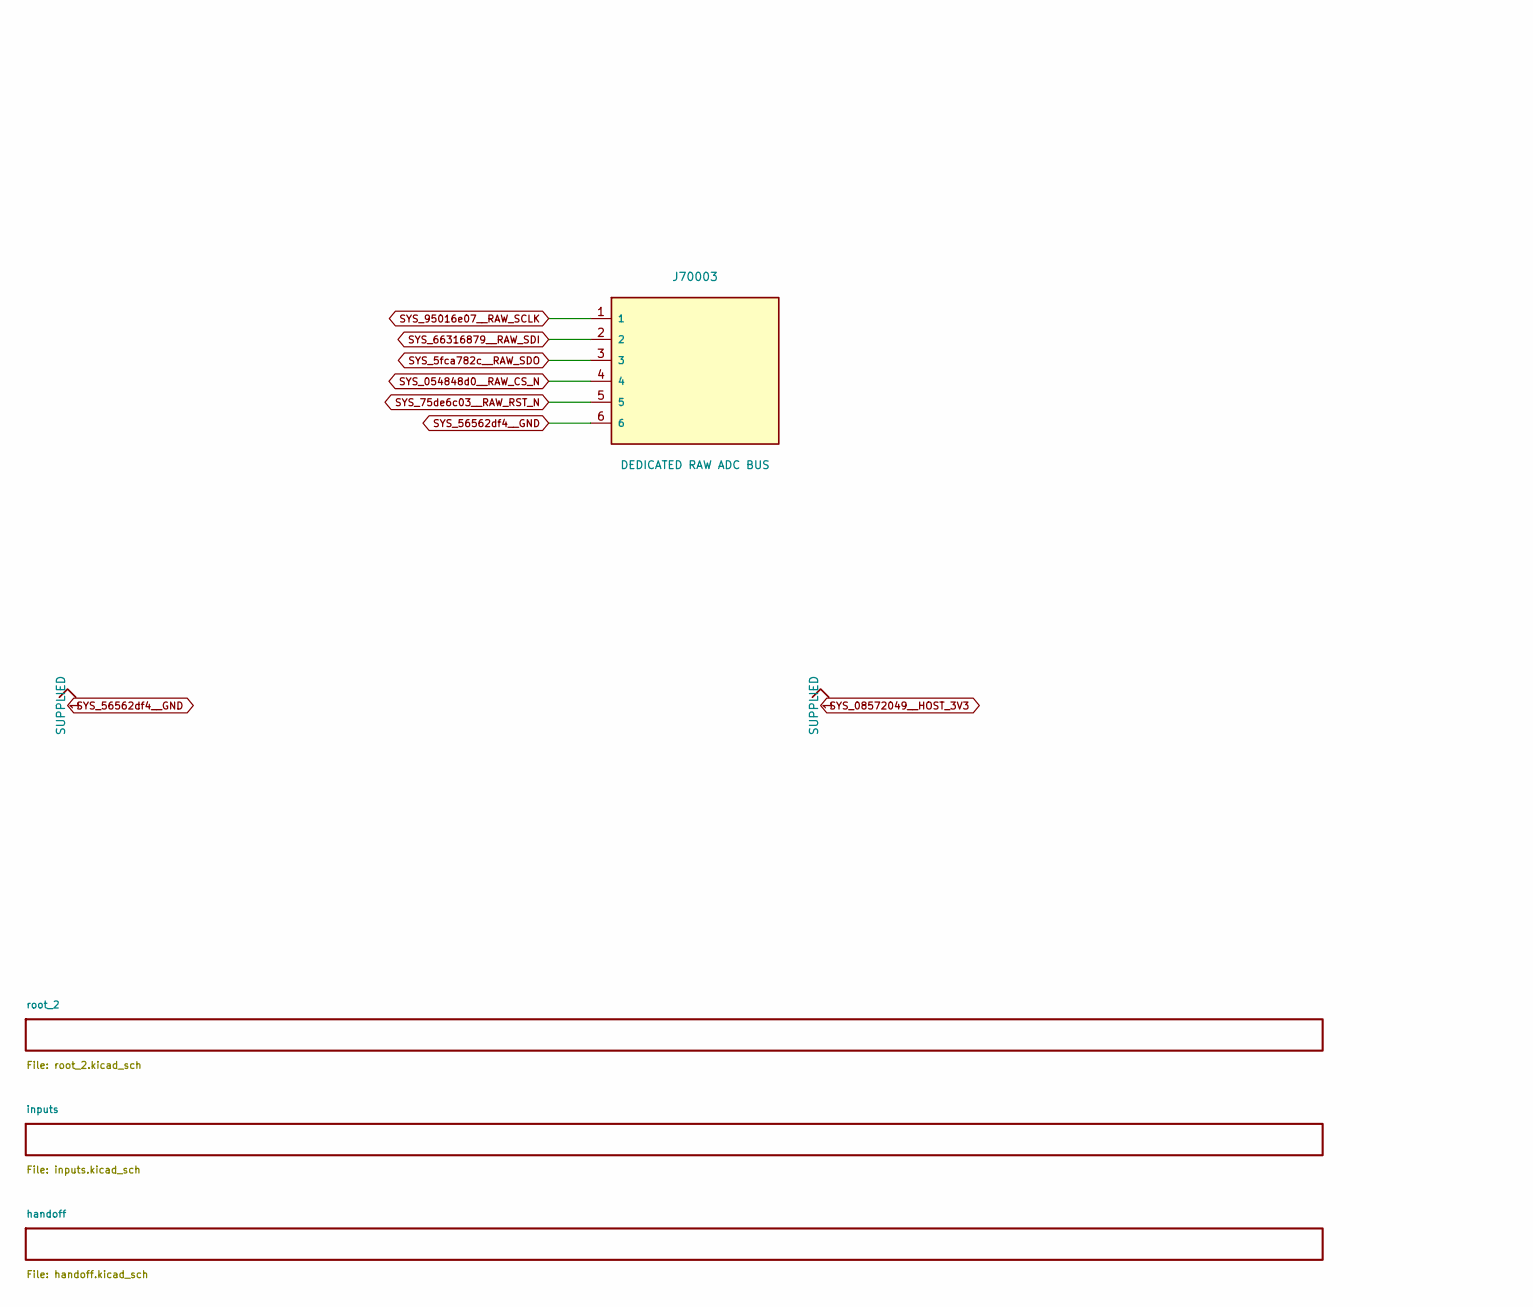
[picture p375: schematic monitoring_transport.kicad_sch, Project SCCI RH S4 / Existing package and host endpoints, part in row 2, column 1]

Parts:
J70001: HOST RAILS / RAW ADC; PinHeader_1x03_P2.54mm_Vertical
J70002: EXISTING ANALOG TAPS; PinHeader_1x08_P2.54mm_Vertical
J70003: DEDICATED RAW ADC BUS; PinHeader_1x06_P2.54mm_Vertical

Connections:
SYS_4f66f129__MON_VREF: J70002.5; also elsewhere on the board
SYS_5fca782c__RAW_SDO: J70003.3; also elsewhere on the board
SYS_37cfe02a__MON_VMID: J70002.6; also elsewhere on the board
SYS_40eeaa0c__CH1_VPAIR: J70002.4; also elsewhere on the board
SYS_75de6c03__RAW_RST_N: J70003.5; also elsewhere on the board
SYS_502efdd4__CH1_I_MON: J70002.2; also elsewhere on the board
SYS_054848d0__RAW_CS_N: J70003.4; also elsewhere on the board
SYS_56562df4__GND: J70001.3, J70002.8, J70003.6; also elsewhere on the board
SYS_95016e07__RAW_SCLK: J70003.1; also elsewhere on the board
SYS_08572049__HOST_3V3: J70001.2; also elsewhere on the board
SYS_66316879__RAW_SDI: J70003.2; also elsewhere on the board
SYS_baff84b5__CH0_VPAIR: J70002.3; also elsewhere on the board
SYS_ce166826__HOST_5: J70001.1; also elsewhere on the board
SYS_f8e43b73__CH0_I_MON: J70002.1; also elsewhere on the board
SYS_f199d834__PACK_BUS: J70002.7; also elsewhere on the board

Notes on the sheet:
DIGITAL SCCI ENGINEERING / ARTIFICIAL SIGNALS / MONITORING AND COMPANION
Dedicated raw current/voltage ADC and wired processed-feature companion. Endpoint charge ADCs remain separate.

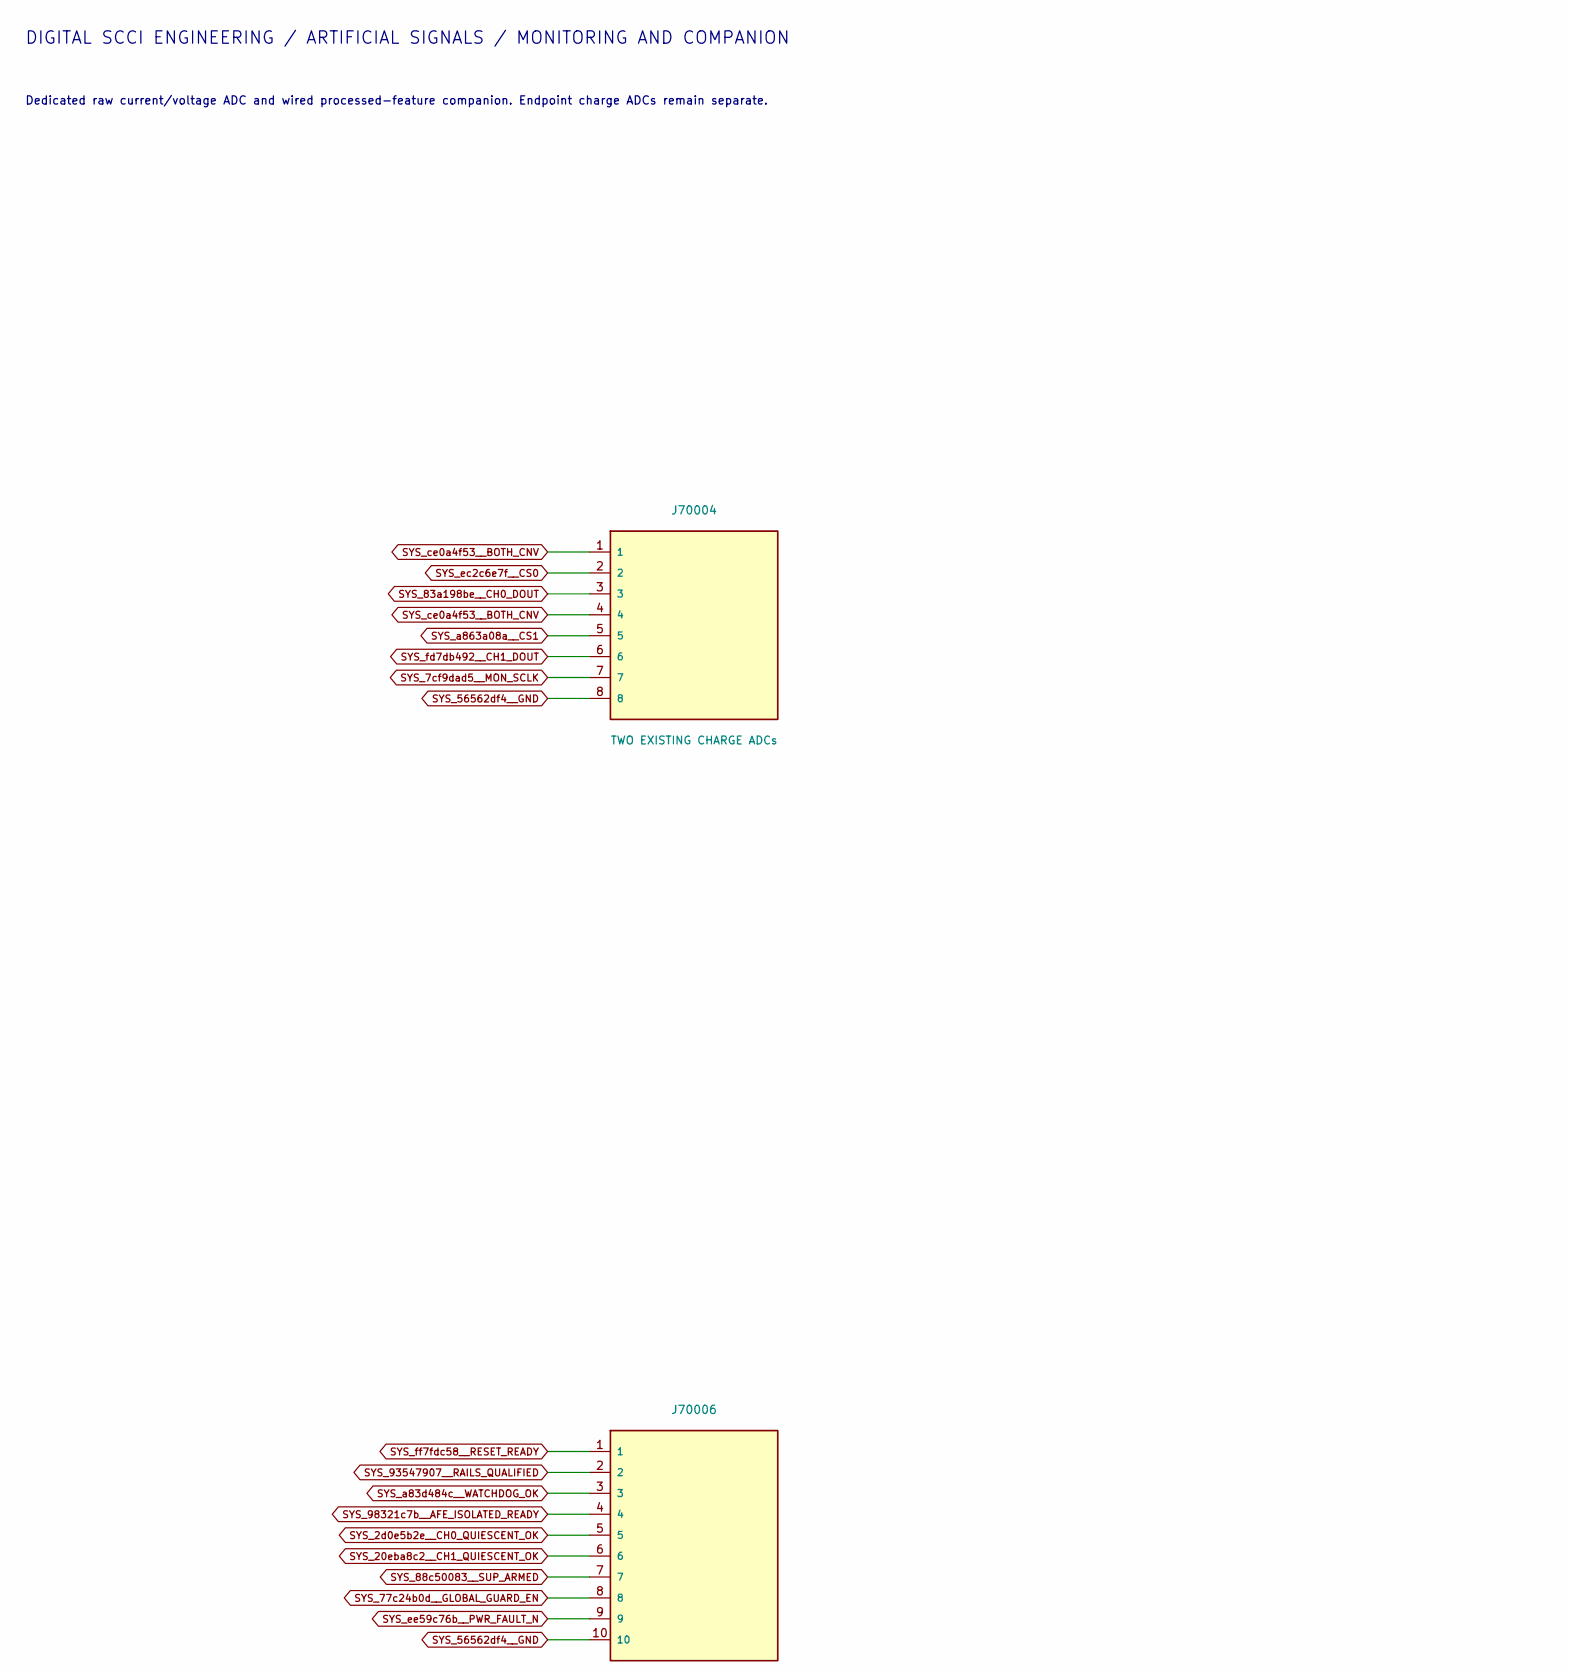
[picture p376: schematic root_2.kicad_sch, Project SCCI RH S4 / Existing package and host endpoints / 2, part in row 1, column 1]

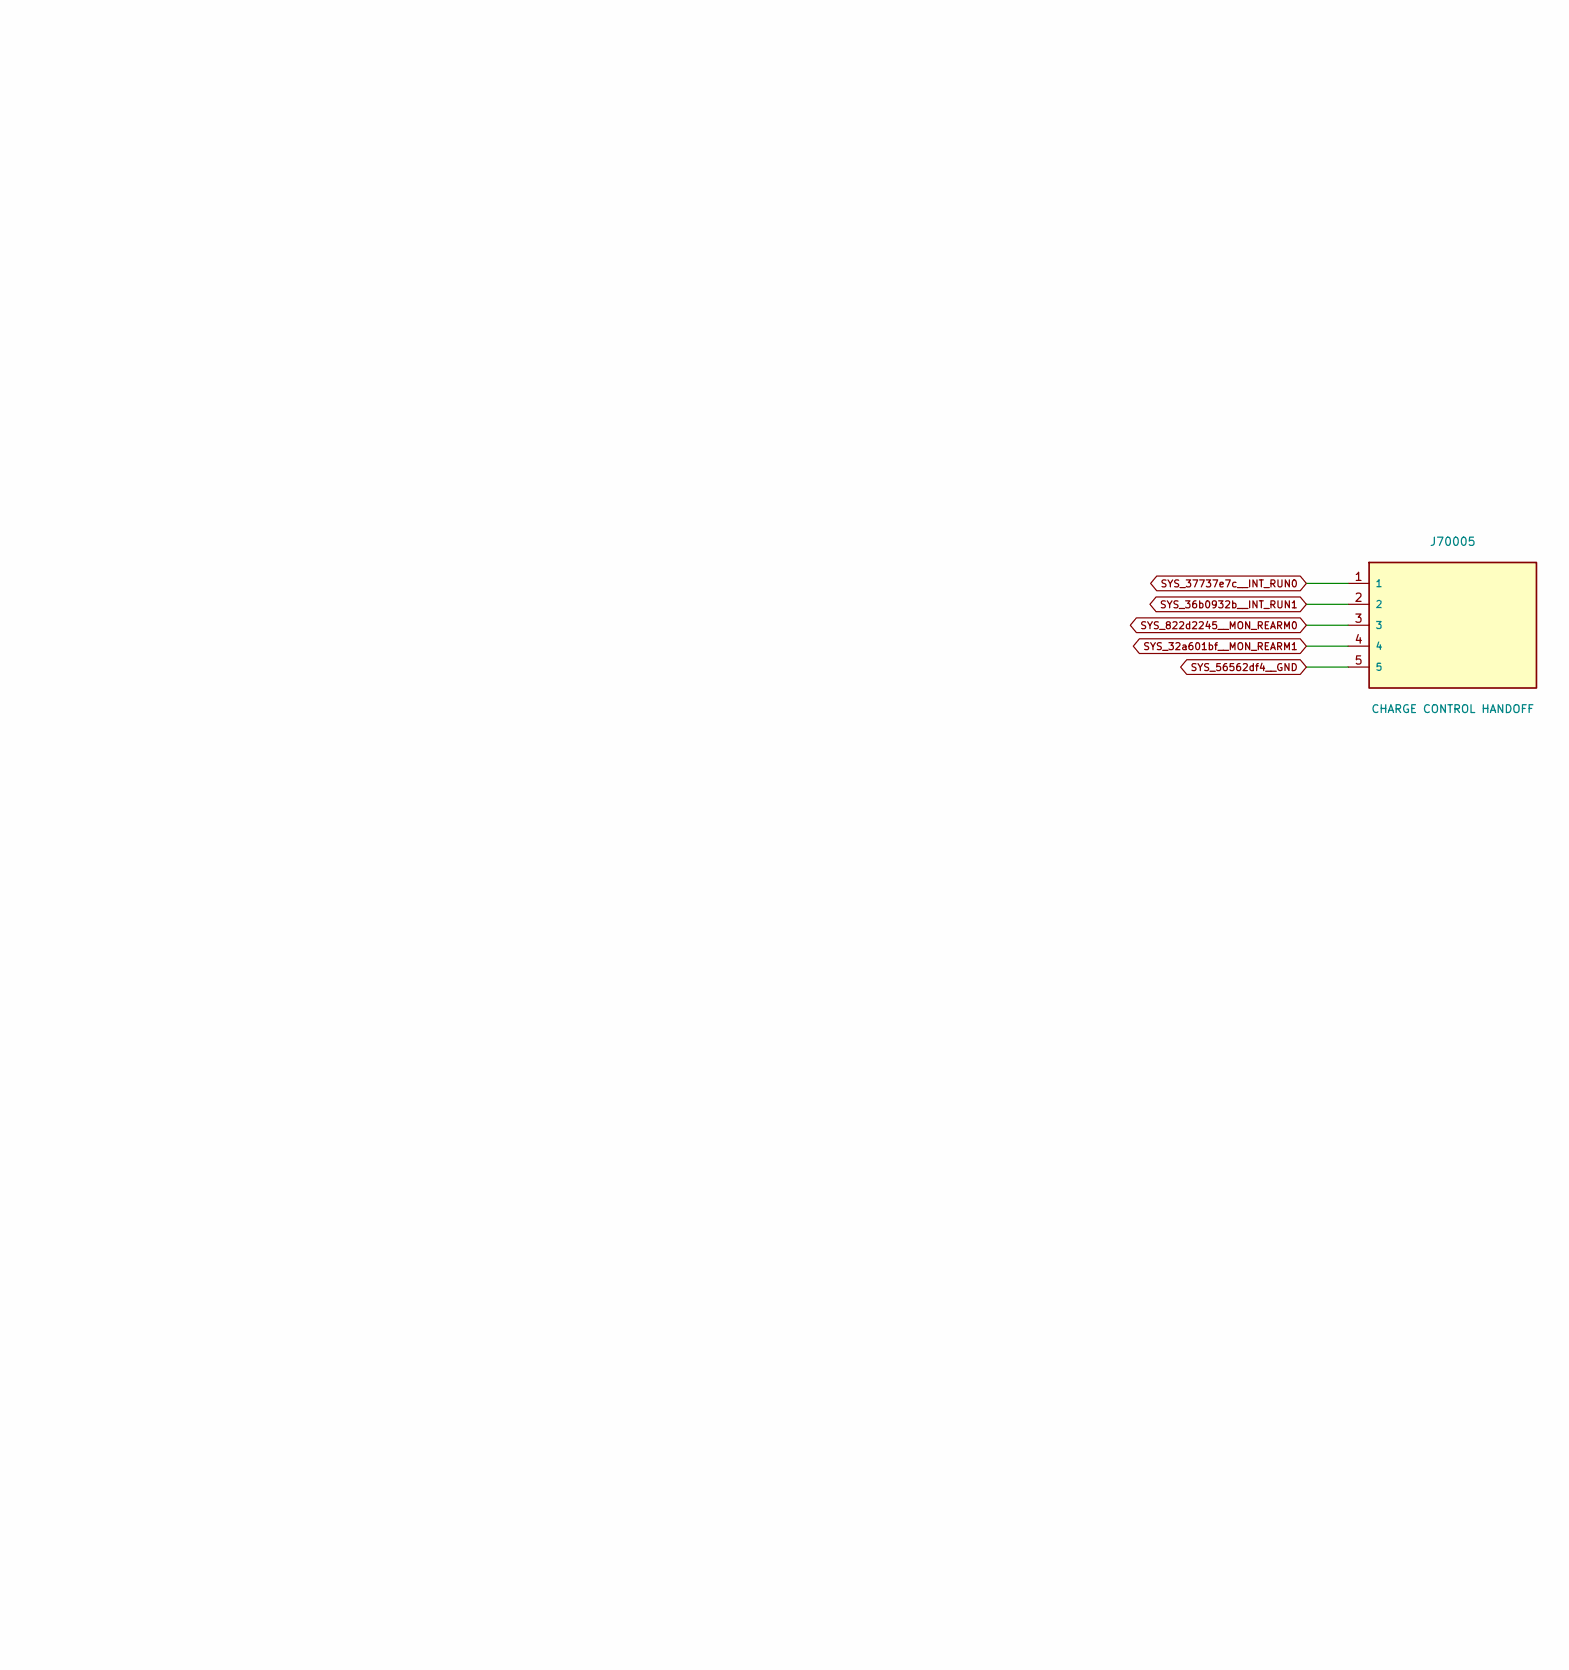
[picture p377: schematic root_2.kicad_sch, Project SCCI RH S4 / Existing package and host endpoints / 2, part in row 1, column 2]

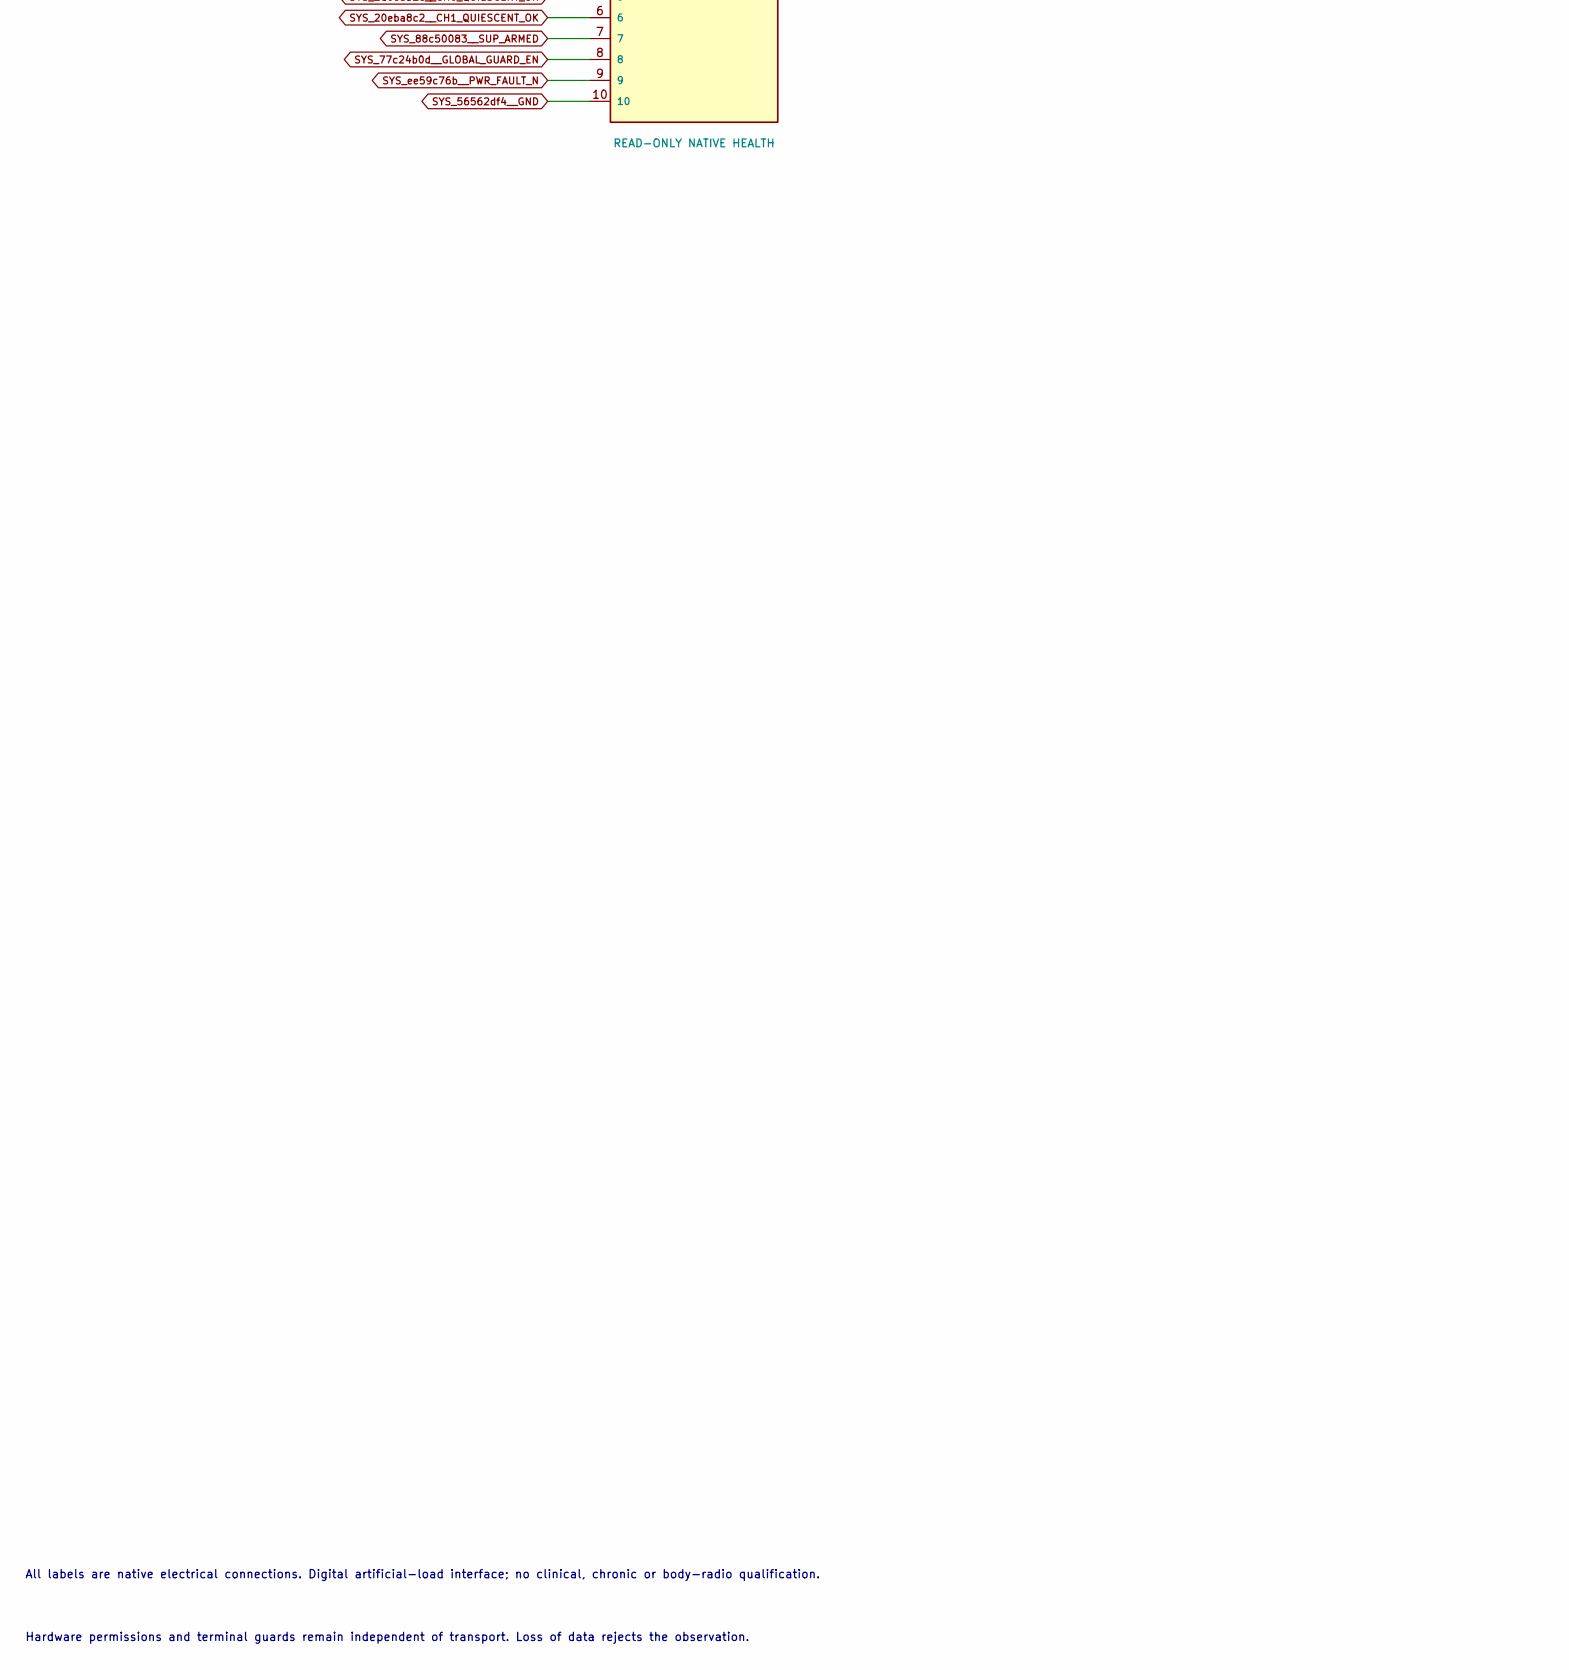
[picture p378: schematic root_2.kicad_sch, Project SCCI RH S4 / Existing package and host endpoints / 2, part in row 2, column 1]

Parts:
J70004: TWO EXISTING CHARGE ADCs; PinHeader_1x08_P2.54mm_Vertical
J70005: CHARGE CONTROL HANDOFF; PinHeader_1x05_P2.54mm_Vertical
J70006: READ-ONLY NATIVE HEALTH; PinHeader_1x10_P2.54mm_Vertical

Connections:
SYS_2d0e5b2e__CH0_QUIESCENT_OK: J70006.5; also elsewhere on the board
SYS_7cf9dad5__MON_SCLK: J70004.7; also elsewhere on the board
SYS_20eba8c2__CH1_QUIESCENT_OK: J70006.6; also elsewhere on the board
SYS_32a601bf__MON_REARM1: J70005.4; also elsewhere on the board
SYS_36b0932b__INT_RUN1: J70005.2; also elsewhere on the board
SYS_77c24b0d__GLOBAL_GUARD_EN: J70006.8; also elsewhere on the board
SYS_83a198be__CH0_DOUT: J70004.3; also elsewhere on the board
SYS_88c50083__SUP_ARMED: J70006.7; also elsewhere on the board
SYS_822d2245__MON_REARM0: J70005.3; also elsewhere on the board
SYS_37737e7c__INT_RUN0: J70005.1; also elsewhere on the board
SYS_56562df4__GND: J70004.8, J70005.5, J70006.10; also elsewhere on the board
SYS_98321c7b__AFE_ISOLATED_READY: J70006.4; also elsewhere on the board
SYS_93547907__RAILS_QUALIFIED: J70006.2; also elsewhere on the board
SYS_a83d484c__WATCHDOG_OK: J70006.3; also elsewhere on the board
SYS_a863a08a__CS1: J70004.5; also elsewhere on the board
SYS_ce0a4f53__BOTH_CNV: J70004.1, J70004.4; also elsewhere on the board
SYS_ec2c6e7f__CS0: J70004.2; also elsewhere on the board
SYS_ee59c76b__PWR_FAULT_N: J70006.9; also elsewhere on the board
SYS_fd7db492__CH1_DOUT: J70004.6; also elsewhere on the board
SYS_ff7fdc58__RESET_READY: J70006.1; also elsewhere on the board

Notes on the sheet:
DIGITAL SCCI ENGINEERING / ARTIFICIAL SIGNALS / MONITORING AND COMPANION
Dedicated raw current/voltage ADC and wired processed-feature companion. Endpoint charge ADCs remain separate.
All labels are native electrical connections. Digital artificial-load interface; no clinical, chronic or body-radio qualification.
Hardware permissions and terminal guards remain independent of transport. Loss of data rejects the observation.
