pratham-cloud-ctrl/Project-SCCI-RH/electronics/stage4/integrated-pcb/boards/current-driver/current_driver.kicad_pcb

## KiCad design electronics/stage4/integrated-pcb/boards/current-driver/current_driver.kicad_pcb (continued)

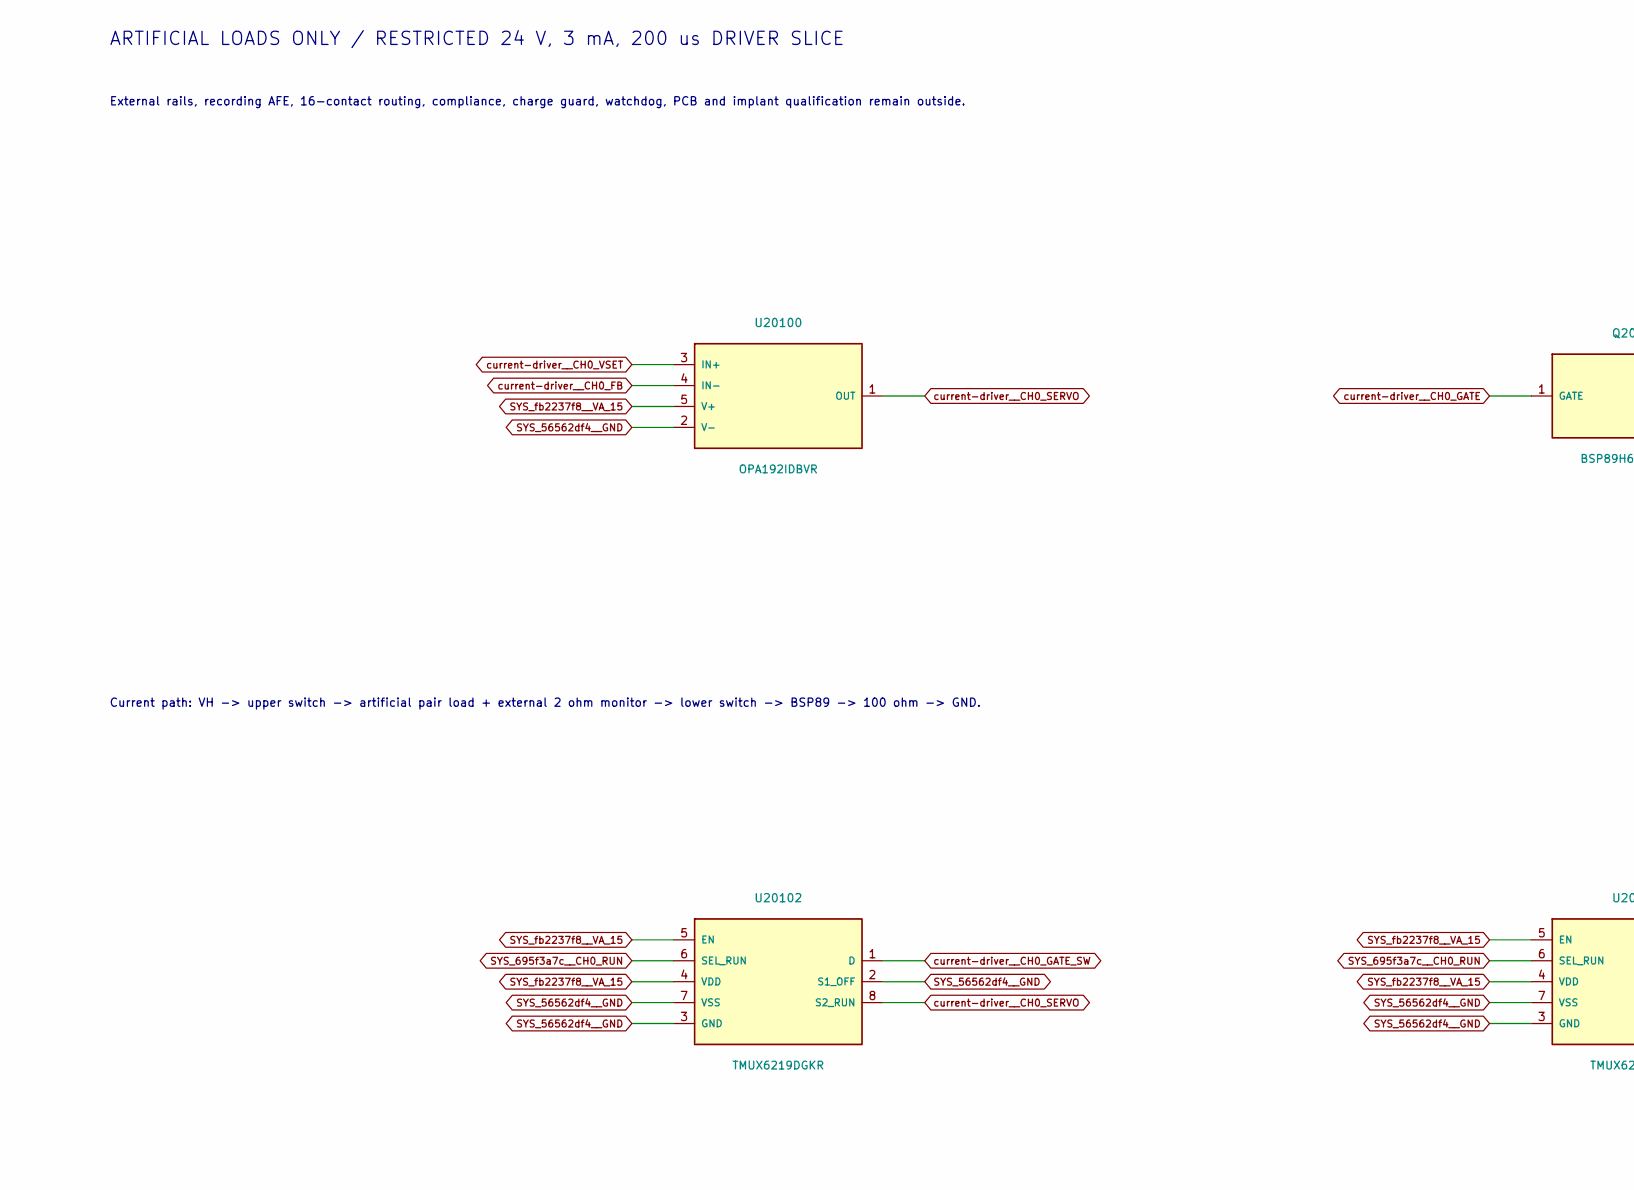
[picture p399: schematic source0.kicad_sch, Project SCCI RH S4 / Source 0: regulated sink and polarity …, part in row 1, column 1]

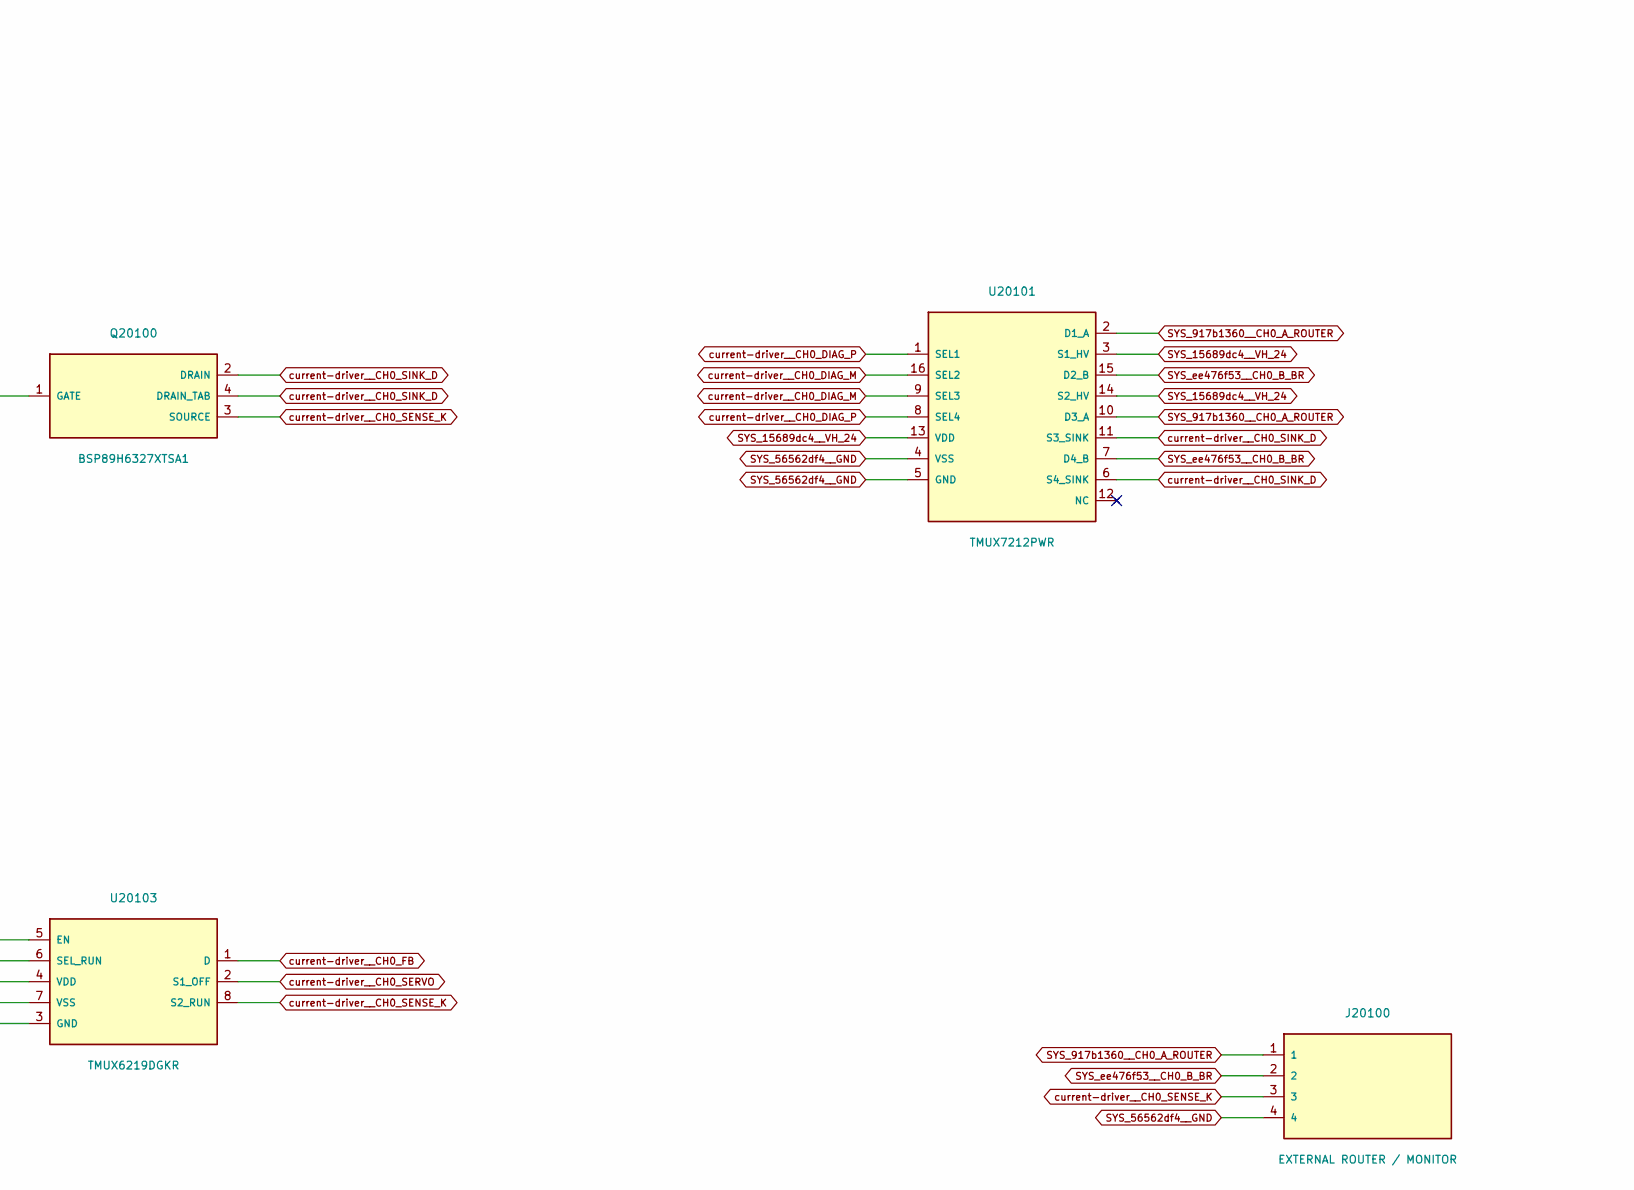
[picture p400: schematic source0.kicad_sch, Project SCCI RH S4 / Source 0: regulated sink and polarity …, part in row 1, column 2]

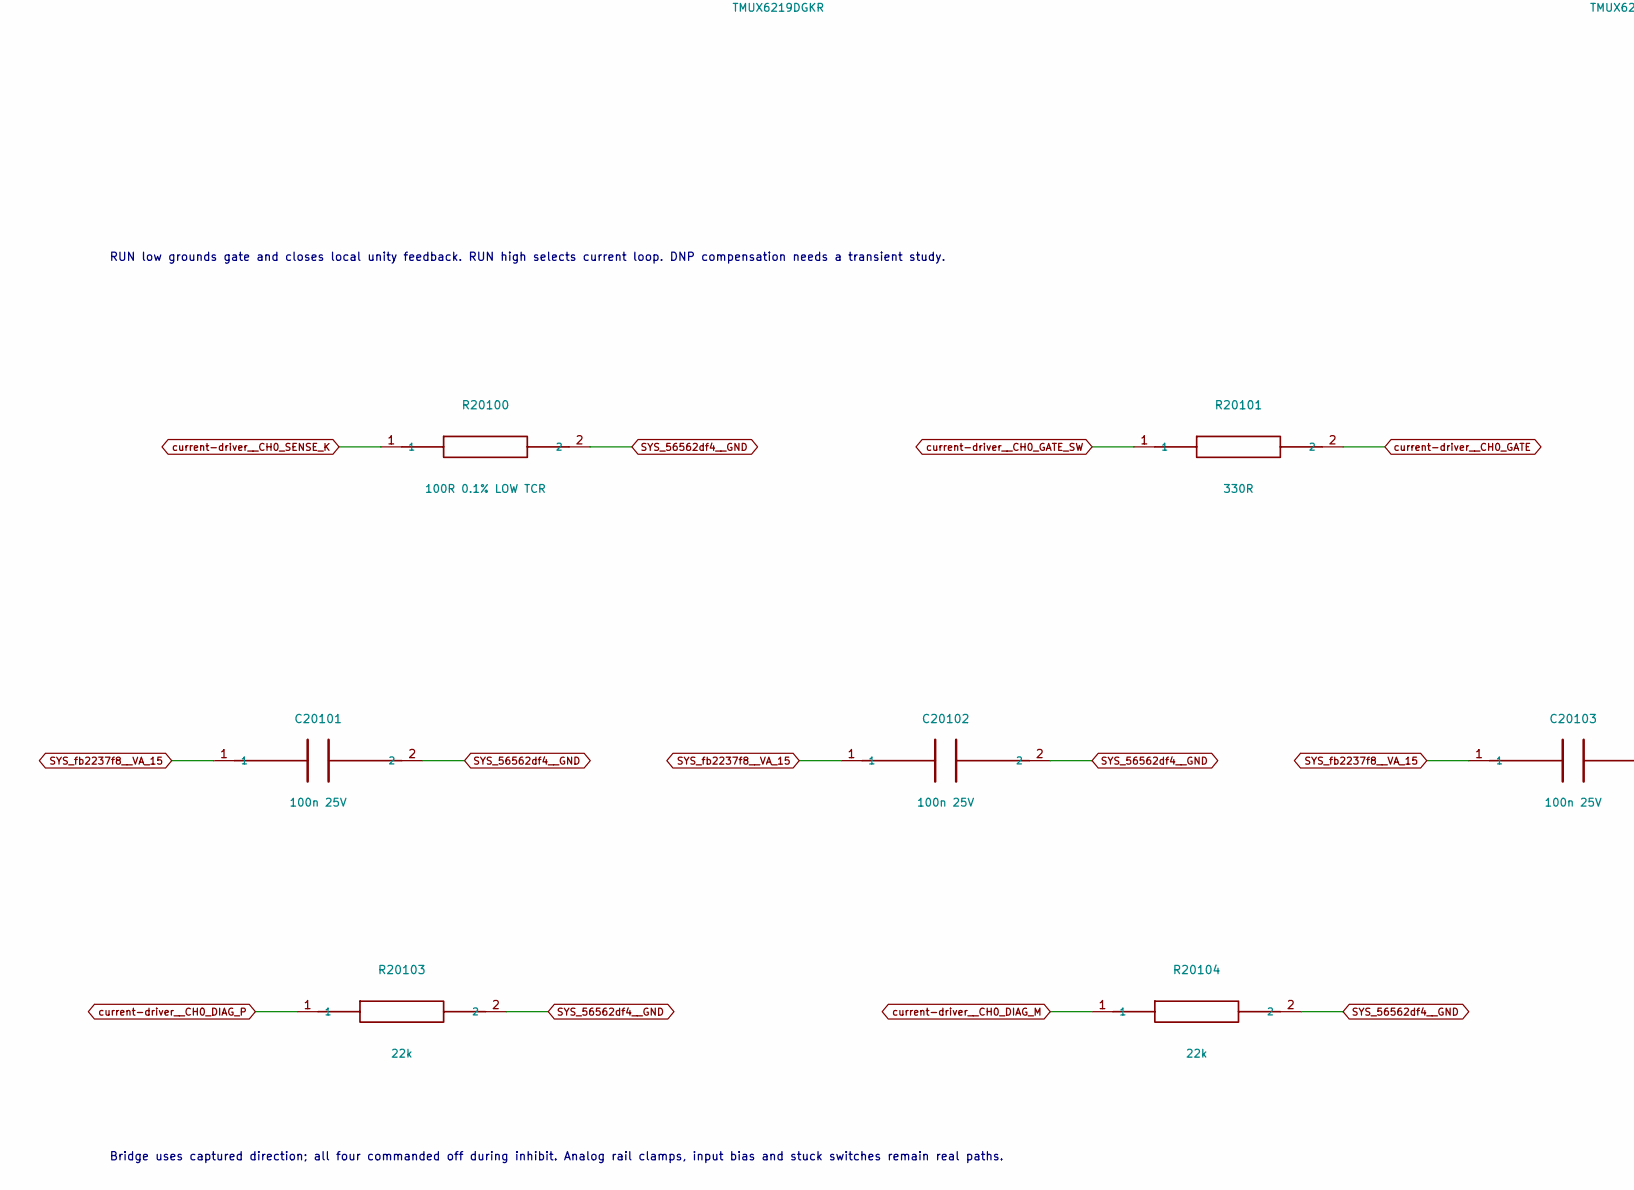
[picture p401: schematic source0.kicad_sch, Project SCCI RH S4 / Source 0: regulated sink and polarity …, part in row 2, column 1]

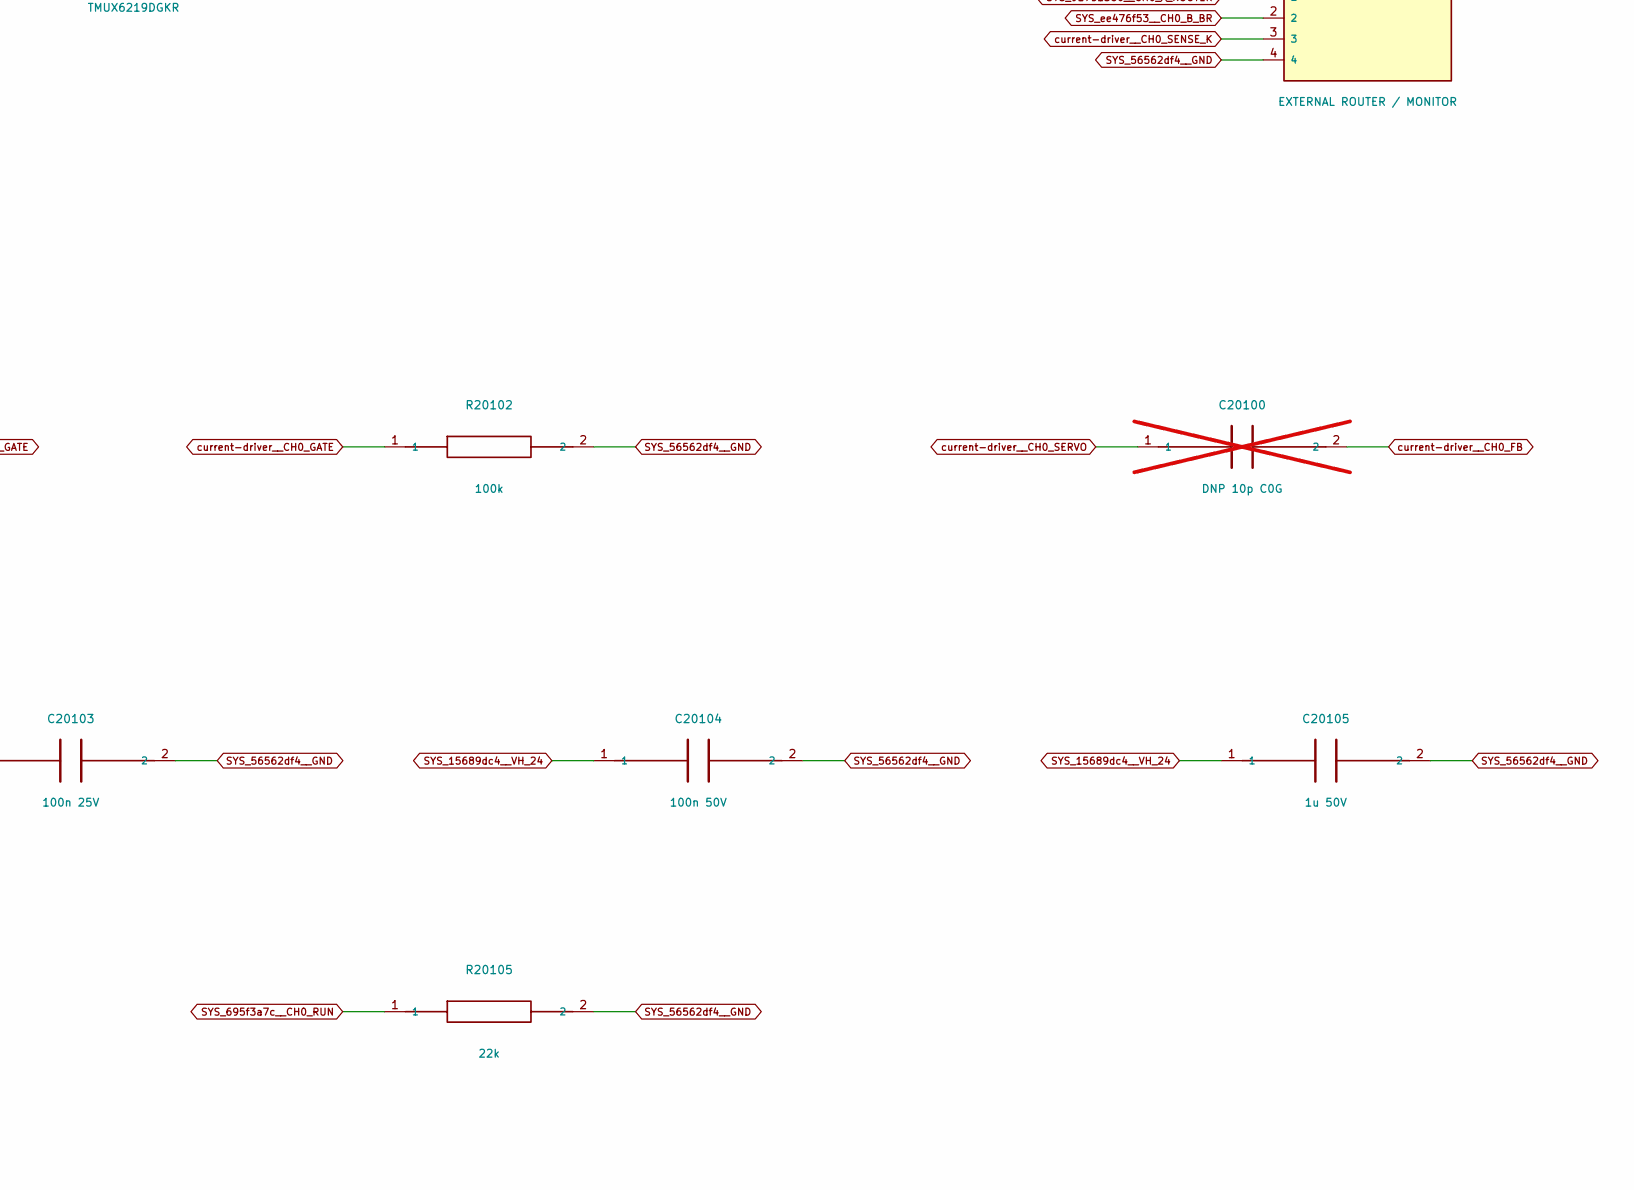
[picture p402: schematic source0.kicad_sch, Project SCCI RH S4 / Source 0: regulated sink and polarity …, part in row 2, column 2]

Parts:
C20100: DNP 10p C0G; C_0805_2012Metric; not fitted
C20101, C20102, C20103: 100n 25V; C_0805_2012Metric
C20104: 100n 50V; C_0805_2012Metric
C20105: 1u 50V; C_0805_2012Metric
J20100: EXTERNAL ROUTER / MONITOR; PinHeader_1x04_P2.54mm_Vertical
Q20100: BSP89H6327XTSA1; BSP89_PG-SOT223-4_DrainTab
R20100: 100R 0.1% LOW TCR; R_0805_2012Metric
R20101: 330R; R_0805_2012Metric
R20102: 100k; R_0805_2012Metric
R20103, R20104, R20105: 22k; R_0805_2012Metric
U20100: OPA192IDBVR; SOT-23-5
U20101: TMUX7212PWR; TSSOP-16_4.4x5mm_P0.65mm
U20102, U20103: TMUX6219DGKR; VSSOP-8_2.3x2mm_P0.5mm

Connections:
SYS_695f3a7c__CH0_RUN: R20105.1, U20102.6 (SEL_RUN), U20103.6 (SEL_RUN); also elsewhere on the board
SYS_917b1360__CH0_A_ROUTER: J20100.1, U20101.2 (D1_A), U20101.10 (D3_A)
SYS_15689dc4__VH_24: C20104.1, C20105.1, U20101.3 (S1_HV), U20101.13 (VDD), U20101.14 (S2_HV); also elsewhere on the board
SYS_56562df4__GND: C20101.2, C20102.2, C20103.2, C20104.2, C20105.2, J20100.4, R20100.2, R20102.2, R20103.2, R20104.2, R20105.2, U20100.2 (V-), U20101.4 (VSS), U20101.5 (GND), U20102.2 (S1_OFF), U20102.3 (GND), U20102.7 (VSS), U20103.3 (GND), U20103.7 (VSS); also elsewhere on the board
SYS_ee476f53__CH0_B_BR: J20100.2, U20101.7 (D4_B), U20101.15 (D2_B)
SYS_fb2237f8__VA_15: C20101.1, C20102.1, C20103.1, U20100.5 (V+), U20102.4 (VDD), U20102.5 (EN), U20103.4 (VDD), U20103.5 (EN); also elsewhere on the board
current-driver__CH0_DIAG_M: R20104.1, U20101.9 (SEL3), U20101.16 (SEL2); also elsewhere on the board
current-driver__CH0_DIAG_P: R20103.1, U20101.1 (SEL1), U20101.8 (SEL4); also elsewhere on the board
current-driver__CH0_FB: C20100.2, U20100.4 (IN-), U20103.1 (D)
current-driver__CH0_GATE: Q20100.1 (GATE), R20101.2, R20102.1
current-driver__CH0_GATE_SW: R20101.1, U20102.1 (D)
current-driver__CH0_SENSE_K: J20100.3, Q20100.3 (SOURCE), R20100.1, U20103.8 (S2_RUN)
current-driver__CH0_SERVO: C20100.1, U20100.1 (OUT), U20102.8 (S2_RUN), U20103.2 (S1_OFF)
current-driver__CH0_SINK_D: Q20100.2 (DRAIN), Q20100.4 (DRAIN_TAB), U20101.6 (S4_SINK), U20101.11 (S3_SINK)
current-driver__CH0_VSET: U20100.3 (IN+); also elsewhere on the board

Notes on the sheet:
ARTIFICIAL LOADS ONLY / RESTRICTED 24 V, 3 mA, 200 us DRIVER SLICE
External rails, recording AFE, 16-contact routing, compliance, charge guard, watchdog, PCB and implant qualification remain outside.
Current path: VH -> upper switch -> artificial pair load + external 2 ohm monitor -> lower switch -> BSP89 -> 100 ohm -> GND.
RUN low grounds gate and closes local unity feedback. RUN high selects current loop. DNP compensation needs a transient study.
Bridge uses captured direction; all four commanded off during inhibit. Analog rail clamps, input bias and stuck switches remain real paths.
