pratham-cloud-ctrl/Project-SCCI-RH/electronics/stage4/integrated-pcb/boards/contact-router/contact_router.kicad_pcb

## KiCad design electronics/stage4/integrated-pcb/boards/contact-router/contact_router.kicad_pcb (2026-10-29)

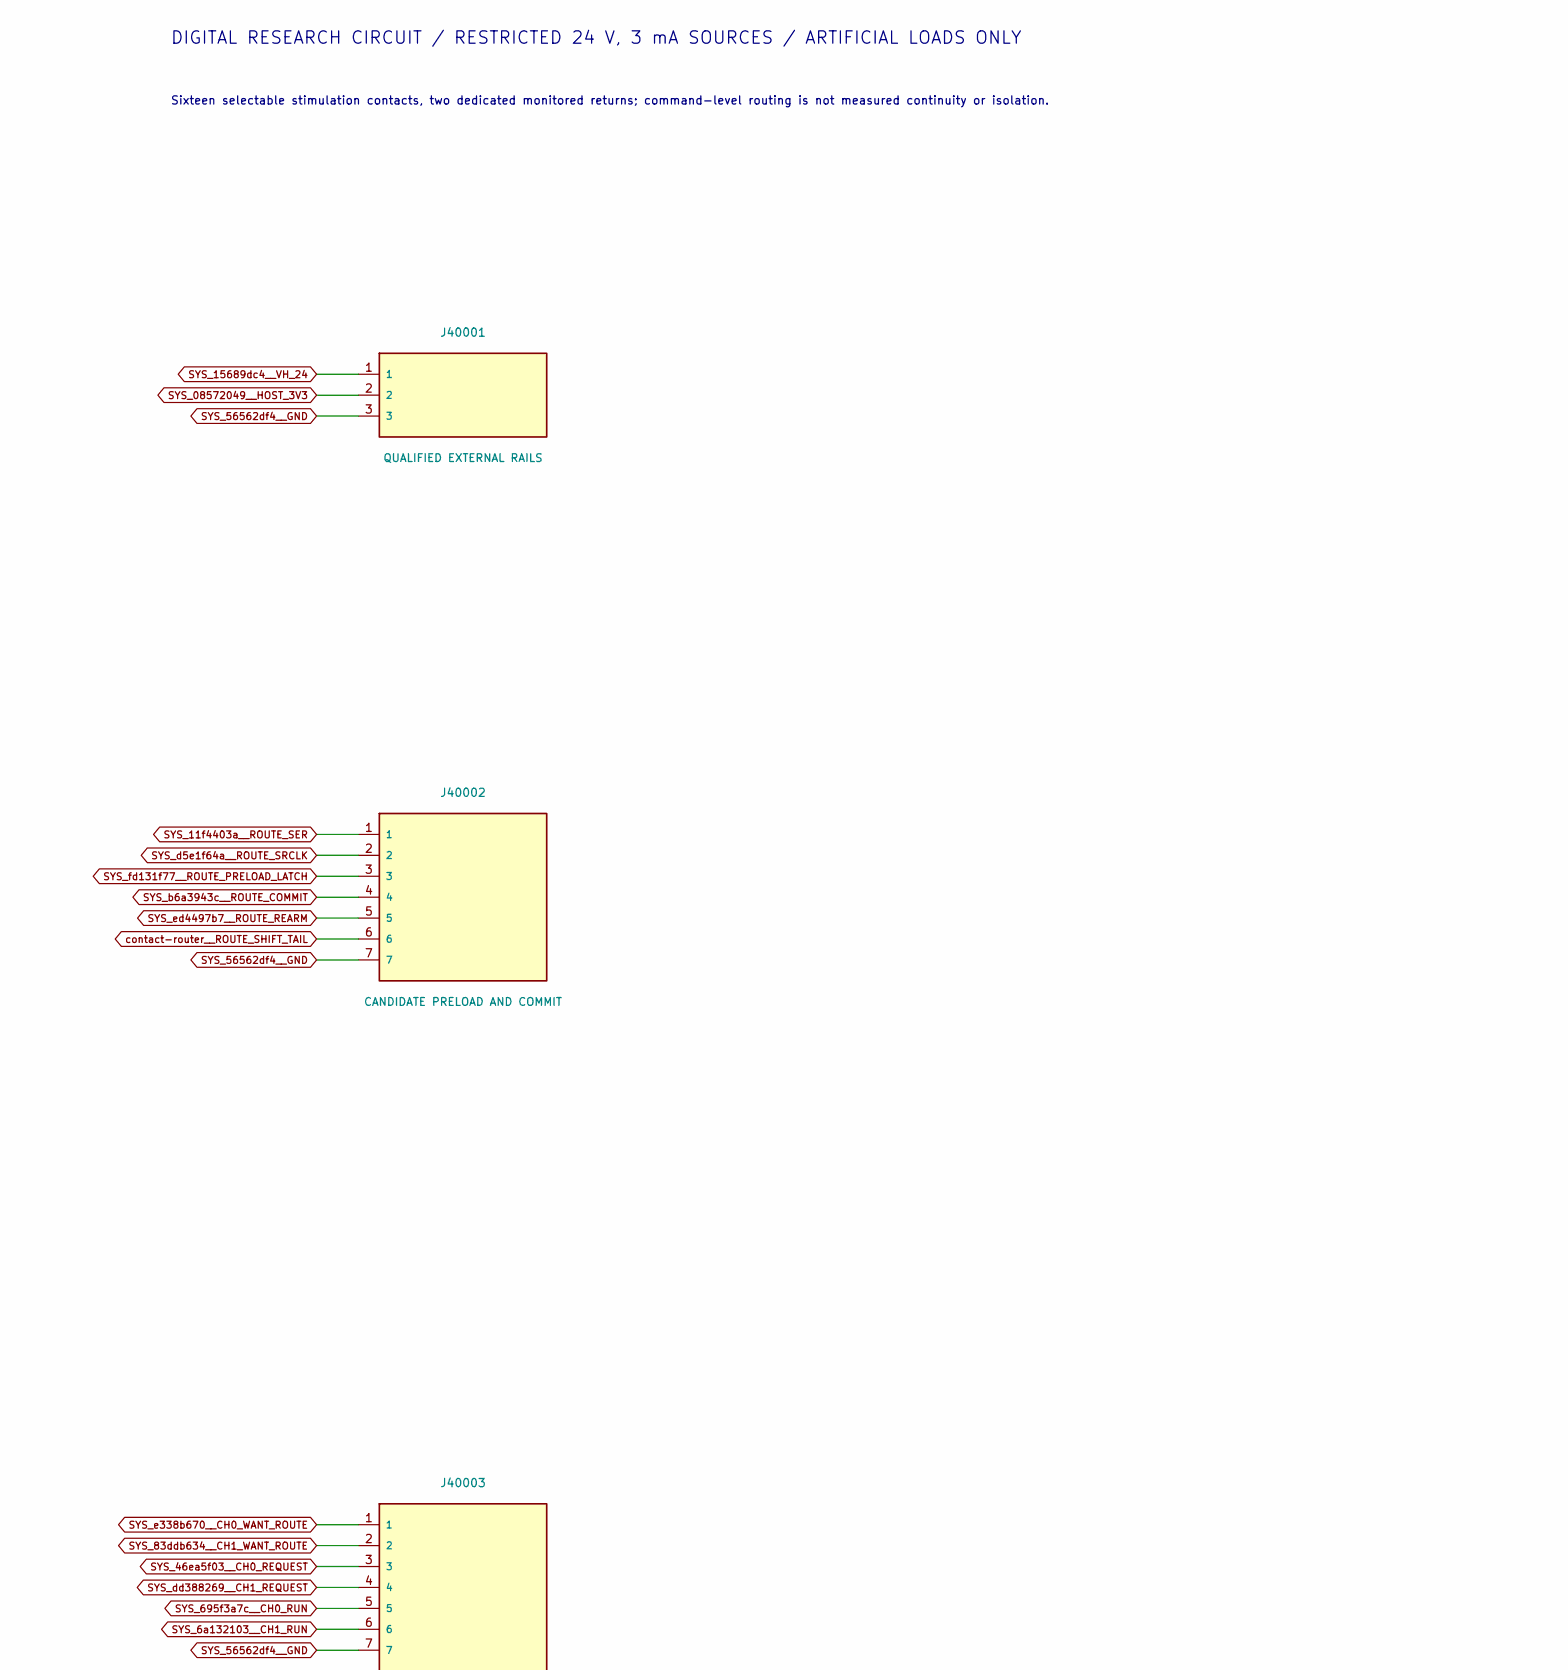
[picture p420: schematic contact_router.kicad_sch, Project SCCI RH S4 / Route interfaces and monitored returns, part in row 1, column 1]

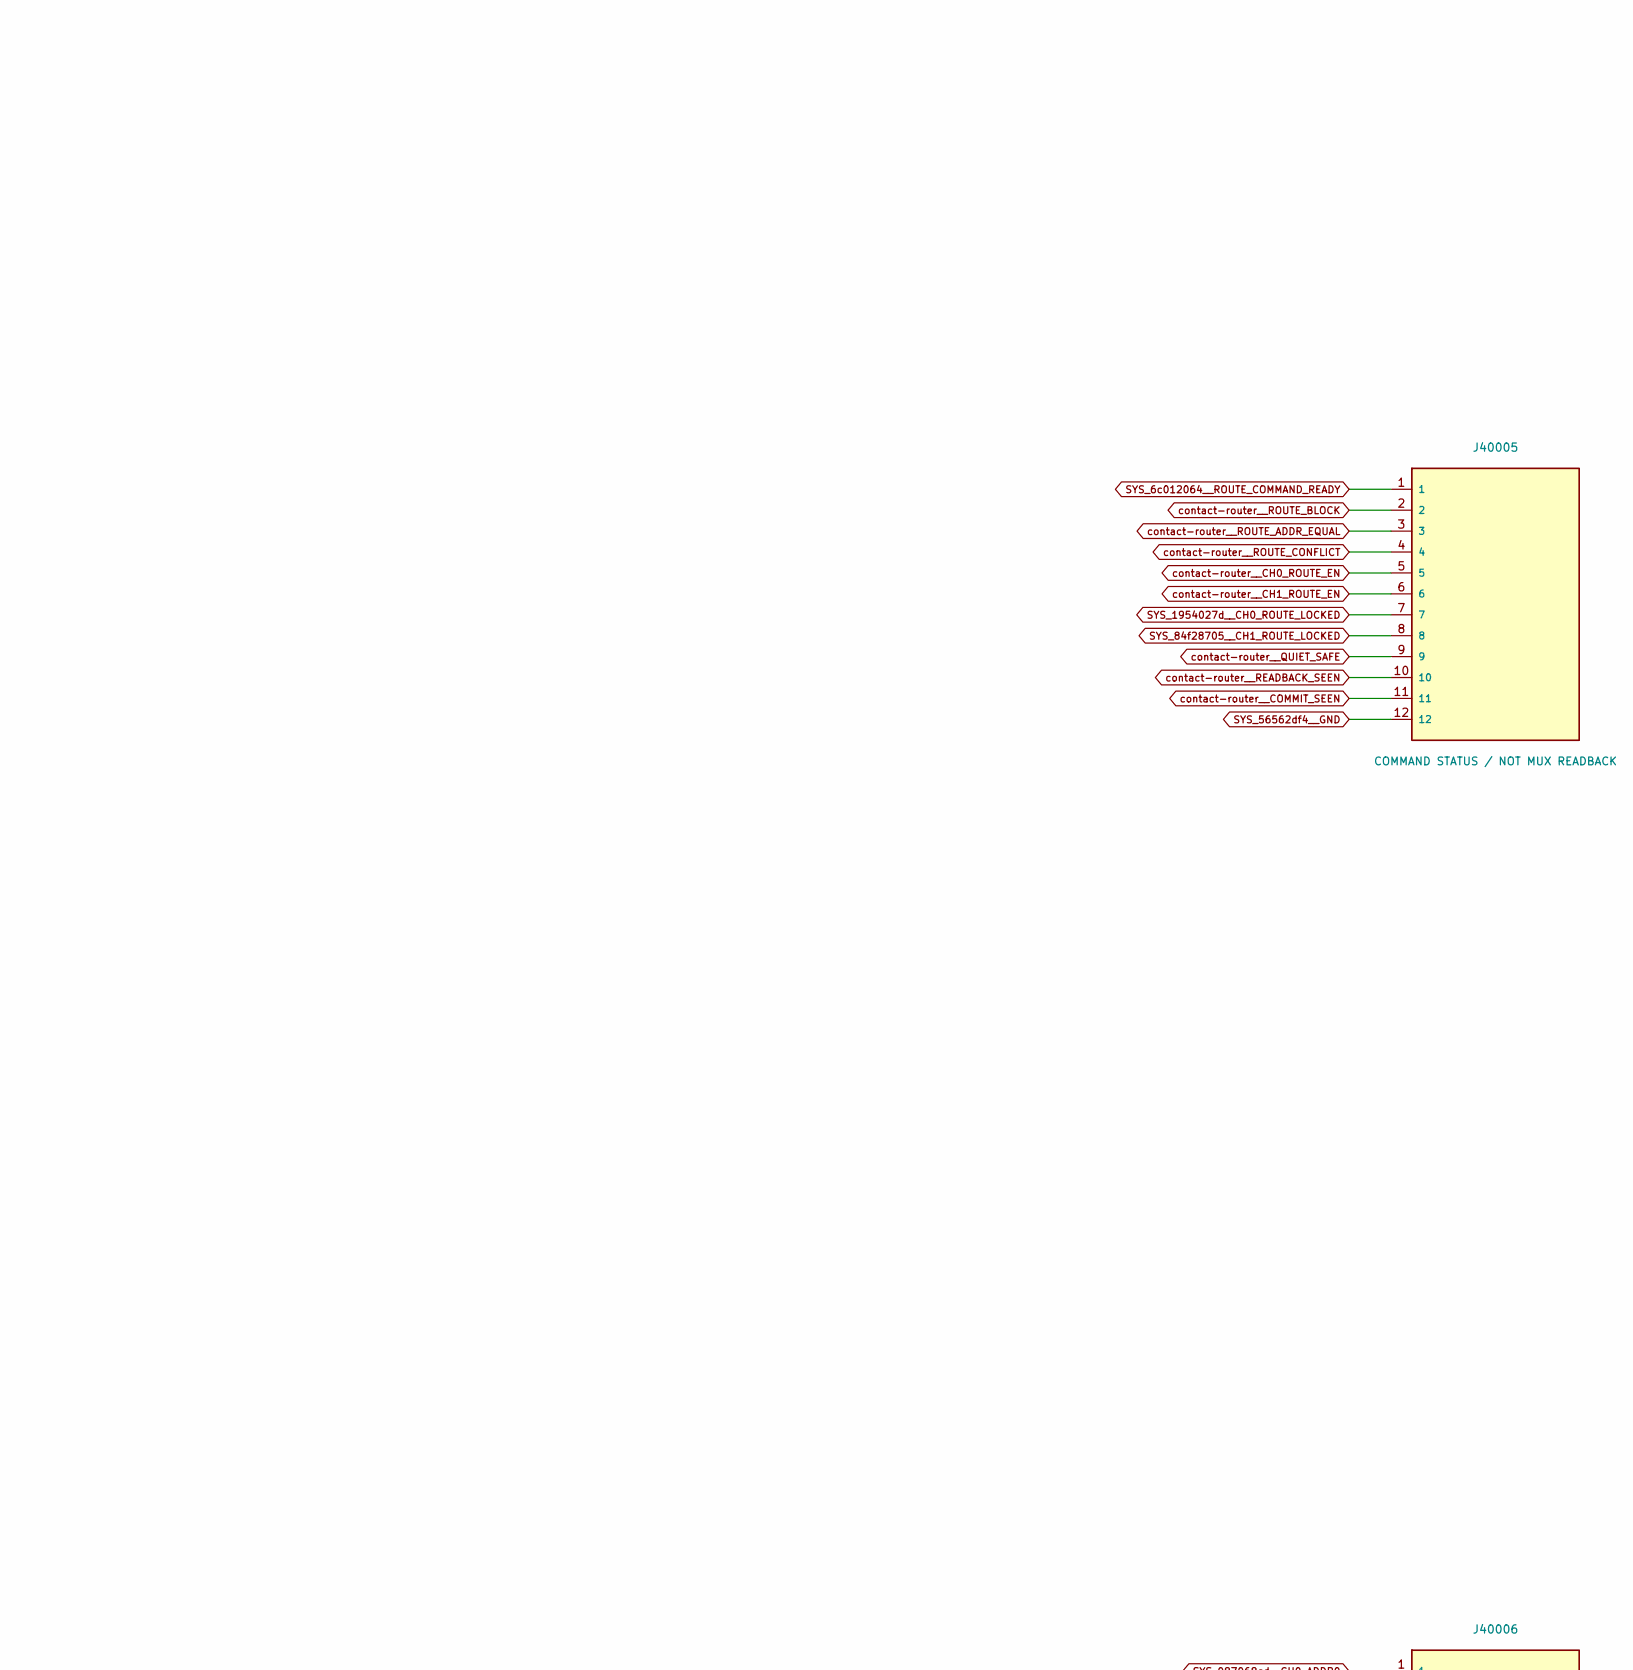
[picture p421: schematic contact_router.kicad_sch, Project SCCI RH S4 / Route interfaces and monitored returns, part in row 1, column 2]

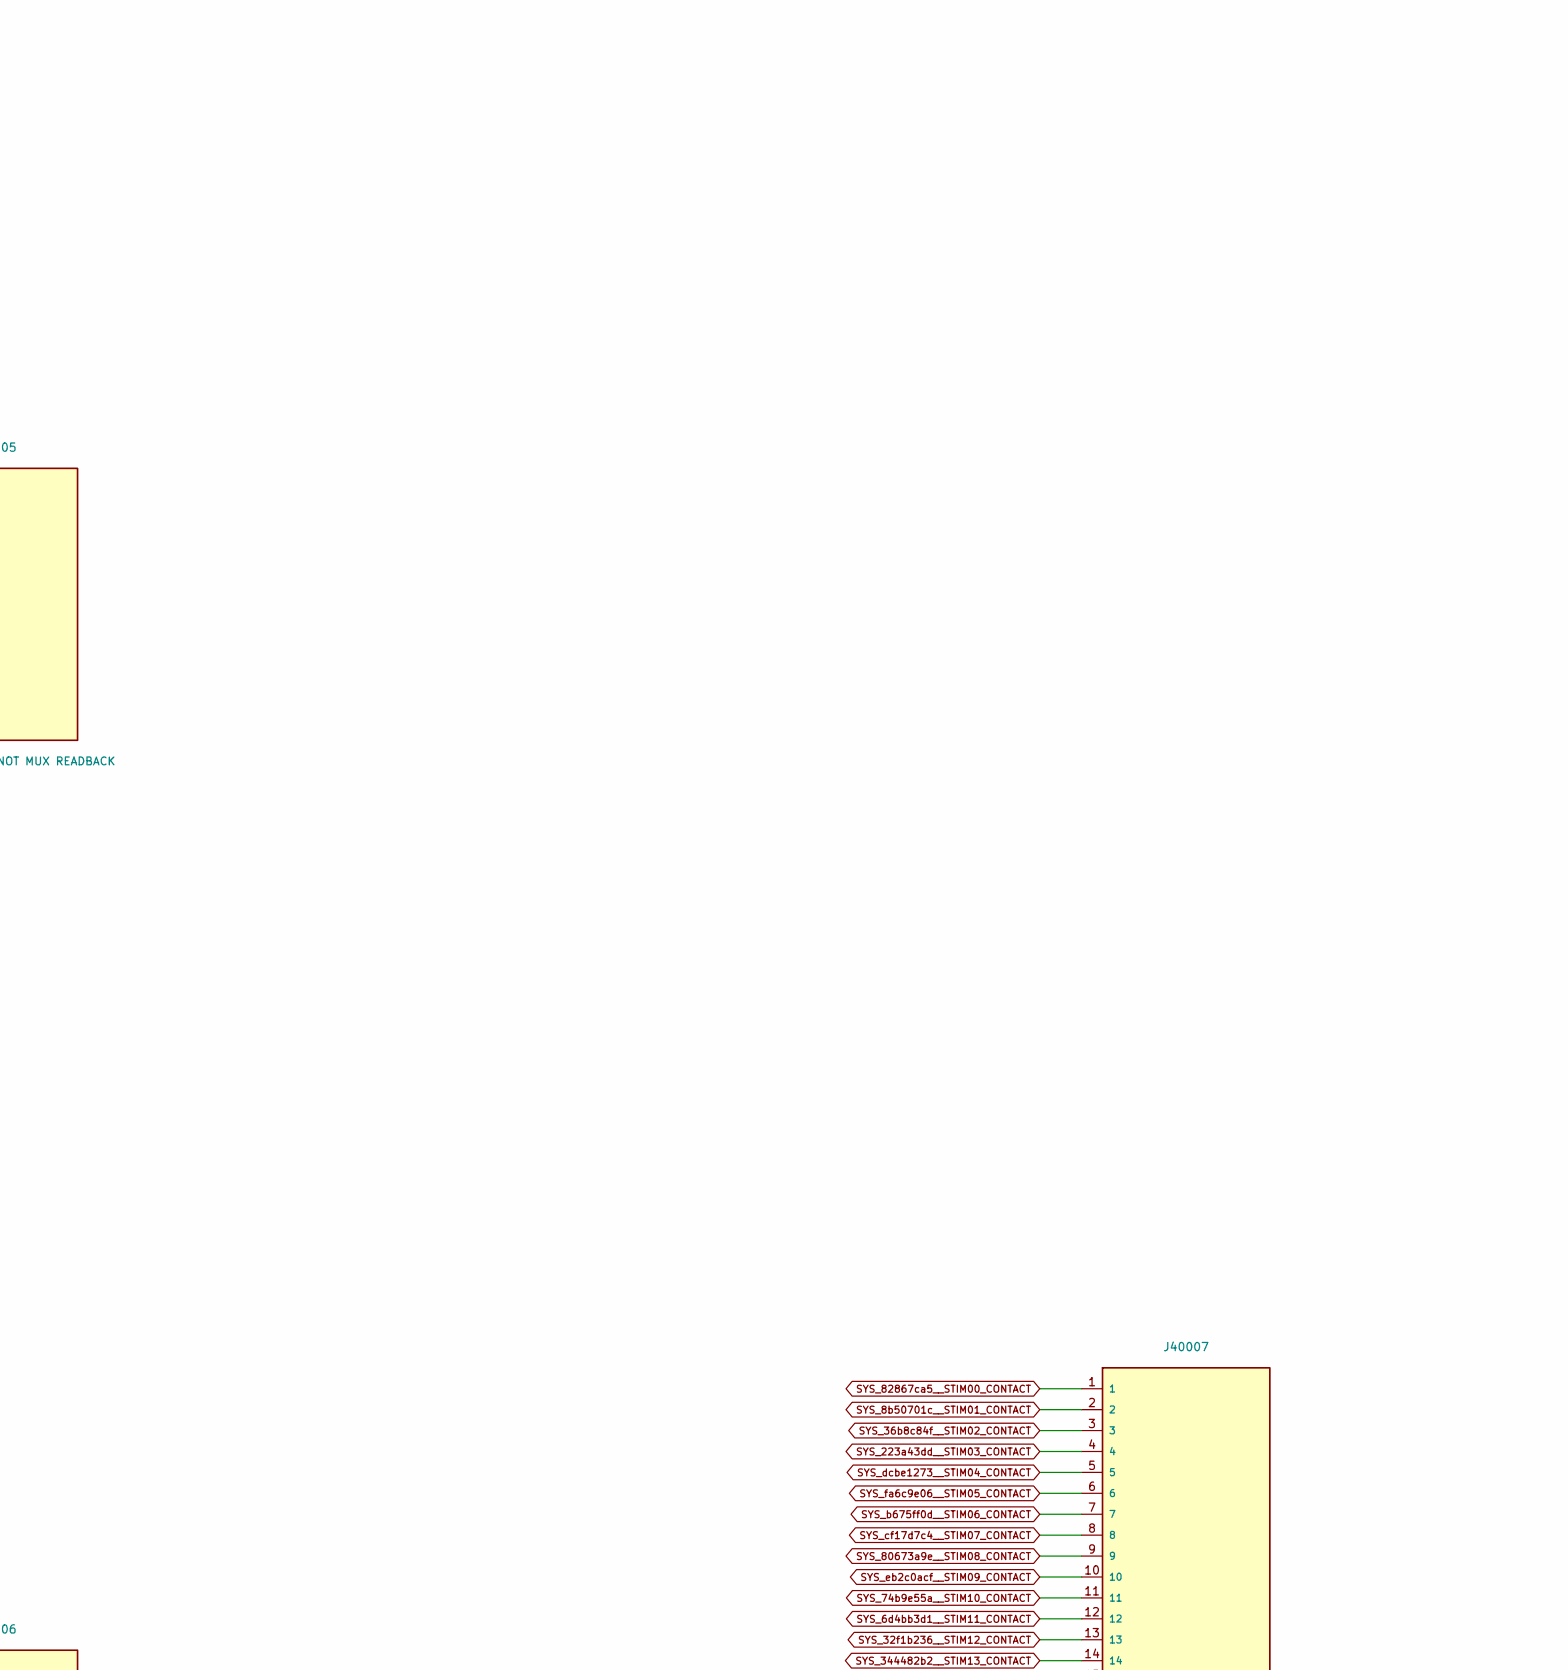
[picture p422: schematic contact_router.kicad_sch, Project SCCI RH S4 / Route interfaces and monitored returns, part in row 1, column 3]

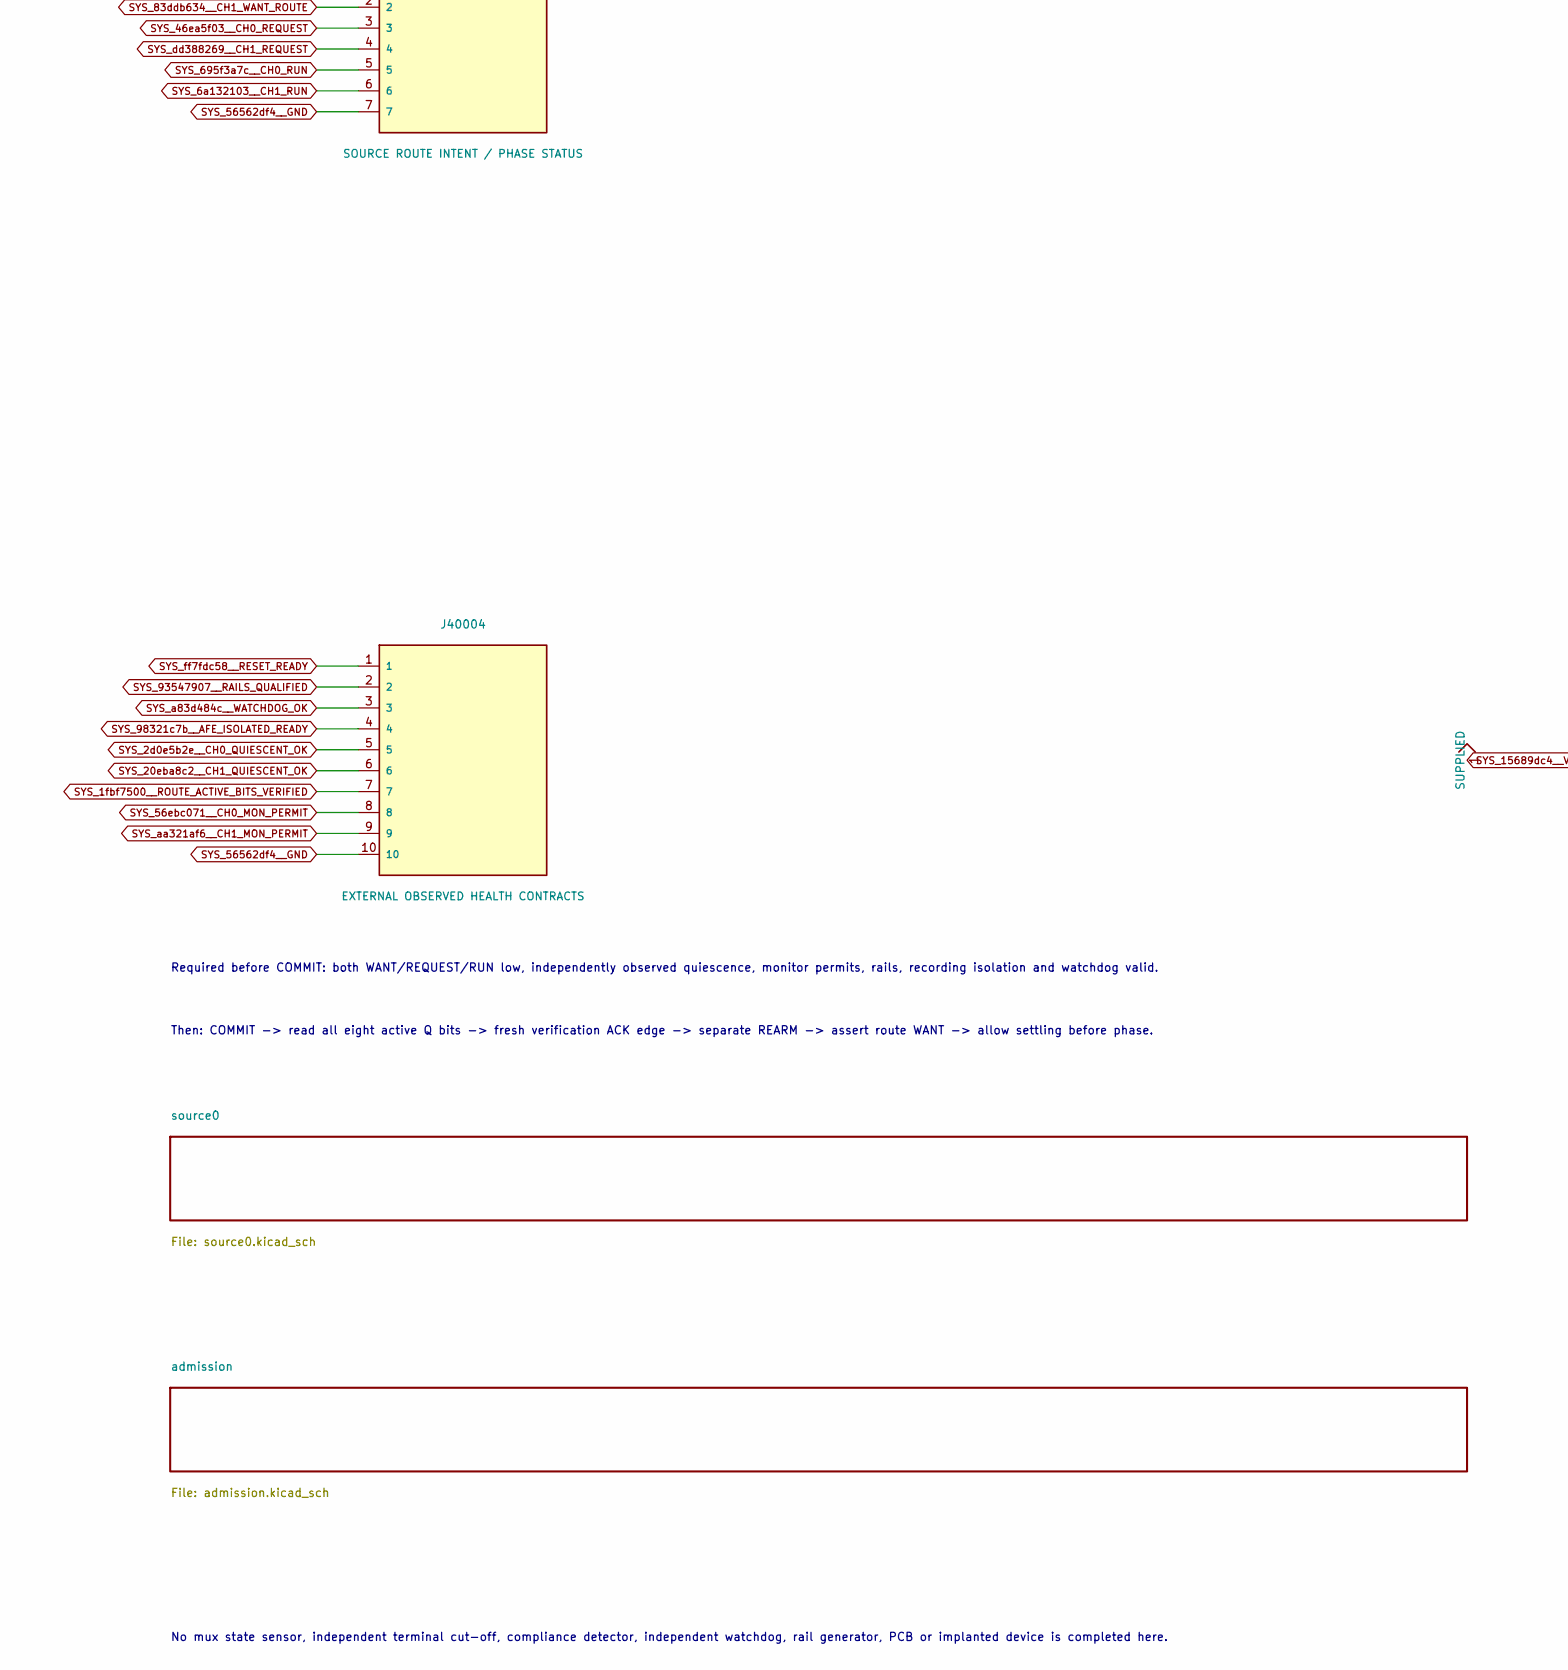
[picture p423: schematic contact_router.kicad_sch, Project SCCI RH S4 / Route interfaces and monitored returns, part in row 2, column 1]

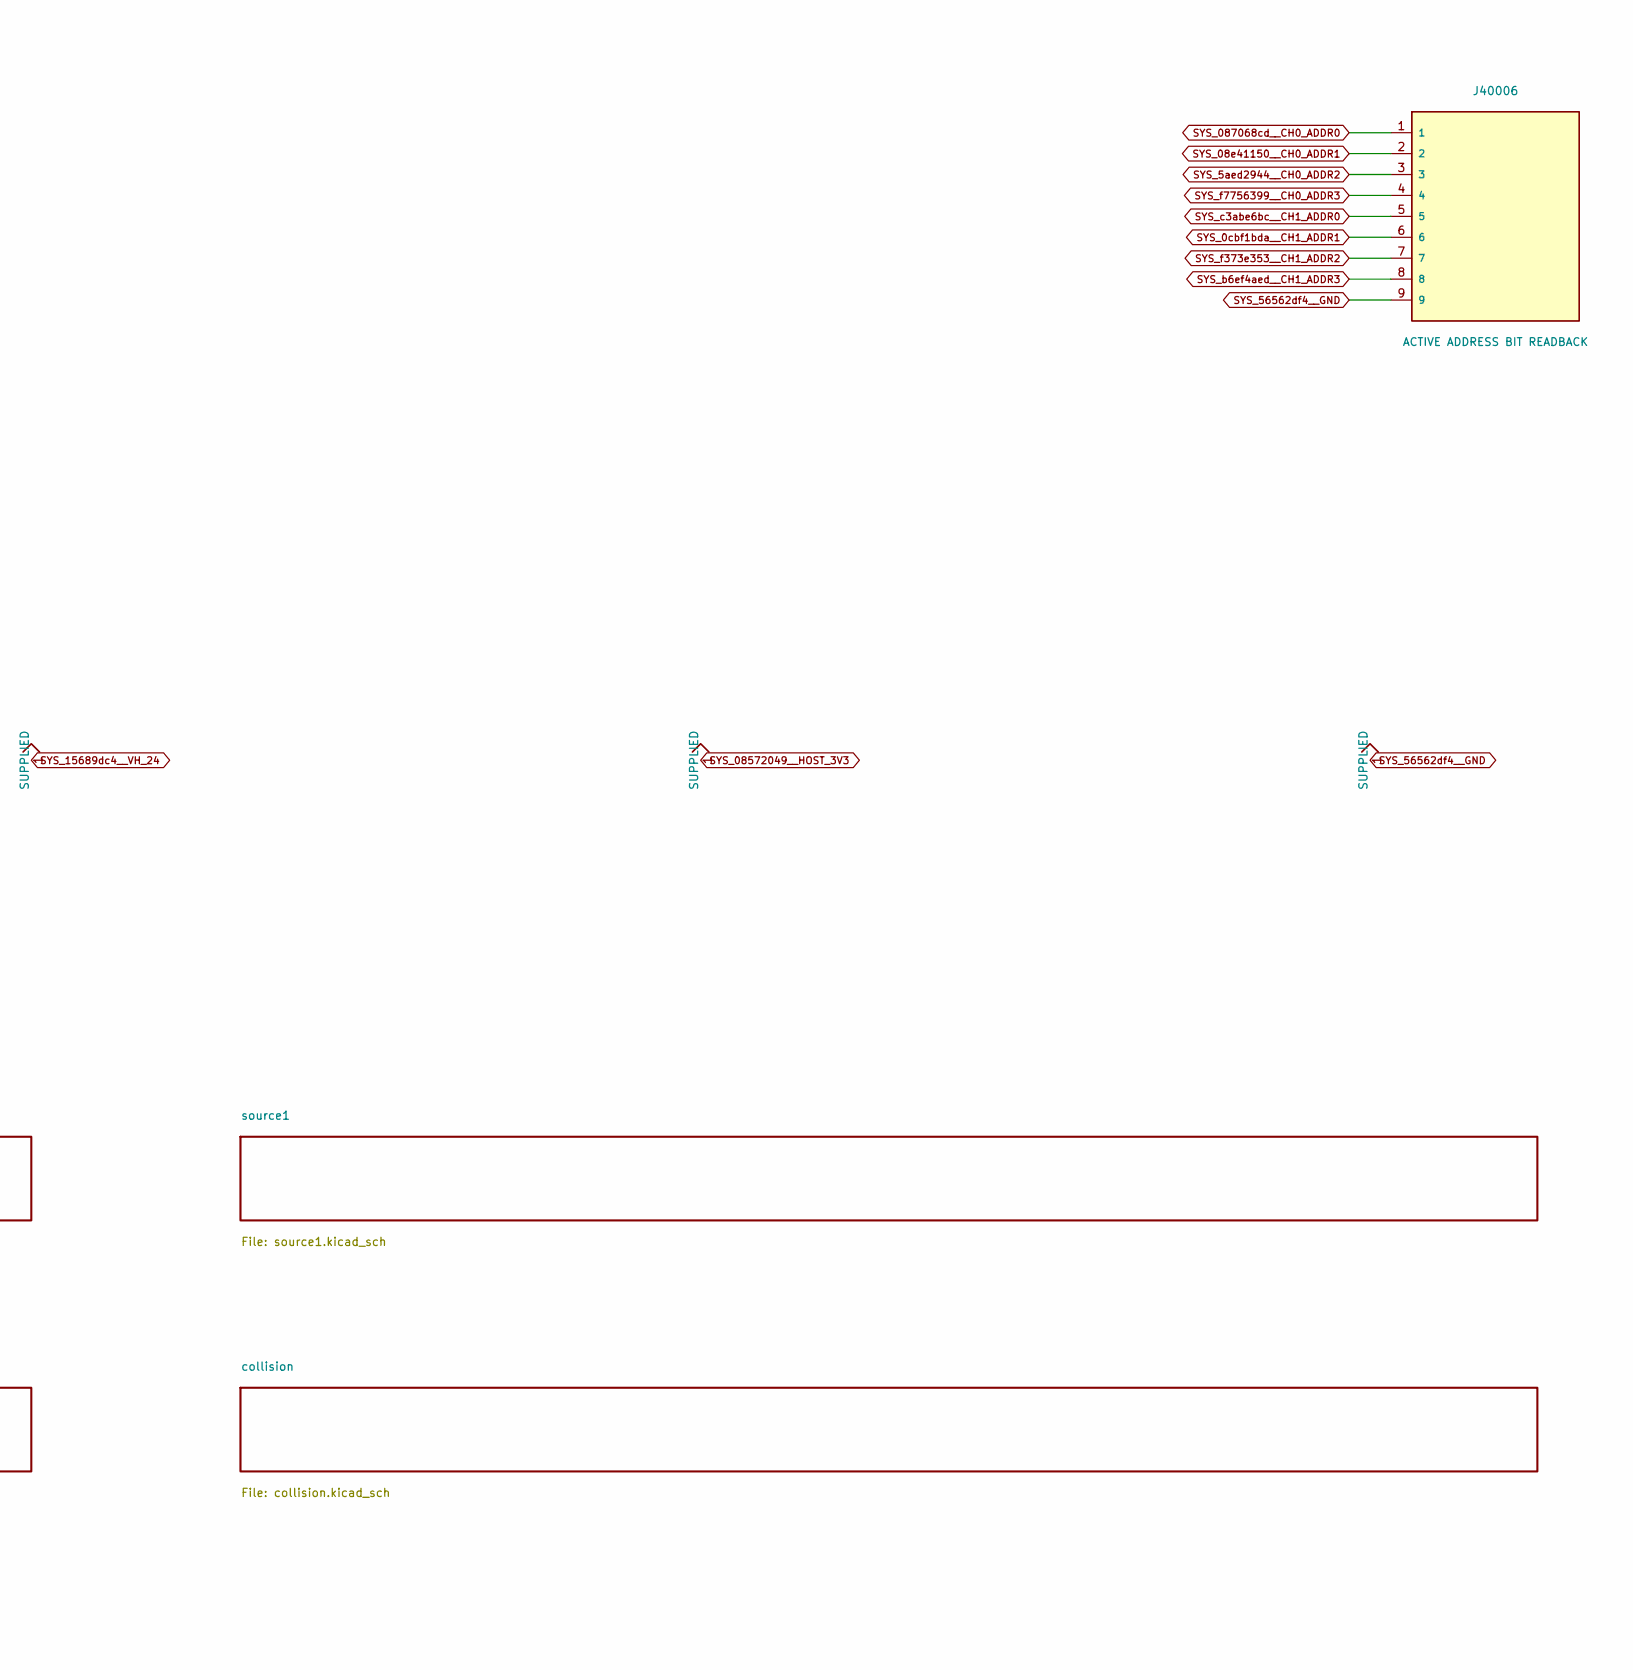
[picture p424: schematic contact_router.kicad_sch, Project SCCI RH S4 / Route interfaces and monitored returns, part in row 2, column 2]

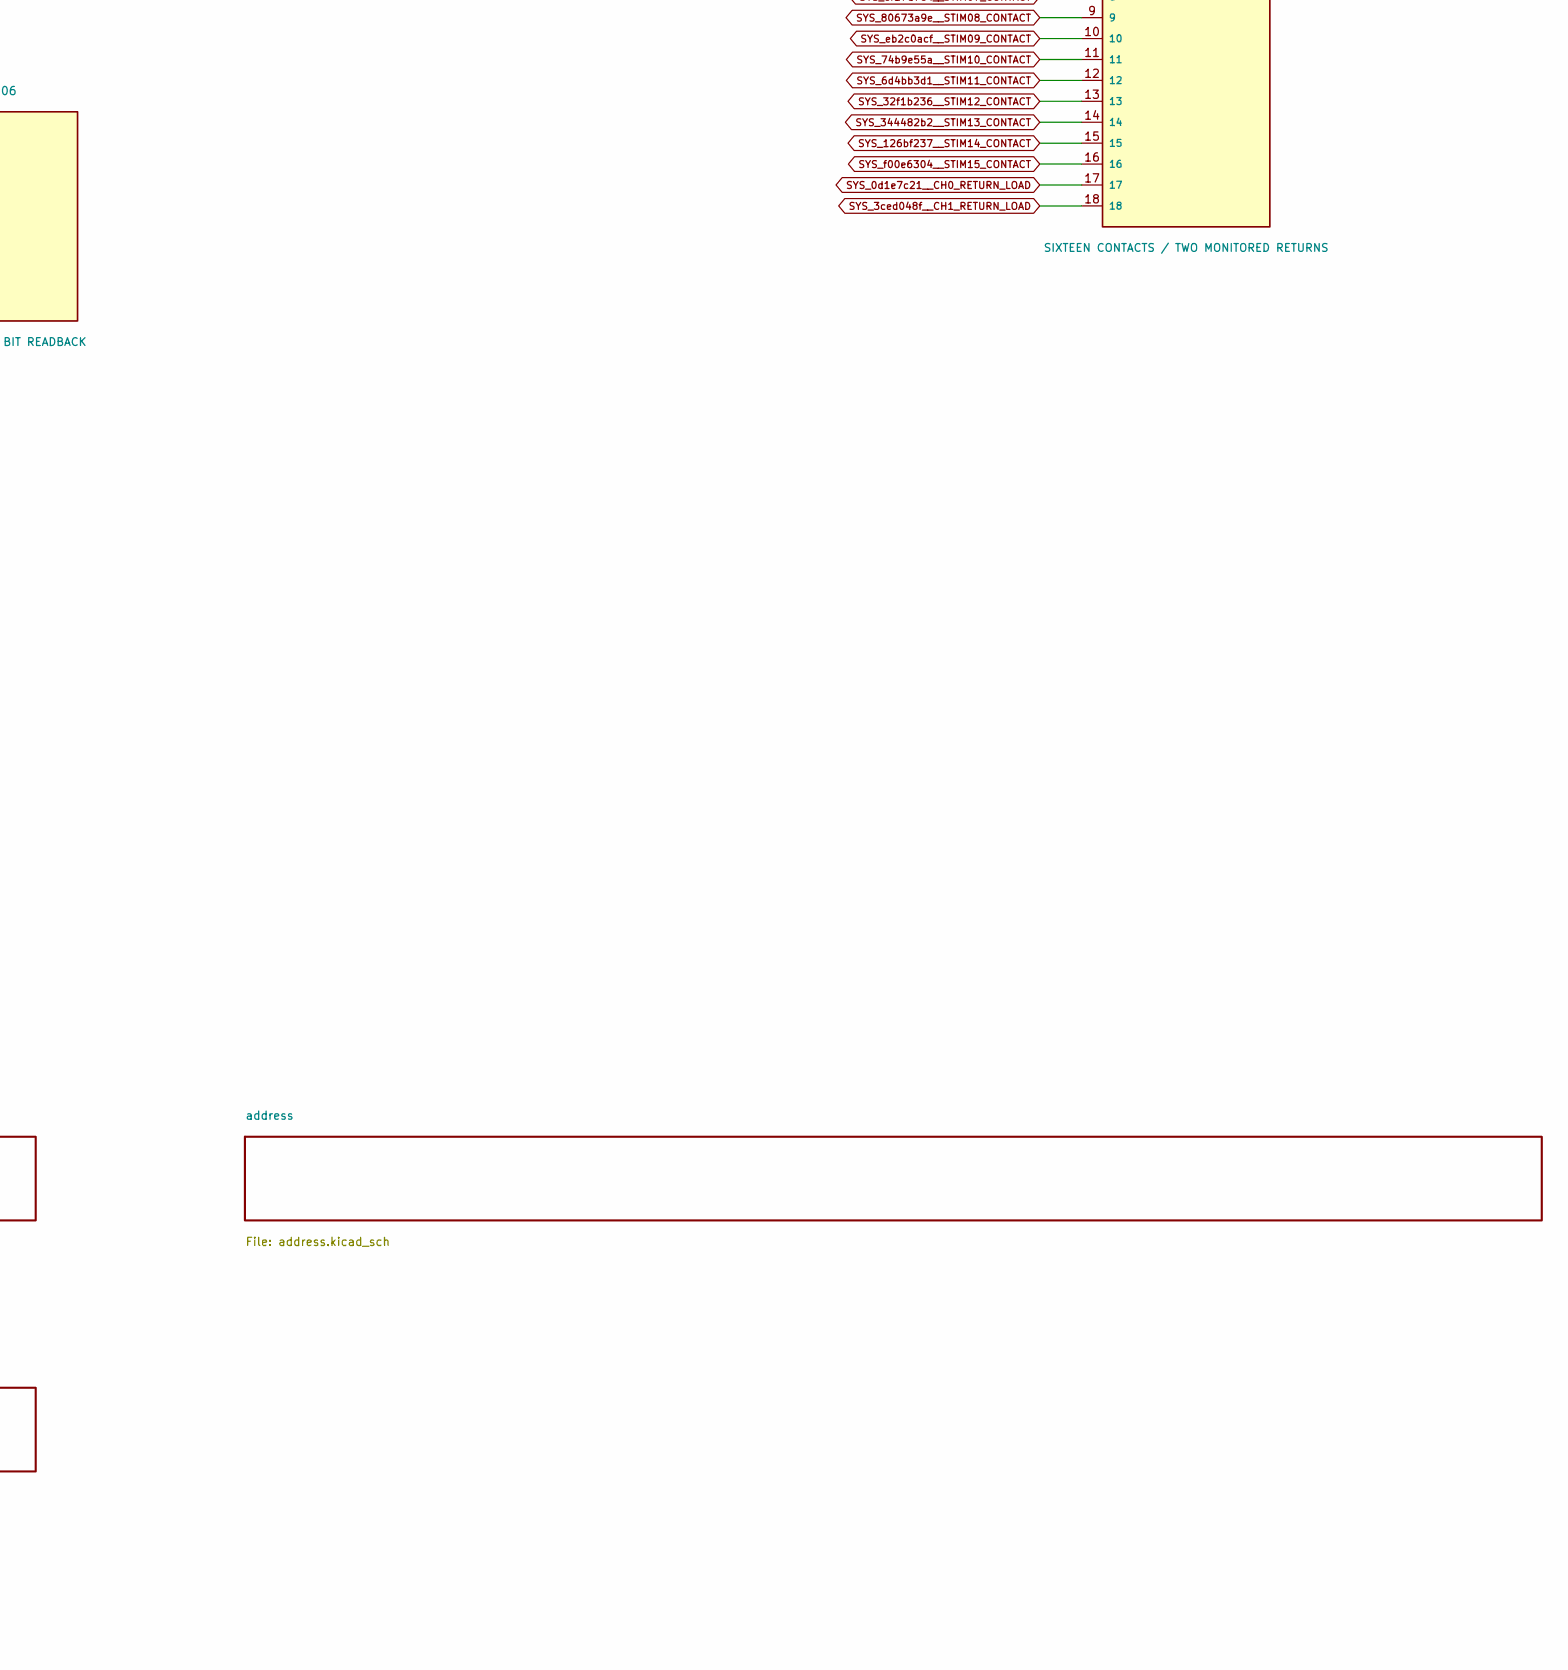
[picture p425: schematic contact_router.kicad_sch, Project SCCI RH S4 / Route interfaces and monitored returns, part in row 2, column 3]

Parts:
J40001: QUALIFIED EXTERNAL RAILS; PinHeader_1x03_P2.54mm_Vertical
J40002: CANDIDATE PRELOAD AND COMMIT; PinHeader_1x07_P2.54mm_Vertical
J40003: SOURCE ROUTE INTENT / PHASE STATUS; PinHeader_1x07_P2.54mm_Vertical
J40004: EXTERNAL OBSERVED HEALTH CONTRACTS; PinHeader_1x10_P2.54mm_Vertical
J40005: COMMAND STATUS / NOT MUX READBACK; PinHeader_1x12_P2.54mm_Vertical
J40006: ACTIVE ADDRESS BIT READBACK; PinHeader_1x09_P2.54mm_Vertical
J40007: SIXTEEN CONTACTS / TWO MONITORED RETURNS; PinHeader_1x18_P2.54mm_Vertical

Connections:
SYS_0cbf1bda__CH1_ADDR1: J40006.6; also elsewhere on the board
SYS_0d1e7c21__CH0_RETURN_LOAD: J40007.17; also elsewhere on the board
SYS_1fbf7500__ROUTE_ACTIVE_BITS_VERIFIED: J40004.7; also elsewhere on the board
SYS_2d0e5b2e__CH0_QUIESCENT_OK: J40004.5; also elsewhere on the board
SYS_3ced048f__CH1_RETURN_LOAD: J40007.18; also elsewhere on the board
SYS_5aed2944__CH0_ADDR2: J40006.3; also elsewhere on the board
SYS_6a132103__CH1_RUN: J40003.6; also elsewhere on the board
SYS_6c012064__ROUTE_COMMAND_READY: J40005.1; also elsewhere on the board
SYS_6d4bb3d1__STIM11_CONTACT: J40007.12; also elsewhere on the board
SYS_8b50701c__STIM01_CONTACT: J40007.2; also elsewhere on the board
SYS_08e41150__CH0_ADDR1: J40006.2; also elsewhere on the board
SYS_11f4403a__ROUTE_SER: J40002.1; also elsewhere on the board
SYS_20eba8c2__CH1_QUIESCENT_OK: J40004.6; also elsewhere on the board
SYS_32f1b236__STIM12_CONTACT: J40007.13; also elsewhere on the board
SYS_36b8c84f__STIM02_CONTACT: J40007.3; also elsewhere on the board
SYS_46ea5f03__CH0_REQUEST: J40003.3; also elsewhere on the board
SYS_56ebc071__CH0_MON_PERMIT: J40004.8; also elsewhere on the board
SYS_74b9e55a__STIM10_CONTACT: J40007.11; also elsewhere on the board
SYS_83ddb634__CH1_WANT_ROUTE: J40003.2; also elsewhere on the board
SYS_84f28705__CH1_ROUTE_LOCKED: J40005.8; also elsewhere on the board
SYS_126bf237__STIM14_CONTACT: J40007.15; also elsewhere on the board
SYS_223a43dd__STIM03_CONTACT: J40007.4; also elsewhere on the board
SYS_695f3a7c__CH0_RUN: J40003.5; also elsewhere on the board
SYS_15689dc4__VH_24: J40001.1; also elsewhere on the board
SYS_56562df4__GND: J40001.3, J40002.7, J40003.7, J40004.10, J40005.12, J40006.9; also elsewhere on the board
SYS_80673a9e__STIM08_CONTACT: J40007.9; also elsewhere on the board
SYS_82867ca5__STIM00_CONTACT: J40007.1; also elsewhere on the board
SYS_087068cd__CH0_ADDR0: J40006.1; also elsewhere on the board
SYS_98321c7b__AFE_ISOLATED_READY: J40004.4; also elsewhere on the board
SYS_344482b2__STIM13_CONTACT: J40007.14; also elsewhere on the board
SYS_1954027d__CH0_ROUTE_LOCKED: J40005.7; also elsewhere on the board
SYS_08572049__HOST_3V3: J40001.2; also elsewhere on the board
SYS_93547907__RAILS_QUALIFIED: J40004.2; also elsewhere on the board
SYS_a83d484c__WATCHDOG_OK: J40004.3; also elsewhere on the board
SYS_aa321af6__CH1_MON_PERMIT: J40004.9; also elsewhere on the board
SYS_b6a3943c__ROUTE_COMMIT: J40002.4; also elsewhere on the board
SYS_b6ef4aed__CH1_ADDR3: J40006.8; also elsewhere on the board
SYS_b675ff0d__STIM06_CONTACT: J40007.7; also elsewhere on the board
SYS_c3abe6bc__CH1_ADDR0: J40006.5; also elsewhere on the board
SYS_cf17d7c4__STIM07_CONTACT: J40007.8; also elsewhere on the board
SYS_d5e1f64a__ROUTE_SRCLK: J40002.2; also elsewhere on the board
SYS_dcbe1273__STIM04_CONTACT: J40007.5; also elsewhere on the board
SYS_dd388269__CH1_REQUEST: J40003.4; also elsewhere on the board
SYS_e338b670__CH0_WANT_ROUTE: J40003.1; also elsewhere on the board
SYS_eb2c0acf__STIM09_CONTACT: J40007.10; also elsewhere on the board
SYS_ed4497b7__ROUTE_REARM: J40002.5; also elsewhere on the board
SYS_f00e6304__STIM15_CONTACT: J40007.16; also elsewhere on the board
SYS_f373e353__CH1_ADDR2: J40006.7; also elsewhere on the board
SYS_f7756399__CH0_ADDR3: J40006.4; also elsewhere on the board
SYS_fa6c9e06__STIM05_CONTACT: J40007.6; also elsewhere on the board
SYS_fd131f77__ROUTE_PRELOAD_LATCH: J40002.3; also elsewhere on the board
SYS_ff7fdc58__RESET_READY: J40004.1; also elsewhere on the board
contact-router__CH0_ROUTE_EN: J40005.5; also elsewhere on the board
contact-router__CH1_ROUTE_EN: J40005.6; also elsewhere on the board
contact-router__COMMIT_SEEN: J40005.11; also elsewhere on the board
contact-router__QUIET_SAFE: J40005.9; also elsewhere on the board
contact-router__READBACK_SEEN: J40005.10; also elsewhere on the board
contact-router__ROUTE_ADDR_EQUAL: J40005.3; also elsewhere on the board
contact-router__ROUTE_BLOCK: J40005.2; also elsewhere on the board
contact-router__ROUTE_CONFLICT: J40005.4; also elsewhere on the board
contact-router__ROUTE_SHIFT_TAIL: J40002.6; also elsewhere on the board

Notes on the sheet:
DIGITAL RESEARCH CIRCUIT / RESTRICTED 24 V, 3 mA SOURCES / ARTIFICIAL LOADS ONLY
Sixteen selectable stimulation contacts, two dedicated monitored returns; command-level routing is not measured continuity or isolation.
Required before COMMIT: both WANT/REQUEST/RUN low, independently observed quiescence, monitor permits, rails, recording isolation and watchdog valid.
Then: COMMIT -> read all eight active Q bits -> fresh verification ACK edge -> separate REARM -> assert route WANT -> allow settling before phase.
No mux state sensor, independent terminal cut-off, compliance detector, independent watchdog, rail generator, PCB or implanted device is completed here.

Schematic: source0.kicad_sch, Project SCCI RH S4 / Source 0 / sixteen-contact output

Parts:
C40100, C40101: 100n X7R 50V; C_0805_2012Metric
C40102, C40103: 1u X7R 50V; C_0805_2012Metric
J40100: DRIVER A / MONITORED RETURN; PinHeader_1x03_P2.54mm_Vertical
R40100, R40101, R40102, R40103, R40104: 22k; R_0805_2012Metric
U40100, U40101: TMUX6208PWR; TSSOP-16_4.4x5mm_P0.65mm

Connections:
SYS_0d1e7c21__CH0_RETURN_LOAD: J40100.2; also elsewhere on the board
SYS_5aed2944__CH0_ADDR2: R40104.1, U40100.15 (A2), U40101.15 (A2); also elsewhere on the board
SYS_6d4bb3d1__STIM11_CONTACT: U40101.7 (S4); also elsewhere on the board
SYS_8b50701c__STIM01_CONTACT: U40100.5 (S2); also elsewhere on the board
SYS_08e41150__CH0_ADDR1: R40103.1, U40100.16 (A1), U40101.16 (A1); also elsewhere on the board
SYS_32f1b236__STIM12_CONTACT: U40101.12 (S5); also elsewhere on the board
SYS_36b8c84f__STIM02_CONTACT: U40100.6 (S3); also elsewhere on the board
SYS_74b9e55a__STIM10_CONTACT: U40101.6 (S3); also elsewhere on the board
SYS_126bf237__STIM14_CONTACT: U40101.10 (S7); also elsewhere on the board
SYS_223a43dd__STIM03_CONTACT: U40100.7 (S4); also elsewhere on the board
SYS_917b1360__CH0_A_ROUTER: J40100.1, U40100.8 (D_COMMON), U40101.8 (D_COMMON)
SYS_15689dc4__VH_24: C40100.1, C40101.1, C40102.1, C40103.1, U40100.13 (VDD), U40101.13 (VDD); also elsewhere on the board
SYS_56562df4__GND: C40100.2, C40101.2, C40102.2, C40103.2, J40100.3, R40100.2, R40101.2, R40102.2, R40103.2, R40104.2, U40100.3 (VSS), U40100.14 (GND), U40101.3 (VSS), U40101.14 (GND); also elsewhere on the board
SYS_80673a9e__STIM08_CONTACT: U40101.4 (S1); also elsewhere on the board
SYS_82867ca5__STIM00_CONTACT: U40100.4 (S1); also elsewhere on the board
SYS_087068cd__CH0_ADDR0: R40102.1, U40100.1 (A0), U40101.1 (A0); also elsewhere on the board
SYS_344482b2__STIM13_CONTACT: U40101.11 (S6); also elsewhere on the board
SYS_b675ff0d__STIM06_CONTACT: U40100.10 (S7); also elsewhere on the board
SYS_cf17d7c4__STIM07_CONTACT: U40100.9 (S8); also elsewhere on the board
SYS_dcbe1273__STIM04_CONTACT: U40100.12 (S5); also elsewhere on the board
SYS_eb2c0acf__STIM09_CONTACT: U40101.5 (S2); also elsewhere on the board
SYS_f00e6304__STIM15_CONTACT: U40101.9 (S8); also elsewhere on the board
SYS_fa6c9e06__STIM05_CONTACT: U40100.11 (S6); also elsewhere on the board
contact-router__CH0_BANK0_EN: R40100.1, U40100.2 (EN_HIGH); also elsewhere on the board
contact-router__CH0_BANK1_EN: R40101.1, U40101.2 (EN_HIGH); also elsewhere on the board

Notes on the sheet:
DIGITAL RESEARCH CIRCUIT / RESTRICTED 24 V, 3 mA SOURCES / ARTIFICIAL LOADS ONLY
Sixteen selectable stimulation contacts, two dedicated monitored returns; command-level routing is not measured continuity or isolation.
Both bank D commons share A_ROUTER. EN0 = ROUTE_EN & !ADDR3; EN1 = ROUTE_EN & ADDR3. Addresses 000..111 select S1..S8.
Dedicated return: external contact -> RETURN_LOAD -> existing monitor 2 ohm shunt -> RETURN_DRIVER -> current-driver B_BR.
Do not bypass the monitor, add a second shunt, tie the two returns, or use recording REF/BIAS as a stimulation return.
TMUX6208 is rail-to-rail at valid 24 V supply; powered-off, stuck-on, parasitic coupling and two-source shared tissue paths remain unqualified.
A_ROUTER needs external terminal guard qualification before connection to A_BR. Internal enable-low is only a commanded off state.

Schematic: source1.kicad_sch, Project SCCI RH S4 / Source 1 / sixteen-contact output

Parts:
C40200, C40201: 100n X7R 50V; C_0805_2012Metric
C40202, C40203: 1u X7R 50V; C_0805_2012Metric
J40200: DRIVER A / MONITORED RETURN; PinHeader_1x03_P2.54mm_Vertical
R40200, R40201, R40202, R40203, R40204: 22k; R_0805_2012Metric
U40200, U40201: TMUX6208PWR; TSSOP-16_4.4x5mm_P0.65mm

Connections:
SYS_0cbf1bda__CH1_ADDR1: R40203.1, U40200.16 (A1), U40201.16 (A1); also elsewhere on the board
SYS_3ced048f__CH1_RETURN_LOAD: J40200.2; also elsewhere on the board
SYS_6d4bb3d1__STIM11_CONTACT: U40201.7 (S4); also elsewhere on the board
SYS_8b50701c__STIM01_CONTACT: U40200.5 (S2); also elsewhere on the board
SYS_32f1b236__STIM12_CONTACT: U40201.12 (S5); also elsewhere on the board
SYS_36b8c84f__STIM02_CONTACT: U40200.6 (S3); also elsewhere on the board
SYS_74b9e55a__STIM10_CONTACT: U40201.6 (S3); also elsewhere on the board
SYS_126bf237__STIM14_CONTACT: U40201.10 (S7); also elsewhere on the board
SYS_223a43dd__STIM03_CONTACT: U40200.7 (S4); also elsewhere on the board
SYS_401be33b__CH1_A_ROUTER: J40200.1, U40200.8 (D_COMMON), U40201.8 (D_COMMON)
SYS_15689dc4__VH_24: C40200.1, C40201.1, C40202.1, C40203.1, U40200.13 (VDD), U40201.13 (VDD); also elsewhere on the board
SYS_56562df4__GND: C40200.2, C40201.2, C40202.2, C40203.2, J40200.3, R40200.2, R40201.2, R40202.2, R40203.2, R40204.2, U40200.3 (VSS), U40200.14 (GND), U40201.3 (VSS), U40201.14 (GND); also elsewhere on the board
SYS_80673a9e__STIM08_CONTACT: U40201.4 (S1); also elsewhere on the board
SYS_82867ca5__STIM00_CONTACT: U40200.4 (S1); also elsewhere on the board
SYS_344482b2__STIM13_CONTACT: U40201.11 (S6); also elsewhere on the board
SYS_b675ff0d__STIM06_CONTACT: U40200.10 (S7); also elsewhere on the board
SYS_c3abe6bc__CH1_ADDR0: R40202.1, U40200.1 (A0), U40201.1 (A0); also elsewhere on the board
SYS_cf17d7c4__STIM07_CONTACT: U40200.9 (S8); also elsewhere on the board
SYS_dcbe1273__STIM04_CONTACT: U40200.12 (S5); also elsewhere on the board
SYS_eb2c0acf__STIM09_CONTACT: U40201.5 (S2); also elsewhere on the board
SYS_f00e6304__STIM15_CONTACT: U40201.9 (S8); also elsewhere on the board
SYS_f373e353__CH1_ADDR2: R40204.1, U40200.15 (A2), U40201.15 (A2); also elsewhere on the board
SYS_fa6c9e06__STIM05_CONTACT: U40200.11 (S6); also elsewhere on the board
contact-router__CH1_BANK0_EN: R40200.1, U40200.2 (EN_HIGH); also elsewhere on the board
contact-router__CH1_BANK1_EN: R40201.1, U40201.2 (EN_HIGH); also elsewhere on the board

Notes on the sheet:
DIGITAL RESEARCH CIRCUIT / RESTRICTED 24 V, 3 mA SOURCES / ARTIFICIAL LOADS ONLY
Sixteen selectable stimulation contacts, two dedicated monitored returns; command-level routing is not measured continuity or isolation.
Both bank D commons share A_ROUTER. EN0 = ROUTE_EN & !ADDR3; EN1 = ROUTE_EN & ADDR3. Addresses 000..111 select S1..S8.
Dedicated return: external contact -> RETURN_LOAD -> existing monitor 2 ohm shunt -> RETURN_DRIVER -> current-driver B_BR.
Do not bypass the monitor, add a second shunt, tie the two returns, or use recording REF/BIAS as a stimulation return.
TMUX6208 is rail-to-rail at valid 24 V supply; powered-off, stuck-on, parasitic coupling and two-source shared tissue paths remain unqualified.
A_ROUTER needs external terminal guard qualification before connection to A_BR. Internal enable-low is only a commanded off state.
