pratham-cloud-ctrl/Project-SCCI-RH/electronics/stage4/integrated-pcb/boards/contact-router/contact_router.kicad_pcb

## KiCad design electronics/stage4/integrated-pcb/boards/contact-router/contact_router.kicad_pcb (continued)

Schematic: address.kicad_sch, Project SCCI RH S4 / Candidate preload and active addresses

Parts:
C40010, C40020, C40021, C40030, C40031, C40032, C40033, C40034, C40035, C40036, C40037: 100n X7R 10V; C_0805_2012Metric
R40010, R40011, R40012, R40013, R40014: 10k; R_0805_2012Metric
U40010: SN74LVC595APWR; TSSOP-16_4.4x5mm_P0.65mm
U40020, U40021: SN74LVC157APWR; TSSOP-16_4.4x5mm_P0.65mm
U40030, U40031, U40032, U40033, U40034, U40035, U40036, U40037: SN74LVC1G74DCUR; VSSOP-8_2.3x2mm_P0.5mm

Connections:
SYS_0cbf1bda__CH1_ADDR1: U40021.5 (2A_HOLD), U40035.5 (Q); also elsewhere on the board
SYS_5aed2944__CH0_ADDR2: U40020.11 (3A_HOLD), U40032.5 (Q); also elsewhere on the board
SYS_08e41150__CH0_ADDR1: U40020.5 (2A_HOLD), U40031.5 (Q); also elsewhere on the board
SYS_11f4403a__ROUTE_SER: R40010.1, U40010.14 (SER); also elsewhere on the board
SYS_56562df4__GND: C40010.2, C40020.2, C40021.2, C40030.2, C40031.2, C40032.2, C40033.2, C40034.2, C40035.2, C40036.2, C40037.2, R40010.2, R40011.2, R40012.2, R40013.2, R40014.2, U40010.8 (GND), U40010.13 (OE_N), U40020.8 (GND), U40020.15 (ENABLE_N), U40021.8 (GND), U40021.15 (ENABLE_N), U40030.4 (GND), U40031.4 (GND), U40032.4 (GND), U40033.4 (GND), U40034.4 (GND), U40035.4 (GND), U40036.4 (GND), U40037.4 (GND); also elsewhere on the board
SYS_087068cd__CH0_ADDR0: U40020.2 (1A_HOLD), U40030.5 (Q); also elsewhere on the board
SYS_08572049__HOST_3V3: C40010.1, C40020.1, C40021.1, C40030.1, C40031.1, C40032.1, C40033.1, C40034.1, C40035.1, C40036.1, C40037.1, U40010.16 (VCC), U40020.16 (VCC), U40021.16 (VCC), U40030.7 (PRE_N), U40030.8 (VCC), U40031.7 (PRE_N), U40031.8 (VCC), U40032.7 (PRE_N), U40032.8 (VCC), U40033.7 (PRE_N), U40033.8 (VCC), U40034.7 (PRE_N), U40034.8 (VCC), U40035.7 (PRE_N), U40035.8 (VCC), U40036.7 (PRE_N), U40036.8 (VCC), U40037.7 (PRE_N), U40037.8 (VCC); also elsewhere on the board
SYS_b6a3943c__ROUTE_COMMIT: R40013.1, U40030.1 (CLK), U40031.1 (CLK), U40032.1 (CLK), U40033.1 (CLK), U40034.1 (CLK), U40035.1 (CLK), U40036.1 (CLK), U40037.1 (CLK); also elsewhere on the board
SYS_b6ef4aed__CH1_ADDR3: U40021.14 (4A_HOLD), U40037.5 (Q); also elsewhere on the board
SYS_c3abe6bc__CH1_ADDR0: U40021.2 (1A_HOLD), U40034.5 (Q); also elsewhere on the board
SYS_d5e1f64a__ROUTE_SRCLK: R40011.1, U40010.11 (SRCLK); also elsewhere on the board
SYS_ed4497b7__ROUTE_REARM: R40014.1; also elsewhere on the board
SYS_f373e353__CH1_ADDR2: U40021.11 (3A_HOLD), U40036.5 (Q); also elsewhere on the board
SYS_f7756399__CH0_ADDR3: U40020.14 (4A_HOLD), U40033.5 (Q); also elsewhere on the board
SYS_fd131f77__ROUTE_PRELOAD_LATCH: R40012.1, U40010.12 (RCLK_PRELOAD); also elsewhere on the board
SYS_ff7fdc58__RESET_READY: U40010.10 (SRCLR_N), U40030.6 (CLR_N), U40031.6 (CLR_N), U40032.6 (CLR_N), U40033.6 (CLR_N), U40034.6 (CLR_N), U40035.6 (CLR_N), U40036.6 (CLR_N), U40037.6 (CLR_N); also elsewhere on the board
contact-router__CH0_ADDR_D0: U40020.4 (1Y), U40030.2 (D)
contact-router__CH0_ADDR_D1: U40020.7 (2Y), U40031.2 (D)
contact-router__CH0_ADDR_D2: U40020.9 (3Y), U40032.2 (D)
contact-router__CH0_ADDR_D3: U40020.12 (4Y), U40033.2 (D)
contact-router__CH0_PENDING0: U40010.15 (QA), U40020.3 (1B_CANDIDATE)
contact-router__CH0_PENDING1: U40010.1 (QB), U40020.6 (2B_CANDIDATE)
contact-router__CH0_PENDING2: U40010.2 (QC), U40020.10 (3B_CANDIDATE)
contact-router__CH0_PENDING3: U40010.3 (QD), U40020.13 (4B_CANDIDATE)
contact-router__CH1_ADDR_D0: U40021.4 (1Y), U40034.2 (D)
contact-router__CH1_ADDR_D1: U40021.7 (2Y), U40035.2 (D)
contact-router__CH1_ADDR_D2: U40021.9 (3Y), U40036.2 (D)
contact-router__CH1_ADDR_D3: U40021.12 (4Y), U40037.2 (D)
contact-router__CH1_PENDING0: U40010.4 (QE), U40021.3 (1B_CANDIDATE)
contact-router__CH1_PENDING1: U40010.5 (QF), U40021.6 (2B_CANDIDATE)
contact-router__CH1_PENDING2: U40010.6 (QG), U40021.10 (3B_CANDIDATE)
contact-router__CH1_PENDING3: U40010.7 (QH), U40021.13 (4B_CANDIDATE)
contact-router__QUIET_SAFE: U40020.1 (SELECT_SAFE), U40021.1 (SELECT_SAFE); also elsewhere on the board
contact-router__ROUTE_SHIFT_TAIL: U40010.9 (QH_SHIFT); also elsewhere on the board

Notes on the sheet:
DIGITAL RESEARCH CIRCUIT / RESTRICTED 24 V, 3 mA SOURCES / ARTIFICIAL LOADS ONLY
Sixteen selectable stimulation contacts, two dedicated monitored returns; command-level routing is not measured continuity or isolation.
Candidate bits may change without changing active addresses. Eight active flip-flops always see raw COMMIT clock; safe D selection loads or holds.
RESET_READY low asynchronously clears active bits to zero; outputs remain inhibited until legal COMMIT, fresh readback ACK and deliberate REARM.
SRCLR affects only the candidate shift stage. QH_SHIFT is payload cascade, not active-address or analog switch readback. Actual Q bits appear at J6.
QUIET_SAFE and candidate data must meet physical setup/hold. Gate delay, asynchronous clear, metastability and clock-integrity qualification remain.

Schematic: admission.kicad_sch, Project SCCI RH S4 / Commit, acknowledgement and rearm

Parts:
C40300, C40301, C40302, C40303, C40304, C40305, C40306, C40307, C40308, C40309, C40310, C40311, C40312, C40313, C40314, C40315, C40316, C40317, C40318, C40319, C40320, C40321: 100n X7R 10V; C_0805_2012Metric
R40300, R40301, R40302, R40303, R40304, R40305, R40306, R40307, R40308, R40309, R40310, R40311, R40312, R40313, R40314: 10k; R_0805_2012Metric
U40300, U40301, U40309, U40310, U40313, U40317, U40319: SN74LVC1G11DBVR; SOT-23-6
U40302, U40315, U40320: SN74LVC1G08DBVR; SOT-23-5
U40303, U40305, U40306, U40307: SN74LVC1G32DBVR; SOT-23-5
U40304, U40308, U40311, U40312, U40321: SN74LVC1G04DBVR; SOT-23-5
U40314, U40316, U40318: SN74LVC1G74DCUR; VSSOP-8_2.3x2mm_P0.5mm

Connections:
SYS_1fbf7500__ROUTE_ACTIVE_BITS_VERIFIED: R40306.1, U40316.1 (CLK); also elsewhere on the board
SYS_2d0e5b2e__CH0_QUIESCENT_OK: R40304.1, U40309.1 (A); also elsewhere on the board
SYS_6a132103__CH1_RUN: R40314.1, U40306.2 (B); also elsewhere on the board
SYS_6c012064__ROUTE_COMMAND_READY: U40320.4 (Y); also elsewhere on the board
SYS_20eba8c2__CH1_QUIESCENT_OK: R40305.1, U40309.3 (B); also elsewhere on the board
SYS_46ea5f03__CH0_REQUEST: R40311.1, U40305.1 (A); also elsewhere on the board
SYS_56ebc071__CH0_MON_PERMIT: R40307.1, U40301.3 (B); also elsewhere on the board
SYS_83ddb634__CH1_WANT_ROUTE: R40310.1, U40303.2 (B); also elsewhere on the board
SYS_695f3a7c__CH0_RUN: R40313.1, U40306.1 (A); also elsewhere on the board
SYS_56562df4__GND: C40300.2, C40301.2, C40302.2, C40303.2, C40304.2, C40305.2, C40306.2, C40307.2, C40308.2, C40309.2, C40310.2, C40311.2, C40312.2, C40313.2, C40314.2, C40315.2, C40316.2, C40317.2, C40318.2, C40319.2, C40320.2, C40321.2, R40300.2, R40301.2, R40302.2, R40303.2, R40304.2, R40305.2, R40306.2, R40307.2, R40308.2, R40309.2, R40310.2, R40311.2, R40312.2, R40313.2, R40314.2, U40300.2 (GND), U40301.2 (GND), U40302.3 (GND), U40303.3 (GND), U40304.3 (GND), U40305.3 (GND), U40306.3 (GND), U40307.3 (GND), U40308.3 (GND), U40309.2 (GND), U40310.2 (GND), U40311.3 (GND), U40312.3 (GND), U40313.2 (GND), U40314.4 (GND), U40315.3 (GND), U40316.4 (GND), U40317.2 (GND), U40318.4 (GND), U40319.2 (GND), U40320.3 (GND), U40321.3 (GND); also elsewhere on the board
SYS_98321c7b__AFE_ISOLATED_READY: R40303.1, U40301.1 (A); also elsewhere on the board
SYS_08572049__HOST_3V3: C40300.1, C40301.1, C40302.1, C40303.1, C40304.1, C40305.1, C40306.1, C40307.1, C40308.1, C40309.1, C40310.1, C40311.1, C40312.1, C40313.1, C40314.1, C40315.1, C40316.1, C40317.1, C40318.1, C40319.1, C40320.1, C40321.1, U40300.5 (VCC), U40301.5 (VCC), U40302.5 (VCC), U40303.5 (VCC), U40304.5 (VCC), U40305.5 (VCC), U40306.5 (VCC), U40307.5 (VCC), U40308.5 (VCC), U40309.5 (VCC), U40310.5 (VCC), U40311.5 (VCC), U40312.5 (VCC), U40313.5 (VCC), U40314.7 (PRE_N), U40314.8 (VCC), U40315.5 (VCC), U40316.7 (PRE_N), U40316.8 (VCC), U40317.5 (VCC), U40318.7 (PRE_N), U40318.8 (VCC), U40319.5 (VCC), U40320.5 (VCC), U40321.5 (VCC); also elsewhere on the board
SYS_93547907__RAILS_QUALIFIED: R40301.1, U40300.3 (B); also elsewhere on the board
SYS_a83d484c__WATCHDOG_OK: R40302.1, U40300.6 (C); also elsewhere on the board
SYS_aa321af6__CH1_MON_PERMIT: R40308.1, U40301.6 (C); also elsewhere on the board
SYS_b6a3943c__ROUTE_COMMIT: U40311.2 (A), U40314.1 (CLK); also elsewhere on the board
SYS_dd388269__CH1_REQUEST: R40312.1, U40305.2 (B); also elsewhere on the board
SYS_e338b670__CH0_WANT_ROUTE: R40309.1, U40303.1 (A); also elsewhere on the board
SYS_ed4497b7__ROUTE_REARM: U40318.1 (CLK); also elsewhere on the board
SYS_ff7fdc58__RESET_READY: R40300.1, U40300.1 (A); also elsewhere on the board
contact-router__ACK_CLR_N: U40315.4 (Y), U40316.6 (CLR_N)
contact-router__ANY_PHASE: U40307.4 (Y), U40308.2 (A)
contact-router__ANY_REQUEST: U40305.4 (Y), U40307.1 (A)
contact-router__ANY_RUN: U40306.4 (Y), U40307.2 (B)
contact-router__ANY_WANT: U40303.4 (Y), U40304.2 (A)
contact-router__BASE_HEALTH: U40302.4 (Y), U40309.6 (C), U40313.1 (A), U40314.6 (CLR_N), U40315.1 (A), U40319.3 (B)
contact-router__COMMIT_N: U40311.4 (Y), U40313.3 (B), U40315.2 (B), U40319.6 (C)
contact-router__COMMIT_SEEN: U40314.5 (Q), U40316.2 (D), U40317.1 (A); also elsewhere on the board
contact-router__HEALTH_A: U40300.4 (Y), U40302.1 (A)
contact-router__HEALTH_B: U40301.4 (Y), U40302.2 (B)
contact-router__NO_CONFLICT: U40312.4 (Y), U40313.6 (C), U40320.2 (B)
contact-router__NO_PHASE: U40308.4 (Y), U40310.3 (B)
contact-router__NO_WANT: U40304.4 (Y), U40310.1 (A)
contact-router__QUIET_HEALTH: U40309.4 (Y), U40310.6 (C)
contact-router__QUIET_SAFE: U40310.4 (Y), U40314.2 (D), U40317.3 (B); also elsewhere on the board
contact-router__READBACK_SEEN: U40316.5 (Q), U40317.6 (C); also elsewhere on the board
contact-router__READY_A: U40319.4 (Y), U40320.1 (A)
contact-router__REARM_D: U40317.4 (Y), U40318.2 (D)
contact-router__ROUTE_BLOCK: U40321.4 (Y); also elsewhere on the board
contact-router__ROUTE_CONFLICT: U40312.2 (A); also elsewhere on the board
contact-router__ROUTE_VALID: U40318.5 (Q), U40319.1 (A), U40321.2 (A)
contact-router__VALID_CLR_N: U40313.4 (Y), U40318.6 (CLR_N)

Notes on the sheet:
DIGITAL RESEARCH CIRCUIT / RESTRICTED 24 V, 3 mA SOURCES / ARTIFICIAL LOADS ONLY
Sixteen selectable stimulation contacts, two dedicated monitored returns; command-level routing is not measured continuity or isolation.
BASE_HEALTH = RESET & RAILS & WATCHDOG & AFE_ISOLATED_READY & MON0 & MON1; QUIET_SAFE additionally requires both WANT/REQUEST/RUN low and quiescence.
Any COMMIT invalidates prior validation and ACK. Illegal COMMIT holds active bits and captures COMMIT_SEEN=0.
Rearm needs a fresh post-commit ACK edge. Health recovery or collision removal cannot create a clock edge or restart output.
Ideal logic only: setup/hold, all-off settling, voltage, independent watchdog and actual current observation remain mandatory.

Schematic: collision.kicad_sch, Project SCCI RH S4 / Conflict and bank enables

Parts:
C40400, C40401, C40402, C40403, C40404, C40405, C40406, C40407, C40408, C40409, C40410, C40411, C40412, C40413, C40414, C40415, C40416, C40417, C40418: 100n X7R 10V; C_0805_2012Metric
U40400, U40401, U40402, U40403: SN74LVC1G86DBVR; SOT-23-5
U40404, U40405, U40406: SN74LVC1G32DBVR; SOT-23-5
U40407, U40410, U40415: SN74LVC1G04DBVR; SOT-23-5
U40408: SN74LVC1G11DBVR; SOT-23-6
U40409, U40411, U40412, U40413, U40414, U40416, U40417, U40418: SN74LVC1G08DBVR; SOT-23-5

Connections:
SYS_0cbf1bda__CH1_ADDR1: U40401.2 (B); also elsewhere on the board
SYS_5aed2944__CH0_ADDR2: U40402.1 (A); also elsewhere on the board
SYS_6c012064__ROUTE_COMMAND_READY: U40409.1 (A), U40413.1 (A), U40414.1 (A), U40418.1 (A); also elsewhere on the board
SYS_08e41150__CH0_ADDR1: U40401.1 (A); also elsewhere on the board
SYS_83ddb634__CH1_WANT_ROUTE: U40408.3 (B), U40414.2 (B), U40418.2 (B); also elsewhere on the board
SYS_84f28705__CH1_ROUTE_LOCKED: U40418.4 (Y); also elsewhere on the board
SYS_56562df4__GND: C40400.2, C40401.2, C40402.2, C40403.2, C40404.2, C40405.2, C40406.2, C40407.2, C40408.2, C40409.2, C40410.2, C40411.2, C40412.2, C40413.2, C40414.2, C40415.2, C40416.2, C40417.2, C40418.2, U40400.3 (GND), U40401.3 (GND), U40402.3 (GND), U40403.3 (GND), U40404.3 (GND), U40405.3 (GND), U40406.3 (GND), U40407.3 (GND), U40408.2 (GND), U40409.3 (GND), U40410.3 (GND), U40411.3 (GND), U40412.3 (GND), U40413.3 (GND), U40414.3 (GND), U40415.3 (GND), U40416.3 (GND), U40417.3 (GND), U40418.3 (GND); also elsewhere on the board
SYS_087068cd__CH0_ADDR0: U40400.1 (A); also elsewhere on the board
SYS_1954027d__CH0_ROUTE_LOCKED: U40413.4 (Y); also elsewhere on the board
SYS_08572049__HOST_3V3: C40400.1, C40401.1, C40402.1, C40403.1, C40404.1, C40405.1, C40406.1, C40407.1, C40408.1, C40409.1, C40410.1, C40411.1, C40412.1, C40413.1, C40414.1, C40415.1, C40416.1, C40417.1, C40418.1, U40400.5 (VCC), U40401.5 (VCC), U40402.5 (VCC), U40403.5 (VCC), U40404.5 (VCC), U40405.5 (VCC), U40406.5 (VCC), U40407.5 (VCC), U40408.5 (VCC), U40409.5 (VCC), U40410.5 (VCC), U40411.5 (VCC), U40412.5 (VCC), U40413.5 (VCC), U40414.5 (VCC), U40415.5 (VCC), U40416.5 (VCC), U40417.5 (VCC), U40418.5 (VCC); also elsewhere on the board
SYS_b6ef4aed__CH1_ADDR3: U40403.2 (B), U40415.2 (A), U40417.2 (B); also elsewhere on the board
SYS_c3abe6bc__CH1_ADDR0: U40400.2 (B); also elsewhere on the board
SYS_e338b670__CH0_WANT_ROUTE: U40408.1 (A), U40409.2 (B), U40413.2 (B); also elsewhere on the board
SYS_f373e353__CH1_ADDR2: U40402.2 (B); also elsewhere on the board
SYS_f7756399__CH0_ADDR3: U40403.1 (A), U40410.2 (A), U40412.2 (B); also elsewhere on the board
contact-router__ADDR_ANY_DIFF: U40406.4 (Y), U40407.2 (A)
contact-router__ADDR_DIFF0: U40400.4 (Y), U40404.1 (A)
contact-router__ADDR_DIFF1: U40401.4 (Y), U40404.2 (B)
contact-router__ADDR_DIFF2: U40402.4 (Y), U40405.1 (A)
contact-router__ADDR_DIFF3: U40403.4 (Y), U40405.2 (B)
contact-router__ADDR_DIFF_HI: U40405.4 (Y), U40406.2 (B)
contact-router__ADDR_DIFF_LO: U40404.4 (Y), U40406.1 (A)
contact-router__CH0_BANK0_EN: U40411.4 (Y); also elsewhere on the board
contact-router__CH0_BANK0_SELECT: U40410.4 (Y), U40411.2 (B)
contact-router__CH0_BANK1_EN: U40412.4 (Y); also elsewhere on the board
contact-router__CH0_ROUTE_EN: U40409.4 (Y), U40411.1 (A), U40412.1 (A); also elsewhere on the board
contact-router__CH1_BANK0_EN: U40416.4 (Y); also elsewhere on the board
contact-router__CH1_BANK0_SELECT: U40415.4 (Y), U40416.2 (B)
contact-router__CH1_BANK1_EN: U40417.4 (Y); also elsewhere on the board
contact-router__CH1_ROUTE_EN: U40414.4 (Y), U40416.1 (A), U40417.1 (A); also elsewhere on the board
contact-router__ROUTE_ADDR_EQUAL: U40407.4 (Y), U40408.6 (C); also elsewhere on the board
contact-router__ROUTE_CONFLICT: U40408.4 (Y); also elsewhere on the board

Notes on the sheet:
DIGITAL RESEARCH CIRCUIT / RESTRICTED 24 V, 3 mA SOURCES / ARTIFICIAL LOADS ONLY
Sixteen selectable stimulation contacts, two dedicated monitored returns; command-level routing is not measured continuity or isolation.
Conflict = WANT0 & WANT1 & equal(all four active address bits). It disables BOTH bank families and asynchronously clears route validation.
Removing a conflict only removes its fault condition; it does not restore VALID. Release both WANTs, verify quiet, then explicitly rearm.
The two source enables may coexist only at different contacts. Common tissue impedance and volume conduction are outside this digital collision test.
ROUTE_LOCKED means admitted digital command ownership only. No selected-contact continuity or power-off isolation is inferred.

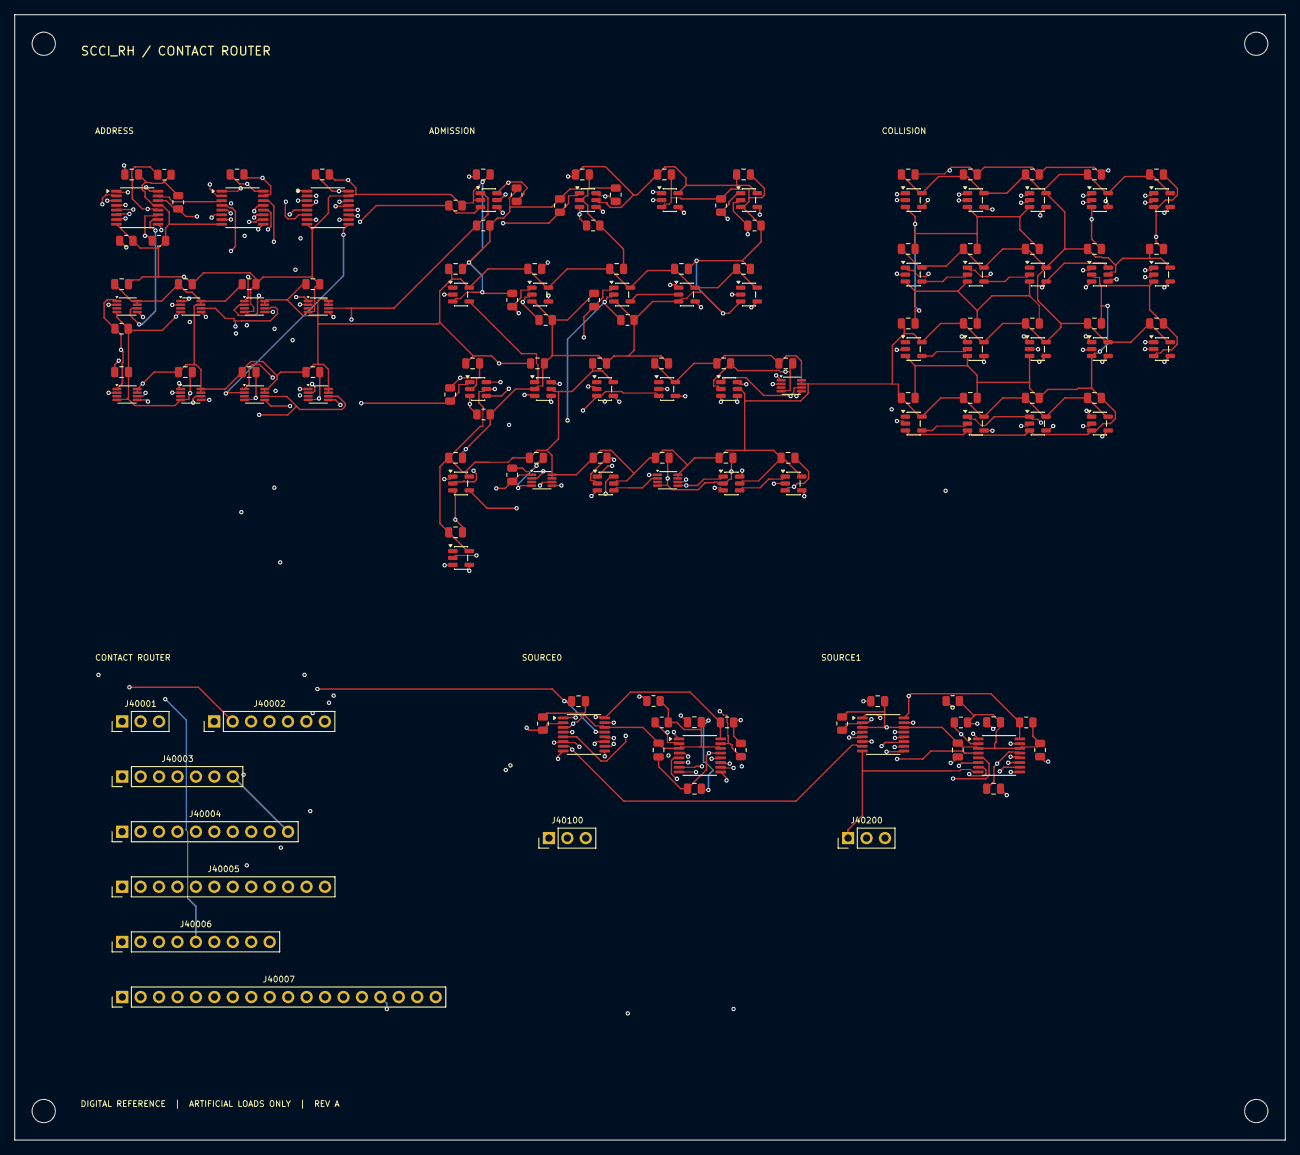
[picture p426: board contact_router.kicad_pcb from above]

Board: 4 copper layers, 175.0 x 155.0 mm, 159 parts (0 on the bottom side), 109 nets.

Other parts of the board:
H1, H2, H3, H4: MountingHole_3.2mm_M3
