pratham-cloud-ctrl/Project-SCCI-RH/electronics/stage4/integrated-pcb/boards/power/power.kicad_pcb

## KiCad design electronics/stage4/integrated-pcb/boards/power/power.kicad_pcb (2026-10-29)

Schematic: power.kicad_sch, Project SCCI RH S4 / Interfaces and rail handoff

Parts:
J60001: AT31004 PROTECTED 2S PACK / 6.4 TO 8.4V; PinHeader_1x02_P2.54mm_Vertical
J60002: POWER REQUEST / STATUS; PinHeader_1x12_P2.54mm_Vertical
J60003: HOST AND SUPERVISOR RAILS; PinHeader_1x07_P2.54mm_Vertical
J60004: FLOATING RECORDING RAILS; PinHeader_1x04_P2.54mm_Vertical
J60005: CONVERTER TEST POINTS; PinHeader_1x05_P2.54mm_Vertical
J60006: EXISTING MONITOR REFERENCES; PinHeader_1x03_P2.54mm_Vertical

Connections:
SYS_3fdd5066__AFE_P5: J60004.2; also elsewhere on the board
SYS_4f66f129__MON_VREF: J60006.1; also elsewhere on the board
SYS_37cfe02a__MON_VMID: J60006.2; also elsewhere on the board
SYS_65aafbb6__AFE_3V3: J60004.1; also elsewhere on the board
SYS_66aba95b__SUP_5: J60003.2; also elsewhere on the board
SYS_15689dc4__VH_24: J60003.6; also elsewhere on the board
SYS_56562df4__GND: J60001.2, J60002.12, J60003.7, J60005.5, J60006.3; also elsewhere on the board
SYS_08572049__HOST_3V3: J60003.3; also elsewhere on the board
SYS_ab932142__SUP_3V3: J60002.10, J60003.1; also elsewhere on the board
SYS_ce166826__HOST_5: J60003.4; also elsewhere on the board
SYS_d73cd2ee__AFE_N5: J60004.3; also elsewhere on the board
SYS_ee59c76b__PWR_FAULT_N: J60002.11; also elsewhere on the board
SYS_f199d834__PACK_BUS: J60005.1; also elsewhere on the board
SYS_fb2237f8__VA_15: J60003.5; also elsewhere on the board
SYS_fca1c340__AFEAGND: J60004.4, J60005.4; also elsewhere on the board
power__BATT_OK: J60002.3; also elsewhere on the board
power__BOOST_ENABLE: J60002.5; also elsewhere on the board
power__HOST_3V3_PG: J60002.6; also elsewhere on the board
power__HOST_5_PG: J60002.7; also elsewhere on the board
power__HOST_ENABLE: J60002.4; also elsewhere on the board
power__ISO_N12: J60005.3; also elsewhere on the board
power__ISO_P12: J60005.2; also elsewhere on the board
power__PACK_POS: J60001.1; also elsewhere on the board
power__PWR_REQUEST: J60002.1; also elsewhere on the board
power__SUP_3V3_PG: J60002.8; also elsewhere on the board
power__SUP_5_PG: J60002.9; also elsewhere on the board
power__SUP_READY: J60002.2; also elsewhere on the board

Notes on the sheet:
DIGITAL SCCI ENGINEERING / ARTIFICIAL LOADS / BATTERY AND POWER
2S protected pack, independent supervisor rails, host converters and floating AFE supplies. Digital circuit design, not implant qualification.

Schematic: input.kicad_sch, Project SCCI RH S4 / Protected pack and input disconnect

Parts:
C60001: 100u 16V LOW ESR; C_1206_3216Metric
C60002: 100n X7R 25V; C_1206_3216Metric
D60001: SS34-E3/57T; D_SMC
F60001: 2A FUSE 1206; Fuse_1206_3216Metric
SW60001: MASTER SPST / OFFBOARD; PinHeader_1x02_P2.54mm_Vertical

Connections:
SYS_56562df4__GND: C60001.2, C60002.2; also elsewhere on the board
SYS_f199d834__PACK_BUS: C60001.1, C60002.1, SW60001.2; also elsewhere on the board
power__PACK_FUSED: D60001.2 (A), F60001.2
power__PACK_POS: F60001.1; also elsewhere on the board
power__PACK_REVERSE_OK: D60001.1 (K), SW60001.1

Notes on the sheet:
DIGITAL SCCI ENGINEERING / ARTIFICIAL LOADS / BATTERY AND POWER
2S protected pack, independent supervisor rails, host converters and floating AFE supplies. Digital circuit design, not implant qualification.
All labels are native electrical connections. PG is diagnostic; full qualification remains the nine independent supervision windows.
Converter shutdown does not discharge boost paths or remove stored energy. Body-facing shutdown remains the separate terminal guards.

Schematic: sup3.kicad_sch, Project SCCI RH S4 / Always-on supervisor 3.3 V

Parts:
C61000: 10u X7R 25V; C_1206_3216Metric
C61001: 22u X7R 16V; C_1206_3216Metric
L60100: 2.2uH SRP5030T-2R2M; L_Bourns_SRP5030T
R61000: 31250R 0.1%; R_0805_2012Metric
R61001: 10000R 0.1%; R_0805_2012Metric
R61002: 100k; R_0805_2012Metric
R61003: 47k; R_0805_2012Metric
U60100: TPS62160DGKR; VSSOP-8_3x3mm_P0.65mm

Connections:
SYS_56562df4__GND: C61000.2, C61001.2, R61001.2, R61003.2, U60100.1 (PGND), U60100.4 (AGND); also elsewhere on the board
SYS_ab932142__SUP_3V3: C61001.1, L60100.2, R61000.1, R61002.1, R61003.1, U60100.6 (VOS); also elsewhere on the board
SYS_f199d834__PACK_BUS: C61000.1, U60100.2 (VIN), U60100.3 (EN); also elsewhere on the board
power__SUP_3V3_FB: R61000.2, R61001.1, U60100.5 (FB)
power__SUP_3V3_PG: R61002.2, U60100.8 (PG); also elsewhere on the board
power__SUP_3V3_SW: L60100.1, U60100.7 (SW)

Notes on the sheet:
DIGITAL SCCI ENGINEERING / ARTIFICIAL LOADS / BATTERY AND POWER
2S protected pack, independent supervisor rails, host converters and floating AFE supplies. Digital circuit design, not implant qualification.
All labels are native electrical connections. PG is diagnostic; full qualification remains the nine independent supervision windows.
Converter shutdown does not discharge boost paths or remove stored energy. Body-facing shutdown remains the separate terminal guards.

Schematic: sup5.kicad_sch, Project SCCI RH S4 / Always-on supervisor 5 V

Parts:
C61010: 10u X7R 25V; C_1206_3216Metric
C61011: 22u X7R 16V; C_1206_3216Metric
L60101: 2.2uH SRP5030T-2R2M; L_Bourns_SRP5030T
R61010: 52500R 0.1%; R_0805_2012Metric
R61011: 10000R 0.1%; R_0805_2012Metric
R61012: 100k; R_0805_2012Metric
R61013: 47k; R_0805_2012Metric
U60101: TPS62160DGKR; VSSOP-8_3x3mm_P0.65mm

Connections:
SYS_66aba95b__SUP_5: C61011.1, L60101.2, R61010.1, R61013.1, U60101.6 (VOS); also elsewhere on the board
SYS_56562df4__GND: C61010.2, C61011.2, R61011.2, R61013.2, U60101.1 (PGND), U60101.4 (AGND); also elsewhere on the board
SYS_ab932142__SUP_3V3: R61012.1; also elsewhere on the board
SYS_f199d834__PACK_BUS: C61010.1, U60101.2 (VIN), U60101.3 (EN); also elsewhere on the board
power__SUP_5_FB: R61010.2, R61011.1, U60101.5 (FB)
power__SUP_5_PG: R61012.2, U60101.8 (PG); also elsewhere on the board
power__SUP_5_SW: L60101.1, U60101.7 (SW)

Notes on the sheet:
DIGITAL SCCI ENGINEERING / ARTIFICIAL LOADS / BATTERY AND POWER
2S protected pack, independent supervisor rails, host converters and floating AFE supplies. Digital circuit design, not implant qualification.
All labels are native electrical connections. PG is diagnostic; full qualification remains the nine independent supervision windows.
Converter shutdown does not discharge boost paths or remove stored energy. Body-facing shutdown remains the separate terminal guards.

Schematic: host3.kicad_sch, Project SCCI RH S4 / Host logic 3.3 V

Parts:
C61020: 10u X7R 25V; C_1206_3216Metric
C61021: 22u X7R 16V; C_1206_3216Metric
L60102: 2.2uH SRP5030T-2R2M; L_Bourns_SRP5030T
R61020: 31250R 0.1%; R_0805_2012Metric
R61021: 10000R 0.1%; R_0805_2012Metric
R61022: 100k; R_0805_2012Metric
R61023: 47k; R_0805_2012Metric
U60102: TPS62160DGKR; VSSOP-8_3x3mm_P0.65mm

Connections:
SYS_56562df4__GND: C61020.2, C61021.2, R61021.2, R61023.2, U60102.1 (PGND), U60102.4 (AGND); also elsewhere on the board
SYS_08572049__HOST_3V3: C61021.1, L60102.2, R61020.1, R61023.1, U60102.6 (VOS); also elsewhere on the board
SYS_ab932142__SUP_3V3: R61022.1; also elsewhere on the board
SYS_f199d834__PACK_BUS: C61020.1, U60102.2 (VIN); also elsewhere on the board
power__HOST_3V3_FB: R61020.2, R61021.1, U60102.5 (FB)
power__HOST_3V3_PG: R61022.2, U60102.8 (PG); also elsewhere on the board
power__HOST_3V3_SW: L60102.1, U60102.7 (SW)
power__HOST_ENABLE: U60102.3 (EN); also elsewhere on the board

Notes on the sheet:
DIGITAL SCCI ENGINEERING / ARTIFICIAL LOADS / BATTERY AND POWER
2S protected pack, independent supervisor rails, host converters and floating AFE supplies. Digital circuit design, not implant qualification.
All labels are native electrical connections. PG is diagnostic; full qualification remains the nine independent supervision windows.
Converter shutdown does not discharge boost paths or remove stored energy. Body-facing shutdown remains the separate terminal guards.

Schematic: host5.kicad_sch, Project SCCI RH S4 / Host and module input 5 V

Parts:
C61100: 10u X7R 25V; C_1206_3216Metric
C61101: 22u X7R 16V; C_1206_3216Metric
C61102: 100n X7R 25V; C_1206_3216Metric
C61103: 3.3n C0G 50V; C_1206_3216Metric
L60110: 2.2uH SRP5030T-2R2M; L_Bourns_SRP5030T
R61100: 52.5k 0.1%; R_0805_2012Metric
R61101: 10k 0.1%; R_0805_2012Metric
R61102: 100k; R_0805_2012Metric
R61103: 47k; R_0805_2012Metric
U60110: TPS62130ARGTR; VQFN-16-1EP_3x3mm_P0.5mm_EP1.68x1.68mm

Connections:
SYS_56562df4__GND: C61100.2, C61101.2, C61102.2, C61103.2, R61101.2, R61103.2, U60110.6 (AGND), U60110.7 (FSW), U60110.8 (DEF), U60110.15 (PGND1), U60110.16 (PGND2), U60110.17 (EP_GND); also elsewhere on the board
SYS_ab932142__SUP_3V3: R61102.1; also elsewhere on the board
SYS_ce166826__HOST_5: C61101.1, L60110.2, R61100.1, R61103.1, U60110.14 (VOS); also elsewhere on the board
SYS_f199d834__PACK_BUS: C61100.1, C61102.1, U60110.10 (AVIN), U60110.11 (PVIN1), U60110.12 (PVIN2); also elsewhere on the board
power__HOST_5_FB: R61100.2, R61101.1, U60110.5 (FB)
power__HOST_5_PG: R61102.2, U60110.4 (PG); also elsewhere on the board
power__HOST_5_SS: C61103.1, U60110.9 (SS_TR)
power__HOST_5_SW: L60110.1, U60110.1 (SW1), U60110.2 (SW2), U60110.3 (SW3)
power__HOST_ENABLE: U60110.13 (EN); also elsewhere on the board

Notes on the sheet:
DIGITAL SCCI ENGINEERING / ARTIFICIAL LOADS / BATTERY AND POWER
2S protected pack, independent supervisor rails, host converters and floating AFE supplies. Digital circuit design, not implant qualification.
All labels are native electrical connections. PG is diagnostic; full qualification remains the nine independent supervision windows.
Converter shutdown does not discharge boost paths or remove stored energy. Body-facing shutdown remains the separate terminal guards.

Schematic: enable.kicad_sch, Project SCCI RH S4 / Native battery and startup qualificati…

Parts:
C60200, C60201: 100n X7R 16V; C_1206_3216Metric
R62000: 155000R 0.1%; R_0805_2012Metric
R62001, R62003, R62011, R62013, R62021, R62023: 10k 0.1%; R_0805_2012Metric
R62002: 205000R 0.1%; R_0805_2012Metric
R62004, R62014, R62024: 10k; R_0805_2012Metric
R62010: 67500R 0.1%; R_0805_2012Metric
R62012: 77500R 0.1%; R_0805_2012Metric
R62020: 108750R 0.1%; R_0805_2012Metric
R62022: 121250R 0.1%; R_0805_2012Metric
U60200, U60201, U60202: TPS3700DDCR; SOT-23-6

Connections:
SYS_66aba95b__SUP_5: R62020.1, R62022.1; also elsewhere on the board
SYS_56562df4__GND: C60200.2, C60201.2, R62001.2, R62003.2, R62011.2, R62013.2, R62021.2, R62023.2, U60200.2 (GND), U60201.2 (GND), U60202.2 (GND); also elsewhere on the board
SYS_ab932142__SUP_3V3: C60200.1, C60201.1, R62004.1, R62010.1, R62012.1, R62014.1, R62024.1, U60200.5 (VDD), U60201.5 (VDD), U60202.5 (VDD); also elsewhere on the board
power__BATT_OV: R62002.2, R62003.1, U60200.4 (INB_OV)
power__BATT_UV: R62000.2, R62001.1, U60200.3 (INA_UV)
power__BATT_WINDOW_OK: R62004.2, U60200.1 (OUTA_UV_N), U60200.6 (OUTB_OV_N); also elsewhere on the board
power__PACK_POS: R62000.1, R62002.1; also elsewhere on the board
power__S3_OV: R62012.2, R62013.1, U60201.4 (INB_OV)
power__S3_UV: R62010.2, R62011.1, U60201.3 (INA_UV)
power__S3_WINDOW_OK: R62014.2, U60201.1 (OUTA_UV_N), U60201.6 (OUTB_OV_N); also elsewhere on the board
power__S5_OV: R62022.2, R62023.1, U60202.4 (INB_OV)
power__S5_UV: R62020.2, R62021.1, U60202.3 (INA_UV)
power__S5_WINDOW_OK: R62024.2, U60202.1 (OUTA_UV_N), U60202.6 (OUTB_OV_N); also elsewhere on the board

Notes on the sheet:
DIGITAL SCCI ENGINEERING / ARTIFICIAL LOADS / BATTERY AND POWER
2S protected pack, independent supervisor rails, host converters and floating AFE supplies. Digital circuit design, not implant qualification.
All labels are native electrical connections. PG is diagnostic; full qualification remains the nine independent supervision windows.
Converter shutdown does not discharge boost paths or remove stored energy. Body-facing shutdown remains the separate terminal guards.

Schematic: enable_2.kicad_sch, Project SCCI RH S4 / Native battery and startup qualificati…

Parts:
C60202, C60203, C60204: 100n X7R 16V; C_1206_3216Metric
C60230: 47n X7R 10%; C_1206_3216Metric
D60230: BAT54WS-7-F; D_SOD-323
R60230: 100k 1%; R_0805_2012Metric
R60231: 100R; R_0805_2012Metric
R62030: 89500R 0.1%; R_0805_2012Metric
R62031, R62033, R62041, R62043: 10k 0.1%; R_0805_2012Metric
R62032: 95500R 0.1%; R_0805_2012Metric
R62034, R62044: 10k; R_0805_2012Metric
R62040: 39500R 0.1%; R_0805_2012Metric
R62042: 43000R 0.1%; R_0805_2012Metric
U60203, U60204: TPS3700DDCR; SOT-23-6
U60230: SN74LVC1G17DBVR; SOT-23-5

Connections:
SYS_4f66f129__MON_VREF: R62030.1, R62032.1; also elsewhere on the board
SYS_37cfe02a__MON_VMID: R62040.1, R62042.1; also elsewhere on the board
SYS_56562df4__GND: C60202.2, C60203.2, C60204.2, C60230.2, R62031.2, R62033.2, R62041.2, R62043.2, U60203.2 (GND), U60204.2 (GND), U60230.3 (GND); also elsewhere on the board
SYS_ab932142__SUP_3V3: C60202.1, C60203.1, C60204.1, R60230.1, R60231.2, R62034.1, R62044.1, U60203.5 (VDD), U60204.5 (VDD), U60230.5 (VCC); also elsewhere on the board
power__MID_OV: R62042.2, R62043.1, U60204.4 (INB_OV)
power__MID_UV: R62040.2, R62041.1, U60204.3 (INA_UV)
power__MID_WINDOW_OK: R62044.2, U60204.1 (OUTA_UV_N), U60204.6 (OUTB_OV_N); also elsewhere on the board
power__MREF_OV: R62032.2, R62033.1, U60203.4 (INB_OV)
power__MREF_UV: R62030.2, R62031.1, U60203.3 (INA_UV)
power__MREF_WINDOW_OK: R62034.2, U60203.1 (OUTA_UV_N), U60203.6 (OUTB_OV_N); also elsewhere on the board
power__PWR_START_DIS: D60230.1 (K), R60231.1
power__PWR_START_OK: U60230.4 (Y); also elsewhere on the board
power__PWR_START_RC: C60230.1, D60230.2 (A), R60230.2, U60230.2 (A)

Notes on the sheet:
DIGITAL SCCI ENGINEERING / ARTIFICIAL LOADS / BATTERY AND POWER
2S protected pack, independent supervisor rails, host converters and floating AFE supplies. Digital circuit design, not implant qualification.
All labels are native electrical connections. PG is diagnostic; full qualification remains the nine independent supervision windows.
Converter shutdown does not discharge boost paths or remove stored energy. Body-facing shutdown remains the separate terminal guards.

Schematic: enable_3.kicad_sch, Project SCCI RH S4 / Native battery and startup qualificati…

Parts:
C60240, C60241, C60242, C60243, C60244, C60245, C60246, C60247: 100n X7R 16V; C_1206_3216Metric
R60240, R60241, R60242: 10k; R_0805_2012Metric
U60231, U60233: SN74LVC1G11DBVR; SOT-23-6
U60232, U60234, U60236, U60237: SN74LVC1G08DBVR; SOT-23-5
U60235: SN74LVC1G07DBVR; SOT-23-5

Connections:
SYS_56562df4__GND: C60240.2, C60241.2, C60242.2, C60243.2, C60244.2, C60245.2, C60246.2, C60247.2, R60240.2, R60241.2, R60242.2, U60231.2 (GND), U60232.3 (GND), U60233.2 (GND), U60234.3 (GND), U60235.3 (GND), U60236.3 (GND), U60237.3 (GND); also elsewhere on the board
SYS_ab932142__SUP_3V3: C60240.1, C60241.1, C60242.1, C60243.1, C60244.1, C60245.1, C60246.1, C60247.1, U60231.5 (VCC), U60232.5 (VCC), U60233.5 (VCC), U60234.5 (VCC), U60235.5 (VCC), U60236.5 (VCC), U60237.5 (VCC); also elsewhere on the board
SYS_ee59c76b__PWR_FAULT_N: U60235.4 (Y_OPEN_DRAIN); also elsewhere on the board
power__BATT_OK: U60232.4 (Y), U60233.3 (B); also elsewhere on the board
power__BATT_WINDOW_OK: U60232.1 (A); also elsewhere on the board
power__BOOST_ENABLE: R60242.1, U60234.4 (Y), U60237.1 (A); also elsewhere on the board
power__HOST_5_PG: U60234.2 (B); also elsewhere on the board
power__HOST_ENABLE: R60241.1, U60233.4 (Y), U60234.1 (A); also elsewhere on the board
power__MID_WINDOW_OK: U60236.2 (B); also elsewhere on the board
power__MREF_WINDOW_OK: U60236.1 (A); also elsewhere on the board
power__POWER_RUN_OK: U60235.2 (A), U60237.4 (Y)
power__PWR_REQUEST: R60240.1, U60233.1 (A); also elsewhere on the board
power__PWR_START_OK: U60231.6 (C), U60232.2 (B); also elsewhere on the board
power__REF_OK: U60236.4 (Y), U60237.2 (B)
power__S3_WINDOW_OK: U60231.1 (A); also elsewhere on the board
power__S5_WINDOW_OK: U60231.3 (B); also elsewhere on the board
power__SUP_READY: U60231.4 (Y), U60233.6 (C); also elsewhere on the board

Notes on the sheet:
DIGITAL SCCI ENGINEERING / ARTIFICIAL LOADS / BATTERY AND POWER
2S protected pack, independent supervisor rails, host converters and floating AFE supplies. Digital circuit design, not implant qualification.
All labels are native electrical connections. PG is diagnostic; full qualification remains the nine independent supervision windows.
Converter shutdown does not discharge boost paths or remove stored energy. Body-facing shutdown remains the separate terminal guards.

Schematic: boost15.kicad_sch, Project SCCI RH S4 / Host 15 V boost

Parts:
C63000: 10u X7R 25V; C_1206_3216Metric
C63001, C63002: 22u X7R 50V; C_1206_3216Metric
C63003: 1u X7R 10V; C_1206_3216Metric
C63004: 4.7p C0G 50V; C_1206_3216Metric
D60300: PMEG6010CEJ; D_SOD-323F
L60300: 4.7uH SRP5030T-4R7M; L_Bourns_SRP5030T
R63000: 418750R 0.1%; R_0805_2012Metric
R63001: 50k 0.1%; R_0805_2012Metric
R63002: 100k; R_0805_2012Metric
U60300: LT8330ES6#TRPBF; TSOT-23-6

Connections:
SYS_56562df4__GND: C63000.2, C63001.2, C63002.2, C63003.2, R63001.2, R63002.2, U60300.2 (GND); also elsewhere on the board
SYS_f199d834__PACK_BUS: C63000.1, L60300.1, U60300.6 (VIN); also elsewhere on the board
SYS_fb2237f8__VA_15: C63001.1, C63002.1, C63004.1, D60300.1 (K), R63000.1, R63002.1; also elsewhere on the board
power__BOOST_ENABLE: U60300.4 (EN_UVLO); also elsewhere on the board
power__HOST_15_FB: C63004.2, R63000.2, R63001.1, U60300.3 (FBX)
power__HOST_15_INTVCC: C63003.1, U60300.5 (INTVCC)
power__HOST_15_SW: D60300.2 (A), L60300.2, U60300.1 (SW)

Notes on the sheet:
DIGITAL SCCI ENGINEERING / ARTIFICIAL LOADS / BATTERY AND POWER
2S protected pack, independent supervisor rails, host converters and floating AFE supplies. Digital circuit design, not implant qualification.
All labels are native electrical connections. PG is diagnostic; full qualification remains the nine independent supervision windows.
Converter shutdown does not discharge boost paths or remove stored energy. Body-facing shutdown remains the separate terminal guards.

Schematic: boost24.kicad_sch, Project SCCI RH S4 / Stimulation 24 V boost

Parts:
C63010: 10u X7R 25V; C_1206_3216Metric
C63011, C63012: 22u X7R 50V; C_1206_3216Metric
C63013: 1u X7R 10V; C_1206_3216Metric
C63014: 4.7p C0G 50V; C_1206_3216Metric
D60301: PMEG6010CEJ; D_SOD-323F
L60301: 4.7uH SRP5030T-4R7M; L_Bourns_SRP5030T
R63010: 700000R 0.1%; R_0805_2012Metric
R63011: 50k 0.1%; R_0805_2012Metric
R63012: 100k; R_0805_2012Metric
U60301: LT8330ES6#TRPBF; TSOT-23-6

Connections:
SYS_15689dc4__VH_24: C63011.1, C63012.1, C63014.1, D60301.1 (K), R63010.1, R63012.1; also elsewhere on the board
SYS_56562df4__GND: C63010.2, C63011.2, C63012.2, C63013.2, R63011.2, R63012.2, U60301.2 (GND); also elsewhere on the board
SYS_f199d834__PACK_BUS: C63010.1, L60301.1, U60301.6 (VIN); also elsewhere on the board
power__BOOST_ENABLE: U60301.4 (EN_UVLO); also elsewhere on the board
power__VH_24_FB: C63014.2, R63010.2, R63011.1, U60301.3 (FBX)
power__VH_24_INTVCC: C63013.1, U60301.5 (INTVCC)
power__VH_24_SW: D60301.2 (A), L60301.2, U60301.1 (SW)

Notes on the sheet:
DIGITAL SCCI ENGINEERING / ARTIFICIAL LOADS / BATTERY AND POWER
2S protected pack, independent supervisor rails, host converters and floating AFE supplies. Digital circuit design, not implant qualification.
All labels are native electrical connections. PG is diagnostic; full qualification remains the nine independent supervision windows.
Converter shutdown does not discharge boost paths or remove stored energy. Body-facing shutdown remains the separate terminal guards.

Schematic: island.kicad_sch, Project SCCI RH S4 / Floating recording power module

Parts:
C60400: 22u X7R 16V; C_1206_3216Metric
C60401, C60402: 10u X7R 50V; C_1206_3216Metric
U60400: TMR3-0522; TRACO_TMR3_SIP8_21.8x9.1_P2.54

Connections:
SYS_56562df4__GND: C60400.2, U60400.1 (VIN_MINUS); also elsewhere on the board
SYS_ce166826__HOST_5: C60400.1, U60400.2 (VIN_PLUS); also elsewhere on the board
SYS_fca1c340__AFEAGND: C60401.2, C60402.2, U60400.7 (AFE_RETURN); also elsewhere on the board
power__ISO_N12: C60402.1, U60400.8 (VOUT_MINUS); also elsewhere on the board
power__ISO_P12: C60401.1, U60400.6 (VOUT_PLUS); also elsewhere on the board

Notes on the sheet:
DIGITAL SCCI ENGINEERING / ARTIFICIAL LOADS / BATTERY AND POWER
2S protected pack, independent supervisor rails, host converters and floating AFE supplies. Digital circuit design, not implant qualification.
All labels are native electrical connections. PG is diagnostic; full qualification remains the nine independent supervision windows.
Converter shutdown does not discharge boost paths or remove stored energy. Body-facing shutdown remains the separate terminal guards.

Schematic: afe3.kicad_sch, Project SCCI RH S4 / Floating AFE 3.45 V regulator

Parts:
C64100: 10u X7R 50V; C_1206_3216Metric
C64101: 10u X7R 16V; C_1206_3216Metric
C64102, C64103: 10n C0G 50V; C_1206_3216Metric
J60410: QUIESCENT TRIM / TEST ONLY; PinHeader_1x03_P2.54mm_Vertical
R64100: 19113.924R 0.1%; R_0805_2012Metric
R64101: 10k 0.1%; R_0805_2012Metric
R64102: 47k; R_0805_2012Metric
U60410: TPS7A4901DGNR; Texas_DGN0008D_VSSOP-8-1EP_3x3mm_P0.65mm_EP2x2.94mm_Mask1.5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

Connections:
SYS_65aafbb6__AFE_3V3: C64101.1, C64103.1, J60410.1, R64100.1, R64102.1, U60410.1 (OUT); also elsewhere on the board
SYS_fca1c340__AFEAGND: C64100.2, C64101.2, C64102.2, J60410.3, R64101.2, R64102.2, U60410.4 (GND), U60410.9 (EP_GND); also elsewhere on the board
power__AFE_3V3_FB: C64103.2, J60410.2, R64100.2, R64101.1, U60410.2 (FB)
power__AFE_3V3_NR: C64102.1, U60410.6 (NR_SS)
power__ISO_P12: C64100.1, U60410.5 (EN), U60410.8 (IN); also elsewhere on the board

Notes on the sheet:
DIGITAL SCCI ENGINEERING / ARTIFICIAL LOADS / BATTERY AND POWER
2S protected pack, independent supervisor rails, host converters and floating AFE supplies. Digital circuit design, not implant qualification.
All labels are native electrical connections. PG is diagnostic; full qualification remains the nine independent supervision windows.
Converter shutdown does not discharge boost paths or remove stored energy. Body-facing shutdown remains the separate terminal guards.

Schematic: afep.kicad_sch, Project SCCI RH S4 / Floating AFE +5.30 V regulator

Parts:
C64110: 10u X7R 50V; C_1206_3216Metric
C64111: 10u X7R 16V; C_1206_3216Metric
C64112, C64113: 10n C0G 50V; C_1206_3216Metric
J60411: QUIESCENT TRIM / TEST ONLY; PinHeader_1x03_P2.54mm_Vertical
R64110: 34725.738R 0.1%; R_0805_2012Metric
R64111: 10k 0.1%; R_0805_2012Metric
R64112: 47k; R_0805_2012Metric
U60411: TPS7A4901DGNR; Texas_DGN0008D_VSSOP-8-1EP_3x3mm_P0.65mm_EP2x2.94mm_Mask1.5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

Connections:
SYS_3fdd5066__AFE_P5: C64111.1, C64113.1, J60411.1, R64110.1, R64112.1, U60411.1 (OUT); also elsewhere on the board
SYS_fca1c340__AFEAGND: C64110.2, C64111.2, C64112.2, J60411.3, R64111.2, R64112.2, U60411.4 (GND), U60411.9 (EP_GND); also elsewhere on the board
power__AFE_P5_FB: C64113.2, J60411.2, R64110.2, R64111.1, U60411.2 (FB)
power__AFE_P5_NR: C64112.1, U60411.6 (NR_SS)
power__ISO_P12: C64110.1, U60411.5 (EN), U60411.8 (IN); also elsewhere on the board

Notes on the sheet:
DIGITAL SCCI ENGINEERING / ARTIFICIAL LOADS / BATTERY AND POWER
2S protected pack, independent supervisor rails, host converters and floating AFE supplies. Digital circuit design, not implant qualification.
All labels are native electrical connections. PG is diagnostic; full qualification remains the nine independent supervision windows.
Converter shutdown does not discharge boost paths or remove stored energy. Body-facing shutdown remains the separate terminal guards.
