pratham-cloud-ctrl/Project-SCCI-RH/electronics/stage4/integrated-pcb/integration/boards/contact-router/address.kicad_sch

## KiCad design electronics/stage4/integrated-pcb/integration/boards/contact-router/address.kicad_sch (2026-10-29)

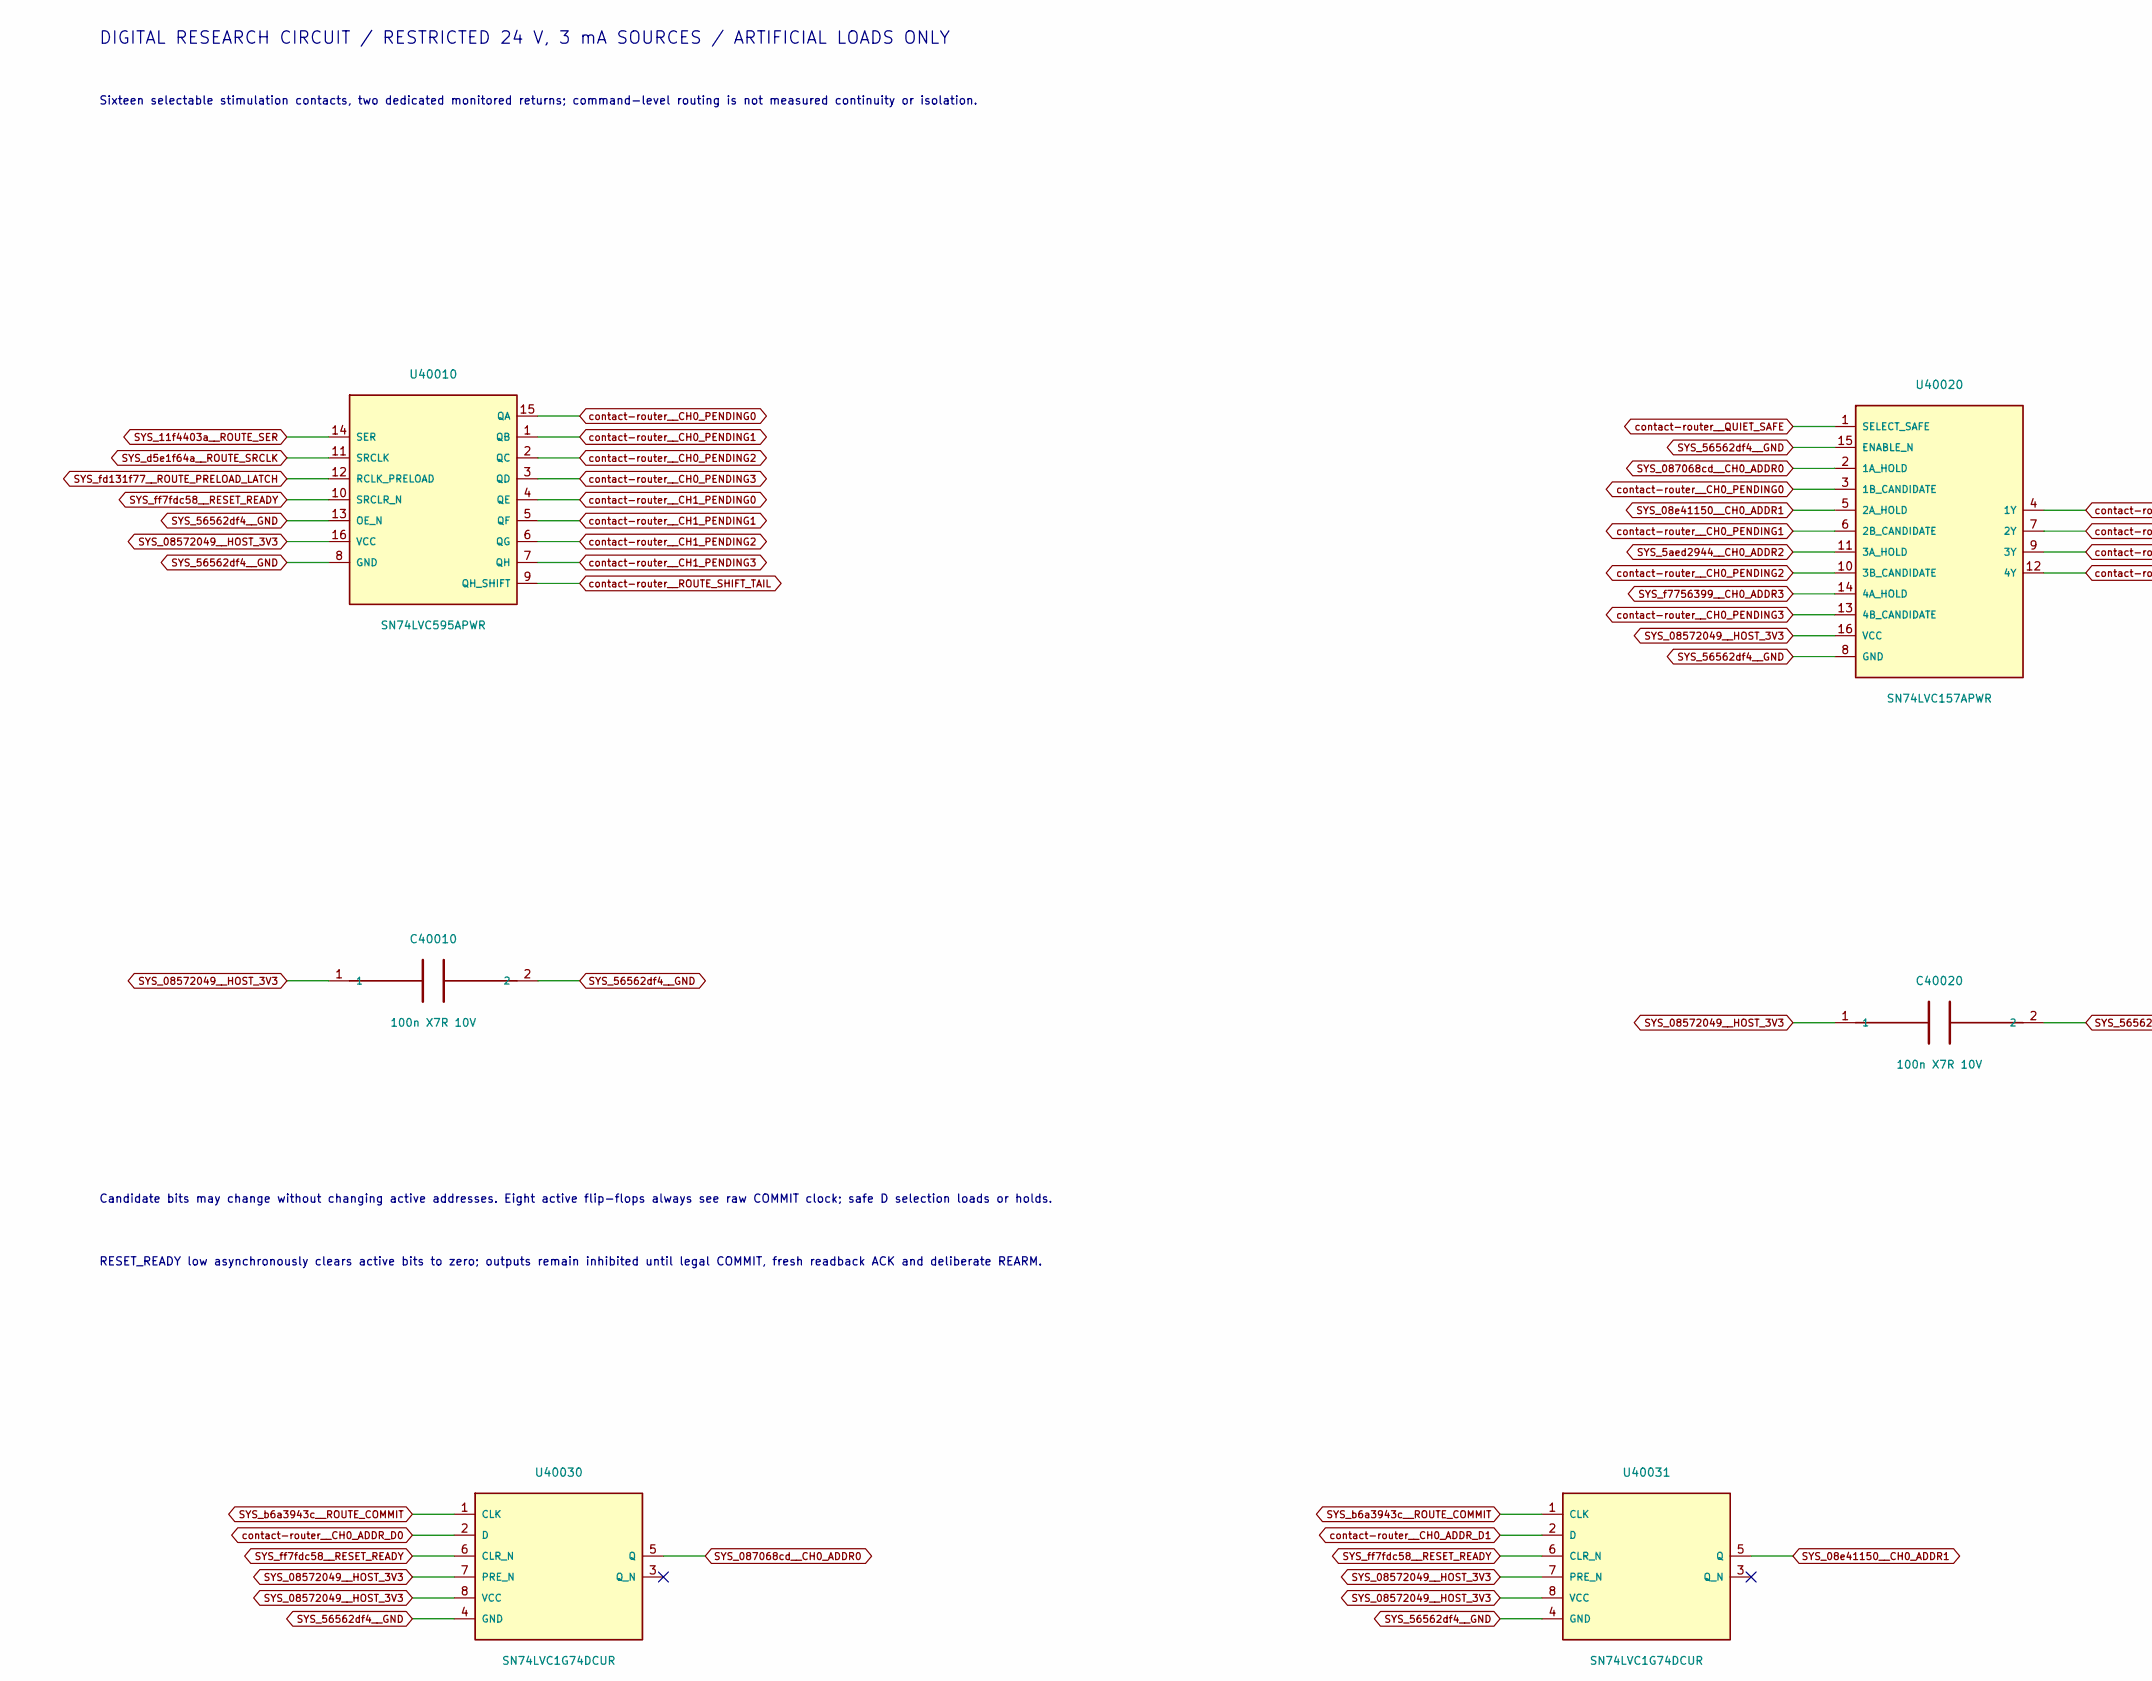
[picture p428: schematic address.kicad_sch, part in row 1, column 1]




Parts:
C40010, C40020, C40021, C40030, C40031, C40032, C40033, C40034, C40035, C40036, C40037: 100n X7R 10V; C_0805_2012Metric
R40010, R40011, R40012, R40013, R40014: 10k; R_0805_2012Metric
U40010: SN74LVC595APWR; TSSOP-16_4.4x5mm_P0.65mm
U40020, U40021: SN74LVC157APWR; TSSOP-16_4.4x5mm_P0.65mm
U40030, U40031, U40032, U40033, U40034, U40035, U40036, U40037: SN74LVC1G74DCUR; VSSOP-8_2.3x2mm_P0.5mm

Connections:
SYS_0cbf1bda__CH1_ADDR1: U40021.5 (2A_HOLD), U40035.5 (Q)
SYS_5aed2944__CH0_ADDR2: U40020.11 (3A_HOLD), U40032.5 (Q)
SYS_08e41150__CH0_ADDR1: U40020.5 (2A_HOLD), U40031.5 (Q)
SYS_11f4403a__ROUTE_SER: R40010.1, U40010.14 (SER)
SYS_56562df4__GND: C40010.2, C40020.2, C40021.2, C40030.2, C40031.2, C40032.2, C40033.2, C40034.2, C40035.2, C40036.2, C40037.2, R40010.2, R40011.2, R40012.2, R40013.2, R40014.2, U40010.8 (GND), U40010.13 (OE_N), U40020.8 (GND), U40020.15 (ENABLE_N), U40021.8 (GND), U40021.15 (ENABLE_N), U40030.4 (GND), U40031.4 (GND), U40032.4 (GND), U40033.4 (GND), U40034.4 (GND), U40035.4 (GND), U40036.4 (GND), U40037.4 (GND)
SYS_087068cd__CH0_ADDR0: U40020.2 (1A_HOLD), U40030.5 (Q)
SYS_08572049__HOST_3V3: C40010.1, C40020.1, C40021.1, C40030.1, C40031.1, C40032.1, C40033.1, C40034.1, C40035.1, C40036.1, C40037.1, U40010.16 (VCC), U40020.16 (VCC), U40021.16 (VCC), U40030.7 (PRE_N), U40030.8 (VCC), U40031.7 (PRE_N), U40031.8 (VCC), U40032.7 (PRE_N), U40032.8 (VCC), U40033.7 (PRE_N), U40033.8 (VCC), U40034.7 (PRE_N), U40034.8 (VCC), U40035.7 (PRE_N), U40035.8 (VCC), U40036.7 (PRE_N), U40036.8 (VCC), U40037.7 (PRE_N), U40037.8 (VCC)
SYS_b6a3943c__ROUTE_COMMIT: R40013.1, U40030.1 (CLK), U40031.1 (CLK), U40032.1 (CLK), U40033.1 (CLK), U40034.1 (CLK), U40035.1 (CLK), U40036.1 (CLK), U40037.1 (CLK)
SYS_b6ef4aed__CH1_ADDR3: U40021.14 (4A_HOLD), U40037.5 (Q)
SYS_c3abe6bc__CH1_ADDR0: U40021.2 (1A_HOLD), U40034.5 (Q)
SYS_d5e1f64a__ROUTE_SRCLK: R40011.1, U40010.11 (SRCLK)
SYS_ed4497b7__ROUTE_REARM: R40014.1
SYS_f373e353__CH1_ADDR2: U40021.11 (3A_HOLD), U40036.5 (Q)
SYS_f7756399__CH0_ADDR3: U40020.14 (4A_HOLD), U40033.5 (Q)
SYS_fd131f77__ROUTE_PRELOAD_LATCH: R40012.1, U40010.12 (RCLK_PRELOAD)
SYS_ff7fdc58__RESET_READY: U40010.10 (SRCLR_N), U40030.6 (CLR_N), U40031.6 (CLR_N), U40032.6 (CLR_N), U40033.6 (CLR_N), U40034.6 (CLR_N), U40035.6 (CLR_N), U40036.6 (CLR_N), U40037.6 (CLR_N)
contact-router__CH0_ADDR_D0: U40020.4 (1Y), U40030.2 (D)
contact-router__CH0_ADDR_D1: U40020.7 (2Y), U40031.2 (D)
contact-router__CH0_ADDR_D2: U40020.9 (3Y), U40032.2 (D)
contact-router__CH0_ADDR_D3: U40020.12 (4Y), U40033.2 (D)
contact-router__CH0_PENDING0: U40010.15 (QA), U40020.3 (1B_CANDIDATE)
contact-router__CH0_PENDING1: U40010.1 (QB), U40020.6 (2B_CANDIDATE)
contact-router__CH0_PENDING2: U40010.2 (QC), U40020.10 (3B_CANDIDATE)
contact-router__CH0_PENDING3: U40010.3 (QD), U40020.13 (4B_CANDIDATE)
contact-router__CH1_ADDR_D0: U40021.4 (1Y), U40034.2 (D)
contact-router__CH1_ADDR_D1: U40021.7 (2Y), U40035.2 (D)
contact-router__CH1_ADDR_D2: U40021.9 (3Y), U40036.2 (D)
contact-router__CH1_ADDR_D3: U40021.12 (4Y), U40037.2 (D)
contact-router__CH1_PENDING0: U40010.4 (QE), U40021.3 (1B_CANDIDATE)
contact-router__CH1_PENDING1: U40010.5 (QF), U40021.6 (2B_CANDIDATE)
contact-router__CH1_PENDING2: U40010.6 (QG), U40021.10 (3B_CANDIDATE)
contact-router__CH1_PENDING3: U40010.7 (QH), U40021.13 (4B_CANDIDATE)
contact-router__QUIET_SAFE: U40020.1 (SELECT_SAFE), U40021.1 (SELECT_SAFE)
contact-router__ROUTE_SHIFT_TAIL: U40010.9 (QH_SHIFT)

Notes on the sheet:
DIGITAL RESEARCH CIRCUIT / RESTRICTED 24 V, 3 mA SOURCES / ARTIFICIAL LOADS ONLY
Sixteen selectable stimulation contacts, two dedicated monitored returns; command-level routing is not measured continuity or isolation.
Candidate bits may change without changing active addresses. Eight active flip-flops always see raw COMMIT clock; safe D selection loads or holds.
RESET_READY low asynchronously clears active bits to zero; outputs remain inhibited until legal COMMIT, fresh readback ACK and deliberate REARM.
SRCLR affects only the candidate shift stage. QH_SHIFT is payload cascade, not active-address or analog switch readback. Actual Q bits appear at J6.
QUIET_SAFE and candidate data must meet physical setup/hold. Gate delay, asynchronous clear, metastability and clock-integrity qualification remain.
