pratham-cloud-ctrl/Project-SCCI-RH/electronics/stage4/integrated-pcb/integration/boards/contact-router/admission.kicad_sch

## KiCad design electronics/stage4/integrated-pcb/integration/boards/contact-router/admission.kicad_sch (2026-10-29)







Parts:
C40300, C40301, C40302, C40303, C40304, C40305, C40306, C40307, C40308, C40309, C40310, C40311, C40312, C40313, C40314, C40315, C40316, C40317, C40318, C40319, C40320, C40321: 100n X7R 10V; C_0805_2012Metric
R40300, R40301, R40302, R40303, R40304, R40305, R40306, R40307, R40308, R40309, R40310, R40311, R40312, R40313, R40314: 10k; R_0805_2012Metric
U40300, U40301, U40309, U40310, U40313, U40317, U40319: SN74LVC1G11DBVR; SOT-23-6
U40302, U40315, U40320: SN74LVC1G08DBVR; SOT-23-5
U40303, U40305, U40306, U40307: SN74LVC1G32DBVR; SOT-23-5
U40304, U40308, U40311, U40312, U40321: SN74LVC1G04DBVR; SOT-23-5
U40314, U40316, U40318: SN74LVC1G74DCUR; VSSOP-8_2.3x2mm_P0.5mm

Connections:
SYS_1fbf7500__ROUTE_ACTIVE_BITS_VERIFIED: R40306.1, U40316.1 (CLK)
SYS_2d0e5b2e__CH0_QUIESCENT_OK: R40304.1, U40309.1 (A)
SYS_6a132103__CH1_RUN: R40314.1, U40306.2 (B)
SYS_6c012064__ROUTE_COMMAND_READY: U40320.4 (Y)
SYS_20eba8c2__CH1_QUIESCENT_OK: R40305.1, U40309.3 (B)
SYS_46ea5f03__CH0_REQUEST: R40311.1, U40305.1 (A)
SYS_56ebc071__CH0_MON_PERMIT: R40307.1, U40301.3 (B)
SYS_83ddb634__CH1_WANT_ROUTE: R40310.1, U40303.2 (B)
SYS_695f3a7c__CH0_RUN: R40313.1, U40306.1 (A)
SYS_56562df4__GND: C40300.2, C40301.2, C40302.2, C40303.2, C40304.2, C40305.2, C40306.2, C40307.2, C40308.2, C40309.2, C40310.2, C40311.2, C40312.2, C40313.2, C40314.2, C40315.2, C40316.2, C40317.2, C40318.2, C40319.2, C40320.2, C40321.2, R40300.2, R40301.2, R40302.2, R40303.2, R40304.2, R40305.2, R40306.2, R40307.2, R40308.2, R40309.2, R40310.2, R40311.2, R40312.2, R40313.2, R40314.2, U40300.2 (GND), U40301.2 (GND), U40302.3 (GND), U40303.3 (GND), U40304.3 (GND), U40305.3 (GND), U40306.3 (GND), U40307.3 (GND), U40308.3 (GND), U40309.2 (GND), U40310.2 (GND), U40311.3 (GND), U40312.3 (GND), U40313.2 (GND), U40314.4 (GND), U40315.3 (GND), U40316.4 (GND), U40317.2 (GND), U40318.4 (GND), U40319.2 (GND), U40320.3 (GND), U40321.3 (GND)
SYS_98321c7b__AFE_ISOLATED_READY: R40303.1, U40301.1 (A)
SYS_08572049__HOST_3V3: C40300.1, C40301.1, C40302.1, C40303.1, C40304.1, C40305.1, C40306.1, C40307.1, C40308.1, C40309.1, C40310.1, C40311.1, C40312.1, C40313.1, C40314.1, C40315.1, C40316.1, C40317.1, C40318.1, C40319.1, C40320.1, C40321.1, U40300.5 (VCC), U40301.5 (VCC), U40302.5 (VCC), U40303.5 (VCC), U40304.5 (VCC), U40305.5 (VCC), U40306.5 (VCC), U40307.5 (VCC), U40308.5 (VCC), U40309.5 (VCC), U40310.5 (VCC), U40311.5 (VCC), U40312.5 (VCC), U40313.5 (VCC), U40314.7 (PRE_N), U40314.8 (VCC), U40315.5 (VCC), U40316.7 (PRE_N), U40316.8 (VCC), U40317.5 (VCC), U40318.7 (PRE_N), U40318.8 (VCC), U40319.5 (VCC), U40320.5 (VCC), U40321.5 (VCC)
SYS_93547907__RAILS_QUALIFIED: R40301.1, U40300.3 (B)
SYS_a83d484c__WATCHDOG_OK: R40302.1, U40300.6 (C)
SYS_aa321af6__CH1_MON_PERMIT: R40308.1, U40301.6 (C)
SYS_b6a3943c__ROUTE_COMMIT: U40311.2 (A), U40314.1 (CLK)
SYS_dd388269__CH1_REQUEST: R40312.1, U40305.2 (B)
SYS_e338b670__CH0_WANT_ROUTE: R40309.1, U40303.1 (A)
SYS_ed4497b7__ROUTE_REARM: U40318.1 (CLK)
SYS_ff7fdc58__RESET_READY: R40300.1, U40300.1 (A)
contact-router__ACK_CLR_N: U40315.4 (Y), U40316.6 (CLR_N)
contact-router__ANY_PHASE: U40307.4 (Y), U40308.2 (A)
contact-router__ANY_REQUEST: U40305.4 (Y), U40307.1 (A)
contact-router__ANY_RUN: U40306.4 (Y), U40307.2 (B)
contact-router__ANY_WANT: U40303.4 (Y), U40304.2 (A)
contact-router__BASE_HEALTH: U40302.4 (Y), U40309.6 (C), U40313.1 (A), U40314.6 (CLR_N), U40315.1 (A), U40319.3 (B)
contact-router__COMMIT_N: U40311.4 (Y), U40313.3 (B), U40315.2 (B), U40319.6 (C)
contact-router__COMMIT_SEEN: U40314.5 (Q), U40316.2 (D), U40317.1 (A)
contact-router__HEALTH_A: U40300.4 (Y), U40302.1 (A)
contact-router__HEALTH_B: U40301.4 (Y), U40302.2 (B)
contact-router__NO_CONFLICT: U40312.4 (Y), U40313.6 (C), U40320.2 (B)
contact-router__NO_PHASE: U40308.4 (Y), U40310.3 (B)
contact-router__NO_WANT: U40304.4 (Y), U40310.1 (A)
contact-router__QUIET_HEALTH: U40309.4 (Y), U40310.6 (C)
contact-router__QUIET_SAFE: U40310.4 (Y), U40314.2 (D), U40317.3 (B)
contact-router__READBACK_SEEN: U40316.5 (Q), U40317.6 (C)
contact-router__READY_A: U40319.4 (Y), U40320.1 (A)
contact-router__REARM_D: U40317.4 (Y), U40318.2 (D)
contact-router__ROUTE_BLOCK: U40321.4 (Y)
contact-router__ROUTE_CONFLICT: U40312.2 (A)
contact-router__ROUTE_VALID: U40318.5 (Q), U40319.1 (A), U40321.2 (A)
contact-router__VALID_CLR_N: U40313.4 (Y), U40318.6 (CLR_N)

Notes on the sheet:
DIGITAL RESEARCH CIRCUIT / RESTRICTED 24 V, 3 mA SOURCES / ARTIFICIAL LOADS ONLY
Sixteen selectable stimulation contacts, two dedicated monitored returns; command-level routing is not measured continuity or isolation.
BASE_HEALTH = RESET & RAILS & WATCHDOG & AFE_ISOLATED_READY & MON0 & MON1; QUIET_SAFE additionally requires both WANT/REQUEST/RUN low and quiescence.
Any COMMIT invalidates prior validation and ACK. Illegal COMMIT holds active bits and captures COMMIT_SEEN=0.
Rearm needs a fresh post-commit ACK edge. Health recovery or collision removal cannot create a clock edge or restart output.
Ideal logic only: setup/hold, all-off settling, voltage, independent watchdog and actual current observation remain mandatory.
