pratham-cloud-ctrl/Project-SCCI-RH/electronics/stage4/integrated-pcb/integration/boards/contact-router/contact_router.kicad_sch

## KiCad design electronics/stage4/integrated-pcb/integration/boards/contact-router/contact_router.kicad_sch (2026-10-29)







Parts:
J40001: QUALIFIED EXTERNAL RAILS; PinHeader_1x03_P2.54mm_Vertical
J40002: CANDIDATE PRELOAD AND COMMIT; PinHeader_1x07_P2.54mm_Vertical
J40003: SOURCE ROUTE INTENT / PHASE STATUS; PinHeader_1x07_P2.54mm_Vertical
J40004: EXTERNAL OBSERVED HEALTH CONTRACTS; PinHeader_1x10_P2.54mm_Vertical
J40005: COMMAND STATUS / NOT MUX READBACK; PinHeader_1x12_P2.54mm_Vertical
J40006: ACTIVE ADDRESS BIT READBACK; PinHeader_1x09_P2.54mm_Vertical
J40007: SIXTEEN CONTACTS / TWO MONITORED RETURNS; PinHeader_1x18_P2.54mm_Vertical

Connections:
SYS_0cbf1bda__CH1_ADDR1: J40006.6
SYS_0d1e7c21__CH0_RETURN_LOAD: J40007.17
SYS_1fbf7500__ROUTE_ACTIVE_BITS_VERIFIED: J40004.7
SYS_2d0e5b2e__CH0_QUIESCENT_OK: J40004.5
SYS_3ced048f__CH1_RETURN_LOAD: J40007.18
SYS_5aed2944__CH0_ADDR2: J40006.3
SYS_6a132103__CH1_RUN: J40003.6
SYS_6c012064__ROUTE_COMMAND_READY: J40005.1
SYS_6d4bb3d1__STIM11_CONTACT: J40007.12
SYS_8b50701c__STIM01_CONTACT: J40007.2
SYS_08e41150__CH0_ADDR1: J40006.2
SYS_11f4403a__ROUTE_SER: J40002.1
SYS_20eba8c2__CH1_QUIESCENT_OK: J40004.6
SYS_32f1b236__STIM12_CONTACT: J40007.13
SYS_36b8c84f__STIM02_CONTACT: J40007.3
SYS_46ea5f03__CH0_REQUEST: J40003.3
SYS_56ebc071__CH0_MON_PERMIT: J40004.8
SYS_74b9e55a__STIM10_CONTACT: J40007.11
SYS_83ddb634__CH1_WANT_ROUTE: J40003.2
SYS_84f28705__CH1_ROUTE_LOCKED: J40005.8
SYS_126bf237__STIM14_CONTACT: J40007.15
SYS_223a43dd__STIM03_CONTACT: J40007.4
SYS_695f3a7c__CH0_RUN: J40003.5
SYS_15689dc4__VH_24: J40001.1
SYS_56562df4__GND: J40001.3, J40002.7, J40003.7, J40004.10, J40005.12, J40006.9
SYS_80673a9e__STIM08_CONTACT: J40007.9
SYS_82867ca5__STIM00_CONTACT: J40007.1
SYS_087068cd__CH0_ADDR0: J40006.1
SYS_98321c7b__AFE_ISOLATED_READY: J40004.4
SYS_344482b2__STIM13_CONTACT: J40007.14
SYS_1954027d__CH0_ROUTE_LOCKED: J40005.7
SYS_08572049__HOST_3V3: J40001.2
SYS_93547907__RAILS_QUALIFIED: J40004.2
SYS_a83d484c__WATCHDOG_OK: J40004.3
SYS_aa321af6__CH1_MON_PERMIT: J40004.9
SYS_b6a3943c__ROUTE_COMMIT: J40002.4
SYS_b6ef4aed__CH1_ADDR3: J40006.8
SYS_b675ff0d__STIM06_CONTACT: J40007.7
SYS_c3abe6bc__CH1_ADDR0: J40006.5
SYS_cf17d7c4__STIM07_CONTACT: J40007.8
SYS_d5e1f64a__ROUTE_SRCLK: J40002.2
SYS_dcbe1273__STIM04_CONTACT: J40007.5
SYS_dd388269__CH1_REQUEST: J40003.4
SYS_e338b670__CH0_WANT_ROUTE: J40003.1
SYS_eb2c0acf__STIM09_CONTACT: J40007.10
SYS_ed4497b7__ROUTE_REARM: J40002.5
SYS_f00e6304__STIM15_CONTACT: J40007.16
SYS_f373e353__CH1_ADDR2: J40006.7
SYS_f7756399__CH0_ADDR3: J40006.4
SYS_fa6c9e06__STIM05_CONTACT: J40007.6
SYS_fd131f77__ROUTE_PRELOAD_LATCH: J40002.3
SYS_ff7fdc58__RESET_READY: J40004.1
contact-router__CH0_ROUTE_EN: J40005.5
contact-router__CH1_ROUTE_EN: J40005.6
contact-router__COMMIT_SEEN: J40005.11
contact-router__QUIET_SAFE: J40005.9
contact-router__READBACK_SEEN: J40005.10
contact-router__ROUTE_ADDR_EQUAL: J40005.3
contact-router__ROUTE_BLOCK: J40005.2
contact-router__ROUTE_CONFLICT: J40005.4
contact-router__ROUTE_SHIFT_TAIL: J40002.6

Notes on the sheet:
DIGITAL RESEARCH CIRCUIT / RESTRICTED 24 V, 3 mA SOURCES / ARTIFICIAL LOADS ONLY
Sixteen selectable stimulation contacts, two dedicated monitored returns; command-level routing is not measured continuity or isolation.
Required before COMMIT: both WANT/REQUEST/RUN low, independently observed quiescence, monitor permits, rails, recording isolation and watchdog valid.
Then: COMMIT -> read all eight active Q bits -> fresh verification ACK edge -> separate REARM -> assert route WANT -> allow settling before phase.
No mux state sensor, independent terminal cut-off, compliance detector, independent watchdog, rail generator, PCB or implanted device is completed here.
