pratham-cloud-ctrl/Project-SCCI-RH/electronics/stage4/integrated-pcb/integration/boards/contact-router/source0.kicad_sch

## KiCad design electronics/stage4/integrated-pcb/integration/boards/contact-router/source0.kicad_sch (2026-10-29)





Parts:
C40100, C40101: 100n X7R 50V; C_0805_2012Metric
C40102, C40103: 1u X7R 50V; C_0805_2012Metric
J40100: DRIVER A / MONITORED RETURN; PinHeader_1x03_P2.54mm_Vertical
R40100, R40101, R40102, R40103, R40104: 22k; R_0805_2012Metric
U40100, U40101: TMUX6208PWR; TSSOP-16_4.4x5mm_P0.65mm

Connections:
SYS_0d1e7c21__CH0_RETURN_LOAD: J40100.2
SYS_5aed2944__CH0_ADDR2: R40104.1, U40100.15 (A2), U40101.15 (A2)
SYS_6d4bb3d1__STIM11_CONTACT: U40101.7 (S4)
SYS_8b50701c__STIM01_CONTACT: U40100.5 (S2)
SYS_08e41150__CH0_ADDR1: R40103.1, U40100.16 (A1), U40101.16 (A1)
SYS_32f1b236__STIM12_CONTACT: U40101.12 (S5)
SYS_36b8c84f__STIM02_CONTACT: U40100.6 (S3)
SYS_74b9e55a__STIM10_CONTACT: U40101.6 (S3)
SYS_126bf237__STIM14_CONTACT: U40101.10 (S7)
SYS_223a43dd__STIM03_CONTACT: U40100.7 (S4)
SYS_917b1360__CH0_A_ROUTER: J40100.1, U40100.8 (D_COMMON), U40101.8 (D_COMMON)
SYS_15689dc4__VH_24: C40100.1, C40101.1, C40102.1, C40103.1, U40100.13 (VDD), U40101.13 (VDD)
SYS_56562df4__GND: C40100.2, C40101.2, C40102.2, C40103.2, J40100.3, R40100.2, R40101.2, R40102.2, R40103.2, R40104.2, U40100.3 (VSS), U40100.14 (GND), U40101.3 (VSS), U40101.14 (GND)
SYS_80673a9e__STIM08_CONTACT: U40101.4 (S1)
SYS_82867ca5__STIM00_CONTACT: U40100.4 (S1)
SYS_087068cd__CH0_ADDR0: R40102.1, U40100.1 (A0), U40101.1 (A0)
SYS_344482b2__STIM13_CONTACT: U40101.11 (S6)
SYS_b675ff0d__STIM06_CONTACT: U40100.10 (S7)
SYS_cf17d7c4__STIM07_CONTACT: U40100.9 (S8)
SYS_dcbe1273__STIM04_CONTACT: U40100.12 (S5)
SYS_eb2c0acf__STIM09_CONTACT: U40101.5 (S2)
SYS_f00e6304__STIM15_CONTACT: U40101.9 (S8)
SYS_fa6c9e06__STIM05_CONTACT: U40100.11 (S6)
contact-router__CH0_BANK0_EN: R40100.1, U40100.2 (EN_HIGH)
contact-router__CH0_BANK1_EN: R40101.1, U40101.2 (EN_HIGH)

Notes on the sheet:
DIGITAL RESEARCH CIRCUIT / RESTRICTED 24 V, 3 mA SOURCES / ARTIFICIAL LOADS ONLY
Sixteen selectable stimulation contacts, two dedicated monitored returns; command-level routing is not measured continuity or isolation.
Both bank D commons share A_ROUTER. EN0 = ROUTE_EN & !ADDR3; EN1 = ROUTE_EN & ADDR3. Addresses 000..111 select S1..S8.
Dedicated return: external contact -> RETURN_LOAD -> existing monitor 2 ohm shunt -> RETURN_DRIVER -> current-driver B_BR.
Do not bypass the monitor, add a second shunt, tie the two returns, or use recording REF/BIAS as a stimulation return.
TMUX6208 is rail-to-rail at valid 24 V supply; powered-off, stuck-on, parasitic coupling and two-source shared tissue paths remain unqualified.
A_ROUTER needs external terminal guard qualification before connection to A_BR. Internal enable-low is only a commanded off state.
