pratham-cloud-ctrl/Project-SCCI-RH/electronics/stage4/integrated-pcb/integration/boards/controller-carrier/defaults_2.kicad_sch

## KiCad design electronics/stage4/integrated-pcb/integration/boards/controller-carrier/defaults_2.kicad_sch (2026-10-29)





Parts:
R80114, R80115, R80116, R80117, R80118, R80119, R80120, R80121, R80122, R80123, R80124, R80125, R80126, R80127: 10k; R_0805_2012Metric

Connections:
SYS_7cf9dad5__MON_SCLK: R80115.1
SYS_11f4403a__ROUTE_SER: R80124.1
SYS_32a601bf__MON_REARM1: R80122.1
SYS_36b0932b__INT_RUN1: R80120.2
SYS_46ea5f03__CH0_REQUEST: R80126.1
SYS_822d2245__MON_REARM0: R80121.1
SYS_37737e7c__INT_RUN0: R80119.2
SYS_56562df4__GND: R80114.2, R80115.2, R80116.2, R80121.2, R80122.2, R80123.2, R80124.2, R80126.2, R80127.2
SYS_08572049__HOST_3V3: R80117.1, R80118.1, R80119.1, R80120.1, R80125.1
SYS_a863a08a__CS1: R80118.2
SYS_a9673f8c__AFE_RECORD: R80114.1
SYS_ce0a4f53__BOTH_CNV: R80116.1
SYS_d5e1f64a__ROUTE_SRCLK: R80123.1
SYS_dd388269__CH1_REQUEST: R80127.1
SYS_e496c0b2__DAC_SYNC_N: R80125.2
SYS_ec2c6e7f__CS0: R80117.2

Notes on the sheet:
DIGITAL SCCI ENGINEERING / ARTIFICIAL SIGNALS / nRF5340 CONTROLLER CARRIER
46 actual GPIO, explicit common CNV/rearm and physical 32-bit health/readback chain. Radio remains disabled.
All labels are native electrical connections. Digital artificial-load interface; no clinical, chronic or body-radio qualification.
Hardware permissions and terminal guards remain independent of transport. Loss of data rejects the observation.
