pratham-cloud-ctrl/Project-SCCI-RH/electronics/stage4/integrated-pcb/integration/boards/controller-carrier/sideband.kicad_sch

## KiCad design electronics/stage4/integrated-pcb/integration/boards/controller-carrier/sideband.kicad_sch (2026-10-29)



Parts:
C80010, C80011, C80012, C80013: 100n X7R 10V; C_1206_3216Metric
U80010, U80011, U80012, U80013: SN74LVC165APWR; TSSOP-16_4.4x5mm_P0.65mm

Connections:
SYS_0cbf1bda__CH1_ADDR1: U80010.13 (C)
SYS_2d0e5b2e__CH0_QUIESCENT_OK: U80011.14 (D)
SYS_5aed2944__CH0_ADDR2: U80010.4 (F)
SYS_6a132103__CH1_RUN: U80012.14 (D)
SYS_6c012064__ROUTE_COMMAND_READY: U80012.11 (A)
SYS_08e41150__CH0_ADDR1: U80010.5 (G)
SYS_9c8a42b1__CH1_TIMEOUT: U80013.5 (G)
SYS_20eba8c2__CH1_QUIESCENT_OK: U80011.13 (C)
SYS_54dd20d7__CH0_TIMEOUT: U80013.6 (H)
SYS_56ebc071__CH0_MON_PERMIT: U80011.12 (B)
SYS_77c24b0d__GLOBAL_GUARD_EN: U80012.4 (F)
SYS_88c50083__SUP_ARMED: U80012.5 (G)
SYS_695f3a7c__CH0_RUN: U80012.3 (E)
SYS_56562df4__GND: C80010.2, C80011.2, C80012.2, C80013.2, U80010.8 (GND), U80010.15 (CLK_INH), U80011.8 (GND), U80011.15 (CLK_INH), U80012.8 (GND), U80012.15 (CLK_INH), U80013.3 (E), U80013.8 (GND), U80013.10 (SER), U80013.12 (B), U80013.14 (D), U80013.15 (CLK_INH)
SYS_087068cd__CH0_ADDR0: U80010.6 (H)
SYS_98321c7b__AFE_ISOLATED_READY: U80011.3 (E)
SYS_08572049__HOST_3V3: C80010.1, C80011.1, C80012.1, C80013.1, U80010.16 (VCC), U80011.16 (VCC), U80012.16 (VCC), U80013.4 (F), U80013.11 (A), U80013.13 (C), U80013.16 (VCC)
SYS_93547907__RAILS_QUALIFIED: U80011.5 (G)
SYS_a83d484c__WATCHDOG_OK: U80011.4 (F)
SYS_aa321af6__CH1_MON_PERMIT: U80011.11 (A)
SYS_b6ef4aed__CH1_ADDR3: U80010.11 (A)
SYS_c3abe6bc__CH1_ADDR0: U80010.14 (D)
SYS_c659d53f__CH1_TIMER: U80012.12 (B)
SYS_ca7ea3db__CH0_TIMER: U80012.13 (C)
SYS_d5e1f64a__ROUTE_SRCLK: U80010.2 (CLK), U80011.2 (CLK), U80012.2 (CLK), U80013.2 (CLK)
SYS_ee59c76b__PWR_FAULT_N: U80012.6 (H)
SYS_f373e353__CH1_ADDR2: U80010.12 (B)
SYS_f7756399__CH0_ADDR3: U80010.3 (E)
SYS_ff7fdc58__RESET_READY: U80011.6 (H)
controller-carrier__SB_Q1: U80010.10 (SER), U80011.9 (QH)
controller-carrier__SB_Q2: U80011.10 (SER), U80012.9 (QH)
controller-carrier__SB_Q3: U80012.10 (SER), U80013.9 (QH)
controller-carrier__SIDEBAND_DATA: U80010.9 (QH)
controller-carrier__SIDEBAND_LOAD_N: U80010.1 (SH_LD_N), U80011.1 (SH_LD_N), U80012.1 (SH_LD_N), U80013.1 (SH_LD_N)

Notes on the sheet:
DIGITAL SCCI ENGINEERING / ARTIFICIAL SIGNALS / nRF5340 CONTROLLER CARRIER
46 actual GPIO, explicit common CNV/rearm and physical 32-bit health/readback chain. Radio remains disabled.
All labels are native electrical connections. Digital artificial-load interface; no clinical, chronic or body-radio qualification.
Hardware permissions and terminal guards remain independent of transport. Loss of data rejects the observation.
