pratham-cloud-ctrl/Project-SCCI-RH/electronics/stage4/integrated-pcb/integration/boards/current-driver/source1.kicad_sch

## KiCad design electronics/stage4/integrated-pcb/integration/boards/current-driver/source1.kicad_sch (2026-10-29)





Parts:
C20200: DNP 10p C0G; C_0805_2012Metric; not fitted
C20201, C20202, C20203: 100n 25V; C_0805_2012Metric
C20204: 100n 50V; C_0805_2012Metric
C20205: 1u 50V; C_0805_2012Metric
J20200: EXTERNAL ROUTER / MONITOR; PinHeader_1x04_P2.54mm_Vertical
Q20200: BSP89H6327XTSA1; BSP89_PG-SOT223-4_DrainTab
R20200: 100R 0.1% LOW TCR; R_0805_2012Metric
R20201: 330R; R_0805_2012Metric
R20202: 100k; R_0805_2012Metric
R20203, R20204, R20205: 22k; R_0805_2012Metric
U20200: OPA192IDBVR; SOT-23-5
U20201: TMUX7212PWR; TSSOP-16_4.4x5mm_P0.65mm
U20202, U20203: TMUX6219DGKR; VSSOP-8_2.3x2mm_P0.5mm

Connections:
SYS_6a132103__CH1_RUN: R20205.1, U20202.6 (SEL_RUN), U20203.6 (SEL_RUN)
SYS_401be33b__CH1_A_ROUTER: J20200.1, U20201.2 (D1_A), U20201.10 (D3_A)
SYS_15689dc4__VH_24: C20204.1, C20205.1, U20201.3 (S1_HV), U20201.13 (VDD), U20201.14 (S2_HV)
SYS_56562df4__GND: C20201.2, C20202.2, C20203.2, C20204.2, C20205.2, J20200.4, R20200.2, R20202.2, R20203.2, R20204.2, R20205.2, U20200.2 (V-), U20201.4 (VSS), U20201.5 (GND), U20202.2 (S1_OFF), U20202.3 (GND), U20202.7 (VSS), U20203.3 (GND), U20203.7 (VSS)
SYS_c73180be__CH1_B_BR: J20200.2, U20201.7 (D4_B), U20201.15 (D2_B)
SYS_fb2237f8__VA_15: C20201.1, C20202.1, C20203.1, U20200.5 (V+), U20202.4 (VDD), U20202.5 (EN), U20203.4 (VDD), U20203.5 (EN)
current-driver__CH1_DIAG_M: R20204.1, U20201.9 (SEL3), U20201.16 (SEL2)
current-driver__CH1_DIAG_P: R20203.1, U20201.1 (SEL1), U20201.8 (SEL4)
current-driver__CH1_FB: C20200.2, U20200.4 (IN-), U20203.1 (D)
current-driver__CH1_GATE: Q20200.1 (GATE), R20201.2, R20202.1
current-driver__CH1_GATE_SW: R20201.1, U20202.1 (D)
current-driver__CH1_SENSE_K: J20200.3, Q20200.3 (SOURCE), R20200.1, U20203.8 (S2_RUN)
current-driver__CH1_SERVO: C20200.1, U20200.1 (OUT), U20202.8 (S2_RUN), U20203.2 (S1_OFF)
current-driver__CH1_SINK_D: Q20200.2 (DRAIN), Q20200.4 (DRAIN_TAB), U20201.6 (S4_SINK), U20201.11 (S3_SINK)
current-driver__CH1_VSET: U20200.3 (IN+)

Notes on the sheet:
ARTIFICIAL LOADS ONLY / RESTRICTED 24 V, 3 mA, 200 us DRIVER SLICE
External rails, recording AFE, 16-contact routing, compliance, charge guard, watchdog, PCB and implant qualification remain outside.
Current path: VH -> upper switch -> artificial pair load + external 2 ohm monitor -> lower switch -> BSP89 -> 100 ohm -> GND.
RUN low grounds gate and closes local unity feedback. RUN high selects current loop. DNP compensation needs a transient study.
Bridge uses captured direction; all four commanded off during inhibit. Analog rail clamps, input bias and stuck switches remain real paths.
