pratham-cloud-ctrl/Project-SCCI-RH/electronics/stage4/integrated-pcb/integration/boards/monitoring-cell/channel1.kicad_sch

## KiCad design electronics/stage4/integrated-pcb/integration/boards/monitoring-cell/channel1.kicad_sch (2026-10-29)



Parts:
C10200: 22n 0.5% C0G; C_0805_2012Metric
C10201: 1n C0G; C_0805_2012Metric
C10202, C10203, C10204, C10208, C10209, C10210: 100n 10V; C_0805_2012Metric
C10205, C10206: 1u 10V; C_0805_2012Metric
C10207: 22u 10V; C_0805_2012Metric
J10200: SOURCE 1 RETURN SHUNT; PinHeader_1x02_P2.54mm_Vertical
J10201: SOURCE 1 DRIVER PERMISSION; PinHeader_1x03_P2.54mm_Vertical
R10200: 2R 0.1% KELVIN; R_0805_2012Metric
R10201: 10k 0.1%; R_0805_2012Metric
R10202: 33R; R_0805_2012Metric
R10203, R10204, R10205: 100k; R_0805_2012Metric
U10200: INA241A2IDR; SOIC-8_3.9x4.9mm_P1.27mm
U10201, U10202: OPA391DCKR; SOT-353_SC-70-5
U10203: ADS8866IDGSR; MSOP-10_3x3mm_P0.5mm
U10204: TLV3202IDR; SOIC-8_3.9x4.9mm_P1.27mm
U10205: SN74LVC1G11DBVR; SOT-23-6
U10206: SN74LVC1G74DCUR; VSSOP-8_2.3x2mm_P0.5mm

Connections:
SYS_3ced048f__CH1_RETURN_LOAD: J10200.1, R10200.1, U10200.8 (IN+)
SYS_4f66f129__MON_VREF: C10207.1, U10203.1 (REF)
SYS_7cf9dad5__MON_SCLK: U10203.8 (SCLK)
SYS_32a601bf__MON_REARM1: R10204.1, U10206.1 (CLK_REARM)
SYS_37cfe02a__MON_VMID: U10200.3 (REF2), U10200.7 (REF1), U10201.1 (IN+)
SYS_502efdd4__CH1_I_MON: R10201.1, U10200.5 (OUT), U10204.2 (1IN-), U10204.5 (2IN+)
SYS_56562df4__GND: C10201.2, C10202.2, C10203.2, C10204.2, C10205.2, C10206.2, C10207.2, C10208.2, C10209.2, C10210.2, J10201.3, R10203.2, R10204.2, R10205.2, U10200.2 (GND), U10200.4 (NC=GND), U10201.2 (V-), U10202.2 (V-), U10203.4 (AINN), U10203.5 (GND), U10204.4 (GND), U10205.2 (GND), U10206.4 (GND)
SYS_08572049__HOST_3V3: C10205.1, C10206.1, C10209.1, C10210.1, U10203.2 (AVDD), U10203.10 (DVDD), U10205.5 (VCC), U10206.2 (D), U10206.7 (PRE_N), U10206.8 (VCC)
SYS_a863a08a__CS1: U10203.9 (DIN/CS_N)
SYS_aa321af6__CH1_MON_PERMIT: J10201.1, R10205.1, U10206.5 (Q_PERMIT)
SYS_c73180be__CH1_B_BR: J10200.2, R10200.2, U10200.1 (IN-)
SYS_ce0a4f53__BOTH_CNV: U10203.6 (CONVST)
SYS_ce166826__HOST_5: C10202.1, C10203.1, C10204.1, C10208.1, U10200.6 (VS), U10201.5 (V+), U10202.5 (V+), U10204.8 (VCC)
SYS_de0a854a__CH1_EXT_SUP_OK: J10201.2, R10203.1, U10205.6 (C_EXT_SUP_OK)
SYS_fd7db492__CH1_DOUT: U10203.7 (DOUT)
monitoring-cell__CH1_ADC_BUF: R10202.1, U10202.3 (IN-), U10202.4 (OUT)
monitoring-cell__CH1_ADC_IN: C10201.1, R10202.2, U10203.3 (AINP)
monitoring-cell__CH1_CLEAR_N: U10205.4 (Y_CLR_N), U10206.6 (CLR_N)
monitoring-cell__CH1_HI_OK: U10204.1 (HI_OK), U10205.1 (A_HI_OK)
monitoring-cell__CH1_LO_OK: U10204.7 (LO_OK), U10205.3 (B_LO_OK)
monitoring-cell__CH1_Q_INT: C10200.2, U10201.4 (OUT), U10202.1 (IN+)
monitoring-cell__CH1_SUM: C10200.1, R10201.2, U10201.3 (IN-)
monitoring-cell__I_HI: U10204.3 (1IN+)
monitoring-cell__I_LO: U10204.6 (2IN-)

Notes on the sheet:
ARTIFICIAL ELECTRICAL LOADS ONLY / FIRST MONITORING SLICE
No current driver, HV router, differential compliance circuit, independent watchdog, MCU or PCB is completed here.
Q=-10k*22n/40*(V_end-V_start); 600nC=109.091mV nominal. Take BASELINE, CATH, ANODE, NET/TAIL endpoints.
Cathodic and anodic charges remain separate. Opposed phases can cancel: final net alone cannot qualify delivery.
Actual current-tail/window evidence is required. Command edges, the comparator or an ideal16-bit LSB do not certify precision.
CLRN = HI_OK AND LO_OK AND EXT_SUP_OK. Any low latches Q off; rising REARM admits only while CLRN is high.
