pratham-cloud-ctrl/Project-SCCI-RH/electronics/stage4/integrated-pcb/integration/boards/monitoring-transport/health.kicad_sch

## KiCad design electronics/stage4/integrated-pcb/integration/boards/monitoring-transport/health.kicad_sch (2026-10-29)



Parts:
R70120: 4.99k 0.1%; R_0805_2012Metric
R70121: 2.49k 0.1%; R_0805_2012Metric
R70122: 2.4k 0.1%; R_0805_2012Metric
R70123: 2k 0.1%; R_0805_2012Metric

Connections:
SYS_56562df4__GND: R70121.2, R70123.2
SYS_ce166826__HOST_5: R70122.1
SYS_f199d834__PACK_BUS: R70120.1
monitoring-transport__HOST5_SCALED: R70122.2, R70123.1
monitoring-transport__PACK_SCALED: R70120.2, R70121.1

Notes on the sheet:
DIGITAL SCCI ENGINEERING / ARTIFICIAL SIGNALS / MONITORING AND COMPANION
Dedicated raw current/voltage ADC and wired processed-feature companion. Endpoint charge ADCs remain separate.
All labels are native electrical connections. Digital artificial-load interface; no clinical, chronic or body-radio qualification.
Hardware permissions and terminal guards remain independent of transport. Loss of data rejects the observation.
