pratham-cloud-ctrl/Project-SCCI-RH/electronics/stage4/integrated-pcb/integration/boards/monitoring-transport/root_2.kicad_sch

## KiCad design electronics/stage4/integrated-pcb/integration/boards/monitoring-transport/root_2.kicad_sch (2026-10-29)




Parts:
J70004: TWO EXISTING CHARGE ADCs; PinHeader_1x08_P2.54mm_Vertical
J70005: CHARGE CONTROL HANDOFF; PinHeader_1x05_P2.54mm_Vertical
J70006: READ-ONLY NATIVE HEALTH; PinHeader_1x10_P2.54mm_Vertical

Connections:
SYS_2d0e5b2e__CH0_QUIESCENT_OK: J70006.5
SYS_7cf9dad5__MON_SCLK: J70004.7
SYS_20eba8c2__CH1_QUIESCENT_OK: J70006.6
SYS_32a601bf__MON_REARM1: J70005.4
SYS_36b0932b__INT_RUN1: J70005.2
SYS_77c24b0d__GLOBAL_GUARD_EN: J70006.8
SYS_83a198be__CH0_DOUT: J70004.3
SYS_88c50083__SUP_ARMED: J70006.7
SYS_822d2245__MON_REARM0: J70005.3
SYS_37737e7c__INT_RUN0: J70005.1
SYS_56562df4__GND: J70004.8, J70005.5, J70006.10
SYS_98321c7b__AFE_ISOLATED_READY: J70006.4
SYS_93547907__RAILS_QUALIFIED: J70006.2
SYS_a83d484c__WATCHDOG_OK: J70006.3
SYS_a863a08a__CS1: J70004.5
SYS_ce0a4f53__BOTH_CNV: J70004.1, J70004.4
SYS_ec2c6e7f__CS0: J70004.2
SYS_ee59c76b__PWR_FAULT_N: J70006.9
SYS_fd7db492__CH1_DOUT: J70004.6
SYS_ff7fdc58__RESET_READY: J70006.1

Notes on the sheet:
DIGITAL SCCI ENGINEERING / ARTIFICIAL SIGNALS / MONITORING AND COMPANION
Dedicated raw current/voltage ADC and wired processed-feature companion. Endpoint charge ADCs remain separate.
All labels are native electrical connections. Digital artificial-load interface; no clinical, chronic or body-radio qualification.
Hardware permissions and terminal guards remain independent of transport. Loss of data rejects the observation.
