pratham-cloud-ctrl/Project-SCCI-RH/electronics/stage4/integrated-pcb/integration/boards/power/afen.kicad_sch

## KiCad design electronics/stage4/integrated-pcb/integration/boards/power/afen.kicad_sch (2026-10-29)



Parts:
C64120: 10u X7R 50V; C_1206_3216Metric
C64121: 10u X7R 16V; C_1206_3216Metric
C64122, C64123: 10n C0G 50V; C_1206_3216Metric
J60412: QUIESCENT TRIM / TEST ONLY; PinHeader_1x03_P2.54mm_Vertical
R64120: 33367.347R 0.1%; R_0805_2012Metric
R64121: 10k 0.1%; R_0805_2012Metric
R64122: 47k; R_0805_2012Metric
U60412: TPS7A3001DGNR; Texas_DGN0008D_VSSOP-8-1EP_3x3mm_P0.65mm_EP2x2.94mm_Mask1.5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

Connections:
SYS_d73cd2ee__AFE_N5: C64121.1, C64123.1, J60412.1, R64120.1, R64122.1, U60412.1 (OUT)
SYS_fca1c340__AFEAGND: C64120.2, C64121.2, C64122.2, J60412.3, R64121.2, R64122.2, U60412.4 (GND), U60412.9 (EP_GND)
power__AFE_N5_FB: C64123.2, J60412.2, R64120.2, R64121.1, U60412.2 (FB)
power__AFE_N5_NR: C64122.1, U60412.6 (NR_SS)
power__ISO_N12: C64120.1, U60412.5 (EN), U60412.8 (IN)

Notes on the sheet:
DIGITAL SCCI ENGINEERING / ARTIFICIAL LOADS / BATTERY AND POWER
2S protected pack, independent supervisor rails, host converters and floating AFE supplies. Digital circuit design, not implant qualification.
All labels are native electrical connections. PG is diagnostic; full qualification remains the nine independent supervision windows.
Converter shutdown does not discharge boost paths or remove stored energy. Body-facing shutdown remains the separate terminal guards.
