pratham-cloud-ctrl/Project-SCCI-RH/electronics/stage4/integrated-pcb/integration/boards/power/afep.kicad_sch

## KiCad design electronics/stage4/integrated-pcb/integration/boards/power/afep.kicad_sch (2026-10-29)



Parts:
C64110: 10u X7R 50V; C_1206_3216Metric
C64111: 10u X7R 16V; C_1206_3216Metric
C64112, C64113: 10n C0G 50V; C_1206_3216Metric
J60411: QUIESCENT TRIM / TEST ONLY; PinHeader_1x03_P2.54mm_Vertical
R64110: 34725.738R 0.1%; R_0805_2012Metric
R64111: 10k 0.1%; R_0805_2012Metric
R64112: 47k; R_0805_2012Metric
U60411: TPS7A4901DGNR; Texas_DGN0008D_VSSOP-8-1EP_3x3mm_P0.65mm_EP2x2.94mm_Mask1.5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

Connections:
SYS_3fdd5066__AFE_P5: C64111.1, C64113.1, J60411.1, R64110.1, R64112.1, U60411.1 (OUT)
SYS_fca1c340__AFEAGND: C64110.2, C64111.2, C64112.2, J60411.3, R64111.2, R64112.2, U60411.4 (GND), U60411.9 (EP_GND)
power__AFE_P5_FB: C64113.2, J60411.2, R64110.2, R64111.1, U60411.2 (FB)
power__AFE_P5_NR: C64112.1, U60411.6 (NR_SS)
power__ISO_P12: C64110.1, U60411.5 (EN), U60411.8 (IN)

Notes on the sheet:
DIGITAL SCCI ENGINEERING / ARTIFICIAL LOADS / BATTERY AND POWER
2S protected pack, independent supervisor rails, host converters and floating AFE supplies. Digital circuit design, not implant qualification.
All labels are native electrical connections. PG is diagnostic; full qualification remains the nine independent supervision windows.
Converter shutdown does not discharge boost paths or remove stored energy. Body-facing shutdown remains the separate terminal guards.
