pratham-cloud-ctrl/Project-SCCI-RH/electronics/stage4/integrated-pcb/integration/boards/power/boost15.kicad_sch

## KiCad design electronics/stage4/integrated-pcb/integration/boards/power/boost15.kicad_sch (2026-10-29)



Parts:
C63000: 10u X7R 25V; C_1206_3216Metric
C63001, C63002: 22u X7R 50V; C_1206_3216Metric
C63003: 1u X7R 10V; C_1206_3216Metric
C63004: 4.7p C0G 50V; C_1206_3216Metric
D60300: PMEG6010CEJ; D_SOD-323F
L60300: 4.7uH SRP5030T-4R7M; L_Bourns_SRP5030T
R63000: 418750R 0.1%; R_0805_2012Metric
R63001: 50k 0.1%; R_0805_2012Metric
R63002: 100k; R_0805_2012Metric
U60300: LT8330ES6#TRPBF; TSOT-23-6

Connections:
SYS_56562df4__GND: C63000.2, C63001.2, C63002.2, C63003.2, R63001.2, R63002.2, U60300.2 (GND)
SYS_f199d834__PACK_BUS: C63000.1, L60300.1, U60300.6 (VIN)
SYS_fb2237f8__VA_15: C63001.1, C63002.1, C63004.1, D60300.1 (K), R63000.1, R63002.1
power__BOOST_ENABLE: U60300.4 (EN_UVLO)
power__HOST_15_FB: C63004.2, R63000.2, R63001.1, U60300.3 (FBX)
power__HOST_15_INTVCC: C63003.1, U60300.5 (INTVCC)
power__HOST_15_SW: D60300.2 (A), L60300.2, U60300.1 (SW)

Notes on the sheet:
DIGITAL SCCI ENGINEERING / ARTIFICIAL LOADS / BATTERY AND POWER
2S protected pack, independent supervisor rails, host converters and floating AFE supplies. Digital circuit design, not implant qualification.
All labels are native electrical connections. PG is diagnostic; full qualification remains the nine independent supervision windows.
Converter shutdown does not discharge boost paths or remove stored energy. Body-facing shutdown remains the separate terminal guards.
