pratham-cloud-ctrl/Project-SCCI-RH/electronics/stage4/integrated-pcb/integration/boards/power/boost24.kicad_sch

## KiCad design electronics/stage4/integrated-pcb/integration/boards/power/boost24.kicad_sch (2026-10-29)



Parts:
C63010: 10u X7R 25V; C_1206_3216Metric
C63011, C63012: 22u X7R 50V; C_1206_3216Metric
C63013: 1u X7R 10V; C_1206_3216Metric
C63014: 4.7p C0G 50V; C_1206_3216Metric
D60301: PMEG6010CEJ; D_SOD-323F
L60301: 4.7uH SRP5030T-4R7M; L_Bourns_SRP5030T
R63010: 700000R 0.1%; R_0805_2012Metric
R63011: 50k 0.1%; R_0805_2012Metric
R63012: 100k; R_0805_2012Metric
U60301: LT8330ES6#TRPBF; TSOT-23-6

Connections:
SYS_15689dc4__VH_24: C63011.1, C63012.1, C63014.1, D60301.1 (K), R63010.1, R63012.1
SYS_56562df4__GND: C63010.2, C63011.2, C63012.2, C63013.2, R63011.2, R63012.2, U60301.2 (GND)
SYS_f199d834__PACK_BUS: C63010.1, L60301.1, U60301.6 (VIN)
power__BOOST_ENABLE: U60301.4 (EN_UVLO)
power__VH_24_FB: C63014.2, R63010.2, R63011.1, U60301.3 (FBX)
power__VH_24_INTVCC: C63013.1, U60301.5 (INTVCC)
power__VH_24_SW: D60301.2 (A), L60301.2, U60301.1 (SW)

Notes on the sheet:
DIGITAL SCCI ENGINEERING / ARTIFICIAL LOADS / BATTERY AND POWER
2S protected pack, independent supervisor rails, host converters and floating AFE supplies. Digital circuit design, not implant qualification.
All labels are native electrical connections. PG is diagnostic; full qualification remains the nine independent supervision windows.
Converter shutdown does not discharge boost paths or remove stored energy. Body-facing shutdown remains the separate terminal guards.
