pratham-cloud-ctrl/Project-SCCI-RH/electronics/stage4/integrated-pcb/integration/boards/power/enable.kicad_sch

## KiCad design electronics/stage4/integrated-pcb/integration/boards/power/enable.kicad_sch (2026-10-29)





Parts:
C60200, C60201: 100n X7R 16V; C_1206_3216Metric
R62000: 155000R 0.1%; R_0805_2012Metric
R62001, R62003, R62011, R62013, R62021, R62023: 10k 0.1%; R_0805_2012Metric
R62002: 205000R 0.1%; R_0805_2012Metric
R62004, R62014, R62024: 10k; R_0805_2012Metric
R62010: 67500R 0.1%; R_0805_2012Metric
R62012: 77500R 0.1%; R_0805_2012Metric
R62020: 108750R 0.1%; R_0805_2012Metric
R62022: 121250R 0.1%; R_0805_2012Metric
U60200, U60201, U60202: TPS3700DDCR; SOT-23-6

Connections:
SYS_66aba95b__SUP_5: R62020.1, R62022.1
SYS_56562df4__GND: C60200.2, C60201.2, R62001.2, R62003.2, R62011.2, R62013.2, R62021.2, R62023.2, U60200.2 (GND), U60201.2 (GND), U60202.2 (GND)
SYS_ab932142__SUP_3V3: C60200.1, C60201.1, R62004.1, R62010.1, R62012.1, R62014.1, R62024.1, U60200.5 (VDD), U60201.5 (VDD), U60202.5 (VDD)
power__BATT_OV: R62002.2, R62003.1, U60200.4 (INB_OV)
power__BATT_UV: R62000.2, R62001.1, U60200.3 (INA_UV)
power__BATT_WINDOW_OK: R62004.2, U60200.1 (OUTA_UV_N), U60200.6 (OUTB_OV_N)
power__PACK_POS: R62000.1, R62002.1
power__S3_OV: R62012.2, R62013.1, U60201.4 (INB_OV)
power__S3_UV: R62010.2, R62011.1, U60201.3 (INA_UV)
power__S3_WINDOW_OK: R62014.2, U60201.1 (OUTA_UV_N), U60201.6 (OUTB_OV_N)
power__S5_OV: R62022.2, R62023.1, U60202.4 (INB_OV)
power__S5_UV: R62020.2, R62021.1, U60202.3 (INA_UV)
power__S5_WINDOW_OK: R62024.2, U60202.1 (OUTA_UV_N), U60202.6 (OUTB_OV_N)

Notes on the sheet:
DIGITAL SCCI ENGINEERING / ARTIFICIAL LOADS / BATTERY AND POWER
2S protected pack, independent supervisor rails, host converters and floating AFE supplies. Digital circuit design, not implant qualification.
All labels are native electrical connections. PG is diagnostic; full qualification remains the nine independent supervision windows.
Converter shutdown does not discharge boost paths or remove stored energy. Body-facing shutdown remains the separate terminal guards.
