pratham-cloud-ctrl/Project-SCCI-RH/electronics/stage4/integrated-pcb/integration/boards/power/enable_2.kicad_sch

## KiCad design electronics/stage4/integrated-pcb/integration/boards/power/enable_2.kicad_sch (2026-10-29)





Parts:
C60202, C60203, C60204: 100n X7R 16V; C_1206_3216Metric
C60230: 47n X7R 10%; C_1206_3216Metric
D60230: BAT54WS-7-F; D_SOD-323
R60230: 100k 1%; R_0805_2012Metric
R60231: 100R; R_0805_2012Metric
R62030: 89500R 0.1%; R_0805_2012Metric
R62031, R62033, R62041, R62043: 10k 0.1%; R_0805_2012Metric
R62032: 95500R 0.1%; R_0805_2012Metric
R62034, R62044: 10k; R_0805_2012Metric
R62040: 39500R 0.1%; R_0805_2012Metric
R62042: 43000R 0.1%; R_0805_2012Metric
U60203, U60204: TPS3700DDCR; SOT-23-6
U60230: SN74LVC1G17DBVR; SOT-23-5

Connections:
SYS_4f66f129__MON_VREF: R62030.1, R62032.1
SYS_37cfe02a__MON_VMID: R62040.1, R62042.1
SYS_56562df4__GND: C60202.2, C60203.2, C60204.2, C60230.2, R62031.2, R62033.2, R62041.2, R62043.2, U60203.2 (GND), U60204.2 (GND), U60230.3 (GND)
SYS_ab932142__SUP_3V3: C60202.1, C60203.1, C60204.1, R60230.1, R60231.2, R62034.1, R62044.1, U60203.5 (VDD), U60204.5 (VDD), U60230.5 (VCC)
power__MID_OV: R62042.2, R62043.1, U60204.4 (INB_OV)
power__MID_UV: R62040.2, R62041.1, U60204.3 (INA_UV)
power__MID_WINDOW_OK: R62044.2, U60204.1 (OUTA_UV_N), U60204.6 (OUTB_OV_N)
power__MREF_OV: R62032.2, R62033.1, U60203.4 (INB_OV)
power__MREF_UV: R62030.2, R62031.1, U60203.3 (INA_UV)
power__MREF_WINDOW_OK: R62034.2, U60203.1 (OUTA_UV_N), U60203.6 (OUTB_OV_N)
power__PWR_START_DIS: D60230.1 (K), R60231.1
power__PWR_START_OK: U60230.4 (Y)
power__PWR_START_RC: C60230.1, D60230.2 (A), R60230.2, U60230.2 (A)

Notes on the sheet:
DIGITAL SCCI ENGINEERING / ARTIFICIAL LOADS / BATTERY AND POWER
2S protected pack, independent supervisor rails, host converters and floating AFE supplies. Digital circuit design, not implant qualification.
All labels are native electrical connections. PG is diagnostic; full qualification remains the nine independent supervision windows.
Converter shutdown does not discharge boost paths or remove stored energy. Body-facing shutdown remains the separate terminal guards.
