pratham-cloud-ctrl/Project-SCCI-RH/electronics/stage4/integrated-pcb/integration/boards/power/enable_3.kicad_sch

## KiCad design electronics/stage4/integrated-pcb/integration/boards/power/enable_3.kicad_sch (2026-10-29)





Parts:
C60240, C60241, C60242, C60243, C60244, C60245, C60246, C60247: 100n X7R 16V; C_1206_3216Metric
R60240, R60241, R60242: 10k; R_0805_2012Metric
U60231, U60233: SN74LVC1G11DBVR; SOT-23-6
U60232, U60234, U60236, U60237: SN74LVC1G08DBVR; SOT-23-5
U60235: SN74LVC1G07DBVR; SOT-23-5

Connections:
SYS_56562df4__GND: C60240.2, C60241.2, C60242.2, C60243.2, C60244.2, C60245.2, C60246.2, C60247.2, R60240.2, R60241.2, R60242.2, U60231.2 (GND), U60232.3 (GND), U60233.2 (GND), U60234.3 (GND), U60235.3 (GND), U60236.3 (GND), U60237.3 (GND)
SYS_ab932142__SUP_3V3: C60240.1, C60241.1, C60242.1, C60243.1, C60244.1, C60245.1, C60246.1, C60247.1, U60231.5 (VCC), U60232.5 (VCC), U60233.5 (VCC), U60234.5 (VCC), U60235.5 (VCC), U60236.5 (VCC), U60237.5 (VCC)
SYS_ee59c76b__PWR_FAULT_N: U60235.4 (Y_OPEN_DRAIN)
power__BATT_OK: U60232.4 (Y), U60233.3 (B)
power__BATT_WINDOW_OK: U60232.1 (A)
power__BOOST_ENABLE: R60242.1, U60234.4 (Y), U60237.1 (A)
power__HOST_5_PG: U60234.2 (B)
power__HOST_ENABLE: R60241.1, U60233.4 (Y), U60234.1 (A)
power__MID_WINDOW_OK: U60236.2 (B)
power__MREF_WINDOW_OK: U60236.1 (A)
power__POWER_RUN_OK: U60235.2 (A), U60237.4 (Y)
power__PWR_REQUEST: R60240.1, U60233.1 (A)
power__PWR_START_OK: U60231.6 (C), U60232.2 (B)
power__REF_OK: U60236.4 (Y), U60237.2 (B)
power__S3_WINDOW_OK: U60231.1 (A)
power__S5_WINDOW_OK: U60231.3 (B)
power__SUP_READY: U60231.4 (Y), U60233.6 (C)

Notes on the sheet:
DIGITAL SCCI ENGINEERING / ARTIFICIAL LOADS / BATTERY AND POWER
2S protected pack, independent supervisor rails, host converters and floating AFE supplies. Digital circuit design, not implant qualification.
All labels are native electrical connections. PG is diagnostic; full qualification remains the nine independent supervision windows.
Converter shutdown does not discharge boost paths or remove stored energy. Body-facing shutdown remains the separate terminal guards.
