pratham-cloud-ctrl/Project-SCCI-RH/electronics/stage4/integrated-pcb/integration/boards/power/host3.kicad_sch

## KiCad design electronics/stage4/integrated-pcb/integration/boards/power/host3.kicad_sch (2026-10-29)



Parts:
C61020: 10u X7R 25V; C_1206_3216Metric
C61021: 22u X7R 16V; C_1206_3216Metric
L60102: 2.2uH SRP5030T-2R2M; L_Bourns_SRP5030T
R61020: 31250R 0.1%; R_0805_2012Metric
R61021: 10000R 0.1%; R_0805_2012Metric
R61022: 100k; R_0805_2012Metric
R61023: 47k; R_0805_2012Metric
U60102: TPS62160DGKR; VSSOP-8_3x3mm_P0.65mm

Connections:
SYS_56562df4__GND: C61020.2, C61021.2, R61021.2, R61023.2, U60102.1 (PGND), U60102.4 (AGND)
SYS_08572049__HOST_3V3: C61021.1, L60102.2, R61020.1, R61023.1, U60102.6 (VOS)
SYS_ab932142__SUP_3V3: R61022.1
SYS_f199d834__PACK_BUS: C61020.1, U60102.2 (VIN)
power__HOST_3V3_FB: R61020.2, R61021.1, U60102.5 (FB)
power__HOST_3V3_PG: R61022.2, U60102.8 (PG)
power__HOST_3V3_SW: L60102.1, U60102.7 (SW)
power__HOST_ENABLE: U60102.3 (EN)

Notes on the sheet:
DIGITAL SCCI ENGINEERING / ARTIFICIAL LOADS / BATTERY AND POWER
2S protected pack, independent supervisor rails, host converters and floating AFE supplies. Digital circuit design, not implant qualification.
All labels are native electrical connections. PG is diagnostic; full qualification remains the nine independent supervision windows.
Converter shutdown does not discharge boost paths or remove stored energy. Body-facing shutdown remains the separate terminal guards.
