pratham-cloud-ctrl/Project-SCCI-RH/electronics/stage4/integrated-pcb/integration/boards/power/host5.kicad_sch

## KiCad design electronics/stage4/integrated-pcb/integration/boards/power/host5.kicad_sch (2026-10-29)



Parts:
C61100: 10u X7R 25V; C_1206_3216Metric
C61101: 22u X7R 16V; C_1206_3216Metric
C61102: 100n X7R 25V; C_1206_3216Metric
C61103: 3.3n C0G 50V; C_1206_3216Metric
L60110: 2.2uH SRP5030T-2R2M; L_Bourns_SRP5030T
R61100: 52.5k 0.1%; R_0805_2012Metric
R61101: 10k 0.1%; R_0805_2012Metric
R61102: 100k; R_0805_2012Metric
R61103: 47k; R_0805_2012Metric
U60110: TPS62130ARGTR; VQFN-16-1EP_3x3mm_P0.5mm_EP1.68x1.68mm

Connections:
SYS_56562df4__GND: C61100.2, C61101.2, C61102.2, C61103.2, R61101.2, R61103.2, U60110.6 (AGND), U60110.7 (FSW), U60110.8 (DEF), U60110.15 (PGND1), U60110.16 (PGND2), U60110.17 (EP_GND)
SYS_ab932142__SUP_3V3: R61102.1
SYS_ce166826__HOST_5: C61101.1, L60110.2, R61100.1, R61103.1, U60110.14 (VOS)
SYS_f199d834__PACK_BUS: C61100.1, C61102.1, U60110.10 (AVIN), U60110.11 (PVIN1), U60110.12 (PVIN2)
power__HOST_5_FB: R61100.2, R61101.1, U60110.5 (FB)
power__HOST_5_PG: R61102.2, U60110.4 (PG)
power__HOST_5_SS: C61103.1, U60110.9 (SS_TR)
power__HOST_5_SW: L60110.1, U60110.1 (SW1), U60110.2 (SW2), U60110.3 (SW3)
power__HOST_ENABLE: U60110.13 (EN)

Notes on the sheet:
DIGITAL SCCI ENGINEERING / ARTIFICIAL LOADS / BATTERY AND POWER
2S protected pack, independent supervisor rails, host converters and floating AFE supplies. Digital circuit design, not implant qualification.
All labels are native electrical connections. PG is diagnostic; full qualification remains the nine independent supervision windows.
Converter shutdown does not discharge boost paths or remove stored energy. Body-facing shutdown remains the separate terminal guards.
