pratham-cloud-ctrl/Project-SCCI-RH/electronics/stage4/integrated-pcb/integration/boards/power/sup5.kicad_sch

## KiCad design electronics/stage4/integrated-pcb/integration/boards/power/sup5.kicad_sch (2026-10-29)



Parts:
C61010: 10u X7R 25V; C_1206_3216Metric
C61011: 22u X7R 16V; C_1206_3216Metric
L60101: 2.2uH SRP5030T-2R2M; L_Bourns_SRP5030T
R61010: 52500R 0.1%; R_0805_2012Metric
R61011: 10000R 0.1%; R_0805_2012Metric
R61012: 100k; R_0805_2012Metric
R61013: 47k; R_0805_2012Metric
U60101: TPS62160DGKR; VSSOP-8_3x3mm_P0.65mm

Connections:
SYS_66aba95b__SUP_5: C61011.1, L60101.2, R61010.1, R61013.1, U60101.6 (VOS)
SYS_56562df4__GND: C61010.2, C61011.2, R61011.2, R61013.2, U60101.1 (PGND), U60101.4 (AGND)
SYS_ab932142__SUP_3V3: R61012.1
SYS_f199d834__PACK_BUS: C61010.1, U60101.2 (VIN), U60101.3 (EN)
power__SUP_5_FB: R61010.2, R61011.1, U60101.5 (FB)
power__SUP_5_PG: R61012.2, U60101.8 (PG)
power__SUP_5_SW: L60101.1, U60101.7 (SW)

Notes on the sheet:
DIGITAL SCCI ENGINEERING / ARTIFICIAL LOADS / BATTERY AND POWER
2S protected pack, independent supervisor rails, host converters and floating AFE supplies. Digital circuit design, not implant qualification.
All labels are native electrical connections. PG is diagnostic; full qualification remains the nine independent supervision windows.
Converter shutdown does not discharge boost paths or remove stored energy. Body-facing shutdown remains the separate terminal guards.
