pratham-cloud-ctrl/Project-SCCI-RH/electronics/stage4/integrated-pcb/integration/boards/recording-front-end/acquisition.kicad_sch

## KiCad design electronics/stage4/integrated-pcb/integration/boards/recording-front-end/acquisition.kicad_sch (2026-10-29)



Parts:
C30010, C30011: 100n X7R 16V; C_0805_2012Metric
C30012: 10n 16V; C_0805_2012Metric
C30013: 1u X7R 16V; C_0805_2012Metric
U30010: RHD2216; RHD2216_QFN56_8x8_P0.5_EP6.1

Connections:
SYS_1dc2a435__AFE_IN08_P: U30010.49 (in8+)
SYS_4f7d5988__AFE_IN14_P: U30010.37 (in14+)
SYS_4fabccc5__AFE_IN12_P: U30010.41 (in12+)
SYS_7e367734__AFE_IN04_P: U30010.1 (in4+)
SYS_8c3f25bb__AFE_IN02_P: U30010.5 (in2+)
SYS_32c4c1cc__AFE_IN13_P: U30010.39 (in13+)
SYS_65aafbb6__AFE_3V3: C30010.1, C30011.1, C30013.1, U30010.13 (VDD), U30010.14 (auxin1), U30010.15 (auxin2), U30010.16 (auxin3), U30010.26 (VDD), U30010.31 (VDD)
SYS_86b728f8__AFE_REF: U30010.2 (in3-), U30010.4 (in2-), U30010.6 (in1-), U30010.8 (in0-), U30010.34 (in15-), U30010.36 (in14-), U30010.38 (in13-), U30010.40 (in12-), U30010.42 (in11-), U30010.44 (in10-), U30010.46 (in9-), U30010.48 (in8-), U30010.50 (in7-), U30010.52 (in6-), U30010.54 (in5-), U30010.56 (in4-)
SYS_96d7c46a__AFE_IN10_P: U30010.45 (in10+)
SYS_3232ae4c__AFE_IN01_P: U30010.7 (in1+)
SYS_53213f89__AFE_IN15_P: U30010.35 (in15+)
SYS_59100ef9__AFE_IN05_P: U30010.55 (in5+)
SYS_325713b8__AFE_IN07_P: U30010.51 (in7+)
SYS_380216f6__AFE_IN06_P: U30010.53 (in6+)
SYS_05097029__AFE_IN00_P: U30010.9 (in0+)
SYS_b6a4cd67__AFE_IN11_P: U30010.43 (in11+)
SYS_ee730a89__AFE_IN09_P: U30010.47 (in9+)
SYS_f208be39__AFE_IN03_P: U30010.3 (in3+)
SYS_fca1c340__AFEAGND: C30010.2, C30011.2, C30012.2, C30013.2, U30010.10 (GND), U30010.11 (GND), U30010.12 (GND), U30010.17 (GND), U30010.29 (GND), U30010.30 (LVDS_en), U30010.32 (VESD), U30010.33 (elec_test), U30010.57 (EP_SHIELD)
recording-front-end__AFE_ADC_REF: C30012.1, U30010.28 (ADC_ref)
recording-front-end__AFE_CS_N: U30010.19 (CS+)
recording-front-end__AFE_MISO: U30010.25 (MISO+)
recording-front-end__AFE_MOSI: U30010.23 (MOSI+)
recording-front-end__AFE_SCLK: U30010.21 (SCLK+)

Notes on the sheet:
DIGITAL RESEARCH CIRCUIT / ARTIFICIAL SIGNALS / NO PCB OR IMPLANT QUALIFICATION
Spinal concept: 16 positive contacts + 1 shared reference + separate passive bias; amplifier linearity and biological recording remain conditional.
Every minus input shares AFE_REF. This is 16 differential streams from 18 functional recording ports, not 32 independent recording electrodes.
CMOS mode: LVDS_en=0; negative SPI pins NC; unused aux inputs at VDD; auxout NC; elec_test and VESD at AFEAGND.
Configure, calibrate and verify readback via SPI before valid data. 4MHz / 5us command slots are the revised isolated-link study baseline.
ADC response is pipelined; physical sample timestamps and invalid blanking/recovery intervals must be retained in software.
