pratham-cloud-ctrl/Project-SCCI-RH/electronics/stage4/integrated-pcb/integration/boards/supervision/afe_bank1.kicad_sch

## KiCad design electronics/stage4/integrated-pcb/integration/boards/supervision/afe_bank1.kicad_sch (2026-10-29)





Parts:
C50604, C50605, C50606, C50607, C51017, C51018, C51019, C51020: 100n X7R 16V; C_0805_2012Metric
J50604: REC04 ACTUAL RHD-SIDE TAP; PinHeader_1x02_P2.54mm_Vertical
J50605: REC05 ACTUAL RHD-SIDE TAP; PinHeader_1x02_P2.54mm_Vertical
J50606: REC06 ACTUAL RHD-SIDE TAP; PinHeader_1x02_P2.54mm_Vertical
J50607: REC07 ACTUAL RHD-SIDE TAP; PinHeader_1x02_P2.54mm_Vertical
R56040, R56050, R56060, R56070: 10M 0.1%; R_0805_2012Metric
R56041, R56051, R56061, R56071: 1M 0.1%; R_0805_2012Metric
U50604, U50605, U50606, U50607: TLV3202DGKR; VSSOP-8_2.3x2mm_P0.5mm
U51017, U51018, U51019, U51020: SN74LVC1G08DBVR; SOT-23-5

Connections:
SYS_3fdd5066__AFE_P5: C50604.1, C50605.1, C50606.1, C50607.1, U50604.8 (VCC), U50605.8 (VCC), U50606.8 (VCC), U50607.8 (VCC)
SYS_7e367734__AFE_IN04_P: J50604.1, R56040.1
SYS_65aafbb6__AFE_3V3: C51017.1, C51018.1, C51019.1, C51020.1, R56041.1, R56051.1, R56061.1, R56071.1, U51017.5 (VCC), U51018.5 (VCC), U51019.5 (VCC), U51020.5 (VCC)
SYS_59100ef9__AFE_IN05_P: J50605.1, R56050.1
SYS_325713b8__AFE_IN07_P: J50607.1, R56070.1
SYS_380216f6__AFE_IN06_P: J50606.1, R56060.1
SYS_fca1c340__AFEAGND: C50604.2, C50605.2, C50606.2, C50607.2, C51017.2, C51018.2, C51019.2, C51020.2, J50604.2, J50605.2, J50606.2, J50607.2, U50604.4 (GND), U50605.4 (GND), U50606.4 (GND), U50607.4 (GND), U51017.3 (GND), U51018.3 (GND), U51019.3 (GND), U51020.3 (GND)
supervision__AFE_WIN_HI: U50604.3 (IN1+), U50605.3 (IN1+), U50606.3 (IN1+), U50607.3 (IN1+)
supervision__AFE_WIN_LO: U50604.6 (IN2-), U50605.6 (IN2-), U50606.6 (IN2-), U50607.6 (IN2-)
supervision__REC04_DC_OK: U51017.4 (Y)
supervision__REC04_HI_OK: U50604.1 (OUT1), U51017.1 (A)
supervision__REC04_LO_OK: U50604.7 (OUT2), U51017.2 (B)
supervision__REC04_SENSE: R56040.2, R56041.2, U50604.2 (IN1-), U50604.5 (IN2+)
supervision__REC05_DC_OK: U51018.4 (Y)
supervision__REC05_HI_OK: U50605.1 (OUT1), U51018.1 (A)
supervision__REC05_LO_OK: U50605.7 (OUT2), U51018.2 (B)
supervision__REC05_SENSE: R56050.2, R56051.2, U50605.2 (IN1-), U50605.5 (IN2+)
supervision__REC06_DC_OK: U51019.4 (Y)
supervision__REC06_HI_OK: U50606.1 (OUT1), U51019.1 (A)
supervision__REC06_LO_OK: U50606.7 (OUT2), U51019.2 (B)
supervision__REC06_SENSE: R56060.2, R56061.2, U50606.2 (IN1-), U50606.5 (IN2+)
supervision__REC07_DC_OK: U51020.4 (Y)
supervision__REC07_HI_OK: U50607.1 (OUT1), U51020.1 (A)
supervision__REC07_LO_OK: U50607.7 (OUT2), U51020.2 (B)
supervision__REC07_SENSE: R56070.2, R56071.2, U50607.2 (IN1-), U50607.5 (IN2+)

Notes on the sheet:
DIGITAL SCCI ENGINEERING / ARTIFICIAL LOADS / NATIVE INDEPENDENT SUPERVISION
18 guarded stimulation conductors, 17 measured RHD-side windows; conditional healthy-switch blanking is not proven isolation.
All net labels are native electrical connections. Actual physical delay, leakage, failed switches and shared supplies remain bounded limitations.
Independent phase cap, heartbeat watchdog, rail windows and deliberate rearm have different functions. No automatic retry or reverse pulse.
