pratham-cloud-ctrl/Project-SCCI-RH/electronics/stage4/integrated-pcb/integration/boards/supervision/afe_bank2.kicad_sch

## KiCad design electronics/stage4/integrated-pcb/integration/boards/supervision/afe_bank2.kicad_sch (2026-10-29)





Parts:
C50608, C50609, C50610, C50611, C51021, C51022, C51023, C51024: 100n X7R 16V; C_0805_2012Metric
J50608: REC08 ACTUAL RHD-SIDE TAP; PinHeader_1x02_P2.54mm_Vertical
J50609: REC09 ACTUAL RHD-SIDE TAP; PinHeader_1x02_P2.54mm_Vertical
J50610: REC10 ACTUAL RHD-SIDE TAP; PinHeader_1x02_P2.54mm_Vertical
J50611: REC11 ACTUAL RHD-SIDE TAP; PinHeader_1x02_P2.54mm_Vertical
R56080, R56090, R56100, R56110: 10M 0.1%; R_0805_2012Metric
R56081, R56091, R56101, R56111: 1M 0.1%; R_0805_2012Metric
U50608, U50609, U50610, U50611: TLV3202DGKR; VSSOP-8_2.3x2mm_P0.5mm
U51021, U51022, U51023, U51024: SN74LVC1G08DBVR; SOT-23-5

Connections:
SYS_1dc2a435__AFE_IN08_P: J50608.1, R56080.1
SYS_3fdd5066__AFE_P5: C50608.1, C50609.1, C50610.1, C50611.1, U50608.8 (VCC), U50609.8 (VCC), U50610.8 (VCC), U50611.8 (VCC)
SYS_65aafbb6__AFE_3V3: C51021.1, C51022.1, C51023.1, C51024.1, R56081.1, R56091.1, R56101.1, R56111.1, U51021.5 (VCC), U51022.5 (VCC), U51023.5 (VCC), U51024.5 (VCC)
SYS_96d7c46a__AFE_IN10_P: J50610.1, R56100.1
SYS_b6a4cd67__AFE_IN11_P: J50611.1, R56110.1
SYS_ee730a89__AFE_IN09_P: J50609.1, R56090.1
SYS_fca1c340__AFEAGND: C50608.2, C50609.2, C50610.2, C50611.2, C51021.2, C51022.2, C51023.2, C51024.2, J50608.2, J50609.2, J50610.2, J50611.2, U50608.4 (GND), U50609.4 (GND), U50610.4 (GND), U50611.4 (GND), U51021.3 (GND), U51022.3 (GND), U51023.3 (GND), U51024.3 (GND)
supervision__AFE_WIN_HI: U50608.3 (IN1+), U50609.3 (IN1+), U50610.3 (IN1+), U50611.3 (IN1+)
supervision__AFE_WIN_LO: U50608.6 (IN2-), U50609.6 (IN2-), U50610.6 (IN2-), U50611.6 (IN2-)
supervision__REC08_DC_OK: U51021.4 (Y)
supervision__REC08_HI_OK: U50608.1 (OUT1), U51021.1 (A)
supervision__REC08_LO_OK: U50608.7 (OUT2), U51021.2 (B)
supervision__REC08_SENSE: R56080.2, R56081.2, U50608.2 (IN1-), U50608.5 (IN2+)
supervision__REC09_DC_OK: U51022.4 (Y)
supervision__REC09_HI_OK: U50609.1 (OUT1), U51022.1 (A)
supervision__REC09_LO_OK: U50609.7 (OUT2), U51022.2 (B)
supervision__REC09_SENSE: R56090.2, R56091.2, U50609.2 (IN1-), U50609.5 (IN2+)
supervision__REC10_DC_OK: U51023.4 (Y)
supervision__REC10_HI_OK: U50610.1 (OUT1), U51023.1 (A)
supervision__REC10_LO_OK: U50610.7 (OUT2), U51023.2 (B)
supervision__REC10_SENSE: R56100.2, R56101.2, U50610.2 (IN1-), U50610.5 (IN2+)
supervision__REC11_DC_OK: U51024.4 (Y)
supervision__REC11_HI_OK: U50611.1 (OUT1), U51024.1 (A)
supervision__REC11_LO_OK: U50611.7 (OUT2), U51024.2 (B)
supervision__REC11_SENSE: R56110.2, R56111.2, U50611.2 (IN1-), U50611.5 (IN2+)

Notes on the sheet:
DIGITAL SCCI ENGINEERING / ARTIFICIAL LOADS / NATIVE INDEPENDENT SUPERVISION
18 guarded stimulation conductors, 17 measured RHD-side windows; conditional healthy-switch blanking is not proven isolation.
All net labels are native electrical connections. Actual physical delay, leakage, failed switches and shared supplies remain bounded limitations.
Independent phase cap, heartbeat watchdog, rail windows and deliberate rearm have different functions. No automatic retry or reverse pulse.
