pratham-cloud-ctrl/Project-SCCI-RH/electronics/stage4/integrated-pcb/integration/boards/supervision/afe_rails.kicad_sch

## KiCad design electronics/stage4/integrated-pcb/integration/boards/supervision/afe_rails.kicad_sch (2026-10-29)

Schematic: afe_rails.kicad_sch

Parts:
C50206, C50207: 100n X7R 16V; C_0805_2012Metric
R52060: 73500R 0.1%; R_0805_2012Metric
R52061, R52063, R52071, R52073: 10k 0.1%; R_0805_2012Metric
R52062: 78500R 0.1%; R_0805_2012Metric
R52064, R52074: 10k; R_0805_2012Metric
R52070: 120000R 0.1%; R_0805_2012Metric
R52072: 125500R 0.1%; R_0805_2012Metric
R52080: 1875R 0.1%; R_0805_2012Metric
U50206, U50207, U50208: TPS3700DDCR; SOT-23-6

Connections:
SYS_3fdd5066__AFE_P5: R52070.1, R52072.1
SYS_65aafbb6__AFE_3V3: C50206.1, C50207.1, R52060.1, R52062.1, R52064.1, R52074.1, U50206.5 (VDD), U50207.5 (VDD), U50208.5 (VDD)
SYS_fca1c340__AFEAGND: C50206.2, C50207.2, R52061.2, R52063.2, R52071.2, R52073.2, U50206.2 (GND), U50207.2 (GND), U50208.2 (GND)
supervision__A3_OV: R52062.2, R52063.1, U50206.4 (INB-_OV)
supervision__A3_RAIL_OK: R52064.2, U50206.1 (OUTA_UV_N), U50206.6 (OUTB_OV_N)
supervision__A3_UV: R52060.2, R52061.1, U50206.3 (INA+_UV)
supervision__AFE_NMAG: R52080.1
supervision__AN_OV: U50208.4 (INB-_OV)
supervision__AN_RAIL_OK: U50208.1 (OUTA_UV_N), U50208.6 (OUTB_OV_N)
supervision__AN_UV: R52080.2, U50208.3 (INA+_UV)
supervision__AP_OV: R52072.2, R52073.1, U50207.4 (INB-_OV)
supervision__AP_RAIL_OK: R52074.2, U50207.1 (OUTA_UV_N), U50207.6 (OUTB_OV_N)
supervision__AP_UV: R52070.2, R52071.1, U50207.3 (INA+_UV)

Notes on the sheet:
DIGITAL SCCI ENGINEERING / ARTIFICIAL LOADS / NATIVE INDEPENDENT SUPERVISION
18 guarded stimulation conductors, 17 measured RHD-side windows; conditional healthy-switch blanking is not proven isolation.
All net labels are native electrical connections. Actual physical delay, leakage, failed switches and shared supplies remain bounded limitations.
Independent phase cap, heartbeat watchdog, rail windows and deliberate rearm have different functions. No automatic retry or reverse pulse.
