pratham-cloud-ctrl/Project-SCCI-RH/electronics/stage4/integrated-pcb/integration/boards/supervision/afe_rails_2.kicad_sch

## KiCad design electronics/stage4/integrated-pcb/integration/boards/supervision/afe_rails_2.kicad_sch (2026-10-29)

Schematic: afe_rails_2.kicad_sch

Parts:
C50208, C50220, C50261: 100n X7R 16V; C_0805_2012Metric
C50260: 47n X7R 10%; C_0805_2012Metric
D50260: BAT54WS-7-F; D_SOD-323
R50260: 100k 1%; R_0805_2012Metric
R50261: 100R; R_0805_2012Metric
R52081, R52083, R52201: 10k 0.1%; R_0805_2012Metric
R52082: 3750R 0.1%; R_0805_2012Metric
R52084: 10k; R_0805_2012Metric
R52200: 100k 0.1%; R_0805_2012Metric
U50220: OPA391DCKR; SOT-353_SC-70-5
U50260: SN74LVC1G17DBVR; SOT-23-5

Connections:
SYS_65aafbb6__AFE_3V3: C50208.1, C50220.1, C50261.1, R50260.1, R50261.2, R52084.1, U50220.5 (V+), U50260.5 (VCC)
SYS_d73cd2ee__AFE_N5: R52200.1
SYS_fca1c340__AFEAGND: C50208.2, C50220.2, C50260.2, C50261.2, R52081.2, R52083.2, U50220.1 (IN+), U50220.2 (V-), U50260.3 (GND)
supervision__AFE_DIS: D50260.1 (K), R50261.1
supervision__AFE_NINV: R52200.2, R52201.2, U50220.3 (IN-)
supervision__AFE_NMAG: R52082.1, R52201.1, U50220.4 (OUT)
supervision__AFE_RC: C50260.1, D50260.2 (A), R50260.2, U50260.2 (A)
supervision__AFE_STARTUP_OK: U50260.4 (Y)
supervision__AN_OV: R52082.2, R52083.1
supervision__AN_RAIL_OK: R52084.2
supervision__AN_UV: R52081.1

Notes on the sheet:
DIGITAL SCCI ENGINEERING / ARTIFICIAL LOADS / NATIVE INDEPENDENT SUPERVISION
18 guarded stimulation conductors, 17 measured RHD-side windows; conditional healthy-switch blanking is not proven isolation.
All net labels are native electrical connections. Actual physical delay, leakage, failed switches and shared supplies remain bounded limitations.
Independent phase cap, heartbeat watchdog, rail windows and deliberate rearm have different functions. No automatic retry or reverse pulse.
