pratham-cloud-ctrl/Project-SCCI-RH/electronics/stage4/integrated-pcb/integration/boards/supervision/guards.kicad_sch

## KiCad design electronics/stage4/integrated-pcb/integration/boards/supervision/guards.kicad_sch (2026-10-29)

Schematic: guards.kicad_sch

Parts:
C50100, C50101, C50102, C50103, C50104: 100n X7R 50V; C_0805_2012Metric
J50100: CANONICAL ROUTER J7 / BEFORE GUARDS; PinHeader_1x18_P2.54mm_Vertical
J50101: BODY-FACING ARTIFICIAL LOAD CONTACTS; PinHeader_1x18_P2.54mm_Vertical
R50100, R50101, R50102, R50103, R50104: 22k; R_0805_2012Metric
R50110: 1k; R_0805_2012Metric
U50100, U50101, U50102, U50103, U50104: TMUX7412FRRPR; Texas_RRP0016A_WQFN16_4x4_P0.65_EP2.6

Connections:
SYS_0d1e7c21__CH0_RETURN_LOAD: J50100.17, U50104.16 (D1_INTERNAL)
SYS_3ced048f__CH1_RETURN_LOAD: J50100.18, U50104.13 (D2_INTERNAL)
SYS_6d4bb3d1__STIM11_CONTACT: J50100.12, U50102.5 (D4_INTERNAL)
SYS_8b50701c__STIM01_CONTACT: J50100.2, U50100.13 (D2_INTERNAL)
SYS_32f1b236__STIM12_CONTACT: J50100.13, U50103.16 (D1_INTERNAL)
SYS_36b8c84f__STIM02_CONTACT: J50100.3, U50100.8 (D3_INTERNAL)
SYS_74b9e55a__STIM10_CONTACT: J50100.11, U50102.8 (D3_INTERNAL)
SYS_77c24b0d__GLOBAL_GUARD_EN: R50100.1, R50101.1, R50102.1, R50103.1, R50104.1, U50100.6 (SEL4), U50100.7 (SEL3), U50100.14 (SEL2), U50100.15 (SEL1), U50101.6 (SEL4), U50101.7 (SEL3), U50101.14 (SEL2), U50101.15 (SEL1), U50102.6 (SEL4), U50102.7 (SEL3), U50102.14 (SEL2), U50102.15 (SEL1), U50103.6 (SEL4), U50103.7 (SEL3), U50103.14 (SEL2), U50103.15 (SEL1), U50104.14 (SEL2), U50104.15 (SEL1)
SYS_126bf237__STIM14_CONTACT: J50100.15, U50103.8 (D3_INTERNAL)
SYS_223a43dd__STIM03_CONTACT: J50100.4, U50100.5 (D4_INTERNAL)
SYS_15689dc4__VH_24: C50100.1, C50101.1, C50102.1, C50103.1, C50104.1, U50100.11 (VDD), U50101.11 (VDD), U50102.11 (VDD), U50103.11 (VDD), U50104.11 (VDD)
SYS_56562df4__GND: C50100.2, C50101.2, C50102.2, C50103.2, C50104.2, R50100.2, R50101.2, R50102.2, R50103.2, R50104.2, U50100.2 (VSS), U50100.3 (GND), U50100.17 (EP_GND), U50101.2 (VSS), U50101.3 (GND), U50101.17 (EP_GND), U50102.2 (VSS), U50102.3 (GND), U50102.17 (EP_GND), U50103.2 (VSS), U50103.3 (GND), U50103.17 (EP_GND), U50104.2 (VSS), U50104.3 (GND), U50104.4 (S4_EXTERNAL), U50104.5 (D4_INTERNAL), U50104.6 (SEL4), U50104.7 (SEL3), U50104.8 (D3_INTERNAL), U50104.9 (S3_EXTERNAL), U50104.17 (EP_GND)
SYS_80673a9e__STIM08_CONTACT: J50100.9, U50102.16 (D1_INTERNAL)
SYS_82867ca5__STIM00_CONTACT: J50100.1, U50100.16 (D1_INTERNAL)
SYS_344482b2__STIM13_CONTACT: J50100.14, U50103.13 (D2_INTERNAL)
SYS_ab932142__SUP_3V3: R50110.1
SYS_b675ff0d__STIM06_CONTACT: J50100.7, U50101.8 (D3_INTERNAL)
SYS_cf17d7c4__STIM07_CONTACT: J50100.8, U50101.5 (D4_INTERNAL)
SYS_dcbe1273__STIM04_CONTACT: J50100.5, U50101.16 (D1_INTERNAL)
SYS_eb2c0acf__STIM09_CONTACT: J50100.10, U50102.13 (D2_INTERNAL)
SYS_ee59c76b__PWR_FAULT_N: R50110.2, U50100.10 (FF_N), U50101.10 (FF_N), U50102.10 (FF_N), U50103.10 (FF_N), U50104.10 (FF_N)
SYS_f00e6304__STIM15_CONTACT: J50100.16, U50103.5 (D4_INTERNAL)
SYS_fa6c9e06__STIM05_CONTACT: J50100.6, U50101.13 (D2_INTERNAL)
supervision__BODY_RETURN0: J50101.17, U50104.1 (S1_EXTERNAL)
supervision__BODY_RETURN1: J50101.18, U50104.12 (S2_EXTERNAL)
supervision__BODY_STIM00: J50101.1, U50100.1 (S1_EXTERNAL)
supervision__BODY_STIM01: J50101.2, U50100.12 (S2_EXTERNAL)
supervision__BODY_STIM02: J50101.3, U50100.9 (S3_EXTERNAL)
supervision__BODY_STIM03: J50101.4, U50100.4 (S4_EXTERNAL)
supervision__BODY_STIM04: J50101.5, U50101.1 (S1_EXTERNAL)
supervision__BODY_STIM05: J50101.6, U50101.12 (S2_EXTERNAL)
supervision__BODY_STIM06: J50101.7, U50101.9 (S3_EXTERNAL)
supervision__BODY_STIM07: J50101.8, U50101.4 (S4_EXTERNAL)
supervision__BODY_STIM08: J50101.9, U50102.1 (S1_EXTERNAL)
supervision__BODY_STIM09: J50101.10, U50102.12 (S2_EXTERNAL)
supervision__BODY_STIM10: J50101.11, U50102.9 (S3_EXTERNAL)
supervision__BODY_STIM11: J50101.12, U50102.4 (S4_EXTERNAL)
supervision__BODY_STIM12: J50101.13, U50103.1 (S1_EXTERNAL)
supervision__BODY_STIM13: J50101.14, U50103.12 (S2_EXTERNAL)
supervision__BODY_STIM14: J50101.15, U50103.9 (S3_EXTERNAL)
supervision__BODY_STIM15: J50101.16, U50103.4 (S4_EXTERNAL)

Notes on the sheet:
DIGITAL SCCI ENGINEERING / ARTIFICIAL LOADS / NATIVE INDEPENDENT SUPERVISION
18 guarded stimulation conductors, 17 measured RHD-side windows; conditional healthy-switch blanking is not proven isolation.
All net labels are native electrical connections. Actual physical delay, leakage, failed switches and shared supplies remain bounded limitations.
Independent phase cap, heartbeat watchdog, rail windows and deliberate rearm have different functions. No automatic retry or reverse pulse.
