pratham-cloud-ctrl/Project-SCCI-RH/electronics/stage4/integrated-pcb/integration/boards/supervision/voltage.kicad_sch

## KiCad design electronics/stage4/integrated-pcb/integration/boards/supervision/voltage.kicad_sch (2026-10-29)

Schematic: voltage.kicad_sch

Parts:
C50500, C50501, C50502, C50510, C50520, C51011, C51012: 100n X7R 16V; C_0805_2012Metric
R50500, R50502: 232k 0.1%; R_0805_2012Metric
R50501: 536k 0.1%; R_0805_2012Metric
R50510, R50512, R50520, R50522: 1M 0.1%; R_0805_2012Metric
R50511, R50513, R50521, R50523: 49.9k 0.1%; R_0805_2012Metric
U50500, U50501: OPA391DCKR; SOT-353_SC-70-5
U50502: OPA2192IDGKR; VSSOP-8_2.3x2mm_P0.5mm
U50510, U50520: TLV3202DGKR; VSSOP-8_2.3x2mm_P0.5mm
U51011, U51012: SN74LVC1G08DBVR; SOT-23-5

Connections:
SYS_4f66f129__MON_VREF: R50500.1
SYS_37cfe02a__MON_VMID: R50511.1, R50521.1
SYS_40eeaa0c__CH1_VPAIR: R50523.1, U50502.7 (OUTB), U50520.2 (IN1-), U50520.5 (IN2+)
SYS_66aba95b__SUP_5: C50500.1, C50501.1, C50502.1, C50510.1, C50520.1, U50500.5 (V+), U50501.5 (V+), U50502.8 (V+), U50510.8 (VCC), U50520.8 (VCC)
SYS_401be33b__CH1_A_ROUTER: R50520.1
SYS_917b1360__CH0_A_ROUTER: R50510.1
SYS_56562df4__GND: C50500.2, C50501.2, C50502.2, C50510.2, C50520.2, C51011.2, C51012.2, R50502.2, U50500.2 (V-), U50501.2 (V-), U50502.4 (V-), U50510.4 (GND), U50520.4 (GND), U51011.3 (GND), U51012.3 (GND)
SYS_ab932142__SUP_3V3: C51011.1, C51012.1, U51011.5 (VCC), U51012.5 (VCC)
SYS_baff84b5__CH0_VPAIR: R50513.1, U50502.1 (OUTA), U50510.2 (IN1-), U50510.5 (IN2+)
SYS_c73180be__CH1_B_BR: R50522.1
SYS_ee476f53__CH0_B_BR: R50512.1
supervision__CH0_DIFF_N: R50512.2, R50513.2, U50502.2 (INA-)
supervision__CH0_DIFF_P: R50510.2, R50511.2, U50502.3 (INA+)
supervision__CH0_PAIR_HI_OK: U50510.1 (OUT1), U51011.1 (A)
supervision__CH0_PAIR_LO_OK: U50510.7 (OUT2), U51011.2 (B)
supervision__CH0_PAIR_OK: U51011.4 (Y)
supervision__CH1_DIFF_N: R50522.2, R50523.2, U50502.6 (INB-)
supervision__CH1_DIFF_P: R50520.2, R50521.2, U50502.5 (INB+)
supervision__CH1_PAIR_HI_OK: U50520.1 (OUT1), U51012.1 (A)
supervision__CH1_PAIR_LO_OK: U50520.7 (OUT2), U51012.2 (B)
supervision__CH1_PAIR_OK: U51012.4 (Y)
supervision__PAIR_HI: U50500.3 (IN-), U50500.4 (OUT), U50510.3 (IN1+), U50520.3 (IN1+)
supervision__PAIR_HI_DIV: R50500.2, R50501.1, U50500.1 (IN+)
supervision__PAIR_LO: U50501.3 (IN-), U50501.4 (OUT), U50510.6 (IN2-), U50520.6 (IN2-)
supervision__PAIR_LO_DIV: R50501.2, R50502.1, U50501.1 (IN+)

Notes on the sheet:
DIGITAL SCCI ENGINEERING / ARTIFICIAL LOADS / NATIVE INDEPENDENT SUPERVISION
18 guarded stimulation conductors, 17 measured RHD-side windows; conditional healthy-switch blanking is not proven isolation.
All net labels are native electrical connections. Actual physical delay, leakage, failed switches and shared supplies remain bounded limitations.
Independent phase cap, heartbeat watchdog, rail windows and deliberate rearm have different functions. No automatic retry or reverse pulse.
