pratham-cloud-ctrl/Project-SCCI-RH/scripts/inspect_stage5_reference.py

"""Finalize reference inspection from explicit completed independent evidence.

The original independent inspector completed source/neutral-export comparisons
and wrote four successful bound phase files. Its later whole-compound distance
run did not complete. This driver preserves those actual phases, binds a
separately completed exact solid-pair clearance inspection, and freshly reopens
the saved native assembly for validity, coverage and material checks. It never
reconstructs a pass from console logs or changes a completed phase's source hash.
"""
from __future__ import annotations

import argparse
import hashlib
import json
from pathlib import Path
import sys

ROOT = Path(__file__).resolve().parents[1]
BACKEND_SHA256_LF = '8705686a8a2efde080c1ad67868afe926c82e8c95bdec127a1ed659d4b06f75b'
PHASES = ('native-specific', 'nominal-step', 'mechanical-step', 'exploded-step')


def sha(path, text=False):
    data = Path(path).read_bytes()
    return hashlib.sha256(data.replace(b'\r\n', b'\n') if text else data).hexdigest()


assert sha(ROOT/'scripts/inspect_stage5_native.py', True) == BACKEND_SHA256_LF, 'exact independent geometry backend'
import inspect_stage5_native as backend
App, Part = backend.App, backend.Part


def read(path):
    return json.loads(Path(path).read_text(encoding='utf-8-sig'))
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
