pratham-cloud-ctrl/Project-SCCI-RH/(commit log)

2026-10-29 Rename project to Project SCCI RH across research and engineering
    [ATO_engineering_assemblies.blend, ATO_future_interface.FCStd, ATO_future_interface_exploded.FCStd, ATO_harness_routes.FCStd, ATO_integrated.kicad_sch, ATO_mating_interfaces.FCStd, ATO_mating_interfaces.step, ATO_reference_assembly.FCStd]
2026-10-29 Fix portable metadata and finalize Project SCCI RH 2.1.1
    [audit_frozen_observer_pilot.py, project_branding.py, review_stage5_delivery.py]
2026-10-29 Close standalone export and resolved identity integrity checks
    [audit_frozen_observer_pilot.py]
